robinonsay/cwht/docs/vv/README.md

# docs/vv: verification and validation evidence

Governing process: `docs/process/04-verification-and-validation.md` (expands charter section 9). Nothing in this directory is deleted; superseded items are kept and referenced by their successors (process section 15).

## Layout

| Path | Content | Created | Format and rules |
|---|---|---|---|
| `plan.md` | The V&V Plan, SE HB Appendix I outline as adapted in process section 14 | Written for PDR, baselined at PDR (SE-68), updated at CDR and each TRR by CR | Markdown; Appendices C and D are the matrices copied from `traceability-report.md` at each review |
| `traceability-report.md` | Output of `tools/traceability.py`: closure summary, requirements verification matrix (SE HB App. D), validation matrix (SE HB App. E), rule violations, requirement-to-NCR list | Regenerated before every review package and before every status change is committed | Generated file; never edited by hand; entrance product of every review (charter section 7); this is the working copy, and the per-review report `docs/reviews/<REVIEW>/traceability-report.md` with its `traceability.json` is written by the command of `docs/process/01-lifecycle-and-reviews.md` section 3.1 item 2, not copied from here |
| `traceability.json` | Machine-readable output of the same run: counts, coverage per module, validation row statuses, findings, and the measurements MSR-01, MSR-03, MSR-04 and MSR-23 of 07 section 11.2 | Written beside `traceability-report.md` by every run (`--json` names another path) | Generated file; never edited by hand; read by `tools/measurements.py` to append to `docs/plan/measurements.json` |
| `reports/<TC-ID>-r<N>.md` | One verification or validation report per run, from `docs/templates/verification-report.md` | Every run intended for credit and every failed run; risk-reduction runs with `credit: false` | YAML front matter in the parser subset of process section 7.4; read by `tools/traceability.py` today (rules 7.3.4 and 7.3.8: keys `test_case`, `run`, `requirement_ids`, `validates`, `credit`, `result`, `date`, `ncr_ids`, `artifacts`); the CM keys `source_commit`, `firmware_elf_sha256`, `procedure_blob` and `harness_versions` (`n/a` where they do not apply) are checked by the FCA (CM plan section 7.1, FCA-03 and FCA-04); `<N>` is the run number and is never reused |
| `reports/<TC-ID>-r<N>/` | Artifacts cited by that report: `*.csv`, `*.log.txt`, `*.png`, `*.svg`, `*.jpg`, `serial-*.txt`; an LTspice `.raw` only when the report cites it and it is 10 MB or smaller; for `TC-SW-COV-001-r<N>/` also `lcov.info`, the nightly MSR-14 output, the MC/DC tables and the gate log reference | With the report | Each file's SHA-256 is listed in the report front matter `artifacts`. Logs use the naming convention `.log.txt`; `.gitignore` un-ignores `*.log` and `*.raw` under `docs/vv/`, so nothing here is dropped by git (process section 15) |
| `reports/TC-SW-COV-001-r<N>.md` | Coverage and complexity report (SWE-189, SWE-190, SWE-219, SWE-220): summary, uncovered-code dispositions, MC/DC tables, complexity exceedances (process section 12) | Every tagged firmware release; presented at CDR, TRR, each TRR-Dn and SAR | Same template; case `TC-SW-COV-001` in `docs/test_cases/sw-cov/test_cases.json`; `firmware_version` carries the release |
| `reports/TC-SW-REG-001-r<N>.md` | Firmware regression report (SWE-191; process section 10.5) | Every tagged firmware release | Same template; case `TC-SW-REG-001` in `docs/test_cases/sw-reg/test_cases.json` |
| `reports/receipt-inspection-<n>.md` | Receipt inspection record for vendor delivery `n` (PCBWay, DigiKey): quantity, visual check against renders and BOM, polarity, dimensions, photographs (process section 11.2 stage 0; `docs/process/01-lifecycle-and-reviews.md` section 7.3 row 9 and 8.3 row 20) | At each vendor delivery, before TRR | Markdown record; no per-case front matter; not read by the tool; linked from `adp/<unit-serial>/as-built.md`; discrepancies become NCRs |
| `reports/vv-report.md` | V&V summary report for SAR (SE-53 replacement product, 01 section 8.5): every requirement's evidence and status, validation results per `OPS-NNN` and `MOE-NNN`, software section for SWE-194, written from `traceability-report.md` | Before SAR | Markdown; no per-case front matter; not read by the tool |
| `reports/part97-compliance.md` | Part 97 compliance statement (SE-54 replacement product, 01 section 8.3 row 7): each regulatory `REQ-TX-*`, its case, result and the owner's licence class | Before SAR | Markdown; no per-case front matter; not read by the tool |
| `ncr/NCR-NNN.md` | Non-conformance reports, from `docs/templates/ncr.md` | On any discrepancy (process section 10.1) | YAML front matter read by `tools/traceability.py` today (rule 7.3.8: keys `id`, `title`, `status`, `severity`, `requirement_ids`, `test_case_ids`, `retest_cases`, `regression_cases`, `hazard_ids`, `artifacts`; other keys checked by the reviewer); IDs sequential, never reused; status lifecycle in process section 10.7; closure evidence per disposition in process section 10.6 |
| `ncr/NCR-NNN/` | Evidence for that NCR: photographs, logs, vendor correspondence | With the NCR | SHA-256 listed in the NCR front matter `artifacts` |
| `fixtures/` | Drawings, OpenSCAD sources and characterization notes for test fixtures (RF probe characterized by the RF probe characterization case of module `SYS`, id allocated at authoring per 02 section 11.1; printed jigs, cable adapters) | By CDR | Referenced from test case `setup` fields |
| `adp/<unit-serial>/` | Acceptance data package per unit (`CWHT-A-001`, `CWHT-A-002`, ...): `as-built.md` (unit as-built record, CM plan Table 4-1 row 38), receipt photographs, link to the `receipt-inspection-<n>.md` records, ATP reports list, VDD copy, hand-over note | Unit 1 at receipt and completed at SAR; further units before hand-over (SI-019) | Markdown and images |

Test cases themselves live in `docs/test_cases/<module>/test_cases.json` (charter section 5), including `docs/test_cases/val/` (validation cases `TC-VAL-NNN`), `docs/test_cases/atp/` (acceptance test procedure `TC-ATP-NNN`), `docs/test_cases/sw-boot/` and `docs/test_cases/sw-cfg/` (loaded code and data acceptance, SWE-193; firmware modules with their own requirement files, 07 section 4), and the test-only modules `docs/test_cases/sw-cov/`, `docs/test_cases/sw-reg/` and `docs/test_cases/sw-tool/` (toolchain proof and tool accreditation runs, `TC-SW-TOOL-NNN`, 07 section 3.1). Start a new case from `docs/templates/test_cases.example.json` (one example per evidence class, including a `TC-VAL` style OnAir case, an ordering-only Emulation case and a dev-board case). TRR and SAR packages live in `docs/reviews/TRR/`, `docs/reviews/TRR-Dn/` (delta reviews) and `docs/reviews/SAR/` (charter section 4; `docs/process/01-lifecycle-and-reviews.md` section 1 item 4); the test configuration record for a campaign is `docs/reviews/TRR/test-configuration-record.md` (01 section 13).

## Workflow in one paragraph

A requirement is written with its method; an independent test author writes the case with its `Credit row:` line; an independent reviewer makes it `Active`; the conductor runs it on a configuration-managed article (tagged firmware release `release/FW-vX.Y.Z`, delivered unit) after TRR for Bench and OnAir; a report is filed here with `credit: true`; `tools/traceability.py` checks the evidence (rules of process section 7.3, implementation status in 7.4) and the requirement moves to `Verified` in the matrix; any discrepancy stops the run and opens an NCR here; the owner witnesses, dispositions and, at SAR, accepts, which moves the requirement to `Closed`. A software requirement verified by HostUnit or Emulation is `Verified` on the credited report against the tagged release; PCA-05 records the installed-release line in the unit's `adp/<unit-serial>/as-built.md` and changes no status; the requirement becomes `Closed` in the commit that records the signed SAR decision memo, and only when that PCA-05 line names the credited release (charter section 9; process section 5.3; CM plan section 7.2). Dev-board runs are supporting evidence with `credit: false` and never move a status (process section 4). Validation cases do the same against `OPS-NNN` and `MOE-NNN`, with the owner and friends as the users and both key types exercised (SI-018).

## Quick checks before committing anything here

1. `.venv/bin/python tools/traceability.py` exits 0 (the file is not executable; run it through the venv interpreter).
2. Every report and NCR has complete front matter in the parser subset (no trailing `# comments`, no nested mappings) and every cited artifact exists with the listed hash; `tools/traceability.py` checks this (rule 7.3.8: `REPORT_FRONT_MATTER`, `REPORT_ID_FORMAT`, `REPORT_UNRESOLVED`, `REPORT_ARTIFACT`, `NCR_ARTIFACT`), so run it before committing.
3. Every Bench or OnAir report names the witness and the instrument calibration performed that session.
4. Every file in a report or NCR artifact directory is listed in its `artifacts` front matter with its hash; logs are named `*.log.txt`; an LTspice `.raw` is present only when the report cites it and it is 10 MB or smaller (process section 15).
