robinonsay/cwht/docs/vv/traceability-report.md

# Traceability report

Generated by `tools/traceability.py` on 2026-09-30. Result: **PASS** (0 violation(s), 2 warning(s)).

Of the six Class A rows of NPR 7150.2D section 3.12.1 Table 1 (SWE-052) that `docs/process/00-charter.md` section 7 adopts, the state of this tool is: rows 1, 5, 6 enforced; row 2 enforced in part; rows 3, 4 not yet enforced. Section 1.4 lists the codes enforced and planned per row with their gates. It also applies the rules of `docs/process/02-requirements-and-traceability.md` section 8.2 and `docs/process/04-verification-and-validation.md` section 7.3 that section 11 lists. Section 3 is the Requirements Verification Matrix of SE HB Appendix D (Table D-1) and section 4 the Validation Matrix of SE HB Appendix E (Table E-1); together they are Appendices C and D of the V&V plan outline (SE HB Appendix I). Regenerate with `.venv/bin/python tools/traceability.py`; do not edit by hand.

## 1. Summary

| Item | Count |
|---|---|
| Requirement files | 3 |
| Requirements (not Retired) | 244 |
| Requirements Retired | 2 |
| Requirements with status Active | 189 |
| Requirements with status Closed | 2 |
| Requirements with status Draft | 55 |
| Requirements with at least one verification case | 244 of 244 (100 %) |
| Requirements Verified or Closed | 0 of 244 (0 %) |
| Requirements with open TBR (MSR-04) | 135 |
| Key driving requirements (KDR) | 22 |
| Test case files | 4 |
| Test cases (not Retired) | 174 |
| Test cases with status Draft | 174 |
| Test cases of class Bench | 99 |
| Test cases of class HostUnit | 35 |
| Test cases of class Inspection | 15 |
| Test cases of class Simulation | 25 |
| Verification reports | 6 |
| Hazards | 15 |
| Expectations (NGO, MOE, CON) | 71 |
| ConOps scenarios | 22 |
| Nonconformance reports | 0 |
| Violations | 0 |
| Warnings | 2 |

### 1.1 Upstream artifacts consulted

| Artifact | Path | State |
|---|---|---|
| Stakeholder inputs (SI) | docs/requirements/l0-stakeholder/stakeholder-inputs.md | 38 ids, 1 core |
| Expectations (NGO, MOE, CON) | docs/requirements/l0-stakeholder/expectations.json | 71 ids |
| ConOps scenarios (OPS) | docs/conops/conops.md | 22 ids |
| Hazards (HZ) | docs/safety/hazards.json | 15 ids |
| Risks (RSK) | docs/risk/register.json | 65 ids |
| Measures (MOP, TPM) | docs/plan/tpm.json | 40 ids |
| Regulatory corpus (47 CFR Parts 1, 2, 15, 97 sections) | docs/references/md/regulatory | 30 ids |
| Decision records (ADR) | docs/decisions/adr | 45 ids |
| Trade studies (TS) | docs/decisions/trade-studies | 6 ids |
| Verification reports | docs/vv/reports | 6 files |
| Nonconformances (NCR) | docs/vv/ncr | 0 files |
| SAR decision memo | docs/reviews/SAR/decision-memo.md | absent |
| Allocation (preliminary at SRR) | docs/design/allocation.json | 187 requirement ids allocated |

### 1.2 Open TBR list

Every requirement carrying a `tbr` object (02 section 9 rule 3; NPR 7123.1D App. G Tables G-4, G-6 and G-7: TBD and TBR items identified with plans).

| ID | Module | Status | Owner | Plan | Close by |
|---|---|---|---|---|---|
| REQ-SYS-004 | SYS | Active | Robin approves on Claude's proposal at PDR; Claude produces the closing evidence | Claude sizes the latency in the sequencer timing analysis (ICD-TX-SW) at PDR; Robin confirms the 20 ms or a replacement in the PDR decision memo. | PDR |
| REQ-SYS-008 | SYS | Active | Robin approves on Claude's proposal at PDR; Claude produces the closing evidence | SRR decision 25 (owner ruling 2026-09-26) set the 1.2 kHz guard with the +/-2.5 ppm reference (ADR-023 option (a)); the TS-NNN-synthesizer-reference frequency error budget and the TS-006 keying-sideband offset of REQ-TX-006 at PDR confirm that 1.2 kHz covers the reference tolerance plus the -60 dB offset, else the guard is changed by CR. | PDR |
| REQ-SYS-009 | SYS | Active | Robin approves on Claude's proposal at PDR; Claude produces the closing evidence | Closes with the guard value of the transmit frequency range requirement (ADR-023 with the 1.2 kHz guard of SRR decision 25 (owner ruling 2026-09-26); frequency error budget, PDR). | PDR |
| REQ-SYS-010 | SYS | Active | Robin approves on Claude's proposal at PDR; Claude produces the closing evidence | TS-NNN-synthesizer-reference selects the reference grade at PDR; the error budget in docs/design/budgets.md fixes the tolerance and the operating span is reconciled with TPM-006; Robin approves in the PDR memo. | PDR |
| REQ-SYS-011 | SYS | Active | Robin approves on Claude's proposal at PDR; Claude produces the closing evidence | SRR decision 22 (owner ruling 2026-09-26) adopted the step set and tolerance (RFX-D1); the ALC loop analysis at PDR (TS-006) confirms +/-1 dB at every step. | PDR |
| REQ-SYS-012 | SYS | Active | Robin approves on Claude's proposal at PDR; Claude produces the closing evidence | TS-003 (PA device) and TS-006 (ALC topology) at PDR show the tolerance by analysis; Robin confirms +/-1 dB and the +/-0.5 dB ALC target or replacements in the PDR memo. | PDR |
| REQ-SYS-014 | SYS | Active | Robin approves on Claude's proposal at PDR; Claude produces the closing evidence | SRR decision 28 (owner ruling 2026-09-26) adopted the ramp convention and range as written (D-KN6); the TS-006 LTspice transient with the FFT checker confirms them at PDR; the same transient confirms the 5 percent shape and +/-0.5 ms time tolerances (INSP-003 finding-25). | PDR |
| REQ-SYS-015 | SYS | Active | Robin approves on Claude's proposal at PDR; Claude produces the closing evidence | Claude verifies the tinySA Ultra resolution bandwidth on receipt (ACTION-9) before PDR; if it resolves 350 Hz a CR proposes method Test, otherwise Analysis stands and RSK-011 records the residual. | PDR |
| REQ-SYS-018 | SYS | Active | Robin approves on Claude's proposal at PDR; Claude produces the closing evidence | SRR decision 29 (owner ruling 2026-09-26) accepted ADR-022; TS-003 and the filter simulation at PDR show the margin is achievable, else the target is revised by CR. | PDR |
| REQ-SYS-019 | SYS | Active | Robin approves on Claude's proposal at PDR; Claude produces the closing evidence | SRR decision 36 (owner ruling 2026-09-26) adopted RFX-D3 option a; the RF exposure evaluation at PDR confirms the value. | PDR |
| REQ-SYS-020 | SYS | Active | Robin approves on Claude's proposal at PDR; Claude produces the closing evidence | SRR decision 36 (owner ruling 2026-09-26) adopted RFX-D3 with D-KN2, option a (tune limit below the cutoff window); the RF exposure evaluation and the PA thermal analysis at PDR confirm it. | PDR |
| REQ-SYS-022 | SYS | Active | Robin approves on Claude's proposal at PDR; Claude produces the closing evidence | TS-001 (selectivity architecture A or B) at PDR closes the value with simulation and quotes; Robin approves the selected set in the PDR memo. | PDR |
| REQ-SYS-023 | SYS | Active | Robin approves on Claude's proposal at PDR; Claude produces the closing evidence | TS-001 (selectivity architecture A or B) at PDR closes the value with simulation and quotes; Robin approves the selected set in the PDR memo. | PDR |
| REQ-SYS-024 | SYS | Active | Robin approves on Claude's proposal at PDR; Claude produces the closing evidence | TS-001 (selectivity architecture A or B) at PDR closes the value with simulation and quotes; Robin approves the selected set in the PDR memo. | PDR |
| REQ-SYS-025 | SYS | Active | Robin approves on Claude's proposal at PDR; Claude produces the closing evidence | TS-001 (selectivity architecture A or B) at PDR closes the value with simulation and quotes; Robin approves the selected set in the PDR memo. | PDR |
| REQ-SYS-026 | SYS | Active | Robin approves on Claude's proposal at PDR; Claude produces the closing evidence | TS-001 (selectivity architecture A or B) at PDR closes the value with simulation and quotes; Robin approves the selected set in the PDR memo. | PDR |
| REQ-SYS-027 | SYS | Active | Robin approves on Claude's proposal at PDR; Claude produces the closing evidence | TS-001 (selectivity architecture A or B) at PDR closes the value with simulation and quotes; Robin approves the selected set in the PDR memo. | PDR |
| REQ-SYS-028 | SYS | Active | Robin approves on Claude's proposal at PDR; Claude produces the closing evidence | TS-001 (selectivity architecture A or B) at PDR closes the value with simulation and quotes; Robin approves the selected set in the PDR memo. | PDR |
| REQ-SYS-029 | SYS | Active | Robin approves on Claude's proposal at PDR; Claude produces the closing evidence | TS-001 (selectivity architecture A or B) at PDR closes the value with simulation and quotes; Robin approves the selected set in the PDR memo. | PDR |
| REQ-SYS-030 | SYS | Active | Robin approves on Claude's proposal at PDR; Claude produces the closing evidence | TS-001 (selectivity architecture A or B) at PDR closes the value with simulation and quotes; Robin approves the selected set in the PDR memo. | PDR |
| REQ-SYS-031 | SYS | Active | Robin approves on Claude's proposal at PDR; Claude produces the closing evidence | TS-NNN-synthesizer-reference at PDR selects the synthesizer on measured or primary-source phase noise; Robin approves the floor in the PDR memo. | PDR |
| REQ-SYS-032 | SYS | Active | Robin approves on Claude's proposal at PDR; Claude produces the closing evidence | TS-001 (selectivity architecture A or B) at PDR closes the value with simulation and quotes; Robin approves the selected set in the PDR memo. | PDR |
| REQ-SYS-033 | SYS | Active | Robin approves on Claude's proposal at PDR; Claude produces the closing evidence | TS-001 (selectivity architecture A or B) at PDR closes the value with simulation and quotes; Robin approves the selected set in the PDR memo. | PDR |
| REQ-SYS-034 | SYS | Active | Robin approves on Claude's proposal at PDR; Claude produces the closing evidence | The clock plan at PDR fixes the exclusion window and the birdie allowance; Robin approves in the PDR memo. | PDR |
| REQ-SYS-035 | SYS | Active | Robin approves on Claude's proposal at PDR; Claude produces the closing evidence | TS-001 (selectivity architecture A or B) at PDR fixes the filter-centre uncertainty and so the trim range; Robin approves in the PDR memo. | PDR |
| REQ-SYS-036 | SYS | Active | Robin approves on Claude's proposal at PDR; Claude produces the closing evidence | The sequencer timing table (ICD-RX-TX, ICD-TX-SW) at PDR fixes the recovery time; Robin approves in the PDR memo. | PDR |
| REQ-SYS-037 | SYS | Active | Robin approves on Claude's proposal at PDR; Claude produces the closing evidence | TS-001 front-end design at PDR selects the limiter or the spacing rule with a coupling analysis; Robin approves in the PDR memo. | PDR |
| REQ-SYS-044 | SYS | Active | Robin approves on Claude's proposal at PDR; Claude produces the closing evidence | SRR decision 47 (owner ruling 2026-09-26) adopted D-KN4 (hang in dits, 3 to 30) and accepted ADR-026; the sequencer timing table at PDR confirms the floor against relay timing. | PDR |
| REQ-SYS-048 | SYS | Active | Robin approves on Claude's proposal at PDR; Claude produces the closing evidence | Claude captures the owner's key and paddle bounce with the Pico-based logic capture before PDR; Robin approves the value in the PDR memo. | PDR |
| REQ-SYS-049 | SYS | Active | Robin approves on Claude's proposal at PDR; Claude produces the closing evidence | SRR decision 49 (owner ruling 2026-09-26) adopted D-KN7 (abuse bound); the clamp dissipation analysis at PDR confirms the duration. | PDR |
| REQ-SYS-052 | SYS | Active | Robin approves on Claude's proposal at PDR; Claude produces the closing evidence | SRR decision 50 (owner ruling 2026-09-26) ratified the 500 ms interlock (keyer report F13 item 1); the HostUnit bounce study at PDR confirms it. | PDR |
| REQ-SYS-053 | SYS | Active | Robin approves on Claude's proposal at PDR; Claude produces the closing evidence | SRR decision 37 (owner ruling 2026-09-26) adopted the 5 s timeout, the Bug-mode dah included (D-KN3); the HostUnit study at PDR confirms the value and fixes the configurable range (2 to 6 s). | PDR |
| REQ-SYS-054 | SYS | Active | Robin approves on Claude's proposal at PDR; Claude produces the closing evidence | SRR decision 37 (owner ruling 2026-09-26) adopted the no-gap watchdog with 30 s and the gap of the shorter of 7 dits and 500 ms (D-KN3, HZ-004 K4); the HostUnit study at PDR confirms that no legitimate sending at 5 to 50 WPM reaches them, including word spaces near 7 dits above about 17 WPM (INSP-025 cross item X8), else the values change by CR. | PDR |
| REQ-SYS-055 | SYS | Active | Robin approves on Claude's proposal at PDR; Claude produces the closing evidence | SRR decision 36 (owner ruling 2026-09-26) adopted D-KN2 with RFX-D3, option a; the monostable timing analysis over tolerance, temperature and DC bias at PDR confirms 7.5 to 13 s. | PDR |
| REQ-SYS-058 | SYS | Active | Robin approves on Claude's proposal at PDR; Claude produces the closing evidence | The UI design at PDR fixes the step table after a HostUnit usability run; Robin approves in the PDR memo. | PDR |
| REQ-SYS-059 | SYS | Active | Robin approves on Claude's proposal at PDR; Claude produces the closing evidence | The audio design at PDR fixes the step count; Robin approves in the PDR memo. | PDR |
| REQ-SYS-061 | SYS | Active | Robin approves on Claude's proposal at PDR; Claude produces the closing evidence | SRR decision 77 (owner ruling 2026-09-26) selected the LS013B7DH03 (D-UI-01); the PDR display layout fixes the character height; Robin approves in the PDR memo. | PDR |
| REQ-SYS-062 | SYS | Active | Robin approves on Claude's proposal at PDR; Claude produces the closing evidence | The UI design at PDR fixes the menu tree; Robin approves in the PDR memo. | PDR |
| REQ-SYS-064 | SYS | Active | Robin approves on Claude's proposal at PDR; Claude produces the closing evidence | SRR decision 23 (owner ruling 2026-09-26) adopted RFX-D2 (1 W default with a confirmation for 5 W); the RF exposure evaluation at PDR confirms the default. | PDR |
| REQ-SYS-067 | SYS | Active | Robin approves on Claude's proposal at PDR; Claude produces the closing evidence | The UI response analysis at PDR fixes the latency with the display refresh rate; Robin approves in the PDR memo. | PDR |
| REQ-SYS-068 | SYS | Active | Robin approves on Claude's proposal at PDR; Claude produces the closing evidence | SRR decision 21 (owner ruling 2026-09-26) kept the identification reminder in revision A; the UI design at PDR confirms the 9 min lead and its tolerance; Robin approves in the PDR memo. | PDR |
| REQ-SYS-069 | SYS | Active | Robin approves on Claude's proposal at PDR; Claude produces the closing evidence | The RF exposure evaluation at PDR (RFX-D4, RFX-A5) fixes the values; the TRR update with measured power and antenna gain confirms them. | PDR |
| REQ-SYS-071 | SYS | Active | Robin approves on Claude's proposal at PDR; Claude produces the closing evidence | SRR decision 64 (owner ruling 2026-09-26) adopted audio level policy (a) (docs/research/audio-output-and-hearing-safety.md D2); the single-failure analysis at PDR confirms the values. | PDR |
| REQ-SYS-072 | SYS | Active | Robin approves on Claude's proposal at PDR; Claude produces the closing evidence | SRR decision 64 (owner ruling 2026-09-26) adopted audio level policy (a) (docs/research/audio-output-and-hearing-safety.md D2); the single-failure analysis at PDR confirms the values. | PDR |
| REQ-SYS-073 | SYS | Active | Robin approves on Claude's proposal at PDR; Claude produces the closing evidence | SRR decision 64 (owner ruling 2026-09-26) adopted audio level policy (a) (docs/research/audio-output-and-hearing-safety.md D2); the single-failure analysis at PDR confirms the values. | PDR |
| REQ-SYS-074 | SYS | Active | Robin approves on Claude's proposal at PDR; Claude produces the closing evidence | SRR decision 64 (owner ruling 2026-09-26) adopted audio level policy (a) (docs/research/audio-output-and-hearing-safety.md D2); the single-failure analysis at PDR confirms the values. | PDR |
| REQ-SYS-076 | SYS | Active | Robin approves on Claude's proposal at PDR; Claude produces the closing evidence | SRR decision 64 (owner ruling 2026-09-26) adopted audio level policy (a) (docs/research/audio-output-and-hearing-safety.md D2); the single-failure analysis at PDR confirms the values. | PDR |
| REQ-SYS-078 | SYS | Active | Robin approves on Claude's proposal at PDR; Claude produces the closing evidence | The audio design at PDR confirms the channel match; Robin approves in the PDR memo. | PDR |
| REQ-SYS-081 | SYS | Active | Robin approves on Claude's proposal at PDR; Claude produces the closing evidence | SRR decision 70 (owner ruling 2026-09-26) selected the BQ25887 (D-PWR-01); the charger design at PDR confirms the regulation tolerance. | PDR |
| REQ-SYS-082 | SYS | Active | Robin approves on Claude's proposal at PDR; Claude produces the closing evidence | The NTC divider and placement analysis at PDR fixes the tolerance; Robin approves in the PDR memo. | PDR |
| REQ-SYS-083 | SYS | Active | Robin approves on Claude's proposal at PDR; Claude produces the closing evidence | SRR decision 72 (owner ruling 2026-09-26) adopted D-PWR-03 (S-8252 class plus BQ29209 class); the protector variant selection at PDR confirms the band and the margin to VREG. | PDR |
| REQ-SYS-084 | SYS | Active | Robin approves on Claude's proposal at PDR; Claude produces the closing evidence | SRR decision 72 (owner ruling 2026-09-26) adopted D-PWR-03; the protector variant selection at PDR fixes the threshold. | PDR |
| REQ-SYS-085 | SYS | Active | Robin approves on Claude's proposal at PDR; Claude produces the closing evidence | SRR decisions 70 to 76 (owner ruling 2026-09-26) set the power-tree baseline (docs/research/power-tree-and-charging.md D-PWR-01 to D-PWR-08); the power trade study at PDR fixes the value. | PDR |
| REQ-SYS-086 | SYS | Active | Robin approves on Claude's proposal at PDR; Claude produces the closing evidence | SRR decisions 70 to 76 (owner ruling 2026-09-26) set the power-tree baseline (docs/research/power-tree-and-charging.md D-PWR-01 to D-PWR-08); the power trade study at PDR fixes the value. | PDR |
| REQ-SYS-087 | SYS | Active | Robin approves on Claude's proposal at PDR; Claude produces the closing evidence | SRR decisions 70 to 76 (owner ruling 2026-09-26) set the power-tree baseline (docs/research/power-tree-and-charging.md D-PWR-01 to D-PWR-08); the power trade study at PDR fixes the value. | PDR |
| REQ-SYS-088 | SYS | Active | Robin approves on Claude's proposal at PDR; Claude produces the closing evidence | The sense-path calibration analysis at PDR fixes the threshold; Robin approves in the PDR memo. | PDR |
| REQ-SYS-089 | SYS | Active | Robin approves on Claude's proposal at PDR; Claude produces the closing evidence | SRR decisions 70 to 76 (owner ruling 2026-09-26) set the power-tree baseline (docs/research/power-tree-and-charging.md D-PWR-01 to D-PWR-08); the power trade study at PDR fixes the timer against the approved cell capacity. | PDR |
| REQ-SYS-095 | SYS | Active | Robin approves on Claude's proposal at PDR; Claude produces the closing evidence | SRR decision 76 (owner ruling 2026-09-26) adopted the 6 h floor at 1:4; the PDR power budget shows it is achievable, else it is revised by CR. | PDR |
| REQ-SYS-097 | SYS | Active | Robin approves on Claude's proposal at PDR; Claude produces the closing evidence | SRR decisions 70 to 76 (owner ruling 2026-09-26) set the power-tree baseline (docs/research/power-tree-and-charging.md D-PWR-01 to D-PWR-08); the power trade study at PDR fixes the value. | PDR |
| REQ-SYS-098 | SYS | Active | Robin approves on Claude's proposal at PDR; Claude produces the closing evidence | SRR decisions 70 to 76 (owner ruling 2026-09-26) set the power-tree baseline (docs/research/power-tree-and-charging.md D-PWR-01 to D-PWR-08); the power trade study at PDR fixes the value. | PDR |
| REQ-SYS-099 | SYS | Active | Robin approves on Claude's proposal at PDR; Claude produces the closing evidence | SRR decisions 70 to 76 (owner ruling 2026-09-26) set the power-tree baseline (docs/research/power-tree-and-charging.md D-PWR-01 to D-PWR-08); the power trade study at PDR fixes the value. | PDR |
| REQ-SYS-100 | SYS | Active | Robin approves on Claude's proposal at PDR; Claude produces the closing evidence | SRR decisions 70 to 76 (owner ruling 2026-09-26) set the power-tree baseline (docs/research/power-tree-and-charging.md D-PWR-01 to D-PWR-08); the power trade study at PDR fixes the value. | PDR |
| REQ-SYS-102 | SYS | Active | Robin approves on Claude's proposal at PDR; Claude produces the closing evidence | SRR decision 97 (owner ruling 2026-09-26) adopted 350 g (TPM-001) as a TBR allocation; the bottom-up estimate at PDR with the enclosure envelope confirms it. | PDR |
| REQ-SYS-103 | SYS | Active | Robin approves on Claude's proposal at PDR; Claude produces the closing evidence | SRR decision 97 (owner ruling 2026-09-26) adopted 140 x 70 x 40 mm (TPM-016) as a TBR allocation; the enclosure layout at PDR confirms it. | PDR |
| REQ-SYS-105 | SYS | Active | Robin approves on Claude's proposal at PDR; Claude produces the closing evidence | The enclosure analysis at PDR confirms the return-loss limit with the NanoVNA repeatability; Robin approves in the PDR memo. | PDR |
| REQ-SYS-106 | SYS | Active | Robin approves on Claude's proposal at PDR; Claude produces the closing evidence | The connector selection at PDR confirms the rating and the return-loss limit; Robin approves in the PDR memo. | PDR |
| REQ-SYS-107 | SYS | Active | Robin approves on Claude's proposal at PDR; Claude produces the closing evidence | The enclosure layout at PDR fixes the attachment position and resistance; Robin approves in the PDR memo. | PDR |
| REQ-SYS-112 | SYS | Active | Robin approves on Claude's proposal at PDR; Claude produces the closing evidence | TS-003 (device RthJC) and the thermal budget at PDR fix the limit and the condition; Robin approves in the PDR memo. | PDR |
| REQ-SYS-113 | SYS | Active | Robin approves on Claude's proposal at PDR; Claude produces the closing evidence | The thermal budget at PDR fixes the value; if the owner adopts IEC 62368-1 or ISO 13732-1 the value is re-based on it by CR; Robin approves in the PDR memo. | PDR |
| REQ-SYS-114 | SYS | Active | Robin approves on Claude's proposal at PDR; Claude produces the closing evidence | SRR decision 85 (owner ruling 2026-09-26) adopted the environment set (TBR) of docs/conops/conops.md section 4 and Appendix C; the TPM-006 span is reconciled at PDR. | PDR |
| REQ-SYS-115 | SYS | Active | Robin approves on Claude's proposal at PDR; Claude produces the closing evidence | SRR decision 85 (owner ruling 2026-09-26) adopted the environment set (TBR) of docs/conops/conops.md section 4 and Appendix C; the TPM-006 span is reconciled at PDR. | PDR |
| REQ-SYS-116 | SYS | Active | Robin approves on Claude's proposal at PDR; Claude produces the closing evidence | SRR decision 85 (owner ruling 2026-09-26) adopted the environment set (TBR) of docs/conops/conops.md section 4 and Appendix C; the TPM-006 span is reconciled at PDR. | PDR |
| REQ-SYS-117 | SYS | Active | Robin approves on Claude's proposal at PDR; Claude produces the closing evidence | SRR decision 85 (owner ruling 2026-09-26) adopted the environment set (TBR) of docs/conops/conops.md section 4 and Appendix C; the TPM-006 span is reconciled at PDR. | PDR |
| REQ-SYS-118 | SYS | Active | Robin approves on Claude's proposal at PDR; Claude produces the closing evidence | The PA thermal analysis at PDR fixes the threshold; the decision is recorded in an ADR and this TBR closes in the same CR. | PDR |
| REQ-SYS-131 | SYS | Active | Robin approves on Claude's proposal at PDR; Claude produces the closing evidence | The software design at PDR fixes the watchdog period against the longest legitimate loop; Robin approves in the PDR memo. | PDR |
| REQ-SYS-136 | SYS | Active | Robin approves on Claude's proposal at PDR; Claude produces the closing evidence | SRR decisions 28, 43, 45, 46 and 47 (owner ruling 2026-09-26) set the keyer defaults (concept section 14 item 11); the PDR keyer design confirms them and Robin approves in the PDR memo. | PDR |
| REQ-SYS-139 | SYS | Active | Robin approves on Claude's proposal at PDR; Claude produces the closing evidence | SRR decision 87 (owner ruling 2026-09-26) set 1.0 mm if the enclosure gives four bosses, else 1.6 mm; TS-004 at PDR decides from the boss layout and the quotes; Robin approves in the PDR memo. | PDR |
| REQ-SYS-141 | SYS | Active | Robin approves on Claude's proposal at PDR; Claude produces the closing evidence | The TX design at PDR fixes the tap topology and coupling flatness at the harmonics; Robin approves in the PDR memo. | PDR |
| REQ-SYS-147 | SYS | Active | Robin approves on Claude's proposal at PDR; Claude produces the closing evidence | SRR decision 90 (owner ruling 2026-09-26) set USD 610 per unit; the CDR quotes confirm it. | PDR |
| REQ-SYS-149 | SYS | Active | Robin approves on Claude's proposal at PDR; Claude produces the closing evidence | The power-tree design at PDR confirms the supply topology and the residual level; Robin approves in the PDR memo. | PDR |
| REQ-SYS-151 | SYS | Active | Robin approves on Claude's proposal at PDR; Claude produces the closing evidence | TS-003 (PA device) at PDR confirms the harmonic levels into 2:1 by simulation; Robin approves the bound in the PDR memo. | PDR |
| REQ-SYS-152 | SYS | Active | Robin approves on Claude's proposal at PDR; Claude produces the closing evidence | TS-003 (PA device and ruggedness) at PDR confirms the bound; Robin approves in the PDR memo. | PDR |
| REQ-SYS-153 | SYS | Active | Robin approves on Claude's proposal at PDR; Claude produces the closing evidence | TS-003 (PA device) at PDR fixes the maximum drain voltage and so the threshold; Robin approves in the PDR memo. | PDR |
| REQ-SYS-154 | SYS | Active | Robin approves on Claude's proposal at PDR; Claude produces the closing evidence | TS-NNN-synthesizer-reference (synthesizer and lock detect) at PDR fixes the counting tolerance; Robin approves in the PDR memo. | PDR |
| REQ-SYS-155 | SYS | Active | Robin approves on Claude's proposal at PDR; Claude produces the closing evidence | The PA thermal design at PDR fixes the sensor and its plausible range; Robin approves in the PDR memo. | PDR |
| REQ-SYS-156 | SYS | Active | Robin approves on Claude's proposal at PDR; Claude produces the closing evidence | TS-006 (ALC topology) at PDR fixes the plausible range and latency; Robin approves in the PDR memo. | PDR |
| REQ-SYS-158 | SYS | Active | Robin approves on Claude's proposal at PDR; Claude produces the closing evidence | The audio design at PDR fixes the fade; Robin approves in the PDR memo. | PDR |
| REQ-SYS-159 | SYS | Active | Robin approves on Claude's proposal at PDR; Claude produces the closing evidence | SRR decision 50 (owner ruling 2026-09-26) ratified the keyer set; the sequencer timing table at PDR confirms the latency. | PDR |
| REQ-SYS-160 | SYS | Active | Robin approves on Claude's proposal at PDR; Claude produces the closing evidence | The T/R element trade at PDR fixes the relay operate and bounce times and so the lead-in; Robin approves in the PDR memo. | PDR |
| REQ-SYS-161 | SYS | Active | Robin approves on Claude's proposal at PDR; Claude produces the closing evidence | The T/R element trade at PDR fixes the lead-in; Robin approves in the PDR memo. | PDR |
| REQ-SYS-162 | SYS | Active | Robin approves on Claude's proposal at PDR; Claude produces the closing evidence | Claude captures the owner's key and paddle bounce with the Pico-based logic capture before PDR; Robin approves the value in the PDR memo. | PDR |
| REQ-SYS-164 | SYS | Active | Robin approves on Claude's proposal at PDR; Claude produces the closing evidence | The UI design at PDR fixes the step table and crossing time after a HostUnit usability run; Robin approves in the PDR memo. | PDR |
| REQ-SYS-165 | SYS | Active | Robin approves on Claude's proposal at PDR; Claude produces the closing evidence | SRR decision 77 (owner ruling 2026-09-26) selected the LS013B7DH03 with no light in build 1 (D-UI-01, D-UI-02); the PDR display design fixes the illuminance floor; Robin approves in the PDR memo. | PDR |
| REQ-SYS-166 | SYS | Active | Robin approves on Claude's proposal at PDR; Claude produces the closing evidence | SRR decisions 70 to 76 (owner ruling 2026-09-26) set the power-tree baseline (docs/research/power-tree-and-charging.md D-PWR-01 to D-PWR-08); the power trade study at PDR fixes the window; the 0.5 V rail-off level closes with REQ-SYS-149. | PDR |
| REQ-SYS-167 | SYS | Active | Robin approves on Claude's proposal at PDR; Claude produces the closing evidence | The charge-profile analysis with the chosen cell at PDR fixes both values and the +/-2 min window tolerance; Robin approves in the PDR memo. | PDR |
| REQ-SYS-168 | SYS | Active | Robin approves on Claude's proposal at PDR; Claude produces the closing evidence | The enclosure design at PDR fixes the cover mechanism and the gap limits; Robin approves in the PDR memo. | PDR |
| REQ-SYS-169 | SYS | Active | Robin approves on Claude's proposal at PDR; Claude produces the closing evidence | SRR decisions 64 and 67 (owner ruling 2026-09-26) adopted audio level policy (a) with the cap and unlock only (docs/research/audio-output-and-hearing-safety.md D2); the audio design at PDR confirms the value. | PDR |
| REQ-SYS-172 | SYS | Active | Robin approves on Claude's proposal at PDR; Claude produces the closing evidence | The antenna choice at PDR and the TRR EIRP comparison (RFX-A5) confirm the bound; Robin approves in the PDR memo. | PDR |
| REQ-SYS-176 | SYS | Active | Robin approves on Claude's proposal at PDR; Claude produces the closing evidence | The receiver design at PDR confirms the limit; Robin approves it or a replacement in the PDR memo. | PDR |
| REQ-SYS-177 | SYS | Active | Robin approves on Claude's proposal at PDR; Claude produces the closing evidence | The enclosure and clock-plan design at PDR confirms the shielding figure; Robin approves in the PDR memo. | PDR |
| REQ-SYS-180 | SYS | Active | Robin approves on Claude's proposal at PDR; Claude produces the closing evidence | SRR decision 38 (owner ruling 2026-09-26) adopted the backstop with the 150 s to 180 s window; the timing Simulation of the monostable over tolerance, temperature and capacitor DC bias at PDR confirms it, else the window changes by CR. | PDR |
| REQ-SYS-181 | SYS | Active | Robin approves on Claude's proposal at PDR; Claude produces the closing evidence | SRR decision 39 (owner ruling 2026-09-26) adopted 95 C +/-3 C and 100 ms; the PDR thermal analysis (REQ-SYS-112, TS-003) confirms them against the device rating, else they change by CR. | PDR |
| REQ-SYS-182 | SYS | Active | Robin approves on Claude's proposal at PDR; Claude produces the closing evidence | SRR decision 40 (owner ruling 2026-09-26, with decision 9) adopted the independent verification with the 10 kHz window and the 100 ms time; the PDR prescaler, counter and timebase design (TS-NNN-synthesizer-reference) confirms them against the counter gate time, resolution and crystal tolerance, else they change by CR. The release-build test frequencies follow the 1.2 kHz guard of SRR decision 25 (owner ruling 2026-09-26). | PDR |
| REQ-SYS-183 | SYS | Active | Robin approves on Claude's proposal at PDR; Claude produces the closing evidence | Claude proposes the level at SRR; the receiver and T/R isolation analysis at PDR confirms it together with REQ-SYS-176, and Robin approves it or a replacement in the PDR memo; every case that cites this requirement takes the confirmed value. | PDR |
| REQ-SYS-184 | SYS | Active | Robin approves on Claude's proposal at PDR; Claude produces the closing evidence | SRR decision 37 (owner ruling 2026-09-26) adopted 2 s; the HostUnit study at PDR checks it against the longest squeezed character at 5 WPM (C, 11 dit times, 2.64 s), and if normal squeezing trips it the limit becomes the longer of 2 s and 16 dit times by CR; Robin approves in the PDR memo. | PDR |
| REQ-SYS-185 | SYS | Active | Robin approves on Claude's proposal at PDR; Claude produces the closing evidence | SRR decision 72 (owner ruling 2026-09-26) adopted the layer; the protector variant selection at PDR fixes the band against the REQ-SYS-083 band and the device threshold accuracy; Robin approves in the PDR memo. | PDR |
| REQ-SYS-186 | SYS | Active | Robin approves on Claude's proposal at PDR; Claude produces the closing evidence | The sense-path analysis at PDR sets the resistance from the input impedance and threshold tolerance of each layer (SRR decision 72, owner ruling 2026-09-26); Robin approves in the PDR memo. | PDR |
| REQ-SYS-188 | SYS | Active | Robin approves on Claude's proposal at PDR; Claude produces the closing evidence | SRR decision 41 (owner ruling 2026-09-26) adopted 120 s; the PDR test-mode design confirms it against the longest bench procedure and the REQ-SYS-180 floor; Robin approves in the PDR memo. | PDR |
| REQ-SYS-189 | SYS | Active | Robin approves on Claude's proposal at PDR; Claude produces the closing evidence | SRR decision 41 (owner ruling 2026-09-26) adopted the guard of OQ-SAF-016 with 60 s for the tone; the PDR audio and test-mode design confirms it; Robin approves in the PDR memo. | PDR |
| REQ-SYS-194 | SYS | Active | Robin approves on Claude's proposal at PDR; Claude produces the closing evidence | Closes with REQ-SYS-083: SRR decision 72 (owner ruling 2026-09-26) adopted D-PWR-03 (S-8252 class plus BQ29209 class); the protector variant selection at PDR confirms the band over 0 C to 45 C. | PDR |
| REQ-SW-KEYER-009 | SW-KEYER | Draft | Robin decides at SRR on Claude's proposal; Claude produces the closing evidence | The owner's human-in-the-loop session on the Pico 2 development board before PDR (RSK-012 mitigation S3, credit false) fixes the range, step and default; Robin approves them in the PDR decision memo. | PDR |
| REQ-SW-KEYER-014 | SW-KEYER | Draft | Robin decides at SRR on Claude's proposal; Claude produces the closing evidence | The PDR display driver and encoder decode design confirms the 20 ms full-frame time and the 50 detents/s decode rate; Robin approves the load values in the PDR decision memo. | PDR |
| REQ-SW-KEYER-017 | SW-KEYER | Draft | Robin decides at SRR on Claude's proposal; Claude produces the closing evidence | Closes with REQ-SYS-048: Claude captures the owner's key and paddle bounce before PDR and Robin approves the make-filter value, which fixes this latency, in the PDR decision memo. | PDR |
| REQ-SW-KEYER-018 | SW-KEYER | Draft | Robin decides at SRR on Claude's proposal; Claude produces the closing evidence | Closes with REQ-SYS-048 and REQ-SYS-160: the bounce capture and the T/R element trade at PDR fix the value; Robin approves it in the PDR decision memo. | PDR |
| REQ-SW-KEYER-020 | SW-KEYER | Draft | Robin decides at SRR on Claude's proposal; Claude produces the closing evidence | Closes with REQ-SYS-048: Claude captures the owner's key and paddle bounce with the Pico-based logic capture before PDR (A-KN5); Robin approves the value in the PDR decision memo. | PDR |
| REQ-SW-KEYER-021 | SW-KEYER | Draft | Robin decides at SRR on Claude's proposal; Claude produces the closing evidence | Closes with REQ-SYS-162: the bounce capture before PDR (A-KN5) sets the value; Robin approves it in the PDR decision memo. | PDR |
| REQ-SW-KEYER-022 | SW-KEYER | Draft | Robin decides at SRR on Claude's proposal; Claude produces the closing evidence | Closes with REQ-SYS-052: SRR decision 50 (owner ruling 2026-09-26) ratified the interlock; the HostUnit bounce study at PDR confirms 500 ms. | PDR |
| REQ-SW-KEYER-026 | SW-KEYER | Draft | Robin decides at SRR on Claude's proposal; Claude produces the closing evidence | Closes with REQ-SYS-053: SRR decision 37 (owner ruling 2026-09-26) adopted the 5 s timeout (D-KN3); the HostUnit study at PDR confirms it and fixes the configurable range (2 to 6 s). | PDR |
| REQ-SW-KEYER-032 | SW-KEYER | Draft | Robin decides at SRR on Claude's proposal; Claude produces the closing evidence | Closes with REQ-SYS-044: SRR decision 47 (owner ruling 2026-09-26) adopted D-KN4 and accepted ADR-026; the sequencer timing table at PDR confirms the floor against relay timing. | PDR |
| REQ-SW-KEYER-036 | SW-KEYER | Draft | Claude (ICD-CTL-KEY author) proposes; Robin approves in the PDR decision memo | The CTL schematic at PDR confirms the plug-presence switch and its reading against the jack drawing (ICD-CTL-KEY TBR row for the plug-detect wiring); if the circuit is dropped, this requirement is retired by CR. | PDR |
| REQ-SW-KEYER-039 | SW-KEYER | Draft | Robin decides at SRR on Claude's proposal; Claude produces the closing evidence | 07 section 14.2 row d fixes the minimum interval at PDR: Claude proposes it with the PDR menu and control-input design (ICD-CTL-SW) from the button debounce and the owner's control-use session on the Pico 2 development board; Robin approves it in the PDR decision memo. | PDR |
| REQ-TX-002 | TX | Draft | Robin decides at SRR on Claude's proposal; Claude produces the closing evidence | Closes with REQ-SYS-008: SRR decision 25 (owner ruling 2026-09-26) set the ADR-023 guard to 1.2 kHz, and the frequency error budget of the synthesizer and reference trade study (TS number assigned at creation) confirms it at PDR; a changed guard is carried here by the same CR. | PDR |
| REQ-TX-003 | TX | Draft | Robin decides at SRR on Claude's proposal; Claude produces the closing evidence | The PA device trade TS-003 at PDR sizes the off-state isolation of the chosen PA and envelope modulator; Robin approves the value in the PDR decision memo. | PDR |
| REQ-TX-004 | TX | Draft | Robin decides at SRR on Claude's proposal; Claude produces the closing evidence | Closes with REQ-SYS-011: SRR decision 22 (owner ruling 2026-09-26) adopted the step set (RFX-D1); the ALC loop analysis TS-006 at PDR confirms +/-1 dB at every step. | PDR |
| REQ-TX-005 | TX | Draft | Robin decides at SRR on Claude's proposal; Claude produces the closing evidence | The TS-006 envelope and PA transient simulation at PDR confirms the tolerance at the 3, 5 and 8 ms settings; Robin approves it in the PDR decision memo. | PDR |
| REQ-TX-006 | TX | Draft | Robin decides at SRR on Claude's proposal; Claude produces the closing evidence | The TS-006 envelope simulation with the PA model at PDR confirms the 750 Hz offset at every setting and tolerance corner; Robin approves it, or a replacement with the REQ-SYS-008 guard and ADR-023 adjusted to match, in the PDR decision memo. | PDR |
| REQ-TX-008 | TX | Draft | Robin decides at SRR on Claude's proposal; Claude produces the closing evidence | Closes with REQ-SYS-018: SRR decision 29 (owner ruling 2026-09-26) accepted ADR-022; TS-003 and the filter simulation at PDR show the margin achievable, else the target is revised by CR. | PDR |
| REQ-TX-009 | TX | Draft | Robin decides at SRR on Claude's proposal; Claude produces the closing evidence | TS-003 (PA device) at PDR supplies the raw second-harmonic level and the filter simulation confirms 40 dB; Robin approves the value in the PDR decision memo. | PDR |
| REQ-TX-010 | TX | Draft | Robin decides at SRR on Claude's proposal; Claude produces the closing evidence | TS-003 (PA device) at PDR supplies the raw third-harmonic level and the filter simulation confirms 35 dB; Robin approves the value in the PDR decision memo. | PDR |
| REQ-TX-011 | TX | Draft | Robin decides at SRR on Claude's proposal; Claude produces the closing evidence | The filter design at PDR shows 40 dB to 1.5 GHz with the chosen inductors' self-resonance; Robin approves the value, or a lower one with the REQ-TX-008 margin shown, in the PDR decision memo. | PDR |
| REQ-TX-012 | TX | Draft | Robin decides at SRR on Claude's proposal; Claude produces the closing evidence | Closes with REQ-SYS-151: TS-003 (PA device) at PDR confirms the harmonic levels into 2:1 by simulation; Robin approves the bound in the PDR decision memo. | PDR |
| REQ-TX-013 | TX | Draft | Robin decides at SRR on Claude's proposal; Claude produces the closing evidence | The synthesizer and reference trade study at PDR (TS number assigned at creation) fixes the division ratio, the counting input and the sample accuracy; Robin approves them in the PDR decision memo. | PDR |
| REQ-TX-014 | TX | Draft | Robin decides at SRR on Claude's proposal; Claude produces the closing evidence | The PA device trade TS-003 at PDR sizes the key-up isolation of the chosen PA and envelope modulator; Robin approves the value in the PDR decision memo. | PDR |
| REQ-TX-015 | TX | Draft | Robin decides at SRR on Claude's proposal; Claude produces the closing evidence | Closes with REQ-SYS-012: TS-003 and TS-006 at PDR set the 5 W tolerance; the RF exposure evaluation is updated with the resulting ceiling before the first OnAir series. | PDR |
| REQ-TX-016 | TX | Draft | Robin decides at SRR on Claude's proposal; Claude produces the closing evidence | Closes with REQ-SYS-176: the receiver and T/R design at PDR confirms the limit; Robin approves it or a replacement in the PDR decision memo. | PDR |

### 1.3 Key driving requirements

Requirements with `priority: KDR` (02 section 6; T-16 requires an MOP or TPM per KDR from PDR).

| ID | Title | Status | Measures (mop_ids) |
|---|---|---|---|
| REQ-SYS-008 | Transmit frequency range with band-edge guard | Active | MOP-008, TPM-006 |
| REQ-SYS-010 | Carrier frequency accuracy | Active | MOP-008, TPM-006 |
| REQ-SYS-012 | Rated output power with level control | Active | MOP-004, MOP-005, TPM-004, TPM-015 |
| REQ-SYS-017 | Spurious emission absolute limit | Active | MOP-009, TPM-007 |
| REQ-SYS-018 | Spurious emission design margin | Active | MOP-009, TPM-007 |
| REQ-SYS-022 | Minimum discernible signal | Active | MOP-006, TPM-005 |
| REQ-SYS-038 | Straight-key keying | Active | MOP-012, TPM-013 |
| REQ-SYS-039 | Iambic paddle keying | Active | MOP-012, TPM-013 |
| REQ-SYS-042 | Element and space timing accuracy | Active | MOP-012, TPM-013 |
| REQ-SYS-055 | Hardware transmit cutoff | Active | MOP-014 |
| REQ-SYS-094 | Battery life at 1:9 | Active | MOP-010, TPM-008, MOP-003, TPM-002 |
| REQ-SYS-102 | Unit mass | Active | MOP-001, TPM-001 |
| REQ-SYS-103 | External envelope | Active | MOP-002, TPM-016 |
| REQ-SYS-112 | PA thermal path at continuous key-down | Active | MOP-005, TPM-004, MOP-003 |
| REQ-SYS-121 | RF exposure evaluation | Active | MOP-018 |
| REQ-SYS-128 | Host-testable application layering | Active | MOP-015, MOP-020, TPM-017 |
| REQ-SYS-137 | Turnkey surface-mount assembly | Active | MOP-016, TPM-014, TPM-009 |
| REQ-SYS-140 | Parts sourcing | Active | MOP-016, TPM-014 |
| REQ-SW-KEYER-013 | Element and space timing | Draft | MOP-012, TPM-013 |
| REQ-SW-KEYER-014 | Timing under display and encoder load on the target | Draft | MOP-012, TPM-013 |
| REQ-TX-007 | Spurious emission absolute limit | Draft | MOP-009, TPM-007 |
| REQ-TX-008 | Spurious emission design margin | Draft | MOP-009, TPM-007 |

### 1.4 SWE-052 Table 1 coverage

One row per Class A row of NPR 7150.2D section 3.12.1 Table 1 (charter section 7). Codes planned and their gates are those of `docs/process/03-software-classification-and-rmm.md` section 8. A row that is Partial or Not enforced is checked by the product reviewer with the checklist for that product until its codes exist.

| Row | Relationship | Forward link | Backward link | Codes enforced | Codes planned (gate) | State | Note |
|---|---|---|---|---|---|---|---|
| 1 | Higher-level requirements to the software requirements | parent_id and source_ids of each requirement | child_ids of the parent | PARENT_MISSING, PARENT_UNRESOLVED, PARENT_CYCLE, CHILD_INVERSE, SELF_DERIVED_UNSUPPORTED, L1_PARENT_NOT_NULL, SOURCE_UNRESOLVED, SOURCE_L0_MISSING | none | Enforced | - |
| 2 | Software requirements to the system hazards | hazard_ids of each requirement | docs/safety/hazards.json requirement_ids and each control's control_req_ids | HAZARD_ID_FORMAT, HAZARD_UNRESOLVED, HAZARD_CONTROL_UNTRACED, SAFETY_TAG_NO_HAZARD, HAZARD_REQ_NOT_TESTED, HAZARD_REQ_NOT_ON_TARGET | HAZARD_UNCONTROLLED, before PDR (03 section 8); HAZARD_INVERSE promoted to VIOLATION, PDR (03 section 8; 04 section 7.3 rule 6 asks for every gate) | Partial | HAZARD_INVERSE is a warning in a plain run; for SW and SW-<SUB> requirements the hazards.json-to-requirement direction is the violation HAZARD_CONTROL_UNTRACED |
| 3 | Software requirements to the software design components | design_refs of each REQ-SW-* | docs/design/allocation.json element requirement lists | none | DESIGN_REF_UNRESOLVED, before PDR (03 section 8; 02 T-15); DESIGN_REF_MISSING, before PDR (03 section 8; 02 T-15); DESIGN_ELEMENT_ORPHAN, before PDR (03 section 8; 02 T-15) | Not enforced | design_refs is read into the data model; only INTERFACE_TAG_NO_ICD (T-22) reads it today |
| 4 | Software design components to the software code | design_refs Rust unit paths | @design, @req and @verify tags in firmware/**/*.rs (07 CS-24) | none | TAG_UNRESOLVED, before CDR (03 section 8; 02 T-15); REQ_UNTAGGED, before CDR (03 section 8; 02 T-15); DESIGN_ELEMENT_UNIMPLEMENTED, before CDR (03 section 8) | Not enforced | no firmware scan exists |
| 5 | Software requirements to the software verification(s) | requirement_ids of each test case | report section 3 verification matrix | REQ_UNVERIFIED, REQ_NO_CLOSING_CASE, TC_REQ_UNRESOLVED, TC_TYPE_METHOD, VERIFIED_WITHOUT_EVIDENCE, TC_STATUS_EVIDENCE, REPORT_UNRESOLVED | none | Enforced | - |
| 6 | Software requirements to the software non-conformances | requirement_ids of each docs/vv/ncr/NCR-NNN.md | report section 10.2 requirement-to-NCR list | NCR_FRONT_MATTER, NCR_ID_FORMAT, NCR_UNRESOLVED, NCR_NO_REQUIREMENT, NCR_FIELD_INVALID, VERIFIED_WITH_OPEN_NCR | none | Enforced | 03 section 8 plans NCR_BLOCKS_VERIFIED before TRR; VERIFIED_WITH_OPEN_NCR already blocks Verified for an open NCR of any severity |

## 2. Findings

### 2.1 Violations

| Code | Location | Message |
|---|---|---|
| (none) |  |  |

### 2.2 Warnings

| Code | Location | Message |
|---|---|---|
| SYS_UNALLOCATED | docs/requirements/sys/requirements.json REQ-SYS-125 | Active SYS requirement names no receiving L2 module: no child is a live L2 requirement (child_ids empty); docs/design/allocation.json lists it under no module; the reviewer confirms or corrects the gap in V6 (02 section 2.3, T-18) |
| SYS_UNALLOCATED | docs/requirements/sys/requirements.json REQ-SYS-148 | Active SYS requirement names no receiving L2 module: no child is a live L2 requirement (child_ids empty); docs/design/allocation.json lists it under no module; the reviewer confirms or corrects the gap in V6 (02 section 2.3, T-18) |

## 3. Requirements verification matrix (SE HB Appendix D)

One table per requirements document, as Appendix D permits; Retired requirements are omitted (04 section 7.1). Closing cases share the requirement's verification method; supporting cases (V&V 7.3 rule 3) cite the requirement with another method. Success criteria are the acceptance criteria of the closing cases. Facility, phase (credit event of 04 section 5.2) and performer derive from the closing cases' evidence class. Acceptance? is Yes when a `TC-ATP` case cites the requirement (initial acceptance of each unit, 04 section 11.1); Recurring acceptance? is Yes only when such a case carries `Recurring: yes` in its setup (SE HB App. D Preflight Acceptance?). Results list the latest credited report and every NCR citing the requirement.

### 3.1 Module SYS (`docs/requirements/sys/requirements.json`)

| ID | Source | Shall statement | Success criteria | Method | Evidence class | Closing cases | Supporting cases | Facility | Phase | Acceptance? | Recurring acceptance? | Performer | Results | Status |
|---|---|---|---|---|---|---|---|---|---|---|---|---|---|---|
| REQ-SYS-001 | `docs/requirements/sys/requirements.json`; CON-003, NGO-018, SI-004, 47CFR97.305(a), 47CFR97.305(c), ADR-003, OPS-004 | The transceiver shall transmit only an on-off keyed unmodulated carrier (emission A1A). | Pass if no signal-coupling path exists from any audio, sidetone or tone net to the synthesizer, PA drive, PA bias, ALC or envelope nets (DC supply and ground returns with decoupling excepted), the keying envelope is the only time-varying amplitude control of the carrier, and the only firmware writers of the envelope drive, PA enable and synthesizer frequency are the keying-envelope sequencer and the frequency-setting code; otherwise Fail. | Inspection | Inspection | TC-SYS-001 (Draft; Inspection; tools/check_tx_modulation_paths.py) | - | inspection | CDR/receipt | No | No | claude | - | Active |
| REQ-SYS-002 | `docs/requirements/sys/requirements.json`; NGO-003, NGO-021, NGO-001, OPS-001, OPS-002, OPS-011, OPS-021, OPS-022 | The transceiver shall implement the operating modes, the flags and the allowed and forbidden transitions of docs/conops/conops.md section 3.4. | Pass if each of the transitions T01 to T25 of docs/conops/conops.md Table 3.4-2 is observed from its From mode to its To mode on its event and guard in the telemetry mode sequence and on the display, no other mode change occurs, and PA_EN is high only in Transmit-keyed, Tune and a Bench-test keyed test; otherwise Fail.; Pass if PA_EN stays low and no carrier at the set frequency above -57 dBm at the antenna port on the tinySA Ultra, corrected for the attenuator and increased by the tinySA level accuracy (the RF-off level of REQ-SYS-183) for every attempt of F1 to F4 and F3's forbidden entries do not occur; the Fault-safe latch survives the reset (F5); GUEST survives the configuration reset and the firmware load (F6); the Tune carrier lasts at most 5.5 s and no carrier lasts more than 13 s (F7); the key-input mode never changes without a menu selection (F8); and Firmware-update is never entered while PA_EN is high (F9); otherwise Fail. | Test | Bench | TC-SYS-002 (Draft; Bench; tools/analyze_mode_trace.py), TC-SYS-003 (Draft; Bench; tools/analyze_mode_trace.py) | - | owner bench | TRR | No | No | owner | - | Active |
| REQ-SYS-003 | `docs/requirements/sys/requirements.json`; MOE-003, NGO-005, OPS-001 | The transceiver shall arm transmit only after a power-on self-test in which every check of the Self-test mode has passed. | Pass if for every forced check the telemetry names the failed item, the unit is in Fault-safe with the item shown and PA_EN stays low for every straight-key and paddle closure; the corrupt configuration is replaced by defaults, shown, Self-test passes and PA_EN follows the key; with the key closed at switch-on PA_EN stays low until the key has read open for 500 ms; and in the baseline PA_EN follows both keys; otherwise Fail. | Test | Bench | TC-SYS-004 (Draft; Bench; tools/analyze_logic_capture.py) | - | owner bench | TRR | No | No | owner | - | Active |
| REQ-SYS-004 | `docs/requirements/sys/requirements.json`; MOE-012, NGO-021, OPS-013, OPS-014, OPS-016, OPS-020 | The transceiver shall bring antenna-port RF to the RF-off level of REQ-SYS-183 within 20 ms (TBR) of detecting any inhibit, flag or latched fault. | Pass if, for every inhibit, flag and latched cause injected during a carrier (steps 4 to 6) with either key type, PA_EN falls at most 20 ms after the injection marker (REQ-SYS-004); for every latched cause (steps 6 and 7) the display write that shows the cause begins at most 1 s after the marker and each cause shows a message distinct from every other (REQ-SYS-067); and Fault-safe is left only through Self-test after the cause has cleared and the operator has acknowledged (steps 12 and 13) or by switch-off or power removal (steps 14 and 15), while acknowledgment with the cause present, clearance without acknowledgment and a controller reset with or without the cause present each leave the unit in Fault-safe with no PA_EN rise on any key closure (steps 8 to 11 and 13) (REQ-SYS-005); otherwise Fail. | Test | Bench | TC-SYS-005 (Draft; Bench; tools/analyze_logic_capture.py) | - | owner bench | TRR | No | No | owner | - | Active (TBR) |
| REQ-SYS-005 | `docs/requirements/sys/requirements.json`; MOE-012, OPS-013, OPS-016, OPS-021 | The transceiver shall leave Fault-safe only through Self-test after the latched cause clears and the operator acknowledges, or by switch-off or power removal. | Pass if, for every inhibit, flag and latched cause injected during a carrier (steps 4 to 6) with either key type, PA_EN falls at most 20 ms after the injection marker (REQ-SYS-004); for every latched cause (steps 6 and 7) the display write that shows the cause begins at most 1 s after the marker and each cause shows a message distinct from every other (REQ-SYS-067); and Fault-safe is left only through Self-test after the cause has cleared and the operator has acknowledged (steps 12 and 13) or by switch-off or power removal (steps 14 and 15), while acknowledgment with the cause present, clearance without acknowledgment and a controller reset with or without the cause present each leave the unit in Fault-safe with no PA_EN rise on any key closure (steps 8 to 11 and 13) (REQ-SYS-005); otherwise Fail. | Test | Bench | TC-SYS-005 (Draft; Bench; tools/analyze_logic_capture.py) | - | owner bench | TRR | No | No | owner | - | Active |
| REQ-SYS-006 | `docs/requirements/sys/requirements.json`; NGO-020, CON-006, OPS-006, ADR-015, SI-019 | The transceiver shall display, after every power-on, the operator call sign of up to 10 characters last entered. | Pass if the last-entered call sign of 1 and of 10 characters is displayed after each power-on (REQ-SYS-006), and every listed setting reads its set value after the cell removal (REQ-SYS-135); otherwise Fail. The audio-cap unlock is excluded because REQ-SYS-170 restores the cap at power-on unless a persistent unlock is selected. | Test | Bench | TC-SYS-006 (Draft; Bench) | - | owner bench | TRR | No | No | owner | - | Active |
| REQ-SYS-007 | `docs/requirements/sys/requirements.json`; CON-006, CON-005, NGO-020, 47CFR97.109(d), 47CFR97.203, 47CFR97.119(b), OPS-004 | The transceiver shall generate transmitted Morse elements only from key-jack contact closures, except in the confirmed bench test mode. | Pass if TX_KEY shows zero edges in the two 10 min jack-open captures, the five idle test-mode captures and the two idle-key captures, every non-confirmed sequence leaves the mode unchanged with zero TX_KEY edges, and the test-mode generator's first TX_KEY edge follows the start confirmation press; otherwise Fail. | Test | Bench | TC-SYS-007 (Draft; Bench; tools/analyze_logic_capture.py) | - | owner bench | TRR | No | No | owner | - | Active |
| REQ-SYS-008 | `docs/requirements/sys/requirements.json`; NGO-011, SI-024, CON-001, CON-003, ADR-016, ADR-023, OPS-020, 47CFR97.301(a) | The transceiver shall place the transmit carrier at any frequency from 144.0012 MHz to 147.9988 MHz (TBR). | Pass if at each set frequency from 144.0012 to 147.9988 MHz the unit keys and the carrier marker lies within the set frequency +/-(2.5 ppm plus the tinySA reference accuracy) (REQ-SYS-008), and at every set frequency outside 144.0012 to 147.9988 MHz PA_EN stays low, no carrier at the set frequency above -57 dBm at the antenna port on the tinySA Ultra, corrected for the attenuator and increased by the tinySA level accuracy (the RF-off level of REQ-SYS-183) and the display shows the guard inhibit (REQ-SYS-009); otherwise Fail. | Test | Bench | TC-SYS-008 (Draft; Bench) | - | owner bench | TRR | No | No | owner | - | Active (TBR) |
| REQ-SYS-009 | `docs/requirements/sys/requirements.json`; CON-003, NGO-011, OPS-020, ADR-023, 47CFR97.307(b), ADR-016 | The transceiver shall inhibit transmission whenever the set carrier frequency lies outside 144.0012 MHz to 147.9988 MHz (TBR). | Pass if at each set frequency from 144.0012 to 147.9988 MHz the unit keys and the carrier marker lies within the set frequency +/-(2.5 ppm plus the tinySA reference accuracy) (REQ-SYS-008), and at every set frequency outside 144.0012 to 147.9988 MHz PA_EN stays low, no carrier at the set frequency above -57 dBm at the antenna port on the tinySA Ultra, corrected for the attenuator and increased by the tinySA level accuracy (the RF-off level of REQ-SYS-183) and the display shows the guard inhibit (REQ-SYS-009); otherwise Fail. | Test | Bench | TC-SYS-008 (Draft; Bench) | - | owner bench | TRR | No | No | owner | - | Active (TBR) |
| REQ-SYS-010 | `docs/requirements/sys/requirements.json`; NGO-018, MOE-010, ADR-023, OPS-020, CON-016, ADR-013 | The transceiver shall hold the carrier within +/-2.5 ppm (TBR) of the displayed frequency from -10 C to +45 C for one year after calibration. | Pass if the worst-case sum of initial tolerance after calibration, -10 C to +45 C stability, one-year aging, trim resolution and synthesizer rounding is at most 2.5 ppm at 144.0012, 146.000 and 147.9988 MHz; otherwise Fail. | Analysis | Simulation | TC-SYS-009 (Draft; Simulation; tools/budgets/frequency_error_budget.py) | - | simulation | CDR | No | No | claude | - | Active (TBR) |
| REQ-SYS-011 | `docs/requirements/sys/requirements.json`; NGO-019, CON-007, SI-003, OPS-007, 47CFR97.313(a), ADR-003, ADR-014 | The transceiver shall hold 0.5, 1 and 2 W steps within +/-1 dB (TBR) into 50 ohm over the transmit range at 6.4-8.4 V pack. | Pass if the probe changes the dummy-load return loss by at most 0.5 dB from 144 to 148 MHz, the load \|Z\| at 146 MHz is 50 ohm +/-2 ohm, the correction curve covers 2 V to 25 V, and the combined power uncertainty is at most 15 percent at every listed power; otherwise Fail. The resulting uncertainty is copied into every power case that uses the probe.; Pass if at every frequency and pack voltage the probe power with its characterized uncertainty band lies entirely inside 0.397 to 0.629 W at 0.5 W, 0.794 to 1.259 W at 1 W and 1.589 to 2.518 W at 2 W (REQ-SYS-011, +/-1 dB) and inside 3.972 to 6.295 W at 5 W (REQ-SYS-012, +/-1 dB); otherwise Fail. A probe and tinySA disagreement beyond their combined uncertainty is a Procedure-correction NCR (04 section 6.2), not a requirement result. | Test | Bench | TC-SYS-010 (Draft; Bench; tools/rf_probe_power.py), TC-SYS-011 (Draft; Bench; tools/rf_probe_power.py) | - | owner bench | TRR | No | No | owner | - | Active (TBR) |
| REQ-SYS-012 | `docs/requirements/sys/requirements.json`; NGO-009, SI-003, NGO-010, NGO-002, MOE-001, MOE-002, ADR-003, ADR-012, OPS-004, ADR-005, ADR-022 | The transceiver shall hold its 5 W step within +/-1 dB (TBR) into 50 ohm over its transmit range at 6.4-8.4 V pack. | Pass if the probe changes the dummy-load return loss by at most 0.5 dB from 144 to 148 MHz, the load \|Z\| at 146 MHz is 50 ohm +/-2 ohm, the correction curve covers 2 V to 25 V, and the combined power uncertainty is at most 15 percent at every listed power; otherwise Fail. The resulting uncertainty is copied into every power case that uses the probe.; Pass if at every frequency and pack voltage the probe power with its characterized uncertainty band lies entirely inside 0.397 to 0.629 W at 0.5 W, 0.794 to 1.259 W at 1 W and 1.589 to 2.518 W at 2 W (REQ-SYS-011, +/-1 dB) and inside 3.972 to 6.295 W at 5 W (REQ-SYS-012, +/-1 dB); otherwise Fail. A probe and tinySA disagreement beyond their combined uncertainty is a Procedure-correction NCR (04 section 6.2), not a requirement result. | Test | Bench | TC-SYS-010 (Draft; Bench; tools/rf_probe_power.py), TC-SYS-011 (Draft; Bench; tools/rf_probe_power.py) | - | owner bench | TRR | No | No | owner | - | Active (TBR) |
| REQ-SYS-013 | `docs/requirements/sys/requirements.json`; OPS-015, NGO-005, MOE-003 | The transceiver shall survive 60 s of 5 W keying at 80 percent duty into any load up to SWR 10:1, including open and short. | Pass if after all 12 fixture conditions and the paddle run the 5 W step power lies inside 3.972 to 6.295 W with the probe uncertainty band, every spurious emission is at most 25 uW (-16.0 dBm) at the antenna port, the unit operates normally, and no part shows damage; otherwise Fail. Protective power reduction or inhibits during the stress are recorded and do not fail the case. | Test | Bench | TC-SYS-012 (Draft; Bench) | - | owner bench | TRR | No | No | owner | - | Active |
| REQ-SYS-014 | `docs/requirements/sys/requirements.json`; NGO-018, CON-003, OPS-004, 47CFR97.307(a), ADR-023, ADR-003 | The transceiver shall shape keyed edges as raised cosines within 5 percent, with operator-set 10-to-90 percent times of 3 to 8 ms +/-0.5 ms (TBR). | Pass if at each of the 3, 5 and 8 ms settings the simulated rise and fall are raised cosines (normalized envelope within 5 percent of full scale of the ideal raised cosine at every sample), the 10-to-90 percent times equal the setting within +/-0.5 ms, and the 26 dB bandwidth of continuous dits at 50 WPM is at most 350 Hz, nominal and at every tolerance corner; otherwise Fail. The 5 percent and +/-0.5 ms tolerances are those of REQ-SYS-014. | Analysis | Simulation | TC-SYS-013 (Draft; Simulation; hardware/sim/checks/keying_envelope_check.py) | - | simulation | CDR | No | No | claude | - | Active (TBR) |
| REQ-SYS-015 | `docs/requirements/sys/requirements.json`; CON-003, NGO-018, ADR-024, 47CFR97.307(a), OPS-004, ADR-003, ADR-023 | The transceiver shall keep its emission's 26 dB bandwidth at most 350 Hz (TBR) at every envelope setting with continuous dits at 50 WPM. | Pass if at each of the 3, 5 and 8 ms settings the simulated rise and fall are raised cosines (normalized envelope within 5 percent of full scale of the ideal raised cosine at every sample), the 10-to-90 percent times equal the setting within +/-0.5 ms, and the 26 dB bandwidth of continuous dits at 50 WPM is at most 350 Hz, nominal and at every tolerance corner; otherwise Fail. The 5 percent and +/-0.5 ms tolerances are those of REQ-SYS-014. | Analysis | Simulation | TC-SYS-013 (Draft; Simulation; hardware/sim/checks/keying_envelope_check.py) | - | simulation | CDR | No | No | claude | - | Active (TBR) |
| REQ-SYS-017 | `docs/requirements/sys/requirements.json`; CON-002, NGO-017, MOE-006, 47CFR97.307(e), ADR-021, OPS-008, ADR-003 | The transceiver shall keep every antenna-port spurious emission at most 25 uW at all power steps, carrier frequencies and 6.4 to 8.4 V pack voltages. | Pass if every spurious emission at the antenna port, corrected for the attenuator and increased by the tinySA level accuracy, is at most -16.0 dBm (25 uW) in all 24 step, frequency and pack-voltage combinations (REQ-SYS-017), and at the 5 W step at 144.05, 146.00 and 147.95 MHz every spurious emission is at least 60 dB below the mean carrier power (REQ-SYS-018), with 2f, 3f and 7f reported individually; otherwise Fail. Straight-key and paddle readings within 1 dB of the fixture readings confirm the keying source does not change the result; a larger difference is a Procedure-correction NCR. | Test | Bench | TC-SYS-014 (Draft; Bench; tools/tinysa_scan_check.py) | - | owner bench | TRR | No | No | owner | - | Active |
| REQ-SYS-018 | `docs/requirements/sys/requirements.json`; NGO-017, MOE-006, CON-002, ADR-022, 47CFR97.307(e), OPS-008, ADR-003 | The transceiver shall keep every spurious emission at least 60 dB (TBR) below the mean carrier power at the 5 W step. | Pass if every spurious emission at the antenna port, corrected for the attenuator and increased by the tinySA level accuracy, is at most -16.0 dBm (25 uW) in all 24 step, frequency and pack-voltage combinations (REQ-SYS-017), and at the 5 W step at 144.05, 146.00 and 147.95 MHz every spurious emission is at least 60 dB below the mean carrier power (REQ-SYS-018), with 2f, 3f and 7f reported individually; otherwise Fail. Straight-key and paddle readings within 1 dB of the fixture readings confirm the keying source does not change the result; a larger difference is a Procedure-correction NCR. | Test | Bench | TC-SYS-014 (Draft; Bench; tools/tinysa_scan_check.py) | - | owner bench | TRR | No | No | owner | - | Active (TBR) |
| REQ-SYS-019 | `docs/requirements/sys/requirements.json`; NGO-019, OPS-008, CON-004 | The transceiver shall transmit the tune carrier at the 0.5 W (TBR) step unless the operator confirms a higher step. | Pass if the tune carrier without a confirmed higher step lies inside 0.397 to 0.629 W with the probe uncertainty band whatever the operating step, 5 W is reached only after the confirmation (REQ-SYS-019), and every tune carrier ends at most 5.5 s after it starts (REQ-SYS-020); otherwise Fail. | Test | Bench | TC-SYS-015 (Draft; Bench; tools/analyze_logic_capture.py) | - | owner bench | TRR | No | No | owner | - | Active (TBR) |
| REQ-SYS-020 | `docs/requirements/sys/requirements.json`; NGO-019, OPS-008 | The transceiver shall end every tune carrier at most 5.5 s (TBR) after it starts. | Pass if the tune carrier without a confirmed higher step lies inside 0.397 to 0.629 W with the probe uncertainty band whatever the operating step, 5 W is reached only after the confirmation (REQ-SYS-019), and every tune carrier ends at most 5.5 s after it starts (REQ-SYS-020); otherwise Fail. | Test | Bench | TC-SYS-015 (Draft; Bench; tools/analyze_logic_capture.py) | - | owner bench | TRR | No | No | owner | - | Active (TBR) |
| REQ-SYS-021 | `docs/requirements/sys/requirements.json`; NGO-011, SI-024, CON-001, ADR-016, OPS-003 | The transceiver shall receive A1A signals at any frequency from 144.000 MHz to 148.000 MHz. | Pass if at 144.000, 146.000 and 148.000 MHz the audio RMS with the carrier present is at least 10 dB above the reading with it absent and follows the on-off keying of the source; otherwise Fail. | Test | Bench | TC-SYS-016 (Draft; Bench) | - | owner bench | TRR | No | No | owner | - | Active |
| REQ-SYS-022 | `docs/requirements/sys/requirements.json`; NGO-012, MOE-010, NGO-009, NGO-010, NGO-002, OPS-003 | The transceiver shall have a minimum discernible signal of at most -140 dBm (TBR) in a 500 Hz bandwidth. | Pass if the worst-case MDS in 500 Hz over the three frequencies and all tolerance corners is at most -140 dBm (REQ-SYS-022, noise figure 7 dB or less) and at most -142 dBm (REQ-SYS-023, noise figure 5 dB or less); otherwise Fail, reported separately for each requirement. | Analysis | Simulation | TC-SYS-017 (Draft; Simulation; tools/budgets/rx_noise_cascade.py) | - | simulation | CDR | No | No | claude | - | Active (TBR) |
| REQ-SYS-023 | `docs/requirements/sys/requirements.json`; NGO-012, MOE-010, OPS-003 | The transceiver shall have a minimum discernible signal of at most -142 dBm (TBR) in a 500 Hz bandwidth. | Pass if the worst-case MDS in 500 Hz over the three frequencies and all tolerance corners is at most -140 dBm (REQ-SYS-022, noise figure 7 dB or less) and at most -142 dBm (REQ-SYS-023, noise figure 5 dB or less); otherwise Fail, reported separately for each requirement. | Analysis | Simulation | TC-SYS-017 (Draft; Simulation; tools/budgets/rx_noise_cascade.py) | - | simulation | CDR | No | No | claude | - | Active (TBR) |
| REQ-SYS-024 | `docs/requirements/sys/requirements.json`; NGO-012, MOE-010, OPS-003, ADR-013 | The transceiver shall have a receive -6 dB bandwidth from 400 Hz to 600 Hz (TBR). | Pass if, nominal and at every tolerance corner, the -6 dB bandwidth is from 400 Hz to 600 Hz, the -60 dB bandwidth is at most 2.5 kHz, attenuation from 2 kHz to 5 kHz either side of centre is at least 60 dB, attenuation beyond 5 kHz is at least 80 dB, and passband ripple is at most 2 dB; otherwise Fail, reported per requirement. | Analysis | Simulation | TC-SYS-018 (Draft; Simulation; hardware/sim/checks/rx_selectivity_check.py) | - | simulation | CDR | No | No | claude | - | Active (TBR) |
| REQ-SYS-025 | `docs/requirements/sys/requirements.json`; NGO-012, MOE-010, OPS-003 | The transceiver shall have a receive -60 dB bandwidth of at most 2.5 kHz (TBR). | Pass if, nominal and at every tolerance corner, the -6 dB bandwidth is from 400 Hz to 600 Hz, the -60 dB bandwidth is at most 2.5 kHz, attenuation from 2 kHz to 5 kHz either side of centre is at least 60 dB, attenuation beyond 5 kHz is at least 80 dB, and passband ripple is at most 2 dB; otherwise Fail, reported per requirement. | Analysis | Simulation | TC-SYS-018 (Draft; Simulation; hardware/sim/checks/rx_selectivity_check.py) | - | simulation | CDR | No | No | claude | - | Active (TBR) |
| REQ-SYS-026 | `docs/requirements/sys/requirements.json`; NGO-012, MOE-010, OPS-003 | The transceiver shall attenuate signals from 2 kHz to 5 kHz either side of the passband centre by at least 60 dB (TBR). | Pass if, nominal and at every tolerance corner, the -6 dB bandwidth is from 400 Hz to 600 Hz, the -60 dB bandwidth is at most 2.5 kHz, attenuation from 2 kHz to 5 kHz either side of centre is at least 60 dB, attenuation beyond 5 kHz is at least 80 dB, and passband ripple is at most 2 dB; otherwise Fail, reported per requirement. | Analysis | Simulation | TC-SYS-018 (Draft; Simulation; hardware/sim/checks/rx_selectivity_check.py) | - | simulation | CDR | No | No | claude | - | Active (TBR) |
| REQ-SYS-027 | `docs/requirements/sys/requirements.json`; NGO-012, MOE-010, OPS-003 | The transceiver shall attenuate signals more than 5 kHz from the passband centre by at least 80 dB (TBR). | Pass if, nominal and at every tolerance corner, the -6 dB bandwidth is from 400 Hz to 600 Hz, the -60 dB bandwidth is at most 2.5 kHz, attenuation from 2 kHz to 5 kHz either side of centre is at least 60 dB, attenuation beyond 5 kHz is at least 80 dB, and passband ripple is at most 2 dB; otherwise Fail, reported per requirement. | Analysis | Simulation | TC-SYS-018 (Draft; Simulation; hardware/sim/checks/rx_selectivity_check.py) | - | simulation | CDR | No | No | claude | - | Active (TBR) |
| REQ-SYS-028 | `docs/requirements/sys/requirements.json`; NGO-012, MOE-010, OPS-003 | The transceiver shall have receive passband ripple of at most 2 dB (TBR). | Pass if, nominal and at every tolerance corner, the -6 dB bandwidth is from 400 Hz to 600 Hz, the -60 dB bandwidth is at most 2.5 kHz, attenuation from 2 kHz to 5 kHz either side of centre is at least 60 dB, attenuation beyond 5 kHz is at least 80 dB, and passband ripple is at most 2 dB; otherwise Fail, reported per requirement. | Analysis | Simulation | TC-SYS-018 (Draft; Simulation; hardware/sim/checks/rx_selectivity_check.py) | - | simulation | CDR | No | No | claude | - | Active (TBR) |
| REQ-SYS-029 | `docs/requirements/sys/requirements.json`; MOE-010, NGO-012, OPS-003 | The transceiver shall keep the (S+N)/N loss of a -130 dBm signal at most 3 dB (TBR) with a -60 dBm signal 2 kHz away. | Pass if the (S+N)/N loss of the -130 dBm signal with the -60 dBm signal 2 kHz away is at most 3 dB and the reciprocal-mixing dynamic range at 10 kHz offset in 500 Hz is at least 85 dB (phase noise -112 dBc/Hz or lower at 10 kHz), nominal and at the corners; otherwise Fail, reported per requirement. | Analysis | Simulation | TC-SYS-019 (Draft; Simulation; tools/budgets/rx_reciprocal_mixing.py) | - | simulation | CDR | No | No | claude | - | Active (TBR) |
| REQ-SYS-030 | `docs/requirements/sys/requirements.json`; MOE-010, NGO-012, OPS-003 | The transceiver shall hold a -130 dBm signal's audio level within 1 dB (TBR) while a keyed -60 dBm signal is 2 kHz away. | Pass if the -130 dBm signal's audio level stays within 1 dB of its level without the interferer throughout the keyed interferer run, and the audio level of the CW signal stays within a 6 dB window from -120 dBm to -20 dBm, nominal and at the corners; otherwise Fail, reported per requirement. | Analysis | Simulation | TC-SYS-020 (Draft; Simulation; hardware/sim/checks/agc_loop_check.py) | - | simulation | CDR | No | No | claude | - | Active (TBR) |
| REQ-SYS-031 | `docs/requirements/sys/requirements.json`; MOE-010, SI-029, ADR-013, OPS-003 | The transceiver shall have a reciprocal-mixing dynamic range of at least 85 dB (TBR) at 10 kHz offset in 500 Hz. | Pass if the (S+N)/N loss of the -130 dBm signal with the -60 dBm signal 2 kHz away is at most 3 dB and the reciprocal-mixing dynamic range at 10 kHz offset in 500 Hz is at least 85 dB (phase noise -112 dBc/Hz or lower at 10 kHz), nominal and at the corners; otherwise Fail, reported per requirement. | Analysis | Simulation | TC-SYS-019 (Draft; Simulation; tools/budgets/rx_reciprocal_mixing.py) | - | simulation | CDR | No | No | claude | - | Active (TBR) |
| REQ-SYS-032 | `docs/requirements/sys/requirements.json`; MOE-011, MOE-002, NGO-012, OPS-003 | The transceiver shall hold the audio of a CW signal within 6 dB (TBR) for antenna levels from -120 dBm to -20 dBm. | Pass if the -130 dBm signal's audio level stays within 1 dB of its level without the interferer throughout the keyed interferer run, and the audio level of the CW signal stays within a 6 dB window from -120 dBm to -20 dBm, nominal and at the corners; otherwise Fail, reported per requirement. | Analysis | Simulation | TC-SYS-020 (Draft; Simulation; hardware/sim/checks/agc_loop_check.py) | - | simulation | CDR | No | No | claude | - | Active (TBR) |
| REQ-SYS-033 | `docs/requirements/sys/requirements.json`; MOE-010, OPS-003, OPS-017 | The transceiver shall reject image and intermediate-frequency responses by at least 70 dB (TBR) relative to the in-band response. | Pass if every image and IF response is at least 70 dB below the in-band response at every tuned frequency, nominal and at the corners; otherwise Fail. | Analysis | Simulation | TC-SYS-021 (Draft; Simulation; tools/budgets/rx_spurious_response.py) | - | simulation | CDR | No | No | claude | - | Active (TBR) |
| REQ-SYS-034 | `docs/requirements/sys/requirements.json`; MOE-010, OPS-003, OPS-020, ADR-023 | The transceiver shall keep every internally generated receive response at most 3 dB (TBR) above the MDS from 144.010 MHz to 147.999 MHz (TBR). | Pass if the audio RMS at every tuned frequency from 144.010 to 147.999 MHz is at most 1.41 times the noise reference (at most 3 dB above the MDS noise level); otherwise Fail. If neither the Bench-test sweep nor a 250 Hz manual sweep of the full range is available, the case result is Blocked for the unswept frequencies and the owner decides at TRR. | Test | Bench | TC-SYS-022 (Draft; Bench; tools/analyze_birdie_survey.py) | - | owner bench | TRR | No | No | owner | - | Active (TBR) |
| REQ-SYS-035 | `docs/requirements/sys/requirements.json`; NGO-012, OPS-003, OPS-012 | The transceiver shall store a per-unit receive filter-centre calibration trim adjustable over +/-500 Hz (TBR) in 10 Hz steps. | Pass if the trim takes -500, 0 and +500 Hz, moves in single 10 Hz steps, does not go beyond +/-500 Hz, and the stored value is shown unchanged after the power cycle; otherwise Fail. | Demonstration | Bench | TC-SYS-023 (Draft; Bench) | - | owner bench | TRR | No | No | owner | - | Active (TBR) |
| REQ-SYS-036 | `docs/requirements/sys/requirements.json`; NGO-014, CON-021, MOE-005, OPS-004 | The transceiver shall restore receive sensitivity to within 3 dB of the MDS within 50 ms (TBR) after the hang time expires. | Pass if the receive chain is within 3 dB of its steady MDS at most 50 ms after hang expiry, nominal and at the corners; otherwise Fail. | Analysis | Simulation | TC-SYS-024 (Draft; Simulation; hardware/sim/checks/rx_recovery_check.py) | - | simulation | CDR | No | No | claude | - | Active (TBR) |
| REQ-SYS-037 | `docs/requirements/sys/requirements.json`; NGO-005, OPS-017, OPS-018, MOE-010, SI-019 | The transceiver shall survive a +27 dBm (TBR) signal at the antenna port in receive without damage. | Pass if the level delivered to the antenna port is at least +27 dBm during both runs and, afterwards, the noise-floor and tone audio readings are within 1 dB of their values before the runs; otherwise Fail. | Test | Bench | TC-SYS-025 (Draft; Bench) | - | owner bench | TRR | No | No | owner | - | Active (TBR) |
| REQ-SYS-038 | `docs/requirements/sys/requirements.json`; NGO-003, SI-018, CON-012, ADR-009, OPS-005, MOE-005 | The transceiver shall key the transmitter for the duration of each straight-key closure at the key jack. | Pass if every straight-key closure keys the transmitter for the duration of the closure (REQ-SYS-038) and the paddle closures key the transmitter with the Morse elements of the text sent (REQ-SYS-039), as observed by the owner and shown in the capture; otherwise Fail. | Demonstration | Bench | TC-SYS-026 (Draft; Bench) | - | owner bench | TRR | No | No | owner | - | Active |
| REQ-SYS-039 | `docs/requirements/sys/requirements.json`; NGO-003, SI-018, CON-012, ADR-009, OPS-004, MOE-005 | The transceiver shall key the transmitter with Morse elements generated from iambic paddle closures at the key jack. | Pass if every straight-key closure keys the transmitter for the duration of the closure (REQ-SYS-038) and the paddle closures key the transmitter with the Morse elements of the text sent (REQ-SYS-039), as observed by the owner and shown in the capture; otherwise Fail. | Demonstration | Bench | TC-SYS-026 (Draft; Bench) | - | owner bench | TRR | No | No | owner | - | Active |
| REQ-SYS-040 | `docs/requirements/sys/requirements.json`; NGO-013, MOE-005, SI-018, OPS-004, ADR-009 | The transceiver shall provide the operator-selected keyer modes Straight, Iambic A, Iambic B, Ultimatic and Bug. | Pass if in each of the five modes every captured element and space matches the reference model output in sequence, and each element edge is within +/-1 percent or +/-0.5 ms (whichever is larger) of the model's timing; otherwise Fail. | Test | Bench | TC-SYS-027 (Draft; Bench; tools/keyer_ref.py) | - | owner bench | TRR | No | No | owner | - | Active |
| REQ-SYS-041 | `docs/requirements/sys/requirements.json`; NGO-013, SI-033, ADR-024, SI-019, OPS-004 | The transceiver shall generate paddle Morse elements at any operator-selected speed from 5 to 50 WPM in 1 WPM steps. | Pass if the menu offers every integer speed from 5 to 50 WPM and no other, each captured run's dit equals 1200/WPM ms at its setting (REQ-SYS-041), and every element and space at 5, 25 and 50 WPM (and the other captured speeds) is within +/-1 percent or +/-0.5 ms, whichever is larger, of its nominal (dit 1200/WPM ms, dah three dits, space one dit) (REQ-SYS-042), each tolerance widened by one capture sample; otherwise Fail. | Test | Bench | TC-SYS-028 (Draft; Bench; tools/analyze_keyer_capture.py) | - | owner bench | TRR | No | No | owner | - | Active |
| REQ-SYS-042 | `docs/requirements/sys/requirements.json`; NGO-013, MOE-005, CON-025, OPS-004, ADR-024 | The transceiver shall time keyer-generated elements and spaces at the keyer test point within the larger of +/-1 percent and +/-0.5 ms of nominal. | Pass if the menu offers every integer speed from 5 to 50 WPM and no other, each captured run's dit equals 1200/WPM ms at its setting (REQ-SYS-041), and every element and space at 5, 25 and 50 WPM (and the other captured speeds) is within +/-1 percent or +/-0.5 ms, whichever is larger, of its nominal (dit 1200/WPM ms, dah three dits, space one dit) (REQ-SYS-042), each tolerance widened by one capture sample; otherwise Fail. | Test | Bench | TC-SYS-028 (Draft; Bench; tools/analyze_keyer_capture.py) | - | owner bench | TRR | No | No | owner | - | Active |
| REQ-SYS-043 | `docs/requirements/sys/requirements.json`; NGO-013, MOE-005, OPS-004, ADR-024 | The transceiver shall start each paddle-initiated element at the keyer test point within 3 ms of paddle closure while no element is in progress. | Pass if every paddle-initiated element from idle starts at the keyer test point at most 3 ms after the contact closure at 15 and 50 WPM (REQ-SYS-043), and the sidetone starts at most 4 ms after the contact closure for all 50 paddle and 50 straight-key closures (REQ-SYS-159); otherwise Fail. | Test | Bench | TC-SYS-029 (Draft; Bench; tools/analyze_logic_capture.py) | - | owner bench | TRR | No | No | owner | - | Active |
| REQ-SYS-044 | `docs/requirements/sys/requirements.json`; CON-021, SI-036, NGO-014, ADR-010, ADR-026, OPS-004 | The transceiver shall return to receive 3 to 30 operator-set dits (TBR) after the last key-up, within the larger of +/-1 percent and +/-0.5 ms. | Pass if for every speed and setting the time from the last key-up to the return to receive equals the setting times 1200/WPM ms within +/-1 percent or +/-0.5 ms, whichever is larger, for both key types; otherwise Fail. The tolerance is that of REQ-SYS-044. | Test | Bench | TC-SYS-030 (Draft; Bench; tools/analyze_logic_capture.py) | - | owner bench | TRR | No | No | owner | - | Active (TBR) |
| REQ-SYS-045 | `docs/requirements/sys/requirements.json`; NGO-014, SI-036, OPS-004 | The transceiver shall generate a sidetone at an operator-set frequency from 300 Hz to 1000 Hz in 10 Hz steps, each within +/-5 Hz. | Pass if the menu offers 300 to 1000 Hz in 10 Hz steps and each measured tone is within +/-5 Hz of its setting for both key types; otherwise Fail. The +/-5 Hz tolerance is that of REQ-SYS-045. | Test | Bench | TC-SYS-031 (Draft; Bench; tools/analyze_logic_capture.py) | - | owner bench | TRR | No | No | owner | - | Active |
| REQ-SYS-046 | `docs/requirements/sys/requirements.json`; NGO-014, MOE-010, OPS-004, OPS-003 | The transceiver shall reproduce a carrier received at its own transmit frequency as an audio tone at the sidetone frequency within 10 Hz. | Pass if the received pitch equals the sidetone frequency within 10 Hz at every sidetone setting from 300 to 1000 Hz and every trim value; otherwise Fail. | Analysis | Simulation | TC-SYS-032 (Draft; Simulation; tools/budgets/frequency_plan_check.py) | - | simulation | CDR | No | No | claude | - | Active |
| REQ-SYS-047 | `docs/requirements/sys/requirements.json`; CON-012, SI-034, OPS-005, ADR-009 | The transceiver shall read a key contact as closed at 500 ohm or less and as open at 100 kohm or more. | Pass if, before and after the abuse, each contact reads closed at 0, 100 and 500 ohm and open at 100 kohm, 1 Mohm and open (REQ-SYS-047), and after 10 min at +12 V and at -5 V on each contact the thresholds still pass and both keys key normally with no damage (REQ-SYS-049); otherwise Fail. | Test | Bench | TC-SYS-033 (Draft; Bench) | - | owner bench | TRR | No | No | owner | - | Active |
| REQ-SYS-048 | `docs/requirements/sys/requirements.json`; MOE-005, CON-012, OPS-005, ADR-009 | The transceiver shall accept a key closure after 2 ms (TBR) of continuous contact. | Pass if the number of accepted closures and openings equals the number of physical operations, every accepted closure follows at least 2 ms of continuous contact (REQ-SYS-048) and every accepted opening follows at least 5 ms of continuous break (REQ-SYS-162), each duration measured from the capture less one capture sample period (the decision rule of docs/process/04-verification-and-validation.md section 8.2), for both key types; otherwise Fail. The delay from 2 ms and 5 ms to each acceptance is recorded as data; its bound is the keying latency of REQ-SYS-043. | Test | Bench | TC-SYS-034 (Draft; Bench; tools/analyze_logic_capture.py) | - | owner bench | TRR | No | No | owner | - | Active (TBR) |
| REQ-SYS-049 | `docs/requirements/sys/requirements.json`; CON-012, OPS-013, OPS-017, ADR-009 | The transceiver shall survive a DC voltage from -5 V to +12 V applied for 10 min (TBR) to any key-jack contact without damage. | Pass if, before and after the abuse, each contact reads closed at 0, 100 and 500 ohm and open at 100 kohm, 1 Mohm and open (REQ-SYS-047), and after 10 min at +12 V and at -5 V on each contact the thresholds still pass and both keys key normally with no damage (REQ-SYS-049); otherwise Fail. | Test | Bench | TC-SYS-033 (Draft; Bench) | - | owner bench | TRR | No | No | owner | - | Active (TBR) |
| REQ-SYS-050 | `docs/requirements/sys/requirements.json`; CON-016, CON-012, OPS-017, ADR-009 | The transceiver shall survive IEC 61000-4-2 level 4 discharges (8 kV contact, 15 kV air) at the key jack, headphone jack and antenna port. | Pass if every exposed conductor at the key jack, headphone jack and antenna port has a clamp rated for IEC 61000-4-2 level 4 (8 kV contact, 15 kV air) or is chassis ground, every residual pin voltage is below the protected part's absolute maximum, and every clamp has a direct chassis return; otherwise Fail. | Analysis | Simulation | TC-SYS-035 (Draft; Simulation; tools/budgets/esd_clamp_check.py) | - | simulation | CDR | No | No | claude | - | Active |
| REQ-SYS-051 | `docs/requirements/sys/requirements.json`; OPS-017, CON-012, MOE-012, ADR-009 | The transceiver shall hold both key-input states unchanged while transmitting at 5 W with 1.5 m unshielded leads on the key and headphone jacks. | Pass if neither key input changes state during any tune-carrier run into the dummy load or the reference antenna, and during the hand-keyed minutes the inputs change only with the contacts; and the capture shows TX_KEY keying through the whole of each hand-keyed minute; otherwise Fail. | Test | Bench | TC-SYS-036 (Draft; Bench; tools/analyze_logic_capture.py) | - | owner bench | TRR | No | No | owner | - | Active |
| REQ-SYS-052 | `docs/requirements/sys/requirements.json`; NGO-021, MOE-012, OPS-013, OPS-005, OPS-021, ADR-009 | The transceiver shall keep transmit disarmed after each power-on, reset or key-mode change until each input the mode uses reads open for 500 ms (TBR). | Pass if the key-input mode never changes on plug insertion or removal (REQ-SYS-056), the Straight-on-tip selection is accepted with the ring closed (REQ-SYS-163), and after each power-on, reset and mode change PA_EN stays low for key closures until each input the mode uses has read open for 500 ms and follows the key after that (REQ-SYS-052); otherwise Fail. | Test | Bench | TC-SYS-037 (Draft; Bench; tools/analyze_logic_capture.py) | - | owner bench | TRR | No | No | owner | - | Active (TBR) |
| REQ-SYS-053 | `docs/requirements/sys/requirements.json`; NGO-021, MOE-012, OPS-013, ADR-009 | The transceiver shall keep the transmitter unkeyed from 5 s (TBR) of any continuous manually timed key closure until that contact opens. | Pass if (REQ-SYS-053) for every manually timed hold the transmitter is unkeyed no later than 5 s after the accepted closure until the contact opens and the closure made 1 s after the release keys the transmitter; (REQ-SYS-054) in every held-lever run, alternating run without a qualifying gap and 0.8-times gap run, keying ends at the first of the end of the 128th consecutive identical element (no 129th begins) and 30 s after the end of the last qualifying gap (no TX_KEY rise begins later than 30 s after it), keying does not end in the 1.2-times gap runs, PA_EN and TX_KEY do not rise from the end of keying until both paddle contacts read open, and the dit sent 1 s after both contacts read open keys the transmitter; the fault-injected stream ends under the same 30 s bound; (REQ-SYS-184) for every 3 s squeeze and every plug insertion in Iambic A, Iambic B and Ultimatic, no TX_KEY rise begins later than 2 s after both contacts read closed, TX_KEY stays low while both stay closed, and after the dit contact opens the held dah contact keys dahs, while every 1.5 s squeeze and every squeezed character at 25 WPM is keyed completely as tools/keyer_ref.py predicts; otherwise Fail. Each time is measured from the capture edges with one capture sample period added (the decision rule of docs/process/04-verification-and-validation.md section 8.2), against the 5 s, 30 s and 2 s bounds of the requirements. The 5 WPM squeezed-character results and the behaviour after the end of the fault-injected stream (both contacts open throughout) are recorded as data and do not decide the result. | Test | Bench | TC-SYS-038 (Draft; Bench; tools/analyze_logic_capture.py) | - | owner bench | TRR | No | No | owner | - | Active (TBR) |
| REQ-SYS-054 | `docs/requirements/sys/requirements.json`; NGO-021, MOE-012, OPS-013, ADR-009 | The transceiver shall end keying until both paddles open after 128 consecutive identical elements or 30 s (TBR) without min(7-dit, 500 ms) gaps (TBR). | Pass if (REQ-SYS-053) for every manually timed hold the transmitter is unkeyed no later than 5 s after the accepted closure until the contact opens and the closure made 1 s after the release keys the transmitter; (REQ-SYS-054) in every held-lever run, alternating run without a qualifying gap and 0.8-times gap run, keying ends at the first of the end of the 128th consecutive identical element (no 129th begins) and 30 s after the end of the last qualifying gap (no TX_KEY rise begins later than 30 s after it), keying does not end in the 1.2-times gap runs, PA_EN and TX_KEY do not rise from the end of keying until both paddle contacts read open, and the dit sent 1 s after both contacts read open keys the transmitter; the fault-injected stream ends under the same 30 s bound; (REQ-SYS-184) for every 3 s squeeze and every plug insertion in Iambic A, Iambic B and Ultimatic, no TX_KEY rise begins later than 2 s after both contacts read closed, TX_KEY stays low while both stay closed, and after the dit contact opens the held dah contact keys dahs, while every 1.5 s squeeze and every squeezed character at 25 WPM is keyed completely as tools/keyer_ref.py predicts; otherwise Fail. Each time is measured from the capture edges with one capture sample period added (the decision rule of docs/process/04-verification-and-validation.md section 8.2), against the 5 s, 30 s and 2 s bounds of the requirements. The 5 WPM squeezed-character results and the behaviour after the end of the fault-injected stream (both contacts open throughout) are recorded as data and do not decide the result. | Test | Bench | TC-SYS-038 (Draft; Bench; tools/analyze_logic_capture.py) | - | owner bench | TRR | No | No | owner | - | Active (TBR) |
| REQ-SYS-055 | `docs/requirements/sys/requirements.json`; NGO-021, MOE-012, OPS-013, OPS-021, ADR-009 | The transceiver shall end antenna-port RF, independently of firmware, 7.5 s to 13 s (TBR) into any continuous key-down, 10 s nominal. | Pass if in every run antenna-port RF ends between 7.5 s and 13 s after the start of the continuous key-down while TX_KEY is still commanded high; otherwise Fail. | Test | Bench | TC-SYS-039 (Draft; Bench) | - | owner bench | TRR | No | No | owner | - | Active (TBR) |
| REQ-SYS-056 | `docs/requirements/sys/requirements.json`; NGO-021, OPS-013, CON-012, ADR-009 | The transceiver shall change the key-input mode only by an explicit operator menu selection. | Pass if the key-input mode never changes on plug insertion or removal (REQ-SYS-056), the Straight-on-tip selection is accepted with the ring closed (REQ-SYS-163), and after each power-on, reset and mode change PA_EN stays low for key closures until each input the mode uses has read open for 500 ms and follows the key after that (REQ-SYS-052); otherwise Fail. | Test | Bench | TC-SYS-037 (Draft; Bench; tools/analyze_logic_capture.py) | - | owner bench | TRR | No | No | owner | - | Active |
| REQ-SYS-057 | `docs/requirements/sys/requirements.json`; CON-023, SI-006, NGO-015, ADR-006, OPS-003 | The transceiver shall provide exactly two rotary knobs with push action and two push buttons as operator controls, besides the power switch. | Pass if the renders and BOM show exactly two rotary knobs with push action and exactly two push buttons as operator controls besides the power switch, the bounding box excluding antenna and knobs is at most 140 mm x 70 mm x 40 mm, and the antenna port lies on one end face only; otherwise Fail. | Inspection | Inspection | TC-SYS-040 (Draft; Inspection; hardware/enclosure/checks/enclosure_inspect.py) | - | inspection | CDR/receipt | No | No | claude | - | Active |
| REQ-SYS-058 | `docs/requirements/sys/requirements.json`; NGO-015, CON-023, OPS-003, ADR-006 | The transceiver shall change frequency by one step per tuning-knob detent, the step growing from 10 Hz to 10 kHz (TBR) with rotation rate. | Pass if every detent produces exactly one frequency change, every step lies between 10 Hz and 10 kHz, slow single detents step 10 Hz, and the step never decreases as the detent rate increases (REQ-SYS-058), and at a measured mean rate of 2.0 +/-0.2 revolutions per second the tuning from 144.000 to 148.000 MHz takes at most 30 s (REQ-SYS-164); otherwise Fail. | Test | Bench | TC-SYS-041 (Draft; Bench; tools/analyze_logic_capture.py) | - | owner bench | TRR | No | No | owner | - | Active (TBR) |
| REQ-SYS-059 | `docs/requirements/sys/requirements.json`; CON-023, SI-006, MOE-011, OPS-003 | The transceiver shall set headphone level with the volume knob in at least 32 steps (TBR) from mute to the active level cap. | Pass if at least 32 detent positions give levels that increase strictly from mute to the active cap and the last level equals the active cap within the meter accuracy; otherwise Fail. | Test | Bench | TC-SYS-042 (Draft; Bench) | - | owner bench | TRR | No | No | owner | - | Active (TBR) |
| REQ-SYS-060 | `docs/requirements/sys/requirements.json`; NGO-015, MOE-008, OPS-003, OPS-007 | The transceiver shall show frequency, power step, key mode, keyer speed, battery state and transmit state in Receive, Transmit-keyed and Tune modes outside menus. | Pass if all six items are shown in Receive, Transmit-keyed and Tune (REQ-SYS-060) and every operator setting is reached within two menu levels from the status screen (REQ-SYS-062); otherwise Fail. | Demonstration | Bench | TC-SYS-043 (Draft; Bench) | - | owner bench | TRR | No | No | owner | - | Active |
| REQ-SYS-061 | `docs/requirements/sys/requirements.json`; NGO-015, CON-023, OPS-003 | The transceiver shall display the frequency in characters at least 4.0 mm (TBR) high. | Pass if the frequency digit height, computed as pixels times the datasheet pixel pitch, is at least 4.0 mm; otherwise Fail. | Inspection | Inspection | TC-SYS-044 (Draft; Inspection; tools/check_display_glyph.py) | - | inspection | CDR/receipt | No | No | claude | - | Active (TBR) |
| REQ-SYS-062 | `docs/requirements/sys/requirements.json`; MOE-008, NGO-015, OPS-006 | The transceiver shall reach every operator setting within two menu levels (TBR) from the status screen. | Pass if all six items are shown in Receive, Transmit-keyed and Tune (REQ-SYS-060) and every operator setting is reached within two menu levels from the status screen (REQ-SYS-062); otherwise Fail. | Demonstration | Bench | TC-SYS-043 (Draft; Bench) | - | owner bench | TRR | No | No | owner | - | Active (TBR) |
| REQ-SYS-063 | `docs/requirements/sys/requirements.json`; NGO-019, OPS-007, ADR-003, ADR-014 | The transceiver shall select the 5 W step only after a step selection followed by a separate confirmation press. | Pass if every sequence without the confirmation press leaves the displayed step below 5 W with probe power (with uncertainty) at most 2.518 W, and the sequence with the confirmation shows 5 W with probe power inside 3.972 to 6.295 W; otherwise Fail. | Test | Bench | TC-SYS-045 (Draft; Bench) | - | owner bench | TRR | No | No | owner | - | Active |
| REQ-SYS-064 | `docs/requirements/sys/requirements.json`; NGO-019, OPS-001, OPS-007, ADR-003, ADR-014 | The transceiver shall select the 1 W (TBR) step at first power-on and after every configuration reset. | Pass if after the configuration reset and after the first power-on the step is 1 W with probe power inside 0.794 to 1.259 W (REQ-SYS-064), and the menus show Iambic A, 15 WPM, 600 Hz sidetone, 8-dit hang and 5 ms envelope, corroborated by a captured dit of 80 ms +/-1 percent, a sidetone of 600 Hz +/-5 Hz and a hang of 640 ms +/-1 percent (REQ-SYS-136); otherwise Fail. | Test | Bench | TC-SYS-046 (Draft; Bench; tools/analyze_logic_capture.py) | - | owner bench | TRR | No | No | owner | - | Active (TBR) |
| REQ-SYS-065 | `docs/requirements/sys/requirements.json`; NGO-020, MOE-009, CON-006, ADR-015, OPS-019, 47CFR97.7 | The transceiver shall produce no RF output from any source while guest lock is set, including after power cycles. | Pass if every sequence other than the held combination followed by the confirmation leaves the lock state unchanged on both a locked and an unlocked unit (REQ-SYS-066), and while locked, before and after the power cycle and the configuration reset, PA_EN stays low and no carrier at the set frequency above -57 dBm at the antenna port on the tinySA Ultra, corrected for the attenuator and increased by the tinySA level accuracy (the RF-off level of REQ-SYS-183) for every keying, tune and test-mode attempt (REQ-SYS-065); otherwise Fail. | Test | Bench | TC-SYS-047 (Draft; Bench) | - | owner bench | TRR | No | No | owner | - | Active |
| REQ-SYS-066 | `docs/requirements/sys/requirements.json`; NGO-020, ADR-015, OPS-019 | The transceiver shall set and release guest lock only by a two-step action of a held button combination followed by a confirmation. | Pass if every sequence other than the held combination followed by the confirmation leaves the lock state unchanged on both a locked and an unlocked unit (REQ-SYS-066), and while locked, before and after the power cycle and the configuration reset, PA_EN stays low and no carrier at the set frequency above -57 dBm at the antenna port on the tinySA Ultra, corrected for the attenuator and increased by the tinySA level accuracy (the RF-off level of REQ-SYS-183) for every keying, tune and test-mode attempt (REQ-SYS-065); otherwise Fail. | Test | Bench | TC-SYS-047 (Draft; Bench) | - | owner bench | TRR | No | No | owner | - | Active |
| REQ-SYS-067 | `docs/requirements/sys/requirements.json`; MOE-012, OPS-013, OPS-014, OPS-016 | The transceiver shall display a distinct cause message for each detected fault type within 1 s (TBR) of detection. | Pass if, for every inhibit, flag and latched cause injected during a carrier (steps 4 to 6) with either key type, PA_EN falls at most 20 ms after the injection marker (REQ-SYS-004); for every latched cause (steps 6 and 7) the display write that shows the cause begins at most 1 s after the marker and each cause shows a message distinct from every other (REQ-SYS-067); and Fault-safe is left only through Self-test after the cause has cleared and the operator has acknowledged (steps 12 and 13) or by switch-off or power removal (steps 14 and 15), while acknowledgment with the cause present, clearance without acknowledgment and a controller reset with or without the cause present each leave the unit in Fault-safe with no PA_EN rise on any key closure (steps 8 to 11 and 13) (REQ-SYS-005); otherwise Fail. | Test | Bench | TC-SYS-005 (Draft; Bench; tools/analyze_logic_capture.py) | - | owner bench | TRR | No | No | owner | - | Active (TBR) |
| REQ-SYS-068 | `docs/requirements/sys/requirements.json`; CON-005, NGO-020, OPS-004, 47CFR97.119(a) | The transceiver shall show an identification reminder 9 min 00 s +/-5 s (TBR) after the first transmission following the previous reminder. | Pass if in both runs the reminder is shown 540 s +/-5 s after the first transmission following the previous reminder; otherwise Fail. | Test | Bench | TC-SYS-048 (Draft; Bench; tools/analyze_logic_capture.py) | - | owner bench | TRR | No | No | owner | - | Active (TBR) |
| REQ-SYS-069 | `docs/requirements/sys/requirements.json`; NGO-019, OPS-018, CON-004 | The transceiver shall display, for the active step and mode, the bystander separation (TBR) of the RF exposure evaluation at that step's maximum permitted power. | Pass if the displayed separation for every step and for Tune equals the evaluation's value (REQ-SYS-069), and the displayed 6 min and 30 min totals equal the captured key-down sums over the last 360 s and over the run within +/-1 s at 1 s resolution at both readings (REQ-SYS-171); otherwise Fail. | Test | Bench | TC-SYS-049 (Draft; Bench; tools/analyze_logic_capture.py) | - | owner bench | TRR | No | No | owner | - | Active (TBR) |
| REQ-SYS-070 | `docs/requirements/sys/requirements.json`; MOE-004, OPS-002, NGO-022 | The transceiver shall indicate the charge state whenever USB power is present, including with the power switch off. | Pass if VBUS current, with the meter accuracy added, is at most 500 mA in every state (REQ-SYS-090); the charge state is indicated in every charge phase with the switch off and with it on (REQ-SYS-070); and with the switch on and USB present the charge current into the pack, with the meter accuracy added, is below 5 mA (REQ-SYS-093); otherwise Fail. The 5 mA level is that of REQ-SYS-093. | Test | Bench | TC-SYS-050 (Draft; Bench) | - | owner bench | TRR | No | No | owner | - | Active |
| REQ-SYS-071 | `docs/requirements/sys/requirements.json`; NGO-016, MOE-011, CON-013, OPS-003 | The transceiver shall limit headphone output into 32 ohm to 100 mVrms +/-10 percent (TBR) for a full-scale 700 Hz sine, independently of firmware. | Pass if the full-scale 700 Hz sine gives 90 to 110 mVrms (100 mVrms +/-10 percent) into 32 ohm on each channel, reading and meter accuracy combined (REQ-SYS-071), and every test pattern gives at most 150 mVrms into 32 ohm on each channel with the meter accuracy added (REQ-SYS-072); otherwise Fail. | Test | Bench | TC-SYS-051 (Draft; Bench) | - | owner bench | TRR | No | No | owner | - | Active (TBR) |
| REQ-SYS-072 | `docs/requirements/sys/requirements.json`; NGO-016, MOE-011, OPS-003 | The transceiver shall limit headphone output into 32 ohm to at most 150 mVrms (TBR) for any digital audio pattern. | Pass if the full-scale 700 Hz sine gives 90 to 110 mVrms (100 mVrms +/-10 percent) into 32 ohm on each channel, reading and meter accuracy combined (REQ-SYS-071), and every test pattern gives at most 150 mVrms into 32 ohm on each channel with the meter accuracy added (REQ-SYS-072); otherwise Fail. | Test | Bench | TC-SYS-051 (Draft; Bench) | - | owner bench | TRR | No | No | owner | - | Active (TBR) |
| REQ-SYS-073 | `docs/requirements/sys/requirements.json`; NGO-016, MOE-011 | The transceiver shall keep headphone output into 32 ohm at or below 150 mVrms (TBR) after any single component failure in the output path. | Pass if the RMS output into 32 ohm is at most 150 mVrms on each channel for the nominal case and for every single open or short failure of each part in the output path; otherwise Fail. | Analysis | Simulation | TC-SYS-052 (Draft; Simulation; hardware/sim/checks/audio_single_fault_check.py) | - | simulation | CDR | No | No | claude | - | Active (TBR) |
| REQ-SYS-074 | `docs/requirements/sys/requirements.json`; NGO-016, MOE-011, OPS-003 | The transceiver shall cap headphone output at 30 mVrms (TBR) into 32 ohm until the operator acknowledges a high-level warning. | Pass if before acknowledgment, and after each power-on without a persistent unlock, the output is at most 30 mVrms into 32 ohm on each channel with the meter accuracy added (REQ-SYS-074, REQ-SYS-170), and after acknowledgment and after a power-on with the persistent unlock the output exceeds 30 mVrms; otherwise Fail. | Test | Bench | TC-SYS-053 (Draft; Bench) | - | owner bench | TRR | No | No | owner | - | Active (TBR) |
| REQ-SYS-075 | `docs/requirements/sys/requirements.json`; NGO-016, MOE-011, SI-036, OPS-004 | The transceiver shall attenuate receive audio by at least 60 dB within 2 ms of key-down through a raised-cosine fade. | Pass if receive audio is attenuated by at least 60 dB within 2 ms of key-down through a raised-cosine fade (REQ-SYS-075), stays at least 60 dB below its unmuted level from the first key-down to hang expiry at every speed (REQ-SYS-157), and is restored at hang expiry by a raised-cosine fade lasting 5 ms to 20 ms (REQ-SYS-158), with the fade shapes within 5 percent of full scale of the ideal raised cosine; otherwise Fail, reported per requirement. | Analysis | Simulation | TC-SYS-054 (Draft; Simulation; hardware/sim/checks/audio_mute_fade_check.py) | - | simulation | CDR | No | No | claude | - | Active |
| REQ-SYS-076 | `docs/requirements/sys/requirements.json`; MOE-011, NGO-016, CON-016 | The transceiver shall keep headphone transients at key-down, key-up, hang expiry, plug insertion and power-on below 10 mV peak (TBR) into 32 ohm. | Pass if the peak transient across 32 ohm is below 10 mV on each channel for every event, nominal and at the corners; otherwise Fail. | Analysis | Simulation | TC-SYS-055 (Draft; Simulation; hardware/sim/checks/audio_transient_check.py) | - | simulation | CDR | No | No | claude | - | Active (TBR) |
| REQ-SYS-077 | `docs/requirements/sys/requirements.json`; NGO-016, CON-013, OPS-003 | The transceiver shall disable the headphone amplifier output within 20 ms of plug removal and while no plug is inserted. | Pass if the amplifier enable is low whenever the jack reads no plug, allowing at most 20 ms after each removal edge, and is never high at power-on without a plug; otherwise Fail. The 20 ms is that of REQ-SYS-077, measured with one capture sample period added. | Test | Bench | TC-SYS-056 (Draft; Bench; tools/analyze_logic_capture.py) | - | owner bench | TRR | No | No | owner | - | Active |
| REQ-SYS-078 | `docs/requirements/sys/requirements.json`; CON-013, SI-005, OPS-003 | The transceiver shall drive both headphone channels within 1 dB (TBR) of each other at the active cap into 16 to 64 ohm. | Pass if tip and ring RMS differ by at most 1 dB at the active cap into each of 16, 32 and 64 ohm (REQ-SYS-078), and after the 10 min short each channel's 32 ohm RMS is within 1 dB of its value before the short with no damage (REQ-SYS-079); otherwise Fail. | Test | Bench | TC-SYS-057 (Draft; Bench) | - | owner bench | TRR | No | No | owner | - | Active (TBR) |
| REQ-SYS-079 | `docs/requirements/sys/requirements.json`; CON-013, OPS-013 | The transceiver shall survive an indefinite short of either headphone contact to sleeve without damage. | Pass if tip and ring RMS differ by at most 1 dB at the active cap into each of 16, 32 and 64 ohm (REQ-SYS-078), and after the 10 min short each channel's 32 ohm RMS is within 1 dB of its value before the short with no damage (REQ-SYS-079); otherwise Fail. | Test | Bench | TC-SYS-057 (Draft; Bench) | - | owner bench | TRR | No | No | owner | - | Active |
| REQ-SYS-080 | `docs/requirements/sys/requirements.json`; CON-011, SI-023, ADR-005, OPS-012 | The transceiver shall hold two 18650 Li-ion cells in series in holders that allow cell replacement without soldering. | Pass if the BOM and schematic show two series 18650 cells in holders removable without soldering, a 50 ohm stainless-steel SMA jack with female body as the antenna port, the Raspberry Pi Pico 2 module as the only controller, and a 3.5 mm TRS key jack wired tip dit or straight key, ring dah and sleeve common in agreement with ICD-CTL-KEY; otherwise Fail. | Inspection | Inspection | TC-SYS-058 (Draft; Inspection; tools/check_bom.py) | - | inspection | CDR/receipt | No | No | claude | - | Active |
| REQ-SYS-081 | `docs/requirements/sys/requirements.json`; NGO-022, OPS-002, CON-011 | The transceiver shall terminate charging at 4.20 V +/-0.5 percent (TBR) per cell. | Pass if each cell voltage at termination is 4.179 to 4.221 V (4.20 V +/-0.5 percent) with the meter accuracy included (REQ-SYS-081), and the pack reaches termination at most 12 h after USB is applied (REQ-SYS-091); otherwise Fail. | Test | Bench | TC-SYS-059 (Draft; Bench) | - | owner bench | TRR | No | No | owner | - | Active (TBR) |
| REQ-SYS-082 | `docs/requirements/sys/requirements.json`; NGO-022, NGO-026, OPS-002, OPS-016 | The transceiver shall charge only while its cell-sensor temperature lies between 0 C and 45 C, each threshold within +/-2 C (TBR). | Pass if charging is stopped at T_cold_stop and T_warm_stop and runs at T_cold_run and T_warm_run (the 0 C and 45 C readings are data only) (REQ-SYS-082), and the loads are powered at T_hot_on and powered down at T_hot_off (REQ-SYS-099); otherwise Fail. | Test | Bench | TC-SYS-060 (Draft; Bench) | - | owner bench | TRR | No | No | owner | - | Active (TBR) |
| REQ-SYS-083 | `docs/requirements/sys/requirements.json`; NGO-022, OPS-016, CON-011 | The transceiver shall stop charging, independently of charger and firmware, at a cell threshold within 4.25-4.30 V (TBR) at 18 C to 28 C. | Pass if for each cell the protector stops the charge path at a cell voltage from 4.25 V to 4.30 V at 18 C to 28 C with the meter accuracy included, with the charger and firmware not acting; otherwise Fail. The 0 C to 45 C span is REQ-SYS-194, closed by TC-SYS-116. | Test | Bench | TC-SYS-061 (Draft; Bench) | - | owner bench | TRR | No | No | owner | - | Active (TBR) |
| REQ-SYS-084 | `docs/requirements/sys/requirements.json`; NGO-022, OPS-009 | The transceiver shall disconnect the pack from its loads, independently of firmware, when any cell falls below 2.50 V +/-0.05 V (TBR). | Pass if the pack is disconnected from its loads (current below 50 uA) at a cell voltage of 2.45 to 2.55 V with firmware power-down disabled (REQ-SYS-084), and with one cell reversed the current drawn is at most 10 mA and the unit then operates normally (REQ-SYS-086); otherwise Fail. | Test | Bench | TC-SYS-062 (Draft; Bench) | - | owner bench | TRR | No | No | owner | - | Active (TBR) |
| REQ-SYS-085 | `docs/requirements/sys/requirements.json`; NGO-022, CON-016, OPS-016 | The transceiver shall interrupt pack discharge current, independently of firmware, at a trip level between 3 A and 10 A (TBR). | Pass if the computed discharge-interrupt trip current lies between 3 A and 10 A at every corner and the fuse neither opens nor ages at the 2.1 A key-down pulses; otherwise Fail. | Analysis | Simulation | TC-SYS-063 (Draft; Simulation; tools/budgets/pack_protection_check.py) | - | simulation | CDR | No | No | claude | - | Active (TBR) |
| REQ-SYS-086 | `docs/requirements/sys/requirements.json`; CON-011, NGO-022, OPS-012 | The transceiver shall survive either cell inserted reversed without damage and without drawing more than 10 mA (TBR) from the cells. | Pass if the pack is disconnected from its loads (current below 50 uA) at a cell voltage of 2.45 to 2.55 V with firmware power-down disabled (REQ-SYS-084), and with one cell reversed the current drawn is at most 10 mA and the unit then operates normally (REQ-SYS-086); otherwise Fail. | Test | Bench | TC-SYS-062 (Draft; Bench) | - | owner bench | TRR | No | No | owner | - | Active (TBR) |
| REQ-SYS-087 | `docs/requirements/sys/requirements.json`; NGO-022, OPS-012, OPS-016 | The transceiver shall hold charge current below 5 mA while its cells differ by over 300 mV (TBR) or either reads outside 2.5-4.3 V (TBR). | Pass if, with the meter accuracy added to each reading, the charge current is below 5 mA with the cells 300 mV + a apart and with either cell at 2.5 V - a or 4.3 V + a (REQ-SYS-087), it falls below 5 mA with the cell-sense cause shown when the two measurements differ by 100 mV + a (REQ-SYS-088), and the regulated rails stay below 0.5 V at switch-on with either cell at 2.5 V - a or 4.3 V + a (REQ-SYS-166); otherwise Fail. The 5 mA and 0.5 V levels are those of the requirements. | Test | Bench | TC-SYS-064 (Draft; Bench) | - | owner bench | TRR | No | No | owner | - | Active (TBR) |
| REQ-SYS-088 | `docs/requirements/sys/requirements.json`; NGO-022, OPS-016 | The transceiver shall cut charge current below 5 mA when two independent measurements of a cell voltage differ by more than 100 mV (TBR). | Pass if, with the meter accuracy added to each reading, the charge current is below 5 mA with the cells 300 mV + a apart and with either cell at 2.5 V - a or 4.3 V + a (REQ-SYS-087), it falls below 5 mA with the cell-sense cause shown when the two measurements differ by 100 mV + a (REQ-SYS-088), and the regulated rails stay below 0.5 V at switch-on with either cell at 2.5 V - a or 4.3 V + a (REQ-SYS-166); otherwise Fail. The 5 mA and 0.5 V levels are those of the requirements. | Test | Bench | TC-SYS-064 (Draft; Bench) | - | owner bench | TRR | No | No | owner | - | Active (TBR) |
| REQ-SYS-089 | `docs/requirements/sys/requirements.json`; NGO-022, OPS-016 | The transceiver shall stop any charge that lasts longer than 15 h (TBR). | Pass if the timer run stops charging at most 15 h after the charge start (REQ-SYS-089), and the current-fall run stops charging 60 min +/-2 min after constant-voltage entry with the charge current having fallen by less than 20 mA (REQ-SYS-167); otherwise Fail. The +/-2 min tolerance is that of REQ-SYS-167; charging stopped means a charge current below 5 mA, the level of REQ-SYS-087, 088 and 093. | Test | Bench | TC-SYS-065 (Draft; Bench) | - | owner bench | TRR | No | No | owner | - | Active (TBR) |
| REQ-SYS-090 | `docs/requirements/sys/requirements.json`; CON-010, NGO-022, OPS-002, ADR-004 | The transceiver shall draw at most 500 mA from USB VBUS. | Pass if VBUS current, with the meter accuracy added, is at most 500 mA in every state (REQ-SYS-090); the charge state is indicated in every charge phase with the switch off and with it on (REQ-SYS-070); and with the switch on and USB present the charge current into the pack, with the meter accuracy added, is below 5 mA (REQ-SYS-093); otherwise Fail. The 5 mA level is that of REQ-SYS-093. | Test | Bench | TC-SYS-050 (Draft; Bench) | - | owner bench | TRR | No | No | owner | - | Active |
| REQ-SYS-091 | `docs/requirements/sys/requirements.json`; MOE-004, NGO-025, OPS-002 | The transceiver shall charge a 3000 mAh pack from low-battery power-down to full within 12 h from a 500 mA USB supply while switched off. | Pass if each cell voltage at termination is 4.179 to 4.221 V (4.20 V +/-0.5 percent) with the meter accuracy included (REQ-SYS-081), and the pack reaches termination at most 12 h after USB is applied (REQ-SYS-091); otherwise Fail. | Test | Bench | TC-SYS-059 (Draft; Bench) | - | owner bench | TRR | No | No | owner | - | Active |
| REQ-SYS-092 | `docs/requirements/sys/requirements.json`; NGO-022, MOE-004, OPS-002, OPS-011, ADR-004 | The transceiver shall inhibit transmitter output through a hardware path, independent of firmware, whenever USB VBUS is present. | Pass if with USB present no carrier at the set frequency above -57 dBm at the antenna port on the tinySA Ultra, corrected for the attenuator and increased by the tinySA level accuracy (the RF-off level of REQ-SYS-183) appears for the commanded TX_KEY or either key (REQ-SYS-092), and with the cells removed the transmitter rail stays below 0.5 V in the bootloader and application states while TX_KEY is asserted (REQ-SYS-149); otherwise Fail. | Test | Bench | TC-SYS-066 (Draft; Bench) | - | owner bench | TRR | No | No | owner | - | Active |
| REQ-SYS-093 | `docs/requirements/sys/requirements.json`; NGO-022, OPS-002 | The transceiver shall hold charge current below 5 mA while the power switch is on and USB power is present. | Pass if VBUS current, with the meter accuracy added, is at most 500 mA in every state (REQ-SYS-090); the charge state is indicated in every charge phase with the switch off and with it on (REQ-SYS-070); and with the switch on and USB present the charge current into the pack, with the meter accuracy added, is below 5 mA (REQ-SYS-093); otherwise Fail. The 5 mA level is that of REQ-SYS-093. | Test | Bench | TC-SYS-050 (Draft; Bench) | - | owner bench | TRR | No | No | owner | - | Active |
| REQ-SYS-094 | `docs/requirements/sys/requirements.json`; NGO-025, SI-034, MOE-004, ADR-020, OPS-009 | The transceiver shall run at least 8 h on fresh 3000 mAh cells at 1:9 transmit-to-receive, 45 percent key-down at 5 W, until transmit inhibit. | Pass if the elapsed time from start to the low-battery transmit inhibit is at least 8 h (REQ-SYS-094), and the low-battery warning appears at least 15 min before the inhibit (REQ-SYS-096); otherwise Fail. | Test | Bench | TC-SYS-067 (Draft; Bench) | - | owner bench | TRR | No | No | owner | - | Active |
| REQ-SYS-095 | `docs/requirements/sys/requirements.json`; NGO-025, MOE-004, OPS-009, ADR-020 | The transceiver shall run at least 6 h (TBR) on 3000 mAh cells at 1:4 transmit-to-receive, 45 percent key-down at 5 W, until transmit inhibit. | Pass if the elapsed time from start to the low-battery transmit inhibit is at least 6 h; otherwise Fail. | Test | Bench | TC-SYS-068 (Draft; Bench) | - | owner bench | TRR | No | No | owner | - | Active (TBR) |
| REQ-SYS-096 | `docs/requirements/sys/requirements.json`; MOE-004, OPS-009 | The transceiver shall display a low-battery warning at least 15 min before the low-battery transmit inhibit at the 1:9 ratio. | Pass if the elapsed time from start to the low-battery transmit inhibit is at least 8 h (REQ-SYS-094), and the low-battery warning appears at least 15 min before the inhibit (REQ-SYS-096); otherwise Fail. | Test | Bench | TC-SYS-067 (Draft; Bench) | - | owner bench | TRR | No | No | owner | - | Active |
| REQ-SYS-097 | `docs/requirements/sys/requirements.json`; NGO-022, MOE-004, OPS-009, ADR-005 | The transceiver shall refuse to start a transmission while either cell, measured in receive, reads below 3.20 V +/-0.05 V (TBR). | Pass if transmission is refused (PA_EN low) at every step at or below 3.15 V and allowed at or above 3.25 V, for either cell and both keys (REQ-SYS-097); the loads power down at a cell voltage from 2.95 V to 3.05 V (REQ-SYS-098); and transmission is refused at every pack step at or above 8.65 V and allowed at or below 8.55 V (REQ-SYS-153); otherwise Fail. | Test | Bench | TC-SYS-069 (Draft; Bench) | - | owner bench | TRR | No | No | owner | - | Active (TBR) |
| REQ-SYS-098 | `docs/requirements/sys/requirements.json`; NGO-022, OPS-009, ADR-005 | The transceiver shall power down its loads when either cell reads below 3.00 V +/-0.05 V (TBR). | Pass if transmission is refused (PA_EN low) at every step at or below 3.15 V and allowed at or above 3.25 V, for either cell and both keys (REQ-SYS-097); the loads power down at a cell voltage from 2.95 V to 3.05 V (REQ-SYS-098); and transmission is refused at every pack step at or above 8.65 V and allowed at or below 8.55 V (REQ-SYS-153); otherwise Fail. | Test | Bench | TC-SYS-069 (Draft; Bench) | - | owner bench | TRR | No | No | owner | - | Active (TBR) |
| REQ-SYS-099 | `docs/requirements/sys/requirements.json`; NGO-022, OPS-014 | The transceiver shall power down its loads when its cell-sensor temperature exceeds 60 C +/-2 C (TBR). | Pass if charging is stopped at T_cold_stop and T_warm_stop and runs at T_cold_run and T_warm_run (the 0 C and 45 C readings are data only) (REQ-SYS-082), and the loads are powered at T_hot_on and powered down at T_hot_off (REQ-SYS-099); otherwise Fail. | Test | Bench | TC-SYS-060 (Draft; Bench) | - | owner bench | TRR | No | No | owner | - | Active (TBR) |
| REQ-SYS-100 | `docs/requirements/sys/requirements.json`; NGO-006, OPS-010 | The transceiver shall draw at most 50 uA (TBR) from the pack with the power switch off. | Pass if the pack current with the switch off is at most 50 uA with the meter accuracy added (REQ-SYS-100), and the PA rail and VSYS are below 0.5 V with the switch off (REQ-SYS-101); otherwise Fail. The 0.5 V threshold follows REQ-SYS-149. | Test | Bench | TC-SYS-070 (Draft; Bench) | - | owner bench | TRR | No | No | owner | - | Active (TBR) |
| REQ-SYS-101 | `docs/requirements/sys/requirements.json`; NGO-022, OPS-010, OPS-013 | The transceiver shall remove power from every load except the cell protector and charger through a mechanical switch. | Pass if the pack current with the switch off is at most 50 uA with the meter accuracy added (REQ-SYS-100), and the PA rail and VSYS are below 0.5 V with the switch off (REQ-SYS-101); otherwise Fail. The 0.5 V threshold follows REQ-SYS-149. | Test | Bench | TC-SYS-070 (Draft; Bench) | - | owner bench | TRR | No | No | owner | - | Active |
| REQ-SYS-102 | `docs/requirements/sys/requirements.json`; NGO-006, SI-001, OPS-010, MOE-013 | The transceiver shall have a mass of at most 350 g (TBR) with cells fitted and without the antenna. | Pass if the mean of three readings plus the scale check error is at most 350 g; otherwise Fail. | Test | Bench | TC-SYS-071 (Draft; Bench) | - | owner bench | TRR | No | No | owner | - | Active (TBR) |
| REQ-SYS-103 | `docs/requirements/sys/requirements.json`; NGO-026, SI-001, CON-015, OPS-010, MOE-013 | The transceiver shall fit within 140 mm x 70 mm x 40 mm (TBR) excluding antenna and knobs. | Pass if the renders and BOM show exactly two rotary knobs with push action and exactly two push buttons as operator controls besides the power switch, the bounding box excluding antenna and knobs is at most 140 mm x 70 mm x 40 mm, and the antenna port lies on one end face only; otherwise Fail. | Inspection | Inspection | TC-SYS-040 (Draft; Inspection; hardware/enclosure/checks/enclosure_inspect.py) | - | inspection | CDR/receipt | No | No | claude | - | Active (TBR) |
| REQ-SYS-104 | `docs/requirements/sys/requirements.json`; NGO-026, SI-008, OPS-015 | The transceiver shall present a 50 ohm SMA jack (female body, stainless steel) as its antenna port. | Pass if the BOM and schematic show two series 18650 cells in holders removable without soldering, a 50 ohm stainless-steel SMA jack with female body as the antenna port, the Raspberry Pi Pico 2 module as the only controller, and a 3.5 mm TRS key jack wired tip dit or straight key, ring dah and sleeve common in agreement with ICD-CTL-KEY; otherwise Fail. | Inspection | Inspection | TC-SYS-058 (Draft; Inspection; tools/check_bom.py) | - | inspection | CDR/receipt | No | No | claude | - | Active |
| REQ-SYS-105 | `docs/requirements/sys/requirements.json`; NGO-026, OPS-015, OPS-010 | The transceiver shall take a 4.0 N m antenna-port bending moment in any direction without jack rotation and within 1 dB (TBR) return-loss change. | Pass if the witness mark shows no rotation and the return loss changes by at most 1 dB from 144 to 148 MHz after the moment in all four directions (REQ-SYS-105), and the counterpoise attachment is within 20 mm of the antenna port with at most 10 mohm to the shell (at most 10 mV at 1 A, meter accuracy added) (REQ-SYS-107); otherwise Fail. | Test | Bench | TC-SYS-072 (Draft; Bench) | - | owner bench | TRR | No | No | owner | - | Active (TBR) |
| REQ-SYS-106 | `docs/requirements/sys/requirements.json`; NGO-026, OPS-015 | The transceiver shall keep antenna-port return loss within 1 dB (TBR) of its initial value after 500 mating cycles at 0.45 to 0.56 N m. | Pass if the jack is rated for at least 500 mating cycles at a torque range that contains 0.45 to 0.56 N m, the handbook states a torque inside 0.45 to 0.56 N m, and the datasheet return-loss specification after the rated cycles implies a change of at most 1 dB at 144 to 148 MHz; otherwise Fail. | Analysis | Simulation | TC-SYS-073 (Draft; Simulation; hardware/sim/checks/sma_mating_life.py) | - | simulation | CDR | No | No | claude | - | Active (TBR) |
| REQ-SYS-107 | `docs/requirements/sys/requirements.json`; NGO-009, MOE-001, OPS-004 | The transceiver shall provide a counterpoise attachment within 20 mm (TBR) of the antenna port with at most 10 mohm (TBR) to the connector shell. | Pass if the witness mark shows no rotation and the return loss changes by at most 1 dB from 144 to 148 MHz after the moment in all four directions (REQ-SYS-105), and the counterpoise attachment is within 20 mm of the antenna port with at most 10 mohm to the shell (at most 10 mV at 1 A, meter accuracy added) (REQ-SYS-107); otherwise Fail. | Test | Bench | TC-SYS-072 (Draft; Bench) | - | owner bench | TRR | No | No | owner | - | Active (TBR) |
| REQ-SYS-108 | `docs/requirements/sys/requirements.json`; CON-010, CON-012, CON-013, SI-005, OPS-002 | The transceiver shall admit fully seated mating plugs at the key jack, headphone jack and micro-USB receptacle through its enclosure openings. | Pass if each plug seats fully through its enclosure opening and its function is observed; otherwise Fail. | Demonstration | Bench | TC-SYS-074 (Draft; Bench) | - | owner bench | TRR | No | No | owner | - | Active |
| REQ-SYS-109 | `docs/requirements/sys/requirements.json`; CON-015, SI-008, ADR-008, OPS-012 | The transceiver shall use a CNC-machined aluminum enclosure, anodized with the chassis-ground and connector contact areas left conductive. | Pass if the drawing and order notes specify a CNC-machined aluminum enclosure, anodized, with every chassis-ground and connector contact area called out as masked (left conductive); otherwise Fail. The receipt continuity readings are recorded as data. | Inspection | Inspection | TC-SYS-075 (Draft; Inspection) | - | inspection | CDR/receipt | No | No | claude | - | Active |
| REQ-SYS-110 | `docs/requirements/sys/requirements.json`; NGO-026, OPS-012 | The transceiver shall break every external edge and cutout edge of the enclosure with a chamfer or fillet of at least 0.5 mm. | Pass if every external and cutout edge has a chamfer or fillet of at least 0.5 mm (REQ-SYS-110), every knob has at least 1.0 mm radial clearance to the panel (REQ-SYS-111), and every closing gap of the cell cover stays below 4 mm or above 25 mm throughout its travel (REQ-SYS-168); otherwise Fail, reported per requirement. | Analysis | Simulation | TC-SYS-076 (Draft; Simulation; hardware/enclosure/checks/enclosure_safety_check.py) | - | simulation | CDR | No | No | claude | - | Active |
| REQ-SYS-111 | `docs/requirements/sys/requirements.json`; NGO-026, OPS-012 | The transceiver shall keep at least 1.0 mm radial clearance between each knob and the panel. | Pass if every external and cutout edge has a chamfer or fillet of at least 0.5 mm (REQ-SYS-110), every knob has at least 1.0 mm radial clearance to the panel (REQ-SYS-111), and every closing gap of the cell cover stays below 4 mm or above 25 mm throughout its travel (REQ-SYS-168); otherwise Fail, reported per requirement. | Analysis | Simulation | TC-SYS-076 (Draft; Simulation; hardware/enclosure/checks/enclosure_safety_check.py) | - | simulation | CDR | No | No | claude | - | Active |
| REQ-SYS-112 | `docs/requirements/sys/requirements.json`; NGO-005, SI-003, NGO-026, OPS-014 | The transceiver shall hold the PA junction at or below 110 C (TBR) during continuous key-down at the 5 W step in 45 C ambient. | Pass if the PA junction is at or below 110 C (REQ-SYS-112) and the hand-hold surfaces are at most 48 C (REQ-SYS-113) at the worst-case corner; otherwise Fail, reported per requirement. | Analysis | Simulation | TC-SYS-077 (Draft; Simulation; tools/budgets/thermal_budget.py) | - | simulation | CDR | No | No | claude | - | Active (TBR) |
| REQ-SYS-113 | `docs/requirements/sys/requirements.json`; NGO-005, OPS-014 | The transceiver shall keep hand-hold surfaces at most 48 C (TBR) after 5 min of continuous key-down at 5 W in 25 C ambient. | Pass if the PA junction is at or below 110 C (REQ-SYS-112) and the hand-hold surfaces are at most 48 C (REQ-SYS-113) at the worst-case corner; otherwise Fail, reported per requirement. | Analysis | Simulation | TC-SYS-077 (Draft; Simulation; tools/budgets/thermal_budget.py) | - | simulation | CDR | No | No | claude | - | Active (TBR) |
| REQ-SYS-114 | `docs/requirements/sys/requirements.json`; NGO-026, OPS-004, OPS-010, MOE-013 | The transceiver shall meet its requirements at ambient temperatures from -10 C to +45 C (TBR). | Pass if every part's operating rating covers -10 C to +45 C ambient plus its own rise (REQ-SYS-114) and every part except the removed cells has a storage rating covering -20 C to +60 C (REQ-SYS-115); otherwise Fail, reported per requirement. | Analysis | Simulation | TC-SYS-078 (Draft; Simulation; tools/budgets/part_rating_check.py) | - | simulation | CDR | No | No | claude | - | Active (TBR) |
| REQ-SYS-115 | `docs/requirements/sys/requirements.json`; NGO-026, OPS-010, MOE-013 | The transceiver shall meet its requirements after storage from -20 C to +60 C (TBR) with the cells removed. | Pass if every part's operating rating covers -10 C to +45 C ambient plus its own rise (REQ-SYS-114) and every part except the removed cells has a storage rating covering -20 C to +60 C (REQ-SYS-115); otherwise Fail, reported per requirement. | Analysis | Simulation | TC-SYS-078 (Draft; Simulation; tools/budgets/part_rating_check.py) | - | simulation | CDR | No | No | claude | - | Active (TBR) |
| REQ-SYS-116 | `docs/requirements/sys/requirements.json`; NGO-026, OPS-010, MOE-013 | The transceiver shall meet its requirements after a 1.0 m (TBR) drop onto a hard floor on each face with the antenna fitted. | Pass if after the six 1.0 m drops the unit passes every case of the acceptance test set it passed before the drops and no cell is damaged; otherwise Fail. | Test | Bench | TC-SYS-079 (Draft; Bench) | - | owner bench | TRR | No | No | owner | - | Active (TBR) |
| REQ-SYS-117 | `docs/requirements/sys/requirements.json`; NGO-026, OPS-004, MOE-013 | The transceiver shall meet its requirements after 10 min of IEC 60529 IPX2 (TBR) dripping water while upright with plugs inserted. | Pass if the drip rate is 3 mm/min +/-0.5 mm/min, the exposure lasts 10 min, and afterwards the unit passes every acceptance case it passed before; otherwise Fail. Water found inside is recorded for the design and is not by itself a failure. | Test | Bench | TC-SYS-080 (Draft; Bench) | - | owner bench | TRR | No | No | owner | - | Active (TBR) |
| REQ-SYS-118 | `docs/requirements/sys/requirements.json`; NGO-004, OPS-014 | The transceiver shall cease RF output within 100 ms (TBR) after its PA temperature sensor reads above 85 C +/-3 C (TBR). | Pass if RF output ceases (PA_EN low) at most 100 ms after the sensor reading crosses 85 C and the trip lies between the 82 C and 88 C equivalents (REQ-SYS-118), and the unit enters Fault-safe at most 100 ms after the sensor is opened or shorted, in Receive and while keyed (REQ-SYS-155); otherwise Fail. | Test | Bench | TC-SYS-081 (Draft; Bench; tools/analyze_logic_capture.py) | - | owner bench | TRR | No | No | owner | - | Active (TBR) |
| REQ-SYS-119 | `docs/requirements/sys/requirements.json`; NGO-021, MOE-012, OPS-011, OPS-021 | The transceiver shall keep antenna-port RF off while its application firmware is not running, including reset, bootloader and firmware-load states. | Pass if PA_EN is low, TX_KEY low and no carrier at the set frequency above -57 dBm at the antenna port on the tinySA Ultra, corrected for the attenuator and increased by the tinySA level accuracy (the RF-off level of REQ-SYS-183) throughout the reset, bootloader and firmware-load states (REQ-SYS-119); after every reset, panic and latched fault PA_EN is low, TX_KEY low (key up), the T/R drive at receive, the amplifier enable low (audio muted) and the charger enable low (charging disabled) before the first edge on any other captured output, in the keyed and in the charging steps (REQ-SYS-130); and every hang ends in a reset into SafeState at most 2 s after the hang marker (REQ-SYS-131); otherwise Fail. | Test | Bench | TC-SYS-082 (Draft; Bench; tools/analyze_logic_capture.py) | - | owner bench | TRR | No | No | owner | - | Active |
| REQ-SYS-120 | `docs/requirements/sys/requirements.json`; NGO-021, MOE-012, OPS-021 | The transceiver shall produce RF output only while both a keyer key-down and a separately maintained PA permit are asserted. | Pass if with either condition forced alone PA_EN stays low and no carrier at the set frequency above -57 dBm at the antenna port on the tinySA Ultra, corrected for the attenuator and increased by the tinySA level accuracy (the RF-off level of REQ-SYS-183) in every repetition, and RF is present only while both conditions are asserted; otherwise Fail. | Test | Bench | TC-SYS-083 (Draft; Bench) | - | owner bench | TRR | No | No | owner | - | Active |
| REQ-SYS-121 | `docs/requirements/sys/requirements.json`; CON-004, MOE-009, SI-030, ADR-014, OPS-018, OPS-022, 47CFR97.13(c), 47CFR1.1307, 47CFR1.1310, 47CFR2.1091, 47CFR2.1093 | The transceiver shall have an RF exposure evaluation per 47 CFR 1.1307(b), 2.1091 and 2.1093 on record before its first on-air transmission. | Pass if the RF exposure evaluation per 47 CFR 1.1307(b), 2.1091 and 2.1093 is on record before the first on-air transmission, the script reproduces its values, and every reference antenna has a published or literature gain of at most 0 dBd from 144 MHz to 148 MHz; otherwise Fail, reported per requirement. | Analysis | Simulation | TC-SYS-084 (Draft; Simulation; tools/budgets/rf_exposure.py) | - | simulation | CDR | No | No | claude | - | Active |
| REQ-SYS-122 | `docs/requirements/sys/requirements.json`; CON-004, MOE-009, MOE-008, OPS-006, OPS-018, 47CFR97.13(c), ADR-014 | The transceiver shall ship with an operations handbook containing every safety instruction that docs/safety/hazards.json allocates to documentation or operator procedure. | Pass if every Documentation and Operator procedure control of docs/safety/hazards.json is carried completely by a named handbook section and the printed handbook is in each unit's ship list; otherwise Fail. | Inspection | Inspection | TC-SYS-085 (Draft; Inspection; tools/check_handbook_controls.py) | - | inspection | CDR/receipt | No | No | claude | - | Active |
| REQ-SYS-124 | `docs/requirements/sys/requirements.json`; CON-004, CON-006, MOE-009, OPS-019 | The transceiver shall carry, marked into its enclosure metal, the legend: amateur transmitter, 144-148 MHz, 5 W nominal, licensed operators only, handbook exposure section. | Pass if the artwork carries every element of the legend, the callout marks it into the enclosure metal with a stated depth, and it is visible on the assembled unit; otherwise Fail. | Inspection | Inspection | TC-SYS-086 (Draft; Inspection) | - | inspection | CDR/receipt | No | No | claude | - | Active |
| REQ-SYS-125 | `docs/requirements/sys/requirements.json`; CON-008, CON-024, SI-035, ADR-025, OPS-012, 47CFR15.23 | The transceiver shall have a production quantity of at most five complete units, none of them marketed. | Pass if the release package orders parts for at most five complete units, the serial register issues at most five serials CWHT-A-001 to CWHT-A-005, and no marketing material for the unit exists; otherwise Fail. | Inspection | Inspection | TC-SYS-087 (Draft; Inspection) | - | inspection | CDR/receipt | No | No | claude | - | Active |
| REQ-SYS-126 | `docs/requirements/sys/requirements.json`; CON-009, SI-007, ADR-004, OPS-011 | The transceiver shall use the Raspberry Pi Pico 2 module as its controller. | Pass if the BOM and schematic show two series 18650 cells in holders removable without soldering, a 50 ohm stainless-steel SMA jack with female body as the antenna port, the Raspberry Pi Pico 2 module as the only controller, and a 3.5 mm TRS key jack wired tip dit or straight key, ring dah and sleeve common in agreement with ICD-CTL-KEY; otherwise Fail. | Inspection | Inspection | TC-SYS-058 (Draft; Inspection; tools/check_bom.py) | - | inspection | CDR/receipt | No | No | claude | - | Active |
| REQ-SYS-127 | `docs/requirements/sys/requirements.json`; CON-009, SI-007, SI-033, ADR-019, OPS-011, ADR-027 | The transceiver shall run firmware written in Rust on the rustos operating system. | Pass if the firmware is Rust on the rustos revision named in the VDD, cwht-core is no_std with forbid(unsafe_code) and depends only on the rustos api traits, the host build and test run of the tag succeeded unmodified on macOS or Linux, and every interrupt handler runs at one NVIC priority level; otherwise Fail. | Inspection | Inspection | TC-SYS-088 (Draft; Inspection; tools/check_nvic_priority.py) | TC-SW-TOOL-001 (Draft; Bench; tools/sw_gate.sh) | inspection | CDR/receipt | No | No | claude | - | Active |
| REQ-SYS-128 | `docs/requirements/sys/requirements.json`; CON-025, SI-026, NGO-024, ADR-011, OPS-011 | The transceiver shall run application firmware that builds and executes unmodified on a macOS or Linux host against the rustos api traits. | Pass if the firmware is Rust on the rustos revision named in the VDD, cwht-core is no_std with forbid(unsafe_code) and depends only on the rustos api traits, the host build and test run of the tag succeeded unmodified on macOS or Linux, and every interrupt handler runs at one NVIC priority level; otherwise Fail. | Inspection | Inspection | TC-SYS-088 (Draft; Inspection; tools/check_nvic_priority.py) | TC-SW-TOOL-001 (Draft; Bench; tools/sw_gate.sh) | inspection | CDR/receipt | No | No | claude | - | Active |
| REQ-SYS-129 | `docs/requirements/sys/requirements.json`; CON-025, NGO-024, ADR-011, OPS-011 | The transceiver shall run every firmware interrupt handler at one NVIC priority level. | Pass if the firmware is Rust on the rustos revision named in the VDD, cwht-core is no_std with forbid(unsafe_code) and depends only on the rustos api traits, the host build and test run of the tag succeeded unmodified on macOS or Linux, and every interrupt handler runs at one NVIC priority level; otherwise Fail. | Inspection | Inspection | TC-SYS-088 (Draft; Inspection; tools/check_nvic_priority.py) | - | inspection | CDR/receipt | No | No | claude | - | Active |
| REQ-SYS-130 | `docs/requirements/sys/requirements.json`; NGO-021, MOE-012, OPS-013, OPS-016, OPS-021 | The transceiver shall first set PA off, key up, antenna to receive, audio muted and charging disabled after every reset, panic or latched fault. | Pass if PA_EN is low, TX_KEY low and no carrier at the set frequency above -57 dBm at the antenna port on the tinySA Ultra, corrected for the attenuator and increased by the tinySA level accuracy (the RF-off level of REQ-SYS-183) throughout the reset, bootloader and firmware-load states (REQ-SYS-119); after every reset, panic and latched fault PA_EN is low, TX_KEY low (key up), the T/R drive at receive, the amplifier enable low (audio muted) and the charger enable low (charging disabled) before the first edge on any other captured output, in the keyed and in the charging steps (REQ-SYS-130); and every hang ends in a reset into SafeState at most 2 s after the hang marker (REQ-SYS-131); otherwise Fail. | Test | Bench | TC-SYS-082 (Draft; Bench; tools/analyze_logic_capture.py) | - | owner bench | TRR | No | No | owner | - | Active |
| REQ-SYS-131 | `docs/requirements/sys/requirements.json`; NGO-021, MOE-012, OPS-021 | The transceiver shall reset its controller, re-entering Self-test, within 2 s (TBR) of a firmware hang in any powered mode. | Pass if PA_EN is low, TX_KEY low and no carrier at the set frequency above -57 dBm at the antenna port on the tinySA Ultra, corrected for the attenuator and increased by the tinySA level accuracy (the RF-off level of REQ-SYS-183) throughout the reset, bootloader and firmware-load states (REQ-SYS-119); after every reset, panic and latched fault PA_EN is low, TX_KEY low (key up), the T/R drive at receive, the amplifier enable low (audio muted) and the charger enable low (charging disabled) before the first edge on any other captured output, in the keyed and in the charging steps (REQ-SYS-130); and every hang ends in a reset into SafeState at most 2 s after the hang marker (REQ-SYS-131); otherwise Fail. | Test | Bench | TC-SYS-082 (Draft; Bench; tools/analyze_logic_capture.py) | - | owner bench | TRR | No | No | owner | - | Active (TBR) |
| REQ-SYS-132 | `docs/requirements/sys/requirements.json`; NGO-005, OPS-011, CON-010, ADR-004 | The transceiver shall enter Fault-safe with no RF output when its firmware image fails the boot integrity check. | Pass if with each bad image the unit is in Fault-safe with the image fault shown and PA_EN stays low for every closure (REQ-SYS-132), and with each corrupt or out-of-range configuration every affected setting loads as its default while the valid settings keep their values (REQ-SYS-134); otherwise Fail. | Test | Bench | TC-SYS-089 (Draft; Bench) | - | owner bench | TRR | No | No | owner | - | Active |
| REQ-SYS-133 | `docs/requirements/sys/requirements.json`; CON-010, SI-022, OPS-011, MOE-008, ADR-004 | The transceiver shall accept a firmware image through its micro-USB receptacle with the cells removed. | Pass if all of the following hold: steps 2 to 4 each exit 0 and every host test of step 3 passes (at least 10 tests); step 5 reports no formatting difference and no clippy warning; tools/sw_gate.sh exits 0 in step 6 (the FW-B0 exit criterion of 07 section 3.2), with the G6 emulation step printing its SKIP line; in step 7 KA-0 exits 0 and KA-1 to KA-7 each exit 1 with the first FAIL line at the gate of the seeded defect (G1 clippy host for KA-1 and KA-4, G1 cargo fmt for KA-2, G3 run 1 for KA-3, G0 for KA-5, G1 clippy target for KA-6, G2 no compiler warning for KA-7), and KA-8 exits 1 with the G3 identical result sets line reporting FAIL; the two blinky builds of step 8 have identical SHA-256; picotool info -a in step 9 reports target chip RP2350 and image type ARM Secure with one image def block for each UF2; in steps 11 and 12 picotool load -v reports the verify passed and picotool reboot exits 0, and the owner counts 10 to 120 LED cycles in 60 s for the rustos blinky and 3 to 45 LED cycles in 60 s for cwht-app (the step 10 prediction windows, 13 to 114 and 5 to 39 cycles in 60 s, widened to round limits). Otherwise Fail; Blocked while a prerequisite is absent. The result is supporting evidence only and changes the status of no requirement.; Pass if the image loads with the cells removed, picotool verify reports a match, and the boot banner shows the released version; otherwise Fail. | Demonstration | Bench | TC-SW-TOOL-001 (Draft; Bench; tools/sw_gate.sh), TC-SYS-090 (Draft; Bench) | - | owner bench | TRR | No | No | owner | - | Active |
| REQ-SYS-134 | `docs/requirements/sys/requirements.json`; NGO-005, OPS-001, OPS-021, CON-010 | The transceiver shall replace any corrupt or out-of-range stored setting with its default value at load. | Pass if with each bad image the unit is in Fault-safe with the image fault shown and PA_EN stays low for every closure (REQ-SYS-132), and with each corrupt or out-of-range configuration every affected setting loads as its default while the valid settings keep their values (REQ-SYS-134); otherwise Fail. | Test | Bench | TC-SYS-089 (Draft; Bench) | - | owner bench | TRR | No | No | owner | - | Active |
| REQ-SYS-135 | `docs/requirements/sys/requirements.json`; NGO-015, OPS-006, OPS-012, ADR-024 | The transceiver shall retain every operator setting across power cycles and cell removal. | Pass if the last-entered call sign of 1 and of 10 characters is displayed after each power-on (REQ-SYS-006), and every listed setting reads its set value after the cell removal (REQ-SYS-135); otherwise Fail. The audio-cap unlock is excluded because REQ-SYS-170 restores the cap at power-on unless a persistent unlock is selected. | Test | Bench | TC-SYS-006 (Draft; Bench) | - | owner bench | TRR | No | No | owner | - | Active |
| REQ-SYS-136 | `docs/requirements/sys/requirements.json`; NGO-013, NGO-014, NGO-018, OPS-001, ADR-024, ADR-026 | The transceiver shall restore Iambic A, 15 WPM, 600 Hz sidetone, 8-dit hang and 5 ms envelope (TBR) at every configuration reset. | Pass if after the configuration reset and after the first power-on the step is 1 W with probe power inside 0.794 to 1.259 W (REQ-SYS-064), and the menus show Iambic A, 15 WPM, 600 Hz sidetone, 8-dit hang and 5 ms envelope, corroborated by a captured dit of 80 ms +/-1 percent, a sidetone of 600 Hz +/-5 Hz and a hang of 640 ms +/-1 percent (REQ-SYS-136); otherwise Fail. | Test | Bench | TC-SYS-046 (Draft; Bench; tools/analyze_logic_capture.py) | - | owner bench | TRR | No | No | owner | - | Active (TBR) |
| REQ-SYS-137 | `docs/requirements/sys/requirements.json`; CON-014, NGO-007, SI-009, SI-031, ADR-007, OPS-012 | The transceiver shall have every surface-mount part placed by PCBWay turnkey assembly. | Pass if every surface-mount part is in the PCBWay CPL (REQ-SYS-137) and the hand-assembly file holds only through-hole parts and exposed-pad modules (REQ-SYS-138); otherwise Fail, reported per requirement. | Inspection | Inspection | TC-SYS-091 (Draft; Inspection; tools/check_assembly_split.py) | - | inspection | CDR/receipt | No | No | claude | - | Active |
| REQ-SYS-138 | `docs/requirements/sys/requirements.json`; CON-014, SI-031, ADR-007, OPS-012 | The transceiver shall require owner hand soldering only of through-hole parts and exposed-pad modules listed in the hand-assembly file. | Pass if every surface-mount part is in the PCBWay CPL (REQ-SYS-137) and the hand-assembly file holds only through-hole parts and exposed-pad modules (REQ-SYS-138); otherwise Fail, reported per requirement. | Inspection | Inspection | TC-SYS-091 (Draft; Inspection; tools/check_assembly_split.py) | - | inspection | CDR/receipt | No | No | claude | - | Active |
| REQ-SYS-139 | `docs/requirements/sys/requirements.json`; NGO-027, CON-014, OPS-012, ADR-007 | The transceiver shall use a 4-layer circuit board of 1.0 mm (TBR) thickness that passes DRC against PCBWay standard-service capabilities. | Pass if the board is 4 layers of 1.0 mm finished thickness, DRC against the PCBWay standard-service rule set reports zero errors and zero unwaived warnings, and each of the eight listed signals has a reachable probe test point; otherwise Fail. | Inspection | Inspection | TC-SYS-092 (Draft; Inspection; hardware/kicad/checks/run_drc.py) | - | inspection | CDR/receipt | No | No | claude | - | Active (TBR) |
| REQ-SYS-140 | `docs/requirements/sys/requirements.json`; CON-014, SI-028, SI-009, ADR-012, NGO-027, NGO-007, OPS-012 | The transceiver shall use, for every turnkey-placed part and the PA device, only parts stocked at DigiKey, Mouser or PCBWay turnkey distributors. | Pass if every turnkey-placed part and the PA device has a timestamped CDR stock record at DigiKey, Mouser or a PCBWay turnkey distributor covering the build quantity, and every owner-procured hand-soldered part has a catalog item, a named source and a dated quote; otherwise Fail. | Inspection | Inspection | TC-SYS-093 (Draft; Inspection; tools/check_bom.py) | - | inspection | CDR/receipt | No | No | claude | - | Active |
| REQ-SYS-141 | `docs/requirements/sys/requirements.json`; MOE-006, CON-016, OPS-012 | The transceiver shall provide a transmit monitor port delivering the antenna-port signal attenuated by 40 dB +/-1 dB (TBR) into 50 ohm. | Pass if \|S21\| from the antenna port to the monitor port, with the NanoVNA uncertainty added, lies between 39 dB and 41 dB of attenuation at 144, 146, 148, 292 and 438 MHz in both unit states; otherwise Fail. | Test | Bench | TC-SYS-094 (Draft; Bench) | - | owner bench | TRR | No | No | owner | - | Active (TBR) |
| REQ-SYS-142 | `docs/requirements/sys/requirements.json`; CON-025, MOE-003, OPS-012 | The transceiver shall provide probe test points for both key inputs, keyer output, transmit key, T/R drive, PA enable, envelope drive and UART telemetry. | Pass if the board is 4 layers of 1.0 mm finished thickness, DRC against the PCBWay standard-service rule set reports zero errors and zero unwaived warnings, and each of the eight listed signals has a reachable probe test point; otherwise Fail. | Inspection | Inspection | TC-SYS-092 (Draft; Inspection; hardware/kicad/checks/run_drc.py) | - | inspection | CDR/receipt | No | No | claude | - | Active |
| REQ-SYS-143 | `docs/requirements/sys/requirements.json`; MOE-003, OPS-001, OPS-011 | The transceiver shall report firmware version, image hash and self-test results over USB serial at every boot. | Pass if every boot reports over USB serial a firmware version and image hash equal to the VDD and the self-test results (REQ-SYS-143), and with USB absent the UART pads carry decodable 3.3 V telemetry in receive and during keying with both key types (REQ-SYS-150); otherwise Fail. | Test | Bench | TC-SYS-095 (Draft; Bench) | - | owner bench | TRR | No | No | owner | - | Active |
| REQ-SYS-144 | `docs/requirements/sys/requirements.json`; NGO-023, MOE-003, CON-016, OPS-012 | The transceiver shall meet its requirements after assembly with no adjustment other than stored firmware calibration of pitch centre and reference trim. | Pass if each unit passes its acceptance test set with no adjustment other than the stored pitch-centre and reference-trim calibration and no adjustable part fitted; otherwise Fail. | Test | Bench | TC-SYS-096 (Draft; Bench) | - | owner bench | TRR | No | No | owner | - | Active |
| REQ-SYS-145 | `docs/requirements/sys/requirements.json`; NGO-030, NGO-008, CON-022, SI-002, ADR-002, OPS-012 | The transceiver shall confine its band-dependent functions to identified architecture blocks that a 70 cm revision replaces without changing other blocks. | Pass if every band-dependent function is confined to identified blocks whose replacement for 70 cm changes no other block, and an enclosure position, a controller input and a display field are reserved for a band control; otherwise Fail. | Inspection | Inspection | TC-SYS-097 (Draft; Inspection) | - | inspection | CDR/receipt | No | No | claude | - | Active |
| REQ-SYS-146 | `docs/requirements/sys/requirements.json`; NGO-030, SI-006, CON-023, OPS-003, ADR-002 | The transceiver shall reserve an enclosure position, a controller input and a display field for a future band control. | Pass if every band-dependent function is confined to identified blocks whose replacement for 70 cm changes no other block, and an enclosure position, a controller input and a display field are reserved for a band control; otherwise Fail. | Inspection | Inspection | TC-SYS-097 (Draft; Inspection) | - | inspection | CDR/receipt | No | No | claude | - | Active |
| REQ-SYS-147 | `docs/requirements/sys/requirements.json`; NGO-028, MOE-007, OPS-012 | The transceiver shall cost at most USD 610 (TBR) per complete unit, amortized over three units, excluding instruments and labor. | Pass if the cost per complete unit amortized over three units, excluding instruments and labor, is at most USD 610 with the CDR quotes; otherwise Fail. | Analysis | Simulation | TC-SYS-098 (Draft; Simulation; tools/budgets/cost_model.py) | - | simulation | CDR | No | No | claude | - | Active (TBR) |
| REQ-SYS-148 | `docs/requirements/sys/requirements.json`; CON-019, SI-025, NGO-029, ADR-017, OPS-012 | The transceiver shall have its design, firmware and process records licensed MIT in the public repository github.com/robinonsay/cwht. | Pass if the MIT LICENSE, the complete third-party notice file and every baseline tag are present in the public repository github.com/robinonsay/cwht, and the design, firmware and process records are all in it; otherwise Fail. | Inspection | Inspection | TC-SYS-099 (Draft; Inspection) | - | inspection | CDR/receipt | No | No | claude | - | Active |
| REQ-SYS-149 | `docs/requirements/sys/requirements.json`; NGO-022, OPS-011, OPS-002 | The transceiver shall keep its transmitter supply below 0.5 V (TBR) while powered from USB with the cells removed. | Pass if with USB present no carrier at the set frequency above -57 dBm at the antenna port on the tinySA Ultra, corrected for the attenuator and increased by the tinySA level accuracy (the RF-off level of REQ-SYS-183) appears for the commanded TX_KEY or either key (REQ-SYS-092), and with the cells removed the transmitter rail stays below 0.5 V in the bootloader and application states while TX_KEY is asserted (REQ-SYS-149); otherwise Fail. | Test | Bench | TC-SYS-066 (Draft; Bench) | - | owner bench | TRR | No | No | owner | - | Active (TBR) |
| REQ-SYS-150 | `docs/requirements/sys/requirements.json`; MOE-003, CON-016, OPS-009, OPS-012 | The transceiver shall emit its serial telemetry on 3.3 V UART test pads while USB VBUS is absent. | Pass if every boot reports over USB serial a firmware version and image hash equal to the VDD and the self-test results (REQ-SYS-143), and with USB absent the UART pads carry decodable 3.3 V telemetry in receive and during keying with both key types (REQ-SYS-150); otherwise Fail. | Test | Bench | TC-SYS-095 (Draft; Bench) | - | owner bench | TRR | No | No | owner | - | Active |
| REQ-SYS-151 | `docs/requirements/sys/requirements.json`; NGO-017, MOE-006, CON-002, OPS-015, 47CFR97.307(e) | The transceiver shall keep every antenna-port spurious emission at most 25 uW at the 5 W step into any load up to SWR 2:1 (TBR). | Pass if every spurious emission at the antenna port, corrected and increased by the tinySA level accuracy, is at most 25 uW (-16.0 dBm) at the 5 W step into each 2:1 fixture at the three frequencies (REQ-SYS-151), and the delivered power at 6.4 V into each of the four 2:1 fixtures, less the tinySA level uncertainty, and into the 25 ohm and the 100 ohm loads, less the probe uncertainty, is at least 4.0 W (REQ-SYS-152); otherwise Fail. | Test | Bench | TC-SYS-100 (Draft; Bench; tools/tinysa_scan_check.py) | - | owner bench | TRR | No | No | owner | - | Active (TBR) |
| REQ-SYS-152 | `docs/requirements/sys/requirements.json`; NGO-009, MOE-001, OPS-015, OPS-004 | The transceiver shall deliver at least 4.0 W (TBR) at the 5 W step into any load up to SWR 2:1. | Pass if every spurious emission at the antenna port, corrected and increased by the tinySA level accuracy, is at most 25 uW (-16.0 dBm) at the 5 W step into each 2:1 fixture at the three frequencies (REQ-SYS-151), and the delivered power at 6.4 V into each of the four 2:1 fixtures, less the tinySA level uncertainty, and into the 25 ohm and the 100 ohm loads, less the probe uncertainty, is at least 4.0 W (REQ-SYS-152); otherwise Fail. | Test | Bench | TC-SYS-100 (Draft; Bench; tools/tinysa_scan_check.py) | - | owner bench | TRR | No | No | owner | - | Active (TBR) |
| REQ-SYS-153 | `docs/requirements/sys/requirements.json`; NGO-017, NGO-004, OPS-008 | The transceiver shall refuse to start a transmission while the pack voltage exceeds 8.60 V +/-0.05 V (TBR). | Pass if transmission is refused (PA_EN low) at every step at or below 3.15 V and allowed at or above 3.25 V, for either cell and both keys (REQ-SYS-097); the loads power down at a cell voltage from 2.95 V to 3.05 V (REQ-SYS-098); and transmission is refused at every pack step at or above 8.65 V and allowed at or below 8.55 V (REQ-SYS-153); otherwise Fail. | Test | Bench | TC-SYS-069 (Draft; Bench) | - | owner bench | TRR | No | No | owner | - | Active (TBR) |
| REQ-SYS-154 | `docs/requirements/sys/requirements.json`; NGO-011, CON-003, OPS-020, ADR-023, 47CFR97.307(b) | The transceiver shall enter Fault-safe on key-down or during transmission when its synthesizer is unlocked or off its set frequency by over 10 kHz (TBR). | Pass if for loss of lock and for the 12 kHz offset, at key-down and during the over, the unit enters Fault-safe with PA_EN low and no carrier at the set frequency above -57 dBm at the antenna port on the tinySA Ultra, corrected for the attenuator and increased by the tinySA level accuracy (the RF-off level of REQ-SYS-183) (REQ-SYS-154), and it enters Fault-safe at most 100 ms after the detector reading is forced low or high during key-down (REQ-SYS-156); otherwise Fail. | Test | Bench | TC-SYS-101 (Draft; Bench; tools/analyze_logic_capture.py) | - | owner bench | TRR | No | No | owner | - | Active (TBR) |
| REQ-SYS-155 | `docs/requirements/sys/requirements.json`; NGO-004, OPS-014 | The transceiver shall enter Fault-safe within 100 ms (TBR) of its PA temperature reading leaving -20 C to +150 C (TBR). | Pass if RF output ceases (PA_EN low) at most 100 ms after the sensor reading crosses 85 C and the trip lies between the 82 C and 88 C equivalents (REQ-SYS-118), and the unit enters Fault-safe at most 100 ms after the sensor is opened or shorted, in Receive and while keyed (REQ-SYS-155); otherwise Fail. | Test | Bench | TC-SYS-081 (Draft; Bench; tools/analyze_logic_capture.py) | - | owner bench | TRR | No | No | owner | - | Active (TBR) |
| REQ-SYS-156 | `docs/requirements/sys/requirements.json`; NGO-017, NGO-004, OPS-008 | The transceiver shall enter Fault-safe within 100 ms (TBR) of its forward-power reading leaving the plausible range for the ALC drive during key-down. | Pass if for loss of lock and for the 12 kHz offset, at key-down and during the over, the unit enters Fault-safe with PA_EN low and no carrier at the set frequency above -57 dBm at the antenna port on the tinySA Ultra, corrected for the attenuator and increased by the tinySA level accuracy (the RF-off level of REQ-SYS-183) (REQ-SYS-154), and it enters Fault-safe at most 100 ms after the detector reading is forced low or high during key-down (REQ-SYS-156); otherwise Fail. | Test | Bench | TC-SYS-101 (Draft; Bench; tools/analyze_logic_capture.py) | - | owner bench | TRR | No | No | owner | - | Active (TBR) |
| REQ-SYS-157 | `docs/requirements/sys/requirements.json`; NGO-016, MOE-011, SI-036, CON-021, OPS-004 | The transceiver shall hold receive audio at least 60 dB below its unmuted level from the first key-down of an over until hang expiry. | Pass if receive audio is attenuated by at least 60 dB within 2 ms of key-down through a raised-cosine fade (REQ-SYS-075), stays at least 60 dB below its unmuted level from the first key-down to hang expiry at every speed (REQ-SYS-157), and is restored at hang expiry by a raised-cosine fade lasting 5 ms to 20 ms (REQ-SYS-158), with the fade shapes within 5 percent of full scale of the ideal raised cosine; otherwise Fail, reported per requirement. | Analysis | Simulation | TC-SYS-054 (Draft; Simulation; hardware/sim/checks/audio_mute_fade_check.py) | - | simulation | CDR | No | No | claude | - | Active |
| REQ-SYS-158 | `docs/requirements/sys/requirements.json`; NGO-016, MOE-011, OPS-004 | The transceiver shall restore receive audio at hang expiry through a raised-cosine fade lasting 5 ms to 20 ms (TBR). | Pass if receive audio is attenuated by at least 60 dB within 2 ms of key-down through a raised-cosine fade (REQ-SYS-075), stays at least 60 dB below its unmuted level from the first key-down to hang expiry at every speed (REQ-SYS-157), and is restored at hang expiry by a raised-cosine fade lasting 5 ms to 20 ms (REQ-SYS-158), with the fade shapes within 5 percent of full scale of the ideal raised cosine; otherwise Fail, reported per requirement. | Analysis | Simulation | TC-SYS-054 (Draft; Simulation; hardware/sim/checks/audio_mute_fade_check.py) | - | simulation | CDR | No | No | claude | - | Active (TBR) |
| REQ-SYS-159 | `docs/requirements/sys/requirements.json`; MOE-005, NGO-014, OPS-004, OPS-005 | The transceiver shall start the sidetone within 4 ms (TBR) of the key or paddle contact closure that starts an element. | Pass if every paddle-initiated element from idle starts at the keyer test point at most 3 ms after the contact closure at 15 and 50 WPM (REQ-SYS-043), and the sidetone starts at most 4 ms after the contact closure for all 50 paddle and 50 straight-key closures (REQ-SYS-159); otherwise Fail. | Test | Bench | TC-SYS-029 (Draft; Bench; tools/analyze_logic_capture.py) | - | owner bench | TRR | No | No | owner | - | Active (TBR) |
| REQ-SYS-160 | `docs/requirements/sys/requirements.json`; MOE-005, NGO-003, OPS-005, ADR-010, ADR-026 | The transceiver shall begin the RF rise within 15 ms (TBR) of each straight-key contact closure. | Pass if every straight-key closure, first and later in an over, begins the RF rise at most 15 ms after contact closure (REQ-SYS-160), and within each paddle over every element's delay from the keyer test point to the RF rise is at most 12 ms and all delays in the over differ by at most 0.5 ms (REQ-SYS-161); otherwise Fail. The 0.5 ms is that of REQ-SYS-161. | Test | Bench | TC-SYS-102 (Draft; Bench; tools/analyze_logic_capture.py) | - | owner bench | TRR | No | No | owner | - | Active (TBR) |
| REQ-SYS-161 | `docs/requirements/sys/requirements.json`; NGO-014, MOE-005, CON-021, ADR-010, ADR-026, OPS-004 | The transceiver shall delay each radiated element of an over by one lead-in of at most 12 ms (TBR), constant within 0.5 ms. | Pass if every straight-key closure, first and later in an over, begins the RF rise at most 15 ms after contact closure (REQ-SYS-160), and within each paddle over every element's delay from the keyer test point to the RF rise is at most 12 ms and all delays in the over differ by at most 0.5 ms (REQ-SYS-161); otherwise Fail. The 0.5 ms is that of REQ-SYS-161. | Test | Bench | TC-SYS-102 (Draft; Bench; tools/analyze_logic_capture.py) | - | owner bench | TRR | No | No | owner | - | Active (TBR) |
| REQ-SYS-162 | `docs/requirements/sys/requirements.json`; MOE-005, CON-012, OPS-005 | The transceiver shall accept a key opening after 5 ms (TBR) of continuous break. | Pass if the number of accepted closures and openings equals the number of physical operations, every accepted closure follows at least 2 ms of continuous contact (REQ-SYS-048) and every accepted opening follows at least 5 ms of continuous break (REQ-SYS-162), each duration measured from the capture less one capture sample period (the decision rule of docs/process/04-verification-and-validation.md section 8.2), for both key types; otherwise Fail. The delay from 2 ms and 5 ms to each acceptance is recorded as data; its bound is the keying latency of REQ-SYS-043. | Test | Bench | TC-SYS-034 (Draft; Bench; tools/analyze_logic_capture.py) | - | owner bench | TRR | No | No | owner | - | Active (TBR) |
| REQ-SYS-163 | `docs/requirements/sys/requirements.json`; NGO-021, OPS-013, OPS-005, SI-018, CON-012 | The transceiver shall accept a key-input mode menu selection while any key input reads closed. | Pass if the key-input mode never changes on plug insertion or removal (REQ-SYS-056), the Straight-on-tip selection is accepted with the ring closed (REQ-SYS-163), and after each power-on, reset and mode change PA_EN stays low for key closures until each input the mode uses has read open for 500 ms and follows the key after that (REQ-SYS-052); otherwise Fail. | Test | Bench | TC-SYS-037 (Draft; Bench; tools/analyze_logic_capture.py) | - | owner bench | TRR | No | No | owner | - | Active |
| REQ-SYS-164 | `docs/requirements/sys/requirements.json`; NGO-015, SI-024, OPS-003 | The transceiver shall tune from 144.000 MHz to 148.000 MHz within 30 s (TBR) at a steady tuning-knob rotation of 2 revolutions per second. | Pass if every detent produces exactly one frequency change, every step lies between 10 Hz and 10 kHz, slow single detents step 10 Hz, and the step never decreases as the detent rate increases (REQ-SYS-058), and at a measured mean rate of 2.0 +/-0.2 revolutions per second the tuning from 144.000 to 148.000 MHz takes at most 30 s (REQ-SYS-164); otherwise Fail. | Test | Bench | TC-SYS-041 (Draft; Bench; tools/analyze_logic_capture.py) | - | owner bench | TRR | No | No | owner | - | Active (TBR) |
| REQ-SYS-165 | `docs/requirements/sys/requirements.json`; NGO-015, CON-023, OPS-003 | The transceiver shall make its displayed frequency legible at 0.5 m under 300 lux (TBR) or more of ambient light without a backlight. | Pass if the luminance contrast ratio at 300 lux is at least 3:1 and the frequency characters subtend at least 16 arcmin at 0.5 m; otherwise Fail. These two legibility criteria are proposed by the test author because REQ-SYS-165 names no metric; the owner confirms or replaces them at PDR (D-UI-01). | Analysis | Simulation | TC-SYS-103 (Draft; Simulation; tools/budgets/display_legibility.py) | - | simulation | CDR | No | No | claude | - | Active (TBR) |
| REQ-SYS-166 | `docs/requirements/sys/requirements.json`; NGO-022, OPS-012 | The transceiver shall keep its regulated rails below 0.5 V (TBR) while either cell reads outside 2.5 V to 4.3 V (TBR). | Pass if, with the meter accuracy added to each reading, the charge current is below 5 mA with the cells 300 mV + a apart and with either cell at 2.5 V - a or 4.3 V + a (REQ-SYS-087), it falls below 5 mA with the cell-sense cause shown when the two measurements differ by 100 mV + a (REQ-SYS-088), and the regulated rails stay below 0.5 V at switch-on with either cell at 2.5 V - a or 4.3 V + a (REQ-SYS-166); otherwise Fail. The 5 mA and 0.5 V levels are those of the requirements. | Test | Bench | TC-SYS-064 (Draft; Bench) | - | owner bench | TRR | No | No | owner | - | Active (TBR) |
| REQ-SYS-167 | `docs/requirements/sys/requirements.json`; NGO-022, OPS-016 | The transceiver shall stop charging when its constant-voltage charge current falls by less than 20 mA (TBR) over 60 min +/-2 min (TBR). | Pass if the timer run stops charging at most 15 h after the charge start (REQ-SYS-089), and the current-fall run stops charging 60 min +/-2 min after constant-voltage entry with the charge current having fallen by less than 20 mA (REQ-SYS-167); otherwise Fail. The +/-2 min tolerance is that of REQ-SYS-167; charging stopped means a charge current below 5 mA, the level of REQ-SYS-087, 088 and 093. | Test | Bench | TC-SYS-065 (Draft; Bench) | - | owner bench | TRR | No | No | owner | - | Active (TBR) |
| REQ-SYS-168 | `docs/requirements/sys/requirements.json`; NGO-026, OPS-012 | The transceiver shall keep every closing gap of its cell cover below 4 mm or above 25 mm (TBR) throughout the cover's travel. | Pass if every external and cutout edge has a chamfer or fillet of at least 0.5 mm (REQ-SYS-110), every knob has at least 1.0 mm radial clearance to the panel (REQ-SYS-111), and every closing gap of the cell cover stays below 4 mm or above 25 mm throughout its travel (REQ-SYS-168); otherwise Fail, reported per requirement. | Analysis | Simulation | TC-SYS-076 (Draft; Simulation; hardware/enclosure/checks/enclosure_safety_check.py) | - | simulation | CDR | No | No | claude | - | Active (TBR) |
| REQ-SYS-169 | `docs/requirements/sys/requirements.json`; NGO-016, MOE-011, OPS-003 | The transceiver shall restore the default audio cap after 20 h (TBR) of cumulative unlocked operation. | Pass if the output still exceeds 30 mVrms at 19 h 50 min and is at most 30 mVrms with the default cap shown at 20 h 10 min of cumulative unlocked operation; otherwise Fail. | Test | Bench | TC-SYS-104 (Draft; Bench) | - | owner bench | TRR | No | No | owner | - | Active (TBR) |
| REQ-SYS-170 | `docs/requirements/sys/requirements.json`; NGO-016, MOE-011, OPS-001 | The transceiver shall apply the default audio cap at every power-on unless the operator has selected a persistent unlock. | Pass if before acknowledgment, and after each power-on without a persistent unlock, the output is at most 30 mVrms into 32 ohm on each channel with the meter accuracy added (REQ-SYS-074, REQ-SYS-170), and after acknowledgment and after a power-on with the persistent unlock the output exceeds 30 mVrms; otherwise Fail. | Test | Bench | TC-SYS-053 (Draft; Bench) | - | owner bench | TRR | No | No | owner | - | Active |
| REQ-SYS-171 | `docs/requirements/sys/requirements.json`; NGO-019, MOE-009, OPS-004, OPS-018, ADR-014 | The transceiver shall display cumulative key-down time over sliding 6 min and 30 min windows at 1 s resolution. | Pass if the displayed separation for every step and for Tune equals the evaluation's value (REQ-SYS-069), and the displayed 6 min and 30 min totals equal the captured key-down sums over the last 360 s and over the run within +/-1 s at 1 s resolution at both readings (REQ-SYS-171); otherwise Fail. | Test | Bench | TC-SYS-049 (Draft; Bench; tools/analyze_logic_capture.py) | - | owner bench | TRR | No | No | owner | - | Active |
| REQ-SYS-172 | `docs/requirements/sys/requirements.json`; CON-004, MOE-009, OPS-018, ADR-014 | The transceiver shall ship with reference antennas of at most 0 dBd (TBR) gain from 144 MHz to 148 MHz. | Pass if the RF exposure evaluation per 47 CFR 1.1307(b), 2.1091 and 2.1093 is on record before the first on-air transmission, the script reproduces its values, and every reference antenna has a published or literature gain of at most 0 dBd from 144 MHz to 148 MHz; otherwise Fail, reported per requirement. | Analysis | Simulation | TC-SYS-084 (Draft; Simulation; tools/budgets/rf_exposure.py) | - | simulation | CDR | No | No | claude | - | Active (TBR) |
| REQ-SYS-173 | `docs/requirements/sys/requirements.json`; MOE-011, OPS-017, CON-013 | The transceiver shall present only the sidetone on headphones while keying 5 W with 1.5 m unshielded leads on the key and headphone jacks. | Pass if the owner hears only the sidetone (no buzz, hum, RF rectification or clicks beyond the sidetone envelope) in every run; and the capture shows TX_KEY keying through the whole of each run; otherwise Fail. | Demonstration | Bench | TC-SYS-105 (Draft; Bench) | - | owner bench | TRR | No | No | owner | - | Active |
| REQ-SYS-174 | `docs/requirements/sys/requirements.json`; CON-012, SI-034, SI-018, ADR-009, OPS-005 | The transceiver shall accept keys on a 3.5 mm TRS jack wired tip as dit or straight key, ring as dah and sleeve as common. | Pass if the BOM and schematic show two series 18650 cells in holders removable without soldering, a 50 ohm stainless-steel SMA jack with female body as the antenna port, the Raspberry Pi Pico 2 module as the only controller, and a 3.5 mm TRS key jack wired tip dit or straight key, ring dah and sleeve common in agreement with ICD-CTL-KEY; otherwise Fail. | Inspection | Inspection | TC-SYS-058 (Draft; Inspection; tools/check_bom.py) | - | inspection | CDR/receipt | No | No | claude | - | Active |
| REQ-SYS-175 | `docs/requirements/sys/requirements.json`; NGO-006, SI-008, CON-015, OPS-015, ADR-008 | The transceiver shall carry its antenna port on one end face of its enclosure. | Pass if the renders and BOM show exactly two rotary knobs with push action and exactly two push buttons as operator controls besides the power switch, the bounding box excluding antenna and knobs is at most 140 mm x 70 mm x 40 mm, and the antenna port lies on one end face only; otherwise Fail. | Inspection | Inspection | TC-SYS-040 (Draft; Inspection; hardware/enclosure/checks/enclosure_inspect.py) | - | inspection | CDR/receipt | No | No | claude | - | Active |
| REQ-SYS-176 | `docs/requirements/sys/requirements.json`; CON-008, MOE-006, OPS-003, 47CFR15.23(b) | The transceiver shall keep every emission at its antenna port in receive at most -57 dBm (TBR) from 9 kHz to 1.5 GHz. | Pass if every emission at the antenna port in receive, corrected and increased by the tinySA level accuracy, is at most -57 dBm from 9 kHz to 1.5 GHz at the three tuned frequencies; otherwise Fail. | Test | Bench | TC-SYS-106 (Draft; Bench; tools/tinysa_scan_check.py) | - | owner bench | TRR | No | No | owner | - | Active (TBR) |
| REQ-SYS-177 | `docs/requirements/sys/requirements.json`; CON-008, MOE-006, OPS-017, 47CFR15.23(b) | The transceiver shall keep digital and switching-converter fundamentals and harmonics radiated from its enclosure at least 20 dB (TBR) below their board-level near-field levels. | Pass if the computed enclosure attenuation is at least 20 dB at every digital and switching-converter fundamental and harmonic to 1.5 GHz; otherwise Fail. | Analysis | Simulation | TC-SYS-107 (Draft; Simulation; tools/budgets/enclosure_shielding.py) | - | simulation | CDR | No | No | claude | - | Active (TBR) |
| REQ-SYS-178 | `docs/requirements/sys/requirements.json`; NGO-007, SI-009, SI-028, SI-031, OPS-012, ADR-012 | The transceiver shall use, for every owner-procured hand-soldered part, a catalog item with a named source and a dated quote. | Pass if every turnkey-placed part and the PA device has a timestamped CDR stock record at DigiKey, Mouser or a PCBWay turnkey distributor covering the build quantity, and every owner-procured hand-soldered part has a catalog item, a named source and a dated quote; otherwise Fail. | Inspection | Inspection | TC-SYS-093 (Draft; Inspection; tools/check_bom.py) | - | inspection | CDR/receipt | No | No | claude | - | Active |
| REQ-SYS-179 | `docs/requirements/sys/requirements.json`; MOE-003, CON-016, OPS-012 | The transceiver shall enter its bench test mode only after a menu selection followed by a separate confirmation. | Pass if TX_KEY shows zero edges in the two 10 min jack-open captures, the five idle test-mode captures and the two idle-key captures, every non-confirmed sequence leaves the mode unchanged with zero TX_KEY edges, and the test-mode generator's first TX_KEY edge follows the start confirmation press; otherwise Fail. | Test | Bench | TC-SYS-007 (Draft; Bench; tools/analyze_logic_capture.py) | - | owner bench | TRR | No | No | owner | - | Active |
| REQ-SYS-180 | `docs/requirements/sys/requirements.json`; NGO-021, MOE-012, OPS-013, OPS-021 | The transceiver shall end RF, independently of firmware, at 150 s to 180 s (TBR) of continuous transmit and hold it off until receive resumes. | Pass if in every part A and part B run the last RF-present high ends at least 150 s and at most 180 s after the T/R drive entered transmit, the indicator stays low from then until the T/R drive returns to receive, in part A while TX_KEY is still toggling (the evidence of independence from firmware; in part B the firmware ends keying when it sees the cut), and no carrier above -57 dBm at the antenna port on the tinySA Ultra, corrected for the attenuator and increased by the tinySA level accuracy (the RF-off level of REQ-SYS-183) appears on the max-hold trace until that return, and in every re-arm run the carrier is present after the return to receive; otherwise Fail. The end time of every run is recorded for the closure of the window TBR. | Test | Bench | TC-SYS-108 (Draft; Bench; tools/analyze_logic_capture.py) | - | owner bench | TRR | No | No | owner | - | Active (TBR) |
| REQ-SYS-181 | `docs/requirements/sys/requirements.json`; NGO-004, OPS-014 | The transceiver shall end antenna-port RF within 100 ms (TBR), independently of firmware, whenever the PA heat-sink temperature exceeds 95 C +/-3 C (TBR). | Pass if every threshold and full over-temperature run starts with the carrier present at the 90 C equivalent; after every switch to T_trip or 100 C during a key-down the RF-present indicator falls at most 100 ms after the fixture marker while PA_EN is still asserted by the firmware; and while the fixture stays at or above T_trip (including the key-downs begun at 100 C and the T_trip reading on the way down) the indicator stays low and no carrier above -57 dBm at the antenna port on the tinySA Ultra, corrected for the attenuator and increased by the tinySA level accuracy (the RF-off level of REQ-SYS-183) appears on the zero-span trace after the cut; otherwise Fail. | Test | Bench | TC-SYS-109 (Draft; Bench; tools/analyze_logic_capture.py) | - | owner bench | TRR | No | No | owner | - | Active (TBR) |
| REQ-SYS-182 | `docs/requirements/sys/requirements.json`; NGO-011, CON-003, OPS-020, ADR-023, 47CFR97.307(b), ADR-016 | The transceiver shall withhold RF, or end it within 100 ms (TBR), unless independent synthesizer measurement agrees with the set frequency within 10 kHz (TBR). | Pass if in every before-transmit run (150.000 MHz, 12 kHz above, 12 kHz below and no measurement; straight key, paddle and, for 150.000 MHz, Tune) the RF-present indicator stays low and no carrier at the programmed frequency above -57 dBm at the antenna port on the tinySA Ultra, corrected for the attenuator and increased by the tinySA level accuracy (the RF-off level of REQ-SYS-183) appears on the zero-span trace; in every during-transmit run the indicator falls at most 100 ms after the injection marker and the zero-span trace shows no carrier above -57 dBm at the antenna port on the tinySA Ultra, corrected for the attenuator and increased by the tinySA level accuracy (the RF-off level of REQ-SYS-183) from then to the end of the key-down; and in the agreement runs the carrier is present at each of the three frequencies with both key types; otherwise Fail. | Test | Bench | TC-SYS-110 (Draft; Bench; tools/analyze_logic_capture.py) | - | owner bench | TRR | No | No | owner | - | Active (TBR) |
| REQ-SYS-183 | `docs/requirements/sys/requirements.json`; MOE-012, NGO-021, OPS-013, OPS-019, OPS-021 | The transceiver shall hold antenna-port power at the carrier frequency at or below -57 dBm (TBR) in every state with RF ended, inhibited or off. | Pass if PA_EN stays low and no carrier at the set frequency above -57 dBm at the antenna port on the tinySA Ultra, corrected for the attenuator and increased by the tinySA level accuracy (the RF-off level of REQ-SYS-183) for every attempt of F1 to F4 and F3's forbidden entries do not occur; the Fault-safe latch survives the reset (F5); GUEST survives the configuration reset and the firmware load (F6); the Tune carrier lasts at most 5.5 s and no carrier lasts more than 13 s (F7); the key-input mode never changes without a menu selection (F8); and Firmware-update is never entered while PA_EN is high (F9); otherwise Fail.; Pass if at each set frequency from 144.0012 to 147.9988 MHz the unit keys and the carrier marker lies within the set frequency +/-(2.5 ppm plus the tinySA reference accuracy) (REQ-SYS-008), and at every set frequency outside 144.0012 to 147.9988 MHz PA_EN stays low, no carrier at the set frequency above -57 dBm at the antenna port on the tinySA Ultra, corrected for the attenuator and increased by the tinySA level accuracy (the RF-off level of REQ-SYS-183) and the display shows the guard inhibit (REQ-SYS-009); otherwise Fail.; Pass if every sequence other than the held combination followed by the confirmation leaves the lock state unchanged on both a locked and an unlocked unit (REQ-SYS-066), and while locked, before and after the power cycle and the configuration reset, PA_EN stays low and no carrier at the set frequency above -57 dBm at the antenna port on the tinySA Ultra, corrected for the attenuator and increased by the tinySA level accuracy (the RF-off level of REQ-SYS-183) for every keying, tune and test-mode attempt (REQ-SYS-065); otherwise Fail.; Pass if with USB present no carrier at the set frequency above -57 dBm at the antenna port on the tinySA Ultra, corrected for the attenuator and increased by the tinySA level accuracy (the RF-off level of REQ-SYS-183) appears for the commanded TX_KEY or either key (REQ-SYS-092), and with the cells removed the transmitter rail stays below 0.5 V in the bootloader and application states while TX_KEY is asserted (REQ-SYS-149); otherwise Fail.; Pass if PA_EN is low, TX_KEY low and no carrier at the set frequency above -57 dBm at the antenna port on the tinySA Ultra, corrected for the attenuator and increased by the tinySA level accuracy (the RF-off level of REQ-SYS-183) throughout the reset, bootloader and firmware-load states (REQ-SYS-119); after every reset, panic and latched fault PA_EN is low, TX_KEY low (key up), the T/R drive at receive, the amplifier enable low (audio muted) and the charger enable low (charging disabled) before the first edge on any other captured output, in the keyed and in the charging steps (REQ-SYS-130); and every hang ends in a reset into SafeState at most 2 s after the hang marker (REQ-SYS-131); otherwise Fail.; Pass if with either condition forced alone PA_EN stays low and no carrier at the set frequency above -57 dBm at the antenna port on the tinySA Ultra, corrected for the attenuator and increased by the tinySA level accuracy (the RF-off level of REQ-SYS-183) in every repetition, and RF is present only while both conditions are asserted; otherwise Fail.; Pass if for loss of lock and for the 12 kHz offset, at key-down and during the over, the unit enters Fault-safe with PA_EN low and no carrier at the set frequency above -57 dBm at the antenna port on the tinySA Ultra, corrected for the attenuator and increased by the tinySA level accuracy (the RF-off level of REQ-SYS-183) (REQ-SYS-154), and it enters Fault-safe at most 100 ms after the detector reading is forced low or high during key-down (REQ-SYS-156); otherwise Fail.; Pass if in every part A and part B run the last RF-present high ends at least 150 s and at most 180 s after the T/R drive entered transmit, the indicator stays low from then until the T/R drive returns to receive, in part A while TX_KEY is still toggling (the evidence of independence from firmware; in part B the firmware ends keying when it sees the cut), and no carrier above -57 dBm at the antenna port on the tinySA Ultra, corrected for the attenuator and increased by the tinySA level accuracy (the RF-off level of REQ-SYS-183) appears on the max-hold trace until that return, and in every re-arm run the carrier is present after the return to receive; otherwise Fail. The end time of every run is recorded for the closure of the window TBR.; Pass if every threshold and full over-temperature run starts with the carrier present at the 90 C equivalent; after every switch to T_trip or 100 C during a key-down the RF-present indicator falls at most 100 ms after the fixture marker while PA_EN is still asserted by the firmware; and while the fixture stays at or above T_trip (including the key-downs begun at 100 C and the T_trip reading on the way down) the indicator stays low and no carrier above -57 dBm at the antenna port on the tinySA Ultra, corrected for the attenuator and increased by the tinySA level accuracy (the RF-off level of REQ-SYS-183) appears on the zero-span trace after the cut; otherwise Fail.; Pass if in every before-transmit run (150.000 MHz, 12 kHz above, 12 kHz below and no measurement; straight key, paddle and, for 150.000 MHz, Tune) the RF-present indicator stays low and no carrier at the programmed frequency above -57 dBm at the antenna port on the tinySA Ultra, corrected for the attenuator and increased by the tinySA level accuracy (the RF-off level of REQ-SYS-183) appears on the zero-span trace; in every during-transmit run the indicator falls at most 100 ms after the injection marker and the zero-span trace shows no carrier above -57 dBm at the antenna port on the tinySA Ultra, corrected for the attenuator and increased by the tinySA level accuracy (the RF-off level of REQ-SYS-183) from then to the end of the key-down; and in the agreement runs the carrier is present at each of the three frequencies with both key types; otherwise Fail. | Test | Bench | TC-SYS-003 (Draft; Bench; tools/analyze_mode_trace.py), TC-SYS-008 (Draft; Bench), TC-SYS-047 (Draft; Bench), TC-SYS-066 (Draft; Bench), TC-SYS-082 (Draft; Bench; tools/analyze_logic_capture.py), TC-SYS-083 (Draft; Bench), TC-SYS-101 (Draft; Bench; tools/analyze_logic_capture.py), TC-SYS-108 (Draft; Bench; tools/analyze_logic_capture.py), TC-SYS-109 (Draft; Bench; tools/analyze_logic_capture.py), TC-SYS-110 (Draft; Bench; tools/analyze_logic_capture.py) | - | owner bench | TRR | No | No | owner | - | Active (TBR) |
| REQ-SYS-184 | `docs/requirements/sys/requirements.json`; NGO-021, MOE-012, OPS-013 | The transceiver shall stop keying when both paddle contacts stay closed for more than 2 s (TBR) in Iambic A, Iambic B or Ultimatic mode. | Pass if (REQ-SYS-053) for every manually timed hold the transmitter is unkeyed no later than 5 s after the accepted closure until the contact opens and the closure made 1 s after the release keys the transmitter; (REQ-SYS-054) in every held-lever run, alternating run without a qualifying gap and 0.8-times gap run, keying ends at the first of the end of the 128th consecutive identical element (no 129th begins) and 30 s after the end of the last qualifying gap (no TX_KEY rise begins later than 30 s after it), keying does not end in the 1.2-times gap runs, PA_EN and TX_KEY do not rise from the end of keying until both paddle contacts read open, and the dit sent 1 s after both contacts read open keys the transmitter; the fault-injected stream ends under the same 30 s bound; (REQ-SYS-184) for every 3 s squeeze and every plug insertion in Iambic A, Iambic B and Ultimatic, no TX_KEY rise begins later than 2 s after both contacts read closed, TX_KEY stays low while both stay closed, and after the dit contact opens the held dah contact keys dahs, while every 1.5 s squeeze and every squeezed character at 25 WPM is keyed completely as tools/keyer_ref.py predicts; otherwise Fail. Each time is measured from the capture edges with one capture sample period added (the decision rule of docs/process/04-verification-and-validation.md section 8.2), against the 5 s, 30 s and 2 s bounds of the requirements. The 5 WPM squeezed-character results and the behaviour after the end of the fault-injected stream (both contacts open throughout) are recorded as data and do not decide the result. | Test | Bench | TC-SYS-038 (Draft; Bench; tools/analyze_logic_capture.py) | - | owner bench | TRR | No | No | owner | - | Active (TBR) |
| REQ-SYS-185 | `docs/requirements/sys/requirements.json`; NGO-022, OPS-016, CON-011 | The transceiver shall cut charge current below 1 mA, independently of charger, 4.25 V protector and firmware, at a cell threshold within 4.30-4.35 V (TBR). | Pass if, for each cell, with the charger held on, the 4.25 V protector held off and the firmware charge stops disabled, the charge current stays above 1 mA at every step below the trip and falls below 1 mA (the level of REQ-SYS-185, with the meter accuracy added) at a cell voltage from 4.30 V to 4.35 V with the meter accuracy included, and the unit charges normally after the release image is restored; otherwise Fail. The switching-element voltages and the release voltages are data. | Test | Bench | TC-SYS-111 (Draft; Bench) | - | owner bench | TRR | No | No | owner | - | Active (TBR) |
| REQ-SYS-186 | `docs/requirements/sys/requirements.json`; NGO-022, OPS-016, CON-011 | The transceiver shall keep cell thresholds of all but one protection layer within 20 mV when one cell-sense connection opens or exceeds 10 kohm (TBR). | Pass if in every fault condition (each link opened, and each link at 10 kohm) every protection layer other than the one whose sense connection is faulted detects the faulted cell above its over-voltage threshold and below its under-voltage threshold (each over-voltage layer acts on the charge path or reports the cell-sense cause, and each under-voltage layer acts on the discharge path or reports it, at the voltage it acted at in the baseline within 20 mV), and the unit returns to normal with every link closed; otherwise Fail. The 20 mV band is that of REQ-SYS-186. | Test | Bench | TC-SYS-112 (Draft; Bench) | - | owner bench | TRR | No | No | owner | - | Active (TBR) |
| REQ-SYS-187 | `docs/requirements/sys/requirements.json`; MOE-003, NGO-019, CON-016, OPS-012 | The transceiver shall hold the transmitter at the 0.5 W step for the whole bench test mode, whatever step was set before entry. | Pass if (REQ-SYS-187) the probe power lies with its uncertainty band inside 0.397 to 0.629 W (the 0.5 W step, +/-1 dB) in the PARIS generator, the continuous carrier and the watchdog demonstration with 5 W set before entry, and in the PARIS generator with every other step set before entry; (REQ-SYS-188) in every run TX_KEY and PA_EN are low and the TEST indication is off no later than 120 s after the confirming press, measured from the button edge with one capture sample period added; (REQ-SYS-189) the full-scale tone ends no later than 60 s after it starts, measured the same way; (REQ-SYS-190) after the reset button, the power-switch cycle, the supply removal and the injected watchdog reset the unit restarts with the TEST indication off and the display showing no test mode, TX_KEY and PA_EN show no edge for 60 s and no tone appears on the load, and the mode starts again only through the REQ-SYS-179 sequence; otherwise Fail. The 120 s and 60 s bounds are those of the requirements, applied with the decision rule of docs/process/04-verification-and-validation.md section 8.2. | Test | Bench | TC-SYS-113 (Draft; Bench; tools/analyze_logic_capture.py) | - | owner bench | TRR | No | No | owner | - | Active |
| REQ-SYS-188 | `docs/requirements/sys/requirements.json`; MOE-003, CON-016, OPS-012 | The transceiver shall leave the bench test mode at most 120 s (TBR) after entering it. | Pass if (REQ-SYS-187) the probe power lies with its uncertainty band inside 0.397 to 0.629 W (the 0.5 W step, +/-1 dB) in the PARIS generator, the continuous carrier and the watchdog demonstration with 5 W set before entry, and in the PARIS generator with every other step set before entry; (REQ-SYS-188) in every run TX_KEY and PA_EN are low and the TEST indication is off no later than 120 s after the confirming press, measured from the button edge with one capture sample period added; (REQ-SYS-189) the full-scale tone ends no later than 60 s after it starts, measured the same way; (REQ-SYS-190) after the reset button, the power-switch cycle, the supply removal and the injected watchdog reset the unit restarts with the TEST indication off and the display showing no test mode, TX_KEY and PA_EN show no edge for 60 s and no tone appears on the load, and the mode starts again only through the REQ-SYS-179 sequence; otherwise Fail. The 120 s and 60 s bounds are those of the requirements, applied with the decision rule of docs/process/04-verification-and-validation.md section 8.2. | Test | Bench | TC-SYS-113 (Draft; Bench; tools/analyze_logic_capture.py) | - | owner bench | TRR | No | No | owner | - | Active (TBR) |
| REQ-SYS-189 | `docs/requirements/sys/requirements.json`; NGO-016, MOE-011, OPS-012 | The transceiver shall end the bench full-scale headphone test tone at most 60 s (TBR) after it starts. | Pass if (REQ-SYS-187) the probe power lies with its uncertainty band inside 0.397 to 0.629 W (the 0.5 W step, +/-1 dB) in the PARIS generator, the continuous carrier and the watchdog demonstration with 5 W set before entry, and in the PARIS generator with every other step set before entry; (REQ-SYS-188) in every run TX_KEY and PA_EN are low and the TEST indication is off no later than 120 s after the confirming press, measured from the button edge with one capture sample period added; (REQ-SYS-189) the full-scale tone ends no later than 60 s after it starts, measured the same way; (REQ-SYS-190) after the reset button, the power-switch cycle, the supply removal and the injected watchdog reset the unit restarts with the TEST indication off and the display showing no test mode, TX_KEY and PA_EN show no edge for 60 s and no tone appears on the load, and the mode starts again only through the REQ-SYS-179 sequence; otherwise Fail. The 120 s and 60 s bounds are those of the requirements, applied with the decision rule of docs/process/04-verification-and-validation.md section 8.2. | Test | Bench | TC-SYS-113 (Draft; Bench; tools/analyze_logic_capture.py) | - | owner bench | TRR | No | No | owner | - | Active (TBR) |
| REQ-SYS-190 | `docs/requirements/sys/requirements.json`; MOE-003, CON-016, OPS-012, OPS-021 | The transceiver shall complete every reset and every power-on with the bench test mode inactive. | Pass if (REQ-SYS-187) the probe power lies with its uncertainty band inside 0.397 to 0.629 W (the 0.5 W step, +/-1 dB) in the PARIS generator, the continuous carrier and the watchdog demonstration with 5 W set before entry, and in the PARIS generator with every other step set before entry; (REQ-SYS-188) in every run TX_KEY and PA_EN are low and the TEST indication is off no later than 120 s after the confirming press, measured from the button edge with one capture sample period added; (REQ-SYS-189) the full-scale tone ends no later than 60 s after it starts, measured the same way; (REQ-SYS-190) after the reset button, the power-switch cycle, the supply removal and the injected watchdog reset the unit restarts with the TEST indication off and the display showing no test mode, TX_KEY and PA_EN show no edge for 60 s and no tone appears on the load, and the mode starts again only through the REQ-SYS-179 sequence; otherwise Fail. The 120 s and 60 s bounds are those of the requirements, applied with the decision rule of docs/process/04-verification-and-validation.md section 8.2. | Test | Bench | TC-SYS-113 (Draft; Bench; tools/analyze_logic_capture.py) | - | owner bench | TRR | No | No | owner | - | Active |
| REQ-SYS-194 | `docs/requirements/sys/requirements.json`; NGO-022, OPS-016, CON-011 | The transceiver shall hold the independent cell over-voltage stop threshold within 4.25-4.30 V (TBR) from 0 C to 45 C. | Pass if the worst-case cell over-voltage stop threshold lies from 4.25 V to 4.30 V at every temperature from 0 C to 45 C, with every datasheet and resistor tolerance at its worst corner; otherwise Fail. | Analysis | Simulation | TC-SYS-116 (Draft; Simulation; hardware/sim/checks/protector_threshold_temp.py) | - | simulation | CDR | No | No | claude | - | Active (TBR) |

### 3.2 Module SW-KEYER (`docs/requirements/sw/sw-keyer/requirements.json`)

| ID | Source | Shall statement | Success criteria | Method | Evidence class | Closing cases | Supporting cases | Facility | Phase | Acceptance? | Recurring acceptance? | Performer | Results | Status |
|---|---|---|---|---|---|---|---|---|---|---|---|---|---|---|
| REQ-SW-KEYER-001 | `docs/requirements/sw/sw-keyer/requirements.json`; parent REQ-SYS-038; SI-018, ADR-009, CON-012 | The keyer firmware shall hold its key-down output asserted for the whole of each debounced straight-key closure in Straight mode. | Pass if both runs pass every listed test with identical result sets and, for every closure, key-down rises no later than 1.0 ms after the sample that confirms the closure, stays asserted without a gap until the sample that confirms the opening, falls no later than 1.0 ms after that sample, and no other key-down edge occurs; otherwise Fail. | Test | HostUnit | TC-SW-KEYER-001 (Draft; HostUnit; firmware/cwht-core/tests/keyer.rs::tc_sw_keyer_001_*) | - | host | release | No | No | claude | - | Draft |
| REQ-SW-KEYER-002 | `docs/requirements/sw/sw-keyer/requirements.json`; parent REQ-SYS-038; ADR-009, CON-012 | The keyer firmware shall key Straight mode from the tip, the ring or either contact as the operator's Straight-input setting selects. | Pass if both runs pass with identical result sets and in every setting key-down follows exactly the selected contacts (Tip: tip only; Ring: ring only; Both: either), each rise and fall no later than 1.0 ms after the sample that confirms the closure or opening of a selected contact, and key-down never asserts while only an unselected contact is closed, including the 10 s held ring in the Tip setting; otherwise Fail.; Pass if (REQ-SW-KEYER-002) in each Straight-input setting the keyer test point follows only the selected contacts and never keys while only an unselected contact is closed; (REQ-SW-KEYER-024) the mode on the display never changes on a plug insertion or removal, on the menu selection before its confirmation, on either injected menu fault or on a confirmation without its selection, and changes to Straight Tip after the selection and its separate confirmation; (REQ-SW-KEYER-039) both injected menu faults, with the action and the confirmation from one input sample and from one queued event, are rejected as not distinct operator events; (REQ-SW-KEYER-025) the Straight Tip selection is accepted with the ring closed; (REQ-SW-KEYER-022) after every power-on, reset and mode change the keyer test point and PA_EN stay idle for the closure made after 490 ms of open and follow the closure made after 510 ms of open, with the paddle and with the straight key; (REQ-SW-KEYER-035) the sidetone PWM line stays inactive while the interlock withholds key-down; (REQ-SW-KEYER-036) the keyer test point and PA_EN stay idle for every pad closure made with no plug in the jack; and (REQ-SW-KEYER-023) every key-closed interlock entry toggles the report marker no later than 20.0 ms, widened by one capture sample, after the sample-marker edge of the sample that confirms the closed input, with the KEY CLOSED message shown while the interlock holds; otherwise Fail. | Test | Bench, HostUnit | TC-SW-KEYER-002 (Draft; HostUnit; firmware/cwht-core/tests/keyer.rs::tc_sw_keyer_002_*), TC-SW-KEYER-034 (Draft; Bench; tools/analyze_logic_capture.py) | - | host, owner bench | TRR/release | No | No | owner | - | Draft |
| REQ-SW-KEYER-003 | `docs/requirements/sw/sw-keyer/requirements.json`; parent REQ-SYS-039; SI-018, ADR-009 | The keyer firmware shall complete every started paddle element to its full nominal length whatever the paddle state after it starts. | Pass if both runs pass with identical result sets and every started element in every mode, speed and release condition has its full nominal length (dit 1200/WPM ms, dah 3 dits) within the REQ-SW-KEYER-013 tolerance (+/-0.5 percent or +/-0.2 ms, whichever is larger), and V1 and V2 each produce exactly one element; otherwise Fail. | Test | HostUnit | TC-SW-KEYER-003 (Draft; HostUnit; firmware/cwht-core/tests/keyer.rs::tc_sw_keyer_003_*) | - | host | release | No | No | claude | - | Draft |
| REQ-SW-KEYER-004 | `docs/requirements/sw/sw-keyer/requirements.json`; parent REQ-SYS-039; SI-018, ADR-009 | The keyer firmware shall follow every paddle element with a one-dit inter-element space that no paddle closure shortens. | Pass if both runs pass with identical result sets, V3, V11 and V12 reproduce the reference sequences, and after every element the interval to the next element start is one dit within the REQ-SW-KEYER-013 tolerance (+/-0.5 percent or +/-0.2 ms, whichever is larger) when the next element was latched or held before the space ended and never less than one dit minus that tolerance otherwise, in every tap position of the sweeps; otherwise Fail. | Test | HostUnit | TC-SW-KEYER-004 (Draft; HostUnit; firmware/cwht-core/tests/keyer.rs::tc_sw_keyer_004_*) | - | host | release | No | No | claude | - | Draft |
| REQ-SW-KEYER-005 | `docs/requirements/sw/sw-keyer/requirements.json`; parent REQ-SYS-039; SI-018, ADR-009 | The keyer firmware shall send the opposite element after the current element and space when the opposite paddle closes during either. | Pass if both runs pass with identical result sets, V4 and V5 reproduce the reference sequences in both modes at every speed, in every run of the sweeps exactly one opposite element follows the current element after a one-dit space, both within the REQ-SW-KEYER-013 tolerance (+/-0.5 percent or +/-0.2 ms, whichever is larger), and no element follows when no opposite closure occurred; otherwise Fail. | Test | HostUnit | TC-SW-KEYER-005 (Draft; HostUnit; firmware/cwht-core/tests/keyer.rs::tc_sw_keyer_005_*) | - | host | release | No | No | claude | - | Draft |
| REQ-SW-KEYER-006 | `docs/requirements/sw/sw-keyer/requirements.json`; parent REQ-SYS-040; NGO-013, SI-018 | The keyer firmware shall send alternating dits and dahs, starting with the first-closed paddle's element, while both paddles stay closed in Iambic A and B. | Pass if both runs pass with identical result sets and, while both paddles stay closed, the elements strictly alternate starting with the first-closed paddle's element (a dit for a closure of both in the same sample), each element and space within the REQ-SW-KEYER-013 tolerance (+/-0.5 percent or +/-0.2 ms, whichever is larger), and V10 reproduces the reference sequence up to the release; otherwise Fail. | Test | HostUnit | TC-SW-KEYER-006 (Draft; HostUnit; firmware/cwht-core/tests/keyer.rs::tc_sw_keyer_006_*) | - | host | release | No | No | claude | - | Draft |
| REQ-SW-KEYER-007 | `docs/requirements/sw/sw-keyer/requirements.json`; parent REQ-SYS-040; NGO-013, SI-018 | The keyer firmware shall, in Iambic A mode, send no further element after the one in progress when both paddles open during a squeeze. | Pass if both runs pass with identical result sets, V6, V7, V8 and V10 reproduce the Iambic A reference sequences at every speed with each element and space within the REQ-SW-KEYER-013 tolerance (+/-0.5 percent or +/-0.2 ms, whichever is larger), and in every run of the release sweeps the element in progress completes with its nominal length and no further element follows; otherwise Fail. | Test | HostUnit | TC-SW-KEYER-007 (Draft; HostUnit; firmware/cwht-core/tests/keyer.rs::tc_sw_keyer_007_*) | - | host | release | No | No | claude | - | Draft |
| REQ-SW-KEYER-008 | `docs/requirements/sw/sw-keyer/requirements.json`; parent REQ-SYS-040; NGO-013, SI-018 | The keyer firmware shall, in Iambic B mode, send one alternate element after a squeeze held past the switchpoint of the element in progress. | Pass if both runs pass with identical result sets, every vector reproduces its Iambic B reference sequence at every speed and switchpoint with each element and space within the REQ-SW-KEYER-013 tolerance (+/-0.5 percent or +/-0.2 ms, whichever is larger), and in the release sweep exactly one alternate element follows (after a one-dit space) whenever the confirmed opening came 1 ms or more after the switchpoint instant and none follows whenever it came 1 ms or more before; otherwise Fail. | Test | HostUnit | TC-SW-KEYER-008 (Draft; HostUnit; firmware/cwht-core/tests/keyer.rs::tc_sw_keyer_008_*) | - | host | release | No | No | claude | - | Draft |
| REQ-SW-KEYER-009 | `docs/requirements/sw/sw-keyer/requirements.json`; parent REQ-SYS-040; NGO-013 | The keyer firmware shall accept Iambic B switchpoint settings from 0 to 90 percent of the element length in 10 percent steps (TBR). | Pass if both runs pass with identical result sets, every setting from 0 to 90 percent in 10 percent steps is accepted and moves the Iambic B latch boundary of V9 to within 1 ms of the dah start plus the setting times the dah length (at 0 percent every release latches), and every other commanded value (5, 15, 95 and 100 percent and the largest value of the command type) is rejected with the previous setting and latch boundary kept; otherwise Fail. | Test | HostUnit | TC-SW-KEYER-009 (Draft; HostUnit; firmware/cwht-core/tests/keyer.rs::tc_sw_keyer_009_*) | - | host | release | No | No | claude | - | Draft (TBR) |
| REQ-SW-KEYER-010 | `docs/requirements/sw/sw-keyer/requirements.json`; parent REQ-SYS-040; NGO-013 | The keyer firmware shall, in Ultimatic mode, repeat the element of the last-closed paddle while both paddles stay closed. | Pass if both runs pass with identical result sets and, in Ultimatic mode, while both paddles stay closed every element after the one in progress is the last-closed paddle's element, and after a release the elements are the still-closed paddle's, each element and space within the REQ-SW-KEYER-013 tolerance (+/-0.5 percent or +/-0.2 ms, whichever is larger); otherwise Fail. | Test | HostUnit | TC-SW-KEYER-010 (Draft; HostUnit; firmware/cwht-core/tests/keyer.rs::tc_sw_keyer_010_*) | - | host | release | No | No | claude | - | Draft |
| REQ-SW-KEYER-011 | `docs/requirements/sw/sw-keyer/requirements.json`; parent REQ-SYS-040; NGO-013 | The keyer firmware shall, in Bug mode, generate self-timed dits with one-dit spaces while the dit contact stays closed. | Pass if both runs pass with identical result sets, a 1.000 s dit-contact hold produces 3, 9 and 21 dits at 5, 20 and 50 WPM and the reference-model count at the other speeds, every dit and every space between dits is one dit within the REQ-SW-KEYER-013 tolerance (+/-0.5 percent or +/-0.2 ms, whichever is larger), and the dah contact produces no self-timed dit; otherwise Fail. | Test | HostUnit | TC-SW-KEYER-011 (Draft; HostUnit; firmware/cwht-core/tests/keyer.rs::tc_sw_keyer_011_*) | - | host | release | No | No | claude | - | Draft |
| REQ-SW-KEYER-012 | `docs/requirements/sw/sw-keyer/requirements.json`; parent REQ-SYS-040; NGO-013 | The keyer firmware shall, in Bug mode, hold key-down for the whole of each debounced dah-contact closure. | Pass if both runs pass with identical result sets and, for every dah-contact closure, key-down rises no later than 1.0 ms after the sample that confirms the closure, stays asserted without a gap until the sample that confirms the opening, falls no later than 1.0 ms after that sample, and no other key-down edge occurs; otherwise Fail. | Test | HostUnit | TC-SW-KEYER-012 (Draft; HostUnit; firmware/cwht-core/tests/keyer.rs::tc_sw_keyer_012_*) | - | host | release | No | No | claude | - | Draft |
| REQ-SW-KEYER-013 | `docs/requirements/sw/sw-keyer/requirements.json`; parent REQ-SYS-042; NGO-013, ADR-024 | The keyer firmware shall time each generated dit, dah and inter-element space within +/-0.5 percent or +/-0.2 ms of nominal, whichever is larger. | Pass if both runs pass with identical result sets and every generated dit, dah and inter-element space in every test is within +/-0.5 percent or +/-0.2 ms, whichever is larger, of its nominal (dit 1200/WPM ms, dah 3 dits, inter-element space 1 dit), measured on the mock clock at 0.1 ms resolution; otherwise Fail. | Test | HostUnit | TC-SW-KEYER-013 (Draft; HostUnit; firmware/cwht-core/tests/keyer.rs::tc_sw_keyer_013_*) | - | host | release | No | No | claude | - | Draft |
| REQ-SW-KEYER-014 | `docs/requirements/sw/sw-keyer/requirements.json`; parent REQ-SYS-042; CON-025, ADR-024, ADR-006 | The keyer firmware shall hold element and space errors within +/-0.5 percent or +/-0.2 ms at 50 display frames/s and 50 detents/s per encoder (TBR). | Pass if in every capture with the encoders turning every dit, dah and inter-element space at the keyer test point is within +/-0.5 percent or +/-0.2 ms, whichever is larger, of its nominal at 5, 25 and 50 WPM (dit 240, 48 and 24 ms; dah three dits; space one dit), each tolerance widened by one capture sample (0.001 ms), and throughout each loaded capture the display chip-select shows at least 50 full-frame transfers per second and each encoder's A and B lines show 50 +/-2 detents per second; otherwise Fail. The idle-encoder captures are held to the same limits. | Test | Bench | TC-SW-KEYER-014 (Draft; Bench; tools/analyze_keyer_capture.py) | - | owner bench | TRR | No | No | owner | - | Draft (TBR) |
| REQ-SW-KEYER-015 | `docs/requirements/sw/sw-keyer/requirements.json`; parent REQ-SYS-041; SI-033, ADR-024, NGO-013 | The keyer firmware shall accept keyer speed settings from 5 to 50 WPM in 1 WPM steps. | Pass if both runs pass with identical result sets, every integer speed from 5 to 50 WPM is accepted and produces dits of 1200/WPM ms and dahs of three dits within the REQ-SW-KEYER-013 tolerance (+/-0.5 percent or +/-0.2 ms, whichever is larger), and 4, 51 and 0 WPM and the largest value of the command type are rejected with 20 WPM kept; otherwise Fail. | Test | HostUnit | TC-SW-KEYER-015 (Draft; HostUnit; firmware/cwht-core/tests/keyer.rs::tc_sw_keyer_015_*) | - | host | release | No | No | claude | - | Draft |
| REQ-SW-KEYER-016 | `docs/requirements/sw/sw-keyer/requirements.json`; parent REQ-SYS-041; ADR-024 | The keyer firmware shall apply a speed change from the next element, leaving the element and space in progress at their starting lengths. | Pass if both runs pass with identical result sets and in every run the element in progress and the space after it keep their starting lengths (720 and 240 ms at 5 WPM, 72 and 24 ms at 50 WPM) within the REQ-SW-KEYER-013 tolerance (+/-0.5 percent or +/-0.2 ms, whichever is larger), and the next element has the new speed's length within that tolerance; otherwise Fail. | Test | HostUnit | TC-SW-KEYER-016 (Draft; HostUnit; firmware/cwht-core/tests/keyer.rs::tc_sw_keyer_016_*) | - | host | release | No | No | claude | - | Draft |
| REQ-SW-KEYER-017 | `docs/requirements/sw/sw-keyer/requirements.json`; parent REQ-SYS-043; NGO-013 | The keyer firmware shall start a paddle-initiated element from idle within 2 ms (TBR) of the first input sample that reads the paddle closed. | Pass if both runs pass with identical result sets and every closure from idle starts its element no later than 2.0 ms after the first sample that reads the paddle closed, measured on the mock clock at 0.1 ms resolution; otherwise Fail. | Test | HostUnit | TC-SW-KEYER-017 (Draft; HostUnit; firmware/cwht-core/tests/keyer.rs::tc_sw_keyer_017_*) | - | host | release | No | No | claude | - | Draft (TBR) |
| REQ-SW-KEYER-018 | `docs/requirements/sw/sw-keyer/requirements.json`; parent REQ-SYS-160; ADR-010 | The keyer firmware shall assert key-down within 2 ms (TBR) of the first input sample that reads the straight-key contact closed. | Pass if both runs pass with identical result sets and every closure in every setting asserts key-down no later than 2.0 ms after the first sample that reads the contact closed, measured on the mock clock at 0.1 ms resolution; otherwise Fail. | Test | HostUnit | TC-SW-KEYER-018 (Draft; HostUnit; firmware/cwht-core/tests/keyer.rs::tc_sw_keyer_018_*) | - | host | release | No | No | claude | - | Draft (TBR) |
| REQ-SW-KEYER-019 | `docs/requirements/sw/sw-keyer/requirements.json`; parent REQ-SYS-043; ADR-009 | The keyer firmware shall sample both key inputs every 1.000 ms +/-0.010 ms. | Pass if in every capture every interval between consecutive sample-marker edges (one edge per key-input sample) is 1.000 ms +/-0.010 ms, widened by one capture sample (+/-0.001 ms), with no interval above 1.011 ms, while keying at 50 WPM with the paddle, while keying the straight key and while idle; otherwise Fail. | Test | Bench | TC-SW-KEYER-019 (Draft; Bench; tools/analyze_logic_capture.py) | - | owner bench | TRR | No | No | owner | - | Draft |
| REQ-SW-KEYER-020 | `docs/requirements/sw/sw-keyer/requirements.json`; parent REQ-SYS-048; MOE-005, CON-012 | The keyer firmware shall accept a key-input closure only after 2 consecutive 1 ms samples (TBR) read the input closed. | Pass if both runs pass with identical result sets, D1 to D5 give the listed closure events on each input, every confirmed closure occurs at the second of two consecutive samples that read closed and at no other sample, no closure is confirmed from a single closed sample, and no key-down or element starts without a confirmed closure; otherwise Fail.; Pass if every keyer test point rise follows the second of two consecutive samples that read the contact closed and, in Straight mode, every fall follows the fifth of five consecutive samples that read it open, each no later than 1.0 ms, widened by one capture sample, after that sample and as predicted by the reference model from the captured contact levels; no rise or element start occurs without two consecutive closed samples (no single-sample glitch keys) and no fall occurs after four or fewer open samples; for the fixture patterns, the owner's straight key and the owner's paddle; otherwise Fail.; Pass if both runs pass with identical result sets, no stimulus in any mode changes the key-input mode, speed, switchpoint, hang or Straight-input setting, no key-down asserts for the patterns in which no two consecutive samples read closed, and every key-down interval is attributable to a debounced closure; otherwise Fail. | Test | Bench, HostUnit | TC-SW-KEYER-020 (Draft; HostUnit; firmware/cwht-core/tests/keyer.rs::tc_sw_keyer_020_*), TC-SW-KEYER-035 (Draft; Bench; tools/analyze_logic_capture.py), TC-SW-KEYER-040 (Draft; HostUnit; firmware/cwht-core/tests/keyer.rs::tc_sw_keyer_040_*) | - | host, owner bench | TRR/release | No | No | owner | - | Draft (TBR) |
| REQ-SW-KEYER-021 | `docs/requirements/sw/sw-keyer/requirements.json`; parent REQ-SYS-162; MOE-005, CON-012 | The keyer firmware shall accept a key-input opening only after 5 consecutive 1 ms samples (TBR) read the input open. | Pass if both runs pass with identical result sets, D1 to D4 give the listed opening events on each input, every confirmed opening occurs at the fifth of five consecutive samples that read open and at no other sample, and a run of four or fewer open samples never ends a key-down interval; otherwise Fail.; Pass if every keyer test point rise follows the second of two consecutive samples that read the contact closed and, in Straight mode, every fall follows the fifth of five consecutive samples that read it open, each no later than 1.0 ms, widened by one capture sample, after that sample and as predicted by the reference model from the captured contact levels; no rise or element start occurs without two consecutive closed samples (no single-sample glitch keys) and no fall occurs after four or fewer open samples; for the fixture patterns, the owner's straight key and the owner's paddle; otherwise Fail. | Test | Bench, HostUnit | TC-SW-KEYER-021 (Draft; HostUnit; firmware/cwht-core/tests/keyer.rs::tc_sw_keyer_021_*), TC-SW-KEYER-035 (Draft; Bench; tools/analyze_logic_capture.py) | - | host, owner bench | TRR/release | No | No | owner | - | Draft (TBR) |
| REQ-SW-KEYER-022 | `docs/requirements/sw/sw-keyer/requirements.json`; parent REQ-SYS-052; NGO-021, MOE-012, ADR-009 | The keyer firmware shall withhold key-down after boot, reset or mode change until each input the mode uses reads open for 500 consecutive samples (TBR). | Pass if both runs pass with identical result sets and, for every entry path, mode and closed-input duration, key-down stays idle until each input the mode uses has read open for 500 consecutive samples (no key-down for a closure whose first closed sample follows 499 open samples, key-down for one that follows 500; the count runs on the raw 1 ms samples, as REQ-SW-KEYER-022 states), and an input the mode does not use never holds the interlock; otherwise Fail.; Pass if (REQ-SW-KEYER-002) in each Straight-input setting the keyer test point follows only the selected contacts and never keys while only an unselected contact is closed; (REQ-SW-KEYER-024) the mode on the display never changes on a plug insertion or removal, on the menu selection before its confirmation, on either injected menu fault or on a confirmation without its selection, and changes to Straight Tip after the selection and its separate confirmation; (REQ-SW-KEYER-039) both injected menu faults, with the action and the confirmation from one input sample and from one queued event, are rejected as not distinct operator events; (REQ-SW-KEYER-025) the Straight Tip selection is accepted with the ring closed; (REQ-SW-KEYER-022) after every power-on, reset and mode change the keyer test point and PA_EN stay idle for the closure made after 490 ms of open and follow the closure made after 510 ms of open, with the paddle and with the straight key; (REQ-SW-KEYER-035) the sidetone PWM line stays inactive while the interlock withholds key-down; (REQ-SW-KEYER-036) the keyer test point and PA_EN stay idle for every pad closure made with no plug in the jack; and (REQ-SW-KEYER-023) every key-closed interlock entry toggles the report marker no later than 20.0 ms, widened by one capture sample, after the sample-marker edge of the sample that confirms the closed input, with the KEY CLOSED message shown while the interlock holds; otherwise Fail. | Test | Bench, HostUnit | TC-SW-KEYER-022 (Draft; HostUnit; firmware/cwht-core/tests/keyer.rs::tc_sw_keyer_022_*), TC-SW-KEYER-034 (Draft; Bench; tools/analyze_logic_capture.py) | - | host, owner bench | TRR/release | No | No | owner | - | Draft (TBR) |
| REQ-SW-KEYER-023 | `docs/requirements/sw/sw-keyer/requirements.json`; parent REQ-SYS-067; MOE-012 | The keyer firmware shall report each KEY inhibit onset and its cause to the display interface within 20 ms. | Pass if both runs pass with identical result sets, every key-closed interlock entry produces a KEY inhibit report with cause interlock on the mock display interface no later than 20.0 ms after the sample that confirms the closed input, every manual-closure timeout produces a report with cause manual-closure timeout no later than 20.0 ms after key-down is forced idle, and no report occurs while the used inputs stay open or a hold stays below the timeout; otherwise Fail.; Pass if (REQ-SW-KEYER-002) in each Straight-input setting the keyer test point follows only the selected contacts and never keys while only an unselected contact is closed; (REQ-SW-KEYER-024) the mode on the display never changes on a plug insertion or removal, on the menu selection before its confirmation, on either injected menu fault or on a confirmation without its selection, and changes to Straight Tip after the selection and its separate confirmation; (REQ-SW-KEYER-039) both injected menu faults, with the action and the confirmation from one input sample and from one queued event, are rejected as not distinct operator events; (REQ-SW-KEYER-025) the Straight Tip selection is accepted with the ring closed; (REQ-SW-KEYER-022) after every power-on, reset and mode change the keyer test point and PA_EN stay idle for the closure made after 490 ms of open and follow the closure made after 510 ms of open, with the paddle and with the straight key; (REQ-SW-KEYER-035) the sidetone PWM line stays inactive while the interlock withholds key-down; (REQ-SW-KEYER-036) the keyer test point and PA_EN stay idle for every pad closure made with no plug in the jack; and (REQ-SW-KEYER-023) every key-closed interlock entry toggles the report marker no later than 20.0 ms, widened by one capture sample, after the sample-marker edge of the sample that confirms the closed input, with the KEY CLOSED message shown while the interlock holds; otherwise Fail. | Test | Bench, HostUnit | TC-SW-KEYER-023 (Draft; HostUnit; firmware/cwht-core/tests/keyer.rs::tc_sw_keyer_023_*), TC-SW-KEYER-034 (Draft; Bench; tools/analyze_logic_capture.py) | - | host, owner bench | TRR/release | No | No | owner | - | Draft |
| REQ-SW-KEYER-024 | `docs/requirements/sw/sw-keyer/requirements.json`; parent REQ-SYS-056; ADR-009, CON-012 | The keyer firmware shall change its key-input mode only after a mode-selection action and a separate confirmation that it validates as distinct operator events. | Pass if both runs pass with identical result sets, the key-input mode read back is unchanged after every plug, jack-detect, input-pattern, flood, reset, reload and non-mode command event in every mode, after every menu request without a validated action and confirmation, after every faulty-menu sequence (both events from one input sample, both from one queued event) and after every confirmation without its action or closer than the minimum interval without a release, and it equals the requested mode after every validated action and separate confirmation; otherwise Fail.; Pass if (REQ-SW-KEYER-002) in each Straight-input setting the keyer test point follows only the selected contacts and never keys while only an unselected contact is closed; (REQ-SW-KEYER-024) the mode on the display never changes on a plug insertion or removal, on the menu selection before its confirmation, on either injected menu fault or on a confirmation without its selection, and changes to Straight Tip after the selection and its separate confirmation; (REQ-SW-KEYER-039) both injected menu faults, with the action and the confirmation from one input sample and from one queued event, are rejected as not distinct operator events; (REQ-SW-KEYER-025) the Straight Tip selection is accepted with the ring closed; (REQ-SW-KEYER-022) after every power-on, reset and mode change the keyer test point and PA_EN stay idle for the closure made after 490 ms of open and follow the closure made after 510 ms of open, with the paddle and with the straight key; (REQ-SW-KEYER-035) the sidetone PWM line stays inactive while the interlock withholds key-down; (REQ-SW-KEYER-036) the keyer test point and PA_EN stay idle for every pad closure made with no plug in the jack; and (REQ-SW-KEYER-023) every key-closed interlock entry toggles the report marker no later than 20.0 ms, widened by one capture sample, after the sample-marker edge of the sample that confirms the closed input, with the KEY CLOSED message shown while the interlock holds; otherwise Fail.; Pass if both runs pass with identical result sets, no stimulus in any mode changes the key-input mode, speed, switchpoint, hang or Straight-input setting, no key-down asserts for the patterns in which no two consecutive samples read closed, and every key-down interval is attributable to a debounced closure; otherwise Fail. | Test | Bench, HostUnit | TC-SW-KEYER-024 (Draft; HostUnit; firmware/cwht-core/tests/keyer.rs::tc_sw_keyer_024_*), TC-SW-KEYER-034 (Draft; Bench; tools/analyze_logic_capture.py), TC-SW-KEYER-040 (Draft; HostUnit; firmware/cwht-core/tests/keyer.rs::tc_sw_keyer_040_*) | - | host, owner bench | TRR/release | No | No | owner | - | Draft |
| REQ-SW-KEYER-025 | `docs/requirements/sw/sw-keyer/requirements.json`; parent REQ-SYS-163; SI-018, CON-012 | The keyer firmware shall accept a key-input mode-selection command while any key input reads closed. | Pass if both runs pass with identical result sets, every mode-selection command is accepted while any key input reads closed, and after each such selection key-down stays idle until the inputs the new mode uses have passed the REQ-SW-KEYER-022 interlock; otherwise Fail.; Pass if (REQ-SW-KEYER-002) in each Straight-input setting the keyer test point follows only the selected contacts and never keys while only an unselected contact is closed; (REQ-SW-KEYER-024) the mode on the display never changes on a plug insertion or removal, on the menu selection before its confirmation, on either injected menu fault or on a confirmation without its selection, and changes to Straight Tip after the selection and its separate confirmation; (REQ-SW-KEYER-039) both injected menu faults, with the action and the confirmation from one input sample and from one queued event, are rejected as not distinct operator events; (REQ-SW-KEYER-025) the Straight Tip selection is accepted with the ring closed; (REQ-SW-KEYER-022) after every power-on, reset and mode change the keyer test point and PA_EN stay idle for the closure made after 490 ms of open and follow the closure made after 510 ms of open, with the paddle and with the straight key; (REQ-SW-KEYER-035) the sidetone PWM line stays inactive while the interlock withholds key-down; (REQ-SW-KEYER-036) the keyer test point and PA_EN stay idle for every pad closure made with no plug in the jack; and (REQ-SW-KEYER-023) every key-closed interlock entry toggles the report marker no later than 20.0 ms, widened by one capture sample, after the sample-marker edge of the sample that confirms the closed input, with the KEY CLOSED message shown while the interlock holds; otherwise Fail. | Test | Bench, HostUnit | TC-SW-KEYER-025 (Draft; HostUnit; firmware/cwht-core/tests/keyer.rs::tc_sw_keyer_025_*), TC-SW-KEYER-034 (Draft; Bench; tools/analyze_logic_capture.py) | - | host, owner bench | TRR/release | No | No | owner | - | Draft |
| REQ-SW-KEYER-026 | `docs/requirements/sw/sw-keyer/requirements.json`; parent REQ-SYS-053; NGO-021, MOE-012 | The keyer firmware shall force key-down idle after 5 s (TBR) of continuous confirmed closure of a manually timed contact, until it reads open. | Pass if both runs pass with identical result sets, a confirmed closure shorter than 5 s is keyed for its whole length, every continuous confirmed closure of 5 s or more of the Straight contact (Tip, Ring or Both) or the Bug-mode dah contact forces key-down idle between 4.999 and 5.001 s after the sample that confirmed it, key-down stays idle until the contact is confirmed open, the next closure after the confirmed opening keys normally, and a held paddle in Iambic A is not timed out; otherwise Fail.; Pass if every hold of 5.1 s or longer on the Straight contact (Tip, Ring, Both) and on the Bug-mode dah contact drops the keyer test point between 5.000 and 5.003 s after the contact closure edge, widened by one capture sample; the 4.9 s holds key for their whole length; the keyer test point stays idle until the contact opens and follows the next closure; and the sidetone PWM line stays active from the timeout until the contact opens in every hold, including the owner's; otherwise Fail. TX_KEY is recorded as data for the transmit sequencer cases. | Test | Bench, HostUnit | TC-SW-KEYER-026 (Draft; HostUnit; firmware/cwht-core/tests/keyer.rs::tc_sw_keyer_026_*), TC-SW-KEYER-036 (Draft; Bench; tools/analyze_logic_capture.py) | - | host, owner bench | TRR/release | No | No | owner | - | Draft (TBR) |
| REQ-SW-KEYER-027 | `docs/requirements/sw/sw-keyer/requirements.json`; parent REQ-SYS-053; NGO-021 | The keyer firmware shall keep the sidetone gate asserted while a timed-out manually timed contact stays closed. | Pass if both runs pass with identical result sets and, in every hold past the timeout, the sidetone gate is asserted at every 1 ms sample from the timeout instant until the sample that confirms the contact open; otherwise Fail.; Pass if every hold of 5.1 s or longer on the Straight contact (Tip, Ring, Both) and on the Bug-mode dah contact drops the keyer test point between 5.000 and 5.003 s after the contact closure edge, widened by one capture sample; the 4.9 s holds key for their whole length; the keyer test point stays idle until the contact opens and follows the next closure; and the sidetone PWM line stays active from the timeout until the contact opens in every hold, including the owner's; otherwise Fail. TX_KEY is recorded as data for the transmit sequencer cases. | Test | Bench, HostUnit | TC-SW-KEYER-027 (Draft; HostUnit; firmware/cwht-core/tests/keyer.rs::tc_sw_keyer_027_*), TC-SW-KEYER-036 (Draft; Bench; tools/analyze_logic_capture.py) | - | host, owner bench | TRR/release | No | No | owner | - | Draft |
| REQ-SW-KEYER-028 | `docs/requirements/sw/sw-keyer/requirements.json`; parent REQ-SYS-007; 47CFR97.109(d), 47CFR97.203, 47CFR97.119(b), CON-006, CON-005 | The keyer firmware shall assert key-down only from debounced key-input states or the running confirmed bench test-mode generator. | Pass if both runs pass with identical result sets, key-down never asserts during the 10 min runs with open inputs in any mode, and every key-down interval in every test is attributable to a debounced key-input closure or to the running confirmed bench test-mode generator; otherwise Fail.; Pass if the keyer test point and TX_KEY never assert during the 10 min run with open inputs or during any unconfirmed test-mode sequence or injected menu fault, the generator keys only after the owner's selection and separate confirmation (REQ-SW-KEYER-029, REQ-SW-KEYER-039) and never after an injected menu fault (both events from one input sample or from one queued event), and every assertion in the case is attributable to a captured contact closure or to the confirmed generator interval; otherwise Fail.; Pass if both runs pass with identical result sets, no stimulus in any mode changes the key-input mode, speed, switchpoint, hang or Straight-input setting, no key-down asserts for the patterns in which no two consecutive samples read closed, and every key-down interval is attributable to a debounced closure; otherwise Fail. | Test | Bench, HostUnit | TC-SW-KEYER-028 (Draft; HostUnit; firmware/cwht-core/tests/keyer.rs::tc_sw_keyer_028_*), TC-SW-KEYER-037 (Draft; Bench; tools/analyze_logic_capture.py), TC-SW-KEYER-040 (Draft; HostUnit; firmware/cwht-core/tests/keyer.rs::tc_sw_keyer_040_*) | - | host, owner bench | TRR/release | No | No | owner | - | Draft |
| REQ-SW-KEYER-029 | `docs/requirements/sw/sw-keyer/requirements.json`; parent REQ-SYS-179; MOE-003, OPS-012 | The keyer firmware shall start its test-mode PARIS generator only after a bench-test-mode selection and a separate confirmation that it validates as distinct operator events. | Pass if both runs pass with identical result sets, no sequence without a validated selection and separate confirmation starts the generator (key-down stays idle and the generator reports stopped), including every menu request alone, every faulty-menu sequence (both events from one input sample, both from one queued event) and every confirmation without its selection or closer than the minimum interval without a release, a validated selection and confirmation start it, and after a reset it stays stopped until a new validated selection and confirmation; otherwise Fail.; Pass if the keyer test point and TX_KEY never assert during the 10 min run with open inputs or during any unconfirmed test-mode sequence or injected menu fault, the generator keys only after the owner's selection and separate confirmation (REQ-SW-KEYER-029, REQ-SW-KEYER-039) and never after an injected menu fault (both events from one input sample or from one queued event), and every assertion in the case is attributable to a captured contact closure or to the confirmed generator interval; otherwise Fail. | Test | Bench, HostUnit | TC-SW-KEYER-029 (Draft; HostUnit; firmware/cwht-core/tests/keyer.rs::tc_sw_keyer_029_*), TC-SW-KEYER-037 (Draft; Bench; tools/analyze_logic_capture.py) | - | host, owner bench | TRR/release | No | No | owner | - | Draft |
| REQ-SW-KEYER-030 | `docs/requirements/sw/sw-keyer/requirements.json`; parent REQ-SYS-120; NGO-021 | The keyer firmware shall force key-down idle within 1 ms when its key-down state and its stored complement disagree. | Pass if both runs pass with identical result sets, every injected disagreement between the key-down state and its complement forces key-down idle no later than 1.0 ms after the injection in every state and phase, no injection ever asserts key-down, and nominal keying without injection shows no forced idle; otherwise Fail.; Pass if after every injection that makes the key-down state or a paddle memory disagree with its complement, every keyer error and every safe-state command, the keyer test point is idle no later than 1.0 ms, widened by one capture sample, after the injection-marker edge, with the paddle keying and with the straight key held; otherwise Fail. TX_KEY and PA_EN responses are recorded as data. | Test | Bench, HostUnit | TC-SW-KEYER-030 (Draft; HostUnit; firmware/cwht-core/tests/keyer.rs::tc_sw_keyer_030_*), TC-SW-KEYER-038 (Draft; Bench; tools/analyze_logic_capture.py) | - | host, owner bench | TRR/release | No | No | owner | - | Draft |
| REQ-SW-KEYER-031 | `docs/requirements/sw/sw-keyer/requirements.json`; parent REQ-SYS-130; NGO-021 | The keyer firmware shall force key-down idle within 1 ms of a keyer error or a safe-state command. | Pass if both runs pass with identical result sets and every keyer error variant and every safe-state command, in every keyer state and phase, forces key-down idle no later than 1.0 ms after it is raised or issued; otherwise Fail.; Pass if after every injection that makes the key-down state or a paddle memory disagree with its complement, every keyer error and every safe-state command, the keyer test point is idle no later than 1.0 ms, widened by one capture sample, after the injection-marker edge, with the paddle keying and with the straight key held; otherwise Fail. TX_KEY and PA_EN responses are recorded as data. | Test | Bench, HostUnit | TC-SW-KEYER-031 (Draft; HostUnit; firmware/cwht-core/tests/keyer.rs::tc_sw_keyer_031_*), TC-SW-KEYER-038 (Draft; Bench; tools/analyze_logic_capture.py) | - | host, owner bench | TRR/release | No | No | owner | - | Draft |
| REQ-SW-KEYER-032 | `docs/requirements/sw/sw-keyer/requirements.json`; parent REQ-SYS-044; SI-036, CON-021, ADR-010, ADR-026 | The keyer firmware shall signal end of over after an operator-set hang of 3 to 30 dits (TBR) of the displayed speed from last key-up. | Pass if both runs pass with identical result sets, the end-of-over signal comes at the set hang (3, 8 and 30 dits at 5, 15 and 50 WPM) after the last key-up within +/-1.0 ms in Straight Tip and Iambic A, never comes while keying continues within the hang, and settings outside 3 to 30 dits are rejected with the previous setting kept; otherwise Fail. | Test | HostUnit | TC-SW-KEYER-032 (Draft; HostUnit; firmware/cwht-core/tests/keyer.rs::tc_sw_keyer_032_*) | - | host | release | No | No | claude | - | Draft (TBR) |
| REQ-SW-KEYER-033 | `docs/requirements/sw/sw-keyer/requirements.json`; parent REQ-SYS-159; MOE-005 | The keyer firmware shall assert the sidetone gate within 1 ms of each key-down assertion. | Pass if both runs pass with identical result sets and every key-down assertion in every mode and speed is accompanied by a sidetone gate rise within 1.0 ms of it; otherwise Fail.; Pass if every keyer test point rise in every mode is followed by the first sidetone PWM edge no later than 1.0 ms plus one PWM carrier period, widened by one capture sample, and no sidetone PWM activity starts more than 1.0 ms before a keyer test point rise; otherwise Fail. | Test | Bench, HostUnit | TC-SW-KEYER-033 (Draft; HostUnit; firmware/cwht-core/tests/keyer.rs::tc_sw_keyer_033_*), TC-SW-KEYER-039 (Draft; Bench; tools/analyze_logic_capture.py) | - | host, owner bench | TRR/release | No | No | owner | - | Draft |
| REQ-SW-KEYER-034 | `docs/requirements/sw/sw-keyer/requirements.json`; NGO-021 | The keyer firmware shall force key-down idle and clear both paddle memories within 1 ms when a paddle memory and its stored complement disagree. | Pass if after every injection that makes the key-down state or a paddle memory disagree with its complement, every keyer error and every safe-state command, the keyer test point is idle no later than 1.0 ms, widened by one capture sample, after the injection-marker edge, with the paddle keying and with the straight key held; otherwise Fail. TX_KEY and PA_EN responses are recorded as data.; Pass if both runs pass with identical result sets, every injected disagreement between a paddle memory and its complement forces key-down idle and clears both memories no later than 1.0 ms after the injection in every state, no injection starts an element, and nominal keying without injection shows no forced idle; otherwise Fail. | Test | Bench, HostUnit | TC-SW-KEYER-038 (Draft; Bench; tools/analyze_logic_capture.py), TC-SW-KEYER-041 (Draft; HostUnit; firmware/cwht-core/tests/keyer.rs::tc_sw_keyer_041_*) | - | host, owner bench | TRR/release | No | No | owner | - | Draft |
| REQ-SW-KEYER-035 | `docs/requirements/sw/sw-keyer/requirements.json`; NGO-021, OPS-013 | The keyer firmware shall hold the sidetone gate deasserted while the key-closed interlock of REQ-SW-KEYER-022 withholds key-down. | Pass if (REQ-SW-KEYER-002) in each Straight-input setting the keyer test point follows only the selected contacts and never keys while only an unselected contact is closed; (REQ-SW-KEYER-024) the mode on the display never changes on a plug insertion or removal, on the menu selection before its confirmation, on either injected menu fault or on a confirmation without its selection, and changes to Straight Tip after the selection and its separate confirmation; (REQ-SW-KEYER-039) both injected menu faults, with the action and the confirmation from one input sample and from one queued event, are rejected as not distinct operator events; (REQ-SW-KEYER-025) the Straight Tip selection is accepted with the ring closed; (REQ-SW-KEYER-022) after every power-on, reset and mode change the keyer test point and PA_EN stay idle for the closure made after 490 ms of open and follow the closure made after 510 ms of open, with the paddle and with the straight key; (REQ-SW-KEYER-035) the sidetone PWM line stays inactive while the interlock withholds key-down; (REQ-SW-KEYER-036) the keyer test point and PA_EN stay idle for every pad closure made with no plug in the jack; and (REQ-SW-KEYER-023) every key-closed interlock entry toggles the report marker no later than 20.0 ms, widened by one capture sample, after the sample-marker edge of the sample that confirms the closed input, with the KEY CLOSED message shown while the interlock holds; otherwise Fail.; Pass if both runs pass with identical result sets, the sidetone gate is deasserted at every sample while the key-closed interlock withholds key-down on every entry path and closure pattern, and asserts with key-down once the interlock has passed; otherwise Fail. | Test | Bench, HostUnit | TC-SW-KEYER-034 (Draft; Bench; tools/analyze_logic_capture.py), TC-SW-KEYER-042 (Draft; HostUnit; firmware/cwht-core/tests/keyer.rs::tc_sw_keyer_042_*) | - | host, owner bench | TRR/release | No | No | owner | - | Draft |
| REQ-SW-KEYER-036 | `docs/requirements/sw/sw-keyer/requirements.json`; NGO-021, CON-012 | The keyer firmware shall withhold key-down while any key input reads closed and the plug-presence input reads no plug (TBR). | Pass if (REQ-SW-KEYER-002) in each Straight-input setting the keyer test point follows only the selected contacts and never keys while only an unselected contact is closed; (REQ-SW-KEYER-024) the mode on the display never changes on a plug insertion or removal, on the menu selection before its confirmation, on either injected menu fault or on a confirmation without its selection, and changes to Straight Tip after the selection and its separate confirmation; (REQ-SW-KEYER-039) both injected menu faults, with the action and the confirmation from one input sample and from one queued event, are rejected as not distinct operator events; (REQ-SW-KEYER-025) the Straight Tip selection is accepted with the ring closed; (REQ-SW-KEYER-022) after every power-on, reset and mode change the keyer test point and PA_EN stay idle for the closure made after 490 ms of open and follow the closure made after 510 ms of open, with the paddle and with the straight key; (REQ-SW-KEYER-035) the sidetone PWM line stays inactive while the interlock withholds key-down; (REQ-SW-KEYER-036) the keyer test point and PA_EN stay idle for every pad closure made with no plug in the jack; and (REQ-SW-KEYER-023) every key-closed interlock entry toggles the report marker no later than 20.0 ms, widened by one capture sample, after the sample-marker edge of the sample that confirms the closed input, with the KEY CLOSED message shown while the interlock holds; otherwise Fail.; Pass if both runs pass with identical result sets, no closure made while the plug-presence input reads no plug asserts key-down in any mode, key-down falls idle no later than 1.0 ms after the sample that first reads no plug, and closures with the plug present key as the mode defines; otherwise Fail. | Test | Bench, HostUnit | TC-SW-KEYER-034 (Draft; Bench; tools/analyze_logic_capture.py), TC-SW-KEYER-043 (Draft; HostUnit; firmware/cwht-core/tests/keyer.rs::tc_sw_keyer_043_*) | - | host, owner bench | TRR/release | No | No | owner | - | Draft (TBR) |
| REQ-SW-KEYER-037 | `docs/requirements/sw/sw-keyer/requirements.json`; parent REQ-SYS-041; NGO-013, ADR-024 | The keyer firmware shall reject a speed, switchpoint or hang setting command outside its stated range and keep the previous setting. | Pass if both runs pass with identical result sets, every setting from 0 to 90 percent in 10 percent steps is accepted and moves the Iambic B latch boundary of V9 to within 1 ms of the dah start plus the setting times the dah length (at 0 percent every release latches), and every other commanded value (5, 15, 95 and 100 percent and the largest value of the command type) is rejected with the previous setting and latch boundary kept; otherwise Fail.; Pass if both runs pass with identical result sets, every integer speed from 5 to 50 WPM is accepted and produces dits of 1200/WPM ms and dahs of three dits within the REQ-SW-KEYER-013 tolerance (+/-0.5 percent or +/-0.2 ms, whichever is larger), and 4, 51 and 0 WPM and the largest value of the command type are rejected with 20 WPM kept; otherwise Fail.; Pass if both runs pass with identical result sets, the end-of-over signal comes at the set hang (3, 8 and 30 dits at 5, 15 and 50 WPM) after the last key-up within +/-1.0 ms in Straight Tip and Iambic A, never comes while keying continues within the hang, and settings outside 3 to 30 dits are rejected with the previous setting kept; otherwise Fail. | Test | HostUnit | TC-SW-KEYER-009 (Draft; HostUnit; firmware/cwht-core/tests/keyer.rs::tc_sw_keyer_009_*), TC-SW-KEYER-015 (Draft; HostUnit; firmware/cwht-core/tests/keyer.rs::tc_sw_keyer_015_*), TC-SW-KEYER-032 (Draft; HostUnit; firmware/cwht-core/tests/keyer.rs::tc_sw_keyer_032_*) | - | host | release | No | No | claude | - | Draft |
| REQ-SW-KEYER-038 | `docs/requirements/sw/sw-keyer/requirements.json`; ADR-009, CON-012 | The keyer firmware shall leave its speed, switchpoint, hang and Straight-input settings unchanged by every key-input pattern. | Pass if both runs pass with identical result sets, no stimulus in any mode changes the key-input mode, speed, switchpoint, hang or Straight-input setting, no key-down asserts for the patterns in which no two consecutive samples read closed, and every key-down interval is attributable to a debounced closure; otherwise Fail. | Test | HostUnit | TC-SW-KEYER-040 (Draft; HostUnit; firmware/cwht-core/tests/keyer.rs::tc_sw_keyer_040_*) | - | host | release | No | No | claude | - | Draft |
| REQ-SW-KEYER-039 | `docs/requirements/sw/sw-keyer/requirements.json`; NGO-021, OPS-012, OPS-013 | The keyer firmware shall accept two operator events as distinct only from different input samples showing different inputs, or a release and 300 ms (TBR). | Pass if both runs pass with identical result sets, the key-input mode read back is unchanged after every plug, jack-detect, input-pattern, flood, reset, reload and non-mode command event in every mode, after every menu request without a validated action and confirmation, after every faulty-menu sequence (both events from one input sample, both from one queued event) and after every confirmation without its action or closer than the minimum interval without a release, and it equals the requested mode after every validated action and separate confirmation; otherwise Fail.; Pass if both runs pass with identical result sets, no sequence without a validated selection and separate confirmation starts the generator (key-down stays idle and the generator reports stopped), including every menu request alone, every faulty-menu sequence (both events from one input sample, both from one queued event) and every confirmation without its selection or closer than the minimum interval without a release, a validated selection and confirmation start it, and after a reset it stays stopped until a new validated selection and confirmation; otherwise Fail.; Pass if (REQ-SW-KEYER-002) in each Straight-input setting the keyer test point follows only the selected contacts and never keys while only an unselected contact is closed; (REQ-SW-KEYER-024) the mode on the display never changes on a plug insertion or removal, on the menu selection before its confirmation, on either injected menu fault or on a confirmation without its selection, and changes to Straight Tip after the selection and its separate confirmation; (REQ-SW-KEYER-039) both injected menu faults, with the action and the confirmation from one input sample and from one queued event, are rejected as not distinct operator events; (REQ-SW-KEYER-025) the Straight Tip selection is accepted with the ring closed; (REQ-SW-KEYER-022) after every power-on, reset and mode change the keyer test point and PA_EN stay idle for the closure made after 490 ms of open and follow the closure made after 510 ms of open, with the paddle and with the straight key; (REQ-SW-KEYER-035) the sidetone PWM line stays inactive while the interlock withholds key-down; (REQ-SW-KEYER-036) the keyer test point and PA_EN stay idle for every pad closure made with no plug in the jack; and (REQ-SW-KEYER-023) every key-closed interlock entry toggles the report marker no later than 20.0 ms, widened by one capture sample, after the sample-marker edge of the sample that confirms the closed input, with the KEY CLOSED message shown while the interlock holds; otherwise Fail.; Pass if the keyer test point and TX_KEY never assert during the 10 min run with open inputs or during any unconfirmed test-mode sequence or injected menu fault, the generator keys only after the owner's selection and separate confirmation (REQ-SW-KEYER-029, REQ-SW-KEYER-039) and never after an injected menu fault (both events from one input sample or from one queued event), and every assertion in the case is attributable to a captured contact closure or to the confirmed generator interval; otherwise Fail. | Test | Bench, HostUnit | TC-SW-KEYER-024 (Draft; HostUnit; firmware/cwht-core/tests/keyer.rs::tc_sw_keyer_024_*), TC-SW-KEYER-029 (Draft; HostUnit; firmware/cwht-core/tests/keyer.rs::tc_sw_keyer_029_*), TC-SW-KEYER-034 (Draft; Bench; tools/analyze_logic_capture.py), TC-SW-KEYER-037 (Draft; Bench; tools/analyze_logic_capture.py) | - | host, owner bench | TRR/release | No | No | owner | - | Draft (TBR) |

### 3.3 Module TX (`docs/requirements/tx/requirements.json`)

| ID | Source | Shall statement | Success criteria | Method | Evidence class | Closing cases | Supporting cases | Facility | Phase | Acceptance? | Recurring acceptance? | Performer | Results | Status |
|---|---|---|---|---|---|---|---|---|---|---|---|---|---|---|
| REQ-TX-001 | `docs/requirements/tx/requirements.json`; parent REQ-SYS-001; 47CFR97.305(a), 47CFR97.305(c), 47CFR97.3(c)(1), CON-003, SI-004, ADR-003 | The transmitter shall accept the keying envelope as the only modulating input of its RF chain. | Pass if every net that reaches a modulating or control pin of the exciter, envelope modulator, PA and synthesizer is classified as the envelope drive, a DC bias or supply with decoupling, a static digital setting or ground, and no audio net reaches any RF-chain part other than through a DC supply or ground return with decoupling; otherwise Fail. | Inspection | Inspection | TC-TX-001 (Draft; Inspection; tools/check_tx_modulation_paths.py) | - | inspection | CDR/receipt | No | No | claude | - | Draft |
| REQ-TX-002 | `docs/requirements/tx/requirements.json`; parent REQ-SYS-008; 47CFR97.301(a), CON-001, ADR-016, ADR-023 | The transmitter shall generate its carrier at any commanded frequency from 144.0012 MHz to 147.9988 MHz (TBR). | Pass if at every commanded frequency the tinySA shows a carrier whose marker frequency differs from the commanded frequency by no more than 2.5 ppm (the REQ-SYS-010 tolerance, 370 Hz at 148 MHz) plus the tinySA frequency uncertainty of its TV record, and whose level corrected to the antenna port is within 3 dB of the 146.000 MHz reference at the same step; otherwise Fail. The 3 dB window separates a generated carrier from leakage or a spurious response; the power level itself is verified by TC-TX-004 and TC-SYS-011. | Test | Bench | TC-TX-002 (Draft; Bench; tools/tinysa_scan_check.py) | - | owner bench | TRR | No | No | owner | - | Draft (TBR) |
| REQ-TX-003 | `docs/requirements/tx/requirements.json`; parent REQ-SYS-009; 47CFR97.307(b), 47CFR97.7, ADR-023, ADR-015 | The transmitter shall hold antenna-port carrier power at most 1 uW (TBR) while PA_EN is deasserted with the exciter driven. | Pass if, at 144.0012, 146.000 and 147.9988 MHz and at 7.4 and 8.4 V supply, with PA_EN low throughout each activation on the capture, the carrier power at the antenna port, corrected for the attenuator S21 and increased by the tinySA level accuracy of its TV record, is at most -30.0 dBm (1 uW); otherwise Fail. An activation in which PA_EN rises is a Procedure-correction NCR against the fault-injection build, not a requirement result. | Test | Bench | TC-TX-003 (Draft; Bench; tools/tinysa_scan_check.py) | - | owner bench | TRR | No | No | owner | - | Draft (TBR) |
| REQ-TX-004 | `docs/requirements/tx/requirements.json`; parent REQ-SYS-011; 47CFR97.313(a), CON-007, SI-003 | The transmitter shall deliver commanded 0.5, 1 and 2 W steps within +/-1 dB (TBR) into 50 ohm, 144.0012-147.9988 MHz, 6.4-8.4 V supply. | Pass if at every frequency and supply voltage the probe power with its characterized uncertainty band lies entirely inside 0.397 to 0.629 W at the 0.5 W step, 0.794 to 1.259 W at the 1 W step and 1.589 to 2.518 W at the 2 W step (+/-1 dB); otherwise Fail. A probe and tinySA disagreement beyond their combined uncertainty, or a paddle reading that differs from the straight-key reading by more than the probe uncertainty, is a Procedure-correction NCR (docs/process/04-verification-and-validation.md section 6.2), not a requirement result. | Test | Bench | TC-TX-004 (Draft; Bench; tools/rf_probe_power.py) | - | owner bench | TRR | No | No | owner | - | Draft (TBR) |
| REQ-TX-005 | `docs/requirements/tx/requirements.json`; parent REQ-SYS-014; 47CFR97.307(a), 47CFR97.307(b), CON-003, ADR-023 | The transmitter shall reproduce each commanded raised-cosine envelope at the antenna port with 10-to-90 percent times within +/-10 percent (TBR) of the command. | Pass if, at each of the 3, 5 and 8 ms settings, at the 0.5 W and 5 W steps, at 6.4, 7.4 and 8.4 V supply and at every shaping-network tolerance corner, the 10-to-90 percent rise and fall times of the simulated antenna-port RF envelope are within +/-10 percent of the commanded setting (2.7 to 3.3 ms, 4.5 to 5.5 ms and 7.2 to 8.8 ms); otherwise Fail. | Analysis | Simulation | TC-TX-005 (Draft; Simulation; hardware/sim/checks/envelope_check.py) | - | simulation | CDR | No | No | claude | - | Draft (TBR) |
| REQ-TX-006 | `docs/requirements/tx/requirements.json`; parent REQ-SYS-015; 47CFR97.307(a), 47CFR97.307(b), CON-003, ADR-024, ADR-023 | The transmitter shall hold its keyed spectrum at least 60 dB below total mean power beyond 750 Hz (TBR) offset with continuous 50 WPM dits. | Pass if the checker known-answer step reproduces 614 Hz within 10 Hz and, for each of the 3, 5 and 8 ms settings, at the 0.5 W and 5 W steps and at every shaping-network tolerance corner, the power in every 10 Hz cell of the simulated keyed signal at offsets from 750 Hz to 50 kHz on both sides of the carrier is at least 60.0 dB below the total mean power of the record, computed with the same window; otherwise Fail. | Analysis | Simulation | TC-TX-006 (Draft; Simulation; hardware/sim/checks/keying_spectrum_check.py) | - | simulation | CDR | No | No | claude | - | Draft (TBR) |
| REQ-TX-007 | `docs/requirements/tx/requirements.json`; parent REQ-SYS-017; 47CFR97.307(e), CON-002, ADR-021 | The transmitter shall keep every antenna-port spurious emission at most 25 uW at every power step, 144.0012-147.9988 MHz and 6.4-8.4 V supply. | Pass if every spurious emission at the antenna port, corrected for the attenuator S21 and increased by the tinySA level accuracy of its TV record, is at most -16.02 dBm (25 uW) in every one of the 24 step, frequency and supply combinations and at both band-edge carriers; otherwise Fail. Straight-key and paddle readings within 1 dB of the fixture readings confirm that the keying source does not change the result; a larger difference is a Procedure-correction NCR. | Test | Bench | TC-TX-007 (Draft; Bench; tools/tinysa_scan_check.py) | - | owner bench | TRR | No | No | owner | - | Draft |
| REQ-TX-008 | `docs/requirements/tx/requirements.json`; parent REQ-SYS-018; 47CFR97.307(e), 47CFR2.106, CON-002, ADR-022 | The transmitter shall keep every antenna-port spurious emission at least 60 dB (TBR) below the mean carrier power at the 5 W step. | Pass if, at every carrier frequency and supply voltage of the procedure at the 5 W step, every spurious emission at the antenna port, with its level increased by the tinySA relative level uncertainty of its TV record, is at least 60.0 dB below the mean carrier power read in the same session, with 2f, 3f and 7f reported individually with their victim service; otherwise Fail. Straight-key and paddle readings within 1 dB of the fixture readings confirm that the keying source does not change the result; a larger difference is a Procedure-correction NCR. | Test | Bench | TC-TX-008 (Draft; Bench; tools/tinysa_scan_check.py) | - | owner bench | TRR | No | No | owner | - | Draft (TBR) |
| REQ-TX-009 | `docs/requirements/tx/requirements.json`; parent REQ-SYS-018; 47CFR97.307(e), 47CFR2.106, ADR-022 | The transmitter shall attenuate every signal from 288 MHz to 296 MHz by at least 40 dB (TBR) between its PA output and antenna port. | Pass if the isolation floor lies at least 10 dB below -40 dB across the sweep and S21 from the filter test point to the antenna port, normalized to the through calibration and increased by the NanoVNA S21 uncertainty of its TV record, is at most -40.0 dB at every point from 288 to 296 MHz; otherwise Fail. | Test | Bench | TC-TX-009 (Draft; Bench; tools/filter_s21_check.py) | - | owner bench | TRR | No | No | owner | - | Draft (TBR) |
| REQ-TX-010 | `docs/requirements/tx/requirements.json`; parent REQ-SYS-018; 47CFR97.307(e), 47CFR2.106, ADR-022 | The transmitter shall attenuate every signal from 432 MHz to 444 MHz by at least 35 dB (TBR) between its PA output and antenna port. | Pass if the isolation floor lies at least 10 dB below -35 dB across the sweep and S21 from the filter test point to the antenna port, normalized to the through calibration and increased by the NanoVNA S21 uncertainty of its TV record, is at most -35.0 dB at every point from 432 to 444 MHz; otherwise Fail. | Test | Bench | TC-TX-010 (Draft; Bench; tools/filter_s21_check.py) | - | owner bench | TRR | No | No | owner | - | Draft (TBR) |
| REQ-TX-011 | `docs/requirements/tx/requirements.json`; parent REQ-SYS-018; 47CFR97.307(e), 47CFR2.106, ADR-022 | The transmitter shall attenuate every signal from 576 MHz to 1.5 GHz by at least 40 dB (TBR) between its PA output and antenna port. | Pass if every point from 576 MHz to 1.5 GHz was measured on an instrument whose TV record or contingency entry covers that frequency, the isolation floor lies at least 10 dB below -40 dB across the sweep and S21 from the filter test point to the antenna port, normalized to the through calibration and increased by the NanoVNA S21 uncertainty of its TV record, is at most -40.0 dB at every point from 576 MHz to 1.5 GHz; otherwise Fail. | Test | Bench | TC-TX-011 (Draft; Bench; tools/filter_s21_check.py) | - | owner bench | TRR | No | No | owner | - | Draft (TBR) |
| REQ-TX-012 | `docs/requirements/tx/requirements.json`; parent REQ-SYS-151; 47CFR97.307(e), CON-002 | The transmitter shall keep every antenna-port spurious emission at most 25 uW at the 5 W step into any load up to SWR 2:1 (TBR). | Pass if each fixture presents an SWR between 1.9:1 and 2.1:1 at 144, 146 and 148 MHz and every spurious emission at the antenna port, corrected for the fixture and attenuator S21 and increased by the tinySA level accuracy of its TV record, is at most -16.02 dBm (25 uW) at every phase and carrier frequency; otherwise Fail. A fixture outside 1.9:1 to 2.1:1 is a Procedure-correction NCR; straight-key and paddle readings within 1 dB of the fixture readings confirm the keying source does not change the result. | Test | Bench | TC-TX-012 (Draft; Bench; tools/tinysa_scan_check.py) | - | owner bench | TRR | No | No | owner | - | Draft (TBR) |
| REQ-TX-013 | `docs/requirements/tx/requirements.json`; parent REQ-SYS-182; 47CFR97.307(b), ADR-023 | The transmitter shall output a 3.3 V sample below 20 MHz whose frequency times a fixed ratio is within 1 kHz (TBR) of the carrier. | Pass if at 144.0012, 146.000 and 147.9988 MHz the telemetry count multiplied by R agrees with the tinySA carrier marker within 1 kHz, and the carrier divided by R is below 20 MHz at 147.9988 MHz; otherwise Fail. | Test | Bench | TC-TX-013 (Draft; Bench) | - | owner bench | TRR | No | No | owner | - | Draft (TBR) |
| REQ-TX-014 | `docs/requirements/tx/requirements.json`; parent REQ-SYS-007; 47CFR97.109(d), 47CFR97.203, CON-006 | The transmitter shall hold antenna-port carrier power at most 1 uW (TBR) while TX_KEY is deasserted with PA_EN asserted and the exciter driven. | Pass if, at 144.0012, 146.000 and 147.9988 MHz and at 7.4 and 8.4 V supply, with PA_EN high and TX_KEY low throughout each activation on the capture, the carrier power at the antenna port, corrected for the attenuator S21 and increased by the tinySA level accuracy of its TV record, is at most -30.0 dBm (1 uW); otherwise Fail. An activation in which TX_KEY rises or PA_EN falls is a Procedure-correction NCR against the fault-injection build, not a requirement result. | Test | Bench | TC-TX-014 (Draft; Bench; tools/tinysa_scan_check.py) | - | owner bench | TRR | No | No | owner | - | Draft (TBR) |
| REQ-TX-015 | `docs/requirements/tx/requirements.json`; parent REQ-SYS-121; 47CFR97.13(c), 47CFR1.1307(b), 47CFR1.1310, 47CFR2.1091, 47CFR2.1093, CON-004 | The transmitter shall deliver at most 6.3 W (TBR) into 50 ohm at any power step, carrier frequency and 6.4 to 8.4 V supply. | Pass if at every step, carrier frequency and supply voltage the upper end of the probe power's characterized uncertainty band is at most 6.3 W; otherwise Fail. A probe and tinySA disagreement beyond their combined uncertainty is a Procedure-correction NCR (docs/process/04-verification-and-validation.md section 6.2), not a requirement result. | Test | Bench | TC-TX-015 (Draft; Bench; tools/rf_probe_power.py) | - | owner bench | TRR | No | No | owner | - | Draft (TBR) |
| REQ-TX-016 | `docs/requirements/tx/requirements.json`; parent REQ-SYS-176; 47CFR15.23(b), CON-008 | The transmitter shall keep antenna-port power at the set carrier frequency at most -57 dBm (TBR) in Receive mode. | Pass if at 144.05, 146.00 and 147.95 MHz, at the default and at the maximum volume, the level at the set frequency, corrected for the attenuator S21 and increased by the tinySA level accuracy of its TV record, is at most -57.0 dBm; otherwise Fail. The highest level within +/-10 kHz is recorded as data. | Test | Bench | TC-TX-016 (Draft; Bench; tools/tinysa_scan_check.py) | - | owner bench | TRR | No | No | owner | - | Draft (TBR) |

## 4. Validation matrix (SE HB Appendix E)

One row per `OPS-NNN` heading and per `MOE-NNN`; activities are the `TC-VAL` cases whose setup names the target after `Validates:`; the phase is the token after `Phase:` in the case setup (04 section 7.2). Row status is Validated when every case is Passed.

| Validation product | Activity | Objective | Method | Facility | Phase | Performer | Requirements exercised | Results | Row status |
|---|---|---|---|---|---|---|---|---|---|
| OPS-001 | - | - | - | - | - | - | - | - | No case |
| OPS-002 | - | - | - | - | - | - | - | - | No case |
| OPS-003 | - | - | - | - | - | - | - | - | No case |
| OPS-004 | - | - | - | - | - | - | - | - | No case |
| OPS-005 | - | - | - | - | - | - | - | - | No case |
| OPS-006 | - | - | - | - | - | - | - | - | No case |
| OPS-007 | - | - | - | - | - | - | - | - | No case |
| OPS-008 | - | - | - | - | - | - | - | - | No case |
| OPS-009 | - | - | - | - | - | - | - | - | No case |
| OPS-010 | - | - | - | - | - | - | - | - | No case |
| OPS-011 | - | - | - | - | - | - | - | - | No case |
| OPS-012 | - | - | - | - | - | - | - | - | No case |
| OPS-013 | - | - | - | - | - | - | - | - | No case |
| OPS-014 | - | - | - | - | - | - | - | - | No case |
| OPS-015 | - | - | - | - | - | - | - | - | No case |
| OPS-016 | - | - | - | - | - | - | - | - | No case |
| OPS-017 | - | - | - | - | - | - | - | - | No case |
| OPS-018 | - | - | - | - | - | - | - | - | No case |
| OPS-019 | - | - | - | - | - | - | - | - | No case |
| OPS-020 | - | - | - | - | - | - | - | - | No case |
| OPS-021 | - | - | - | - | - | - | - | - | No case |
| OPS-022 | - | - | - | - | - | - | - | - | No case |
| MOE-001 | - | - | - | - | - | - | - | - | No case |
| MOE-002 | - | - | - | - | - | - | - | - | No case |
| MOE-003 | - | - | - | - | - | - | - | - | No case |
| MOE-004 | - | - | - | - | - | - | - | - | No case |
| MOE-005 | - | - | - | - | - | - | - | - | No case |
| MOE-006 | - | - | - | - | - | - | - | - | No case |
| MOE-007 | - | - | - | - | - | - | - | - | No case |
| MOE-008 | - | - | - | - | - | - | - | - | No case |
| MOE-009 | - | - | - | - | - | - | - | - | No case |
| MOE-010 | - | - | - | - | - | - | - | - | No case |
| MOE-011 | - | - | - | - | - | - | - | - | No case |
| MOE-012 | - | - | - | - | - | - | - | - | No case |
| MOE-013 | - | - | - | - | - | - | - | - | No case |

## 5. Orphan requirements

Draft or Active requirements with no verification case citing them.

| ID | Status | Method | File |
|---|---|---|---|
| (none) |  |  |  |

## 6. Orphan test cases

Test cases citing at least one requirement id that does not exist.

| ID | Unresolved requirement ids | File |
|---|---|---|
| (none) |  |  |

## 7. Parent coverage

### 7.1 Requirements without a parent

| ID | Module | Justification |
|---|---|---|
| REQ-SYS-001 | SYS | traces to CON-003, NGO-018, SI-004, 47CFR97.305(a), 47CFR97.305(c), ADR-003, OPS-004 |
| REQ-SYS-002 | SYS | traces to NGO-003, NGO-021, NGO-001, OPS-001, OPS-002, OPS-011, OPS-021, OPS-022 |
| REQ-SYS-003 | SYS | traces to MOE-003, NGO-005, OPS-001 |
| REQ-SYS-004 | SYS | traces to MOE-012, NGO-021, OPS-013, OPS-014, OPS-016, OPS-020 |
| REQ-SYS-005 | SYS | traces to MOE-012, OPS-013, OPS-016, OPS-021 |
| REQ-SYS-006 | SYS | traces to NGO-020, CON-006, OPS-006, ADR-015, SI-019 |
| REQ-SYS-007 | SYS | traces to CON-006, CON-005, NGO-020, 47CFR97.109(d), 47CFR97.203, 47CFR97.119(b), OPS-004 |
| REQ-SYS-008 | SYS | traces to NGO-011, SI-024, CON-001, CON-003, ADR-016, ADR-023, OPS-020, 47CFR97.301(a) |
| REQ-SYS-009 | SYS | traces to CON-003, NGO-011, OPS-020, ADR-023, 47CFR97.307(b), ADR-016 |
| REQ-SYS-010 | SYS | traces to NGO-018, MOE-010, ADR-023, OPS-020, CON-016, ADR-013 |
| REQ-SYS-011 | SYS | traces to NGO-019, CON-007, SI-003, OPS-007, 47CFR97.313(a), ADR-003, ADR-014 |
| REQ-SYS-012 | SYS | traces to NGO-009, SI-003, NGO-010, NGO-002, MOE-001, MOE-002, ADR-003, ADR-012, OPS-004, ADR-005, ADR-022 |
| REQ-SYS-013 | SYS | traces to OPS-015, NGO-005, MOE-003 |
| REQ-SYS-014 | SYS | traces to NGO-018, CON-003, OPS-004, 47CFR97.307(a), ADR-023, ADR-003 |
| REQ-SYS-015 | SYS | traces to CON-003, NGO-018, ADR-024, 47CFR97.307(a), OPS-004, ADR-003, ADR-023 |
| REQ-SYS-017 | SYS | traces to CON-002, NGO-017, MOE-006, 47CFR97.307(e), ADR-021, OPS-008, ADR-003 |
| REQ-SYS-018 | SYS | traces to NGO-017, MOE-006, CON-002, ADR-022, 47CFR97.307(e), OPS-008, ADR-003 |
| REQ-SYS-019 | SYS | traces to NGO-019, OPS-008, CON-004 |
| REQ-SYS-020 | SYS | traces to NGO-019, OPS-008 |
| REQ-SYS-021 | SYS | traces to NGO-011, SI-024, CON-001, ADR-016, OPS-003 |
| REQ-SYS-022 | SYS | traces to NGO-012, MOE-010, NGO-009, NGO-010, NGO-002, OPS-003 |
| REQ-SYS-023 | SYS | traces to NGO-012, MOE-010, OPS-003 |
| REQ-SYS-024 | SYS | traces to NGO-012, MOE-010, OPS-003, ADR-013 |
| REQ-SYS-025 | SYS | traces to NGO-012, MOE-010, OPS-003 |
| REQ-SYS-026 | SYS | traces to NGO-012, MOE-010, OPS-003 |
| REQ-SYS-027 | SYS | traces to NGO-012, MOE-010, OPS-003 |
| REQ-SYS-028 | SYS | traces to NGO-012, MOE-010, OPS-003 |
| REQ-SYS-029 | SYS | traces to MOE-010, NGO-012, OPS-003 |
| REQ-SYS-030 | SYS | traces to MOE-010, NGO-012, OPS-003 |
| REQ-SYS-031 | SYS | traces to MOE-010, SI-029, ADR-013, OPS-003 |
| REQ-SYS-032 | SYS | traces to MOE-011, MOE-002, NGO-012, OPS-003 |
| REQ-SYS-033 | SYS | traces to MOE-010, OPS-003, OPS-017 |
| REQ-SYS-034 | SYS | traces to MOE-010, OPS-003, OPS-020, ADR-023 |
| REQ-SYS-035 | SYS | traces to NGO-012, OPS-003, OPS-012 |
| REQ-SYS-036 | SYS | traces to NGO-014, CON-021, MOE-005, OPS-004 |
| REQ-SYS-037 | SYS | traces to NGO-005, OPS-017, OPS-018, MOE-010, SI-019 |
| REQ-SYS-038 | SYS | traces to NGO-003, SI-018, CON-012, ADR-009, OPS-005, MOE-005 |
| REQ-SYS-039 | SYS | traces to NGO-003, SI-018, CON-012, ADR-009, OPS-004, MOE-005 |
| REQ-SYS-040 | SYS | traces to NGO-013, MOE-005, SI-018, OPS-004, ADR-009 |
| REQ-SYS-041 | SYS | traces to NGO-013, SI-033, ADR-024, SI-019, OPS-004 |
| REQ-SYS-042 | SYS | traces to NGO-013, MOE-005, CON-025, OPS-004, ADR-024 |
| REQ-SYS-043 | SYS | traces to NGO-013, MOE-005, OPS-004, ADR-024 |
| REQ-SYS-044 | SYS | traces to CON-021, SI-036, NGO-014, ADR-010, ADR-026, OPS-004 |
| REQ-SYS-045 | SYS | traces to NGO-014, SI-036, OPS-004 |
| REQ-SYS-046 | SYS | traces to NGO-014, MOE-010, OPS-004, OPS-003 |
| REQ-SYS-047 | SYS | traces to CON-012, SI-034, OPS-005, ADR-009 |
| REQ-SYS-048 | SYS | traces to MOE-005, CON-012, OPS-005, ADR-009 |
| REQ-SYS-049 | SYS | traces to CON-012, OPS-013, OPS-017, ADR-009 |
| REQ-SYS-050 | SYS | traces to CON-016, CON-012, OPS-017, ADR-009 |
| REQ-SYS-051 | SYS | traces to OPS-017, CON-012, MOE-012, ADR-009 |
| REQ-SYS-052 | SYS | traces to NGO-021, MOE-012, OPS-013, OPS-005, OPS-021, ADR-009 |
| REQ-SYS-053 | SYS | traces to NGO-021, MOE-012, OPS-013, ADR-009 |
| REQ-SYS-054 | SYS | traces to NGO-021, MOE-012, OPS-013, ADR-009 |
| REQ-SYS-055 | SYS | traces to NGO-021, MOE-012, OPS-013, OPS-021, ADR-009 |
| REQ-SYS-056 | SYS | traces to NGO-021, OPS-013, CON-012, ADR-009 |
| REQ-SYS-057 | SYS | traces to CON-023, SI-006, NGO-015, ADR-006, OPS-003 |
| REQ-SYS-058 | SYS | traces to NGO-015, CON-023, OPS-003, ADR-006 |
| REQ-SYS-059 | SYS | traces to CON-023, SI-006, MOE-011, OPS-003 |
| REQ-SYS-060 | SYS | traces to NGO-015, MOE-008, OPS-003, OPS-007 |
| REQ-SYS-061 | SYS | traces to NGO-015, CON-023, OPS-003 |
| REQ-SYS-062 | SYS | traces to MOE-008, NGO-015, OPS-006 |
| REQ-SYS-063 | SYS | traces to NGO-019, OPS-007, ADR-003, ADR-014 |
| REQ-SYS-064 | SYS | traces to NGO-019, OPS-001, OPS-007, ADR-003, ADR-014 |
| REQ-SYS-065 | SYS | traces to NGO-020, MOE-009, CON-006, ADR-015, OPS-019, 47CFR97.7 |
| REQ-SYS-066 | SYS | traces to NGO-020, ADR-015, OPS-019 |
| REQ-SYS-067 | SYS | traces to MOE-012, OPS-013, OPS-014, OPS-016 |
| REQ-SYS-068 | SYS | traces to CON-005, NGO-020, OPS-004, 47CFR97.119(a) |
| REQ-SYS-069 | SYS | traces to NGO-019, OPS-018, CON-004 |
| REQ-SYS-070 | SYS | traces to MOE-004, OPS-002, NGO-022 |
| REQ-SYS-071 | SYS | traces to NGO-016, MOE-011, CON-013, OPS-003 |
| REQ-SYS-072 | SYS | traces to NGO-016, MOE-011, OPS-003 |
| REQ-SYS-073 | SYS | traces to NGO-016, MOE-011 |
| REQ-SYS-074 | SYS | traces to NGO-016, MOE-011, OPS-003 |
| REQ-SYS-075 | SYS | traces to NGO-016, MOE-011, SI-036, OPS-004 |
| REQ-SYS-076 | SYS | traces to MOE-011, NGO-016, CON-016 |
| REQ-SYS-077 | SYS | traces to NGO-016, CON-013, OPS-003 |
| REQ-SYS-078 | SYS | traces to CON-013, SI-005, OPS-003 |
| REQ-SYS-079 | SYS | traces to CON-013, OPS-013 |
| REQ-SYS-080 | SYS | traces to CON-011, SI-023, ADR-005, OPS-012 |
| REQ-SYS-081 | SYS | traces to NGO-022, OPS-002, CON-011 |
| REQ-SYS-082 | SYS | traces to NGO-022, NGO-026, OPS-002, OPS-016 |
| REQ-SYS-083 | SYS | traces to NGO-022, OPS-016, CON-011 |
| REQ-SYS-084 | SYS | traces to NGO-022, OPS-009 |
| REQ-SYS-085 | SYS | traces to NGO-022, CON-016, OPS-016 |
| REQ-SYS-086 | SYS | traces to CON-011, NGO-022, OPS-012 |
| REQ-SYS-087 | SYS | traces to NGO-022, OPS-012, OPS-016 |
| REQ-SYS-088 | SYS | traces to NGO-022, OPS-016 |
| REQ-SYS-089 | SYS | traces to NGO-022, OPS-016 |
| REQ-SYS-090 | SYS | traces to CON-010, NGO-022, OPS-002, ADR-004 |
| REQ-SYS-091 | SYS | traces to MOE-004, NGO-025, OPS-002 |
| REQ-SYS-092 | SYS | traces to NGO-022, MOE-004, OPS-002, OPS-011, ADR-004 |
| REQ-SYS-093 | SYS | traces to NGO-022, OPS-002 |
| REQ-SYS-094 | SYS | traces to NGO-025, SI-034, MOE-004, ADR-020, OPS-009 |
| REQ-SYS-095 | SYS | traces to NGO-025, MOE-004, OPS-009, ADR-020 |
| REQ-SYS-096 | SYS | traces to MOE-004, OPS-009 |
| REQ-SYS-097 | SYS | traces to NGO-022, MOE-004, OPS-009, ADR-005 |
| REQ-SYS-098 | SYS | traces to NGO-022, OPS-009, ADR-005 |
| REQ-SYS-099 | SYS | traces to NGO-022, OPS-014 |
| REQ-SYS-100 | SYS | traces to NGO-006, OPS-010 |
| REQ-SYS-101 | SYS | traces to NGO-022, OPS-010, OPS-013 |
| REQ-SYS-102 | SYS | traces to NGO-006, SI-001, OPS-010, MOE-013 |
| REQ-SYS-103 | SYS | traces to NGO-026, SI-001, CON-015, OPS-010, MOE-013 |
| REQ-SYS-104 | SYS | traces to NGO-026, SI-008, OPS-015 |
| REQ-SYS-105 | SYS | traces to NGO-026, OPS-015, OPS-010 |
| REQ-SYS-106 | SYS | traces to NGO-026, OPS-015 |
| REQ-SYS-107 | SYS | traces to NGO-009, MOE-001, OPS-004 |
| REQ-SYS-108 | SYS | traces to CON-010, CON-012, CON-013, SI-005, OPS-002 |
| REQ-SYS-109 | SYS | traces to CON-015, SI-008, ADR-008, OPS-012 |
| REQ-SYS-110 | SYS | traces to NGO-026, OPS-012 |
| REQ-SYS-111 | SYS | traces to NGO-026, OPS-012 |
| REQ-SYS-112 | SYS | traces to NGO-005, SI-003, NGO-026, OPS-014 |
| REQ-SYS-113 | SYS | traces to NGO-005, OPS-014 |
| REQ-SYS-114 | SYS | traces to NGO-026, OPS-004, OPS-010, MOE-013 |
| REQ-SYS-115 | SYS | traces to NGO-026, OPS-010, MOE-013 |
| REQ-SYS-116 | SYS | traces to NGO-026, OPS-010, MOE-013 |
| REQ-SYS-117 | SYS | traces to NGO-026, OPS-004, MOE-013 |
| REQ-SYS-118 | SYS | traces to NGO-004, OPS-014 |
| REQ-SYS-119 | SYS | traces to NGO-021, MOE-012, OPS-011, OPS-021 |
| REQ-SYS-120 | SYS | traces to NGO-021, MOE-012, OPS-021 |
| REQ-SYS-121 | SYS | traces to CON-004, MOE-009, SI-030, ADR-014, OPS-018, OPS-022, 47CFR97.13(c), 47CFR1.1307, 47CFR1.1310, 47CFR2.1091, 47CFR2.1093 |
| REQ-SYS-122 | SYS | traces to CON-004, MOE-009, MOE-008, OPS-006, OPS-018, 47CFR97.13(c), ADR-014 |
| REQ-SYS-124 | SYS | traces to CON-004, CON-006, MOE-009, OPS-019 |
| REQ-SYS-125 | SYS | traces to CON-008, CON-024, SI-035, ADR-025, OPS-012, 47CFR15.23 |
| REQ-SYS-126 | SYS | traces to CON-009, SI-007, ADR-004, OPS-011 |
| REQ-SYS-127 | SYS | traces to CON-009, SI-007, SI-033, ADR-019, OPS-011, ADR-027 |
| REQ-SYS-128 | SYS | traces to CON-025, SI-026, NGO-024, ADR-011, OPS-011 |
| REQ-SYS-129 | SYS | traces to CON-025, NGO-024, ADR-011, OPS-011 |
| REQ-SYS-130 | SYS | traces to NGO-021, MOE-012, OPS-013, OPS-016, OPS-021 |
| REQ-SYS-131 | SYS | traces to NGO-021, MOE-012, OPS-021 |
| REQ-SYS-132 | SYS | traces to NGO-005, OPS-011, CON-010, ADR-004 |
| REQ-SYS-133 | SYS | traces to CON-010, SI-022, OPS-011, MOE-008, ADR-004 |
| REQ-SYS-134 | SYS | traces to NGO-005, OPS-001, OPS-021, CON-010 |
| REQ-SYS-135 | SYS | traces to NGO-015, OPS-006, OPS-012, ADR-024 |
| REQ-SYS-136 | SYS | traces to NGO-013, NGO-014, NGO-018, OPS-001, ADR-024, ADR-026 |
| REQ-SYS-137 | SYS | traces to CON-014, NGO-007, SI-009, SI-031, ADR-007, OPS-012 |
| REQ-SYS-138 | SYS | traces to CON-014, SI-031, ADR-007, OPS-012 |
| REQ-SYS-139 | SYS | traces to NGO-027, CON-014, OPS-012, ADR-007 |
| REQ-SYS-140 | SYS | traces to CON-014, SI-028, SI-009, ADR-012, NGO-027, NGO-007, OPS-012 |
| REQ-SYS-141 | SYS | traces to MOE-006, CON-016, OPS-012 |
| REQ-SYS-142 | SYS | traces to CON-025, MOE-003, OPS-012 |
| REQ-SYS-143 | SYS | traces to MOE-003, OPS-001, OPS-011 |
| REQ-SYS-144 | SYS | traces to NGO-023, MOE-003, CON-016, OPS-012 |
| REQ-SYS-145 | SYS | traces to NGO-030, NGO-008, CON-022, SI-002, ADR-002, OPS-012 |
| REQ-SYS-146 | SYS | traces to NGO-030, SI-006, CON-023, OPS-003, ADR-002 |
| REQ-SYS-147 | SYS | traces to NGO-028, MOE-007, OPS-012 |
| REQ-SYS-148 | SYS | traces to CON-019, SI-025, NGO-029, ADR-017, OPS-012 |
| REQ-SYS-149 | SYS | traces to NGO-022, OPS-011, OPS-002 |
| REQ-SYS-150 | SYS | traces to MOE-003, CON-016, OPS-009, OPS-012 |
| REQ-SYS-151 | SYS | traces to NGO-017, MOE-006, CON-002, OPS-015, 47CFR97.307(e) |
| REQ-SYS-152 | SYS | traces to NGO-009, MOE-001, OPS-015, OPS-004 |
| REQ-SYS-153 | SYS | traces to NGO-017, NGO-004, OPS-008 |
| REQ-SYS-154 | SYS | traces to NGO-011, CON-003, OPS-020, ADR-023, 47CFR97.307(b) |
| REQ-SYS-155 | SYS | traces to NGO-004, OPS-014 |
| REQ-SYS-156 | SYS | traces to NGO-017, NGO-004, OPS-008 |
| REQ-SYS-157 | SYS | traces to NGO-016, MOE-011, SI-036, CON-021, OPS-004 |
| REQ-SYS-158 | SYS | traces to NGO-016, MOE-011, OPS-004 |
| REQ-SYS-159 | SYS | traces to MOE-005, NGO-014, OPS-004, OPS-005 |
| REQ-SYS-160 | SYS | traces to MOE-005, NGO-003, OPS-005, ADR-010, ADR-026 |
| REQ-SYS-161 | SYS | traces to NGO-014, MOE-005, CON-021, ADR-010, ADR-026, OPS-004 |
| REQ-SYS-162 | SYS | traces to MOE-005, CON-012, OPS-005 |
| REQ-SYS-163 | SYS | traces to NGO-021, OPS-013, OPS-005, SI-018, CON-012 |
| REQ-SYS-164 | SYS | traces to NGO-015, SI-024, OPS-003 |
| REQ-SYS-165 | SYS | traces to NGO-015, CON-023, OPS-003 |
| REQ-SYS-166 | SYS | traces to NGO-022, OPS-012 |
| REQ-SYS-167 | SYS | traces to NGO-022, OPS-016 |
| REQ-SYS-168 | SYS | traces to NGO-026, OPS-012 |
| REQ-SYS-169 | SYS | traces to NGO-016, MOE-011, OPS-003 |
| REQ-SYS-170 | SYS | traces to NGO-016, MOE-011, OPS-001 |
| REQ-SYS-171 | SYS | traces to NGO-019, MOE-009, OPS-004, OPS-018, ADR-014 |
| REQ-SYS-172 | SYS | traces to CON-004, MOE-009, OPS-018, ADR-014 |
| REQ-SYS-173 | SYS | traces to MOE-011, OPS-017, CON-013 |
| REQ-SYS-174 | SYS | traces to CON-012, SI-034, SI-018, ADR-009, OPS-005 |
| REQ-SYS-175 | SYS | traces to NGO-006, SI-008, CON-015, OPS-015, ADR-008 |
| REQ-SYS-176 | SYS | traces to CON-008, MOE-006, OPS-003, 47CFR15.23(b) |
| REQ-SYS-177 | SYS | traces to CON-008, MOE-006, OPS-017, 47CFR15.23(b) |
| REQ-SYS-178 | SYS | traces to NGO-007, SI-009, SI-028, SI-031, OPS-012, ADR-012 |
| REQ-SYS-179 | SYS | traces to MOE-003, CON-016, OPS-012 |
| REQ-SYS-180 | SYS | traces to NGO-021, MOE-012, OPS-013, OPS-021 |
| REQ-SYS-181 | SYS | traces to NGO-004, OPS-014 |
| REQ-SYS-182 | SYS | traces to NGO-011, CON-003, OPS-020, ADR-023, 47CFR97.307(b), ADR-016 |
| REQ-SYS-183 | SYS | traces to MOE-012, NGO-021, OPS-013, OPS-019, OPS-021 |
| REQ-SYS-184 | SYS | traces to NGO-021, MOE-012, OPS-013 |
| REQ-SYS-185 | SYS | traces to NGO-022, OPS-016, CON-011 |
| REQ-SYS-186 | SYS | traces to NGO-022, OPS-016, CON-011 |
| REQ-SYS-187 | SYS | traces to MOE-003, NGO-019, CON-016, OPS-012 |
| REQ-SYS-188 | SYS | traces to MOE-003, CON-016, OPS-012 |
| REQ-SYS-189 | SYS | traces to NGO-016, MOE-011, OPS-012 |
| REQ-SYS-190 | SYS | traces to MOE-003, CON-016, OPS-012, OPS-021 |
| REQ-SYS-194 | SYS | traces to NGO-022, OPS-016, CON-011 |
| REQ-SW-KEYER-034 | SW-KEYER | traces to NGO-021 |
| REQ-SW-KEYER-035 | SW-KEYER | traces to NGO-021, OPS-013 |
| REQ-SW-KEYER-036 | SW-KEYER | traces to NGO-021, CON-012 |
| REQ-SW-KEYER-038 | SW-KEYER | traces to ADR-009, CON-012 |
| REQ-SW-KEYER-039 | SW-KEYER | traces to NGO-021, OPS-012, OPS-013 |

### 7.2 Allocation to children

Rule T-18 (02 section 8.2) applies from SRR: every Draft or Active SYS requirement names at least one receiving L2 module, through `child_ids` naming a live L2 requirement or through a preliminary `docs/design/allocation.json` record that lists it under an L2 module (02 section 2.3). At SRR each gap is a `SYS_UNALLOCATED` warning in section 2.2, which the reviewer confirms or corrects in V6; from PDR it is an Error under `--gate`, and every Active SYS requirement then needs a child or the tag `leaf`. Receiving L2 modules are the modules of the live L2 children and of the allocation records.

| ID | Module | Children | Child ids | Receiving L2 modules |
|---|---|---|---|---|
| REQ-SYS-001 | SYS | 1 | REQ-TX-001 | SW, SW-TXSEQ, TX |
| REQ-SYS-002 | SYS | 0 | - | CTL, SW, SW-DISPLAY, SW-SAFE |
| REQ-SYS-003 | SYS | 0 | - | CTL, PWR, SW, SW-BOOT, SW-SAFE |
| REQ-SYS-004 | SYS | 0 | - | SW, SW-SAFE, SW-TXSEQ, TX |
| REQ-SYS-005 | SYS | 0 | - | CTL, SW, SW-DISPLAY, SW-SAFE |
| REQ-SYS-006 | SYS | 0 | - | CTL, SW, SW-CFG, SW-DISPLAY |
| REQ-SYS-007 | SYS | 2 | REQ-SW-KEYER-028, REQ-TX-014 | CTL, SW, SW-KEYER, SW-TXSEQ, TX |
| REQ-SYS-008 | SYS | 1 | REQ-TX-002 | SW, SW-SYNTH, TX |
| REQ-SYS-009 | SYS | 1 | REQ-TX-003 | SW, SW-SAFE, SW-SYNTH, TX |
| REQ-SYS-010 | SYS | 0 | - | SW, SW-SYNTH, TX |
| REQ-SYS-011 | SYS | 1 | REQ-TX-004 | PWR, SW, SW-TXSEQ, TX |
| REQ-SYS-012 | SYS | 0 | - | PWR, SW, SW-TXSEQ, TX |
| REQ-SYS-013 | SYS | 0 | - | ME, TX |
| REQ-SYS-014 | SYS | 1 | REQ-TX-005 | SW, SW-TXSEQ, TX |
| REQ-SYS-015 | SYS | 1 | REQ-TX-006 | SW, SW-TXSEQ, TX |
| REQ-SYS-016 | SYS | 0 | - | - |
| REQ-SYS-017 | SYS | 1 | REQ-TX-007 | CTL, PWR, SW, SW-SYNTH, TX |
| REQ-SYS-018 | SYS | 4 | REQ-TX-008, REQ-TX-009, REQ-TX-010, REQ-TX-011 | TX |
| REQ-SYS-019 | SYS | 0 | - | SW, SW-DISPLAY, SW-TXSEQ, TX |
| REQ-SYS-020 | SYS | 0 | - | SW, SW-SAFE |
| REQ-SYS-021 | SYS | 0 | - | RX, SW, SW-SYNTH, TX |
| REQ-SYS-022 | SYS | 0 | - | RX |
| REQ-SYS-023 | SYS | 0 | - | RX |
| REQ-SYS-024 | SYS | 0 | - | RX, SW |
| REQ-SYS-025 | SYS | 0 | - | RX, SW |
| REQ-SYS-026 | SYS | 0 | - | RX, SW |
| REQ-SYS-027 | SYS | 0 | - | RX, SW |
| REQ-SYS-028 | SYS | 0 | - | RX, SW |
| REQ-SYS-029 | SYS | 0 | - | RX |
| REQ-SYS-030 | SYS | 0 | - | RX, SW |
| REQ-SYS-031 | SYS | 0 | - | RX, TX |
| REQ-SYS-032 | SYS | 0 | - | RX, SW |
| REQ-SYS-033 | SYS | 0 | - | RX |
| REQ-SYS-034 | SYS | 0 | - | CTL, PWR, RX, SW, SW-SYNTH |
| REQ-SYS-035 | SYS | 0 | - | RX, SW, SW-CFG, SW-SYNTH |
| REQ-SYS-036 | SYS | 0 | - | RX, SW, SW-TXSEQ, TX |
| REQ-SYS-037 | SYS | 0 | - | RX, TX |
| REQ-SYS-038 | SYS | 2 | REQ-SW-KEYER-001, REQ-SW-KEYER-002 | CTL, SW, SW-KEYER |
| REQ-SYS-039 | SYS | 3 | REQ-SW-KEYER-003, REQ-SW-KEYER-004, REQ-SW-KEYER-005 | CTL, SW, SW-KEYER |
| REQ-SYS-040 | SYS | 7 | REQ-SW-KEYER-006, REQ-SW-KEYER-007, REQ-SW-KEYER-008, REQ-SW-KEYER-009, REQ-SW-KEYER-010, REQ-SW-KEYER-011, REQ-SW-KEYER-012 | SW, SW-KEYER |
| REQ-SYS-041 | SYS | 3 | REQ-SW-KEYER-015, REQ-SW-KEYER-016, REQ-SW-KEYER-037 | SW, SW-KEYER |
| REQ-SYS-042 | SYS | 2 | REQ-SW-KEYER-013, REQ-SW-KEYER-014 | CTL, SW, SW-KEYER, SW-SCHED |
| REQ-SYS-043 | SYS | 2 | REQ-SW-KEYER-017, REQ-SW-KEYER-019 | CTL, SW, SW-KEYER, SW-SCHED |
| REQ-SYS-044 | SYS | 1 | REQ-SW-KEYER-032 | SW, SW-KEYER, SW-TXSEQ |
| REQ-SYS-045 | SYS | 0 | - | CTL, SW, SW-AUDIO |
| REQ-SYS-046 | SYS | 0 | - | RX, SW, SW-AUDIO, SW-SYNTH |
| REQ-SYS-047 | SYS | 0 | - | CTL |
| REQ-SYS-048 | SYS | 1 | REQ-SW-KEYER-020 | CTL, SW, SW-KEYER |
| REQ-SYS-049 | SYS | 0 | - | CTL |
| REQ-SYS-050 | SYS | 0 | - | CTL, ME, TX |
| REQ-SYS-051 | SYS | 0 | - | CTL, ME, SW |
| REQ-SYS-052 | SYS | 1 | REQ-SW-KEYER-022 | SW, SW-KEYER, SW-SAFE |
| REQ-SYS-053 | SYS | 2 | REQ-SW-KEYER-026, REQ-SW-KEYER-027 | SW, SW-KEYER, SW-SAFE |
| REQ-SYS-054 | SYS | 0 | - | SW, SW-SAFE |
| REQ-SYS-055 | SYS | 0 | - | CTL, TX |
| REQ-SYS-056 | SYS | 1 | REQ-SW-KEYER-024 | SW, SW-DISPLAY, SW-KEYER |
| REQ-SYS-057 | SYS | 0 | - | CTL, ME |
| REQ-SYS-058 | SYS | 0 | - | CTL, SW, SW-DISPLAY |
| REQ-SYS-059 | SYS | 0 | - | CTL, SW, SW-AUDIO, SW-DISPLAY |
| REQ-SYS-060 | SYS | 0 | - | CTL, SW, SW-DISPLAY |
| REQ-SYS-061 | SYS | 0 | - | CTL, SW, SW-DISPLAY |
| REQ-SYS-062 | SYS | 0 | - | SW, SW-DISPLAY |
| REQ-SYS-063 | SYS | 0 | - | SW, SW-DISPLAY, SW-TXSEQ |
| REQ-SYS-064 | SYS | 0 | - | SW, SW-CFG |
| REQ-SYS-065 | SYS | 0 | - | SW, SW-SAFE |
| REQ-SYS-066 | SYS | 0 | - | SW, SW-DISPLAY, SW-SAFE |
| REQ-SYS-067 | SYS | 1 | REQ-SW-KEYER-023 | CTL, SW, SW-DISPLAY, SW-KEYER, SW-SAFE |
| REQ-SYS-068 | SYS | 0 | - | SW, SW-DISPLAY |
| REQ-SYS-069 | SYS | 0 | - | SW, SW-DISPLAY |
| REQ-SYS-070 | SYS | 0 | - | CTL, PWR, SW, SW-DISPLAY, SW-PWR |
| REQ-SYS-071 | SYS | 0 | - | CTL |
| REQ-SYS-072 | SYS | 0 | - | CTL |
| REQ-SYS-073 | SYS | 0 | - | CTL |
| REQ-SYS-074 | SYS | 0 | - | SW, SW-AUDIO |
| REQ-SYS-075 | SYS | 0 | - | SW, SW-AUDIO, SW-TXSEQ |
| REQ-SYS-076 | SYS | 0 | - | CTL, SW, SW-AUDIO |
| REQ-SYS-077 | SYS | 0 | - | CTL, SW, SW-AUDIO |
| REQ-SYS-078 | SYS | 0 | - | CTL |
| REQ-SYS-079 | SYS | 0 | - | CTL |
| REQ-SYS-080 | SYS | 0 | - | ME, PWR |
| REQ-SYS-081 | SYS | 0 | - | PWR |
| REQ-SYS-082 | SYS | 0 | - | PWR, SW, SW-PWR |
| REQ-SYS-083 | SYS | 0 | - | PWR |
| REQ-SYS-084 | SYS | 0 | - | PWR |
| REQ-SYS-085 | SYS | 0 | - | PWR |
| REQ-SYS-086 | SYS | 0 | - | PWR |
| REQ-SYS-087 | SYS | 0 | - | PWR, SW, SW-PWR |
| REQ-SYS-088 | SYS | 0 | - | CTL, PWR, SW, SW-PWR |
| REQ-SYS-089 | SYS | 0 | - | PWR, SW, SW-PWR |
| REQ-SYS-090 | SYS | 0 | - | PWR |
| REQ-SYS-091 | SYS | 0 | - | PWR |
| REQ-SYS-092 | SYS | 0 | - | PWR, TX |
| REQ-SYS-093 | SYS | 0 | - | PWR, SW, SW-PWR |
| REQ-SYS-094 | SYS | 0 | - | CTL, PWR, RX, SW, SW-PWR, TX |
| REQ-SYS-095 | SYS | 0 | - | CTL, PWR, RX, SW, SW-PWR, TX |
| REQ-SYS-096 | SYS | 0 | - | SW, SW-DISPLAY, SW-PWR |
| REQ-SYS-097 | SYS | 0 | - | SW, SW-PWR, SW-SAFE |
| REQ-SYS-098 | SYS | 0 | - | PWR, SW, SW-PWR |
| REQ-SYS-099 | SYS | 0 | - | PWR, SW, SW-PWR |
| REQ-SYS-100 | SYS | 0 | - | PWR |
| REQ-SYS-101 | SYS | 0 | - | ME, PWR |
| REQ-SYS-102 | SYS | 0 | - | CTL, ME, PWR, RX, TX |
| REQ-SYS-103 | SYS | 0 | - | ME |
| REQ-SYS-104 | SYS | 0 | - | ME, TX |
| REQ-SYS-105 | SYS | 0 | - | ME, TX |
| REQ-SYS-106 | SYS | 0 | - | ME, TX |
| REQ-SYS-107 | SYS | 0 | - | ME, TX |
| REQ-SYS-108 | SYS | 0 | - | ME |
| REQ-SYS-109 | SYS | 0 | - | ME |
| REQ-SYS-110 | SYS | 0 | - | ME |
| REQ-SYS-111 | SYS | 0 | - | ME |
| REQ-SYS-112 | SYS | 0 | - | ME, TX |
| REQ-SYS-113 | SYS | 0 | - | ME, TX |
| REQ-SYS-114 | SYS | 0 | - | CTL, ME, PWR, RX, TX |
| REQ-SYS-115 | SYS | 0 | - | CTL, ME, PWR, RX, TX |
| REQ-SYS-116 | SYS | 0 | - | CTL, ME, PWR, RX, TX |
| REQ-SYS-117 | SYS | 0 | - | ME |
| REQ-SYS-118 | SYS | 0 | - | SW, SW-SAFE, TX |
| REQ-SYS-119 | SYS | 0 | - | CTL, SW, SW-BOOT, TX |
| REQ-SYS-120 | SYS | 1 | REQ-SW-KEYER-030 | CTL, SW, SW-KEYER, SW-SAFE, SW-TXSEQ, TX |
| REQ-SYS-121 | SYS | 1 | REQ-TX-015 | TX |
| REQ-SYS-122 | SYS | 0 | - | CTL, ME, PWR, SW, TX |
| REQ-SYS-123 | SYS | 0 | - | - |
| REQ-SYS-124 | SYS | 0 | - | ME |
| REQ-SYS-125 | SYS | 0 | - | - |
| REQ-SYS-126 | SYS | 0 | - | CTL |
| REQ-SYS-127 | SYS | 0 | - | SW |
| REQ-SYS-128 | SYS | 0 | - | SW, SW-HAL |
| REQ-SYS-129 | SYS | 0 | - | SW, SW-SCHED |
| REQ-SYS-130 | SYS | 1 | REQ-SW-KEYER-031 | SW, SW-BOOT, SW-KEYER, SW-SAFE |
| REQ-SYS-131 | SYS | 0 | - | CTL, SW, SW-SAFE, SW-SCHED |
| REQ-SYS-132 | SYS | 0 | - | SW, SW-BOOT |
| REQ-SYS-133 | SYS | 0 | - | CTL, SW, SW-BOOT |
| REQ-SYS-134 | SYS | 0 | - | SW, SW-CFG |
| REQ-SYS-135 | SYS | 0 | - | SW, SW-CFG |
| REQ-SYS-136 | SYS | 0 | - | SW, SW-CFG |
| REQ-SYS-137 | SYS | 0 | - | CTL, ME, PWR, RX, TX |
| REQ-SYS-138 | SYS | 0 | - | CTL, ME, PWR, RX, TX |
| REQ-SYS-139 | SYS | 0 | - | CTL, ME, TX |
| REQ-SYS-140 | SYS | 0 | - | CTL, ME, PWR, RX, TX |
| REQ-SYS-141 | SYS | 0 | - | TX |
| REQ-SYS-142 | SYS | 0 | - | CTL, TX |
| REQ-SYS-143 | SYS | 0 | - | SW, SW-BOOT, SW-DIAG |
| REQ-SYS-144 | SYS | 0 | - | RX, SW, SW-CFG, TX |
| REQ-SYS-145 | SYS | 0 | - | RX, SW, SW-SYNTH, TX |
| REQ-SYS-146 | SYS | 0 | - | CTL, ME, SW, SW-DISPLAY |
| REQ-SYS-147 | SYS | 0 | - | CTL, ME, PWR, RX, TX |
| REQ-SYS-148 | SYS | 0 | - | - |
| REQ-SYS-149 | SYS | 0 | - | PWR, TX |
| REQ-SYS-150 | SYS | 0 | - | CTL, SW, SW-DIAG |
| REQ-SYS-151 | SYS | 1 | REQ-TX-012 | TX |
| REQ-SYS-152 | SYS | 0 | - | SW, SW-TXSEQ, TX |
| REQ-SYS-153 | SYS | 0 | - | PWR, SW, SW-PWR, SW-SAFE |
| REQ-SYS-154 | SYS | 0 | - | SW, SW-SAFE, SW-SYNTH, TX |
| REQ-SYS-155 | SYS | 0 | - | SW, SW-SAFE, TX |
| REQ-SYS-156 | SYS | 0 | - | SW, SW-SAFE, SW-TXSEQ, TX |
| REQ-SYS-157 | SYS | 0 | - | SW, SW-AUDIO |
| REQ-SYS-158 | SYS | 0 | - | SW, SW-AUDIO |
| REQ-SYS-159 | SYS | 1 | REQ-SW-KEYER-033 | SW, SW-AUDIO, SW-KEYER |
| REQ-SYS-160 | SYS | 1 | REQ-SW-KEYER-018 | SW, SW-KEYER, SW-TXSEQ, TX |
| REQ-SYS-161 | SYS | 0 | - | SW, SW-TXSEQ |
| REQ-SYS-162 | SYS | 1 | REQ-SW-KEYER-021 | SW, SW-KEYER |
| REQ-SYS-163 | SYS | 1 | REQ-SW-KEYER-025 | SW, SW-DISPLAY, SW-KEYER |
| REQ-SYS-164 | SYS | 0 | - | CTL, SW, SW-DISPLAY |
| REQ-SYS-165 | SYS | 0 | - | CTL, ME |
| REQ-SYS-166 | SYS | 0 | - | PWR, SW, SW-PWR |
| REQ-SYS-167 | SYS | 0 | - | PWR, SW, SW-PWR |
| REQ-SYS-168 | SYS | 0 | - | ME |
| REQ-SYS-169 | SYS | 0 | - | SW, SW-AUDIO |
| REQ-SYS-170 | SYS | 0 | - | SW, SW-AUDIO, SW-CFG |
| REQ-SYS-171 | SYS | 0 | - | SW, SW-DISPLAY |
| REQ-SYS-172 | SYS | 0 | - | TX |
| REQ-SYS-173 | SYS | 0 | - | CTL, ME |
| REQ-SYS-174 | SYS | 0 | - | CTL |
| REQ-SYS-175 | SYS | 0 | - | ME, TX |
| REQ-SYS-176 | SYS | 1 | REQ-TX-016 | CTL, RX, TX |
| REQ-SYS-177 | SYS | 0 | - | CTL, ME, PWR |
| REQ-SYS-178 | SYS | 0 | - | CTL, PWR, RX, TX |
| REQ-SYS-179 | SYS | 1 | REQ-SW-KEYER-029 | SW, SW-DISPLAY, SW-KEYER, SW-SAFE |
| REQ-SYS-180 | SYS | 0 | - | CTL, TX |
| REQ-SYS-181 | SYS | 0 | - | CTL, TX |
| REQ-SYS-182 | SYS | 1 | REQ-TX-013 | CTL, SW, SW-SAFE, TX |
| REQ-SYS-183 | SYS | 0 | - | RX, SW, SW-SAFE, SW-TXSEQ, TX |
| REQ-SYS-184 | SYS | 0 | - | SW, SW-SAFE |
| REQ-SYS-185 | SYS | 0 | - | PWR |
| REQ-SYS-186 | SYS | 0 | - | CTL, PWR |
| REQ-SYS-187 | SYS | 0 | - | SW, SW-SAFE, SW-TXSEQ |
| REQ-SYS-188 | SYS | 0 | - | SW, SW-KEYER, SW-SAFE |
| REQ-SYS-189 | SYS | 0 | - | SW, SW-AUDIO, SW-SAFE |
| REQ-SYS-190 | SYS | 0 | - | SW, SW-CFG, SW-SAFE |
| REQ-SYS-194 | SYS | 0 | - | PWR |
| REQ-SW-KEYER-001 | SW-KEYER | 0 | - | - |
| REQ-SW-KEYER-002 | SW-KEYER | 0 | - | - |
| REQ-SW-KEYER-003 | SW-KEYER | 0 | - | - |
| REQ-SW-KEYER-004 | SW-KEYER | 0 | - | - |
| REQ-SW-KEYER-005 | SW-KEYER | 0 | - | - |
| REQ-SW-KEYER-006 | SW-KEYER | 0 | - | - |
| REQ-SW-KEYER-007 | SW-KEYER | 0 | - | - |
| REQ-SW-KEYER-008 | SW-KEYER | 0 | - | - |
| REQ-SW-KEYER-009 | SW-KEYER | 0 | - | - |
| REQ-SW-KEYER-010 | SW-KEYER | 0 | - | - |
| REQ-SW-KEYER-011 | SW-KEYER | 0 | - | - |
| REQ-SW-KEYER-012 | SW-KEYER | 0 | - | - |
| REQ-SW-KEYER-013 | SW-KEYER | 0 | - | - |
| REQ-SW-KEYER-014 | SW-KEYER | 0 | - | - |
| REQ-SW-KEYER-015 | SW-KEYER | 0 | - | - |
| REQ-SW-KEYER-016 | SW-KEYER | 0 | - | - |
| REQ-SW-KEYER-017 | SW-KEYER | 0 | - | - |
| REQ-SW-KEYER-018 | SW-KEYER | 0 | - | - |
| REQ-SW-KEYER-019 | SW-KEYER | 0 | - | - |
| REQ-SW-KEYER-020 | SW-KEYER | 0 | - | - |
| REQ-SW-KEYER-021 | SW-KEYER | 0 | - | - |
| REQ-SW-KEYER-022 | SW-KEYER | 0 | - | - |
| REQ-SW-KEYER-023 | SW-KEYER | 0 | - | - |
| REQ-SW-KEYER-024 | SW-KEYER | 0 | - | - |
| REQ-SW-KEYER-025 | SW-KEYER | 0 | - | - |
| REQ-SW-KEYER-026 | SW-KEYER | 0 | - | - |
| REQ-SW-KEYER-027 | SW-KEYER | 0 | - | - |
| REQ-SW-KEYER-028 | SW-KEYER | 0 | - | - |
| REQ-SW-KEYER-029 | SW-KEYER | 0 | - | - |
| REQ-SW-KEYER-030 | SW-KEYER | 0 | - | - |
| REQ-SW-KEYER-031 | SW-KEYER | 0 | - | - |
| REQ-SW-KEYER-032 | SW-KEYER | 0 | - | - |
| REQ-SW-KEYER-033 | SW-KEYER | 0 | - | - |
| REQ-SW-KEYER-034 | SW-KEYER | 0 | - | - |
| REQ-SW-KEYER-035 | SW-KEYER | 0 | - | - |
| REQ-SW-KEYER-036 | SW-KEYER | 0 | - | - |
| REQ-SW-KEYER-037 | SW-KEYER | 0 | - | - |
| REQ-SW-KEYER-038 | SW-KEYER | 0 | - | - |
| REQ-SW-KEYER-039 | SW-KEYER | 0 | - | - |
| REQ-TX-001 | TX | 0 | - | - |
| REQ-TX-002 | TX | 0 | - | - |
| REQ-TX-003 | TX | 0 | - | - |
| REQ-TX-004 | TX | 0 | - | - |
| REQ-TX-005 | TX | 0 | - | - |
| REQ-TX-006 | TX | 0 | - | - |
| REQ-TX-007 | TX | 0 | - | - |
| REQ-TX-008 | TX | 0 | - | - |
| REQ-TX-009 | TX | 0 | - | - |
| REQ-TX-010 | TX | 0 | - | - |
| REQ-TX-011 | TX | 0 | - | - |
| REQ-TX-012 | TX | 0 | - | - |
| REQ-TX-013 | TX | 0 | - | - |
| REQ-TX-014 | TX | 0 | - | - |
| REQ-TX-015 | TX | 0 | - | - |
| REQ-TX-016 | TX | 0 | - | - |

### 7.3 Requirements tree

Roots are requirements with `parent_id` null; each line is `id [status] title`.

- REQ-SYS-001 [Active] A1A emission only
  - REQ-TX-001 [Draft] Keying envelope as the only carrier modulation
- REQ-SYS-002 [Active] Operating modes and transitions
- REQ-SYS-003 [Active] Self-test before transmit
- REQ-SYS-004 [Active] Carrier end on an inhibit, flag or latched fault
- REQ-SYS-005 [Active] Fault-safe exit
- REQ-SYS-006 [Active] Operator call sign
- REQ-SYS-007 [Active] Keying only from the key jack
  - REQ-SW-KEYER-028 [Draft] Keying sources
  - REQ-TX-014 [Draft] RF isolation with transmit key deasserted
- REQ-SYS-008 [Active] Transmit frequency range with band-edge guard
  - REQ-TX-002 [Draft] Transmit carrier frequency range
- REQ-SYS-009 [Active] Transmit inhibit outside the guard
  - REQ-TX-003 [Draft] RF isolation with PA enable deasserted
- REQ-SYS-010 [Active] Carrier frequency accuracy
- REQ-SYS-011 [Active] Selectable power steps below 5 W
  - REQ-TX-004 [Draft] Reduced power steps
- REQ-SYS-012 [Active] Rated output power with level control
- REQ-SYS-013 [Active] Survival into open, short and high SWR
- REQ-SYS-014 [Active] Keying envelope
  - REQ-TX-005 [Draft] Keying envelope reproduction
- REQ-SYS-015 [Active] Occupied bandwidth
  - REQ-TX-006 [Draft] Keying sideband level
- REQ-SYS-016 [Closed] Necessary bandwidth
- REQ-SYS-017 [Active] Spurious emission absolute limit
  - REQ-TX-007 [Draft] Spurious emission absolute limit
- REQ-SYS-018 [Active] Spurious emission design margin
  - REQ-TX-008 [Draft] Spurious emission design margin
  - REQ-TX-009 [Draft] Second-harmonic attenuation
  - REQ-TX-010 [Draft] Third-harmonic attenuation
  - REQ-TX-011 [Draft] High-order harmonic attenuation
- REQ-SYS-019 [Active] Tune carrier power
- REQ-SYS-020 [Active] Tune carrier timeout
- REQ-SYS-021 [Active] Receive frequency range
- REQ-SYS-022 [Active] Minimum discernible signal
- REQ-SYS-023 [Active] Minimum discernible signal target
- REQ-SYS-024 [Active] Receive passband width
- REQ-SYS-025 [Active] Receive -60 dB bandwidth
- REQ-SYS-026 [Active] Stopband rejection from 2 kHz to 5 kHz
- REQ-SYS-027 [Active] Ultimate receive rejection
- REQ-SYS-028 [Active] Passband ripple
- REQ-SYS-029 [Active] Adjacent-signal desensitization
- REQ-SYS-030 [Active] No gain pumping from an adjacent signal
- REQ-SYS-031 [Active] Reciprocal mixing dynamic range
- REQ-SYS-032 [Active] Receive level control range
- REQ-SYS-033 [Active] Receiver spurious response rejection
- REQ-SYS-034 [Active] Internally generated receive spurious signals
- REQ-SYS-035 [Active] Receive filter-centre calibration trim
- REQ-SYS-036 [Active] Receive recovery after transmit
- REQ-SYS-037 [Active] Receiver input overload survival
- REQ-SYS-038 [Active] Straight-key keying
  - REQ-SW-KEYER-001 [Draft] Straight-key closure to key-down
  - REQ-SW-KEYER-002 [Draft] Straight-mode input selection
- REQ-SYS-039 [Active] Iambic paddle keying
  - REQ-SW-KEYER-003 [Draft] Self-completing paddle elements
  - REQ-SW-KEYER-004 [Draft] Non-shortening inter-element space
  - REQ-SW-KEYER-005 [Draft] Dot and dash memory
- REQ-SYS-040 [Active] Keyer modes
  - REQ-SW-KEYER-006 [Draft] Squeeze alternation
  - REQ-SW-KEYER-007 [Draft] Iambic A squeeze release
  - REQ-SW-KEYER-008 [Draft] Iambic B squeeze release
  - REQ-SW-KEYER-009 [Draft] Iambic B switchpoint range
  - REQ-SW-KEYER-010 [Draft] Ultimatic squeeze
  - REQ-SW-KEYER-011 [Draft] Bug-mode dits
  - REQ-SW-KEYER-012 [Draft] Bug-mode manual dah
- REQ-SYS-041 [Active] Keyer speed range
  - REQ-SW-KEYER-015 [Draft] Keyer speed setting range
  - REQ-SW-KEYER-016 [Draft] Speed change at the element boundary
  - REQ-SW-KEYER-037 [Draft] Out-of-range keyer setting commands
- REQ-SYS-042 [Active] Element and space timing accuracy
  - REQ-SW-KEYER-013 [Draft] Element and space timing
  - REQ-SW-KEYER-014 [Draft] Timing under display and encoder load on the target
- REQ-SYS-043 [Active] Paddle-to-element latency
  - REQ-SW-KEYER-017 [Draft] Paddle-to-element latency
  - REQ-SW-KEYER-019 [Draft] Key input sampling period
- REQ-SYS-044 [Active] Semi break-in hang time
  - REQ-SW-KEYER-032 [Draft] Semi break-in hang
- REQ-SYS-045 [Active] Sidetone frequency
- REQ-SYS-046 [Active] CW pitch equals sidetone
- REQ-SYS-047 [Active] Key contact thresholds
- REQ-SYS-048 [Active] Key closure debounce
  - REQ-SW-KEYER-020 [Draft] Key closure debounce
- REQ-SYS-049 [Active] Key input abuse tolerance
- REQ-SYS-050 [Active] Electrostatic discharge tolerance
- REQ-SYS-051 [Active] Key input RF immunity
- REQ-SYS-052 [Active] Key-closed interlock at power-on and reset
  - REQ-SW-KEYER-022 [Draft] Key-closed interlock
- REQ-SYS-053 [Active] Straight-key timeout
  - REQ-SW-KEYER-026 [Draft] Manual-closure timeout
  - REQ-SW-KEYER-027 [Draft] Sidetone during a manual-closure timeout
- REQ-SYS-054 [Active] Paddle watchdog
- REQ-SYS-055 [Active] Hardware transmit cutoff
- REQ-SYS-056 [Active] Key input mode selection
  - REQ-SW-KEYER-024 [Draft] Key-input mode change on two validated operator events
- REQ-SYS-057 [Active] Operator control set
- REQ-SYS-058 [Active] Tuning with rate-dependent step
- REQ-SYS-059 [Active] Volume control
- REQ-SYS-060 [Active] Status display content
- REQ-SYS-061 [Active] Display character size
- REQ-SYS-062 [Active] Menu depth
- REQ-SYS-063 [Active] Deliberate selection of 5 W
- REQ-SYS-064 [Active] Default power step
- REQ-SYS-065 [Active] Guest lock transmit inhibit
- REQ-SYS-066 [Active] Guest lock set and release
- REQ-SYS-067 [Active] Fault cause display
  - REQ-SW-KEYER-023 [Draft] KEY inhibit report
- REQ-SYS-068 [Active] Identification reminder
- REQ-SYS-069 [Active] Separation reminder per power step
- REQ-SYS-070 [Active] Charge state indication
- REQ-SYS-071 [Active] Headphone output ceiling
- REQ-SYS-072 [Active] Headphone output worst case
- REQ-SYS-073 [Active] Headphone ceiling under a single component failure
- REQ-SYS-074 [Active] Default audio level cap
- REQ-SYS-075 [Active] Receive mute at key-down
- REQ-SYS-076 [Active] Headphone transients
- REQ-SYS-077 [Active] Amplifier off without headphones
- REQ-SYS-078 [Active] Headphone load and channels
- REQ-SYS-079 [Active] Headphone output short-circuit tolerance
- REQ-SYS-080 [Active] Two 18650 cells in holders
- REQ-SYS-081 [Active] Charge termination voltage
- REQ-SYS-082 [Active] Charge temperature window
- REQ-SYS-083 [Active] Independent cell over-voltage protection
- REQ-SYS-084 [Active] Cell under-voltage cutoff
- REQ-SYS-085 [Active] Over-current and short-circuit protection
- REQ-SYS-086 [Active] Reverse cell insertion
- REQ-SYS-087 [Active] Cell insertion check
- REQ-SYS-088 [Active] Dual-path cell voltage check
- REQ-SYS-089 [Active] Charge safety timer
- REQ-SYS-090 [Active] USB input current
- REQ-SYS-091 [Active] Charge time
- REQ-SYS-092 [Active] Hardware transmit inhibit with USB power
- REQ-SYS-093 [Active] Charging paused while receiving
- REQ-SYS-094 [Active] Battery life at 1:9
- REQ-SYS-095 [Active] Battery life at 1:4
- REQ-SYS-096 [Active] Low-battery warning
- REQ-SYS-097 [Active] Low-battery transmit inhibit
- REQ-SYS-098 [Active] Low-battery power-down
- REQ-SYS-099 [Active] Cell over-temperature lockout
- REQ-SYS-100 [Active] Current drawn when switched off
- REQ-SYS-101 [Active] Mechanical power switch
- REQ-SYS-102 [Active] Unit mass
- REQ-SYS-103 [Active] External envelope
- REQ-SYS-104 [Active] Antenna connector
- REQ-SYS-105 [Active] Antenna port mechanical load path
- REQ-SYS-106 [Active] Antenna port mating life
- REQ-SYS-107 [Active] Counterpoise attachment
- REQ-SYS-108 [Active] Connector access through the enclosure
- REQ-SYS-109 [Active] Enclosure material and finish
- REQ-SYS-110 [Active] Edge break
- REQ-SYS-111 [Active] Knob clearance
- REQ-SYS-112 [Active] PA thermal path at continuous key-down
- REQ-SYS-113 [Active] Hand-hold surface temperature
- REQ-SYS-114 [Active] Operating temperature
- REQ-SYS-115 [Active] Storage temperature
- REQ-SYS-116 [Active] Drop survival
- REQ-SYS-117 [Active] Light rain
- REQ-SYS-118 [Active] PA over-temperature inhibit
- REQ-SYS-119 [Active] Transmit held off during reset and firmware load
- REQ-SYS-120 [Active] Two independent conditions for RF output
  - REQ-SW-KEYER-030 [Draft] Key-down state integrity
- REQ-SYS-121 [Active] RF exposure evaluation
  - REQ-TX-015 [Draft] Output power ceiling for the RF exposure evaluation
- REQ-SYS-122 [Active] Operations handbook safety content
- REQ-SYS-123 [Closed] Operation from the handbook
- REQ-SYS-124 [Active] Enclosure legend
- REQ-SYS-125 [Active] Build quantity cap
- REQ-SYS-126 [Active] Controller module
- REQ-SYS-127 [Active] Firmware language and platform
- REQ-SYS-128 [Active] Host-testable application layering
- REQ-SYS-129 [Active] Single interrupt priority design rule
- REQ-SYS-130 [Active] Safe state first on reset, panic and latched fault
  - REQ-SW-KEYER-031 [Draft] Key-up on keyer error or safe-state command
- REQ-SYS-131 [Active] Firmware hang recovery
- REQ-SYS-132 [Active] Firmware image integrity
- REQ-SYS-133 [Active] Firmware update over USB
- REQ-SYS-134 [Active] Stored configuration integrity
- REQ-SYS-135 [Active] Settings persistence
- REQ-SYS-136 [Active] Configuration defaults
- REQ-SYS-137 [Active] Turnkey surface-mount assembly
- REQ-SYS-138 [Active] Owner hand-soldered parts
- REQ-SYS-139 [Active] Circuit board fabrication rules
- REQ-SYS-140 [Active] Parts sourcing
- REQ-SYS-141 [Active] Transmit monitor port
- REQ-SYS-142 [Active] Test points
- REQ-SYS-143 [Active] Boot banner and serial telemetry
- REQ-SYS-144 [Active] No manual alignment
- REQ-SYS-145 [Active] Band-dependent functions partitioned
- REQ-SYS-146 [Active] Reserved band control
- REQ-SYS-147 [Active] Unit cost
- REQ-SYS-148 [Active] Open-source publication
- REQ-SYS-149 [Active] No transmitter supply from USB alone
- REQ-SYS-150 [Active] Telemetry without USB power
- REQ-SYS-151 [Active] Spurious emissions into a mismatched load
  - REQ-TX-012 [Draft] Spurious emissions into a mismatched load
- REQ-SYS-152 [Active] Rated power into a mismatched load
- REQ-SYS-153 [Active] High pack voltage transmit lockout
- REQ-SYS-154 [Active] Synthesizer fault response
- REQ-SYS-155 [Active] PA temperature sensor fault response
- REQ-SYS-156 [Active] Forward-power detector fault response
- REQ-SYS-157 [Active] Receive audio held muted through transmit and hang
- REQ-SYS-158 [Active] Receive audio restore fade
- REQ-SYS-159 [Active] Sidetone onset latency
  - REQ-SW-KEYER-033 [Draft] Sidetone gate onset
- REQ-SYS-160 [Active] Straight-key contact to RF latency
  - REQ-SW-KEYER-018 [Draft] Straight-key closure latency
- REQ-SYS-161 [Active] Constant lead-in over an over
- REQ-SYS-162 [Active] Key opening debounce
  - REQ-SW-KEYER-021 [Draft] Key opening debounce
- REQ-SYS-163 [Active] Key-mode selection with a closed input
  - REQ-SW-KEYER-025 [Draft] Mode selection with a closed input
- REQ-SYS-164 [Active] Band crossing time
- REQ-SYS-165 [Active] Display legibility without a backlight
- REQ-SYS-166 [Active] Rails held off for out-of-window cells
- REQ-SYS-167 [Active] Charge current-fall supervision
- REQ-SYS-168 [Active] Cell cover pinch gap
- REQ-SYS-169 [Active] Audio unlock expiry
- REQ-SYS-170 [Active] Audio cap at power-on
- REQ-SYS-171 [Active] Key-down time display
- REQ-SYS-172 [Active] Delivered antenna gain
- REQ-SYS-173 [Active] Headphone audio while keying with long leads
- REQ-SYS-174 [Active] Key jack wiring
- REQ-SYS-175 [Active] Antenna port on one end
- REQ-SYS-176 [Active] Receive-mode emissions at the antenna port
  - REQ-TX-016 [Draft] Carrier-frequency leakage in receive
- REQ-SYS-177 [Active] Enclosure emissions from digital and switching circuits
- REQ-SYS-178 [Active] Owner-procured parts sourcing
- REQ-SYS-179 [Active] Bench test mode entry
  - REQ-SW-KEYER-029 [Draft] Test-mode generator start on two validated operator events
- REQ-SYS-180 [Active] Transmission-length hardware backstop
- REQ-SYS-181 [Active] Hardware PA over-temperature cut-off
- REQ-SYS-182 [Active] Independent frequency verification before and during transmit
  - REQ-TX-013 [Draft] Synthesizer frequency sample for the independent frequency verification
- REQ-SYS-183 [Active] RF-off level at the antenna port
- REQ-SYS-184 [Active] Paddle squeeze limit
- REQ-SYS-185 [Active] Further cell over-voltage layer
- REQ-SYS-186 [Active] Separate cell-sense paths per protection layer
- REQ-SYS-187 [Active] Bench test mode power step
- REQ-SYS-188 [Active] Bench test mode timeout
- REQ-SYS-189 [Active] Bench full-scale test tone limit
- REQ-SYS-190 [Active] Bench test mode not retained over reset
- REQ-SYS-194 [Active] Independent cell over-voltage threshold over the charging temperature range
- REQ-SW-KEYER-034 [Draft] Paddle memory integrity
- REQ-SW-KEYER-035 [Draft] Sidetone off during the key-closed interlock
- REQ-SW-KEYER-036 [Draft] Key input closed without a plug
- REQ-SW-KEYER-038 [Draft] Key inputs change no setting
- REQ-SW-KEYER-039 [Draft] Distinct operator events for an override

## 8. Per-module coverage

| Module | Requirements | With any case | Coverage | With closing case | Closing coverage | Verified or Closed | Closure | With children | Open TBR |
|---|---|---|---|---|---|---|---|---|---|
| SYS | 189 | 189 | 100 % | 189 | 100 % | 0 | 0 % | 32 | 110 |
| SW-KEYER | 39 | 39 | 100 % | 39 | 100 % | 0 | 0 % | 0 | 11 |
| TX | 16 | 16 | 100 % | 16 | 100 % | 0 | 0 % | 0 | 14 |
| **All** | 244 | 244 | 100 % | 244 | 100 % | 0 | 0 % | 32 | 135 |

## 9. Hazard traceability

Requirements controlling each hazard (the union of their own `hazard_ids` and the hazard's `requirement_ids` and controls' `control_req_ids`, 04 section 3), the verification cases that cite them (SWE-052, software requirements to hazards), and the live software requirements that do not yet have a Passed, credited Bench or OnAir closing case (SWE-192 at SAR, 01 section 8.6).

| Hazard | Title | Controlling requirements | Verification cases | Software requirements not yet tested on target |
|---|---|---|---|---|
| HZ-001 | RF exposure of the operator in the portable posture (SAR within 20 cm) | REQ-SW-KEYER-026, REQ-SYS-011, REQ-SYS-012, REQ-SYS-019, REQ-SYS-020, REQ-SYS-053, REQ-SYS-054, REQ-SYS-055, REQ-SYS-063, REQ-SYS-064, REQ-SYS-121, REQ-SYS-122, REQ-SYS-124, REQ-SYS-172, REQ-SYS-180, REQ-SYS-184, REQ-TX-004, REQ-TX-015 | TC-SW-KEYER-026, TC-SW-KEYER-036, TC-SYS-010, TC-SYS-011, TC-SYS-015, TC-SYS-038, TC-SYS-039, TC-SYS-045, TC-SYS-046, TC-SYS-084, TC-SYS-085, TC-SYS-086, TC-SYS-108, TC-TX-004, TC-TX-015 | REQ-SW-KEYER-026 |
| HZ-002 | Lithium-ion cell overcharge or charging fault leading to venting or thermal runaway | REQ-SYS-081, REQ-SYS-082, REQ-SYS-083, REQ-SYS-087, REQ-SYS-088, REQ-SYS-089, REQ-SYS-093, REQ-SYS-122, REQ-SYS-130, REQ-SYS-167, REQ-SYS-185, REQ-SYS-186, REQ-SYS-194 | TC-SYS-050, TC-SYS-059, TC-SYS-060, TC-SYS-061, TC-SYS-064, TC-SYS-065, TC-SYS-082, TC-SYS-085, TC-SYS-111, TC-SYS-112, TC-SYS-116 | - |
| HZ-003 | Power amplifier and enclosure over-temperature and contact burn | REQ-SW-KEYER-026, REQ-SYS-012, REQ-SYS-013, REQ-SYS-053, REQ-SYS-054, REQ-SYS-055, REQ-SYS-112, REQ-SYS-113, REQ-SYS-118, REQ-SYS-122, REQ-SYS-152, REQ-SYS-155, REQ-SYS-156, REQ-SYS-180, REQ-SYS-181, REQ-SYS-184 | TC-SW-KEYER-026, TC-SW-KEYER-036, TC-SYS-010, TC-SYS-011, TC-SYS-012, TC-SYS-038, TC-SYS-039, TC-SYS-077, TC-SYS-081, TC-SYS-085, TC-SYS-100, TC-SYS-101, TC-SYS-108, TC-SYS-109 | REQ-SW-KEYER-026 |
| HZ-004 | Unintended or stuck transmission | REQ-SW-KEYER-002, REQ-SW-KEYER-019, REQ-SW-KEYER-020, REQ-SW-KEYER-021, REQ-SW-KEYER-022, REQ-SW-KEYER-023, REQ-SW-KEYER-024, REQ-SW-KEYER-025, REQ-SW-KEYER-026, REQ-SW-KEYER-027, REQ-SW-KEYER-028, REQ-SW-KEYER-029, REQ-SW-KEYER-030, REQ-SW-KEYER-031, REQ-SW-KEYER-034, REQ-SW-KEYER-035, REQ-SW-KEYER-036, REQ-SW-KEYER-039, REQ-SYS-002, REQ-SYS-003, REQ-SYS-004, REQ-SYS-005, REQ-SYS-007, REQ-SYS-048, REQ-SYS-051, REQ-SYS-052, REQ-SYS-053, REQ-SYS-054, REQ-SYS-055, REQ-SYS-056, REQ-SYS-067, REQ-SYS-101, REQ-SYS-119, REQ-SYS-120, REQ-SYS-122, REQ-SYS-130, REQ-SYS-131, REQ-SYS-162, REQ-SYS-163, REQ-SYS-179, REQ-SYS-180, REQ-SYS-183, REQ-SYS-184, REQ-SYS-187, REQ-SYS-188, REQ-SYS-190, REQ-TX-014 | TC-SW-KEYER-002, TC-SW-KEYER-019, TC-SW-KEYER-020, TC-SW-KEYER-021, TC-SW-KEYER-022, TC-SW-KEYER-023, TC-SW-KEYER-024, TC-SW-KEYER-025, TC-SW-KEYER-026, TC-SW-KEYER-027, TC-SW-KEYER-028, TC-SW-KEYER-029, TC-SW-KEYER-030, TC-SW-KEYER-031, TC-SW-KEYER-034, TC-SW-KEYER-035, TC-SW-KEYER-036, TC-SW-KEYER-037, TC-SW-KEYER-038, TC-SW-KEYER-040, TC-SW-KEYER-041, TC-SW-KEYER-042, TC-SW-KEYER-043, TC-SYS-002, TC-SYS-003, TC-SYS-004, TC-SYS-005, TC-SYS-007, TC-SYS-008, TC-SYS-034, TC-SYS-036, TC-SYS-037, TC-SYS-038, TC-SYS-039, TC-SYS-047, TC-SYS-066, TC-SYS-070, TC-SYS-082, TC-SYS-083, TC-SYS-085, TC-SYS-101, TC-SYS-108, TC-SYS-109, TC-SYS-110, TC-SYS-113, TC-TX-014 | REQ-SW-KEYER-002, REQ-SW-KEYER-019, REQ-SW-KEYER-020, REQ-SW-KEYER-021, REQ-SW-KEYER-022, REQ-SW-KEYER-023, REQ-SW-KEYER-024, REQ-SW-KEYER-025, REQ-SW-KEYER-026, REQ-SW-KEYER-027, REQ-SW-KEYER-028, REQ-SW-KEYER-029, REQ-SW-KEYER-030, REQ-SW-KEYER-031, REQ-SW-KEYER-034, REQ-SW-KEYER-035, REQ-SW-KEYER-036, REQ-SW-KEYER-039 |
| HZ-005 | Hearing damage from headphone level, full-scale tones and clicks | REQ-SW-KEYER-033, REQ-SYS-071, REQ-SYS-072, REQ-SYS-073, REQ-SYS-074, REQ-SYS-075, REQ-SYS-076, REQ-SYS-077, REQ-SYS-122, REQ-SYS-130, REQ-SYS-157, REQ-SYS-158, REQ-SYS-159, REQ-SYS-169, REQ-SYS-170, REQ-SYS-179, REQ-SYS-189, REQ-SYS-190 | TC-SW-KEYER-033, TC-SW-KEYER-039, TC-SYS-007, TC-SYS-029, TC-SYS-051, TC-SYS-052, TC-SYS-053, TC-SYS-054, TC-SYS-055, TC-SYS-056, TC-SYS-082, TC-SYS-085, TC-SYS-104, TC-SYS-113 | REQ-SW-KEYER-033 |
| HZ-006 | RF exposure of bystanders, household members and non-licensee holders (general population) | REQ-SW-KEYER-026, REQ-SYS-011, REQ-SYS-019, REQ-SYS-020, REQ-SYS-053, REQ-SYS-054, REQ-SYS-055, REQ-SYS-063, REQ-SYS-064, REQ-SYS-065, REQ-SYS-066, REQ-SYS-069, REQ-SYS-121, REQ-SYS-122, REQ-SYS-124, REQ-SYS-171, REQ-SYS-172, REQ-SYS-180, REQ-SYS-184, REQ-TX-003, REQ-TX-004, REQ-TX-015 | TC-SW-KEYER-026, TC-SW-KEYER-036, TC-SYS-010, TC-SYS-011, TC-SYS-015, TC-SYS-038, TC-SYS-039, TC-SYS-045, TC-SYS-046, TC-SYS-047, TC-SYS-049, TC-SYS-084, TC-SYS-085, TC-SYS-086, TC-SYS-108, TC-TX-003, TC-TX-004, TC-TX-015 | REQ-SW-KEYER-026 |
| HZ-007 | Lithium-ion discharge-side fault: over-discharge, over-current, short circuit, reverse insertion, heating | REQ-SYS-084, REQ-SYS-085, REQ-SYS-086, REQ-SYS-087, REQ-SYS-096, REQ-SYS-097, REQ-SYS-098, REQ-SYS-099, REQ-SYS-101, REQ-SYS-122, REQ-SYS-166, REQ-SYS-186 | TC-SYS-060, TC-SYS-062, TC-SYS-063, TC-SYS-064, TC-SYS-067, TC-SYS-069, TC-SYS-070, TC-SYS-085, TC-SYS-112 | - |
| HZ-008 | Harmonic and spurious emissions into safety-of-life and other radio services | REQ-SYS-008, REQ-SYS-009, REQ-SYS-010, REQ-SYS-012, REQ-SYS-014, REQ-SYS-015, REQ-SYS-017, REQ-SYS-018, REQ-SYS-034, REQ-SYS-151, REQ-SYS-153, REQ-SYS-154, REQ-SYS-156, REQ-SYS-182, REQ-TX-002, REQ-TX-003, REQ-TX-005, REQ-TX-006, REQ-TX-007, REQ-TX-008, REQ-TX-009, REQ-TX-010, REQ-TX-011, REQ-TX-012, REQ-TX-013 | TC-SYS-008, TC-SYS-009, TC-SYS-010, TC-SYS-011, TC-SYS-013, TC-SYS-014, TC-SYS-022, TC-SYS-069, TC-SYS-100, TC-SYS-101, TC-SYS-110, TC-TX-002, TC-TX-003, TC-TX-005, TC-TX-006, TC-TX-007, TC-TX-008, TC-TX-009, TC-TX-010, TC-TX-011, TC-TX-012, TC-TX-013 | - |
| HZ-009 | Antenna connector mechanical failure and PCB damage | REQ-SYS-013, REQ-SYS-105, REQ-SYS-106, REQ-SYS-107, REQ-SYS-122, REQ-SYS-152 | TC-SYS-012, TC-SYS-072, TC-SYS-073, TC-SYS-085, TC-SYS-100 | - |
| HZ-010 | ESD and RF pickup on the key, paddle and headphone inputs | REQ-SW-KEYER-019, REQ-SW-KEYER-020, REQ-SW-KEYER-021, REQ-SW-KEYER-036, REQ-SYS-047, REQ-SYS-048, REQ-SYS-049, REQ-SYS-050, REQ-SYS-051, REQ-SYS-079, REQ-SYS-162 | TC-SW-KEYER-019, TC-SW-KEYER-020, TC-SW-KEYER-021, TC-SW-KEYER-034, TC-SW-KEYER-035, TC-SW-KEYER-040, TC-SW-KEYER-043, TC-SYS-033, TC-SYS-034, TC-SYS-035, TC-SYS-036, TC-SYS-057 | REQ-SW-KEYER-019, REQ-SW-KEYER-020, REQ-SW-KEYER-021, REQ-SW-KEYER-036 |
| HZ-011 | Charging while transmitting | REQ-SYS-002, REQ-SYS-070, REQ-SYS-090, REQ-SYS-092, REQ-SYS-093, REQ-SYS-122, REQ-SYS-149 | TC-SYS-002, TC-SYS-003, TC-SYS-050, TC-SYS-066, TC-SYS-085 | - |
| HZ-012 | RF burn from contact with the antenna element or connector while transmitting | REQ-SW-KEYER-026, REQ-SYS-013, REQ-SYS-019, REQ-SYS-020, REQ-SYS-053, REQ-SYS-054, REQ-SYS-055, REQ-SYS-064, REQ-SYS-122, REQ-SYS-180, REQ-SYS-184 | TC-SW-KEYER-026, TC-SW-KEYER-036, TC-SYS-012, TC-SYS-015, TC-SYS-038, TC-SYS-039, TC-SYS-046, TC-SYS-085, TC-SYS-108 | REQ-SW-KEYER-026 |
| HZ-013 | Sharp edges and pinch points of the machined enclosure | REQ-SYS-110, REQ-SYS-111, REQ-SYS-122, REQ-SYS-168 | TC-SYS-076, TC-SYS-085 | - |
| HZ-014 | Firmware load leaving the radio in an unsafe state | REQ-SW-KEYER-022, REQ-SYS-003, REQ-SYS-052, REQ-SYS-055, REQ-SYS-064, REQ-SYS-092, REQ-SYS-119, REQ-SYS-131, REQ-SYS-132, REQ-SYS-134, REQ-SYS-143, REQ-SYS-149, REQ-SYS-180 | TC-SW-KEYER-022, TC-SW-KEYER-034, TC-SYS-004, TC-SYS-037, TC-SYS-039, TC-SYS-046, TC-SYS-066, TC-SYS-082, TC-SYS-089, TC-SYS-095, TC-SYS-108 | REQ-SW-KEYER-022 |
| HZ-015 | Owner hand assembly: iron burns, flux fumes, solder handling, bench fire and heat or ESD damage to parts | REQ-SYS-137, REQ-SYS-138 | TC-SYS-091 | - |

## 10. Nonconformance traceability

No nonconformance reports under `docs/vv/ncr`.

## 11. Checks performed

| Code | Severity | Rule |
|---|---|---|
| SCHEMA_MISSING | VIOLATION | docs/requirements/schema.json or docs/test_cases/schema.json is absent |
| SCHEMA_ID_PATTERN_MISSING | WARNING | docs/requirements/schema.json or docs/test_cases/schema.json exists but defines no id pattern, so the fallback pattern of charter section 6 is used |
| SCHEMA_INVALID | VIOLATION | a requirements, expectations, test case, hazards or risk register file (docs/risk/register.json against docs/risk/schema.json) fails its JSON Schema or is not valid JSON (same check as validate_docs.py; 02 T-01) |
| ID_FORMAT | VIOLATION | requirement or test case id does not match the id pattern of its schema |
| ID_DUPLICATE | VIOLATION | an id is defined more than once: REQ, TC and NCR across all files; NGO, MOE and CON within expectations.json; HZ within hazards.json; RSK within register.json; MOP and TPM within tpm.json; an OPS-NNN heading repeated in conops.md; two ADR-NNN or two TS-NNN files with the same number. The first definition is kept (charter sections 6 and 7: ids are never reused and are unique; 02 T-03) |
| MODULE_MISMATCH | VIOLATION | module field differs from the directory name, or an id is not exactly <REQ\|TC>-<module>-NNN for the file's module (V&V 7.3 rule 1; 02 T-02) |
| MODULE_UNKNOWN | VIOLATION | a requirements file declares a module outside SYS, RX, TX, PWR, CTL, ME, SW and SW-<SUB> (SW-COV, SW-REG and SW-TOOL are test-only; VER is reserved and unused), or a test case file declares a module outside those and VAL, ATP, SW-COV, SW-REG, SW-TOOL (charter section 6; 04 section 1) |
| MODULE_DUPLICATE | VIOLATION | two files of the same kind declare the same module |
| RATIONALE_EMPTY | VIOLATION | rationale is empty (charter section 7: rationale mandatory) |
| L1_PARENT_NOT_NULL | VIOLATION | a SYS requirement has a non-null parent_id (02 section 2.3, T-05: L1 traces to L0 through source_ids) |
| PARENT_UNRESOLVED | VIOLATION | parent_id names a requirement that does not exist, or the requirement itself |
| PARENT_MISSING | VIOLATION | an L2 requirement has parent_id null and its rationale does not say self-derived (SE HB 6.2.1.2.3; 02 T-05) |
| SELF_DERIVED_UNSUPPORTED | VIOLATION | an L2 requirement with parent_id null says self-derived but the rationale does not begin 'Self-derived:', or it has neither an ADR-/TS- source id nor a hazard id (02 section 2.3, T-05) |
| PARENT_CYCLE | VIOLATION | the parent chain loops |
| CHILD_INVERSE | VIOLATION | child_ids is not the exact inverse of parent_id (02 T-06) |
| CHILD_AHEAD_OF_PARENT | VIOLATION | a requirement with status Active, Verified or Closed has a parent with status Draft (02 T-11) |
| SOURCE_UNRESOLVED | VIOLATION | a source id of a requirement (SI, NGO, MOE, CON, OPS, ADR, TS, 47 CFR Part 1, 2, 15 or 97 clause) or of an expectations.json entry (SI, 47 CFR clause) does not exist in its upstream artifact (02 section 3.4, T-07) |
| SOURCE_L0_MISSING | VIOLATION | a SYS requirement has no source id or, while expectations.json exists, no NGO-, MOE-, CON- or OPS- source id (02 section 2.3, T-07) |
| SAFETY_TAG_NO_HAZARD | VIOLATION | a requirement tagged safety has an empty hazard_ids (02 section 2.3, T-08) |
| REGULATORY_TAG_NO_CLAUSE | VIOLATION | a requirement tagged regulatory cites no 47 CFR clause (Part 1, 2, 15 or 97) in source_ids (02 section 2.3) |
| HAZARD_ID_FORMAT | VIOLATION | a hazard id does not match HZ-NNN |
| HAZARD_UNRESOLVED | VIOLATION | a hazard id is not defined in docs/safety/hazards.json, or hazards.json names a requirement (requirement_ids or a control's control_req_ids) that does not exist |
| HAZARD_REQ_NOT_TESTED | VIOLATION | a hazard-tracing requirement (its own hazard_ids, or named by a hazard's requirement_ids or a control's control_req_ids in docs/safety/hazards.json; 04 section 3) has no closing case of method Test. Modules SW and SW-<SUB>: SWE-192, no exception. Other modules: 04 rule 7.3.6 (project extension of SWE-192 to every hazard-control requirement), which also accepts method Inspection with a closing case of method Inspection and a verification_note beginning 'Inspection accepted per CR-002' (a documentary or physical property, CR-002), or method Analysis with a verification_note beginning 'Analysis accepted per RSK-NNN' naming a risk in docs/risk/register.json |
| HAZARD_CONTROL_UNTRACED | VIOLATION | a requirement of module SW or SW-<SUB> is named by a hazard of docs/safety/hazards.json (requirement_ids or a control's control_req_ids) but its hazard_ids does not list that hazard (SWE-052 Table 1 row 2 is bidirectional; 02 section 2.3 tag obligations) |
| HAZARD_REQ_NOT_ON_TARGET | VIOLATION | a hazard-tracing requirement of module SW or SW-<SUB> has status Closed but no Passed closing case of type Bench or OnAir with a credited report citing it (SWE-192 as 01 section 8.6 applies it at SAR: verified through test on the target; Closed is reached only at SAR, charter section 9) |
| REQ_UNVERIFIED | VIOLATION | a Draft or Active requirement has no test case citing it (orphan requirement; 02 T-09) |
| REQ_NO_CLOSING_CASE | VIOLATION | a requirement has test cases but none with the same verification_method (V&V 7.3 rule 2) |
| VERIFIED_WITHOUT_EVIDENCE | VIOLATION | a Verified or Closed requirement has a live closing case that is not Passed (or none), is cited by a Failed case, or has a Passed closing case without a report with credit true and result Pass citing it (V&V 7.3 rule 4; 02 T-11) |
| VERIFIED_WITH_OPEN_NCR | VIOLATION | a Verified or Closed requirement is cited by an NCR whose status is not Closed (V&V 7.3 rule 4) |
| CLOSED_WITHOUT_SAR | VIOLATION | a Closed requirement exists while docs/reviews/SAR/decision-memo.md is absent, or a validation row that depends on it is not Validated (04 section 5.3; 02 T-11) |
| RETIRED_INCONSISTENT | VIOLATION | a retired requirement (status Retired, or status Closed with tag retired until the schema carries Retired, charter section 6) has a child or a citing test case that is not retired or a rationale that does not begin 'Retired by ' (its tbr object is reported as TBR_ON_FINAL_STATUS); the tag retired sits on a status other than Closed; or a retired test case (status Retired, or status Blocked with setup beginning 'Retired by ', 02 section 11.3) has a setup that does not begin 'Retired by ', or cites a live requirement without naming its superseding case ('superseded by TC-...') (02 T-19, T-10) |
| TC_REQ_UNRESOLVED | VIOLATION | a test case cites a requirement id that does not exist (orphan test case; 02 T-10) |
| TC_TYPE_METHOD | VIOLATION | a test case type is not an evidence class of its verification_method: Test = HostUnit, Emulation, Bench; Demonstration = Emulation, Bench, OnAir; Analysis = Simulation; Inspection = Inspection (02 section 4.4, T-10) |
| TC_STATUS_EVIDENCE | VIOLATION | a Passed test case has no report with credit true and result Pass, or a Failed test case has no report with result Fail, while docs/vv/reports exists (V&V section 9; 02 T-11) |
| TC_SETUP_INCOMPLETE | VIOLATION | a Bench or OnAir case lacks instruments or a setup with Article:, Configuration:, Safety: and Environment: (V&V 7.3 rule 7) |
| VAL_TARGET_MISSING | VIOLATION | a TC-VAL case names no OPS-NNN or MOE-NNN after 'Validates:' in its setup, or none of the named targets exists (V&V 7.3 rule 5) |
| VAL_TARGET_UNRESOLVED | VIOLATION | a TC-VAL case names, next to an existing target, an OPS-NNN or MOE-NNN after 'Validates:' that does not exist in docs/conops/conops.md or expectations.json (V&V 7.3 rule 5) |
| EXPECTATIONS_INCONSISTENT | VIOLATION | expectations.json does not have exactly one Need, a Goal's parent is not the Need, an Objective's parent is not a Goal, an MOE ngo_ids entry is not a Goal or Objective, or an ops_ids entry is not a heading of docs/conops/conops.md (02 T-21) |
| TBD_PRESENT | VIOLATION | the word TBD appears in a requirement or test case text field, an expectations.json entry, a table row of docs/icd/ICD-*.md, a table row or OPS-NNN scenario section of docs/conops/conops.md, or a table row of docs/plan/semp.md; in Markdown a mention of the policy terms ('TBD and TBR', 'TBD/TBR', '`TBD`', 'no TBD') is not a placeholder (charter section 7: no TBD in a baselined document; 01 section 12.2; 02 T-14) |
| TBR_UNDOCUMENTED | VIOLATION | the word TBR appears in a requirement without a tbr object |
| TBR_UNMARKED | VIOLATION | a tbr object is present but the description does not carry '(TBR)' after the estimated value (02 rule WR-12, T-14) |
| TBR_ON_FINAL_STATUS | VIOLATION | a tbr object is present while status is Verified, Closed or Retired (02 rule T-14; a Draft or Active requirement may carry an open TBR, charter section 7) |
| TBR_CLOSE_BY | VIOLATION | tbr.close_by is later than PDR for SYS or later than CDR for other modules (charter section 7) |
| SHALL_COUNT | VIOLATION | a requirement description does not contain exactly one shall (SE HB Appendix C; 02 T-17) |
| MODAL_IN_DESCRIPTION | VIOLATION | a requirement description contains a WR-07 group A modal verb (will, should, must, may, can, might); goals belong in the rationale |
| SHALL_IN_TITLE | VIOLATION | a requirement title contains shall (02 rule WR-14, T-17) |
| NCR_FRONT_MATTER | VIOLATION | an NCR file has no YAML front matter or no id |
| NCR_ID_FORMAT | VIOLATION | an NCR id does not match NCR-NNN or differs from its file name |
| NCR_UNRESOLVED | VIOLATION | an NCR cites a requirement, test case or hazard that does not exist (V&V 7.3 rule 8) |
| NCR_ARTIFACT | VIOLATION | an artifact listed in an NCR is missing, malformed or its SHA-256 differs (V&V 7.3 rule 8) |
| NCR_NO_REQUIREMENT | VIOLATION | an NCR with classification product (or no classification) and severity other than S4 cites no requirement in requirement_ids; the message lists the requirements of its test cases (SWE-052 Table 1 row 6; 04 section 10.3: an S4 NCR cites a requirement only when the defect affects it) |
| NCR_FIELD_INVALID | VIOLATION | an NCR severity is not S1, S2, S3 or S4 (SWE-202; 04 section 10.3), its status is not Open, Analysis, Dispositioned, Retest or Closed (04 section 10.7), or its classification is not product or procedure (docs/templates/ncr.md) |
| REPORT_FRONT_MATTER | VIOLATION | a report file has no YAML front matter or no test_case |
| REPORT_ID_FORMAT | VIOLATION | a report file name is not <test_case>-r<run>.md for its front matter |
| REPORT_UNRESOLVED | VIOLATION | a report cites a test case, requirement, validation target or NCR that does not exist or is not cited by its case (V&V 7.3 rule 8) |
| REPORT_ARTIFACT | VIOLATION | an artifact listed in a report is missing, malformed or its SHA-256 differs (V&V 7.3 rule 8) |
| SOURCE_FILE_MISSING | WARNING | an upstream artifact (stakeholder inputs, expectations, ConOps, ADRs, trade studies, regulatory corpus, tpm.json) is absent, so its ids cannot be resolved yet |
| HAZARD_FILE_MISSING | WARNING | docs/safety/hazards.json is absent, so hazard ids cannot be resolved yet |
| RISK_FILE_MISSING | WARNING | docs/risk/register.json is absent, so the RSK-NNN named by an 'Analysis accepted per RSK-NNN' note cannot be resolved yet |
| REPORTS_DIR_MISSING | WARNING | docs/vv/reports is absent, so Passed, Failed and Verified statuses are checked against case status only |
| SOURCE_FORMAT_UNKNOWN | WARNING | a source id or measure id matches no known identifier scheme |
| STAKEHOLDERS_MISSING | WARNING | expectations.json has no stakeholders array or an empty one, no entry of role customer, user or regulator, a stakeholder name used twice, or a stakeholder source_ids entry that does not resolve (02 section 3.0; T-21 and the stakeholder part of T-03; plain-run Warning before SRR, Error under --gate; the schema requires the array once baseline is set) |
| SYS_UNALLOCATED | WARNING | a Draft or Active SYS requirement names no receiving L2 module: no child_ids entry or parent_id child is a live requirement of an L2 module (RX, TX, PWR, CTL, ME, SW, SW-<SUB>), and docs/design/allocation.json lists it under no L2 module; each gap is listed for the reviewer to confirm or correct in V6 (02 section 2.3, T-18: Warning at SRR, Error from PDR under --gate) |
| MOP_UNRESOLVED | WARNING | a mop_ids entry names no id in docs/plan/tpm.json mops[] or tpms[] (02 T-16; Error from PDR under --gate) |
| INTERFACE_TAG_NO_ICD | WARNING | a requirement tagged interface has no ICD-<A>-<B> id in design_refs (02 section 3.5, T-22; Error from PDR under --gate) |
| DESCRIPTION_LENGTH | WARNING | a requirement description exceeds 25 words |
| UNVERIFIABLE_WORD | WARNING | a requirement description uses a WR-07 group B word (unverifiable or ambiguous; SE HB Appendix C) |
| FAILED_TC_WITHOUT_NCR | WARNING | a Failed test case has no NCR citing it (charter section 9) |
| HAZARD_INVERSE | WARNING | hazards.json and a requirement disagree about which requirements control a hazard, or a hazard's requirement_ids is not the union of its controls' control_req_ids |
| MOE_WITHOUT_OPS | WARNING | an MOE has no ops_ids entry while docs/conops/conops.md exists (02 T-20) |
| CORE_SI_UNCOVERED | WARNING | a bold (core) SI row is cited by no SYS requirement; evaluated once at least one requirement exists (02 section 3.1, T-20) |
| OBJECTIVE_UNCOVERED | WARNING | a Baselined Objective is cited by no SYS requirement and no MOE; evaluated once at least one requirement exists (02 T-20) |
| RENDER_STALE | WARNING | a rendered expectations.md or requirements.md beside its JSON is absent, was not generated by --render, or differs from the rendering of the current JSON (02 section 8.1; charter section 5 rendered .md) |
| OPS_UNCITED | WARNING | an OPS-NNN heading is cited by no requirement source_ids and no TC-VAL case; evaluated once at least one requirement exists (02 T-20) |
