robinonsay/cwht/docs/design/concept.md

# cwht Concept Description (SRR)

**Status:** Draft for SRR (concept definition, NPR 7123.1D SE-36; the ConOps `docs/conops/conops.md` is the operational view, this document is the technical view). **Owner:** Robin (Decision Authority). **Author:** Claude (lead systems engineer). **Governing text:** SE HB §4.3 (Logical Decomposition), §4.4 (Design Solution Definition), §6.8 (Decision Analysis); NPR 7123.1D App. G Table G-3 items 3.2 (concept feasibility), 5.2 (alternative concepts), 5.4 (descope options), 5.10 (single point failure and fault tolerance philosophy) and Table G-4 items 6.1 (updated concept definition), 6.11 (external interfaces); `docs/process/01-lifecycle-and-reviews.md` §4.3 rows 4, 5, 6, 7, 17. **Successor at PDR:** `docs/design/architecture.md` and `docs/design/allocation.json` (allocated baseline, SE-41, SE-42). **Revision:** 2 of 2026-09-26, the owner's SRR rulings of 2026-09-26 applied, in the functional baseline `baseline/srr`; revision 3 of 2026-09-27 is proposed by CR-009 and is not in the baseline until that CR is approved and merged (revision history below).

Conventions. Every number in this document is one of: an owner decision (marked with its `SI-NNN`), a research baseline the owner ratified at SRR on 2026-09-26 (marked `[Ratified, SRR package decision N]`, where N is the decision number of `docs/reviews/SRR/decisions-for-owner.md` Part 1; the owner ruled every decision as its Recommendation cell, `docs/reviews/SRR/minutes.md`), or a value that may still move (marked `(TBR, close by PDR)`). A `[Proposed, confirmed by the architecture ...]` marker names a design choice that no SRR decision fixes and that the architecture at PDR confirms. Where this document and `docs/requirements/sys/requirements.json` differ, the requirements file wins and this document is corrected. Research reports are cited as `docs/research/<file>.md F<n>`. Regulatory text is cited from the corpus in `docs/references/md/regulatory/` (eCFR 2026-09-23). No design is inherited from a reference without re-analysis (SEMP §7.5).

**Revision history.**

| Revision | Date | Change |
|---|---|---|
| 1 | 2026-09-25 | First issue for SRR, with the updates for peer review record INSP-002 (`docs/reviews/SRR/checklists/conops-and-concept.md`) |
| 2 | 2026-09-26 | INSP-002 finding-24 (Major) applied, SRR package item R16: the owner's SRR rulings of 2026-09-26 applied to the concept. Carrier range 144.0012 to 147.9988 MHz (TBR) with the 1.2 kHz guard in F2.1, F4.3, sections 7.4, 11.1, 11.2 and 14 (decision 25; REQ-SYS-008, REQ-SYS-009); stuck-key set in F3.6, section 8 and section 14 changed to the manual-closure timeout with the Bug-mode dah, the no-gap paddle watchdog of REQ-SYS-054 and the 2 s squeeze limit of REQ-SYS-184 (decision 37); the transmission-length backstop, the hardware over-temperature cut-off and the independent frequency verification added to section 4 and section 8 (decisions 38 to 40; REQ-SYS-180 to REQ-SYS-182), with a section 8 row for an off-frequency carrier; the Bench-test guard in section 4.1 (decision 41; REQ-SYS-187 to REQ-SYS-190); each of the 16 revision 1 markers of a proposal awaiting the owner's SRR decision (the convention paragraph and 15 values) replaced by the ruled decision number; section 14 records the ruling of each item. The section 5 Mermaid block carries no value the rulings changed, so the render is unchanged |
| 3 | 2026-09-27 | CR-009 (proposed; PDR work package WP-PDR-10), SRR peer review record INSP-002 finding-26: section 15 no longer calls the performance values of sections 7 and 14 "the proposed L1 values"; they are L1 values marked as owner decisions, SRR rulings with their decision numbers, or TBR values that close at PDR, as the conventions paragraph states. Wording only; no value, block, function or allocation changes, and the section 5 render is unchanged |

---

## 1. Purpose and scope

This document gives the owner and the SRR board one place that states what the radio is, how it is decomposed into functions and subsystems, which interfaces will be controlled, which alternatives are still open and how they will be closed at PDR, what can be descoped, and which enabling products the project depends on. It demonstrates concept feasibility at the level Table G-3 item 3.2 asks for: every block is a catalog part or a published circuit practice, every performance number has a research basis, and every open choice has a trade study with criteria.

It does not select parts beyond the owner's decisions and the research baselines, does not allocate requirements (that is `allocation.json`, preliminary at SRR), and does not replace the hazard analysis (`docs/safety/hazard-analysis.md`) or the risk register (`docs/risk/register.json`).

## 2. Need and driving expectations

The owner needs a pocket-sized handheld true-CW (A1A) transceiver for the full US 2 m band, 144.000 to 148.000 MHz, with 5 W output, a built-in keyer for a straight key and an iambic paddle, headphones, a small display and knob tuning, that works at first power-on and can be handed to licensed friends (SI-001 to SI-006, SI-018, SI-019, SI-024, SI-030). The five critical questions of the SEMP §3.0 shape the concept: regulatory harmonic margin, receiver sensitivity in a pocket form factor, rustos driver extension at Class A rigor, keyer timing for both key types, and battery life, mass and heat in the handheld envelope.

Binding owner decisions that constrain the concept (each is a `CON-NNN` in `expectations.json` and an ADR): 2 m only in rev A with a 70 cm-ready architecture (SI-002); true CW at 5 W (SI-003, SI-004); Raspberry Pi Pico 2 module with its micro-USB for programming and charging (SI-007, SI-022); 2S 18650 cells in holders (SI-023); rotary encoder tuning (SI-006); PCBWay turnkey SMT with owner-soldered through-hole parts (SI-009, SI-031); PCBWay CNC aluminum enclosure from OpenSCAD via FreeCAD STEP (SI-008, SI-032); straight key and iambic paddle through one 3.5 mm TRS jack (SI-018, SI-034); semi break-in only, no full QSK (SI-036); PA device stocked at DigiKey, Mouser or a PCBWay turnkey distributor, no consignment-only parts (SI-028); synthesizer by cost-performance trade at PDR (SI-029); all operators licensed, Technician or higher (SI-030); host-first software verification through the rustos `api` traits with dependency injection, emulation optional and never for timing (SI-026); keyer speed 5 to 50 WPM (SI-033); battery life 8 h at 1:9 TX:RX (SI-034); tinySA Ultra purchased (SI-034); MIT open source (SI-025).

## 3. System context and boundary

| Across the boundary | Interaction | Controlled by |
|---|---|---|
| Antenna and the RF environment | 50 ohm port; 144 to 148 MHz emission and reception; harmonic and spurious emission limits (47 CFR 97.307(e)); other amateur stations | `ICD-TX-ANT`; `REQ-TX-*` tagged `regulatory` |
| Straight key or iambic paddle | Two switch contacts to ground on a 3.5 mm TRS plug (tip dit or hand key, ring dah, sleeve common); mono plugs occur in the field | `ICD-CTL-KEY` |
| Headphones (16 to 64 ohm, TS or TRS plug) | Monophonic audio on both channels; hardware level ceiling; plug detect | `ICD-CTL-PHONES` |
| USB host or charger | 5 V through the Pico 2 micro-USB: firmware load (bootrom UF2), charge power at 500 mA default, optional serial trace | `ICD-CTL-USB`, `ICD-SW-HOST` |
| 18650 cells | Two user-replaceable cells in series, 6.0 to 8.4 V | `ICD-PWR-CELL` |
| Operators | Licensee as station licensee and control operator (OPS-A); licensed friends operate loaned units as their own stations; unlicensed guests listen only or key as third parties under supervision at the 0.5 W and 1 W steps; a licensee-settable receive-only guest lock with a two-step release exists `[Ratified, SRR package decisions 17, 19 (option a) and 20]` | `docs/conops/conops.md`; `docs/research/regulatory-corpus-and-operators.md` F4, F5 |
| Bystanders | RF exposure: operator in the occupational tier with exposure information in the manual; persons other than the operator at 0.6 m or more while keying and 1.0 m or more during a tune carrier; evaluation per OET 65 Supplement B presented by Analysis `[Ratified: verification of REQ-SYS-121 by Analysis, SRR package decision 30; exposure posture, SRR package decision 31]` | `docs/research/rf-exposure-evaluation.md` F2, F3, F7; RFX evaluation product at PDR |
| Vendors | PCBWay fabrication, turnkey assembly and CNC; DigiKey or Mouser for parts PCBWay does not source | CDR procurement package |

Environment: handheld and table-top use outdoors; operating ambient -10 C to +45 C (REQ-SYS-114, TBR, close by PDR; `docs/plan/tpm.json` TPM-006 carries the same span), bounded by the -10 to +60 C display window, the encoder rating and the TCXO range (`docs/research/display-and-ui-parts.md` F2, F12); charging 0 to 45 C; light rain when upright with plugs inserted, quantified as 10 min of IEC 60529 IPX2 dripping water (REQ-SYS-117, TBR, close by PDR), with the USB opening, jacks and encoder bushings unsealed (not water resistant). 40 C is the ambient of the PA thermal analysis case (section 7.8), not the operating limit.
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
