robinonsay/cwht/docs/templates/peer-review-checklist-design.md

---
# Peer-review record front matter (charter section 5; docs/process/07-software-engineering-plan.md
# section 10.2). To review a product, copy this whole file to
# docs/reviews/<REVIEW>/checklists/<product-slug>.md: that copy is the single peer-review record
# (there is no peer-reviews/ folder). Fill every field below, answer every applicable checklist item and
# fill the findings table. Both front-matter parsers (PyYAML and the subset parser of
# tools/validate_docs.py) strip a comment on its own line and a comment written after a value
# (" # ..."); this template keeps each comment on its own line for readability, and comment lines
# may stay or be deleted when filing. tools/validate_docs.py checks the record against the field
# list of docs/process/01-lifecycle-and-reviews.md section 13 (its PEER_REVIEW_RECORD_SCHEMA) and
# fails while the id, checklist_file, product_commit or date placeholder is left in place.
# Search first: 'grep' in an evidence column means: run mcp__claude-context__search_code on
# /Users/robinonsay/rust/cwht first (charter section 11 rule 1), then grep -n only to pin the hit.
#
# id: next free INSP-NNN (never reused, charter section 6)
id: INSP-NNN
checklist: peer-review-checklist-design
checklist_revision: B
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
