robinonsay/cwht/docs/cm/tool-validation/evidence/render-review-figures-fixture-concept-block-diagram.png

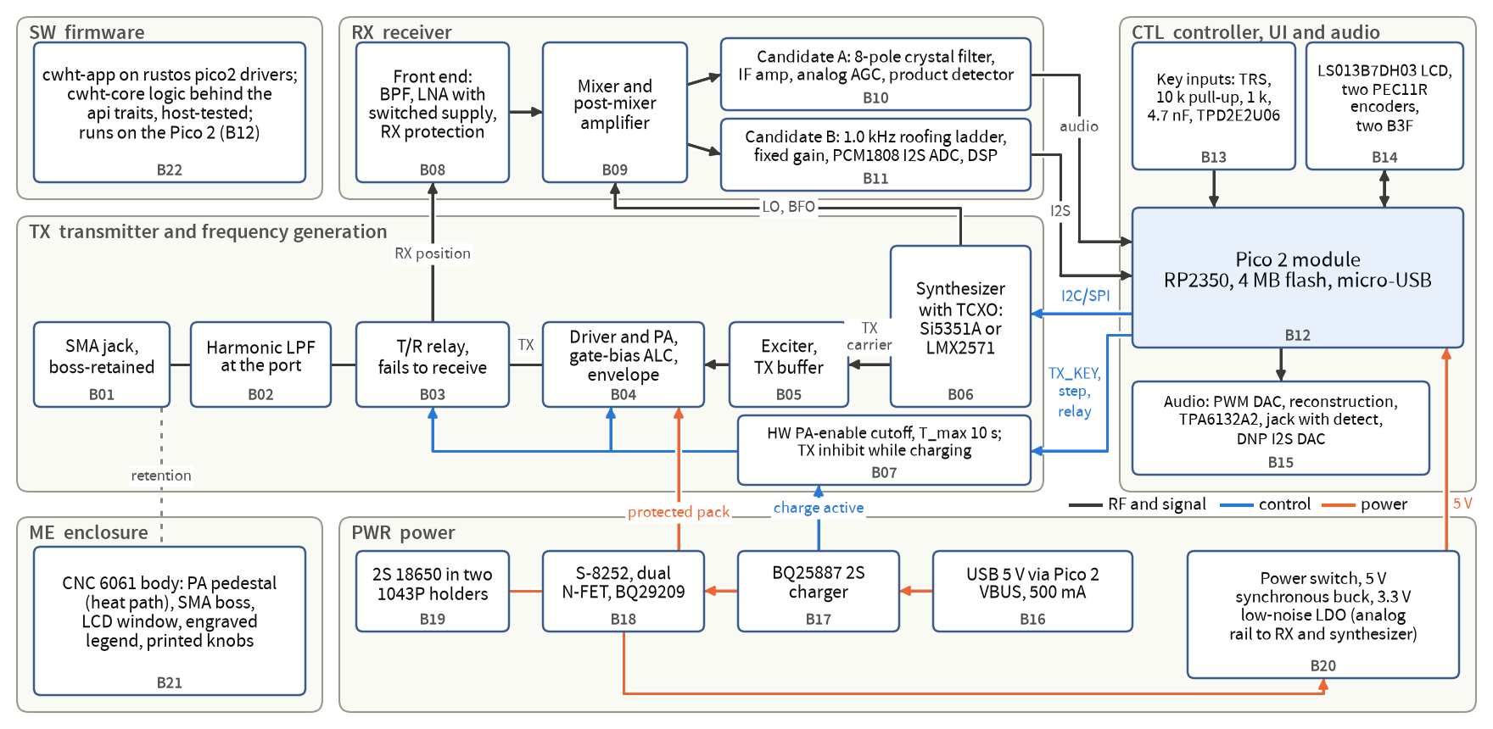
docs/cm/tool-validation/evidence/render-review-figures-fixture-concept-block-diagram.png
