robinonsay/cwht/docs/cm/tool-validation/evidence/render-review-figures-fixture-requirements-by-group.png

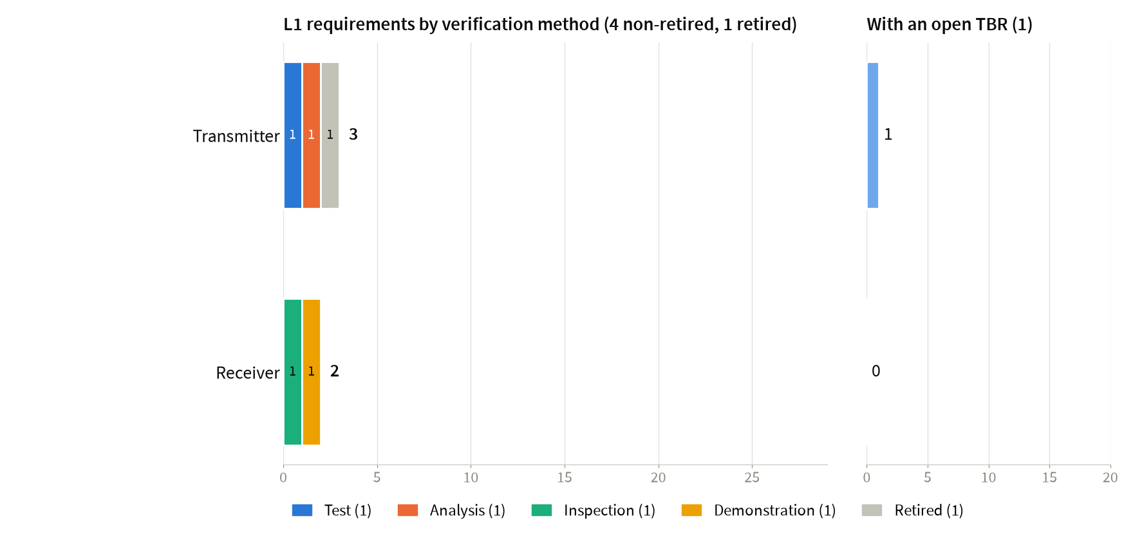
docs/cm/tool-validation/evidence/render-review-figures-fixture-requirements-by-group.png
