robinonsay/cwht/docs/design/analysis/keyer-host-study/keyer-nogap-fault-coverage.png

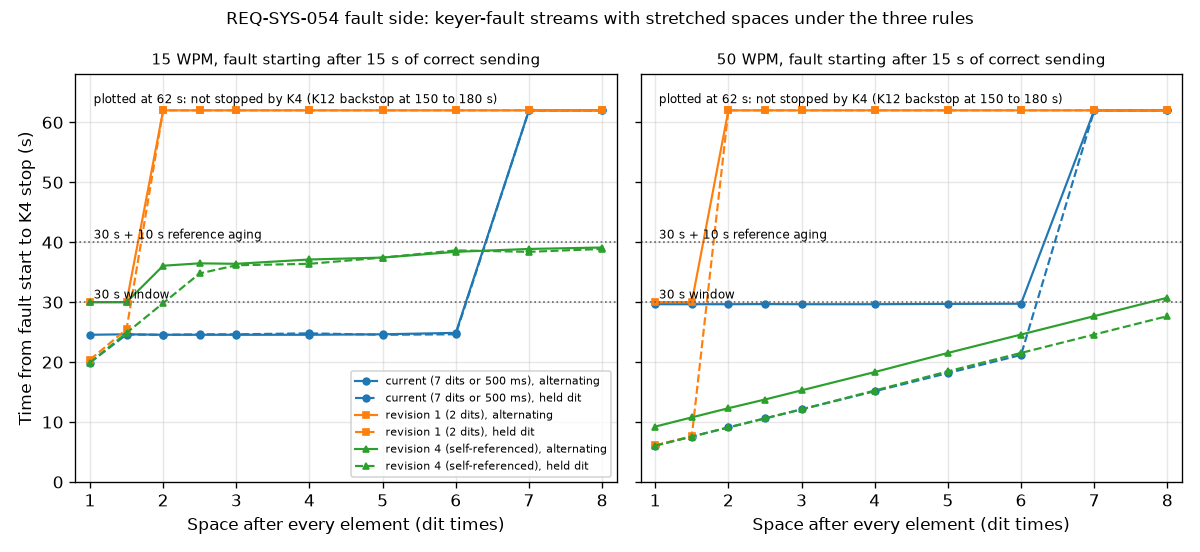
docs/design/analysis/keyer-host-study/keyer-nogap-fault-coverage.png
