robinonsay/cwht/docs/design/analysis/keyer-host-study/keyer-nogap-short-interval.png

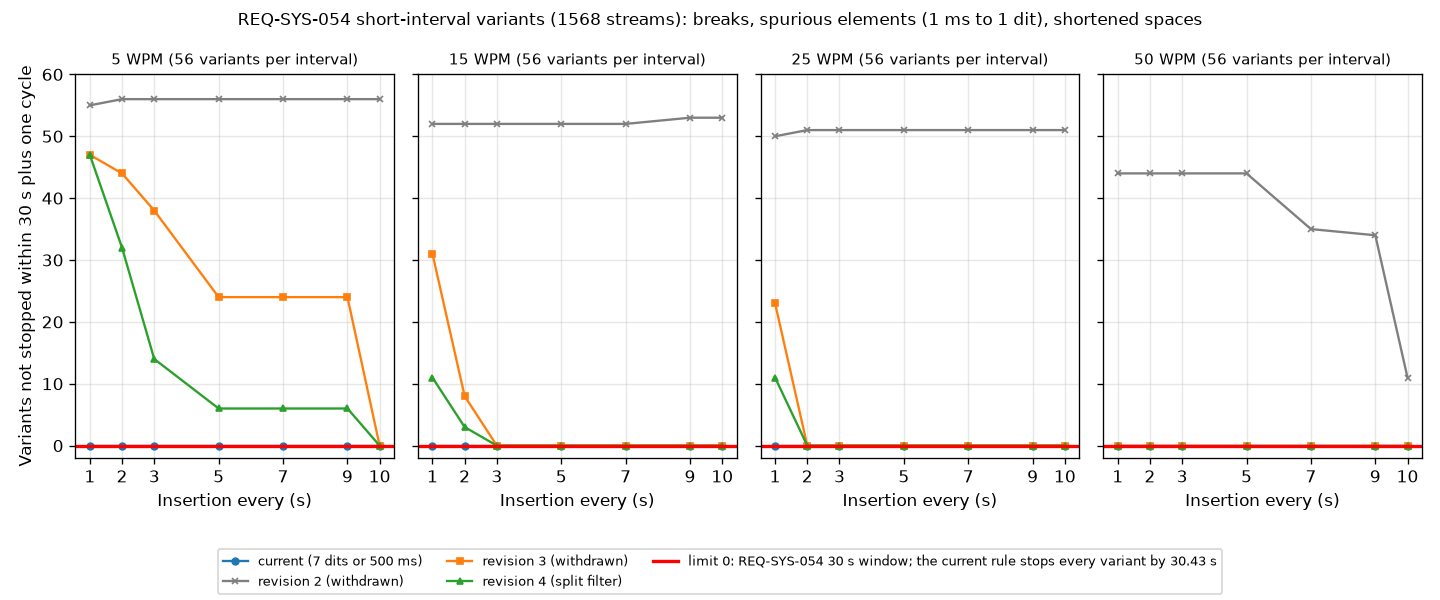
docs/design/analysis/keyer-host-study/keyer-nogap-short-interval.png
