robinonsay/cwht/docs/design/analysis/keyer-host-study/keyer-nogap-vs-speed.png

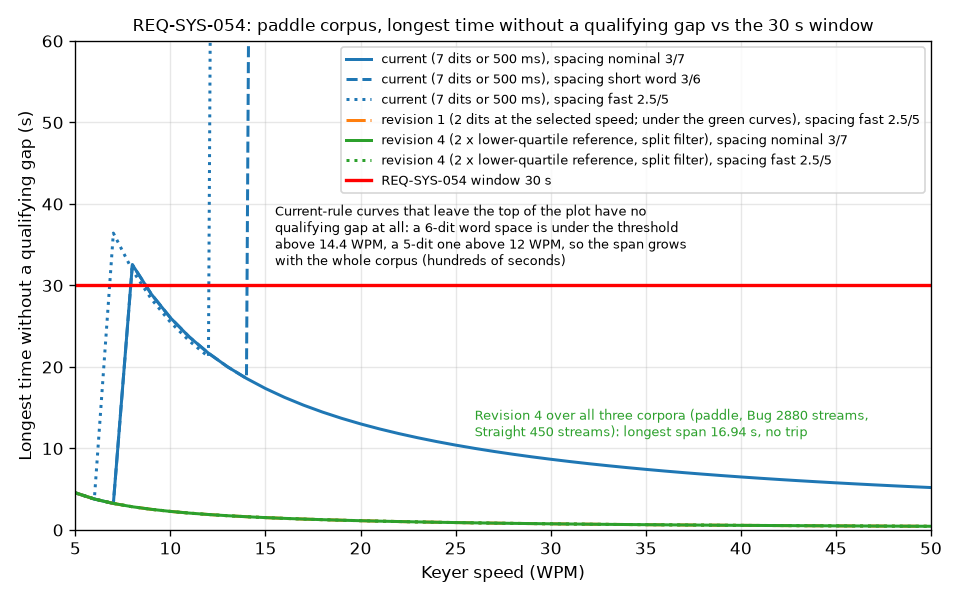
docs/design/analysis/keyer-host-study/keyer-nogap-vs-speed.png
