robinonsay/cwht/docs/design/analysis/keyer-host-study/keyer-squeeze-timeline.png

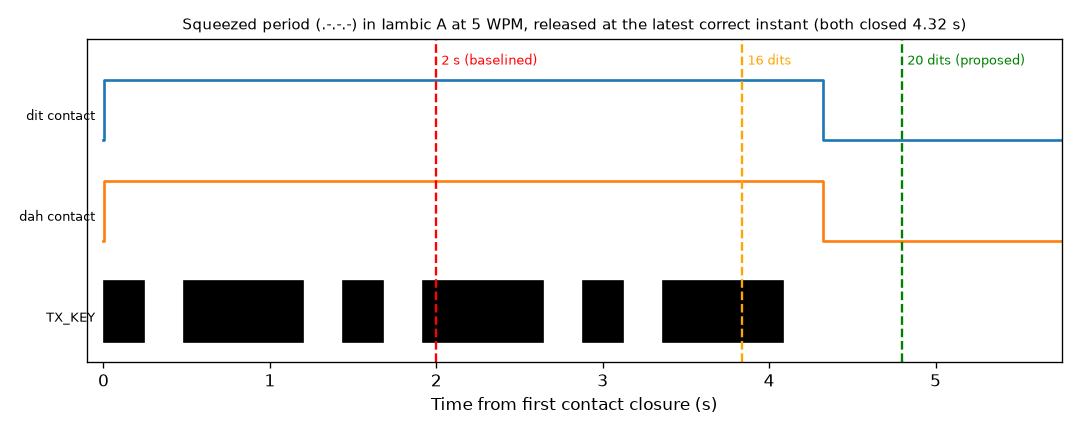
docs/design/analysis/keyer-host-study/keyer-squeeze-timeline.png
