robinonsay/cwht/docs/design/analysis/keyer-host-study/keyer-squeeze-vs-speed.png

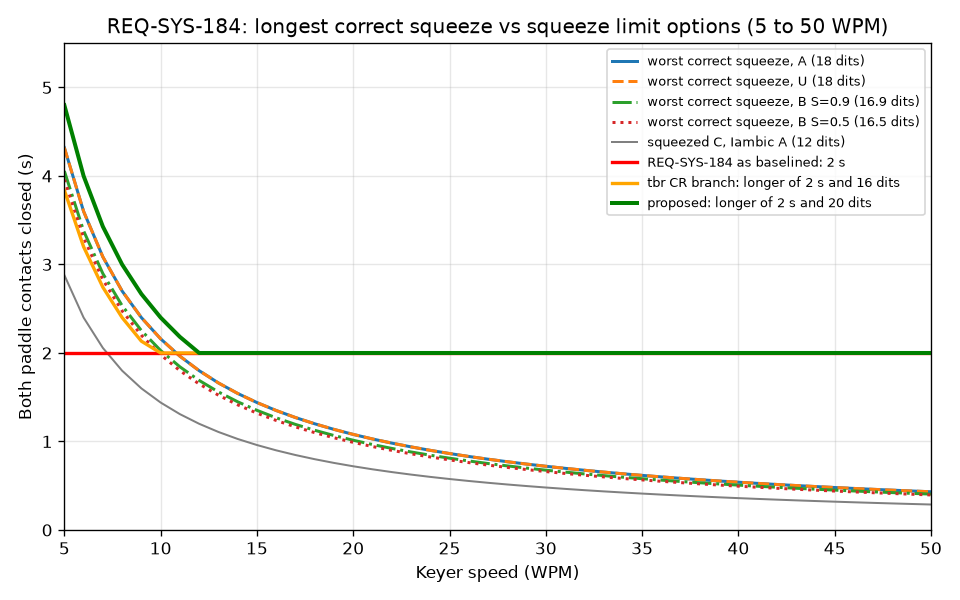
docs/design/analysis/keyer-host-study/keyer-squeeze-vs-speed.png
