robinonsay/cwht/docs/research/figures/cw-selectivity/mc_4p_500_tight10.png

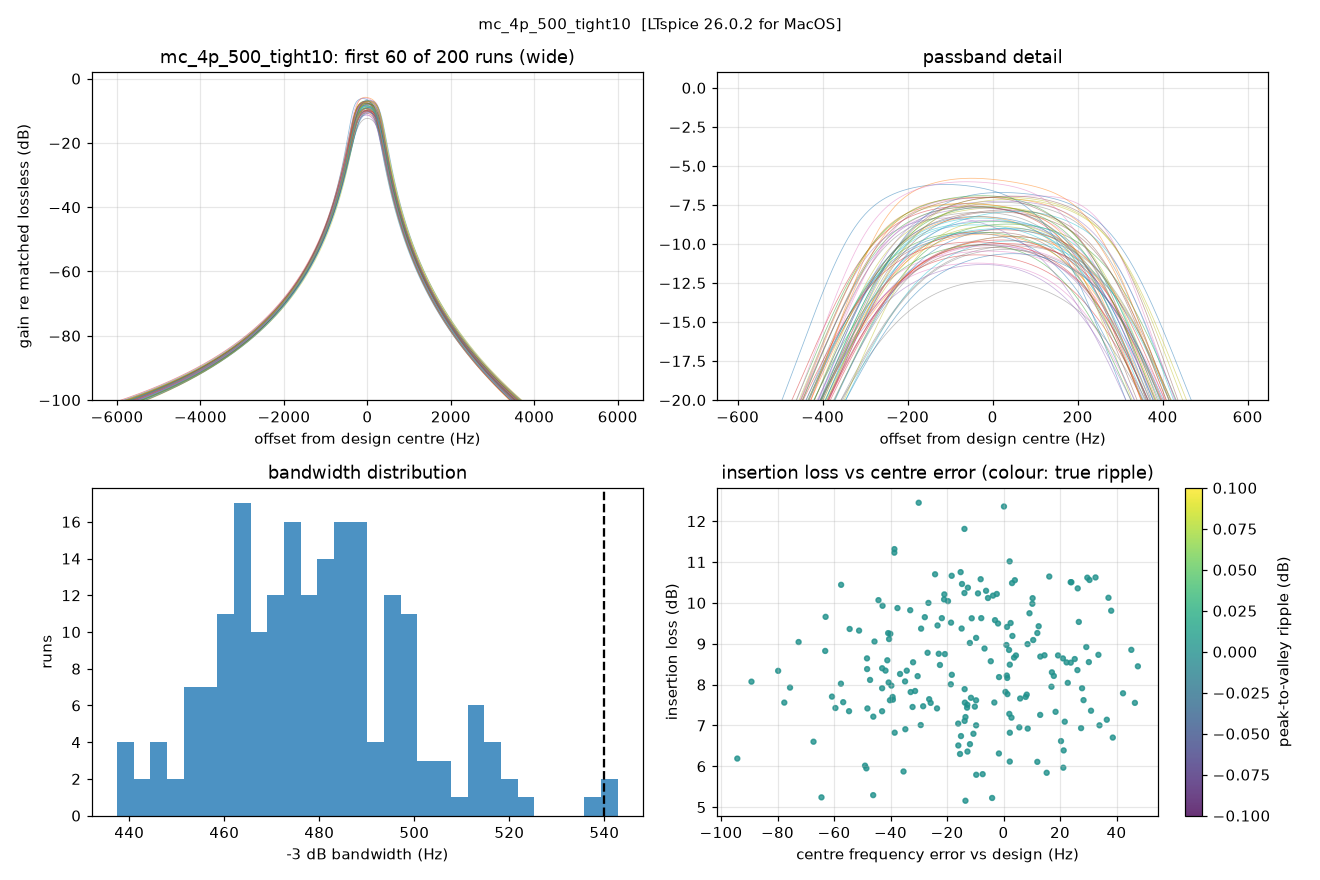
docs/research/figures/cw-selectivity/mc_4p_500_tight10.png
