robinonsay/cwht/docs/research/figures/cw-selectivity/n4_500_rs10.png

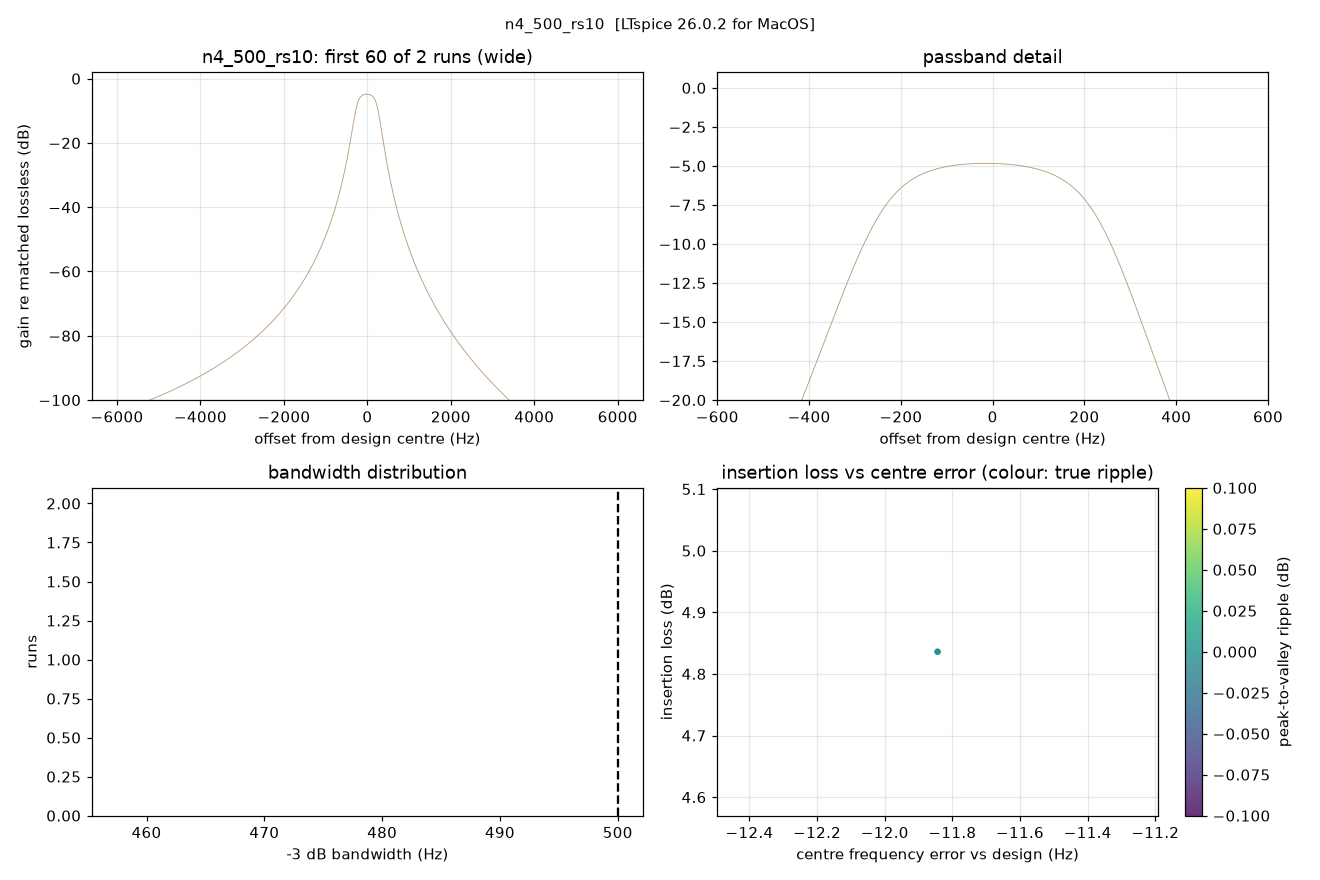
docs/research/figures/cw-selectivity/n4_500_rs10.png
