robinonsay/cwht/docs/research/figures/cw-selectivity/n4_500_rs40.png

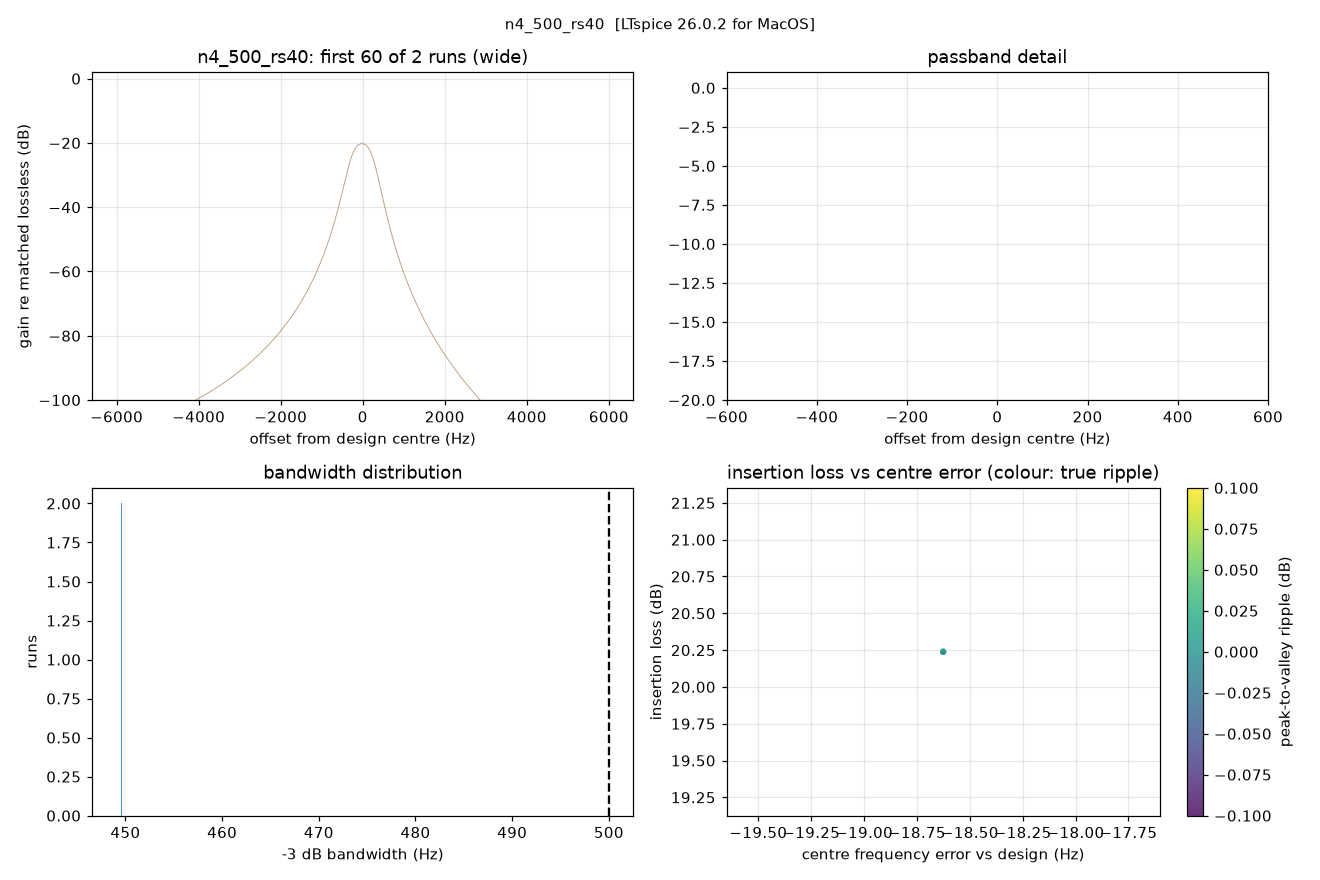
docs/research/figures/cw-selectivity/n4_500_rs40.png
