robinonsay/cwht/docs/reviews/PDR/figures/display-layout-cal-trim.png

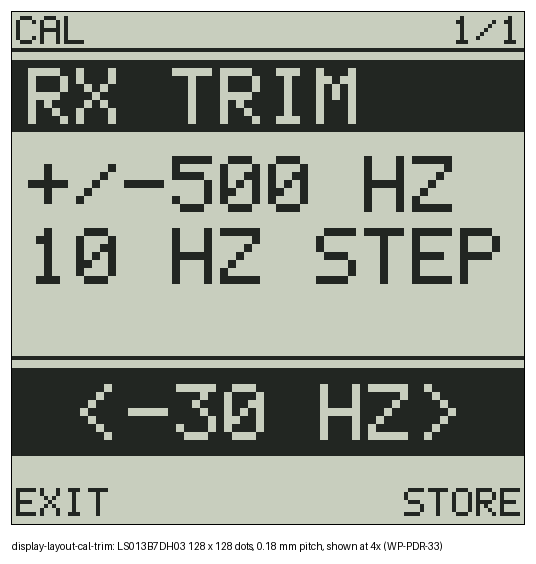
docs/reviews/PDR/figures/display-layout-cal-trim.png
