robinonsay/cwht/docs/reviews/PDR/figures/display-layout-key-inhibit.png

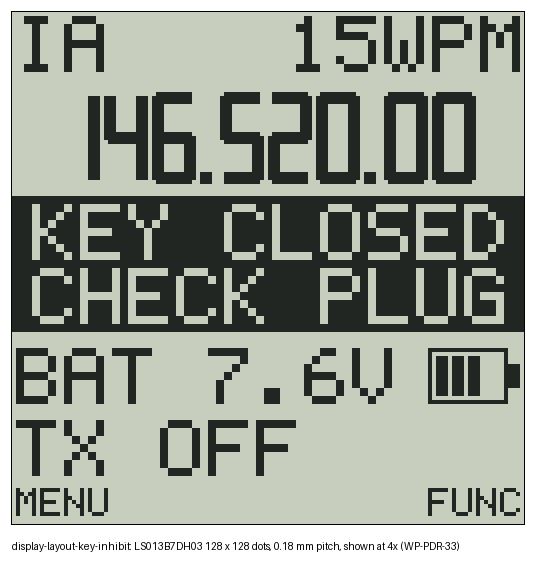
docs/reviews/PDR/figures/display-layout-key-inhibit.png
