robinonsay/cwht/docs/reviews/PDR/figures/display-layout-receive.png

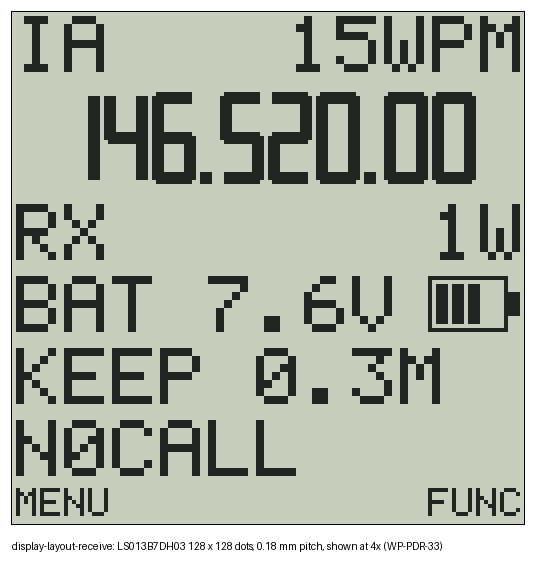
docs/reviews/PDR/figures/display-layout-receive.png
