robinonsay/cwht/docs/reviews/PDR/figures/drop-and-axial.png

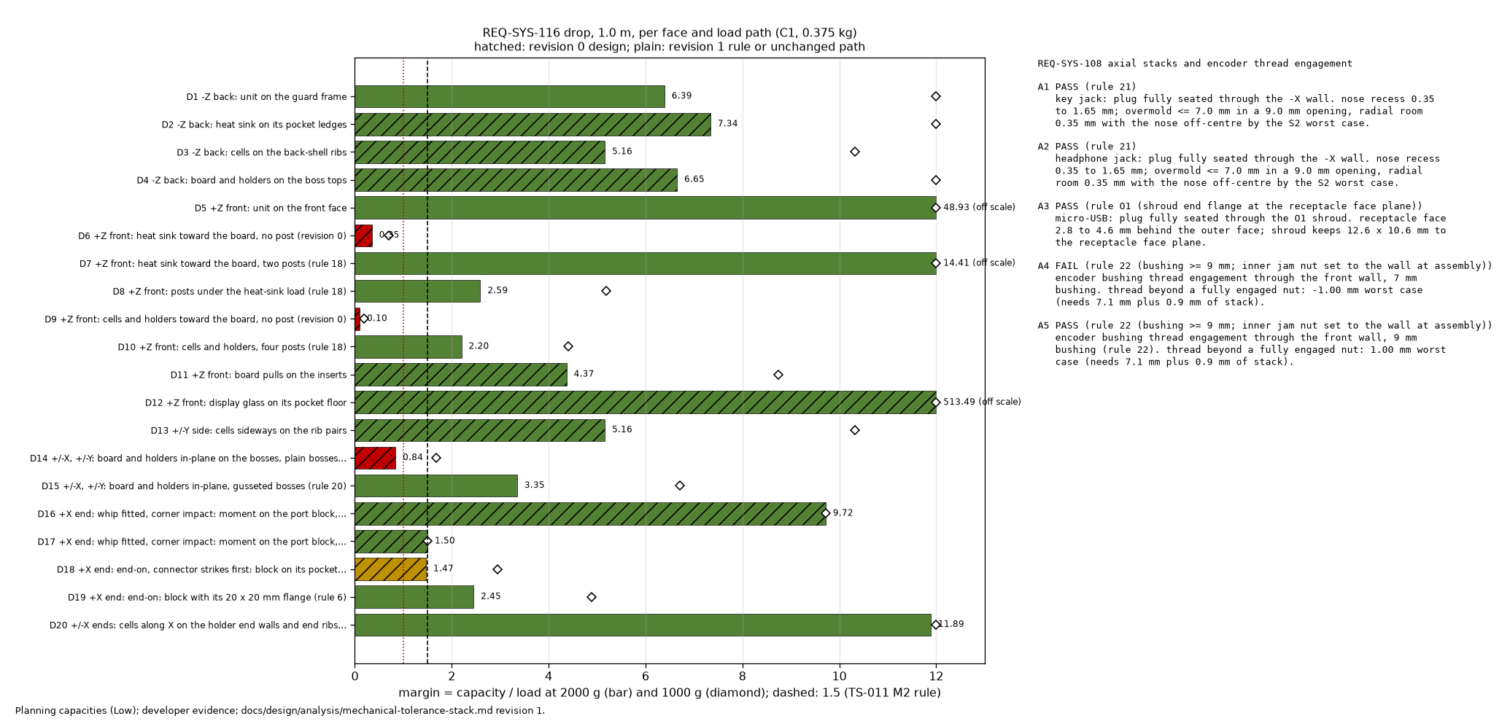
docs/reviews/PDR/figures/drop-and-axial.png
