robinonsay/cwht/docs/reviews/PDR/figures/tolerance-stack.png

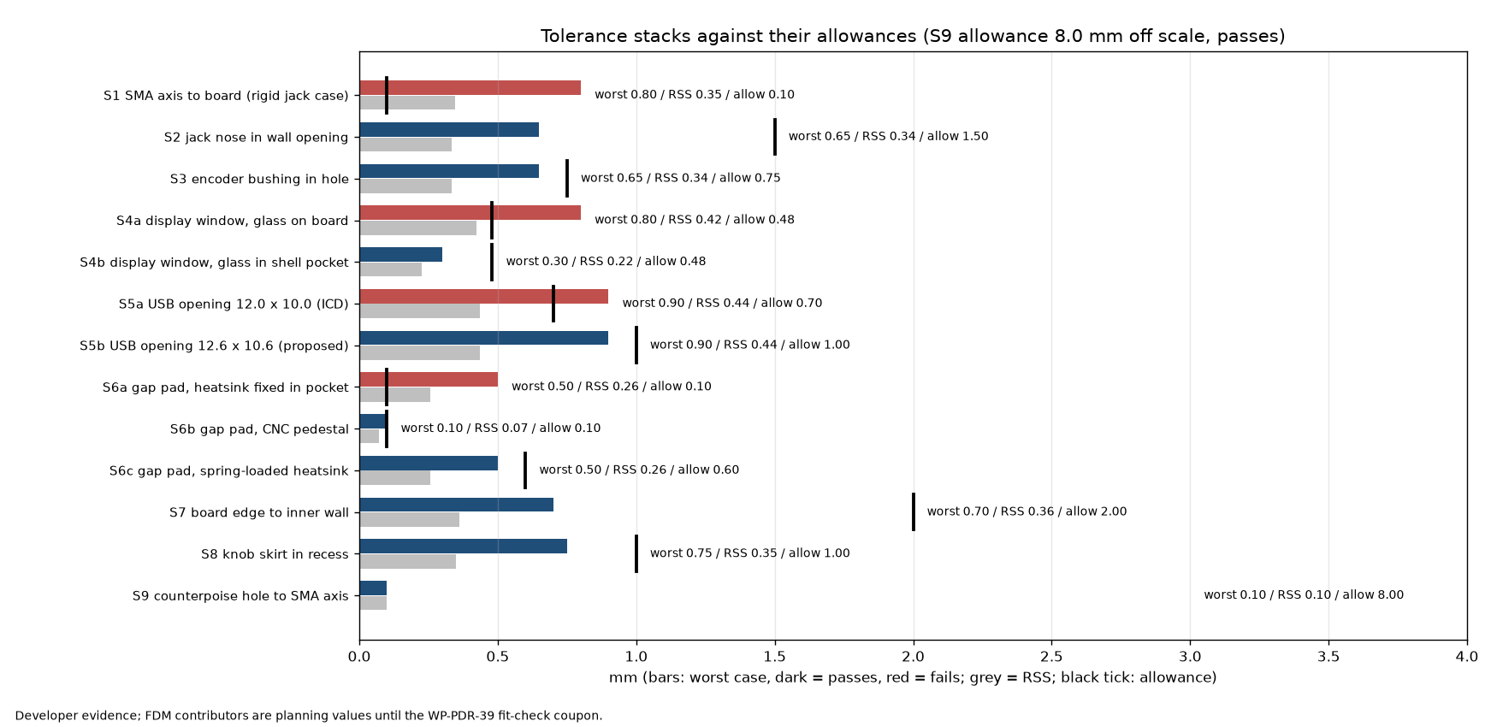
docs/reviews/PDR/figures/tolerance-stack.png
