robinonsay/cwht/docs/reviews/PDR/figures/ts011-board-field-thermal.png

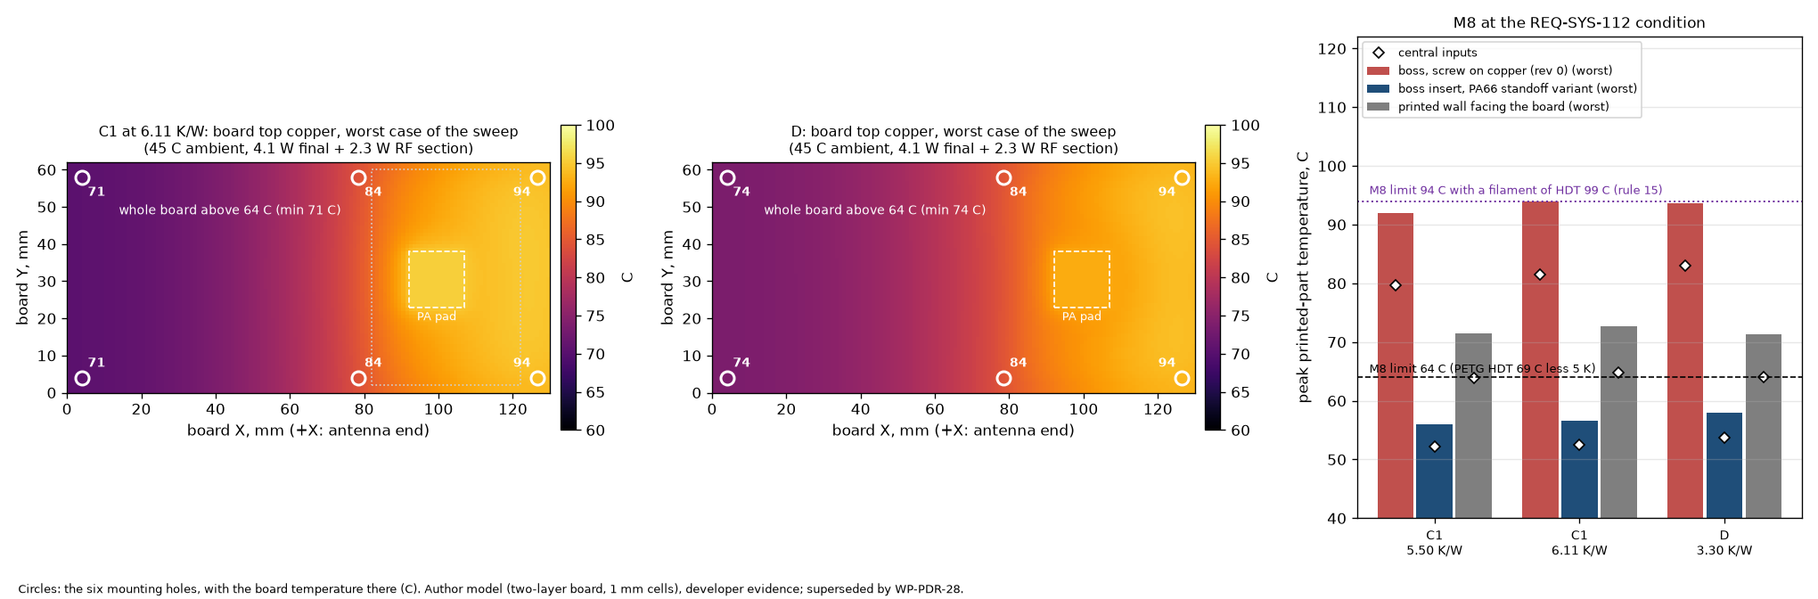
docs/reviews/PDR/figures/ts011-board-field-thermal.png
