robinonsay/cwht/docs/reviews/SRR/figures/concept-block-diagram.png

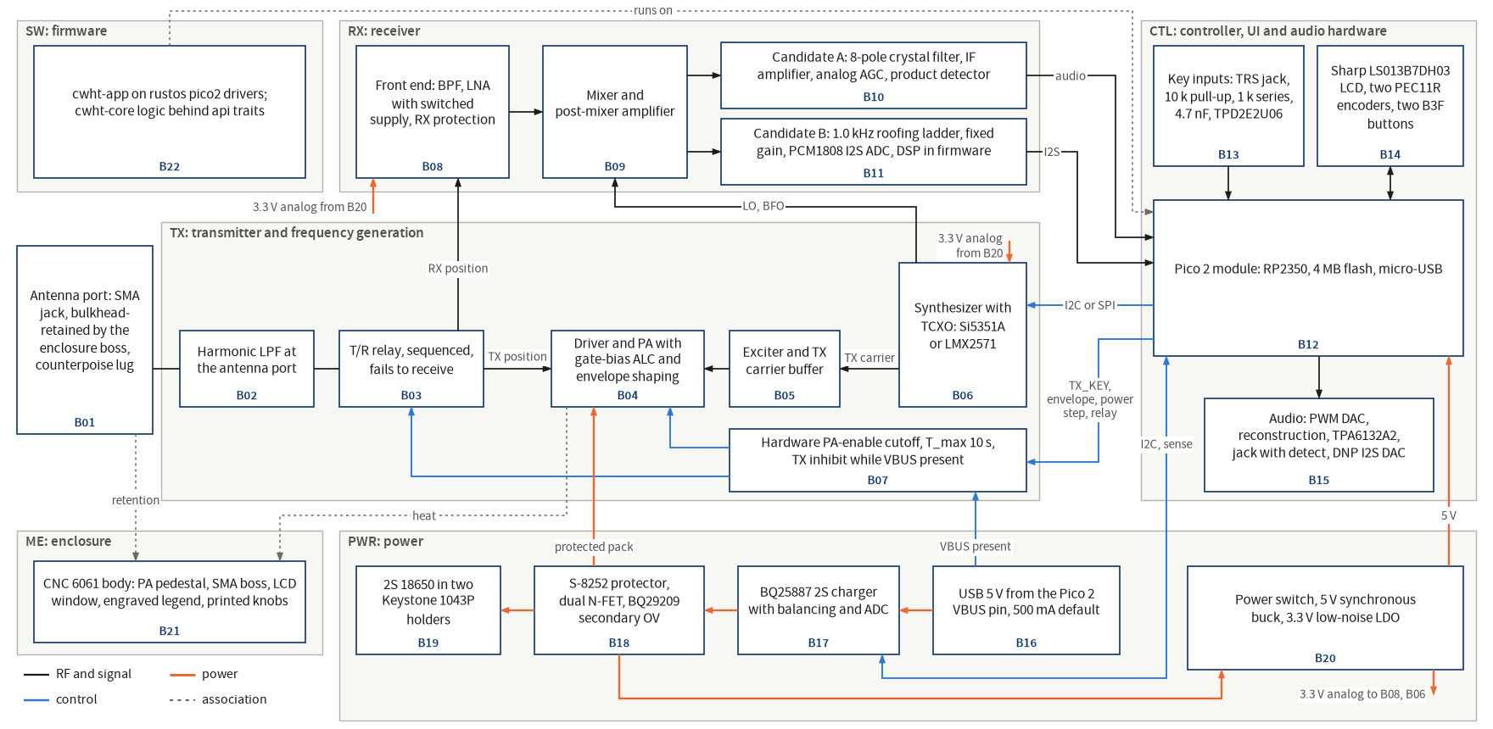
docs/reviews/SRR/figures/concept-block-diagram.png
