robinonsay/cwht/docs/reviews/SRR/figures/requirements-by-group.png

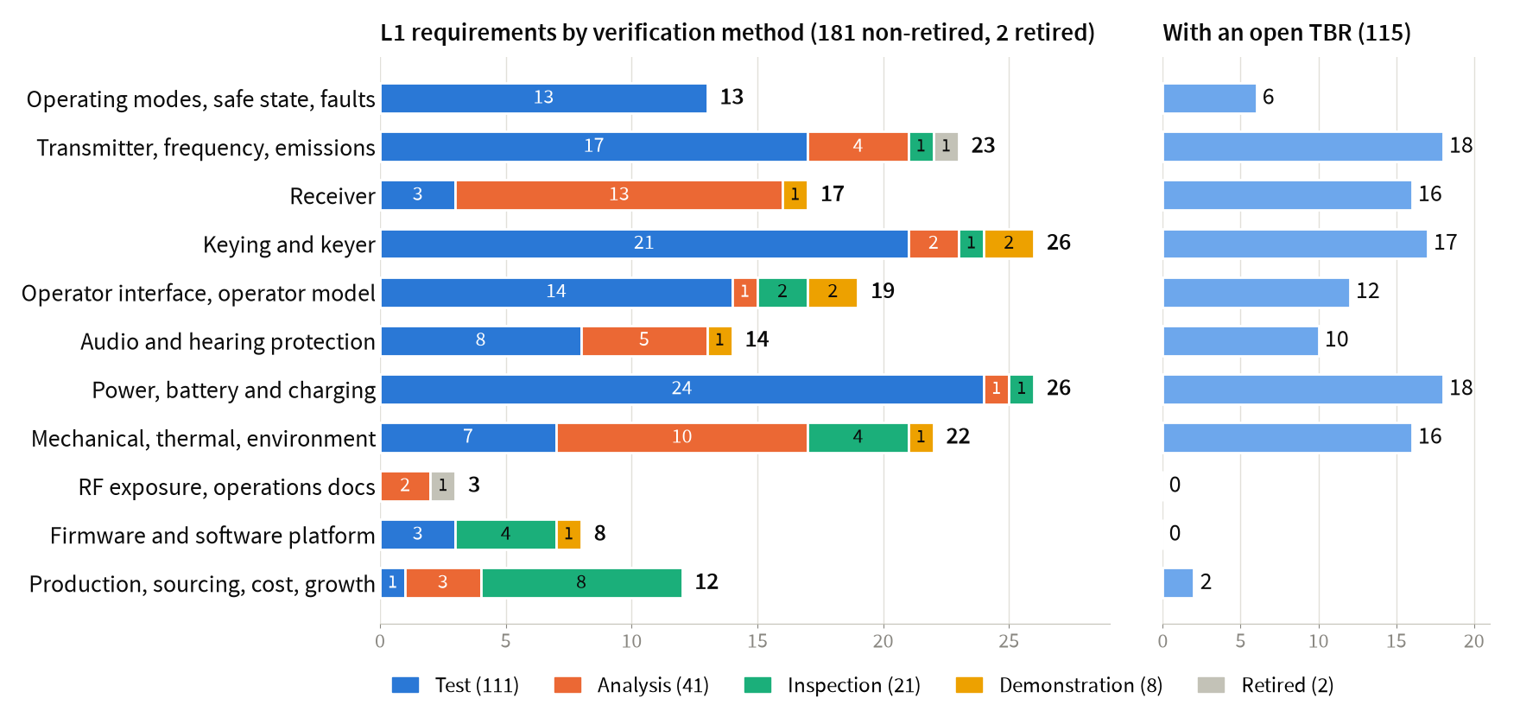
docs/reviews/SRR/figures/requirements-by-group.png
