robinonsay/cwht/docs/reviews/SRR/figures/success-criteria.png

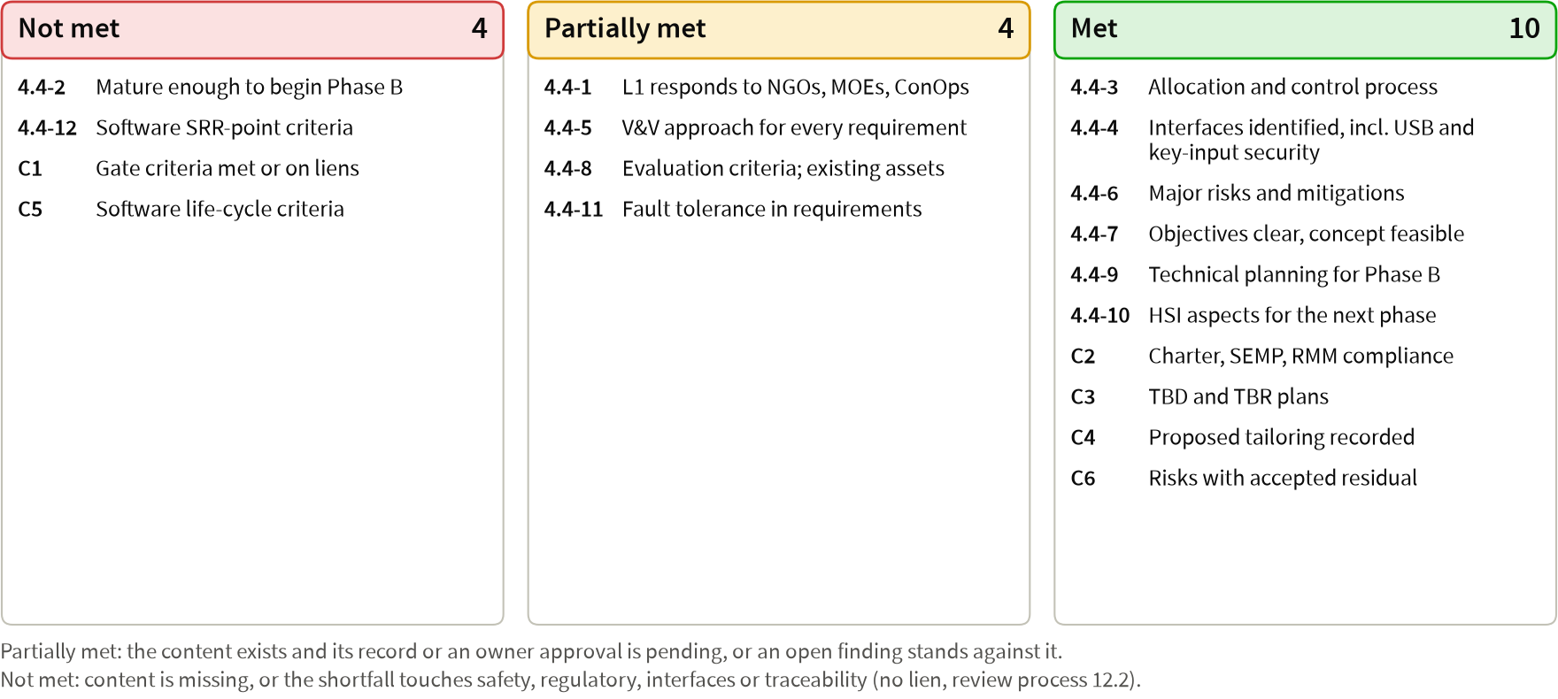
docs/reviews/SRR/figures/success-criteria.png
