robinonsay/cwht/docs/reviews/SRR/figures/tpm-status.png

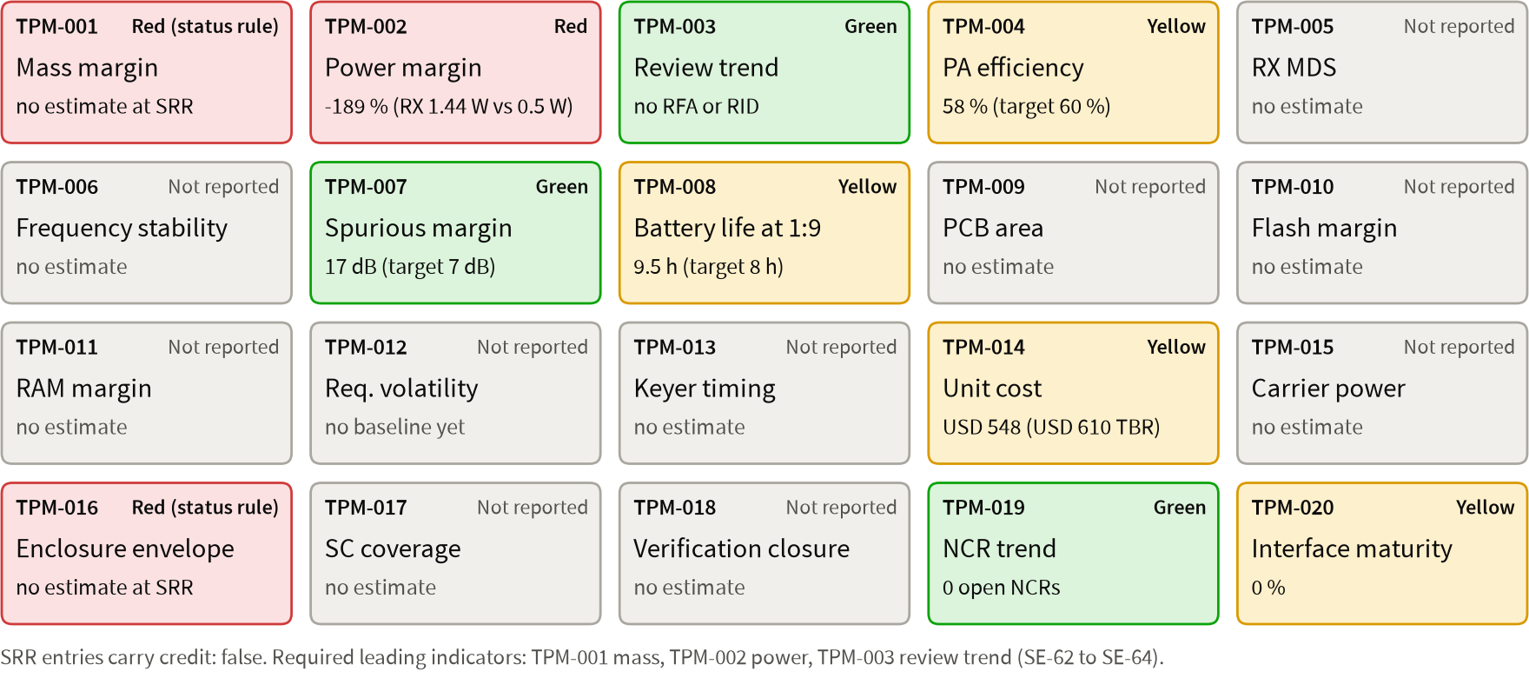
docs/reviews/SRR/figures/tpm-status.png
