robinonsay/cwht/docs/reviews/SRR/slides/png/slide-02.png

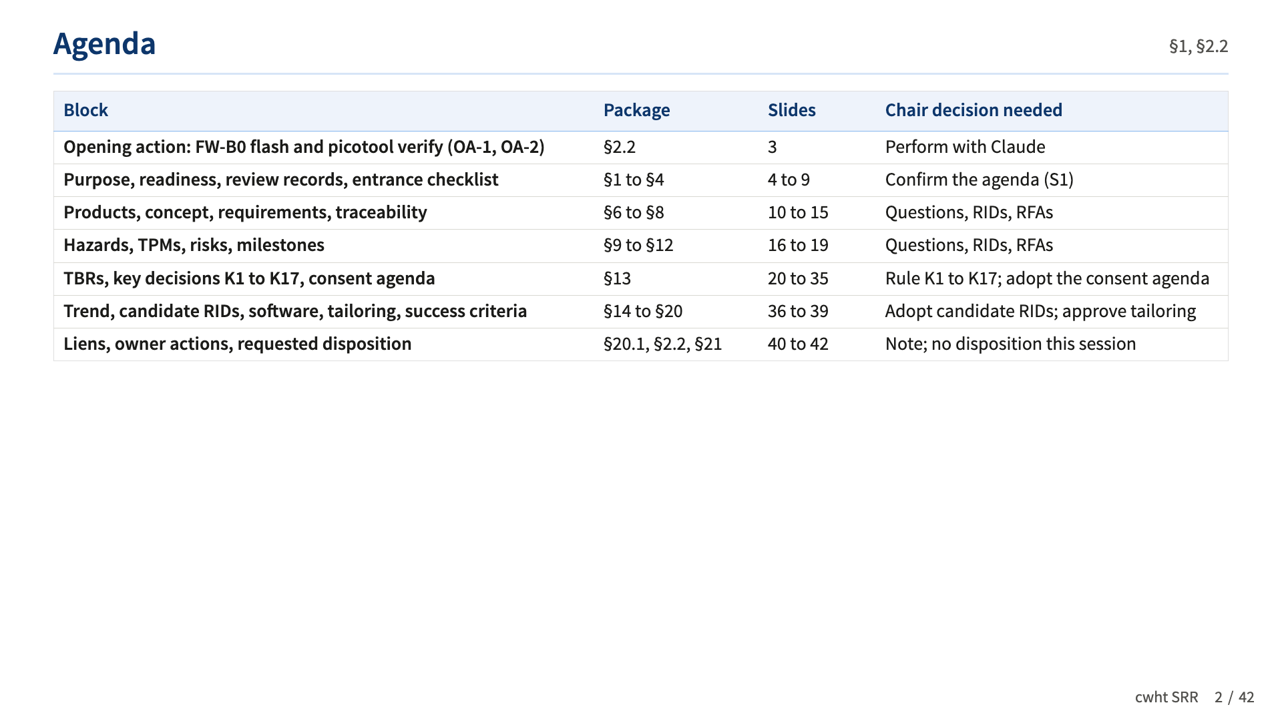
docs/reviews/SRR/slides/png/slide-02.png
