robinonsay/cwht/docs/reviews/SRR/slides/png/slide-09.png

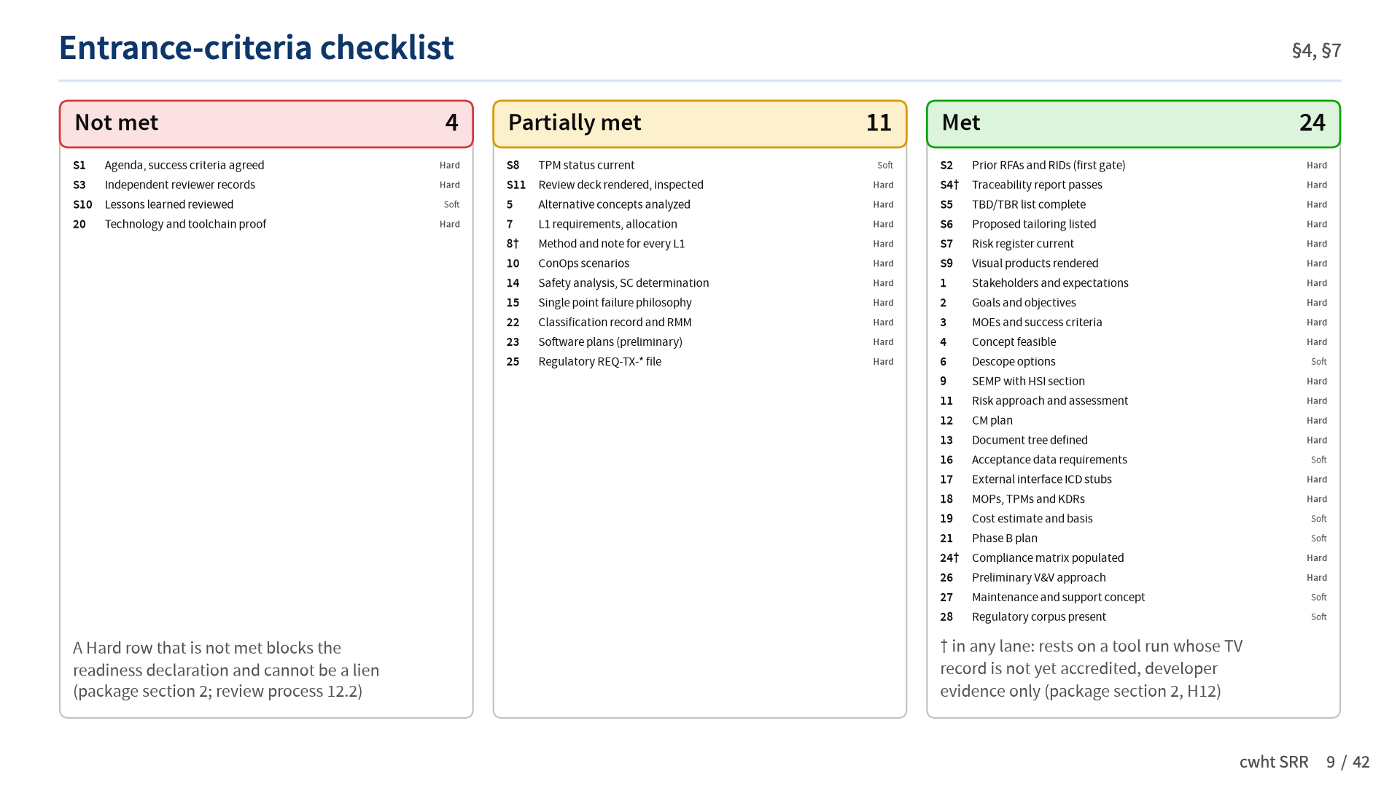
docs/reviews/SRR/slides/png/slide-09.png
