robinonsay/cwht/docs/reviews/SRR/slides/png/slide-19.png

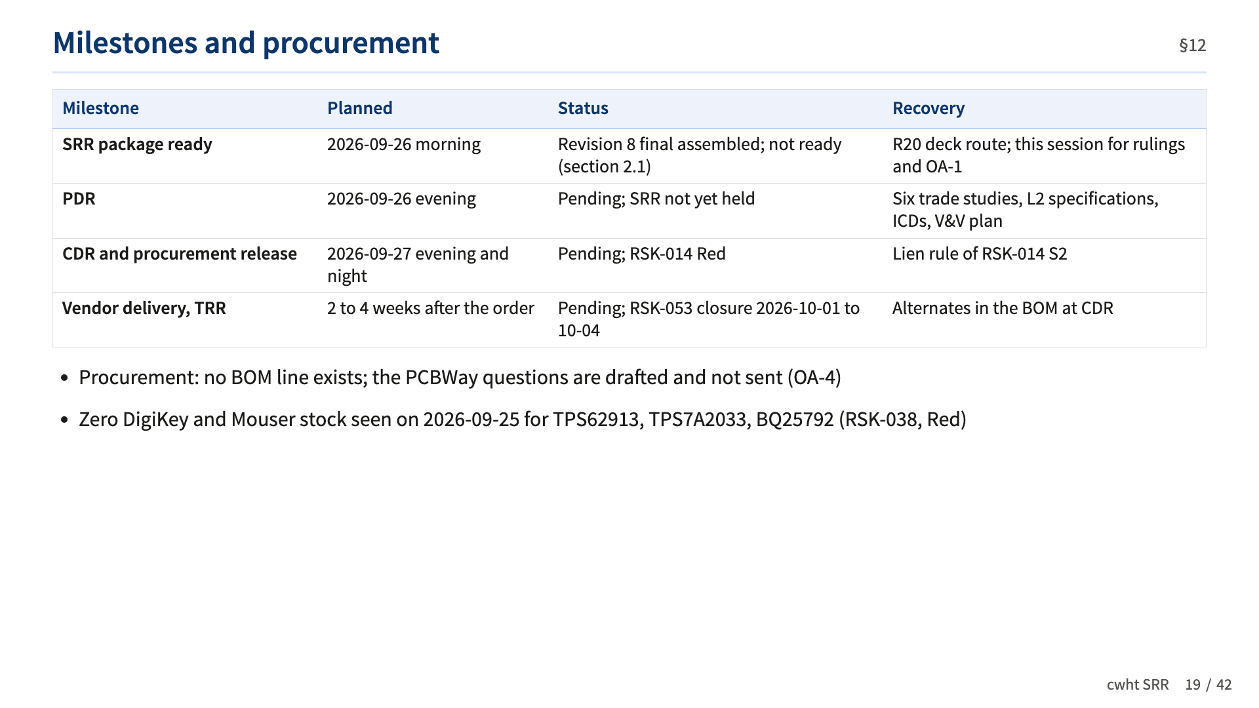
docs/reviews/SRR/slides/png/slide-19.png
