robinonsay/cwht/docs/reviews/SRR/slides/png/slide-21.png

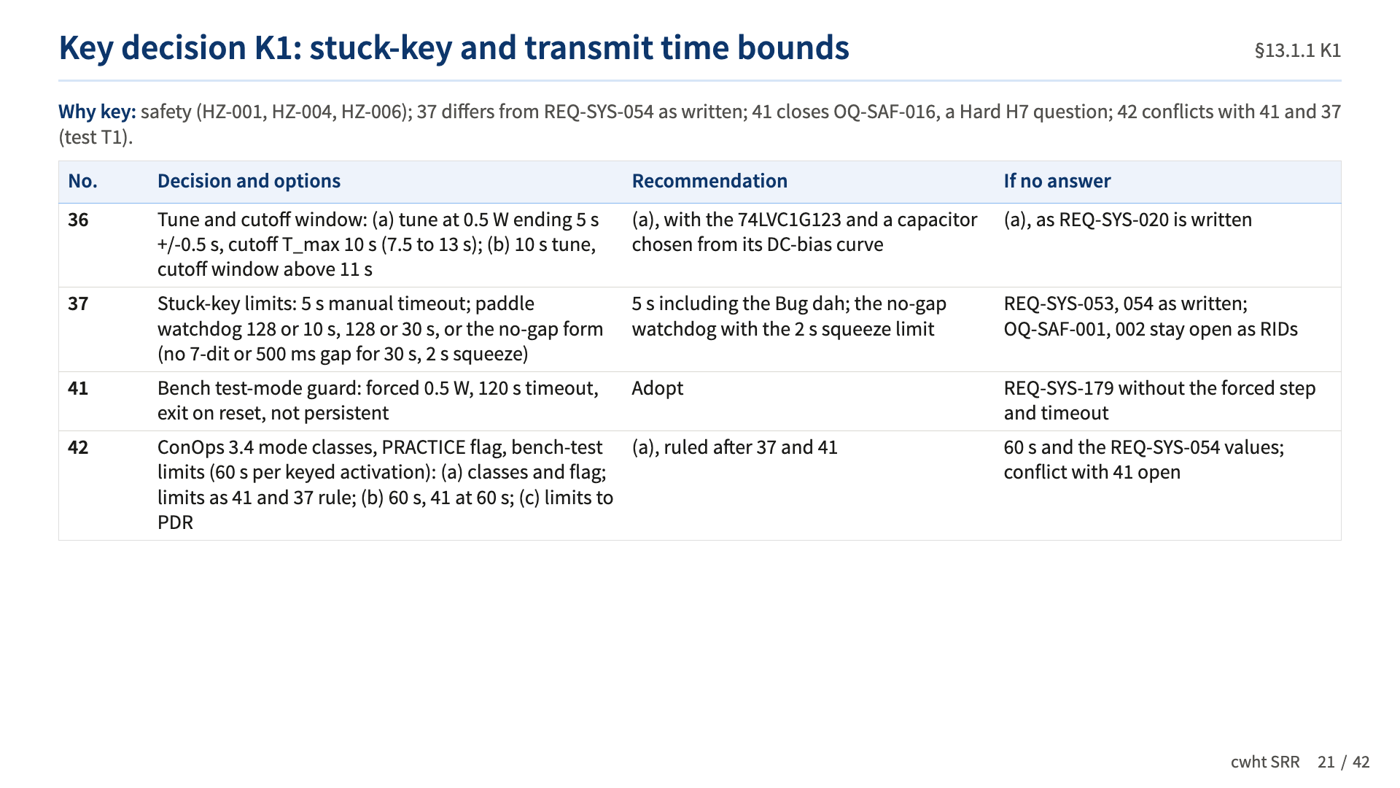
docs/reviews/SRR/slides/png/slide-21.png
