robinonsay/cwht/docs/reviews/SRR/slides/png/slide-29.png

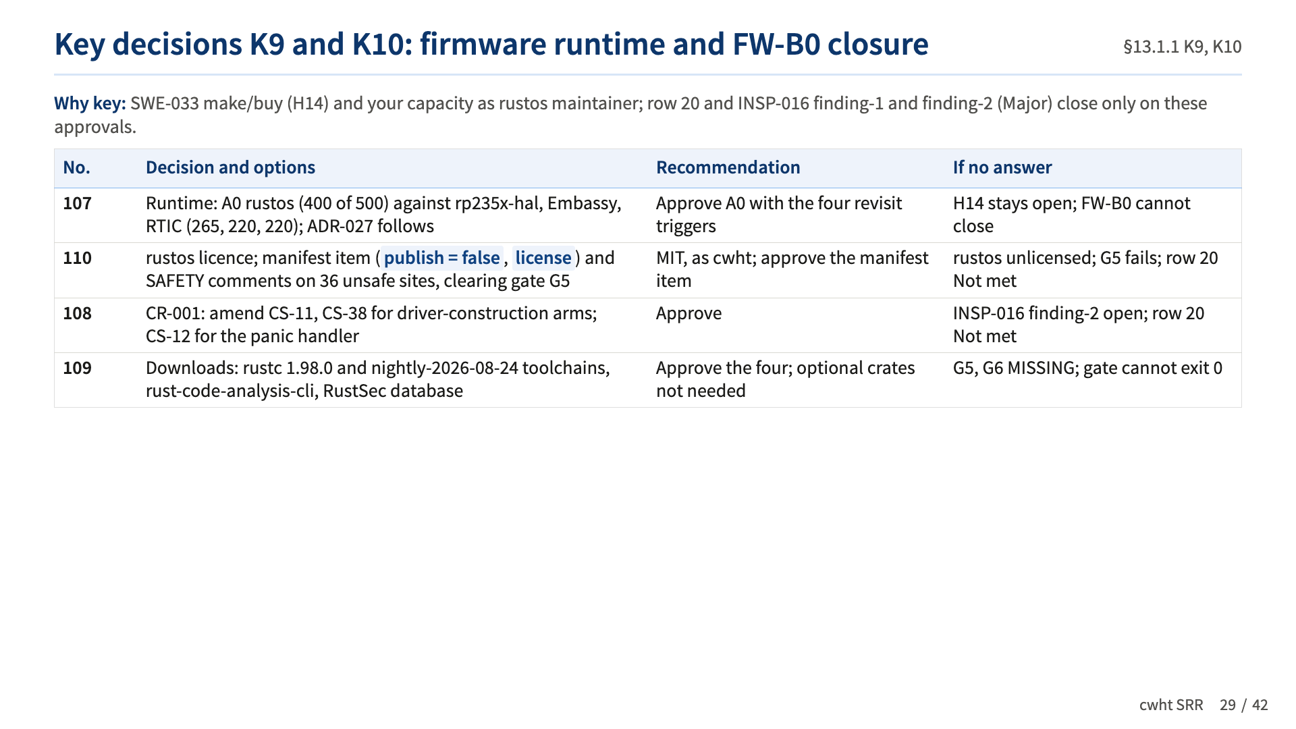
docs/reviews/SRR/slides/png/slide-29.png
