robinonsay/cwht/docs/reviews/SRR/slides/png/slide-32.png

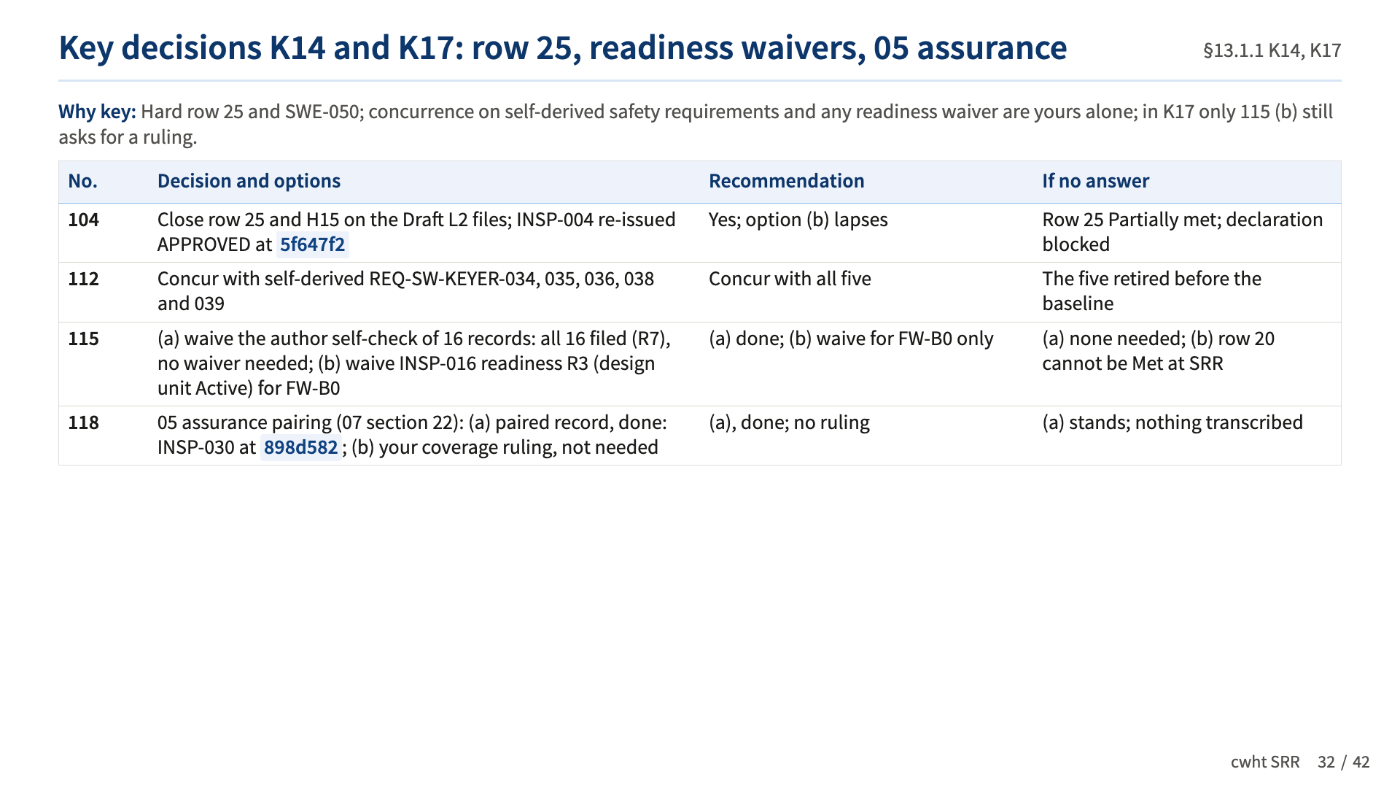
docs/reviews/SRR/slides/png/slide-32.png
