robinonsay/cwht/docs/reviews/SRR/slides/png/slide-33.png

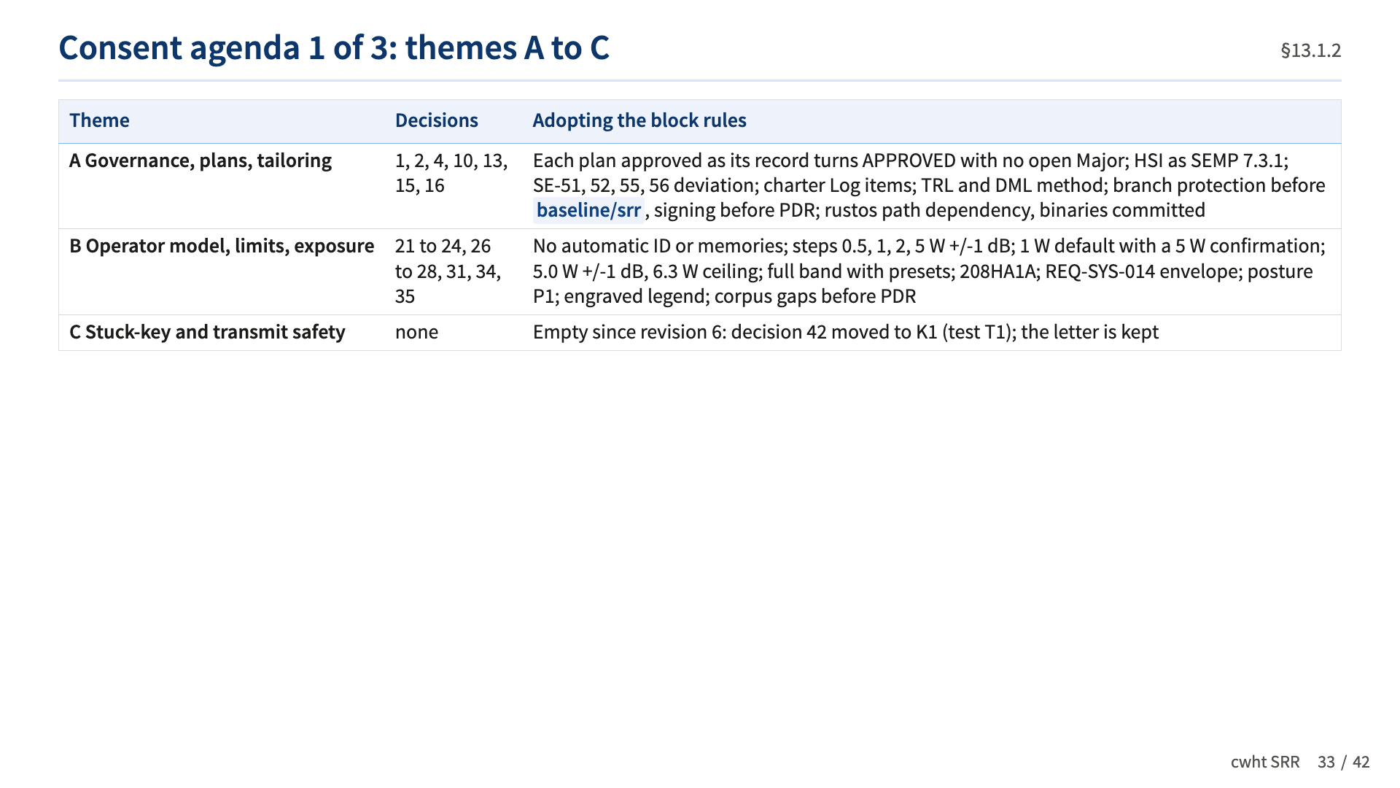
docs/reviews/SRR/slides/png/slide-33.png
