robinonsay/cwht/docs/reviews/SRR/slides/png/slide-34.png

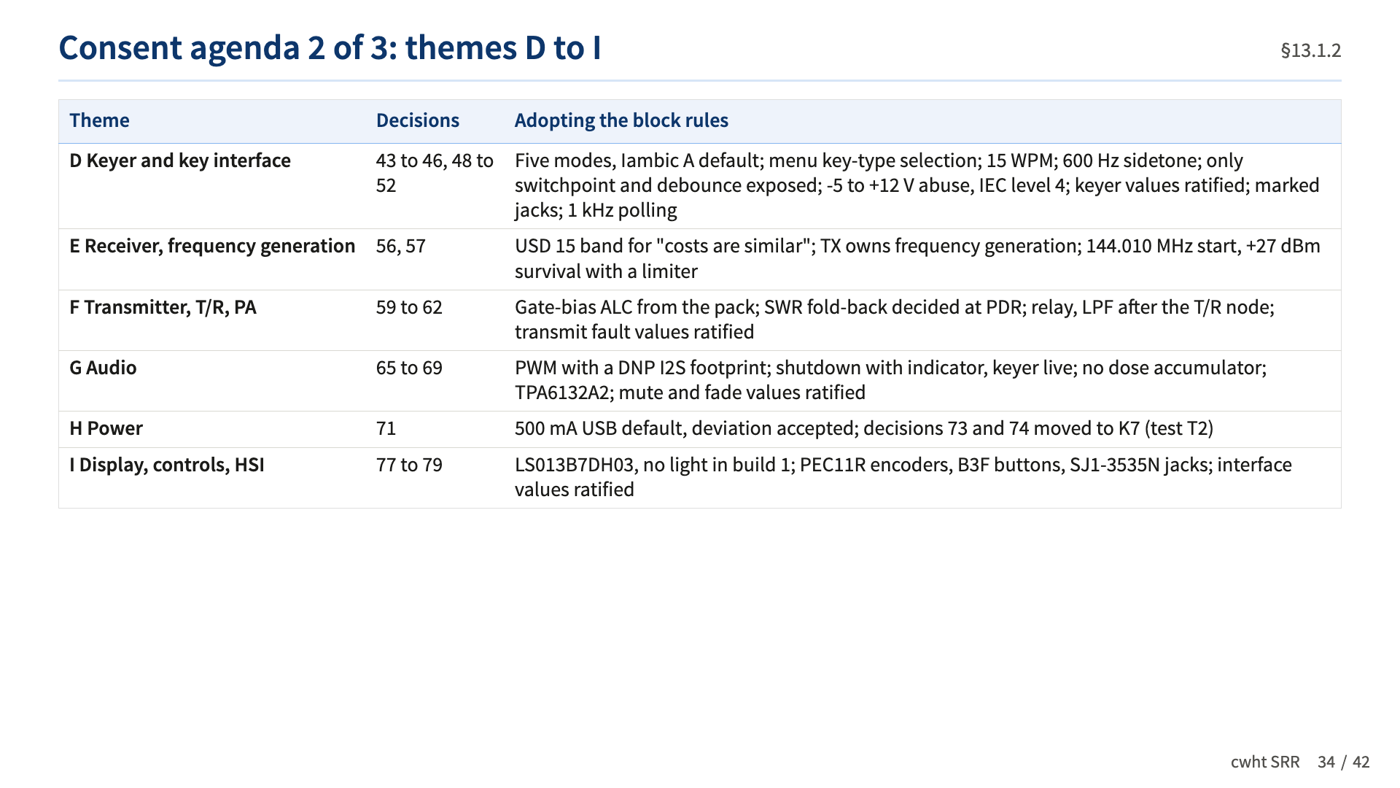
docs/reviews/SRR/slides/png/slide-34.png
