robinonsay/cwht/docs/reviews/SRR/slides/png/slide-42.png

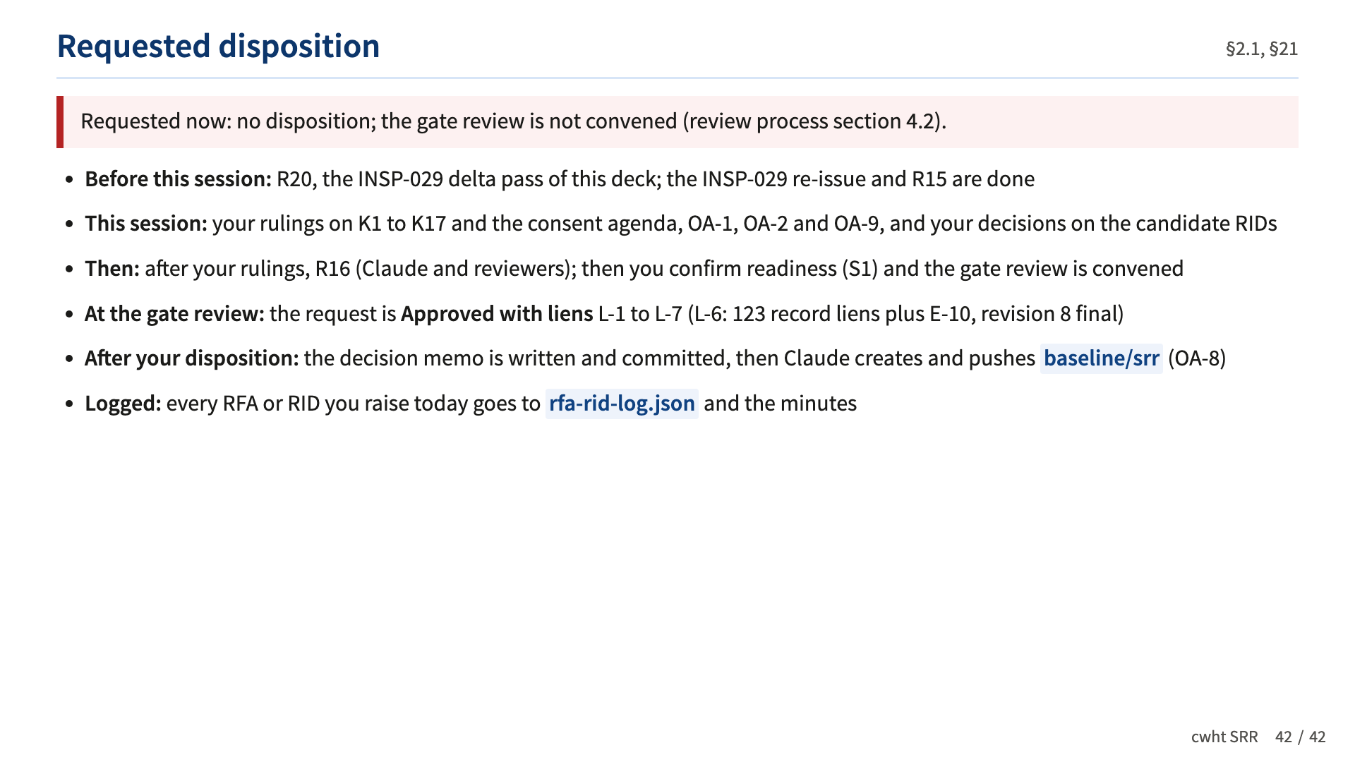
docs/reviews/SRR/slides/png/slide-42.png
