robinonsay/cwht/hardware/sim/rx-frontend/results/2026-09-28-r12-bpf-residual-design-input/residual_2p3p3_zoom.png

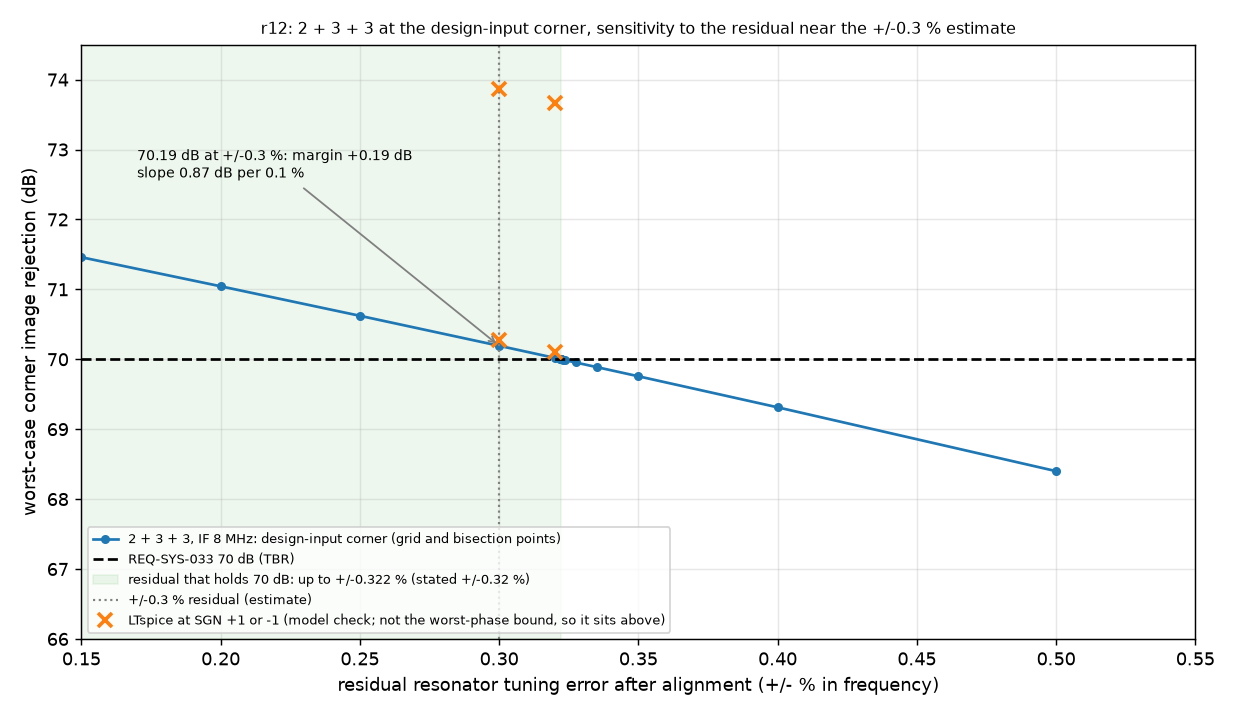
hardware/sim/rx-frontend/results/2026-09-28-r12-bpf-residual-design-input/residual_2p3p3_zoom.png
