robinonsay/cwht/hardware/sim/rx-frontend/results/2026-09-28-r12-bpf-residual-design-input/residual_design_input.png

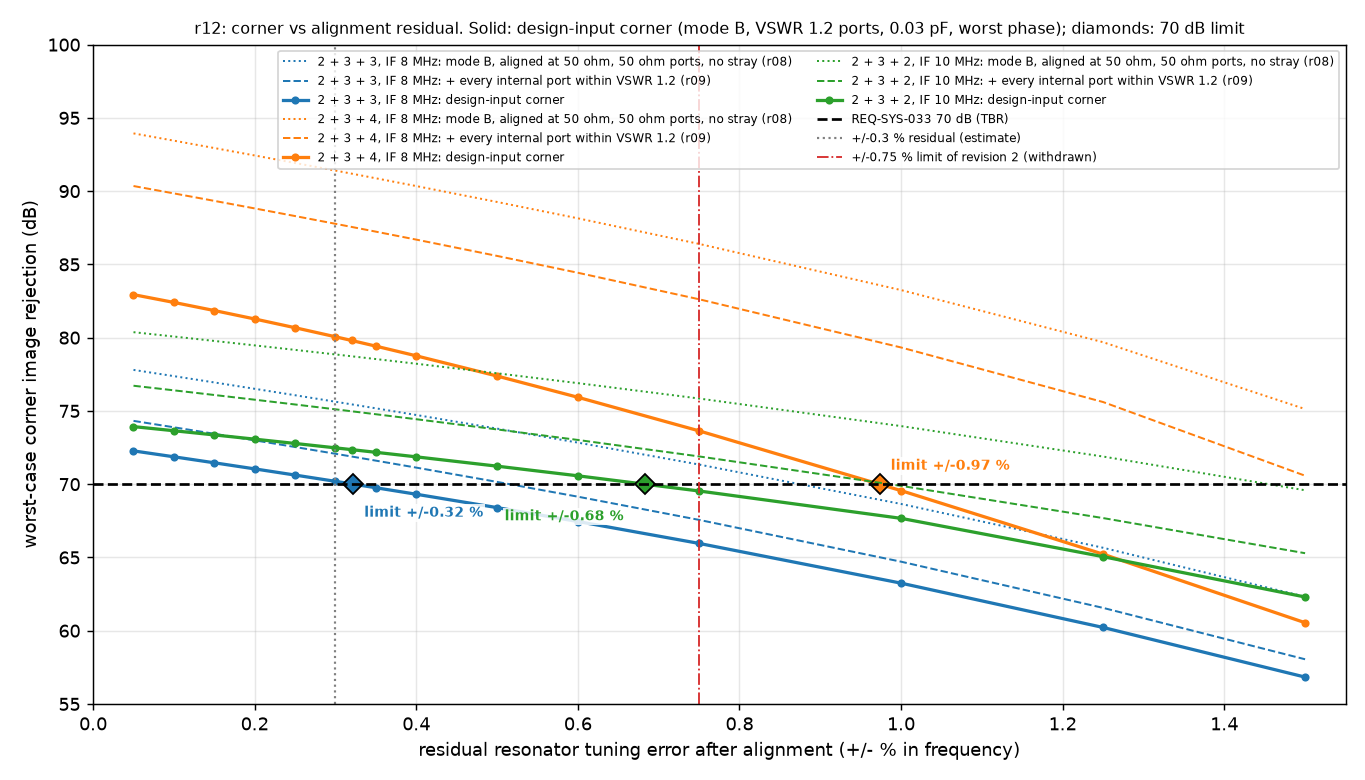
hardware/sim/rx-frontend/results/2026-09-28-r12-bpf-residual-design-input/residual_design_input.png
