robinonsay/cwht/hardware/sim/tx-keying/results/2026-09-28-a4-mitig/spectrum.png

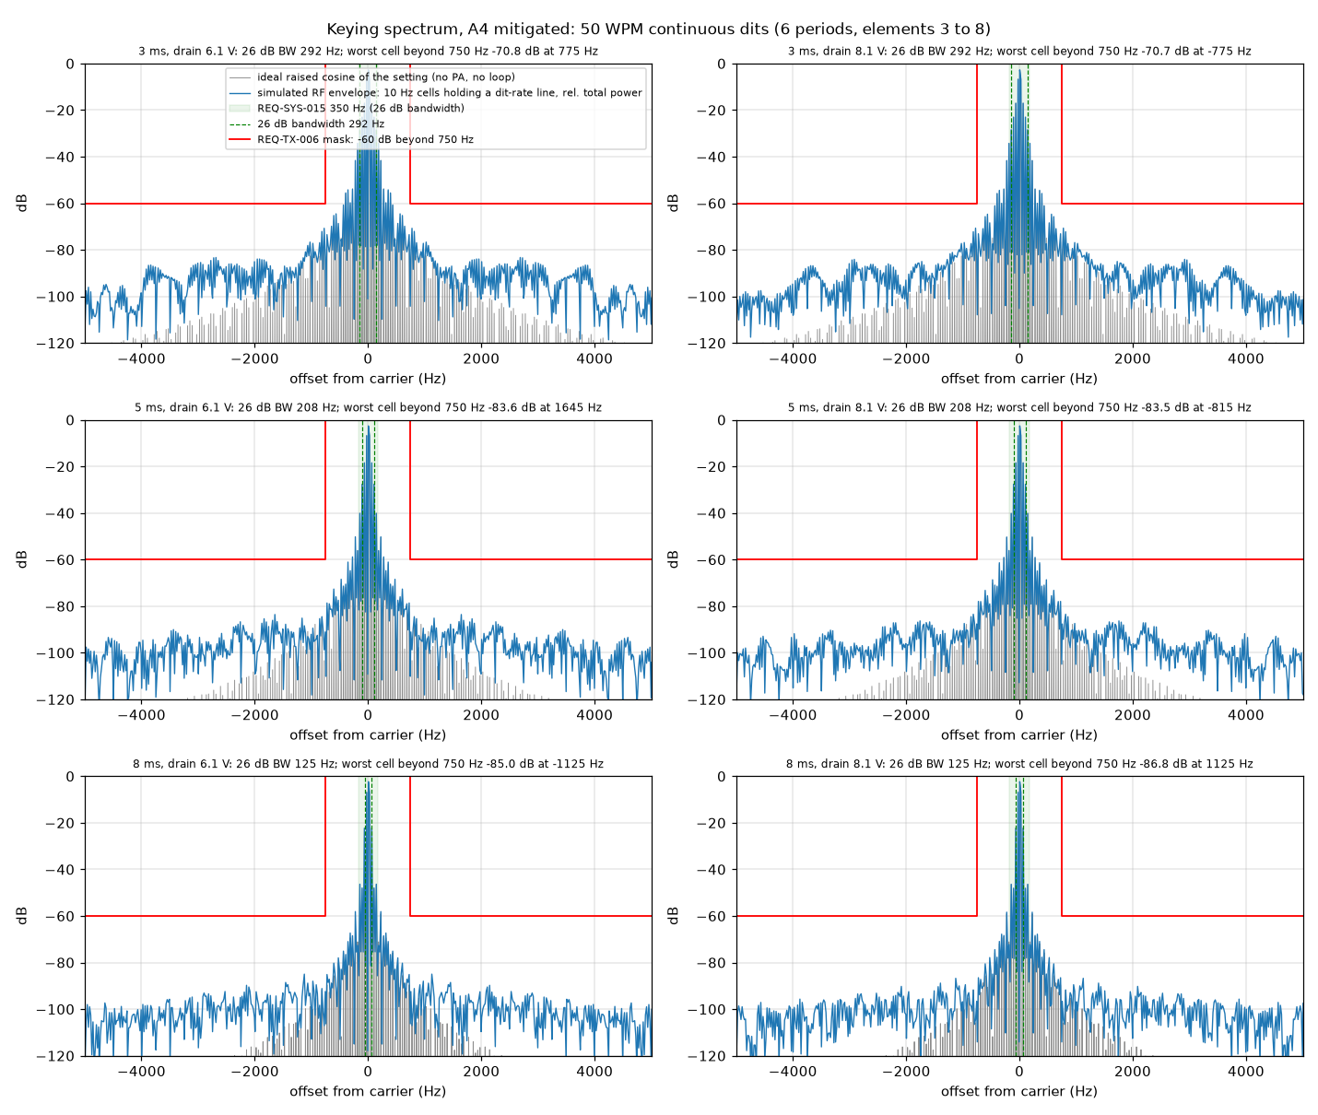
hardware/sim/tx-keying/results/2026-09-28-a4-mitig/spectrum.png
