robinonsay/cwht/hardware/sim/tx-pa/data/aft05_pout_vs_pin_overlay.png

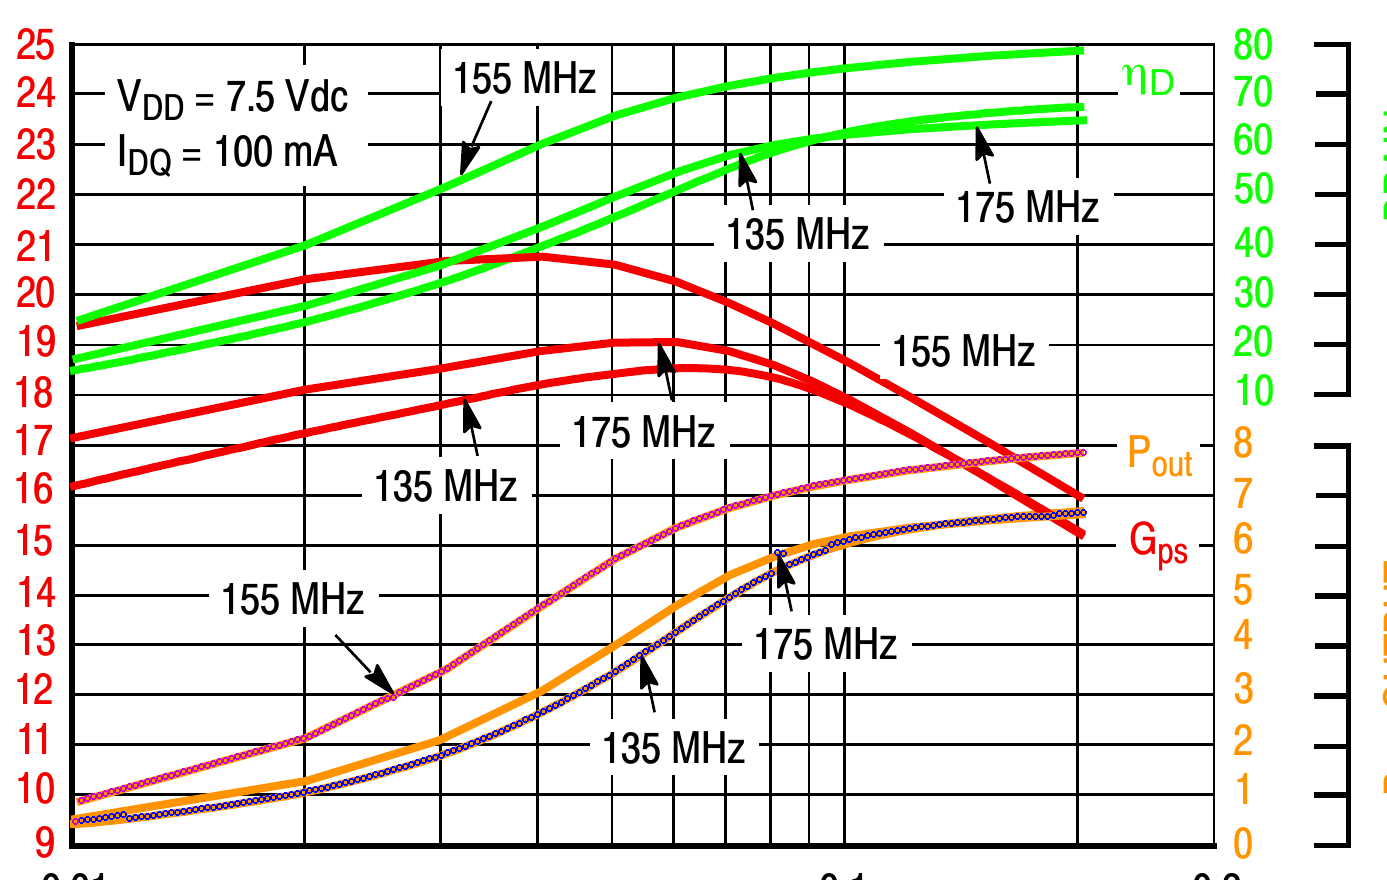
hardware/sim/tx-pa/data/aft05_pout_vs_pin_overlay.png
