robinonsay/cwht/hardware/sim/tx-pa/data/ra07_pout_vs_vdd_135_overlay.png

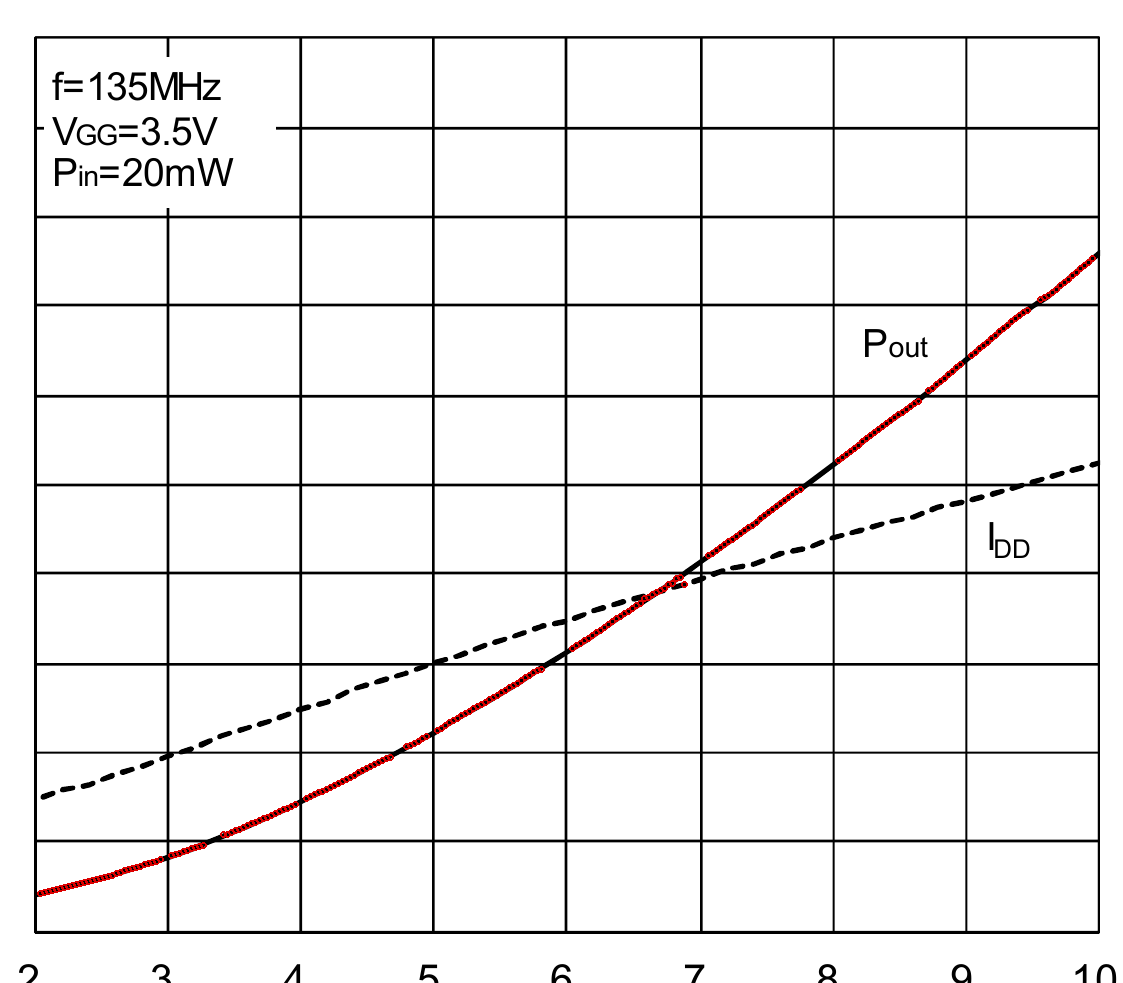
hardware/sim/tx-pa/data/ra07_pout_vs_vdd_135_overlay.png
