robinonsay/cwht/hardware/sim/tx-pa/data/ra07_pout_vs_vdd_155_overlay.png

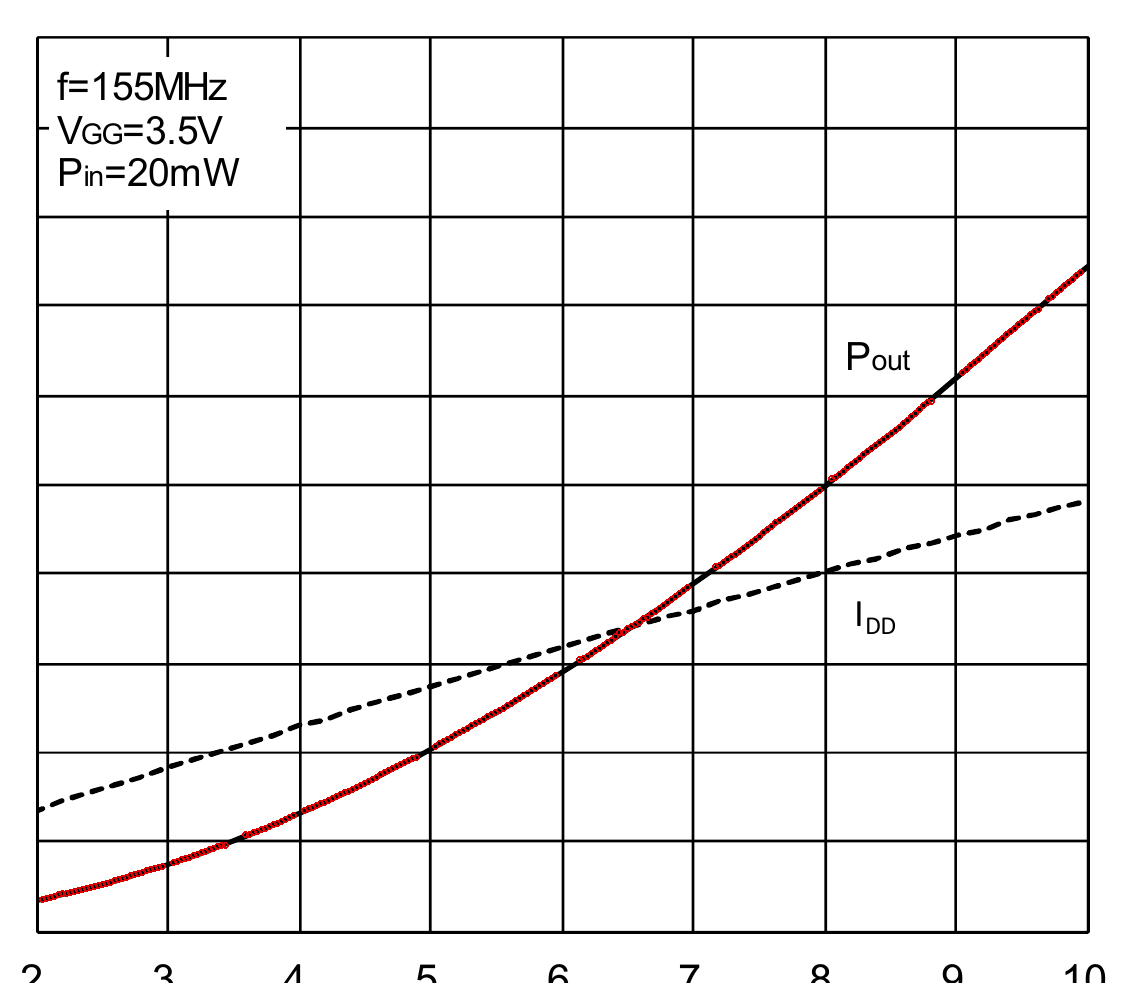
hardware/sim/tx-pa/data/ra07_pout_vs_vdd_155_overlay.png
