robinonsay/cwht/hardware/sim/tx-pa/results/2026-09-29-r3-p4-power-a5-design/power_a5_design_sma.png

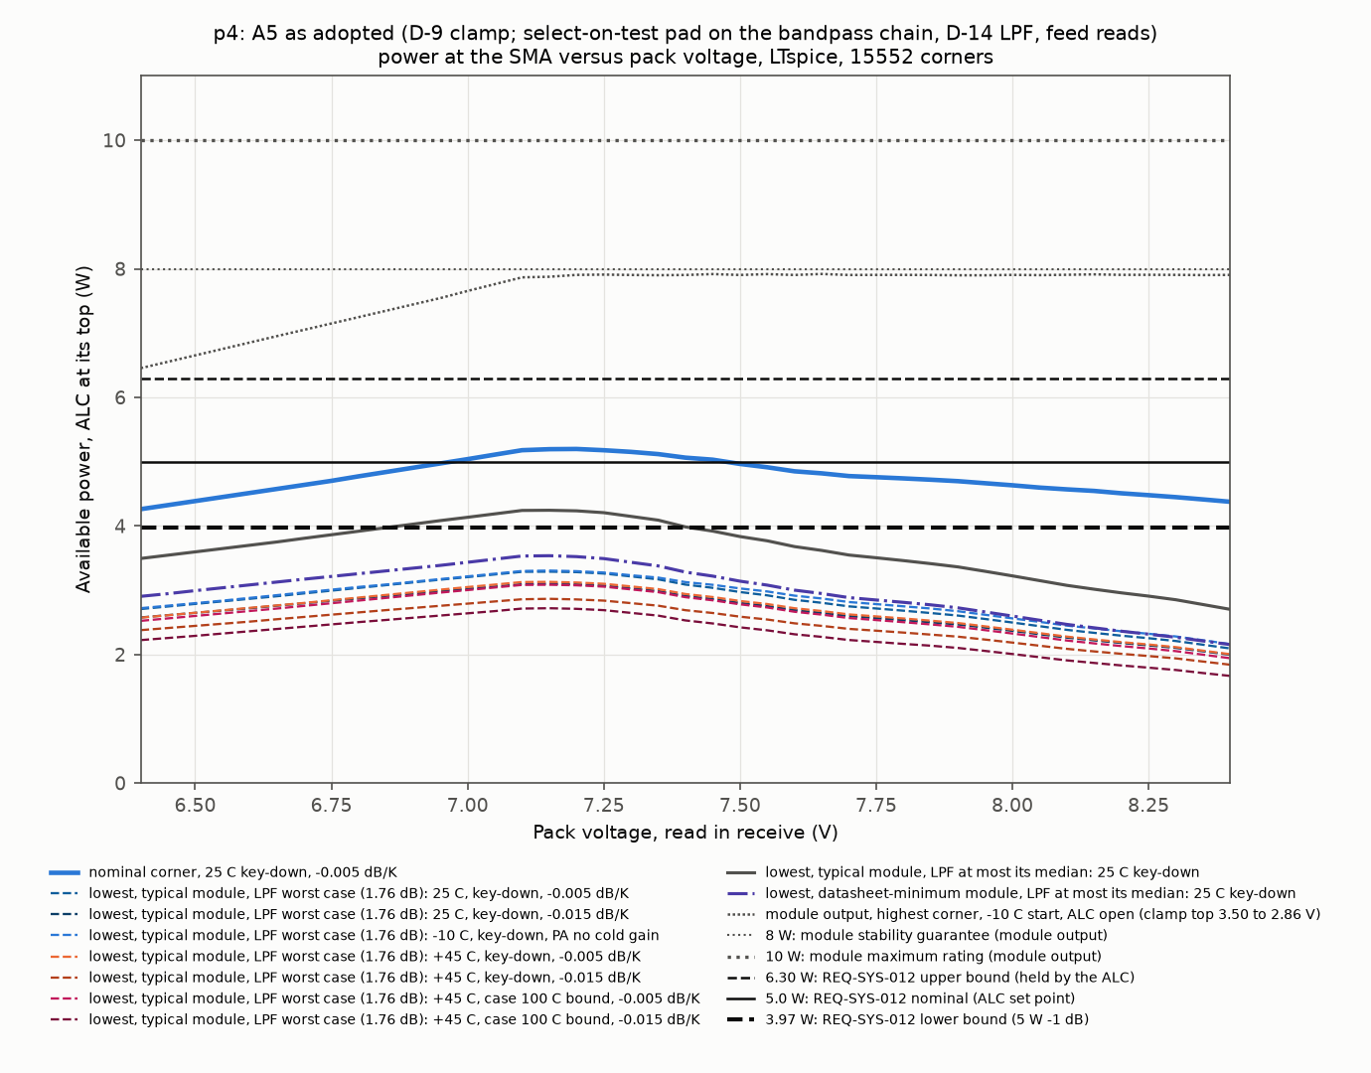
hardware/sim/tx-pa/results/2026-09-29-r3-p4-power-a5-design/power_a5_design_sma.png
