robinonsay/cwht/hardware/sim/tx-pa/results/2026-09-30-r5-p4-power-a5-design/power_a5_added_case_d9.png

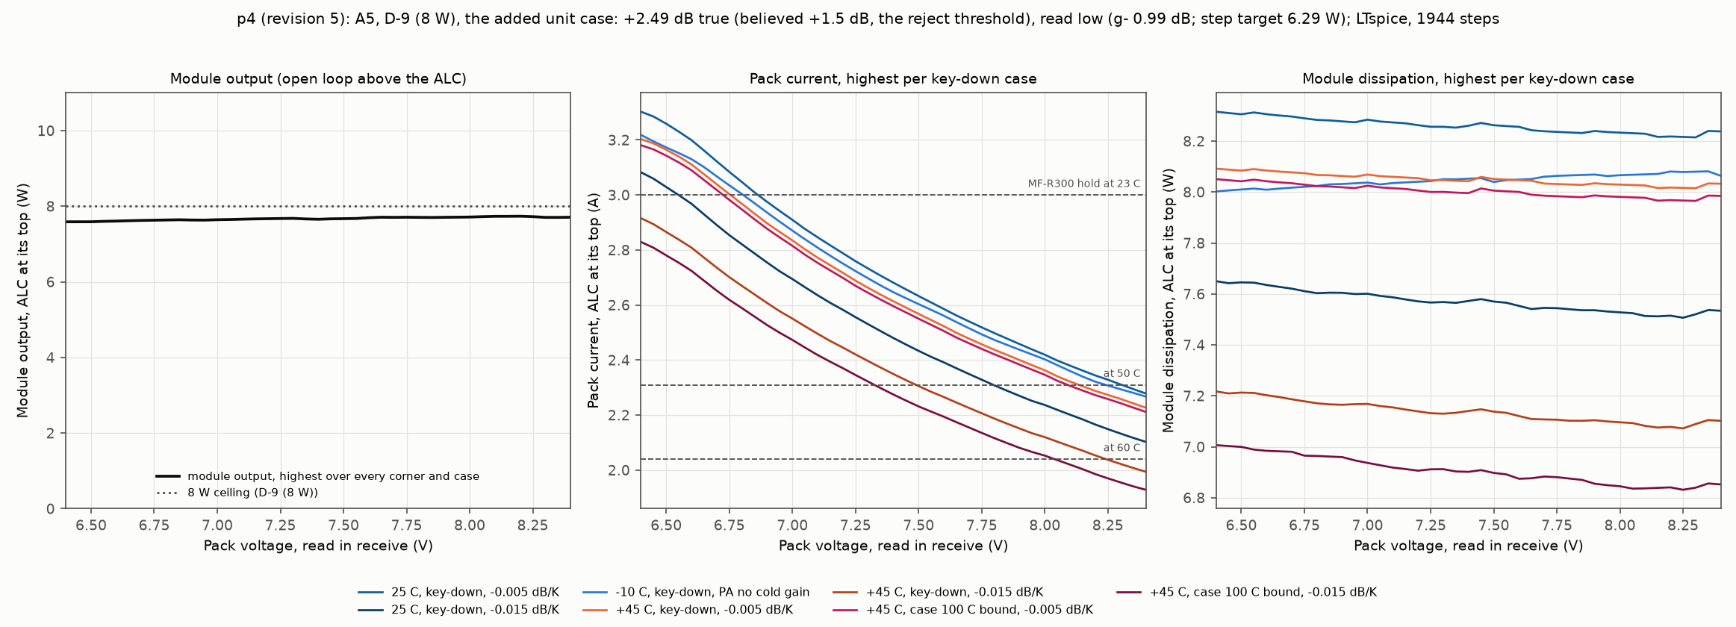
hardware/sim/tx-pa/results/2026-09-30-r5-p4-power-a5-design/power_a5_added_case_d9.png
