robinonsay/cwht/docs/decisions/trade-studies/TS-012-design-to-cost-hand-built.md

# TS-012: Design-to-cost architecture for a hand-built first radio (USD 200 target, USD 300 maximum)

| Field | Value |
|---|---|
| ID | TS-012 |
| Status | **Decided 2026-09-29: A5, the owner's choice (section 10). The study recommended A4 with the TCXO and the ring; the owner chose A5 on the condition that it use no outdated components.** **Revision 8 (2026-09-29)** re-issues sections 8.1 to 8.12 for A5, the chosen design (WP-PDR-54; section 10 "Records produced"): they carry the section 8.14 design items in their A5 form, the receiver figures of `rx-bpf-ts012.md` revision 4 that INSP-110 finding-26 asks for (REQ-SYS-033 over REQ-SYS-114 at a worst case of 75.37 dB, alignment acceptance +/-0.62 %, limit +/-0.64 %), and the A5 envelope, mass and requirement values of the analyses, with the A4-only readings removed; D-15 in section 8.14 takes the same figures, and the as-presented revision 6 receiver figures in sections 1, 6, 7.1, 7.3 and 9 are marked superseded in place. No criterion, weight, score or roll-up total changes. **Revision 7 (2026-09-29)** records the owner's decision only (section 10, the header fields, section 1 and the change log); no cell is re-scored and the matrix of section 5 stands as revision 6 left it. **Revision 6 (2026-09-29)**, authorized by the owner (`docs/plan/status/status-2026-09-29.md` section 2, "Yes both recs sound good"), folds in the three Major findings of the software assurance pair INSP-118 (`docs/reviews/PDR/checklists/ts-012-design-to-cost-software-assurance.md`, `f06690b`) and INSP-110 finding-19 and finding-20, INSP-114 cross item X-7 and the final verdicts of the six analysis reviews (section 9, tables R5-1 and R6-1). For A4 the TCXO becomes a **required** item, because REQ-SYS-182 and REQ-SYS-154 hold as written only on the frequency-budget route R3, which needs a countable TCXO (section 7.3, "Revision 6: frequency verification"). That moves C3-A4 from 5 to 3 (the flagged TCXO) and the matrix to **A2 305, A4 285, A3 285, A5 270**, with the recommended A4 configuration (A4 with the required TCXO and A5's diode-ring mixer, U3) at **300**. A2 is now first on the matrix; it was not analysed, and the robustness verdict is **Not robust** (section 6, revision 6). The recommendation stays A4 (with the TCXO and the ring) over A5, 30 points apart, and A2 is presented with it as the closely ranked alternative (06 section 14.5; Q1). Revision 5 (2026-09-28) folds in the six pre-order analyses the owner approved on 2026-09-28 (`docs/plan/status/status-2026-09-28.md` section 1 item 2: thermal WP-PDR-28, PA drive and output power WP-PDR-21, harmonic LPF WP-PDR-21, receiver BPF WP-PDR-19, transmit clock spurs WP-PDR-20, keying envelope WP-PDR-22; section 9, table R5-1) and changes the ranking again: **A4 315, A5 270** (C1, C5, C6 and C8 for A5 and C2 and C6 for A4 re-scored on the analysis evidence, section 4.2), so A4 is recommended (section 8). A5's worst case, with the analysis-driven parts (row E5, estimate), is USD 314.78, over the USD 300 maximum before the guard ladder (M1 conditional, section 4.1). Revision 4 (2026-09-27). Opened on the owner's direction of 2026-09-27 (`docs/plan/status/status-2026-09-27.md` sections 6 and 8); revision 2 applied the owner's answers of section 10, which supersede the section 6 and 8 cost reading. Independent review INSP-110 iteration 1 (NEEDS CHANGES, 3 Major, 8 Minor) was answered in revision 2; iteration 2 (reviewer APPROVED; Minor liens finding-11 to finding-16) and two adversarial refutations of revision 2 (R-1 key-down sequence, R-2 heat inside the case) were answered in revision 3; iteration 3 (reviewer APPROVED; Minor liens finding-14 in part, finding-17, finding-18) and two adversarial refutations of revision 3 (R-3 transmit clock lines, R-4 junction bound) are answered in this revision (section 9). Revision 4 changes the ranking: A5's junction figure is now an estimate that spans 110 C (R-4), C8 for A5 falls from 3 to 2, A4 leads 340 to 335, and A4 and A5 are presented together as closely ranked alternatives (section 8) |
| Decision class trigger | 06 section 14.1 class 1 items (a) architecture choice (receiver topology, PA topology, LO scheme, power architecture, enclosure concept), (b) selection of critical parts (RF power device, synthesizer, TCXO, CW filter, battery charger, display), (c) choices touching HZ-002, HZ-003, HZ-004, HZ-005, HZ-007, HZ-008 and HZ-015, (d) the owner asked for it (status note section 6, "A design-to-cost trade study (TS-012)"), (f) changes to KDR requirements (REQ-SYS-010, 012, 102, 103, 112, 137, 140) |
| Decision maker | Robin (owner, Decision Authority) |
| Recommender | Claude (trade-study author invocation, 2026-09-27), from three independent architectures, three judges (section 4.3), the independent review INSP-110 and the adversarial RF feasibility check (section 9) |
| Independent reviewer | INSP-110 in `docs/reviews/PDR/checklists/ts-012-design-to-cost.md` (filled from `docs/templates/peer-review-checklist-risk.md` section B): iteration 1 on the 5c16930 text (labelled revision 0 in its own change log, called revision 1 by the brief and the record); iteration 2 on revision 2 at eca24fa; iteration 3 on revision 3 at d5a3058 (reviewer APPROVED, Minor liens). A delta iteration on this revision 4 is needed (INSP-110 rule C2) and not yet run; it is the fourth iteration, which PDR plan rule C1 escalates to the owner (INSP-110 cross item X-9). **Revision 5:** the owner authorized the fourth iteration on 2026-09-28 (status note section 1, item 3, "good to continue"); it has not run, so it now reviews this revision 5 as a delta on revision 4 (`7d0d450`). The six analysis records carry their own reviews (section 9, table R5-1). **Revision 6:** INSP-110 iteration 3 re-issue 1 (the fourth iteration) returned reviewer APPROVED on revision 5 with Minor liens finding-19 to finding-23; its software assurance pair INSP-118 iteration 1 returned NEEDS CHANGES with three Major findings. The owner authorized this revision 6 with a further INSP-110 iteration (iteration 3 re-issue 2) and INSP-118 iteration 2 (status note 2026-09-29 section 2); both ran on revision 6 (`17b6865`, `c5e4930`; INSP-118 `dd39a64`): reviewer and assurance verdicts APPROVED, Minor liens finding-24 to finding-26 (INSP-110) and finding-9 (INSP-118). **Revision 8:** the re-issue is reviewed as an INSP-110 delta on revision 7 (`6497900`), with its INSP-118 pair on the text that touches the frequency check and the PA permit (sections 8.1, 8.7, 8.10 REQ-SYS-182, 154, 120 and REQ-TX-014; WP-PDR-54); neither has run on this revision |
| Decide by | Before the PDR trades that depend on it are scored: proposed B1a (Tue 2026-09-29), no later than B1b (Thu 2026-10-01). Every one of WP-PDR-19 to 28, 33, 37 to 40 and 46 changes with this decision (section 8.12) |
| Related risks | RSK-002 (LO error against the CW filter), RSK-004 (turnkey defects, retired if selected), RSK-006 (PA junction temperature), RSK-008 (first power-on), RSK-025 (antenna port retention), RSK-026 (hand-hold surface), RSK-037 (RP2350 ADC audio; not used for audio here), RSK-038 (stock and end of life), RSK-052 (cost above the model) |
| Related requirements and hazards | Section 8.10 lists every REQ delta. Hazards HZ-002, HZ-003, HZ-004, HZ-005, HZ-007, HZ-008, HZ-015. Stakeholder inputs SI-013, SI-022, SI-028, SI-031, SI-034; the owner inputs of status note sections 6, 8 and 10 take the next free SI ids when the re-baseline CR appends them |
| Resulting ADR | To be written for the A5 decision (06 section 14.2: every TS produces exactly one ADR) with the next free ADR number when its file is created (ADR-056 or later; highest at revision 7 is ADR-055); not produced by revision 7 |
| Dates | opened 2026-09-27; recommended 2026-09-27 (revision 1, A4), re-recommended 2026-09-27 (revision 2, A5), recommendation held 2026-09-27 (revision 3, A5 at 350 against A4 at 340); ranking changed 2026-09-27 (revision 4, A4 at 340 against A5 at 335, presented together as closely ranked); pre-order analyses folded in and A4 recommended 2026-09-28 (revision 5, A4 at 315 against A5 at 270); assurance conditions folded in 2026-09-29 (revision 6: A4 with the required TCXO 285, the recommended A4 configuration with the ring 300, A5 270, A2 305 presented together); **decided 2026-09-29: A5** (owner, status note 2026-09-29 section 5; recorded in revision 7); sections 8.1 to 8.12 re-issued for A5 2026-09-29 (revision 8) |

Price evidence convention used in every table: **L** = listed price read on the seller's own page on 2026-09-27; **A** = distributor price and stock read on 2026-09-27 through the OEMsTrade aggregator page for the part, because Mouser, DigiKey and Newark block automated reads (the owner verifies it in a browser); **E** = estimate with its basis, never a listed price. No page was logged into, no form was filled, nothing was added to a cart and no file was downloaded by the author (datasheets read through the web-fetch tool, which caches the PDF it reads, are named where used).

## 1. Executive summary

- **Owner budget (status note section 10, governs).** Target USD 200 for the first complete radio; **USD 300 is the absolute maximum**, and the worst case including contingency must stay at or below it. **Sales tax is excluded.** Owned and not bought: 24 AWG magnet wire, a 2 m antenna with an SMA-male plug, through-hole resistors and capacitors (surface-mount passives are not owned), a USB power adapter. Answered later the same day (status note section 11): no 18650 cells or charger are owned, so they are priced; test instruments are outside the radio's cap, under a separate USD 300 cap on all new equipment (the tinySA Ultra counts there if it is not yet bought). Revision 5 (status note 2026-09-28 section 1): the tinySA Ultra is not yet bought, and the owner will buy it later; the owner's multimeter is a Fluke 174, which has no temperature input, so a stand-alone K-type thermocouple thermometer is bought inside the equipment cap (status note 2026-09-28 section 2).
- **Recommendation (one sentence, revision 6):** choose **A4 with the TCXO and A5's diode-ring mixer** (300 of 500) over **A5** (270), because the six pre-order analyses removed the evidence on which A5's advantages rested (a module that holds 5 W at the low pack end and a PA bound under 110 C) while confirming its costs (twice the heat in the case, a worst case over USD 300 before guards), and the three assurance conditions of INSP-118 that A4 now carries (TCXO, tab cut-off sensor, PA_EN gating) cost USD 5.19 capped at planning and 15 points net, without reversing the order; that A4 configuration leads A5 by 30 points and in all 16 weight runs between them, and no single Low-cell move closes the gap (section 6). **A2 (305, not analysed) is 5 points above it on the matrix** and is presented with it as the closely ranked alternative, with the reasons it is not recommended and the analysis that would settle it (section 6 revision 6 item 4; Q1).
  - **A4 (revision 6; recommended with the ring):** the revision-1 radio (JFET preamps, 500 Hz crystal ladder, analog audio, Morse menu, Adafruit Si5351A module, the End-of-Life NXP AFT05MS004NT1 with a hand-derived match and a spare in the order, cells charged outside the radio, one Mouser order plus two JLCPCB 2-layer boards), plus the common design items of section 8.14 that the analyses require, plus three conditions from INSP-118 that are now part of A4, not options: **(1) the Epson TG2520SMN TCXO on the Si5351A's XA input and, through a squaring buffer, on a second RP2350 GPIN**, so that REQ-SYS-182 and REQ-SYS-154 hold as written on the frequency-budget route R3 (the former add-back AB2, USD 4.15 capped, now in the baseline; D-17); **(2) the REQ-SYS-181 cut-off sensor NTC-2 on the AFT05 tab copper** (TS-011 rule 14), where it bounds the junction at about 142 C or less against the datasheet's 150 C maximum (D-6); **(3) a PA_EN permit line, independent of TX_KEY, that gates the drive supply and the gate-bias clamp in hardware** together with TX_KEY (D-11, D-18). Scored alone (JFET mixer) it totals 285: the TCXO is the one flagged part (C3 5 to 3). **With A5's diode-ring mixer (U3, USD 2.60 capped) it totals 300** (C5 2 to 3 with the TCXO and the ring together, C2 3 to 2), and it replaces the JFET mixer whose half-IF run is only representative (8 of 16 cases did not converge) with the mixer the receiver analysis showed at 34 to 37 dB margin (section 7.3, table R5-2 row 11). This is the configuration recommended.
  - **A5 ("hybrid H1"):** A4 with the Mitsubishi RA07M1317M module PA, the Epson TG2520SMN TCXO, the diode-ring mixer and a spare GVA-84+, with the same common items; revision 6 adds the same route R3 counter input and PA_EN gating, while its REQ-SYS-181 sensor stays on the sink (it acts there with the channel at about 120 to 123 C against a 175 C rating).
- **What the software assurance pair found (INSP-118, revision 6; section 7.3 and table R6-1):** none of the three Major findings reverses A4 over A5, but each showed the recommended A4 passing a safety requirement its own evidence did not support. (1) REQ-SYS-182: revision 5's budget used a recalled 30 ppm Pico 2 crystal and no counter term; on the reviewed frequency-budget method the RP2350 crystal is 65 ppm and only route R3 (the TCXO counted in receive, which cancels the reference error) meets the 10 kHz limits, with a measured threshold of 5.0 kHz and 482 Hz of margin; A4 without a TCXO would need REQ-SYS-182 widened to at least 16.1 kHz and REQ-SYS-154 to at least 27.7 kHz by CR. The key-down sequence now leaves 7 ms for the frequency check before PA_EN. (2) REQ-SYS-181: on the sink the A4 cut-off never acts; on the tab copper it acts with the junction at about 124 C nominally and at most about 142 C with every input adverse, under the AFT05's 150 C maximum operating junction (NXP datasheet Rev. 0, 7/2014, page 2, Table 1), so no REQ-SYS-181 value change is needed, only the sensing point. (3) REQ-SYS-120: the second condition is now a named PA_EN line, set only by the safe-state manager, which with TX_KEY gates the GVA-84+ supply and the gate-bias clamp in a hardware gate; CLK1 enable is a firmware sequencing action, not a safety condition.
- **What the analyses found (section 7.3, table R5-2; each record and its review verdict in section 9, table R5-1; every figure an estimate):**
  1. **Thermal (WP-PDR-28, `docs/design/analysis/thermal-ts012.md`, reviewer APPROVED).** REQ-SYS-112 as written (110 C, continuous key-down, 45 C) **fails for both**: A4 122.7 C (band +20.3 / -14.7 K), A5 126.0 C (+20.0 / -12.4 K), both with the no-cost design changes of section 8.14; 131.0 and 142.1 C as revision 4 drew them. A5's range (113.6 to 145.9 C) lies wholly over 110 C, so C8 for A5 falls to 1 on the section 3.1 rule; A4's (107.9 to 142.9 C) spans it and stays 2. A5's module case is 105.7 C against the 90 C guidance. A5 puts about twice A4's PA heat in the case: two A5 box criteria fail outside their bands (continuous PETG 66.0 C, long-session cells 58.9 C), none of A4's. Both need a REQ-SYS-112 delta (a duty-limited corner, up to about 60 % duty at 45 C) and a lower REQ-SYS-118 inhibit setpoint on an NTC in the heat path (about 81 C for A5, 77 C for A4). REQ-SYS-113 passes for both only with a wrap-around guard, which adds about +14 mm of length, +4 mm of width and +10 mm of height at the sink end to both (C6 falls to 1 for both).
  2. **PA drive and output power (WP-PDR-21, `pa-drive-ts012.md`, reviewer APPROVED at INSP-114 iteration 3, `f5960d3`).** Neither finalist shows REQ-SYS-012 (3.97 W at the 6.4 V pack end) in any steady key-down case. A5: nominal 4.09 W, lowest corner 3.19 W at 25 C with the filter at its median; with the drain-feed and VGG levers (the note's C2 and C3) -0.17 to -1.21 dB over the key-down cases at the filter median; with every design lever at its best at once -0.45 to +0.84 dB, which needs a 0.5 dB output filter that no LPF build meets (revision 6 wording, INSP-114 X-7). Its fixed drive pad puts the module outside its 10 to 30 mW stability window at 223 of 810 corners; a select-on-test pad closes it only with a level reading shown within +/-1.0 dB. A4: nominal 3.06 W, lowest corner 1.69 W (-3.7 dB), short at every pack voltage; its drive is acceptable. A5 is still 1.3 dB stronger than A4 at the nominal corner, but revision 4's "4.0 to 4.6 W at 6.4 V" for A5 is withdrawn, so C5 for A5 falls from 5 to 4.
  3. **Harmonic LPF (WP-PDR-21, `lpf-ts012.md`, reviewer APPROVED).** Both pass 97.307(e) with the BOM values and catalog coils (A5 7.5 to 9.5 dB; A4 5.5 to 7.5 dB, on an assumed AFT05 harmonic level); A4 needs 2 % parts for the 60 dBc target. No build meets the 0.5 dB passband-loss criterion at the worst case (1.76 dB for the recommended build), which adds to both finalists' REQ-SYS-012 shortfall. A5's binding case (5 W at 8.4 V) is a back-off state outside the module's guarantee.
  4. **Receiver BPF (WP-PDR-19, `rx-bpf-ts012.md` revision 3; INSP-117 iteration 3 NEEDS CHANGES, `e647ab1`; iteration 4 authorized and in progress).** The 2 + 3 resonator filter of revision 4 fails REQ-SYS-033 for both (about 51 dB; revision 4's "well over 90 dB" was wrong). 2 + 3 + 3 met 70 dB by only 0.2 dB at room temperature and is not shown over REQ-SYS-114 (INSP-117 finding-7). **Revision 6: the owner's authorization of INSP-117 iteration 4 adopts 2 + 3 + 4 at IF 8 MHz** (80.1 dB at the design-input corner at room temperature, about 79.4 dB over -10 to +45 C by the reviewer's drift check; residual limit +/-0.97 %), inside row E5 (a). Its four-resonator third section costs MDS: -136.3 dBm (A4) and -134.9 dBm (A5) at the TC-SYS-017 corner (TPM-005 Red there), so the front-end redesign of WP-PDR-19 must recover about 3.7 and 5.1 dB, common to both. Half-IF passes for both (A5's ring 34 to 37 dB margin, A4's JFET 12 to 16 dB, Low). **Revision 8 (INSP-110 finding-26):** superseded by `rx-bpf-ts012.md` revision 4 (`63122e7`; INSP-117 iteration 3 re-issue 1, reviewer APPROVED, `123f048`): 2 + 3 + 4 holds REQ-SYS-033 over REQ-SYS-114 at a worst case of **75.37 dB** (margin 5.37 dB, hot end at 148.0 MHz, +/-0.3 % residual estimate), with an alignment acceptance of **+/-0.62 %** at 20 to 30 C and a limit of **+/-0.64 %** over temperature; the MDS figures stand; no score moves (section 10, revisit (a)).
  5. **Transmit clock spurs (WP-PDR-20, `spurs-ts012.md`, reviewer APPROVED).** Met by wording only for both: with the proposed clock plan and the drive bandpass, 3 lines stay over 25 uW at the high estimate (150.000 MHz and the /8 prescaler kickback). No discrimination; they close only at the tinySA sweep, which waits for the owner's later purchase of the tinySA Ultra.
  6. **Keying envelope (WP-PDR-22, `keying-ts012.md`, reviewer APPROVED at INSP-116 iteration 3, `810850b`).** The loop as revision 4 writes it fails for both. With the revision-1 loop design both pass every element after the first; on the first element of an over A4 passes at the worst-case sum of its estimated budget and A5 does not (its window is 1.6 to 1.8 times narrower). A4 fails REQ-TX-014 (1 uW at key-up) by estimate unless the drive gating becomes part of the key path; revision 6 puts it there in hardware (D-11, D-18), which gives about -67 dBm (A4) and -61 dBm (A5) at key-up by the keying note's path estimate.
- **Cost (section 8.4), sales tax excluded, 15 % contingency on every line, with the analysis-driven parts of row E5 (estimate, USD 5.49 to 19.13 before contingency in revision 6, common to all; it adds item (g), the PA_EN gate, clamp FET and TCXO squaring buffer):** **A5 USD 211.20 low, 248.83 planning, 316.51 worst; A4 with the required TCXO USD 172.31, 205.91, 269.57; A4 with the TCXO and the ring (recommended) USD 174.91, 208.51, 272.17.** A5's worst case is **USD 16.51 over the USD 300 maximum** before the guard ladder: M1 is conditional for A5 (section 4.1). Guards G1 (free Mouser shipping) and G2 bring it to USD 299.83, a margin of USD 0.17; guard G5 (drop the TCXO) is withdrawn, because the TCXO is now a REQ-SYS-182 condition for both finalists. The recommended A4 plans USD 8.51 over the USD 200 target and keeps USD 27.83 of worst-case margin.
- **Risk per dollar (section 8.2, on the section 7.1 scores, revision 6):** A4 now carries six Red risks (the TCXO retires the 30 ppm Red and the hardware drive gating lowers REQ-TX-014 to Yellow); A5 carries eight (seven without the cost Red). The three remaining upgrades from A4 to A5 (module, ring, spare driver; the TCXO is now in both) net **-15 risk points for USD 42.92**, and -31 if A5's cost Red is counted.
- **What the owner gets with the recommended A4:** 5 W at a full pack (nominal corner 5.2 W at 8.4 V) falling to about 3.1 W nominal at the 6.4 V end (lowest corner about 1.7 W), a REQ-SYS-012 delta larger than revision 4 stated; a 500 Hz crystal-ladder receiver with the diode-ring mixer and an MDS near -141 dBm nominal that is not shown at the tolerance corner (the same for A5); the TCXO (REQ-SYS-010 kept, REQ-SYS-182 and REQ-SYS-154 met as written on route R3); an End-of-Life PA with a spare; one flagged part (the leadless TCXO, as A5); half A5's heat in the case; about 161 x 74 x 52 mm at the sink end (estimate) and USD 208.51 planning, 272.17 worst.
- **What A5 would give instead:** about 1.3 dB more output at the nominal corner at the low pack end (still short of REQ-SYS-012), vendor-guaranteed harmonic and stability limits at 6 W and 7.2 V (not at the 5 W, 8.4 V back-off state that binds its harmonic budget), a module in current production, a wider thermal margin on the REQ-SYS-181 cut-off (about 52 K against the module's 175 C channel rating, against about 8 K for A4 at its adverse corner), and an envelope loop that is harder to hold on the first element; for USD 40.32 more at planning, twice the heat in the box and a worst case over the USD 300 maximum before guards.
- **What A2 would give (revision 6, not analysed; section 6 revision 6 item 4):** 305 on the matrix, 5 points above the recommended A4: in-radio USB charging kept (SI-022, CON-010), the TCXO and the diode ring, the best envelope (138 x 67 x 42 mm as its architect drew it), USD 194.19 planning and 255.62 worst. Against that: its C6, C8, C1 and C2 cells are unanalysed estimates of the kind the analyses moved down for both finalists; three flagged parts (C3 1); a new-old-stock PA pair from RF Parts, the RD07MUS2B "no longer available for export"; an LCSC-only charger chain whose JLCPCB merge is unverified; and the Catastrophic HZ-002 charger chain in the box beside the PA.
- **What both give up (section 8.8):** the display (Morse menu instead), in-radio charging, the conductive case coating, the tuning encoder and the stainless SMA jack; continuous key-down at 45 C ambient (REQ-SYS-112 delta to a duty-limited corner); and no transmission on the air before the tinySA sweep, which waits for the owner's tinySA purchase.
- **Problem requiring a decision (one sentence):** which architecture, parts list and requirement set let the owner build the first complete cwht at the owner's home bench within USD 300 worst case (target USD 200), with listed-price parts only.
- **Robustness verdict (06 section 14.4 item 3; section 6 revision 6): Not robust.** The top of the matrix is A2 (305), which was not analysed; the recommended A4 configuration (300) is 5 points behind it and first in 4 of the 16 weight runs (C2 -10, C3 +10, C5 -10, C6 -10), A3 in 2 (C1 -10, C4 +10), A2 in 10; every single Low-cell move in A4's favour or against A2 (8 of 8) ties or reverses them. Between the recommended A4 and A5 the order holds: A4 first in all 16 weight runs (smallest lead 8.8 points, C1 -10), no single Low-cell move closes the 30 points, 19 of the 36 two-move combinations do. A4 scored with the JFET mixer (285) is not robust against A5 either (15 points; 3 weight runs and 6 of 9 single moves). Value of information (06 section 14.4 item 4): the analysis that would settle A2 is named in section 6 revision 6 item 4; the study does not run it, so A2 is presented to the owner with the finalists (Q1) under 06 section 14.5.
- **Pre-order checks (section 7.3, table R5-3):** closed as analyses: the thermal model with the Boyd drawing (gate item 7), the LPF, the transmit clock plan, the drive chain for A4; all six analysis reviews have now run (five reviewer APPROVED; the receiver's iteration 4 in progress). Run but not closed: the A5 drive window (select-on-test pad and a characterized level reading), REQ-SYS-012 (a requirement decision for both), the envelope loop (design items and the fault cases still to run in WP-PDR-22), the receiver image over temperature and MDS (2 + 3 + 4 and the front-end redesign in WP-PDR-19). Not yet done: the feed-resistance datasheet reads, the owner's ordering-gate reads, the in-situ sink and NTC-offset bench measurement (which now also sets the A4 tab cut-off margin), the Si5351A PLL relock time read (the frequency-check time budget), and the reviews of this revision 6 (INSP-110 iteration 3 re-issue 2, INSP-118 iteration 2). **Revision 8:** the receiver's iteration 4 has run (INSP-117, reviewer APPROVED, `123f048`), so all six analysis records are reviewer APPROVED, and the revision 6 reviews have run (section 10); the receiver image over temperature is closed as an analysis (75.37 dB), and its MDS stays open in WP-PDR-19.
- **Three findings for the owner before deciding:**
  1. **Neither finalist meets REQ-SYS-112 or REQ-SYS-012 as written.** Both need a duty-limited junction corner and a low-pack power delta; A4's is larger: its lowest corner at 6.4 V is 1.69 W, 3.7 dB under the 3.97 W floor, against 0.17 to 1.21 dB under it for A5 with the drain-feed and VGG levers at the filter median (1.13 to 2.51 dB at the filter worst case).
  2. **A5's worst case is over the USD 300 maximum** once the parts the analyses add are counted, and passes only through the guard ladder at the gate, by USD 0.17 after G1 and G2 (section 8.4).
  3. **The tinySA Ultra is on the critical path for going on the air, not for ordering.** The owner buys it later (status note 2026-09-28 section 1); the A4 harmonic assumption, A5's back-off harmonic ratio and the three spur lines over 25 uW close only at its sweep.
  4. **(Revision 6.) The TCXO is no longer optional for A4.** Without it REQ-SYS-182 and REQ-SYS-154 do not hold as written; with it both finalists meet them on the same counter route. It costs A4 USD 4.15 and its "no flagged part" advantage (C3), which is why A4 falls from 315 to 285 alone, and to 300 with the ring.
- **Owner's decision (section 10; revision 7):** **A5, decided 2026-09-29** (status note 2026-09-29 section 5, verbatim "A5"), after the owner's condition of section 4 ("I'm leaning towards A5 if it doesn't use outdated components") was answered by the A5 parts lifecycle check (`docs/research/a5-parts-lifecycle-2026-09-29.md`: 39 of 39 parts Active). This is not the recommended alternative (A4 with the TCXO and the ring, 300 against A5's 270); section 10 records the rationale, the conditions A5 carries and the design items fixed for it. The revision 6 text of Q1 (section 8.13) is kept as it was put to the owner.

## 2. Problem and decision context

- **Mission and system context:** the whole radio. The cost cap, the hand-assembly rule and the display removal touch every block of `docs/design/concept.md` sections 5 and 7, the L0 constraints CON-010, CON-015 and CON-026, NGO-027, NGO-028, MOE-007 and MOE-013, and about 80 L1 requirements (section 8.10).
- **Decision needed and intended outcome:** after the decision, the preliminary design has one architecture, one bill of materials with listed prices and sellers, one cost roll-up with an ordering gate, one user-interface concept (Morse audio menu) and one list of requirement deltas for a re-baseline CR. The PDR trades of WP-PDR-19 to 28 then close on this basis instead of the PCBWay turnkey basis.
- **Owner direction (verbatim extracts; the full statements are in the status note).** Section 6: "I think the first radio can't be more than $200 um, all in. Uh, you do not have to account for filament cost." "if I have to go ask a website for a quote for a part, that's a bad sign." "if we need to, you know, design our own amplifiers using MOSFETs, then so be it." "I've used JLCPCB before. So I'm down to get a bare PCB and then solder the through hole components myself." "I would be open to dropping the LCD screen and instead having a Morse code audio only interface." "you would press a button to enter the menu, and then you would hear the options in Morse code, and then you would pick like a letter to go to a different option, and then you can change numbers, and it will read it back to you to confirm that it was correct. And then you would say like Roger for like you know setting it, or um, N for no." Section 8: "Yeah, I'm flexible on the size. Cost is firm. [...] Um, the size and through hole are negotiable. I think ideally it's a through hole part, but if it needs to be a surface mount part, that's fine. I think the the uh, ones that get trickier are ball arrays. or other uh, chips that really require like flow soldering to do them accurately. But I can I can do surface mount parts." "I need to be able to solder it at my home bench you know and I don't have like a very sophisticated soldering setup. I have a heat gun um, I have solder I have flux". **Section 10 (governs the cost reading):** "I'm okay with, you know, I think the range is really $200 to $300, but $300 is really the absolute maximum. And yeah, I'm okay with not counting sales tax. I think I do have 24 gauge magnet wire. I have already a 2-meter antenna with an SMA male plug. Um, I have through-hole resistors and capacitors, but I don't have um, surface mount, and I do have a USB power adapter."
- **Lead SE reading applied here (status note section 10 for cost and owned stock; section 11 for cells, charger and instruments; section 8 items 2 to 6 for parts, board and UI; section 6 where both are silent):**
  1. Cost: target USD 200 for the first complete radio; USD 300 absolute maximum, and the worst case including 15 % contingency stays at or below it. Boards, parts, shipping, import duty and tariff pass-through count; sales tax and filament do not. Test instruments are outside the cap, under the owner's separate USD 300 cap on all new equipment (status note section 11).
  2. Owned (priced at USD 0): 24 AWG magnet wire, a 2 m antenna with an SMA-male plug, through-hole resistors and capacitors (values to be checked against the BOM), a USB power adapter, perfboard, two potentiometers, filament, headphones and a key or paddle. Not owned: surface-mount passives, 18650 cells and a charger (status note section 11: "I don't have any 18650s or chargers"; priced).
  3. Every part has a published price and stock at a catalog distributor or maker shop; nothing sold only on quote.
  4. Through-hole is preferred. Surface-mount parts are acceptable where the owner can hand-solder them with an iron, a heat gun, solder and flux (SOIC, SOT-23, SOT-89, SOT-223, SC-74A, TO-252, 1206 and 0805 passives, QFP and TSSOP of 0.65 mm pitch or more). Excluded: BGA and any part that in practice needs reflow or a stencil. Parts with a hidden exposed thermal pad, and leadless parts with pads under the body, are flagged. A pre-built module with pin headers or castellations and a listed price counts as through-hole compatible (to be confirmed).
  5. Discrete op-amp and MOSFET circuits, including a discrete PA, are welcome; a PA module with leads is a module.
  6. Board: a bare JLCPCB board soldered by the owner; perfboard for prototypes and non-RF sections.
  7. One radio first, in the owner-printed PETG case. Size is negotiable: REQ-SYS-102 (350 g) and REQ-SYS-103 (140 x 70 x 40 mm) are the ideal; deltas are reported.
  8. No display: the Morse-code audio menu replaces it.
  9. Risk per dollar (revision-2 brief, consistent with the section 10 reading that the charging, TCXO, surface-mount and low-pack-power trade-offs are re-evaluated under the ceiling): where the worst case still fits, the lower RF, thermal, emissions and build risk is preferred, and each upgrade's cost and the risk it retires are stated.
- **Constraints:** Part 97 (97.307(e): for a transmitter of 25 W or less each spurious emission is at most 25 uW and at least 40 dB down, which binds at 53.0 dBc at 5 W and 43.0 dBc at 0.5 W, REQ-SYS-017; 60 dBc design target, REQ-SYS-018). The owner's bench (SI-013 and status note section 11: NanoVNA with its calibration loads, a multimeter, a 50 ohm dummy load with a BNC connector, the SI-013 bench supply, a heat gun, solder and flux; no thermocouple; the tinySA Ultra of SI-034 not yet bought, to be bought later inside the USD 300 equipment cap (status note 2026-09-28 section 1); the multimeter is a Fluke 174 without a temperature input, so a K-type thermocouple thermometer is added to the equipment list (status note 2026-09-28 section 2)). The owner's rule that LTspice simulations of the amplifiers and filters must run and count as evidence (status note section 9); LTspice is accredited (ACC-LTSPICE-001, OD-24b, status note section 13).
- **Prior related decisions:** ADR-007 and SI-031 (PCBWay turnkey, owner through-hole only) and SI-028 (PA from DigiKey, Mouser or PCBWay distributors) are superseded if this study is adopted. TS-001 (PD54008L-E PA, Inrad or tolerance-designed ladder, SRR decision 54), TS-007 (Si5351A plus TCXO), TS-004 (4-layer 1.0 mm board), TS-011 (option C printed case with coating and CNC fallback; its M8 finding that PETG fails near a 4 W PA). CR-003 revision 3 and CR-006 revision 2 are Submitted and held for revision (status note section 6).
- **Research consulted (all 2026-09-25 to 2026-09-27):** the seven block research reports of this study (transmitter and PA, receiver, frequency generation, power and charging, UI and audio, fabrication and shipping, enclosure), quoted in section 11; `docs/research/pa-device-candidates.md` (F8 RA07M1317M, F10 AFT05MS004N, F16 to F20); `docs/research/cw-selectivity-options.md`; `docs/research/tr-switch-candidates.md`; `docs/research/keyer-and-key-interfaces.md` F10; the three architectures and three judge reports of section 4.3; the INSP-110 review record; the adversarial RF feasibility check of 2026-09-27 (22 claims, section 9); the author's own web reads marked "read today" in section 8.3.

## 3. Decision matrix setup and rationale

### 3.1 Criteria and operational definitions (revision 2)

Mandatory criteria are pass or fail; an alternative that fails one is dropped before scoring (SE HB section 6.8.1.2.1). Alternatives whose failure turns on an unverified line are still scored, for information and for the sensitivity run.

| ID | Criterion | Type | Operational definition | Scale | Weight |
|---|---|---|---|---|---|
| M1 | Cost ceiling | Mandatory | Worst case at or below USD 300: listed prices plus the high end of every estimated line, every shipping line at its high estimate, board duty at 92.5 % of the whole JLCPCB order (boards plus shipping; the base is unpublished), the Mouser tariff line at 50 % of the China-origin share, all times 1.15. Sales tax excluded (owner, section 10) | pass / fail | n/a |
| M2 | Listed prices | Mandatory | Every part has a published price and non-zero stock at a catalog distributor or maker shop on the read date (aggregator reads accepted provisionally, pending the owner's browser check); no part is sold only on quote | pass / fail | n/a |
| M3 | Hand-solderable | Mandatory | No BGA and no part that in practice needs reflow or a stencil. Leaded parts with pitch under 0.65 mm, leadless parts with pads under the body and hidden-pad parts are admitted only as flagged exceptions and are counted in C3 | pass / fail | n/a |
| M4 | Safety controls | Mandatory | Every hardware hazard control adopted at SRR (REQ-SYS-055, 083 to 085, 092, 120, 180, 181, 182) is implemented with parts used inside their published ratings, or its removal is recorded as a requirement delta for the owner; no Red safety risk that no step reduces to Yellow (06 section 13 item 2) | pass / fail | n/a |
| M5 | Emissions path | Mandatory | A design path to 97.307(e): a harmonic filter of at least 45 dB ideal attenuation at 2f plus a stated verification (LTspice and tinySA) | pass / fail | n/a |
| C1 | Expected cost against the target | Enhancing | Capped planning total (listed prices plus the midpoint of every estimated, shipping, duty and tariff line, times 1.15), USD. At or below the USD 200 target scores 5; above it, points are lost in proportion | 5: <= 200 / 3: 250 / 1: >= 300 (linear) | 20 |
| C2 | Worst-case margin | Enhancing | Capped worst case (the M1 figure), USD | 5: <= 220 / 3: 260 / 1: 300 (linear) | 5 |
| C3 | Hand-solderability | Enhancing | Count of flagged exceptions (hidden pad, leadless with pads under the body, pitch under 0.65 mm) | 1: three or more / 3: one / 5: none | 15 |
| C4 | Build and alignment effort | Enhancing | RF networks the owner designs or tunes by hand plus hand-wound filter, match or transformer coils, and board-area closure | 1: two or more hand matches, wound LPF and BPF, board does not close / 3: one hand match, wound BPF, catalog LPF / 5: no winding, no match to design | 10 |
| C5 | RF and emissions confidence | Enhancing | Evidence behind 5 W at the pack ends, the harmonic budget, stability and MDS: vendor harmonic and stability data, LPF construction, reference accuracy, mixer validation, T/R isolation | 1: no harmonic data, wound LPF, unvalidated mixer, power short of REQ-SYS-012 / 3: no PA harmonic data but catalog LPF and DPDT / 5: guaranteed harmonic and stability limits, catalog LPF, TCXO, validated mixer, DPDT, monitor port | 20 |
| C6 | Envelope and mass | Enhancing | Case volume against 140 x 70 x 40 mm and mass against 350 g | 1: over 20 % volume or over 370 g / 3: up to 8 % over, or one axis over / 5: inside on all axes and under 350 g | 10 |
| C7 | Requirement deltas and firmware scope | Enhancing | Number and size of requirement relaxations, unrecorded gaps and firmware added | 1: safety requirements dropped silently / 3: deltas recorded including KDR relaxations, moderate firmware / 5: wording-only deltas, no firmware added | 5 |
| C8 | Safety and thermal margin | Enhancing | Bounded PA junction against 110 C at 45 C ambient (REQ-SYS-112) at the worst corner (8.4 V pack, ALC back-off); heat path relative to cells and PETG; Catastrophic hazards kept in the box | 1: junction bound over 110 C / 3: bound under 110 C, or heat near PETG needing design controls, or an in-radio charger / 5: bound margin over 20 K, heat outside the case, no charger in the box. Where the junction figure is an estimate range, not a bound: a range wholly under 110 C reads as the bound anchor, a range that spans 110 C scores 2 and a range wholly over 110 C scores 1 (the rule A4 has been scored on since revision 2, stated in revision 4) | 15 |
| | | | | **Sum of weights** | **100** |

Criteria considered (06 section 13 item 1): safety used as M4 and C8; first power-on used as C4 (build and alignment effort is the main first-power-on driver); cost used as M1, C1 and C2; performance margin used as M5 and C5; schedule omitted because every alternative uses a JLCPCB bare board and catalog parts with similar lead times (about 1 to 2 weeks), so it does not discriminate; system security omitted because no alternative changes the USB firmware-loading or key-input attack surfaces of 07 section 16.2 (the Morse menu is common to all and its command path is assessed in WP-PDR-17).

Other criteria considered and not used: sourcing breadth (folded into M2, C5 and the risks of section 7.1), and the judges' three lenses as separate criteria (their content is carried by C1 and C2 for cost and sourcing; C5 and M5 for RF and regulatory; C3, C4, C6 and C8 for buildability, size and safety).

### 3.2 Alternatives

| ID | Alternative | Description | Source |
|---|---|---|---|
| A0 | Current baseline (do nothing) | SRR concept: PCBWay 4-layer board with turnkey SMT, PD54008L-E PA, Inrad #111 or tolerance ladder with 24-bit ADC, LS013B7DH03 display, encoders, in-radio 2S charging, printed case with coating and a PCBWay CNC fallback; unit budget USD 610 over three units | `docs/plan/cost-estimate.md`; TS-001; TS-011; CR-003; CR-006 |
| A1 | min-cost (as submitted) | AFT05MS004NT1 SOT-89 PA with GVA-84+ driver, JFET superhet with hand-matched 500 Hz ladder, Morse-only UI, cells charged in an XTAR VC2, one Mouser order plus two JLCPCB boards | Architecture report "min-cost" |
| A2 | performance-in-cap PIC-5 | RD01MUS2 plus RD07MUS2B discrete pair (RF Parts), bare Si5351A with HCI TCXO, diode-ring superhet, ADC audio path, in-radio 2S charger (CN3302 chain, LCSC), four buttons | Architecture report "performance-in-cap" |
| A3 | buildability B1 | RA07M1317M module PA (RF Parts), no hand-wound parts (Coilcraft LPF, XRMW slug-tuned BPF from LCSC, TC1-1T+ mixer), bare Si5351A with TCXO, ADC audio, charging outside the radio, 40 dB monitor port, sink inside the case | Architecture report "buildability" |
| A4 | min-cost with grafts, revision 2 | Revision-1 A4 (A1 plus the Coilcraft LPF, G5V-2 DPDT relay, second LM393, plated slot and via field, XTAR MC1, ordering gate) repaired: spare AFT05 in the order (EOL, finding-1), the 74LVC1G80 divider chain (finding-3), 0.8 mm PA board and thermal compound (adversarial C4, C19), a drive low-pass filter, the monitor port in the baseline (finding-9), a second button (finding-7); owned wire and antenna; TCXO as an add-back. Revision 5 adds the common design items of section 8.14 (row E5) that the pre-order analyses require. **Revision 6 makes the TCXO a required item** (route R3 of REQ-SYS-182, D-17) and adds the REQ-SYS-181 sensor on the tab copper (D-6) and the PA_EN gating (D-18); the recommended configuration also takes A5's diode-ring mixer (U3) | This study, sections 7.3, 8.4 and 8.14 |
| A5 | hybrid H1 (presented with A4, section 8) | A4 revision 2 with the RA07M1317M module PA in place of the AFT05 and its hand match, the TG2520SMN TCXO fitted, the diode-ring mixer on two BN-43-202 cores wound from the owner's 24 AWG wire in place of the JFET mixer, and a spare GVA-84+; revision 3 adds a VGG clamp and a vented PA bay; revision 4 sizes the clamp at 3.46 V or less over the LDO's temperature range and 1 % resistors (no cost); revision 5 adds the common design items of section 8.14 (row E5) and the A5-only select-on-test drive pad; revision 6 adds the route R3 counter input and the PA_EN gating (D-17, D-18) | This study, sections 8.1 to 8.4 and 8.14 |

Alternatives pruned before scoring, with reason:
- **All-through-hole radio.** No through-hole VHF final is in active production at a catalog distributor; the NOS RD06HVF1 (TO-220, RF Parts USD 9.91) gives an estimated 3.5 to 4.5 W at 7.2 V and about 2.8 W at 6.0 V, and TO-39 bipolar chains give 0.5 to 1 W (transmitter research). Pruned as infeasible at 5 W.
- **Generic MOSFET PA (IRF510, BS170, 2N7000).** 0 to 5 dB of power gain at 144 MHz for the IRF510 (Ciss 135 to 180 pF, 7 nH source lead); the BS170 and 2N7000 are 0.1 to 0.3 W pre-drivers at best (estimate). Pruned on physics.
- **Direct-conversion receiver.** 0 dB opposite-sideband response and a 3 dB double-sideband noise penalty; fails REQ-SYS-022 and 025. Kept only as a perfboard audio-chain prototype.
- **SA612 mixer, commercial CW filters (Inrad #111 USD 118, KVG on quote), LMX2571 synthesizer (WQFN with exposed pad, 0.5 mm).** Discontinued, over budget for their function, sold on quote, or reflow-only.
- **In-radio 2S charging (revision 2 re-check under the ceiling).** The USB-input 2S charger ICs found (CN3302 with HY2213 balancers and FS8205A switches) are LCSC-only; no leaded USB-to-2S charger IC with a Mouser listing was found in the power research. Adding it costs an estimated USD 7 to 14 capped in parts plus USD 0 to 23 capped of LCSC shipping if the JLCPCB merge is not offered, and puts the Catastrophic HZ-002 charger chain back in the box beside a PA sink that dissipates 8.5 to 10 W. Not cheap and not safer; pruned for build 1 (owner question Q3, section 8.13).
- **A spare RA07M1317M in the baseline.** USD 33.25 capped; it pushes the A5 worst case to about USD 327.8, over the ceiling. Kept as a gate add-back (AB-A, section 8.4).
- **Perfboard or Manhattan for the RF sections.** Admitted for prototypes and non-RF sections only; a 144 MHz LPF, drive chain and front end need controlled ground and short returns that a 2-layer board with a solid pour gives for USD 2.

### 3.3 Weight rationale

Cost carries 25 (C1 20, C2 5), down from 35 in revision 1, because the owner's section 10 answer turns the firm USD 200 cap into a USD 200 target with a USD 300 absolute maximum: the ceiling is enforced by M1, and C1 now scores the distance above the target. The 10 points freed go to RF and emissions confidence (C5, 15 to 20; a legal limit, 97.307(e), and the radio's purpose) and to safety and thermal margin (C8, 10 to 15; REQ-SYS-112 is a KDR and the PETG case has a 69 C heat-deflection temperature, TS-011 M8), following the risk-per-dollar reading of section 2 item 9. Hand-solderability (C3, 15) stays high because it is the owner's stated reason for the SMD boundary. Build effort (C4, 10) and envelope (C6, 10, negotiable) follow; deltas and firmware scope (C7, 5) matter least because the Morse UI adds the same firmware to every alternative. No weight was set by the owner directly.

### 3.4 Evaluation methods

| Criterion | Method | Tool | Evidence artifact |
|---|---|---|---|
| M1, C1, C2 | Cost query (listed pages, aggregator), budget roll-up with contingency | Python roll-up script (author's scratchpad, reproduced in section 8.4) | Sections 4.1 and 8.4 |
| M2 | Cost query | WebFetch of seller and OEMsTrade pages | Section 8.3 URLs |
| M3, C3 | Datasheet and package comparison | Research reports, datasheets | Section 8.6 |
| M4, C8 | Requirement trace, datasheet ratings and, from revision 5, the WP-PDR-28 lumped thermal model with an RSS uncertainty band per verdict | Python solver cross-checked by an LTspice electrical analogue (ACC-LTSPICE-001) | Sections 7.3, 8.10; `docs/design/analysis/thermal-ts012.md` |
| M5, C5 | Datasheet comparison; from revision 5, LTspice analyses of the drive chain and output power, the harmonic LPF with a worst-case corner search, the receiver BPF, half-IF and cascade, the transmit clock spur plan and the keying envelope | LTspice 26.0.2 through `tools/ltspice-batch.sh` (ACC-LTSPICE-001); Python checkers (developer evidence, no TV record) | Section 7.3 table R5-2; the five analysis notes of section 9 table R5-1 |
| C4 | Design inspection | Architecture reports | Section 4.2 |
| C6 | Budget analysis (stack-up, mass roll-up) | Hand calculation | Section 8.5 |
| C7 | Requirement trace | `docs/requirements/sys/requirements.json`, `docs/requirements/sw/sw-keyer/requirements.json` | Section 8.10 |

### 3.5 Setup matrix (before scoring)

| Criterion | Weight | A0 | A1 | A2 | A3 | A4 | A5 |
|---|---|---|---|---|---|---|---|
| M1 to M5 | n/a | | | | | | |
| C1 | 20 | | | | | | |
| C2 | 5 | | | | | | |
| C3 | 15 | | | | | | |
| C4 | 10 | | | | | | |
| C5 | 20 | | | | | | |
| C6 | 10 | | | | | | |
| C7 | 5 | | | | | | |
| C8 | 15 | | | | | | |

## 4. Scoring rationale

### 4.1 Cost re-roll under the owner budget and mandatory screening

**Re-roll method.** Every alternative is re-rolled with the section 10 budget: owned items removed (magnet wire, the SMA-male antenna plug, through-hole resistors and capacitors), no sales tax, and the same shipping, duty and tariff treatment: board duty 35 % to 92.5 % (JLCPCB US tariff FAQ, base unpublished; planning on the board value, worst case on boards plus shipping), Mouser tariff pass-through USD 4 to 12 at planning and USD 15 worst (50 % of a USD 30 China-origin share, the Section 301 rate on HTS 8541 and 8542 reported for 2025), 15 % contingency on every line. A4 and A5 are re-rolled line by line (section 8.3). A1, A2 and A3 are re-rolled from their architects' totals, because their line items were not re-read: the owner credits are the architects' own guard values where they gave one (A2's magnet-wire guard G1 -14.28), otherwise the A4 values (antenna plug -5.18 planning and -6.90 high, through-hole passives -4.03 and -1.73); those three rows are **Low** confidence.

**Revision 5: row E5 on every alternative.** The pre-order analyses add parts that every alternative with this receiver, drive chain, keying loop and clock plan needs (section 8.14): a third receiver BPF section and J310 port matching, the keying-loop items, the CLK1 coax interface, supply filters, a PA-case NTC, and the recommended drive bandpass and 2 % LPF parts. Row E5 carries them as an estimate of USD 5.19 to 17.63 before contingency (planning at the midpoint, 11.41), that is USD 5.96 / 13.12 / 20.27 capped, added to every row below. The spur analysis said its own items fit inside the existing E rows and contingency; this study does not take that, because the E2 row covers about 22 values already counted and the gate contingency covers build-time growth, not design additions (section 8.4). Figures in brackets are revision 4.

**Revision 6: item (g) of row E5 and the TCXO in A4.** Row E5 gains item (g), the PA_EN gate, its clamp FET, the TCXO squaring buffer for the second GPIN and a GVA-84+ supply P-FET where a line-up lacks one (USD 0.30 to 1.50 before contingency, estimate; section 8.14 D-17 and D-18). E5 is now USD 5.49 to 19.13 before contingency (planning 12.31), USD 6.31 / 14.15 / 21.99 capped, on every row below. A4 also carries the TG2520SMN (Mouser USD 3.61 listed, 4.15 capped) as a required item. Figures in brackets are revision 5.

| Alternative | Planning, capped | Worst case, capped | Basis |
|---|---|---|---|
| A1 | 170.33 (not re-rolled; dropped at M4) | 221.74 | Revision-1 planning 193.85 (with tariff and AO3400A), minus wire 15.17, plug 5.18 and passives 4.03, plus the duty change 0.86; worst from about 214 |
| A2 | 194.19 (193.16) | 255.62 (253.90) | Revision-1 planning 202.67 with tariff, minus the architect's wire guard 14.28, plug 5.18, passives 4.03, plus duty 0.86; worst from about 225. Its LCSC-into-JLCPCB merge for the CN3302 chain stays unverified |
| A3 | 253.72 (252.68) common basis; 190.90 (architect basis, not re-rolled) | 309.89 (308.16) LCSC merged or 332.89 (331.16) LCSC separate; 264.16 (architect basis) | Architect basis: revision-1 about 205 with tariff, minus plug, passives and the unavailable IMR VC2 (MC1 in its place, -5.75). Common basis: A3's parts coincide with A5 except the bare Si5351A (-6.62 capped against the Adafruit module) and the XRMW coils from LCSC (USD 0 to 20 of LCSC shipping unless merged, +11.50 capped at the midpoint). The common basis is used for scoring because A3's own shipping lines were lower than this study's common estimates |
| A4 (revision 6, TCXO required) | 205.91 (200.73) | 269.57 (263.69) | Section 8.4 |
| A4 with the ring U3 (recommended configuration) | 208.51 (203.33) | 272.17 (266.29) | Section 8.4 |
| A5 | 248.83 (247.80) | 316.51 (314.78) | Section 8.4 |

| Alternative | M1 worst <= 300 | M2 listed | M3 solderable | M4 safety | M5 emissions | Result |
|---|---|---|---|---|---|---|
| A0 | **fail**: PCBWay turnkey alone USD 300 to 500 | pass | pass (turnkey places the SMT) but moot | pass | pass | dropped |
| A1 | pass (221.74) | pass (provisional) | pass | **fail**: REQ-SYS-055 and REQ-SYS-182 not implemented and no delta recorded (judges 0, 1, 2) | pass | dropped; A4 is its repair |
| A2 | pass (255.62, Low) | pass (provisional; the RD07MUS2B is RF Parts new-old-stock, "no longer available for export"; the CN3302 chain is LCSC-only) | pass with three flagged exceptions (hidden-pad leadless RD07MUS2B, 0.5 mm MSOP Si5351A, leadless TCXO) | pass | pass | kept |
| A3 | **fail on estimated lines** (revision 5; revision 6: 309.89 even if LCSC ships in the JLCPCB parcel; 332.89 otherwise; the A3 and A5 readings of M1 differ, INSP-110 finding-21, a lien) | **fail as submitted**: Mini-Circuits TC1-1T+ shows 0 stock at Mouser and DigiKey today (USD 3.68 listed); passes with the A5 binocular-core substitution | pass with two flagged exceptions (0.5 mm MSOP, leadless TCXO) | pass | pass | kept for information; fails M1 on estimated lines (revision 5) |
| A4 | pass (revision 6: 269.57, margin 30.43; 272.17 with the ring, margin 27.83) | pass (provisional; AFT05MS004NT1 End of Life, stock Mouser 72 and Newark 1,519 "Available Until Stocks Are Exhausted") | pass (revision 6: one flagged exception, the required TG2520SMN, as A5) | **pass on the revision 6 conditions** (INSP-118 findings 1 to 3): REQ-SYS-182 and REQ-SYS-154 on route R3 with the TCXO (D-17); REQ-SYS-181 on NTC-2 at the tab copper, trip junction at most about 142 C against the AFT05's 150 C maximum operating junction (D-6); REQ-SYS-120 on PA_EN and TX_KEY in a hardware gate (D-18); divider inside its rating. Revision 5's pass rested on a sink cut-off that never acts for A4 and on a REQ-SYS-182 budget without the counter term; it is withdrawn | pass (97.307(e) by 5.5 to 7.5 dB on an assumed harmonic level, LPF analysis) | kept |
| A5 | **conditional** (revision 6): 316.51, USD 16.51 over, on estimated lines (E5, shipping, duty); 299.83 after guards G1 and G2 (margin USD 0.17; section 8.4); revision 5 314.78 and 298.10; revision 4 passed at 294.51 | pass (provisional; RA07M1317M-501 at RF Parts USD 28.91 "In Stock", read today; Mitsubishi "Active", read today) | pass with one flagged exception (TG2520SMN, 4 pads under the body) | pass (revision 6: with the route R3 second GPIN and the PA_EN gating, D-17 and D-18; REQ-SYS-181 on the sink acts with the channel at about 120 to 123 C against 175 C) | pass (97.307(e) by 7.5 to 9.5 dB, LPF analysis; the binding 8.4 V state rests on an estimate) | kept, M1 conditional (scored, as A3 was in revision 4) |

### 4.2 Enhancing scores

Scores are interpolated linearly between anchors and rounded to the nearest integer. A1 is scored for information only (dropped at M4).

| Criterion | Alt | Measured value | Score | Conf. | Evidence |
|---|---|---|---|---|---|
| C1 | A1 | USD 170.33 | 5 | Low | section 4.1 |
| C1 | A2 | USD 194.19 (revision 6; revision 5 193.16) | 5 | Low | section 4.1 |
| C1 | A3 | USD 253.72 (revision 6, common basis, LCSC midpoint, with E5; interpolates to 2.9; revision 5 252.68) | 3 | Low | section 4.1 |
| C1 | A4 | USD 205.91 (revision 6, with the required TCXO and E5 (g); interpolates to 4.76; with the ring 208.51, 4.66; revision 5 200.73) | 5 | Low | section 8.4 |
| C1 | A5 | USD 248.83 (revision 6; interpolates to 3.05; revision 5 247.80; revision 4 234.68 gave 3.6, score 4) | **3** | Low | section 8.4 |
| C2 | A1 | USD 221.74 | 5 | Low | section 4.1 |
| C2 | A2 | USD 255.62 (revision 6; 3.2; revision 5 253.90; revision 4 233.63 gave 4) | **3** | Low | section 4.1 |
| C2 | A3 | USD 309.89 to 332.89 (revision 6) | 1 | Low | section 4.1 |
| C2 | A4 | USD 269.57 (revision 6, TCXO required; 2.52, rounds to 3); with the ring 272.17 (2.39, scores **2**); revision 5 263.69; revision 4 243.42 gave 4 | **3** (2 with the ring) | Low | section 8.4 |
| C2 | A5 | USD 316.51 (revision 6; over the 300 anchor; revision 5 314.78) | 1 | Low | section 8.4 |
| C3 | A1 | no exception | 5 | High | min-cost section 6 |
| C3 | A2 | three exceptions | 1 | High | PIC-5 EX-1 to EX-3 |
| C3 | A3 | two exceptions | 2 | High | B1 exceptions |
| C3 | A4 | revision 6: one exception, the TG2520SMN TCXO that REQ-SYS-182 now requires (leadless 2.5 x 2.0 mm, 4 pads under the body, no thermal pad; the same part A5 carries). The 74LVC1G80GV (SC-74A, 0.95 mm) and the item (g) gates (SC-74 or SC-74A class, 0.95 mm pitch) are not flagged. Revision 5: no exception (TCXO not fitted), 5 | **3** | High | section 8.6 |
| C3 | A5 | one exception (TG2520SMN leadless 2.5 x 2.0 mm, 4 pads under the body, no thermal pad) | 3 | High | section 8.6 |
| C4 | A1 | NXP match with wound coils, wound LPF, wound BPF, crystal matching, two boards | 2 | Medium | min-cost report |
| C4 | A2 | two copied match networks, wound LPF and BPF, charger chain, board does not close (67 cm2 on 60 cm2) | 1 | Medium | judges 0, 1, 2 |
| C4 | A3 | no winding, module PA, slug-tuned BPF, one board | 5 | Medium | B1 report |
| C4 | A4 | one hand match re-derived for a 0.8 mm board from the NXP Zsource and Zload table (adversarial C4), wound BPF, catalog LPF | 3 | Medium | section 7.3 |
| C4 | A5 | no match to design (50 ohm module), wound BPF and two trifilar ring transformers from owned wire, catalog LPF | 4 | Medium | section 8.1 |
| C5 | A1 | no AFT05 harmonic data, wound LPF, 30 ppm, unvalidated JFET mixer, SPDT relay | 1 | Low | judge 1; adversarial C2 |
| C5 | A2 | vendor line-up harmonics (2f -37 to -40 dBc at 5 W), TCXO, diode ring, wound LPF, two hand matches | 4 | Medium | pa-device-candidates F4 |
| C5 | A3 | guaranteed module harmonics (2fo -25, 3fo -30 dBc max) and stability limits, Coilcraft LPF, TCXO, DPDT, monitor port; revision 5: the same RA07M1317M, so the A5 findings on low-pack power and the drive window apply (A3 was not analysed) | **4** | Low | pa-device-candidates F8; `pa-drive-ts012.md` section 5 |
| C5 | A4 | no AFT05 harmonic data (97.307(e) passes by 5.5 to 7.5 dB on the assumed -15 dBc, LPF analysis; 60 dBc needs 2 % parts); match rebuilt; revision 5: 3.06 W nominal and 1.69 W at the lowest corner at 6.4 V, short of 3.97 W at every pack voltage at the lowest corner (PA drive analysis); drive inside its limits; stability unanalyzed; 30 ppm; JFET mixer (half-IF 12 to 16 dB margin, Low); catalog LPF, DPDT, monitor port. Confirmed at 2; the -1 move is in section 6. **Revision 6:** the TCXO is fitted (REQ-SYS-010 kept), which removes the 30 ppm term; the low-pack power, the missing harmonic data and the unvalidated JFET mixer still hold the cell at 2, as revision 5 read the ring alone. With the TCXO and the ring together (the recommended configuration) the cell reads 3, as revision 5 read the U2 and U3 hybrid | 2 (3 with the ring) | Low | section 7.3 table R5-2 |
| C5 | A5 | revision 5: REQ-SYS-012 not shown at 6.4 V in any steady key-down case (nominal 4.09 W, lowest corner 3.19 W at 25 C with the LPF at its median; -0.17 to -1.21 dB over the key-down cases with the drain-feed and VGG levers C2 and C3 at the LPF median, and -0.45 to +0.84 dB only with every design lever at its best, which needs a 0.5 dB output filter no LPF build meets; revision 6 wording, INSP-114 X-7), withdrawing revision 4's 4.0 to 4.6 W; the fixed drive pad leaves the module outside its 10 to 30 mW stability conditions at 223 of 810 corners (select-on-test pad and a characterized reading needed); harmonic limits guaranteed at 6 W and 7.2 V, but the binding 5 W, 8.4 V case is a back-off state resting on the -17 dBc estimate (97.307(e) margin 7.5 to 9.5 dB); catalog LPF; TCXO; diode ring (half-IF 34 to 37 dB margin); DPDT; monitor port. Between anchors 3 and 5: 4 (revision 4 scored 5) | **4** | Low | section 7.3 table R5-2 |
| C6 | A1 | 142 x 70 x 42 mm (+6.5 %); 275 to 345 g | 3 | Medium | min-cost report |
| C6 | A2 | 138 x 67 x 42 mm including the SMA; about 293 g | 4 | Low | PIC-5 section 5 |
| C6 | A3 | 124 x 69 x 46 mm (+2.1 %, height over); about 295 g | 3 | Medium | judges 1, 2 |
| C6 | A4 | revision 5: about 161 x 74 x 52 mm at the sink end (sink wholly outside the end wall, +6.6 mm; wrap-around guard with 10 mm end clearance, +12 mm; thermal note section 8 changes 1 and 3, which REQ-SYS-113 needs: the revision-4 layout fails it at 49.7 C); about +31 % volume (estimate: a 44 mm sink-end block at 74 x 52 mm and the body at 70 x 42 mm); mass not re-rolled (sink read at 57 g). Revision 4: 142 x 70 x 42 mm, score 3 | **1** | Low | `thermal-ts012.md` sections 4.2 and 8 |
| C6 | A5 | revision 5: about 167 x 74 x 52 mm at the sink end (174 mm with the SMA; thermal note section 8 change 3), about +35 % volume (estimate, same method as A4); about 311 to 371 g (estimate: sink read at 57 g, 52 to 62 g, and 3 to 8 g more guard). Revision 4: 153 x 70 x 42 mm, score 2 | **1** | Low | `thermal-ts012.md` section 8; section 8.5 |
| C7 | A1 | 010 relaxed 12x; charging retired; 055 and 182 dropped without a delta | 2 | Medium | judges 0, 2 |
| C7 | A2 | 010 and charging kept; ADC audio path needs a TS-001 re-ruling; largest firmware | 3 | Medium | PIC-5 section 8 |
| C7 | A3 | 010 and 141 kept; charging retired; ADC audio re-ruling; DSP firmware | 3 | Medium | B1 report |
| C7 | A4 | 010 relaxed to 30 ppm (KDR, TBR); 012 relaxed at the 6.4 V end (KDR); 112 not shown; charging retired; analog audio. Revision 6: 010 kept (TCXO fitted); 012 and 112 KDR deltas, the REQ-SYS-181 sensing-point wording and the REQ-TX-014 restatement remain: still "deltas recorded including KDR relaxations, moderate firmware" | 3 | Medium | section 8.10 |
| C7 | A5 | 010, 012, 141 kept; but four header KDRs relaxed or retired (REQ-SYS-102 to 365 g TBR, 103 to 153 x 70 x 42 mm, 137 retired, 140 widened to RF Parts) plus 029, 031, 083, 084 (at risk), 106 and 109; charging retired; Morse menu, adaptive decoder and VGG envelope loop firmware added: "deltas recorded including KDR relaxations, moderate firmware" (revision 3, finding-13; revision 2 scored 4) | 3 | Medium | section 8.10 |
| C8 | A1 | Tj about 160 C with 8 vias (judge 1) | 1 | Low | judge 1 |
| C8 | A2 | Tj about 92 C (unbounded); full in-radio 2S charger (HZ-002 kept, with its controls). Revision 5: A2 was not analysed, but the WP-PDR-28 model put both analysed PAs 20 to 40 K above their catalog-rating estimates (A4 100 to 135 C to 122.7 C; A5 87 to 119 C to 126.0 C), because the in-situ sink resistance is 5.6 to 7.9 K/W against the 2.6 K/W rating. An unbounded 92 C figure from the same kind of chain is therefore not read as a range wholly under 110 C; with the charger in the box the cell reads 2 (Low) | **2** | Low | PIC-5 section 4; `thermal-ts012.md` section 3 |
| C8 | A3 | module sink inside the PETG case beside the cells at 8.5 to 10 W. Revision 5: the same module with the whole sink inside the case is worse than the A5 layout the thermal model ran as revision 4 drew it (junction 142.1 C, band -18.6 K, wholly over 110 C) | **1** | Low | judges 1, 2; `thermal-ts012.md` section 5 |
| C8 | A4 | revision 5 (WP-PDR-28): junction 122.7 C at the REQ-SYS-112 corner with the section 8.14 design changes, band +20.3 / -14.7 K, so 107.9 to 142.9 C: a range that spans 110 C (section 3.1 rule); 131.0 C as revision 4 drew it. Half A5's heat in the box: no box criterion fails outside its band; the long-session cells at the duty limit fail by 0.2 K inside it; the REQ-SYS-118 inhibit on the pad needs about 77 C, not 85 C; the 95 C sink cut-off never acts at 45 C. Revision 6 (INSP-118 finding-2): the REQ-SYS-181 sensor moves to the tab copper (D-6), where it bounds the thermistor-failure branch at a junction of at most about 142 C against the 150 C rating; the cell scores the REQ-SYS-112 corner, so it stays 2 | 2 | Low | `thermal-ts012.md` sections 5 and 6 |
| C8 | A5 | revision 5 (WP-PDR-28): junction 126.0 C at the REQ-SYS-112 corner with the section 8.14 design changes, band +20.0 / -12.4 K, so 113.6 to 145.9 C: **a range wholly over 110 C**, which scores 1 on the section 3.1 rule (revision 4 scored 2 on 87 to 119 C). 142.1 C as revision 4 drew it. Module case 105.7 C against the Mitsubishi 90 C guidance. About twice A4's PA heat in the case: two box criteria fail outside their bands (continuous PETG guard 66.0 C, 6.0 K over; long-session cells at the duty limit 58.9 C, 3.9 K over, under the 60 C trip); relay ambient 67.1 C over its 65 C rating; the REQ-SYS-118 inhibit on the flange needs about 81 C. The thermal record's own summary reads C8 as 2 for both; its band arithmetic gives 113.6 C as the low end for A5 (`bands.csv`, V01 A5-DC: 125.95 - 12.36), so this study applies the rule to the numbers and routes the difference to INSP-112 (section 9) | **1** | Low | `thermal-ts012.md` sections 5 and 6; `hardware/sim/thermal/results/2026-09-28-ts012-r2/margins_vs_band.png` |

**Revision 5 re-scoring (on the analysis evidence; section 7.3 table R5-2).** Ten cells change. C1: A5 4 to 3 (row E5). C2: A2 and A4 4 to 3 (row E5). C5: A5 5 to 4 and A3 5 to 4 (the module findings). C6: A4 3 to 1 and A5 2 to 1 (the wrap-around guard REQ-SYS-113 needs). C8: A5 2 to 1 and A3 2 to 1 (junction range wholly over 110 C), A2 3 to 2 (evidence parity, stated in its row). Unchanged on the evidence: C3 (no new flagged part: the added 74LVC1G66 and 2N7002 class parts are SC-74A and SOT-23), C4 (the third BPF section and the per-resonator alignment apply to every alternative with this receiver; A5's select-on-test pad is a tuning step that moves A5 toward 3, carried as a note, not a score), C7 (both finalists add a REQ-SYS-112 delta, a REQ-SYS-118 setpoint and loop firmware; A4 also a wider REQ-SYS-012 delta and a REQ-TX-014 change, A5 a firm REQ-SYS-012 delta and the REQ-SYS-144 pad step: both stay at "deltas recorded including KDR relaxations, moderate firmware"). M4 still passes for both, with one note for A5: open loop at 8.4 V from a -10 C start the module may exceed its 10 W maximum rating from 8.1 V (estimate, PA drive analysis section 5 (g)), so the pack-dependent VGG clamp that revision 4 held as a fallback becomes a design item (section 8.14, no cost), with REQ-SYS-156 and the 10 s cutoff as the time bounds. A2 and A3 were not finalists and were not analysed; only the common-basis items (E5 costs), the items that follow from sharing A5's module (A3) and the evidence-parity reading of A2's junction figure are applied to them.

**Revision 6 re-scoring (INSP-118 findings 1 to 3; section 7.3).** One cell changes on the evidence: **C3-A4 5 to 3**, because the reviewed frequency-budget method shows that A4 holds REQ-SYS-182 and REQ-SYS-154 as written only with a countable TCXO (route R3), so the TG2520SMN, the one flagged part, is now required. Every other cell holds: the TCXO and the item (g) parts move C1-A4 from 4.97 to 4.76 and C2-A4 from 2.8 to 2.52 (both still round to 5 and 3); C5-A4 stays 2 (the 30 ppm term goes, the power, harmonic-data and mixer terms stay); C7-A4 stays 3; C8 is set by the REQ-SYS-112 corner, which the tab sensor does not change; item (g) moves no other alternative's cell (A2 C1 5.0, C2 3.2; A3 C1 2.85, C2 1; A5 C1 3.05, C2 1). The recommended configuration adds U3: C5-A4 reads 3 with the TCXO and the ring together (revision 5's hybrid reading) and C2-A4 falls to 2 (272.17). A2's C6 is not re-scored by parity with the finalists' wrap guard, although INSP-110 finding-19 asked why only C8 was: C8-A2's parity reading rests on a model finding that applies to any catalog-rated sink in a closed case (in-situ 5.6 to 7.9 K/W against the 2.6 K/W rating), while the finalists' C6 loss comes from their own sink-end layout (the sink wholly outside the end wall and a wrap-around guard for REQ-SYS-113), which A2's architect did not draw and no record has modelled. Section 6 revision 6 item 4 carries the C6 reading as a sensitivity (A2 275 to 295).

### 4.3 Independent architects' and judges' results (inputs to this study)

Three architects worked independently, one per angle (minimum cost, performance inside the cap, buildability); three judges then scored all three, each through a different lens. Their numbers were produced under the revision-1 cap of USD 200 and are reproduced here unchanged as evidence; this study's own matrix is section 5.

**Architect totals (capped, including 15 % contingency, as submitted):**

| Architecture | Low | Planning or expected | High |
|---|---|---|---|
| min-cost (A1) | 169.15 | (midpoint 184.16) | 199.17 |
| PIC-5 (A2) | 165.50 | 196.92 | 218.28 |
| B1 (A3) | 183.05 | 199.23 | 240.02 |

**Judge 0 (cost-and-sourcing lens; 1 to 10; weighted = cost x3, sourcing x2, envelope x2, others x1, maximum 120):**

| Criterion | min-cost | PIC-5 | B1 |
|---|---|---|---|
| Fits USD 200 with contingency | 8 | 6 | 5 |
| Listed-price sourcing verified | 5 | 6 | 6 |
| Envelope and mass | 5 | 7 | 7 |
| Hand-solderability | 9 | 4 | 6 |
| 97.307(e) and RF credibility | 5 | 6 | 8 |
| Safety controls kept | 4 | 7 | 7 |
| Owner buildability | 6 | 4 | 8 |
| Firmware scope | 7 | 5 | 6 |
| Requirement deltas | 4 | 7 | 6 |
| **Unweighted (/90)** | **53** | **52** | **59** |
| **Weighted (/120)** | **79** | **77** | **82** |

Judge 0's ranking put min-cost first, "ONLY IF" REQ-SYS-055 and REQ-SYS-182 are restored, although B1 has the higher weighted total: the judge ranked on the cost cap, not on the total. Revision 1 resolved that by making the cap mandatory; revision 2 keeps the ceiling mandatory (M1) and scores the target distance (C1).

**Judge 1 (RF-and-regulatory lens; 1 to 10; unweighted sum):** min-cost 60, B1 57, PIC-5 51. Cost: 8 / 4 / 5 (min-cost / B1 / PIC-5); sourcing 7 / 6 / 6; envelope 6 / 6 / 8; hand-solderable 9 / 6 / 4; emissions and RF 5 / 9 / 8; safety 6 / 6 / 7; buildability 5 / 8 / 4; firmware 8 / 5 / 4; deltas 6 / 7 / 5. Ranking: min-cost, B1, PIC-5.

**Judge 2 (owner buildability, size and safety lens; 1 to 10; weighted out of 10):** min-cost 6.8, PIC-5 5.9, B1 5.6. Cost 8 / 5 / 4 (min-cost / PIC-5 / B1); sourcing 6 / 6 / 6; envelope 6 / 8 / 6; hand-solder 9 / 4 / 6; emissions 6 / 7 / 8; safety 6 / 7 / 5; buildability 7 / 4 / 7; firmware 8 / 5 / 5; deltas 4 / 6 / 6. Ranking: min-cost, PIC-5, B1.

**All three judges ranked min-cost first, each conditionally, under the USD 200 cap.** Their arithmetic checks reproduced the architects' totals, with these corrections: min-cost's own AO3400A flag (+0.86) moves its high case to 200.16 (judge 1); PIC-5's planning total is 196.93, not 196.92 (rounding); B1's itemized expected rows re-sum to about USD 199.63 (judge 2). Judge 1 also found B1 the strongest RF design (9 of 10), and every judge's cost preference for min-cost was a preference under a cap that the owner has since moved.

**Findings the judges called fatal or near-fatal, and their treatment in revision 2:**

| Finding (judge) | Treatment |
|---|---|
| min-cost drops REQ-SYS-055 and REQ-SYS-182 with no delta (0, 2) | Restored in A4 and A5: second LM393P monostable; 74LVC1G80GV divide-by-8 chain into an RP2350 PWM edge counter (section 8.1); revision 6: into the RP2350 FC0 counter on GPIN0, with the TCXO on GPIN1 (route R3, section 7.3) |
| min-cost PA thermal path: 8 vias of 0.3 mm give Tj about 160 C (1) | A4: plated slot, via field, 0.8 mm board, compound; still not shown under 110 C. A5: module flange on the sink through compound, bound 103 C (section 7.3) |
| No architecture counts Mouser's tariff pass-through (2) | Carried in every total, worst case at 50 % |
| min-cost has no AFT05 harmonic data and wound LPF coils; SPDT relay overstresses the RX clamps (0, 1, 2) | Coilcraft LPF and G5V-2 DPDT in A4 and A5; A5's module has guaranteed harmonic maxima |
| Sourcing evidence for Mouser is aggregator-only (0) | Owner price-check list (section 8.11) before ordering |
| Boyd sink height disputed (0, 1, 2) | Settled at 25.4 mm fin depth and 41.9 mm height (Farnell and Newark listings); the double-centre-channel profile needs the drawing check of section 8.11 |
| PIC-5 and B1 high cases break the USD 200 cap; PIC-5 board over-full; B1 sink inside PETG beside the cells (0, 1, 2) | Cap moved to USD 300 worst; scored in C2, C4, C8 |

**Grafts proposed by the judges and their disposition in revision 2:**

| Graft | From | Disposition |
|---|---|---|
| Coilcraft 1812SMS LPF inductors | B1 | Adopted in A4 and A5 |
| G5V-2 DPDT relay | PIC-5, B1 | Adopted in A4 and A5 |
| 10 s hardware cutoff and cell 60 C trip on a second LM393 | B1 | Adopted in A4 and A5 |
| Prescaler for REQ-SYS-182 | PIC-5, B1 | Adopted, with a divider rated 160 MHz minimum (finding-3) |
| Plated slot and dense via field under the PA | PIC-5 | A4 only (A5's module has a flange) |
| Ordering gate with pre-agreed guards and add-backs | PIC-5 | Adopted (section 8.4), against USD 300 |
| Board-level fences cut from spare boards | PIC-5 | Adopted |
| Heat sink as an end wall, fins outside | min-cost | Kept, with a printed finger guard in A5 and (revision 3) a vented PA bay behind a double-wall bulkhead, because the inner face stays inside the case |
| One US distributor; LCSC only if the JLC merge is verified | min-cost | Kept (A5 adds RF Parts for the module only) |
| Analog receive audio chain (no ADC audio) | min-cost | Kept |
| 40 dB on-board monitor port (REQ-SYS-141) | B1 | **Baseline** in A4 and A5 (finding-9) |
| TCXO | PIC-5, B1 | **Baseline** in A5; add-back in A4 |
| RA07M1317M module PA | B1 | **Adopted in A5** |
| Diode-ring mixer | PIC-5, receiver research | **Adopted in A5** (BN-43-202 cores; TC1-1T+ out of stock) |
| XRMW0505 slug-tuned BPF coils from LCSC | B1 | Not adopted: wound BPF coils from the owner's 24 AWG wire cost nothing; XRMW needs the unverified LCSC merge |

## 5. Final decision matrix

Weighted score = weight x score; maximum 500. A0 is dropped at M1 and A1 at M4; A1 is shown for information and is not re-scored after revision 4. Revision 6 scores; the revision 5 score is in brackets where it changed. "A4" is A4 with its revision 6 conditions (the required TCXO, the tab cut-off sensor, the PA_EN gating) and the JFET mixer; "A4 + U3" is the same with A5's diode-ring mixer, the configuration recommended.

| Criterion | Weight | A1 | A1 w | A2 | A2 w | A3 | A3 w | A4 | A4 w | A4 + U3 | A4 + U3 w | A5 | A5 w |
|---|---|---|---|---|---|---|---|---|---|---|---|---|---|
| C1 Expected cost against the target | 20 | 5 | 100 | 5 | 100 | 3 | 60 | 5 | 100 | 5 | 100 | 3 | 60 |
| C2 Worst-case margin | 5 | 5 | 25 | 3 | 15 | 1 | 5 | 3 | 15 | 2 | 10 | 1 | 5 |
| C3 Hand-solderability | 15 | 5 | 75 | 1 | 15 | 2 | 30 | 3 (5) | 45 | 3 | 45 | 3 | 45 |
| C4 Build effort | 10 | 2 | 20 | 1 | 10 | 5 | 50 | 3 | 30 | 3 | 30 | 4 | 40 |
| C5 RF and emissions | 20 | 1 | 20 | 4 | 80 | 4 | 80 | 2 | 40 | 3 | 60 | 4 | 80 |
| C6 Envelope and mass | 10 | 3 | 30 | 4 | 40 | 3 | 30 | 1 | 10 | 1 | 10 | 1 | 10 |
| C7 Deltas and firmware | 5 | 2 | 10 | 3 | 15 | 3 | 15 | 3 | 15 | 3 | 15 | 3 | 15 |
| C8 Safety and thermal | 15 | 1 | 15 | 2 | 30 | 1 | 15 | 2 | 30 | 2 | 30 | 1 | 15 |
| **Total** | **100** | | **295** | | **305** | | **285** | | **285** (315) | | **300** (315) | | **270** |
| **Percent of maximum** | | | 59 % | | 61 % | | 57 % | | 57 % | | 60 % | | 54 % |
| **Rank** | | | - (fails M4) | | 1 (not a finalist; not analysed; presented with the finalists, section 6 revision 6 item 4) | | 3 (fails M1 on estimated lines) | | 3 | | **2 (recommended)** | | 5 (M1 conditional) |

Revision 6: the INSP-118 conditions move A4 by -30 (C3, the required TCXO) and, with the ring, the recommended configuration by -15 from its revision 5 total (C3 -30, C5 +20, C2 -5). It leads A5 by 30 points, over the 25-point rule of 06 section 14.5; A4 with the JFET mixer leads A5 by 15, under it. A2, 305, is 5 points above the recommended configuration and 20 above A4 with the JFET mixer; it was not a finalist and was not analysed, and it is presented to the owner with them (section 6 revision 6 item 4; 06 section 14.5). Revision 5: A4 315, A2 305, A3 285, A5 270; the pre-order analyses had moved A5 by -65 (C1 -20 on the E5 cost, C5 -20 on the low-pack power and drive window, C6 -10 on the guard envelope, C8 -15 on a junction range wholly over 110 C) and A4 by -25 (C2 -5, C6 -20). Revision 4 had A4 340 and A5 335, presented together.

## 6. Uncertainty and sensitivity statement

**Revision 6 (governs; items 1 to 8 below are revision 5 and stay for the review trail).** The revision 6 script (author's scratchpad, not committed; the TS is committed alone) first reproduces every revision 5 figure of this section: totals A4 315, A2 305, A3 285, A5 270; A4 first in 12 of 16 weight runs and A2 in 4; A4's smallest lead over A5 14.4 (C5 +10) and largest 75.6 (C5 -10); 46 of 84 three-move combinations; the five A2 single moves; the joint adverse cases 365 / 345 / 335 / 230 and 345 / 340 / 335 / 255. It then runs revision 6.

- **R6-1. Weight sensitivity** (every weight +10 and -10, the others rescaled to keep 100; 16 runs, A2 to A5).
  - With the recommended A4 + U3 (300): **A2 first in 10 runs, A4 + U3 in 4** (C2 -10: 310.5 against A2 305.5; C3 +10: 300.0 against 280.9; C5 -10: 300.0 against 293.1; C6 -10: 322.2 against 294.4), **A3 in 2** (C1 -10: A3 283.1, A2 280.6, A4 + U3 275.0; C4 +10: A3 308.9, A4 + U3 300.0). A5 in none. Between A4 + U3 and A5 alone, A4 + U3 is first in all 16; its smallest lead is 8.8 points (C1 -10: 275.0 against 266.2), its largest 51.2 (C1 +10).
  - With A4 alone (285, JFET mixer): A2 first in 11, A4 in 3 (C3 +10, C5 -10, C6 -10), A3 in 2. Between A4 and A5, A4 is first in 13; A5 leads at C1 -10 (266.2 against 258.1), C2 -10 (287.9 against 283.4) and C5 +10 (286.2 against 274.4).
- **R6-2. Score sensitivity** (every Low cell +1 and -1; Low cells as in revision 5: C1, C2 and C8 for all; C5 for A3, A4 and A5; C6 for A2, A4 and A5).
  - **A2 against A4 + U3 (5 points):** every one of the 8 single moves in A4 + U3's favour (A2 C1, C2, C6 or C8 -1; A4 + U3 C2, C5, C6 or C8 +1) ties or reverses them (A4 + U3 C5 +1: 320 against 305). Seven single moves the other way widen A2's lead (to 320 against 300 at A2 C8 +1).
  - **A4 + U3 against A5 (30 points):** no single move closes it; 19 of the 36 two-move combinations and 81 of the 84 three-move combinations reach a tie or better for A5 (for example A5 C1 +1 and A4 + U3 C5 -1: 290 against 280).
  - **A4 against A5 (15 points):** 6 of the 9 single moves reach a tie or better for A5 (A5 C1 or C5 +1: 290 against 285; A4 C1 or C5 -1: 265 against 270).
  - **Joint adverse cases** (every Low cell of the target down one, every other Low cell up one; with A4 + U3): against A5, A4 + U3 350, A3 345, A2 335, A5 230; against A4 + U3, A3 345, A5 340, A2 335, A4 + U3 240; against A2, A4 + U3 350, A3 345, A5 340, A2 255.
- **R6-3. Named readings (not scored).** Duty-limited C8 for A5 (2): A5 285, still 15 under A4 + U3. A2 with the finalists' wrap-guard envelope (C6 -1 to -3): A2 295, 285 or 275, below A4 + U3 in every case. Needed-only E5 (without the optional drive bandpass and 2 % LPF parts): A5 243.78 planning and 309.38 worst (still over USD 300); A4 200.86 and 262.44; A4 + U3 203.46 and 265.04; no score changes.
- **R6-4. A2 (06 section 14.4 item 4 and section 14.5; INSP-110 finding-19).** A2 is the top-ranked alternative on the matrix and was never analysed. The study does not recommend it, and 06 section 14.5 requires the report to say why and to present it with the finalists:
  - **Why its total is not taken at face value:** four of its eight cells are Low-confidence estimates from its architect (C1, C2, C6, C8), and the analyses moved exactly those kinds of cells down for both analysed finalists (C6 by 1 to 2 points, C8 by 1 for A5, C1 and C2 by the E5 parts). Its C8 already takes the parity reading (section 4.2); its C6 does not (section 4.2, revision 6 paragraph), and with the finalists' guard envelope it would total 275 to 295.
  - **Why it is not recommended even at its total:** three flagged parts (the hidden-pad leadless RD07MUS2B, the 0.5 mm MSOP Si5351A and the leadless TCXO); a new-old-stock PA pair from RF Parts, the RD07MUS2B "no longer available for export" (supply risk: a blown final may have no replacement); a CN3302 charger chain sold only by LCSC, whose merge into the JLCPCB parcel is unverified; and the Catastrophic HZ-002 charger chain in the box beside a PA that dissipates in A4's range.
  - **What it offers that neither finalist does:** in-radio USB charging (SI-022, CON-010, given up by both finalists, D2), and the smallest envelope as drawn.
  - **The analysis that would settle it (value of information):** the WP-PDR-28 thermal model re-run on A2's layout (RD07MUS2B pair on its sink, charger in the case; C6 and C8), the WP-PDR-21 drive and output-power runs for the RD01MUS2 and RD07MUS2B line-up at 6.4 V (C5), and the ordering-gate reads of the RF Parts stock and the LCSC merge (M2, C1, C2). Cost: about two working days of analysis plus their reviews, no money; gate: before the owner's Q1 decision if the owner wants A2 in the choice set. The study recommends not running it, for the supply and HZ-002 reasons above, and asks the owner's concurrence that the choice set is A4 and A5 (Q1).
- **R6-5. Robustness verdict (06 section 14.4 item 3): Not robust.** The top rank (A2) changes under 6 of the 16 weight runs and under every single Low-cell move in the recommended A4's favour. Between the finalists the order holds on weights (A4 + U3 first in 16 of 16) and against any single Low-cell move (30 points, over the 25-point rule); two moves can close it. A4 without the ring is not robust against A5 (15 points; 3 weight runs, 6 single moves). The recommendation (section 8) is therefore A4 + U3, presented together with A2 and with A5 (06 section 14.5).
- **R6-6. Evidence asymmetry and the review state.** All six analysis reviews have now run (table R5-1): five are reviewer APPROVED and none changed a figure this study scores on (INSP-114 X-8, INSP-116 X-8). The receiver record's iteration 4 (2 + 3 + 4 over temperature) is in progress (**revision 8, INSP-110 finding-26:** it has since run, reviewer APPROVED at `123f048`, 75.37 dB worst case over temperature; all six records are now APPROVED); the filter change is inside row E5 (a) and moves the MDS of both finalists in the same direction, so it moves no cell (section 7.3). The three INSP-118 conditions are no-cost or low-cost design items (D-6, D-17, D-18) plus the TCXO; the A4 tab cut-off margin (about 8 K at the all-adverse corner) rests on the lumped thermal model and the bench NTC-offset measurement (section 7.3, revision 6).

The revision 5 runs use the same script as revision 4 (author's scratchpad, not committed), which first reproduces every revision 4 figure of this section (A4 first in 9 of 16 weight runs, A5 in 5, A2 in 2; the ten Low-cell moves; the joint adverse cases 380 / 290 and 385 / 280) before the revision 5 matrix is run.

1. **Weight sensitivity (revision 5).** Every weight moved by +10 and -10 points, the others rescaled to keep 100 (16 runs, A2 to A5). **A4 is first in 12 runs; A2 in 4** (C3 at -10: A2 329.1, A3 295.0; C4 at -10: A2 327.8, A4 316.7; C5 at +10: A2 316.9, A4 300.6; C6 at +10: A2 315.6, A4 291.1). **A5 is first in none.** Between the two finalists alone, A4 is first in all 16; A4's smallest lead over A5 is 14.4 points (C5 at +10: A4 300.6, A5 286.2), its largest 75.6 (C5 at -10). Revision 4 had A4 first in 9, A5 in 5, A2 in 2.
2. **Score sensitivity.** Every Low-confidence cell moved by +1 and -1 one at a time: C1, C2 and C8 for all; C5 for A3, A4 and A5 (A5 and A3 become Low in revision 5, because their C5 now rests on graph reads, a back-off ratio estimate and an estimated PA temperature coefficient); C6 for A2, A4 and A5 (A4 becomes Low: no case CAD). **No single move changes the order of A4 and A5.** The largest single moves for A5 (C1 or C5 +1) give 290 against A4's 315; A5 C8 +1 (the duty-limited reading below) gives 285. **Two moves do not close it either; three do**, for example A5 C1 +1, A5 C5 +1 and A4 C5 -1 (A5 310, A4 295), or A5 C1, C2 and C5 +1 (a 315 tie); 46 of the three-move combinations reach a tie or better for A5. Five single moves put A2 level with or ahead of A4: A2 C6 +1 (tie at 315), A2 C8 +1 (A2 320), A4 C1 -1, A4 C5 -1 (A2 305, A4 295) and A4 C8 -1 (A2 305, A4 300). The joint adverse case (every Low cell of the target down one, every other Low cell up one; beyond the 14.4 rule): against A5, A4 365, A3 345, A2 335, A5 230; against A4, A3 345, A5 340, A2 335, A4 255.
3. **Named readings that the owner may prefer (not scored):**
   - **Duty-limited junction corner.** Both finalists need the REQ-SYS-112 delta to a duty-limited corner (section 8.10). Scored at that corner (50 % duty, 13 s key-downs, 45 C), both junction figures are OPEN ranges that span 110 C (A4 105.6 C +16.3 K, A5 104.4 C +12.4 K), so C8 would be 2 for both: A5 285, A4 315. A5's box still has two failures outside their bands (V08, V17), so 2 is the ceiling.
   - **Needed-only E5.** Without the optional drive bandpass and the 2 % LPF parts, E5 is USD 2.60 to 11.43 before contingency: A5 plans at 242.74 (C1 3.3, still 3) and its worst case is 307.65 (still over USD 300). A4 plans at 195.67 and its worst is 256.56 (C2 3.2, still 3). No score changes.
   - **Revision 4 envelope (no wrap guard).** If a lighter guard were shown to hold REQ-SYS-113 for A4 (its fin tips were 49.7 C, 1.7 K over, as revision 4 drew them), A4's C6 could return to 3 (A4 335). No such relief exists for A5 (64.2 C, 16.2 K over).
   - **Hybrid A4 with the diode ring (U3).** 315, equal to A4 (C4 stays 3; C5 stays 2 because the harmonic-data and low-pack power terms dominate), for USD 2.60 capped (planning 203.33, worst 266.29). **Hybrid A4 with the ring and the TCXO (U2 and U3):** 300 (C3 5 to 3 for the flagged TCXO outweighs C5 2 to 3). Neither beats A4 on the matrix; the ring is recommended as an option on evidence quality (section 8).
4. **Evidence asymmetry against A2 and A3.** The six analyses ran for A4 and A5 only, on the owner's approval of 2026-09-28. A2's C6 (4) and C5 (4) cells, and A3's C6 (3), are still the architects' estimates. The thermal model moved both analysed finalists down on exactly those kinds of cells (C6 by 1 to 2 points, C8 by 1 for A5). A2's C8 is already read at 2 on evidence parity (section 4.2). If A2's envelope took the same wrap-around guard (its PA dissipates in the same range as A4's), its C6 would fall by 1 to 3 points and A2 would total 275 to 295, below A4. A2 also has three flagged parts, a new-old-stock PA "no longer available for export" and an LCSC-only charger chain, so it is not proposed as a finalist; the owner question stays between A4 and A5.
5. **Assumptions and their evidence:**
   - Mouser prices are the aggregator republication of Mouser's own price and stock (section 8.3). Rows read today: 74LVC1G80GV, TG2520SMN, CONSMA001-C-G, Wakefield 120-SA, Fair-Rite 2843000202 and 2843002402, KEMET C0805C101J5GACTU, TC1-1T+, 529802B02500G and 530002B02500G; INSP-110 re-read 25 more rows the same day.
   - RA07M1317M-501: RF Parts USD 28.91, "In Stock", "New", no end-of-life note, USD 15 minimum order (read 2026-09-27); Mitsubishi Electric US "Active". Datasheet values (June 2019) are those recorded in `docs/research/pa-device-candidates.md` F8 and read again by the thermal and PA drive analyses on 2026-09-28.
   - RF Parts shipping is "calculated based on weight / dimensions vs destination" with a USD 2.75 residential UPS surcharge (search summary); carried as USD 10 to 18 (E).
   - Mouser free shipping starts at USD 100 in the US (search summary; Low). A5's Mouser merchandise is about USD 96 to 123 with row E5 (revision 4: 90.89 to 105.39), so the threshold is more likely crossed; the worst case still carries USD 8 of shipping.
   - JLCPCB US tariff FAQ: "Total tariff rate: About 35%~92.5%", base not published. JLCPCB shipping to the US USD 12 to 25.
   - Row E5 (revision 5) is an estimate built from the section 8.3 row prices and the E2 per-value range (section 8.14); the CLK1 coax interface is not read (the Adafruit edge-launch SMA, product 1865, lists USD 2.50 and is out of stock, read 2026-09-28; not carried, because the coax is soldered).
   - Every performance and temperature figure from the analyses is an estimate: PA curves are graph reads of typical data, the thermal model is a lumped network with class-E derates, the spur levels are Low-confidence estimates with 20 to 50 dB ranges, and the keying budget terms are estimates (section 7.3 table R5-2, confidence column).
6. **Robustness verdict:** **Robust between the finalists** on weights (A4 first in 16 of 16) and on scores (three simultaneous Low-cell moves needed; 45-point lead against the 25-point rule). **Not robust against A2** (10 points, and four weight runs and five single moves put A2 level or first), but A2 carries unanalysed cells in the direction the analyses moved every analysed cell, and is not a finalist (item 4). **Cost screen:** A5 does not pass M1 on its stacked worst case (USD 314.78) and passes only through guards G1 and G2 (298.10, margin USD 1.90) at the gate; A4 passes by USD 36.31.
7. **Value of information.** Before the order: the owner's browser reads of section 8.11 (they settle the cost screen, now decisive for A5), the DMP3099L and MF-R300 datasheet reads (feed resistance, both finalists), and, for A4, the WP-PDR-21 match run (PA drive analysis C5), which replaces the (Vd/7.5)^n estimate and the assumed drain efficiency that set A4's power and its junction band (+15 K from the AFT05 current alone). The in-situ sink measurement (a power resistor on the actual Boyd part inside a printed guard coupon; thermal note section 9.1 item 2) replaces the orientation derate, the largest thermal input, for both. After the order and before first on-air use: the tinySA sweep (A4 harmonics, A5 back-off ratio, the three spur lines) and the keying calibration measurements (keying note section 8 item 7), which decide A5's first-element result. None of these is expected to reverse the A4-over-A5 order: the matrix needs three one-point moves in A5's favour.
8. **Limitations of the evaluation methods and tools:** prices are single-day reads, mostly through an aggregator; shipping, tariff and duty lines and row E5 are estimates; no cart was opened. A1 to A3 re-rolls use their architects' totals plus E5. The analyses are developer evidence (their Python checkers have no TV record) with LTspice accredited (ACC-LTSPICE-001 for the `tools/ltspice-batch.sh` wrapper blob 88b71475, LTspice 26.0.2). Three of the six records are still under review (section 9 table R5-1): the PA drive and keying notes answered Major findings in revisions not yet re-reviewed, and the receiver BPF note's revision 3 is not yet re-reviewed. If a re-review changes a figure this study uses, section 10 names it as a revisit condition. The thermal model has no bench correlation. The judges' scores are expert judgement.

## 7. Risks and benefits of the surviving alternatives

### 7.1 Risks (four-part format, 06 sections 4, 6, 7)

Scores in this first table are those of revision 4; the revision 5 table after it governs where they differ, and the revision 6 table after that governs where it differs.

| Alt | Risk statement | L | C (driving) | Score / band | Would be entered as |
|---|---|---|---|---|---|
| A5 | Given that the RA07M1317M has one catalog seller (RF Parts) and brokers otherwise, there is a possibility that it is out of stock or delayed at order time, adversely impacting the schedule and the PA choice, leading to the A4 fallback PA | 2 | 4 (performance) | 8 / Yellow | merged into RSK-038 (steps: stock read at the gate; module ordered first; spare as gate add-back AB-A) |
| A5 | Given that the sink's inner face (about 83 C at the bound corner), the module and the RF board sit inside the PETG case with the cells, and that revision 2 had them in one air volume (adversarial R-2: about 74 C interior air at 45 C ambient under continuous key-down, about 61 C at 50 % duty; cells 13 mm from the sink zone), there is a possibility that a cell exceeds its 60 C discharge limit, adversely impacting HZ-007 (Catastrophic; the cell's heating cause), leading to the LM393 cell 60 C trip ending transmissions at high ambient, a larger sink or a power derate | 3 (revision-3 controls designed, not yet analyzed: lumped estimate 54 to 56 C cell-bay air at the continuous corner) | 5 (safety: HZ-007 mapped level, 06 section 1 hazard link rule) | 15 / Red (safety override; stays Red at L2) | merged into RSK-007 (new cause; steps: vented PA bay and double-wall bulkhead; cells at the far end of the main board; LM393 #2 cell 60 C trip (HZ-007 control); WP-PDR-28 cell-bay criteria of section 7.3 before the order, which brings L to 2, 10 / Red) |
| A5 | Given a module that dissipates 8.5 to 10 W into a 2.6 K/W catalog sink, there is a possibility that reachable fin surfaces exceed 48 C after 5 min at 25 C, or that PETG near the sink or around the PA bay exceeds its 69 C heat-deflection temperature at 45 C ambient, adversely impacting REQ-SYS-113 and case integrity, leading to a larger sink or a power derate | 3 | 3 (safety: HZ-003 burn, Marginal after the guard) | 9 / Yellow | merged into RSK-026 and RSK-006 (steps: finger guard; no PETG contact; bay walls at least 5 mm from the sink; WP-PDR-28 with the section 7.3 pass criteria) |
| A5 | Given harmonic maxima guaranteed only at 6 W (2fo -25, 3fo -30 dBc) and an output LPF not yet simulated, there is a possibility that a harmonic exceeds 25 uW at the 0.5 W step, where VGG back-off can raise the harmonic ratio, adversely impacting 97.307(e) (HZ-008), leading to a trap fitted on the LPF footprint | 2 | 4 (regulatory) | 8 / Yellow | new RSK (steps: LPF LTspice run, WP-PDR-21; tinySA sweep at each step before on-air use) |
| A5 | Given a junction estimate of 87 to 119 C at the 45 C continuous key-down corner, which is not a bound (catalog free-air sink rating; part of the fins inside the vented bay and the rest behind a guard 3 mm from their tips; flange face unread; adversarial R-4), there is a possibility that the stage-2 channel exceeds 110 C, adversely impacting REQ-SYS-112 (KDR), leading to the transmit-duty-limit fallback and its REQ-SYS-112 delta, or a larger sink | 3 (revision 3: 2 on the bound) | 4 (performance: KDR) | 12 / Red | merged into RSK-006 (steps: WP-PDR-28 with the Boyd drawing, fin split, bay air and guard clearance before the order; fin-orientation and guard-clearance levers; duty-limit fallback) |
| A5 | Given a 0.0 to 0.6 dB margin at 6.4 V after key-down sag and filter loss, there is a possibility that the 5 W step reads under 3.97 W at the low pack end, adversely impacting REQ-SYS-012 (KDR), leading to a low-end delta or a lower-resistance drain feed | 3 | 3 (performance) | 9 / Yellow | new RSK (step: feed-resistance budget before the order; TC-SYS-011) |
| A5 | Given about 45 dB of broadband gain in the drive chain and module on an unshielded 2-layer board, there is a possibility that a non-harmonic spur inside the LPF passband (the 12 MHz x 12 and 48 MHz clk_adc x 3 lines at 144.000 MHz, the transmit system clock, the 25 MHz reference's 5th and 6th harmonics, the /8 prescaler's 7/8 and 9/8 products, Si5351 CLK0 and CLK2; revision 4, adversarial R-3) exceeds 25 uW, adversely impacting 97.307(e) (HZ-008), leading to a layout or clock-plan change | 3 | 4 (regulatory) | 12 / Red | new RSK (steps: CLK0 and CLK2 off in TX; the WP-PDR-20 transmit clock-plan item with its coupling budget before the order, revision 4; drive LPF; tinySA sweep before on-air use) |
| A5 | Given a receiver estimated at MDS -140 dBm with Low confidence, there is a possibility that MDS or image rejection falls short on the unshielded board, adversely impacting REQ-SYS-022 (KDR) and REQ-SYS-033, leading to a second preamp change or a fence redesign | 3 | 4 (performance: KDR) | 12 / Red | new RSK (steps: LTspice cascade and BPF runs before the RX freeze) |
| A5 | Given a steep, nonlinear VGG transfer, a detector after the T/R relay (G5V-2 operate time 7 ms maximum) and an integrating error amplifier, there is a possibility that the envelope loop overshoots, winds up while the contacts are open or clicks, or that an open loop drives the module past its ratings, adversely impacting REQ-SYS-014 and 015 and the RA07M1317M ratings, leading to a loop redesign | 2 | 3 (performance) | 6 / Yellow | new RSK (steps: 10 ms relay settle before the ramp; integrator parked at 0 V until the ramp; VGG clamp at 3.46 V or less over the LDO's temperature range and 1 % resistors, revision 4, finding-14; REQ-SYS-156 plausibility check; LTspice envelope run with the relay timing and the open-loop case, WP-PDR-22, section 7.3). Module-specific, with no A4 counterpart: counted against U1 in section 8.2 (revision 4, finding-17) |
| A5 | Given a USD 5.49 worst-case margin resting on unread shipping and duty lines, there is a possibility that the verified order plus contingency exceeds USD 300, adversely impacting the owner's absolute maximum, leading to the guard ladder or the A4 PA | 2 | 4 (performance: stakeholder input) | 8 / Yellow | merged into RSK-052 (steps: ordering gate; guard ladder) |
| A5 | Given that a straight key's timing varies, there is a possibility that the Morse menu misreads entries, adversely impacting usability, leading to paddle-only menu entry | 3 | 2 (performance) | 6 / Yellow | new RSK |
| A4 | Given that the AFT05MS004N is End of Life with finite stock (Mouser 72, Newark 1,519), there is a possibility that a blown or mis-soldered final cannot be replaced from a catalog channel, adversely impacting first power-on, leading to a PA redesign | 2 (spare in the order) | 4 (first power-on) | 8 / Yellow | merged into RSK-038 |
| A4 | Given no AFT05 harmonic data and a match re-derived for a different substrate, there is a possibility that a harmonic exceeds 25 uW, adversely impacting 97.307(e) (HZ-008), leading to a filter redesign | 4 | 4 (regulatory) | 16 / Red | new RSK |
| A4 | Given a junction bound of 100 to 135 C at 8.4 V with ALC back-off (adversarial C19), there is a possibility that the junction exceeds 110 C, adversely impacting REQ-SYS-112 (KDR), leading to a derate or a respin | 4 | 4 (performance: KDR) | 16 / Red | merged into RSK-006 |
| A4 | Given about 3.2 W at the SMA at 6.4 V (adversarial C2), there is a near certainty that the 5 W step misses the 3.97 W floor at the low pack end, adversely impacting REQ-SYS-012 (KDR), leading to a requirement delta | 5 | 3 (performance) | 15 / Red | requirement delta (section 8.10) |
| A4 | Given a JFET mixer that the research did not validate, there is a possibility that MDS is worse than -140 dBm or the half-IF response too strong, adversely impacting REQ-SYS-022 and 033, leading to the diode-ring fallback | 3 | 4 (performance: KDR) | 12 / Red | new RSK |
| A4 | Given about 45 dB of broadband gain in the drive chain and the AFT05 on an unshielded 2-layer board (the same Si5351, GVA-84+ and clock plan as A5), there is a possibility that a non-harmonic spur inside the LPF passband exceeds 25 uW, adversely impacting 97.307(e) (HZ-008), leading to a layout or clock-plan change | 3 | 4 (regulatory) | 12 / Red | new RSK (same steps as the A5 row; revision 3, finding-12 (d)) |
| A4 | Given a 30 ppm reference (REQ-SYS-010 relaxed 12x, a KDR), there is a possibility that the carrier error against the 500 Hz filter (RSK-002) or the REQ-SYS-182 agreement budget (9.0 kHz against 10 kHz) gives off-frequency operation or nuisance inhibits, adversely impacting REQ-SYS-010 and 182, leading to the TCXO add-back AB2 | 3 | 4 (performance: KDR) | 12 / Red | merged into RSK-002 |
| A4 | Given about 5 W into the same sink end wall with its inner face (about 62 C at the bound) inside the case with the cells, and the same 1.5 to 2 W of internal dissipation, there is a possibility that a cell exceeds its 60 C discharge limit at 45 C ambient under heavy sending (lumped estimate about 60 C interior air under continuous key-down), adversely impacting HZ-007, leading to the vented bay of A5 or a derate | 2 | 5 (safety: HZ-007 mapped level) | 10 / Red (safety override) | merged into RSK-007 (revision 3, adversarial R-2 applied to A4 at half the sink heat) |
| A5 | Given a leadless TCXO soldered with a heat gun on four pads under its body, with its aging not read, there is a possibility that a bad joint or aging gives a wrong or missing reference, adversely impacting REQ-SYS-010 and first power-on, leading to rework or guard G5 | 2 | 2 (first power-on: rework by the owner) | 4 / Green | new RSK (step: frequency check against the tinySA at first power-on) |
| A2 | Given a leadless NOS RD07MUS2B with a hidden source pad soldered with a heat gun, there is a possibility of a bad joint or overheated die, adversely impacting first power-on | 3 | 3 | 9 / Yellow | new RSK if selected |
| A3 | Given an 8.5 to 10 W sink inside the PETG case beside the cells, there is a possibility that cell and case temperatures exceed limits, adversely impacting HZ-003 and HZ-007, leading to a case redesign | 3 | 5 (safety: HZ-007 mapped level; revision 3, as for A5) | 15 / Red | merged into RSK-006 |
| A3 | Given an out-of-stock TC1-1T+ and an unverified LCSC merge, there is a possibility that the order cannot be placed as designed within USD 300 | 3 | 4 | 12 / Red | RSK-052 |

**Revision 5 re-scoring of the finalists' risks (governs where it differs from the table above).** Each row names the analysis that sets it (section 7.3 table R5-2). Rows not listed keep their revision 4 score.

| Alt | Risk (short name, row above or new) | Revision 4 | Revision 5 L x C = score / band | Evidence and steps |
|---|---|---|---|---|
| A5 | Junction (REQ-SYS-112) | 3 x 4 = 12 / Red | **5 x 4 = 20 / Red** | Thermal: 126.0 C nominal with the design changes, range 113.6 to 145.9 C, FAIL. Steps: the REQ-SYS-112 delta to a duty-limited corner (owner, by CR), the inhibit at about 81 C on a flange NTC in the heat path, the in-situ sink and NTC-offset bench measurement. With the delta accepted, L falls to 3 (104.4 C, OPEN at 50 % duty) |
| A5 | REQ-SYS-012 at the 6.4 V end | 3 x 3 = 9 / Yellow | **5 x 3 = 15 / Red** | PA drive: no steady key-down case reaches 3.97 W, even with the levers (-0.17 to -1.21 dB at the LPF median). The PA note asks the risk writer for L 5. Step: the owner decision C4 / C8 (firm "+1/-1.5 dB" delta or a bench check with the delta as fallback) |
| A5 | Fin, guard and PETG heat (HZ-003) | 3 x 3 = 9 / Yellow | **4 x 3 = 12 / Red** | Thermal: continuous PETG 66.0 C, FAIL outside its band; PA-bay air 67.1 C over the relay's 65 C rating; REQ-SYS-113 passes only with the wrap guard. Steps: design changes 1 to 5 of section 8.14, filament datasheet HDT read, the duty limit |
| A5 | Cell heating (HZ-007) | 3 x 5 = 15 / Red | 3 x 5 = 15 / Red (unchanged) | Thermal: cells 50.7 C after 30 min at 50 % (PASS); 58.9 C in a long session at the duty limit, FAIL outside its band, under the 60 C trip; the trip acts at 64.6 min of continuous key-down |
| A5 | Envelope loop (VGG transfer, first element) | 2 x 3 = 6 / Yellow | **3 x 3 = 9 / Yellow** | Keying: the loop as written fails; with the revision-1 loop design the first element of an over fails at the worst-case sum (17 of 72 corner runs) and passes at RSS. Steps: WP-PDR-22 adopts the loop items; the calibration measurements after the order |
| A5 | Receiver MDS and image | 3 x 4 = 12 / Red | **4 x 4 = 16 / Red** | Receiver: MDS not shown at the TC-SYS-017 corner in any configuration (-138.0 dBm); image needs BPF3 and five build conditions (0.2 dB margin). The note proposes L 4, C 4 to the risk writer. Step: front-end redesign in WP-PDR-19 |
| A5 | Cost above USD 300 | 2 x 4 = 8 / Yellow | **4 x 4 = 16 / Red** | Section 8.4: stacked worst case USD 314.78 with row E5. Steps: ordering gate reads; guards G1 and G2 (298.10) |
| A5 | **New:** drive window | - | **3 x 4 = 12 / Red** | Given a fixed drive pad that leaves the module under 10 mW at 195 and over its 30 mW maximum rating at 28 of 810 corners (PA drive analysis, runs d2 and d4), there is a possibility that the module runs outside the drive range its stability guarantee covers, adversely impacting 97.307(e) (HZ-008) and the module rating, leading to a spur or a damaged module. Steps: the select-on-test pad (C1) with the 17 mW level reading characterized within +/-1.0 dB and the REQ-SYS-144 delta, which bring L to 2 (8, Yellow) |
| A5 | **New:** REQ-TX-014 (1 uW at key-up with the drive on) | - | 2 x 3 = 6 / Yellow | Keying: not shown; depends on the module's VGG-off isolation (needs 43 dB; the datasheet says "up to 60 dB", not a limit). Step: NanoVNA isolation check on receipt, or the drive-gating change (a) |
| A5 | Harmonic at the back-off state | 2 x 4 = 8 / Yellow | 2 x 4 = 8 / Yellow (unchanged) | LPF: 97.307(e) passes by 7.5 dB (J) or 9.5 dB (2 %); the binding 5 W, 8.4 V case rests on the -17 dBc back-off estimate. Step: tinySA sweep (tinySA to be bought) |
| A5 and A4 | Non-harmonic spurs | 3 x 4 = 12 / Red | 3 x 4 = 12 / Red (unchanged) | Spurs: met by wording only; 3 lines over 25 uW at the high estimate in plan PB, equal for both. Steps: the clock plan C1 to C8, the drive bandpass, footprints for C7b and C9, the tinySA sweep |
| A4 | Junction (REQ-SYS-112) | 4 x 4 = 16 / Red | **5 x 4 = 20 / Red** | Thermal: 122.7 C nominal, range 107.9 to 142.9 C, FAIL; the pad inhibit at 85 C fails even nominally (114.2 C). Steps: as A5, with the inhibit at about 77 C, and the A4 match run to bound the drain efficiency (the largest A4 input) |
| A4 | REQ-SYS-012 | 5 x 3 = 15 / Red | 5 x 3 = 15 / Red (confirmed, widened) | PA drive: nominal 3.06 W at 6.4 V; the lowest corner misses 3.97 W at every pack voltage and temperature (1.69 W at 6.4 V, 25 C); every lever at its best is still 2.5 dB short. The "+1/-2 dB" delta of revision 4 covers none of the lowest-corner cases |
| A4 | JFET mixer, MDS and half-IF | 3 x 4 = 12 / Red | **4 x 4 = 16 / Red** | Receiver: MDS not shown at the corner (-138.7 dBm with BPF3), as for A5; the half-IF passes by 12 to 16 dB on a representative circuit with 8 of 16 cases unconverged (Low). The ring option (U3) replaces the mixer term, not the MDS term |
| A4 | Cell heating (HZ-007) | 2 x 5 = 10 / Red | 2 x 5 = 10 / Red (unchanged) | Thermal: 49.2 C at 30 min (PASS); 55.2 C in a long session at the duty limit, 0.2 K over inside its band; 58.2 C under continuous key-down, under the 60 C trip, which never acts |
| A4 | **New:** PETG, bay and surfaces (HZ-003) | - | 3 x 3 = 9 / Yellow | Thermal: REQ-SYS-113 fails as revision 4 drew it (fin tips 49.7 C) and passes with the wrap guard (29.5 C); continuous PETG 59.7 C and PA-bay air 61.0 C are OPEN. Steps: design changes 1 to 5 of section 8.14 |
| A4 | **New:** REQ-TX-014 | - | **4 x 3 = 12 / Red** | Keying: -23 to -19 dBm at key-up through the AFT05's Crss with the drive on, 7 to 11 dB over 1 uW (estimate). Step: make the GVA-84+ bias and CLK1 enable part of the key path and restate the requirement's condition by CR (keying note option (a), no cost), which retires it |
| A4 | **New:** envelope loop, first element | - | 2 x 3 = 6 / Yellow | Keying: passes at the worst-case sum by 0.015 to 0.021 V; fails if the true sub-threshold slope is steeper than about 127 dB/V, and fails by 0.009 V after a power-on without a stored trim. Steps: stored trim at power-on; the calibration measurements |
| A4 | Harmonic data and match | 4 x 4 = 16 / Red | 4 x 4 = 16 / Red (unchanged) | LPF: 97.307(e) passes by 5.5 to 7.5 dB, but on the assumed -15 dBc 2f, which no vendor data bounds; closes only at the tinySA sweep |

**Aggregate risk (revision 5):** A4 20 (eight Reds: junction, harmonic data, low-pack power, mixer and MDS, non-harmonic spurs, 30 ppm reference, REQ-TX-014, cell heating); A5 20 (eight Reds: junction, low-pack power, cost, MDS, fin and PETG heat, drive window, non-harmonic spurs, cell heating; seven without the cost Red). A2 9 and A3 15 on the rows listed (not re-assessed). The junction Reds of both fall with the REQ-SYS-112 delta; A4's REQ-TX-014 Red retires with the no-cost key-path change; A5's drive-window Red falls to Yellow with the select-on-test pad; A5's cost Red is settled at the ordering gate. The cell-heating Reds carry HZ-007 (Catastrophic) and stay Red under the safety override until the cell-bay criteria are verified by Test on the unit.

**Revision 6 re-scoring of the finalists' risks (governs where it differs from the tables above).**

| Alt | Risk (short name) | Revision 5 | Revision 6 L x C = score / band | Evidence and steps |
|---|---|---|---|---|
| A4 | 30 ppm reference (REQ-SYS-010, 182) | 3 x 4 = 12 / Red | **Retired** | The TCXO is now required (D-17), so REQ-SYS-010 is kept and REQ-SYS-182 and REQ-SYS-154 hold on route R3. It is replaced by the A5 row "leadless TCXO joint or aging" (2 x 2 = 4, Green), now common to both |
| A4 | REQ-TX-014 (1 uW at key-up with PA_EN asserted) | 4 x 3 = 12 / Red | **2 x 3 = 6 / Yellow** | D-11 and D-18 remove the GVA-84+ supply and hold the gate-bias clamp in hardware whenever TX_KEY is low: about -67 dBm at key-up with CLK1 running (the keying note's section 4.5 path, +10.4 dBm at CLK1, 18 dB pad, 20 dB through the unpowered GVA-84+ (estimate), 39 dB through the gate-off AFT05), 37 dB under -30 dBm. Steps: the REQ-TX-014 restatement with its HZ-004 note (section 8.10), the tinySA check before first on-air use |
| A5 | REQ-TX-014 | 2 x 3 = 6 / Yellow | 2 x 3 = 6 / Yellow (unchanged; now about -61 dBm by the same path, 31 dB under) | As A4; the module's VGG-off isolation is no longer the only path |
| A4 and A5 | Receiver MDS and image | 4 x 4 = 16 / Red | 4 x 4 = 16 / Red (unchanged; the cause widens) | Revision 6 adopts 2 + 3 + 4 (D-15): image about 79.4 dB over temperature, but MDS at the TC-SYS-017 corner -136.3 dBm (A4) and -134.9 dBm (A5), TPM-005 Red there. Likelihood left at 4 pending INSP-117 iteration 4 and the WP-PDR-19 front-end redesign, which must recover 3.7 and 5.1 dB. **Revision 8 (INSP-110 finding-26):** superseded by `rx-bpf-ts012.md` revision 4 (`63122e7`; INSP-117 iteration 3 re-issue 1, reviewer APPROVED, `123f048`): 2 + 3 + 4 holds REQ-SYS-033 over REQ-SYS-114 at a worst case of **75.37 dB** (margin 5.37 dB, hot end at 148.0 MHz, +/-0.3 % residual estimate), with an alignment acceptance of **+/-0.62 %** at 20 to 30 C and a limit of **+/-0.64 %** over temperature; the MDS figures stand; no score moves (section 10, revisit (a)). Likelihood stays at 4 on the MDS |

Rows not listed keep their revision 5 score. **Aggregate risk (revision 6):** A4 20 (six Reds: junction, harmonic data, low-pack power, mixer and MDS, non-harmonic spurs, cell heating); A5 20 (eight Reds, unchanged; seven without the cost Red). A2 9 and A3 15 on the rows listed (not re-assessed). The assurance conditions add no risk row: each is a design item with its own verification (D-6, D-17, D-18), and the software assurance concern of INSP-118 SA-F1 goes to the register writer through the lead SE. INSP-110 finding-22 (four new revision 5 rows without a four-part statement) stays a lien.

**Revision 4 aggregate (superseded):** Aggregate risk (maximum score): A2 9 on the risks listed here (its revision-1 cost Red is retired by the USD 300 ceiling), A3 15, A4 16 (seven Reds: harmonic data and match, junction, low-pack power, JFET mixer, non-harmonic spurs, 30 ppm reference, cell heating), A5 15 (four Reds: cell heating, non-harmonic spurs, MDS and, since revision 4, the junction). The cell-heating Reds of A3, A4 and A5 carry HZ-007 (Catastrophic), so the safety override of 06 section 7 keeps them Red at likelihood 2; they leave Red only when the cell-bay criteria are verified by Test on the unit (likelihood 1). The other A5 Reds are Research risks whose steps are analyses and bench checks named in section 7.3, due before the order (WP-PDR-28 thermal, WP-PDR-20 transmit clock plan, drive chain, BPF, LPF) or before first on-air use (tinySA sweep). The Green band (score 4 or less, 06 section 8) is used for the TCXO row. Revision 2 listed no cell-heating risk for any alternative; that omission is the adversarial R-2 refutation.

### 7.2 Benefits beyond the scored criteria

| Alt | Benefits |
|---|---|
| A5 | The PA is a 50 ohm block with a vendor datasheet that guarantees output, efficiency, harmonics, load ruggedness (20:1 at 9.2 V and 7 W) and stability (spurious below -60 dBc for VDD 4.0 to 9.2 V, Pin 10 to 30 mW, Pout up to 8 W, load VSWR 4:1), and it is in current production ("Active"). "This module is designed for manual soldering" (datasheet). (Revision 5: the stability guarantee holds only with the module drive inside 10 to 30 mW, which the fixed pad does not keep, and the harmonic guarantee does not cover the 5 W, 8.4 V back-off state; section 7.3.) The TCXO also shrinks the REQ-SYS-182 error budget from 8.9 to 4.8 kHz (revision 6: withdrawn; on the reviewed method the TCXO makes route R3 possible, which A4 now also takes, section 7.3). The diode ring is the receiver research's own mixer. Charging outside the radio keeps the Catastrophic HZ-002 charger chain out of the box. Analog audio keeps the TS-001 audio decision. |
| A4 | Cheapest compliant radio (USD 187.61 planning in revision 4; revision 6 USD 205.91, 208.51 with the ring); one distributor plus the boards and cells; no leadless part until revision 6 (the required TCXO is the one). The AFT05 is rated for 65:1 VSWR at 9 V. Its 136 to 941 MHz range is not claimed as a later 70 cm benefit, because the device is End of Life. |
| A2 | Keeps in-radio charging, the TCXO and the best envelope. |
| A3 | Easiest build: no winding, no PA match; guaranteed harmonics. |
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
