robinonsay/cwht/tools/tests/fixtures/kicad/expected/clean-bom.csv

Refs | Value | Footprint | Qty | DNP
R1 | 10k | Resistor_SMD:R_0603_1608Metric | 1
