robinonsay/cwht/hardware/sim/freq/results/txspur-20260928-02/lines.csv

plan | finalist | carrier_MHz | f_MHz | family | source | injection | mirror | ant_lo_dBm | ant_hi_dBm | gva_ref_lo_dBm | gva_ref_hi_dBm | verdict_60dBc | verdict_25uW | residual_60dBc | residual_25uW | basis | change_named | credited_in_numbers | named_not_credited | contributors
B0 | A5 | 144.05 | 118.0000 | RP2350 on-die products | 2 x 125 - 11 x 12 MHz | gva | False | -95.8 | -33.0 | -140.8 | -78.0 | pass | pass | False | False | on-die current into the Pico 2 PDN (0.1 to 0.5 ohm), path pdn 40 to 70 dB | C1 puts every on-die product on the 12 MHz grid (120, 132, 144, 156, 168 MHz); L1 to L3 (credited) |  | C1 + L1-L3
B0 | A5 | 144.05 | 118.1055 | PWM comb | PWM 149.88 kHz x 788 | gva | False | -350.4 | -320.7 | -395.4 | -365.7 | pass | pass | False | False | 3.3 V GPIO, tr 2 to 5 ns, every 25th line of the comb shown | none needed (coherent 150 kHz comb, ADR-031 rule 3)
B0 | A5 | 144.05 | 119.0500 | Si5351 PLL spurs | PFD reference spur fc - 25 MHz | pre | False | -47.0 | -27.0 | -92.0 | -72.0 | pass | pass | False | False | VCO spur at the 25 MHz PFD offset, divided by 6 (-15.6 dB) (Low) | none (on-die PLL)
B0 | A5 | 144.05 | 120.0000 | RP2350 XOSC 12 MHz | XOSC 12 MHz x 10 | gva | False | -90.2 | -32.8 | -135.2 | -77.8 | pass | pass | False | False | on-die current into the Pico 2 PDN (0.1 to 0.5 ohm), path pdn 40 to 70 dB | cannot be moved (Pico 2 crystal); layout rules L1 to L3 (credited in the path loss, 50 to 75 dB) |  | L1-L3
B0 | A5 | 144.05 | 120.1000 | RP2350 XOSC 12 MHz | mirror of XOSC 12 MHz x 14 | gva | True | -96.2 | -38.8 | -141.2 | -83.8 | pass | pass | False | False | on-die current into the Pico 2 PDN (0.1 to 0.5 ohm), path pdn 40 to 70 dB | cannot be moved (Pico 2 crystal); layout rules L1 to L3 (credited in the path loss, 50 to 75 dB) |  | L1-L3
B0 | A5 | 144.05 | 121.2835 | PWM comb | mirror of PWM 149.88 kHz x 1113 | gva | True | -108.9 | -71.3 | -153.9 | -116.3 | pass | pass | False | False | 3.3 V GPIO, tr 2 to 5 ns, every 25th line of the comb shown | none needed (coherent 150 kHz comb, ADR-031 rule 3)
B0 | A5 | 144.05 | 121.8525 | PWM comb | PWM 149.88 kHz x 813 | gva | False | -94.6 | -64.5 | -139.6 | -109.5 | pass | pass | False | False | 3.3 V GPIO, tr 2 to 5 ns, every 25th line of the comb shown | none needed (coherent 150 kHz comb, ADR-031 rule 3)
B0 | A5 | 144.05 | 122.1000 | RP2350 on-die products | mirror of 2 x 125 - 7 x 12 MHz | gva | True | -101.8 | -39.0 | -146.8 | -84.0 | pass | pass | False | False | on-die current into the Pico 2 PDN (0.1 to 0.5 ohm), path pdn 40 to 70 dB | C1 puts every on-die product on the 12 MHz grid (120, 132, 144, 156, 168 MHz); L1 to L3 (credited) |  | C1 + L1-L3
B0 | A5 | 144.05 | 125.0000 | Si5351 reference 25 MHz | 4 coincident lines at 125.000 MHz (amplitude sum) | pre | False | -37.1 | -5.6 | -82.1 | -50.6 | not shown | not shown | True | True | no datasheet figure; below the -35 to -50 dBc output-to-output crosstalk reported for full-swing outputs (Low) | C1: clk_sys = clk_peri = 96 MHz in every state (PLL_SYS FBDIV 120, POSTDIV1 5, POSTDIV2 3); fundamental below 118 MHz, 2nd harmonic 192 MHz; C4: QSPI CLKDIV 2 (48 MHz, lines only on 144.000 MHz) and the transmit-path code and data in SRAM so the flash is idle during key-down; L4: TCXO output lead at most 10 mm and at least 8 mm from the CLK1 trace, named, not credited (path range 3 to 8 mm kept); treats the lead only, not the on-die feedthrough; cannot be moved (Si5351A reference 25 MHz, clock-plan rule 7); F1 Si5351 VDD filter named, effect not quantified (not credited) |  | C1 + C4 + F1 + L4 | clk_sys 125 MHz x 1: -65.8 to -13.0 dBm | QSPI SCK 31.25 MHz x 4: -365.2 to -29.6 dBm | 25 MHz x 5, Si5351 on-die feedthrough to CLK1: -37.1 to -12.1 dBm | 25 MHz x 5, TCXO lead near CLK1: -67.7 to -33.6 dBm
B0 | A5 | 144.05 | 125.0305 | PWM comb | mirror of PWM 149.88 kHz x 1088 | gva | True | -374.4 | -337.8 | -419.4 | -382.8 | pass | pass | False | False | 3.3 V GPIO, tr 2 to 5 ns, every 25th line of the comb shown | none needed (coherent 150 kHz comb, ADR-031 rule 3)
B0 | A5 | 144.05 | 125.5995 | PWM comb | PWM 149.88 kHz x 838 | gva | False | -356.6 | -326.2 | -401.6 | -371.2 | pass | pass | False | False | 3.3 V GPIO, tr 2 to 5 ns, every 25th line of the comb shown | none needed (coherent 150 kHz comb, ADR-031 rule 3)
B0 | A5 | 144.05 | 126.0438 | /8 prescaler | 4 coincident lines at 126.044 MHz (amplitude sum) | pre | False | -27.2 | -0.6 | -72.2 | -45.6 | not shown | not shown | True | True | 100 pF tap on CLK1, shared VCC: fc +/- fc/8 sidebands (Low) | C7 (revision 1): 47 ohm in series after the 100 pF tap, sized for a valid 74LVC1G80 clock; LTspice reverse isolation 0.4 dB credited. Named, not credited: each 74LVC1G80 on its own bead and 100 nF; C7b buffer gate ahead of the /8 chain; option C9 (/4 prescaler) moves the lines out of the window; C8: 470 ohm series resistor at the /8 output and the /8 trace 15 to 25 mm from the CLK1 net (L5), credited; option C9 (/4 prescaler) named |  | C7 + C7 supply beads + C7b + C8 + C9 + L5 | /8 output x 7 (7/8 fc) on the trace: -42.0 to -12.8 dBm | /8 kickback sideband (7/8 fc): -27.2 to -7.2 dBm | mirror of /8 output x 9 (9/8 fc) on the trace: -50.5 to -20.7 dBm | mirror of /8 kickback sideband (9/8 fc): -34.9 to -14.9 dBm
B0 | A5 | 144.05 | 127.1000 | RP2350 on-die products | mirror of 1 x 125 + 3 x 12 MHz | gva | True | -101.8 | -39.0 | -146.8 | -84.0 | pass | pass | False | False | on-die current into the Pico 2 PDN (0.1 to 0.5 ohm), path pdn 40 to 70 dB | C1 puts every on-die product on the 12 MHz grid (120, 132, 144, 156, 168 MHz); L1 to L3 (credited) |  | C1 + L1-L3
B0 | A5 | 144.05 | 128.0500 | Si5351 PLL B / CLK2 | 2 coincident lines at 128.050 MHz (amplitude sum) | pre | False | -37.2 | -14.2 | -82.2 | -59.2 | not shown | not shown | True | True | residual after CLK2 power-down; -35 to -50 dBc when the output runs (pavelmc Si5351_issues, NT7S part 8) (Low) | C6: in transmit PLL B is parked on the PLL A multiplier and CLK2 and CLK0 are powered down and disabled (register 3) |  | C6 | CLK2 BFO product fc - 2 x 8 MHz (CLK2 powered down, PLL B running): -37.2 to -17.2 dBm | mirror of CLK2 BFO product fc + 2 x 8 MHz (CLK2 powered down, PLL B running): -44.8 to -24.8 dBm
B0 | A5 | 144.05 | 128.7775 | PWM comb | mirror of PWM 149.88 kHz x 1063 | gva | True | -106.9 | -71.2 | -151.9 | -116.2 | pass | pass | False | False | 3.3 V GPIO, tr 2 to 5 ns, every 25th line of the comb shown | none needed (coherent 150 kHz comb, ADR-031 rule 3)
B0 | A5 | 144.05 | 129.3465 | PWM comb | PWM 149.88 kHz x 863 | gva | False | -95.6 | -64.7 | -140.6 | -109.7 | pass | pass | False | False | 3.3 V GPIO, tr 2 to 5 ns, every 25th line of the comb shown | none needed (coherent 150 kHz comb, ADR-031 rule 3)
B0 | A5 | 144.05 | 130.0000 | RP2350 on-die products | 2 x 125 - 10 x 12 MHz | gva | False | -95.8 | -33.0 | -140.8 | -78.0 | pass | pass | False | False | on-die current into the Pico 2 PDN (0.1 to 0.5 ohm), path pdn 40 to 70 dB | C1 puts every on-die product on the 12 MHz grid (120, 132, 144, 156, 168 MHz); L1 to L3 (credited) |  | C1 + L1-L3
B0 | A5 | 144.05 | 131.8500 | RP2350 QSPI SCK | mirror of QSPI SCK 31.25 MHz x 5 | gva | True | -60.0 | -23.7 | -105.0 | -68.7 | pass | pass | False | False | 3.3 V trace, tr 1 to 2 ns, activity (0.1, 1.0) | C4: QSPI CLKDIV 2 (48 MHz, lines only on 144.000 MHz) and the transmit-path code and data in SRAM so the flash is idle during key-down |  | C4
B0 | A5 | 144.05 | 132.0000 | RP2350 XOSC 12 MHz | XOSC 12 MHz x 11 | gva | False | -90.2 | -32.8 | -135.2 | -77.8 | pass | pass | False | False | on-die current into the Pico 2 PDN (0.1 to 0.5 ohm), path pdn 40 to 70 dB | cannot be moved (Pico 2 crystal); layout rules L1 to L3 (credited in the path loss, 50 to 75 dB) |  | L1-L3
B0 | A5 | 144.05 | 132.1000 | RP2350 XOSC 12 MHz | mirror of XOSC 12 MHz x 13 | gva | True | -96.2 | -38.8 | -141.2 | -83.8 | pass | pass | False | False | on-die current into the Pico 2 PDN (0.1 to 0.5 ohm), path pdn 40 to 70 dB | cannot be moved (Pico 2 crystal); layout rules L1 to L3 (credited in the path loss, 50 to 75 dB) |  | L1-L3
B0 | A5 | 144.05 | 132.5245 | PWM comb | mirror of PWM 149.88 kHz x 1038 | gva | True | -378.3 | -343.3 | -423.3 | -388.3 | pass | pass | False | False | 3.3 V GPIO, tr 2 to 5 ns, every 25th line of the comb shown | none needed (coherent 150 kHz comb, ADR-031 rule 3)
B0 | A5 | 144.05 | 133.0935 | PWM comb | PWM 149.88 kHz x 888 | gva | False | -374.7 | -343.3 | -419.7 | -388.3 | pass | pass | False | False | 3.3 V GPIO, tr 2 to 5 ns, every 25th line of the comb shown | none needed (coherent 150 kHz comb, ADR-031 rule 3)
B0 | A5 | 144.05 | 133.3333 | Si5351 PLL B / CLK2 | VCO B 800 MHz / 6 through MS1 | pre | False | -32.4 | -12.4 | -77.4 | -57.4 | not shown | not shown | True | True | VCO B leakage into MS1 (Low) | C6 (as above): VCO B leakage through MS1 then falls on the carrier |  | C6
B0 | A5 | 144.05 | 134.1000 | RP2350 on-die products | mirror of 2 x 125 - 8 x 12 MHz | gva | True | -101.8 | -39.1 | -146.8 | -84.1 | pass | pass | False | False | on-die current into the Pico 2 PDN (0.1 to 0.5 ohm), path pdn 40 to 70 dB | C1 puts every on-die product on the 12 MHz grid (120, 132, 144, 156, 168 MHz); L1 to L3 (credited) |  | C1 + L1-L3
B0 | A5 | 144.05 | 135.0500 | VGG / supply sidebands | RP2350 core regulator (3 MHz typ) ripple on the GVA-84+ bias, fc - 3 x 3 MHz | rel | False | -70.2 | -39.7 | -115.2 | -84.7 | pass | pass | False | False | ripple 1 to 10 mV at the GVA-84+ Vcc | F3: GVA-84+ supply through a ferrite bead and 22 uF (ripple at most 3 mV at 1 to 10 MHz), credited; derived requirement to WP-PDR-22 and WP-PDR-24 |  | F3
B0 | A5 | 144.05 | 136.0500 | Si5351 PLL B / CLK2 | 2 coincident lines at 136.050 MHz (amplitude sum) | pre | False | -37.6 | -14.3 | -82.6 | -59.3 | not shown | not shown | True | True | residual after CLK2 power-down; -35 to -50 dBc when the output runs (pavelmc Si5351_issues, NT7S part 8) (Low) | C6: in transmit PLL B is parked on the PLL A multiplier and CLK2 and CLK0 are powered down and disabled (register 3) |  | C6 | CLK2 BFO product fc - 1 x 8 MHz (CLK2 powered down, PLL B running): -37.6 to -17.6 dBm | mirror of CLK2 BFO product fc + 1 x 8 MHz (CLK2 powered down, PLL B running): -44.3 to -24.3 dBm
B0 | A5 | 144.05 | 136.2715 | PWM comb | mirror of PWM 149.88 kHz x 1013 | gva | True | -105.3 | -71.1 | -150.3 | -116.1 | pass | pass | False | False | 3.3 V GPIO, tr 2 to 5 ns, every 25th line of the comb shown | none needed (coherent 150 kHz comb, ADR-031 rule 3)
B0 | A5 | 144.05 | 136.8405 | PWM comb | PWM 149.88 kHz x 913 | gva | False | -96.7 | -64.8 | -141.7 | -109.8 | pass | pass | False | False | 3.3 V GPIO, tr 2 to 5 ns, every 25th line of the comb shown | none needed (coherent 150 kHz comb, ADR-031 rule 3)
B0 | A5 | 144.05 | 137.0000 | RP2350 on-die products | 1 x 125 + 1 x 12 MHz | gva | False | -95.8 | -33.1 | -140.8 | -78.1 | pass | pass | False | False | on-die current into the Pico 2 PDN (0.1 to 0.5 ohm), path pdn 40 to 70 dB | C1 puts every on-die product on the 12 MHz grid (120, 132, 144, 156, 168 MHz); L1 to L3 (credited) |  | C1 + L1-L3
B0 | A5 | 144.05 | 138.0500 | VGG / supply sidebands | 2 coincident lines at 138.050 MHz (amplitude sum) | rel | False | -64.2 | -30.2 | -109.2 | -75.2 | pass | pass | False | False | ripple 1 to 10 mV at the GVA-84+ Vcc | F3: GVA-84+ supply through a ferrite bead and 22 uF (ripple at most 3 mV at 1 to 10 MHz), credited; derived requirement to WP-PDR-22 and WP-PDR-24 |  | F3 | RT6150 (Pico 2, about 2 MHz, Low) ripple on the GVA-84+ bias, fc - 3 x 2 MHz: -70.2 to -39.7 dBm | RP2350 core regulator (3 MHz typ) ripple on the GVA-84+ bias, fc - 2 x 3 MHz: -64.2 to -33.7 dBm
B0 | A5 | 144.05 | 138.1000 | Si5351 reference 25 MHz | 2 coincident lines at 138.100 MHz (amplitude sum) | pre | True | -44.2 | -18.4 | -89.2 | -63.4 | not shown | pass | True | False | no datasheet figure; below the -35 to -50 dBc output-to-output crosstalk reported for full-swing outputs (Low) | L4: TCXO output lead at most 10 mm and at least 8 mm from the CLK1 trace, named, not credited (path range 3 to 8 mm kept); treats the lead only, not the on-die feedthrough; cannot be moved (Si5351A reference 25 MHz, clock-plan rule 7); F1 Si5351 VDD filter named, effect not quantified (not credited) |  | F1 + L4 | mirror of 25 MHz x 6, Si5351 on-die feedthrough to CLK1: -44.2 to -19.2 dBm | mirror of 25 MHz x 6, TCXO lead near CLK1: -73.3 to -39.2 dBm
B0 | A5 | 144.05 | 139.1000 | RP2350 on-die products | mirror of 1 x 125 + 2 x 12 MHz | gva | True | -101.9 | -39.1 | -146.9 | -84.1 | pass | pass | False | False | on-die current into the Pico 2 PDN (0.1 to 0.5 ohm), path pdn 40 to 70 dB | C1 puts every on-die product on the 12 MHz grid (120, 132, 144, 156, 168 MHz); L1 to L3 (credited) |  | C1 + L1-L3
B0 | A5 | 144.05 | 140.0185 | PWM comb | mirror of PWM 149.88 kHz x 988 | gva | True | -365.0 | -331.4 | -410.0 | -376.4 | pass | pass | False | False | 3.3 V GPIO, tr 2 to 5 ns, every 25th line of the comb shown | none needed (coherent 150 kHz comb, ADR-031 rule 3)
B0 | A5 | 144.05 | 140.0500 | VGG / supply sidebands | RT6150 (Pico 2, about 2 MHz, Low) ripple on the GVA-84+ bias, fc - 2 x 2 MHz | rel | False | -64.2 | -33.8 | -109.2 | -78.8 | pass | pass | False | False | ripple 1 to 10 mV at the GVA-84+ Vcc | F3: GVA-84+ supply through a ferrite bead and 22 uF (ripple at most 3 mV at 1 to 10 MHz), credited; derived requirement to WP-PDR-22 and WP-PDR-24 |  | F3
B0 | A5 | 144.05 | 140.5875 | PWM comb | PWM 149.88 kHz x 938 | gva | False | -352.8 | -320.4 | -397.8 | -365.4 | pass | pass | False | False | 3.3 V GPIO, tr 2 to 5 ns, every 25th line of the comb shown | none needed (coherent 150 kHz comb, ADR-031 rule 3)
B0 | A5 | 144.05 | 141.0500 | VGG / supply sidebands | RP2350 core regulator (3 MHz typ) ripple on the GVA-84+ bias, fc - 1 x 3 MHz | rel | False | -58.2 | -27.8 | -103.2 | -72.8 | pass | pass | False | False | ripple 1 to 10 mV at the GVA-84+ Vcc | F3: GVA-84+ supply through a ferrite bead and 22 uF (ripple at most 3 mV at 1 to 10 MHz), credited; derived requirement to WP-PDR-22 and WP-PDR-24 |  | F3
B0 | A5 | 144.05 | 142.0000 | RP2350 on-die products | 2 x 125 - 9 x 12 MHz | gva | False | -95.9 | -33.2 | -140.9 | -78.2 | pass | pass | False | False | on-die current into the Pico 2 PDN (0.1 to 0.5 ohm), path pdn 40 to 70 dB | C1 puts every on-die product on the 12 MHz grid (120, 132, 144, 156, 168 MHz); L1 to L3 (credited) |  | C1 + L1-L3
B0 | A5 | 144.05 | 142.0500 | Si5351 PLL spurs | 2 coincident lines at 142.050 MHz (amplitude sum) | pre | False | -42.9 | -19.0 | -87.9 | -64.0 | not shown | pass | True | False | PA3FWM tn42b: about -80 dBc in theory, measured worse (Low); offset depends on the fraction | C5: PLL A multiplier rule, fractional part not within 0.002 of an integer; named, not credited (it sets where a fractional spur falls, not its level); F3: GVA-84+ supply through a ferrite bead and 22 uF (ripple at most 3 mV at 1 to 10 MHz), credited; derived requirement to WP-PDR-22 and WP-PDR-24 |  | C5 + F3 | fractional / integer-boundary spur fc -2 MHz (representative): -42.9 to -22.9 dBm | RT6150 (Pico 2, about 2 MHz, Low) ripple on the GVA-84+ bias, fc - 1 x 2 MHz: -58.2 to -27.8 dBm
B0 | A5 | 144.05 | 143.5500 | Si5351 PLL spurs | fractional / integer-boundary spur fc -0.5 MHz (representative) | pre | False | -43.0 | -23.0 | -88.0 | -68.0 | not shown | pass | True | False | PA3FWM tn42b: about -80 dBc in theory, measured worse (Low); offset depends on the fraction | C5: PLL A multiplier rule, fractional part not within 0.002 of an integer; named, not credited (it sets where a fractional spur falls, not its level) |  | C5
B0 | A5 | 144.05 | 143.7500 | VGG / supply sidebands | envelope-reference PWM ripple, fc - 2 x 150 kHz | rel | False | -60.1 | -41.0 | -105.1 | -86.0 | pass | pass | False | False | AM index m = 0.6/V x ripple; ripple 0.23 to 0.84 mV (2-pole RC, 1 to 3 kHz) | none needed; derived requirement to WP-PDR-22: PWM ripple at VGG at most 3.3 mV peak
B0 | A5 | 144.05 | 143.7655 | PWM comb | mirror of PWM 149.88 kHz x 963 | gva | True | -104.0 | -71.0 | -149.0 | -116.0 | pass | pass | False | False | 3.3 V GPIO, tr 2 to 5 ns, every 25th line of the comb shown | none needed (coherent 150 kHz comb, ADR-031 rule 3)
B0 | A5 | 144.05 | 143.9000 | VGG / supply sidebands | envelope-reference PWM ripple, fc - 1 x 150 kHz | rel | False | -54.1 | -35.0 | -99.1 | -80.0 | pass | pass | False | False | AM index m = 0.6/V x ripple; ripple 0.23 to 0.84 mV (2-pole RC, 1 to 3 kHz) | none needed; derived requirement to WP-PDR-22: PWM ripple at VGG at most 3.3 mV peak
B0 | A5 | 144.05 | 144.0000 | RP2350 XOSC 12 MHz | 3 coincident lines at 144.000 MHz (amplitude sum) | gva | False | -90.4 | -26.9 | -135.4 | -71.9 | pass | pass | False | False | on-die current into the Pico 2 PDN (0.1 to 0.5 ohm), path pdn 40 to 70 dB | C2: clk_adc from PLL_SYS / 2 (AUXSRC CLKSRC_PLL_SYS, DIV 2) enabled only for conversion bursts (ENABLE bit); C3: PLL_USB powered down (PWR.PD, VCOPD) outside USB; cannot be moved (Pico 2 crystal); layout rules L1 to L3 (credited in the path loss, 50 to 75 dB) |  | C2 + C3 + L1-L3 | XOSC 12 MHz x 12: -90.4 to -32.9 dBm | clk_adc 48 MHz x 3 (continuous): -100.8 to -42.5 dBm | PLL_USB 48 MHz x 3 (running): -96.4 to -36.5 dBm
B0 | A5 | 144.05 | 144.1000 | RP2350 XOSC 12 MHz | 3 coincident lines at 144.100 MHz (amplitude sum) | gva | True | -96.4 | -32.9 | -141.4 | -77.9 | pass | pass | False | False | on-die current into the Pico 2 PDN (0.1 to 0.5 ohm), path pdn 40 to 70 dB | C2: clk_adc from PLL_SYS / 2 (AUXSRC CLKSRC_PLL_SYS, DIV 2) enabled only for conversion bursts (ENABLE bit); C3: PLL_USB powered down (PWR.PD, VCOPD) outside USB; cannot be moved (Pico 2 crystal); layout rules L1 to L3 (credited in the path loss, 50 to 75 dB) |  | C2 + C3 + L1-L3 | mirror of XOSC 12 MHz x 12: -96.4 to -38.9 dBm | mirror of clk_adc 48 MHz x 3 (continuous): -106.8 to -48.5 dBm | mirror of PLL_USB 48 MHz x 3 (running): -102.4 to -42.5 dBm
B0 | A5 | 144.05 | 144.2000 | VGG / supply sidebands | envelope-reference PWM ripple, fc + 1 x 150 kHz | rel | False | -54.1 | -35.0 | -99.1 | -80.0 | pass | pass | False | False | AM index m = 0.6/V x ripple; ripple 0.23 to 0.84 mV (2-pole RC, 1 to 3 kHz) | none needed; derived requirement to WP-PDR-22: PWM ripple at VGG at most 3.3 mV peak
B0 | A5 | 144.05 | 144.3345 | PWM comb | PWM 149.88 kHz x 963 | gva | False | -98.0 | -65.0 | -143.0 | -110.0 | pass | pass | False | False | 3.3 V GPIO, tr 2 to 5 ns, every 25th line of the comb shown | none needed (coherent 150 kHz comb, ADR-031 rule 3)
B0 | A5 | 144.05 | 144.3500 | VGG / supply sidebands | envelope-reference PWM ripple, fc + 2 x 150 kHz | rel | False | -60.1 | -41.0 | -105.1 | -86.0 | pass | pass | False | False | AM index m = 0.6/V x ripple; ripple 0.23 to 0.84 mV (2-pole RC, 1 to 3 kHz) | none needed; derived requirement to WP-PDR-22: PWM ripple at VGG at most 3.3 mV peak
B0 | A5 | 144.05 | 144.5500 | Si5351 PLL spurs | fractional / integer-boundary spur fc +0.5 MHz (representative) | pre | False | -43.0 | -23.0 | -88.0 | -68.0 | pass | pass | False | False | PA3FWM tn42b: about -80 dBc in theory, measured worse (Low); offset depends on the fraction | C5: PLL A multiplier rule, fractional part not within 0.002 of an integer; named, not credited (it sets where a fractional spur falls, not its level) |  | C5
B0 | A5 | 144.05 | 146.0500 | Si5351 PLL spurs | 2 coincident lines at 146.050 MHz (amplitude sum) | pre | False | -43.1 | -19.1 | -88.1 | -64.1 | not shown | pass | True | False | PA3FWM tn42b: about -80 dBc in theory, measured worse (Low); offset depends on the fraction | C5: PLL A multiplier rule, fractional part not within 0.002 of an integer; named, not credited (it sets where a fractional spur falls, not its level); F3: GVA-84+ supply through a ferrite bead and 22 uF (ripple at most 3 mV at 1 to 10 MHz), credited; derived requirement to WP-PDR-22 and WP-PDR-24 |  | C5 + F3 | fractional / integer-boundary spur fc +2 MHz (representative): -43.1 to -23.1 dBm | RT6150 (Pico 2, about 2 MHz, Low) ripple on the GVA-84+ bias, fc + 1 x 2 MHz: -58.3 to -27.8 dBm
B0 | A5 | 144.05 | 146.1000 | RP2350 on-die products | mirror of 2 x 125 - 9 x 12 MHz | gva | True | -101.9 | -39.2 | -146.9 | -84.2 | pass | pass | False | False | on-die current into the Pico 2 PDN (0.1 to 0.5 ohm), path pdn 40 to 70 dB | C1 puts every on-die product on the 12 MHz grid (120, 132, 144, 156, 168 MHz); L1 to L3 (credited) |  | C1 + L1-L3
B0 | A5 | 144.05 | 147.0500 | VGG / supply sidebands | RP2350 core regulator (3 MHz typ) ripple on the GVA-84+ bias, fc + 1 x 3 MHz | rel | False | -58.3 | -27.8 | -103.3 | -72.8 | pass | pass | False | False | ripple 1 to 10 mV at the GVA-84+ Vcc | F3: GVA-84+ supply through a ferrite bead and 22 uF (ripple at most 3 mV at 1 to 10 MHz), credited; derived requirement to WP-PDR-22 and WP-PDR-24 |  | F3
B0 | A5 | 144.05 | 147.5125 | PWM comb | mirror of PWM 149.88 kHz x 938 | gva | True | -358.9 | -326.5 | -403.9 | -371.5 | pass | pass | False | False | 3.3 V GPIO, tr 2 to 5 ns, every 25th line of the comb shown | none needed (coherent 150 kHz comb, ADR-031 rule 3)
B0 | A5 | 144.05 | 148.0500 | VGG / supply sidebands | RT6150 (Pico 2, about 2 MHz, Low) ripple on the GVA-84+ bias, fc + 2 x 2 MHz | rel | False | -64.3 | -33.8 | -109.3 | -78.8 | pass | pass | False | False | ripple 1 to 10 mV at the GVA-84+ Vcc | F3: GVA-84+ supply through a ferrite bead and 22 uF (ripple at most 3 mV at 1 to 10 MHz), credited; derived requirement to WP-PDR-22 and WP-PDR-24 |  | F3
B0 | A5 | 144.05 | 148.0815 | PWM comb | PWM 149.88 kHz x 988 | gva | False | -359.1 | -325.5 | -404.1 | -370.5 | pass | pass | False | False | 3.3 V GPIO, tr 2 to 5 ns, every 25th line of the comb shown | none needed (coherent 150 kHz comb, ADR-031 rule 3)
B0 | A5 | 144.05 | 149.0000 | RP2350 on-die products | 1 x 125 + 2 x 12 MHz | gva | False | -96.0 | -33.2 | -141.0 | -78.2 | pass | pass | False | False | on-die current into the Pico 2 PDN (0.1 to 0.5 ohm), path pdn 40 to 70 dB | C1 puts every on-die product on the 12 MHz grid (120, 132, 144, 156, 168 MHz); L1 to L3 (credited) |  | C1 + L1-L3
B0 | A5 | 144.05 | 150.0000 | Si5351 reference 25 MHz | 2 coincident lines at 150.000 MHz (amplitude sum) | pre | False | -38.4 | -12.5 | -83.4 | -57.5 | not shown | not shown | True | True | no datasheet figure; below the -35 to -50 dBc output-to-output crosstalk reported for full-swing outputs (Low) | L4: TCXO output lead at most 10 mm and at least 8 mm from the CLK1 trace, named, not credited (path range 3 to 8 mm kept); treats the lead only, not the on-die feedthrough; cannot be moved (Si5351A reference 25 MHz, clock-plan rule 7); F1 Si5351 VDD filter named, effect not quantified (not credited) |  | F1 + L4 | 25 MHz x 6, Si5351 on-die feedthrough to CLK1: -38.4 to -13.4 dBm | 25 MHz x 6, TCXO lead near CLK1: -67.4 to -33.3 dBm
B0 | A5 | 144.05 | 150.0500 | VGG / supply sidebands | 2 coincident lines at 150.050 MHz (amplitude sum) | rel | False | -64.3 | -30.3 | -109.3 | -75.3 | pass | pass | False | False | ripple 1 to 10 mV at the GVA-84+ Vcc | F3: GVA-84+ supply through a ferrite bead and 22 uF (ripple at most 3 mV at 1 to 10 MHz), credited; derived requirement to WP-PDR-22 and WP-PDR-24 |  | F3 | RT6150 (Pico 2, about 2 MHz, Low) ripple on the GVA-84+ bias, fc + 3 x 2 MHz: -70.3 to -39.9 dBm | RP2350 core regulator (3 MHz typ) ripple on the GVA-84+ bias, fc + 2 x 3 MHz: -64.3 to -33.9 dBm
B0 | A5 | 144.05 | 151.1000 | RP2350 on-die products | mirror of 1 x 125 + 1 x 12 MHz | gva | True | -102.0 | -39.2 | -147.0 | -84.2 | pass | pass | False | False | on-die current into the Pico 2 PDN (0.1 to 0.5 ohm), path pdn 40 to 70 dB | C1 puts every on-die product on the 12 MHz grid (120, 132, 144, 156, 168 MHz); L1 to L3 (credited) |  | C1 + L1-L3
B0 | A5 | 144.05 | 151.2595 | PWM comb | mirror of PWM 149.88 kHz x 913 | gva | True | -102.8 | -71.0 | -147.8 | -116.0 | pass | pass | False | False | 3.3 V GPIO, tr 2 to 5 ns, every 25th line of the comb shown | none needed (coherent 150 kHz comb, ADR-031 rule 3)
B0 | A5 | 144.05 | 151.8285 | PWM comb | PWM 149.88 kHz x 1013 | gva | False | -99.5 | -65.2 | -144.5 | -110.2 | pass | pass | False | False | 3.3 V GPIO, tr 2 to 5 ns, every 25th line of the comb shown | none needed (coherent 150 kHz comb, ADR-031 rule 3)
B0 | A5 | 144.05 | 152.0500 | Si5351 PLL B / CLK2 | 2 coincident lines at 152.050 MHz (amplitude sum) | pre | False | -38.5 | -14.7 | -83.5 | -59.7 | not shown | not shown | True | True | residual after CLK2 power-down; -35 to -50 dBc when the output runs (pavelmc Si5351_issues, NT7S part 8) (Low) | C6: in transmit PLL B is parked on the PLL A multiplier and CLK2 and CLK0 are powered down and disabled (register 3) |  | C6 | mirror of CLK2 BFO product fc - 1 x 8 MHz (CLK2 powered down, PLL B running): -43.7 to -23.7 dBm | CLK2 BFO product fc + 1 x 8 MHz (CLK2 powered down, PLL B running): -38.5 to -18.5 dBm
B0 | A5 | 144.05 | 153.0500 | VGG / supply sidebands | RP2350 core regulator (3 MHz typ) ripple on the GVA-84+ bias, fc + 3 x 3 MHz | rel | False | -70.3 | -39.9 | -115.3 | -84.9 | pass | pass | False | False | ripple 1 to 10 mV at the GVA-84+ Vcc | F3: GVA-84+ supply through a ferrite bead and 22 uF (ripple at most 3 mV at 1 to 10 MHz), credited; derived requirement to WP-PDR-22 and WP-PDR-24 |  | F3
B0 | A5 | 144.05 | 154.0000 | RP2350 on-die products | 2 x 125 - 8 x 12 MHz | gva | False | -96.0 | -33.2 | -141.0 | -78.2 | pass | pass | False | False | on-die current into the Pico 2 PDN (0.1 to 0.5 ohm), path pdn 40 to 70 dB | C1 puts every on-die product on the 12 MHz grid (120, 132, 144, 156, 168 MHz); L1 to L3 (credited) |  | C1 + L1-L3
B0 | A5 | 144.05 | 154.7667 | Si5351 PLL B / CLK2 | mirror of VCO B 800 MHz / 6 through MS1 | pre | True | -38.6 | -18.6 | -83.6 | -63.6 | not shown | pass | True | False | VCO B leakage into MS1 (Low) | C6 (as above): VCO B leakage through MS1 then falls on the carrier |  | C6
B0 | A5 | 144.05 | 155.0065 | PWM comb | mirror of PWM 149.88 kHz x 888 | gva | True | -380.9 | -349.5 | -425.9 | -394.5 | pass | pass | False | False | 3.3 V GPIO, tr 2 to 5 ns, every 25th line of the comb shown | none needed (coherent 150 kHz comb, ADR-031 rule 3)
B0 | A5 | 144.05 | 155.5755 | PWM comb | PWM 149.88 kHz x 1038 | gva | False | -372.5 | -337.5 | -417.5 | -382.5 | pass | pass | False | False | 3.3 V GPIO, tr 2 to 5 ns, every 25th line of the comb shown | none needed (coherent 150 kHz comb, ADR-031 rule 3)
B0 | A5 | 144.05 | 156.0000 | RP2350 XOSC 12 MHz | XOSC 12 MHz x 13 | gva | False | -90.4 | -33.0 | -135.4 | -78.0 | pass | pass | False | False | on-die current into the Pico 2 PDN (0.1 to 0.5 ohm), path pdn 40 to 70 dB | cannot be moved (Pico 2 crystal); layout rules L1 to L3 (credited in the path loss, 50 to 75 dB) |  | L1-L3
B0 | A5 | 144.05 | 156.1000 | RP2350 XOSC 12 MHz | mirror of XOSC 12 MHz x 11 | gva | True | -96.4 | -39.0 | -141.4 | -84.0 | pass | pass | False | False | on-die current into the Pico 2 PDN (0.1 to 0.5 ohm), path pdn 40 to 70 dB | cannot be moved (Pico 2 crystal); layout rules L1 to L3 (credited in the path loss, 50 to 75 dB) |  | L1-L3
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
