robinonsay/cwht/hardware/sim/tx-lpf/results/2026-09-28-r8-wc-1812sms-bom/harmonic_bands_wc.png

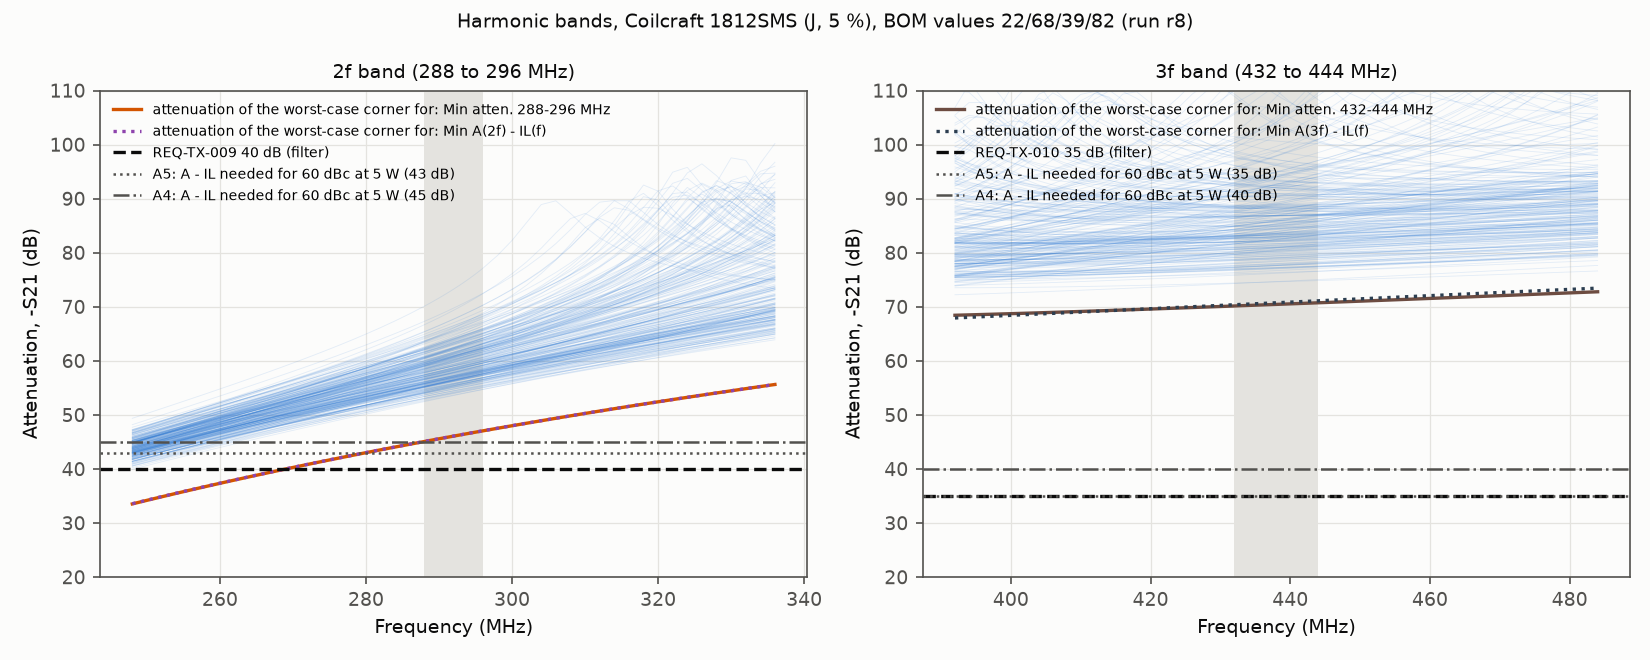
hardware/sim/tx-lpf/results/2026-09-28-r8-wc-1812sms-bom/harmonic_bands_wc.png
