robinonsay/cwht/hardware/sim/tx-lpf/results/2026-09-28-r8-wc-1812sms-bom/mc_wc_histograms.png

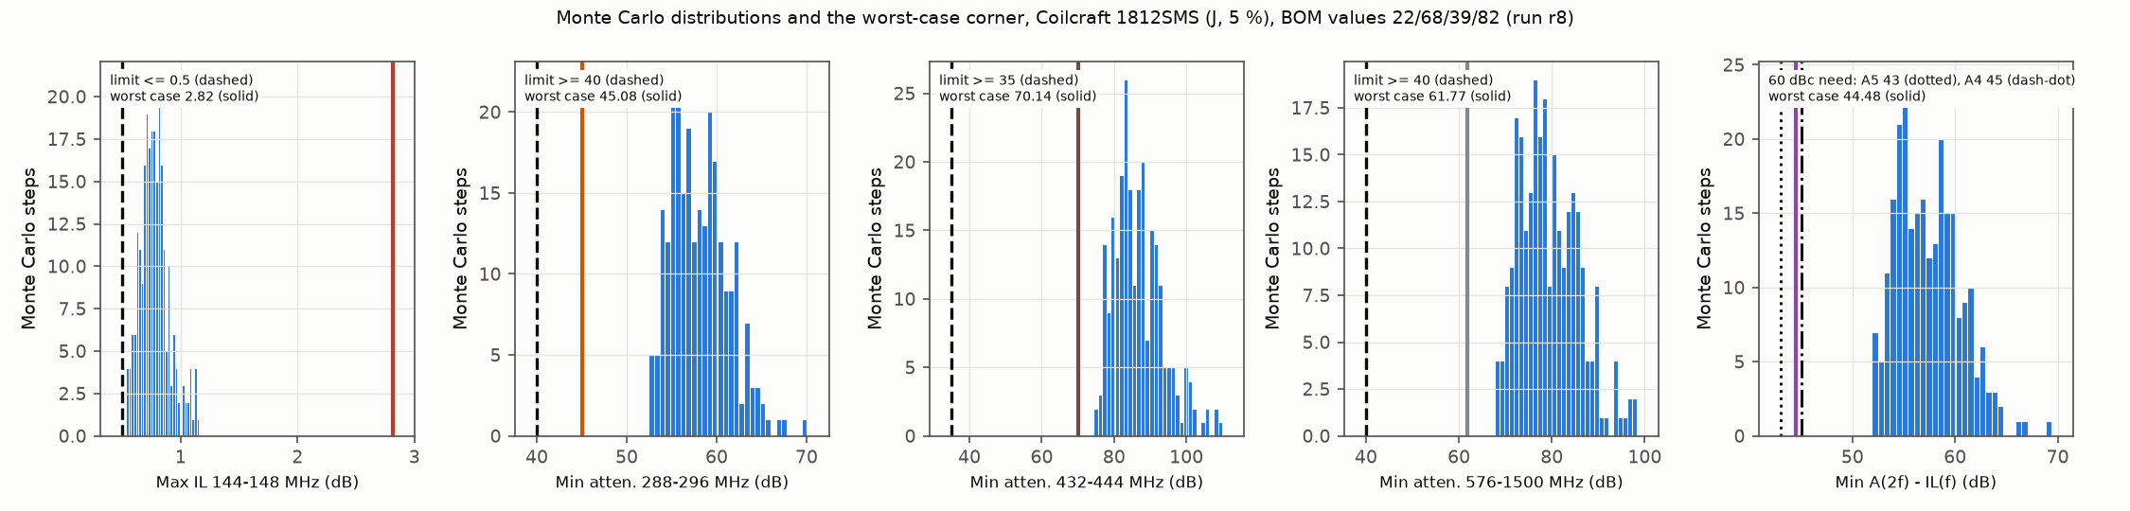
hardware/sim/tx-lpf/results/2026-09-28-r8-wc-1812sms-bom/mc_wc_histograms.png
