robinonsay/cwht/hardware/sim/tx-lpf/results/2026-09-28-r9-wc-air-aswound-bom/il_wc_passband.png

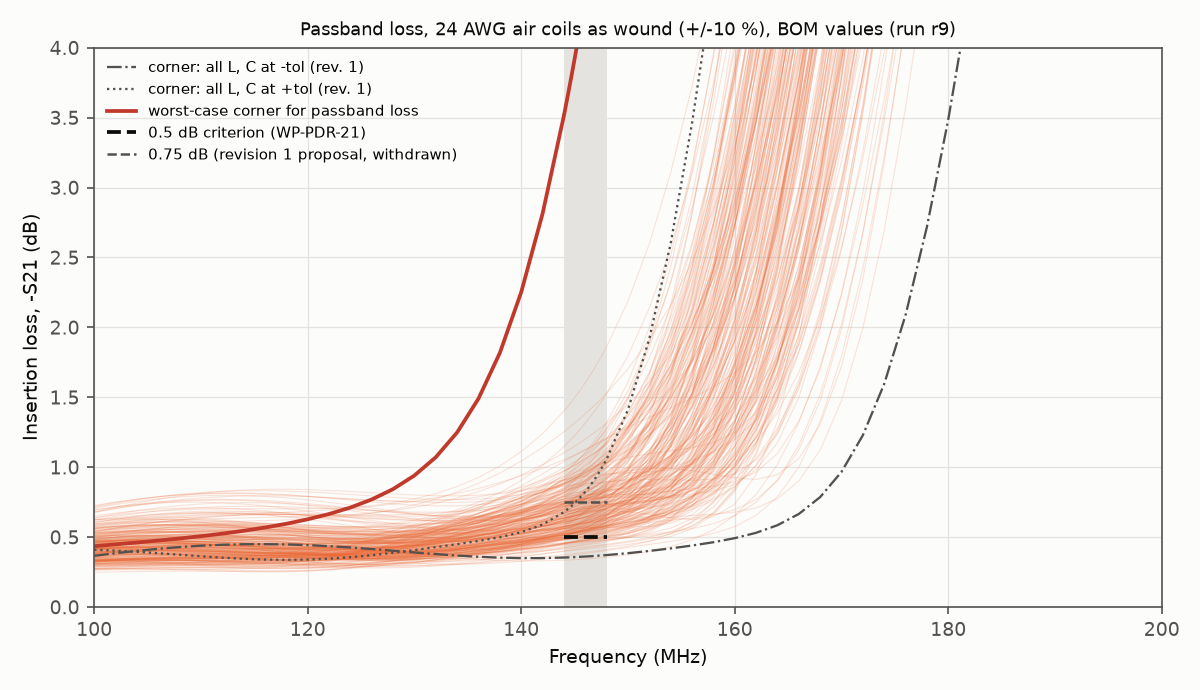
hardware/sim/tx-lpf/results/2026-09-28-r9-wc-air-aswound-bom/il_wc_passband.png
