robinonsay/cwht/hardware/sim/tx-lpf/results/2026-09-28-r9-wc-air-aswound-bom/mc_wc_histograms.png

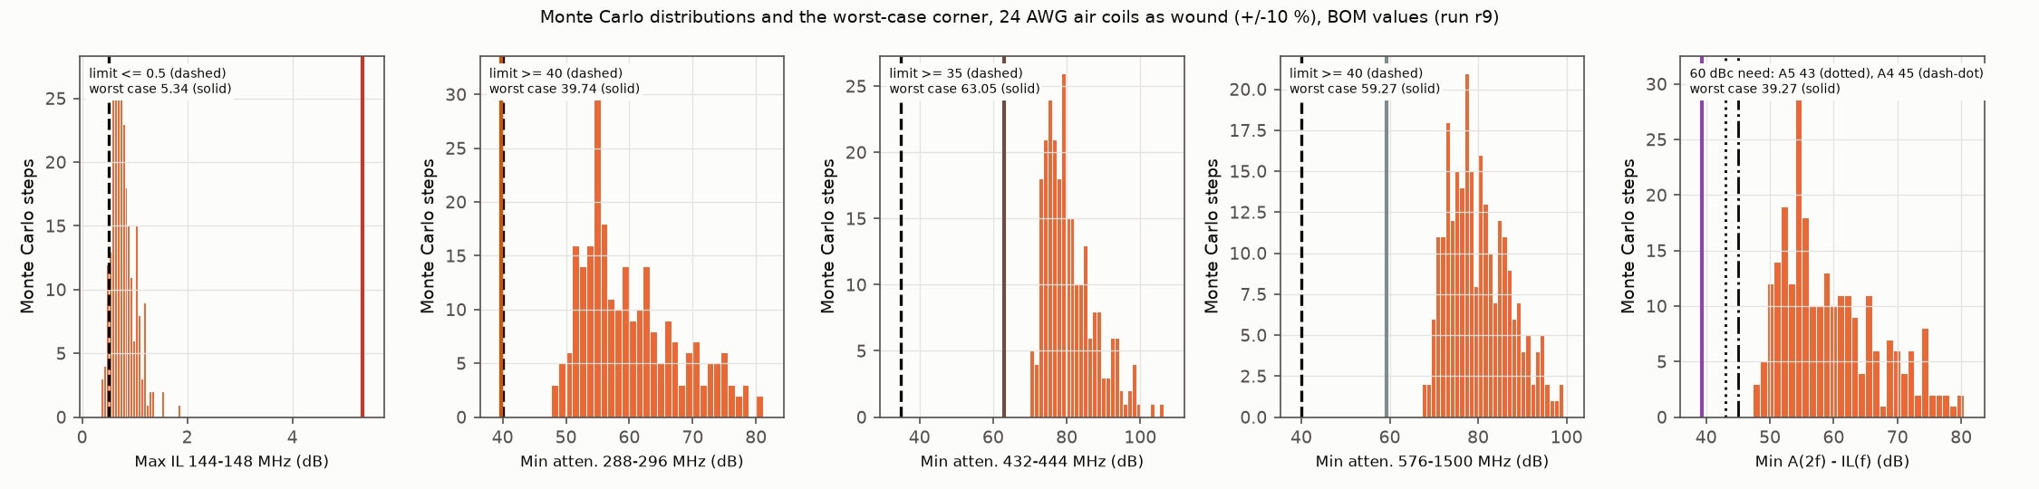
hardware/sim/tx-lpf/results/2026-09-28-r9-wc-air-aswound-bom/mc_wc_histograms.png
