robinonsay/cwht/hardware/sim/tx-lpf/results/2026-09-28-r9-wc-air-aswound-bom/s21_wc_wide.png

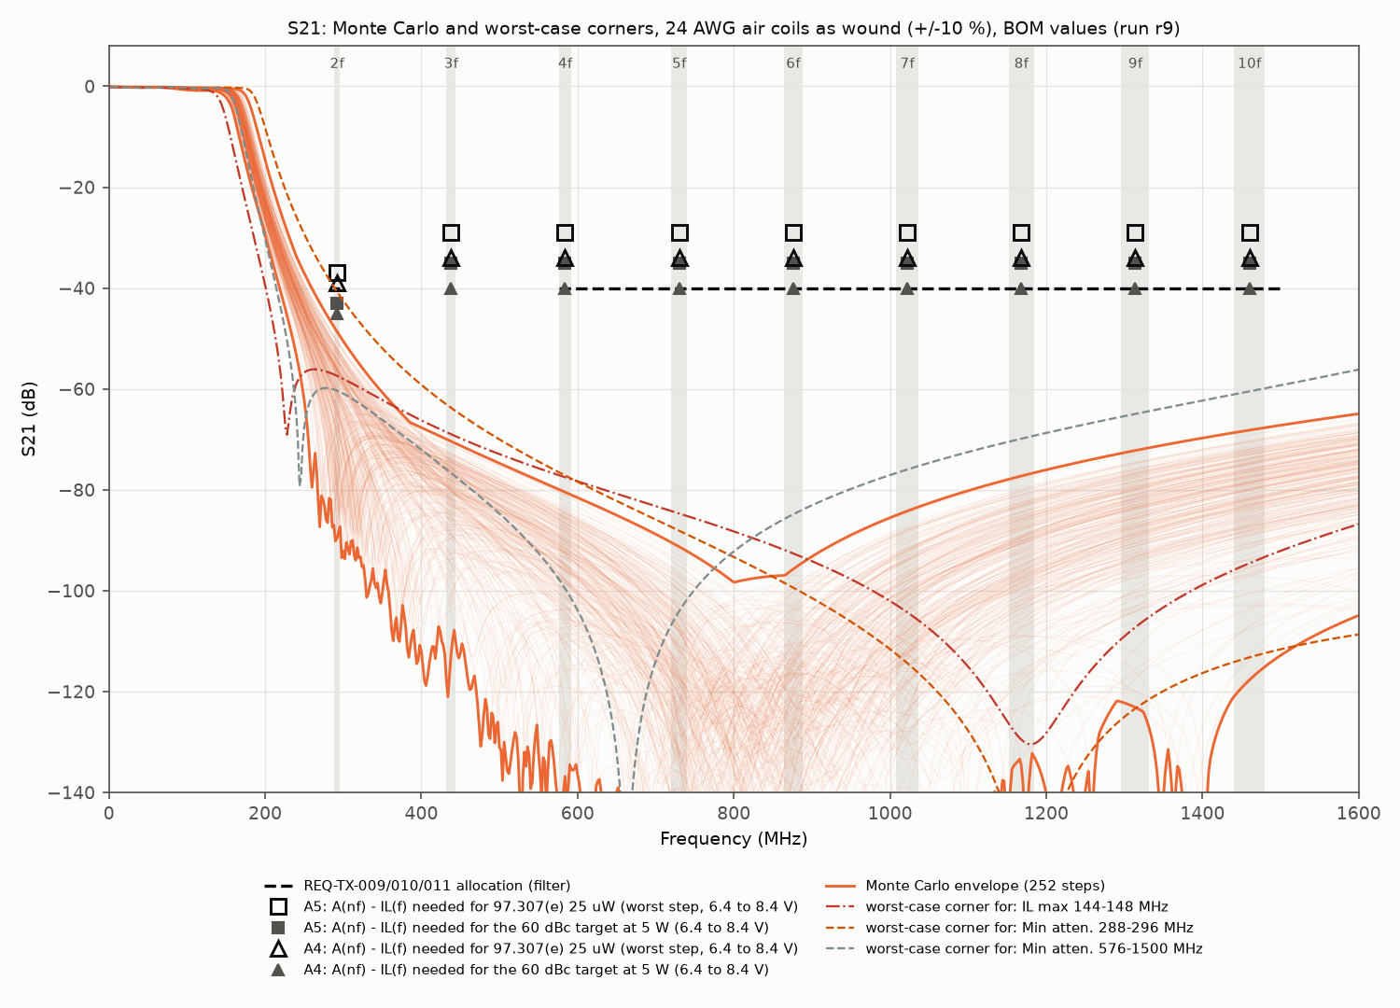
hardware/sim/tx-lpf/results/2026-09-28-r9-wc-air-aswound-bom/s21_wc_wide.png
