robinonsay/cwht/hardware/sim/tx-lpf/results/2026-09-28-r10-wc-air-aligned-bom/mc_wc_histograms.png

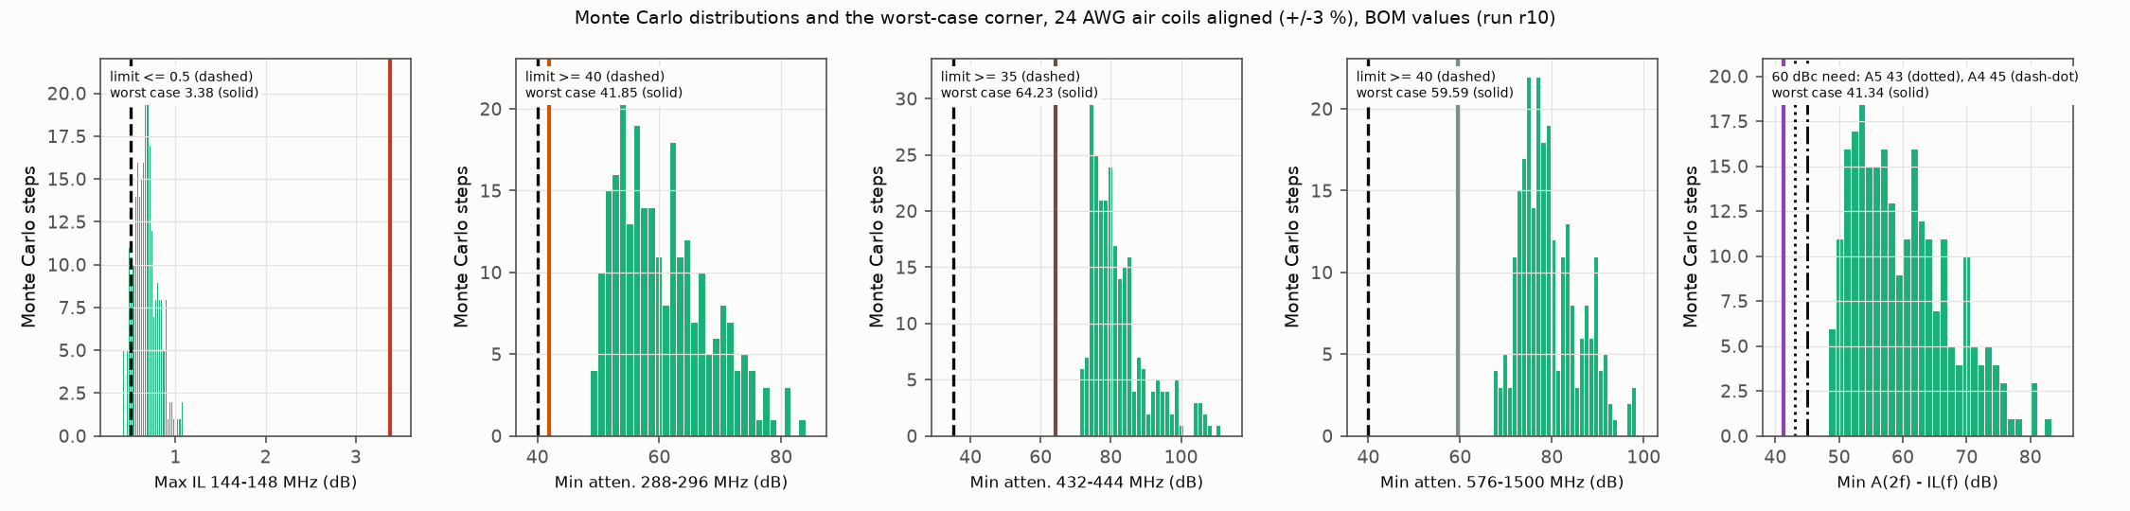
hardware/sim/tx-lpf/results/2026-09-28-r10-wc-air-aligned-bom/mc_wc_histograms.png
