robinonsay/cwht/hardware/sim/tx-lpf/results/2026-09-28-r13-wc-1812sms-bom-2pct/mc_wc_histograms.png

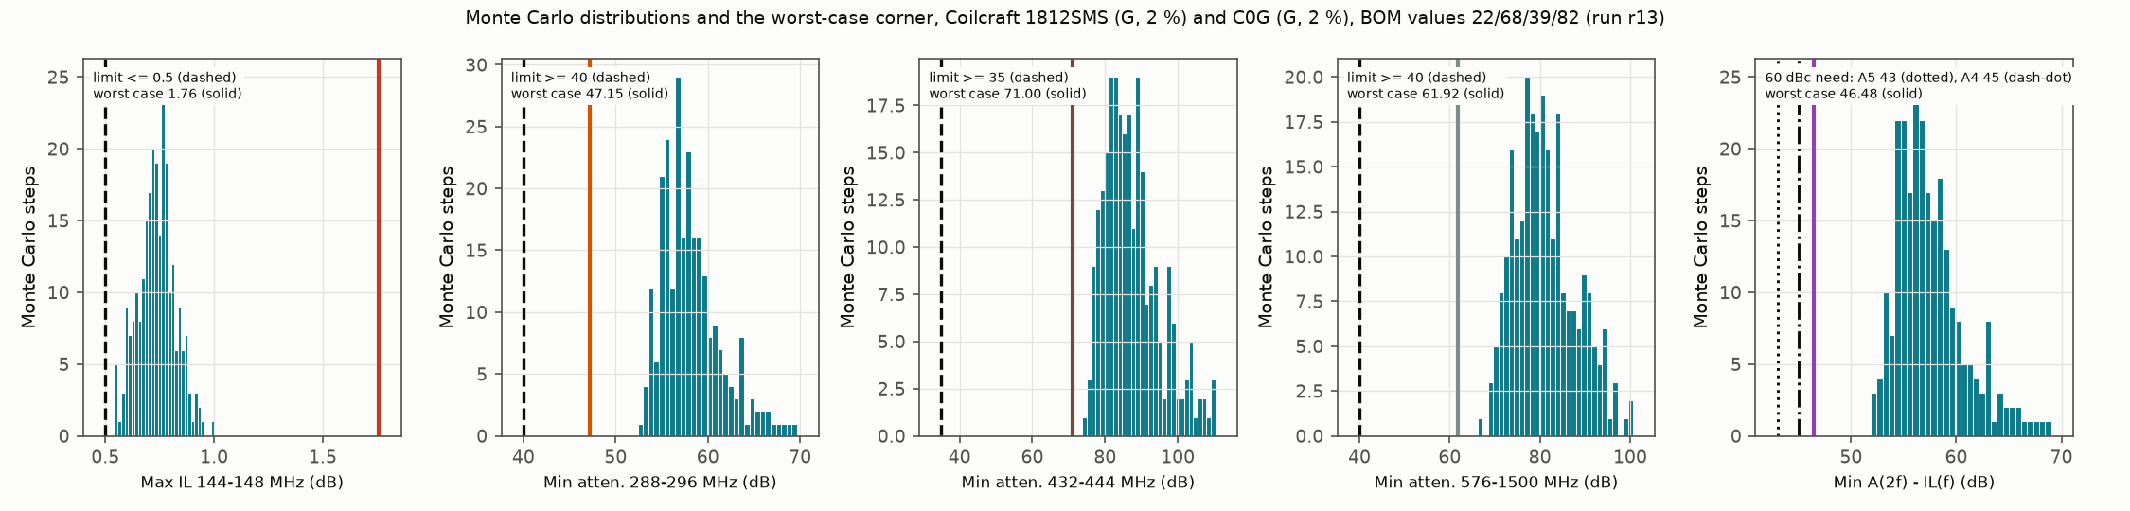
hardware/sim/tx-lpf/results/2026-09-28-r13-wc-1812sms-bom-2pct/mc_wc_histograms.png
