robinonsay/cwht/hardware/sim/tx-lpf/results/2026-09-28-r13-wc-1812sms-bom-2pct/s21_wc_wide.png

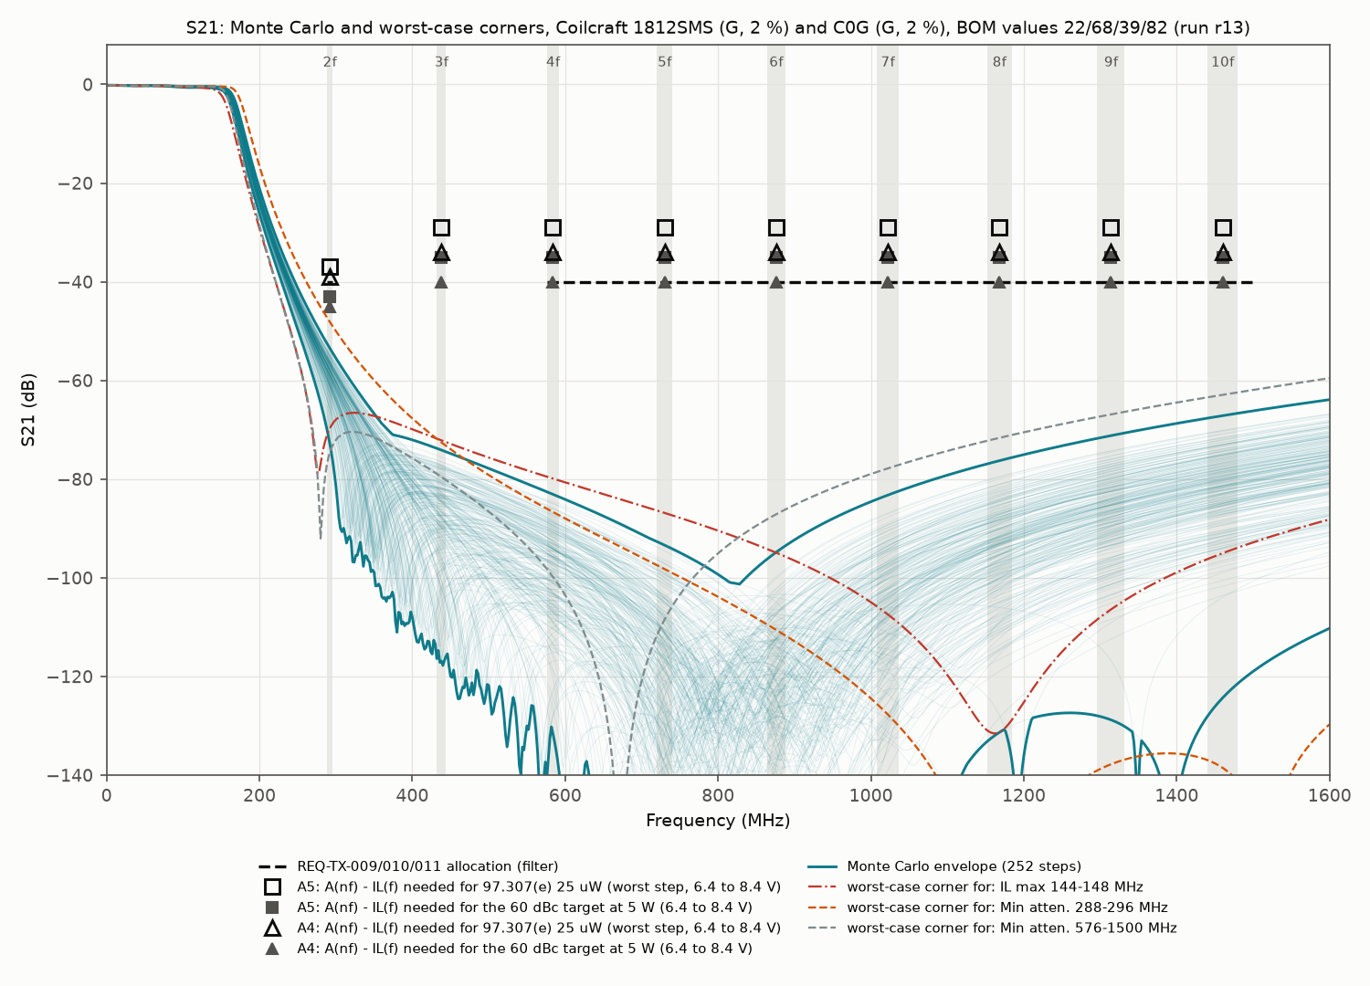
hardware/sim/tx-lpf/results/2026-09-28-r13-wc-1812sms-bom-2pct/s21_wc_wide.png
