robinonsay/cwht/docs/cm/cr/CR-006-build-sequence-one-unit-first.md

---
id: CR-006
title: Build one assembled unit first and decide on further units after its evaluation
status: Submitted
class: I
originator: Owner
date_opened: 2026-09-27
phase: Pre-A/A
configuration_at_origination: baseline/srr (tag on 779f93f); HEAD 72e1863 on main (revision 1); HEAD e8f21c9 on main (revision 2); HEAD 908d21a on main (revision 3)
baseline_affected: baseline/srr
affected_cis: [2, 3, 5, 6, 7, 13, 14, 17, 18, 34, 52]
affected_paths: [docs/requirements/l0-stakeholder/expectations.json, docs/requirements/l0-stakeholder/expectations.md, docs/requirements/sys/requirements.json, docs/requirements/sys/requirements.md, docs/test_cases/sys/test_cases.json, docs/test_cases/sys/test_cases.md, docs/conops/conops.md, docs/plan/cost-estimate.md, docs/plan/schedule.md, docs/plan/semp.md, docs/plan/tpm.json, docs/process/01-lifecycle-and-reviews.md, docs/process/rmm.json, docs/process/rmm.md, docs/design/concept.md, docs/decisions/adr/ADR-025-build-quantity-cap.md, docs/decisions/adr/ADR-028-build-sequence-one-unit-first.md, docs/decisions/adr/README.md, docs/requirements/l0-stakeholder/stakeholder-inputs.md, docs/risk/register.json, docs/risk/register.md, docs/vv/traceability-report.md, docs/vv/traceability.json]
affected_ids: [CON-024, NGO-009, NGO-010, NGO-027, NGO-028, MOE-001, MOE-002, MOE-007, RSK-034, TC-SYS-087, OPS-004, OPS-006, OPS-012, REQ-SYS-029, REQ-SYS-030, REQ-SYS-037, REQ-SYS-125, REQ-SYS-147, TC-SYS-025, TC-SYS-098, ADR-025, ADR-028, SI-039, TPM-014, MOP-016, RSK-004, RSK-025, RSK-052, SWE-151]
related: [SI-035, SI-019, SI-031, SI-040, SI-041, SI-042, SI-043, TS-012, CR-018, CR-003, ADR-007, ADR-025, RSK-008, RSK-014, RSK-038, RSK-065, TC-SYS-072, TC-SYS-079, TC-SYS-080, TC-SYS-087]
target_release: none
branch: cr/CR-006-build-sequence-one-unit-first
disposition: null
disposition_date: null
relook_trigger: null
relook_by: null
merge_sha: null
date_closed: null
---

# CR-006: Build one assembled unit first and decide on further units after its evaluation

Template: `docs/templates/change-request.md`. Process: `docs/process/05-configuration-and-data-management.md` §5.1 to §5.3 and `docs/process/02-requirements-and-traceability.md` §10.2 and §10.3. File location: this file, committed on `main` with `Refs: CR-006`; the product changes go on the branch `cr/CR-006-build-sequence-one-unit-first` after disposition. Status: **Submitted**. The independent review of section 6 is required before the owner's disposition (SRR close-out lesson recorded for CR-002 and CR-004 in `docs/cm/deviations.md` entries 1 and 2).

**Revision 2 (2026-09-27, at HEAD `e8f21c9`).** Revision 1 (`9373729`) received its independent impact review at `34668e3` (section 6.1: 1 Major, 7 Minor). Revision 2 resolves every finding; section 6.2 maps each finding to its resolution, section 6.1 is unchanged, and section 11 records the revision. Main changes: the second station of MOE-001 and MOE-002 is matched to the unit (carrier power within 1 dB, the same reference antenna, a radiated check on site) and the pass is judged at the cwht end, with the reciprocal direction by Analysis on a stated path-loss model (F1); NGO-009 and NGO-010 are restated (F2); the TC-SYS-025 pad is 9 dB or more and the source is bounded by the pad rating, and the REQ-SYS-029 interferer's phase noise is recorded (F3); the stress-case list and order are aligned with CR-003 section 5 (F4); every enclosure spend stays charged to the unit, with the exclusion offered to the owner in Q3 and the TPM-014 Red point and the CNC-drawn figure stated (F5); the REQ-SYS-147 statement says "complete units" (F6); the missed items are added (F7); the volatility figure and the section 9 search are corrected (F8). The revision 1 text stays in the history of this file (`git show 9373729:docs/cm/cr/CR-006-build-sequence-one-unit-first.md`).

**Revision 3 (2026-09-29, at HEAD `908d21a`).** The owner chose TS-012 finalist A5 as the hand-built design on 2026-09-29 (`docs/decisions/trade-studies/TS-012-design-to-cost-hand-built.md` revision 7 section 10; `docs/plan/status/status-2026-09-29.md` section 5). Revision 2 was written for a PCBWay turnkey order. TS-012 section 8.12 says its reading (one assembled unit first) stands and its PCBWay content does not, items (a) to (e), and the PDR work plan revision 6 (WP-PDR-01) assigns this revision. Revision 3 applies them and resolves the four Minor findings of round 2 (R2-F1 to R2-F4, section 6.4): (a) JLCPCB fabricates five bare boards of each of the two A5 board designs (a main board and an RF board, each within 100 x 100 mm) and the owner assembles one unit from them; (b) REQ-SYS-147, NGO-028 and MOE-007 take the owner's first-unit USD 200 target and USD 300 maximum (SI-042) in place of USD 610 per unit amortized over the first build; (c) NGO-027 changes from PCBWay turnkey assembly to JLCPCB bare boards assembled by the owner; (d) questions Q2 (the PCBWay assembled count), Q3 (the unit-cost options) and Q8 (unused turnkey parts) are moot and are closed in section 12; (e) the TC-SYS-025 source and the matched second station of MOE-001 and MOE-002 stand (the owner's Baofeng BF-F8HP for TC-SYS-025, status note 2026-09-27 section 5), with the R2-F2 and R2-F3 rules added. The owner inputs of 2026-09-27 that govern this revision are status note sections 6, 8, 10 and 11, cited as SI-040 to SI-043, the ids the re-baseline CR-018 proposes for them (the next free ids after SI-039); whichever of CR-003, CR-006 and CR-018 is implemented first appends them. Revision 3 needs the reviewer's round 3 re-check (section 6.5) before the owner's disposition at S1 (OD-03). The revision 2 text stays in the history of this file (`git show 908d21a:docs/cm/cr/CR-006-build-sequence-one-unit-first.md`).

Source: owner input 5 of 2026-09-27, transcribed verbatim with the lead SE reading in `docs/plan/status/status-2026-09-27.md` (commit `72e1863`), section 2 and section 3 row 5. The owner's words on this point: "we're going to build one circuit board" and "we're going to do basically one item at a time". Status note section 3 row 5 names this CR.

Scope boundary with CR-003. CR-003 (Submitted, in revision) owns the enclosure: which option is built first (option C, printed PETG with a conductive coating and a heatsink), its acceptance criteria and the CNC fallback from PCBWay. CR-006 owns the number of boards fabricated and assembled and every product that counts radios. Where both touch the same file (`docs/plan/cost-estimate.md`, `docs/plan/tpm.json` TPM-014, `docs/plan/schedule.md`, `docs/conops/conops.md` OPS-012, `docs/design/concept.md`, RSK-052), CR-003 changes the enclosure lines and CR-006 changes the quantities; section 5 gives the implementation order. CR-006 does not repeat the enclosure sequence. Revision 3: the re-baseline CR-018 owns the board technology, assembly-rule and sourcing lines of A5 (REQ-SYS-137 to 140 and 178, the assembly words of NGO-007 and of the ConOps constraints row), so CR-006 keeps only the counts and the cost basis; where CR-018 and CR-006 touch the same cell, CR-006 owns the quantity and cost words and CR-018 the rest.

## 1. Description of the change

### 1.0 The reading this CR implements

1. **First build (revision 3).** JLCPCB fabricates five bare boards of each of the two A5 board designs, a main board and an RF board, each within 100 x 100 mm (TS-012 section 8.10, REQ-SYS-139 row; five pieces per design is the JLCPCB standard order, TS-012 section 8.11 item 5). The owner assembles one complete unit, `CWHT-A-001`, from one board of each design (SI-040, SI-041), in the enclosure that CR-003 accepts for it. The four remaining boards of each design are kept bare; one spare board serves as the FR4 end wall that faces the heat sink (CR-003 revision 4; TS-012 design item D-2). Revision 2's PCBWay order (five fabricated, one assembled by PCBWay) is superseded by the owner inputs of 2026-09-27 (SI-040 to SI-042) and the A5 choice.
2. **Further units.** Whether any further unit is built is an owner decision taken after the first unit has been evaluated. This CR proposes the decision point (section 12 Q4) and the options (section 3.2), and it decides nothing about further units.
3. **Unchanged.** The cap of at most five complete units across every revision, none marketed (REQ-SYS-125, 47 CFR 15.23(a)), stays. The intent to hand radios to friends (SI-019) stays: a friend can operate `CWHT-A-001` as their own station (OPS-006, operator model OPS-A), and further units remain possible within the cap. The acceptance test procedure of `docs/process/04-verification-and-validation.md` §11.1 stays a CDR product. Line 83 of 04 already admits a friend's radio as the second station of OnAir runs, so 04 does not change.
4. **What changes.** ADR-025 and SI-035 set five boards fabricated and three assembled, and SRR decision 86 kept three as the planning value with up to five decided at CDR. SRR decision 90 amortizes a USD 610 unit budget over three units. After this CR the first build is one unit assembled by the owner, the cost ceiling is the owner's USD 300 maximum for that first unit with USD 200 as the target (SI-042; revision 3), and every product that divides by three units, or needs a second cwht unit, is restated.
5. **First build, defined (revision 3).** The first build is the first JLCPCB order at the CDR procurement release (`HW-MB-revA-1`) and the one unit the owner assembles from it and puts into an enclosure. The bare boards of the same order are not complete units.

### 1.1 L0 expectations (Table 4-1 row 5; Class I statements)

| Id and field | Before | After |
|---|---|---|
| CON-024 title | Build quantity: five boards, three to five assembled, at most five units | Build quantity: five bare boards of each design, one unit assembled first, at most five units (revision 3) |
| CON-024 statement | Five bare boards are fabricated, three to five are assembled, and at most five complete units are built. | Five bare boards of each board design are fabricated, the owner assembles one unit in the first build, further units are assembled only by owner decision after the first unit's evaluation, and at most five complete units are built. (revision 3) |
| NGO-009 statement | Two cwht units, each with the range reference antenna at 1.5 m above open, flat, unobstructed ground, complete a two-way CW exchange at 5.0 km at the 5 W step; with the pocket reference antenna and counterpoise they complete a two-way exchange at 2.0 km at the 2 W step. | A cwht unit and a second station of the same carrier power and antenna, each with the range reference antenna at 1.5 m above open, flat, unobstructed ground, complete a two-way CW exchange at 5.0 km at the 5 W step; with the pocket reference antenna and counterpoise they complete a two-way exchange at 2.0 km at the 2 W step. |
| NGO-010 statement | With one station at least 100 m above the intervening terrain and a line-of-sight path, two cwht units complete a two-way CW exchange at 30 km at the 5 W step and repeat it at the 0.5 W step. | With one station at least 100 m above the intervening terrain and a line-of-sight path, a cwht unit and a second station of the same carrier power and antenna complete a two-way CW exchange at 30 km at the 5 W step and repeat it at the 0.5 W step. |
| NGO-027 statement | PCBWay fabricates five boards and assembles all surface-mount parts on three to five of them from parts stocked at DigiKey, Mouser or PCBWay's turnkey distributors; the owner hand-solders the through-hole parts and modules with exposed pads; at most five complete units are built; no part is consignment-only or hidden-pad for the owner. | JLCPCB fabricates five bare boards of each board design, and the owner assembles one unit in the first build by hand at the home bench from parts with a published catalog price and stock; further units are assembled only by owner decision after the first unit's evaluation; at most five complete units are built; no part is a ball-grid array or needs reflow soldering. (revision 3) |
| NGO-027 title (revision 3) | Kit assembly from stocked catalog parts in a five-board run | Owner hand assembly of JLCPCB bare boards from catalog parts |
| NGO-028 statement | The delivered cost per complete unit, including amortized fabrication, assembly setup, enclosure, parts, shipping and contingency and excluding instruments and labor, stays within the owner-approved budget of USD 610 (TBR) per complete unit amortized over three units (SRR decision 90) at every gate, against the SRR unit-budget estimate of USD 828 to 1644 for three units. | The delivered cost of the first complete unit, including boards, parts, enclosure, shipping, duty, tariff pass-through and 15 percent contingency and excluding sales tax, owned stock and filament, instruments and labor, targets USD 200 and stays at or below USD 300 at every gate. (revision 3) |
| NGO-028 title (revision 3) | Unit cost within the labor-free cost model | First-unit cost within the owner's USD 300 maximum |
| MOE-001 success_criterion | Two units at 1.5 m above open, flat ground each complete a two-way exchange (both call signs, a signal report and a 20-character text copied with at most one character error) at 5.0 km at the 5 W step with the range reference antenna, and at 2.0 km at the 2 W step with the pocket reference antenna and its 48 cm counterpoise; positions, power step, antenna and copy quality are logged. Target values per NGO-009; MOPs MOP-004 (carrier power), MOP-006 (receiver MDS) and MOP-008 (frequency accuracy) in docs/plan/tpm.json. | The unit and a second 2 m CW station, each at 1.5 m above open, flat ground, complete a two-way exchange (both call signs, a signal report and a 20-character text copied with at most one character error at each end) at 5.0 km with the unit at its 5 W step and the range reference antenna, and at 2.0 km with the unit at its 2 W step and the pocket reference antenna and its 48 cm counterpoise. The second station is a second cwht unit when one exists; otherwise it is a licensed friend's 2 m CW transceiver matched to the unit for each run: (a) its carrier power, measured on the owner's bench by the MOP-004 method, is within 1 dB of the unit's measured power at the same step (a pad of measured loss in its feed line, rated at least the rig's set power, may be used to reach the step; the pad adds its loss to the second station's receive path, so that station's copy is recorded, not scored); (b) it uses a second specimen of the same reference antenna, with the 48 cm counterpoise in the 2.0 km case; (c) on site before the run, the two stations, each on the same non-conductive stand at 1.5 m and keyed in turn from the same spot, read within 1 dB of each other on the tinySA Ultra (zero span at the set frequency, 10 kHz resolution bandwidth, the mean of five 3 s key-downs per station) at a fixed point 20 to 50 m away; if they differ by more than 1 dB, the second station's pad is adjusted and the check repeated once, and a difference still above 1 dB is carried into the Analysis as a measured correction and recorded. With a matched second station the pass is judged at the cwht end: the unit's copy of the second station is the cwht-to-cwht link in that direction, because the path is reciprocal and the transmitted power and antenna are matched. The second station's copy of the unit completes the exchange; if only that copy fails, the run is recorded as met at the cwht end and limited by the second station's receiver. MOE-001 is met when, in each case, the unit copies the matched station within the error limit and the Analysis of the other direction shows the predicted level at the far cwht end at or above the A1A stable requirement of docs/research/antenna-and-erp.md F10 (+4 dB above the noise floor in 500 Hz), the unit's measured MDS (MOP-006) taken as the floor; the second station's copy of the unit is recorded, not scored (revision 3, R2-F2). The cwht-to-cwht link in the other direction is shown by Analysis: the same path by reciprocity, the unit's measured carrier power (MOP-004) and MDS (MOP-006), and the worst-case two-unit frequency offset (MOP-008), with the path loss from the two-ray model of docs/research/antenna-and-erp.md F11 at the GPS-logged separation and the logged antenna heights. Positions, heights, power steps, antennas, the matching readings and copy quality are logged. Target values per NGO-009; MOPs MOP-004 (carrier power), MOP-006 (receiver MDS) and MOP-008 (frequency accuracy) in docs/plan/tpm.json. |
| MOE-002 success_criterion | With one unit at least 100 m above the intervening terrain and a line-of-sight path, two units complete the two-way exchange of MOE-001 at 30 km at the 5 W step and repeat it at the 0.5 W step; the receiving operator reports no distortion or gain pumping on the strong signal. Target values per NGO-010. | With one station at least 100 m above the intervening terrain and a line-of-sight path, the unit and a second station matched to it as in MOE-001 complete the two-way exchange of MOE-001 at 30 km with both at the unit's 5 W step and repeat it with both at the unit's 0.5 W step; the unit's operator reports no distortion or gain pumping on the strong signal. The pass is judged at the cwht end and the other direction is shown by Analysis as in MOE-001, with the path loss from free-space loss over the line-of-sight path checked by the terrain Analysis of SRR decision 82 for the actual site. Target values per NGO-010. |
| MOE-007 success_criterion | The actual delivered cost per complete unit (parts, fabrication, assembly, enclosure, printed parts, shipping and duties, divided by the units built) is within the owner-approved budget at SAR: USD 610 (TBR) per complete unit amortized over three units, fixed by SRR decision 90 (TPM-014, REQ-SYS-147); the SRR estimate in docs/plan/cost-estimate.md is a unit budget of USD 828 to 1644 for three units (about USD 276 to 548 per unit). | The actual delivered cost of the first complete unit (boards, parts, the enclosure and printed parts bought for it, shipping, duty and tariff pass-through; excluding sales tax, owned stock and filament, instruments and labor) is at most USD 300 at SAR, against the USD 200 target (TPM-014, REQ-SYS-147); the estimate is the current docs/plan/cost-estimate.md. (revision 3) |

**Revision 3, L0 rationales and sources (exact after-texts; the before-texts are those of `expectations.json` at `908d21a`, not changed by the CR-009 branch).**

| Id and field | Before | After |
|---|---|---|
| CON-024 rationale | Owner-accepted recommendation SI-035; also the 47 CFR 15.23 five-unit boundary (CON-008). PCBWay's fabrication minimum is five pieces (docs/research/pcbway-fabrication-and-assembly.md F20). Relief by the owner within the regulatory cap. | Owner-accepted recommendation SI-035 as changed by the owner inputs of 2026-09-27 (SI-039, one unit first; SI-040, JLCPCB bare boards soldered by the owner); also the 47 CFR 15.23 five-unit boundary (CON-008). JLCPCB's standard order is five boards per design (TS-012 section 8.11 item 5), and A5 has two designs, a main board and an RF board. Relief by the owner within the regulatory cap. |
| CON-024 source_ids | SI-035, SI-019 | SI-035, SI-019, SI-039, SI-040 |
| NGO-027 rationale | SI-009, SI-028, SI-031 and SI-035 verbatim; the panelization and overage rules are docs/research/pcbway-fabrication-and-assembly.md F17 to F22 and its PCB-FAB and PCB-ASM candidates. The 4-layer stack-up is the research baseline; SRR decision 87 (owner ruling 2026-09-26) ruled a 1.0 mm board if the enclosure gives four bosses, else 1.6 mm with 35 um plating, FR-4, IPC-4761 Type VII via fill under the PA and QFN pads, and panelization decided with the enclosure at PDR (D-PCB-01, D-PCB-02, D-PCB-04, D-PCB-07); SRR decision 86 (same ruling) confirmed five boards fabricated with three assembled as the planning value, up to five decided at CDR against the quote. The PA device must satisfy SI-028, which docs/research/pa-device-candidates.md flags as the main sourcing risk (its implications 5, 6 and 9). | SI-009, SI-028, SI-031 and SI-035 as superseded by the owner inputs of 2026-09-27 (SI-039 to SI-042): the owner solders every part at the home bench, surface-mount parts included where they can be hand-soldered (no ball-grid arrays and no reflow-only parts), on JLCPCB bare boards, two designs each within 100 x 100 mm; every part has a published catalog price and stock (TS-012 sections 8.3 and 8.10). The board technology, the hand-solder list and the sourcing rule are REQ-SYS-138 to 140 as CR-018 restates them, and the supersession of SI-028 and SI-031 is recorded there. SRR decision 86 (owner ruling 2026-09-26) confirmed five boards fabricated with three assembled; CR-006 changes the first build to one unit assembled by the owner. |
| NGO-027 source_ids | SI-009, SI-028, SI-031, SI-035, SI-007 | SI-009, SI-028, SI-031, SI-035, SI-007, SI-039, SI-040, SI-041 |
| NGO-028 rationale | SRR decision 90 (owner ruling 2026-09-26) fixed the budget at USD 610 (TBR, REQ-SYS-147) per complete unit amortized over three units, excluding instruments and labor, with 20 percent contingency until the CDR quotes; SRR decision 86 (same ruling) keeps three assembled units as the planning value. docs/plan/cost-estimate.md (revised 2026-09-26) gives a unit budget of USD 828 to 1644 for three units (about USD 276 to 548 per unit) and a total envelope of USD 972 to 1836 with the instrument line outside the unit budget; TPM-014 tracks cost per unit against the approved budget with the margin policy of docs/plan/tpm.json. PCBWay component pricing includes shipping, customs and attrition and may run 1.5 to 2 times distributor list (docs/research/pcbway-fabrication-and-assembly.md RISK-candidate R-PCB-05). | Owner inputs of 2026-09-27 (SI-040, SI-042): the first radio targets USD 200 and USD 300 is the absolute maximum; sales tax and the owned filament are excluded; test equipment sits outside the radio under its own USD 300 cap (SI-043). They supersede the USD 610 per unit of SRR decision 90 and its three-unit basis (SRR decision 86). The verified quantity is the worst case with 15 percent contingency on every line (TS-012 section 8.4, ordering gate); the A5 roll-up is USD 248.83 planning and 316.51 worst before the guards, 299.83 after guards G1 and G2 (TS-012 revision 7 section 10 condition 1). TPM-014 tracks it against the USD 300 maximum. |
| NGO-028 source_ids | SI-009, SI-035, SI-011 | SI-009, SI-035, SI-011, SI-040, SI-042, SI-043 |
| MOE-007 rationale | SRR decision 90 (owner ruling 2026-09-26): the owner approves the budget, not the estimate. The tailored cost model (charter section 12) replaces software cost estimation; it is labor-free and excludes the tinySA Ultra. Judged at CDR (quotes) and SAR (actuals). | Owner inputs of 2026-09-27 (SI-040, SI-042) set the target and the maximum of the first radio; the owner approves the maximum, not the estimate. The tailored cost model (charter section 12) replaces software cost estimation; it is labor-free and excludes the instruments, which have their own USD 300 cap (SI-043). Judged at the CDR ordering gate (listed prices, TS-012 section 8.4) and at SAR (actuals). |
| MOE-007 source_ids | SI-009, SI-035, SI-011 | SI-009, SI-035, SI-011, SI-040, SI-042, SI-043 |

These rows replace, for CON-024, NGO-027, NGO-028 and MOE-007, the one-sentence rationale addition of the Class II paragraph below; for NGO-009, NGO-010, MOE-001 and MOE-002 that paragraph stands.

Class II edits in the same file: the rationale of CON-024, NGO-009, NGO-010, NGO-027, NGO-028, MOE-001, MOE-002 and MOE-007 gains one sentence citing CR-006 and the new stakeholder input of section 1.5, and their `source_ids` gain that SI. The NGO-009 and NGO-010 rationales also gain: "A second cwht unit is the second station when one exists; the same carrier power and antenna make the link the cwht-to-cwht link (MOE-001)." The MOE-001 and MOE-002 statements (the owner's expectation, "The owner and a friend, each holding a cwht unit ...") do not change: they state the use the owner expects, which a second unit or a lent unit gives, and the success criteria above state how one unit validates it. The statements of NGO-001, NGO-002 and NGO-007 and the other MOEs do not change. NGO-002 ("Two radios in the hands of two friends ...") is the goal; with one unit it is met through the matched second station, with the direction into the unit demonstrated at the cwht end and the direction out of the unit shown by Analysis on the same reciprocal path (MOE-001 after-text; the residual is put to the owner in section 12 Q5). One unit and a friend's station do not demonstrate a cwht-to-cwht exchange in both directions; only a second unit does. MOE-005, MOE-008, MOE-011 and MOE-013 name "a unit" or "the owner and a friend", which one unit meets when its users take turns; MOE-003 already makes subsequent units conditional ("each subsequent unit").

### 1.2 L1 system requirements (Table 4-1 row 7)

**REQ-SYS-147** (Class I: `description`).

| Field | Before | After |
|---|---|---|
| description | The transceiver shall cost at most USD 610 (TBR) per complete unit, amortized over three units, excluding instruments and labor. | The transceiver shall cost at most USD 300 for its first complete unit, excluding sales tax, owned stock, instruments and labor. (revision 3) |
| rationale | Why: NGO-028, MOE-007 and MOP-016; the SRR envelope is USD 323 to 610 per unit for three units (docs/plan/cost-estimate.md). SRR decision 90 (owner ruling 2026-09-26) fixes the budget at USD 610 per unit (TPM-014), with the instrument line outside it; SRR decision 86 (same ruling) keeps three assembled units as the planning value. Ops: OPS-012. TBR: the CDR quotes confirm the value. | Why: NGO-028, MOE-007 and MOP-016. Owner inputs of 2026-09-27 (SI-040, SI-042): the first radio targets USD 200 and costs at most USD 300, the absolute maximum, counting boards, parts, shipping, duty and tariff pass-through with 15 percent contingency on every line; sales tax and the owned filament and stock are excluded, and instruments have their own USD 300 cap (SI-043). This supersedes the USD 610 per unit of SRR decision 90 and the three-unit basis of decision 86. First build: the first JLCPCB order at the CDR procurement release (HW-MB-revA-1) and the one unit the owner assembles from it. TPM-014 tracks the USD 200 target, which is not required. Ops: OPS-012. (revision 3) |
| source_ids | NGO-028, MOE-007, OPS-012 | NGO-028, MOE-007, OPS-012, SI-039, SI-040, SI-042 (revision 3) |
| tbr | the CR-008 branch-head object: owner "Robin approves on Claude's proposal at PDR; Claude produces the closing evidence"; plan "SRR decision 90 (owner ruling 2026-09-26) set USD 610 per unit; the CDR quotes confirm it."; close_by PDR | null (revision 3): USD 300 is the owner's own maximum (SI-042), so no value is to be resolved; the ordering gate of TS-012 section 8.4 checks the worst case against it |
| title; verification_note (revision 3) | "Unit cost"; "Pre-build (closing): Analysis, labor-free cost model at each gate with CDR quotes. Post-build (supporting): Inspection of invoices at SAR. Closing case: TC-SYS-098." | "First-unit cost"; "Pre-build (closing): Analysis, labor-free cost model at each gate with the listed prices of the ordering gate (TS-012 section 8.4) and 15 percent contingency on every line. Post-build (supporting): Inspection of invoices at SAR. Closing case: TC-SYS-098." |
| verification_method, priority, parent_id, hazard_ids, tags | as baselined | unchanged |

Revision 3: word count of the new statement 21; "first complete unit" fixes the divisor at one unit without a division, so the revision 2 wording "amortized over the complete units of its first build" is withdrawn. The revision 2 note that follows is kept as history. Word count of the revision 2 statement: 25, counting "(TBR)" as one word as the revision 1 count did (WR-14 limit 25; revision 2 adds "complete" per review F6 so that the divisor cannot be read as the five boards fabricated). "The complete units of its first build" keeps the statement valid if the owner raises the first-build count at CDR (section 12 Q2); the number one lives in CON-024, not in the requirement.

**Class II edits** (`verification_note`, `rationale`, `source_ids`; 02 §10.2):

| Requirement | Field | Before (the part that changes) | After |
|---|---|---|---|
| REQ-SYS-037 | verification_note | Post-build (closing): Bench, a second unit at 5 W through a NanoVNA-characterized 10 dB attenuator into the antenna port for 60 s at 80 percent duty (5 s key-downs), ... | Post-build (closing): Bench, a 2 m source of 5 W or more (a second cwht unit if one exists, otherwise a borrowed or owner 2 m transceiver sending an unmodulated carrier at its lowest power setting of 5 W or more, never set above the pad's power rating), its power measured first, through a NanoVNA-characterized pad of 9 dB or more rated 10 W or more and at least the source's set power, the attenuation chosen from the measured power so that +27 to +28 dBm reaches the antenna port, for 60 s at 80 percent duty (5 s key-downs), ... (remainder unchanged) |
| REQ-SYS-029 | verification_note | Post-build (supporting): Bench, tinySA Ultra generator as the wanted signal and an unkeyed second unit through a combiner and attenuators as the interferer, ... | Post-build (supporting): Bench, tinySA Ultra generator as the wanted signal and a steady carrier from a second 2 m transmitter (a second cwht unit if one exists, otherwise a borrowed 2 m transceiver at its lowest power) through a combiner and attenuators as the interferer, the interferer's phase noise at 2 kHz offset recorded (published figure or measurement); if it is not recorded, or is worse than -117 dBc/Hz (the level at which the source's noise in 500 Hz at the -60 dBm interferer level is -150 dBm, 10 dB below the -140 dBm MDS), the result is reported as a bound limited by the source, ... (remainder unchanged) |
| REQ-SYS-030 | verification_note | Post-build (supporting): Demonstration, owner listening for pumping with a keyed second unit through a combiner and attenuators. | Post-build (supporting): Demonstration, owner listening for pumping with a keyed second 2 m CW transmitter (a second cwht unit if one exists, otherwise a borrowed 2 m CW transceiver) through a combiner and attenuators. |
| REQ-SYS-125 | rationale, source_ids | "... SRR decision 86 (same ruling) confirms five boards fabricated and three to five assembled. Ops: OPS-012." | "... SRR decision 86 (same ruling) confirmed five boards fabricated and three to five assembled; CR-006 (SI-039, SI-040, ADR-NNN of section 1.5) changes the first build to five bare boards of each design fabricated and one unit assembled by the owner, with further units by owner decision within this cap. Ops: OPS-012." `source_ids` gain SI-039, SI-040 and ADR-NNN; ADR-025 stays because the cap originated there. The statement, method and closing case TC-SYS-087 are unchanged (revision 3). |

REQ-SYS-029 and REQ-SYS-030 close by Analysis (TC-SYS-019, TC-SYS-020), so their edit changes supporting evidence only. REQ-SYS-037 closes by Bench on TC-SYS-025, whose change is section 1.3.

### 1.3 Test cases citing L1 requirements (Table 4-1 row 17, under CR from SRR)

**TC-SYS-025** (Receiver survival of +27 dBm at the antenna port; Bench; REQ-SYS-037). Revision 3: unchanged; the owner's source is her Baofeng BF-F8HP at its high setting (about 8 W) with an 11 to 12 dB pad rated for its power (status note 2026-09-27 section 5; Q6 answered). Today it cannot run with one unit: its setup names "a second cwht unit (CWHT-A-002) at its 5 W step as the source" and states "If no second unit is available the case is Blocked".

| Part | Before (the part that changes) | After |
|---|---|---|
| setup, Configuration | a second cwht unit (CWHT-A-002) at its 5 W step as the source, its power measured with the diode probe first, through a 10 dB pad rated 10 W or more (NanoVNA-characterized) into the unit under test's antenna port; ... If no second unit is available the case is Blocked (04 section 8.3 item 5). | a 2 m source of 5 W or more: a second cwht unit at its 5 W step if one exists, otherwise a borrowed or owner 2 m transceiver sending an unmodulated carrier (CW, or FM with no audio) at its lowest power setting of 5 W or more, make, model and setting recorded; the source is never set above the power rating of the pad or of the dummy load; its power measured with the diode probe first; through a pad of 9 dB or more, rated 10 W or more and at least the source's set power (NanoVNA-characterized), whose attenuation is chosen from the measured power so that +27 to +28 dBm reaches the unit under test's antenna port (for example 9 to 10 dB at 5 W, 11 to 12 dB at 8 W); ... If no such source is available the case is Blocked (04 section 8.3 item 5). |
| setup, Safety | the second unit transmits only into the 10 dB pad and the unit under test's antenna port, or into the dummy load for its power check, never into an open port; ... the tinySA generator is disconnected before the second unit keys | the source transmits only into the pad and the unit under test's antenna port, or into the dummy load for its power check, with its own antenna removed, never into an open port; the source's set power is confirmed at or below the pad and dummy-load ratings before each key-down, and the pad is inspected for discoloration, without touching it, after each 60 s run; ... the tinySA generator is disconnected before the source keys |
| procedure step 2 | Measure the second unit's 5 W step power into the dummy load with the diode probe; compute the level delivered through the pad. | Measure the source's power into the dummy load with the diode probe; choose the pad (9 dB or more) and compute the level delivered through it; do not connect the source to the unit under test unless the computed level is +27 to +28 dBm. |
| procedure step 4 | Connect the second unit through the pad to the unit under test; key the second unit with its straight key for 5 s on and 1.25 s off for 60 s (80 percent duty). | Connect the source through the pad to the unit under test; key the source for 5 s on and 1.25 s off for 60 s (80 percent duty). |
| procedure step 5 | Repeat the 60 s run keyed with the second unit's paddle at 50 WPM in squeezes of at most 1.5 s separated by 0.5 s releases (below the 2 s squeeze limit of REQ-SYS-184, ...). | Repeat the 60 s run keyed in bursts of at most 1.5 s separated by 0.5 s releases: with the paddle at 50 WPM when the source is a cwht unit (below the 2 s squeeze limit of REQ-SYS-184, ...), otherwise with the source's key or PTT. |
| instruments | Second cwht unit CWHT-A-002 as a characterized 5 W source (fixture), with a 10 dB pad rated 10 W or more | A 2 m source of at least 5 W as a characterized fixture (a second cwht unit if one exists, otherwise a borrowed or owner 2 m transceiver, make and model recorded in the report), with pads of 9 dB or more, rated 10 W or more and at least the source's set power; dummy load rated at least the source's set power |
| acceptance_criteria, requirement_ids, verification_method, type | as baselined | unchanged |

**TC-SYS-098** (Unit cost from the labor-free cost model with CDR quotes; Simulation; REQ-SYS-147). Revision 3: CR-006 owns the whole setup, procedure and acceptance of this case, including the enclosure-order phrase of CR-003 revision 4 section 1.6; the title becomes "First-unit cost from the labor-free cost model with the ordering-gate prices".

| Part | Before | After |
|---|---|---|
| setup, Article and Configuration | "docs/plan/cost-estimate.md and the dated CDR quotes (PCBWay fabrication, assembly and CNC, DigiKey, owner-procured parts, shipping) in the release package. Configuration: tools/budgets/cost_model.py (planned) sums the quotes for the ordered quantity with the stated contingency and divides by three units." | "docs/plan/cost-estimate.md and the dated listed-price reads of the ordering gate (TS-012 section 8.4: the distributor, module-seller and cell-seller carts and the JLCPCB quote) in the release package. Configuration: tools/budgets/cost_model.py (planned) sums the listed prices for the ordered quantities (the bare boards of both designs, the parts, the enclosure parts bought for the unit, shipping, duty and tariff pass-through), with 15 percent contingency on every line, and reports the planning and worst-case totals of the first complete unit, excluding sales tax, owned stock and filament, instruments and labor." (revision 3) |
| procedure step 1 (revision 3) | Confirm that every quote in the model has a date and a file in the release package. | Confirm that every listed price in the model has a read date, a source page and a file in the release package. |
| procedure step 2 | Run tools/budgets/cost_model.py and save the cost per complete unit amortized over three units, excluding instruments and labor. | Run tools/budgets/cost_model.py and save the planning and worst-case totals of the first complete unit with 15 percent contingency, excluding sales tax, owned stock and filament, instruments and labor. (revision 3) |
| acceptance_criteria | Pass if the cost per complete unit amortized over three units, excluding instruments and labor, is at most USD 610 with the CDR quotes; otherwise Fail. | Pass if the worst-case total of the first complete unit with 15 percent contingency is at most USD 300 at the ordering gate; otherwise Fail. The planning total against the USD 200 target is reported, not scored. (revision 3) |

Revision 3: Q3 is moot (section 12), so the option (b) text below is withdrawn and kept as history. If the owner chooses Q3 option (b), the TC-SYS-098 setup and the MOE-007 after-text instead read: "... and the delivered enclosure; an enclosure option evaluated and not delivered is reported as a separate line and not charged to the unit".

No other case needs a second cwht unit: a search of every `docs/test_cases/**/test_cases.json` for "second unit", "CWHT-A-002" to "CWHT-A-005", "second station", "two units" and "friend" at `72e1863` returns TC-SYS-025 and TC-SYS-087 only. TC-SYS-087 (build quantity cap) keeps its criteria (at most five complete units, serials `CWHT-A-001` to `CWHT-A-005`); at CDR it reads five bare boards of each design fabricated and one unit assembled by the owner (revision 3). No OnAir case exists yet; the PDR V&V plan writes them with the matched second-station rule of MOE-001 and its equipment: a second specimen of each reference antenna, the owner's bench power measurement of the second station, and the tinySA Ultra with a fixed antenna for the on-site match (section 4, Verification row).

### 1.4 ConOps (Table 4-1 row 6; Class I because OPS scenarios change)

| Location in `docs/conops/conops.md` at `72e1863` | Before | After |
|---|---|---|
| Line 41, constraints table row CON-014, CON-015, CON-024 | ...; five boards, three to five assembled, at most five units. | ...; five bare boards of each design, one unit assembled first by the owner, further units by owner decision, at most five units. (The enclosure words of the same cell belong to CR-003 and the assembly words to CR-018; revision 3.) |
| Line 369, support table row "Spares" | Spare cells; the two spare bare boards of the five-board run; printed knobs; no spare assembled boards beyond the build quantity | Spare cells; the four spare bare boards of each design (one of them the FR4 end wall facing the heat sink, CR-003 revision 4); printed knobs; no spare assembled board (revision 3) |
| Line 427, OPS-004 Actors | the operator (licensee, own call sign); a friend with a second unit 2 to 5 km away over open ground, or on a hilltop at 30 km. | the operator (licensee, own call sign); a friend with a second 2 m CW station (a second cwht unit when one exists) 2 to 5 km away over open ground, or on a hilltop at 30 km. |
| Line 455, OPS-006 step 1 | The friend, now the station licensee and control operator of that unit, operates from their own location or alongside the owner; both units on the air are two independent stations. | The friend, now the station licensee and control operator of that unit, operates from their own location or alongside the owner; the friend's unit and any other station on the air are independent stations. |
| Line 528, OPS-012 Preconditions | ...; five boards ordered, three to five assembled; ... | ...; five bare boards of each design ordered, one unit assembled by the owner; ... (CR-003 and CR-018 change other words of OPS-012; revision 3) |
| Line 849, Appendix C row "Board and build" | ...; five boards, three to five assembled, at most five units ... Quantity fixed by SI-035 and confirmed (SRR package decision 86; three assembled as the planning value, up to five decided at CDR); ... | ...; five bare boards of each design, one unit assembled first by the owner, at most five units ... Quantity set by SI-035, confirmed by SRR package decision 86 and changed by CR-006 (SI-039, SI-040): one unit in the first build, further units by owner decision after its evaluation; ... (the board-technology words of the row are CR-018's; revision 3) |
| Line 853, Appendix C row "Cost" | USD 970 to 1830 for three radios (SRR estimate); per-unit budget ... Ratified: USD 610 per unit (TBR), instruments outside the unit budget (SRR package decision 90) | First unit: USD 200 target and USD 300 maximum, sales tax and owned stock and filament excluded (SI-042; CR-006); A5 estimate USD 248.83 planning and 316.51 worst before the ordering-gate guards (TS-012 section 8.4); instruments under their own USD 300 cap (SI-043) (revision 3) |

OPS-001 to OPS-022 need no other change: line 627 ("two units in two places need two licensees") and line 334 ("Two units talking are two independent stations") state the rule for whenever two units exist.

### 1.5 Decision records and the stakeholder input log

1. **New stakeholder input** (Table 4-1 row 4, Record): one entry, the next free id (SI-039 at `72e1863` and still at `908d21a`), dated 2026-09-27, quoting the owner's input verbatim from the status note with its source. It is the origin that 02 §10.3 item 3 requires for the L0 changes above. The same entry serves CR-003's revision; whichever CR is implemented first adds it, and the other cites it. SI-035 is not edited (the log is never edited after the fact). Revision 3: the owner inputs of status note 2026-09-27 sections 6, 8, 10 and 11 are appended as SI-040 to SI-043 by whichever of CR-003, CR-006 and CR-018 is implemented first (CR-018 section 1 lists them); CR-006 cites SI-040 (construction and cost direction), SI-041 (priorities), SI-042 (USD 200 to 300, USD 300 maximum) and SI-043 (equipment cap).
2. **New ADR** (Table 4-1 row 13, Record): the next free id (ADR-028 at `72e1863`, written ADR-NNN in this file), "Build sequence: five bare boards of each design fabricated, one unit assembled by the owner first, further units by owner decision, cap of five complete units" (revision 3), decision class 2 (spends money), decision authority Robin, Form 1 with the SI-039 transcription. It carries ADR-025's cap text and 15.23 basis forward unchanged and supersedes ADR-025's assembled count. ADR-025's Status line becomes "Superseded by ADR-NNN" (the one editable line, README rule 2); `docs/decisions/adr/README.md` index row 46 gets the new status and the new row, and the SRR ruling list (line 79) gains a dated note that CR-006 supersedes the assembled count of decision 86.
3. **SRR decision memo**: not edited (Record). The CR-006 disposition block is the decision memo for this change (05 §2, CCB row); it supersedes the assembled count of SRR decision 86 and the amortization basis of SRR decision 90.

### 1.6 Plans, design concept and tailoring text

| Location at `72e1863` | Change |
|---|---|
| `docs/plan/cost-estimate.md` line 5 (basis) | Revision 3: "three radios (owner plus friends), 5 bare boards minimum order" becomes "one radio in the first build (CR-006): five bare boards of each of two JLCPCB designs, one unit hand-assembled by the owner; USD 200 target and USD 300 maximum for the first unit (SI-042), sales tax and owned stock and filament excluded; further units priced by their own listed prices". |
| same, line 10 (assembly line) | Revision 3: the line "PCBWay turnkey assembly, 3 boards incl. parts, stencil, setup, 300 to 500" is removed: no assembly service, the owner assembles (SI-040, SI-041); the bare-board line takes the JLCPCB listed price of both designs (CR-018 owns the vendor and board words). |
| same, line 11 (enclosure line) | Quantity from "3 sets" to one set; the construction, lines and prices are CR-003's. |
| same, line 12 (DigiKey and other items) | Revision 3: becomes the parts, shipping, duty and tariff lines of TS-012 sections 8.3 and 8.4 for one unit. |
| same, lines 13 to 18 (subtotals, contingency, totals) | Revision 3: recomputed by WP-PDR-46 from TS-012 section 8.4 with 15 percent contingency on every line (at TS-012 revision 7: USD 248.83 planning, 316.51 worst before the guards, 299.83 after G1 and G2), against the USD 300 maximum. |
| same, line 19 (rework spin reserve) | Revision 3: a rev B is five bare boards of each design at the JLCPCB listed price plus a second parts set, priced by WP-PDR-46; the reserve stays outside the first-unit maximum, as the baseline keeps it outside the unit budget. Only the words "within the ADR-025 cap of five complete units" become "within the cap of five complete units (REQ-SYS-125)", because ADR-025 is superseded by ADR-NNN. |
| same, line 20 (spares reserve basis) | "The two unassembled bare boards of ADR-025 are the board spares" becomes "The four unassembled bare boards of each design of the first build (CR-006; one of them the FR4 end wall of CR-003) are the board spares" (revision 3). |
| same, line 21 (life-cycle total) | Recomputed from the new total envelope and the unchanged reserve lines. |
| `docs/plan/schedule.md` section 3, new last row, and "Schedule risks and levers" | Add: "Further units: none scheduled; the owner decides after the first unit's evaluation (CR-006); a further build is a new PCBWay order with the lead times of this section (about 3 to 4 weeks)". No first-build duration changes (section 4, Schedule row). |
| `docs/plan/semp.md` line 45 (§ constraints), line 148 (Integrated logistics row) and line 422 (resources) | "three radios" and "three complete units under ADR-025" become the one-unit first build under CR-006; "build quantity five bare boards, three assembled by default" becomes "five bare boards of each design, one unit assembled by the owner first"; line 148 "spare-board policy (two unassembled boards, ADR-025)" becomes "spare-board policy (four unassembled boards of each design, CR-006)" (revision 3, R2-F4). Appendix F items F-04 and F-13 (lines 475, 484) are resolved history and are not edited. |
| `docs/plan/semp.md` line 102 (§3.4 PRR paragraph) and `docs/process/01-lifecycle-and-reviews.md` line 168 (§3.5 PRR row) | The customization stays (no PRR is held before the CDR order, which builds one unit). The sentence "cwht builds at most five complete units (SI-035, ADR-025) in one vendor batch from the single CDR release, with no qualification unit followed by a production run" no longer holds if further units follow. Replacement: "the first build is one unit (CR-006); if the owner decides to build further units after its evaluation, that decision carries the Table G-8 intent: production documentation at the then-current release, incorporation of the dispositions of every NCR raised on CWHT-A-001, the acceptance test procedure of 04 §11.1, and supplier lead times". SEMP customization table row 2 (line 435) keeps its text. This edits the rationale of a customization, not its disposition. |
| `docs/design/concept.md` line 343 (descope table) | The row "Three assembled units instead of five" is removed: at one assembled unit in the first build no fewer-units lever remains (RSK-052 fallback, section 1.7); the cost levers left are the enclosure route (CR-003) and the other rows of the table. |
| `docs/design/concept.md` lines 313 and 384 | "5 boards fabricated, 3 assembled as the planning value and up to 5 decided at CDR" becomes "5 bare boards of each design fabricated, 1 unit assembled first by the owner, further units by owner decision after its evaluation (CR-006)" (revision 3). |
| `docs/process/rmm.json` SWE-151 `implementation` (line 325) and `rmm.md` render | "three-unit prototype build" becomes "one-unit first build (CR-006)". Log commit with `Refs: CR-006` (05 §5.1 row 3: implementation-path update; disposition, `tailoring_rationale` and `residual_risk` unchanged). |
| `docs/plan/tpm.json` TPM-014 `definition` and `planned_value_text` (lines 803, 808), `tbr.plan` (line 811), MOP-016 `threshold` and note (lines 250, 254), and the decision-source list (line 20) | Revision 3: "amortized over the complete-unit count (three, the ADR-025 default ...)" and "USD 828 to 1644 for three radios" become "the delivered cost of the first complete unit against the USD 300 maximum, with USD 200 as the target (REQ-SYS-147, SI-042)", with the A5 roll-up of TS-012 section 8.4 as the current estimate; line 811 "quantity per SI-035 and ADR-025" becomes "quantity per CR-006 (ADR-NNN)"; line 20 keeps the entry "ADR-025 build quantity cap (TPM-014, MOP-016)" as the source of the cap and gains "ADR-NNN build sequence (TPM-014, MOP-016)" (R2-F4). Table 4-1 row 34 puts TPM definitions under CR only from PDR, so this edit is made with the PDR cost revision (WP-PDR-46) under `Refs: CR-006`. |

### 1.7 Risk register (Table 4-1 row 14, Log; updated by the risk owner with `Refs: CR-006`)

| Risk | Change | Score before and after |
|---|---|---|
| RSK-004 (turnkey assembly defects) | Revision 3: the condition (a PCBWay turnkey assembly) no longer exists, so the risk owner closes RSK-004 at the WP-PDR-18 pass with the note "Closed by CR-006 revision 3 and CR-018: no turnkey assembly; hand-assembly defects are RSK-034". Revision 2's S4, trigger, consequence and consequence-rationale edits are withdrawn. | L3, C4, 12 before; closed after (TS-012 related-risks row: "RSK-004 (turnkey defects, retired if selected)"). |
| RSK-034 (owner hand assembly; revision 3) | Its exposure changes from the through-hole parts of up to five units to every part of one unit, surface-mount parts on the TS-012 section 8.6 hand-solder list included (TS-012 exceptions EX-1 and EX-7, the leadless TCXO by heat gun). A new mitigation step: a defect found at bring-up is repaired on the unit, or a second unit is assembled from the spare bare boards with a second parts set bought at listed prices; the WP-PDR-38 BOM prices that set. | Score unchanged here; the WP-PDR-18 pass re-scores it with the A5 part list (the risk owner, Log). |
| RSK-052 (fabrication and assembly cost above the cost model) | Revision 3: condition "the BOM of five boards" becomes "the listed prices at the ordering gate (TS-012 section 8.4)"; consequence "fewer assembled units" is removed; fallback "Assemble three units instead of five" becomes "Apply the TS-012 section 8.4 guards G1 to G4 in order; if the worst case is still over USD 300, the owner decides between not ordering and a change that reopens TS-012 (TS-012 section 10 condition 1)". | L4, C3, score 12, unchanged: the A5 worst case is USD 0.17 inside the maximum after G1 and G2 (TS-012 revision 7), so a small price rise crosses it. |
| RSK-038 (parts out of stock at the CDR order) | None to the text. Its thresholds of "3 times the build quantity" now resolve to three unit sets instead of nine; a further build re-runs the stock check at its own order. | 12, unchanged until the PDR stock check. |
| RSK-025 (antenna port retention) | Only the spare-board words: the consequence "a second CNC order or a spare board (USD 100 to 800, 3 to 12 weeks)" becomes "a reprinted end wall and, if the board joint of the jack fails, a repair or a second unit assembled by the owner from the spare boards with a second parts set (USD 0 to about 250, 1 to 3 weeks; estimate from the TS-012 section 8.4 planning prices)", and the consequence rationale "a second CNC order or a spare board population" becomes "a reprint or a second unit assembled from the spare boards" (revision 3). The CNC words of its condition and steps belong to CR-003. A new step: before each antenna-port load run on `CWHT-A-001` (CR-003 section 5 items 3 and 4, and TC-SYS-072), the same load is applied to that enclosure with a spare bare board fitted with the SMA jack (CR006-R1 below). | 16 unchanged until the WP-PDR-18 pass; the likelihood falls only when the S1 analysis exists. |
| New candidate CR006-R1 | "The only assembled unit is damaged in bring-up, in the enclosure acceptance or in a stress case, which halts the V&V campaign until the owner repairs it or assembles a second unit from the spare bare boards with a second parts set" (revision 3). Stress cases on `CWHT-A-001` (all Bench): TC-SYS-012 (SWR 10:1 survival, REQ-SYS-013), TC-SYS-025 (+27 dBm, REQ-SYS-037), TC-SYS-033 (key-input abuse, REQ-SYS-049), TC-SYS-057 (headphone short, REQ-SYS-079), TC-SYS-062 (reverse cell, REQ-SYS-086), TC-SYS-072 (antenna-port load, REQ-SYS-105), TC-SYS-079 (drop, REQ-SYS-116), TC-SYS-080 (rain, REQ-SYS-117). TC-SYS-035 (ESD) is an Analysis on design data and does not stress the unit. Order, aligned with CR-003 revision 4 section 5 items 3 and 4 (CR-003 owns the acceptance set; revision 3, R2-F1): (1) bring-up; (2) the option C acceptance before TRR, which includes the antenna-port load (REQ-SYS-105) as supporting data; if a reprint is made to correct a failed item, the same acceptance runs on the reprinted parts before TRR; (3) TRR names the delivered enclosure; (4) every non-destructive closing case; (5) TC-SYS-072, the closing load run on the delivered enclosure, first in the stress group because the acceptance already applied the same load; (6) the electrical stress cases TC-SYS-033, 057, 062, 025 and 012, in the order the PDR V&V plan sets; (7) TC-SYS-079 and TC-SYS-080 last, because they can damage the enclosure and end with the acceptance test set. A drop or rain failure after TRR is an NCR whose disposition routes include a reprint; because CR-003 revision 4 pre-approves no alternate, that change is a CR on the ME-ENC release, after which the CR-003 acceptance set, TC-SYS-072, TC-SYS-079 and TC-SYS-080 run again on the changed enclosure. The only board's antenna jack therefore takes the 10 N at 0.40 m load twice with no failure (option C acceptance and TC-SYS-072), once more for each reprint before TRR, and twice more after a post-TRR enclosure change, so four times after one such change; each acceptance load is preceded by the spare-board dry run (revision 3, R2-F1). Mitigation: (a) before each acceptance load run on `CWHT-A-001`, the owner applies the same load to that enclosure with one of the four spare bare boards fitted with the SMA jack (a dry run that risks no assembled part; the jack is a part the owner can solder, SI-031, or is taken from the leftover parts of Q8); (b) the ordering above in the PDR V&V plan and the TRR test configuration record; (c) the WP-PDR-38 BOM prices a second parts set at listed prices (revision 3). Fallback: the owner repairs the unit or assembles a second one from the spare boards. | Proposed L2 (each case tests a requirement the design analyses close before build), C3 (schedule 3: a parts order of about 1 week and the owner's assembly; cost 3: a second parts set, up to about USD 250, estimate from TS-012 section 8.4; revision 3), score 6, Green. |
| New candidate CR006-R2 | "No 2 m CW second station is available for the OnAir validation of MOE-001 and MOE-002." Entered after the owner answers section 12 Q5; if a friend's 2 m CW transceiver is available the candidate is closed as not a risk. | Not scored until Q5 is answered; the performance margin dimension would be 4 (an MOE not validated at SAR). A friend's station counts only if it can be matched as MOE-001 requires (power within 1 dB at 5 W, 2 W and 0.5 W, directly or through a pad of measured loss). |

RSK-065 and the other risks naming SI-019 or the build quantity (RSK-002, RSK-034) need no change: RSK-002 already covers "a cwht and another station"; RSK-034's exposure to hand assembly falls from up to five units to one in the first build, with no re-score proposed because its likelihood band is per activity; RSK-065 concerns lending, which one unit still allows. RSK-008 (condition "a second fabrication and assembly run costs on the order of USD 300 to 800") and RSK-014 (consequence "a second spin (USD 300 to 800, 6 to 12 weeks)") are kept unchanged as conservative: the range was priced on a three-board assembly, and a one-board rev B (about USD 200 to 440 before contingency, section 1.6 line 19 row) lies inside it; the PDR quotes re-price both with the cost-estimate reserve line.

## 2. Reason

Owner input 5 of 2026-09-27 (status note section 2, verbatim; section 3 row 5, lead SE reading): one circuit board first, one item at a time, the cheapest route first. The functional baseline states three assembled units in CON-024, NGO-027, NGO-028, MOE-007 and REQ-SYS-147. It also states two cwht units in the success criteria of MOE-001 and MOE-002 and in the closing Bench setup of TC-SYS-025. Left as baselined, those items would require an order the owner has declined (TC-SYS-098 would divide by three units that do not exist) or would leave a closing case Blocked at SAR (TC-SYS-025, "If no second unit is available the case is Blocked"). The origin for 02 §10.3 item 3 is the new SI entry of section 1.5.

Not making the change: the CDR order would contradict the baseline and be a departure without a record, or the baseline would force three assembled boards against the owner's direction. Either way, REQ-SYS-037 and MOE-001 and MOE-002 could not close with the hardware the owner will build.

Revision 3: the owner inputs of 2026-09-27 (status note sections 6, 8, 10 and 11; SI-040 to SI-043) replace the PCBWay turnkey order by JLCPCB bare boards the owner assembles, and the USD 610 per-unit budget by a USD 200 target and USD 300 maximum for the first radio; the owner chose A5 on 2026-09-29 (TS-012 section 10), which has two board designs. Left as revision 2 wrote them, NGO-027, NGO-028, MOE-007, REQ-SYS-147 and TC-SYS-098 would state an order and a budget the owner has replaced.

## 3. Alternatives considered

### 3.1 First-build quantity (revision 3: the JLCPCB order; the PCBWay options A to E of revision 2 are superseded by SI-040 to SI-042 and kept as history)

| Option | Description | Assessment |
|---|---|---|
| A (proposed; the owner's direction) | 5 bare boards fabricated (PCBWay minimum), 1 assembled, 4 kept bare | Lowest first-build spend (section 4, Cost row). The four bare boards serve as fit-check blanks for the printed enclosure and the CNC fallback (same outline and holes), and as substrates for owner hand-built partial boards (for example the output filter populated by hand for NanoVNA characterization, within SI-031's simple-pad limit). They can also serve a later PCBWay assembly if PCBWay accepts boards from an earlier lot; that acceptance is unknown (research F10 says PCBWay assembles only boards it fabricated, and the lot boards are PCBWay-fabricated) and is a vendor question for the PDR quote. Weakness: one defect or one damaged unit stops the campaign until another assembly (CR006-R1). |
| B | 5 fabricated, 2 assembled (one bench spare) | Removes most of CR006-R1 and gives TC-SYS-025 a cwht source. It costs one more board's parts and placement, about USD 80 to 180 (section 4) and contradicts "we're going to build one circuit board". Kept open as a CDR choice once the PDR quote shows the price step (section 12 Q2); not proposed. |
| C | 5 fabricated, 3 assembled (ADR-025 today) | Declined by the owner input. |
| D | 5 fabricated, 0 assembled by PCBWay; the owner or a local house assembles | Rejected: the owner does not solder hidden-pad or QFN parts (SI-031, ADR-007, REQ-SYS-137). |
| E | 10 fabricated for a lower unit price | Rejected: no use for the extra boards, and research R-REG-01 warns against building spares toward the 15.23 cap. |
| G (proposed in revision 3) | JLCPCB: 5 bare boards of each of the two A5 designs; the owner assembles 1 unit; 4 of each kept bare, one of them the FR4 end wall | The owner's direction (SI-039, SI-040) at the lowest spend: five per design is the standard order (TS-012 section 8.11 item 5). The spare boards serve as fit-check blanks, the FR4 end wall (CR-003 revision 4), dry-run carriers for the jack (CR006-R1) and substrates for a second unit if one is needed. Weakness: one damaged unit stops the campaign until a repair or a second parts set (CR006-R1). |
| H (revision 3) | As G, with two units assembled at once | Removes most of CR006-R1, but it doubles the parts spend beyond the owner's USD 300 maximum for the first unit and contradicts "one item at a time". Not proposed. |

### 3.2 Further units (the owner decides after the first unit's evaluation; nothing is decided here)

| Option | Description | Notes |
|---|---|---|
| F1 | A new JLCPCB order of five bare boards of each design at the then-current revision, assembled by the owner (revision 3; revision 2: a PCBWay turnkey order) | Priced by its own listed prices. The five-unit cap counts `CWHT-A-001` (REQ-SYS-125). |
| F2 | The owner assembles 1 to 4 further units from the kept bare boards with new parts sets (revision 3; revision 2: PCBWay assembles kept boards) | Valid only while the board revision is unchanged; one kept board of one design is the FR4 end wall of `CWHT-A-001`. |
| F3 | No further unit | The owner lends `CWHT-A-001` to a friend as that friend's station (OPS-006, OPS-A). |

Recommendation: decide at SAR of `CWHT-A-001` (section 12 Q4), when the full verification and validation record shows whether the design needs a revision. Record the decision by a new ADR (class 2, spends money). If the design changes, a CDR delta review is held (05 §8.4 maintenance rule for a hardware fix) before the order. That decision carries the PRR intent of section 1.6.

### 3.3 Alternatives for the evidence that needed a second unit

| Item | Alternative | Why not proposed |
|---|---|---|
| MOE-001, MOE-002 | Keep "two units" and defer the validation until a second unit exists | SAR could not validate two MOEs with the hardware the owner builds. The proposed wording reproduces the cwht-to-cwht link in one direction with a second station matched in power and antenna, judged at the cwht end, shows the other direction by Analysis on the same reciprocal path, and lets a second cwht unit replace the matched station whenever one exists. If no friend has a 2 m CW station (Q5), this alternative becomes the fallback: the MOEs stay open at SAR as a lien, and the lien becomes an input to the further-build decision. |
| TC-SYS-025 | Leave the case Blocked until a second unit exists | REQ-SYS-037 (a safety-adjacent receiver protection requirement, SRR decisions 57 and 61) would have no closing evidence at SAR. Any 2 m transmitter of at least 5 W reproduces the stress; the cwht keying pattern matters only for the transient burst step, which the proposed step 5 keeps when a cwht source exists. |
| MOE-001, MOE-002 | Accept any friend's 2 m CW station unmatched and close the cwht-to-cwht case by Analysis alone | Rejected (review F1): a 25 to 100 W rig with a better receiver than the unit's -140 dBm MDS completes the exchange with the unit far above its limits in both directions, so the run shows nothing about the cwht-to-cwht link. |
| REQ-SYS-147 | Keep "amortized over three units" as a planning basis | Not verifiable: TC-SYS-098 and MOE-007 divide actual cost by units built. |
| REQ-SYS-147 | State a first-build spend ceiling instead of a per-unit ceiling | Loses the per-radio meaning of MOE-007 ("what a serious hobby radio should cost"). Offered to the owner in Q3. |

## 4. Impact assessment (CM plan §5.3)

| Field | Assessment (numbers, IDs, paths) |
|---|---|
| Performance margins | Revision 3 (the revision 2 text of this cell is superseded and stays in the history of this file). TPM-014 and MOP-016 only. Before: the USD 610 per-unit budget amortized over three units (SRR decision 90). After: the first unit at most USD 300 with USD 200 as the target (SI-042). Current estimate, TS-012 revision 7 section 8.4 for A5: USD 248.83 planning (USD 48.83 over the target) and USD 316.51 worst before the guards, USD 299.83 after guards G1 and G2 (margin USD 0.17, 0.06 % of the maximum); G3 and G4 are ready. TPM-014 thresholds are re-based on the USD 300 maximum by WP-PDR-46 (the Yellow and Red bands of `tpm.json` apply to the maximum). No technical TPM changes: power, thermal, link, spurious, mass and volume budgets are per unit and do not depend on the count. TPM-006 and MOP-008 keep the worst-case two-station frequency offset (RSK-002), which the MOE-001 Analysis uses. |
| Safety | No hazard changes. HZ-015 (bench fire during owner hand assembly): exposure falls from three to five hand assemblies to one in the first build; noted for the PDR hazard analysis re-issue, no re-issue now. The stress cases of CR006-R1 run on the only unit, and the V&V plan's ordering rule (Risk row) controls schedule loss, not a hazard. The TC-SYS-025 source keeps the baselined safety line (never into an open port; bystanders 0.6 m or more), with the source's own antenna removed; revision 2 bounds the source at the pad and dummy-load ratings (a 50 W setting into a 10 W pad would be a bench burn and fire exposure) and adds a discoloration check of the pad after each run. The on-site match of MOE-001 keys each station at 20 to 50 m from the tinySA Ultra, far outside the exposure distances of `docs/research/antenna-and-erp.md` (under 1 m at 5 W). No component of the 07 §14.1 safety-critical or mission-critical tables changes. RF exposure evaluation (row 48, not yet written): no change; the bystander-between-two-operators case of `docs/research/rf-exposure-evaluation.md` applies to any second station. Hazard analysis re-issue: no. Revision 3: HZ-015 (bench fire during owner hand assembly) now covers every part of the one unit, surface-mount parts and the heat-gun soldering of the leadless TCXO included (TS-012 exception EX-7); the heat-gun cause and its control are CR-018's hazard link and the WP-PDR-16b text. The exposure stays one unit in the first build. |
| Risk | Revision 3: RSK-004 closed at the WP-PDR-18 pass (no turnkey); RSK-034 re-scoped to the owner's hand assembly of every part (score at the pass); RSK-052 condition, consequence and fallback text, score 12 unchanged; RSK-038 thresholds resolve to three unit sets, score 12 unchanged; RSK-025 consequence text, score 16 unchanged; candidates CR006-R1 (proposed L2 x C3 = 6, Green, with the revision 3 costs) and CR006-R2 (scored after Q5). Details in section 1.7. |
| Software classification and tailoring | Classification unchanged. `rmm.json` SWE-151 implementation text only ("three-unit prototype build" to "one-unit first build"), a log commit under 05 §5.1 row 3. The PRR customization (SEMP §3.4 line 102, 01 §3.5 line 168, SEMP customization row 2) keeps its disposition; its rationale is restated (section 1.6). No compliance-matrix row changes: `docs/process/se-compliance-matrix.json` has no row citing SI-035, ADR-025 or the PRR. |
| Interfaces | None: no ICD changes; no external interface (key jack, headphone jack, antenna connector, USB, battery) changes. |
| Operations and ConOps | OPS-004 (Actors), OPS-006 (step 1) and OPS-012 (Preconditions) change (section 1.4), which makes this CR Class I. ConOps table rows at lines 41, 369, 849 and 853 change. The operations handbook (row 47, `docs/ops/`) does not exist yet; none of its planned content depends on the count. |
| Cybersecurity | None: neither the USB firmware-load path nor the key-input command path changes (07 §16). |
| Verification | Modified: TC-SYS-025 (Bench; setup, safety line, steps 2, 4 and 5, instruments; acceptance unchanged) and TC-SYS-098 (Simulation; setup, step 2, acceptance). Invalidated: none (all are Draft; no run exists). Added: none. Supporting evidence of REQ-SYS-029 (with the interferer phase-noise rule) and REQ-SYS-030 takes a second 2 m transmitter in place of a second unit. PDR V&V plan (row 16, CR from PDR, not yet written) is written on this basis: single test article `CWHT-A-001`; the stress cases and their order of CR006-R1 (section 1.7), aligned with the option C acceptance and the CNC fallback of CR-003 section 5 items 3 and 4; the OnAir cases for MOE-001 and MOE-002 use the matched second-station rule of section 1.1 (bench power within 1 dB, second specimens of the reference antennas, on-site radiated match on the tinySA Ultra, pass judged at the cwht end) and an Analysis case for the cwht-to-cwht direction with the two-ray path loss of `docs/research/antenna-and-erp.md` F11 (free space and the SRR decision 82 terrain Analysis for MOE-002). 04 is not changed: line 83 already admits a friend's radio, and the extra instruments are listed per case in the V&V plan. The TRR test configuration record (row 33) names one article and the delivered enclosure. The ATP module (04 §11.1) stays a CDR product; its SWE-193 cases run on `CWHT-A-001` at stage 4. No decision table or independence-pair test changes (07 §9.6). Revision 3: TC-SYS-098 is rewritten for the first-unit maximum at the ordering gate (setup, steps 1 and 2, acceptance); TC-SYS-087 reads five bare boards of each design and one unit at CDR; MOE-001 and MOE-002 gain the pass rule, the Analysis threshold (the A1A stable requirement, +4 dB over the measured MDS in 500 Hz) and the on-site match procedure (R2-F2, R2-F3), which the PDR V&V plan writes into the OnAir cases. |
| Cost | Revision 3 (the revision 2 text of this cell is superseded). The first build is one unit from five bare boards of each of two JLCPCB designs, assembled by the owner, with no assembly service line. The first-unit lines are those of TS-012 sections 8.3 and 8.4 (A5): listed parts, the estimated passives and hardware, shipping, board duty and tariff pass-through, 15 percent contingency on every line; USD 211.20 low, 248.83 planning, 316.51 worst before the guards, 299.83 after G1 and G2, against the USD 300 maximum. Sales tax, the owned filament and stock, and the instruments (their own USD 300 cap, SI-043) are excluded. The enclosure line (the heat sink and fasteners) is CR-003's. The rework and spares reserves stay outside the first-unit maximum (section 1.6 lines 19 and 20). BOM delta: none from this CR (quantities and basis only; the A5 BOM is TS-012's and WP-PDR-38's). |
| Schedule | Revision 3. First build: the JLCPCB order at the CDR procurement release; the owner's assembly of one unit follows the parts delivery. The durations of `docs/plan/schedule.md` section 3 are re-based by WP-PDR-46 on the JLCPCB and distributor lead times (the PCBWay turnkey steps and the PCBWay closure 10-01 to 10-04 no longer apply). Further units: none scheduled; a further unit from the kept boards needs only a parts order and the owner's assembly. Disposition at S1 (OD-03; PDR work plan revision 6), after the round 3 re-check (section 6.5); the owner directed on 2026-09-29 that the PDR work start at once and run continuously (status note 2026-09-29 section 8). CR-003 and CR-018 share files (Documentation row); the implementation order is in section 5. |
| Requirements and traceability | L1 Class I: REQ-SYS-147 (`description`, with `rationale`, `tbr` plan and `source_ids`). L1 Class II: REQ-SYS-029, REQ-SYS-030, REQ-SYS-037 (`verification_note`), REQ-SYS-125 (`rationale`, `source_ids`). L0 Class I: CON-024 (title, statement), NGO-009, NGO-010, NGO-027 and NGO-028 (statements), MOE-001, MOE-002 and MOE-007 (success criteria); Class II: their rationales and `source_ids`. Parents and children: REQ-SYS-147 and REQ-SYS-125 have no parent and no children; the verification_note edits of REQ-SYS-029, 030 and 037 do not touch their L2 children. Allocation unchanged. Coverage unchanged: the closing cases stay TC-SYS-025, TC-SYS-087, TC-SYS-098, TC-SYS-019 and TC-SYS-020. Orphans or uncovered requirements created: none, confirmed by `tools/traceability.py` on the CR branch before the Implemented state. Volatility (02 §10.4, N_start 190 L1 requirements at `baseline/srr`): A = 0, M = 1 (REQ-SYS-147), R = 0, V = 1 / 190 = 0.5 %; with CR-003 revision 2 (`cc83c8c`: A 1, M 3) the cumulative value is 5 / 190 = 2.6 %, below the 10 % yellow threshold. Revision 3: REQ-SYS-147 changes description, title, rationale, verification_note, source_ids and tbr (removed); NGO-027 and NGO-028 also change title; M stays 1 for this CR (V = 0.5 %); with CR-003 revision 4 (A 1, M 5) the cumulative value is 7 / 190 = 3.7 %; the figure with CR-018 is stated in CR-018's Requirements row. |
| Regulatory | 47 CFR 15.23(a): the cap of at most five complete units, none marketed, is unchanged (REQ-SYS-125); the first build of one unit is further inside it, and four bare boards are not complete units. RSK-065 (lending) unchanged. Part 97: none (no emission, power or identification change). |
| Documentation | With this CR (branch, after disposition): `expectations.json` and `.md`; `requirements.json` and `.md` (sys); `test_cases.json` and `.md` (sys); `conops.md`; `cost-estimate.md`; `schedule.md`; `semp.md`; `01-lifecycle-and-reviews.md`; `concept.md`; new SI entry in `stakeholder-inputs.md` (Record); new ADR and ADR-025 status line, ADR README (Records); traceability report regenerated. Log commits with `Refs: CR-006`: `risk/register.json` and `.md`, `rmm.json` and `rmm.md`. At PDR on this basis: `tpm.json` TPM-014 and MOP-016 with `tpm-status.png`, the V&V plan, the integration plan (one board), the hazard analysis re-issue (HZ-015 note), the PDR quote request (A-PCB-09) with the three vendor questions of section 12 Q2 and Q8, the PDR equipment list (the second 2 m station, a second specimen of each reference antenna, the TC-SYS-025 source and pads of 9 dB or more). At CDR: release package `HW-MB-revA-1` order notes (5 fabricated, 1 assembled, leftover-parts instruction), BOM spares column. Shared with CR-003: `cost-estimate.md`, `tpm.json` TPM-014, `schedule.md`, `conops.md` (line 41 and OPS-012), `concept.md`, `semp.md`, RSK-052. No VDD exists. Revision 3: the PDR quote request and the vendor questions of Q2 and Q8 are withdrawn (moot); the JLCPCB order notes at CDR (five of each design, the leftover boards kept) replace the PCBWay order notes; `semp.md` line 148 and `tpm.json` lines 20 and 811 are added (R2-F4). |
| Released units | None: no unit is built or delivered; the serial register will issue `CWHT-A-001` only. |

Classification rationale: Class I proposed. The change affects baselined requirements (REQ-SYS-147 statement), L0 statements and success criteria, cost, verification evidence (TC-SYS-025 and TC-SYS-098 configurations) and OPS scenarios, each of which the 05 §2 Class I definition names.

## 5. Implementation plan

| Step | Artifact and path | When | Responsible | Done (SHA) |
|---|---|---|---|---|
| 1 | New SI entry (section 1.5 item 1) in `docs/requirements/l0-stakeholder/stakeholder-inputs.md`, unless CR-003's revision has added it | First implementing commit, on `main` (Record, `Refs: CR-006`) | Claude (configuration manager) | |
| 2 | New ADR-NNN, ADR-025 Status line, ADR README rows (section 1.5 item 2) | After disposition, on the CR branch | Claude (technical data manager), owner's Form 1 disposition | |
| 3 | L0: `expectations.json`, render `expectations.md` (section 1.1) | After disposition, CR branch | Claude (requirements author) | |
| 4 | L1: `requirements.json` (sys), render `requirements.md` (section 1.2) | After disposition, CR branch | Claude (requirements author) | |
| 5 | Test cases TC-SYS-025, TC-SYS-098, render `test_cases.md` (section 1.3) | After disposition, CR branch | Claude (test author) | |
| 6 | ConOps rows and scenarios (section 1.4) | After disposition, CR branch | Claude (ConOps author) | |
| 7 | `cost-estimate.md`, `schedule.md`, `semp.md`, `01-lifecycle-and-reviews.md`, `concept.md` (section 1.6) | After disposition, CR branch; the cost numbers are those of the PDR revision if the quotes are in by then | Claude (plan owners) | |
| 8 | `tools/traceability.py`, regenerated `docs/vv/traceability-report.md` and `traceability.json`; `tools/validate_docs.py` | Before the Implemented state, CR branch | Claude | |
| 9 | Risk register (section 1.7), `rmm.json` SWE-151 text and `rmm.md` | After disposition, on `main`, `Refs: CR-006` (Log) | Claude (risk owner; RMM author) | |
| 10 | TPM-014 and MOP-016 definitions and `tpm-status.png`; V&V plan, integration plan, hazard analysis note, PDR quote request and equipment list | PDR products, written on this basis | Claude (PDR product authors) | |
| 11 | CDR release package: the JLCPCB order notes (five bare boards of each design) and the BOM spares column (revision 3) | CDR | Claude (hardware release), owner orders | |

Order with CR-003 and CR-018 (revision 3). The CRs are dispositioned independently. CR-018 is implemented after CR-003 and CR-006 (CR-018 section 5), and its before-texts for shared entries are the texts after them. The CR merged second rebases its hunks in the shared files onto the first: CR-003 owns the enclosure line and words, and CR-006 owns the quantities and the amortization basis. If both are approved before the PDR cost revision, one commit per file on each branch keeps the hunks separable (charter rule: never commit another agent's hunk).

**Effectivity.** Hardware: the revision A first build, that is, the first JLCPCB order at the CDR procurement release (`HW-MB-revA-1`) and the one unit the owner assembles from it (revision 3). No later order is covered: a further build takes effect only through the owner's further-build ADR (section 3.2). Documents: the functional-baseline changes are effective at the merge of `cr/CR-006-build-sequence-one-unit-first` (effective baseline = `baseline/srr` + CR-006); the allocated-baseline products of step 10 are written on this basis and enter `baseline/pdr` with it. Units: none exist, so no rework, re-flash or recall. The five-unit cap is not affected.

## 6. Independent review of the impact assessment

Required (Class I). Round 1 performed on 2026-09-27 (section 6.1); before it this line read "Not yet performed." The author's response is section 6.2 (revision 2); the round 2 re-check was performed on 2026-09-27 (section 6.3); before it this line read "the round 2 re-check is pending." The reviewer must not have authored this CR, CR-003 or any implementing commit.

### 6.1 Round 1 (2026-09-27)

Reviewer: independent reviewer agent, a separate invocation that authored none of this CR, none of CR-003 and none of any implementing commit. Date 2026-09-27. Configuration reviewed: HEAD `9373729` on `main` (this CR at its first commit; CR-003 at revision 2, `cc83c8c`; `baseline/srr` on `779f93f`). Governing owner record: `docs/plan/status/status-2026-09-27.md` (`72e1863`) section 2 (verbatim) and section 3 row 5. Method: 05 §5.3 field by field, then class, effectivity, the section 9 plan, verifiability of every proposed statement, and fidelity to the owner's words. Search: claude-context `search_code` on `/Users/robinonsay/rust/cwht` first (queries on three assembled units, build quantity, second unit, `CWHT-A-002`, two units on the air, friend's radio, range test), then `grep` over `docs/` and `tools/` to pin lines for "three (assembled|units|radios|complete)", "3 assembled", "second unit", "two units", `CWHT-A-00[2-5]`, "three to five", SI-035, ADR-025, "spare board", "build quantity" and "bare board"; the L0, L1, test-case, risk and TPM entries were read in full from the JSON with the project Python. Before this review the section held one row reading "pending" and the line "Reviewer concurrence: pending."

Severity rule: Major if the owner would disposition on an incomplete or wrong basis; otherwise Minor.

| Item | Reviewer (agent invocation) | Date | Finding | Resolution |
|---|---|---|---|---|
| F1 (Major) MOE-001 and MOE-002 second-station rule | Independent reviewer agent | 2026-09-27 | The proposed success criteria let the second station be a friend's 2 m CW transceiver with no bound on its transmit power (only "measured on the owner's bench"), a receiver characterized only by its manufacturer's sensitivity, and "the range reference antenna or one of recorded gain" in every case, including the 2.0 km pocket-antenna case, where the baseline had both ends on the pocket reference antenna and counterpoise. A typical all-mode 2 m rig runs 25 to 100 W with a receiver better than the -140 dBm MDS of REQ-SYS-022, so a completed exchange proves neither direction of the cwht-to-cwht link: the friend-to-cwht direction can succeed with the cwht receiver far above its MDS, and the cwht-to-friend direction with the friend's better receiver. The cwht-to-cwht case then rests entirely on the Analysis "from the measured carrier power and MDS of the unit and the path loss logged on the run", and no instrument in the 04 §4 OnAir row (second station and keys) measures received power in the field, so the logged path loss has no stated method. Section 1.1 (Class II paragraph) nonetheless tells the owner that one unit and a characterized second station "demonstrate in each direction" the NGO-002 and NGO-009 capability. That claim is the basis for Q1 (L0 changes) and Q5 (the friend's rig) and it is not true of the text as proposed. The owner's inputs say nothing about the range validation; this is a consequence the CR adds, so it must be exact. | Author: bound the second station so each direction reproduces the cwht link: carrier power at the unit's step for that run (5 W, 2 W or 0.5 W) within 1 dB, measured on the bench by the MOP-004 method; the same reference antenna as the unit for each case (the pocket reference antenna with its 48 cm counterpoise in the 2.0 km case); and either a receiver sensitivity measured with the tinySA generator on the owner's bench or the receive direction judged only at the cwht end. State how the path loss for the Analysis is obtained (for example the two-ray model of `docs/research/antenna-and-erp.md` F11 from the logged positions and heights, or a tinySA reading at the receiving end), and correct the "in each direction" sentence. Put the residual (an MOE partly closed by Analysis at SAR) to the owner in Q5. |
| F2 (Minor) NGO-009 and NGO-010 left stating two cwht units | Independent reviewer agent | 2026-09-27 | NGO-009 reads "Two cwht units ... complete a two-way CW exchange at 5.0 km ..." and NGO-010 "two cwht units complete a two-way CW exchange at 30 km ...". MOE-001 and MOE-002 take their target values from them ("Target values per NGO-009", "per NGO-010"). Section 1.1 keeps both statements unchanged on the argument that they state "the capability the design must give two radios", but they state a demonstration by two cwht units, which the proposed MOE criteria no longer require. After implementation the objectives and their MOEs disagree, and neither id is in `affected_ids`. | Author: either restate NGO-009 and NGO-010 as capabilities ("A cwht unit and a station of equal power, antenna and sensitivity ...") as Class I L0 changes in section 1.1, or keep them and say plainly that they stay unmet until a second unit exists; in both cases list them in `affected_ids` and in Q1. |
| F3 (Minor) TC-SYS-025, REQ-SYS-037 and REQ-SYS-029 source definitions | Independent reviewer agent | 2026-09-27 | (a) The pad range "6 to 10 dB chosen so that +27 to +28 dBm reaches the antenna port" cannot be met with the stated "source of at least 5 W" (at least +37 dBm): +27 to +28 dBm needs 9 to 10 dB at 5 W, 11 to 12 dB at 8 W and 20 dB at 50 W, so the 6 to 8 dB end is never usable and any source above about 6.3 W (+38 dBm) is outside the range. A 6 dB pad on a 5 W source puts +31 dBm, 4 dB above REQ-SYS-037, on the only unit. (b) The source has no upper power bound while the pad is "rated 10 W or more"; a borrowed mobile rig at its default 50 W overloads a 10 W pad (a bench burn and fire exposure the Safety row does not mention). (c) The REQ-SYS-029 supporting note uses a borrowed transceiver's steady carrier as the -60 dBm interferer 2 kHz away; the phase noise of an ordinary handheld at 2 kHz offset can put more noise in the 500 Hz passband than the -130 dBm wanted signal, so the supporting result would measure the source, not the cwht. | Author: state the pad as "the attenuation, 9 dB or more, chosen from the measured source power so that +27 to +28 dBm reaches the antenna port", and require the source power setting to be at most the pad's rating (or the source's lowest setting of at least 5 W). For REQ-SYS-029, require the interferer's phase noise at 2 kHz to be recorded or the result to be reported as a bound limited by the source. |
| F4 (Minor) CR006-R1 case list and the option C acceptance of CR-003 | Independent reviewer agent | 2026-09-27 | (a) TC-SYS-035 (REQ-SYS-050, ESD) is type Simulation in `test_cases.json`; it does not stress `CWHT-A-001` and does not belong in the CR006-R1 list or in Q7. (b) CR-003 revision 2 (section 5 Effectivity item 3) runs the antenna-port load (REQ-SYS-105, TC-SYS-072) in the option C acceptance right after board arrival and before TRR, and item 4 repeats it on the CNC enclosure if the fallback is drawn. CR-006 puts TC-SYS-072 among the stress cases to be run last on the only unit. The two CRs give opposite orders for the same case, and the fallback path loads the only board's antenna jack twice (RSK-025). The drop and rain cases (TC-SYS-079, TC-SYS-080) are enclosure-dependent too and would need a re-run if the enclosure changes after them. Q7 asks the owner to accept the ordering without this interaction. | Author: remove TC-SYS-035 from the list; state which of TC-SYS-072, 079 and 080 the option C acceptance needs, in which order relative to the other stress cases, and what is re-run on the only board if the CNC fallback is drawn; align the text with CR-003 section 5 and put the result in Q7. |
| F5 (Minor) Cost basis for Q3: evaluated enclosure excluded, CNC-drawn case not stated | Independent reviewer agent | 2026-09-27 | (a) The MOE-007 after-text and TC-SYS-098 setup exclude "an enclosure option evaluated and not delivered" from the per-unit figure. The baseline counted every enclosure and printed-part cost divided by the units built, and MOE-007 says the owner "is not surprised by the invoices". The owner's inputs do not relax this; the relaxation appears only in section 1.1, section 1.3 and the Cost row, not in Q3. (b) The Performance margins row says an enclosure above USD 10 at the upper bound makes TPM-014 Yellow, but not the Red point (more than 10 % over, that is a first unit above USD 671, reached by an enclosure above about USD 71 with contingency at the upper bound) or an indicative figure for the CNC-drawn case. The baseline CNC line (USD 250 to 600 for three sets, `cost-estimate.md` line 11) gives about USD 83 to 200 a set before any one-set premium, which puts the upper bound near USD 840, about 38 % over, Red. The owner answers Q3 ("keep USD 610 per unit") without these numbers. | Author: move the exclusion of an evaluated enclosure into Q3 as a separate choice for the owner (or drop it), and add to the Performance margins row and Q3 the Red threshold and the indicative per-unit figure with the CNC fallback drawn, labelled indicative until the PDR quotes. |
| F6 (Minor) REQ-SYS-147 statement | Independent reviewer agent | 2026-09-27 | "amortized over the units of its first build" can be read as the five boards fabricated in the first build (CON-024's "first build" fabricates five), which divides the cost by five. "First build" is defined nowhere in the L1 set. | Author: "The transceiver shall cost at most USD 610 (TBR) per complete unit, amortized over the complete units of its first build, excluding instruments and labor." (25 words, WR-14 limit met), with "first build" defined in the rationale as the first PCBWay order at the CDR procurement release. |
| F7 (Minor) Items the assessment misses | Independent reviewer agent | 2026-09-27 | (a) `docs/design/concept.md` line 343, descope table row "Three assembled units instead of five" (a lever that no longer exists). (b) RSK-004 `consequence` ("requires a rework order or a spare board") and `consequence_rationale` ("a rework order or spare board is USD 100 to 300"): with one assembled board the spare is a bare board the owner cannot populate, and the CR's own one-board assembly is USD 140 to 320; the CR changes only S4 and the trigger. (c) RSK-025 `consequence` ("a second CNC order or a spare board"), which section 1.7 says needs no change. (d) RSK-008 `condition` and RSK-014 `consequence` ("a second fabrication and assembly run costs on the order of USD 300 to 800") and the `cost-estimate.md` line 19 rework reserve that cites it, priced on a three-board assembly and stating "within the ADR-025 cap" while ADR-025 is to be superseded; keeping them is conservative but the CR does not say so. (e) Front matter: `affected_paths` omits `docs/requirements/l0-stakeholder/stakeholder-inputs.md` and the new ADR file; `affected_ids` omits the new SI and ADR (and NGO-009 and NGO-010 if F2 restates them). | Author: add (a) to section 1.6; add (b) and (c) to section 1.7 with before and after text or a one-line reason for no change; state for (d) that the reserve and the two risks are kept unchanged as conservative or restate them; complete the front matter. |
| F8 (Minor) Volatility figure and the section 9 plan | Independent reviewer agent | 2026-09-27 | (a) The Requirements row computes the cumulative volatility "with CR-003 as submitted (A 3, M 2)" giving 6 / 190 = 3.2 %; CR-003 revision 2 (`cc83c8c`, committed before this CR) states A = 1, M = 3, so the cumulative value is 5 / 190 = 2.6 %. The conclusion (below 10 %) stands. (b) The section 9 "Plans and concept" search strings ("three radios", "three units", "three complete units", "3 boards", "3 sets", "three-unit") do not match the phrasing actually used at `concept.md` lines 313, 343 and 384 ("3 assembled", "Three assembled units") or "three to five assembled", so a missed edit would pass the check. | Author: correct the figure; add "3 assembled", "three assembled" and "three to five" to the section 9 search. |

Items checked with no finding:
- Class I: correct. L0 statements and success criteria, the REQ-SYS-147 statement, OPS-004, OPS-006 and OPS-012, and the closing configuration of TC-SYS-025 change (05 §2).
- Effectivity: stated for hardware (`HW-MB-revA-1` only), documents and units; no unit exists.
- Fidelity to the owner's words: "build one circuit board" and "one item at a time" are read as one board assembled out of the PCBWay minimum lot of five. That matches status note section 3 row 5. The five-board fabrication is disclosed as a vendor minimum (Q2). The enclosure sequence is left to CR-003. No flame-rating, surface-temperature or legend content is touched. The additions beyond the owner's words are consequences put to the owner as questions (Q2 to Q8), except those in F1 and F5.
- Safety: no performance or safety requirement statement is weakened, apart from the verification and cost points in F1, F3 and F5. REQ-SYS-125 and its 15.23(a) cap are unchanged. REQ-SYS-037 keeps its statement and acceptance criteria.
- Cost arithmetic re-added: USD 230 to 500 subtotal, USD 46 to 100 contingency, USD 276 to 600 total. The three-unit comparison is USD 440 to 770 x 1.2 / 3 = USD 176 to 308. The margin of 1.7 % matches the TPM-014 margin convention (11.3 % = (610 - 548) / 548). The Yellow band (0 to 10 % over) matches `tpm.json`.
- SI-039 and ADR-028 are the next free ids at `72e1863`, and CR-003 revision 2 cites the same SI-039. The REQ-SYS-147 word count is 24.
- ConOps: seven locations (lines 41, 369, 427, 455, 528, 849, 853), confirmed against `conops.md`. 04 line 83 already admits a friend's radio as the OnAir second station.
- The only test cases that need a second unit are TC-SYS-025 and TC-SYS-087, re-confirmed by search.
- `rmm.json` line 325 and `rmm.md` line 138, SEMP lines 45 and 422, 01 line 168, and ADR README lines 46 and 79 are all listed.
- The Interfaces, Cybersecurity, Regulatory and Released-units rows are correct.

Reviewer concurrence: concur with the class, the effectivity and the direction of the change. Do not concur with disposition until F1 is resolved. **Impact review complete, with findings: 1 Major (F1), 7 Minor (F2 to F8).** The CR stays Submitted. The author revises it and resolves the Minor findings in the same revision. The reviewer re-checks under a new round heading.

### 6.2 Author response (revision 2)

Added by the CR author in revision 2; the reviewer's text of section 6.1 is unchanged. Each finding is resolved in the section named. The reviewer re-checks this revision and records the result under a new heading (round 2).

| Finding | Resolution in revision 2 | Where |
|---|---|---|
| F1 (Major) | The second station is matched to the unit for each run: carrier power within 1 dB of the unit's measured power at the same step (MOP-004 method on the owner's bench; a pad of measured loss allowed to reach 2 W or 0.5 W), a second specimen of the same reference antenna (with the 48 cm counterpoise in the 2.0 km case), and an on-site radiated match within 1 dB on the tinySA Ultra at 20 to 50 m, which also covers the body effect of a different rig. The pass is judged at the cwht end: by reciprocity of the path and with matched power and antenna, the unit's copy of the second station is the cwht-to-cwht link in that direction, so the second station's receiver sensitivity is not used. The other direction is shown by Analysis from the unit's measured power, MDS and the two-unit frequency offset, with the path loss from the two-ray model of `antenna-and-erp.md` F11 at the GPS-logged separation and heights (MOE-002: free space over the line-of-sight path, checked by the SRR decision 82 terrain Analysis). The "in each direction" sentence is replaced by a statement that one unit and a friend's station do not demonstrate a cwht-to-cwht exchange in both directions. The residual (one direction closed by Analysis) is put to the owner in Q5; an unmatched station is recorded as a rejected alternative. | §1.1 MOE-001, MOE-002 and Class II paragraph; §3.3; §4 Verification; §12 Q5 |
| F2 (Minor) | NGO-009 and NGO-010 restated as Class I L0 changes ("a cwht unit and a second station of the same carrier power and antenna"), with a rationale sentence; added to `affected_ids`, the Requirements row and Q1. | §1.1; front matter; §4; §12 Q1 |
| F3 (Minor) | (a) Pad "9 dB or more", the attenuation chosen from the measured power so that +27 to +28 dBm reaches the port (9 to 10 dB at 5 W, 11 to 12 dB at 8 W), with a step-2 hold point that stops the case if the computed level is outside that range. (b) Source at its lowest setting of 5 W or more and never above the pad or dummy-load rating; pad rated 10 W or more and at least the set power; discoloration check after each run; Safety row updated. (c) REQ-SYS-029: the interferer's phase noise at 2 kHz is recorded; if not recorded or worse than -117 dBc/Hz, the result is a bound limited by the source. | §1.2; §1.3 TC-SYS-025; §4 Safety; §12 Q6 |
| F4 (Minor) | TC-SYS-035 removed from the CR006-R1 list and from Q7. The order is aligned with CR-003 revision 2 section 5 items 3 and 4: the antenna-port load runs in the option C acceptance before TRR (and again on the CNC enclosure if the fallback is drawn); TC-SYS-072 is the first case of the stress group after TRR; drop and rain run last, and because CR-003 fixes the delivered enclosure before TRR they are not re-run when the fallback is drawn. CR-006 adds a dry run of each acceptance load on a spare bare board with the jack fitted, and the RSK-025 step. The result is in Q7. | §1.7 CR006-R1 and RSK-025; §4 Verification; §12 Q7 |
| F5 (Minor) | (a) The exclusion is dropped from the proposed MOE-007 and TC-SYS-098 text, so every enclosure spend stays charged to the unit as the baseline counts it; the exclusion is offered to the owner as Q3 option (b), with its replacement text in section 1.3. (b) The Performance margins row and Q3 give the Yellow and Red points (USD 610 to 671, above USD 671; an enclosure above USD 10 or USD 71 at the upper bound) and the indicative CNC-drawn case, about USD 376 to 840, Red at the upper bound (about 38 % over). | §1.1 MOE-007; §1.3 TC-SYS-098; §4 Performance margins and Cost; §12 Q3 |
| F6 (Minor) | REQ-SYS-147 reads "amortized over the complete units of its first build" (25 words); "first build" is defined in the rationale and in section 1.0 item 5. | §1.0; §1.2 |
| F7 (Minor) | (a) `concept.md` line 343 descope row removed (section 1.6). (b) RSK-004 consequence and consequence rationale restated. (c) RSK-025 consequence and rationale restated, with a new step. (d) RSK-008, RSK-014 and the `cost-estimate.md` line 19 reserve kept as conservative, with the reason; the line 19 words "within the ADR-025 cap" become "within the cap of five complete units (REQ-SYS-125)"; line 21 recomputed. (e) Front matter: `affected_paths` gains `stakeholder-inputs.md` and the new ADR file; `affected_ids` gains NGO-009, NGO-010, SI-039, ADR-028 and RSK-025. | §1.6; §1.7; front matter |
| F8 (Minor) | (a) Cumulative volatility with CR-003 revision 2 (A 1, M 3) corrected to 5 / 190 = 2.6 %. (b) Section 9 search adds "3 assembled", "three assembled" and "three to five", case-insensitive. | §4 Requirements; §9 |

### 6.3 Round 2 (2026-09-27)

Reviewer: independent reviewer agent, a separate invocation that authored none of this CR, none of CR-003 and none of any implementing commit. Date 2026-09-27. Configuration reviewed: HEAD `39a6b13` on `main` (this CR at revision 2; CR-003 at revision 3, `d9a215a`; `baseline/srr` on `779f93f`). Governing owner record: `docs/plan/status/status-2026-09-27.md` (`72e1863`) section 2 (verbatim) and section 3 rows 1 to 9. Method: each round 1 finding checked against its section 6.2 resolution and the revised text; then 05 §5.3 field by field on the revision, class, effectivity, the section 9 plan, verifiability of every proposed statement, and fidelity to the owner's words; the arithmetic of the Performance margins, Cost and TC-SYS-025 figures re-done. Search: claude-context `search_code` on `/Users/robinonsay/rust/cwht` first (second cwht unit in tests or range exchanges; three assembled units and amortized cost; two-ray path loss), then `grep` over `docs/` and `tools/` to pin lines for "second unit", `CWHT-A-00[2-5]`, "two units", "three units", "three radios", "3 units", "three assembled", "3 assembled", "three to five", "three complete", "three-unit", "spare board", "spare bare", "two spare", ADR-025, SI-035 and ADR-028; CR-003 revision 3 section 5 items 3 and 4 and its section 6.3 read in full, and compared with CR-003 revision 2 (`cc83c8c`); `tools/validate_docs.py` run (50 of 50 pass).

Severity rule: Major if the owner would disposition on an incomplete or wrong basis; otherwise Minor.

Round 1 findings re-checked:

| Round 1 finding | Re-check result |
|---|---|
| F1 (Major) | Resolved. The second station is bounded in power (within 1 dB at the same step, bench-measured by the MOP-004 method), in antenna (a second specimen of the same reference antenna, with the counterpoise in the 2.0 km case) and by an on-site radiated match; the pass is judged at the cwht end; the path loss for the Analysis of the other direction has a stated method (two-ray, `antenna-and-erp.md` F11; free space with the SRR decision 82 terrain check for MOE-002); the "in each direction" claim is withdrawn, and the residual is in Q5. The reciprocity argument holds: with transmit power and antenna matched, the level the unit receives is the level a cwht unit at the far site would deliver to it. Residual verifiability points are R2-F2 and R2-F3 below; neither changes the owner's basis for Q1 or Q5. |
| F2 (Minor) | Resolved: NGO-009 and NGO-010 restated, in `affected_ids`, the Requirements row and Q1. |
| F3 (Minor) | Resolved. Re-computed: +37 dBm less 9 to 10 dB and +39 dBm less 11 to 12 dB both give +27 to +28 dBm; the step 2 hold point stops a mis-padded run; the source is bounded by the pad and dummy-load ratings and Q6 asks for a rig whose lowest setting of 5 W or more is at most 10 W. REQ-SYS-029: -60 dBm + (-117 dBc/Hz) + 27 dB (500 Hz) = -150 dBm, 10 dB under the -140 dBm MDS, as stated. |
| F4 (Minor) | Resolved against CR-003 revision 2 (TC-SYS-035 removed; order aligned with `cc83c8c` section 5 items 3 and 4). CR-003 revision 3 has since changed the interaction; see R2-F1. |
| F5 (Minor) | Resolved. The exclusion is now Q3 option (b) with its replacement text; re-computed: Yellow above USD 610 and Red above USD 671 (an enclosure above USD 10 and USD 71 with contingency at the upper bound; USD 334 and USD 395 at the lower bound); CNC drawn USD 250 to 600 / 3 x 1.2 = USD 100 to 240, first unit USD 376 to 840, 840 / 610 = 1.377, about 38 % over. |
| F6 (Minor) | Resolved: the statement counts 25 words with "(TBR)" as one (02 WR-14 limit: at most 25); "first build" is defined in section 1.0 item 5 and the rationale. |
| F7 (Minor) | Resolved: (a) to (e) all present in sections 1.6 and 1.7 and the front matter. Further missed items are R2-F4. |
| F8 (Minor) | Resolved. CR-003 revision 3 keeps A = 1, M = 3 (its Requirements row), so the cumulative 5 / 190 = 2.6 % still holds. |

Round 2 findings:

| Item | Reviewer (agent invocation) | Date | Finding | Resolution |
|---|---|---|---|---|
| R2-F1 (Minor) CR006-R1 order and Q7 against CR-003 revision 3 | Independent reviewer agent | 2026-09-27 | Revision 2 of this CR was committed (`39a6b13`) after CR-003 revision 3 (`d9a215a`), but it aligns with CR-003 revision 2 and its front matter records the configuration as `e8f21c9`. CR-003 revision 3 section 5 item 3 now runs drop (REQ-SYS-116) and drip (REQ-SYS-117) "on the delivered configuration after the choice ... a failure there being handled by NCR with the held package as one disposition route", and item 4 makes the held CNC package a pre-approved alternate whose ordering "needs no CR". Section 1.7 CR006-R1 of this CR says "no drop or rain case runs on an enclosure that is later replaced" and "a change of enclosure after TRR would be a CR that re-runs TC-SYS-072, 079 and 080", and Q7 says "Drop and rain are never run on an enclosure that is later replaced." Both contradict CR-003 revision 3, which the owner dispositions in the same session. On the CR-003 route a drop or drip failure after TRR puts the only board into the CNC enclosure without a CR and re-runs TC-SYS-072, 079 and 080 on it, so the antenna jack can take the load four times, not "twice, or three times if the fallback is drawn". The owner's answer to Q7 (accept the stress campaign on the only unit) is not changed by this, so the finding is Minor, but the "never" is not true of the pair of CRs as submitted. | Author: align CR006-R1 and Q7 with CR-003 revision 3 section 5 items 3 and 4: state the post-TRR NCR route to the held package, what is then re-run on `CWHT-A-001` (at least TC-SYS-072, 079 and 080, and the acceptance set of CR-003 item 3 on the CNC enclosure), the resulting jack-load count, and the CM route (pre-approved alternate, no CR) in place of "would be a CR"; update the configuration line of the front matter and the revision paragraph to the CR-003 revision cited. |
| R2-F2 (Minor) MOE-001 and MOE-002 pass rule, Analysis threshold and the feed-line pad | Independent reviewer agent | 2026-09-27 | (a) The MOE-001 after-text opens "complete a two-way exchange ... copied with at most one character error at each end" and later says "if only that copy fails, the run is recorded as met at the cwht end". It does not say whether MOE-001 is then met, so two readers can score the same run as pass and fail. (b) "The cwht-to-cwht link in the other direction is shown by Analysis" has no pass threshold: no required received level or margin (for example the A1A stable requirement of `antenna-and-erp.md` F10 and F11 for the noise environment, or the unit's measured MDS plus a stated margin) against which the predicted level is judged, so that half of the criterion is not verifiable as written. (c) The pad "of measured loss in its feed line" that lets a friend's rig reach 2 W or 0.5 W also attenuates the friend's receive path by the same loss (about 4 dB for 2 W from 5 W, 10 dB for 0.5 W), which handicaps the friend's copy of the unit and makes the "limited by the second station's receiver" outcome likely at the 0.5 W and 2 W steps; and, unlike TC-SYS-025, no power-rating rule is stated for that pad. | Author: state the MOE-001 pass rule in one sentence (for example: met when the unit copies the matched station within the error limit and the Analysis of the other direction shows the predicted level at or above the stated threshold; the second station's copy is recorded, not scored); state the Analysis threshold; note that a feed-line pad adds its loss to the second station's receive path, and require the pad to be rated at least the rig's set power. Apply the same to MOE-002 by its "as in MOE-001". |
| R2-F3 (Minor) On-site radiated match of 1 dB | Independent reviewer agent | 2026-09-27 | Item (c) of the MOE-001 after-text requires the two stations, "keyed in turn from the same spot", to read within 1 dB on the tinySA Ultra at 20 to 50 m. It states no fixture (hand-held or on a stand), no tinySA setting (span, RBW, detector) and no number of readings, and no action when the readings differ by more than 1 dB. At 20 to 50 m over ground, a change of body posture or antenna position between two hand-held stations can move the reading by more than 1 dB, so the check may not repeat and the matched condition may not be reachable on the day. The owner is told in Q5 about the bench match within 1 dB, not about this field tolerance. | Author: state the fixture (for example the same non-conductive stand at 1.5 m for both stations, or a defined hand-held posture), the tinySA setting and the reading as a mean of a stated number of key-downs; state the action on a difference above 1 dB (adjust the pad and re-check, or carry the measured difference into the Analysis); mention the field match in Q5. |
| R2-F4 (Minor) Items the assessment still misses | Independent reviewer agent | 2026-09-27 | (a) `docs/plan/semp.md` line 148 (Integrated logistics row): "spare-board policy (two unassembled boards, ADR-025)"; after this CR the spares are the four unassembled boards and ADR-025 is superseded. Neither section 1.6 nor the section 9 "Plans and concept" search ("two unassembled" and "two spare" are not in its strings) covers it. (b) `docs/plan/tpm.json` line 20, the decision-source list entry "ADR-025 build quantity cap (TPM-014, MOP-016)", and TPM-014 `tbr.plan` line 811 "quantity per SI-035 and ADR-025" cite the ADR this CR supersedes for the quantity; section 1.6 lists only lines 803, 808, 250 and 254. Neither changes a value, so the owner's basis is unaffected. | Author: add (a) to section 1.6 ("two unassembled boards, ADR-025" becomes "four unassembled boards of the first build, CR-006") and (b) to the TPM row (or state that line 811 is closed SRR history and is kept); add "two unassembled", "two spare" and "ADR-025" (outside dated history and Records) to the section 9 search. |

Items checked with no finding:
- Class I: correct (L0 statements and success criteria, the REQ-SYS-147 statement, OPS-004, OPS-006 and OPS-012, the TC-SYS-025 closing configuration).
- Effectivity: stated for hardware (`HW-MB-revA-1` only), documents and units; no unit exists.
- Fidelity to the owner's words: "build one circuit board" and "one item at a time" are implemented as one board assembled from the PCBWay minimum lot of five (status note section 3 row 5); further units stay an owner decision (Q4). The enclosure sequence, the 48 C rule, the legend, the flame rating and the coating are left to CR-003. The additions beyond the owner's words (matched second station, TC-SYS-025 source, the cost basis options) are consequences put to the owner as Q3, Q5, Q6 and Q7; the round 1 exclusion of an evaluated enclosure is now an owner choice, not a proposal. Nothing is added or dropped against the owner's inputs.
- Safety and performance: no requirement statement is weakened beyond the owner's decision. REQ-SYS-125 and its 15.23(a) cap, REQ-SYS-037 (statement and TC-SYS-025 acceptance) and the REQ-SYS-147 ceiling of USD 610 are unchanged; the one-direction Analysis of MOE-001 and MOE-002 is disclosed and put to the owner (Q5); the TC-SYS-025 source is bounded by the pad and dummy-load ratings with a pad inspection after each run.
- Cost arithmetic re-added: USD 230 to 500 subtotal, USD 46 to 100 contingency, USD 276 to 600 total; per-unit rise USD 100 to 292 against USD 176 to 308; rev B USD 200 to 440 inside the USD 300 to 800 reserve.
- ConOps: the seven locations (lines 41, 369, 427, 455, 528, 849, 853) still match `conops.md` at `39a6b13`. 04 line 83 still admits a friend's radio as the OnAir second station.
- ADR-028 is still the next free ADR (no file or README row takes it; the PDR work plan numbers its provisional ADRs from ADR-029 on) and SI-039 the next free SI; the CR writes ADR-NNN until the file is created.
- The only test cases that need a second unit are still TC-SYS-025 and TC-SYS-087; `tools/validate_docs.py` passes 50 of 50.
- Front matter `affected_paths` and `affected_ids` complete for the items of sections 1.1 to 1.7, apart from the R2-F4 lines inside files already listed.

Reviewer concurrence: concur with the class, the effectivity, the direction of the change and the resolution of F1 to F8. No Major finding remains; the owner can disposition on this basis. The four Minor findings are corrected in the next revision or as conditions of the disposition, and the independent verifier of section 9 checks them. **Impact review complete, with findings: 0 Major, 4 Minor (R2-F1 to R2-F4).**

### 6.4 Author response (revision 3)

Added by the CR author in revision 3; the reviewer's text of sections 6.1 and 6.3 is unchanged. Revision 3 has two parts: the A5 changes of TS-012 section 8.12 items (a) to (e), which change what the owner decides and so need a re-check, and the resolution of the four Minor findings of round 2. The reviewer re-checks revision 3 in a round 3 (section 6.5), before the owner's disposition at S1 (PDR work plan revision 6, WP-PDR-01, OD-03).

| Item | Resolution in revision 3 | Where |
|---|---|---|
| R2-F1 (Minor) | CR006-R1 and Q7 are aligned with CR-003 revision 4, which withdraws the held CNC package: a failed acceptance item before TRR is corrected by one reprint and the acceptance runs again; a drop or rain failure after TRR is an NCR whose reprint route is a CR on the ME-ENC release (no pre-approved alternate), after which the acceptance set and TC-SYS-072, 079 and 080 run again; the jack-load count is stated (twice, once more per reprint before TRR, four times after one post-TRR change); the front matter and the revision paragraph cite CR-003 revision 4. | §1.7 CR006-R1; §12 Q7; front matter; header |
| R2-F2 (Minor) | MOE-001 has one pass sentence (met when the unit copies the matched station within the error limit and the Analysis of the other direction shows the level at the far cwht end at or above the A1A stable requirement of `antenna-and-erp.md` F10, +4 dB over the measured MDS in 500 Hz; the second station's copy is recorded, not scored); the feed-line pad is rated at least the rig's set power and its receive-path loss is stated; MOE-002 inherits both by "as in MOE-001". | §1.1 MOE-001 |
| R2-F3 (Minor) | The on-site match states the fixture (the same non-conductive stand at 1.5 m), the tinySA Ultra setting (zero span, 10 kHz RBW), the reading (the mean of five 3 s key-downs per station) and the action on a difference above 1 dB (adjust the pad and re-check once, then carry the measured difference into the Analysis); Q5 mentions the field match. | §1.1 MOE-001; §12 Q5 |
| R2-F4 (Minor) | `semp.md` line 148, `tpm.json` line 20 and TPM-014 `tbr.plan` line 811 added with after-texts; the section 9 search gains "two unassembled", "two spare" and "ADR-025" outside dated history and Records. | §1.6; §9 |
| TS-012 §8.12 (a) | Five bare boards of each of two JLCPCB designs; the owner assembles one unit; four of each kept bare, one the FR4 end wall. | §1.0 items 1 and 5; §1.1 CON-024; §1.4; §1.6; §3.1 option G; §5 Effectivity |
| TS-012 §8.12 (b) | REQ-SYS-147 (21 words), NGO-028 and MOE-007 take the first-unit USD 300 maximum with the USD 200 target; TC-SYS-098 checks the worst case with 15 percent contingency at the ordering gate. | §1.1; §1.2; §1.3; §4 |
| TS-012 §8.12 (c) | NGO-027 restated for JLCPCB bare boards and the owner's hand assembly, with its title and rationale; the board technology and sourcing rules left to CR-018. | §1.1; header scope paragraph |
| TS-012 §8.12 (d) | Q2, Q3 and Q8 closed as moot; the Q3 option (b) text withdrawn. | §1.3; §12 |
| TS-012 §8.12 (e) | TC-SYS-025, MOE-001 and MOE-002 unchanged in content; Q6 recorded as answered (the Baofeng BF-F8HP, status note 2026-09-27 section 5). | §1.3; §12 Q6 |

## 7. CCB disposition (owner)

| Field | Value |
|---|---|
| Decision | pending |
| Class confirmed | pending (proposed Class I by Claude on 2026-09-27) |
| Date | pending |
| Conditions | pending |
| Rationale | pending |
| Waiver scope (if Approved (waiver)) | not applicable |
| Re-look trigger and re-look-by review (if Deferred) | pending |
| Source | pending |

Disposition history:

| Date | Decision | New target | Source |
|---|---|---|---|
| 2026-09-29 | Revision 3 (A5) submitted for the round 3 re-check (section 6.5), then owner disposition at S1 (OD-03) | none | Claude (CR author), from TS-012 revision 7 section 8.12 and the owner inputs of status notes 2026-09-27 and 2026-09-29 |

## 8. Implementation record

| Commit | Files | Trailer check (`CR: CR-006` present) |
|---|---|---|
| none yet | | |

Traceability report after implementation: pending; renders regenerated: pending.

## 9. Verification of implementation

| Impact item | Planned closure (from §4/§5) | Evidence the independent verifier checks | Result |
|---|---|---|---|
| L0 statements | Step 3 | The before-strings of the eight L0 items of section 1.1 (CON-024, NGO-009, NGO-010, NGO-027, NGO-028, MOE-001, MOE-002, MOE-007) are gone and the after-strings are present in `expectations.json`; `tools/validate_docs.py` exit 0; the `.md` equals the render | pending |
| REQ-SYS-147 and Class II edits | Step 4 | Section 1.2 after-strings present; REQ-SYS-147 statement reads "the complete units of its first build" and its word count is 25 or fewer; `requirements.md` equals the render | pending |
| TC-SYS-025, TC-SYS-098 | Step 5 | No setup, step or instrument of either case requires a second cwht unit; a search of `docs/test_cases/` for "CWHT-A-002" returns nothing; TC-SYS-025 names no pad below 9 dB and bounds the source at the pad and dummy-load ratings; acceptance of TC-SYS-025 unchanged; TC-SYS-098 acceptance reads "at most USD 300" and names no amortization (revision 3) | pending |
| ConOps | Step 6 | The seven locations of section 1.4 carry the after-text; a search of `conops.md` for "three to five assembled" and "two spare bare boards" returns nothing | pending |
| Plans and concept | Step 7 | A search of `cost-estimate.md`, `semp.md` (outside Appendix F), `schedule.md`, `concept.md`, `tpm.json` and `rmm.json` for "three radios", "three units", "three complete units", "3 boards", "3 sets", "three-unit", "3 assembled", "three assembled", "three to five", "two unassembled", "two spare", "PCBWay turnkey", "USD 610" and "ADR-025" (case-insensitive; "ADR-025" allowed only where it names the cap's origin) returns nothing outside dated history and Records; the `concept.md` descope row of section 1.6 is gone; the `cost-estimate.md` first-unit total with 15 percent contingency equals the WP-PDR-46 recomputation (revision 3) | pending |
| Decision records | Steps 1, 2 | The SI entry quotes the status note verbatim; ADR-025's only change is its Status line; the new ADR carries the cap text and cites SI-039 | pending |
| Traceability | Step 8 | `tools/traceability.py` zero violations; volatility record shows L1 M = 1 for this CR | pending |
| Risk register, RMM | Step 9 | RSK-004 S4, trigger, consequence and consequence rationale, RSK-025 consequence, rationale and new step, RSK-052 text as in section 1.7; RSK-008 and RSK-014 unchanged; CR006-R1 entered or its candidate row dispositioned; `tools/render_risk.py` and `tools/render_rmm.py --check` exit 0 | pending |
| PDR products | Step 10 | The PDR V&V plan names one test article, carries the CR006-R1 order consistent with CR-003 section 5, and writes the MOE-001 and MOE-002 OnAir cases with the matched second-station rule and the Analysis case; TPM-014 uses the first-build basis | pending (PDR) |
| Order quantities | Step 11 | TC-SYS-087 run at CDR reads five bare boards of each design fabricated and one unit assembled (revision 3) | pending (CDR) |

Independent verifier (agent invocation): pending.

## 10. Closure

| Field | Value |
|---|---|
| Owner merge approval | pending |
| Merge commit | pending |
| Waiver entered in CSA item 12 and affected VDDs | not applicable |
| CSA regenerated | pending |
| Date closed | pending |

## 11. History

| Date | State | By | Commit on main | Note |
|---|---|---|---|---|
| 2026-09-27 | Submitted | Claude (CR author) | this file's first commit | Raised from owner input 5 of 2026-09-27 (`docs/plan/status/status-2026-09-27.md`, `72e1863`); independent impact review requested before disposition |
| 2026-09-27 | Submitted (impact review round 1 recorded) | Independent reviewer agent | the commit that records section 6.1 | Impact review complete with 1 Major (F1) and 7 Minor (F2 to F8) findings; stays Submitted for author revision before disposition |
| 2026-09-27 | Submitted (revision 2) | Claude (CR author) | the commit that records revision 2 | Round 1 findings resolved (section 6.2): matched second station with the pass judged at the cwht end and the reciprocal direction by Analysis (F1); NGO-009 and NGO-010 restated (F2); TC-SYS-025 pad and source bounds, REQ-SYS-029 phase-noise rule (F3); stress order aligned with CR-003 section 5 (F4); enclosure spend charged, exclusion offered in Q3, TPM-014 Red point and CNC-drawn figure (F5); REQ-SYS-147 "complete units" (F6); missed items (F7); volatility and search (F8). Section 6.1 unchanged; round 2 re-check requested before disposition |
| 2026-09-27 | Submitted (impact review round 2 recorded) | Independent reviewer agent | the commit that records section 6.3 | Impact review complete with 0 Major and 4 Minor findings (R2-F1 to R2-F4); F1 to F8 resolved; no Major remains before disposition |
| 2026-09-29 | Submitted (revision 3) | Claude (CR author) | the commit that records revision 3 | A5 (TS-012 revision 7 section 10; section 8.12 items a to e): five JLCPCB bare boards of each of two designs and one unit assembled by the owner; REQ-SYS-147, NGO-028 and MOE-007 to the first-unit USD 300 maximum and USD 200 target (SI-042); NGO-027 to owner hand assembly; Q2, Q3 and Q8 moot; Q6 answered; RSK-004 closed and RSK-034 re-scoped; R2-F1 to R2-F4 resolved (section 6.4); round 3 re-check requested before disposition |

## 12. Questions for the owner (answer with the disposition)

| # | Question | Recommendation |
|---|---|---|
| Q1 | Approve CR-006 revision 3 as Class I? It builds one radio first: JLCPCB makes five bare boards of each of the two board designs, you assemble one unit, and the rest stay as spares (one becomes the end wall facing the heat sink). The first radio's cost limit becomes your own: USD 300 at most in the worst case with 15 percent contingency, USD 200 as the target, sales tax and what you already own left out. It also restates the range goals (NGO-009, NGO-010) as a cwht unit and a matched second station, and supersedes the assembled count of SRR decision 86 and the USD 610 budget of decision 90. | Approve as Class I after the round 3 re-check. |
| Q2 | (Revision 2: the PCBWay assembled count.) | Moot (revision 3): there is no PCBWay order; you assemble the unit from JLCPCB bare boards (SI-040). Closed. |
| Q3 | (Revision 2: the unit-cost options (a) to (c) under USD 610.) | Moot (revision 3): your USD 300 maximum for the first radio (SI-042) replaces the per-unit budget, and every enclosure spend stays charged to the unit. Closed. |
| Q4 | When do you decide on further units? | At SAR of `CWHT-A-001`, recorded by an ADR, with a CDR delta review first if the design changes. |
| Q5 | Does a licensed friend (for example in your ham radio club, status note 2026-09-27 section 5) have a 2 m transceiver that sends and receives CW and can be set within 1 dB of the unit's 5 W, 2 W and 0.5 W steps (directly or through a pad of measured loss) for the on-air runs of MOE-001 and MOE-002? On the day, both stations stand on the same stand and are compared on the tinySA Ultra 20 to 50 m away, within 1 dB. With it, the runs demonstrate the direction into the unit at the cwht end, and the direction out of the unit closes by Analysis on the same reciprocal path. A cwht-to-cwht exchange is demonstrated only if a second unit is built. | If yes, accept that residual and validate with the matched station plus the Analysis; the PDR equipment list adds a second specimen of each reference antenna. If no station can be matched, MOE-001 and MOE-002 stay open at SAR as a lien, and the lien becomes an input to the Q4 decision. (Still open; revision 3 adds the field match.) |
| Q6 | For TC-SYS-025, a 2 m transmitter whose lowest setting of 5 W or more is at most 10 W. | Answered (status note 2026-09-27 section 5): your Baofeng BF-F8HP at its high setting (about 8 W) into an 11 to 12 dB pad rated for its power, never over the air; the pad goes into the PDR equipment list. Closed. |
| Q7 | Accept that the survival and abuse tests (antenna-port load, key-input abuse, headphone short, reverse cell, +27 dBm, SWR 10:1, drop, rain) run on the only unit, and that a failure there pauses V&V until the unit is repaired or a second one is assembled from the spare boards with a second parts set (up to about USD 250)? The order, aligned with CR-003 revision 4: the case's acceptance before TRR includes the antenna-port load (repeated after a reprint); after TRR and every non-destructive case, the antenna-port load case first, then the electrical stress cases, then drop and rain last. If drop or rain damages the case after TRR, the case is changed by a CR and the load, drop and rain cases run again, so the jack takes the load up to four times. Before each acceptance load run, the same load is tried on a spare bare board with the jack fitted. | Accept, with the order in the PDR V&V plan, the spare-board dry run, and the second parts set priced in the PDR BOM. |
| Q8 | (Revision 2: unused PCBWay turnkey parts.) | Moot (revision 3): you buy the parts yourself, so nothing is left with a vendor. Closed. |
