robinonsay/cwht/docs/decisions/adr/ADR-008-openscad-freecad-step-pcbway-cnc.md

# ADR-008: Enclosure authored in OpenSCAD, exported to STEP through headless FreeCAD, machined by PCBWay CNC in aluminum

| Field | Value |
|---|---|
| ID | ADR-008 |
| Status | Accepted |
| Date proposed | 2026-09-25 |
| Date decided | 2026-09-25 |
| Decision class | 1 (`docs/process/06-risk-and-decision-analysis.md` section 14.1 items (a) enclosure concept; (c) HZ-003, HZ-009, HZ-013). Owner-directed (SI-008, SI-032). Trade study: none; the alloy and finish ADR is due at PDR (README "Decisions expected at PDR"). No trade study for the source format, the vendor and the machined enclosure: this ADR alone records it under SEMP customization 11 (`docs/plan/semp.md` section 9.0 and section 5.17), which customizes 06 section 14.1, item (i) (ruling R-2 of `reconciliation-srr.md` section 7, adopted by the owner as SRR decision 106 on 2026-09-26) |
| Decision authority | Robin (owner; the decision fixes the enclosure source format and spends money at CDR) |
| Author | Claude (technical data manager invocation, 2026-09-25) |
| Independent reviewer | INSP-011 (`docs/reviews/SRR/checklists/adrs-001-to-025.md`): iterations 1 and 2 (2026-09-25) NEEDS CHANGES, findings F-01, F-02 and F-03 against this file; the Major-finding corrections are applied here on 2026-09-26 (section 8); verification pending at INSP-011 iteration 3 |
| Life-cycle phase | Pre-A / A |
| Baseline affected | baseline/srr (functional baseline); product baseline at CDR carries the STEP and drawing |
| Change request | none (pre-baseline) |

## 1. Context

The owner wants an aluminum enclosure with the antenna on one end, designed in OpenSCAD and CNC-machined by PCBWay (SI-008). PCBWay accepts only B-rep formats (STEP, X_T, IGES, SLDPRT) for CNC and refuses STL and mesh-derived STEP; OpenSCAD has no STEP export in any version. The gap is closed by FreeCAD's OpenSCAD workbench, which rebuilds true B-rep solids from OpenSCAD's CSG tree and exports STEP from the command line; the owner approved installing FreeCAD via Homebrew for that purpose (SI-032). The charter's headless rule (11.8) forbids any GUI automation, so the pipeline must be scriptable end to end.

- Driving inputs and expectations: SI-008, SI-032, SI-012 (H2C prints for fit checks), SI-016 (renders inspected), SI-001 (pocket form factor)
- Requirements that constrain the decision: none yet
- Hazards in play (`docs/safety/hazards.json` 0.4.0-pha): HZ-003 (PA heat path through the machined enclosure), HZ-009 (SMA jack retained by the enclosure boss, anodize masking: REQ-SYS-105, REQ-SYS-107) and HZ-013 (machined edges and pinch points: REQ-SYS-110, REQ-SYS-111, REQ-SYS-168)
- Research consulted: `docs/research/enclosure-cnc-and-openscad-pipeline.md` A1 (STEP required; STL and STL-derived STEP refused), A2 (2D drawing required for threads, tolerances, marking), A3 (alloys 6061, 7075, 5052, 2A12), A4 (finishes; bead blast plus Type II anodize), A5 (ISO 2768-m default; class f by callout), A6 (pocket radius, wall, depth rules), A7 (threads as pilot holes, tap before anodize), A10 (price signals USD 250 to 370 class), A11 (SLA print as a second-tier fit check), B1 (no STEP in OpenSCAD; 2021.01 stable, 2026.09.23 snapshot), B2 (OpenSCAD CLI renders verified), B3 (mesh to STEP unacceptable), B4 (FreeCAD workbench: primitives, booleans, extrusions become B-rep; hull, minkowski, text, non-uniform scale degrade), B5 (FreeCAD 1.1.3 cask with `freecadcmd`), B6 (build123d and CadQuery alternative), "Recommended pipeline"; `docs/research/verification-tooling-inventory.md` F11 (OpenSCAD 2021.01 installed under Rosetta; snapshot exists); `docs/research/antenna-and-erp.md` F8 (SMA jack bulkhead-retained by an enclosure boss so the PCB carries no antenna bending moment)
- Guidance consulted: charter section 11 rule 8 (headless only); SWE-136 (tool accreditation, applied to the CAD toolchain as an engineering tool); SE HB §6.8
- Assumptions the decision rests on, and how and by when each is confirmed:
  1. The FreeCAD CSG import gives a single-solid STEP that passes the acceptance checks. Confirmed on the PDR smoke-test shell.
  2. PCBWay accepts the STEP plus drawing. Confirmed by an instant quote at PDR.
  3. The masking and anodize callouts are honoured. Confirmed by receipt inspection before TRR.

## 2. Decision

The enclosure source is OpenSCAD in a restricted dialect: primitives (cube, cylinder, sphere, polyhedron), booleans, `linear_extrude`, `rotate_extrude`, `offset` and rigid transforms only; no `hull`, `minkowski`, `text`, `resize` or non-uniform `scale` in any machined solid. The build is a script (`tools/scad2step.py`, to be written): `openscad -o part.csg part.scad` for the CSG tree and PNG renders, then `freecadcmd` imports the CSG through the OpenSCAD workbench and exports STEP AP214 (single solid per machined part), then acceptance checks run and are logged: valid STEP, exactly one solid, no BSpline faces, volume within tolerance of the OpenSCAD mesh volume. The machined parts are ordered from PCBWay CNC in aluminum 6061 with bead blast plus Type II anodize (proposed finish), with a 2D PDF drawing carrying every toleranced dimension, thread (modeled as tap-drill pilot holes, M3 minimum), roughness, marking and anodize-masking callout (chassis ground and the SMA boss contact area left conductive). The antenna SMA jack is retained by an enclosure boss. Fit checks are printed on the owner's H2C from the OpenSCAD 3MF; an SLA print of the CDR-baselined STEP is optional when a plus or minus 0.2 mm fit matters. FreeCAD is installed by `brew install --cask freecad` (SI-032).

## 3. Alternatives considered

| Option | Description | Why not chosen (or why chosen) |
|---|---|---|
| A (chosen) | OpenSCAD restricted dialect, FreeCAD headless CSG to STEP, PCBWay CNC 6061 | Owner direction (SI-008, SI-032); B-rep STEP with analytic cylinders and planes; fully scriptable |
| B | build123d or CadQuery Python source with native STEP export | Not chosen: departs from the owner's OpenSCAD direction; kept as the PDR prototype comparison (research recommendation) and as the fallback if the STEP acceptance checks fail |
| C | OpenSCAD STL converted to STEP | Rejected: PCBWay refuses mesh-derived STEP (A1, B3); one planar face per triangle |
| D | FreeCAD or another parametric CAD as the source | Rejected: the owner named OpenSCAD; GUI-centric authoring conflicts with the headless rule |
| E | 3D-printed enclosure only | Rejected by SI-008 (aluminum); the PA thermal path needs metal (HZ-003) |

No trade study: the owner named the source format and the vendor; the alloy and finish are class 2 proposals recorded here for PDR.

## 4. Consequences

### 4.1 Requirements created or changed

| Requirement | Relationship | Note |
|---|---|---|
| REQ-SYS-109 (enclosure material and finish), REQ-SYS-175 (antenna port on one end) | allocated; REQ-SYS-109 cites this ADR, REQ-SYS-175 does not |  |
| REQ-ME (design data package: single-solid STEP AP214 or AP242 per part, 2D drawing, SVG marking artwork; no mesh-derived STEP) | not created: the ME L2 file is due at PDR | Basis A1, A2, B3 |
| REQ-ME (DFM rules: internal radius at least 1.3 times cutter radius and one third of pocket depth, minimum wall 1.5 mm, depth-to-width at most 4, threads M3 minimum as 2.5 mm pilot holes) | not created at L2 (PDR); L1 counterpart REQ-SYS-110 (edge break, HZ-013 K1) | Basis A6, A7 |
| REQ-ME (anodize masking of chassis-ground and SMA boss contact areas) | not created at L2 (PDR); L1 counterpart REQ-SYS-107 (counterpoise attachment and masked contact area, HZ-009 K4) | Basis A4 and the RF ground need |
| REQ-ME (SMA jack retained by the enclosure boss; PCB carries no antenna moment) | not created at L2 (PDR); L1 counterpart REQ-SYS-105 (antenna port mechanical load path, HZ-009 K1) | `antenna-and-erp.md` F8 |
| CAD build reproducible from the command line with logged acceptance checks | not a product requirement: tooling rule of 05 section 8.2 step 3 and `tools/toolchain.lock.md` | charter 11.3 and 11.8 |

### 4.2 Interfaces, design and code

- ICDs affected: `ICD-TX-ANT` (SMA jack mechanical retention), a PCB-to-enclosure mechanical ICD at PDR (bosses, board thickness 1.0 mm pending boss layout, display window, connector openings)
- Design elements created or changed: `hardware/enclosure/*.scad`, `tools/scad2step.py`, `tools/toolchain.lock.md` entries for OpenSCAD (exact build) and FreeCAD 1.1.3
- New `SW-<SUB>` modules created by this ADR: none
- ICDs created by this ADR: none (created by the ICD process at PDR)

### 4.3 Verification and safety

- Verification cases to add or change: TC-ME-NNN (STEP acceptance checks, Inspection by tool), TC-ME-NNN (printed fit check of PCB, display, jacks, USB opening, Demonstration), TC-ME-NNN (receipt inspection of the machined parts against the drawing; CMM report on the mounting pattern optional)
- Evidence class implications: Inspection by rendered images (charter 11.3) and by the acceptance script; a tool-validation record `TV-NNN` for the CAD chain (05 section 9.2)
- Hazard analysis update required: yes (HZ-009 controls K1, K4 and K6 and HZ-013 controls K1, K3 and K4 are enclosure design controls; the HZ-003 thermal path is a design consequence handled at PDR)
- Safety-critical software scope changed: no

### 4.4 Cost, schedule, risk

- Enclosure cost: USD 250 to 370 class per small anodized aluminum order (A10, 2023 prices, Medium confidence); lead time 3 to 5 business days machining plus 13 to 15 days observed end to end
- Gate affected: PDR (smoke-test shell through the pipeline, first PCBWay instant quote), CDR (STEP and drawing baselined)
- Risks opened, closed or re-scored: RSK-006 (thermal path) stays open; new risks proposed: "FreeCAD import fidelity degrades silently if a forbidden construct enters the source" (control: acceptance checks), "tolerance statements conflict between PCBWay pages" (control: explicit callouts), "OpenSCAD toolchain age and snapshot behaviour change" (control: pin exact build)
- TPMs affected: TPM-001 (mass), TPM-014 (unit cost)

## 5. Compliance and tailoring

none (engineering tools are Class E by App. D and controlled as configuration items with SWE-136 accreditation, 03 section 1)

## 6. Decision record

> Owner (2026-09-25, SI-008): "Fits an aluminum enclosure with the antenna on one end; enclosure designed in OpenSCAD and CNC-machined by PCBWay."

> Owner (2026-09-25, SI-032): "FreeCAD installation via Homebrew approved for headless OpenSCAD-to-STEP export."

Transcribed from chat into `stakeholder-inputs.md`.

## 7. Related

- Supersedes: none
- Superseded by: none
- Trade study: none (the alloy and finish are class 2)
- Review where presented: SRR; pipeline proof (smoke-test shell STEP and its acceptance log) at PDR
- Revisit conditions: the PDR smoke-test STEP fails the acceptance checks or PCBWay's engineering review rejects it (then option B by a superseding ADR); the owner asks for a printed enclosure for a prototype unit

## 8. Change log

- 2026-09-26: one-time pre-baseline correction under INSP-011 ruling R-1 option (A), as directed by the lead SE: Decision class row and section 1 Assumptions line added (F-01); hazard line and "Hazard analysis update required" re-derived against `docs/safety/hazards.json` 0.4.0-pha (F-02); section 4.1 placeholder ids replaced by the ids the requirement authors allocated, or marked not created with the reason (F-03). Content from `reconciliation-srr.md` sections 2, 3, 5.1 and 6, re-checked against the requirement, hazard and expectation files of 2026-09-26; that register is superseded by this file for this ADR. The decision of section 2 is unchanged. Minor findings are liens, fixed before PDR: none against this file. The edit of an Accepted ADR rests on the owner's approval of R-1 (A) in the SRR decision memo and the matching sentence in `docs/process/05-configuration-and-data-management.md` Table 4-1 row 13 (both pending). Class 1 choices without a trade study wait on ruling R-2 (owner). Author: Claude (ADR author invocation).
- 2026-09-26 (after the SRR rulings): Decision class row updated under SRR decision 106 (owner ruling 2026-09-26), which adopts ruling R-2 of `reconciliation-srr.md` section 7 as SEMP customization 11 of 06 section 14.1 (`docs/plan/semp.md` section 9.0): the class 1 owner-directed choice of this ADR is recorded by this ADR alone under item (i); the implementing design choices stay class 1 and go through the trade study the row names. The correction entry above now rests on SRR decision 105 (owner ruling 2026-09-26, R-1 option (A) approved) and on the 05 Table 4-1 row 13 sentence, which is in place. The decision of section 2 is unchanged. Author: Claude (ADR author invocation, SRR post-ruling work R16).
- 2026-09-27 (PDR errata, WP-PDR-14; SRR liens L-6 and, where named, L-4 and L-7): Independent reviewer row names the INSP-011 results through the post-SRR-ruling delta 2 and points to the record for later results, replacing "verification pending at INSP-011 iteration 3" (F-13); hazard line stamp 0.4.0-pha changed to 0.5.0-pha, the version at HEAD, after re-checking the line against it (F-13; for ADR-015, 022, 023 and 026 also SRR lien L-7); section 4.3 placeholders replaced by TC-SYS-075, the ME L2 cases stated as allocated with their requirements (F-14); section 4.3 `TV-NNN` stated as a record not yet filed, due PDR (F-14). Route: the SRR decision memo carries these findings as liens to be fixed in the product before the PDR readiness declaration (RFA-SRR-006: "Fix each finding in its product"); they are applied by the ADR correction route the owner approved as SRR decision 105 (corrections outside section 2, each logged in this section), as the README paragraph "PDR errata" records. The decision of section 2 is unchanged. Author: Claude (ADR author invocation, WP-PDR-14).
- 2026-09-27 (correction of the WP-PDR-14 entry above; INSP-053 finding-1, `docs/reviews/PDR/checklists/adrs-001-to-027.md`): the entry above records edits in place of 4 lines outside section 8 made after the `baseline/srr` tag, which 05 Table 4-1 row 13, the Record class of 05 section 4.2 and README rule 2 do not allow. Its "Route" sentence is withdrawn: the SRR lien direction (RFA-SRR-006) does not amend row 13, and the decision 105 route was the exception before the tag only. Those 4 lines are restored to their `baseline/srr` text, and each change the entry above lists is carried here as a reading of the restored line, which governs wherever that line is cited (finding ids as in the entry above): (1) header row "Independent reviewer", read as "INSP-011 (`docs/reviews/SRR/checklists/adrs-001-to-025.md`): iterations 1 to 3 (2026-09-25 and 2026-09-26) and the post-SRR-ruling deltas 1 and 2 (2026-09-26); verdict APPROVED with liens at delta 2. The liens against this file are fixed by the 2026-09-27 errata of section 8, verified at the next INSP-011 delta iteration. That record, not this row, carries every later result"; (2) section 1, line "Hazards in play", for the stamp "0.4.0-pha" read "0.5.0-pha": the line was re-checked against `hazards.json` 0.5.0-pha on 2026-09-27 and its hazard list and every control and cause id it cites hold at that version unchanged; (3) section 4.3, line "Verification cases to add or change", read as "Verification cases to add or change: enclosure material, finish and conductive masking TC-SYS-075 (Inspection, REQ-SYS-109); the STEP acceptance checks (Inspection by tool), the printed fit check of PCB, display, jacks and USB opening (Demonstration) and the receipt inspection of the machined parts against the drawing (CMM report on the mounting pattern optional) are allocated with the ME L2 requirements at PDR (no id yet)"; (4) section 4.3, line "Evidence class implications", for "a tool-validation record `TV-NNN` for the CAD chain (05 section 9.2)" read "a tool-validation record for the CAD chain (05 section 9.2), not yet filed: it takes the next free TV number when created, due PDR with `tools/scad2step.py` (`tools/toolchain.lock.md`)". Every other statement of the entry above stands as written. The decision of section 2 is unchanged, and `git diff baseline/srr` of this file shows added lines only. Verification: the next INSP-053 iteration. Author: Claude (ADR author invocation, WP-PDR-14).
