robinonsay/cwht/docs/vv/reports/TC-SW-TOOL-001-r4/step11-load.txt

== 2026-09-26T19:18:04-0500 step 11: picotool load -v rustos-blinky.uf2
c45b526837c0831206763eb3134a8e71c854059ff7442c19e51f39edf03308d3  docs/vv/reports/TC-SW-TOOL-001-r1/rustos-blinky.uf2
Family ID 'rp2350-arm-s' can be downloaded in absolute space:
  00000000->02000000
Loading into Flash:   [                              ]  0%
Loading into Flash:   [==============================]  100%
Verifying Flash:      [                              ]  0%
Verifying Flash:      [==============================]  100%
  OK
load exit 0
== 2026-09-26T19:18:04-0500 picotool reboot
The device was rebooted into application mode.
reboot exit 0
