robinonsay/cwht/docs/vv/reports/TC-SW-TOOL-001-r4/step12-observation.txt

Step 12 owner observation, transcribed 2026-09-26T19:22:34-0500
Board: Pico 2 marked "1"; chipid 0xf9c6e0eff60605d1 (same board as step 11)
Image: cwht-app.uf2 sha256 4e0bd133a10b6e29f72f00023ec407cd1885b8550a685b881c7be213462b3529
Owner statements, verbatim: "Yes that looks correct" then, asked for the timed count, "18 in 60s"
Count: 18 off-to-on transitions in 60 s (acceptance window 3 to 45; step 10 prediction window 5 to 39, about 16 expected)
Result: Pass
