robinonsay/cwht/docs/references/md/nasa-se-handbook/25-appendix-c-how-to-write-a-good-requirement.md

# Appendix C: How to Write a Good Requirement

> NASA Systems Engineering Handbook, NASA/SP-2016-6105 Rev 2. Printed pages 197–200. Machine conversion from PDF; tables and figures may be flattened. Cite as `SE HB §C`.

How to Write a Good Requirement— Checklist C.1 Use of Correct Terms  Shall = requirement  Will = facts or declaration of purpose  Should = goal

C.2 Editorial Checklist Personnel Requirement  The requirement is in the form “responsible party shall perform such and such.” In other words, use the active, rather than the passive voice. A requirement should state who shall (do, perform, provide, weigh, or other verb) followed by a description of what should be performed.

not the solution. Ask, “Why do you need the requirement?” The answer may point to the real requirement.)  Free of descriptions of operations? (Is this a need the product should satisfy or an activity involving the product? Sentences like “The operator shall…” are almost always operational statements not requirements.) Example Product Requirements  The system shall operate at a power level of…  The software shall acquire data from the…  The structure shall withstand loads of…  The hardware shall have a mass of…

Product Requirement  The requirement is in the form “product ABC shall XYZ.” A requirement should state “The product shall” (do, perform, provide, weigh, or other verb) followed by a description of what should be done.  The requirement uses consistent terminology to refer to the product and its lower-level entities.  Complete with tolerances for qualitative/performance values (e.g., less than, greater than or equal to, plus or minus, 3 sigma root sum squares).  Is the requirement free of implementation? (Requirements should state WHAT is needed, NOT HOW to provide it; i.e., state the problem

C.3 General Goodness Checklist  The requirement is grammatically correct.  The requirement is free of typos, misspellings, and punctuation errors.  The requirement complies with the project’s template and style rules.  The requirement is stated positively (as opposed to negatively, i.e., “shall not”).  The use of “To Be Determined” (TBD) values should be minimized. It is better to use a best

estimate for a value and mark it “To Be Resolved” (TBR) with the rationale along with what should be done to eliminate the TBR, who is responsible for its elimination, and by when it should be eliminated.  The requirement is accompanied by an intelligible rationale, including any assumptions. Can you validate (concur with) the assumptions? Assumptions should be confirmed before baselining.  The requirement is located in the proper section of the document (e.g., not in an appendix).

C.4 Requirements Validation Checklist Clarity  Are the requirements clear and unambiguous? (Are all aspects of the requirement understandable and not subject to misinterpretation? Is the requirement free from indefinite pronouns (this, these) and ambiguous terms (e.g., “as appropriate,” “etc.,” “and/or,” “but not limited to”)?)  Are the requirements concise and simple?  Do the requirements express only one thought per requirement statement, a stand-alone statement as opposed to multiple requirements in a single statement, or a paragraph that contains both requirements and rationale?  Does the requirement statement have one subject and one predicate? Completeness  Are requirements stated as completely as possible? Have all incomplete requirements been captured

as TBDs or TBRs and a complete listing of them maintained with the requirements?  Are any requirements missing? For example, have any of the following requirements areas been overlooked: functional, performance, interface, environment (development, manufacturing, test, transport, storage, and operations), facility (manufacturing, test, storage, and operations), transportation (among areas for manufacturing, assembling, delivery points, within storage facilities, loading), training, personnel, operability, safety, security, appearance and physical characteristics, and design.  Have all assumptions been explicitly stated? Compliance  Are all requirements at the correct level (e.g., system, segment, element, subsystem)?  Are requirements free of implementation specifics? (Requirements should state what is needed, not how to provide it.)  Are requirements free of descriptions of operations? (Don’t mix operation with requirements: update the ConOps instead.)  Are requirements free of personnel or task assignments? (Don’t mix personnel/task with product requirements: update the SOW or Task Order instead.) Consistency  Are the requirements stated consistently without contradicting themselves or the requirements of related systems?  Is the terminology consistent with the user and sponsor’s terminology? With the project glossary?

 Is the terminology consistently used throughout the document? Are the key terms included in the project’s glossary? Traceability  Are all requirements needed? Is each requirement necessary to meet the parent requirement? Is each requirement a needed function or characteristic? Distinguish between needs and wants. If it is not necessary, it is not a requirement. Ask, “What is the worst that could happen if the requirement was not included?”  Are all requirements (functions, structures, and constraints) bidirectionally traceable to higher-level requirements or mission or system-of-interest scope (i.e., need(s), goals, objectives, constraints, or concept of operations)?  Is each requirement stated in such a manner that it can be uniquely referenced (e.g., each requirement is uniquely numbered) in subordinate documents? Correctness  Is each requirement correct?  Is each stated assumption correct? Assumptions should be confirmed before the document can be baselined.

 Is each performance requirement realistic?  Are the tolerances overly tight? Are the tolerances defendable and cost-effective? Ask, “What is the worst thing that could happen if the tolerance was doubled or tripled?” Interfaces  Are all external interfaces clearly defined?  Are all internal interfaces clearly defined?  Are all interfaces necessary, sufficient, and consistent with each other? Maintainability  Have the requirements for maintainability of the system been specified in a measurable, verifiable manner?  Are requirements written so that ripple effects from changes are minimized (i.e., requirements are as weakly coupled as possible)? Reliability  Are clearly defined, measurable, and verifiable reliability requirements specified?  Are there error detection, reporting, handling, and recovery requirements?

 Are the requirements technically feasible? Functionality  Are all described functions necessary and together sufficient to meet mission and system goals and objectives? Performance  Are all required performance specifications and margins listed (e.g., consider timing, throughput, storage size, latency, accuracy and precision)?

 Are undesired events (e.g., single-event upset, data loss or scrambling, operator error) considered and their required responses specified?  Have assumptions about the intended sequence of functions been stated? Are these sequences required?  Do these requirements adequately address the survivability after a software or hardware fault of

the system from the point of view of hardware, software, operations, personnel and procedures? Verifiability/Testability  Can the system be tested, demonstrated, inspected, or analyzed to show that it satisfies requirements? Can this be done at the level of the system at which the requirement is stated? Does a means exist to measure the accomplishment of the requirement and verify compliance? Can the criteria for verification be stated?  Are the requirements stated precisely to facilitate specification of system test success criteria and requirements?

 Are the requirements free of unverifiable terms (e.g., flexible, easy, sufficient, safe, ad hoc, adequate, accommodate, user-friendly, usable, when required, if required, appropriate, fast, portable, light-weight, small, large, maximize, minimize, sufficient, robust, quickly, easily, clearly, other “ly” words, other “ize” words)? Data Usage  Where applicable, are “don’t care” conditions truly “don’t care”? (“Don’t care” values identify cases when the value of a condition or flag is irrelevant, even though the value may be important for other cases.) Are “don’t care” conditions values explicitly stated? (Correct identification of “don’t care” values may improve a design’s portability.)
