robinonsay/cwht/docs/references/md/swehb/6-3-checklist-for-choosing-a-real-time-operating-system-rtos.md

# 6.3 - Checklist for Choosing a Real Time Operating System RTOS

> NASA Software Engineering Handbook (SWEHB Ver D), page id 102695560. Source: https://swehb.nasa.gov/spaces/SWEHBVD/pages/102695560/6.3+-+Checklist+for+Choosing+a+Real+Time+Operating+System+RTOS

Considerations for choosing the best RTOS for your application.

Click on the image to preview the file. From the preview, click on Download to obtain a usable copy.

**PAT-025 - Checklist for Choosing a Real Time Operating System**
