robinonsay/cwht/docs/references/md/swehb/7-22-space-security-best-practices-guide.md

# 7.22 - Space Security Best Practices Guide

> NASA Software Engineering Handbook (SWEHB Ver D), page id 146540183. Source: https://swehb.nasa.gov/spaces/SWEHBVD/pages/146540183/7.22+-+Space+Security+Best+Practices+Guide

7.22 - Space Security: Best Practices Guide

*Web Resources*

 [View this section on the website](https://swehb.nasa.gov/spaces/SWEHBVD/pages/146540183/7.22+-+Space+Security+Best+Practices+Guide#_tabs-1)  
 [See edit history of this section](https://swehb.nasa.gov/pages/viewpreviousversions.action?pageId=146540183)  
 [Post feedback on this section](http://swehb.nasa.gov/pages/viewpage.action?pageId=146540183&showCommentArea=true&showComments=true#addcomment)

[Section Labels](https://swehb.nasa.gov/display/7150/Tag+Multi-Select):

Unknown macro: {page-info}

* [1. Introduction](#tabs-1)
* [2. Resources](#tabs-2)

# 1. Introduction

This topic guides mission security implementation in the form of principles coupled with applicable controls that cover both the space vehicle and the ground segment.The Space Security: Best Practices Guide (BPG) provides guidance on mission security implementation in the form of principles coupled with applicable controls that cover both the space vehicle and the ground segment. The BPG leverages security controls as defined in the National Institute of Standards and Technology (NIST) Special Publication (SP) 800-53 [088](#_tabs-<p>2</p>)  and serves as a translation guide between NIST verbiage and NASA flight project parlance. The principles are meant to be easily achievable regardless of mission, program, or project size, scope, or whether international, corporate, or university. The principles selected focus on a risk-based approach to mitigating vulnerabilities, that are impediments to mission success. Principles were identified as an initial starting point of critical implementations for missions to consider. The underlying security principles and associated controls were identified through an iterative process to address today’s cyber actors Tactics, Techniques, and Procedures (TTPs) were used in attempts to compromise mission capabilities. The guide is to be used as an initial starting point to mitigate against any efforts to deny, degrade, disrupt, deceive, or destroy information and technology used to accomplish NASA's mission success. Click here for a full copy of the [Space Security Best Practices Guide](/download/attachments/146540183/Space%20Security%20Best%20Practices%20Guide%20BPG%20REV%20B.pdf?version=1&modificationDate=1706014154000&api=v2) (attached to this page.)

See also [SWE-156 - Evaluate Systems for Security Risks](/spaces/SWEHBVD/pages/102695512/SWE-156+-+Evaluate+Systems+for+Security+Risks) and [SWE-154 - Identify Security Risks](/spaces/SWEHBVD/pages/102695510/SWE-154+-+Identify+Security+Risks).

## 1.1 Additional Guidance

Links to Additional Guidance materials for this subject have been compiled in the Relevant Links table. Click here to see the [Additional Guidance](#tabs-2) in the Resources tab.

# 2. Resources

## 2.1 References

[Click here to view master references table.](/spaces/SWEHBVD/pages/101810240/References+Table "References Table")

* (SWEREF-088)

  [Security and Privacy Controls for Information Systems and Organizations](https://nvlpubs.nist.gov/nistpubs/SpecialPublications/NIST.SP.800-53r5.pdf "Click to open in new window")

  NIST Special Publication 800-53, Revision 5, September, 2020, U.S. Department of Commerce,
* (SWEREF-361)

  [SPACE SYSTEM PROTECTION STANDARD](https://standards.nasa.gov/standard/NASA/NASA-STD-1006 "Click to open in new window")

   NASA-STD-1006A, Approved 7/15/2022,  PUBLIC: Upload Publicly Available Standard
  https://standards.nasa.gov/sites/default/files/standards/NASA/A/0/2022-07-15-NASA-STD-1006A-Approved.pdf

## 2.2 Tools

Tools to aid in compliance with this SWE, if any, may be found in the Tools Library in the NASA Engineering Network (NEN). 

NASA users find this in the [Tools Library](https://nen.nasa.gov/web/software/wiki/-/wiki/SPAN/Tool+Library) in the Software Processes Across NASA (SPAN) site of the Software Engineering Community in NEN.

The list is informational only and does not represent an “approved tool list”, nor does it represent an endorsement of any particular tool.  The purpose is to provide examples of tools being used across the Agency and to help projects and centers decide what tools to consider.

## 2.3 Additional Guidance

Additional guidance related to this requirement may be found in the following materials in this Handbook:

| Related Links |
| --- |
| * [SWE-154 - Identify Security Risks](/spaces/SWEHBVD/pages/102695510/SWE-154+-+Identify+Security+Risks) * [SWE-156 - Evaluate Systems for Security Risks](/spaces/SWEHBVD/pages/102695512/SWE-156+-+Evaluate+Systems+for+Security+Risks) |

## 2.4 Center Process Asset Libraries

**SPAN - Software Processes Across NASA**  
SPAN contains links to Center managed Process Asset Libraries. Consult these Process Asset Libraries (PALs) for Center-specific guidance including processes, forms, checklists, training, and templates related to Software Development. See SPAN in the Software Engineering Community of NEN. Available to NASA only. <https://nen.nasa.gov/web/software/wiki> [197](#_tabs-<p>2</p>)

See the following link(s) in SPAN for process assets from contributing Centers (NASA Only). 

| SPAN Links |
| --- |
| * [Center Libraries](https://nen.nasa.gov/web/software/wiki) |

## 2.5 Related Activities

This Topic is related to the following Life Cycle Activities:

| Related Links |
| --- |
| * [A.02 Software Assurance and Software Safety](/spaces/SWEHBVD/pages/133235378/A.02+Software+Assurance+and+Software+Safety) |
