robinonsay/cwht/docs/cm/tool-validation/evidence/ltspice-known-answers-2026-09-27/rc-step-response.png

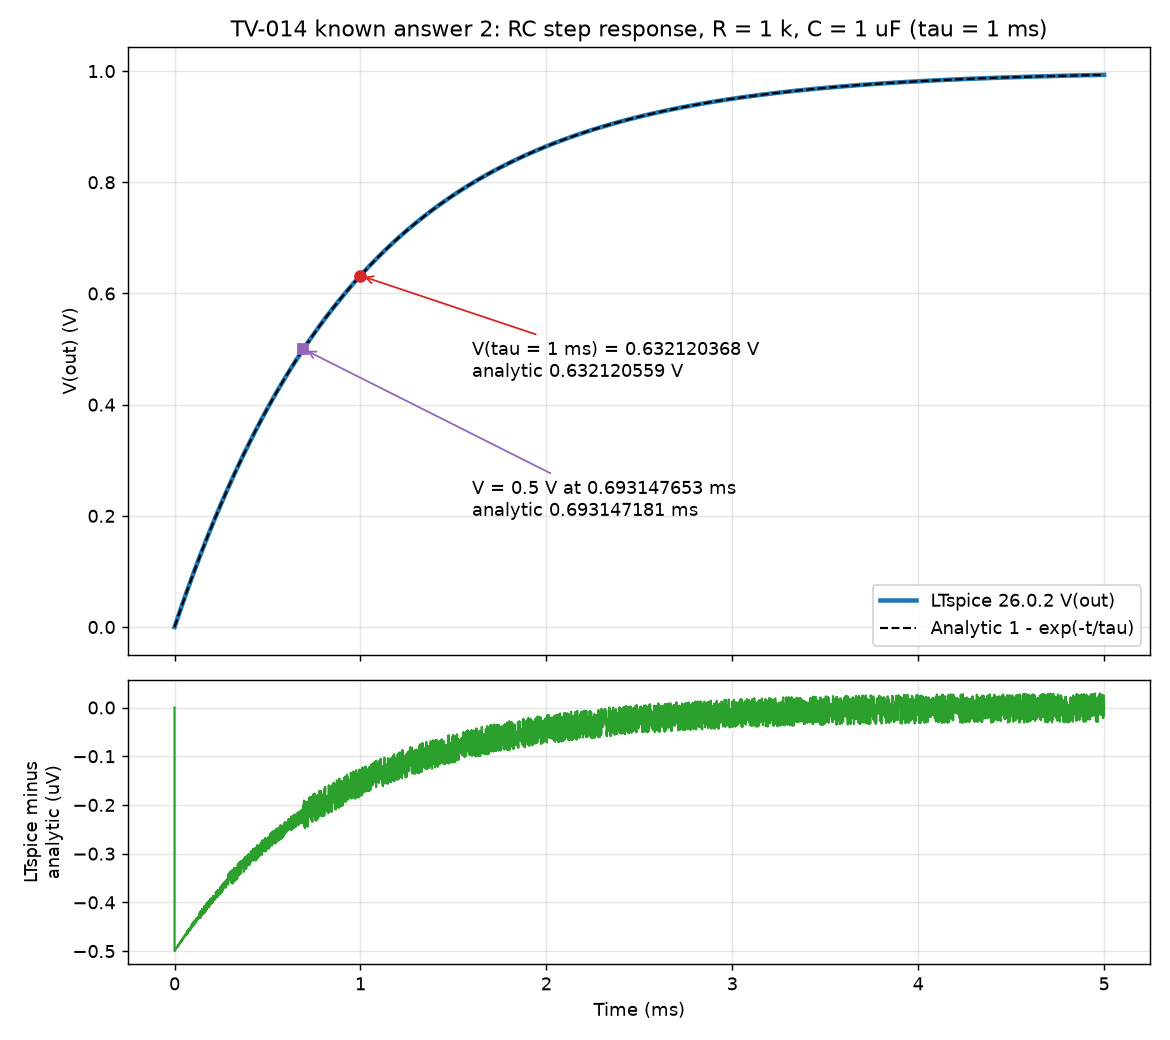
docs/cm/tool-validation/evidence/ltspice-known-answers-2026-09-27/rc-step-response.png
