robinonsay/cwht/docs/design/analysis/ui-design/ui-tuning-step-law.png

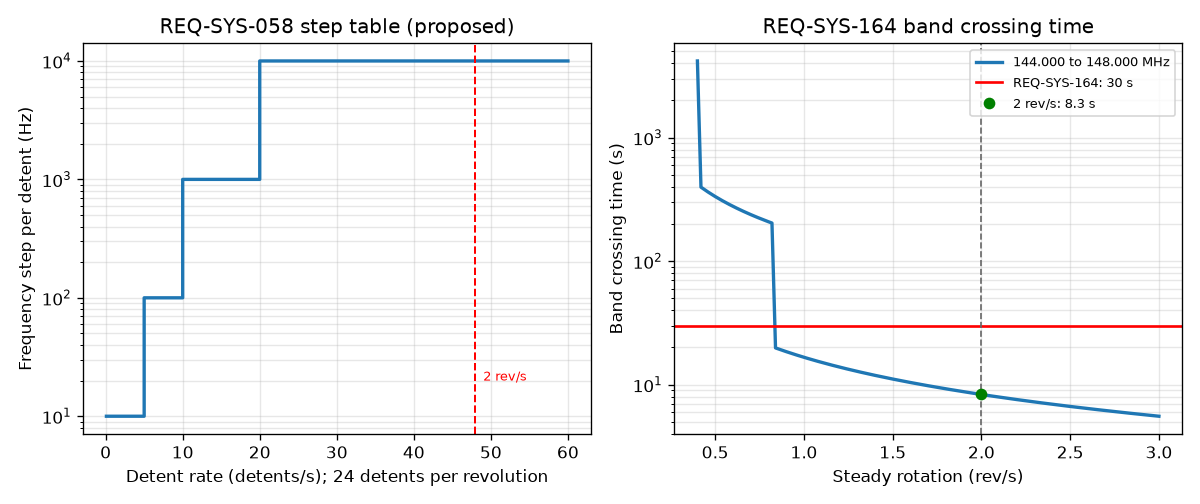
docs/design/analysis/ui-design/ui-tuning-step-law.png
