robinonsay/cwht/hardware/sim/tx-pa/results/2026-09-29-r4-p4-power-a5-design/power_a5_step_d9_sma.png

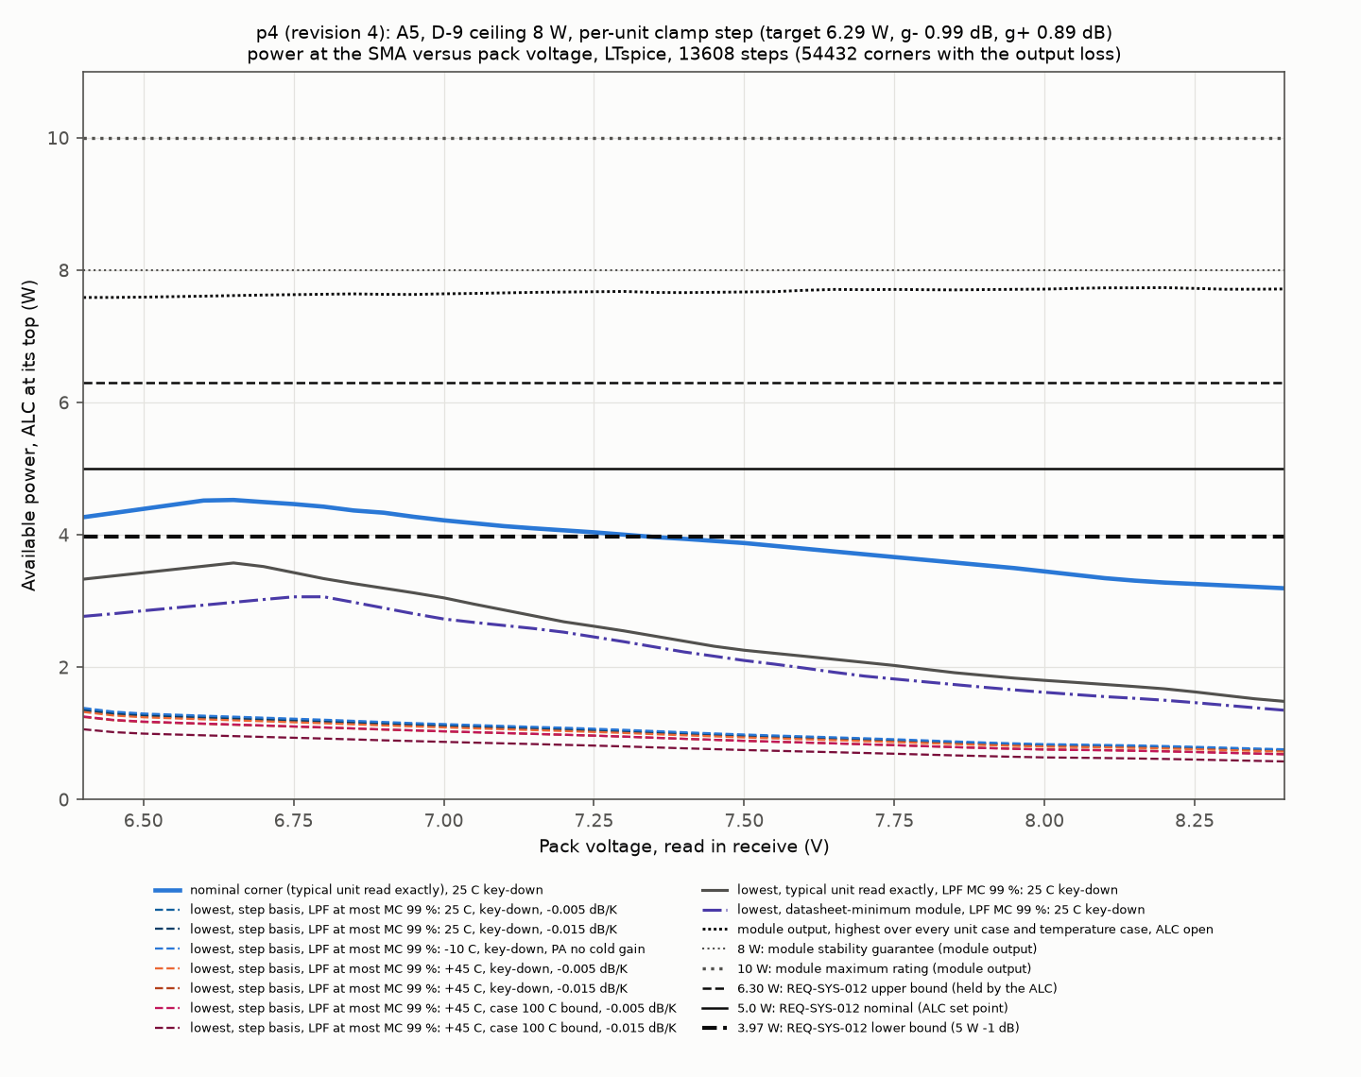
hardware/sim/tx-pa/results/2026-09-29-r4-p4-power-a5-design/power_a5_step_d9_sma.png
