robinonsay/cwht/hardware/sim/tx-pa/results/2026-09-29-r4-p5-power-a5-clamp-b/power_a5_step_clampb_temperature.png

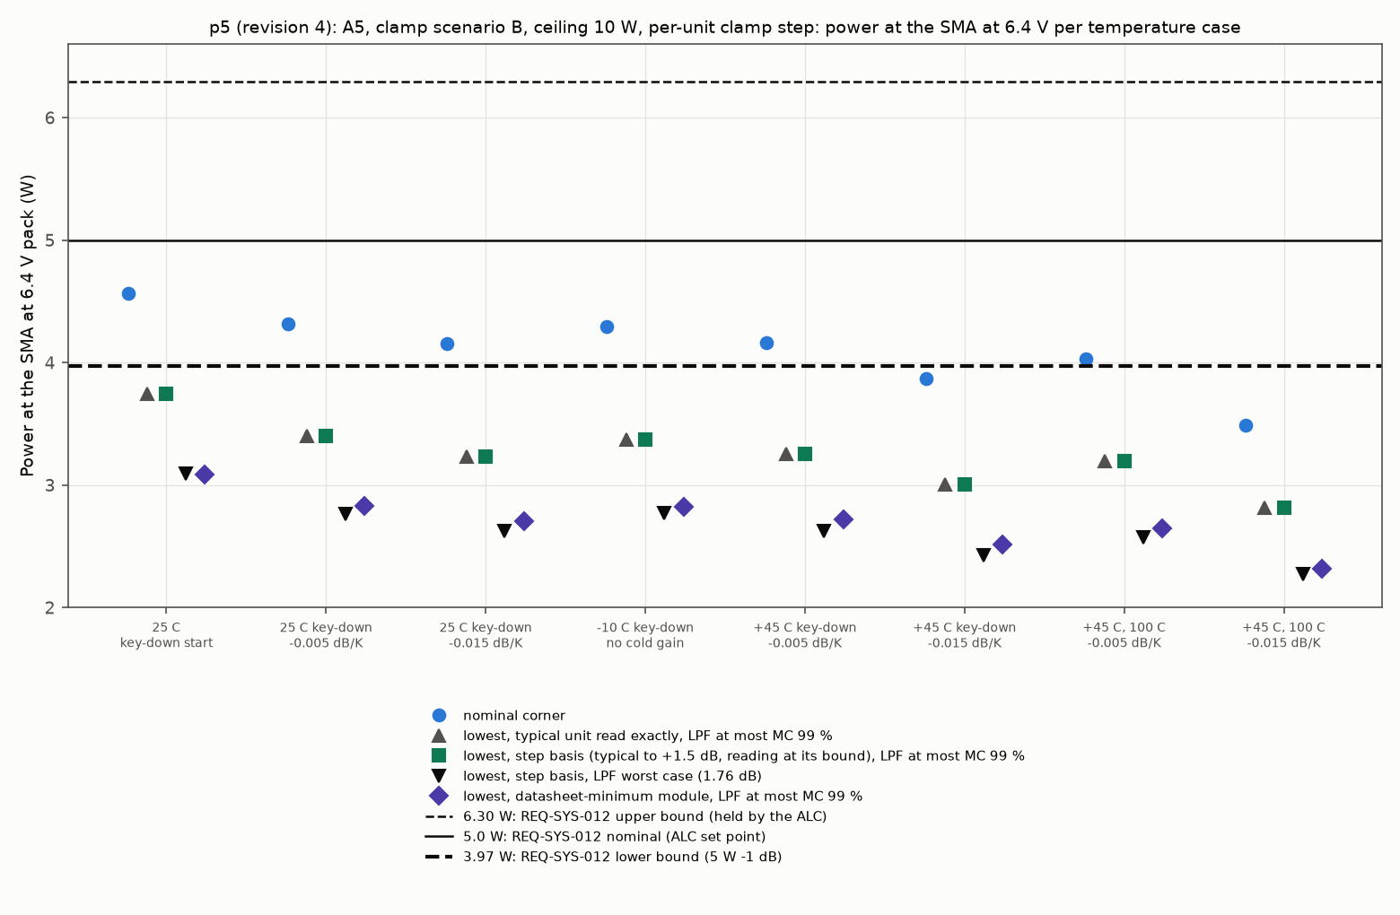
hardware/sim/tx-pa/results/2026-09-29-r4-p5-power-a5-clamp-b/power_a5_step_clampb_temperature.png
