robinonsay/cwht/hardware/sim/tx-pa/results/2026-09-29-r4-s4-clamp-step/clamp_step.png

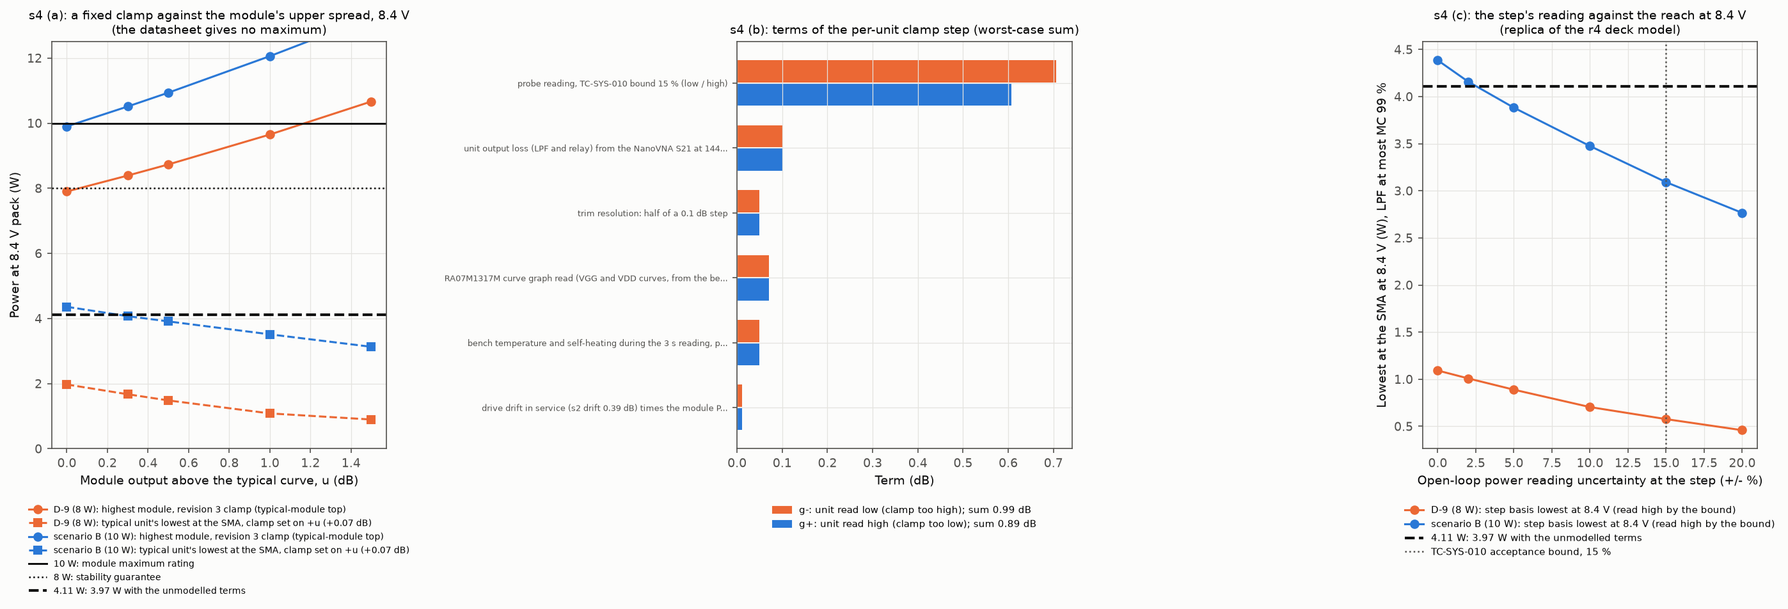
hardware/sim/tx-pa/results/2026-09-29-r4-s4-clamp-step/clamp_step.png
