robinonsay/cwht/hardware/sim/tx-seq/results/2026-09-29-r2-s3-operate/s3-operate-vs-coil-temperature.png

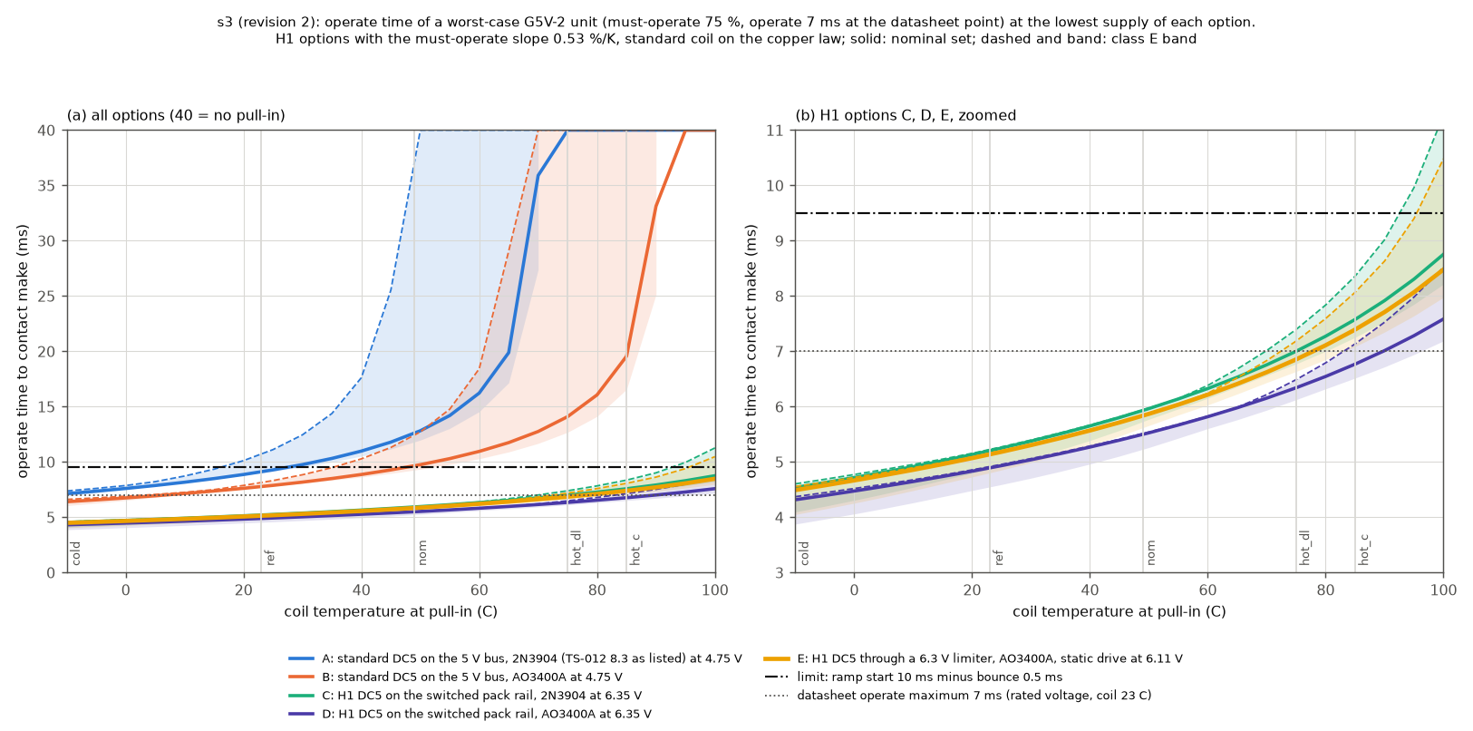
hardware/sim/tx-seq/results/2026-09-29-r2-s3-operate/s3-operate-vs-coil-temperature.png
