robinonsay/cwht/docs/cm/tool-validation/evidence/ltspice-known-answers-2026-09-27/README.md

# LTspice known-answer runs for owner review (TV-014, 2026-09-27)

Run by Claude (lead SE) at the owner's request to see the LTspice results before deciding OD-24b (accreditation ACC-LTSPICE-001). Wrapper `tools/ltspice-batch.sh` blob 88b71475 (TV-014 run 6), LTspice 26.0.2 in the CrossOver bottle, headless. `CaptureAnalytics=false` was present before and after the runs (count 1). No Wine process of the bottle was left after each run.

| Deck (tools/tests/fixtures/ltspice/) | Analysis | LTspice result (.log) | Exact answer | Wrapper verdict |
|---|---|---|---|---|
| `rc-lowpass.asc` (R 1 k, C 159.155 nF) | AC, 10 Hz to 100 kHz | f(-3 dB) = 999.999642341 Hz | 1/(2 pi R C) = 999.999642 Hz; magnitude error across the sweep below 1.1e-14 dB | PASS, exit 0 |
| `rc-step-tran.net` (R 1 k, C 1 uF, 1 ns input ramp) | Transient, 0 to 5 ms | V(1 ms) = 0.632120368 V; V = 0.5 V at 0.693147653 ms | 1 - e^-1 = 0.632120559 V; tau ln 2 = 0.693147181 ms. The differences (0.19 uV, 0.47 ns) come from the 1 ns rise of the input ramp, which delays the response by 0.5 ns | PASS, exit 0 |
| `rc-seeded-error.net` (two analyses, a seeded fault) | none | log: "More than one analysis specified.", exit 1, no .raw | must fail | FAIL, exit 1, as required |

Plots (LTspice trace over the analytic curve, with the difference below):
- `rc-lowpass-bode.png`: magnitude, phase and error of the RC low-pass.
- `rc-step-response.png`: step response and error.

Files: the `.raw` waveforms open in LTspice; `.log` and `.net` are LTspice's own outputs. Plots are regenerated by `.venv/bin/python docs/cm/tool-validation/evidence/ltspice-known-answers-2026-09-27/plot_known_answers.py`.
