robinonsay/cwht/docs/process/04-verification-and-validation.md

# cwht Verification and Validation Process

**Expands:** charter `docs/process/00-charter.md` section 9 (and the V&V parts of sections 3, 5, 7, 10). **Status:** baselined at SRR with the charter (`baseline/srr`, blob `0b197bba`); changes after the SRR approval are listed below. **Owner:** Robin (Decision Authority, test director, witness, user). **Maintainer:** Claude (lead systems engineer, test conductor for automated evidence, procedure author). **ETA approval:** the owner as Engineering Technical Authority approves this document as the project's verification process and validation process in `docs/reviews/SRR/decision-memo.md` (NPR 7123.1D SE-13 and SE-14 require an ETA-approved process; the compliance-matrix rows SE-13 and SE-14 cite that memo, alignment item A6 of section 18). **Change authority:** owner, via `CR-NNN` after SRR.

This document is the project's Product Verification process (NPR 7123.1D SE-13) and Product Validation process (SE-14), the software unit-test rules of NPR 7150.2D §4.4 (SWE-062, SWE-186), the software test and non-conformance process required by NPR 7150.2D §4.5 (SWE-065, SWE-066, SWE-068, SWE-070, SWE-071, SWE-073, SWE-187, SWE-189, SWE-190, SWE-191, SWE-192, SWE-193, SWE-211) and §5.5 (SWE-201, SWE-202, SWE-203, SWE-204), and the pre-delivery verification closure of §4.6 (SWE-194). It follows SE HB §5.3 (verification), §5.4 (validation), §2.4 (the distinction), §6.1 (verification and validation planning), Table 5.3-1 (procedure and report content) and Appendices D, E and I. Where this document and the charter disagree, the charter wins and this document is fixed by CR. Section 18 lists the alignment items this document raises against other products and the charter issues it raises.

**Changes after the SRR approval.** CR-002 (`docs/cm/cr/CR-002-inspection-for-documentary-requirements.md`; SRR decision 113, owner ruling 2026-09-26): section 3 hazard-tracing paragraph, rule 7.3.6 and the section 7.4 row 7.3.6 admit Inspection for hazard-tracing requirements that state a documentary or physical property. CR-002 step 5 (`c774851`, SRR close-out item 5) made `tools/traceability.py` accept that route; section 7.4 row 7.3.6 records it (INSP-021 finding-9, applied by CR-013).

**CR-013** (Class II, Submitted 2026-09-27; `docs/cm/cr/CR-013-process-04-07-semp-srr-liens.md`; PDR work plan WP-PDR-13): the SRR liens of INSP-021 (`docs/reviews/SRR/checklists/process-04-verification-and-validation.md`) finding-2 (section 4 Emulation row, item C1), finding-3 (sections 6, 10.6, 14 row 4.2, 17, items A10, A12, A13, A14), finding-4 (section 4 LTspice wrapper, section 7.4 re-observed at `main` `7bb994f` with rows 7.3.2 and 7.3.5 due PDR as 02 T-19 dates them) and finding-9 (section 7.4 row 7.3.6); section 7.4 rows 7.3.4, 7.3.11 and 7.3.12 and the option list state the change proposed by CR-011 (Submitted); section 12 gains the `target-only: verified by <TC-ID>` entry of `docs/process/07-software-engineering-plan.md` section 9.5 item 2 (07 section 22 row "Coverage disposition for target-only code"); section 18 statuses of A3, A4, A10 and C1 re-checked on 2026-09-27.

---

## 1. Verification versus validation on cwht

SE HB §2.4 and Appendix B: **verification** is proof of compliance with specifications ("Did I build the product right?"); **validation** is proof that the product accomplishes its intended purpose based on stakeholder expectations and the ConOps ("Am I building the right product?"). Both may use test, analysis, inspection or demonstration. Verification relates back to the approved requirements set; validation relates back to the ConOps (SE HB §2.4).

| | Verification | Validation |
|---|---|---|
| Question | Does the realized product meet every "shall"? | Does the radio let the owner and friends do what the ConOps says, to the MOE values? |
| Judged against | `docs/requirements/**/requirements.json` (L1 SYS, L2 RX/TX/PWR/CTL/ME/SW), `docs/icd/ICD-*.md` shall statements, hazard controls in `docs/safety/hazards.json` | `docs/conops/conops.md` scenarios `OPS-NNN` (nominal and off-nominal) and `docs/requirements/l0-stakeholder/expectations.json` (NGO-NNN, MOE-NNN, success criteria) |
| Who judges | Claude conducts and records; owner witnesses Bench/OnAir and authorizes acceptability | Owner as the user (SE HB §5.4.1.2: validation is performed by anticipated operators and users whenever possible); friends receiving units (SI-019) are additional users |
| Cases | `TC-<MOD>-NNN` in `docs/test_cases/<module>/test_cases.json`, any module except `VAL` | `TC-VAL-NNN` in `docs/test_cases/val/test_cases.json`, with the two mandatory setup lines below |
| Matrix | Requirements verification matrix (SE HB App. D), section 7.1 | Validation matrix (SE HB App. E), section 7.2 |
| Report | `docs/vv/reports/<TC-ID>-r<N>.md` from `docs/templates/verification-report.md` | Same template; `requirements_baseline` also identifies the expectations and ConOps version used (SE HB §5.4.1.2.4); result feeds the validation matrix |
| Discrepancy | `NCR-NNN` (section 10) | `NCR-NNN`; if the product meets its requirements but not the expectation, the disposition is a `CR-NNN` against the requirement or ConOps, not a rework |
| Completion | Requirement status `Verified`, then `Closed` at SAR (section 5.3) | MOE and OPS rows `Validated` in the validation matrix; owner acceptance at SAR |

**Case modules.** Charter section 6 lists the requirement modules SYS, RX, TX, PWR, CTL, ME and SW-<SUB> and, since charter commit b8214ca, the test-only case modules this process defines: `VAL` (validation cases, `docs/test_cases/val/`), `ATP` (acceptance cases, `docs/test_cases/atp/`), `SW-COV` (coverage, section 12), `SW-REG` (regression, section 10.5) and `SW-TOOL` (toolchain proof and tool accreditation runs, `docs/test_cases/sw-tool/test_cases.json`, case `TC-SW-TOOL-001` of `docs/process/07-software-engineering-plan.md` section 3.1). Each test-only module has a `test_cases.json` and no requirements file, and its cases cite requirements of any module (02 section 2.2). `SW-BOOT` and `SW-CFG` (loaded code and data, section 11.1) are firmware modules of 07 section 4 with their own requirement files and cases, not test-only. After SRR any further module token is a `CR-NNN`.

**Validation cases.** Validation is not deferred to SAR. Per SE HB §2.4 it is repeated in each phase with the phase products: ConOps walk-through against the L1 requirements at SRR, architecture and control-layout review against `OPS-NNN` at PDR (3D-printed facade and knob fit-check parts, SI-012, are the mock-ups), emulator scenarios (or, where the emulator is not accredited, dev-board runs, section 4) that replay `OPS-NNN` at CDR, and the delivered unit on the air in Phase D. Each of these is a `TC-VAL-NNN` case whose `setup` carries two mandatory lines:

- `Validates: <ids>.` naming the `OPS-NNN` and `MOE-NNN` the case validates, for example `Validates: OPS-004, OPS-005, MOE-005.`
- `Phase: <token>.` with one token of `SRR`, `PDR`, `CDR`, `TRR`, `TRR-D<n>` (the delta review number, for example `TRR-D1`), `SAR` or `Ops` (Phase E use). The token names the gate whose package presents the result.

`tools/traceability.py` reads both lines (rule 7.3.5); a `TC-VAL` case never closes a requirement (row key `VAL` of section 5.2), and its `requirement_ids` list the requirements it exercises.

**Keying is a core expectation.** SI-018 requires operation with a straight key and with iambic paddles (built-in electronic keyer). Every validation scenario that involves transmitting is executed twice, once with each key type, and the acceptance test set (section 11) contains both. A unit that works with only one key type has not been validated.

**MOPs.** NPR 7123.1D §3.2.8.2 directs special attention to demonstrating the MOPs defined for each MOE. Every verification report whose requirement carries `mop_ids` records the measured value; Claude copies it into `docs/plan/tpm.json` the same day.

---

## 2. Roles and independence in V&V

| Role | Who | Duties |
|---|---|---|
| Test director and witness | Owner | Approves TRR, operates instruments and keys on Bench and OnAir runs, declares run-for-record, signs (as a decision memo line) the authorization of acceptability in each report, dispositions every NCR (section 10.7), confirms the severity of every non-firmware NCR (section 10.3) |
| Test conductor (automated classes) | Claude main session | Runs Simulation, HostUnit, Emulation and Inspection evidence on tagged configurations; writes the report; updates statuses |
| Test author | Independent agent invocation (charter section 2, rule 11.4) | Writes `TC-*` cases from the requirements, never from the design or code alone |
| Procedure reviewer | Independent reviewer agent | Reviews every case before its status becomes `Active` (SWE-087 peer review of test procedures). Checklist by module: cases of `SW-<SUB>`, `SW-COV`, `SW-REG` and `SW-TOOL`, and software Bench and OnAir procedures, use `docs/templates/peer-review-checklist-test.md` (which includes section 8.3); cases of every other module use the section 8.3 checklist. The filled checklist is copied to `docs/reviews/<REVIEW>/checklists/<product-slug>.md`, where `<REVIEW>` is the next gate the case feeds, and carries `id: INSP-NNN` in its front matter; it is the single peer-review record of the case set (charter section 5; 01 section 1 item 6) |
| Software assurance | Independent reviewer agent | Reviews coverage reports, NCR severity assignments for firmware NCRs and regression evidence before each review gate |

The person or agent who wrote a piece of code or a schematic sheet does not write the test cases that verify it. Independence is recorded, not asserted: checklist item 10 of section 8.3 ("case author differs from the author of every design element or code module the case verifies") is answered by the procedure reviewer with the authoring invocation of the case and of the design element, and the answer is filed in the INSP record above (`docs/process/01-lifecycle-and-reviews.md` section 3.2 row S3). No git commit trailer is used for this purpose; commit trailers follow the CM plan (`docs/process/05-configuration-and-data-management.md` section 4.5).

---

## 3. Methods

The four methods are those of SE HB §5.3.1.2.1 (sidebar "Methods of Verification") and Appendix B. Each requirement carries exactly one `verification_method` (schema `docs/requirements/schema.json`), assigned when it is written (charter section 7). A test case's `verification_method` is the method it implements. SE HB §6.1 notes that complete verification of a requirement may need more than one method; on cwht the requirement then either closes by the one method section 6.2 names for its kind, with the other methods recorded as supporting cases or as data inside the closing report, or it is split into companion requirements, one per method, each with its own closing case (the method is assigned at definition, 02 section 4.4). A requirement never has two closing methods.

| Method | SE HB meaning | Use on cwht |
|---|---|---|
| **Analysis** | Mathematical modeling and analytical techniques to predict compliance from calculated data or from lower-level verifications; includes modeling and simulation and verification by similarity | LTspice `.ac`/`.tran` decks with automated pass/fail checkers, Python link, power, thermal and noise budgets, S-parameter models of the filter chain, timing analyses of firmware paths, worst-case tolerance analyses. Chosen when the quantity cannot be measured with instruments the project will have (section 6), or when the requirement is a design margin (for example, component derating) rather than a behavior |
| **Inspection** | Visual examination of the realized product, including drawings, documents and records | KiCad ERC and DRC runs, BOM against approved parts list, rendered schematic and layout images reviewed against checklists, `jsonschema` validation of every JSON artifact, `tools/traceability.py` checks, driver-to-datasheet traceability (every register access in a rustos `pico2` driver cites the RP2350 datasheet or Cortex-M33 documentation section it implements; charter section 9; coding-standard rule CS-25 of 07 section 7.5, checked by item CK-CODE-E4 of `docs/templates/peer-review-checklist-code.md` and recorded in the code INSP record), receipt inspection of the delivered assembly (part orientation, solder, markings, enclosure dimensions with calipers) |
| **Demonstration** | Showing that use of the product achieves the requirement; confirmation of capability without detailed data gathering | Owner operates the radio: tunes, keys with a straight key and with paddles, hears sidetone, completes a QSO. Used for functional and human-interface requirements where pass/fail is observable without measurement |
| **Test** | Use of the realized product to obtain detailed data under controlled conditions | Bench measurements with the owner's instruments (section 6), automated firmware tests with recorded numbers (element timing, debounce, state transitions), Pico-based logic capture of key, sidetone, T/R and PA-enable edges, tinySA Ultra spectrum measurements; emulator scenarios contribute event order only (section 5.2) |

Rule: if a requirement states a number with a unit and the number can be measured with an instrument the project will have at TRR, its method is Test. If it states a number that cannot be measured with those instruments, the method is Analysis and the rationale field says why. If it states a capability, the method is Demonstration. If it states a physical or documentary property, the method is Inspection.

**Hazard-tracing requirements.** A requirement traces to a hazard when its own `hazard_ids` is non-empty or when `docs/safety/hazards.json` names it in a hazard's `requirement_ids` or in a control's `control_req_ids` (charter section 7). Every hazard-tracing `REQ-SW-*` is verified by Test (HostUnit, Emulation or Bench per section 5.2); there is no exception (SWE-192; `docs/process/rmm.json` row SWE-192, disposition FC). For firmware a test is always possible: platform-independent logic on the host with the simulated clock, and target timing, peripherals and everything else on the bench with the instruments of section 6.1 (Pico-based logic capture, tinySA Ultra, multimeter); Emulation is supporting evidence except for ordering-only requirements (section 5.2). If the owner ever wants an Analysis alternative for a software hazard control, the RMM row SWE-192 is changed to disposition T with rationale and owner approval before SRR, and this paragraph is amended by CR to cite that row; until then any hazard-tracing `REQ-SW-*` without a Test closing case fails rule 7.3.6. A non-software hazard-tracing requirement (modules SYS, RX, TX, PWR, CTL, ME), which SWE-192 does not govern, uses Test where an instrument of section 6.1 can measure it. When it states a documentary or physical property (content of the operations handbook or another controlled document, a marking or legend on the product, the surface-mount versus hand-solder placement split of the design BOM, CPL and hand-assembly file), its method is Inspection by the rule above, its closing case is an Inspection case (credit row `I`, section 5.2), and its `verification_note` begins `Inspection accepted per CR-002`; no risk is carried, because Inspection verifies such a property completely (CR-002, SRR decision 113, owner ruling 2026-09-26). Otherwise its method is Analysis, its `verification_note` begins `Analysis accepted per RSK-NNN`, and the risk register carries that `RSK-NNN` for the untested hazard control (hazard link rule, `docs/process/06-risk-and-decision-analysis.md` section 3).

---

## 4. Evidence classes (test case `type`)

The `type` field of `docs/test_cases/schema.json` names the form of the product and the environment in which evidence is produced. This is the SE HB §6.1 notion of product form (simulated, breadboard, engineering unit, final unit), collapsed to six classes. Charter section 9 and the schema both name the class Simulation; Analysis is reserved for the verification method (section 3). `05-configuration-and-data-management.md` section 5.3 and `docs/templates/adr.md` section 4.3 use the schema names.

| Class | Product form | Environment and tools | Phase available | Methods it may implement |
|---|---|---|---|---|
| **Simulation** | Model of the design (SE HB §6.1 "simulated") | LTspice batch runs with checker scripts in `hardware/sim/`, Python budgets in `tools/`, S-parameter models; tool versions from `tools/toolchain.lock.md` | B onward; re-run on the CDR design data | Analysis |
| **HostUnit** | Firmware crate `cwht-core` compiled for the host against `cwht-hal-mock` (functional equivalent of a breadboard: function only, not form or platform; crate names per `docs/process/07-software-engineering-plan.md` section 1.2) | `cargo test` (or `cargo nextest run`) in `firmware/`, coverage via LLVM source-based coverage (`cargo llvm-cov`). Unit tests (SWE-062) with the repeatability rules of SWE-186: mocked clock and no wall-clock time, fixed seeds for any randomized input printed on failure, no dependence on test order, one command from `tools/toolchain.lock.md`, pinned toolchain and `Cargo.lock`; the suite runs twice and the two result sets must be identical (07 section 9.2, gate G3). A HostUnit report whose rerun on the same tag differs is a `Procedure-correction` NCR against the test | B onward; re-run on every tagged firmware release | Test (software logic only, see section 5.2) |
| **Emulation** | Whole firmware binary for RP2350 on an emulator (SE HB §6.1 form "simulated"). Not a SWE-073 high-fidelity simulation: the SWE-073 note says a high-fidelity simulation typically has the exact processor, processor performance, timing, memory size and interfaces of the target system, and the emulator does not model time (ADR-011). Optional and secondary (charter section 9, SI-026): scenarios assert event ordering in TIMER0 microseconds and never durations, frequencies or timeouts; credit is limited to the peripherals in the per-peripheral credit scope of the emulator's tool validation record `docs/cm/tool-validation/TV-NNN-emulator.md`, summarized in `tools/toolchain.lock.md` (the accreditation scope statement `ACC-EMU-001`, an `ACC-<TOOL>-NNN` identifier of charter section 6 held inside that TV record, the name ADR-011 and `docs/research/emulator-accreditation-and-timer-irq.md` also use; charter issue C1 of section 18, resolved). No emulator is selected at this date (lock row "RP2350 emulator: not selected"; selection ADR due PDR) | Emulator scenarios in `firmware/emu/` (harness, vendoring form and file format fixed by the PDR emulator ADR, 07 sections 1.2 and 9.4), scripted stimuli on GPIO, timers, serial; if the emulator fails accreditation the 07 section 9.4 item 3 fallback applies (dev-board runs, Bench for timing) | C onward; re-run on every tagged release | Test, Demonstration (event ordering only; never timing; supporting evidence for everything else, section 5.2) |
| **Inspection** | Design data, records, or the delivered assembly | `kicad-cli` ERC/DRC run by its lock path `/Applications/KiCad/KiCad.app/Contents/MacOS/kicad-cli` (`tools/toolchain.lock.md` section 1; it is not on `PATH`), `jsonschema`, `tools/traceability.py`, rendered images, driver-to-datasheet traceability review (CS-25, CK-CODE-E4), calipers and loupe at receipt | Every phase | Inspection |
| **Bench** | The delivered unit (PCBWay assembly, serial `CWHT-A-NNN`) on the owner's bench. Dev-board cases on a bare Pico 2 (07 section 9.1), marked as below, are risk reduction and emulator accreditation reference behavior and never close a requirement | NanoVNA, tinySA Ultra with calibrated attenuator (ADR-021), Pico-based logic capture, 50 ohm BNC dummy load, adjustable bench supply, multimeter (section 6.1); test fixtures printed on the Bambu H2C | D, after TRR (dev-board cases: B onward, no TRR, 01 section 7.1) | Test, Demonstration |
| **OnAir** | The delivered unit in its enclosure, antenna connected, owner operating under 47 CFR Part 97 | Real 2 m band, a second station (friend's radio or the second cwht unit), the owner's straight key and iambic paddle (SI-034) | D, after the emission requirements of section 6.3 are closed and the on-air delta TRR is approved (section 13) | Demonstration |

**Dev-board cases (the setup-line convention named by charter section 3).** Until a schema CR adds a credit field to `docs/test_cases/schema.json`, a case run on a bare Pico 2 development board has `type` Bench and carries, in its `setup`, the line `Article: pico2-devboard-N.` (N is the number written on the board), the line `Credit: false (dev-board run, charter section 3).` and the credit row line `Credit row: SUPPORT.` (section 5.2), plus the `Configuration:`, `Safety:` and `Environment:` lines of rule 7.3.7. Its reports carry `article: pico2-devboard-N` and `credit: false`. A dev-board case is always supporting evidence and never a closing case, whatever its status (rule 7.3.12). It needs no TRR (01 section 7.1). `docs/templates/test_cases.example.json` case `TC-EXAMPLE-006` shows the form.

**Reused components (SWE-211).** Components compiled into the image and not written for cwht are Rust `core` (OSS, shipped with rustc) and the owner's rustos `api` and `pico2` crates (reused from the rustos repository); `docs/process/07-software-engineering-plan.md` section 17.1 is their register, listing the features cwht uses and the cases that exercise each feature. SWE-211 requires them to be tested to the level required to accept custom code. For cwht custom code that level is: requirement-based cases, 100 percent line and region coverage with SWE-189 dispositions, and, for code reached from the safety-critical components of 07 section 14.1, the MC/DC table and the complexity limit of section 12. The reused components meet it as follows:

| Component | Level applied | Evidence |
|---|---|---|
| rustos `api` (traits and types, host-buildable) | Same as custom code: feature cases, plus the section 12 coverage measured in the HostUnit run | `TC-SW-COV-001` report, `api` rows |
| rustos `pico2` (target drivers) | Feature cases (register sequences exercised in Emulation within the accredited scope, on the dev board as supporting evidence, and on the delivered unit); coverage measured where the emulator exports it, otherwise the SWE-190 complementary inspection of every uncovered driver path (section 12); an MC/DC table for every driver decision reached from a 07 section 14.1 component (GPIO, TIMER alarms, PWM, ADC, watchdog, critical section) | `TC-SW-COV-001` report, `pico2` rows and MC/DC tables |
| Rust `core` | Feature level only: every `core` feature the register lists as used has a covering HostUnit or Emulation case; structural coverage and MC/DC of `core` are not measured | Register feature list with covering case IDs. The missing structural coverage is relief from SWE-211, recorded as disposition T in `docs/process/rmm.json` row SWE-211 with owner approval at SRR (alignment item A2); until approved it is listed as proposed tailoring in the SRR package (01 section 3.2 row S6) |

A feature without a covering case is not used; a release whose register has such a feature is not tagged (section 10.5). Auto-generated code (`build.rs` constant-table generators only; no SVD-generated crate is used; RMM row SWE-146, 07 section 17.4) is tested as project code by the same cases. Dev tools that are not embedded (emulator, cargo tools, `picotool`) are validated under SWE-136 by their TV records, not under SWE-211.

**Tool accreditation (SWE-136, SWE-070).** Every class needs an accredited tool set before its output is credit-bearing: `tools/toolchain.lock.md` (configuration item of the CM plan Table 4-1 row 27; maintained by Claude) lists each tool, its version, and the sanity check that was run (LTspice reproduces a known RC response within 1 percent; `kicad-cli` DRC reports a seeded violation; the emulator runs a reference binary and reports the known cycle count; the coverage tool reports 100 percent on a fully exercised reference crate; the NanoVNA reads the dummy load at better than 30 dB return loss across 144 to 148 MHz and an open at 0 dB; the tinySA Ultra reads its internal calibration output within its stated tolerance and the NanoVNA generator level through the attenuator whose S21 was measured that session, ADR-021; the Pico-based logic capture reports the period of a Pico-generated reference pulse train within one sample). A report produced with an unlisted tool version is not accepted. Prerequisites per class, each recorded with its version, install source and path in `tools/toolchain.lock.md` before any credit-bearing run (the lock is the single record of tool state; this document restates none of it): coverage needs the `cargo-llvm-cov` binary and the LLVM tools, both with the tool validation record `docs/cm/tool-validation/TV-NNN-cargo-llvm-cov.md`; Inspection needs `kicad-cli` at its lock path; Simulation needs the LTspice batch wrapper `tools/ltspice-batch.sh` (ADR-018; committed at `41d150e` with the known-answer tests `tools/tests/test_ltspice_batch.py`; tool validation record `docs/cm/tool-validation/TV-014-ltspice-batch.md`, not accredited on 2026-09-27), accredited before the first Simulation case becomes `Active` (PDR); Emulation needs the emulator selected by the PDR ADR and its TV record with the per-peripheral credit scope; Bench needs the tinySA Ultra TV record of ADR-021 and a TV record for the Pico-based logic capture, both before the TRR that opens the campaign using them. A tool absent from the lock, or listed without an accredited TV record, produces developer evidence only (CM plan section 9.1). MC/DC follows `docs/process/07-software-engineering-plan.md` section 9.6 and section 12 of this document: no accredited Rust MC/DC instrumentation exists at this date, so independently reviewed independence-pair tables plus stable-toolchain line and region coverage (MSR-13) plus nightly branch and condition coverage (MSR-14) are the Rev A method (RMM row SWE-219, disposition T). Nightly toolchains are not permitted for release or credit-bearing evidence builds; MSR-14 on the pinned nightly is a required, non-credit measure (`tools/toolchain.lock.md` section 1; charter section 10).

---

## 5. When verification credit is taken

### 5.1 Principles (charter section 9)

1. **Run for the record is on the delivered unit.** SE HB §6.1: run-for-record verification is usually performed on the final controlled unit, credit on lower-fidelity units needs explicit project approval and a likeness argument (the unit is sufficiently like the final unit in the areas verified), and buying off a "shall" on a prototype is typically not acceptable. On cwht the approved lower-fidelity credit is limited to the section 5.2 software rows (HostUnit; Emulation for ordering-only requirements); the likeness argument is the platform-independence statement in each case's `setup` field and the approval is the owner's PDR approval of the V&V plan (section 14). The cwht Unit 1 (`CWHT-A-001`) is an engineering unit that becomes the final product (SE HB §6.1 permits this when traceability over components and handling is kept; `docs/vv/adp/CWHT-A-001/as-built.md`, the unit as-built record of the CM plan Table 4-1 row 38, holds that record).
2. **Analysis closes only requirements whose method is Analysis.** A Simulation case against a Test-method requirement is risk reduction (SI-010, "must work at first power-on") and is listed as supporting evidence in the matrix, but the requirement stays `Active` until the Bench or software Test runs.
3. **Pre-build software evidence closes software requirements only under section 5.2.** Otherwise it too is supporting evidence.
4. **Inspection closes at the point the inspected item is baselined:** design-level inspections (DRC, ERC, schema, traceability) at CDR on the product baseline; as-built inspections at receipt of the unit; document inspections at the review that baselines the document.
5. **Analysis credit is taken at CDR and confirmed at SAR.** The analysis must use the CDR design data (final part values, layout parasitics where modeled). At SAR the physical configuration audit (charter section 8) confirms the as-built values match; if a CR changed an analyzed value after CDR, the analysis is re-run before SAR.

### 5.2 Credit rules by method

**Firmware release identification.** A credit run on software uses a tagged, released commit with a version description: tag `release/FW-vX.Y.Z` with `firmware/releases/VDD-vX.Y.Z.md`, or a release candidate `release/FW-vX.Y.Z-rcN` with its own VDD `firmware/releases/VDD-vX.Y.Z-rcN.md`, per the CM plan `docs/process/05-configuration-and-data-management.md` sections 4.3, 7.3 and 8.1 (SWE-187). Reports record the version as `vX.Y.Z+<short SHA>` in `firmware_version`. (`docs/process/01-lifecycle-and-reviews.md` sections 2 and 7.3 and `07-software-engineering-plan.md` sections 3 and 13 use the same identifiers; the CM plan is authoritative for identifiers, charter section 8.)

**Credit row line.** Every case states which row below applies in one `setup` line `Credit row: <key>.`, using the key of the first column; for keys `T-SW-LOGIC` and `T-SW-ORDER` the line is followed by the likeness argument (why host or emulator execution is representative). A case that closes some of the requirements it cites and supports others carries the key of its closing row; the method rule makes it supporting for the rest. The procedure reviewer checks the key (section 8.3 item 2), and the planned tool check `CLOSING_CLASS` reads it (rule 7.3.3).

| Row key | Requirement `verification_method` and kind | Closing case (`verification_method` equal to the requirement's, `type` in this column) | Supporting evidence only | Credit event |
|---|---|---|---|---|
| `A` | Analysis | Simulation | Bench measurement that corroborates the analysis (recorded as a Test case against a companion Test requirement, or as an `expected_artifacts` plot in the analysis report) | CDR run on product baseline; confirmed at SAR |
| `I` | Inspection | Inspection | none | CDR (design data), receipt (as-built), baselining review (documents) |
| `T-HW` | Test, hardware or system requirement (module SYS, RX, TX, PWR, CTL, ME) | Bench on the delivered unit | Simulation, HostUnit, Emulation, dev-board cases | TRR-authorized Bench run on `CWHT-A-001`, witnessed by owner |
| `T-SW-LOGIC` | Test, software requirement (module SW, SW-<SUB>), platform-independent logic | HostUnit | Simulation; Emulation (event ordering); dev-board cases | The credit run on a tagged release (SWE-187) whose VDD names it: the requirement becomes `Verified` on that report (section 5.3; charter section 9). It becomes `Closed` only when, in addition to the section 5.3 Closed conditions, the PCA-05 line of a delivered unit's `docs/vv/adp/<unit>/as-built.md` names that release (rule 7.3.4, `CLOSED_NOT_INSTALLED`). On a later release the requirement keeps `Verified` while that release's regression report `TC-SW-REG-001-r<N>.md` (section 10.5) has `credit: true` and `result: Pass`; it returns to `Active` when that report fails or is missing |
| `T-SW-TARGET` | Test, software requirement that depends on target timing, peripherals, interrupts, DMA, clocks or power states | Bench (Pico-based logic capture, tinySA Ultra, multimeter; section 6.1) | HostUnit with the simulated clock, Simulation, Emulation (event ordering only, accredited scope), dev-board cases | TRR-authorized Bench run on `CWHT-A-001`, witnessed by the owner, on the tagged release named in the VDD; `Closed` needs the PCA-05 line as in `T-SW-LOGIC`. Installing a later release on the unit returns the requirement to `Active` until its Bench case has a credit report on that release, unless that release's regression selection (section 10.5, recorded in its `TC-SW-REG-001` report) shows that the requirement's `design_refs` are untouched and the rustos commit is unchanged, in which case the credit carries forward |
| `T-SW-ORDER` | Test, software requirement that states only an event order (for example, PA-enable rises only after the T/R command and the settle event) | Emulation, only for peripherals inside the emulator TV record scope (ADR-011, 07 section 9.4); otherwise Bench | HostUnit, Simulation | As `T-SW-LOGIC`; if the emulator is not accredited at PDR (07 section 9.4 item 3 fallback, recorded in the PDR decision memo) the case is re-typed Bench by CR with key `T-SW-TARGET` and the emulator run is `credit: false` |
| `D` | Demonstration | Bench or OnAir on the delivered unit | Emulation demonstration, dev-board cases | Owner-operated run on the delivered unit |
| `SUPPORT` | any | never closing | A case whose `verification_method` differs from the requirement's; every dev-board case (section 4) | none |
| `VAL` | validation (module `VAL`) | never closes a requirement; its result sets the validation rows (section 7.2) | none | the gate named by its `Phase:` line |

"Platform-independent logic" means the requirement can be stated and checked entirely in terms of the inputs and outputs of a Rust module behind the HAL trait boundary, with time supplied by a mocked clock. Keyer element timing, iambic mode logic, straight-key debounce state machine, menu and tuning-step logic, and command sequencing (SWE-134 e, h) qualify. GPIO edge latency, PA-enable-to-RF timing, ADC sampling and encoder interrupt handling do not; they close at Bench with the Pico-based logic capture (row `T-SW-TARGET`). Emulation rule (charter section 9, SI-026, ADR-011): an Emulation scenario expresses time only in TIMER0 microseconds and asserts order, never a duration, frequency or timeout; a scenario that asserts a duration is a `Procedure-correction` NCR against the case.

### 5.3 Status semantics

Test case `status` (schema enum): `Draft` (written, not reviewed) → `Active` (reviewed per section 8.3, ready to run) → `Passed` or `Failed` (result of the most recent run-for-record) or `Blocked` (cannot run: instrument absent, prerequisite NCR open, TRR not held). A `Failed` case returns to `Active` only when its NCR is dispositioned and retest is authorized (section 10). A retired case is status `Blocked` with a `setup` that starts `Retired by ` (02 section 11.3); it is excluded from closing and supporting counts.

Requirement `status` (schema enum):

- `Draft` → `Active` (baselined at SRR for L1, PDR for L2).
- `Verified`: every live closing case (section 7.1: not retired, not a dev-board case, not a `TC-VAL` case, row key a closing key of section 5.2) is `Passed` with a report whose front matter has `credit: true` and `result: Pass`; for `REQ-SW-*` that report's `firmware_version` is a release tag named in its VDD, and on a later release the row rule of section 5.2 holds; no NCR with status other than `Closed` cites the requirement (rule 7.3.4).
- `Closed`: `Verified`; the validation rows that depend on it (rows of the `TC-VAL` cases that cite it) are `Validated`; the Bench smoke set of section 11.2 stages 4 to 6 is `Passed` on the delivered unit; the owner has accepted at SAR (`docs/reviews/SAR/decision-memo.md` exists, and the status change is made in the commit that records the signed memo, 01 section 8.4 row 5); and, for `REQ-SW-*`, the PCA-05 line of a delivered unit's `docs/vv/adp/<unit>/as-built.md` names the release of the credited report (charter section 9). The PCA-05 line reads `Installed release: vX.Y.Z+<short SHA>; picotool verify match; YYYY-MM-DD`; Claude writes it the day the owner flashes the unit at section 11.2 stage 4 (CM plan section 7.2 row PCA-05 and section 8.3 item 2).
- Retired: status `Closed` with tag `retired` and a `rationale` that starts `Retired by ` (charter section 6; 02 section 11.3). A retired requirement gets no matrix row (it is listed in the report's retired list), is exempt from the `Verified` and `Closed` checks of rule 7.3.4, and a live case that cites it fails rule 7.3.2.

Claude updates the JSON the day a report is filed; `tools/traceability.py` fails when a status does not match the evidence on disk (rules 7.3.2 to 7.3.4; implementation status in section 7.4).

---

## 6. Owner's instruments and their limits

The owner has (charter section 9): a NanoVNA, a 50 ohm BNC dummy load and an adjustable bench supply (SI-013); a tinySA Ultra spectrum analyzer with a calibrated 30 to 40 dB attenuator rated 10 W or more (purchase committed by the owner in SI-034 and decided in ADR-021, Accepted 2026-09-25; OQ-VV-001 closes when the receipt is recorded by the receipt inspection report `docs/vv/reports/receipt-inspection-<n>.md` plus the tinySA TV record `docs/cm/tool-validation/TV-NNN-tinysa.md` before TRR, charter section 9; ADR-021 stays the purchase decision); a Pico-based logic capture, planned (a second Pico 2 running the sigrok-pico capture firmware, read by `sigrok-cli`; ADR-009 records it as proposed; `sigrok-cli` and the sigrok-pico capture firmware are not installed, and `tools/toolchain.lock.md` section 1 carries a row for each with its TV record due TRR, alignment item A13, resolved); and a multimeter (named in charter section 9 and ADR-021 but in no stakeholder input; OQ-VV-003). There is no oscilloscope, RF power meter, frequency counter or calibrated signal generator. The tinySA Ultra and the logic capture are credit-bearing only after their tool validation records exist (section 4; `docs/cm/tool-validation/TV-NNN-tinysa.md`, `TV-NNN-logic-capture.md`) and are named in `tools/toolchain.lock.md`; a case that needs an instrument not yet in hand is `Blocked` with the instrument named.

### 6.1 What the bench can measure

| Instrument | Credit-bearing measurements | Conditions recorded in every report |
|---|---|---|
| NanoVNA | Return loss and SWR at the antenna port (TX off), S21 of the receive and transmit filter paths through test connectors, antenna match, impedance of matching networks; frequency of a passive resonance; S21 of the tinySA attenuator (fixture characterization) | Calibration (SOL or SOLT) performed at the start of the session on the cable end used, verified against the dummy load; frequency span and points |
| tinySA Ultra with calibrated attenuator (ADR-021) | Spurious and harmonic level at the antenna port through the attenuator into the dummy load, span 9 kHz to 1.5 GHz, 2f, 3f and 7f reported individually against the 47 CFR 97.307(e) limit of 25 uW (-16.02 dBm) at 5 W (design target -23 dBm, ADR-022); band-edge power at 144.000 and 148.000 MHz at the narrowest RBW; transmitter output power as the secondary check of the diode-probe measurement (section 6.2); receiver birdie and clock-harmonic scans with a near-field probe. Not credit-bearing: the close-in keying spectrum (26 dB bandwidth, sideband offsets), which stays Analysis unless the TV record shows the RBW adequate (ADR-021, ADR-023) | Attenuator S21 at the measured frequencies from a NanoVNA sweep performed that session (value and file in `artifacts`); internal calibration check result; RBW, span, reference level and detector; instrument firmware version per `tools/toolchain.lock.md` |
| Pico-based logic capture (planned, ADR-009) | Timestamps and durations of digital edges on key, paddle, sidetone, TX_KEY, T/R command and PA_EN lines: key-to-PA_EN latency, T/R sequencing order and intervals, keyer element and gap lengths at 5, 15, 25 and 50 WPM, debounce make and break times, firmware ramp-step timing of the keying envelope | Sample rate, channel map, capture firmware version per `tools/toolchain.lock.md`, and the reference pulse train check of that session |
| Multimeter | DC rail voltages, quiescent and operating supply currents (with the bench supply readout as cross-check), resistances and continuity before first power-on, audio output level as AC RMS on a steady 700 Hz sidetone, battery voltage and charge current, peak volts of the diode RF probe | Range, and the meter's specified accuracy for that range from its datasheet, copied into the report |
| Multimeter thermocouple input (only if OQ-VV-003 confirms it) | PA heatsink and enclosure surface temperature for the thermal-rise case and the PA thermal stop criterion of `docs/safety/hazard-analysis.md` (HZ-003 controls K1 and K7); credit-bearing after its TV record | Probe type, range and the meter's datasheet accuracy for the temperature function; ambient reading at the start of the session |
| 3.3 V USB-to-UART adapter (planned; or a second Pico 2 as a UART bridge) | UART trace on the unit's UART test pads: reset reason, fault codes and event markers that the TC-SYS fault-build and safe-state cases read (TC-SYS-005, 082, 108 to 110) | Adapter model or bridge firmware version, port settings and the capture file name; credit-bearing only after its TV record (tool validation route of 05 §13, due PDR) and its fixture record `docs/vv/fixtures/uart-adapter.md` (before TRR) |
| Bench supply | Supply voltage, current limit, current draw in receive, transmit and sleep | Voltage and current-limit settings before each step |
| Dummy load | Termination for every transmit test; heat-sink temperature by touch is not a measurement | Load rating and duty limit |
| Calipers and scale | Enclosure and PCB dimensions, mass (OQ-VV-002); until OQ-VV-002 is closed, dimension and mass cases are `Blocked` with this row named | none |

### 6.2 What the bench measures indirectly or cannot measure, and the method for each

Each row names one closing method, which is the requirement's `verification_method`; the other evidence of the row is recorded as supporting cases or as data inside the closing report, never as a second closing case (section 3). Where a row needs two closing methods, the requirement is split into the companion requirements named.

| Quantity (requirement kind) | Limitation of section 6.1 | Closing method (row key of section 5.2) | Other evidence (supporting) |
|---|---|---|---|
| RF output power at the antenna port (SI-003, 5 W) | No power meter | Test (`T-HW`): a diode RF probe (1N5711 or equivalent, printed housing) reading peak volts on the multimeter across the dummy load, P = Vpk^2 / 100; probe built and characterized against the NanoVNA on the dummy load per the RF probe characterization case (module `SYS`, `docs/test_cases/sys/test_cases.json`; id allocated at authoring per 02 section 11.1; written by CDR, `Passed` before TRR). The requirement closes on the probe reading with its stated uncertainty (expected 10 to 15 percent); its tolerance must exceed that uncertainty (checklist 8.3 item 3) | The tinySA Ultra reading through the calibrated attenuator (ADR-021 item 3) and the DC input power times the Analysis PA efficiency as a bound, recorded in the same report; a probe and tinySA disagreement beyond their combined uncertainty is a `Procedure-correction` NCR |
| Spurious and harmonic emissions (47 CFR 97.307(e)) | None since ADR-021 | Test (`T-HW`) on the tinySA Ultra through the calibrated attenuator into the dummy load (section 6.1 row), at every power step across the band | LTspice harmonic content of the PA combined with the NanoVNA-measured filter S21: the pre-build prediction band (Simulation) and the TRR entrance evidence of 01 section 7.3 row 8 |
| Band-edge emission at 144.000 and 148.000 MHz (47 CFR 97.305, ADR-016, ADR-023) | None for the power reading; the RBW adequacy is confirmed in the TV record | Two companion requirements: the emission requirement closes by Test (`T-HW`) on the tinySA Ultra at the narrowest RBW (ADR-021 item 2); the frequency-reference tolerance and guard requirement of ADR-023 closes by Analysis (`A`, drift budget) | none |
| Transmit frequency accuracy and drift | No counter or reference receiver; the tinySA Ultra marker is limited by the instrument's own reference accuracy | Analysis (`A`) of the TCXO and synthesizer budget (ADR-023). If the TV record shows the tinySA reference accuracy better than one fifth of the requirement tolerance, Claude proposes a CR changing the method to Test at the TRR that accredits the instrument and the owner decides it in that memo | The tinySA marker reading, recorded in the Analysis report as data; the on-air net-frequency comparison with a second station as a `TC-VAL` case (row key `VAL`) |
| Keying envelope rise and fall time, click suppression (47 CFR 97.307(a), (b); ADR-023) | No oscilloscope: the analog RF envelope cannot be captured | Companion requirements: the firmware ramp-step timing (`REQ-SW-*`) closes by Test (`T-SW-TARGET`, logic capture on the PWM or DAC step edges); the analog envelope shape and the 26 dB bandwidth close by Analysis (`A`, shaping network and envelope FFT; ADR-021, ADR-023), or by Test (`T-HW`) only after a CR when the tinySA TV record shows the RBW adequate | tinySA max-hold trace when the RBW allows (supporting); "no clicks reported" by the second station as `TC-VAL` evidence |
| T/R switching time, PA-enable sequencing time (ADR-010) | No oscilloscope for the RF envelope | Companion requirements: the firmware sequencing time (`REQ-SW-*`) closes by Test (`T-SW-TARGET`, logic capture of key, TX_KEY, T/R command and PA_EN edges); the relay or PIN-switch delay closes by Analysis (`A`, datasheets) | An Emulation ordering scenario (section 5.2) |
| Receiver sensitivity (MDS), selectivity, image rejection | No calibrated signal generator (the tinySA Ultra generator output is not adopted as a level reference by ADR-021; adopting it needs a superseding ADR and a TV record) | Analysis (`A`): noise figure and filter budgets | Reception of a known weak station as a `TC-VAL` case (MOE-010) |
| Receiver internal spurious responses (birdies, clock harmonics) | None since ADR-021 | Test (`T-HW`) with the tinySA Ultra and a near-field probe over the board (ADR-021 item 4) | Tuning across the band with the antenna port terminated, as a supporting Demonstration case |
| Receiver and audio frequency response | No generator | Companion requirements: each passive filter path response closes by Test (`T-HW`, NanoVNA S21); each DSP stage response (`REQ-SW-*`) closes by Test (`T-SW-LOGIC`, HostUnit); the end-to-end chain response closes by Analysis (`A`) combining the two | none |
| Thermal rise of the PA and enclosure (HZ-003) | Depends on OQ-VV-003 | If OQ-VV-003 confirms a thermocouple input: Test (`T-HW`), 5 min key-down into the dummy load inside the enclosure with the NTC logged and the surface temperature read on the thermocouple (hazard analysis PA thermal limit; RSK-006 step S4). If not: Analysis (`A`, thermal budget) with a `verification_note` beginning `Analysis accepted per RSK-006` (rule 7.3.6) | If not: the Bench key-down run with NTC telemetry as a supporting case; alignment item A11 replaces the hazard-analysis stop criterion with an NTC-telemetry limit |
| Battery capacity and charging cutoff | Measurable | Test (`T-HW`): bench supply and multimeter | none |

Each L1 or L2 requirement in the rows above carries a `verification_note` that names the instrument or the alternative from this table (for the regulatory `REQ-TX-*`: the tinySA Ultra with attenuator, per ADR-021 section 4.1). The test author may not assign method Test to such a requirement unless the note names an instrument of section 6.1 that will be accredited at TRR.

### 6.3 Instrument decisions, open questions and contingency

The tinySA Ultra purchase is decided by ADR-021 (Accepted 2026-09-25; owner decision SI-034 transcribed in ADR-021 section 6): the spurious, band-edge and output-power requirements carry method Test on the Bench as in section 6.2. The attenuator and any tap are in the fixture list `docs/vv/fixtures/`; the instrument's version, firmware and known-answer check are in `tools/toolchain.lock.md` and its TV record (section 4) before the TRR that opens the emission campaign, which also confirms the RBW for the band-edge case (ADR-021 revisit conditions). The delivery lead time of the instrument does not block CDR because Bench testing begins only after vendor delivery of the unit.

| Open question | Question | Decided by, when | Closure record | Effect until closed |
|---|---|---|---|---|
| OQ-VV-001 | Is the tinySA Ultra with its attenuator in hand? | Owner; before the TRR that opens the emission campaign | Receipt inspection report `docs/vv/reports/receipt-inspection-<n>.md` plus the tinySA TV record `docs/cm/tool-validation/TV-NNN-tinysa.md` (charter section 9; ADR-021 stays the purchase decision; charter issue C2 of section 18, Resolved) | Emission cases `Blocked` |
| OQ-VV-002 | Does the owner have calipers and a scale (SI-013 does not list them)? | Owner; at PDR | New stakeholder input entry, or the items added to the fixture list | Dimension and mass cases `Blocked` |
| OQ-VV-003 | Which multimeter does the owner have (model, ranges, datasheet), and does it have a thermocouple input? SI-013 lists no multimeter; charter section 9 and ADR-021 name one | Owner (Robin); at PDR | New stakeholder input entry; if a thermocouple input exists, the section 6.1 row becomes credit-bearing after its TV record and the thermal row of section 6.2 is Test | The thermal case is not authored until the answer fixes its method (section 6.2 thermal row) |

- **OnAir authorization (required before every first antenna-connected transmission, 01 section 7.6 (c)):** a section of the decision memo of the on-air delta TRR, `docs/reviews/TRR-Dn/decision-memo.md`, in which the owner confirms that every regulatory `REQ-TX-*` case is `Passed` on the delivered unit with `credit: true` reports, names the tinySA report for the spurious and band-edge cases, and, only in the contingency below, accepts the residual risk of an emission requirement closed by Analysis.
- **Contingency (the tinySA Ultra fails its known-answer check, or its RBW is inadequate for the band-edge case; ADR-021 section 7):** the affected cases run on a **borrowed instrument** (a club or friend's spectrum analyzer or oscilloscope), acceptable for any Test when the report records the instrument model, serial, and the owner's confirmation of its calibration state, at the same delta TRR. If no instrument is available before the on-air series, the affected regulatory requirement changes method to Analysis by a `CR-NNN` (the 06 section 14.1 class 1 (g) trade, owner decision), the OnAir authorization carries the owner's residual-risk acceptance on the strength of the filter Analysis and the measured filter S21, and `RSK-011` (spurious emissions not credibly measured before on-air use) stays open in the register until a measurement is obtained or the owner closes it with rationale.

---

## 7. Matrices and `tools/traceability.py`

The charter (section 5) makes `tools/traceability.py` the generator of both matrices from the requirements and test cases. It reads the inputs listed in `tools/README.md` (requirements, stakeholder inputs, expectations, ConOps scenarios, test cases, hazards, the risk register, `docs/plan/tpm.json`, the regulatory corpus, ADRs, trade studies, the front matter of every `docs/vv/ncr/NCR-*.md` and `docs/vv/reports/TC-*-r*.md`, and the existence of `docs/reviews/SAR/decision-memo.md`) and writes `docs/vv/traceability-report.md` and `docs/vv/traceability.json`. It enforces the rules of section 7.3 and exits non-zero on any violation, so that a review package cannot be assembled over a broken trace; section 7.4 states which rules are implemented today, who implements the rest, and by which gate. Run it as `.venv/bin/python tools/traceability.py` (the file is not executable).

### 7.1 Requirements verification matrix (SE HB App. D, Table D-1)

One row per live requirement. A retired requirement (status `Closed` with tag `retired`, section 5.3) gets no row and appears only in the retired list. Columns, with the App. D column they implement and the source field:

| Column | App. D column | Source |
|---|---|---|
| Requirement ID | Requirement No. | `id` |
| Source document | Document, Paragraph | file path of the `requirements.json`; `parent_id`; `source_ids` |
| Shall statement | Paragraph Text | `description` |
| Success criteria | Verification Success Criteria | `acceptance_criteria` of each closing case, concatenated |
| Method | Verification Method | `verification_method` |
| Evidence class | (cwht addition) | `type` of each closing case |
| Closing cases | (cwht addition) | live case IDs whose `verification_method` equals the requirement's and whose `Credit row:` key is a closing key for the requirement's module and the case's `type` per section 5.2; retired, dev-board and `TC-VAL` cases are never closing |
| Supporting cases | (cwht addition) | every other live case citing the requirement |
| Facility | Facility or Lab | `owner bench`, `host`, `emulator`, `simulation`, `on air`, `inspection`, derived from `type` |
| Phase | Phase | credit event per section 5.2: `CDR`, `receipt`, `release`, `TRR`, `TRR-Dn`, `SAR` |
| Acceptance requirement? | Acceptance Requirement? | `Yes` if any `TC-ATP-NNN` case cites the requirement (section 11) |
| Recurring acceptance? | Preflight Acceptance? | `Yes` if the requirement is cited by a `TC-ATP-NNN` case and the ATP is repeated per unit |
| Performer | Performing Organization | `owner` for Bench and OnAir, `claude` otherwise |
| Results | Results | latest report path with `credit: true`, its `result`, and any `NCR-NNN` citing the requirement |
| Status | (cwht addition) | `status`, cross-checked against the reports |

### 7.2 Validation matrix (SE HB App. E, Table E-1)

One row per `OPS-NNN` scenario and per `MOE-NNN`. Columns:

| Column | App. E column | Source |
|---|---|---|
| Validation product | Validation Product # | `OPS-NNN` or `MOE-NNN` |
| Activity | Activity | `title` of each `TC-VAL-NNN` whose `setup` contains `Validates: ... <this ID> ...` |
| Objective | Objective | `acceptance_criteria` of those cases |
| Method | Validation Method | `verification_method` of those cases |
| Facility | Facility or Lab | derived from `type` |
| Phase | Phase | token after `Phase:` in the case `setup` (mandatory, section 1) |
| Performer | Performing Organization | `owner` (and named friends for OnAir group scenarios) |
| Requirements exercised | (cwht addition) | `requirement_ids` of the cases, so that a failed validation can be traced to the requirements that need a CR |
| Results | Results | latest report path and `result`; row status `Validated` when every `TC-VAL` case naming the row is `Passed`, `Open` otherwise, `No case` when none names it |

### 7.3 Rules the tool enforces (charter section 7 plus V&V additions)

1. Unique IDs across all requirements and cases; module prefix of every case ID equals the file's `module`. Files under `docs/templates/` are never read (the tool globs `docs/test_cases/**/test_cases.json` only).
2. Every requirement has a parent or a self-derived rationale; every `Draft` or `Active` requirement has at least one closing case; every case cites at least one existing requirement. A live case that cites a retired requirement fails. A retired case (status `Blocked`, `setup` starting `Retired by `) is excluded from closing and supporting counts and, when it cites a live requirement, names its superseding case (`superseded by TC-...`) (02 section 11.3).
3. A case is closing only when its `verification_method` equals the requirement's and its `Credit row:` key is a closing key of section 5.2 for the requirement's module and the case's `type`: `A` with Simulation, `I` with Inspection, `T-HW` with Bench for modules SYS, RX, TX, PWR, CTL and ME, `T-SW-LOGIC` with HostUnit, `T-SW-TARGET` with Bench and `T-SW-ORDER` with Emulation or Bench for modules SW and SW-<SUB>, `D` with Bench or OnAir. Every other citing case is flagged supporting in the matrix. `TC-VAL` cases are never closing.
4. A requirement with `status: Verified` meets the `Verified` conditions of section 5.3: for every closing case a report with `credit: true` and `result: Pass` (for `REQ-SW-*`, on a release tag with a VDD, and on a later release the section 5.2 row rule), and no NCR with status other than `Closed` cites it. A requirement with `status: Closed` also meets the `Closed` conditions of section 5.3: dependent validation rows `Validated`, the SAR decision memo present, the Bench smoke set of section 11.2 stages 4 to 6 `Passed`, and for `REQ-SW-*` the PCA-05 line naming the credited release. Retired requirements are exempt.
5. Every `TC-VAL-NNN` case names at least one existing `OPS-NNN` or `MOE-NNN` after `Validates:` and one token after `Phase:` in its `setup` (section 1).
6. Every hazard-tracing `REQ-SW-*` (section 3: own `hazard_ids` non-empty, or named in `docs/safety/hazards.json` in a hazard's `requirement_ids` or a control's `control_req_ids`) has a closing case of method Test (SWE-192; no exception). Every other hazard-tracing requirement has a closing case of method Test; or has method Inspection, a closing Inspection case and a `verification_note` beginning `Inspection accepted per CR-002` (a documentary or physical property, section 3; CR-002, SRR decision 113); or has method Analysis and a `verification_note` beginning `Analysis accepted per RSK-` naming a risk that exists in `docs/risk/register.json`. A disagreement between `hazards.json` and a requirement's `hazard_ids` (`HAZARD_INVERSE`) blocks the readiness declaration of every gate.
7. Bench and OnAir cases have an `instruments` list drawn from section 6.1 (which includes the tinySA Ultra of ADR-021), or for OnAir from the second station and keys of the section 4 OnAir row, and a `setup` containing the lines `Article:`, `Configuration:`, `Safety:` and `Environment:`.
8. Every report matching `docs/vv/reports/TC-*-r*.md` has front matter whose `test_case` exists, whose `requirement_ids` are a subset of that case's `requirement_ids`, and, for a `TC-VAL` case, whose `validates` list is a subset of the tokens after `Validates:` in the case's `setup`; every NCR's `test_case_ids`, `retest_cases`, `regression_cases`, `requirement_ids` and `hazard_ids` exist; every entry of an `artifacts` list in a report or NCR names a file that exists with the listed SHA-256. Files in `docs/vv/reports/` that do not match `TC-*-r*.md` (`vv-report.md`, `part97-compliance.md`, `receipt-inspection-<n>.md`) carry no case front matter and are not read.
9. Software requirements to non-conformances (NPR 7150.2D §3.12.1 Table 1, Class A): the report lists, per `REQ-SW-*`, every NCR that cites it.
10. `tools/traceability.py --regression <design_ref...>` prints the regression set of section 10.5 (every `Passed` Bench case whose requirements' `design_refs` intersect the arguments, plus every `TC-ATP-NNN` case).
11. Test and verification procedures stay consistent with the requirements (SWE-071): a live case whose status is `Active`, `Passed` or `Failed` and that cites a requirement whose `description`, `verification_method`, `verification_note` or `tbr` changed in a commit later than the commit in which the case last became `Active` is flagged `CASE_STALE`; the case returns to `Draft` under section 8.2.
12. A case whose `setup` carries `Article: pico2-devboard-` is never closing, and it fails when its `setup` lacks `Credit: false` or carries a `Credit row:` key other than `SUPPORT` (`DEVBOARD_CASE_CLOSING`; section 4).

The output `docs/vv/traceability-report.md` has sections: summary counts and closure burndown (requirements by status, cases by status, NCRs by severity and status), verification matrix, validation matrix, rule violations, and the requirement-to-NCR list. It is an entrance product of every review (charter section 7) and its closure percentages are TPMs in `docs/plan/tpm.json`.

### 7.4 Implementation status of the tool (charter rule 11.2: evidence, not assertion)

Re-observed on 2026-09-27 at `main` `7bb994f` (`tools/traceability.py` blob `12de3545`, committed at `c774851` under CR-002 step 5), in a clean worktree of that commit, by reading the tool and running the commands below from the worktree root (CR-013; INSP-021 finding-4). The first observation, on 2026-09-25 at commit `b8214ca` with the tools untracked, found 258 tests; it is kept in the git history of this file. The tool changes of CR-011 (`docs/cm/cr/CR-011-traceability-pdr-rules.md`, Submitted 2026-09-27; branch `cr/CR-011-traceability-pdr-rules`, tool blob `d4cde9f5`, TV-002 runs 6 and 7) are not on `main` at this observation; the table below names them in the "Open task" column, and each such row reads "yes" from the CR-011 merge.

| Command | Observed result |
|---|---|
| `.venv/bin/python tools/traceability.py --help` | Options `--root`, `--output`, `--json`, `--report-only`, `--quiet`, `--render`, `--regression DESIGN_REF [DESIGN_REF ...]` |
| `.venv/bin/python -m unittest discover -s tools/tests` | 461 tests in 16 test files, 16 skipped, 1 failure: `test_validate_docs.RepositoryTests.test_repository_exit_zero`, because `tools/validate_docs.py` fails one record at that commit (`docs/reviews/SRR/checklists/tool-validation-tv-001-to-tv-010.md`, record drift against a changed product blob; a repository-content test, not a tool defect, cleared by that record's delta iteration). Every known-answer class of `tools/traceability.py` passes. This row is re-observed for every gate package |
| `.venv/bin/python tools/traceability.py --root tools/tests/fixtures/valid_project --output <scratch path> --quiet` | exit 0, no findings |
| `.venv/bin/python tools/traceability.py --root tools/tests/fixtures/invalid_project --output <scratch path> --quiet` | exit 1, seeded violations reported |

Outputs: `docs/vv/traceability-report.md` and `docs/vv/traceability.json` (beside the report unless `--json` names another path). Front matter: `parse_front_matter` in `tools/validate_docs.py` uses PyYAML (`yaml.safe_load`; PyYAML 6.0.3 in the venv, listed in `tools/requirements.txt`) and falls back to the subset parser `parse_front_matter_subset` when PyYAML is absent or rejects the block; the subset parser reads scalars, inline `[a, b]` lists, block lists of scalars and of flat maps, and strips full-line and trailing `#` comments. Keys read today: reports `test_case`, `run`, `requirement_ids`, `validates`, `credit`, `result`, `date`, `ncr_ids`, `artifacts`; NCRs `id`, `title`, `status`, `severity`, `requirement_ids`, `test_case`, `test_case_ids`, `retest_cases`, `regression_cases`, `hazard_ids`, `artifacts`. Every other front matter field is checked by the procedure reviewer against its template (section 9).

Owner of every open row: Claude as software lead. Each open row is a tool task listed in the package of the gate named, and the gate's readiness declaration is blocked until its unit test passes on the fixtures under `tools/tests/fixtures/` (`tools/toolchain.lock.md` section 1.1).

| Rule | Implemented today | Check codes today | Open task (planned code) | Due |
|---|---|---|---|---|
| 7.3.1 | yes | `ID_DUPLICATE` (across files and within one file), `MODULE_MISMATCH`, `MODULE_DUPLICATE`, `ID_FORMAT` | none | done |
| 7.3.2 | yes, except the retired list | `PARENT_MISSING`, `PARENT_UNRESOLVED`, `PARENT_CYCLE`, `REQ_UNVERIFIED`, `REQ_NO_CLOSING_CASE`, `TC_REQ_UNRESOLVED`; retirement detected by the charter section 6 marker (requirement `Closed` with tag `retired`; case `Blocked` with `setup` starting `Retired by `), retired entries excluded from the verification checks and the matrix and counted in the summary; `RETIRED_INCONSISTENT` for a live case citing a retired requirement, a live child, a missing `Retired by ` prefix, a missing superseding case | List of retired requirements and cases in their own report section (02 section 11.3 item 4, T-19): report section 13 of CR-011 | PDR (re-dated from "before SRR" in line with 02 section 8.5 row T-19; the SRR report `docs/reviews/SRR/traceability-report.md` gives the retired count, 2 requirements, without the list) |
| 7.3.3 | partly | Matrix columns `Closing cases` and `Supporting cases` selected by `verification_method` only; `TC_TYPE_METHOD` (the `type` is an evidence class of the method) | Closing-class filter: the `Credit row:` key of section 5.2 must match the requirement's module and the case `type`, and `TC-VAL` cases are never closing (`CLOSING_CLASS`); until it exists the procedure reviewer checks section 8.3 item 2 by hand | CDR |
| 7.3.4 | partly | `VERIFIED_WITHOUT_EVIDENCE`, `VERIFIED_WITH_OPEN_NCR`, `TC_STATUS_EVIDENCE`, `CLOSED_WITHOUT_SAR` (a `Closed` requirement while `docs/reviews/SAR/decision-memo.md` is absent, or with a dependent validation row not `Validated`); retired requirements exempt | A `Closed` requirement while the section 11.2 stage 4 to 6 ATP cases of the delivered unit are not `Passed`, or a `Closed` `REQ-SW-*` whose credited release is named by no PCA-05 line (`CLOSED_NOT_INSTALLED`, implemented by CR-011); a `Verified` `REQ-SW-*` whose latest credit report names a release older than the latest release tag with a VDD while that tag's `TC-SW-REG-001` report is missing or not `Pass` (`VERIFIED_RELEASE_STALE`) | CDR (`CLOSED_NOT_INSTALLED`: PDR, with CR-011) |
| 7.3.5 | partly | `VAL_TARGET_MISSING` (`Validates:` tokens parsed and resolved against `conops.md` and `expectations.json`); the `Phase:` token is read into the validation matrix | A `TC-VAL` case without a `Phase:` token fails (`VAL_PHASE_MISSING`, implemented by CR-011) | PDR (re-dated from "before SRR"; no `TC-VAL` case exists at `7bb994f`, so no case went unchecked) |
| 7.3.6 | partly | `HAZARD_REQ_NOT_TESTED` on the hazard trace union (the requirement's own `hazard_ids` and the requirements `hazards.json` names in a hazard's `requirement_ids` or a control's `control_req_ids`; modules `SW` and `SW-<SUB>` get no exception; `RISK_FILE_MISSING` while the register is absent; `tools/README.md` hazard trace); `HAZARD_INVERSE` as a warning | Promote `HAZARD_INVERSE` to a violation (02 T-08 plans PDR; this document requires it at every gate): CR-011 makes it an error under `--gate`. Until then the procedure reviewer treats every `HAZARD_INVERSE` warning in a gate's report as blocking. Implemented, no longer open: the `Inspection accepted per CR-002` route of rule 7.3.6 for modules other than `SW` and `SW-<SUB>`, accepted by `HAZARD_REQ_NOT_TESTED` since `c774851` (CR-002 step 5; `InspectionRouteTests` in `tools/tests/test_traceability.py`) | PDR |
| 7.3.7 | yes | `TC_SETUP_INCOMPLETE` (`instruments` non-empty; `Article:`, `Configuration:`, `Safety:`, `Environment:` in `setup` for Bench and OnAir) | none | done |
| 7.3.8 | yes | `REPORT_FRONT_MATTER`, `REPORT_ID_FORMAT`, `REPORT_UNRESOLVED` (case exists, `requirement_ids` subset, `validates` subset, NCR ids), `REPORT_ARTIFACT`, `NCR_FRONT_MATTER`, `NCR_ID_FORMAT`, `NCR_UNRESOLVED` (requirement, test case and hazard ids), `NCR_ARTIFACT` (each `"<path> sha256=<hex>"` entry exists with that hash) | none | done |
| 7.3.9 | yes | Report section 10 (nonconformance traceability) and the Results column list NCRs per requirement | none | done |
| 7.3.10 (`--regression`) | yes | Prints every `Passed` Bench case whose requirements' `design_refs` intersect the arguments (equal or path prefix) plus every live `TC-ATP` case | none | done |
| 7.3.11 | no | none (git history is not read on `main`) | `CASE_STALE` (implemented by CR-011 against the most recent `baseline/*` tag) | PDR |
| 7.3.12 | no | none | `DEVBOARD_CASE_CLOSING` (implemented by CR-011) | before the first dev-board case becomes `Active`, and no later than PDR |

Options that do not exist on `main` at `7bb994f` (02 section 8.1): `--gate`, `--volatility`, `--fix-children`; CR-011 adds all three. The requirement-side rules are recorded in 02 section 8.5 (alignment item A7 asks for its refresh).

**Front matter format decision.** The templates stay inside the subset parser's syntax so that both parser paths yield identical values: nested mappings are flattened to block lists of single scalar strings (`artifacts:` entries of the form `"<path> sha256=<64 hex>"`, `instruments:` entries of the form `"<name>; <model>; <range>; <accuracy source>; <calibration this session>"`), every comment is on its own line and is deleted before filing, and values that YAML would retype (hex hashes, versions containing `+`) are quoted. Verified on 2026-09-25 for both templates (`docs/templates/verification-report.md`, `docs/templates/ncr.md`): `yaml.safe_load` and `parse_front_matter_subset` return the same value for every key, as filed and with a real ISO date substituted (the only difference is that PyYAML returns a date object for a real ISO date, which the tool reads through `str()`, giving the same string).

---

## 8. Procedures (test cases)

### 8.1 Table 5.3-1 procedure content mapped to the test case schema

| SE HB Table 5.3-1 procedure item | Where it lives in `test_cases.json` |
|---|---|
| Nomenclature and identification of the test article | `setup` line `Article: CWHT-A-001, firmware v1.2.0+<hash>, enclosure rev A` (dev-board cases: `Article: pico2-devboard-N.`, section 4) |
| Test configuration and differences from operational configuration | `setup` line `Configuration:` (dummy load instead of antenna, lid off, PA-enable jumper, USB serial attached) |
| Objectives and criteria from the requirement | `title`, `requirement_ids`, `acceptance_criteria` |
| Characteristics to be inspected, demonstrated or tested, with values and tolerances | `acceptance_criteria` (numbers with units and tolerances; one decision rule that makes every outcome either Pass or Fail) |
| Steps, operations and observations in sequence | `procedure` (one action or one observation per array element; numbered by position) |
| Computer software required | `automation_ref` (script, `cargo test` filter, or emulator scenario path) plus firmware version in `setup` |
| Measuring, test and recording equipment with range, accuracy and type | `instruments` (name, range and accuracy as in section 6.1) |
| Recording of equipment calibration or software version data | Report front matter (section 9); the procedure's penultimate step says `Record instrument calibration and tool versions in the report` |
| Credentials that test software and support equipment have been verified | `setup` line `Credentials: instruments and tools per tools/toolchain.lock.md at the commit recorded in the report.` (the lock names each TV record) |
| Special instructions for data recording | `expected_artifacts` (name, description, type) |
| Layouts, schematics or diagrams of the test setup | `expected_artifacts` entry of type `photo` for the as-run setup, plus a fixture drawing in `docs/vv/fixtures/` referenced in `setup` |
| Hazardous situations, precautions, safety instructions | `setup` line `Safety:` (RF exposure distance, hot PA, battery handling, current limit, never key into an open antenna port) |
| Environmental and other conditions with tolerances | `setup` line `Environment:` (room temperature, supply voltage, antenna or load) |
| Constraints on inspection or testing | `setup` (duty cycle limit into the dummy load, maximum key-down time) |
| Instructions for nonconformance and anomalous results | Every Bench and OnAir procedure ends with the final step `On any discrepancy, stop and open an NCR per docs/process/04-verification-and-validation.md section 10` |
| Facility, housekeeping and handling requirements | Not applicable (owner's bench); antistatic handling stated in `Safety:` where the board is handled without the enclosure |

### 8.2 Authoring rules

- One case verifies one to a few closely related requirements; a case that needs more than 25 procedure steps is split.
- Acceptance criteria are objective: a number with tolerance, a logged event, an observable state, stated as one decision rule so that no reading is neither Pass nor Fail (for a measured limit, "Pass if the reading plus the instrument accuracy is within the limit; otherwise Fail"). "Works correctly" is rejected by the reviewer.
- Automated cases (`Simulation`, `HostUnit`, `Emulation`, `Inspection` by tool) have an `automation_ref` that a fresh checkout can run with one command from `tools/toolchain.lock.md`; the `procedure` still lists the human-readable steps the automation performs. HostUnit cases obey the SWE-186 repeatability rules of section 4.
- Every case that involves keying exists in two variants or has two procedure blocks: straight key, and iambic paddles (SI-018).
- Step order at the end of every procedure, stated once here: the penultimate step records instrument calibration state and tool or firmware versions in the report; the final step is the stop-and-open-an-NCR instruction (Bench and OnAir) or `On any assertion failure stop and open an NCR` (automated classes).
- Cases are written by the test author from the requirement, its rationale and the ICDs, before the design is reviewed against them; the author records the `Credit row:` line of section 5.2 in `setup`, and Bench and OnAir cases also carry the `Credentials:` line of section 8.1.
- Evidence of one requirement is not booked twice: coverage and MC/DC evidence belongs to `TC-SW-COV-001` (section 12) and never forms part of the acceptance criteria of a functional case.
- Cases are placed under configuration control at SRR (L1) and PDR (L2) with the requirements; after that, edits go through CR (charter section 7) except editorial fixes logged in the commit.
- **Requirement changes (SWE-071).** Every `CR-NNN` that changes a requirement lists the cases citing it (the output of the verification matrix row). The test author updates those cases and the affected `docs/vv/plan.md` sections before the CR is closed. Each updated case returns to `Draft` until the section 8.3 review makes it `Active` again; rule 7.3.11 (`CASE_STALE`) flags a case that was not updated. A requirement changed through an NCR `Design-change` disposition follows the same rule (section 10.4).

### 8.3 Procedure review checklist (used by the independent reviewer before `Active`)

1. Cites at least one existing, live requirement; method matches the requirement or the case carries `Credit row: SUPPORT.`
2. Class is allowed for the method (section 4 table); the `Credit row:` key is stated and correct for the requirement's module and kind (section 5.2); a dev-board case carries the section 4 lines and key `SUPPORT`; a `TC-VAL` case carries key `VAL`.
3. Acceptance criteria are numeric or observable, form one decision rule, and the requirement's tolerance exceeds the instrument or tool uncertainty stated in `instruments` or `setup`.
4. Steps are executable in order by the owner without Claude present (Bench, OnAir) or by one command (automated).
5. Instruments are in section 6.1 (which includes the tinySA Ultra of ADR-021), or for OnAir the second station and keys of the section 4 OnAir row; anything else is a `Blocked` case with the alternative named.
6. `Safety:` and `Credentials:` lines present for Bench and OnAir; no transmit step without the dummy load or a reference to the OnAir authorization in `docs/reviews/TRR-Dn/decision-memo.md` (section 6.3).
7. Expected artifacts are sufficient to reproduce the pass/fail decision from the report alone.
8. Keying cases cover both key types (SI-018).
9. Hazard-tracing requirements (section 3, including those named only in `hazards.json`): a `REQ-SW-*` has a closing case of method Test (SWE-192; a case set that leaves such a requirement without one fails review); a non-software hazard requirement is verified by Test or carries the `Analysis accepted per RSK-NNN` note with an existing risk (rule 7.3.6).
10. Case author differs from the author of every design element or code module the case verifies (charter section 2); the reviewer records both authoring invocations in the INSP record (section 2).
11. A `TC-VAL` case carries the `Validates:` and `Phase:` lines of section 1.

---

## 9. Reports

Every run intended for credit, and every failed run, produces one report `docs/vv/reports/<TC-ID>-r<N>.md` from `docs/templates/verification-report.md`. Runs for risk reduction (pre-build simulations, exploratory bench checks, dev-board runs) produce a report with `credit: false`. The template implements the report column of SE HB Table 5.3-1 and the report content list of §5.3.1.2.3 and §5.4.1.2.4: objectives and degree met; description including deviations; configuration and differences from operational configuration; result of each step with links to data; analysis results; data tables, plots and pictures; NCR summary with dispositions and planned retest; conclusions; version of the requirements set (for a `TC-VAL` case also the version of the stakeholder expectations and ConOps used), the product and the tools; equipment calibration and software versions; status of enabling equipment; the as-run procedure with redlines; and the owner's authentication of results and authorization of acceptability.

The front matter is written in the parser subset of section 7.4 and is machine-read by `tools/traceability.py` today under rules 7.3.4 and 7.3.8 (keys listed in section 7.4); the procedure reviewer checks the other fields and the report body against the template before a report is committed. Its fields and allowed values are defined in the template. A report without valid front matter is not evidence. The coverage report of section 12 and the regression report of section 10.5 are ordinary reports under this rule (`TC-SW-COV-001-r<N>.md`, `TC-SW-REG-001-r<N>.md`).

---

## 10. Discrepancies and non-conformances

### 10.1 Stop rule

SE HB §5.3.1.2.2 and §5.4.1.2.2: when a discrepancy is observed (any variance from the required or expected outcome, configuration or result), the activity stops and a discrepancy report is generated. On cwht: the operator stops the step, leaves the setup intact where safe (SE HB §5.3.1.2.3 recommends analyzing while the configuration is still intact), photographs the setup and instrument readings, and Claude opens `docs/vv/ncr/NCR-NNN.md` from `docs/templates/ncr.md` before any further step of that case runs. Automated classes stop the run at the failing assertion and open the NCR from the log.

### 10.2 Classification

The first analysis decides whether the discrepancy is a **product non-conformance** or a **procedure or conduct discrepancy** (wrong setup, uncalibrated instrument, mis-stated criterion, tool defect). A procedure discrepancy is still recorded as an NCR (SWE-201 includes defects in tools) with disposition `Procedure-correction`; the case is corrected by CR or editorial fix, the report records the correction, and the run repeats. Only product non-conformances affect requirement status.

### 10.3 Severity (SWE-202 minimum classes, mapped to cwht)

| Severity | SWE-202 class | cwht meaning | Immediate effect |
|---|---|---|---|
| **S1 Safety or regulatory** | loss of life or loss of vehicle | Injury or burn risk, fire or battery hazard, RF exposure above the limits of 47 CFR 1.1310 or 2.1093 as evaluated in `docs/design/analysis/rf-exposure-evaluation.md`, emission outside 47 CFR 97.305/97.307 limits, damage that destroys the unit, violation of a SWE-134 provision in any of the safety-critical components of `docs/process/07-software-engineering-plan.md` section 14.1 (the single authoritative list, charter section 10), or an unintended transmission | All powered testing stops until the owner approves the disposition; process assessment mandatory (SWE-204); risk register entry |
| **S2 Mission** | mission success | A `KDR` or `Baseline` requirement is not met, or an `OPS-NNN` scenario cannot be completed, with no operational workaround (for example, keyer does not work with paddles, or with a straight key: SI-018) | Case `Failed`, requirement blocked from `Verified`; process assessment mandatory (SWE-204) |
| **S3 Workaround** | visible to the user with operational workaround | User-visible deviation with a workaround acceptable to the owner for the current revision | Case `Failed`; disposition may be `Use-as-is` via CR that records the workaround in the operations handbook |
| **S4 Other** | other | Cosmetic, documentation, tool or fixture defect without product effect, `Goal` requirement not met | Case result stands as recorded; the owner schedules the fix in the disposition; the NCR cites a requirement only when the defect affects it |

S1 and S2 are "high severity" for SWE-204. The NCR author proposes severity. The independent software-assurance reviewer confirms it for any NCR touching firmware; the owner confirms it for every other NCR. The owner may raise but not lower a proposed or confirmed severity without a rationale line in the NCR.

### 10.4 Dispositions

| Disposition | Meaning | Requires |
|---|---|---|
| `Rework` | Bring the item to the baseline design (resolder, reflash, reprint) | Retest of the failed case plus regression per section 10.5 |
| `Repair` | Depart from the baseline design to make the item acceptable (jumper wire, part substitution) | `CR-NNN` recording the as-built deviation; retest and regression; physical configuration audit note at SAR |
| `Use-as-is` | Accept the non-conformance | `CR-NNN` that changes or waives the requirement with impact assessment (charter section 7); for S1 never; for S2 only with an owner decision memo |
| `Scrap` or `Return-to-vendor` | Unit or part is not usable | Vendor NCR correspondence filed under the NCR; new unit enters at receipt inspection |
| `Procedure-correction` | The product conforms; the case, fixture, tool or conduct was wrong | Corrected case, corrected tool entry in `tools/toolchain.lock.md` if a tool, rerun |
| `Design-change` | Root cause is the design | `CR-NNN`, re-analysis (section 5.1 principle 5), updated cases (SWE-071, section 8.2), retest and regression |

**COTS, OSS and reused components (SWE-203).** Components in scope (the SWE-203 note lists operating systems, run-time systems, device drivers, code generators, compilers, math libraries and build and CM tools): rustos `api` and `pico2`, Rust `core`, any dev-tool crate in the third-party register (07 section 17.1; no HAL, PAC or SVD-generated crate is used), the `build.rs` table generators (RMM row SWE-146), the Rust toolchain and cargo tooling, the emulator, LTspice, KiCad, `picotool`, the Python venv packages.

- **Reported defects (the mandatory assessment).** At every release tag the software lead reviews the upstream-reported defects of every component in 07 section 17.1 (rustc release notes for the pinned version, RustSec advisories through `cargo audit`, and the issue trackers of rustos, the emulator and each pinned dev-tool crate) and records the review in the VDD reuse-assessment section (07 section 12 item 2 and section 13 row "Reused components"; RMM row SWE-203; 01 section 7.5 row SWE-203). Each reported defect reachable from cwht code opens an NCR with `cots_assessment_required: true`.
- **Defects found by the project.** An NCR whose root cause lies in one of the components records an assessment section (component, version, upstream issue reference, workaround, and whether the component stays in the build) in NCR section 3 and sets `cots_assessment_required: true`.
- **Code audit.** For an S1 or S2 NCR of either kind, the assessment includes a code audit of the component paths the firmware executes (the functions and register sequences reached from cwht code, or the generator templates that produced the code), performed by an independent reviewer invocation and recorded in NCR section 3 ("Code audit performed": reviewer invocation, audited commit or version, paths audited, defects found), completed before the next release tag (SWE-203 note: mandatory code audits for critical defects).

Version pinning changes are CRs against `tools/toolchain.lock.md`.

### 10.5 Retest and regression (SWE-191)

- **Retest:** the failed case reruns for credit after the disposition is implemented; the new report cites the NCR.
- **Firmware regression set:** on every tagged firmware release, the entire HostUnit and Emulation suite reruns (one command, the gate script of `docs/process/07-software-engineering-plan.md` section 8.4), coverage is re-measured (section 12), and the cyber cases (USB firmware loading, key-input command handling; charter section 12 tailoring) are included so that no security regression passes unnoticed. The regression run is recorded as `docs/vv/reports/TC-SW-REG-001-r<N>.md` (case `TC-SW-REG-001` in `docs/test_cases/sw-reg/test_cases.json`, citing every `REQ-SW-*` the suite re-verifies; 07 section 9.3). A release with any failing automated case, or with a third-party register feature lacking a covering case (section 4, SWE-211), is not tagged.
- **Firmware release on a delivered unit:** on every firmware release installed on a delivered unit, Claude runs `tools/traceability.py --regression <changed firmware paths>`, where the arguments are the files under `firmware/` that differ between the previously installed release tag and the new one (`git diff --name-only <old tag> <new tag> -- firmware/`), and records the command and its output in the new release's `TC-SW-REG-001` report. A change of the pinned rustos commit counts as touching every design element. Every Bench case closing a `REQ-SW-*` whose `design_refs` intersect the arguments, plus the ATP stage 4 to 6 smoke set of section 11.2 (every `TC-ATP` case is in the printed set), runs in the delta TRR campaign of 01 section 7.6 (a). Status effects are those of section 5.2 rows `T-SW-LOGIC` and `T-SW-TARGET`.
- **Hardware regression set:** after `Rework`, `Repair` or `Design-change` on the unit, rerun receipt inspection of the touched area, every `Passed` Bench case whose requirements' `design_refs` intersect the touched design elements, and the full `TC-ATP-NNN` set (section 11). `tools/traceability.py --regression <design_ref...>` prints the list (rule 7.3.10, implemented; section 7.4) and Claude records it in the NCR `regression_cases` field.
- **Validation regression:** if a `Design-change` alters anything the owner touches or hears, the affected `TC-VAL-NNN` cases rerun.

### 10.6 Closure

An NCR closes when its disposition is implemented, the closure evidence of the table below is filed, the process assessment (S1, S2) is recorded with its resulting process change or a statement that none is needed, and the owner's closure line is entered. `tools/traceability.py` refuses `Verified` on any requirement with a non-closed NCR (rule 7.3.4, `VERIFIED_WITH_OPEN_NCR`, implemented; section 7.4).

| Disposition | Closure evidence (listed in NCR section 7) |
|---|---|
| `Rework` | Retest report with `credit: true` and `result: Pass`; the regression set of section 10.5 passed |
| `Repair` | Approved `CR-NNN`; the unit's `as-built.md` updated with the deviation; retest report with `credit: true` and `result: Pass`; regression set passed |
| `Use-as-is` | Approved `CR-NNN` (its disposition block is the decision memo). If the CR changes the requirement, a new report run of the case (data re-evaluated against the changed requirement, or the case rerun) with `credit: true` and `result: Pass`; if the CR waives the requirement, the requirement is retired per 02 section 11.3. No retest of the unchanged product |
| `Scrap` or `Return-to-vendor` | Vendor correspondence filed under `docs/vv/ncr/NCR-NNN/`; either the replacement's receipt inspection report plus the retest on the replacement with `credit: true` and `result: Pass`, or an approved `CR-NNN` that removes the unit or part from the build (for a friend's unit, its ADP closed as scrapped) |
| `Procedure-correction` | Corrected case committed (CR or editorial fix); rerun report with `credit: true` and `result: Pass` |
| `Design-change` | Approved `CR-NNN`; re-analysis where an analyzed value changed; updated cases reviewed back to `Active` (section 8.2); retest report with `credit: true` and `result: Pass`; regression set passed |
| Any disposition of an S4 NCR without product effect | The fixing commit or the `Use-as-is` CR; no retest report is needed when the fix changes no product configuration item |

NCR open and close counts per severity are in the traceability report summary (section 7.3 output) and are plotted in every review package; the software-attributed subset is measurement MSR-27 of 07 section 11.2. `docs/plan/tpm.json` registers them as TPM-019 (`ncr-trend`), preliminary at SRR; the owner approves or removes it with the TPM definitions at PDR (SE-40; SEMP Appendix F item F-14; alignment item A12, resolved).

### 10.7 NCR status lifecycle

The `status` field of the NCR front matter takes exactly these values, in this order, and no state is skipped. Every NCR, including a `Procedure-correction`, carries the owner's disposition line in section 4; for a `Procedure-correction` NCR the `Dispositioned`, `Retest` and `Closed` states may be recorded on the same day.

| Status | Meaning | Who sets it | Evidence required |
|---|---|---|---|
| `Open` | Discrepancy observed and recorded (section 10.1) | Claude, at the stop rule, the same day | Front matter complete; section 1 Observation filled; photographs or logs under `docs/vv/ncr/NCR-NNN/` listed in `artifacts` |
| `Analysis` | Root cause work in progress or complete | Claude, when section 3 is started; severity confirmed by the software assurance reviewer for firmware NCRs and by the owner for the others (section 10.3) | Section 2 and section 3 filled (classification, root cause or analysis plan with owner and date, extent, COTS assessment and code audit where applicable) |
| `Dispositioned` | Owner has chosen the disposition (section 10.4) | Claude, transcribing the owner's approval | Section 4 filled with the owner's approval line and date; `disposition` and `cr_ids` set in the front matter |
| `Retest` | Disposition implemented; retest and regression identified and authorized | Claude, after the implementing commit or rework | Section 5 actions "Implement disposition" done; `retest_cases` and `regression_cases` listed; any required CR approved |
| `Closed` | Section 10.6 conditions met | Claude, transcribing the owner's closure statement | Section 7 filled with the closure evidence of the section 10.6 table, CR IDs, lessons-learned entry, owner closure line; `date_closed` set |

---

## 11. Acceptance testing and first power-on

### 11.1 Acceptance philosophy

SE HB §5.3 (sidebar "Differences between Verification, Qualification, Acceptance and Certification"): verification is performed once per design; acceptance is a smaller subset performed on each unit to show that workmanship conforms to the verified design; an acceptance data package ships with each unit. SE HB §5.4.1.2.4 note: for a single deliverable the validation process completes acceptance. On cwht:

- **Unit 1 (`CWHT-A-001`)**: the full verification and validation program is the acceptance. SAR accepts the unit on the complete matrices (NPR 7123.1D App. G Table G-11: product verification results, product validation results, compliance with acceptance criteria, as-built documentation).
- **Subsequent units for friends (SI-019, `CWHT-A-002` onward)**: the acceptance test procedure (ATP) is the set of cases in module `ATP`, `docs/test_cases/atp/test_cases.json`, IDs `TC-ATP-NNN`. Each ATP case cites the requirements it re-verifies per unit. The ATP is written by CDR (charter section 3: acceptance criteria are CDR products; SWE-034) and contains at minimum: receipt inspection against renders and BOM (recorded in `docs/vv/reports/receipt-inspection-<n>.md`, section 11.2 stage 0); pre-power continuity and rail-short checks; staged first power-on (section 11.2); rail voltages and receive, transmit and sleep currents; antenna-port return loss (NanoVNA); output power into the dummy load by the section 6.2 method; receiver functional demonstration on a known signal; keyer demonstration with straight key and with paddles at two speeds (SI-018); sidetone and headphone audio level; battery charge start and termination; enclosure fit and control feel (Inspection and Demonstration); firmware hash equals the released VDD hash (Inspection, SWE-063); and the loaded code and data acceptance below. An acceptance data package `docs/vv/adp/<unit>/` holds the ATP reports, photographs, the as-built record `as-built.md` (CM plan Table 4-1 row 38) and the VDD.
- **Loaded code and data acceptance (SWE-193; nominal and off-nominal per the SWE-193 note).** Cases `TC-SW-BOOT-NNN` (`docs/test_cases/sw-boot/test_cases.json`) and `TC-SW-CFG-NNN` (`docs/test_cases/sw-cfg/test_cases.json`; modules per `docs/process/07-software-engineering-plan.md` section 9.7) are written by the test author by CDR. Their credit run is the Bench run at section 11.2 stage 4 on each unit, after TRR, as part of the ATP (SWE-193 acceptance tests at TRR per 07 section 3.1). Before TRR their non-USB parts (image integrity check and safe-state entry, configuration restore and default substitution) run in Emulation within the accredited scope, on the release candidate, as `credit: false` supporting evidence (row key `SUPPORT`); the USB bootloader load is target behavior outside the emulator scope. The platform-independent logic behind them (CRC and range checks, default substitution) is closed by its own `REQ-SW-CFG-*` and `REQ-SW-BOOT-*` HostUnit cases under row `T-SW-LOGIC`. The acceptance content: (a) firmware image load over the USB bootloader: a valid image is accepted, boots and reports its version and hash on the serial banner and `picotool verify` matches; a corrupt, truncated or wrong-target image is rejected and the unit reports the SWE-134 a safe state (PA disabled, TX inhibited) with a fault code; (b) persisted configuration (keyer speed, iambic mode A or B and straight-key mode, sidetone frequency and level, frequency calibration, last frequency): nominal values are restored on restart; out-of-range or corrupt values are replaced by defaults and a logged event is emitted, so that the radio always starts with a usable keyer for either key type (SI-018).
- Any ATP failure is an NCR (section 10); a friend's unit is handed over only with all ATP cases `Passed` and no open S1 or S2 NCR.

### 11.2 First-power-on procedure concept (SI-010)

The detailed procedure is the first-power-on case of module `SYS` (`docs/test_cases/sys/test_cases.json`; id allocated at authoring per 02 section 11.1, no id is reserved here) and its ATP twin, written by CDR from the power budget analysis, which supplies every current limit and expected rail value with tolerance. The concept, fixed here:

| Stage | Action | Go criterion (values from the CDR power budget) | Instruments |
|---|---|---|---|
| 0 Receipt | Inspect assembly against rendered layout, BOM and polarity marks; measure PCB and enclosure critical dimensions; photograph both sides; record in `docs/vv/reports/receipt-inspection-<n>.md` (one per vendor delivery, `docs/process/01-lifecycle-and-reviews.md` section 7.3 row 9) and link it from `docs/vv/adp/<unit>/as-built.md` | No missing, rotated or wrong-value parts visible; dimensions within drawing tolerance | Loupe, calipers (OQ-VV-002), camera |
| 1 Cold checks | Power off: continuity of ground, resistance from each rail to ground, antenna port DC isolation, key and headphone jacks to their nets | No rail below the budgeted minimum resistance; antenna port isolated | Multimeter |
| 2 Passive RF | NanoVNA sweep of the antenna port with the unit unpowered and the PA path unbiased | Return loss and filter passband shape within the Analysis prediction band | NanoVNA, dummy load for calibration |
| 3 Rails only | Bench supply at nominal voltage, current limit at the budgeted no-firmware quiescent value; PA supply disconnected by its jumper or fuse | Each rail within tolerance; supply current below limit; no part warm to the touch after 60 s | Bench supply, multimeter |
| 4 Firmware load | Flash the tagged release over USB in bootloader mode; observe serial telemetry; run the `TC-SW-BOOT` and `TC-SW-CFG` acceptance cases (section 11.1); Claude writes the PCA-05 line in `as-built.md` the same day (section 5.3) | Boot banner with expected version hash; SWE-134 a safe-state report (PA disabled, TX inhibited); corrupt image rejected; configuration defaults restored | USB serial |
| 5 Receive | Headphones and antenna substitute (dummy load or short whip) connected; tune across the band | Noise floor audible, volume and tuning respond, LCD shows frequency; receive current within budget | Bench supply, multimeter |
| 6 Keying, no RF | Straight key then paddles connected; PA still disconnected | Sidetone follows the key; keyer produces correct elements at the set speed; TX request logged but PA-enable stays low (SWE-134 h prerequisite check) | Serial log |
| 7 Transmit into load, reduced supply | PA jumper in; bench supply at the reduced voltage from the budget with a current limit at the budgeted low-power draw; key-down 2 s bursts into the dummy load | Transmit current within the low-power band; RF probe (characterized by the RF probe characterization case, section 6.2) shows power in the predicted band; no rail collapse | Bench supply, multimeter, RF probe, dummy load |
| 8 Transmit into load, full supply | Nominal supply; ConOps key-down duty | Power, current and rail values within tolerance; PA and enclosure surface temperature below the stop criterion of the hazard analysis PA thermal limit (thermocouple reading if OQ-VV-003 confirms one, NTC telemetry otherwise, alignment item A11) | Same, plus the multimeter thermocouple (OQ-VV-003) |
| 9 On air | Only after section 6.3 conditions are met and the owner has signed the OnAir authorization in `docs/reviews/TRR-Dn/decision-memo.md` | Two-way contact with a second station using straight key, then paddles (`TC-VAL` scenarios) | Second station |

A discrepancy at any stage stops the procedure (section 10.1). Stage 0 is a TRR entrance product (01 section 7.3 row 9) and precedes TRR. Stages 1 and 2 are unpowered; they run for the record after TRR and may be run earlier as risk reduction (`credit: false`, recorded in the receipt inspection report) at the owner's option. Stages 3 to 8 occur only after TRR (section 13). Stage 9 occurs only after the on-air delta TRR (`TRR-Dn`, 01 section 7.6 (c)); it is a validation activity and a Demonstration credit event.

---

## 12. Software coverage as verification evidence (SWE-189, SWE-190, SWE-219, SWE-220)

- **Scope:** every crate compiled into the image: `cwht-core`, `cwht-app`, rustos `api` and `pico2` (07 section 17.1), and Rust `core` at feature level only (section 4, reused components).
- **Credit-bearing measure (MSR-13):** line and region coverage per crate from `cargo llvm-cov` over the nextest run of the tagged release on the locked stable toolchain (`tools/toolchain.lock.md` section 1), from the HostUnit suite. Code that is not host-buildable (the `pico2` drivers) is measured from Emulation where the emulator exports coverage; otherwise every uncovered driver path gets the SWE-190 complementary inspection below, recorded per path in the same report. Emulation coverage is reported as "not measured" when the emulator does not export it.
- **Required non-credit measure (MSR-14):** branch coverage of all image crates and condition coverage of the safety-critical components on the nightly pinned in `tools/toolchain.lock.md` (07 section 9.6 item 3), attached to every `TC-SW-COV-001` report and labelled nightly. It never closes a requirement by itself (CS-03; charter section 10).
- **Targets, in the measured units:** 100 percent line and region coverage for every image crate (the structural coverage of SWE-189 as `llvm-cov` measures it on Rust), with every uncovered line or region dispositioned into one of the four SWE-189 categories (requirement missing, test missing, extraneous or dead code, deactivated code) and acted on: a missing requirement becomes a CR, a missing test becomes a case, dead code is removed, deactivated code is listed with its activating configuration. Code that does not compile for the host (`cwht-app` and the MMIO, boot and vector-table code of `pico2`; `docs/process/07-software-engineering-plan.md` section 9.5 item 2) is not dispositioned into those categories: each of its lines is listed in the report with the entry `target-only: verified by <TC-ID>`, naming the dev-board check (`credit: false`), the Bench case or the emulation event-order scenario that executes it, plus the driver-to-datasheet Inspection of each register access in it. That list is the complementary test and inspection of SWE-190 ("Analysis of results" below), and the reviewer who signs the report signs it. The CS-11 board `take()` and driver-construction failure arms of `cwht-app` (CS-38; CR-001) are also listed in the MC/DC table with the entry `target-only: Inspection` (07 section 9.5 item 3). For the safety-critical components of `docs/process/07-software-engineering-plan.md` section 14.1 (the single authoritative list, charter section 10): 100 percent MC/DC (SWE-219), shown by the independently reviewed independence-pair table plus MSR-13 plus MSR-14 (07 section 9.6), including a table for every `pico2` driver decision reached from those components; the independence-pair tests of a driver decision run where the driver executes (HostUnit against a register mock where the driver is host-buildable, otherwise Emulation within the accredited scope or the delivered unit), and the table names the class of each test.
- **MC/DC method:** `docs/process/07-software-engineering-plan.md` section 9.6 records that tool-instrumented MC/DC is not available for Rust at this date, so the MC/DC table per safety-critical decision (each condition shown to independently affect the outcome by a named test), reviewed by an independent agent and included in the `TC-SW-COV-001` report, is the Rev A method, dispositioned T in RMM row SWE-219 and approved by the owner at SRR with the RMM (07 section 9.6; `docs/reviews/SRR/decision-memo.md`). A shortfall against 100 percent is relieved as 01 section 8.6 records it (owner decision at SRR): the RMM row SWE-219 stays the relief for the method, and the shortfall is a product waiver `W<n>` approved with rationale by the owner as Technical Authority in the CDR, TRR or SAR decision memo (the SWE-219 note: deviations from 100 percent are reviewed and waived with rationale by the TAs' approval; 07 section 9.6 item 4), entered in CSA item 12 and listed in VDD section 7 (05 section 2); a shortfall without a waiver fails the case. If accredited instrumentation becomes available, a CR adopts it.
- **Evidence:** the case `TC-SW-COV-001` ("Coverage and complexity of the tagged release", `docs/test_cases/sw-cov/test_cases.json`, type `HostUnit`, method Test, citing the `REQ-SW-*` that state the coverage and complexity requirements) produces one report per release, `docs/vv/reports/TC-SW-COV-001-r<N>.md` from the verification report template with `firmware_version` carrying the release, the summary table (MSR-13 and MSR-14 side by side, per crate including `api` and `pico2`), the uncovered-code disposition table and the complementary inspection records; raw `lcov.info`, the nightly output and the MC/DC tables live in the report's artifact directory `docs/vv/reports/TC-SW-COV-001-r<N>/`. (`docs/process/07-software-engineering-plan.md` sections 1.2, 1.3, 8.2 and 9.5 and the RMM row SWE-219 use the same name; this document governs evidence naming per 07's own precedence rule.)
- **Analysis of results (SWE-190):** coverage is computed from the execution of the tests that ran for the tagged release, never from an instrumented development build; the report links the gate log that produced it. Where 100 percent cannot be reached by execution, the complementary analysis or inspection of the uncovered code is recorded in the same report with the reviewer's invocation.
- **Complexity (SWE-220):** the same report lists every function with cyclomatic complexity above 15 and the owner's waiver reference, or states there are none.
- **Review points:** coverage is presented at CDR (plan and first measurement), at TRR and each `TRR-Dn` (release under test), and at SAR (delivered firmware). It is an entrance product of TRR (01 section 7.3 row 13).

---

## 13. Test Readiness Review before bench testing

A TRR is held before any powered Bench test on a delivered unit (charter sections 3 and 9). Review identifiers, directories and RFA/RID identifiers are those of `docs/process/01-lifecycle-and-reviews.md` section 1 item 4: the first campaign review is `TRR` (`docs/reviews/TRR/`, `RFA-TRR-NNN`, `RID-TRR-NNN`); every later campaign is a delta review `TRR-Dn` (`docs/reviews/TRR-Dn/`, `RFA-TRR-Dn-NNN`, `RID-TRR-Dn-NNN`, own log and decision memo, no baseline tag). A delta TRR is held in every case of 01 section 7.6 (a) to (c); this document adds only the V&V evidence below and the OnAir authorization of section 6.3 for case (c).

**Entrance and success criteria** are those of `docs/process/01-lifecycle-and-reviews.md` sections 7.3 and 7.4 (tailored from NPR 7123.1D App. G Table G-10 plus SIR Table G-9 items) and are not restated here. This process supplies the V&V-specific evidence for those rows:

| 01 section 7.3 row | Evidence this process supplies |
|---|---|
| 1 Test objectives | The campaign case list: every `TC-*` case with `type` Bench (and OnAir for a `TRR-Dn` under (c)) planned for the campaign, with its requirements; the matrices' Phase column reads `TRR` or `TRR-Dn` for each |
| 2 Approved plan, procedures, configuration | `docs/vv/plan.md` baselined (PDR) and updated (CDR); every campaign case `Active`; `Article:`, `Configuration:`, `Safety:`, `Environment:` and `Credentials:` lines complete (rule 7.3.7, section 8.1) |
| 3 Interfaces under CM, version descriptions | Release tag and `firmware/releases/VDD-<version>.md` (section 5.2); `tools/toolchain.lock.md` at the commit the reports will cite; fixture list with git paths |
| 4 Known discrepancies dispositioned | NCR log: no open S1; every open S2 has a disposition plan that does not depend on the campaign |
| 5 Test resources available | Instruments of section 6.1 present with their TV records; straight key and iambic paddles present (SI-018); RF probe characterized (the RF probe characterization case of section 6.2 `Passed`); for the TRR that opens the emission campaign, the tinySA Ultra and attenuator receipt recorded by the receipt inspection report `docs/vv/reports/receipt-inspection-<n>.md` plus the tinySA TV record `docs/cm/tool-validation/TV-NNN-tinysa.md` (charter section 9; closes OQ-VV-001); OQ-VV-002 closed for any dimension or mass case; OQ-VV-003 closed for the thermal case |
| 7 Safety planning | `Safety:` lines reviewed; dummy load rating versus planned duty; bench supply current limits listed per section 11.2 stage; RF exposure note for any OnAir case |
| 8 Spectrum considerations | Regulatory pre-power Analysis cases `Passed`; dummy load for every Bench transmit step; OnAir cases `Blocked` until the section 6.3 conditions are met |
| 9 As-built documentation | `docs/reviews/TRR/test-configuration-record.md` (01 section 13; `docs/reviews/TRR-Dn/` for a delta), citing `docs/vv/reports/receipt-inspection-<n>.md` for each vendor delivery and `docs/vv/adp/<unit>/as-built.md` for the unit under test |
| 11 Initial V&V results (SE-48) | Simulation, HostUnit, Emulation and Inspection credit reports on the tagged release; traceability report clean |
| 13 Coverage and complexity | `TC-SW-COV-001-r<N>.md` for the release under test (section 12) |
| 14 Regression | `TC-SW-REG-001-r<N>.md` for the release under test, including the `--regression` selection for a release installed on a delivered unit (section 10.5) |

01 section 7.4 lists the Table G-10 success criteria 1, 2, 5 to 10 by number and 01 section 7.7 dispositions criterion 11; criteria 3 and 4 are met by the standing success criteria C2 and C3 of 01 section 3.3. For V&V, G-10 success criterion 3 (compliance with applicable requirements, standards, processes and procedures) is evidenced by the `docs/process/rmm.json` and `docs/process/se-compliance-matrix.json` rows for the SWEs and SEs named in this document's header showing no undocumented deviation.

**Minimum products.** SE-47 and SE-48 (SIR, updated integration plan and initial V&V results) are met by customization: SIR is combined with TRR (01 sections 1 and 7) and the initial results are the Simulation, HostUnit, Emulation and Inspection credit reports presented at TRR; both rows are FC in `docs/process/se-compliance-matrix.json` and cite `docs/reviews/TRR/package.md`. SE-69 (ORR, preliminary V&V results) is met by customization: ORR is combined with SAR. SE-53 and SE-54 (FRR, baseline V&V results and final certification for use) are met by customization: FRR has no flight equivalent and its products are delivered at SAR as the V&V report `docs/vv/reports/vv-report.md` with the matrices and the SAR decision memo acceptance statement with `docs/vv/reports/part97-compliance.md` (01 section 8.5); both rows are FC in the compliance matrix. SE-51 and SE-52 (baselined decommissioning and disposal plans, NPR 7123.1D §5.2.2.2 g) are T (scope relief, relief type deviation): the ORR is held, combined with SAR, and no stand-alone plans are written (01 sections 1 item 3 and 3.5). The plans are the end-of-life section of `docs/ops/operations-handbook.md`, baselined at SAR (compliance-matrix rows SE-51 and SE-52).

---

## 14. The V&V Plan (`docs/vv/plan.md`)

The plan follows SE HB App. I. SE HB §6.1 baselines the plan at PDR; App. I adds that the baseline follows incorporation of the PDR comments; on cwht the PDR decision memo sets the baseline after the Blocking RIDs close (NPR 7123.1D SE-68). The plan is updated at CDR (procedures and acceptance criteria complete) and at each TRR (campaign details). It is a configuration item; changes after PDR go by CR. The table states what cwht puts in each App. I section and when it is written.

| App. I section | cwht content | Source artifacts | Written by | Updated |
|---|---|---|---|---|
| 1.1 Purpose and scope | Scope is the rev A radio: PCB assembly, enclosure, firmware, fixtures; excludes the friend's station and the antenna beyond the connector | charter | PDR | CDR |
| 1.2 Responsibility and change authority | Section 2 of this document; owner as change authority by CR | this document | PDR | none expected |
| 1.3 Definitions | Points to sections 1, 3, 4 of this document; adds any fixture or instrument terms | this document | PDR | by CR when a term, instrument or reference document changes; reviewed at each gate |
| 2.1 Applicable documents | Charter, this process, requirements files with baseline tags, ICDs, 47 CFR 97.305 and 97.307, hazard analysis | `docs/process/`, `docs/requirements/`, `docs/icd/`, `docs/safety/` | PDR | CDR |
| 2.2 Reference documents | SE HB, NPR 7123.1D, NPR 7150.2D, research reports, instrument manuals | `docs/references/`, `docs/research/` | PDR | by CR when a term, instrument or reference document changes; reviewed at each gate |
| 2.3 Order of precedence | Charter, then CRs, then this process, then the plan, then cases | charter | PDR | none |
| 3.1 Requirements flowdown | L0 to L1 to L2 to design to cases, tool `tools/traceability.py`, report path | charter section 7 | PDR | CDR |
| 3.2 System architecture | Summary and pointer to `docs/design/architecture.md` | design | PDR | CDR |
| 3.3 End items | RX, TX, PWR, CTL sections of the single board; ME enclosure; SW firmware; one subsection each with the interfaces that make them testable (test points, connectors) | `docs/design/allocation.json`, ICDs | PDR | CDR |
| 3.4 Ground support equipment | Owner's instruments (section 6.1), RF probe, printed fixtures, USB serial adapter, bench supply leads, second station for OnAir | section 6, `docs/vv/fixtures/` | PDR (tinySA purchase decided by ADR-021; OQ-VV-001 closes on the receipt inspection report `docs/vv/reports/receipt-inspection-<n>.md` plus the tinySA TV record `docs/cm/tool-validation/TV-NNN-tinysa.md` before TRR) | CDR (fixtures designed) |
| 3.5 Other | Emulator, host test rig, simulation decks | `firmware/emu/`, `hardware/sim/` | PDR | CDR |
| 4.1 Management responsibilities | Section 2 table | this document | PDR | none |
| 4.2 Verification methods (4.2.1 to 4.2.4) | Section 3 and section 4 of this document, with cwht examples per method; 4.2.4.1 qualification testing: Not applicable at rev A: no test is run at the environmental extremes of NGO-026 (operation -10 to +45 C, charging 0 to 45 C, 1.0 m drop, light rain). NPR 7123.1D App. G Table G-11 entrance criterion 3.5 (documentation that the system will perform in the expected operational environment) is met by the Analysis cases for the thermal budget at +45 C ambient (`docs/design/analysis/thermal-budget.md`, RSK-006 step S1), the frequency-reference drift budget over -10 to +45 C (ADR-023; MOP-008), the charger temperature window (0 to 45 C) and the pack voltage range 6.0 to 8.4 V in the power budget (`docs/design/budgets.md`), and the enclosure drop analysis at PDR; the residual risk is RSK-059 "No qualification testing at the environmental extremes" in `docs/risk/register.json` (opened 2026-09-25 from alignment item A10, resolved); 4.2.4.2 other testing: Bench and software Test classes | this document | PDR | CDR |
| 4.3 Validation methods | Section 1; phase-by-phase validation activities; owner and friends as users | ConOps, expectations | PDR | CDR |
| 4.4 Certification process | SAR package: matrices, reports, NCR log, coverage, VDD, as-built, PCA and FCA results, owner acceptance memo (SE-54 equivalent), `docs/vv/reports/part97-compliance.md` | charter sections 3 and 8; 01 section 8.5 | PDR | SAR |
| 4.5 Acceptance testing | Section 11: Unit 1 full program; ATP for further units; loaded code and data acceptance (SWE-193); ADP content | `docs/test_cases/atp/`, `docs/test_cases/sw-boot/`, `docs/test_cases/sw-cfg/` | PDR concept | CDR (ATP cases) |
| 5.1 Design and V&V flow | Firmware: host tests, emulation, tagged release; hardware: vendor fabrication, receipt, cold checks, staged power-on, subsystem Bench in order PWR, CTL, RX, TX; enclosure fit; integrated; OnAir | section 11.2 | PDR | CDR |
| 5.2 Test articles | Simulation decks, host build, emulator image, dev boards (section 4), printed fit-check parts (mock-ups), `CWHT-A-001` (engineering unit that becomes the product), `CWHT-A-00n` production units; the credit table of section 5.2 of this document | this document | PDR | TRR |
| 5.3 Support equipment | Detailed instrument and fixture list with ranges, accuracy, calibration method; open questions OQ-VV-002 and OQ-VV-003 with their decision gates, and the receipt inspection report `docs/vv/reports/receipt-inspection-<n>.md` plus the tinySA TV record `docs/cm/tool-validation/TV-NNN-tinysa.md` that close OQ-VV-001 (section 6.3; ADR-021 stays the purchase decision) | section 6 | PDR | CDR |
| 5.4 Facilities | Owner's bench and shop; on-air location; Not applicable otherwise | SI-013 | PDR | none |
| 6.n End item V&V | Per end item: developmental evaluations (risk-reduction simulations and exploratory runs), verification by Test, Analysis, Inspection, Demonstration (lists of case IDs), validation activities, acceptance subset | cases | PDR (lists of planned cases) | CDR (cases `Active`) |
| 7.1 End-item integration | Board-level integration order and the Bench cases run at each step; enclosure integration; firmware-to-board integration | integration plan (SE-67) | PDR | CDR |
| 7.2 Complete system integration | Integrated radio Bench cases, `TC-SYS-*`; the first-power-on procedure | section 11.2 | PDR | CDR |
| 8.1 Vehicle integration | Not applicable (no host platform); the antenna is the only external element and is characterized by NanoVNA return loss | none | PDR | none |
| 8.2 End-to-end | Two-radio (or radio plus friend's station) CW exchange with both key types; SE HB §5.3.1.2.2 end-to-end intent | `TC-VAL-*` | PDR | TRR |
| 8.3 Field V&V | OnAir demonstrations and validation with friends; anomaly reporting in Phase E feeds NCRs | ConOps | PDR | SAR |
| 9 Certification products | Contents of the SAR acceptance data package | section 4.4 row | PDR | SAR |
| App. A, B | Acronyms and definitions | this document | PDR | by CR when a term, instrument or reference document changes; reviewed at each gate |
| App. C Verification matrix | The section 7.1 matrix copied from `docs/vv/traceability-report.md` at each review (App. I says a small project may fill the completed matrix) | `docs/vv/traceability-report.md` | PDR (methods and cases, no results) | every review |
| App. D Validation matrix | The section 7.2 matrix copied from the same report at each review | same | PDR | every review |

---

## 15. Test data retention

- **What is retained:** every report and its `expected_artifacts` (logs, CSV, plots, photographs, serial captures), every NCR with its evidence, coverage raw data, LTspice checker outputs, emulator scenario logs, as-run procedures with redlines, TRR and SAR packages, calibration notes per session, instrument datasheet accuracy pages cited by reports.
- **Where:** in the repository under `docs/vv/reports/<TC-ID>-r<N>/` (artifacts beside the report of the same stem, including `TC-SW-COV-001-r<N>/` for coverage raw data), `docs/vv/ncr/NCR-NNN/`, `docs/vv/adp/<unit>/`. Text data is preferred (`.txt`, `.csv`, `.json`, `.md`); plots as `.png` or `.svg`; photographs as JPEG at 1600 px on the long side (target 500 KB or less); video is not stored in the repository: it is kept in the owner's storage and its SHA-256 and location are recorded in the report.
- **Naming:** retained logs use the suffix `.log.txt` (a plain naming convention that every viewer opens as text); serial captures are `serial-<stage>.txt`. `.gitignore` ignores `*.log` and `*.raw` elsewhere but un-ignores them under `docs/vv/` (lines `!docs/vv/**/*.log` and `!docs/vv/**/*.raw`), so no evidence file is dropped by git. An LTspice `.raw` waveform is retained only when a report cites it, in the report's artifact directory with its SHA-256; a cited waveform larger than 10 MB is not committed, and the checker exports the cited traces to `.csv` instead. Uncited `.raw` files are not retained; the checker's CSV or text summary is.
- **Integrity:** the report and the NCR list every artifact file they cite with its SHA-256 in the `artifacts` front matter list (`"<path> sha256=<hex>"`); `tools/traceability.py` verifies that each file exists with that hash (rule 7.3.8, `REPORT_ARTIFACT` and `NCR_ARTIFACT`, implemented; section 7.4).
- **How long:** for the life of the repository. The as-built baseline tag `baseline/sar` includes all evidence for Unit 1; each friend's unit ADP is committed before hand-over. Nothing in `docs/vv/` is deleted; superseded reports keep their run number and are referenced by the newer run.
- **Software records** (NPR 7150.2D chapter 6 and SWE-065 a to d): test plan (`docs/vv/plan.md`), procedures (`docs/test_cases/`), tests (`firmware/` test code and `firmware/emu/` scenarios), reports (`docs/vv/reports/`), and the non-conformance records (`docs/vv/ncr/`) are the software test records set.

---

## 16. Phase-by-phase V&V activities and gate products

| Gate | V&V activities before it | V&V products in the package |
|---|---|---|
| SRR | Requirements validation per SE HB §4.2.1.2.4 (owned by the requirements process); methods assigned to every L1 requirement, one closing method each (section 6.2); `verification_note` names the pre-build and post-build class; instrument limits (section 6) applied; L1 cases drafted by the test author; toolchain proof entries of section 4 added to `tools/toolchain.lock.md`; the section 7.4 rows due before SRR implemented and the unit tests passing | Method distribution table; list of requirements that need Analysis because of section 6.2; OQ-VV-002 and OQ-VV-003 opened (OQ-VV-001 closes on the receipt inspection report `docs/vv/reports/receipt-inspection-<n>.md` plus the tinySA TV record `docs/cm/tool-validation/TV-NNN-tinysa.md` before TRR); this process baselined, with its ETA approval in the SRR decision memo; RMM approval covering the SWE-219 method (section 12) and the SWE-211 relief (section 4) |
| PDR | L2 cases drafted; Simulation evidence for key risks; V&V plan written; OQ-VV-002 and OQ-VV-003 decided; emulator selected by ADR with its TV record scope; fit-check prints for ME validation; the section 7.4 rows due at PDR implemented (`CASE_STALE`, `DEVBOARD_CASE_CLOSING`, the hazard union and the `HAZARD_INVERSE` promotion) and the `--gate` option (02 section 8.5) | Baselined `docs/vv/plan.md` (SE-68); matrices with methods, classes and planned phases; validation matrix with `TC-VAL` phase cases; coverage plan (section 12) |
| CDR | All cases `Active`; Analysis credit runs on product baseline; DRC/ERC/BOM inspections; ATP, the first-power-on and RF probe characterization cases (sections 6.2 and 11.2) and the loaded code and data cases (`TC-SW-BOOT-*`, `TC-SW-CFG-*`, SWE-193) written, the latter's non-USB parts run in Emulation as `credit: false` supporting evidence (section 11.1); emulator scenarios for `OPS-NNN`; first coverage measurement; the section 7.4 rows due at CDR implemented (`CLOSING_CLASS`, `CLOSED_NOT_INSTALLED`, `VERIFIED_RELEASE_STALE`) before the first credit report | Updated plan; matrix with Analysis and design Inspection rows closed; ATP; TRR entrance plan; NCR log |
| TRR | Receipt inspection of the delivered unit (`receipt-inspection-<n>.md`); tagged release with VDD; HostUnit and Emulation credit runs; `TC-SW-COV-001` and `TC-SW-REG-001` reports; fixtures characterized (RF probe characterization case); for the TRR that opens the emission campaign, the tinySA Ultra and attenuator receipt inspection report `docs/vv/reports/receipt-inspection-<n>.md` and TV records including `docs/cm/tool-validation/TV-NNN-tinysa.md` (charter section 9; closes OQ-VV-001). The SWE-193 credit runs of `TC-SW-BOOT` and `TC-SW-CFG` follow TRR at section 11.2 stage 4 (07 section 3.1) | Section 13 evidence; traceability report clean; coverage report; risk acceptance |
| TRR-Dn | Per 01 section 7.6 (a) to (c); for (a) on a delivered unit, the regression selection of section 10.5 | Delta package limited to the changed rows; decision memo; the OnAir authorization of section 6.3 under (c) |
| SAR | All Bench and OnAir runs; validation with owner (and friends); NCRs closed or dispositioned by CR; FCA and PCA, PCA-05 recording the installed-release line of each delivered unit (05 section 7.2); every `REQ-SW-*` verified by HostUnit or Emulation is set to `Closed` in the commit that records the signed SAR decision memo, and only when PCA-05 names its credited release (section 5.3; 01 section 8.4 row 5; charter section 9) | Complete matrices; `docs/vv/reports/vv-report.md` summarizing every requirement's evidence (SE-53 replacement); certification for use memo and `docs/vv/reports/part97-compliance.md` (SE-54 replacement); ADP for Unit 1 |
| Phase E | Anomalies from use become NCRs; lessons learned | Updates to NCR log and `docs/lessons-learned.md` |

---

## 17. Compliance notes

- NPR 7123.1D App. G Table G-10 success criterion 11, Table G-11 entrance criterion 3.12 and success criterion 8 (spectrum manager concurrence, NTIA Stage 4 system certification): Customized (charter section 12; SE HB §3.11.4: App. G rows are guidance), recorded in 01 section 3.5, whose table labels these rows Customized (NA), its term for a customization with the institutional reason (alignment item A14, resolved). The owner is the FCC licensee. Intent preserved by explicit Part 97 requirements, their verification method and the OnAir authorization of section 6.3 in the on-air delta TRR decision memo.
- NPR 7150.2D §4.5.3 note (formal software testing planned, conducted, witnessed and approved by an independent organization for Class A, B and C): the note is a best practice, not a requirement, so no RMM tailoring row is needed. Authoring and review of cases are independent invocations (charter section 2; section 2 of this document). Automated runs are conducted by the main session, which is also the software lead, and a reviewer can re-execute them with one command from a fresh checkout. The owner witnesses every Bench and OnAir run. The RMM row SWE-066 records the requirement itself as FC and says nothing about the note; nothing further is recorded there.
- NPR 7150.2D §4.5.1 (for Class A software there are additional software test and software integration requirements as defined in NPR 8705.2, Human-Rating Requirements for Space Systems, NPR 7150.2D preface item k): NA. NPR 8705.2 applies to human-rated space systems; cwht is not one; Class A is elected for rigor, not human rating (01 section 3.5 human rating row; charter section 12). Alignment item A3 records this in `docs/process/rmm.json` `meta`.
- SWE-073 (validation on the targeted platform or high-fidelity simulation) is met on the targeted platform. The validation cases `TC-VAL-NNN` and the Bench and OnAir cases run on `CWHT-A-001` with the tagged release named in the VDD (section 11.2 stages 4 to 9; section 5.2 rows `T-HW`, `T-SW-TARGET` and `D`). HostUnit and Emulation are pre-target risk reduction and supporting evidence (section 4), not SWE-073 evidence. Alignment item A1 brings RMM row SWE-073 to the same text.
- SWE-071 (plans and procedures consistent with the software requirements): section 8.2 and rule 7.3.11 (`CASE_STALE`, due PDR); alignment item A4 points RMM row SWE-071 to them.
- SWE-193 (acceptance tests for loaded data and code) and SWE-211 (reused components tested to the custom-code level): section 11.1 and section 4 respectively; RMM row SWE-193 FC; RMM row SWE-211 becomes T for the Rust `core` structural-coverage relief (alignment item A2).
- SWE-203 (assessment of reported non-conformances in COTS, OSS and reused components): section 10.4.
- SWE-194 (pre-delivery verification complete; NPR 7150.2D §4.6): the SAR entrance check that every software requirement is `Verified` or dispositioned by CR, every approved CR implemented (VDD lists them) and every NCR designated for closure closed.

---

## 18. Alignment items and charter issues raised by this document

Raised for the integrating session (Claude main session). The local numbers `A1` to `A14` and `C1` to `C2` are this document's; the integrating session copies each alignment item into the list of `docs/process/05-configuration-and-data-management.md` section 14.1 with the next free `AL-` number, and each charter issue into the next review package's proposed-tailoring section (08 section 5), before the SRR readiness declaration. The product named in each row is changed only by its own maintainer.

| # | Product | Statement there | This document | Resolution proposed | Status (verified 2026-09-25 by the integrating session; A3, A4, A10 and C1 re-checked 2026-09-27 for CR-013) |
|---|---|---|---|---|---|
| A1 | `docs/process/rmm.json` row SWE-073 | Validation of the firmware on the RP2350 emulator before hardware exists, then on target | Section 17: SWE-073 is met on the target only; the emulator does not model time | Rewrite the implementation text to the section 17 bullet; keep FC | Resolved: the RMM row states SWE-073 is met on the target; `render_rmm.py --check` exits 0 |
| A2 | `docs/process/rmm.json` row SWE-211 | "No OSS or reused runtime component is in the flashed image" | Section 4: Rust `core` (OSS) and rustos `api` and `pico2` (reused) are in the image; `core` gets feature-level testing only | Correct the text; change the disposition to T with the `core` structural-coverage relief, rationale and residual risk; owner approval at SRR with the RMM | Resolved in `rmm.json` (T with rationale and residual risk; proposed tailoring for owner approval at SRR); the charter section 12 line is charter issue h of 03 section 6.5 |
| A3 | `docs/process/rmm.json` `meta` | NPR 8705.2 not dispositioned | Section 17: NA, not a human-rated space system | Add a `meta` note with that reason, citing 01 section 3.5 | Open: RMM author (the `rmm.json` writer of the PDR phase, WP-PDR-17), re-dated to the PDR readiness declaration; on 2026-09-27 the `rmm.json` `meta` block has no NPR 8705.2 note |
| A4 | `docs/process/rmm.json` row SWE-071 | A stale-test flag "planned for PDR" with no process rule | Section 8.2 and rule 7.3.11 `CASE_STALE` | Cite section 8.2 and rule 7.3.11 | Open: RMM author (WP-PDR-17), re-dated to the PDR readiness declaration; on 2026-09-27 the row still reads "Planned for PDR: the stale-test flagging option of tools/traceability.py" |
| A5 | `docs/process/rmm.json` row SWE-219 | "Nightly branch and condition coverage, when run, is attached as supporting evidence only" | Section 12: MSR-14 is required at every release and non-credit (charter section 10; 07 section 9.6) | Reword to "required, non-credit (MSR-14)" | Resolved: the row names MSR-14 as a required, non-credit element |
| A6 | `docs/process/se-compliance-matrix.json` rows SE-13 and SE-14 | `implementation_ref` names no ETA approval | Header: ETA approval in `docs/reviews/SRR/decision-memo.md` | Add that memo and this document to both rows | Resolved: both rows cite this document and `docs/reviews/SRR/decision-memo.md`; `render_compliance.py --check` exits 0 |
| A7 | `docs/process/02-requirements-and-traceability.md` AL-17, sections 4.4, 8.3, 8.5 (T-08, T-11, T-19 to T-21) | AL-17 aligns 04 to the superseded charter text of b3d2e13 (Verified only when installed; planned code `SW_VERIFIED_NOT_INSTALLED`); 8.5 cites 39 tests and marks T-19 to T-21 not implemented; `HAZARD_INVERSE` promoted only at PDR | Sections 5.2 and 5.3 follow charter b8214ca: Verified on the credited report, Closed on PCA-05 (`CLOSED_NOT_INSTALLED`); section 7.4 observed state; rule 7.3.6 blocks readiness on `HAZARD_INVERSE` at every gate | Close AL-17 against charter b8214ca; rename the planned code; refresh 8.5 from an observed run; promote `HAZARD_INVERSE` for every gate | Resolved: AL-02-17 is superseded and AL-02-18 closed; 02 T-11, this document, 05 and `tools/README.md` use `CLOSED_NOT_INSTALLED`; 02 section 8.5 carries an observed run. The `HAZARD_INVERSE` promotion stays the tool task of section 7.4 row 7.3.6 (due PDR), with every warning treated as blocking until then |
| A8 | `docs/plan/semp.md` section 5.7 | Host-verified software "become[s] Verified only when that release is installed" | Sections 5.2 and 5.3 (charter section 9) | Reword to Verified on the credited report, Closed on PCA-05 | Resolved: SEMP section 5.7 reads Verified on the credited report and Closed after PCA-05 |
| A9 | `docs/process/07-software-engineering-plan.md` sections 9.1 (Integration row) and 9.5 | 9.1 gives Emulation credit for key-to-`PA_EN` latency and boot-to-safe-state time; 9.5 states "statement coverage" | Section 5.2 (Emulation asserts order only; timing closes at Bench) and section 12 (line and region units) | Limit the 9.1 row to event order; write "line and region" in 9.5 | Resolved: 07 section 9.1 limits the integration row to event order only and section 9.5 states line and region coverage |
| A10 | `docs/risk/register.json` | No risk for untested environmental extremes | Section 14 row 4.2 | Add the risk with the Analysis cases of that row as mitigation, before PDR | Resolved: RSK-059 "No qualification testing at the environmental extremes" (opened 2026-09-25, source this item); section 14 row 4.2 cites it |
| A11 | `docs/safety/hazards.json` HZ-003, `docs/safety/hazard-analysis.md` PA thermal limit provision, `docs/risk/register.json` RSK-006 step S4 | Surface temperature read with the multimeter thermocouple; stop above 60 C surface | Section 6.3 OQ-VV-003 | If OQ-VV-003 answers no at PDR, the hazard analysis author replaces the stop criterion with an NTC-telemetry limit and RSK-006 S4 with the NTC measurement | Open: decided at PDR with OQ-VV-003 |
| A12 | `docs/plan/tpm.json`, `docs/plan/semp.md` | No NCR count TPM; the former text of this document cited charter section 4 item 5, which covers the RFA/RID trend only | Section 10.6 | Owner decides at SRR whether NCR counts by severity become a TPM or stay a report-summary indicator with MSR-27 | Resolved: `docs/plan/tpm.json` holds TPM-019 (`ncr-trend`), preliminary at SRR, approved or removed by the owner with the TPM definitions at PDR (SEMP App. F item F-14) |
| A13 | `tools/toolchain.lock.md` | No rows for the Pico-based logic capture (sigrok-pico firmware, `sigrok-cli`) or the tinySA Ultra | Sections 4 and 6 | Add the rows with their TV record paths before the TRR that opens a campaign using them | Resolved: `tools/toolchain.lock.md` sections 1 and 1.1 carry rows for `sigrok-cli`, the sigrok-pico firmware and the tinySA Ultra, with their TV records due TRR |
| A14 | `docs/process/01-lifecycle-and-reviews.md` section 3.5 | Spectrum-manager and NTIA App. G rows labelled NA | Charter section 12 labels them Customized | Use "Customized (App. G guidance, SE HB §3.11.4)" in the 3.5 table, or the charter changes its label | Resolved: 01 section 3.5 defines Customized (NA) in its disposition vocabulary as a customization (no waiver) with the institutional reason, which matches the charter section 12 label Customized |
| C1 | Charter section 6 | No `ACC-` identifier scheme; ADR-011, the emulator research, hazards, requirements and the ConOps use `ACC-EMU-001` | Section 4 cites the emulator TV record for the credit scope | Either add `ACC-<TOOL>-NNN` as the credit-scope identifier inside a TV record, or direct the products to cite `TV-NNN` only | Resolved against charter `4e3f891`: charter section 6 defines `ACC-<TOOL>-NNN`, "accreditation scope statement, held inside its TV-NNN record (e.g. ACC-EMU-001)"; section 4 cites `ACC-EMU-001` as that identifier |
| C2 | Charter section 9 | The tinySA receipt was recorded "by ADR before TRR, closing OQ-VV-001" in the charter text this document first followed | Sections 6, 6.3, 13, 14 and 16 now follow the charter | A receipt is an observation, not a decision: it is recorded in a receipt inspection report `docs/vv/reports/receipt-inspection-<n>.md` plus the tinySA TV record `docs/cm/tool-validation/TV-NNN-tinysa.md`, and ADR-021 stays the purchase decision | Resolved against charter 4e3f891: charter section 9 now reads "is recorded by a receipt-inspection report and a TV-NNN record before TRR, closing OQ-VV-001" |
