robinonsay/cwht/docs/test_cases/sys/test_cases.md

# SYS verification cases (TC-SYS)

Rendered from `docs/test_cases/sys/test_cases.json` (module `SYS`); the JSON is the controlled record and this file is regenerated from it, never edited by hand. Author: independent test author invocation (charter section 2, IEEE 1012 independence), written from `docs/requirements/sys/requirements.json` and the process documents, before any design or code exists. Status of every case: Draft (written, not yet reviewed under `docs/process/04-verification-and-validation.md` section 8.3). Date: 2026-09-25.

## Summary

- Cases: 114; live SYS requirements covered: 189 of 189 (retired REQ-SYS-016 and REQ-SYS-123 are not cited).
- By method: Analysis 23, Demonstration 6, Inspection 14, Test 71.
- By evidence class: Bench 77, Inspection 14, Simulation 23.
- Credit rows (04 section 5.2): Test requirements close by Bench on the delivered unit (T-HW); Analysis by Simulation (A); Inspection by Inspection (I); Demonstration by owner-operated Bench runs (D). The diode-probe characterization case carries SUPPORT and never closes a requirement.
- The HostUnit and Emulation evidence named in the requirements' verification notes closes the REQ-SW children allocated at PDR and is authored with those modules; Simulation and dev-board runs named as pre-build evidence are supporting cases to be added with the design.
- Planned scripts and fixtures named in `automation_ref`, `setup` and `instruments` (for example `tools/analyze_logic_capture.py`, `tools/tinysa_scan_check.py`, `tools/rf_probe_power.py`, `hardware/sim/checks/*`, `docs/vv/fixtures/*`) do not exist yet; each is a prerequisite of the case becoming Active.
- Revision 2026-09-26 (SRR package item R16, owner rulings of 2026-09-26): SRR decision 25 moves every transmit test frequency to the 144.0012 and 147.9988 MHz guard limits (TC-SYS-008, 009, 110); SRR decision 37 rewrites TC-SYS-038 for the no-gap paddle watchdog of REQ-SYS-054 and the 2 s squeeze limit of new REQ-SYS-184, and keeps every squeeze in TC-SYS-012, 014, 025, 027 and 028 at or below 1.5 s; SRR decision 41 adds TC-SYS-113 for new REQ-SYS-187 to 190 and replaces the bench test-mode generator at 5 W or 1 W, which REQ-SYS-187 now holds at 0.5 W, by the keying fixture, tune carriers or hand keying in TC-SYS-014, 036, 067, 100 and 105, and fits TC-SYS-007, 022, 042, 049 (the generator kept at 0.5 W in four 110 s entries), 051, 053, 057 and 104 to the 120 s mode and 60 s tone limits (corrected by CR-008, INSP-025 finding-12); SRR decision 72 adds TC-SYS-111 (REQ-SYS-185) and TC-SYS-112 (REQ-SYS-186); SRR decision 113 (CR-002) retypes TC-SYS-085, 086 and 091 to Inspection with credit row I; the TBR lines of TC-SYS-108 to 110 cite SRR decisions 38 to 40. This file was regenerated from the JSON in the same commit.
- Revision 2026-09-27 (CR-008, SRR liens of INSP-025 and INSP-003, on branch `cr/CR-008-srr-liens-l1-and-tc-sys` pending disposition): TC-SYS-003 and 008 read the tinySA level at every RF-off point with the attenuator S21 and calibration-output steps (finding-2); the RF-off criterion of TC-SYS-003, 008, 047, 066, 082, 083, 101, 108, 109 and 110 is corrected for the attenuator and increased by the tinySA level accuracy (finding-3); TC-SYS-064 approaches each threshold from its violating side by the fixture setting accuracy (finding-4); TC-SYS-061 cites the room-temperature REQ-SYS-083 and new TC-SYS-116 closes new REQ-SYS-194, the 0 C to 45 C span by Analysis (finding-5); TC-SYS-073 names its checker (finding-7); 57 Bench cases list a setup photograph (finding-8); TC-SYS-060 guards every temperature point inward (finding-9); TC-SYS-036 and 105 leave 10-dit word spaces and show full-length keying on the capture (finding-10); TC-SYS-111 judges the charge path by the 1 mA level of REQ-SYS-185 with the other cell at 3.70 V (finding-11); no acceptance value is the test author's any longer: tolerances come from the requirements CR-008 amends (TC-SYS-013, 030, 031, 050, 056, 064, 065, 102, 111, 112) and one-sided time bounds are applied with the section 8.2 decision rule (TC-SYS-034, 038, 113) (INSP-003 finding-25 and finding-31). This file was regenerated from the JSON in the same commit.

## Case index

| Case | Title | Method | Class | Requirements |
|---|---|---|---|---|
| TC-SYS-001 | A1A-only emission path: transmit-chain schematic and firmware keying-path inspection | Inspection | Inspection | REQ-SYS-001 |
| TC-SYS-002 | Operating modes part 1: every allowed transition T01 to T25 of ConOps Table 3.4-2 on the delivered unit | Test | Bench | REQ-SYS-002 |
| TC-SYS-003 | Operating modes part 2: forbidden transitions and properties F1 to F9 of ConOps section 3.4 | Test | Bench | REQ-SYS-002, REQ-SYS-183 |
| TC-SYS-004 | Transmit armed only after a power-on self-test in which every check has passed | Test | Bench | REQ-SYS-003 |
| TC-SYS-005 | Carrier end within 20 ms on every inhibit, flag and latched fault, a distinct message per fault type, and Fault-safe left only through acknowledgment after clearance or by switch-off or power removal | Test | Bench | REQ-SYS-004, REQ-SYS-005, REQ-SYS-067 |
| TC-SYS-006 | Operator call sign after every power-on and every operator setting retained across power cycles and cell removal | Test | Bench | REQ-SYS-006, REQ-SYS-135 |
| TC-SYS-007 | Transmitted Morse only from key-jack closures, and bench test mode entry only after selection and confirmation | Test | Bench | REQ-SYS-007, REQ-SYS-179 |
| TC-SYS-008 | Transmit carrier placed from 144.0012 to 147.9988 MHz and inhibited outside that range | Test | Bench | REQ-SYS-008, REQ-SYS-009, REQ-SYS-183 |
| TC-SYS-009 | Carrier frequency error budget over temperature and one-year aging | Analysis | Simulation | REQ-SYS-010 |
| TC-SYS-010 | Diode RF probe characterization on the dummy load (fixture case, supporting) | Test | Bench | REQ-SYS-011, REQ-SYS-012 |
| TC-SYS-011 | Output power at the 0.5, 1, 2 and 5 W steps across the band and pack voltage | Test | Bench | REQ-SYS-011, REQ-SYS-012 |
| TC-SYS-012 | Survival of 60 s of 5 W keying at 80 percent duty into open, short and SWR 10:1 loads at four phases | Test | Bench | REQ-SYS-013 |
| TC-SYS-013 | Keying envelope shape and 26 dB occupied bandwidth by transient simulation and FFT | Analysis | Simulation | REQ-SYS-014, REQ-SYS-015 |
| TC-SYS-014 | Spurious emissions from 9 kHz to 1.5 GHz at every step, three frequencies and the pack voltage extremes | Test | Bench | REQ-SYS-017, REQ-SYS-018 |
| TC-SYS-015 | Tune carrier at 0.5 W unless a higher step is confirmed, ended within 5.5 s | Test | Bench | REQ-SYS-019, REQ-SYS-020 |
| TC-SYS-016 | Reception of A1A signals from 144.000 to 148.000 MHz | Test | Bench | REQ-SYS-021 |
| TC-SYS-017 | Receiver minimum discernible signal from the noise-figure and filter-loss cascade | Analysis | Simulation | REQ-SYS-022, REQ-SYS-023 |
| TC-SYS-018 | End-to-end receive selectivity: -6 dB and -60 dB bandwidths, stopband, ultimate rejection and ripple | Analysis | Simulation | REQ-SYS-024, REQ-SYS-025, REQ-SYS-026, REQ-SYS-027, REQ-SYS-028 |
| TC-SYS-019 | Adjacent-signal desensitization and reciprocal-mixing dynamic range from selectivity and phase noise | Analysis | Simulation | REQ-SYS-029, REQ-SYS-031 |
| TC-SYS-020 | Receive level control: no gain pumping from an adjacent keyed signal and audio level over -120 to -20 dBm | Analysis | Simulation | REQ-SYS-030, REQ-SYS-032 |
| TC-SYS-021 | Image and intermediate-frequency response rejection from the front-end and mixer responses | Analysis | Simulation | REQ-SYS-033 |
| TC-SYS-022 | Internally generated receive responses from 144.010 to 147.999 MHz | Test | Bench | REQ-SYS-034 |
| TC-SYS-023 | Receive filter-centre calibration trim over +/-500 Hz in 10 Hz steps, retained across a power cycle | Demonstration | Bench | REQ-SYS-035 |
| TC-SYS-024 | Receive sensitivity recovery after hang expiry from T/R release and LNA supply settling | Analysis | Simulation | REQ-SYS-036 |
| TC-SYS-025 | Receiver survival of +27 dBm at the antenna port | Test | Bench | REQ-SYS-037 |
| TC-SYS-026 | Keying the transmitter with the owner's straight key and with the iambic paddle | Demonstration | Bench | REQ-SYS-038, REQ-SYS-039 |
| TC-SYS-027 | Keyer modes Straight, Iambic A, Iambic B, Ultimatic and Bug against the reference model | Test | Bench | REQ-SYS-040 |
| TC-SYS-028 | Keyer speed range 5 to 50 WPM in 1 WPM steps and element and space timing accuracy | Test | Bench | REQ-SYS-041, REQ-SYS-042 |
| TC-SYS-029 | Paddle-to-element latency and sidetone onset latency for key and paddle | Test | Bench | REQ-SYS-043, REQ-SYS-159 |
| TC-SYS-030 | Semi break-in hang time of 3 to 30 dits at the displayed speed | Test | Bench | REQ-SYS-044 |
| TC-SYS-031 | Sidetone frequency from 300 Hz to 1000 Hz in 10 Hz steps | Test | Bench | REQ-SYS-045 |
| TC-SYS-032 | CW pitch equals sidetone: frequency-plan analysis of receive LO, BFO and trim against the sidetone setting | Analysis | Simulation | REQ-SYS-046 |
| TC-SYS-033 | Key contact thresholds, then survival of -5 V to +12 V on each key contact, then thresholds re-checked | Test | Bench | REQ-SYS-047, REQ-SYS-049 |
| TC-SYS-034 | Key closure accepted after 2 ms of continuous contact and opening after 5 ms of continuous break | Test | Bench | REQ-SYS-048, REQ-SYS-162 |
| TC-SYS-035 | Electrostatic discharge tolerance at the key jack, headphone jack and antenna port from clamp ratings and return paths | Analysis | Simulation | REQ-SYS-050 |
| TC-SYS-036 | Key-input states unchanged while transmitting 5 W with 1.5 m unshielded leads on the key and headphone jacks | Test | Bench | REQ-SYS-051 |
| TC-SYS-037 | Key-input mode changes only by menu selection, selection accepted with a closed input, and the key-closed interlock | Test | Bench | REQ-SYS-052, REQ-SYS-056, REQ-SYS-163 |
| TC-SYS-038 | Straight-key timeout, paddle watchdog and paddle squeeze limit, each holding the transmitter unkeyed until the contacts read open | Test | Bench | REQ-SYS-053, REQ-SYS-054, REQ-SYS-184 |
| TC-SYS-039 | Hardware transmit cutoff independent of firmware, 7.5 s to 13 s into a continuous key-down | Test | Bench | REQ-SYS-055 |
| TC-SYS-040 | Enclosure CAD and BOM: operator control set, external envelope and antenna-port face | Inspection | Inspection | REQ-SYS-057, REQ-SYS-103, REQ-SYS-175 |
| TC-SYS-041 | Tuning one step per detent from 10 Hz to 10 kHz with rotation rate, and band crossing time | Test | Bench | REQ-SYS-058, REQ-SYS-164 |
| TC-SYS-042 | Headphone level set in at least 32 steps from mute to the active cap | Test | Bench | REQ-SYS-059 |
| TC-SYS-043 | Status display content in Receive, Transmit-keyed and Tune, and every setting within two menu levels | Demonstration | Bench | REQ-SYS-060, REQ-SYS-062 |
| TC-SYS-044 | Displayed frequency character height from the rendered status frame and the display pixel pitch | Inspection | Inspection | REQ-SYS-061 |
| TC-SYS-045 | 5 W selected only after a step selection followed by a separate confirmation press | Test | Bench | REQ-SYS-063 |
| TC-SYS-046 | Defaults at first power-on and after a configuration reset: 1 W, Iambic A, 15 WPM, 600 Hz, 8-dit hang, 5 ms envelope | Test | Bench | REQ-SYS-064, REQ-SYS-136 |
| TC-SYS-047 | Guest lock: no RF from any source while set, including after power cycles, and two-step set and release | Test | Bench | REQ-SYS-065, REQ-SYS-066, REQ-SYS-183 |
| TC-SYS-048 | Identification reminder 9 min 00 s +/-5 s after the first transmission following the previous reminder | Test | Bench | REQ-SYS-068 |
| TC-SYS-049 | Separation reminder per step and mode, and cumulative key-down time over 6 min and 30 min windows | Test | Bench | REQ-SYS-069, REQ-SYS-171 |
| TC-SYS-050 | USB input current, charge-state indication in every phase, and charging paused while the radio is on | Test | Bench | REQ-SYS-070, REQ-SYS-090, REQ-SYS-093 |
| TC-SYS-051 | Headphone output ceiling for a full-scale sine and for any digital audio pattern | Test | Bench | REQ-SYS-071, REQ-SYS-072 |
| TC-SYS-052 | Headphone output ceiling under every single component failure in the output path | Analysis | Simulation | REQ-SYS-073 |
| TC-SYS-053 | Default 30 mVrms audio cap until acknowledgment, restored at every power-on unless a persistent unlock is selected | Test | Bench | REQ-SYS-074, REQ-SYS-170 |
| TC-SYS-054 | Receive audio mute at key-down, hold through transmit and hang, and restore fade | Analysis | Simulation | REQ-SYS-075, REQ-SYS-157, REQ-SYS-158 |
| TC-SYS-055 | Headphone transients at key-down, key-up, hang expiry, plug insertion and power-on | Analysis | Simulation | REQ-SYS-076 |
| TC-SYS-056 | Headphone amplifier output disabled while no plug is in the headphone jack | Test | Bench | REQ-SYS-077 |
| TC-SYS-057 | Channel balance into 16 to 64 ohm at the active cap, and survival of a headphone contact short to sleeve | Test | Bench | REQ-SYS-078, REQ-SYS-079 |
| TC-SYS-058 | BOM, schematic and ICD inspection: cell holders, antenna connector, controller module and key-jack wiring | Inspection | Inspection | REQ-SYS-080, REQ-SYS-104, REQ-SYS-126, REQ-SYS-174 |
| TC-SYS-059 | Charge termination voltage per cell and charge time of a 3000 mAh pack from low-battery power-down | Test | Bench | REQ-SYS-081, REQ-SYS-091 |
| TC-SYS-060 | Charge temperature window 0 C to 45 C and cell over-temperature power-down at 60 C | Test | Bench | REQ-SYS-082, REQ-SYS-099 |
| TC-SYS-061 | Independent cell over-voltage protection between 4.25 and 4.30 V at room temperature | Test | Bench | REQ-SYS-083 |
| TC-SYS-062 | Independent cell under-voltage disconnect at 2.50 V and survival of a reversed cell | Test | Bench | REQ-SYS-084, REQ-SYS-086 |
| TC-SYS-063 | Pack over-current and short-circuit trip level from the protector threshold, FET resistance and fuse rating | Analysis | Simulation | REQ-SYS-085 |
| TC-SYS-064 | Cell insertion check, dual-path cell-voltage check and rails held off for out-of-window cells | Test | Bench | REQ-SYS-087, REQ-SYS-088, REQ-SYS-166 |
| TC-SYS-065 | Charge safety timer of 15 h and constant-voltage current-fall supervision | Test | Bench | REQ-SYS-089, REQ-SYS-167 |
| TC-SYS-066 | Hardware transmit inhibit with USB present, and no transmitter supply from USB alone | Test | Bench | REQ-SYS-092, REQ-SYS-149, REQ-SYS-183 |
| TC-SYS-067 | Battery life of at least 8 h at 1:9 and the low-battery warning at least 15 min before transmit inhibit | Test | Bench | REQ-SYS-094, REQ-SYS-096 |
| TC-SYS-068 | Battery life of at least 6 h at 1:4 | Test | Bench | REQ-SYS-095 |
| TC-SYS-069 | Low-battery transmit inhibit at 3.20 V, low-battery power-down at 3.00 V and high pack-voltage transmit lockout at 8.60 V | Test | Bench | REQ-SYS-097, REQ-SYS-098, REQ-SYS-153 |
| TC-SYS-070 | Pack current with the switch off and loads removed by the mechanical power switch | Test | Bench | REQ-SYS-100, REQ-SYS-101 |
| TC-SYS-071 | Unit mass with cells fitted and without the antenna | Test | Bench | REQ-SYS-102 |
| TC-SYS-072 | Antenna-port bending moment of 4.0 N m without jack rotation, and counterpoise attachment position and resistance | Test | Bench | REQ-SYS-105, REQ-SYS-107 |
| TC-SYS-073 | Antenna-port mating life from the jack datasheet rating and the handbook torque | Analysis | Simulation | REQ-SYS-106 |
| TC-SYS-074 | Fully seated plugs at the key jack, headphone jack and micro-USB receptacle through the enclosure openings | Demonstration | Bench | REQ-SYS-108 |
| TC-SYS-075 | Enclosure material, anodize and conductive masking in the STEP, drawing and order notes | Inspection | Inspection | REQ-SYS-109 |
| TC-SYS-076 | Enclosure mechanical safety by scripted CAD checks: edge break, knob clearance and cell-cover pinch gaps | Analysis | Simulation | REQ-SYS-110, REQ-SYS-111, REQ-SYS-168 |
| TC-SYS-077 | PA junction and hand-hold surface temperature from the thermal resistance chain | Analysis | Simulation | REQ-SYS-112, REQ-SYS-113 |
| TC-SYS-078 | Operating and storage temperature ranges from every part rating | Analysis | Simulation | REQ-SYS-114, REQ-SYS-115 |
| TC-SYS-079 | Requirements met after a 1.0 m drop onto a hard floor on each face with the antenna fitted | Test | Bench | REQ-SYS-116 |
| TC-SYS-080 | Requirements met after 10 min of IEC 60529 IPX2 dripping water with plugs inserted | Test | Bench | REQ-SYS-117 |
| TC-SYS-081 | PA over-temperature inhibit and PA temperature-sensor fault response | Test | Bench | REQ-SYS-118, REQ-SYS-155 |
| TC-SYS-082 | Safe state first on reset, panic and latched fault; RF off in reset, bootloader and firmware load; hang recovery within 2 s | Test | Bench | REQ-SYS-119, REQ-SYS-130, REQ-SYS-131, REQ-SYS-183 |
| TC-SYS-083 | RF output only while both the keyer key-down and the separately maintained PA permit are asserted | Test | Bench | REQ-SYS-120, REQ-SYS-183 |
| TC-SYS-084 | RF exposure evaluation on record and reference antenna gain | Analysis | Simulation | REQ-SYS-121, REQ-SYS-172 |
| TC-SYS-085 | Operations handbook safety content checked against every documentation and operator-procedure control | Inspection | Inspection | REQ-SYS-122 |
| TC-SYS-086 | Enclosure legend artwork and engraving callout against the required legend | Inspection | Inspection | REQ-SYS-124 |
| TC-SYS-087 | Build quantity cap in the release package and the unit serial register | Inspection | Inspection | REQ-SYS-125 |
| TC-SYS-088 | Firmware platform, host-testable layering and single interrupt priority | Inspection | Inspection | REQ-SYS-127, REQ-SYS-128, REQ-SYS-129 |
| TC-SYS-089 | Fault-safe on a failed firmware-image integrity check, and defaults for corrupt or out-of-range settings | Test | Bench | REQ-SYS-132, REQ-SYS-134 |
| TC-SYS-090 | Firmware update through the micro-USB receptacle with the cells removed | Demonstration | Bench | REQ-SYS-133 |
| TC-SYS-091 | Assembly split: every surface-mount part placed by PCBWay, only through-hole parts and exposed-pad modules for the owner | Inspection | Inspection | REQ-SYS-137, REQ-SYS-138 |
| TC-SYS-092 | Circuit board stack-up, PCBWay DRC and probe test points | Inspection | Inspection | REQ-SYS-139, REQ-SYS-142 |
| TC-SYS-093 | Parts sourcing: distributor stock for turnkey parts and the PA, dated quotes for owner-procured parts | Inspection | Inspection | REQ-SYS-140, REQ-SYS-178 |
| TC-SYS-094 | Transmit monitor port attenuation of 40 dB +/-1 dB into 50 ohm | Test | Bench | REQ-SYS-141 |
| TC-SYS-095 | Boot banner over USB serial and telemetry on the UART test pads without USB | Test | Bench | REQ-SYS-143, REQ-SYS-150 |
| TC-SYS-096 | Requirements met after assembly with only the stored firmware calibration of pitch centre and reference trim | Test | Bench | REQ-SYS-144 |
| TC-SYS-097 | 70 cm readiness: band-dependent blocks partitioned and a reserved band control | Inspection | Inspection | REQ-SYS-145, REQ-SYS-146 |
| TC-SYS-098 | Unit cost from the labor-free cost model with CDR quotes | Analysis | Simulation | REQ-SYS-147 |
| TC-SYS-099 | MIT license, third-party notices and pushed baseline tags in the public repository | Inspection | Inspection | REQ-SYS-148 |
| TC-SYS-100 | Spurious emissions and rated power into SWR 2:1 loads | Test | Bench | REQ-SYS-151, REQ-SYS-152 |
| TC-SYS-101 | Synthesizer unlock or off-frequency fault and forward-power detector fault responses | Test | Bench | REQ-SYS-154, REQ-SYS-156, REQ-SYS-183 |
| TC-SYS-102 | Straight-key contact to RF rise latency and a constant lead-in across an over | Test | Bench | REQ-SYS-160, REQ-SYS-161 |
| TC-SYS-103 | Display legibility at 0.5 m under 300 lux without a backlight | Analysis | Simulation | REQ-SYS-165 |
| TC-SYS-104 | Default audio cap restored after 20 h of cumulative unlocked operation | Test | Bench | REQ-SYS-169 |
| TC-SYS-105 | Only the sidetone on the headphones while keying 5 W with 1.5 m unshielded leads | Demonstration | Bench | REQ-SYS-173 |
| TC-SYS-106 | Receive-mode emissions at the antenna port from 9 kHz to 1.5 GHz | Test | Bench | REQ-SYS-176 |
| TC-SYS-107 | Enclosure attenuation of digital and switching-converter emissions | Analysis | Simulation | REQ-SYS-177 |
| TC-SYS-108 | Transmission-length hardware backstop: RF ended at 150 s to 180 s of continuous transmit until the return to receive, independent of firmware | Test | Bench | REQ-SYS-180, REQ-SYS-183 |
| TC-SYS-109 | Hardware PA over-temperature cut-off: RF ended while the heat-sink sensor reads above 95 C, independent of firmware | Test | Bench | REQ-SYS-181, REQ-SYS-183 |
| TC-SYS-110 | Independent frequency verification: no transmission unless the measured synthesizer output agrees with the set frequency within 10 kHz, before and during transmit | Test | Bench | REQ-SYS-182, REQ-SYS-183 |
| TC-SYS-111 | Further cell over-voltage layer opening the charge path at a threshold within 4.30 to 4.35 V, independent of the charger, the 4.25 V protector and firmware | Test | Bench | REQ-SYS-185 |
| TC-SYS-112 | Per-cell voltage detection kept in every other protection layer after any single cell-sense connection opens or reaches 10 kohm | Test | Bench | REQ-SYS-186 |
| TC-SYS-113 | Bench test mode guard: forced 0.5 W step, exit within 120 s, full-scale test tone ended within 60 s, and the mode inactive after every reset and power-on | Test | Bench | REQ-SYS-187, REQ-SYS-188, REQ-SYS-189, REQ-SYS-190 |
| TC-SYS-116 | Independent cell over-voltage threshold within 4.25 to 4.30 V from 0 C to 45 C by datasheet computation | Analysis | Simulation | REQ-SYS-194 |

## Requirement coverage

| Requirement | Method | Cases |
|---|---|---|
| REQ-SYS-001 | Inspection | TC-SYS-001 |
| REQ-SYS-002 | Test | TC-SYS-002, TC-SYS-003 |
| REQ-SYS-003 | Test | TC-SYS-004 |
| REQ-SYS-004 | Test | TC-SYS-005 |
| REQ-SYS-005 | Test | TC-SYS-005 |
| REQ-SYS-006 | Test | TC-SYS-006 |
| REQ-SYS-007 | Test | TC-SYS-007 |
| REQ-SYS-008 | Test | TC-SYS-008 |
| REQ-SYS-009 | Test | TC-SYS-008 |
| REQ-SYS-010 | Analysis | TC-SYS-009 |
| REQ-SYS-011 | Test | TC-SYS-010, TC-SYS-011 |
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

## Cases

### TC-SYS-001: A1A-only emission path: transmit-chain schematic and firmware keying-path inspection

| Field | Value |
|---|---|
| Requirements | REQ-SYS-001 |
| Method / class | Inspection / Inspection |
| Status | Draft |
| Automation | `tools/check_tx_modulation_paths.py` |

**Setup.** Article: design data at tag baseline/cdr: transmit-chain schematic sheets, the netlist exported from them, and the firmware source of the keyer, transmit sequencer, envelope driver and synthesizer driver at the same tag. Configuration: tools/check_tx_modulation_paths.py (planned) walks the netlist from every audio, sidetone, audio-DAC footprint and headphone net to the synthesizer, PA drive, PA bias, ALC and envelope nets through any number of passive parts; the firmware writers of the envelope drive, PA enable and synthesizer frequency registers are listed from the compiler call graph. Credit row: I. Inspection of design data, closed at CDR on the product baseline (docs/process/04-verification-and-validation.md sections 5.1 item 4 and 5.2); the receipt inspection named in the verification_note, where there is one, is recorded as data in the same report. Tools: kicad-cli at its lock path /Applications/KiCad/KiCad.app/Contents/MacOS/kicad-cli and Python per tools/toolchain.lock.md; rustc and cargo per the lock Safety: not applicable (design data only). Environment: not applicable.

**Procedure.**

1. Export the schematic netlist at tag baseline/cdr with kicad-cli sch export netlist.
2. Run tools/check_tx_modulation_paths.py on the netlist and save the list of every path from an audio or tone net to an RF-chain control net.
3. Classify each listed path on the rendered schematic as a DC supply or ground return with decoupling (acceptable) or a signal coupling (finding).
4. Confirm on the schematic that the keying envelope drive is the only time-varying control of carrier amplitude and that the synthesizer has no modulation input other than its frequency-setting interface.
5. List every firmware function that writes the envelope drive output, the PA enable output or the synthesizer frequency registers, and save the list.
6. Confirm that the envelope drive is written only by the keying-envelope sequencer in the key-down and key-up ramps and that no audio, sidetone or tone-generation function writes the envelope drive or the synthesizer registers.
7. Record the inspected file paths, their commit and tool versions in the report.
8. On any finding against the criteria, stop and open an NCR per docs/process/04-verification-and-validation.md section 10.

**Acceptance criteria.** Pass if no signal-coupling path exists from any audio, sidetone or tone net to the synthesizer, PA drive, PA bias, ALC or envelope nets (DC supply and ground returns with decoupling excepted), the keying envelope is the only time-varying amplitude control of the carrier, and the only firmware writers of the envelope drive, PA enable and synthesizer frequency are the keying-envelope sequencer and the frequency-setting code; otherwise Fail.

**Expected artifacts.**

- `tx-netlist.net` (other): Netlist exported at baseline/cdr
- `tx-modulation-paths.txt` (report): Checker list of audio-to-RF-control paths with the classification of each
- `fw-rf-writers.txt` (report): Firmware functions that write the envelope drive, PA enable and synthesizer registers

### TC-SYS-002: Operating modes part 1: every allowed transition T01 to T25 of ConOps Table 3.4-2 on the delivered unit

| Field | Value |
|---|---|
| Requirements | REQ-SYS-002 |
| Method / class | Test / Bench |
| Status | Draft |
| Automation | `tools/analyze_mode_trace.py` |

**Setup.** Article: CWHT-A-001, enclosure lid off for test-point access, running the fault-injection test build of release/FW-vX.Y.Z named in firmware/releases/VDD-vX.Y.Z.md (a build flavour of the release commit whose injection commands arrive over the UART test pads from the host serial terminal through the 3.3 V serial adapter, or over USB serial only in steps that expect no carrier, because USB VBUS sets the USB flag and the hardware transmit inhibit of REQ-SYS-092, and which toggles the injection-marker test pad at the instant of each injection); the release image is restored and checked with picotool verify at the end of the case. Configuration: pack from the two-cell simulator fixture at 3.70 V per cell; USB through the USB breakout fixture when a step applies it; dummy load on the antenna port; logic capture on PA_EN, TX_KEY, the key tip and ring inputs and the UART telemetry pad; mode names read from the telemetry mode field and the display; faults injected with the fault-injection commands; 0.5 W step. Credit row: T-HW. Test of a system requirement closed by Bench on the delivered unit (docs/process/04-verification-and-validation.md section 5.2), run after the TRR that opens the campaign (section 13) and witnessed by the owner; the pre-build Simulation, HostUnit and Emulation evidence named in each requirement's verification_note is supporting only and is not part of this case. Hazard controls exercised: HZ-004, HZ-011 (from the cited requirements; docs/safety/hazards.json). Credentials: instruments and tools per tools/toolchain.lock.md at the commit recorded in the report. Safety: every transmission goes into the 50 ohm dummy load or the calibrated power attenuator, connected before power-on, never into an open antenna port; key-down duty kept within the load rating recorded in the report; anyone other than the operator stays 0.6 m or more from the unit and load while keying and 1.0 m or more during a tune carrier (NGO-019); the bench supply current limit is set before each power-on; antistatic wrist strap while the lid is off; the PA area is not touched after key-down runs. Safety: cells and cell simulators are handled per the operations handbook battery section: current limit set before connection, cell terminals never shorted, cells on a non-flammable surface and attended during every charge or discharge run; a cell warm to the touch above about 45 C ends the run. Environment: room temperature 18 to 28 C; the cells or cell simulators named in Configuration; dummy load on the antenna port.

**Procedure.**

1. Run the logic-capture reference pulse-train check of this session and record the result (docs/process/04-verification-and-validation.md section 4).
2. Wire the UART telemetry test pad to a logic-capture channel and confirm that the sigrok-cli UART decoder prints the telemetry lines (REQ-SYS-150).
3. Start a continuous capture. With the switch off and no USB, turn the switch on: expect Off to Self-test to Receive (T01, T08).
4. Close the straight key for 1 s, then wait for hang expiry: expect Receive to Transmit-keyed to Receive (T10, T11). Repeat with the paddle dit lever held for 1 s in Iambic A.
5. Select Tune with its confirmation and let it time out; repeat and end it with a button press: expect Receive to Tune to Receive twice (T12, T13).
6. Select the test menu with its confirmation, then exit: expect Receive to Bench-test to Receive (T14, T15).
7. Apply USB, send the bootloader host command, copy the release UF2 and let the unit reset with the switch on: expect Receive to Firmware-update to Self-test (T16, T21).
8. Inject a latched cause (cutoff-seen command), clear it and acknowledge: expect Receive to Fault-safe to Self-test to Receive (T17, T24).
9. Inject a watchdog hang: expect Receive to Self-test to Receive (T18).
10. Remove USB and turn the switch off: expect Receive to Off (T19). Apply USB with the switch off: expect Off to Charging (T02). Remove USB: expect Charging to Off (T04).
11. Apply USB with the switch off, then turn the switch on: expect Charging to Self-test (T05); turn it off again: expect Charging (T19 with USB).
12. In Charging send the bootloader host command, copy the UF2 and let it reset with the switch off: expect Charging to Firmware-update to Charging (T07, T22); send the command again and unplug USB: expect Firmware-update to Off (T23).
13. With the switch off, hold BOOTSEL and apply USB: expect Off to Firmware-update (T03); unplug USB.
14. In Charging set the simulated cells 600 mV apart (3.40 V and 4.00 V): expect Charging to Fault-safe (T06); restore them and remove USB with the switch off: expect Fault-safe to Off (T25).
15. Arm the display-check failure injection and turn the switch on: expect Self-test to Fault-safe (T09); turn the switch off (T25) and clear the injection.
16. Turn on, then lower the simulated pack to 5.9 V in Receive: expect Receive to Off (T20); repeat with USB present: expect Receive to Charging (T20 with USB).
17. Stop the capture, export it and run tools/analyze_mode_trace.py to list every mode change with its time, cause and the PA_EN state in each mode.
18. Record instrument calibration state, instrument and capture firmware versions, tool versions and the firmware version in the report.
19. On any discrepancy, stop and open an NCR per docs/process/04-verification-and-validation.md section 10.

**Acceptance criteria.** Pass if each of the transitions T01 to T25 of docs/conops/conops.md Table 3.4-2 is observed from its From mode to its To mode on its event and guard in the telemetry mode sequence and on the display, no other mode change occurs, and PA_EN is high only in Transmit-keyed, Tune and a Bench-test keyed test; otherwise Fail.

**Instruments and fixtures.**

- Pico-based logic capture (second Pico 2 with sigrok-pico firmware read by sigrok-cli; planned, ADR-009), 3.3 V inputs, 1 MS/s unless a step states otherwise
- Two-cell simulator fixture: the bench supply across the pack terminals with an adjustable, buffered mid-point tap for the cell junction and a parallel sink resistor so that the fixture absorbs charger current (docs/vv/fixtures/cell-simulator.md, planned; characterized before TRR)
- USB power breakout fixture with VBUS routed through the multimeter current range (docs/vv/fixtures/usb-breakout.md, planned)
- Host computer with picotool and a serial terminal per tools/toolchain.lock.md, micro-USB cable
- 3.3 V USB-to-UART serial adapter between the host computer and the UART test pads, so that injection commands reach the unit with its USB port disconnected (docs/vv/fixtures/uart-adapter.md, planned)
- 50 ohm BNC dummy load with SMA adapter, power rating recorded in the report
- Owner's straight key and iambic paddle, 3.5 mm TRS plugs (SI-034)
- Multimeter, DC voltage and DC current ranges, accuracy per datasheet copied into the report (OQ-VV-003)

**Expected artifacts.**

- `mode-trace.csv` (csv): Time, mode, transition id, cause and PA_EN state
- `mode-capture.sr` (other): Raw logic capture of the session
- `modes-setup.jpg` (photo): Photograph of the setup

### TC-SYS-003: Operating modes part 2: forbidden transitions and properties F1 to F9 of ConOps section 3.4

| Field | Value |
|---|---|
| Requirements | REQ-SYS-002, REQ-SYS-183 |
| Method / class | Test / Bench |
| Status | Draft |
| Automation | `tools/analyze_mode_trace.py` |

**Setup.** Article: CWHT-A-001, enclosure lid off for test-point access, running the fault-injection test build of release/FW-vX.Y.Z named in firmware/releases/VDD-vX.Y.Z.md (a build flavour of the release commit whose injection commands arrive over the UART test pads from the host serial terminal through the 3.3 V serial adapter, or over USB serial only in steps that expect no carrier, because USB VBUS sets the USB flag and the hardware transmit inhibit of REQ-SYS-092, and which toggles the injection-marker test pad at the instant of each injection); the release image is restored and checked with picotool verify at the end of the case. Configuration: as part 1 (TC-SYS-002), except that the antenna port goes to the calibrated power attenuator and the tinySA Ultra (zero span at the set frequency, max-hold) for every attempt of F1 to F4, so that the RF-off level of REQ-SYS-183 is read at each; every forbidden attempt is made with the straight key and then with the paddle where it involves keying (SI-018). Credit row: T-HW. Test of a system requirement closed by Bench on the delivered unit (docs/process/04-verification-and-validation.md section 5.2), run after the TRR that opens the campaign (section 13) and witnessed by the owner; the pre-build Simulation, HostUnit and Emulation evidence named in each requirement's verification_note is supporting only and is not part of this case. RF-off level: the acceptance criteria use -57 dBm, the value of REQ-SYS-183 marked TBR (close by PDR); a change returns this case to Draft (docs/process/04-verification-and-validation.md section 8.2). Hazard controls exercised: HZ-004, HZ-011 (from the cited requirements; docs/safety/hazards.json). Credentials: instruments and tools per tools/toolchain.lock.md at the commit recorded in the report. Safety: every transmission goes into the 50 ohm dummy load or the calibrated power attenuator, connected before power-on, never into an open antenna port; key-down duty kept within the load rating recorded in the report; anyone other than the operator stays 0.6 m or more from the unit and load while keying and 1.0 m or more during a tune carrier (NGO-019); the bench supply current limit is set before each power-on; antistatic wrist strap while the lid is off; the PA area is not touched after key-down runs. Safety: cells and cell simulators are handled per the operations handbook battery section: current limit set before connection, cell terminals never shorted, cells on a non-flammable surface and attended during every charge or discharge run; a cell warm to the touch above about 45 C ends the run. Environment: room temperature 18 to 28 C; the cells or cell simulators named in Configuration; dummy load on the antenna port.

**Procedure.**

1. Run the logic-capture reference pulse-train check of this session and record the result (docs/process/04-verification-and-validation.md section 4).
2. Connect the calibrated power attenuator and the tinySA Ultra to the antenna port; measure the attenuator and cable S21 on the NanoVNA from 9 kHz (or the NanoVNA lower limit) to 1.5 GHz and save the Touchstone file; run the tinySA Ultra internal calibration-output check; record both.
3. Wire the UART telemetry test pad to a logic-capture channel and confirm that the sigrok-cli UART decoder prints the telemetry lines (REQ-SYS-150).
4. F1: hold the straight key closed during Self-test, then the paddle dit lever; after a forced Self-test failure (display-check injection) key both again in Fault-safe; read the tinySA level at the set frequency for each attempt.
5. F2 flags: with GUEST, then PRACTICE, then USB present, then LOWBATT (pack at 6.3 V) set in turn, key with the straight key and the paddle and select Tune; read the tinySA level at the set frequency for each attempt.
6. F2 inhibits: with KEY (plug closed at switch-on), HOT (PA sensor substituted at its 90 C equivalent) and GUARD (tuned to 147.9995 MHz) active in turn, key with both keys and select Tune; read the tinySA level at the set frequency for each attempt.
7. F2 USB power alone: remove the cells, apply USB, key with both keys and select Tune; read the tinySA level at the set frequency for each attempt.
8. F3: attempt a key closure, a Tune selection and a test-menu entry from Charging, Firmware-update, Fault-safe and Self-test.
9. F4: tune to 144.0005 MHz and key with both keys; read the tinySA level at the set frequency for each attempt.
10. F5: in Fault-safe with the cause still present, pulse RUN (controller reset); confirm the unit re-enters Fault-safe and does not reach Receive.
11. F6: set GUEST, perform a configuration reset, then load the release UF2; confirm GUEST remains set after each.
12. F7: start one Tune and read its carrier duration from TX_KEY; with the fault build holding TX_KEY high, read the longest carrier duration.
13. F8: insert and remove a TS plug and a TRS plug in each key-input mode; confirm the mode never changes without a menu selection.
14. F9: hold the straight key closed and send the bootloader host command; confirm Firmware-update is not entered while PA_EN is high.
15. Export the capture and run tools/analyze_mode_trace.py.
16. Record instrument calibration state, instrument and capture firmware versions, tool versions and the firmware version in the report.
17. On any discrepancy, stop and open an NCR per docs/process/04-verification-and-validation.md section 10.

**Acceptance criteria.** Pass if PA_EN stays low and no carrier at the set frequency above -57 dBm at the antenna port on the tinySA Ultra, corrected for the attenuator and increased by the tinySA level accuracy (the RF-off level of REQ-SYS-183) for every attempt of F1 to F4 and F3's forbidden entries do not occur; the Fault-safe latch survives the reset (F5); GUEST survives the configuration reset and the firmware load (F6); the Tune carrier lasts at most 5.5 s and no carrier lasts more than 13 s (F7); the key-input mode never changes without a menu selection (F8); and Firmware-update is never entered while PA_EN is high (F9); otherwise Fail.

**Instruments and fixtures.**

- Pico-based logic capture (second Pico 2 with sigrok-pico firmware read by sigrok-cli; planned, ADR-009), 3.3 V inputs, 1 MS/s unless a step states otherwise
- tinySA Ultra spectrum analyzer (ADR-021) through the calibrated 30 to 40 dB attenuator rated 10 W or more, attenuator S21 measured on the NanoVNA in the same session; level accuracy per its TV record
- Two-cell simulator fixture: the bench supply across the pack terminals with an adjustable, buffered mid-point tap for the cell junction and a parallel sink resistor so that the fixture absorbs charger current (docs/vv/fixtures/cell-simulator.md, planned; characterized before TRR)
- USB power breakout fixture with VBUS routed through the multimeter current range (docs/vv/fixtures/usb-breakout.md, planned)
- Host computer with picotool and a serial terminal per tools/toolchain.lock.md, micro-USB cable
- 3.3 V USB-to-UART serial adapter between the host computer and the UART test pads, so that injection commands reach the unit with its USB port disconnected (docs/vv/fixtures/uart-adapter.md, planned)
- 50 ohm BNC dummy load with SMA adapter, power rating recorded in the report
- Owner's straight key and iambic paddle, 3.5 mm TRS plugs (SI-034)
- NTC substitution fixture: fixed resistors at the temperature equivalents named in the steps, switched in place of the cell or PA sensor at its test pad, the switch's second pole wired to a logic-capture channel as the event marker (docs/vv/fixtures/ntc-substitution.md, planned)
- NanoVNA, SOL calibration at the cable end used, checked on the dummy load

**Expected artifacts.**

- `forbidden-attempts.csv` (csv): Attempt, mode, keying source, PA_EN, RF reading and result
- `forbidden-capture.sr` (other): Raw logic capture
- `forbidden-attenuator-s21.s2p` (other): Attenuator and cable S21 of the session
- `forbidden-tinysa-traces.png` (plot): tinySA zero-span traces of every F1 to F4 attempt
- `tc-sys-003-setup.jpg` (photo): Photograph of the as-run test setup (docs/process/04-verification-and-validation.md section 8.1)

### TC-SYS-004: Transmit armed only after a power-on self-test in which every check has passed

| Field | Value |
|---|---|
| Requirements | REQ-SYS-003 |
| Method / class | Test / Bench |
| Status | Draft |
| Automation | `tools/analyze_logic_capture.py` |

**Setup.** Article: CWHT-A-001, enclosure lid off for test-point access, running the fault-injection test build of release/FW-vX.Y.Z named in firmware/releases/VDD-vX.Y.Z.md (a build flavour of the release commit whose injection commands arrive over the UART test pads from the host serial terminal through the 3.3 V serial adapter, or over USB serial only in steps that expect no carrier, because USB VBUS sets the USB flag and the hardware transmit inhibit of REQ-SYS-092, and which toggles the injection-marker test pad at the instant of each injection); the release image is restored and checked with picotool verify at the end of the case. Configuration: pack from the two-cell simulator fixture; cell NTC through the NTC substitution fixture; dummy load; logic capture on PA_EN, TX_KEY, the key tip and ring inputs and the UART telemetry pad; each self-test check forced by a fixture setting or an injection command; the firmware-image check is exercised by TC-SYS-089. Credit row: T-HW. Test of a system requirement closed by Bench on the delivered unit (docs/process/04-verification-and-validation.md section 5.2), run after the TRR that opens the campaign (section 13) and witnessed by the owner; the pre-build Simulation, HostUnit and Emulation evidence named in each requirement's verification_note is supporting only and is not part of this case. Hazard controls exercised: HZ-004, HZ-014 (from the cited requirements; docs/safety/hazards.json). Credentials: instruments and tools per tools/toolchain.lock.md at the commit recorded in the report. Safety: every transmission goes into the 50 ohm dummy load or the calibrated power attenuator, connected before power-on, never into an open antenna port; key-down duty kept within the load rating recorded in the report; anyone other than the operator stays 0.6 m or more from the unit and load while keying and 1.0 m or more during a tune carrier (NGO-019); the bench supply current limit is set before each power-on; antistatic wrist strap while the lid is off; the PA area is not touched after key-down runs. Safety: cells and cell simulators are handled per the operations handbook battery section: current limit set before connection, cell terminals never shorted, cells on a non-flammable surface and attended during every charge or discharge run; a cell warm to the touch above about 45 C ends the run. Environment: room temperature 18 to 28 C; the cells or cell simulators named in Configuration; dummy load on the antenna port.

**Procedure.**

1. Run the logic-capture reference pulse-train check of this session and record the result (docs/process/04-verification-and-validation.md section 4).
2. Wire the UART telemetry test pad to a logic-capture channel and confirm that the sigrok-cli UART decoder prints the telemetry lines (REQ-SYS-150).
3. Baseline: all conditions nominal; switch on, read the self-test result lines, close the straight key for 1 s and the paddle dit lever for 1 s after Self-test ends; expect PA_EN to follow the keying.
4. Force the cell-voltage check with simulated cells 600 mV apart but both inside 2.5 V to 4.3 V (3.40 V and 4.00 V) and switch on.
5. Force the cell-temperature check (NTC fixture at its 65 C equivalent) and switch on.
6. Force the dual-path cell-voltage check (injection command: 150 mV disagreement) and switch on.
7. Force the rail check (injection command: 3.3 V rail out of tolerance) and switch on.
8. Force the amplifier-enable check (injection command: enable readback high) and switch on.
9. Force the display check (injection command: display not responding) and switch on.
10. For each forced check above: read the telemetry self-test line and the display message, close the straight key and then the paddle for 1 s each at 10 s after Self-test ends, record PA_EN, restore the condition and switch off.
11. Write a corrupt configuration through the test interface and switch on: read the substituted defaults and key with both keys.
12. Hold the straight key closed through switch-on and release it 2 s after Self-test ends; key again after 1 s.
13. Export the capture and run tools/analyze_logic_capture.py to list PA_EN edges against the self-test end and key closures.
14. Record instrument calibration state, instrument and capture firmware versions, tool versions and the firmware version in the report.
15. On any discrepancy, stop and open an NCR per docs/process/04-verification-and-validation.md section 10.

**Acceptance criteria.** Pass if for every forced check the telemetry names the failed item, the unit is in Fault-safe with the item shown and PA_EN stays low for every straight-key and paddle closure; the corrupt configuration is replaced by defaults, shown, Self-test passes and PA_EN follows the key; with the key closed at switch-on PA_EN stays low until the key has read open for 500 ms; and in the baseline PA_EN follows both keys; otherwise Fail.

**Instruments and fixtures.**

- Pico-based logic capture (second Pico 2 with sigrok-pico firmware read by sigrok-cli; planned, ADR-009), 3.3 V inputs, 1 MS/s unless a step states otherwise
- Two-cell simulator fixture: the bench supply across the pack terminals with an adjustable, buffered mid-point tap for the cell junction and a parallel sink resistor so that the fixture absorbs charger current (docs/vv/fixtures/cell-simulator.md, planned; characterized before TRR)
- NTC substitution fixture: fixed resistors at the temperature equivalents named in the steps, switched in place of the cell or PA sensor at its test pad, the switch's second pole wired to a logic-capture channel as the event marker (docs/vv/fixtures/ntc-substitution.md, planned)
- Host computer with picotool and a serial terminal per tools/toolchain.lock.md, micro-USB cable
- 3.3 V USB-to-UART serial adapter between the host computer and the UART test pads, so that injection commands reach the unit with its USB port disconnected (docs/vv/fixtures/uart-adapter.md, planned)
- 50 ohm BNC dummy load with SMA adapter, power rating recorded in the report
- Owner's straight key and iambic paddle, 3.5 mm TRS plugs (SI-034)

**Expected artifacts.**

- `selftest-results.csv` (csv): Forced check, telemetry result, display message, PA_EN per closure
- `selftest-capture.sr` (other): Raw logic capture
- `tc-sys-004-setup.jpg` (photo): Photograph of the as-run test setup (docs/process/04-verification-and-validation.md section 8.1)

### TC-SYS-005: Carrier end within 20 ms on every inhibit, flag and latched fault, a distinct message per fault type, and Fault-safe left only through acknowledgment after clearance or by switch-off or power removal

| Field | Value |
|---|---|
| Requirements | REQ-SYS-004, REQ-SYS-005, REQ-SYS-067 |
| Method / class | Test / Bench |
| Status | Draft |
| Automation | `tools/analyze_logic_capture.py` |

**Setup.** Article: CWHT-A-001, enclosure lid off for test-point access, running the fault-injection test build of release/FW-vX.Y.Z named in firmware/releases/VDD-vX.Y.Z.md (a build flavour of the release commit whose injection commands arrive over the UART test pads from the host serial terminal through the 3.3 V serial adapter, or over USB serial only in steps that expect no carrier, because USB VBUS sets the USB flag and the hardware transmit inhibit of REQ-SYS-092, and which toggles the injection-marker test pad at the instant of each injection); the release image is restored and checked with picotool verify at the end of the case. Configuration: dummy load; 5 W step at 146.00 MHz; USB disconnected except in the charger-fault step; logic capture on the injection-marker pad, PA_EN, the display chip-select and the UART telemetry pad at 1 MS/s; the RF fall after PA_EN release is bounded by the envelope Analysis (TC-SYS-013) because PA_EN is released only after the completed shaped fall (REQ-SYS-004 verification_note), and RF with PA_EN low is at the RF-off level of REQ-SYS-183, measured by the cases that cite REQ-SYS-183. The causes are those the REQ-SYS-004 rationale takes from docs/conops/conops.md Tables 3.4-3 and 3.4-4: the inhibits KEY, HOT and GUARD, the flags GUEST, PRACTICE, USB and LOWBATT, and the latched causes; the ConOps table states the same 20 ms as REQ-SYS-004 (ConOps appendix D item D3, closed). The exit rules of REQ-SYS-005 are exercised with the two latched causes its verification_note names, a cell-sense disagreement and a repeated watchdog reset. Credit row: T-HW. Test of a system requirement closed by Bench on the delivered unit (docs/process/04-verification-and-validation.md section 5.2), run after the TRR that opens the campaign (section 13) and witnessed by the owner; the pre-build Simulation, HostUnit and Emulation evidence named in each requirement's verification_note is supporting only and is not part of this case. TBR values: the acceptance criteria use the values of REQ-SYS-004, REQ-SYS-067 as written, including those marked TBR (close by PDR); a change at PDR returns this case to Draft (docs/process/04-verification-and-validation.md section 8.2, SWE-071). Hazard controls exercised: HZ-004 (from the cited requirements; docs/safety/hazards.json). Credentials: instruments and tools per tools/toolchain.lock.md at the commit recorded in the report. Safety: every transmission goes into the 50 ohm dummy load or the calibrated power attenuator, connected before power-on, never into an open antenna port; key-down duty kept within the load rating recorded in the report; anyone other than the operator stays 0.6 m or more from the unit and load while keying and 1.0 m or more during a tune carrier (NGO-019); the bench supply current limit is set before each power-on; antistatic wrist strap while the lid is off; the PA area is not touched after key-down runs. Environment: room temperature 18 to 28 C; the pack is supplied by the bench supply at 7.4 V +/-0.05 V through the battery terminals unless a step sets another value; dummy load on the antenna port.

**Procedure.**

1. Run the logic-capture reference pulse-train check of this session and record the result (docs/process/04-verification-and-validation.md section 4).
2. Wire the UART telemetry test pad to a logic-capture channel and confirm that the sigrok-cli UART decoder prints the telemetry lines (REQ-SYS-150), and confirm that the host serial terminal reaches the injection commands through the serial adapter with USB disconnected.
3. List the injectable causes of the build and record the list: inhibits KEY, HOT and GUARD; flags GUEST, PRACTICE, USB and LOWBATT; latched causes second watchdog reset, Self-test check failed, independent cutoff seen, cell-sense disagreement, cell reversed or mismatched, charger fault, synthesizer unlocked, synthesizer off frequency, PA sensor out of range and forward-power detector implausible.
4. Inhibits and flags: for each of KEY, HOT, GUARD, GUEST, PRACTICE, USB and LOWBATT, key down with the straight key held, inject the cause 1 s after key-down, hold the key for a further 2 s, release, clear the cause by command and wait 5 s; record the mode shown before and after the clearance.
5. Repeat the previous step for each of the seven causes keyed with the paddle dah lever held at 15 WPM.
6. Latched causes during a carrier: for each of cell-sense disagreement, synthesizer unlocked, synthesizer off frequency, PA sensor out of range and forward-power detector implausible, key down (straight key held for the first, third and fifth, paddle dah lever held for the second and fourth), inject the cause 1 s after key-down and hold the key for a further 2 s; photograph the displayed message; clear the cause, acknowledge and confirm Self-test then Receive before the next cause.
7. Latched causes that do not arise during a carrier: inject each in the mode where it arises and photograph the displayed message: Self-test check failed and cell reversed or mismatched (each injection armed, then switch off and on), independent cutoff seen (fault build holding TX_KEY high until the hardware cutoff of REQ-SYS-055 acts, as in TC-SYS-039), second watchdog reset (two watchdog-expiry injections in Receive without a switch-off) and charger fault (switch off, USB applied through the USB breakout with the two-cell simulator charging, injection over USB serial); clear each cause and acknowledge, except the charger fault, which is left by removing USB with the switch off (T25).
8. Exit rules, cell-sense disagreement: inject it in Receive and keep it present; press acknowledge; confirm the unit stays in Fault-safe; close the straight key and then the paddle dah lever for 2 s each.
9. With the cause still present, pulse RUN (controller reset); confirm the unit returns through Self-test to Fault-safe without reaching Receive; repeat the two key closures.
10. Clear the cause without acknowledging and wait 60 s; confirm the unit stays in Fault-safe; repeat the two key closures.
11. With the cause cleared and not acknowledged, pulse RUN; confirm the unit returns through Self-test to Fault-safe; repeat the two key closures.
12. Acknowledge; confirm Self-test then Receive, and close the straight key for 1 s.
13. Exit rules, repeated watchdog reset: inject two watchdog expiries in Receive without a switch-off so that the second reset latches Fault-safe; pulse RUN and confirm the unit returns through Self-test to Fault-safe; repeat the two key closures; acknowledge and confirm Self-test then Receive; close the paddle dit lever for 1 s.
14. Switch-off exit: latch a cell-sense disagreement again, clear it by command and, without acknowledging, turn the power switch off; confirm Off (display dark, no telemetry on the UART pad); turn the switch on and confirm Self-test then Receive.
15. Power-removal exit: latch a cell-sense disagreement again, clear it by command and, without acknowledging and with the switch on, disconnect the bench supply for 5 s; reconnect it and confirm Self-test then Receive.
16. Export the capture and run tools/analyze_logic_capture.py to measure, per injection, marker-to-PA_EN-fall and marker-to-first-display-frame-write latencies, and to list every PA_EN rise and every mode change in the exit-rule steps.
17. Record instrument calibration state, instrument and capture firmware versions, tool versions and the firmware version in the report.
18. On any discrepancy, stop and open an NCR per docs/process/04-verification-and-validation.md section 10.

**Acceptance criteria.** Pass if, for every inhibit, flag and latched cause injected during a carrier (steps 4 to 6) with either key type, PA_EN falls at most 20 ms after the injection marker (REQ-SYS-004); for every latched cause (steps 6 and 7) the display write that shows the cause begins at most 1 s after the marker and each cause shows a message distinct from every other (REQ-SYS-067); and Fault-safe is left only through Self-test after the cause has cleared and the operator has acknowledged (steps 12 and 13) or by switch-off or power removal (steps 14 and 15), while acknowledgment with the cause present, clearance without acknowledgment and a controller reset with or without the cause present each leave the unit in Fault-safe with no PA_EN rise on any key closure (steps 8 to 11 and 13) (REQ-SYS-005); otherwise Fail.

**Instruments and fixtures.**

- Pico-based logic capture (second Pico 2 with sigrok-pico firmware read by sigrok-cli; planned, ADR-009), 3.3 V inputs, 1 MS/s unless a step states otherwise
- Host computer with picotool and a serial terminal per tools/toolchain.lock.md, micro-USB cable
- 3.3 V USB-to-UART serial adapter between the host computer and the UART test pads, so that injection commands reach the unit with its USB port disconnected (docs/vv/fixtures/uart-adapter.md, planned)
- 50 ohm BNC dummy load with SMA adapter, power rating recorded in the report
- Owner's straight key and iambic paddle, 3.5 mm TRS plugs (SI-034)
- Adjustable bench supply, 0 to 30 V, current limit set per step
- USB power breakout fixture with VBUS routed through the multimeter current range (docs/vv/fixtures/usb-breakout.md, planned)
- Two-cell simulator fixture: the bench supply across the pack terminals with an adjustable, buffered mid-point tap for the cell junction and a parallel sink resistor so that the fixture absorbs charger current (docs/vv/fixtures/cell-simulator.md, planned; characterized before TRR)

**Expected artifacts.**

- `faultsafe-latency.csv` (csv): Cause, class, keying source, marker-to-PA_EN and marker-to-display latencies
- `faultsafe-exit.csv` (csv): Exit-rule step, event, mode before and after, PA_EN rises on the key closures
- `faultsafe-messages.jpg` (photo): Photographs of each displayed cause message
- `faultsafe-capture.sr` (other): Raw logic capture

### TC-SYS-006: Operator call sign after every power-on and every operator setting retained across power cycles and cell removal

| Field | Value |
|---|---|
| Requirements | REQ-SYS-006, REQ-SYS-135 |
| Method / class | Test / Bench |
| Status | Draft |
| Automation | none (manual) |

**Setup.** Article: CWHT-A-001 in its enclosure, firmware at the released version release/FW-vX.Y.Z named in firmware/releases/VDD-vX.Y.Z.md (recorded as vX.Y.Z+<short SHA> in the report). Configuration: unit on the owner's cells; settings read from the menus and the status screen and photographed. Credit row: T-HW. Test of a system requirement closed by Bench on the delivered unit (docs/process/04-verification-and-validation.md section 5.2), run after the TRR that opens the campaign (section 13) and witnessed by the owner; the pre-build Simulation, HostUnit and Emulation evidence named in each requirement's verification_note is supporting only and is not part of this case. Credentials: instruments and tools per tools/toolchain.lock.md at the commit recorded in the report. Safety: cells and cell simulators are handled per the operations handbook battery section: current limit set before connection, cell terminals never shorted, cells on a non-flammable surface and attended during every charge or discharge run; a cell warm to the touch above about 45 C ends the run. Environment: room temperature 18 to 28 C; the cells or cell simulators named in Configuration; dummy load on the antenna port.

**Procedure.**

1. Enter the one-character call sign K; power-cycle; read the call sign shown after power-on.
2. Enter the ten-character call sign KC1ABC/QRP; power-cycle; read it.
3. Set every operator setting to a non-default value and record the list (frequency, step, key-input mode, keyer mode, speed, sidetone, hang, envelope time, volume, PRACTICE, filter trim, reference trim, call sign).
4. Switch off, remove both cells for 1 min, reinsert them and switch on.
5. Read every setting and the call sign; photograph the menus.
6. Record instrument calibration state, instrument and capture firmware versions, tool versions and the firmware version in the report.
7. On any discrepancy, stop and open an NCR per docs/process/04-verification-and-validation.md section 10.

**Acceptance criteria.** Pass if the last-entered call sign of 1 and of 10 characters is displayed after each power-on (REQ-SYS-006), and every listed setting reads its set value after the cell removal (REQ-SYS-135); otherwise Fail. The audio-cap unlock is excluded because REQ-SYS-170 restores the cap at power-on unless a persistent unlock is selected.

**Instruments and fixtures.**

- Owner's 3000 mAh 18650 cells, a matched pair

**Expected artifacts.**

- `persistence.csv` (csv): Setting, value set, value read
- `persistence-menus.jpg` (photo): Photographs of the menus

### TC-SYS-007: Transmitted Morse only from key-jack closures, and bench test mode entry only after selection and confirmation

| Field | Value |
|---|---|
| Requirements | REQ-SYS-007, REQ-SYS-179 |
| Method / class | Test / Bench |
| Status | Draft |
| Automation | `tools/analyze_logic_capture.py` |

**Setup.** Article: CWHT-A-001, enclosure lid off for test-point access, firmware at the released version release/FW-vX.Y.Z named in firmware/releases/VDD-vX.Y.Z.md (recorded as vX.Y.Z+<short SHA> in the report). Configuration: dummy load; 0.5 W step at 146.00 MHz; logic capture on TX_KEY, PA_EN and the keyer test point at 100 kS/s for the long captures; mode read from the display. Credit row: T-HW. Test of a system requirement closed by Bench on the delivered unit (docs/process/04-verification-and-validation.md section 5.2), run after the TRR that opens the campaign (section 13) and witnessed by the owner; the pre-build Simulation, HostUnit and Emulation evidence named in each requirement's verification_note is supporting only and is not part of this case. Hazard controls exercised: HZ-004, HZ-005 (from the cited requirements; docs/safety/hazards.json). Credentials: instruments and tools per tools/toolchain.lock.md at the commit recorded in the report. Safety: every transmission goes into the 50 ohm dummy load or the calibrated power attenuator, connected before power-on, never into an open antenna port; key-down duty kept within the load rating recorded in the report; anyone other than the operator stays 0.6 m or more from the unit and load while keying and 1.0 m or more during a tune carrier (NGO-019); the bench supply current limit is set before each power-on; antistatic wrist strap while the lid is off; the PA area is not touched after key-down runs. Environment: room temperature 18 to 28 C; the pack is supplied by the bench supply at 7.4 V +/-0.05 V through the battery terminals unless a step sets another value; dummy load on the antenna port.

**Procedure.**

1. Run the logic-capture reference pulse-train check of this session and record the result (docs/process/04-verification-and-validation.md section 4).
2. With the key jack empty, capture TX_KEY for 10 min in Receive.
3. Set PRACTICE and capture TX_KEY for 10 min; clear PRACTICE.
4. Enter the bench test mode with its selection and confirmation but start no test; capture TX_KEY until the mode exits (at most 120 s, REQ-SYS-188, SRR decision 41 (owner ruling 2026-09-26)); repeat five times.
5. Insert the straight key, leave it untouched and capture 1 min; repeat with the paddle.
6. Apply each test-mode control sequence without its confirmation: test-menu selection then back; selection then 30 s timeout; confirmation press without a selection; every other single button and knob action; read the mode on the display after each.
7. Select the test menu and confirm; select the PARIS keyed test into the dummy load; record the time of the start confirmation press on a spare capture channel wired to the button.
8. Let the PARIS test run 20 s, then exit.
9. Export the captures and run tools/analyze_logic_capture.py to count TX_KEY edges per interval.
10. Record instrument calibration state, instrument and capture firmware versions, tool versions and the firmware version in the report.
11. On any discrepancy, stop and open an NCR per docs/process/04-verification-and-validation.md section 10.

**Acceptance criteria.** Pass if TX_KEY shows zero edges in the two 10 min jack-open captures, the five idle test-mode captures and the two idle-key captures, every non-confirmed sequence leaves the mode unchanged with zero TX_KEY edges, and the test-mode generator's first TX_KEY edge follows the start confirmation press; otherwise Fail.

**Instruments and fixtures.**

- Pico-based logic capture (second Pico 2 with sigrok-pico firmware read by sigrok-cli; planned, ADR-009), 3.3 V inputs, 1 MS/s unless a step states otherwise
- 50 ohm BNC dummy load with SMA adapter, power rating recorded in the report
- Owner's straight key and iambic paddle, 3.5 mm TRS plugs (SI-034)
- Adjustable bench supply, 0 to 30 V, current limit set per step

**Expected artifacts.**

- `keysource-edges.csv` (csv): Interval, mode, TX_KEY edge count
- `keysource-capture.sr` (other): Raw logic captures
- `tc-sys-007-setup.jpg` (photo): Photograph of the as-run test setup (docs/process/04-verification-and-validation.md section 8.1)

### TC-SYS-008: Transmit carrier placed from 144.0012 to 147.9988 MHz and inhibited outside that range

| Field | Value |
|---|---|
| Requirements | REQ-SYS-008, REQ-SYS-009, REQ-SYS-183 |
| Method / class | Test / Bench |
| Status | Draft |
| Automation | none (manual) |

**Setup.** Article: CWHT-A-001, enclosure lid off for test-point access, firmware at the released version release/FW-vX.Y.Z named in firmware/releases/VDD-vX.Y.Z.md (recorded as vX.Y.Z+<short SHA> in the report). Configuration: antenna port to the calibrated power attenuator and the tinySA Ultra; 0.5 W step; logic capture on PA_EN; the tinySA reference accuracy from its TV record is the frequency uncertainty of each marker reading. Test frequencies: the transmit range limits 144.0012 and 147.9988 MHz of the 1.2 kHz band-edge guard (SRR decision 25 (owner ruling 2026-09-26), ADR-023 option (a)). Credit row: T-HW. Test of a system requirement closed by Bench on the delivered unit (docs/process/04-verification-and-validation.md section 5.2), run after the TRR that opens the campaign (section 13) and witnessed by the owner; the pre-build Simulation, HostUnit and Emulation evidence named in each requirement's verification_note is supporting only and is not part of this case. TBR values: the acceptance criteria use the values of REQ-SYS-008, REQ-SYS-009 and REQ-SYS-183 as written, including those marked TBR (close by PDR); a change at PDR returns this case to Draft (docs/process/04-verification-and-validation.md section 8.2, SWE-071). RF-off level: the acceptance criteria use -57 dBm, the value of REQ-SYS-183 marked TBR (close by PDR); a change returns this case to Draft (docs/process/04-verification-and-validation.md section 8.2). Hazard controls exercised: HZ-008 (from the cited requirements; docs/safety/hazards.json). Credentials: instruments and tools per tools/toolchain.lock.md at the commit recorded in the report. Safety: every transmission goes into the 50 ohm dummy load or the calibrated power attenuator, connected before power-on, never into an open antenna port; key-down duty kept within the load rating recorded in the report; anyone other than the operator stays 0.6 m or more from the unit and load while keying and 1.0 m or more during a tune carrier (NGO-019); the bench supply current limit is set before each power-on; antistatic wrist strap while the lid is off; the PA area is not touched after key-down runs. Environment: room temperature 18 to 28 C; the pack is supplied by the bench supply at 7.4 V +/-0.05 V through the battery terminals unless a step sets another value; dummy load on the antenna port.

**Procedure.**

1. Run the logic-capture reference pulse-train check of this session and record the result (docs/process/04-verification-and-validation.md section 4).
2. Measure the attenuator and cable S21 on the NanoVNA from 9 kHz (or the NanoVNA lower limit) to 1.5 GHz and save the Touchstone file; run the tinySA Ultra internal calibration-output check; record both.
3. Tune to 144.0012 MHz, close the straight key for 3 s and read the tinySA marker at the carrier peak (span 20 kHz, narrowest RBW).
4. Repeat at 146.000 and 147.9988 MHz, and at 144.0012 MHz keyed by the paddle dah lever for 3 s.
5. Tune to 144.0005 MHz, then 147.9995 MHz, and, if the tuning allows them, 144.0011, 147.9989, 143.999 and 148.000 MHz; at each close the straight key for 3 s and then the paddle dah lever for 3 s, and read the display transmit-state field and the tinySA level at the set frequency (zero span, max-hold).
6. Export the capture and the tinySA traces.
7. Record instrument calibration state, instrument and capture firmware versions, tool versions and the firmware version in the report.
8. On any discrepancy, stop and open an NCR per docs/process/04-verification-and-validation.md section 10.

**Acceptance criteria.** Pass if at each set frequency from 144.0012 to 147.9988 MHz the unit keys and the carrier marker lies within the set frequency +/-(2.5 ppm plus the tinySA reference accuracy) (REQ-SYS-008), and at every set frequency outside 144.0012 to 147.9988 MHz PA_EN stays low, no carrier at the set frequency above -57 dBm at the antenna port on the tinySA Ultra, corrected for the attenuator and increased by the tinySA level accuracy (the RF-off level of REQ-SYS-183) and the display shows the guard inhibit (REQ-SYS-009); otherwise Fail.

**Instruments and fixtures.**

- tinySA Ultra spectrum analyzer (ADR-021) through the calibrated 30 to 40 dB attenuator rated 10 W or more, attenuator S21 measured on the NanoVNA in the same session; level accuracy per its TV record
- NanoVNA, SOL calibration at the cable end used, checked on the dummy load
- Pico-based logic capture (second Pico 2 with sigrok-pico firmware read by sigrok-cli; planned, ADR-009), 3.3 V inputs, 1 MS/s unless a step states otherwise
- Owner's straight key and iambic paddle, 3.5 mm TRS plugs (SI-034)
- Adjustable bench supply, 0 to 30 V, current limit set per step

**Expected artifacts.**

- `guard-markers.csv` (csv): Set frequency, keying source, marker frequency, PA_EN and RF level
- `guard-traces.png` (plot): tinySA traces at each set frequency
- `tc-sys-008-setup.jpg` (photo): Photograph of the as-run test setup (docs/process/04-verification-and-validation.md section 8.1)

### TC-SYS-009: Carrier frequency error budget over temperature and one-year aging

| Field | Value |
|---|---|
| Requirements | REQ-SYS-010 |
| Method / class | Analysis / Simulation |
| Status | Draft |
| Automation | `tools/budgets/frequency_error_budget.py` |

**Setup.** Article: design data at tag baseline/cdr: frequency-reference and synthesizer part numbers and datasheets from the CDR BOM, the synthesizer register table and the reference-trim resolution. Configuration: tools/budgets/frequency_error_budget.py (planned) sums, as a worst case, the reference initial tolerance after calibration, its stability from -10 C to +45 C, one-year aging, the trim resolution and the synthesizer fractional-N rounding error at 144.0012, 146.000 and 147.9988 MHz. Test frequencies: the transmit range limits 144.0012 and 147.9988 MHz of the 1.2 kHz band-edge guard (SRR decision 25 (owner ruling 2026-09-26), ADR-023 option (a)). Credit row: A. Analysis closed by Simulation on the CDR design data and confirmed at SAR by the physical configuration audit of every analyzed value (docs/process/04-verification-and-validation.md sections 5.1 item 5 and 5.2); the post-build readings named in the verification_note are supporting data only. TBR values: the acceptance criteria use the values of REQ-SYS-010 as written, including those marked TBR (close by PDR); a change at PDR returns this case to Draft (docs/process/04-verification-and-validation.md section 8.2, SWE-071). Hazard controls exercised: HZ-008 (from the cited requirements; docs/safety/hazards.json). Risk acceptance: the verification_note of REQ-SYS-010 (RSK-002) begins 'Analysis accepted per RSK-NNN'; that risk carries the hazard control not closed by Test (docs/process/04-verification-and-validation.md section 3, rule 7.3.6). Tools: Python per tools/toolchain.lock.md Safety: not applicable (design data only). Environment: not applicable.

**Procedure.**

1. Confirm that the budget inputs equal the CDR BOM part numbers and the datasheet values cited in the script header (script prints the diff; an empty diff is required).
2. Run tools/budgets/frequency_error_budget.py and save its table of each term in ppm and the total at the three frequencies.
3. Confirm that the displayed-frequency computation in the firmware design uses the same reference frequency constant as the budget.
4. Record tool versions, the design-data tag and the commit of every deck, model, script and checker in the report.
5. On any assertion or checker failure, or any difference between the analyzed values and the design data, stop and open an NCR per docs/process/04-verification-and-validation.md section 10.

**Acceptance criteria.** Pass if the worst-case sum of initial tolerance after calibration, -10 C to +45 C stability, one-year aging, trim resolution and synthesizer rounding is at most 2.5 ppm at 144.0012, 146.000 and 147.9988 MHz; otherwise Fail.

**Expected artifacts.**

- `frequency-error-budget.csv` (csv): Budget terms in ppm and totals per frequency
- `frequency-error-budget.log.txt` (log): Script output with the input diff

### TC-SYS-010: Diode RF probe characterization on the dummy load (fixture case, supporting)

| Field | Value |
|---|---|
| Requirements | REQ-SYS-011, REQ-SYS-012 |
| Method / class | Test / Bench |
| Status | Draft |
| Automation | `tools/rf_probe_power.py` |

**Setup.** Article: the diode RF probe fixture (1N5711 or equivalent in its printed housing, docs/vv/fixtures/rf-probe.md, planned) with the BNC T and the dummy load it is used on; no cwht unit. Configuration: NanoVNA on the dummy load with and without the probe on the T; the probe's diode forward-drop curve measured at DC with the bench supply through a series resistor and the multimeter; uncertainty budget computed by tools/rf_probe_power.py --characterize. Credit row: SUPPORT. Fixture characterization that every diode-probe power case depends on (docs/process/04-verification-and-validation.md section 6.2 output-power row); it never closes a requirement and must be Passed before the TRR that opens the power cases. It also underpins the probe readings of TC-SYS-015, TC-SYS-045, TC-SYS-046, TC-SYS-100 and TC-SYS-012; it cites only REQ-SYS-011 and REQ-SYS-012 so that, until the CLOSING_CLASS check of 04 section 7.4 exists, the matrix lists it against the fewest requirements. Credentials: instruments and tools per tools/toolchain.lock.md at the commit recorded in the report. Safety: no cwht unit is connected and no RF above the NanoVNA output level is applied; the DC characterization uses the bench supply with a 10 mA current limit. Environment: room temperature 18 to 28 C.

**Procedure.**

1. Calibrate the NanoVNA (SOL) at the cable end and measure the dummy load return loss from 144 to 148 MHz without the probe.
2. Fit the probe on the T at the load and repeat the return-loss measurement.
3. Measure the dummy load DC resistance with the multimeter and its |Z| at 146 MHz from the NanoVNA sweep.
4. Measure the probe's forward drop at DC: apply known DC voltages from 2 V to 25 V through the probe input and record the multimeter output reading at each, giving the correction curve Vpk = f(Vout).
5. Run tools/rf_probe_power.py --characterize: it combines the correction curve, the multimeter accuracy, the load impedance and the probe loading into a power uncertainty at 0.4, 0.5, 1, 2, 5 and 6.3 W.
6. Record instrument calibration state, the fixture serial and tool versions in the report.
7. On any discrepancy, stop and open an NCR per docs/process/04-verification-and-validation.md section 10.

**Acceptance criteria.** Pass if the probe changes the dummy-load return loss by at most 0.5 dB from 144 to 148 MHz, the load |Z| at 146 MHz is 50 ohm +/-2 ohm, the correction curve covers 2 V to 25 V, and the combined power uncertainty is at most 15 percent at every listed power; otherwise Fail. The resulting uncertainty is copied into every power case that uses the probe.

**Instruments and fixtures.**

- NanoVNA, SOL calibration at the cable end used, checked on the dummy load
- Multimeter, DC voltage and DC current ranges, accuracy per datasheet copied into the report (OQ-VV-003)
- Adjustable bench supply, 0 to 30 V, current limit set per step
- 50 ohm BNC dummy load with SMA adapter, power rating recorded in the report

**Expected artifacts.**

- `probe-characterization.csv` (csv): Correction curve, loading and uncertainty per power
- `probe-return-loss.s1p` (other): Dummy load S11 with and without the probe
- `probe-fixture.jpg` (photo): Photograph of the probe on the T at the load

### TC-SYS-011: Output power at the 0.5, 1, 2 and 5 W steps across the band and pack voltage

| Field | Value |
|---|---|
| Requirements | REQ-SYS-011, REQ-SYS-012 |
| Method / class | Test / Bench |
| Status | Draft |
| Automation | `tools/rf_probe_power.py` |

**Setup.** Article: CWHT-A-001 in its enclosure, firmware at the released version release/FW-vX.Y.Z named in firmware/releases/VDD-vX.Y.Z.md (recorded as vX.Y.Z+<short SHA> in the report). Configuration: bench supply through the pack-resistance fixture into the battery terminals; dummy load with the diode RF probe on its T; multimeter on the probe output; for the secondary reading the dummy load is replaced by the calibrated power attenuator and the tinySA Ultra; key-downs of 3 s with at least 10 s between them. Credit row: T-HW. Test of a system requirement closed by Bench on the delivered unit (docs/process/04-verification-and-validation.md section 5.2), run after the TRR that opens the campaign (section 13) and witnessed by the owner; the pre-build Simulation, HostUnit and Emulation evidence named in each requirement's verification_note is supporting only and is not part of this case. TBR values: the acceptance criteria use the values of REQ-SYS-011, REQ-SYS-012 as written, including those marked TBR (close by PDR); a change at PDR returns this case to Draft (docs/process/04-verification-and-validation.md section 8.2, SWE-071). Hazard controls exercised: HZ-001, HZ-003, HZ-006, HZ-008 (from the cited requirements; docs/safety/hazards.json). Credentials: instruments and tools per tools/toolchain.lock.md at the commit recorded in the report. Safety: every transmission goes into the 50 ohm dummy load or the calibrated power attenuator, connected before power-on, never into an open antenna port; key-down duty kept within the load rating recorded in the report; anyone other than the operator stays 0.6 m or more from the unit and load while keying and 1.0 m or more during a tune carrier (NGO-019); the bench supply current limit is set before each power-on; antistatic wrist strap while the lid is off; the PA area is not touched after key-down runs. Environment: room temperature 18 to 28 C; the pack is supplied by the bench supply at 7.4 V +/-0.05 V through the battery terminals unless a step sets another value; dummy load on the antenna port.

**Procedure.**

1. Confirm that TC-SYS-010 is Passed and copy its power uncertainty into the report.
2. Set the supply to 6.4 V at the battery terminals under load.
3. At 144.05 MHz select the 0.5 W step, close the straight key for 3 s and read the probe output; repeat for the 1 W, 2 W and 5 W steps.
4. Repeat the previous step at 146.00 and 147.95 MHz.
5. Repeat the three previous frequency runs at 8.4 V, and the 5 W step at 7.4 V.
6. At 146.00 MHz, 7.4 V and the 5 W step, hold the paddle dah lever at 15 WPM for 3 s and read the probe; compare with the straight-key reading.
7. Replace the dummy load by the attenuator and tinySA; at 146.00 MHz and 7.4 V read the carrier power at each step (secondary reading).
8. Run tools/rf_probe_power.py on the readings to compute power with its uncertainty band.
9. Record instrument calibration state, instrument and capture firmware versions, tool versions and the firmware version in the report.
10. On any discrepancy, stop and open an NCR per docs/process/04-verification-and-validation.md section 10.

**Acceptance criteria.** Pass if at every frequency and pack voltage the probe power with its characterized uncertainty band lies entirely inside 0.397 to 0.629 W at 0.5 W, 0.794 to 1.259 W at 1 W and 1.589 to 2.518 W at 2 W (REQ-SYS-011, +/-1 dB) and inside 3.972 to 6.295 W at 5 W (REQ-SYS-012, +/-1 dB); otherwise Fail. A probe and tinySA disagreement beyond their combined uncertainty is a Procedure-correction NCR (04 section 6.2), not a requirement result.

**Instruments and fixtures.**

- Diode RF probe (1N5711 or equivalent, printed housing) on a BNC T at the dummy load, characterized by TC-SYS-010, read on the multimeter DC voltage range
- Multimeter, DC voltage and DC current ranges, accuracy per datasheet copied into the report (OQ-VV-003)
- Adjustable bench supply, 0 to 30 V, current limit set per step
- Pack-resistance fixture: series resistor equal to the datasheet internal resistance of two cells plus two holders, in the bench-supply lead (docs/vv/fixtures/pack-resistance.md, planned)
- 50 ohm BNC dummy load with SMA adapter, power rating recorded in the report
- tinySA Ultra spectrum analyzer (ADR-021) through the calibrated 30 to 40 dB attenuator rated 10 W or more, attenuator S21 measured on the NanoVNA in the same session; level accuracy per its TV record
- NanoVNA, SOL calibration at the cable end used, checked on the dummy load
- Owner's straight key and iambic paddle, 3.5 mm TRS plugs (SI-034)

**Expected artifacts.**

- `power-steps.csv` (csv): Frequency, pack voltage, step, keying source, probe reading, power and band
- `power-secondary.csv` (csv): tinySA secondary readings with attenuator correction
- `power-setup.jpg` (photo): Photograph of the setup

### TC-SYS-012: Survival of 60 s of 5 W keying at 80 percent duty into open, short and SWR 10:1 loads at four phases

| Field | Value |
|---|---|
| Requirements | REQ-SYS-013 |
| Method / class | Test / Bench |
| Status | Draft |
| Automation | none (manual) |

**Setup.** Article: CWHT-A-001 in its enclosure, firmware at the released version release/FW-vX.Y.Z named in firmware/releases/VDD-vX.Y.Z.md (recorded as vX.Y.Z+<short SHA> in the report). Configuration: mismatch fixture set (SMA open and short standards and a 5 ohm load rated 5 W, each behind 0, 1/8, 1/4 and 3/8 wavelength line sections at 146 MHz; docs/vv/fixtures/mismatch-set.md, planned), each characterized on the NanoVNA this session; 146.00 MHz, 7.4 V, 5 W step; PA temperature read from the UART telemetry; after the stress the power and spurious readings use the methods of TC-SYS-011 and TC-SYS-014. Credit row: T-HW. Test of a system requirement closed by Bench on the delivered unit (docs/process/04-verification-and-validation.md section 5.2), run after the TRR that opens the campaign (section 13) and witnessed by the owner; the pre-build Simulation, HostUnit and Emulation evidence named in each requirement's verification_note is supporting only and is not part of this case. Hazard controls exercised: HZ-003, HZ-009, HZ-012 (from the cited requirements; docs/safety/hazards.json). Credentials: instruments and tools per tools/toolchain.lock.md at the commit recorded in the report. Safety: every transmission goes into the 50 ohm dummy load or the calibrated power attenuator, connected before power-on, never into an open antenna port except the SMA open standard of this case; key-down duty kept within the load rating recorded in the report; anyone other than the operator stays 0.6 m or more from the unit and load while keying and 1.0 m or more during a tune carrier (NGO-019); the bench supply current limit is set before each power-on; antistatic wrist strap while the lid is off; the PA area is not touched after key-down runs. The PA is allowed to cool to 40 C (telemetry) between fixtures. Environment: room temperature 18 to 28 C; the pack is supplied by the bench supply at 7.4 V +/-0.05 V through the battery terminals unless a step sets another value; dummy load on the antenna port.

**Procedure.**

1. Wire the UART telemetry test pad to a logic-capture channel and confirm that the sigrok-cli UART decoder prints the telemetry lines (REQ-SYS-150).
2. Measure each of the 12 fixture conditions (open, short and 5 ohm at four line sections) on the NanoVNA and record reflection magnitude and phase at 146 MHz.
3. Fit the first fixture; key with the straight key held until the 5 s timeout, release, re-key within 1 s, for 60 s.
4. Repeat for each of the 12 fixture conditions, logging PA temperature and any inhibit or Fault-safe message.
5. On the open fixture at the 0 section, key the paddle at 50 WPM for 60 s in squeezes (alternating elements) of at most 1.5 s separated by 0.5 s releases (below the 2 s squeeze limit of REQ-SYS-184, SRR decision 37 (owner ruling 2026-09-26); a longer squeeze is ended by that limit).
6. Refit the dummy load and measure the 5 W step power at 146.00 MHz and 7.4 V with the diode probe.
7. Replace the dummy load by the attenuator and tinySA and scan 9 kHz to 1.5 GHz at the 5 W step at 146.00 MHz.
8. Inspect the board around the PA and the filter for discoloration and photograph it.
9. Record instrument calibration state, instrument and capture firmware versions, tool versions and the firmware version in the report.
10. On any discrepancy, stop and open an NCR per docs/process/04-verification-and-validation.md section 10.

**Acceptance criteria.** Pass if after all 12 fixture conditions and the paddle run the 5 W step power lies inside 3.972 to 6.295 W with the probe uncertainty band, every spurious emission is at most 25 uW (-16.0 dBm) at the antenna port, the unit operates normally, and no part shows damage; otherwise Fail. Protective power reduction or inhibits during the stress are recorded and do not fail the case.

**Instruments and fixtures.**

- NanoVNA, SOL calibration at the cable end used, checked on the dummy load
- Diode RF probe (1N5711 or equivalent, printed housing) on a BNC T at the dummy load, characterized by TC-SYS-010, read on the multimeter DC voltage range
- Multimeter, DC voltage and DC current ranges, accuracy per datasheet copied into the report (OQ-VV-003)
- tinySA Ultra spectrum analyzer (ADR-021) through the calibrated 30 to 40 dB attenuator rated 10 W or more, attenuator S21 measured on the NanoVNA in the same session; level accuracy per its TV record
- 50 ohm BNC dummy load with SMA adapter, power rating recorded in the report
- Owner's straight key and iambic paddle, 3.5 mm TRS plugs (SI-034)
- Pico-based logic capture (second Pico 2 with sigrok-pico firmware read by sigrok-cli; planned, ADR-009), 3.3 V inputs, 1 MS/s unless a step states otherwise
- Adjustable bench supply, 0 to 30 V, current limit set per step

**Expected artifacts.**

- `mismatch-fixtures.csv` (csv): Fixture, line section, reflection magnitude and phase
- `mismatch-stress-log.csv` (csv): Fixture, keying source, PA temperature, messages
- `mismatch-post-power-spurious.csv` (csv): Post-stress power and spurious readings
- `mismatch-board.jpg` (photo): Photograph of the PA and filter area after the stress

### TC-SYS-013: Keying envelope shape and 26 dB occupied bandwidth by transient simulation and FFT

| Field | Value |
|---|---|
| Requirements | REQ-SYS-014, REQ-SYS-015 |
| Method / class | Analysis / Simulation |
| Status | Draft |
| Automation | `hardware/sim/checks/keying_envelope_check.py` |

**Setup.** Article: design data at tag baseline/cdr: hardware/sim/tx/keying_envelope.asc with the CDR shaping network, PA and ALC models, driven by the firmware ramp tables for the 3, 5 and 8 ms settings exported from the release at CDR. Configuration: LTspice .tran of a continuous-dit sequence at 50 WPM for each setting; hardware/sim/checks/keying_envelope_check.py (planned) measures the 10-to-90 percent rise and fall times, the deviation from an ideal raised cosine, and the 26 dB bandwidth of the load-voltage spectrum by the 47 CFR 97.3(a)(8) power-containment definition (docs/research/regulatory-corpus-and-operators.md ACTION-8). Credit row: A. Analysis closed by Simulation on the CDR design data and confirmed at SAR by the physical configuration audit of every analyzed value (docs/process/04-verification-and-validation.md sections 5.1 item 5 and 5.2); the post-build readings named in the verification_note are supporting data only. TBR values: the acceptance criteria use the values of REQ-SYS-014, REQ-SYS-015 as written, including those marked TBR (close by PDR); a change at PDR returns this case to Draft (docs/process/04-verification-and-validation.md section 8.2, SWE-071). Hazard controls exercised: HZ-008 (from the cited requirements; docs/safety/hazards.json). Risk acceptance: the verification_note of REQ-SYS-014 (RSK-011), REQ-SYS-015 (RSK-011) begins 'Analysis accepted per RSK-NNN'; that risk carries the hazard control not closed by Test (docs/process/04-verification-and-validation.md section 3, rule 7.3.6). Tools: LTspice through the batch wrapper tools/run_sim.py and Python per tools/toolchain.lock.md Safety: not applicable (design data only). Environment: not applicable.

**Procedure.**

1. Confirm that the deck part values and ramp tables equal the CDR schematic and the release ramp tables (script prints the diff; an empty diff is required).
2. Run the transient for the 3 ms setting through tools/run_sim.py and export the load voltage.
3. Run hardware/sim/checks/keying_envelope_check.py: 10-to-90 percent rise and fall times, maximum deviation of the normalized envelope from the ideal raised cosine of the same 10-to-90 time, and the 26 dB bandwidth.
4. Repeat the two previous steps for the 5 ms and the 8 ms settings.
5. Repeat the computation with every toleranced input at its worst-case corner (checker option --corners) and record the worst case.
6. Record tool versions, the design-data tag and the commit of every deck, model, script and checker in the report.
7. On any assertion or checker failure, or any difference between the analyzed values and the design data, stop and open an NCR per docs/process/04-verification-and-validation.md section 10.

**Acceptance criteria.** Pass if at each of the 3, 5 and 8 ms settings the simulated rise and fall are raised cosines (normalized envelope within 5 percent of full scale of the ideal raised cosine at every sample), the 10-to-90 percent times equal the setting within +/-0.5 ms, and the 26 dB bandwidth of continuous dits at 50 WPM is at most 350 Hz, nominal and at every tolerance corner; otherwise Fail. The 5 percent and +/-0.5 ms tolerances are those of REQ-SYS-014.

**Expected artifacts.**

- `keying-envelope-3-5-8ms.csv` (csv): Envelope samples per setting, nominal and corners
- `keying-spectrum.png` (plot): Spectrum per setting with the 26 dB bandwidth marked
- `keying-envelope-check.log.txt` (log): Checker output with the deck diff and pass/fail per value

### TC-SYS-014: Spurious emissions from 9 kHz to 1.5 GHz at every step, three frequencies and the pack voltage extremes

| Field | Value |
|---|---|
| Requirements | REQ-SYS-017, REQ-SYS-018 |
| Method / class | Test / Bench |
| Status | Draft |
| Automation | `tools/tinysa_scan_check.py` |

**Setup.** Article: CWHT-A-001 in its enclosure, firmware at the released version release/FW-vX.Y.Z named in firmware/releases/VDD-vX.Y.Z.md (recorded as vX.Y.Z+<short SHA> in the report). Configuration: antenna port to the calibrated power attenuator and the tinySA Ultra; bench supply through the pack-resistance fixture; keyed with continuous dits at 25 WPM from the keying fixture holding the paddle dit contact in Iambic A for 10 s per activation (104 dits, below the 128-element and 30 s limits of the paddle watchdog REQ-SYS-054, SRR decision 37 (owner ruling 2026-09-26)) with at least 10 s between activations, max-hold accumulated over the activations; the bench test-mode generator is not used because REQ-SYS-187 forces the 0.5 W step in every bench test mode (SRR decision 41 (owner ruling 2026-09-26)); spurious means any discrete signal outside the carrier +/-10 kHz (inside that window the close-in keying spectrum is the Analysis of TC-SYS-013, 04 section 6.1); span segmented so that the noise floor referred to the antenna port is at least 6 dB below -23 dBm; readings corrected by the attenuator S21 of this session. Blocked until OQ-VV-001 closes and the tinySA TV record exists (04 section 6.3). Credit row: T-HW. Test of a system requirement closed by Bench on the delivered unit (docs/process/04-verification-and-validation.md section 5.2), run after the TRR that opens the campaign (section 13) and witnessed by the owner; the pre-build Simulation, HostUnit and Emulation evidence named in each requirement's verification_note is supporting only and is not part of this case. TBR values: the acceptance criteria use the values of REQ-SYS-018 as written, including those marked TBR (close by PDR); a change at PDR returns this case to Draft (docs/process/04-verification-and-validation.md section 8.2, SWE-071). Hazard controls exercised: HZ-008 (from the cited requirements; docs/safety/hazards.json). Credentials: instruments and tools per tools/toolchain.lock.md at the commit recorded in the report. Safety: every transmission goes into the 50 ohm dummy load or the calibrated power attenuator, connected before power-on, never into an open antenna port; key-down duty kept within the load rating recorded in the report; anyone other than the operator stays 0.6 m or more from the unit and load while keying and 1.0 m or more during a tune carrier (NGO-019); the bench supply current limit is set before each power-on; antistatic wrist strap while the lid is off; the PA area is not touched after key-down runs. Environment: room temperature 18 to 28 C; the pack is supplied by the bench supply at 7.4 V +/-0.05 V through the battery terminals unless a step sets another value; dummy load on the antenna port.

**Procedure.**

1. Measure the attenuator and cable S21 on the NanoVNA from 9 kHz (or the NanoVNA lower limit) to 1.5 GHz and save the Touchstone file; run the tinySA Ultra internal calibration-output check; record both.
2. At 146.00 MHz, 7.4 V and the 5 W step, read the key-down carrier level (max-hold, 10 kHz span) and compute the carrier power at the antenna port.
3. Scan 9 kHz to 1.5 GHz in segments with max-hold for at least 20 s of dits per segment; record 2f, 3f and 7f individually and every other signal more than 6 dB above the noise floor.
4. For every recorded signal within 10 dB of -16.0 dBm or of 60 dB below the carrier, add 10 dB of attenuation and re-read: a true emission drops by 10 dB +/-1 dB; a signal that drops by more is analyzer-generated, excluded and recorded.
5. Repeat the carrier and scan steps at 144.05 and 147.95 MHz for the 5 W step at 7.4 V.
6. Repeat the scan at 144.05, 146.00 and 147.95 MHz for the 0.5, 1, 2 and 5 W steps at 6.4 V and at 8.4 V (24 combinations).
7. At 146.00 MHz, 5 W and 7.4 V, re-read 2f and 3f keyed by the straight key (3 s holds) and by the owner's paddle (squeezes of at most 1.5 s at 25 WPM, below the 2 s squeeze limit of REQ-SYS-184, SRR decision 37 (owner ruling 2026-09-26)); compare with the fixture readings.
8. Run tools/tinysa_scan_check.py on the exported traces: corrects for attenuator S21, adds the tinySA level accuracy, and reports each emission in dBm at the antenna port and in dB below the carrier.
9. Record instrument calibration state, instrument and capture firmware versions, tool versions and the firmware version in the report.
10. On any discrepancy, stop and open an NCR per docs/process/04-verification-and-validation.md section 10.

**Acceptance criteria.** Pass if every spurious emission at the antenna port, corrected for the attenuator and increased by the tinySA level accuracy, is at most -16.0 dBm (25 uW) in all 24 step, frequency and pack-voltage combinations (REQ-SYS-017), and at the 5 W step at 144.05, 146.00 and 147.95 MHz every spurious emission is at least 60 dB below the mean carrier power (REQ-SYS-018), with 2f, 3f and 7f reported individually; otherwise Fail. Straight-key and paddle readings within 1 dB of the fixture readings confirm the keying source does not change the result; a larger difference is a Procedure-correction NCR.

**Instruments and fixtures.**

- tinySA Ultra spectrum analyzer (ADR-021) through the calibrated 30 to 40 dB attenuator rated 10 W or more, attenuator S21 measured on the NanoVNA in the same session; level accuracy per its TV record
- NanoVNA, SOL calibration at the cable end used, checked on the dummy load
- Adjustable bench supply, 0 to 30 V, current limit set per step
- Pack-resistance fixture: series resistor equal to the datasheet internal resistance of two cells plus two holders, in the bench-supply lead (docs/vv/fixtures/pack-resistance.md, planned)
- Owner's straight key and iambic paddle, 3.5 mm TRS plugs (SI-034)
- Keying fixture: optocoupler contacts across the key-jack tip and ring, driven by a Pico 2 running the scripted closure pattern of the step, pattern timing from its crystal (docs/vv/fixtures/keying-fixture.md, planned)

**Expected artifacts.**

- `spurious-scans.csv` (csv): Combination, frequency, corrected level in dBm and dBc for every recorded emission
- `spurious-traces.png` (plot): tinySA traces per segment and combination
- `attenuator-s21.s2p` (other): Attenuator and cable S21 of the session
- `spurious-check.log.txt` (log): tools/tinysa_scan_check.py output with pass/fail
- `tc-sys-014-setup.jpg` (photo): Photograph of the as-run test setup (docs/process/04-verification-and-validation.md section 8.1)

### TC-SYS-015: Tune carrier at 0.5 W unless a higher step is confirmed, ended within 5.5 s

| Field | Value |
|---|---|
| Requirements | REQ-SYS-019, REQ-SYS-020 |
| Method / class | Test / Bench |
| Status | Draft |
| Automation | `tools/analyze_logic_capture.py` |

**Setup.** Article: CWHT-A-001, enclosure lid off for test-point access, firmware at the released version release/FW-vX.Y.Z named in firmware/releases/VDD-vX.Y.Z.md (recorded as vX.Y.Z+<short SHA> in the report). Configuration: dummy load with the diode probe on its T; logic capture on TX_KEY and PA_EN; operating step set to 5 W before each tune activation to show the tune step is independent of it. Credit row: T-HW. Test of a system requirement closed by Bench on the delivered unit (docs/process/04-verification-and-validation.md section 5.2), run after the TRR that opens the campaign (section 13) and witnessed by the owner; the pre-build Simulation, HostUnit and Emulation evidence named in each requirement's verification_note is supporting only and is not part of this case. TBR values: the acceptance criteria use the values of REQ-SYS-019, REQ-SYS-020 as written, including those marked TBR (close by PDR); a change at PDR returns this case to Draft (docs/process/04-verification-and-validation.md section 8.2, SWE-071). Hazard controls exercised: HZ-001, HZ-006, HZ-012 (from the cited requirements; docs/safety/hazards.json). Credentials: instruments and tools per tools/toolchain.lock.md at the commit recorded in the report. Safety: every transmission goes into the 50 ohm dummy load or the calibrated power attenuator, connected before power-on, never into an open antenna port; key-down duty kept within the load rating recorded in the report; anyone other than the operator stays 0.6 m or more from the unit and load while keying and 1.0 m or more during a tune carrier (NGO-019); the bench supply current limit is set before each power-on; antistatic wrist strap while the lid is off; the PA area is not touched after key-down runs. Environment: room temperature 18 to 28 C; the pack is supplied by the bench supply at 7.4 V +/-0.05 V through the battery terminals unless a step sets another value; dummy load on the antenna port.

**Procedure.**

1. Run the logic-capture reference pulse-train check of this session and record the result (docs/process/04-verification-and-validation.md section 4).
2. Confirm that TC-SYS-010 is Passed and copy its uncertainty into the report.
3. With the operating step at 5 W, activate Tune without confirming a higher step; read the probe during the carrier.
4. Repeat with the operating step at 1 W and at 0.5 W.
5. Activate Tune and confirm the 5 W step for this activation; read the probe.
6. Activate Tune three times at 0.5 W and three times at the confirmed 5 W, never pressing any control, and capture TX_KEY and PA_EN.
7. Close the straight key once and the paddle once during a tune carrier and confirm the carrier ends (ConOps T13).
8. Export the capture and run tools/analyze_logic_capture.py to measure each carrier duration from PA_EN rise to fall.
9. Record instrument calibration state, instrument and capture firmware versions, tool versions and the firmware version in the report.
10. On any discrepancy, stop and open an NCR per docs/process/04-verification-and-validation.md section 10.

**Acceptance criteria.** Pass if the tune carrier without a confirmed higher step lies inside 0.397 to 0.629 W with the probe uncertainty band whatever the operating step, 5 W is reached only after the confirmation (REQ-SYS-019), and every tune carrier ends at most 5.5 s after it starts (REQ-SYS-020); otherwise Fail.

**Instruments and fixtures.**

- Diode RF probe (1N5711 or equivalent, printed housing) on a BNC T at the dummy load, characterized by TC-SYS-010, read on the multimeter DC voltage range
- Multimeter, DC voltage and DC current ranges, accuracy per datasheet copied into the report (OQ-VV-003)
- Pico-based logic capture (second Pico 2 with sigrok-pico firmware read by sigrok-cli; planned, ADR-009), 3.3 V inputs, 1 MS/s unless a step states otherwise
- 50 ohm BNC dummy load with SMA adapter, power rating recorded in the report
- Owner's straight key and iambic paddle, 3.5 mm TRS plugs (SI-034)
- Adjustable bench supply, 0 to 30 V, current limit set per step

**Expected artifacts.**

- `tune-power.csv` (csv): Operating step, confirmation, probe reading and power
- `tune-durations.csv` (csv): Activation, step and carrier duration
- `tc-sys-015-setup.jpg` (photo): Photograph of the as-run test setup (docs/process/04-verification-and-validation.md section 8.1)

### TC-SYS-016: Reception of A1A signals from 144.000 to 148.000 MHz

| Field | Value |
|---|---|
| Requirements | REQ-SYS-021 |
| Method / class | Test / Bench |
| Status | Draft |
| Automation | none (manual) |

**Setup.** Article: CWHT-A-001 in its enclosure, firmware at the released version release/FW-vX.Y.Z named in firmware/releases/VDD-vX.Y.Z.md (recorded as vX.Y.Z+<short SHA> in the report). Configuration: tinySA Ultra generator output through a fixed attenuation of at least 60 dB (NanoVNA-characterized pads) into the antenna port, used as an unmodulated carrier source; headphone output into the 32 ohm audio load read on the multimeter; guest lock set so that no transmission can reach the generator. Credit row: T-HW. Test of a system requirement closed by Bench on the delivered unit (docs/process/04-verification-and-validation.md section 5.2), run after the TRR that opens the campaign (section 13) and witnessed by the owner; the pre-build Simulation, HostUnit and Emulation evidence named in each requirement's verification_note is supporting only and is not part of this case. Credentials: instruments and tools per tools/toolchain.lock.md at the commit recorded in the report. Safety: guest lock is set and the key jack is empty while the generator is on the antenna port; bench supply current limit set before power-on. Environment: room temperature 18 to 28 C; the pack is supplied by the bench supply at 7.4 V +/-0.05 V through the battery terminals unless a step sets another value; dummy load on the antenna port.

**Procedure.**

1. Characterize the pad chain S21 at 146 MHz on the NanoVNA and record it.
2. Set the generator to 144.000 MHz plus the sidetone offset so that the carrier falls in the passband when the unit is tuned to 144.000 MHz; set the generator level so that the level at the antenna port is about -100 dBm.
3. Tune the unit to 144.000 MHz, set volume to the cap step, and read the audio RMS with the generator on and then off.
4. Repeat at 146.000 and 148.000 MHz.
5. Keying the generator output on and off at about 1 Hz (generator output toggle), confirm by ear on the audio load through a monitoring amplifier or by the multimeter that the tone follows (A1A).
6. Record instrument calibration state, instrument and capture firmware versions, tool versions and the firmware version in the report.
7. On any discrepancy, stop and open an NCR per docs/process/04-verification-and-validation.md section 10.

**Acceptance criteria.** Pass if at 144.000, 146.000 and 148.000 MHz the audio RMS with the carrier present is at least 10 dB above the reading with it absent and follows the on-off keying of the source; otherwise Fail.

**Instruments and fixtures.**

- tinySA Ultra signal generator output used as a frequency source and relative level source only, never as a level reference (docs/process/04-verification-and-validation.md section 6.2)
- NanoVNA, SOL calibration at the cable end used, checked on the dummy load
- Multimeter, true-RMS AC voltage range, accuracy at 700 Hz per datasheet copied into the report (OQ-VV-003)
- Audio load fixture: 16, 32 and 64 ohm resistors, 0.25 W, selectable on a 3.5 mm TRS breakout per channel (docs/vv/fixtures/audio-load.md, planned)
- Adjustable bench supply, 0 to 30 V, current limit set per step

**Expected artifacts.**

- `rx-range.csv` (csv): Frequency, audio RMS with and without carrier
- `tc-sys-016-setup.jpg` (photo): Photograph of the as-run test setup (docs/process/04-verification-and-validation.md section 8.1)

### TC-SYS-017: Receiver minimum discernible signal from the noise-figure and filter-loss cascade

| Field | Value |
|---|---|
| Requirements | REQ-SYS-022, REQ-SYS-023 |
| Method / class | Analysis / Simulation |
| Status | Draft |
| Automation | `tools/budgets/rx_noise_cascade.py` |

**Setup.** Article: design data at tag baseline/cdr: the receive line-up of the TS-001 architecture selected at PDR, with CDR part values, filter insertion losses (NanoVNA-measured where a supporting L2 Test exists, datasheet otherwise) and device noise figures. Configuration: tools/budgets/rx_noise_cascade.py (planned) computes the Friis cascade from the antenna port to the detector at 144.05, 146.00 and 147.95 MHz and MDS = -174 dBm/Hz + 10 log10(500 Hz) + NF (TPM-005). Credit row: A. Analysis closed by Simulation on the CDR design data and confirmed at SAR by the physical configuration audit of every analyzed value (docs/process/04-verification-and-validation.md sections 5.1 item 5 and 5.2); the post-build readings named in the verification_note are supporting data only. TBR values: the acceptance criteria use the values of REQ-SYS-022, REQ-SYS-023 as written, including those marked TBR (close by PDR); a change at PDR returns this case to Draft (docs/process/04-verification-and-validation.md section 8.2, SWE-071). Tools: Python per tools/toolchain.lock.md Safety: not applicable (design data only). Environment: not applicable.

**Procedure.**

1. Confirm that the cascade stages and values equal the CDR line-up (script prints the diff; an empty diff is required).
2. Run tools/budgets/rx_noise_cascade.py and save the per-stage gain, noise figure and cumulative noise figure at the three frequencies.
3. Compute MDS in 500 Hz at each frequency.
4. Repeat the computation with every toleranced input at its worst-case corner (checker option --corners) and record the worst case.
5. Record tool versions, the design-data tag and the commit of every deck, model, script and checker in the report.
6. On any assertion or checker failure, or any difference between the analyzed values and the design data, stop and open an NCR per docs/process/04-verification-and-validation.md section 10.

**Acceptance criteria.** Pass if the worst-case MDS in 500 Hz over the three frequencies and all tolerance corners is at most -140 dBm (REQ-SYS-022, noise figure 7 dB or less) and at most -142 dBm (REQ-SYS-023, noise figure 5 dB or less); otherwise Fail, reported separately for each requirement.

**Expected artifacts.**

- `rx-noise-cascade.csv` (csv): Stage gains, noise figures and MDS per frequency and corner
- `rx-noise-cascade.log.txt` (log): Script output with the line-up diff

### TC-SYS-018: End-to-end receive selectivity: -6 dB and -60 dB bandwidths, stopband, ultimate rejection and ripple

| Field | Value |
|---|---|
| Requirements | REQ-SYS-024, REQ-SYS-025, REQ-SYS-026, REQ-SYS-027, REQ-SYS-028 |
| Method / class | Analysis / Simulation |
| Status | Draft |
| Automation | `hardware/sim/checks/rx_selectivity_check.py` |

**Setup.** Article: design data at tag baseline/cdr: the passive filter path response (NanoVNA S21 through test connectors from the supporting L2 Test where it exists, otherwise the CDR LTspice model with the vendor or tolerance-designed crystal models) and, for architecture B, the DSP filter response from the HostUnit case of the REQ-SW child; simulation data under docs/research/sim/cw-selectivity/. Configuration: hardware/sim/checks/rx_selectivity_check.py (planned) cascades the passive and DSP responses on one frequency grid relative to the passband centre and measures each quantity (04 section 6.2 receiver and audio frequency response row). Credit row: A. Analysis closed by Simulation on the CDR design data and confirmed at SAR by the physical configuration audit of every analyzed value (docs/process/04-verification-and-validation.md sections 5.1 item 5 and 5.2); the post-build readings named in the verification_note are supporting data only. TBR values: the acceptance criteria use the values of REQ-SYS-024, REQ-SYS-025, REQ-SYS-026, REQ-SYS-027, REQ-SYS-028 as written, including those marked TBR (close by PDR); a change at PDR returns this case to Draft (docs/process/04-verification-and-validation.md section 8.2, SWE-071). Tools: LTspice through the batch wrapper tools/run_sim.py and Python per tools/toolchain.lock.md Safety: not applicable (design data only). Environment: not applicable.

**Procedure.**

1. Confirm that the input responses are the CDR data sets (checker prints their paths and hashes).
2. Run hardware/sim/checks/rx_selectivity_check.py and save the combined response from -10 kHz to +10 kHz about the passband centre.
3. Read the -6 dB bandwidth, the -60 dB bandwidth, the minimum attenuation from 2 kHz to 5 kHz either side of centre, the minimum attenuation beyond 5 kHz, and the peak-to-peak ripple inside the -6 dB points.
4. Repeat the computation with every toleranced input at its worst-case corner (checker option --corners) and record the worst case.
5. Record tool versions, the design-data tag and the commit of every deck, model, script and checker in the report.
6. On any assertion or checker failure, or any difference between the analyzed values and the design data, stop and open an NCR per docs/process/04-verification-and-validation.md section 10.

**Acceptance criteria.** Pass if, nominal and at every tolerance corner, the -6 dB bandwidth is from 400 Hz to 600 Hz, the -60 dB bandwidth is at most 2.5 kHz, attenuation from 2 kHz to 5 kHz either side of centre is at least 60 dB, attenuation beyond 5 kHz is at least 80 dB, and passband ripple is at most 2 dB; otherwise Fail, reported per requirement.

**Expected artifacts.**

- `rx-selectivity.csv` (csv): Combined response in dB versus offset, nominal and corners
- `rx-selectivity.png` (plot): Combined response with the five limit masks drawn
- `rx-selectivity-check.log.txt` (log): Checker output with per-quantity pass/fail

### TC-SYS-019: Adjacent-signal desensitization and reciprocal-mixing dynamic range from selectivity and phase noise

| Field | Value |
|---|---|
| Requirements | REQ-SYS-029, REQ-SYS-031 |
| Method / class | Analysis / Simulation |
| Status | Draft |
| Automation | `tools/budgets/rx_reciprocal_mixing.py` |

**Setup.** Article: design data at tag baseline/cdr: the combined selectivity response of the selectivity case, the local-oscillator phase-noise data of the synthesizer and reference selected by TS-NNN-synthesizer-reference (measured or primary-source), and the receive gain distribution. Configuration: tools/budgets/rx_reciprocal_mixing.py (planned) integrates the phase noise over the passband at 2 kHz and 10 kHz offsets and adds the selectivity leakage of the interferer. Credit row: A. Analysis closed by Simulation on the CDR design data and confirmed at SAR by the physical configuration audit of every analyzed value (docs/process/04-verification-and-validation.md sections 5.1 item 5 and 5.2); the post-build readings named in the verification_note are supporting data only. TBR values: the acceptance criteria use the values of REQ-SYS-029, REQ-SYS-031 as written, including those marked TBR (close by PDR); a change at PDR returns this case to Draft (docs/process/04-verification-and-validation.md section 8.2, SWE-071). Tools: Python per tools/toolchain.lock.md Safety: not applicable (design data only). Environment: not applicable.

**Procedure.**

1. Confirm that the phase-noise data set and the selectivity response are the CDR data (script prints their paths and hashes).
2. Compute the (S+N)/N loss of a -130 dBm wanted signal with a -60 dBm unmodulated interferer 2 kHz away, from reciprocal mixing plus filter leakage plus any compression of the gain stages.
3. Compute the reciprocal-mixing dynamic range at 10 kHz offset in 500 Hz as RMDR = -L(10 kHz) - 10 log10(500 Hz).
4. Repeat the computation with every toleranced input at its worst-case corner (checker option --corners) and record the worst case.
5. Record tool versions, the design-data tag and the commit of every deck, model, script and checker in the report.
6. On any assertion or checker failure, or any difference between the analyzed values and the design data, stop and open an NCR per docs/process/04-verification-and-validation.md section 10.

**Acceptance criteria.** Pass if the (S+N)/N loss of the -130 dBm signal with the -60 dBm signal 2 kHz away is at most 3 dB and the reciprocal-mixing dynamic range at 10 kHz offset in 500 Hz is at least 85 dB (phase noise -112 dBc/Hz or lower at 10 kHz), nominal and at the corners; otherwise Fail, reported per requirement.

**Expected artifacts.**

- `reciprocal-mixing.csv` (csv): Offset, phase noise, integrated noise and results
- `reciprocal-mixing.log.txt` (log): Script output with input hashes

### TC-SYS-020: Receive level control: no gain pumping from an adjacent keyed signal and audio level over -120 to -20 dBm

| Field | Value |
|---|---|
| Requirements | REQ-SYS-030, REQ-SYS-032 |
| Method / class | Analysis / Simulation |
| Status | Draft |
| Automation | `hardware/sim/checks/agc_loop_check.py` |

**Setup.** Article: design data at tag baseline/cdr: the AGC or digital level-control model of the TS-001 architecture with the detector placement, the combined selectivity response and the CDR gain distribution. Configuration: hardware/sim/checks/agc_loop_check.py (planned) runs the level-control loop in the time domain with a 20 WPM keyed interferer and sweeps a steady wanted signal from -120 to -20 dBm. Credit row: A. Analysis closed by Simulation on the CDR design data and confirmed at SAR by the physical configuration audit of every analyzed value (docs/process/04-verification-and-validation.md sections 5.1 item 5 and 5.2); the post-build readings named in the verification_note are supporting data only. TBR values: the acceptance criteria use the values of REQ-SYS-030, REQ-SYS-032 as written, including those marked TBR (close by PDR); a change at PDR returns this case to Draft (docs/process/04-verification-and-validation.md section 8.2, SWE-071). Tools: LTspice through the batch wrapper tools/run_sim.py and Python per tools/toolchain.lock.md Safety: not applicable (design data only). Environment: not applicable.

**Procedure.**

1. Confirm that the model parameters equal the CDR design (checker prints the diff; an empty diff is required).
2. Simulate a -130 dBm steady wanted signal with a -60 dBm interferer 2 kHz away keyed at 20 WPM for 10 s, and record the wanted-signal audio level envelope.
3. Simulate a steady CW signal stepped from -120 dBm to -20 dBm in 10 dB steps, and record the settled audio level at each step.
4. Repeat the computation with every toleranced input at its worst-case corner (checker option --corners) and record the worst case.
5. Record tool versions, the design-data tag and the commit of every deck, model, script and checker in the report.
6. On any assertion or checker failure, or any difference between the analyzed values and the design data, stop and open an NCR per docs/process/04-verification-and-validation.md section 10.

**Acceptance criteria.** Pass if the -130 dBm signal's audio level stays within 1 dB of its level without the interferer throughout the keyed interferer run, and the audio level of the CW signal stays within a 6 dB window from -120 dBm to -20 dBm, nominal and at the corners; otherwise Fail, reported per requirement.

**Expected artifacts.**

- `agc-pumping.csv` (csv): Audio level of the wanted signal versus time with the keyed interferer
- `agc-range.csv` (csv): Settled audio level versus input level
- `agc-loop-check.log.txt` (log): Checker output

### TC-SYS-021: Image and intermediate-frequency response rejection from the front-end and mixer responses

| Field | Value |
|---|---|
| Requirements | REQ-SYS-033 |
| Method / class | Analysis / Simulation |
| Status | Draft |
| Automation | `tools/budgets/rx_spurious_response.py` |

**Setup.** Article: design data at tag baseline/cdr: front-end filter models (CDR values) and the frequency plan (LO and IF) of the selected architecture. Configuration: tools/budgets/rx_spurious_response.py (planned) computes the image and IF frequencies for tuned frequencies across 144.000 to 148.000 MHz and the front-end attenuation at each (04 section 6.2 image rejection row). Credit row: A. Analysis closed by Simulation on the CDR design data and confirmed at SAR by the physical configuration audit of every analyzed value (docs/process/04-verification-and-validation.md sections 5.1 item 5 and 5.2); the post-build readings named in the verification_note are supporting data only. TBR values: the acceptance criteria use the values of REQ-SYS-033 as written, including those marked TBR (close by PDR); a change at PDR returns this case to Draft (docs/process/04-verification-and-validation.md section 8.2, SWE-071). Tools: LTspice through the batch wrapper tools/run_sim.py and Python per tools/toolchain.lock.md Safety: not applicable (design data only). Environment: not applicable.

**Procedure.**

1. Confirm that the filter models and frequency plan equal the CDR design (script prints the diff; an empty diff is required).
2. Compute the image and IF response frequencies for tuned frequencies at 100 kHz spacing across the band.
3. Compute the attenuation of each response relative to the in-band response from the simulated front-end S21 and the mixer port isolation.
4. Repeat the computation with every toleranced input at its worst-case corner (checker option --corners) and record the worst case.
5. Record tool versions, the design-data tag and the commit of every deck, model, script and checker in the report.
6. On any assertion or checker failure, or any difference between the analyzed values and the design data, stop and open an NCR per docs/process/04-verification-and-validation.md section 10.

**Acceptance criteria.** Pass if every image and IF response is at least 70 dB below the in-band response at every tuned frequency, nominal and at the corners; otherwise Fail.

**Expected artifacts.**

- `rx-spurious-responses.csv` (csv): Tuned frequency, response frequency and rejection

### TC-SYS-022: Internally generated receive responses from 144.010 to 147.999 MHz

| Field | Value |
|---|---|
| Requirements | REQ-SYS-034 |
| Method / class | Test / Bench |
| Status | Draft |
| Automation | `tools/analyze_birdie_survey.py` |

**Setup.** Article: CWHT-A-001, enclosure lid off for test-point access, firmware at the released version release/FW-vX.Y.Z named in firmware/releases/VDD-vX.Y.Z.md (recorded as vX.Y.Z+<short SHA> in the report). Configuration: antenna port terminated in the dummy load; guest lock set; audio into the 32 ohm load read by the multimeter (true RMS) or, if the software design provides it, by the audio-level field of the telemetry; level control held fixed if the Bench-test mode offers it; predicted birdie list from the clock-harmonic table of the clock plan; tinySA Ultra with a near-field probe for the predicted sources. The bench test mode exits 120 s after entry (REQ-SYS-188, SRR decision 41 (owner ruling 2026-09-26)), so a test-mode sweep runs in segments, each inside one entry, and the report lists the segment limits. Credit row: T-HW. Test of a system requirement closed by Bench on the delivered unit (docs/process/04-verification-and-validation.md section 5.2), run after the TRR that opens the campaign (section 13) and witnessed by the owner; the pre-build Simulation, HostUnit and Emulation evidence named in each requirement's verification_note is supporting only and is not part of this case. TBR values: the acceptance criteria use the values of REQ-SYS-034 as written, including those marked TBR (close by PDR); a change at PDR returns this case to Draft (docs/process/04-verification-and-validation.md section 8.2, SWE-071). Hazard controls exercised: HZ-008 (from the cited requirements; docs/safety/hazards.json). Credentials: instruments and tools per tools/toolchain.lock.md at the commit recorded in the report. Safety: guest lock is set and the key jack is empty; bench supply current limit set before power-on; antistatic wrist strap while the lid is off. Environment: room temperature 18 to 28 C; the pack is supplied by the bench supply at 7.4 V +/-0.05 V through the battery terminals unless a step sets another value; dummy load on the antenna port.

**Procedure.**

1. Wire the UART telemetry test pad to a logic-capture channel and confirm that the sigrok-cli UART decoder prints the telemetry lines (REQ-SYS-150).
2. Record the noise-floor audio RMS at 146.000 MHz and at five other frequencies spread across the band; take the median as the noise reference.
3. For each predicted birdie frequency, tune from 2 kHz below to 2 kHz above in 250 Hz steps and record the audio RMS at each step.
4. Sweep 144.010 to 147.999 MHz in 250 Hz steps with the Bench-test sweep function if the software design provides one, logging the audio level; otherwise the owner sweeps at 1 kHz steps by ear and every audible tone is measured as in the previous step.
5. For every response found, probe the board with the near-field probe on the tinySA Ultra and record the probable source.
6. Record instrument calibration state, instrument and capture firmware versions, tool versions and the firmware version in the report.
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
