robinonsay/cwht/docs/decisions/adr/ADR-006-rotary-encoder-tuning.md

# ADR-006: Rotary encoder tuning and a minimal control set

| Field | Value |
|---|---|
| ID | ADR-006 |
| Status | Accepted |
| Date proposed | 2026-09-25 |
| Date decided | 2026-09-25 |
| Decision class | 1 (`docs/process/06-risk-and-decision-analysis.md` section 14.1 items (b) the display is a critical part; (c) the firmware volume law runs in `SW-AUDIO` (HZ-005) and encoder tuning input feeds the mission-critical `SW-DISPLAY`). Owner-directed for the encoder (SI-006). Trade study: the display and audio trade study at PDR (README "Decisions expected at PDR"). No trade study for the encoder: this ADR alone records it under SEMP customization 11 (`docs/plan/semp.md` section 9.0 and section 5.17), which customizes 06 section 14.1, item (i) (ruling R-2 of `reconciliation-srr.md` section 7, adopted by the owner as SRR decision 106 on 2026-09-26) |
| Decision authority | Robin (owner; the decision fixes the human interface of the functional baseline) |
| Author | Claude (technical data manager invocation, 2026-09-25) |
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
