robinonsay/cwht/docs/cm/tool-validation/evidence/kicad-fixture-clean-top.png

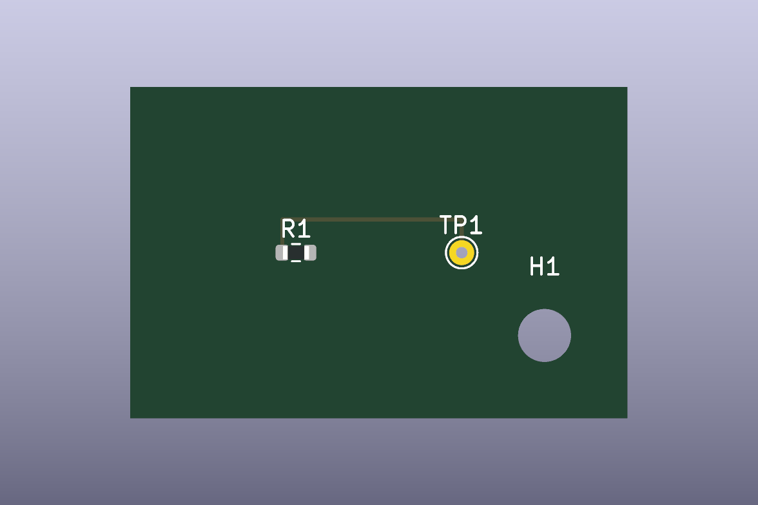
docs/cm/tool-validation/evidence/kicad-fixture-clean-top.png
