robinonsay/cwht/docs/cm/tool-validation/evidence/ltspice-known-answers-2026-09-27/rc-lowpass-bode.png

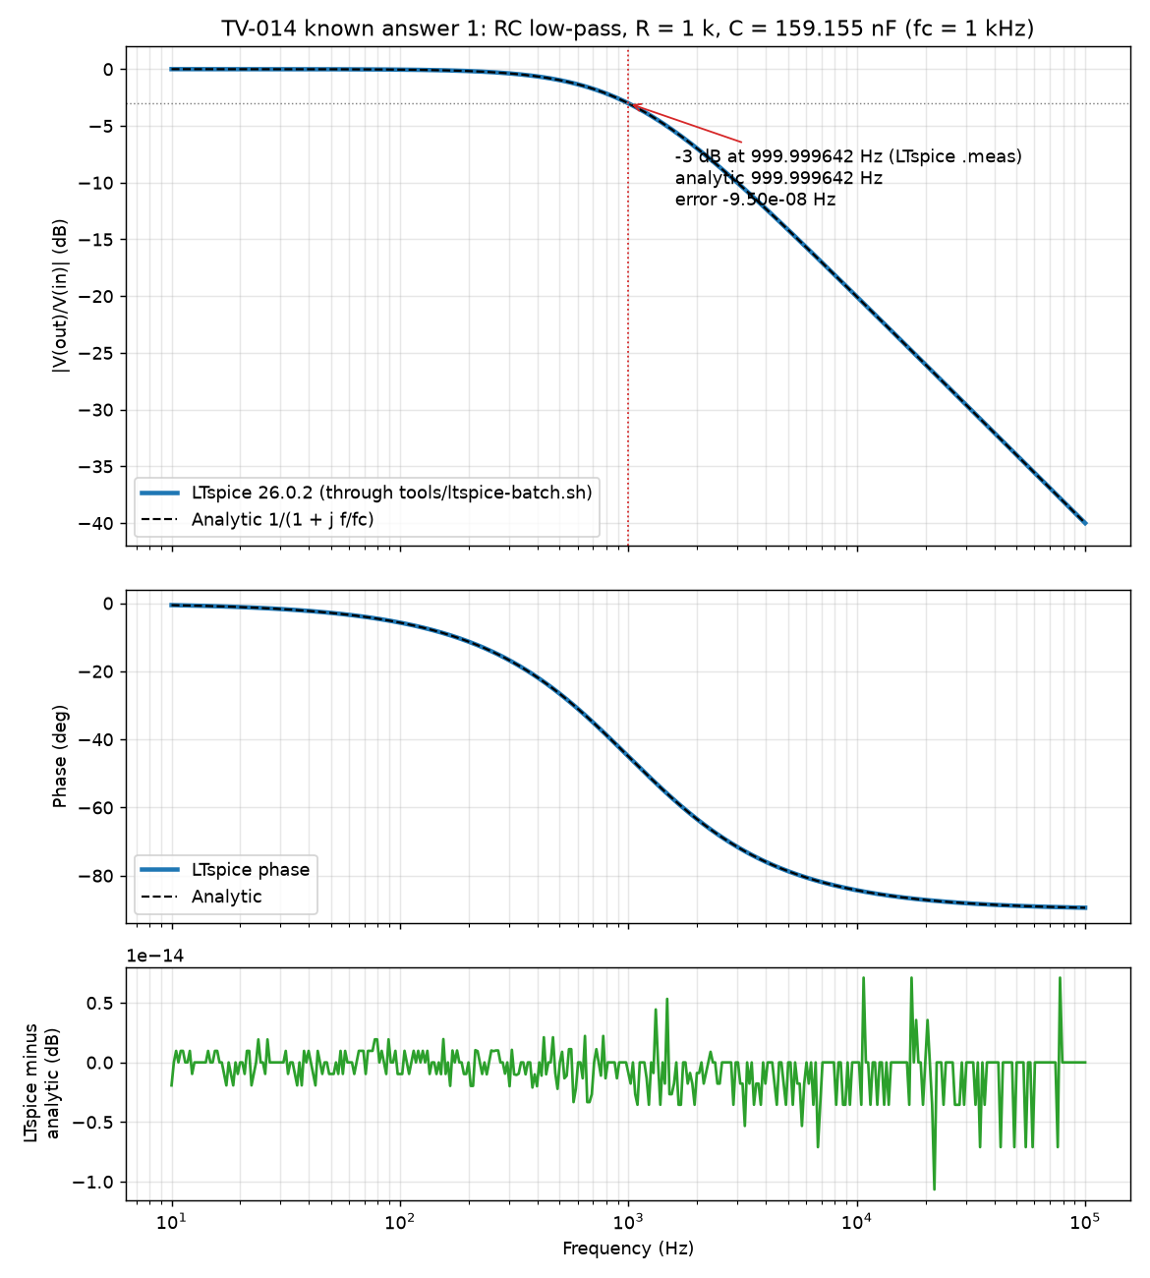
docs/cm/tool-validation/evidence/ltspice-known-answers-2026-09-27/rc-lowpass-bode.png
