robinonsay/cwht/docs/cm/tool-validation/evidence/openscad-fixture-cube.png

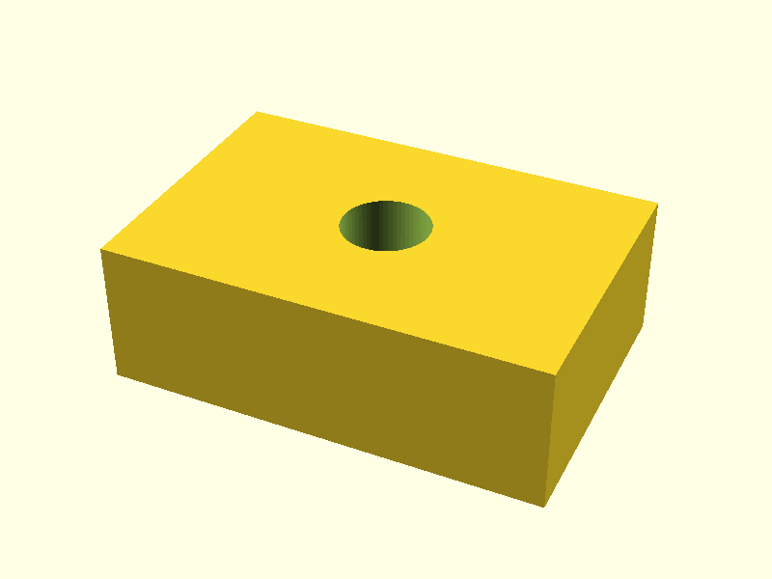
docs/cm/tool-validation/evidence/openscad-fixture-cube.png
