robinonsay/cwht/docs/cm/tool-validation/evidence/render-deck-fixture-slide-01.png

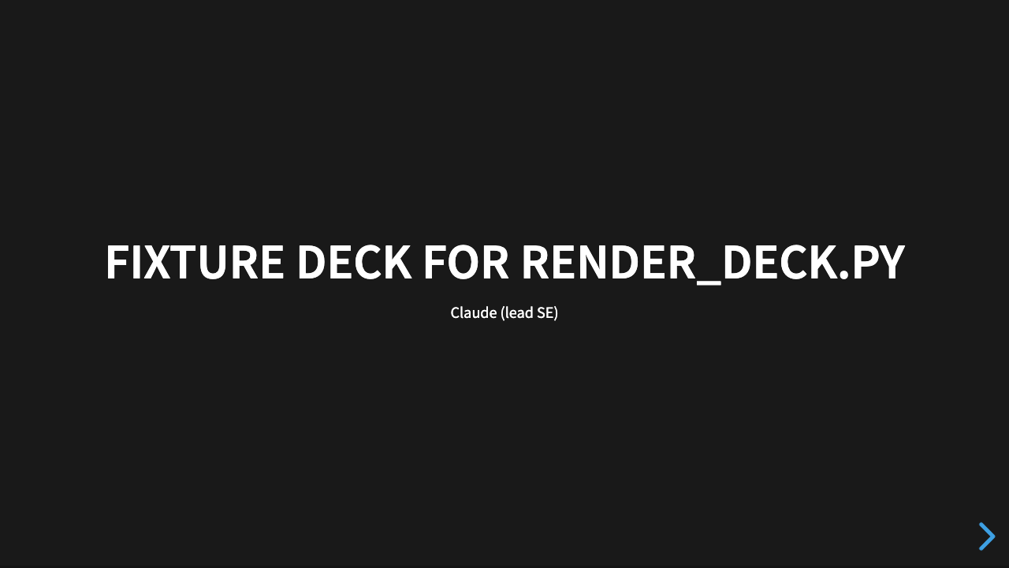
docs/cm/tool-validation/evidence/render-deck-fixture-slide-01.png
