robinonsay/cwht/docs/cm/tool-validation/evidence/render-deck-fixture-slide-02.png

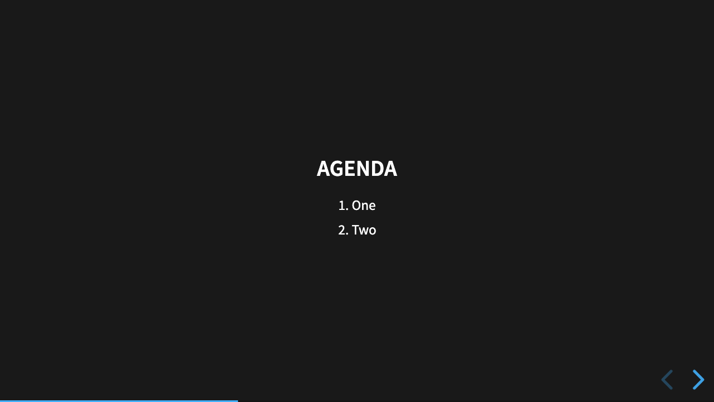
docs/cm/tool-validation/evidence/render-deck-fixture-slide-02.png
