robinonsay/cwht/docs/cm/tool-validation/evidence/render-deck-fixture-slide-03.png

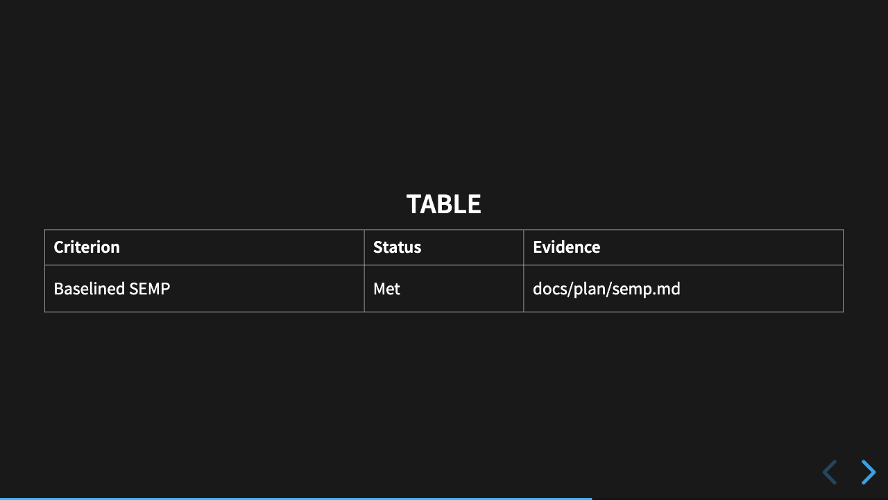
docs/cm/tool-validation/evidence/render-deck-fixture-slide-03.png
