robinonsay/cwht/docs/cm/tool-validation/evidence/render-review-figures-fixture-2026-09-26-entrance-checklist.png

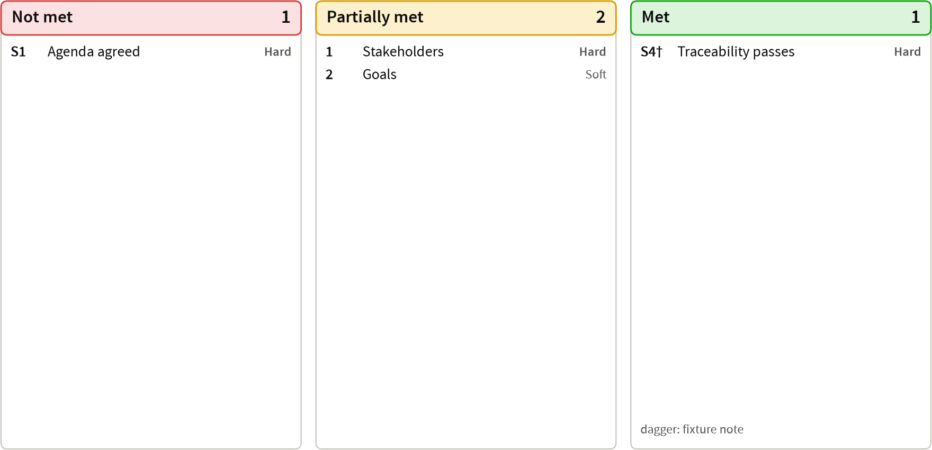
docs/cm/tool-validation/evidence/render-review-figures-fixture-2026-09-26-entrance-checklist.png
