robinonsay/cwht/docs/cm/tool-validation/evidence/render-review-figures-fixture-2026-09-26-success-criteria.png

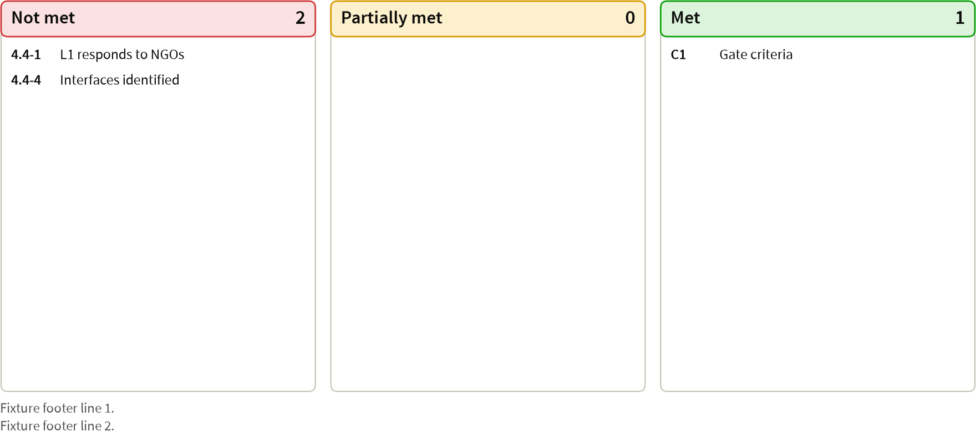
docs/cm/tool-validation/evidence/render-review-figures-fixture-2026-09-26-success-criteria.png
