robinonsay/cwht/docs/cm/tool-validation/evidence/render-review-figures-fixture-conops-modes-scenarios.png

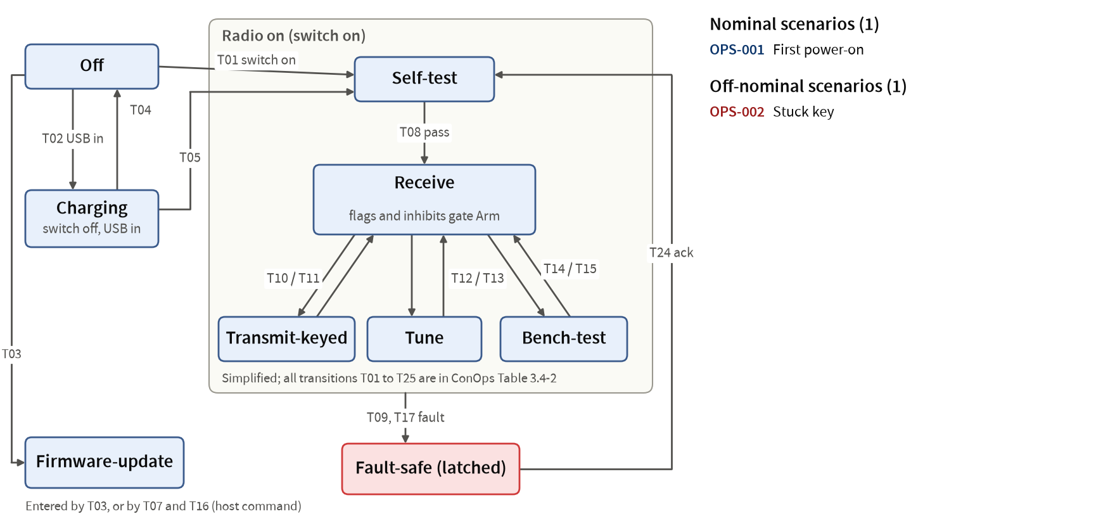
docs/cm/tool-validation/evidence/render-review-figures-fixture-conops-modes-scenarios.png
