robinonsay/cwht/docs/cm/tool-validation/evidence/render-review-figures-fixture-tpm-status.png

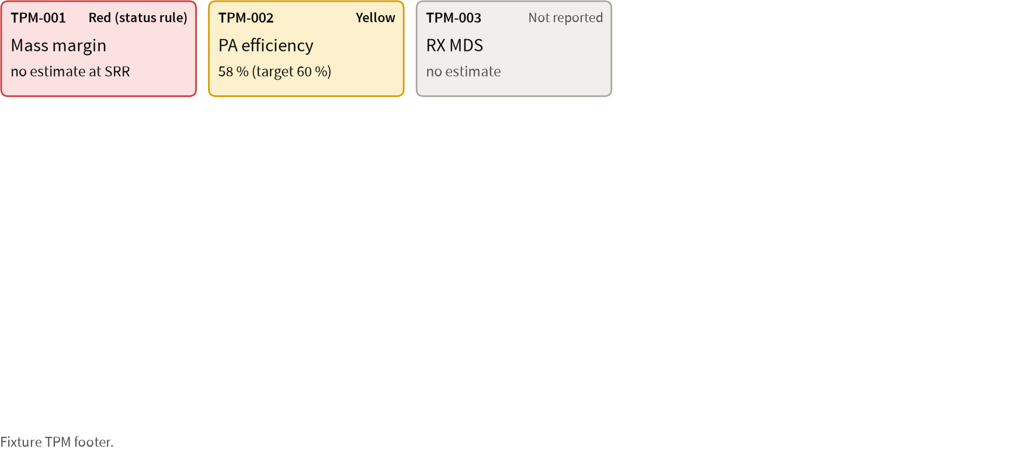
docs/cm/tool-validation/evidence/render-review-figures-fixture-tpm-status.png
