robinonsay/cwht/docs/cm/tool-validation/evidence/render-review-figures-layout-19-rows-success.png

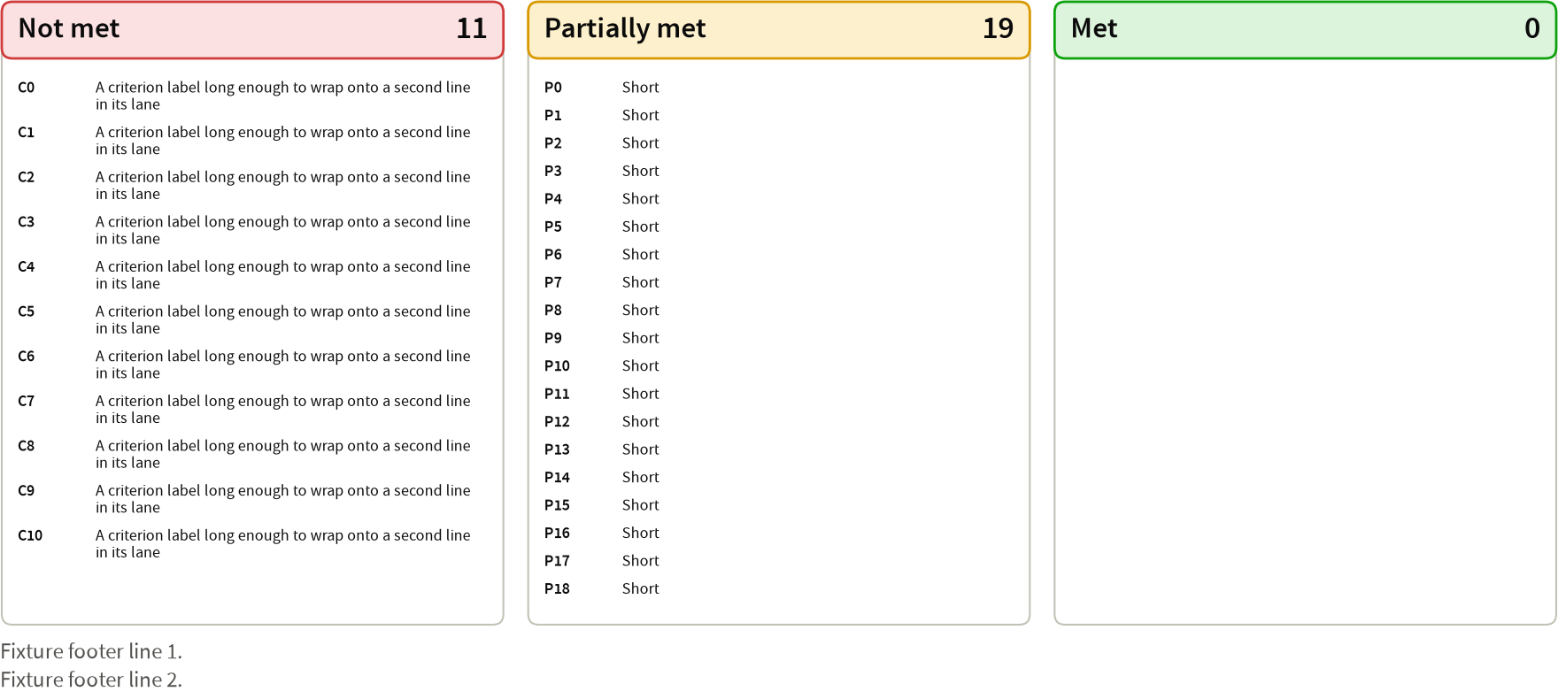
docs/cm/tool-validation/evidence/render-review-figures-layout-19-rows-success.png
