robinonsay/cwht/docs/cm/tool-validation/evidence/render-tpm-fixture-tpm-status.png

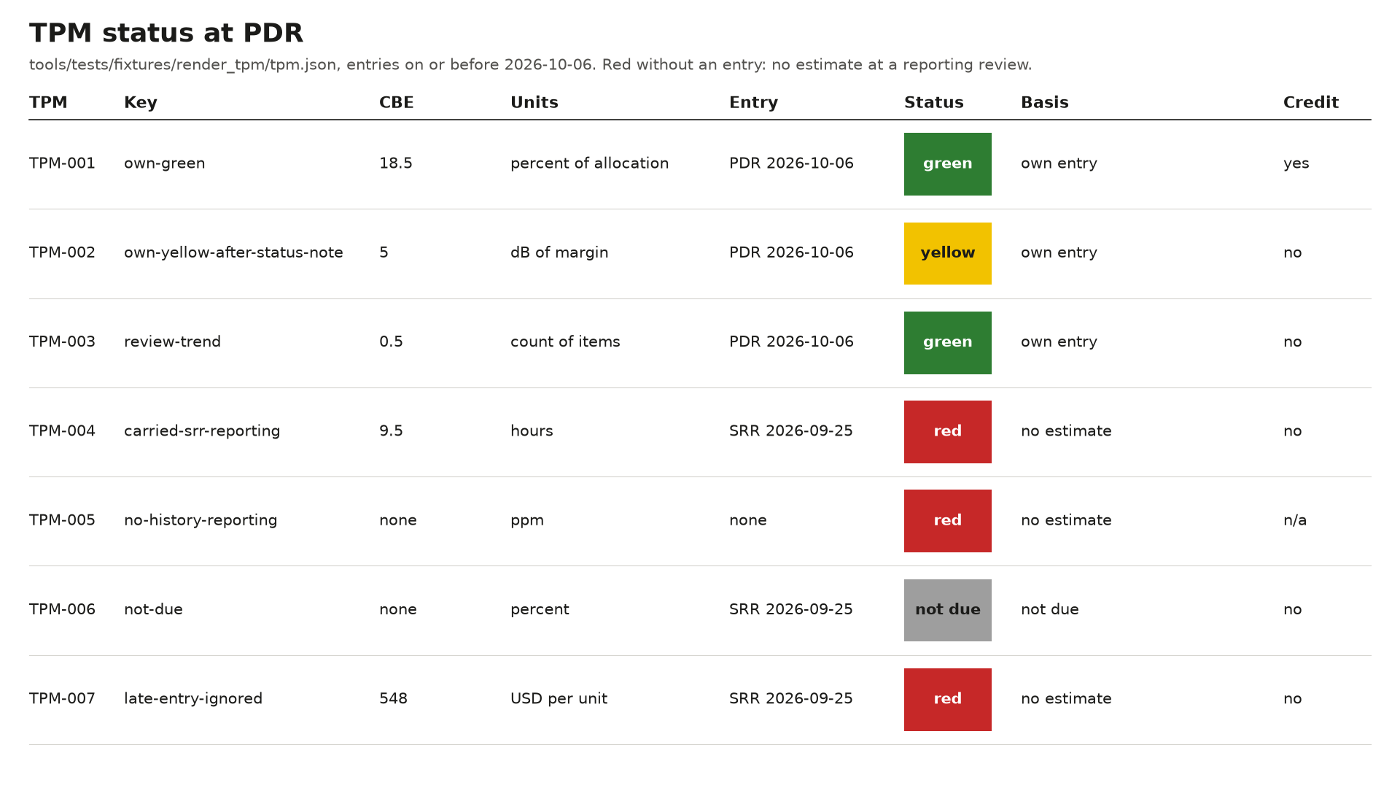
docs/cm/tool-validation/evidence/render-tpm-fixture-tpm-status.png
