robinonsay/cwht/docs/cm/tool-validation/evidence/render-tpm-fixture-trend-own-yellow-after-status-note.png

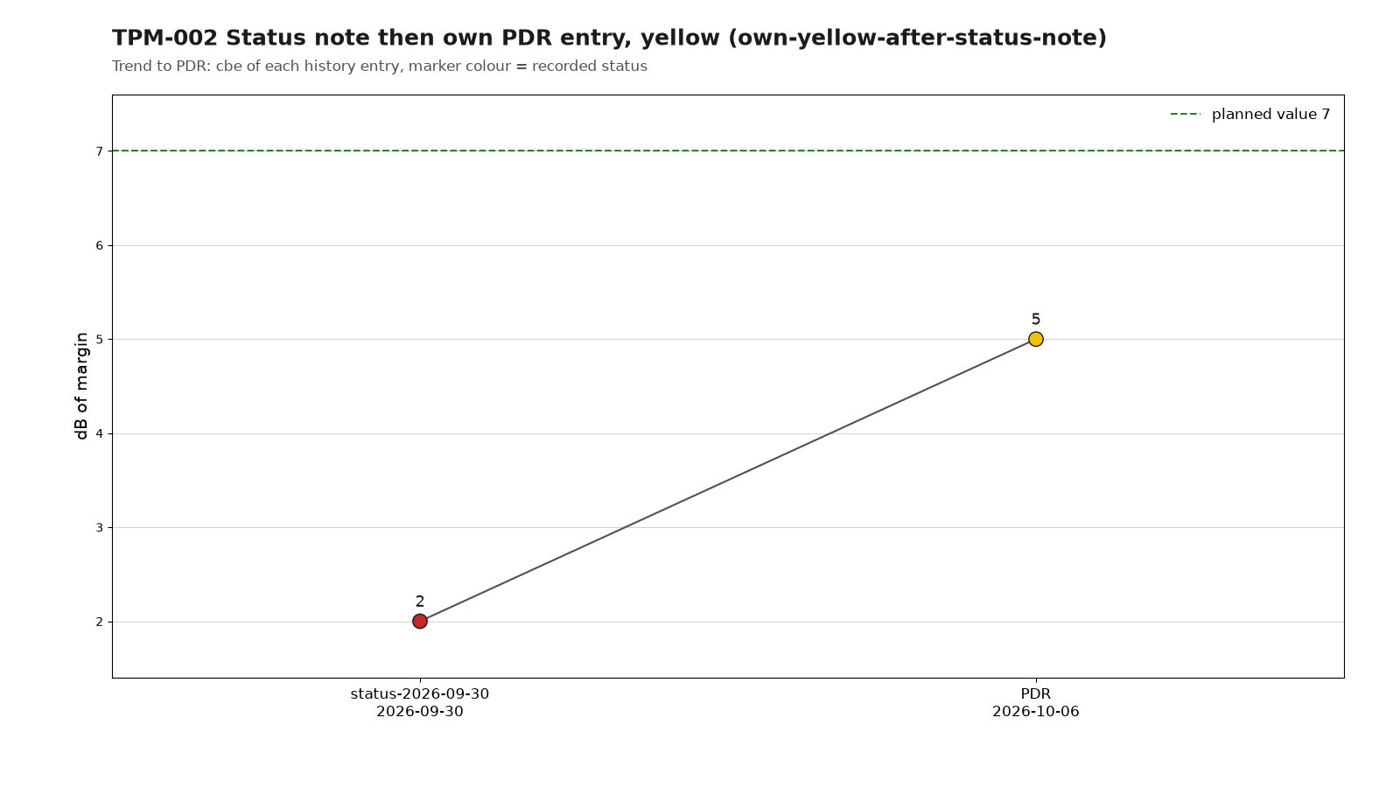
docs/cm/tool-validation/evidence/render-tpm-fixture-trend-own-yellow-after-status-note.png
