robinonsay/cwht/docs/reviews/PDR/figures/display-layout-tune.png

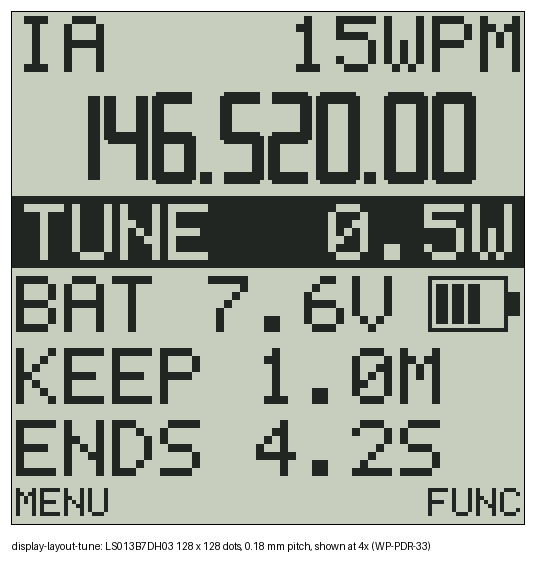
docs/reviews/PDR/figures/display-layout-tune.png
