robinonsay/cwht/hardware/sim/freq/results/r3a5-20260929-03/r3-budget-and-buffer.png

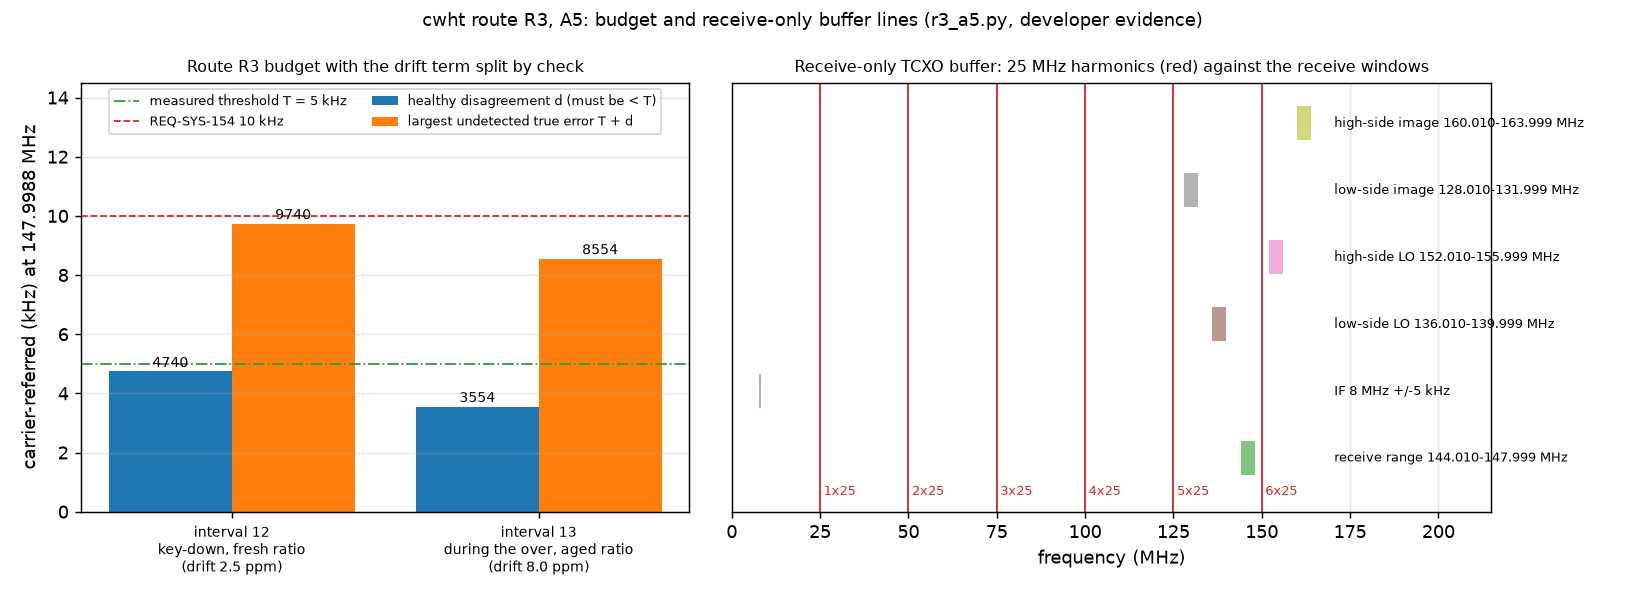
hardware/sim/freq/results/r3a5-20260929-03/r3-budget-and-buffer.png
