robinonsay/cwht/hardware/sim/freq/results/r3a5-20260929-03/reference-budget-a5.png

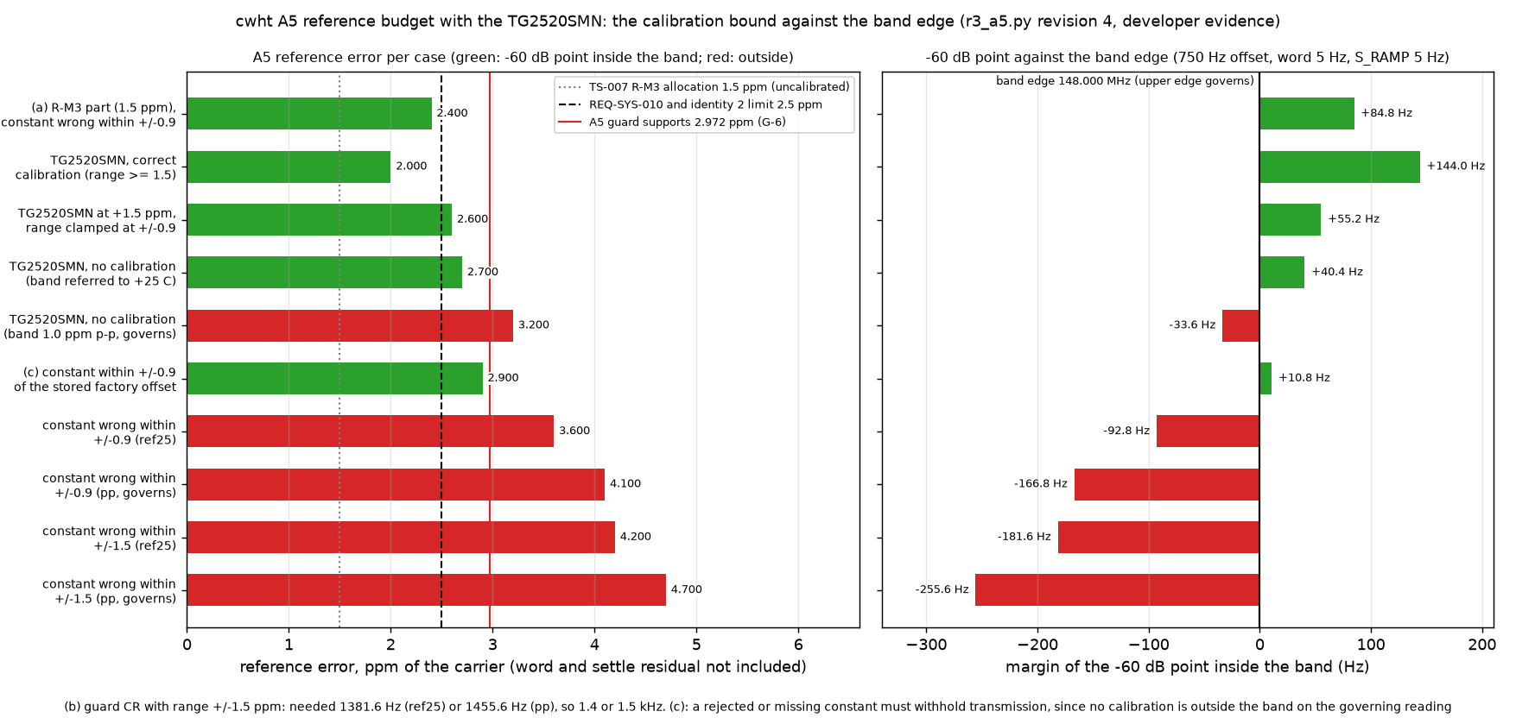
hardware/sim/freq/results/r3a5-20260929-03/reference-budget-a5.png
