robinonsay/cwht/hardware/sim/freq/results/r3a5-20260929-03/relock-sequence.png

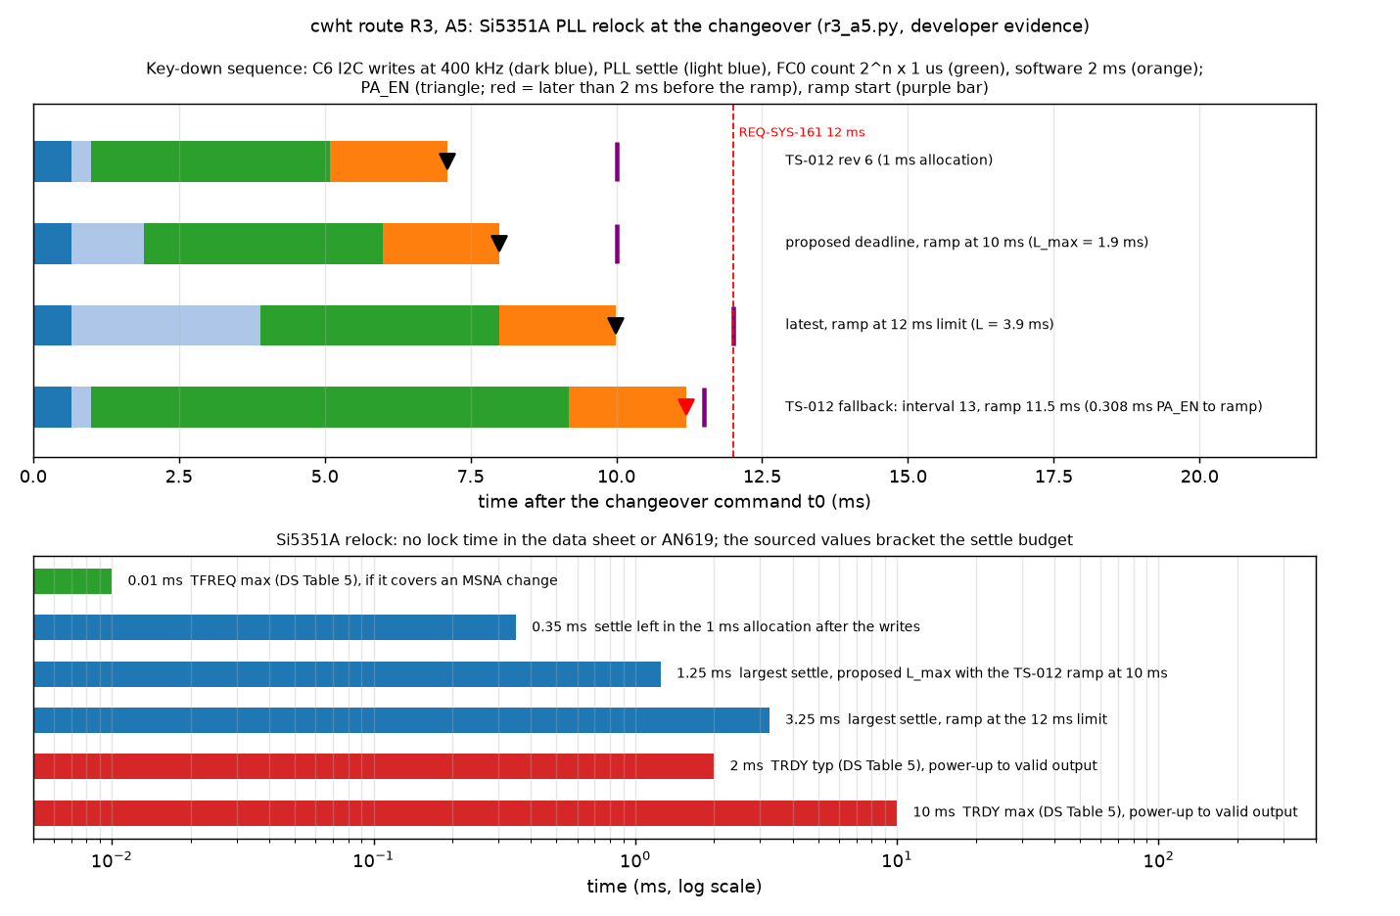
hardware/sim/freq/results/r3a5-20260929-03/relock-sequence.png
