robinonsay/cwht/hardware/sim/freq/results/txspur-20260928-01/antenna-PB-144.050.png

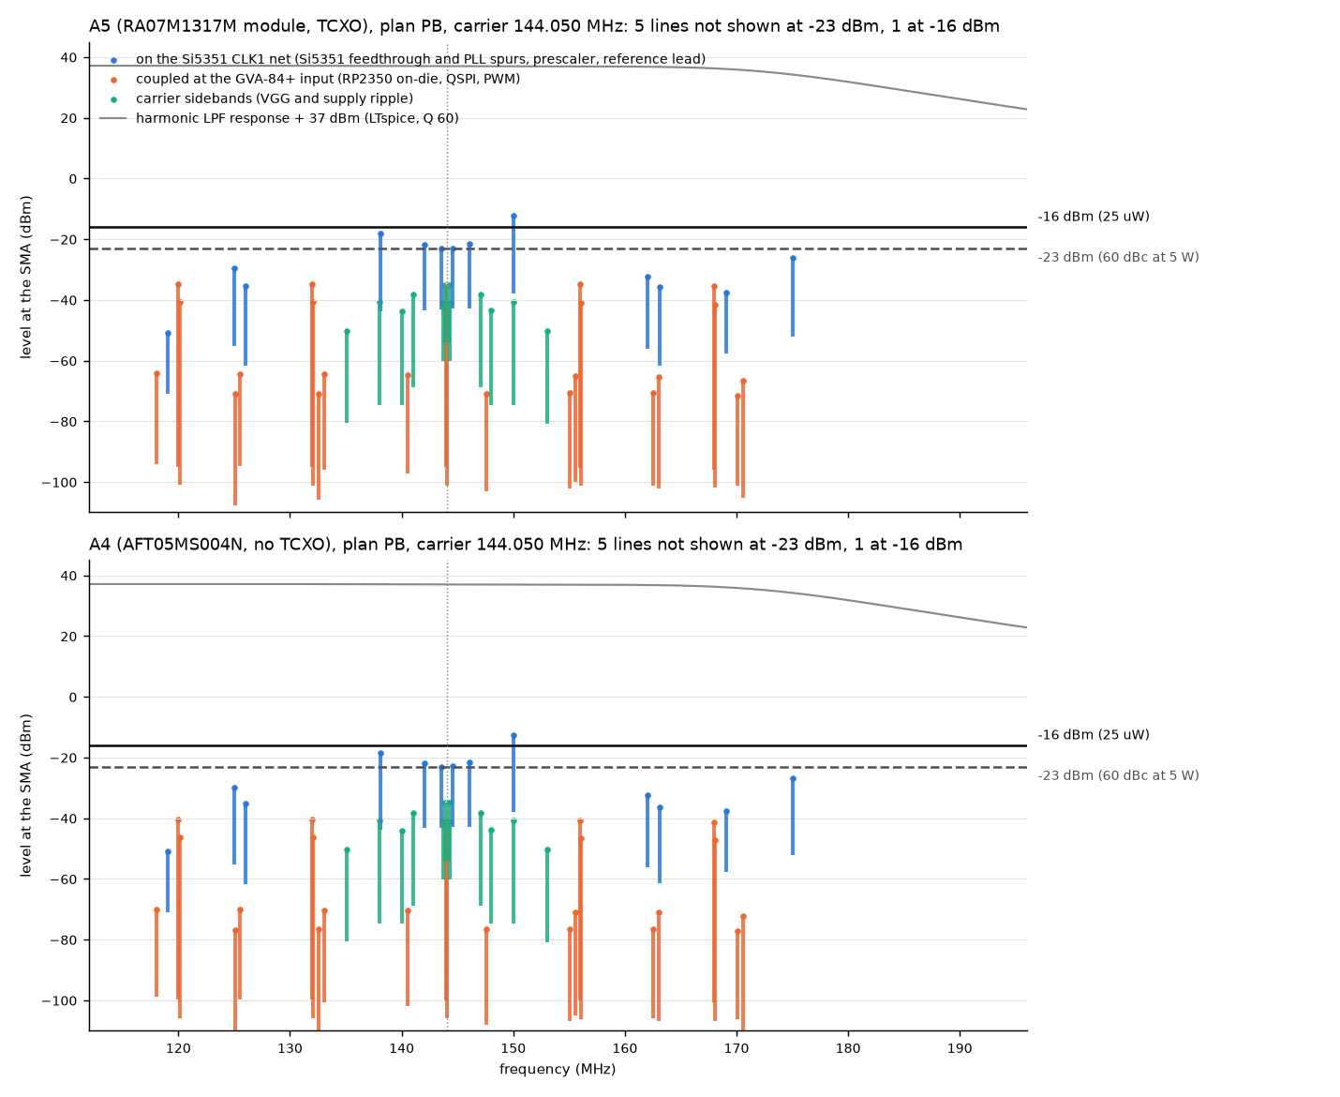
hardware/sim/freq/results/txspur-20260928-01/antenna-PB-144.050.png
