robinonsay/cwht/hardware/sim/freq/results/txspur-20260928-01/antenna-PB-147.950.png

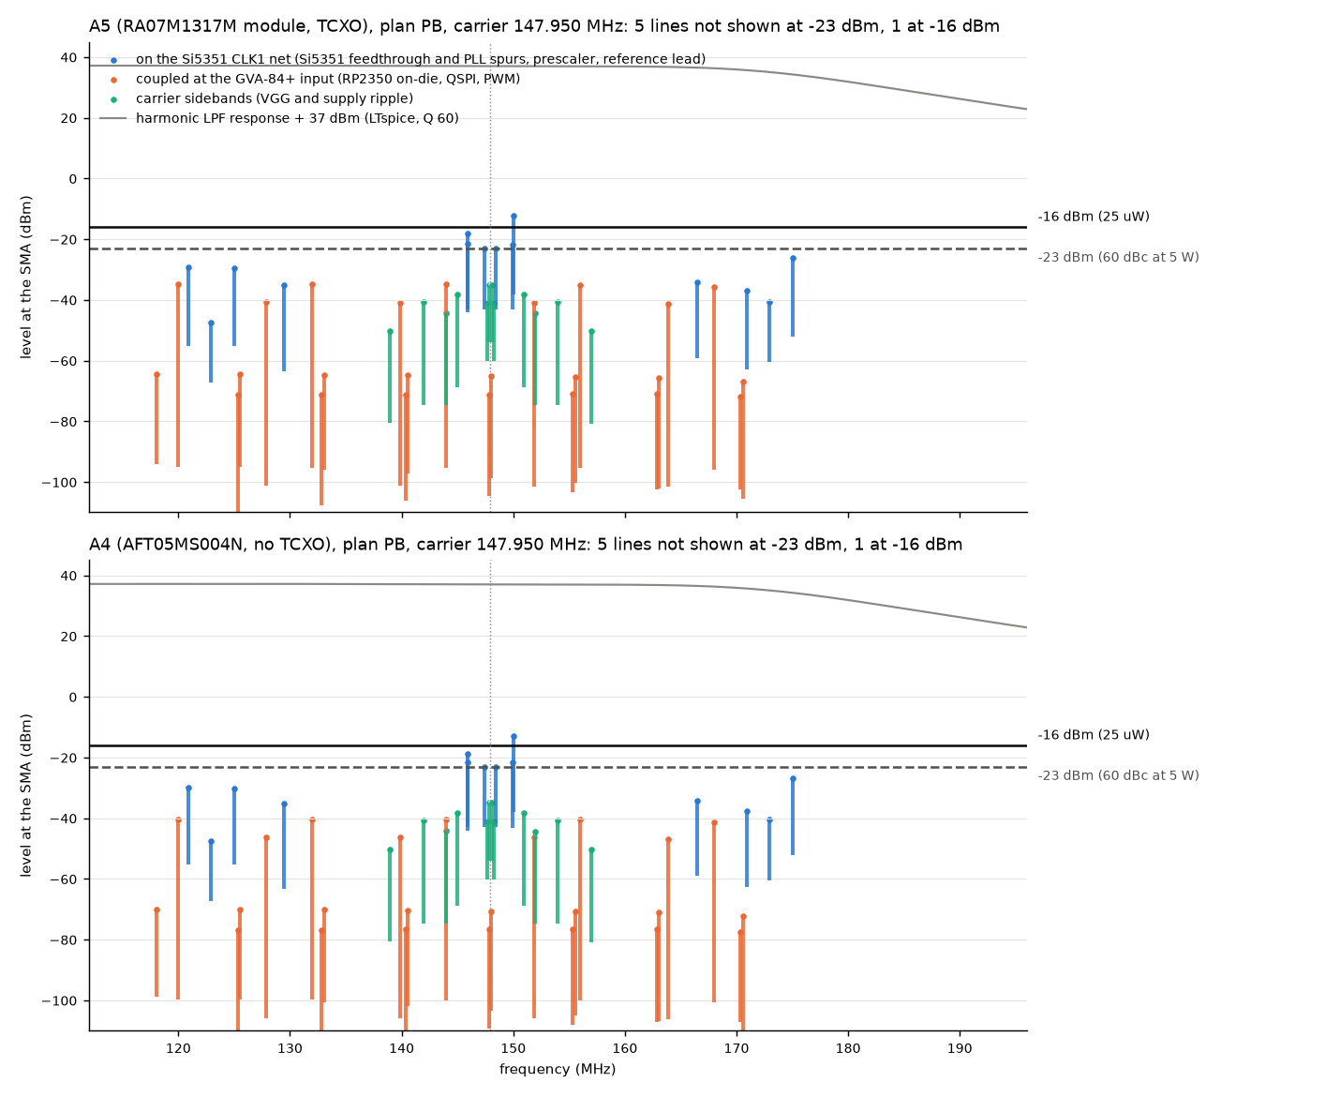
hardware/sim/freq/results/txspur-20260928-01/antenna-PB-147.950.png
