robinonsay/cwht/hardware/sim/freq/results/txspur-20260928-02/antenna-P-PB-144.050.png

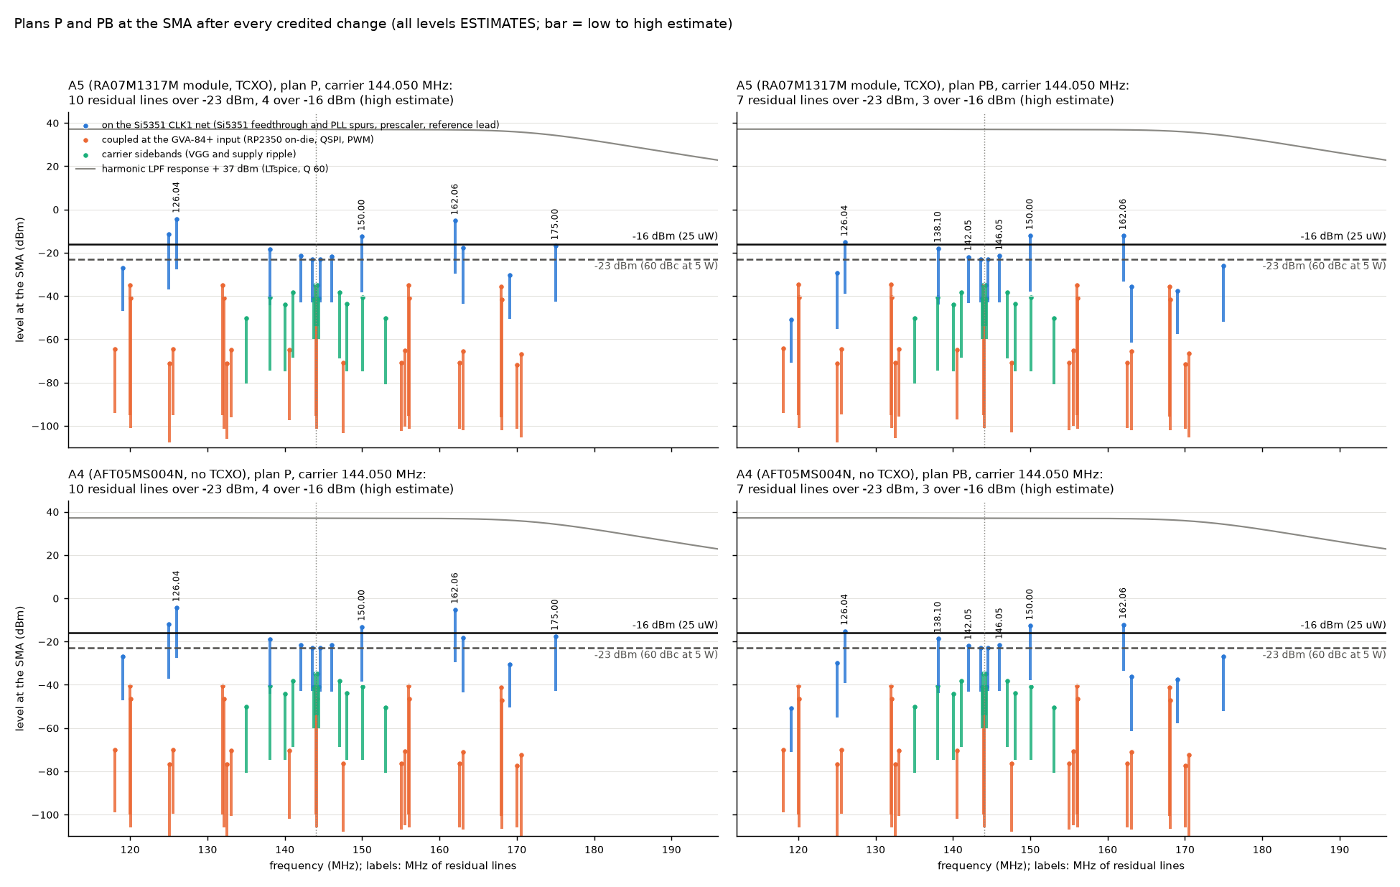
hardware/sim/freq/results/txspur-20260928-02/antenna-P-PB-144.050.png
