robinonsay/cwht/hardware/sim/freq/results/txspur-20260928-02/c7-prescaler-tap.png

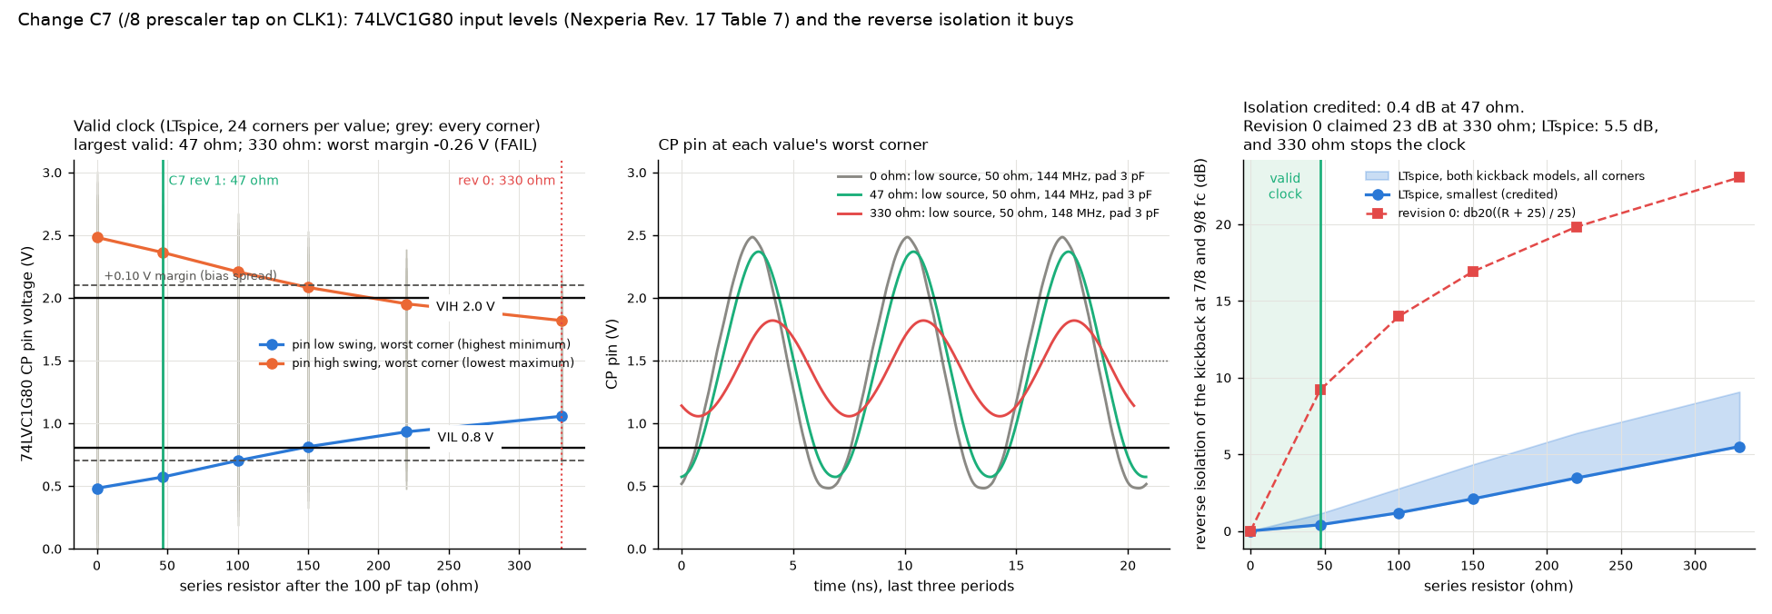
hardware/sim/freq/results/txspur-20260928-02/c7-prescaler-tap.png
