robinonsay/cwht/hardware/sim/freq/results/txspur-20260928-02/c10-tolerance.png

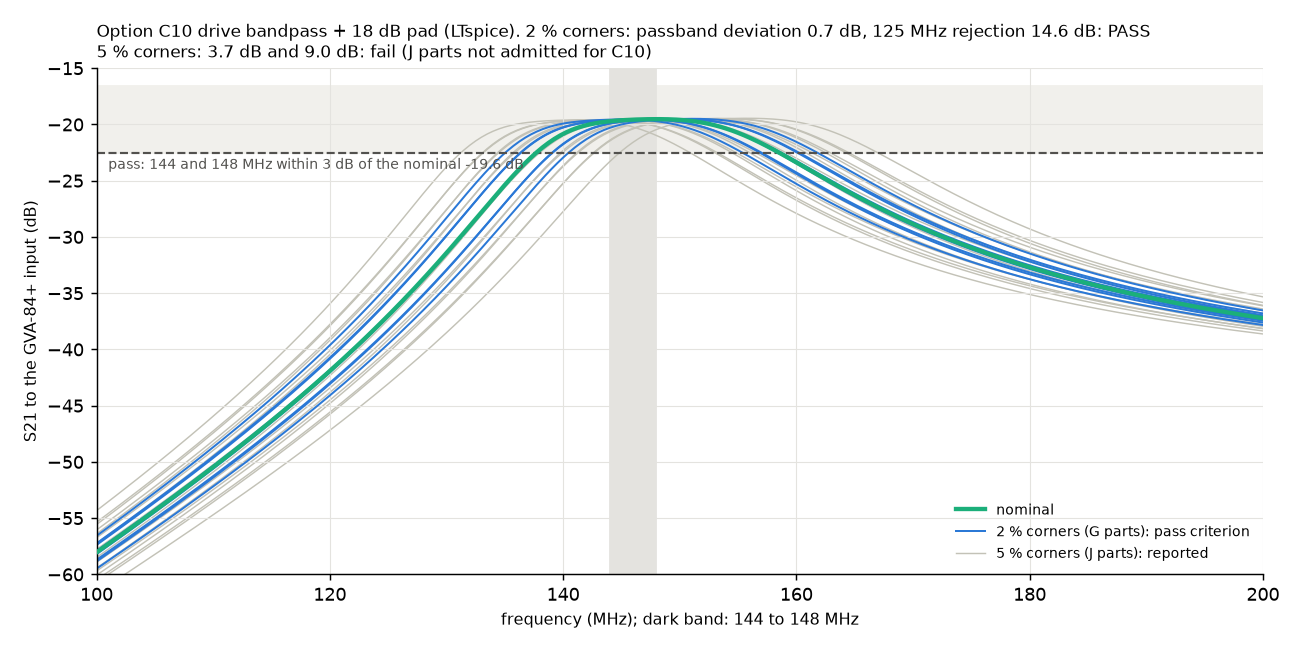
hardware/sim/freq/results/txspur-20260928-02/c10-tolerance.png
