robinonsay/cwht/hardware/sim/freq/results/txspur-20260928-02/filters.png

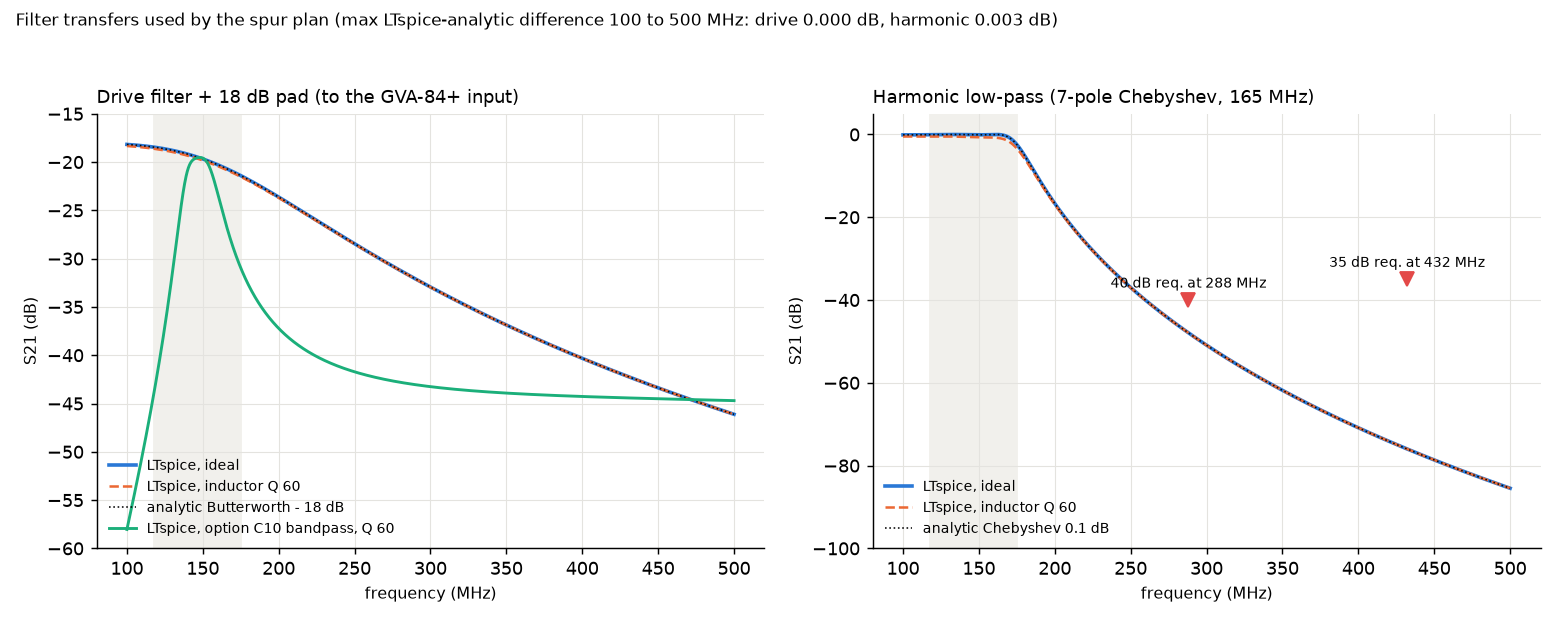
hardware/sim/freq/results/txspur-20260928-02/filters.png
