robinonsay/cwht/hardware/sim/freq/results/txspur-20260928-02/t1-trap.png

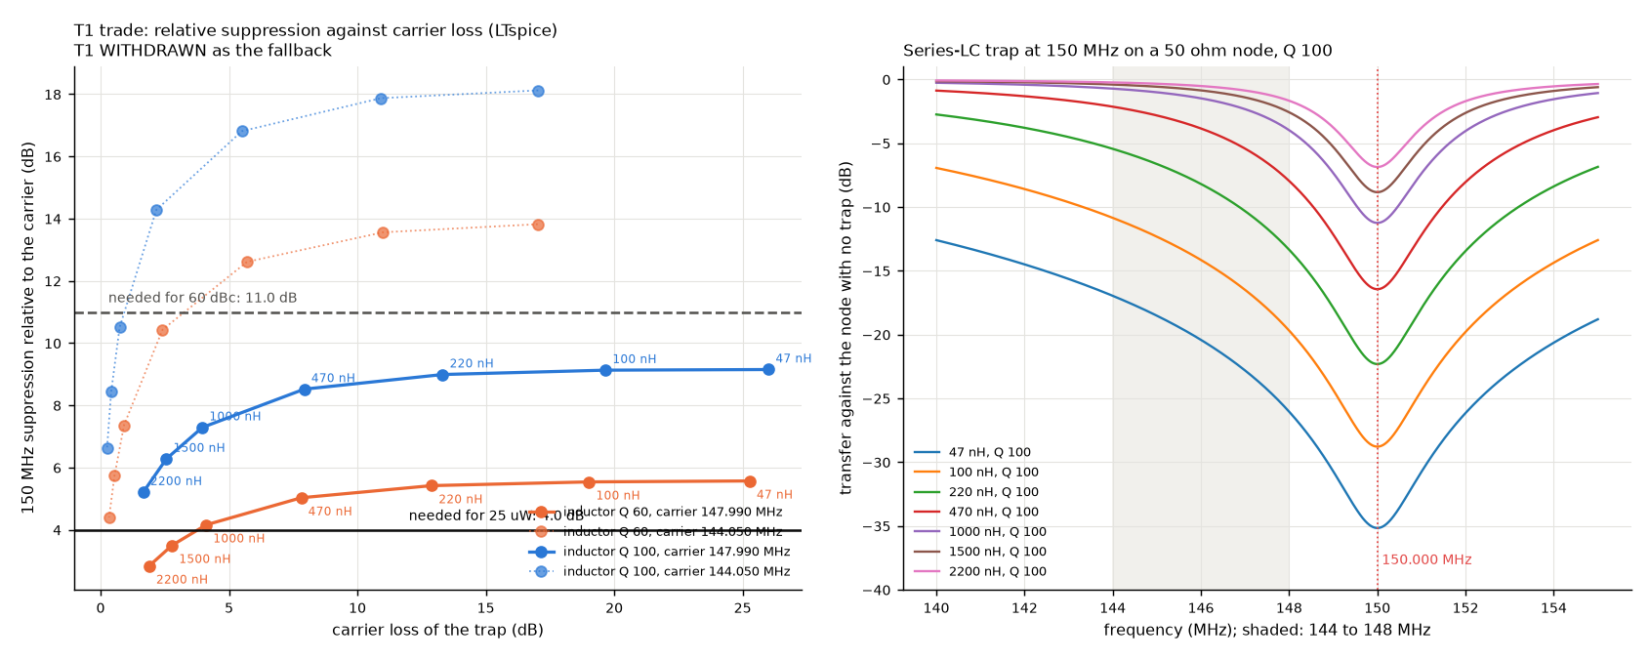
hardware/sim/freq/results/txspur-20260928-02/t1-trap.png
