robinonsay/cwht/hardware/sim/freq/results/txspur-20260928-02/worst-line-vs-carrier.png

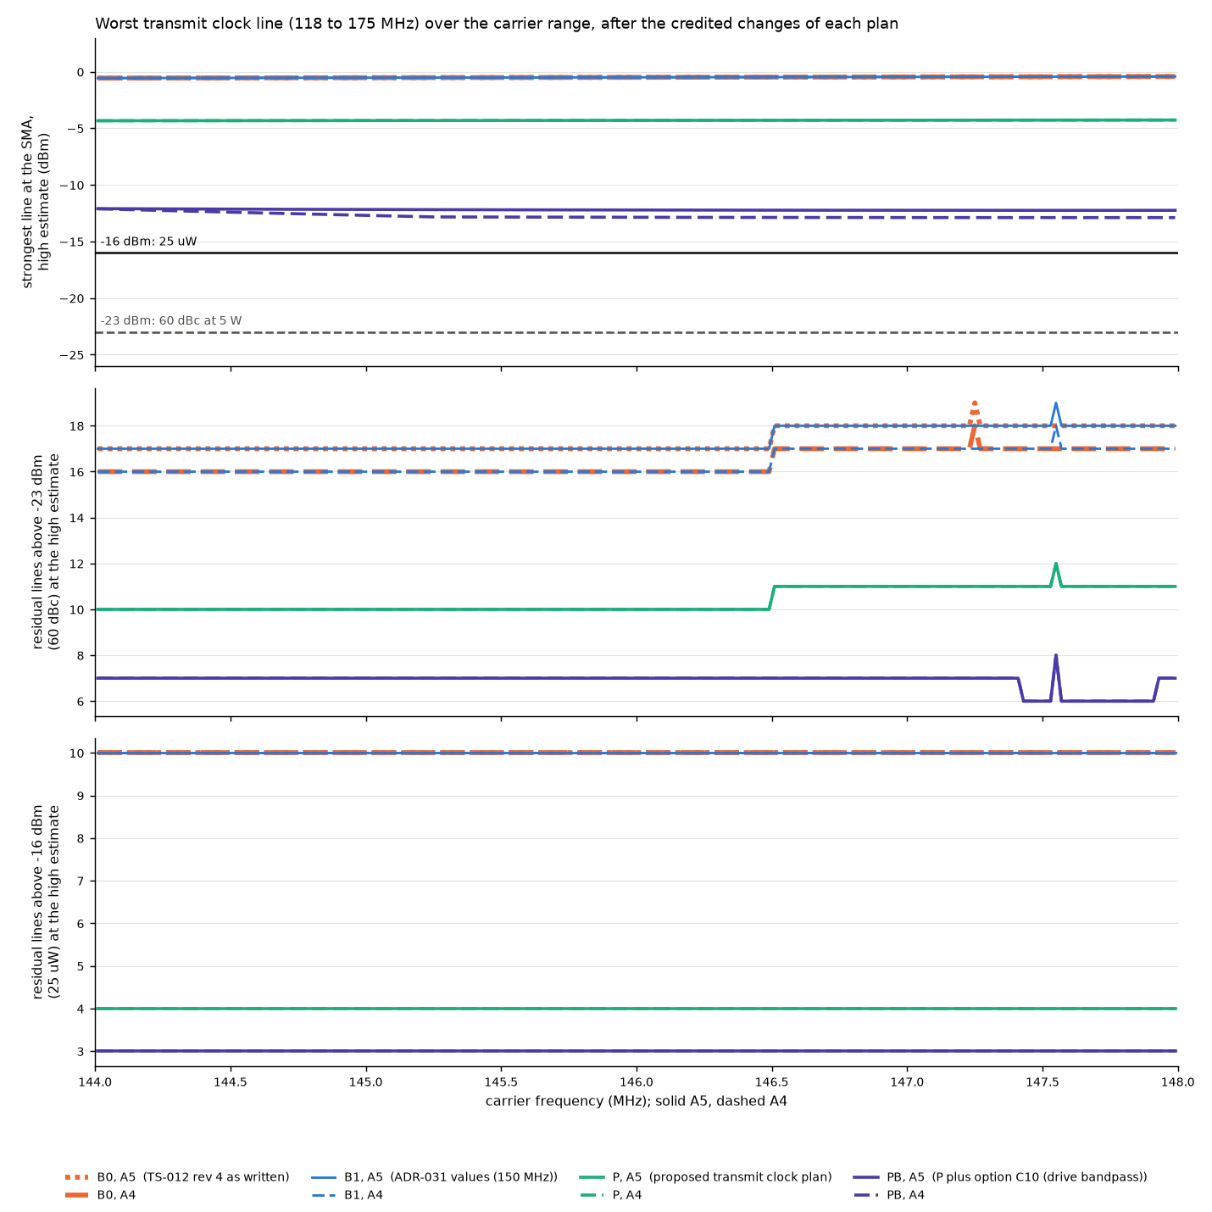
hardware/sim/freq/results/txspur-20260928-02/worst-line-vs-carrier.png
