robinonsay/cwht/hardware/sim/rx-frontend/results/2026-09-28-r01-bpf-ts012-baseline/bpf_2p3_bw5_s21_image.png

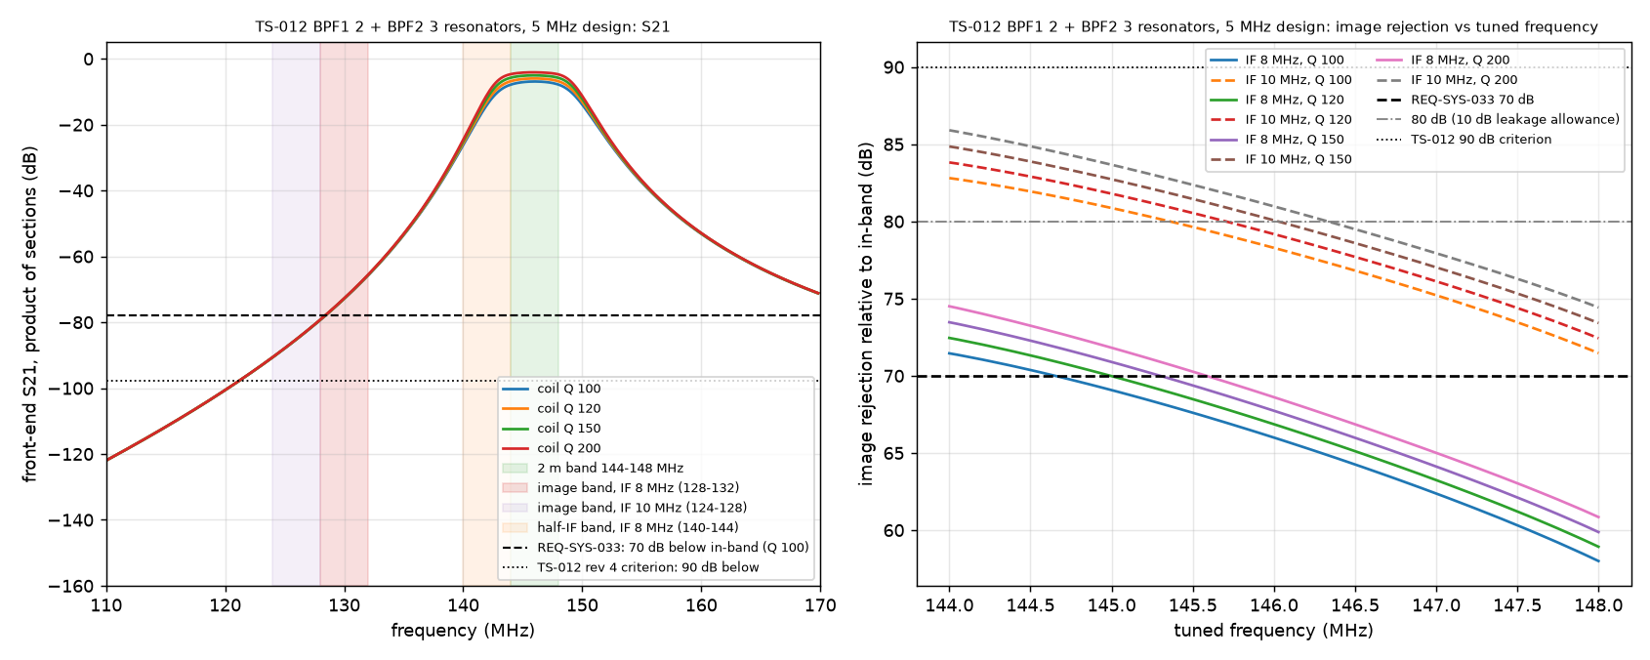
hardware/sim/rx-frontend/results/2026-09-28-r01-bpf-ts012-baseline/bpf_2p3_bw5_s21_image.png
