robinonsay/cwht/hardware/sim/rx-frontend/results/2026-09-28-r01-bpf-ts012-baseline/bpf_2p3_bw6_mcB_montecarlo.png

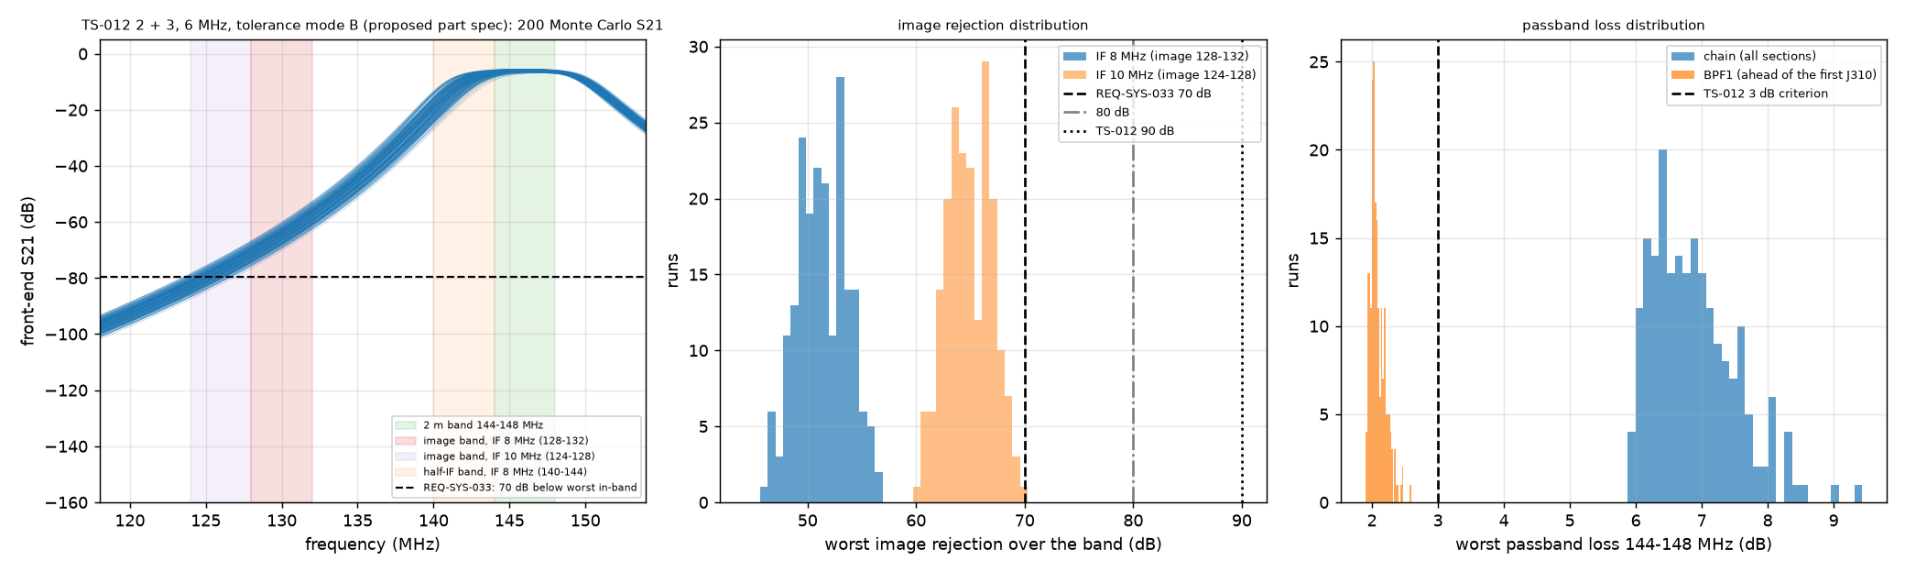
hardware/sim/rx-frontend/results/2026-09-28-r01-bpf-ts012-baseline/bpf_2p3_bw6_mcB_montecarlo.png
