robinonsay/cwht/hardware/sim/rx-frontend/results/2026-09-28-r02-bpf-three-section/bpf_2p3p3_bw6_s21_image.png

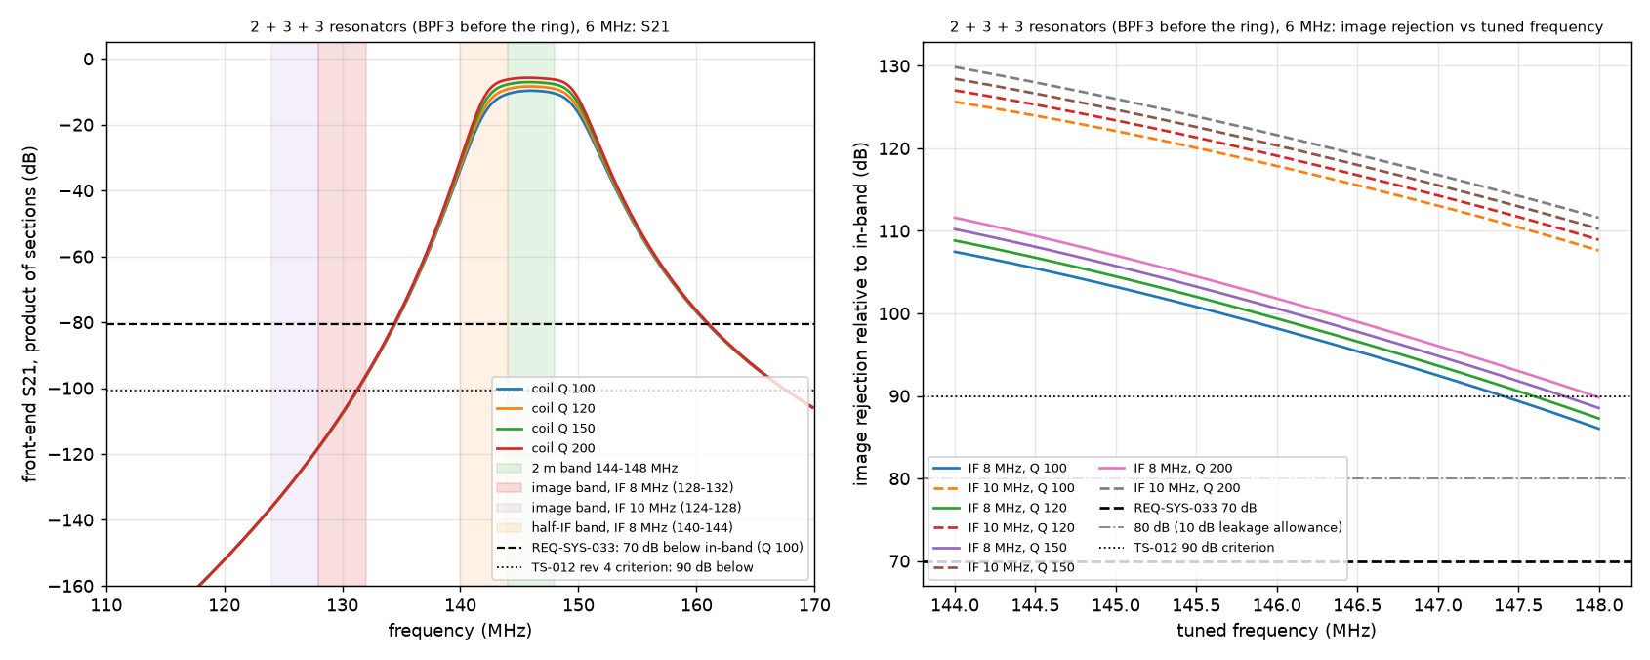
hardware/sim/rx-frontend/results/2026-09-28-r02-bpf-three-section/bpf_2p3p3_bw6_s21_image.png
