robinonsay/cwht/hardware/sim/rx-frontend/results/2026-09-28-r03-bpf-three-section-mc/bpf_2p3p3_bw6_mcA_montecarlo.png

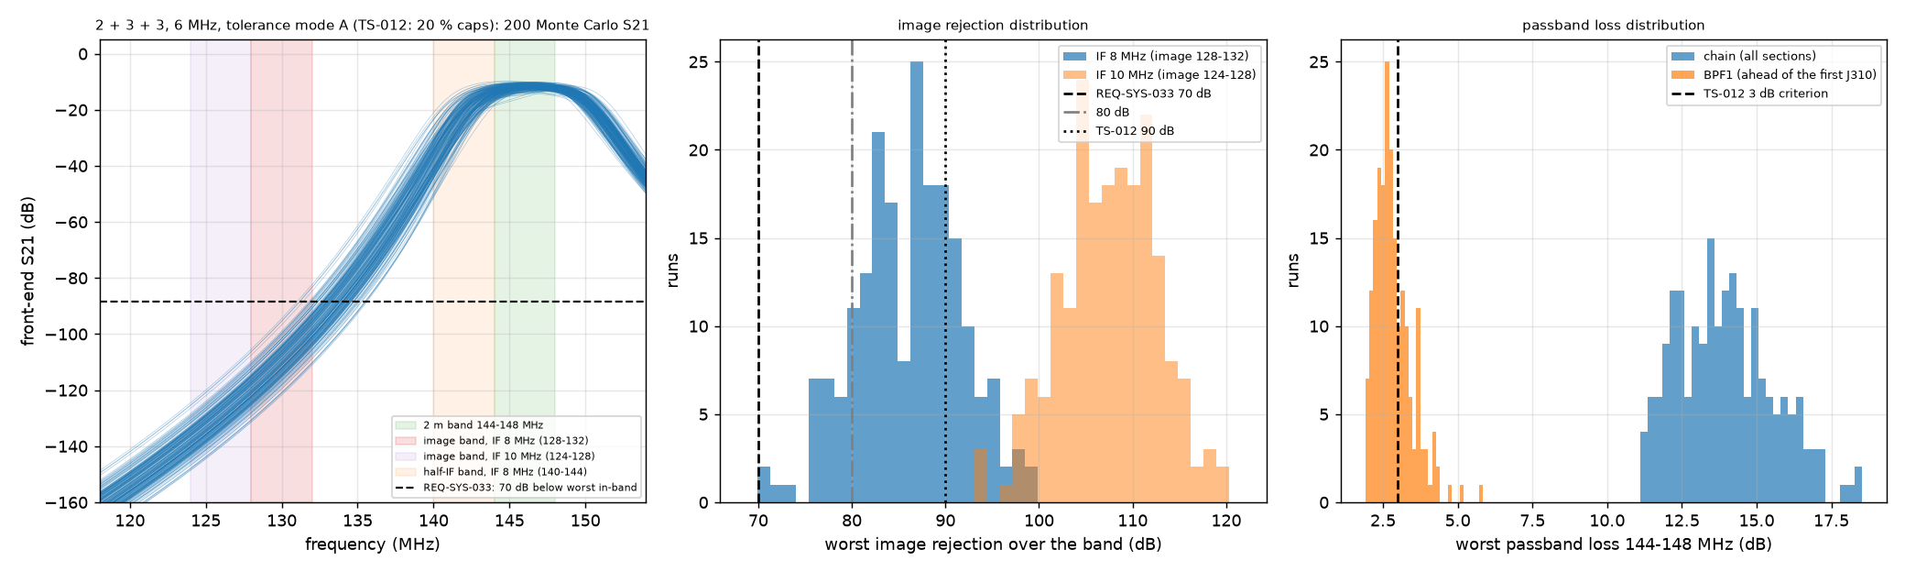
hardware/sim/rx-frontend/results/2026-09-28-r03-bpf-three-section-mc/bpf_2p3p3_bw6_mcA_montecarlo.png
