robinonsay/cwht/hardware/sim/rx-frontend/results/2026-09-28-r04-bpf-leakage/bpf_2p3p3_bw6_leak_leakage.png

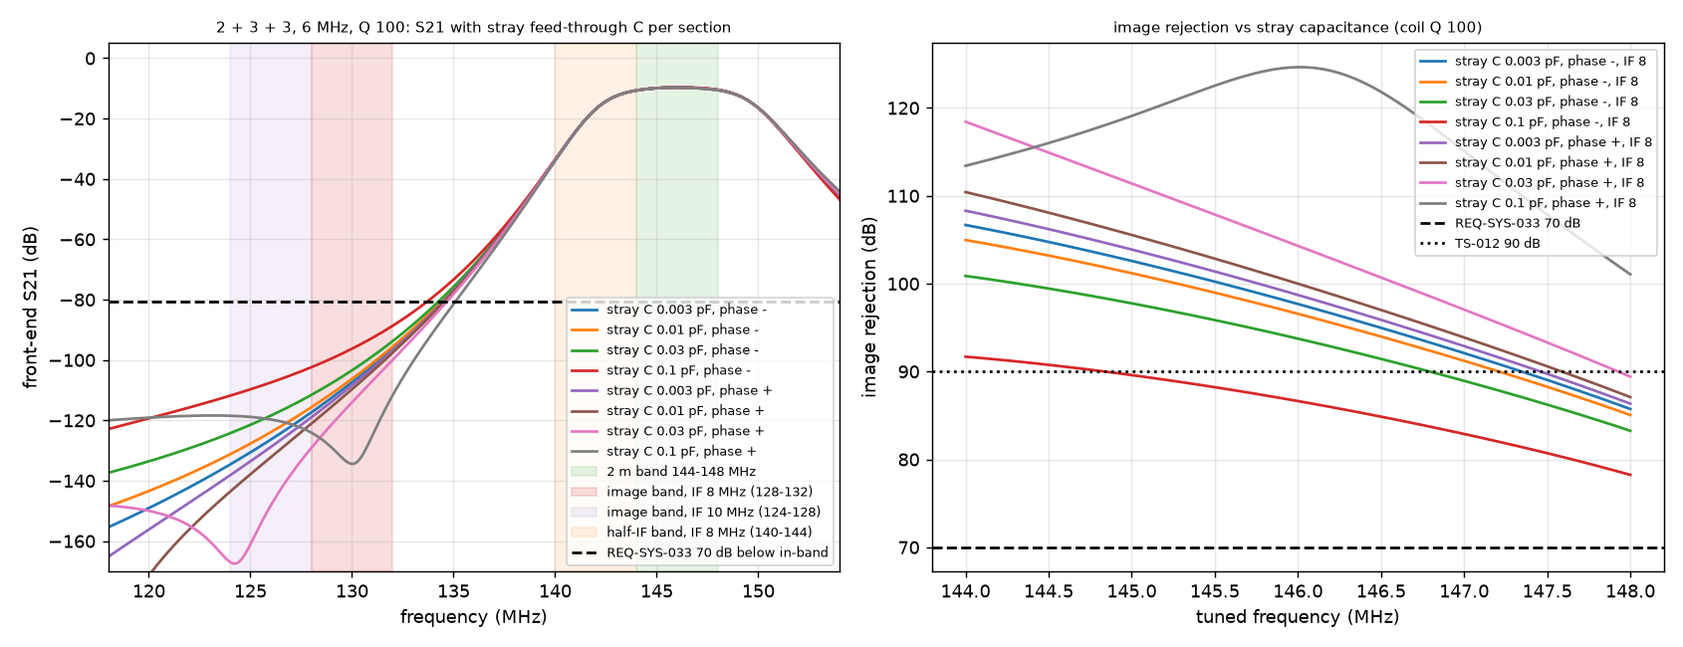
hardware/sim/rx-frontend/results/2026-09-28-r04-bpf-leakage/bpf_2p3p3_bw6_leak_leakage.png
