robinonsay/cwht/hardware/sim/rx-frontend/results/2026-09-28-r05-halfif-mixers/halfif_jfet_halfif.png

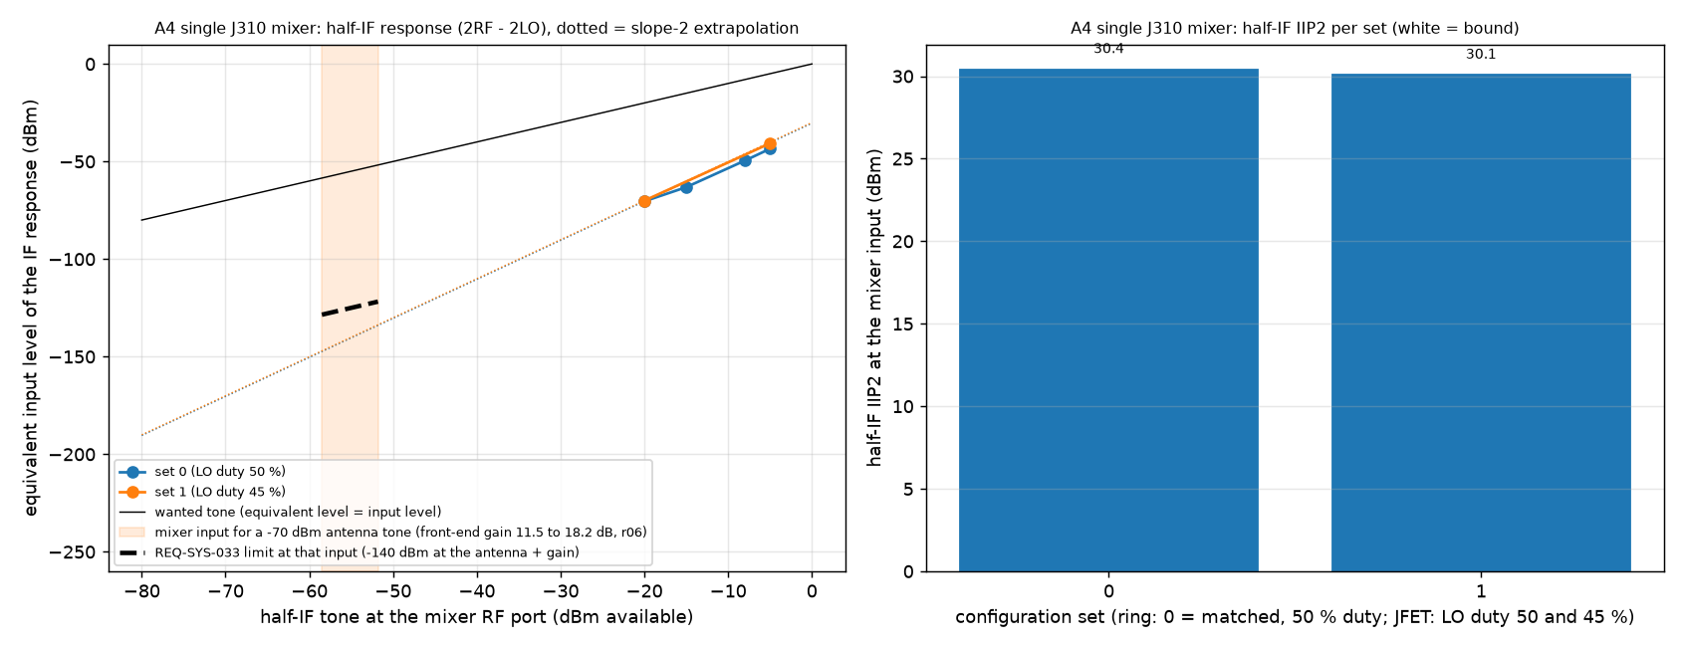
hardware/sim/rx-frontend/results/2026-09-28-r05-halfif-mixers/halfif_jfet_halfif.png
