robinonsay/cwht/hardware/sim/rx-frontend/results/2026-09-28-r06-cascade/cascade_nf_gain.png

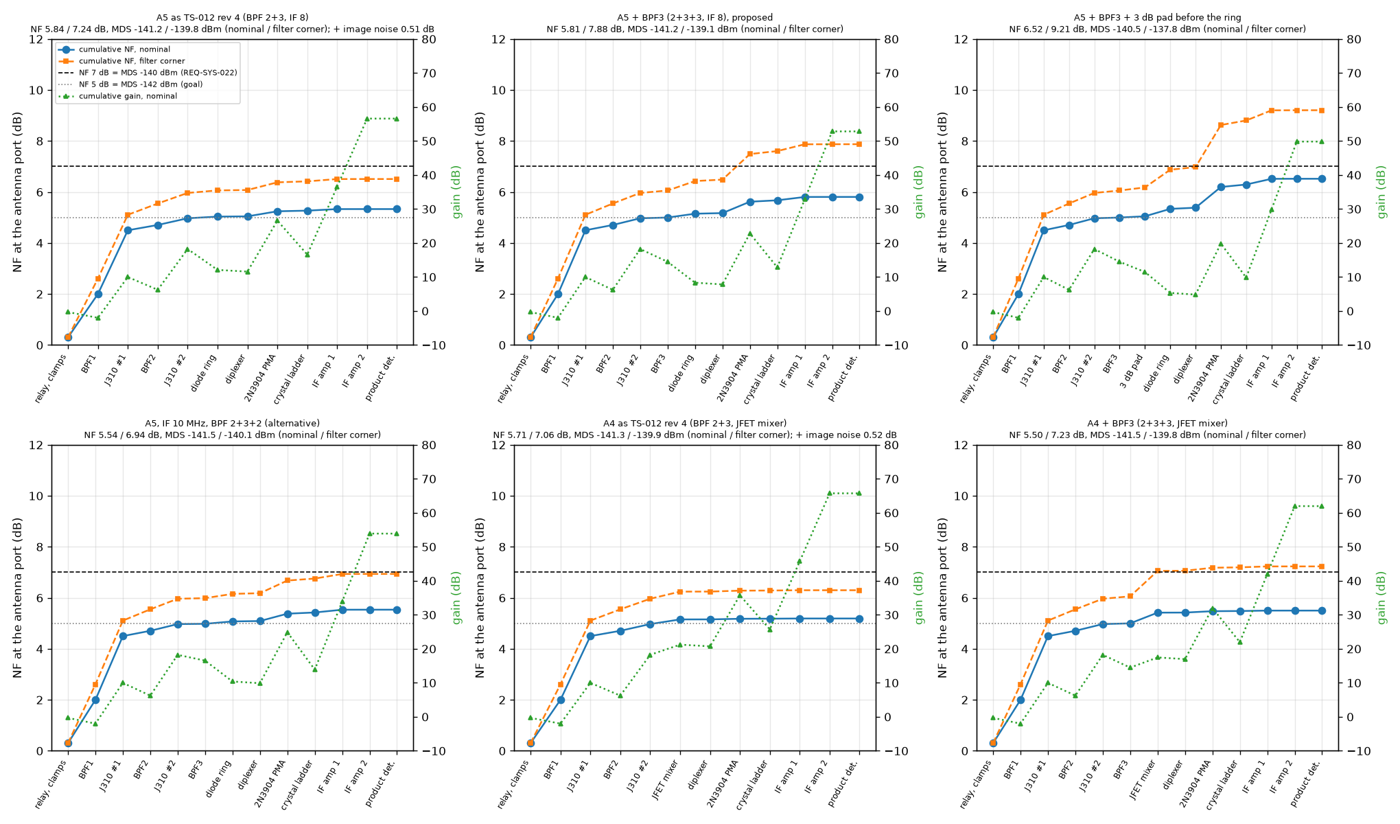
hardware/sim/rx-frontend/results/2026-09-28-r06-cascade/cascade_nf_gain.png
