robinonsay/cwht/hardware/sim/rx-frontend/results/2026-09-28-r06-cascade/cascade_verdicts.png

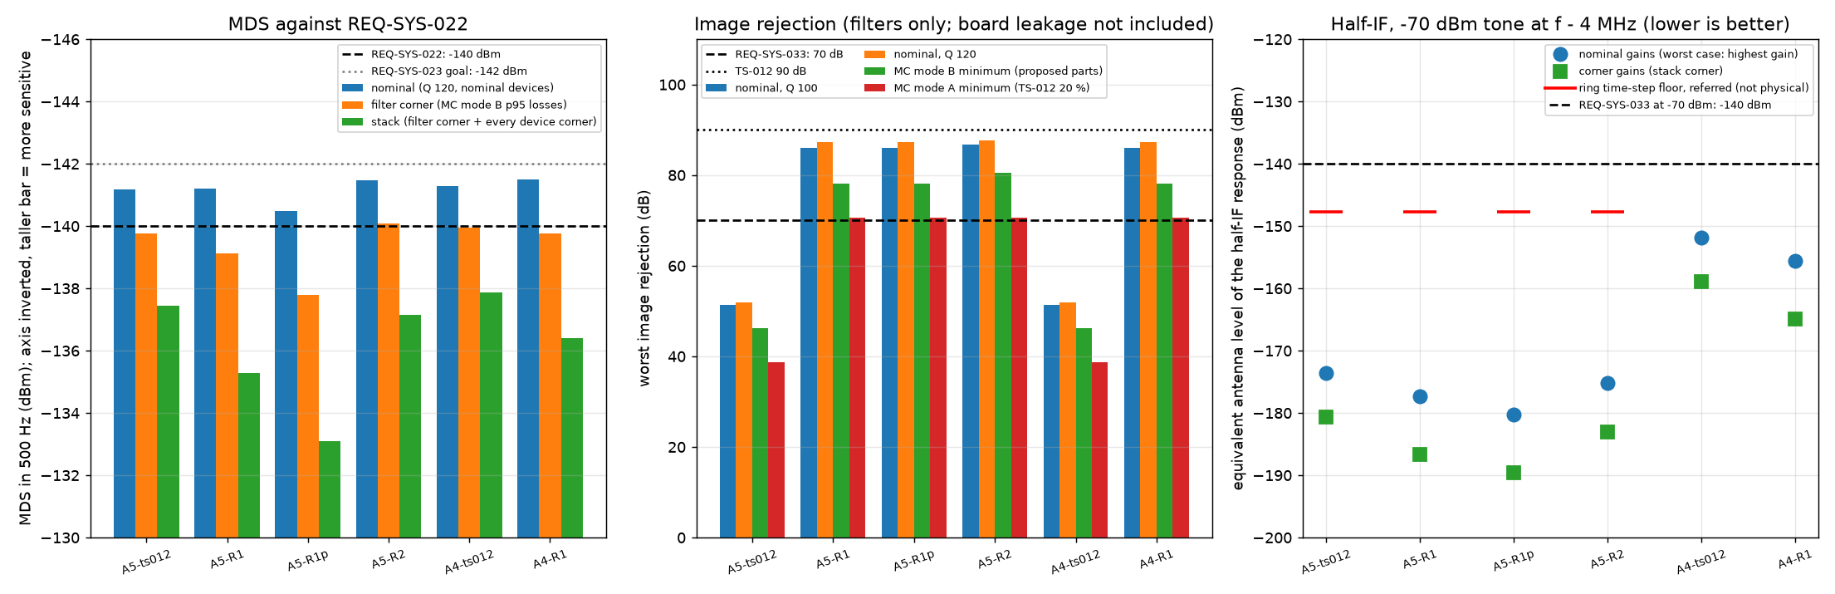
hardware/sim/rx-frontend/results/2026-09-28-r06-cascade/cascade_verdicts.png
