robinonsay/cwht/hardware/sim/rx-frontend/results/2026-09-28-r07-nodal-validation/nodal_vs_ltspice.png

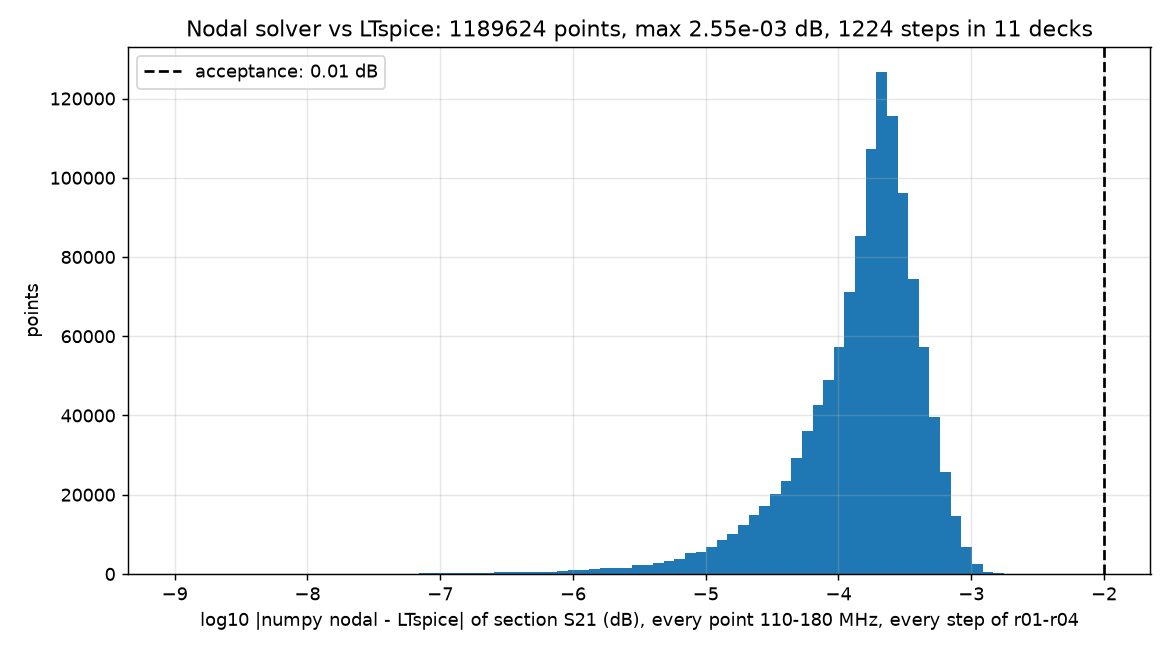
hardware/sim/rx-frontend/results/2026-09-28-r07-nodal-validation/nodal_vs_ltspice.png
