robinonsay/cwht/hardware/sim/rx-frontend/results/2026-09-28-r08-bpf-tolerance-corners/corner_2p3p3_ltspice.png

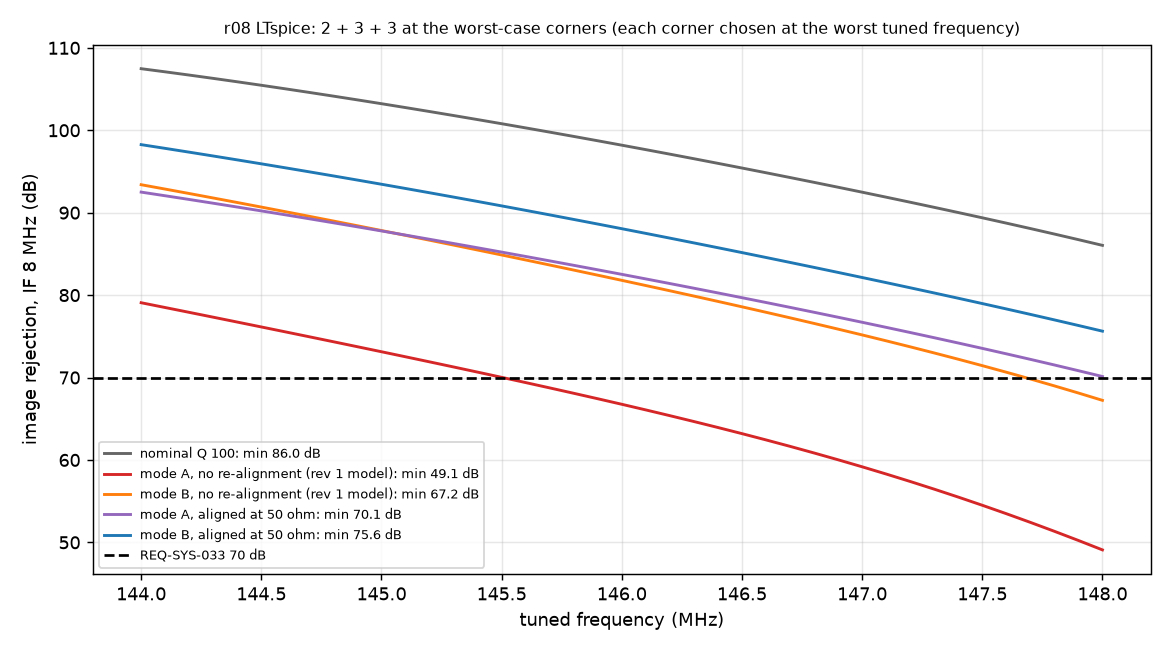
hardware/sim/rx-frontend/results/2026-09-28-r08-bpf-tolerance-corners/corner_2p3p3_ltspice.png
