robinonsay/cwht/hardware/sim/rx-frontend/results/2026-09-28-r08-bpf-tolerance-corners/mc20k_distributions.png

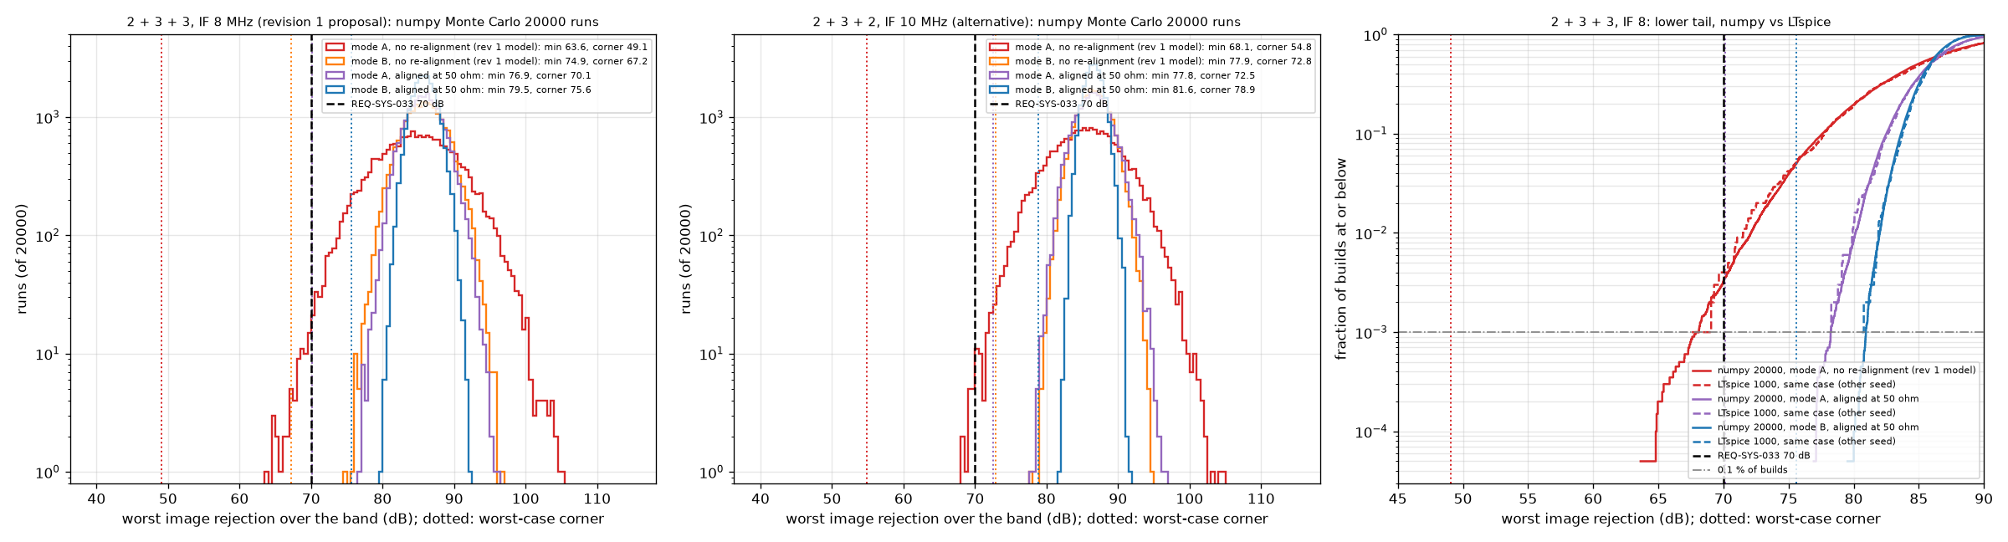
hardware/sim/rx-frontend/results/2026-09-28-r08-bpf-tolerance-corners/mc20k_distributions.png
