robinonsay/cwht/hardware/sim/rx-frontend/results/2026-09-28-r09-bpf-port-impedance/bpf1_loss_vs_j310_input.png

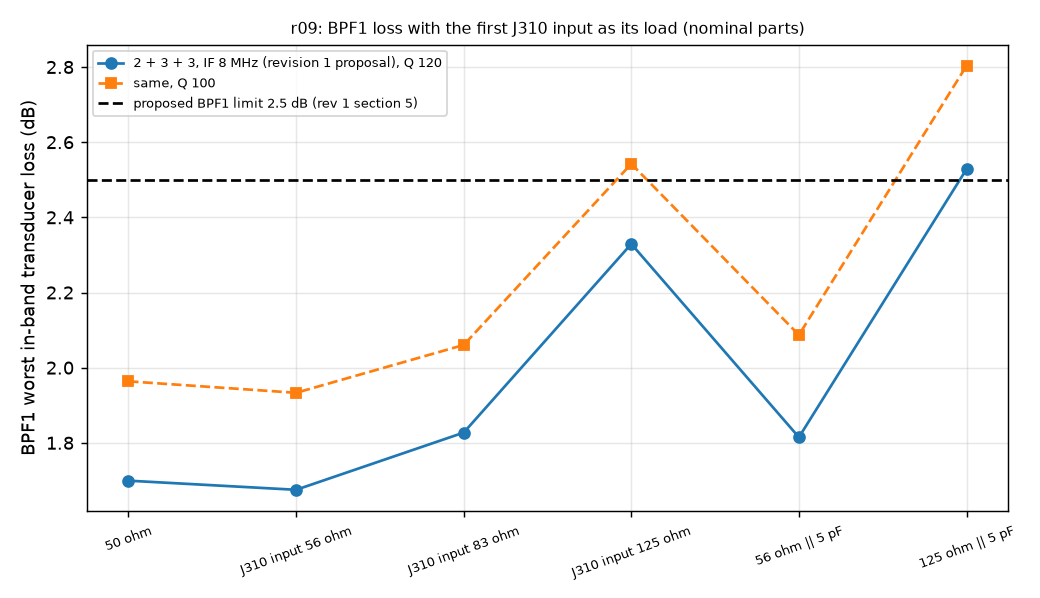
hardware/sim/rx-frontend/results/2026-09-28-r09-bpf-port-impedance/bpf1_loss_vs_j310_input.png
