robinonsay/cwht/hardware/sim/rx-frontend/results/2026-09-28-r09-bpf-port-impedance/ports_sensitivity.png

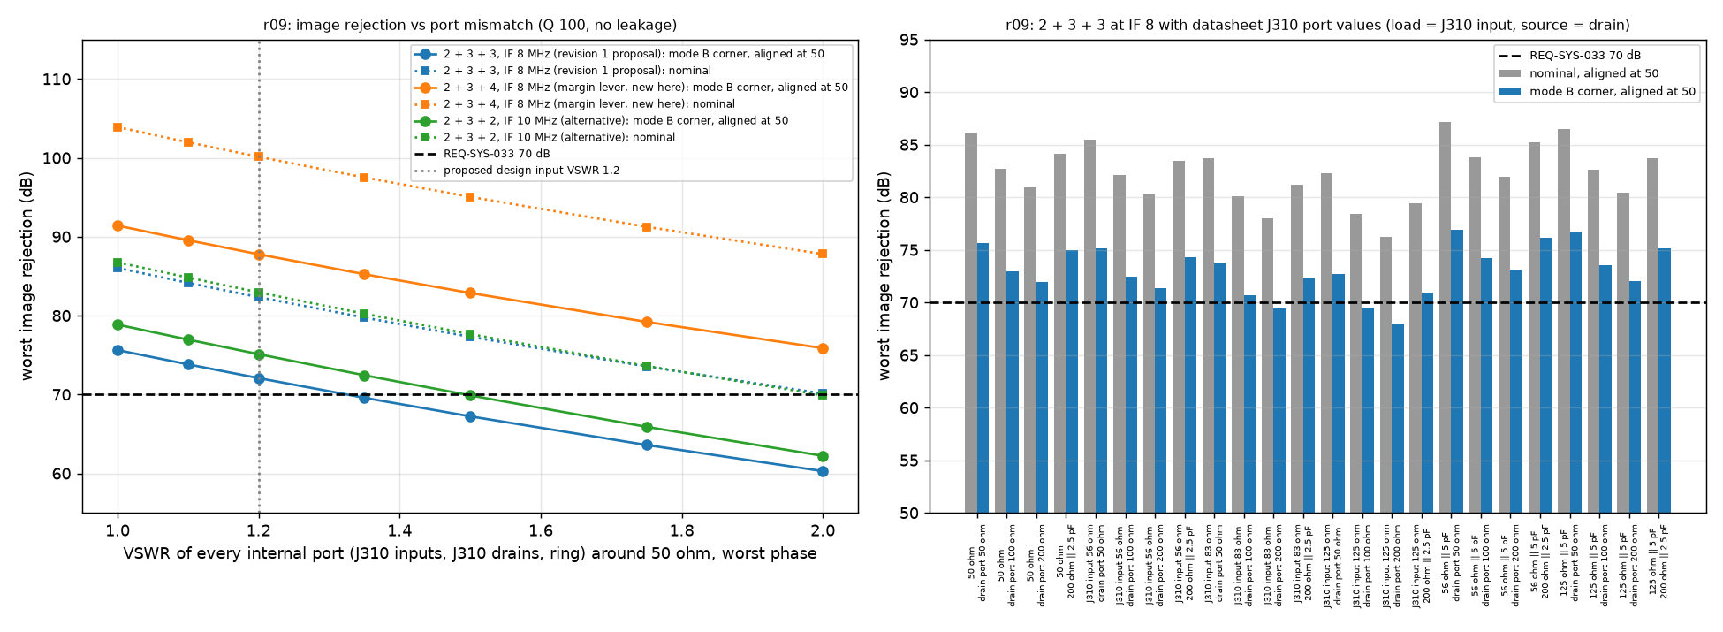
hardware/sim/rx-frontend/results/2026-09-28-r09-bpf-port-impedance/ports_sensitivity.png
