robinonsay/cwht/hardware/sim/rx-frontend/results/2026-09-28-r10-bpf-leakage-corner/leakage_corner.png

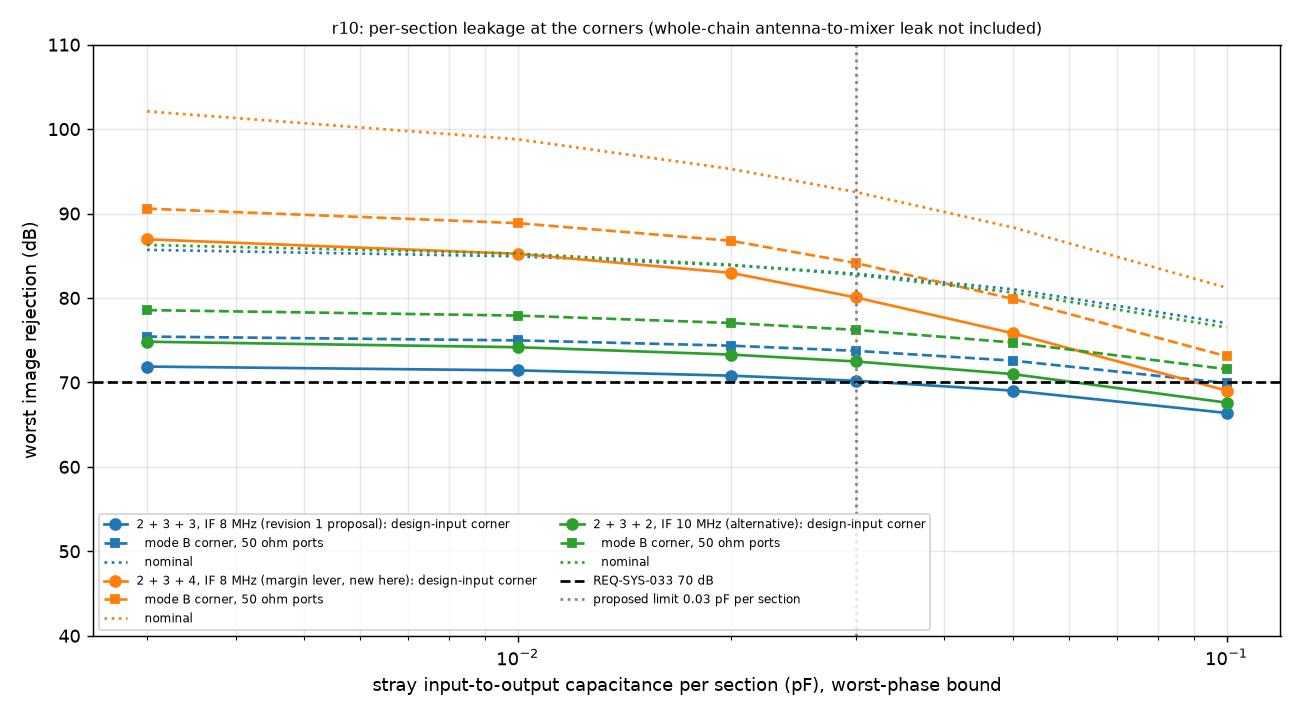
hardware/sim/rx-frontend/results/2026-09-28-r10-bpf-leakage-corner/leakage_corner.png
