robinonsay/cwht/hardware/sim/rx-frontend/results/2026-09-28-r11-cascade-tpm005/cascade_nf_gain.png

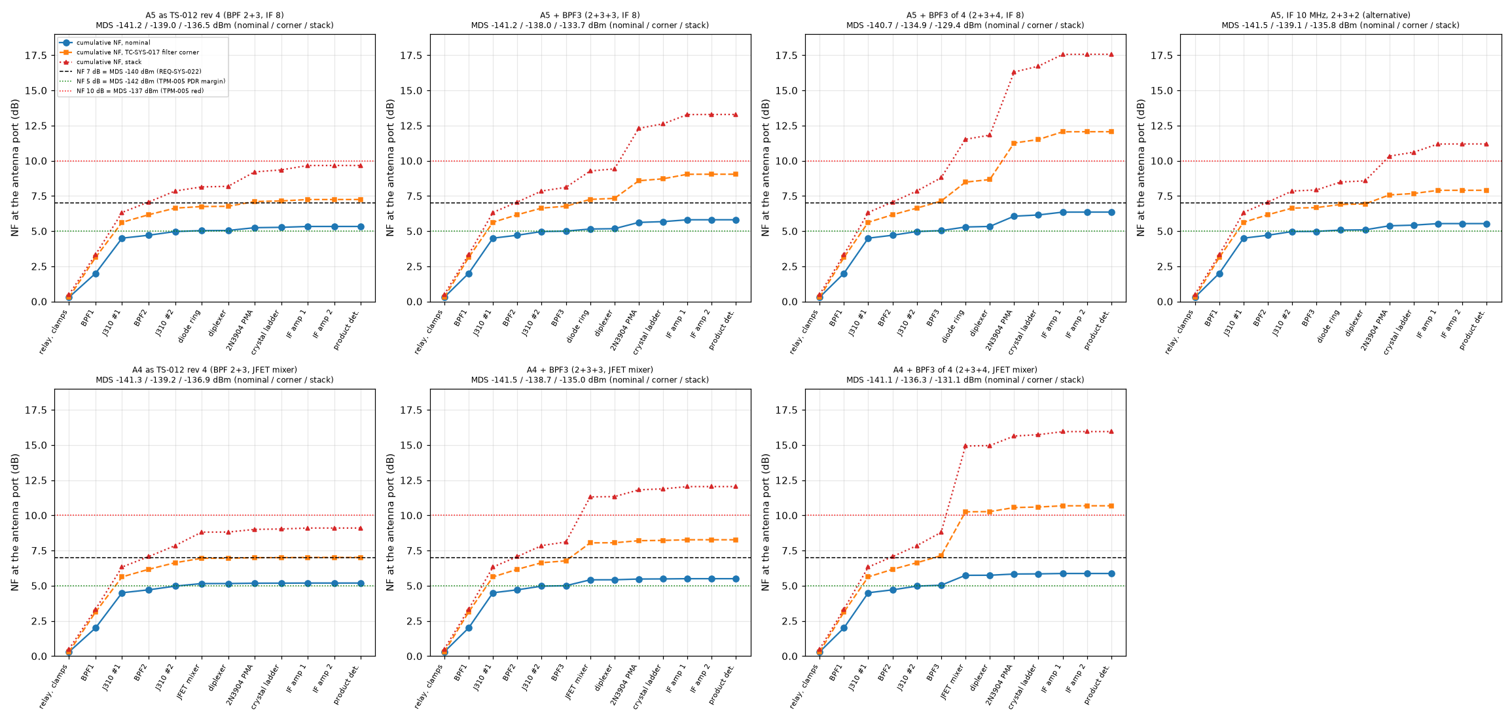
hardware/sim/rx-frontend/results/2026-09-28-r11-cascade-tpm005/cascade_nf_gain.png
