robinonsay/cwht/hardware/sim/rx-frontend/results/2026-09-28-r11-cascade-tpm005/cascade_verdicts.png

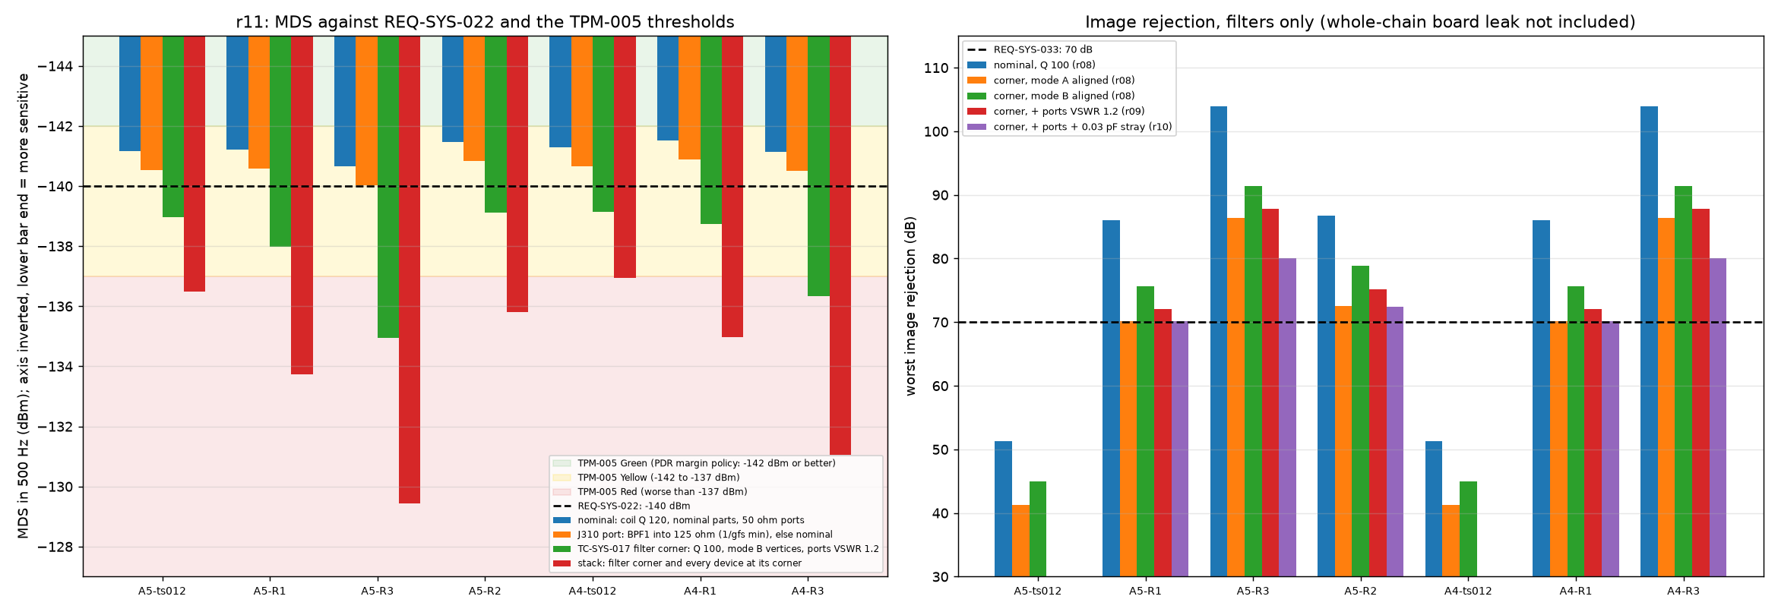
hardware/sim/rx-frontend/results/2026-09-28-r11-cascade-tpm005/cascade_verdicts.png
