robinonsay/cwht/hardware/sim/rx-frontend/results/2026-09-29-r13-bpf-temperature/temperature_residual.png

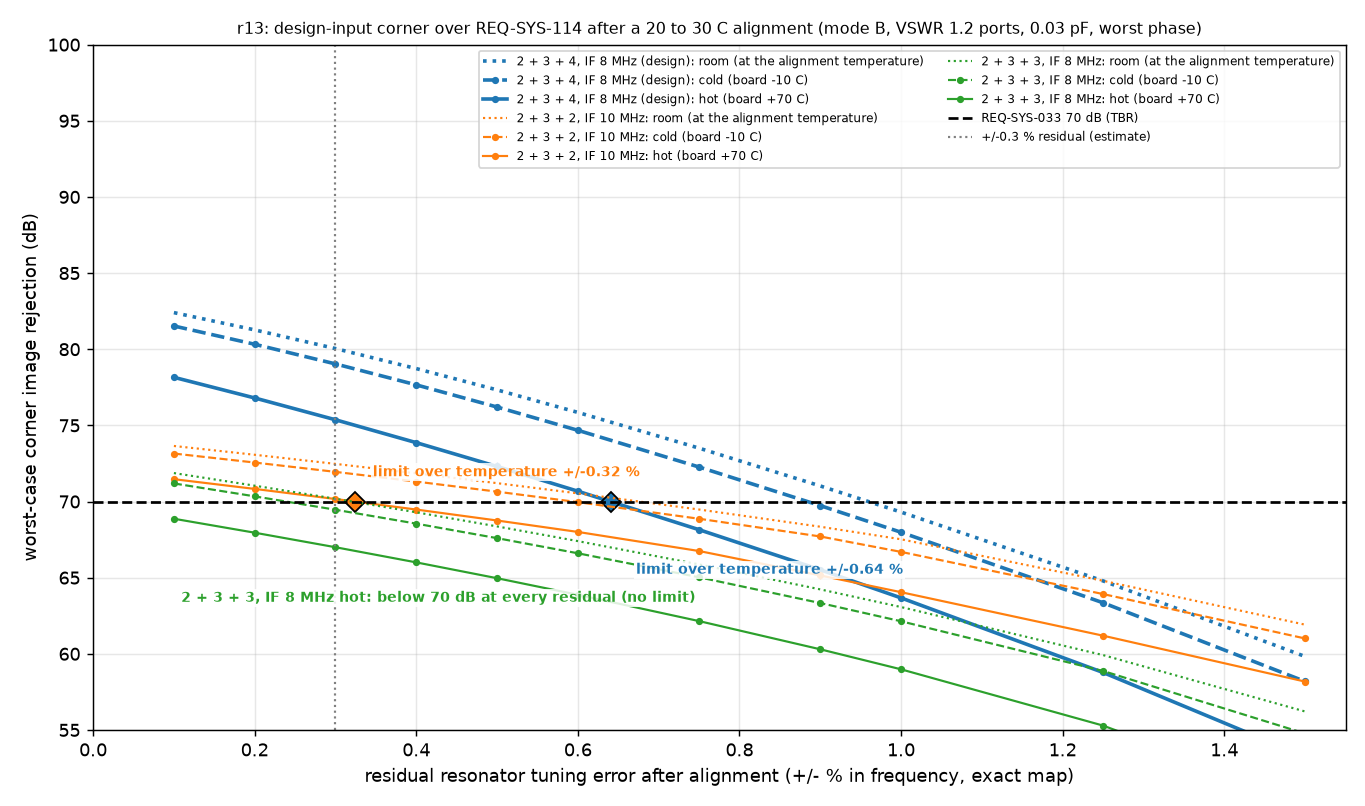
hardware/sim/rx-frontend/results/2026-09-29-r13-bpf-temperature/temperature_residual.png
