robinonsay/cwht/hardware/sim/thermal/results/2026-09-28-ts012-r2/margins_vs_band.png

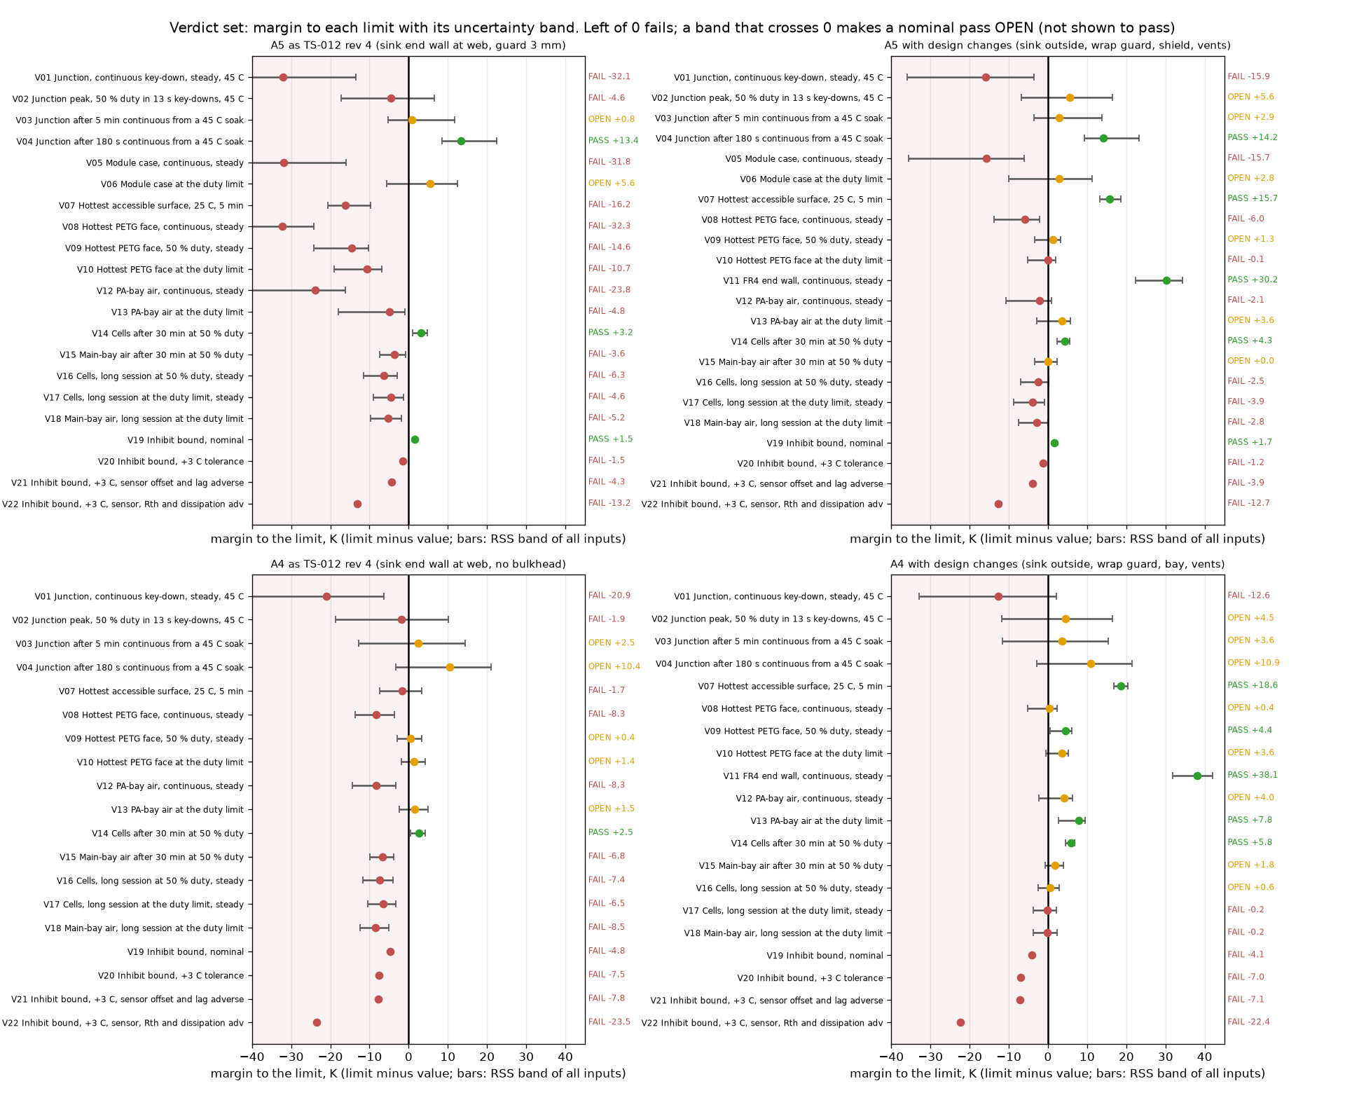
hardware/sim/thermal/results/2026-09-28-ts012-r2/margins_vs_band.png
