robinonsay/cwht/hardware/sim/thermal/results/2026-09-28-ts012-r2/petg_and_cells_45C.png

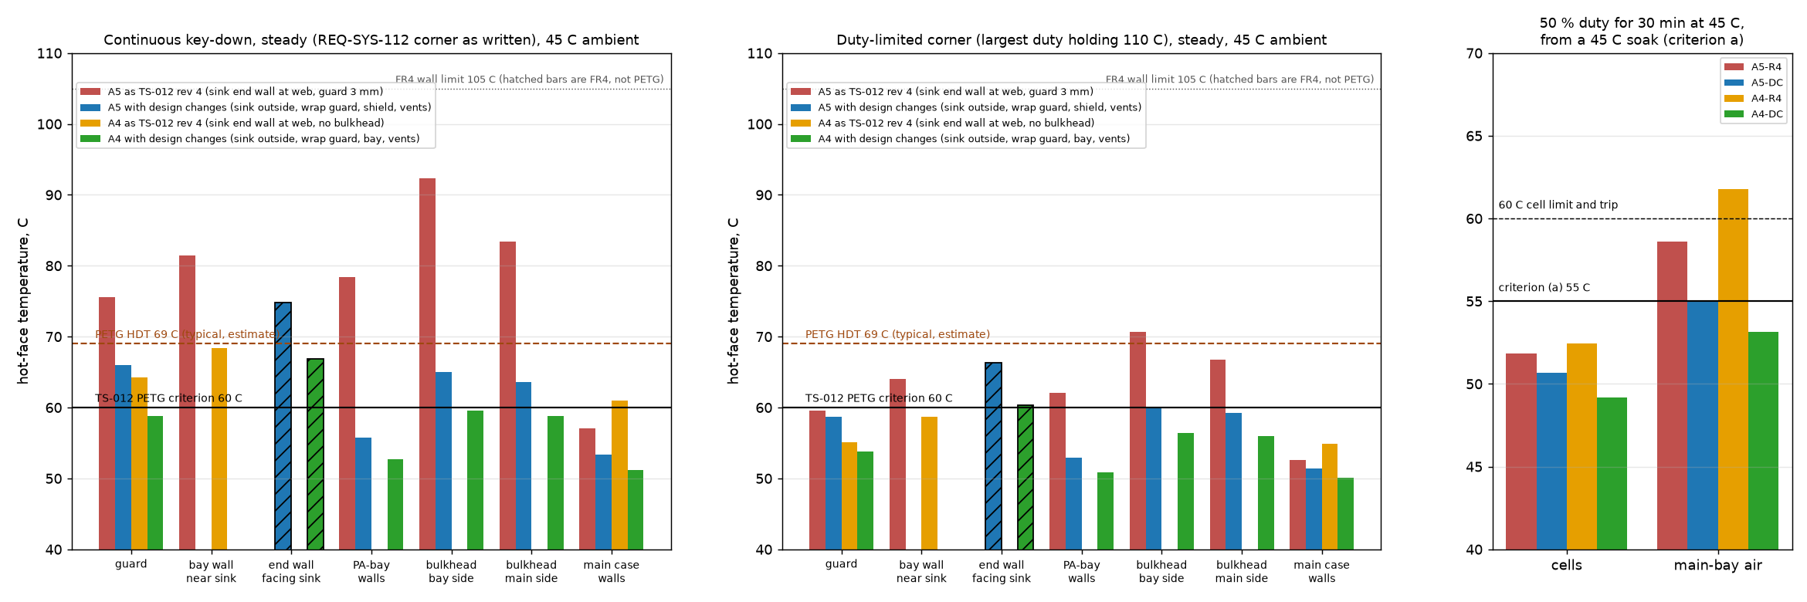
hardware/sim/thermal/results/2026-09-28-ts012-r2/petg_and_cells_45C.png
