robinonsay/cwht/hardware/sim/thermal/results/2026-09-28-ts012-r2/sink_catalog_curve.png

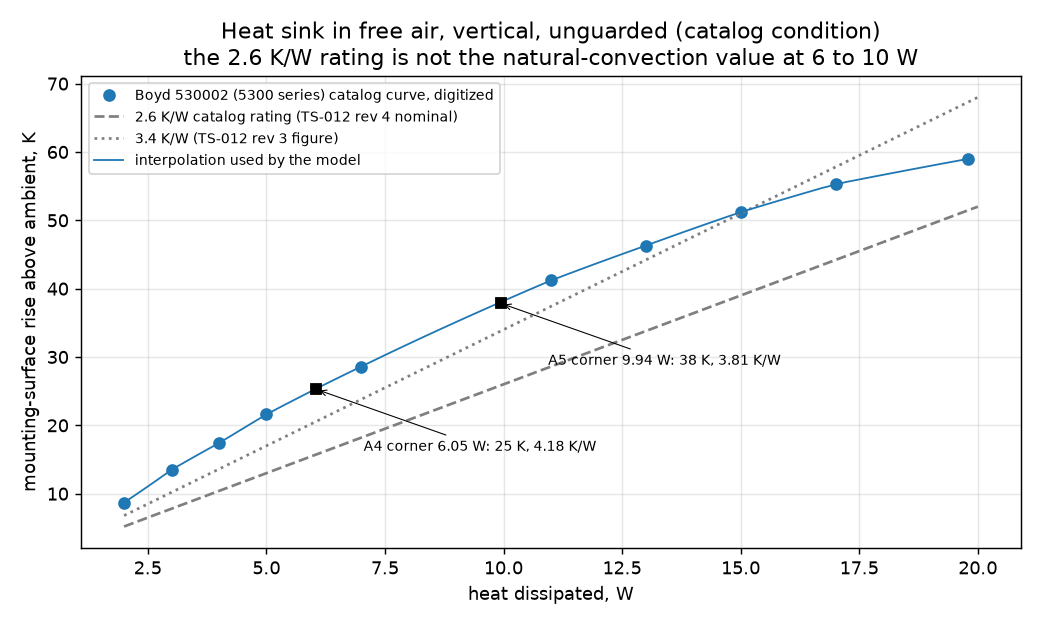
hardware/sim/thermal/results/2026-09-28-ts012-r2/sink_catalog_curve.png
