robinonsay/cwht/hardware/sim/thermal/results/2026-09-28-ts012-r2/surfaces_25C_5min.png

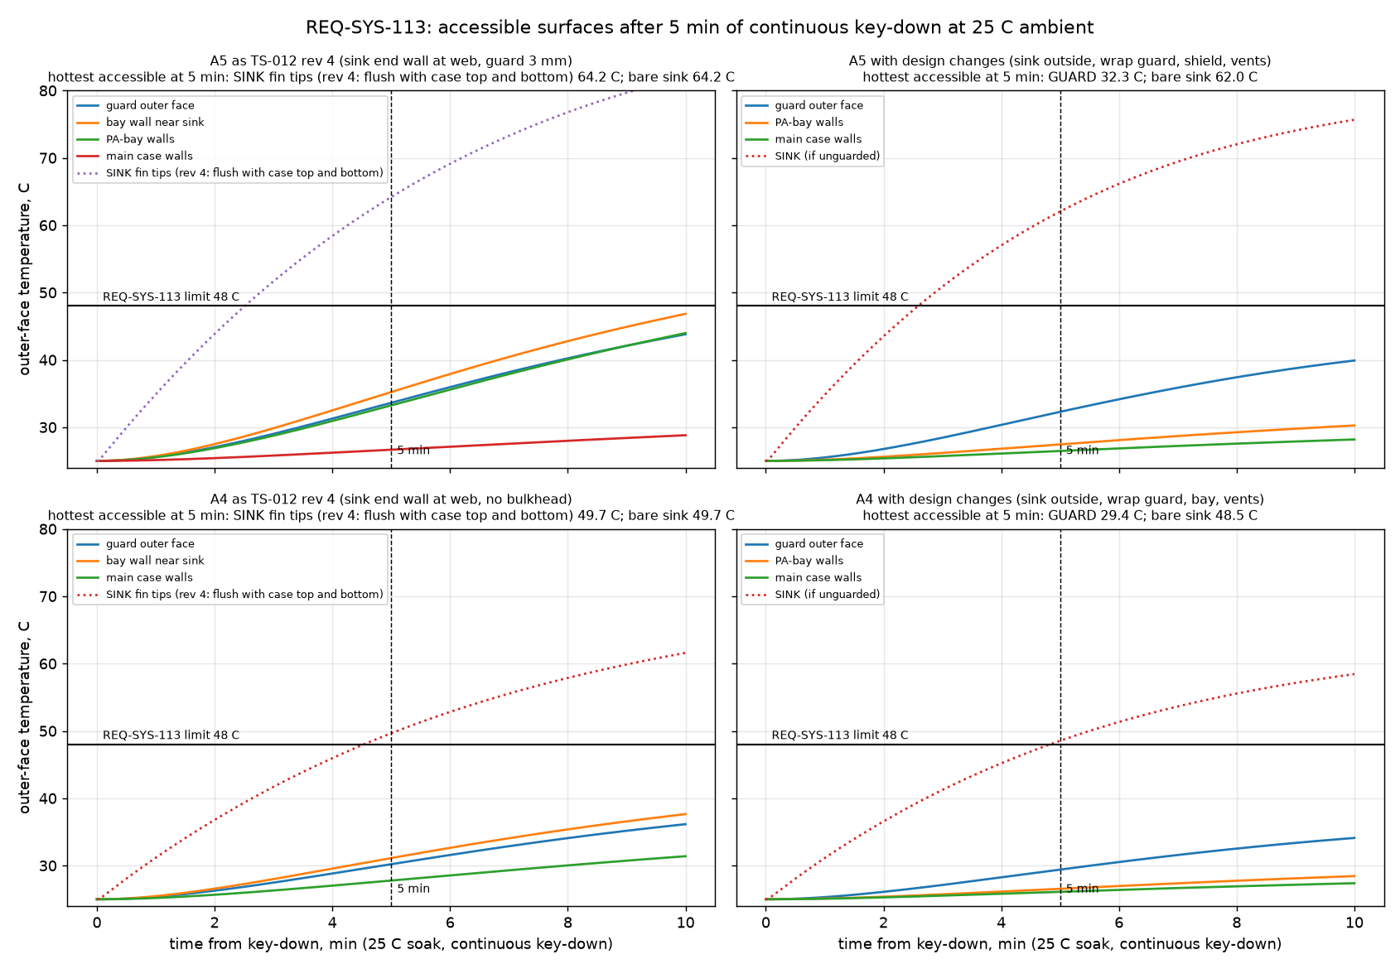
hardware/sim/thermal/results/2026-09-28-ts012-r2/surfaces_25C_5min.png
