robinonsay/cwht/hardware/sim/thermal/results/2026-09-28-ts012-r2/tj_vs_duty.png

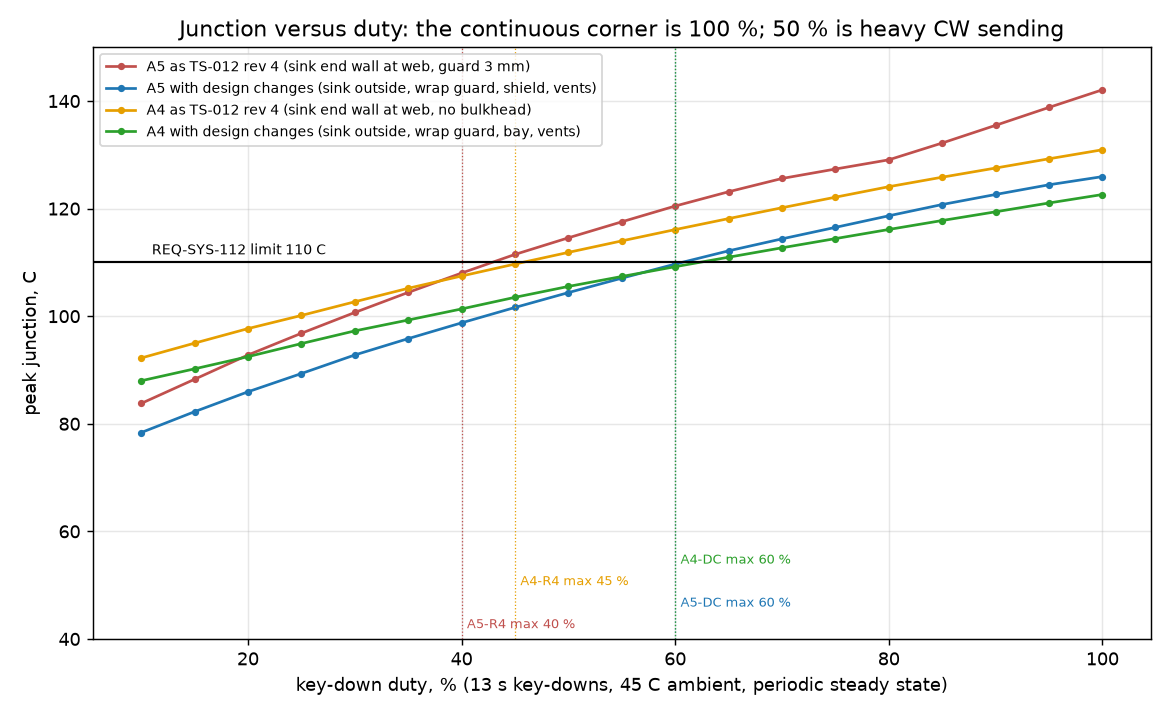
hardware/sim/thermal/results/2026-09-28-ts012-r2/tj_vs_duty.png
