robinonsay/cwht/hardware/sim/thermal/results/2026-09-28-ts012-r2/tj_vs_time_45C.png

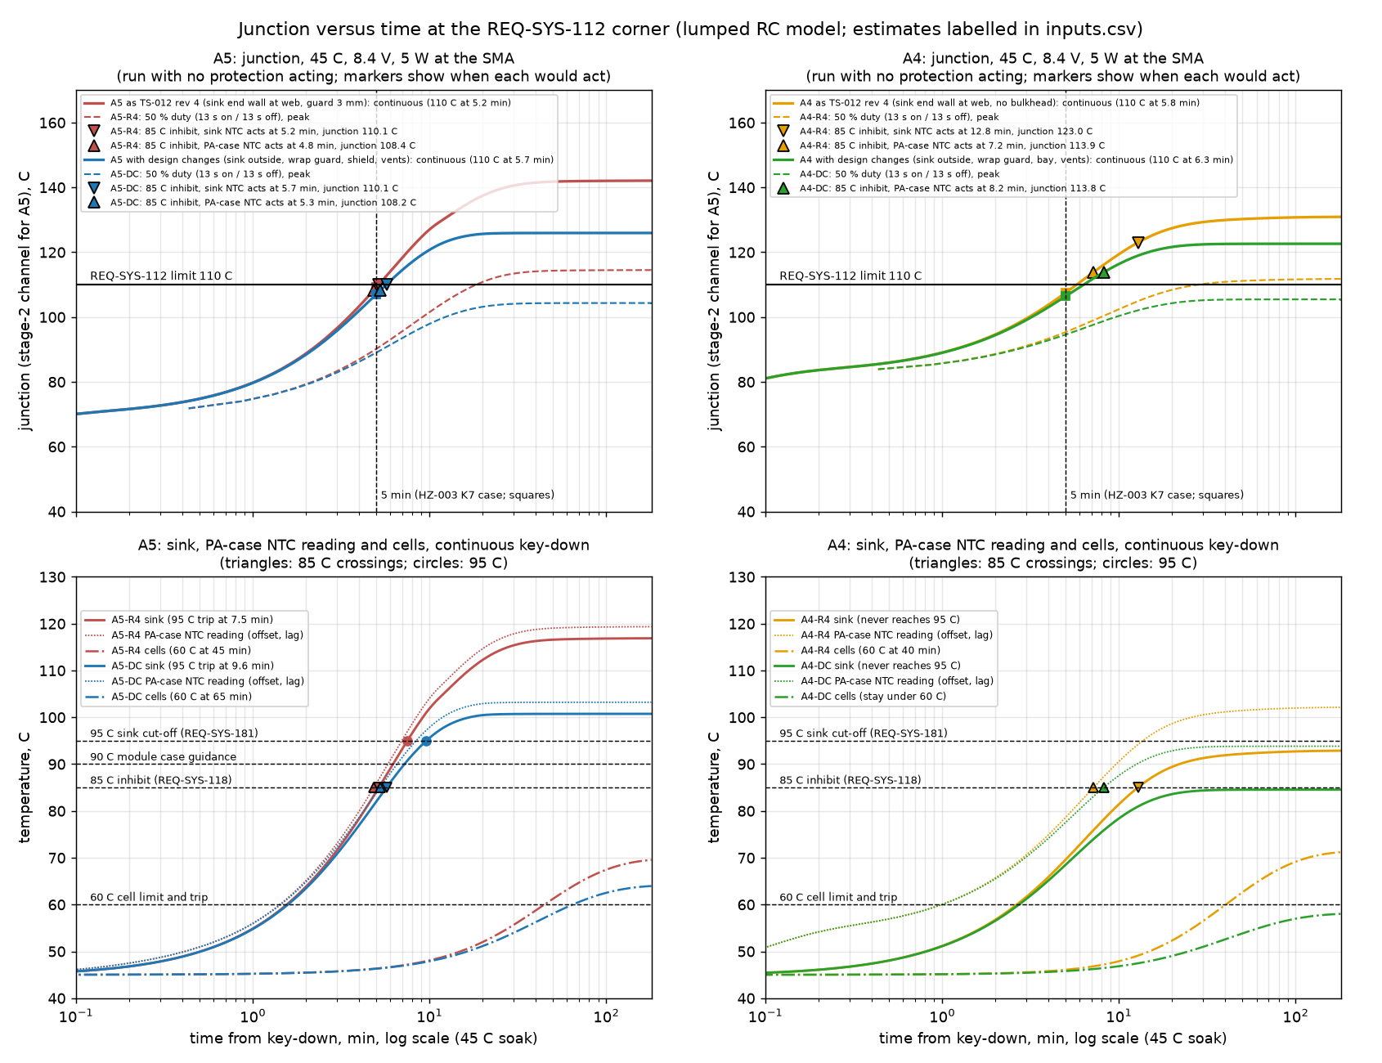
hardware/sim/thermal/results/2026-09-28-ts012-r2/tj_vs_time_45C.png
