robinonsay/cwht/hardware/sim/thermal/results/2026-09-29-a5-closure-r3/cl_bench_acceptance.png

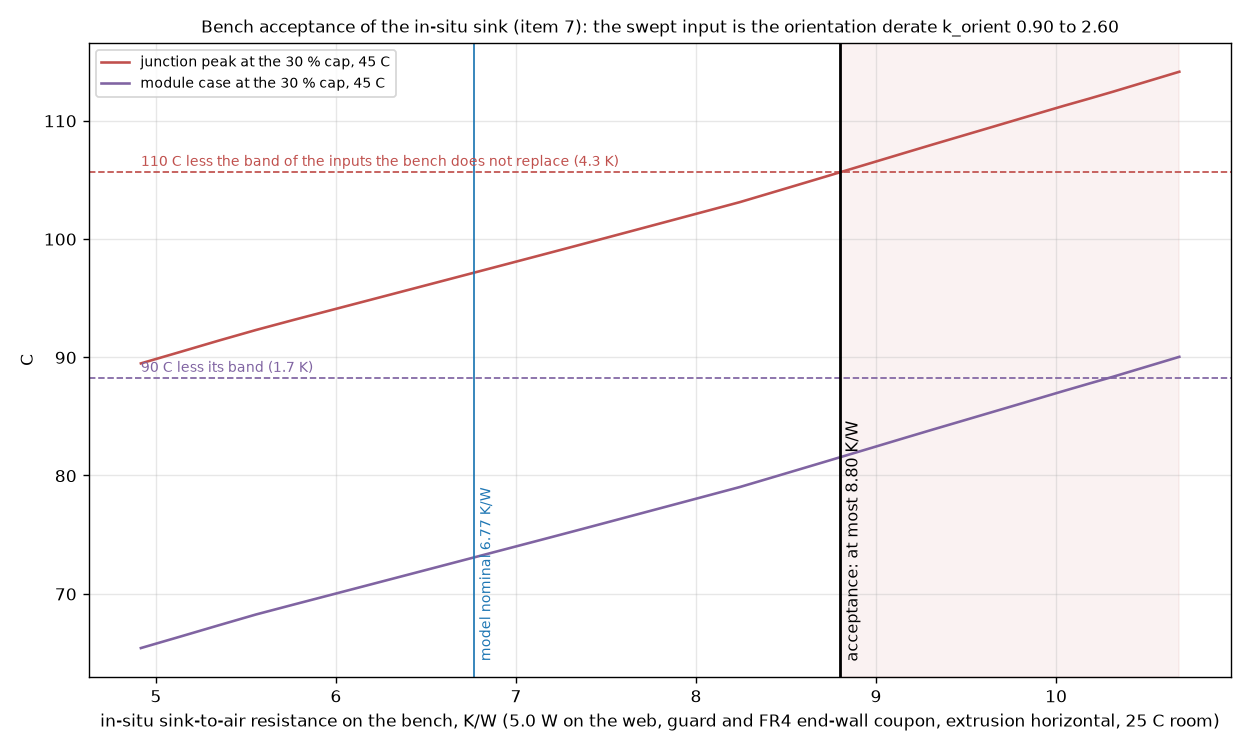
hardware/sim/thermal/results/2026-09-29-a5-closure-r3/cl_bench_acceptance.png
