robinonsay/cwht/hardware/sim/thermal/results/2026-09-29-a5-closure-r3/cl_margins.png

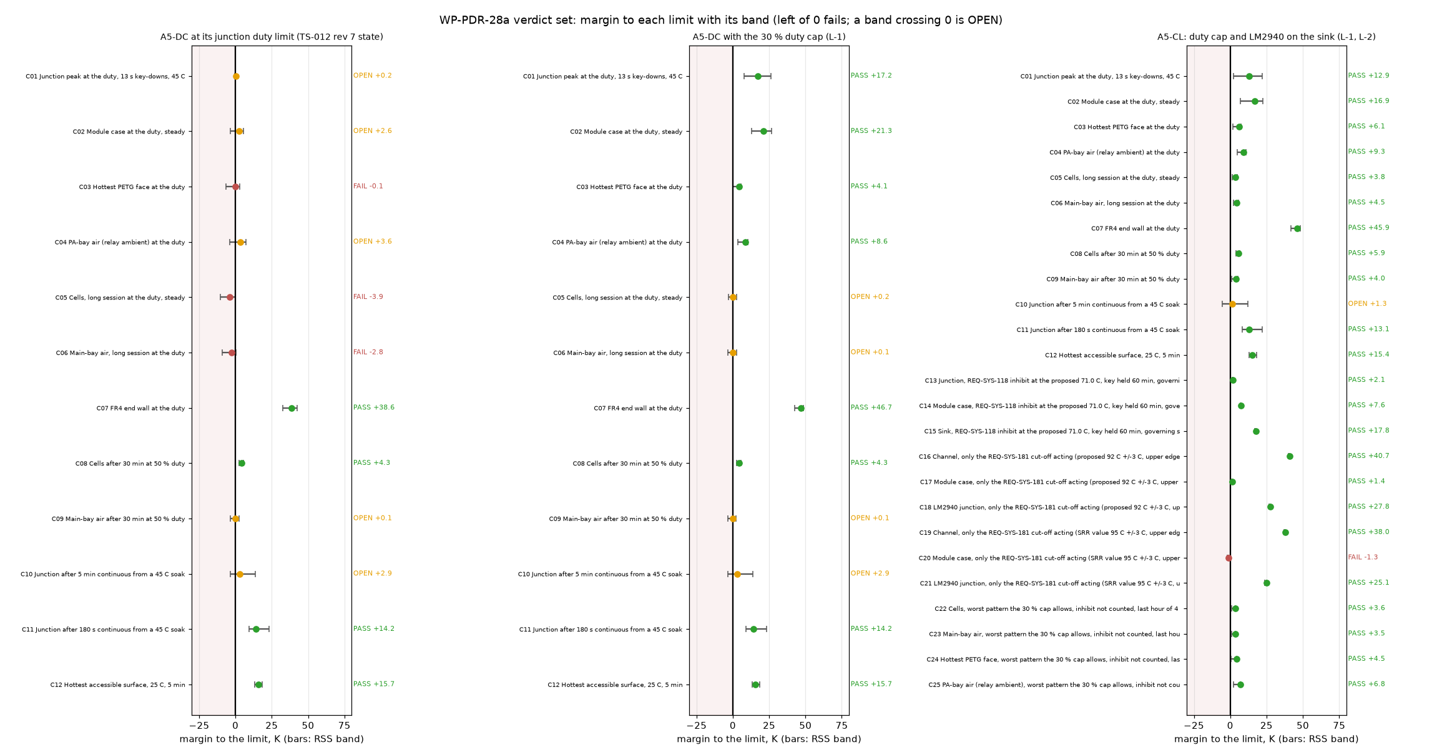
hardware/sim/thermal/results/2026-09-29-a5-closure-r3/cl_margins.png
