robinonsay/cwht/hardware/sim/thermal/results/2026-09-29-a5-closure-r3/cl_protection_screen.png

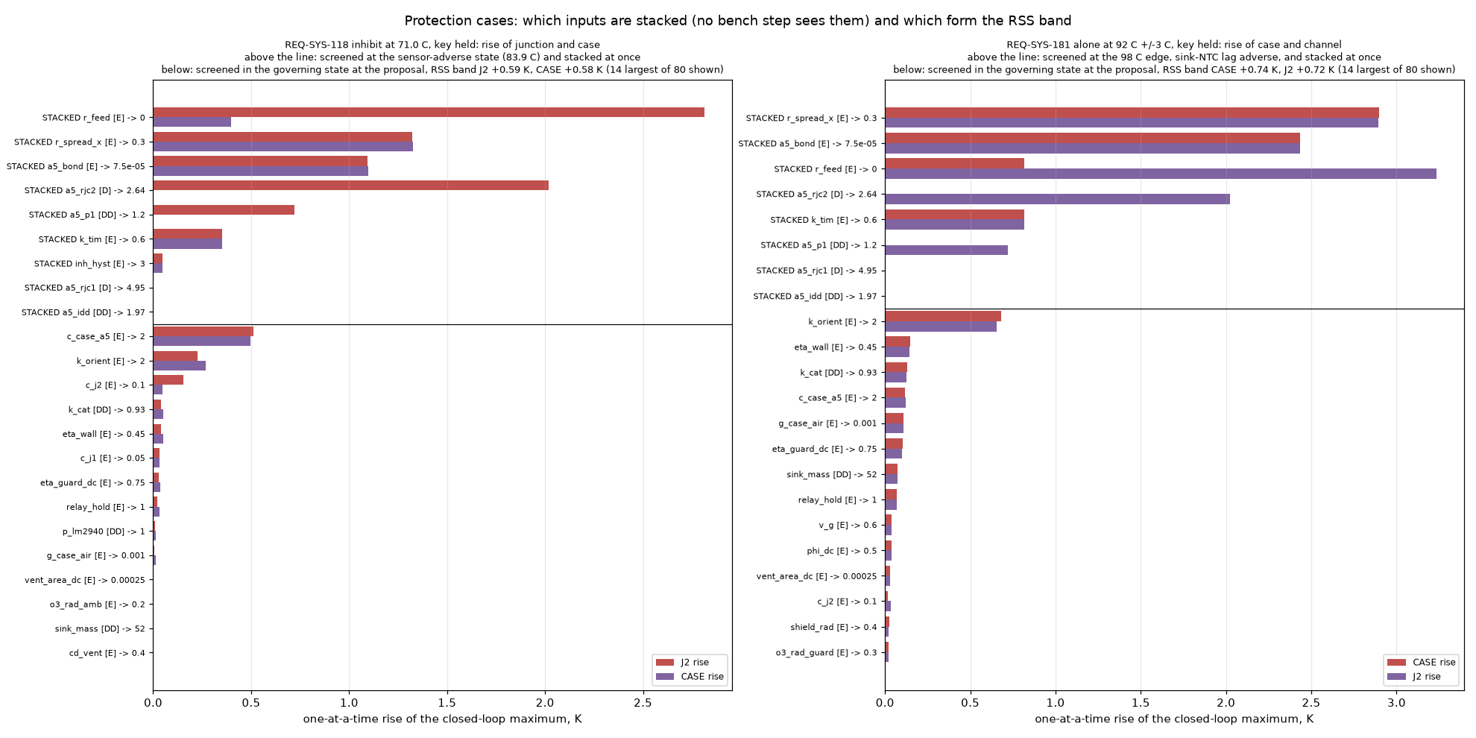
hardware/sim/thermal/results/2026-09-29-a5-closure-r3/cl_protection_screen.png
