robinonsay/cwht/hardware/sim/thermal/results/2026-09-29-a5-closure-r3/cl_tornado.png

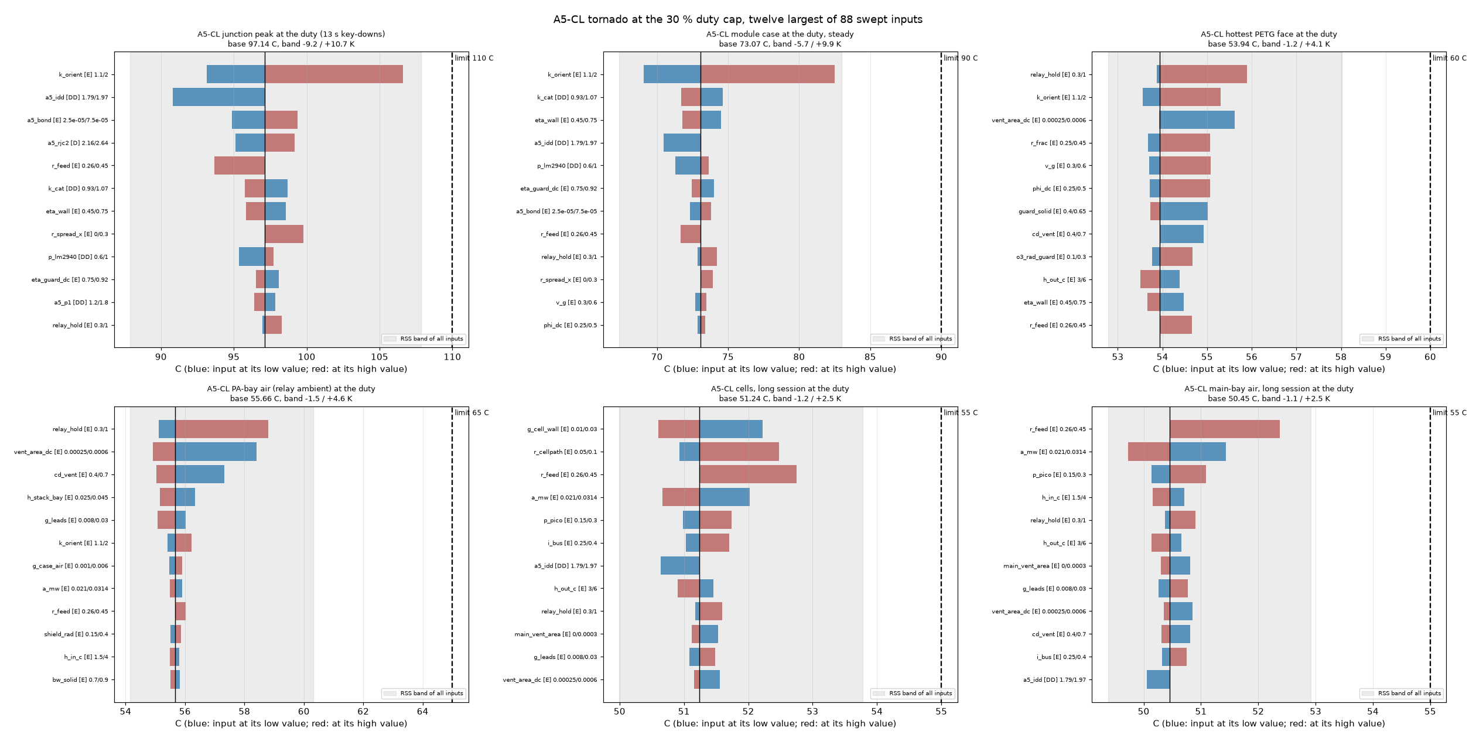
hardware/sim/thermal/results/2026-09-29-a5-closure-r3/cl_tornado.png
