robinonsay/cwht/hardware/sim/tx-keying/results/2026-09-28-a4-mitig/corners.png

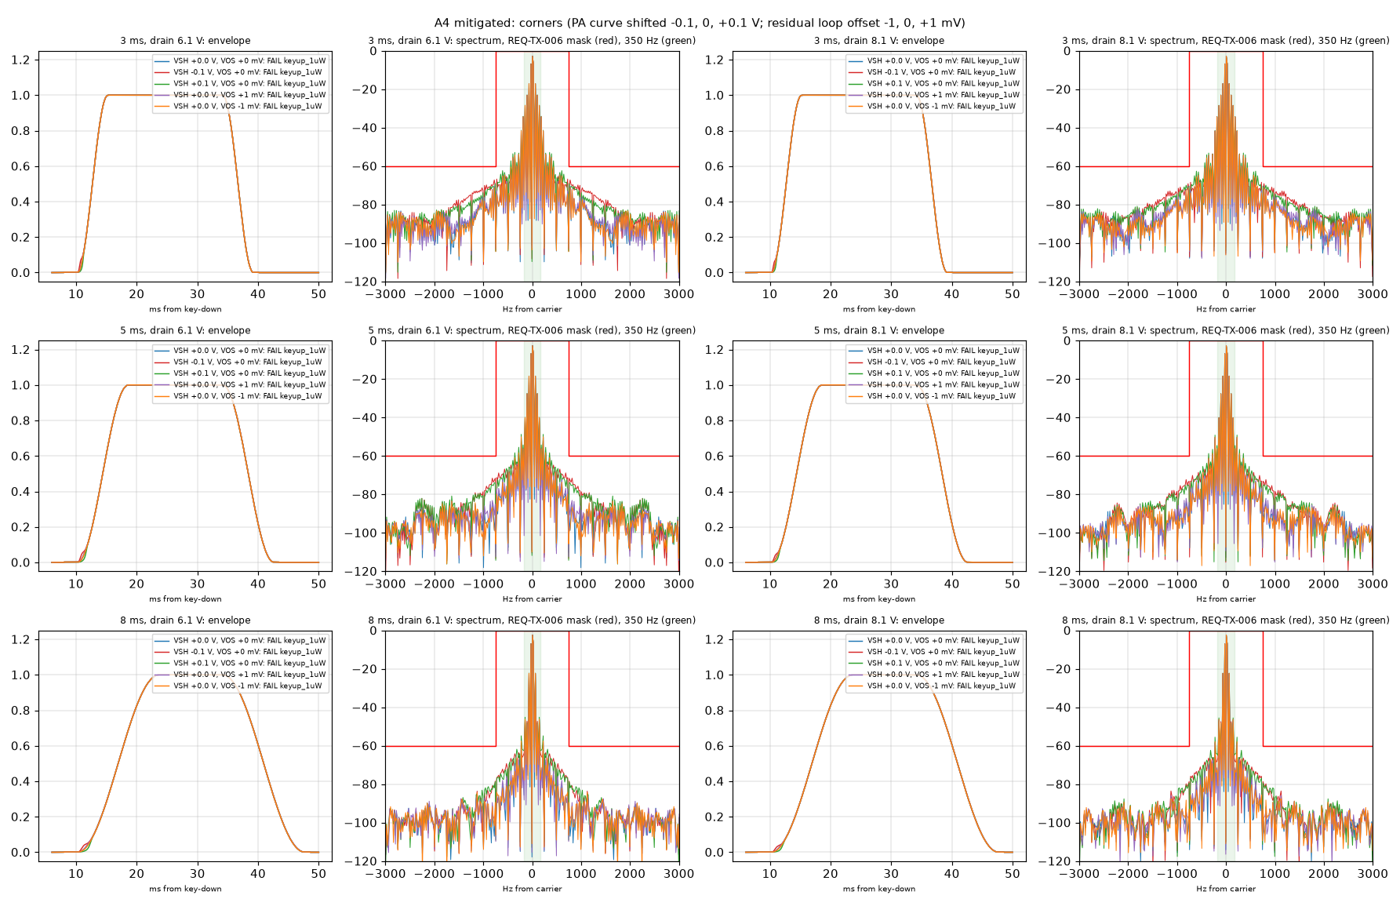
hardware/sim/tx-keying/results/2026-09-28-a4-mitig/corners.png
