robinonsay/cwht/hardware/sim/tx-keying/results/2026-09-28-det-char/det_law.png

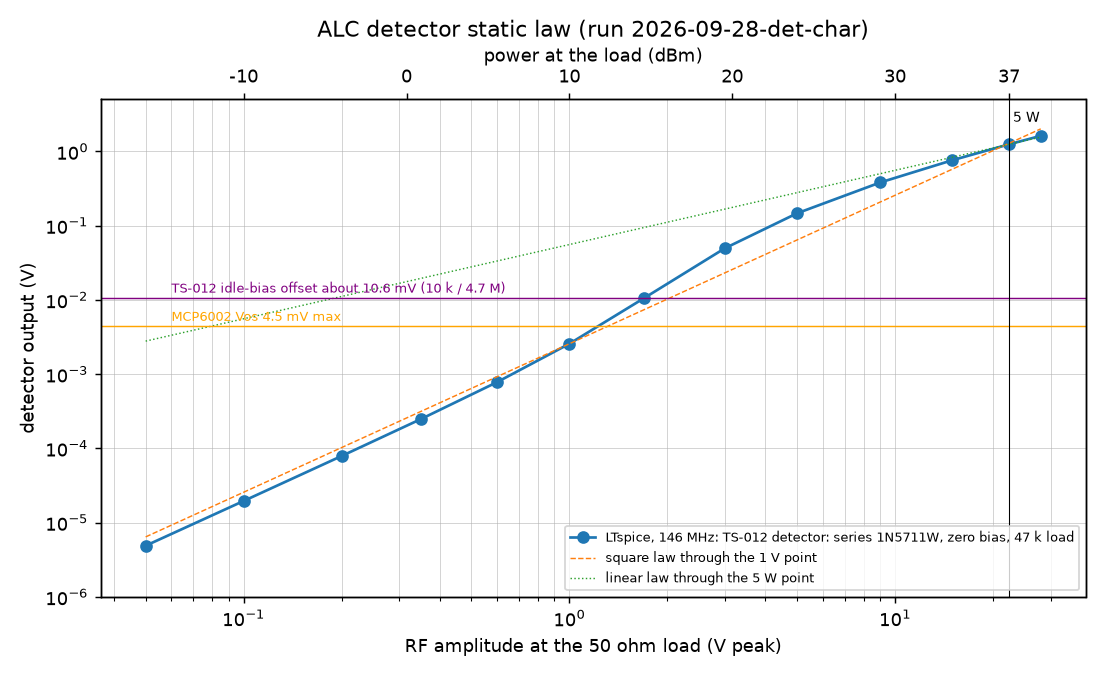
hardware/sim/tx-keying/results/2026-09-28-det-char/det_law.png
