robinonsay/cwht/hardware/sim/tx-keying/results/2026-09-28-r1-a5-sweep0/window.png

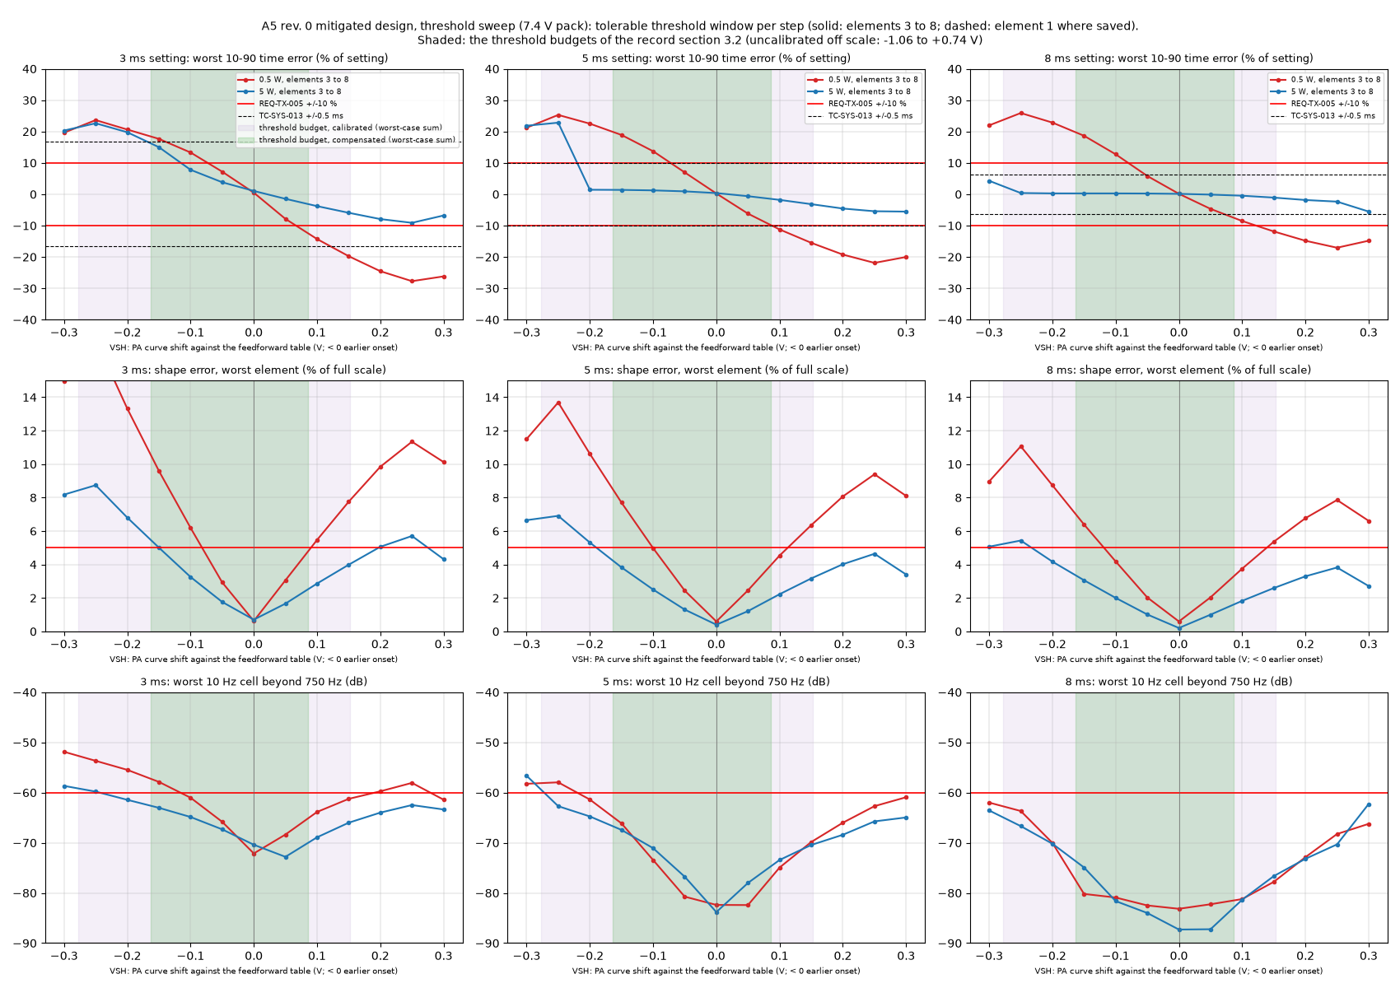
hardware/sim/tx-keying/results/2026-09-28-r1-a5-sweep0/window.png
