robinonsay/cwht/hardware/sim/tx-keying/results/2026-09-28-r2-summary/pwm_ripple.png

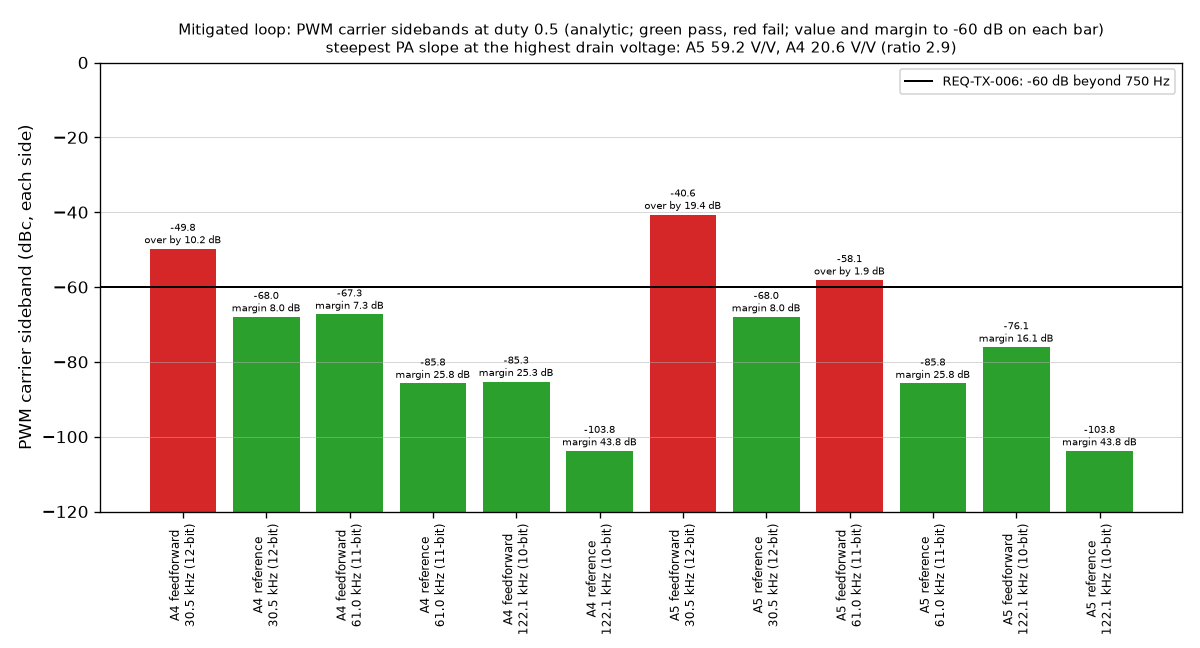
hardware/sim/tx-keying/results/2026-09-28-r2-summary/pwm_ripple.png
