robinonsay/cwht/hardware/sim/tx-lpf/results/2026-09-28-r1-nominal/rl_nominal_passband.png

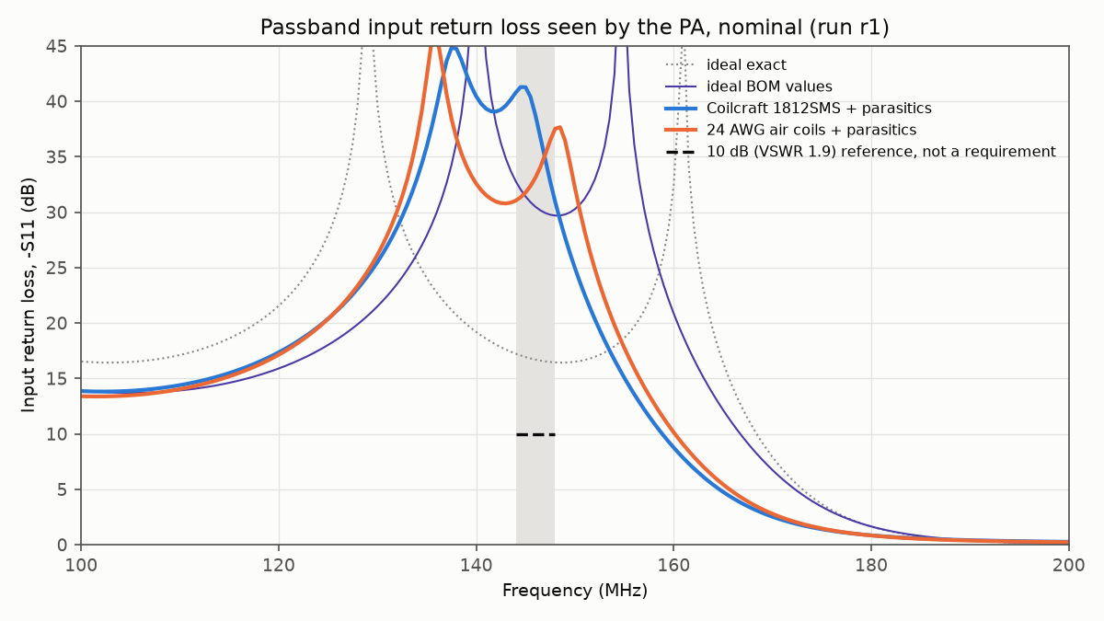
hardware/sim/tx-lpf/results/2026-09-28-r1-nominal/rl_nominal_passband.png
