robinonsay/cwht/hardware/sim/tx-lpf/results/2026-09-28-r1-nominal/s21_nominal_wide.png

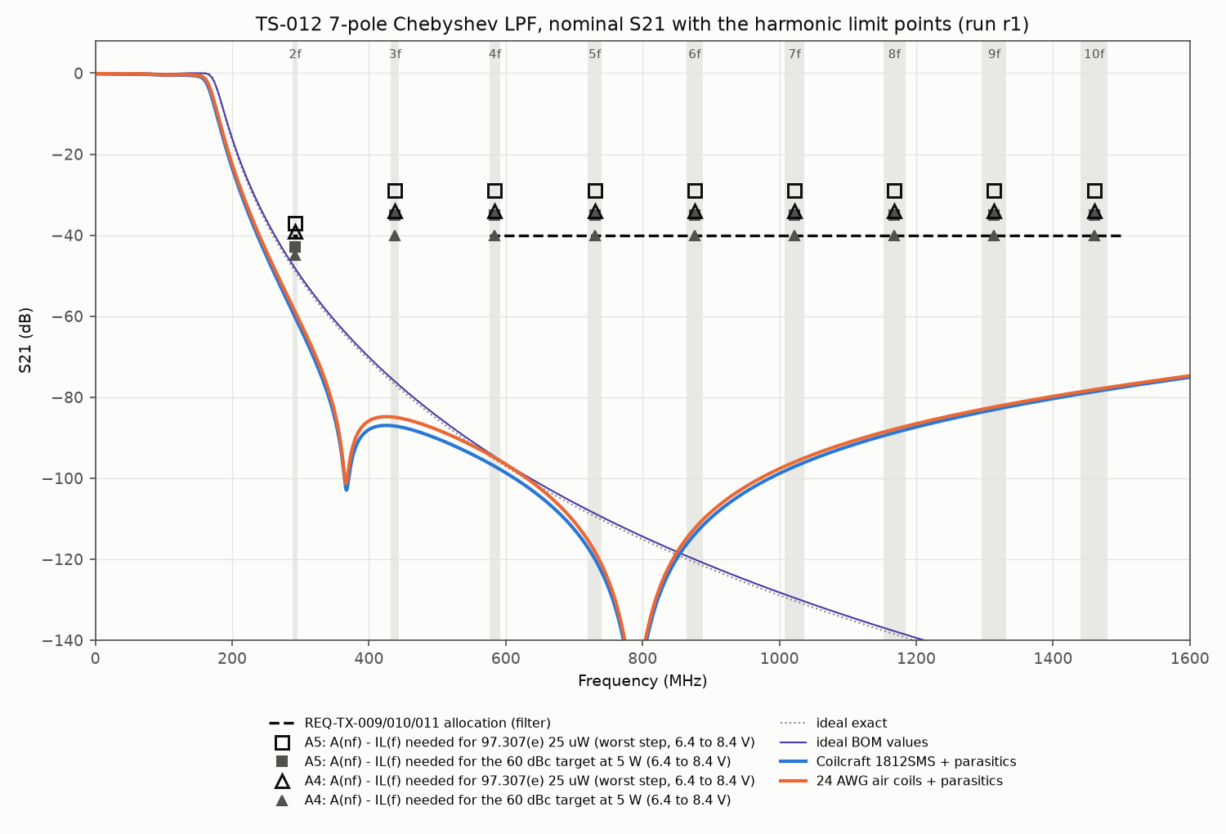
hardware/sim/tx-lpf/results/2026-09-28-r1-nominal/s21_nominal_wide.png
