robinonsay/cwht/hardware/sim/tx-lpf/results/2026-09-28-r2-mc-1812sms/il_mc_passband.png

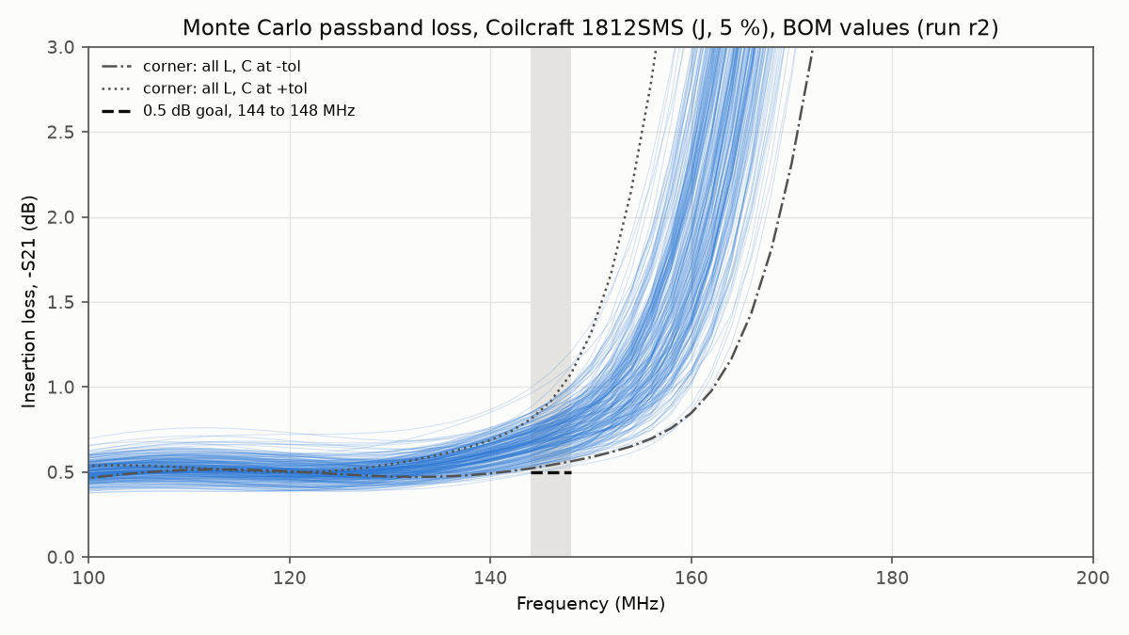
hardware/sim/tx-lpf/results/2026-09-28-r2-mc-1812sms/il_mc_passband.png
