robinonsay/cwht/hardware/sim/tx-lpf/results/2026-09-28-r2-mc-1812sms/mc_histograms.png

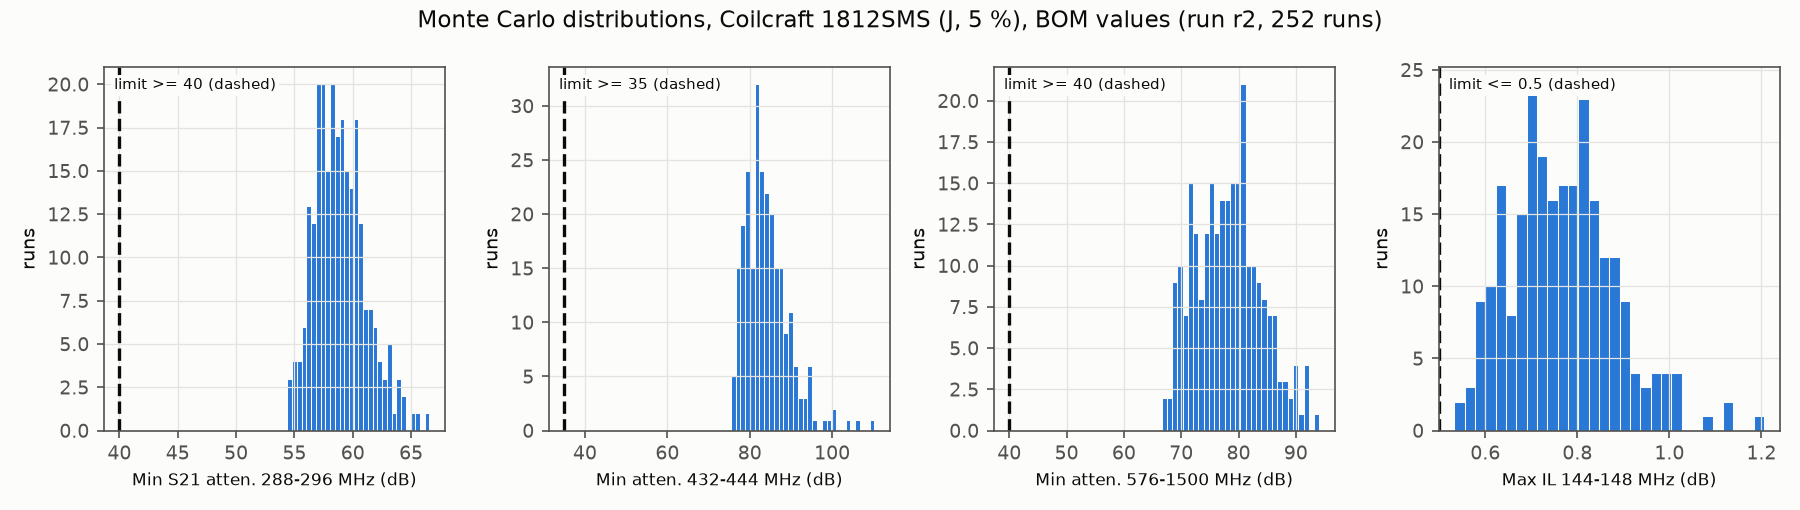
hardware/sim/tx-lpf/results/2026-09-28-r2-mc-1812sms/mc_histograms.png
