robinonsay/cwht/hardware/sim/tx-lpf/results/2026-09-28-r3-mc-air-aswound/il_mc_passband.png

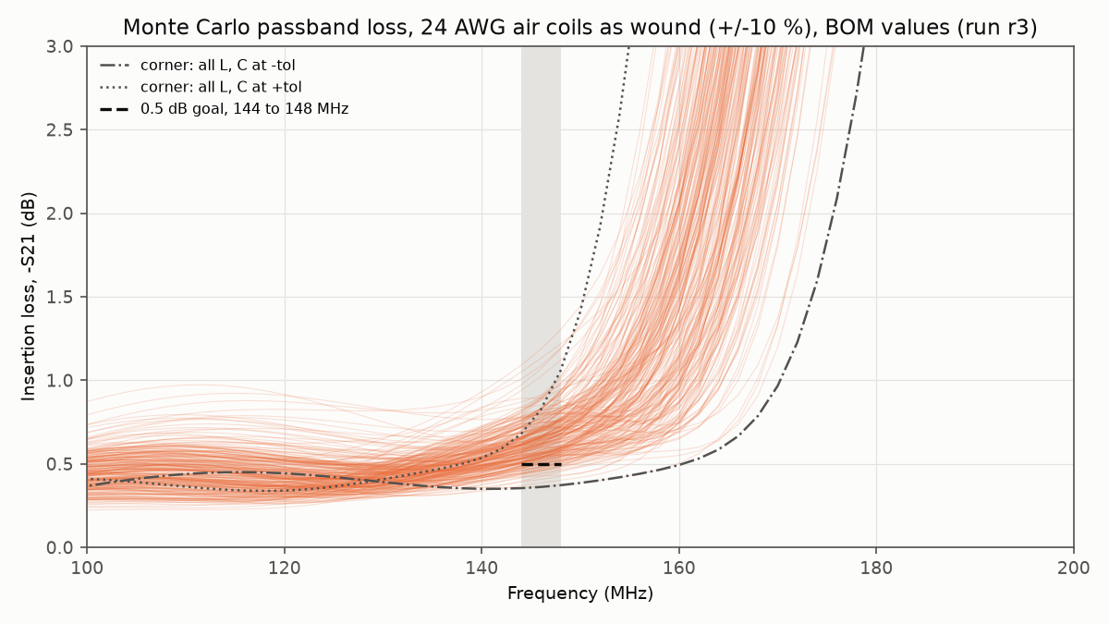
hardware/sim/tx-lpf/results/2026-09-28-r3-mc-air-aswound/il_mc_passband.png
