robinonsay/cwht/hardware/sim/tx-lpf/results/2026-09-28-r3-mc-air-aswound/s21_mc_wide.png

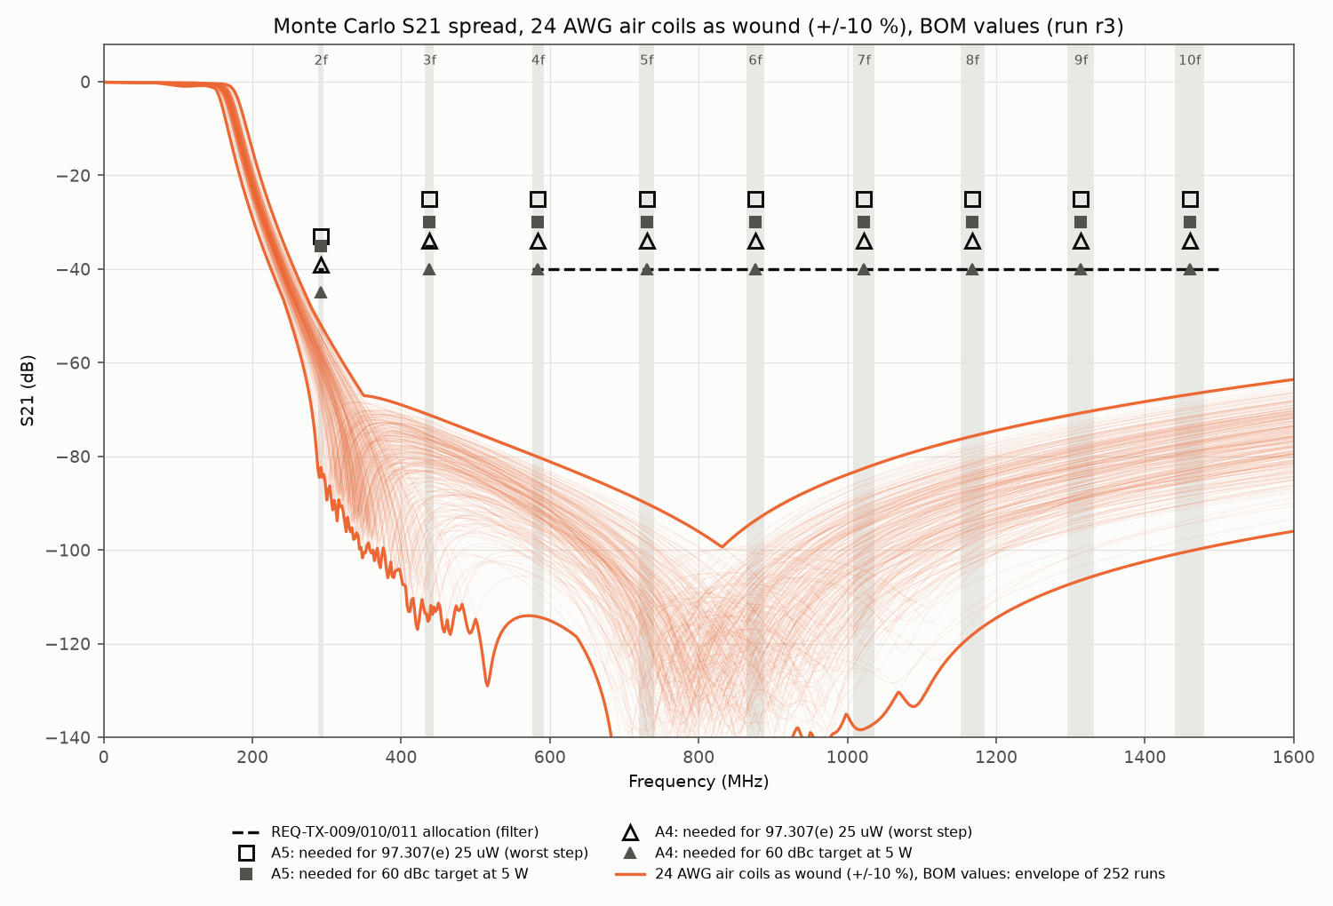
hardware/sim/tx-lpf/results/2026-09-28-r3-mc-air-aswound/s21_mc_wide.png
