robinonsay/cwht/hardware/sim/tx-lpf/results/2026-09-28-r4-mc-air-aligned/mc_histograms.png

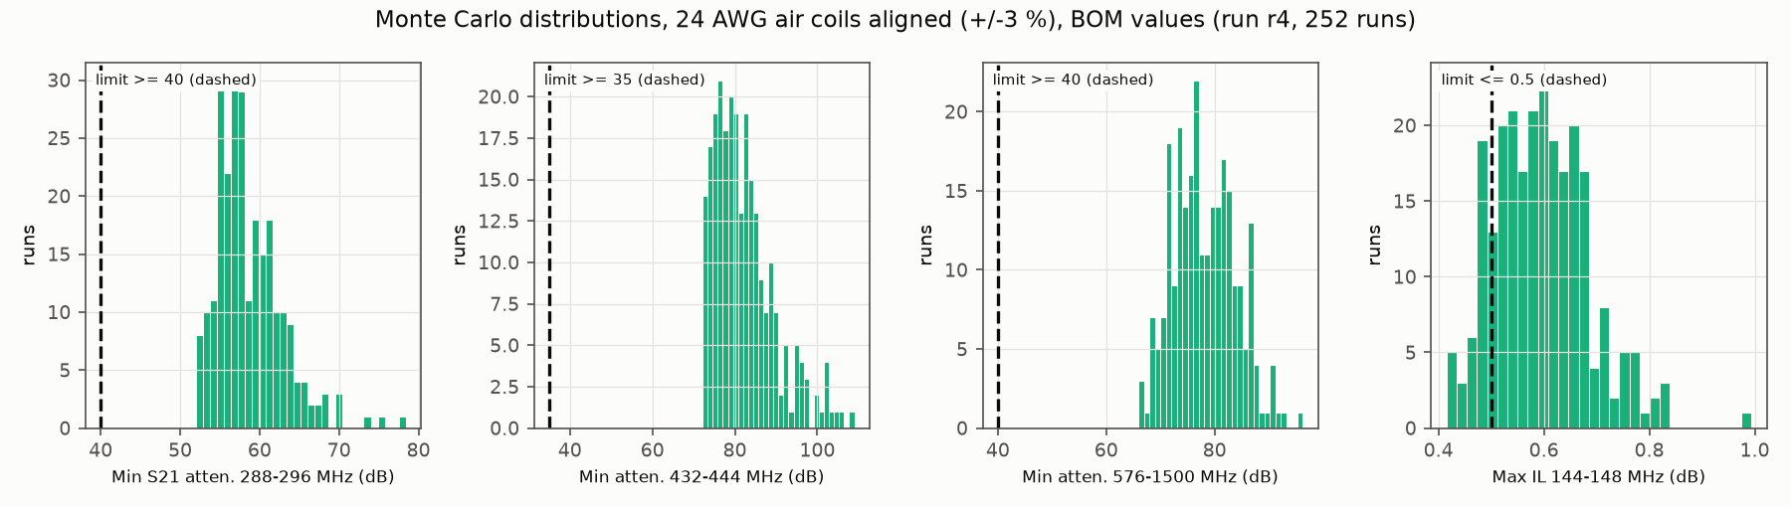
hardware/sim/tx-lpf/results/2026-09-28-r4-mc-air-aligned/mc_histograms.png
