robinonsay/cwht/hardware/sim/tx-lpf/results/2026-09-28-r6-mc-1812sms-retuned/il_mc_passband.png

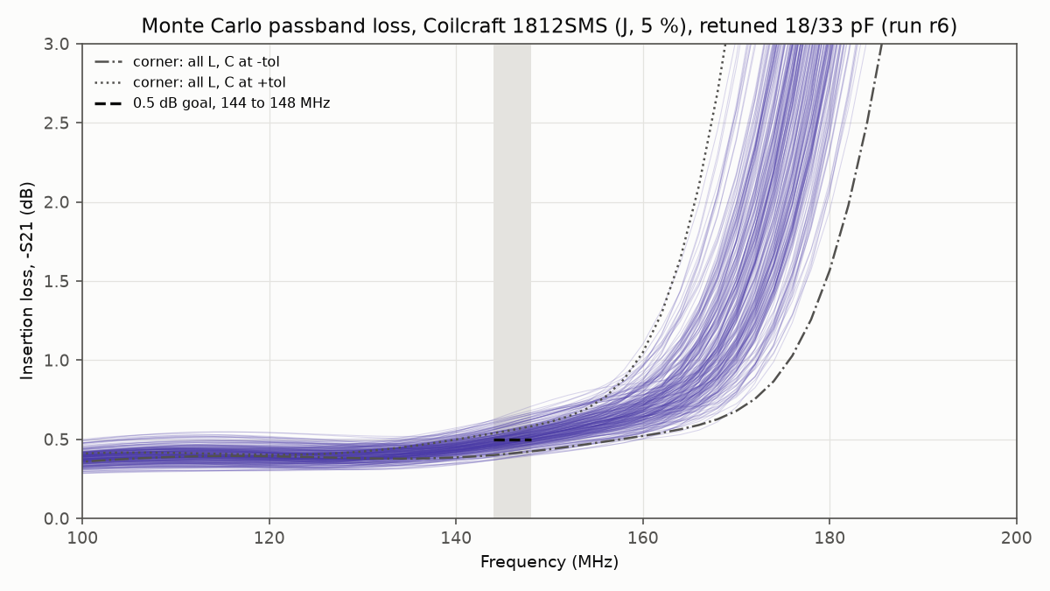
hardware/sim/tx-lpf/results/2026-09-28-r6-mc-1812sms-retuned/il_mc_passband.png
