robinonsay/cwht/hardware/sim/tx-lpf/results/2026-09-28-r7-mc-air-aligned-retuned/mc_histograms.png

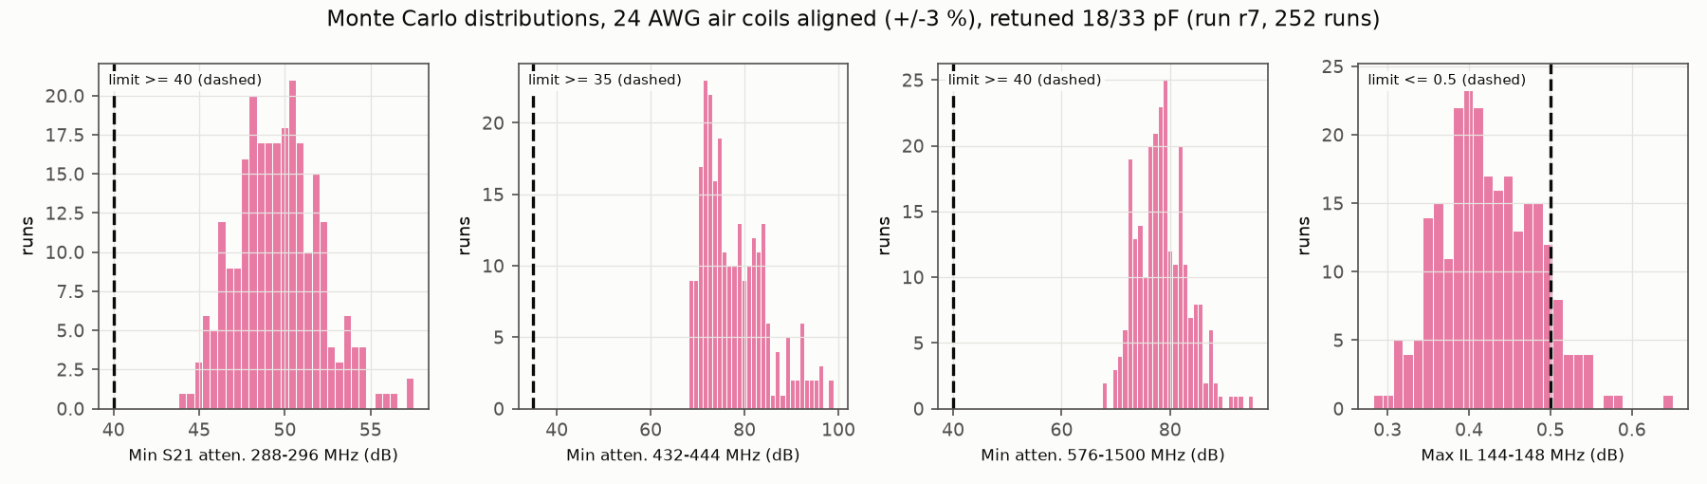
hardware/sim/tx-lpf/results/2026-09-28-r7-mc-air-aligned-retuned/mc_histograms.png
