robinonsay/cwht/hardware/sim/tx-lpf/results/2026-09-28-r7-mc-air-aligned-retuned/s21_mc_wide.png

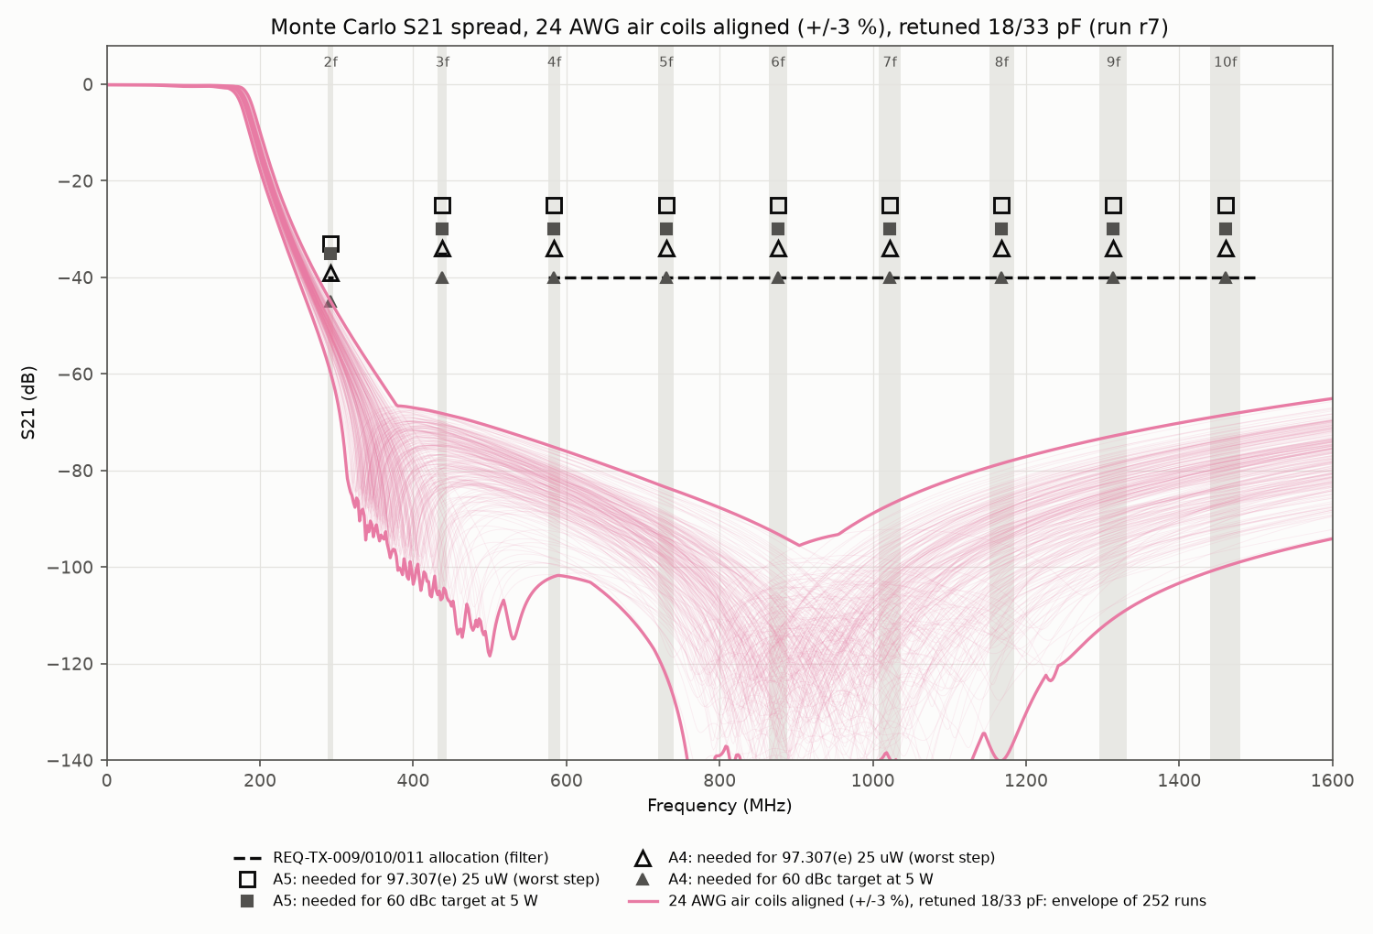
hardware/sim/tx-lpf/results/2026-09-28-r7-mc-air-aligned-retuned/s21_mc_wide.png
