robinonsay/cwht/hardware/sim/tx-lpf/results/2026-09-28-r11-wc-1812sms-retuned/il_wc_passband.png

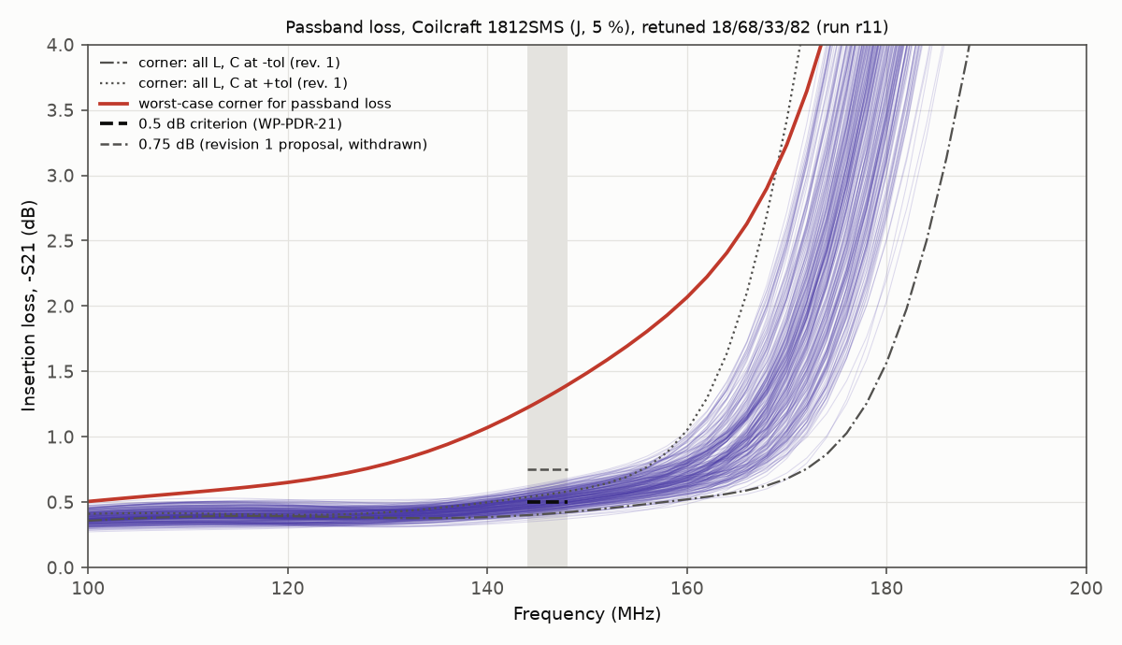
hardware/sim/tx-lpf/results/2026-09-28-r11-wc-1812sms-retuned/il_wc_passband.png
