robinonsay/cwht/hardware/sim/tx-lpf/results/2026-09-28-r11-wc-1812sms-retuned/mc_wc_histograms.png

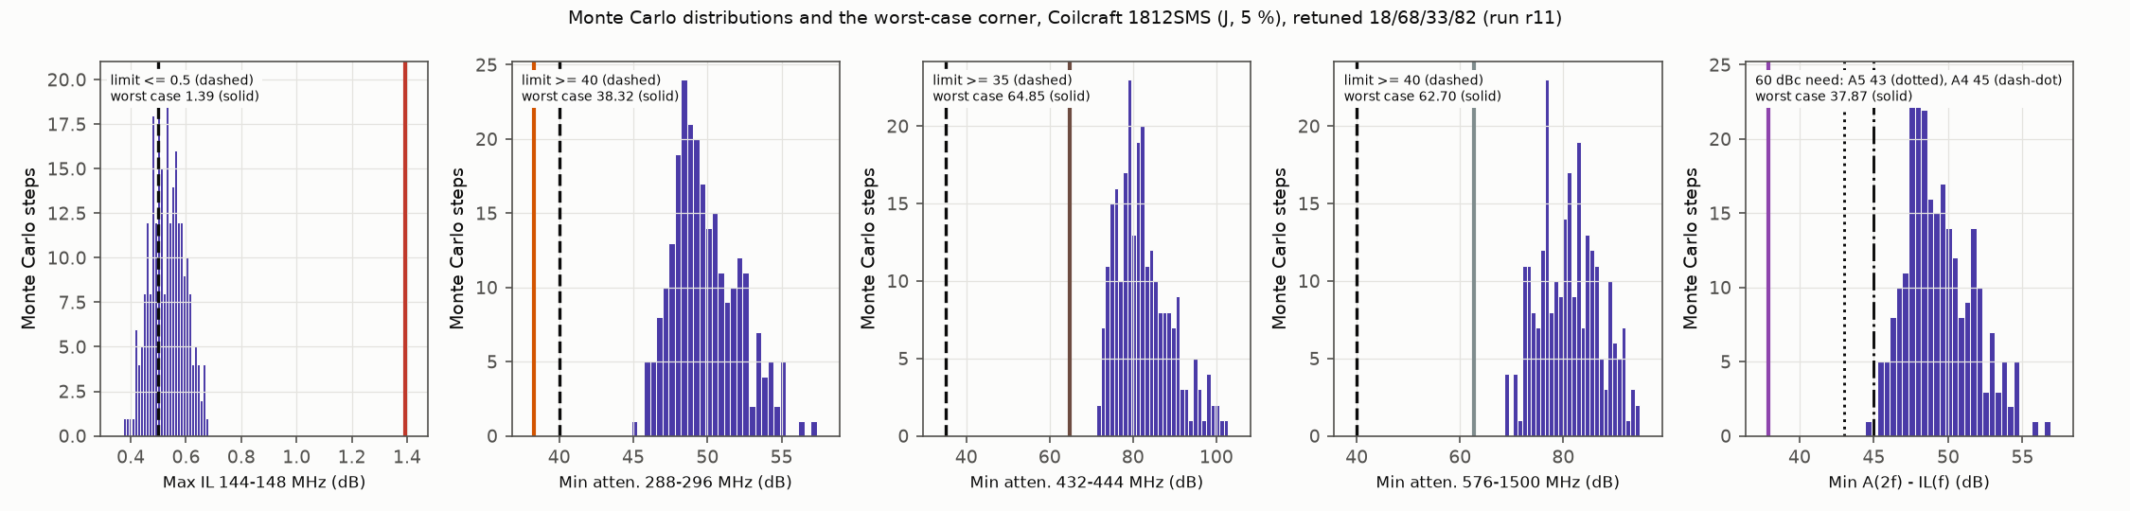
hardware/sim/tx-lpf/results/2026-09-28-r11-wc-1812sms-retuned/mc_wc_histograms.png
