robinonsay/cwht/hardware/sim/tx-lpf/results/2026-09-28-r11-wc-1812sms-retuned/s21_wc_wide.png

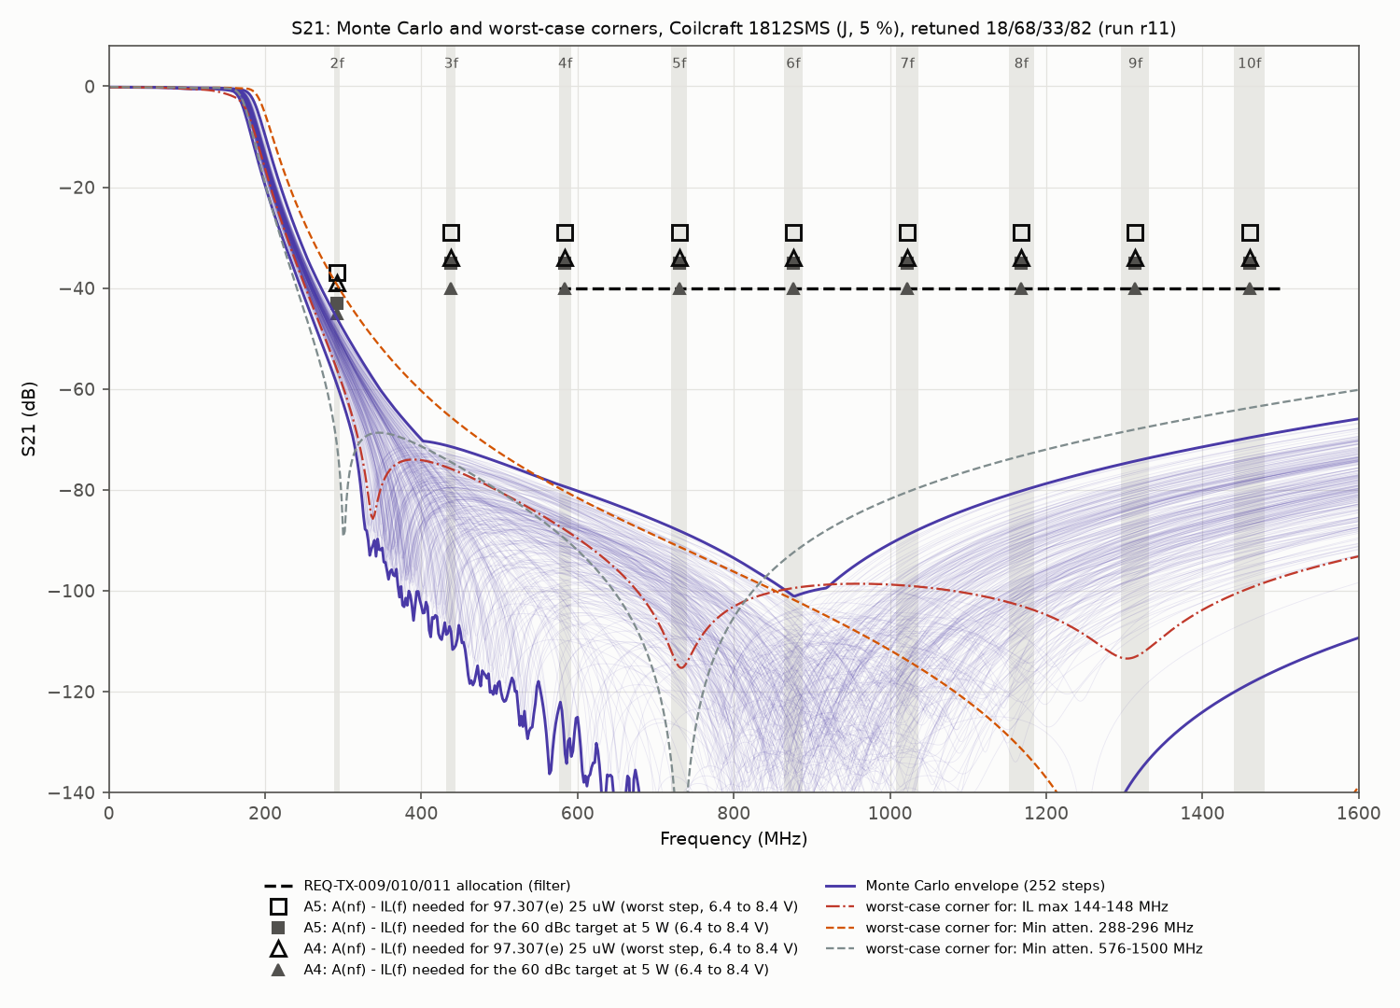
hardware/sim/tx-lpf/results/2026-09-28-r11-wc-1812sms-retuned/s21_wc_wide.png
