robinonsay/cwht/hardware/sim/tx-lpf/results/2026-09-28-r12-wc-air-aligned-retuned/harmonic_bands_wc.png

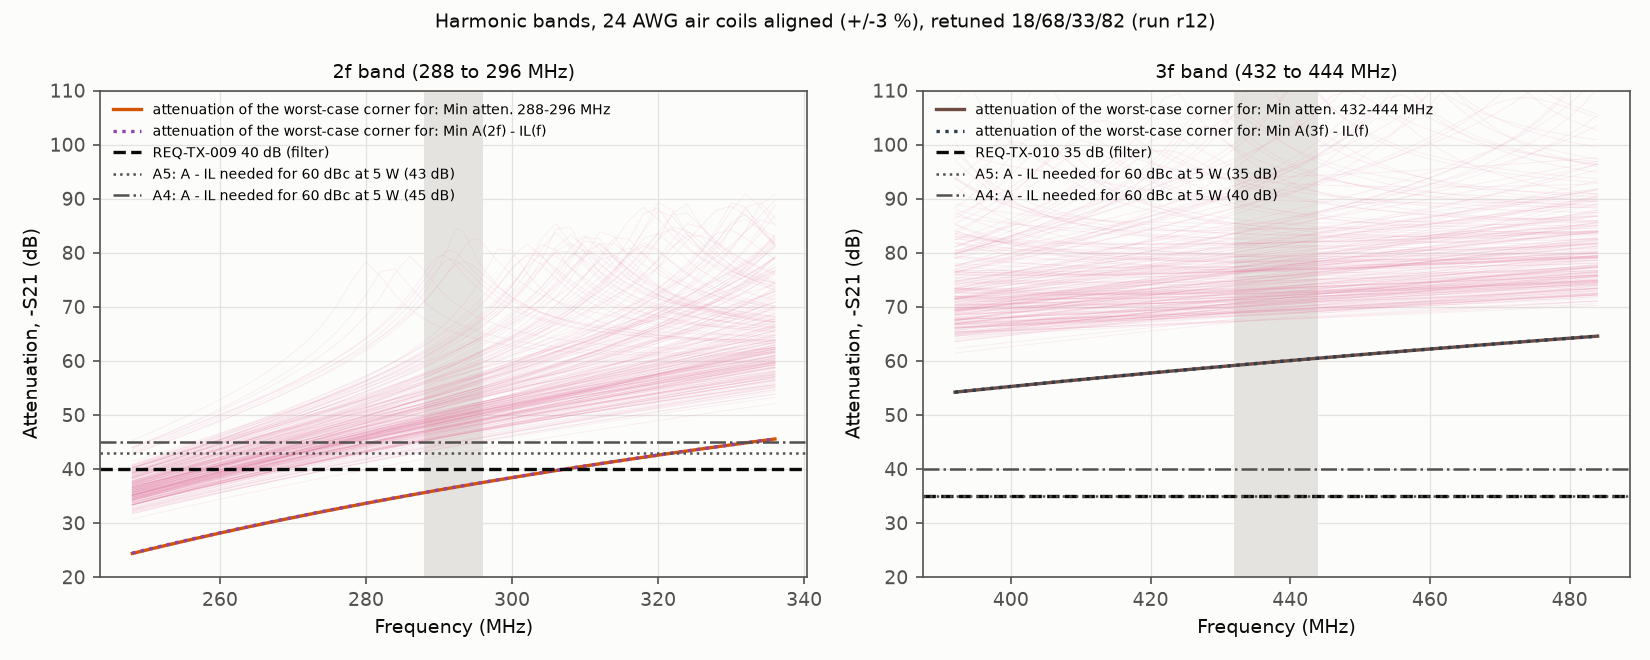
hardware/sim/tx-lpf/results/2026-09-28-r12-wc-air-aligned-retuned/harmonic_bands_wc.png
