robinonsay/cwht/hardware/sim/tx-lpf/results/2026-09-28-r12-wc-air-aligned-retuned/s21_wc_wide.png

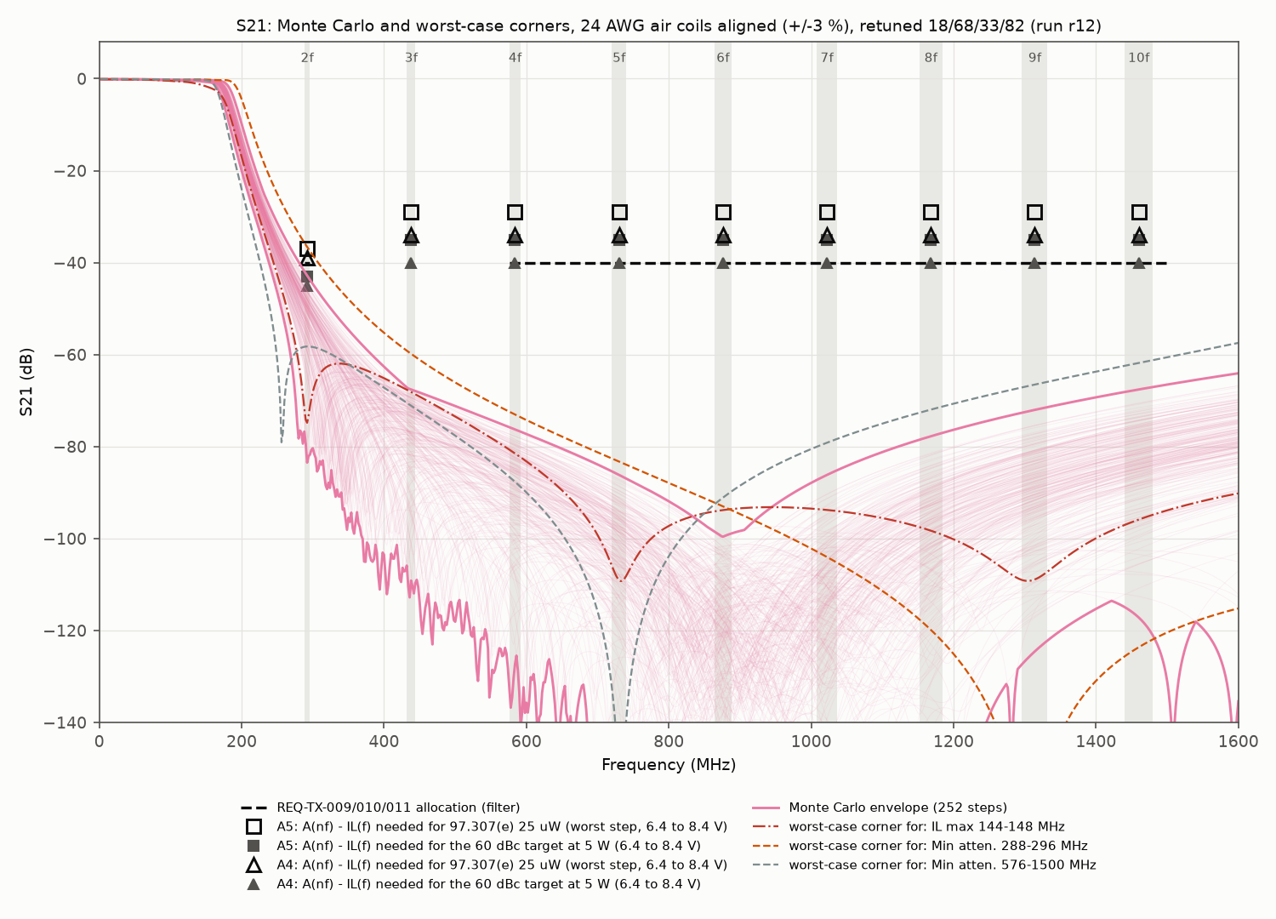
hardware/sim/tx-lpf/results/2026-09-28-r12-wc-air-aligned-retuned/s21_wc_wide.png
