robinonsay/cwht/hardware/sim/tx-lpf/results/2026-09-28-r14-wc-1812sms-22-36-2pct/il_wc_passband.png

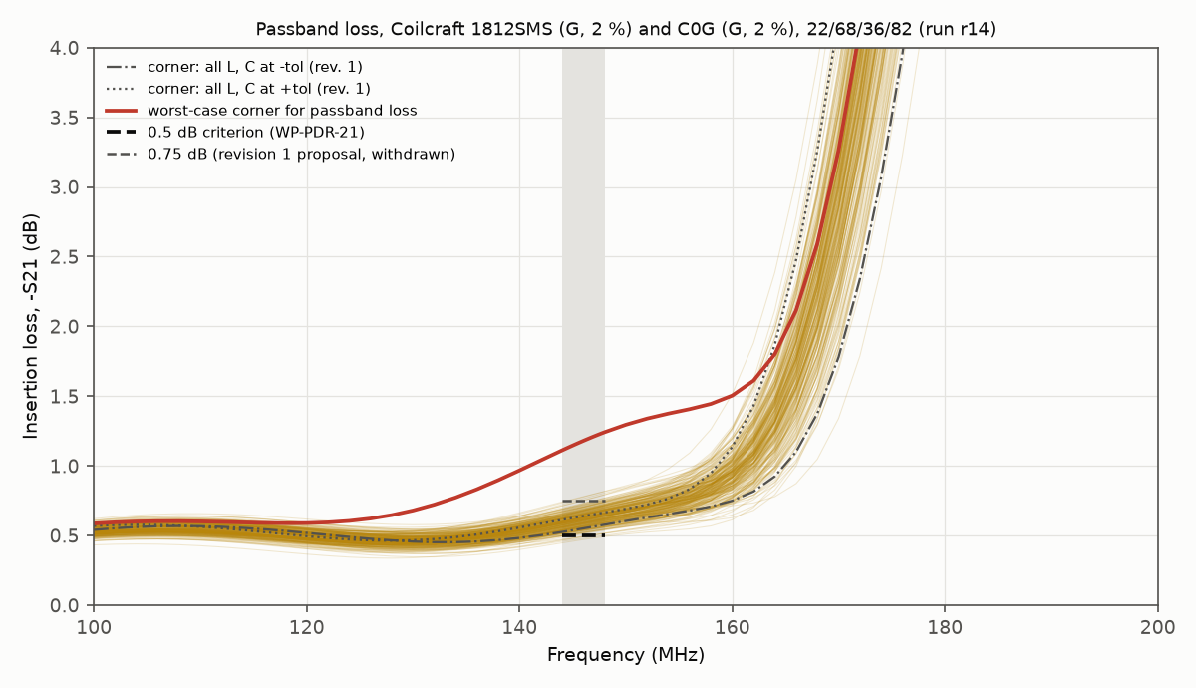
hardware/sim/tx-lpf/results/2026-09-28-r14-wc-1812sms-22-36-2pct/il_wc_passband.png
