robinonsay/cwht/hardware/sim/tx-lpf/results/2026-09-28-r14-wc-1812sms-22-36-2pct/mc_wc_histograms.png

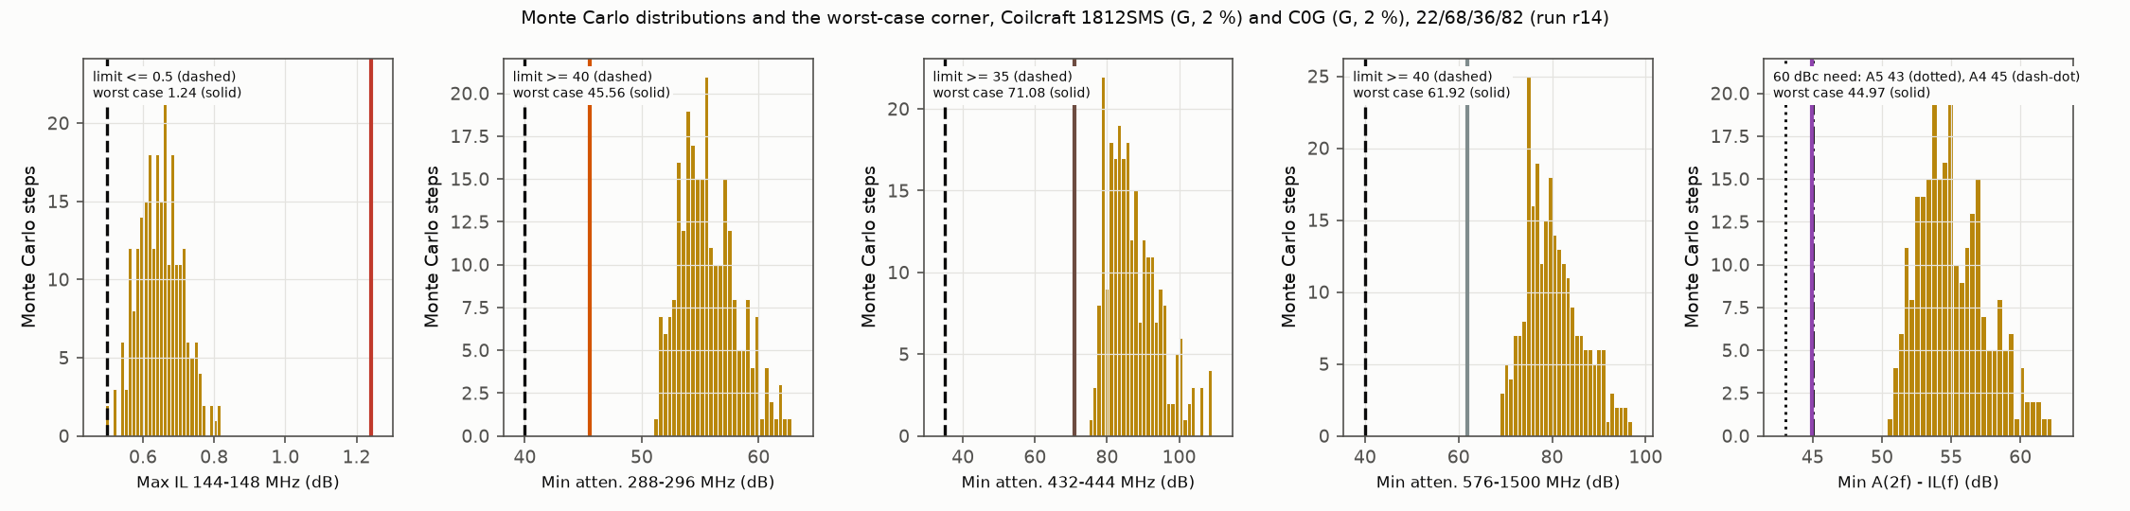
hardware/sim/tx-lpf/results/2026-09-28-r14-wc-1812sms-22-36-2pct/mc_wc_histograms.png
