robinonsay/cwht/hardware/sim/tx-lpf/results/2026-09-28-r15-harmonic-budget-rev2/a5_power_margin_6v4.png

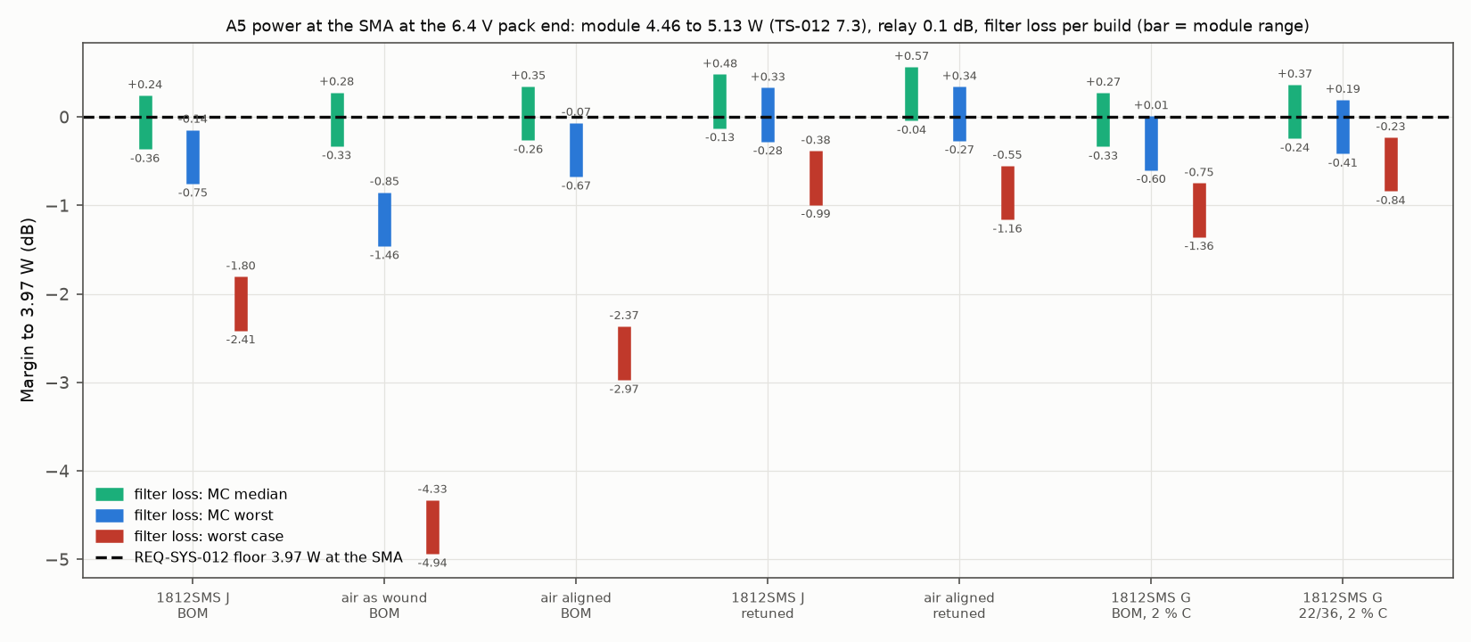
hardware/sim/tx-lpf/results/2026-09-28-r15-harmonic-budget-rev2/a5_power_margin_6v4.png
