robinonsay/cwht/hardware/sim/tx-lpf/results/2026-09-28-r15-harmonic-budget-rev2/harmonic_budget.png

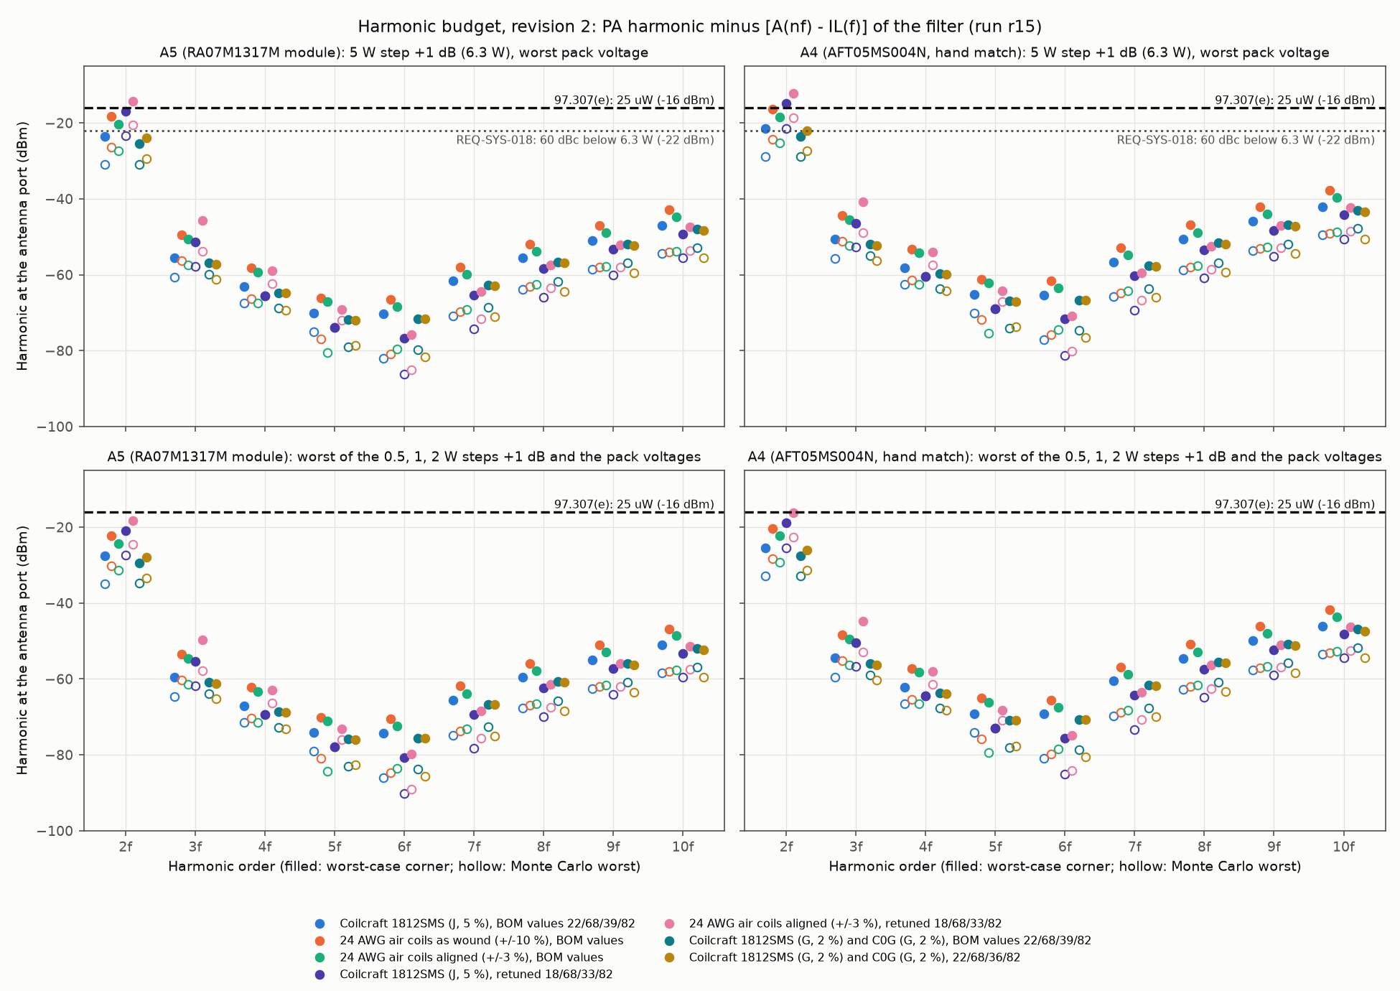
hardware/sim/tx-lpf/results/2026-09-28-r15-harmonic-budget-rev2/harmonic_budget.png
