robinonsay/cwht/hardware/sim/tx-lpf/results/2026-09-28-r16-wc-1812sms-trap-screen/harmonic_bands_wc.png

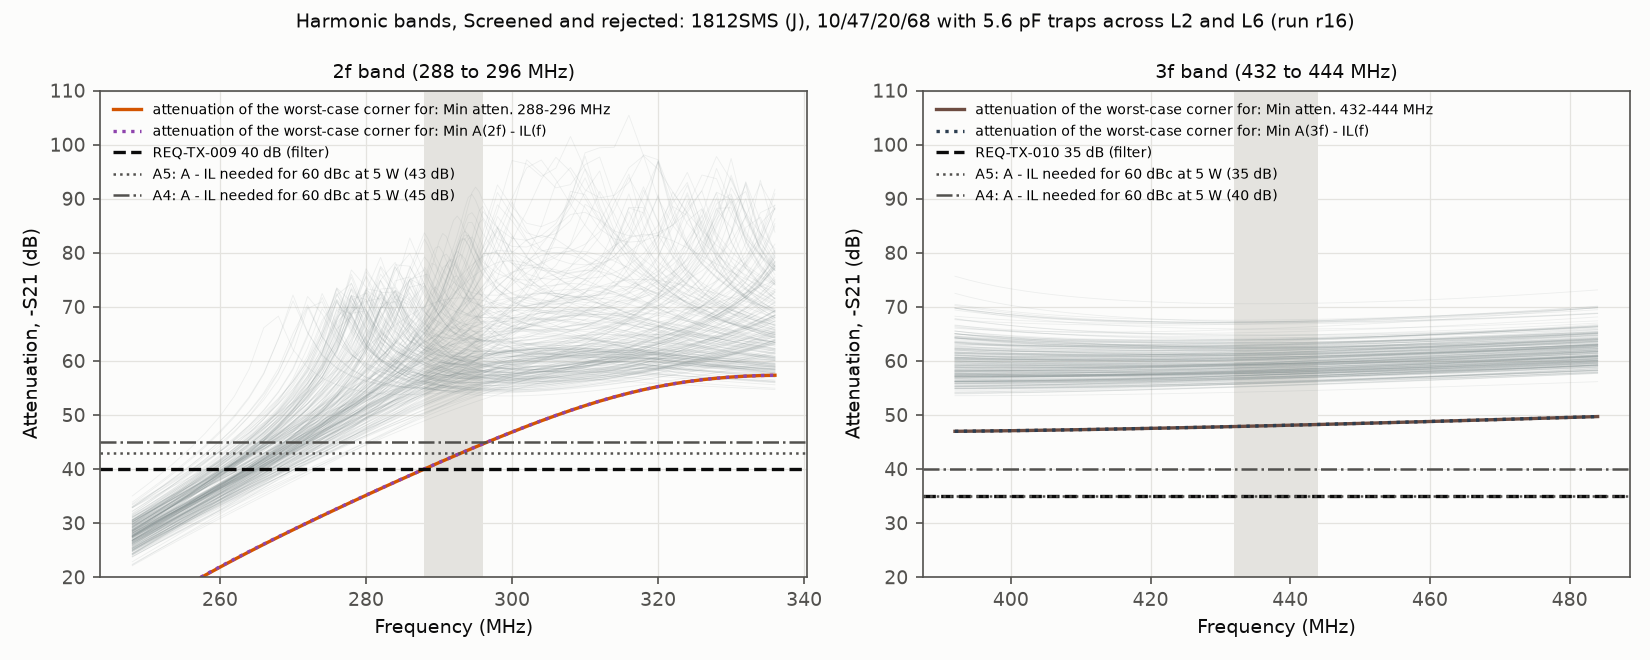
hardware/sim/tx-lpf/results/2026-09-28-r16-wc-1812sms-trap-screen/harmonic_bands_wc.png
