robinonsay/cwht/hardware/sim/tx-lpf/results/2026-09-28-r16-wc-1812sms-trap-screen/il_wc_passband.png

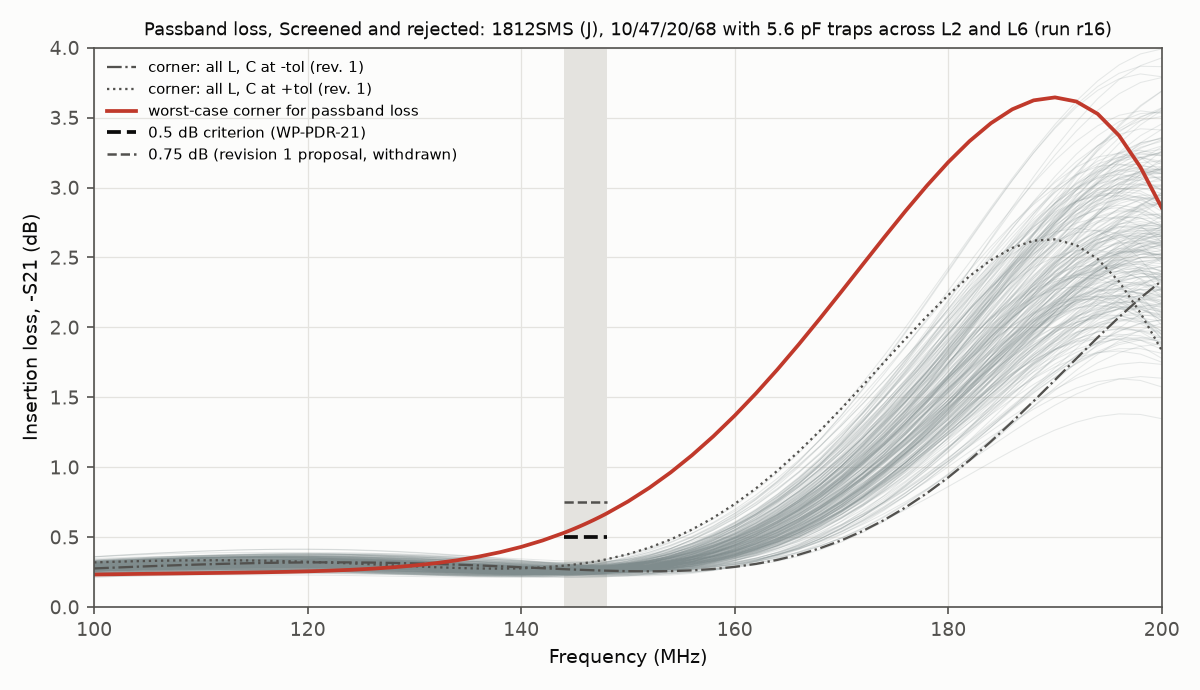
hardware/sim/tx-lpf/results/2026-09-28-r16-wc-1812sms-trap-screen/il_wc_passband.png
