robinonsay/cwht/hardware/sim/tx-lpf/results/2026-09-28-r16-wc-1812sms-trap-screen/s21_wc_wide.png

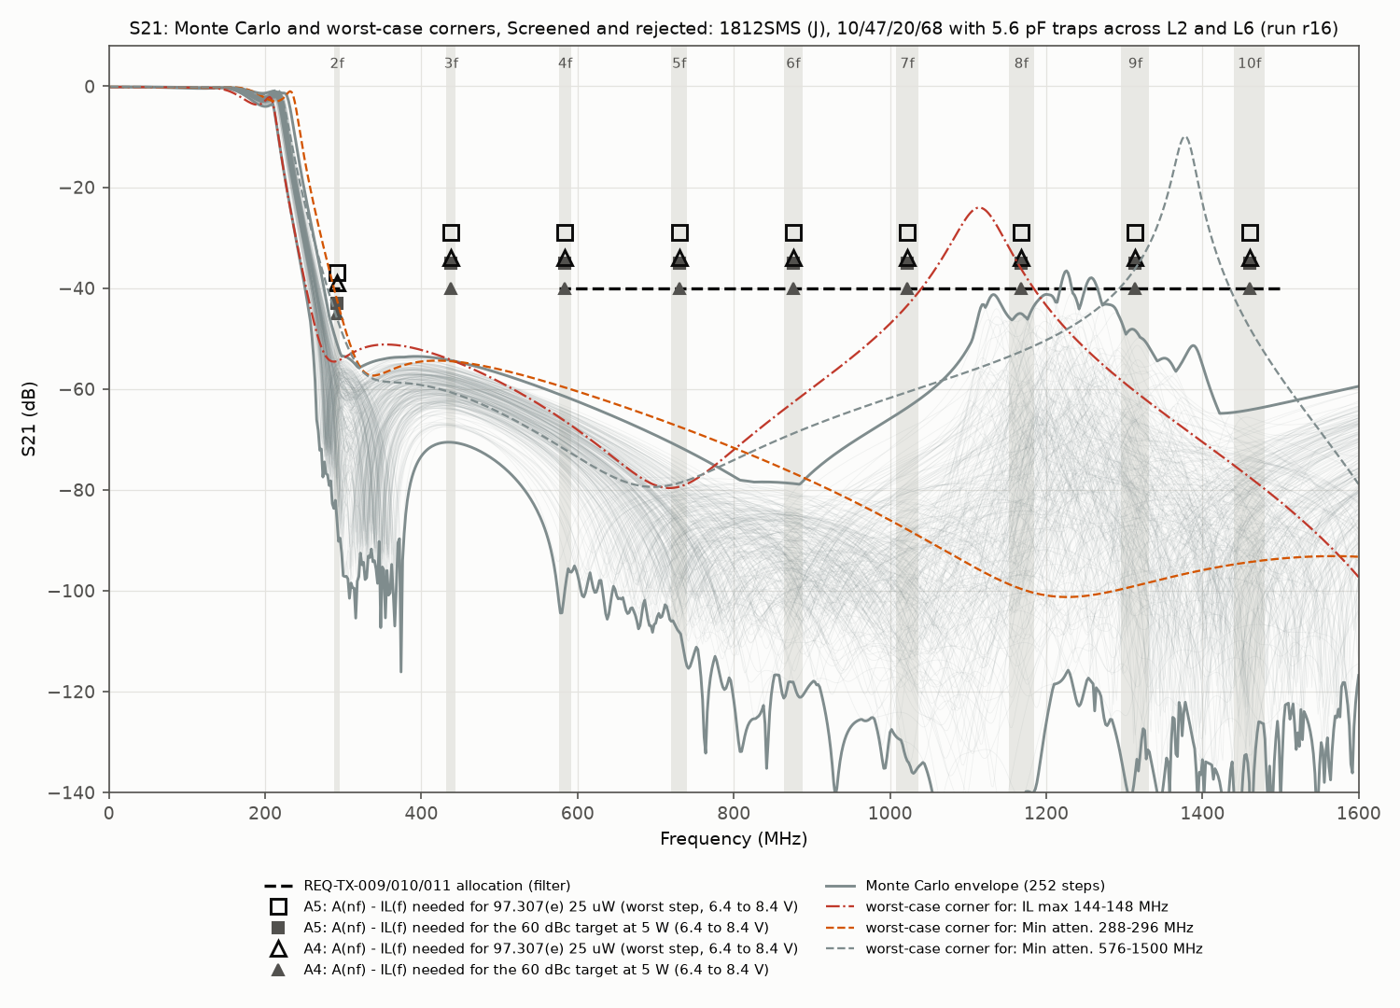
hardware/sim/tx-lpf/results/2026-09-28-r16-wc-1812sms-trap-screen/s21_wc_wide.png
