robinonsay/cwht/hardware/sim/tx-pa-permit/results/2026-09-29-d18-asis/asis_timeline.png

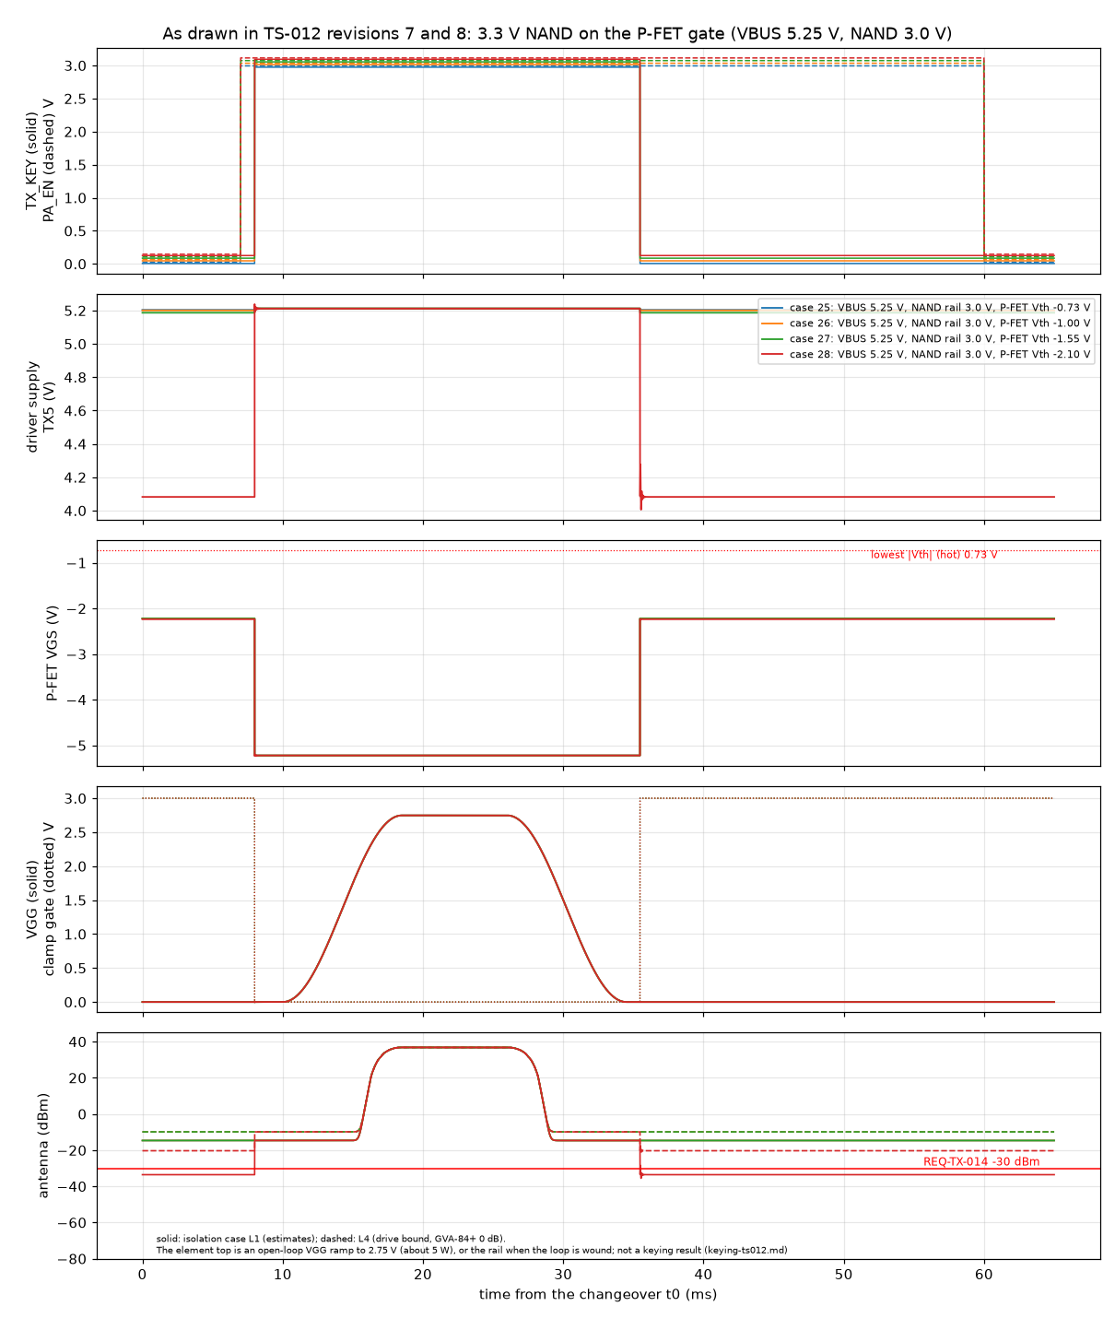
hardware/sim/tx-pa-permit/results/2026-09-29-d18-asis/asis_timeline.png
