robinonsay/cwht/hardware/sim/tx-pa-permit/results/2026-09-29-d18r1-keyup/keyup_edges.png

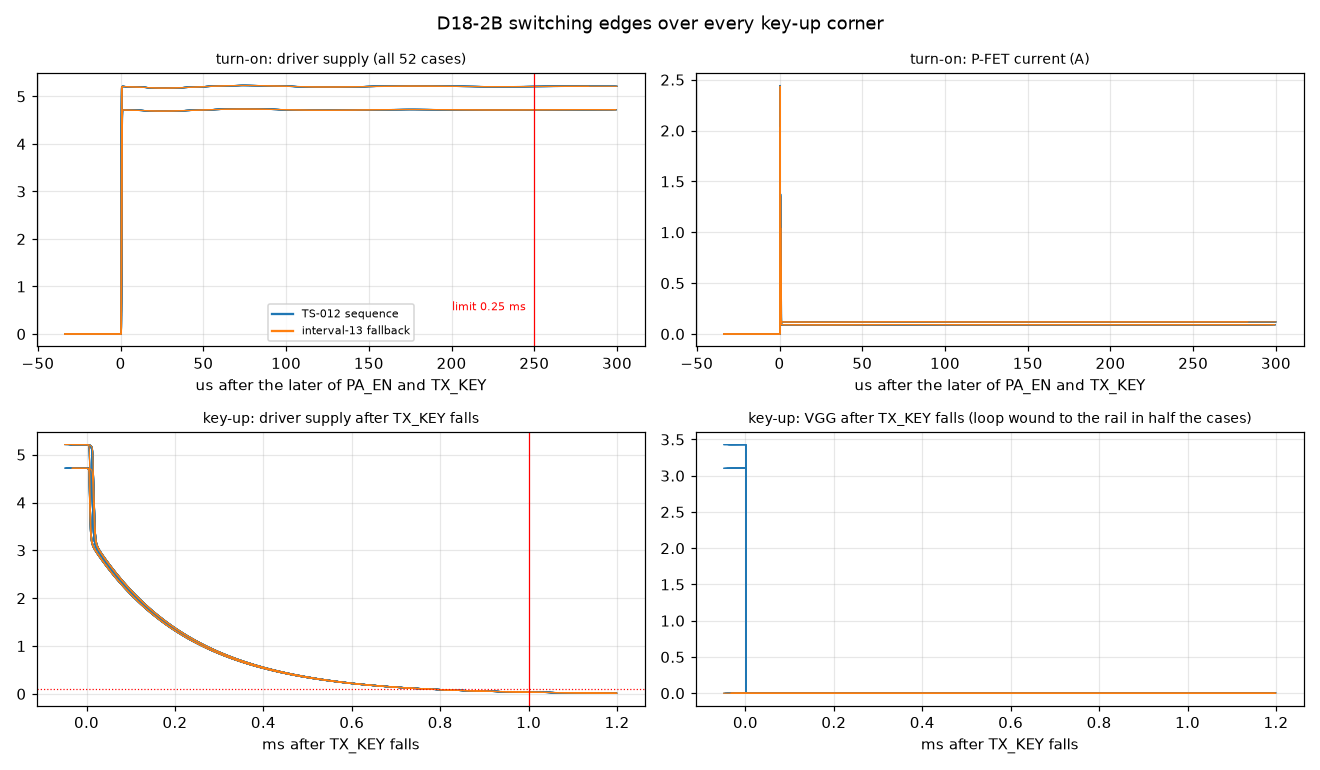
hardware/sim/tx-pa-permit/results/2026-09-29-d18r1-keyup/keyup_edges.png
