robinonsay/cwht/hardware/sim/tx-pa-permit/results/2026-09-29-d18r1-keyup/off_states.png

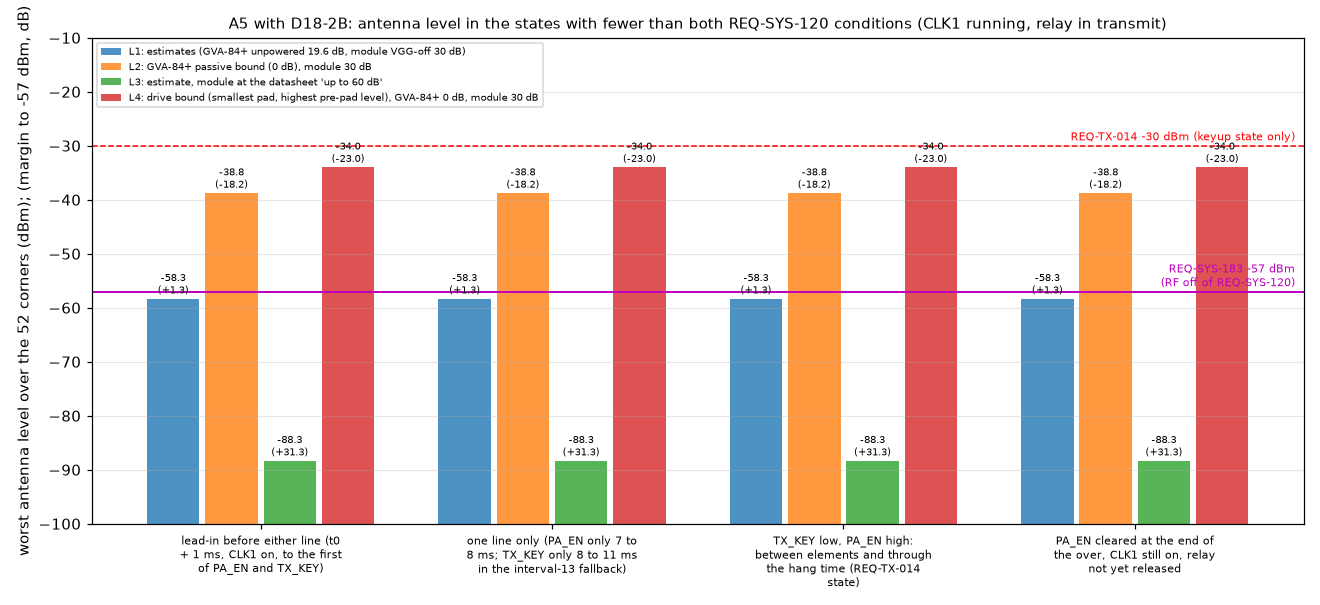
hardware/sim/tx-pa-permit/results/2026-09-29-d18r1-keyup/off_states.png
