robinonsay/cwht/hardware/sim/tx-pa/results/2026-09-28-d1-gva-model/gva_compression.png

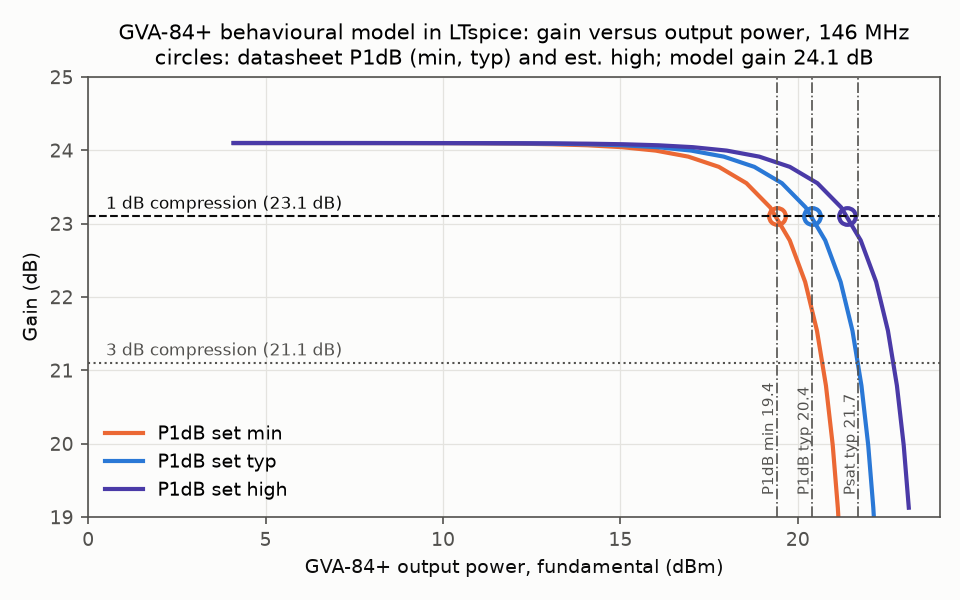
hardware/sim/tx-pa/results/2026-09-28-d1-gva-model/gva_compression.png
