robinonsay/cwht/hardware/sim/tx-pa/results/2026-09-28-d2-drive-a5/drive_a5_h3.png

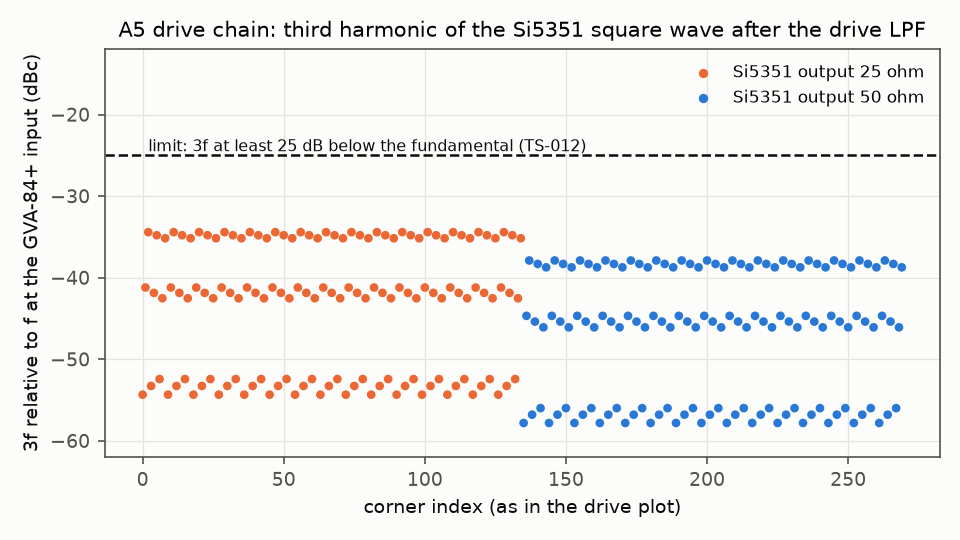
hardware/sim/tx-pa/results/2026-09-28-d2-drive-a5/drive_a5_h3.png
