robinonsay/cwht/hardware/sim/tx-pa/results/2026-09-28-r1-d3-drive-a4/drive_a4_corners.png

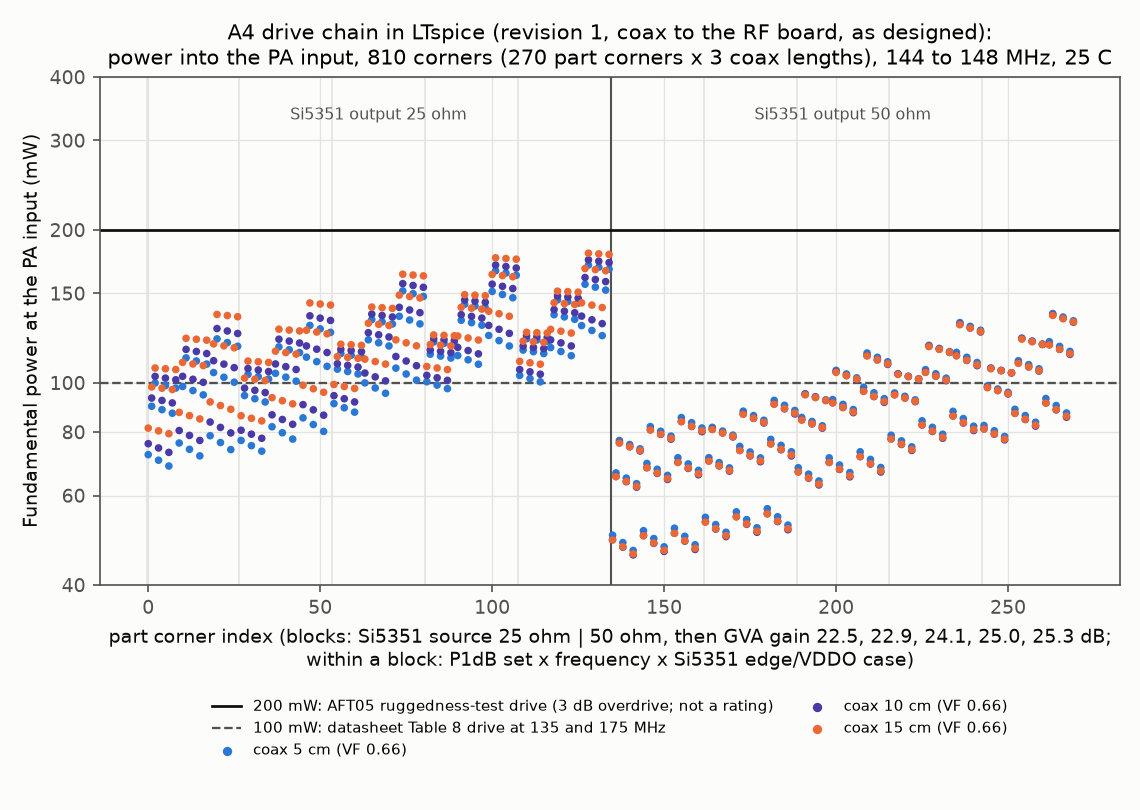
hardware/sim/tx-pa/results/2026-09-28-r1-d3-drive-a4/drive_a4_corners.png
