robinonsay/cwht/hardware/sim/tx-pa/results/2026-09-28-r1-d4-coax-bound/coax_length_bound.png

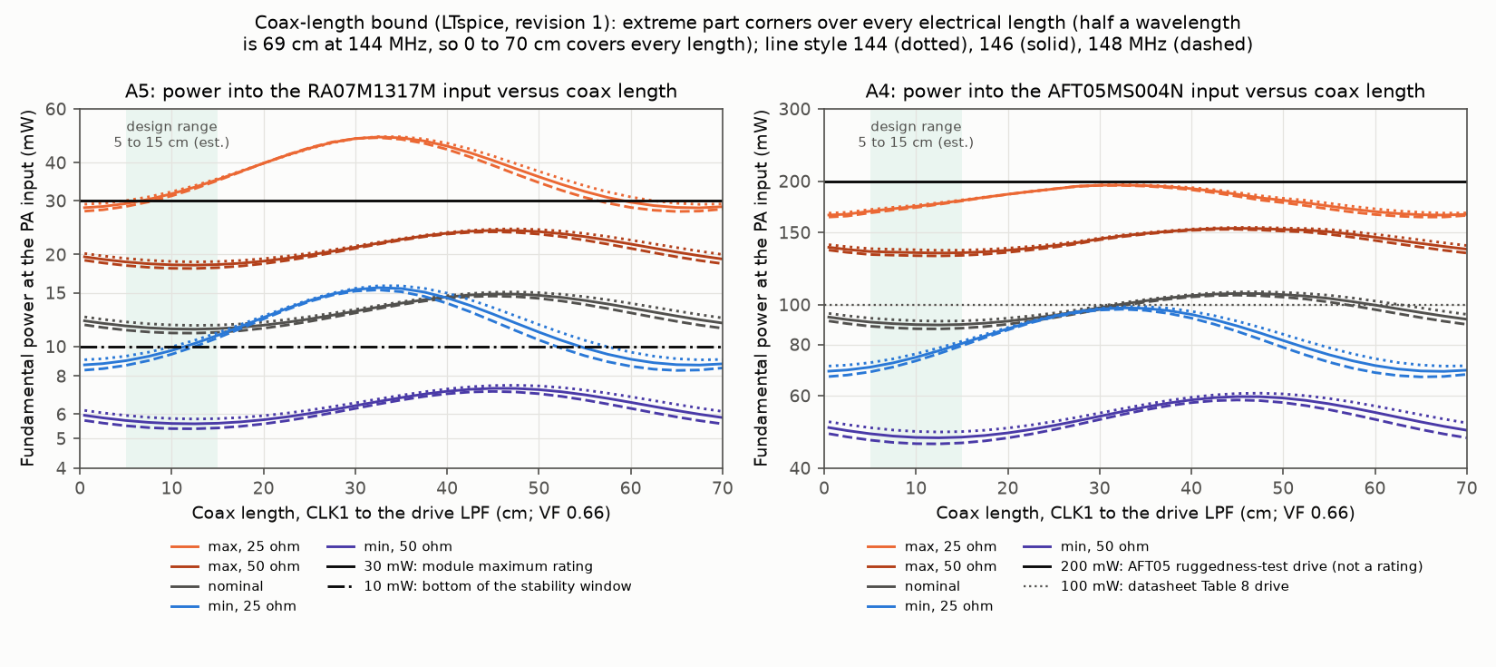
hardware/sim/tx-pa/results/2026-09-28-r1-d4-coax-bound/coax_length_bound.png
