robinonsay/cwht/hardware/sim/tx-pa/results/2026-09-28-r1-d5-drive-a5-pinpad/drive_a5_h3.png

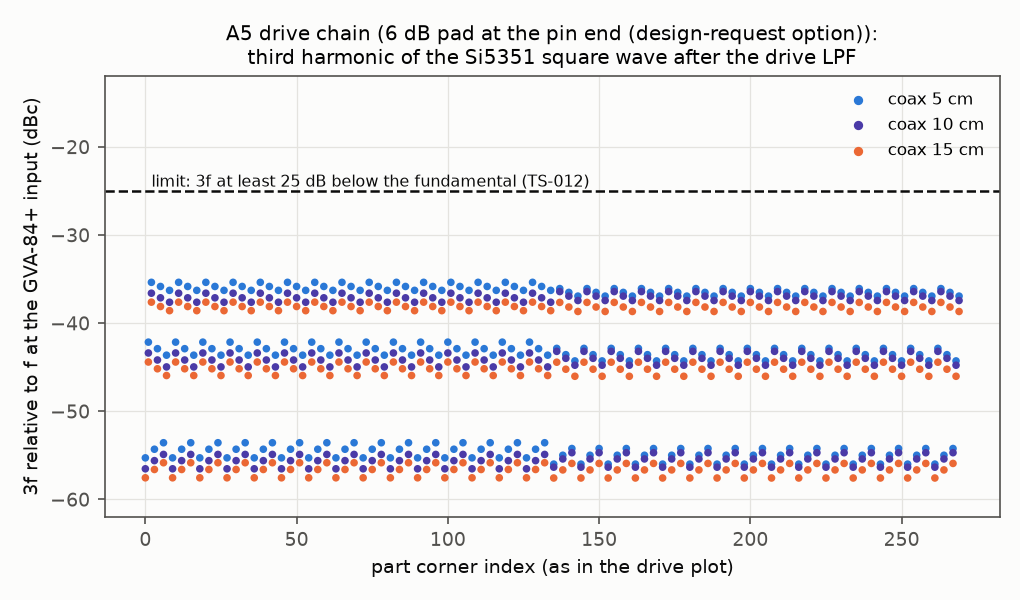
hardware/sim/tx-pa/results/2026-09-28-r1-d5-drive-a5-pinpad/drive_a5_h3.png
