robinonsay/cwht/hardware/sim/tx-pa/results/2026-09-28-r1-p1-power-a5/power_a5_temperature.png

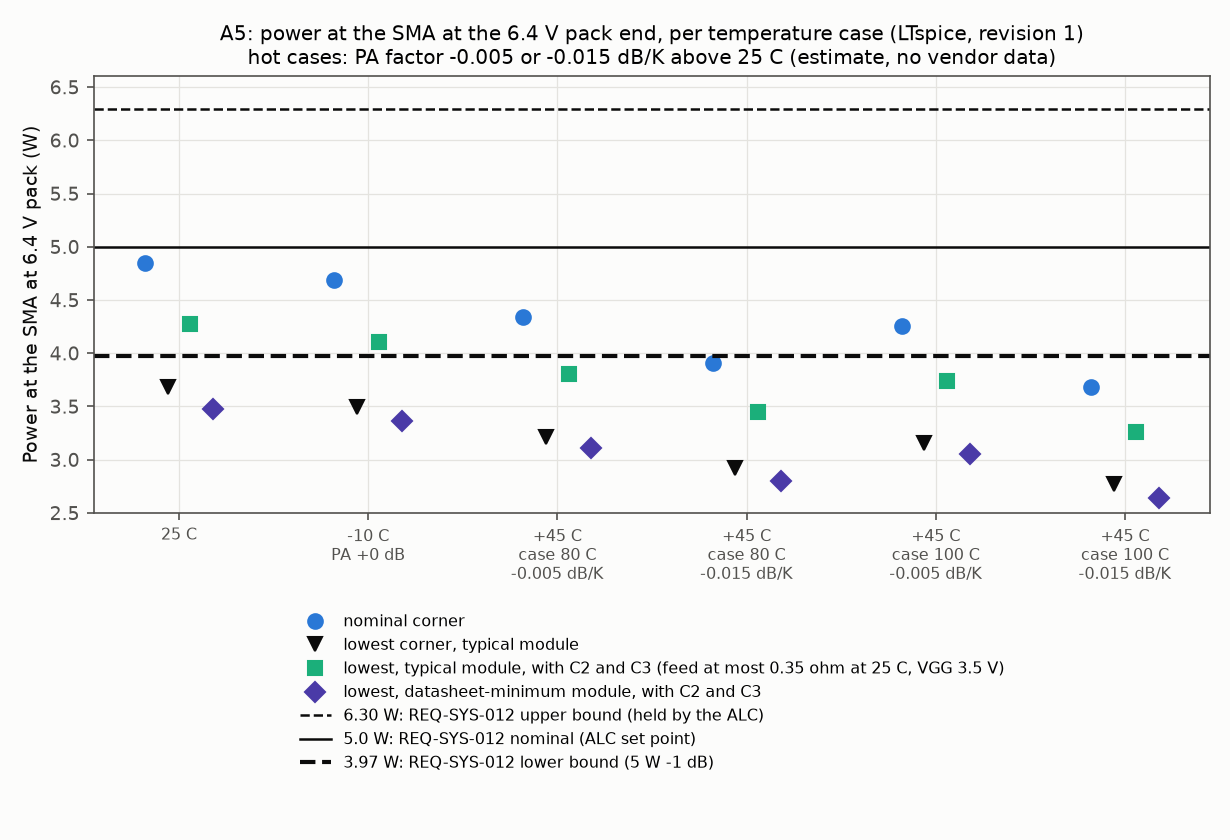
hardware/sim/tx-pa/results/2026-09-28-r1-p1-power-a5/power_a5_temperature.png
