robinonsay/cwht/hardware/sim/tx-pa/results/2026-09-28-r1-p2-power-a4/power_a4_temperature.png

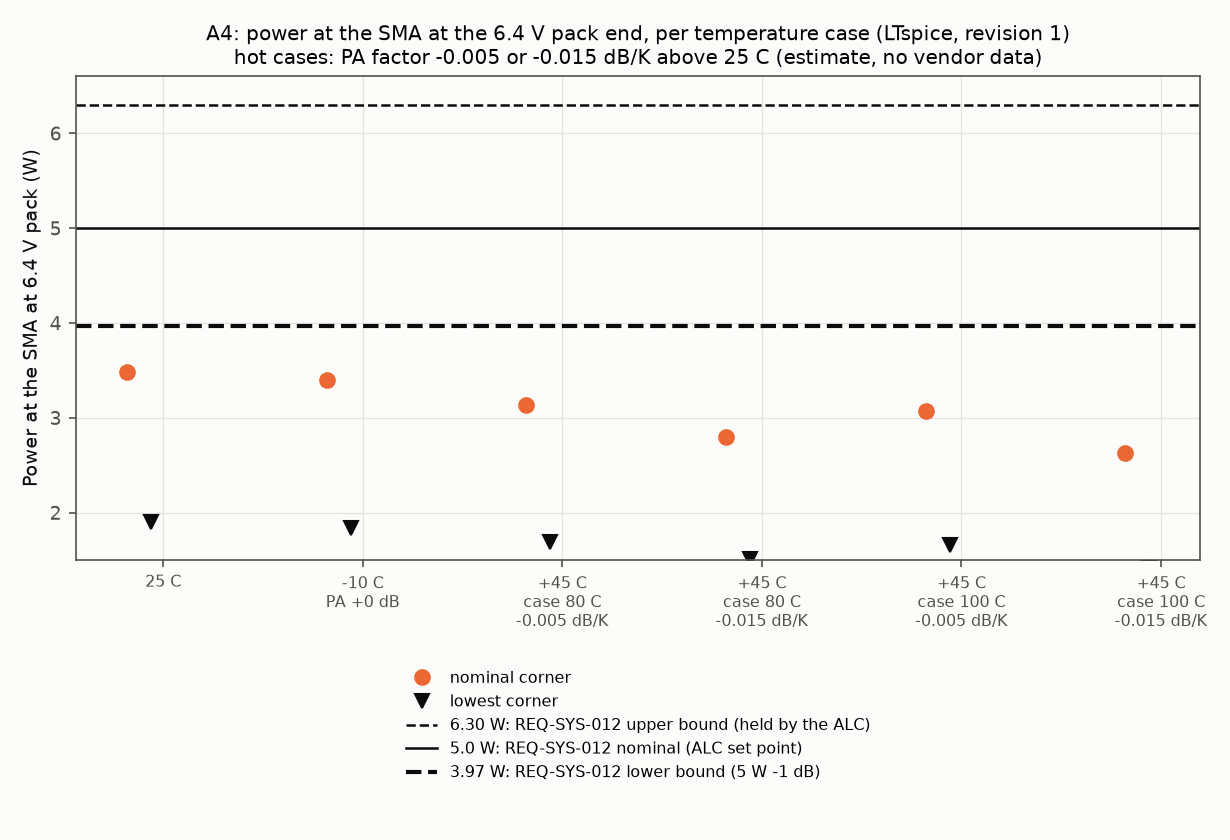
hardware/sim/tx-pa/results/2026-09-28-r1-p2-power-a4/power_a4_temperature.png
