robinonsay/cwht/hardware/sim/tx-pa/results/2026-09-28-r1-s1-summary/a5_closure_margin.png

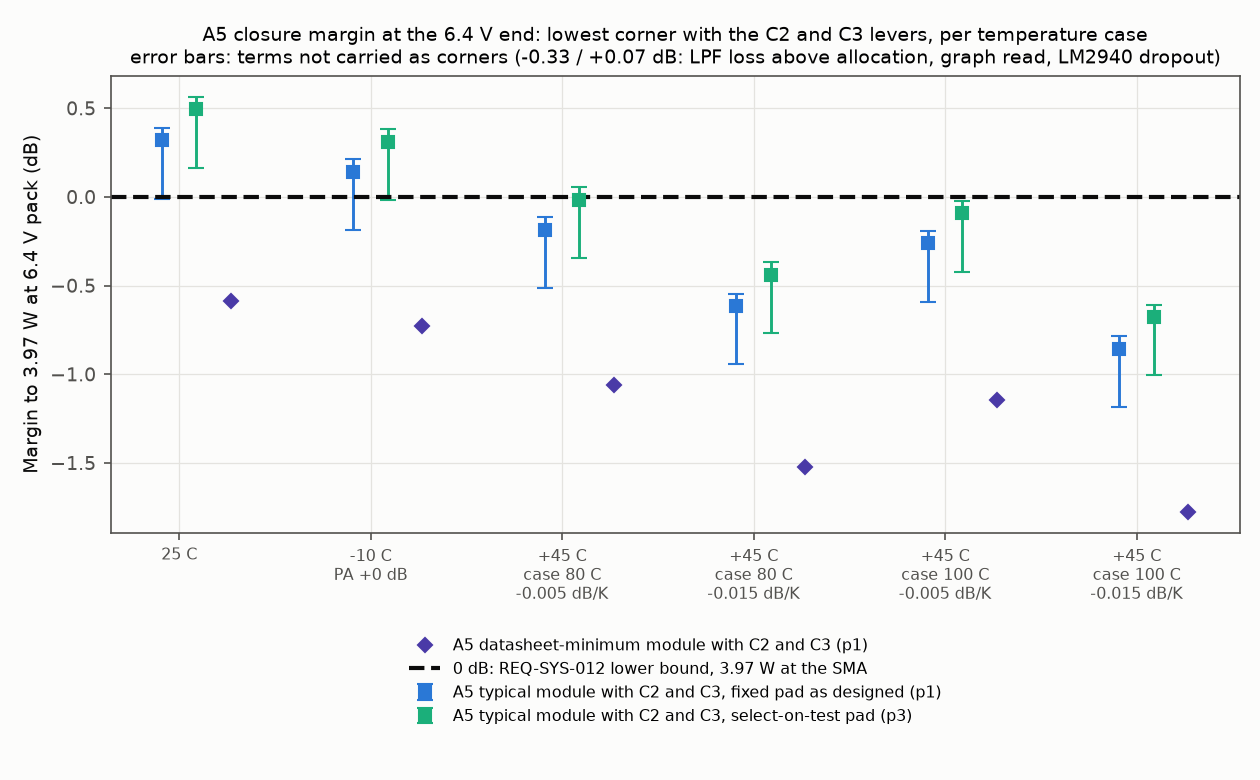
hardware/sim/tx-pa/results/2026-09-28-r1-s1-summary/a5_closure_margin.png
