robinonsay/cwht/hardware/sim/tx-pa/results/2026-09-28-r1-s1-summary/pout_at_sma_vs_pack.png

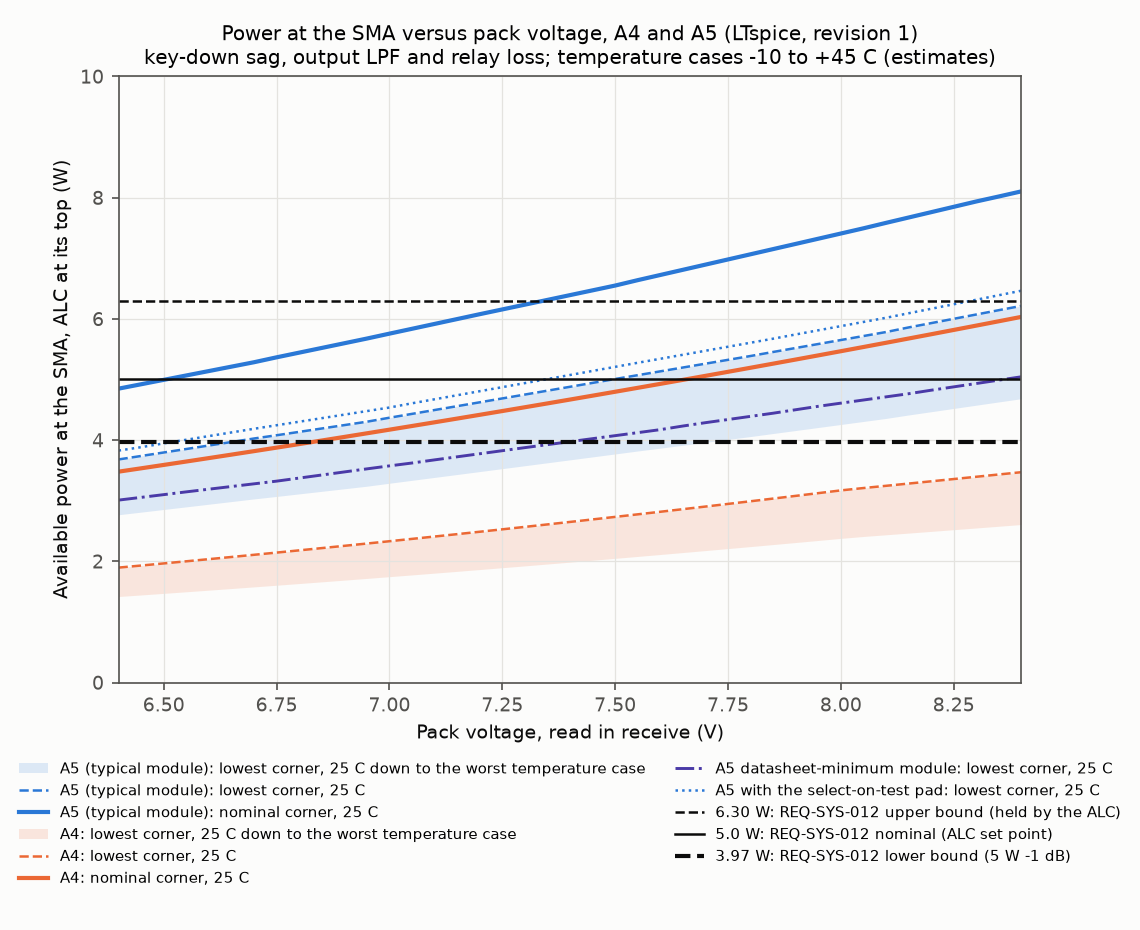
hardware/sim/tx-pa/results/2026-09-28-r1-s1-summary/pout_at_sma_vs_pack.png
