robinonsay/cwht/hardware/sim/tx-pa/results/2026-09-28-r2-p3-power-a5-sot/power_a5_temperature.png

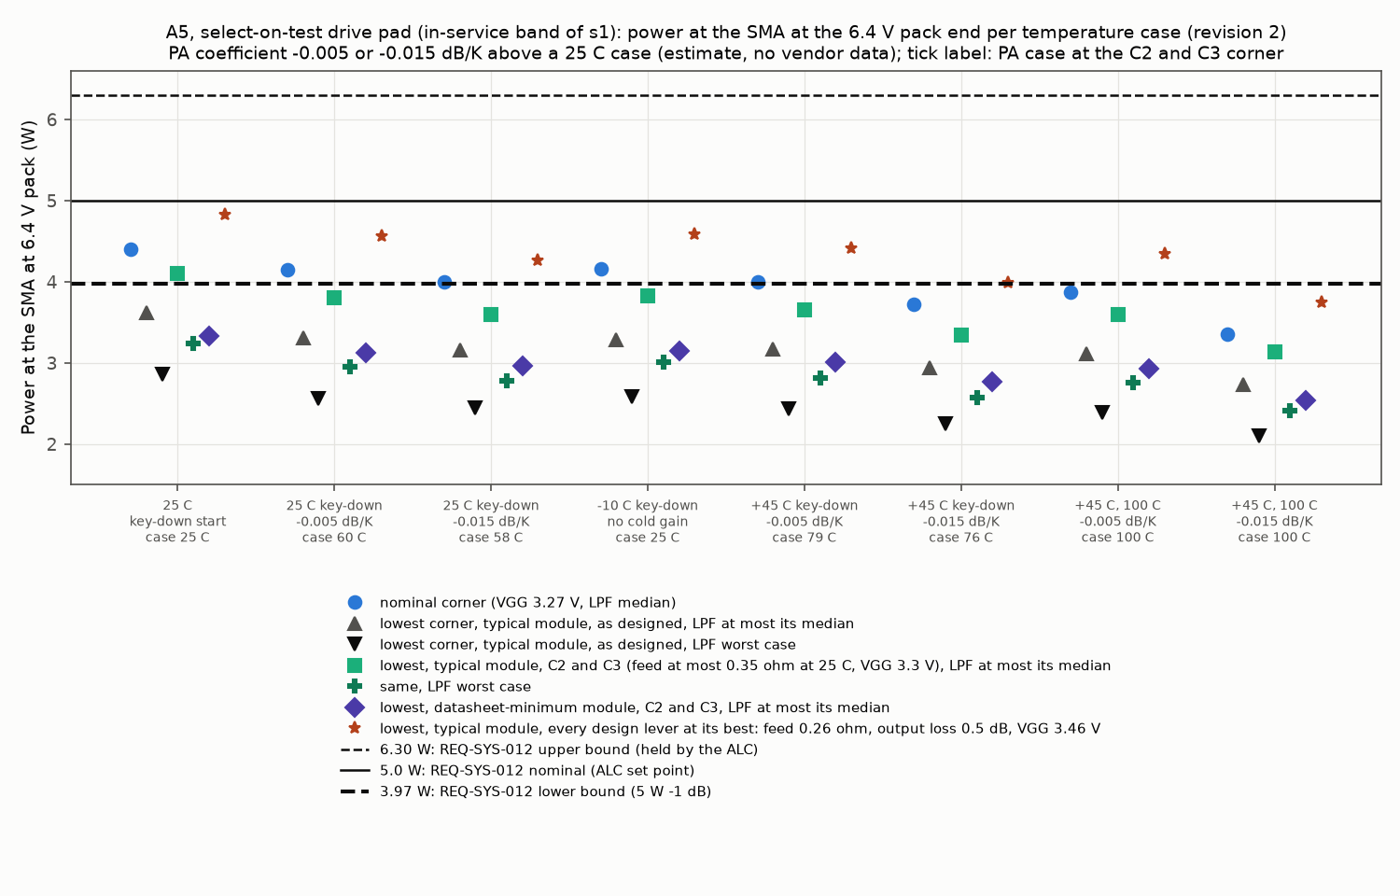
hardware/sim/tx-pa/results/2026-09-28-r2-p3-power-a5-sot/power_a5_temperature.png
