robinonsay/cwht/hardware/sim/tx-pa/results/2026-09-28-r2-s1-summary/a5_sot_reading_sensitivity.png

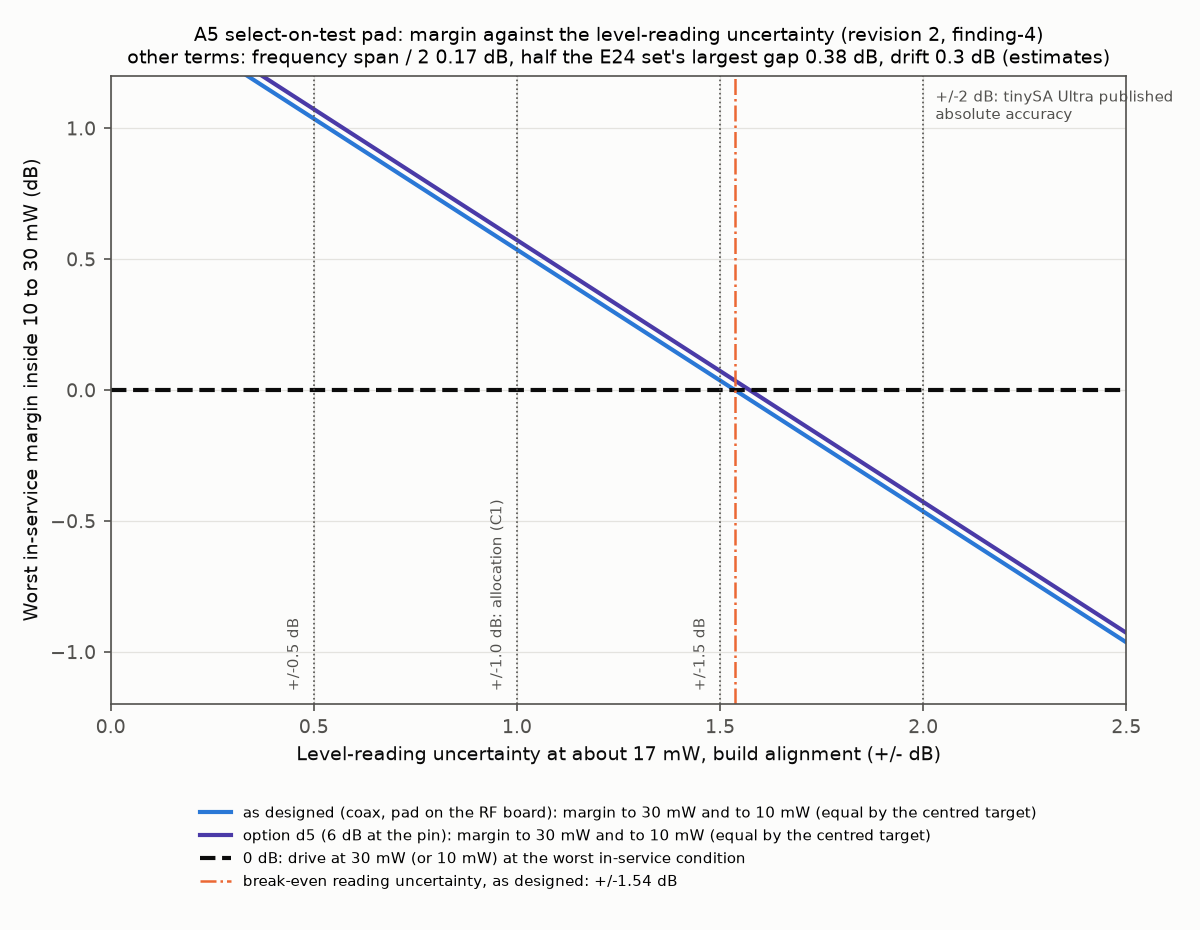
hardware/sim/tx-pa/results/2026-09-28-r2-s1-summary/a5_sot_reading_sensitivity.png
