robinonsay/cwht/hardware/sim/tx-pa/results/2026-09-28-r2-s1-summary/pin_at_pa_vs_pack.png

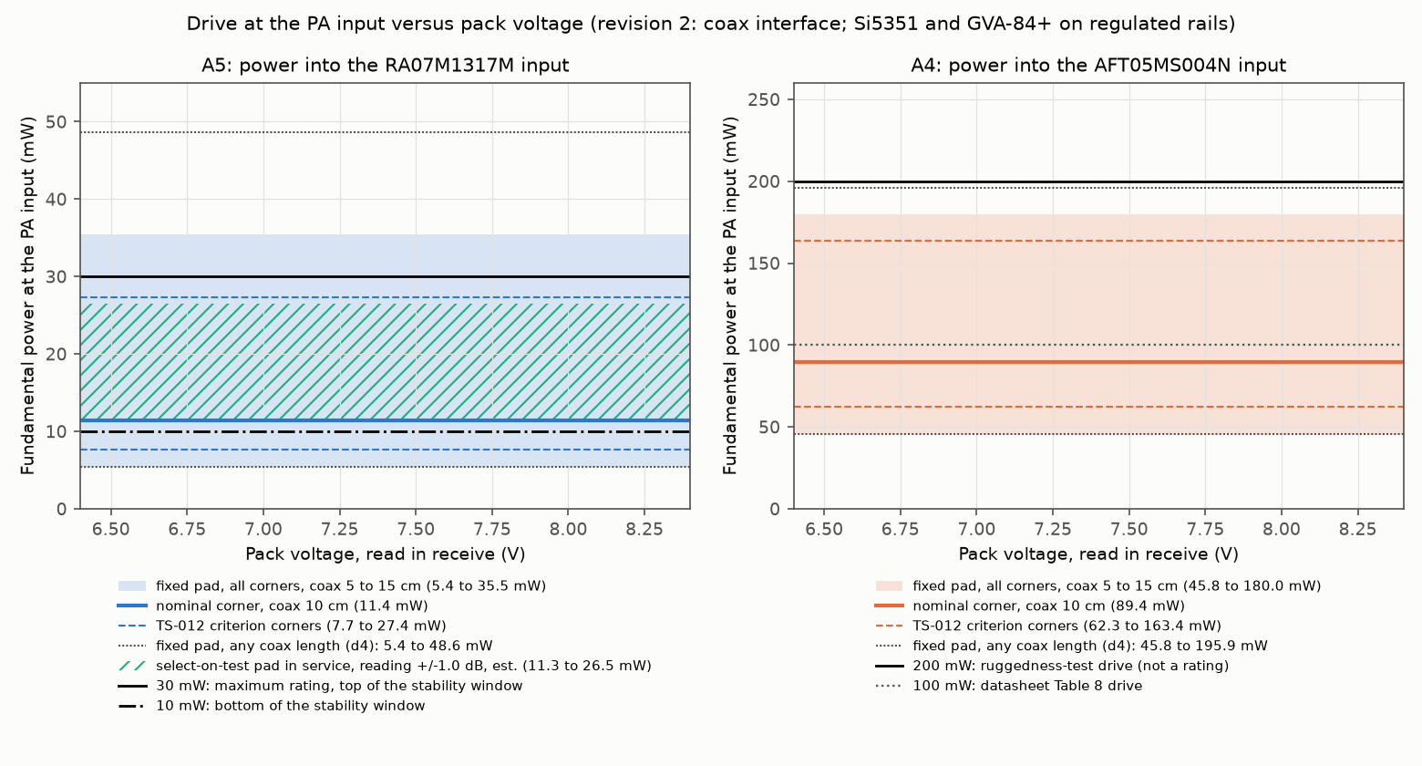
hardware/sim/tx-pa/results/2026-09-28-r2-s1-summary/pin_at_pa_vs_pack.png
