robinonsay/cwht/hardware/sim/tx-pa/results/2026-09-29-r3-d6-drive-a5-bpf/drive_a5_bpf_corners.png

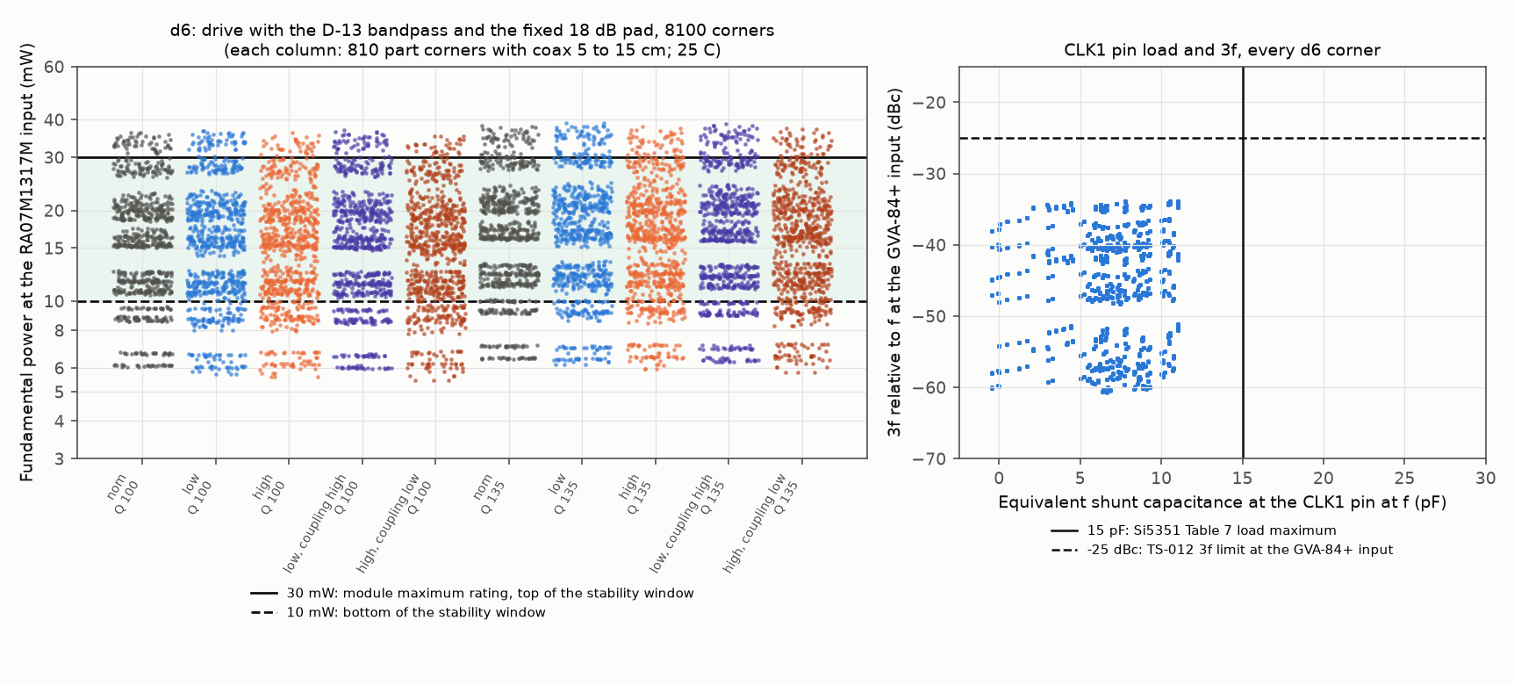
hardware/sim/tx-pa/results/2026-09-29-r3-d6-drive-a5-bpf/drive_a5_bpf_corners.png
