robinonsay/cwht/hardware/sim/tx-pa/results/2026-09-29-r3-d7-coax-bound-bpf/coax_length_bound_bpf.png

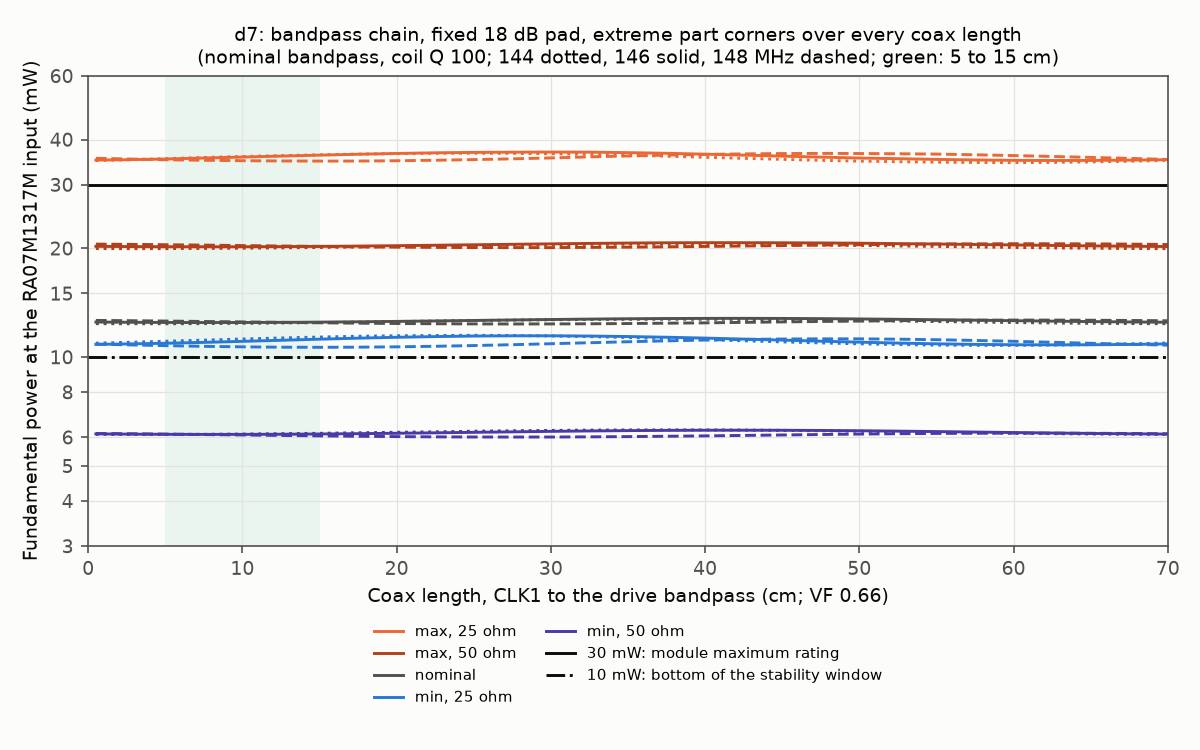
hardware/sim/tx-pa/results/2026-09-29-r3-d7-coax-bound-bpf/coax_length_bound_bpf.png
