robinonsay/cwht/hardware/sim/tx-pa/results/2026-09-29-r3-k1-probe-17mw/probe_reading_error.png

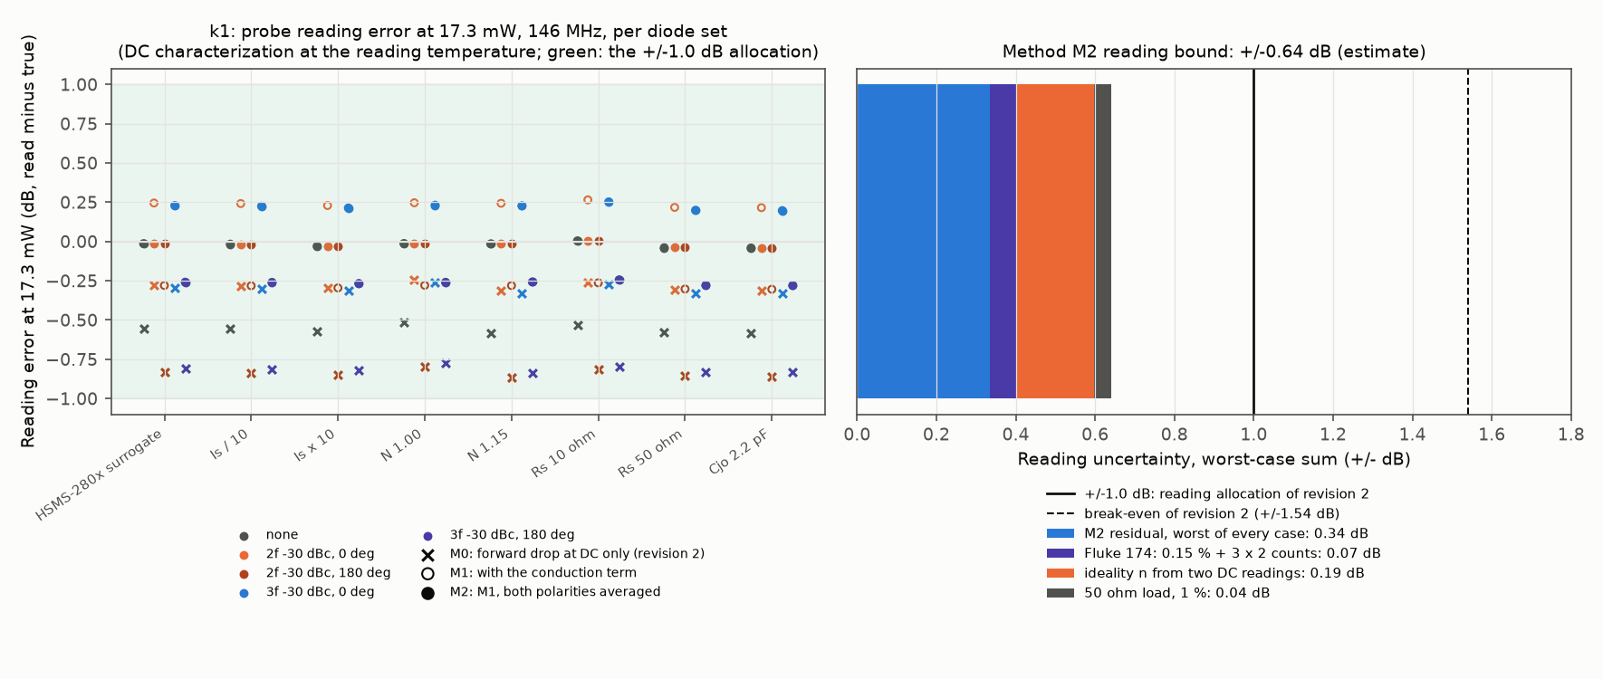
hardware/sim/tx-pa/results/2026-09-29-r3-k1-probe-17mw/probe_reading_error.png
