robinonsay/cwht/hardware/sim/tx-pa/results/2026-09-29-r3-p5-power-a5-clamp-b/power_a5_clampb_sma.png

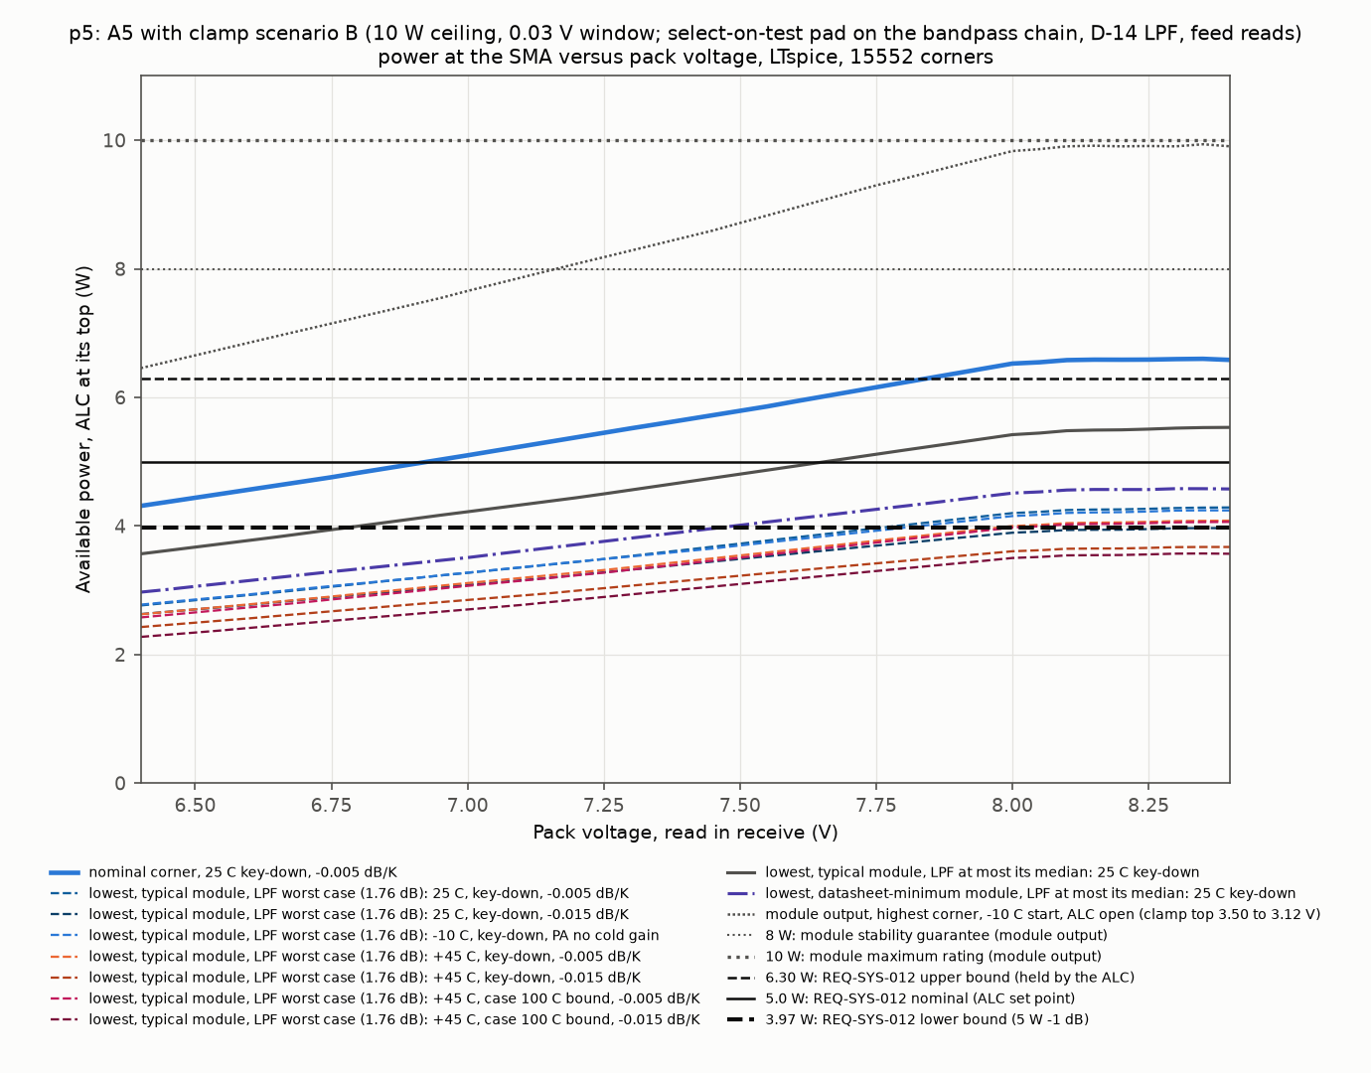
hardware/sim/tx-pa/results/2026-09-29-r3-p5-power-a5-clamp-b/power_a5_clampb_sma.png
