robinonsay/cwht/hardware/sim/tx-pa/results/2026-09-29-r3-s2-sot-pad/sot_band.png

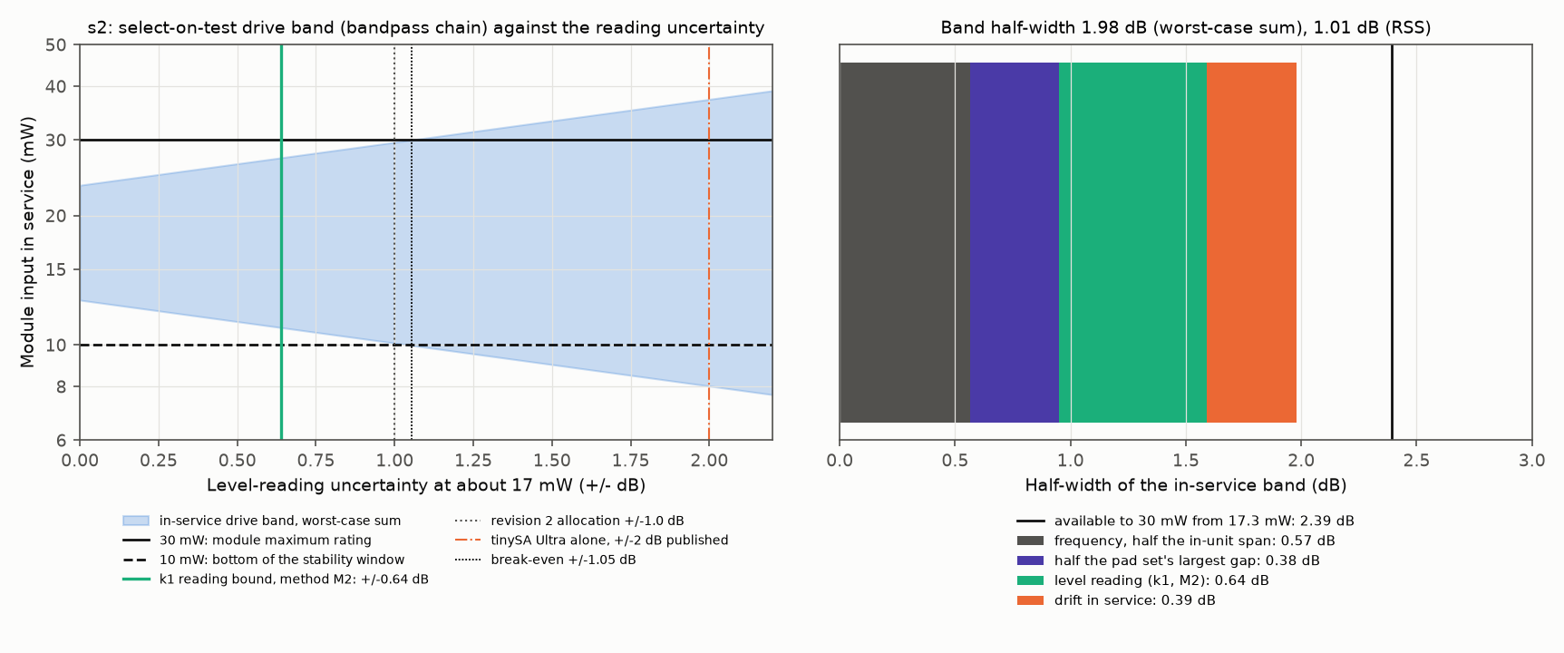
hardware/sim/tx-pa/results/2026-09-29-r3-s2-sot-pad/sot_band.png
