robinonsay/cwht/hardware/sim/tx-pa/results/2026-09-29-r3-s3-req012-basis/req012_basis.png

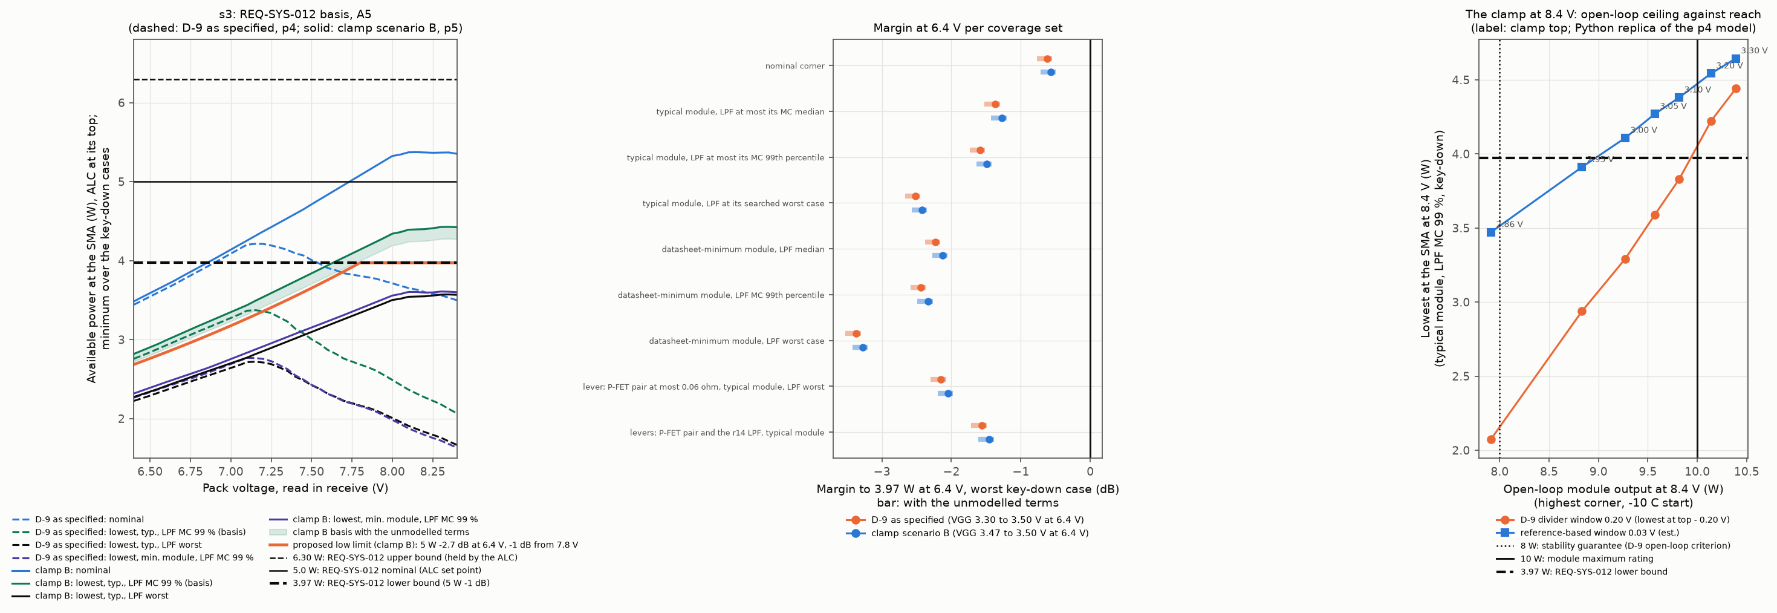
hardware/sim/tx-pa/results/2026-09-29-r3-s3-req012-basis/req012_basis.png
