robinonsay/cwht/hardware/sim/tx-pa/results/2026-09-29-r4-s2-sot-pad/sot_band_r4.png

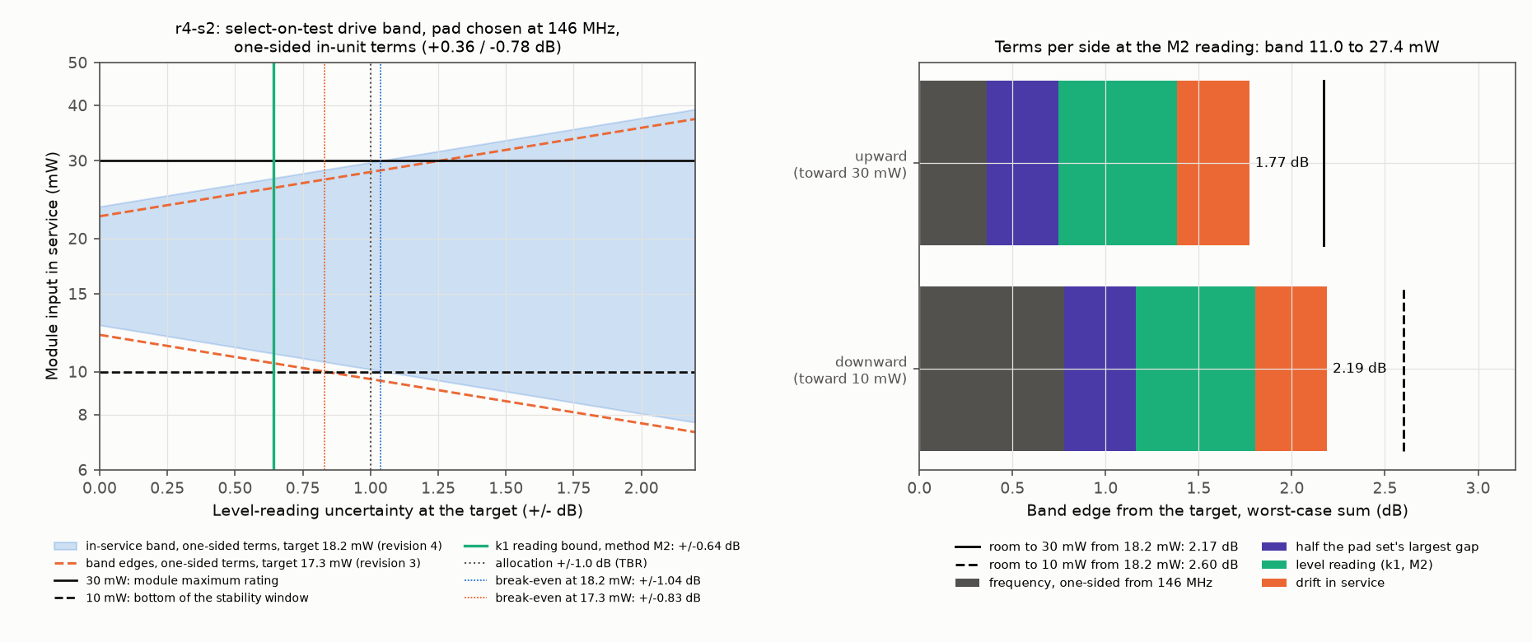
hardware/sim/tx-pa/results/2026-09-29-r4-s2-sot-pad/sot_band_r4.png
