robinonsay/cwht/hardware/sim/tx-pa/results/2026-09-29-r4-s3-req012-basis/req012_basis_r4.png

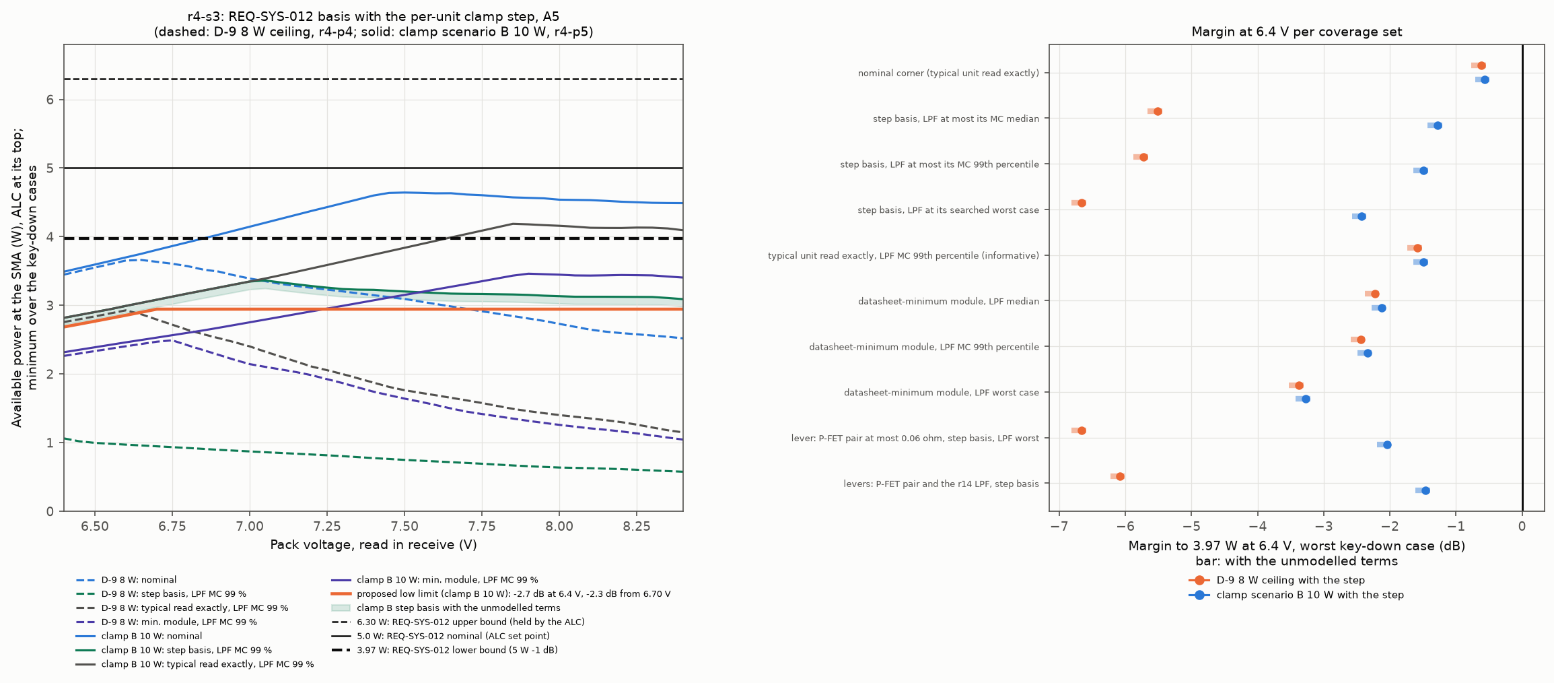
hardware/sim/tx-pa/results/2026-09-29-r4-s3-req012-basis/req012_basis_r4.png
