robinonsay/cwht/hardware/sim/tx-pa/results/2026-09-30-r5-p5-power-a5-clamp-b/power_a5_added_case_clampb.png

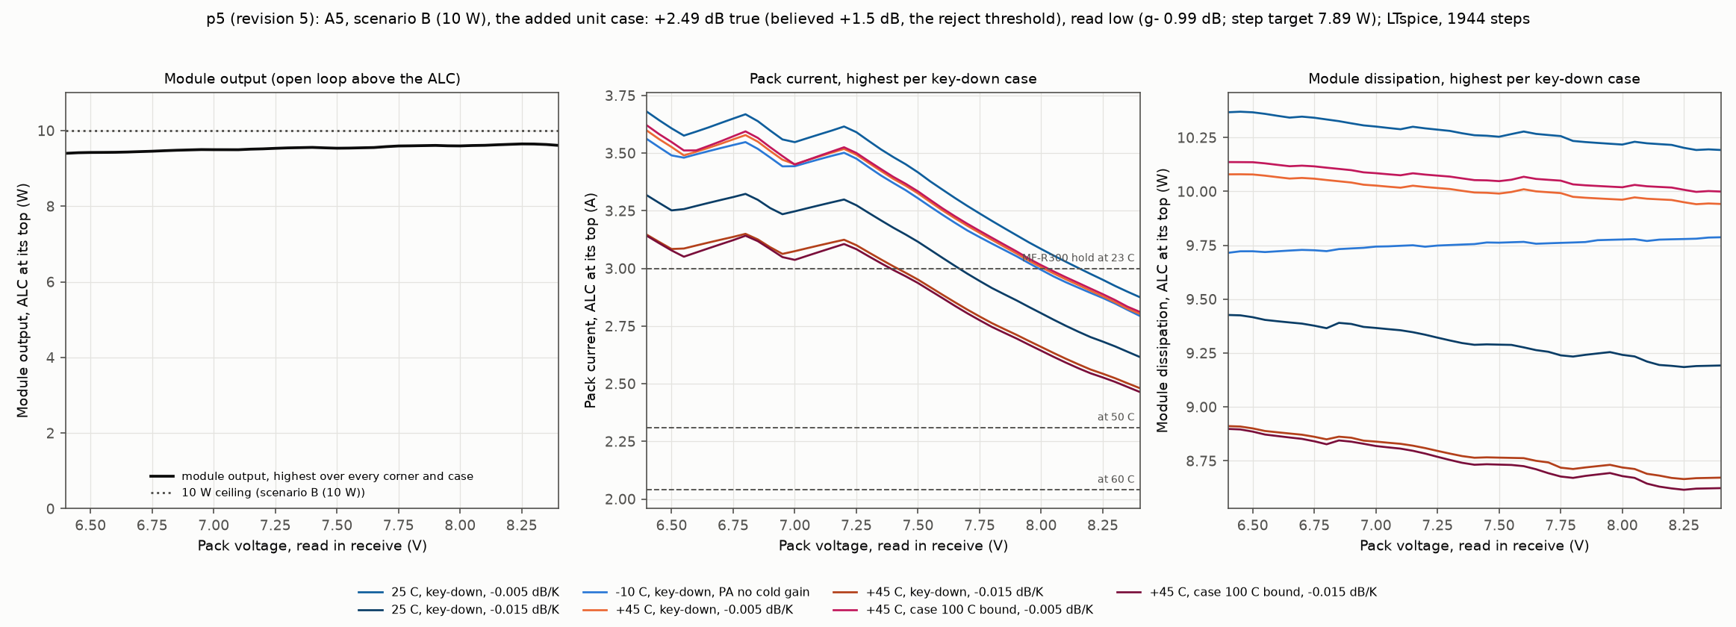
hardware/sim/tx-pa/results/2026-09-30-r5-p5-power-a5-clamp-b/power_a5_added_case_clampb.png
