robinonsay/cwht/hardware/sim/tx-pa/results/2026-09-30-r5-s5-pass-population/pass_population.png

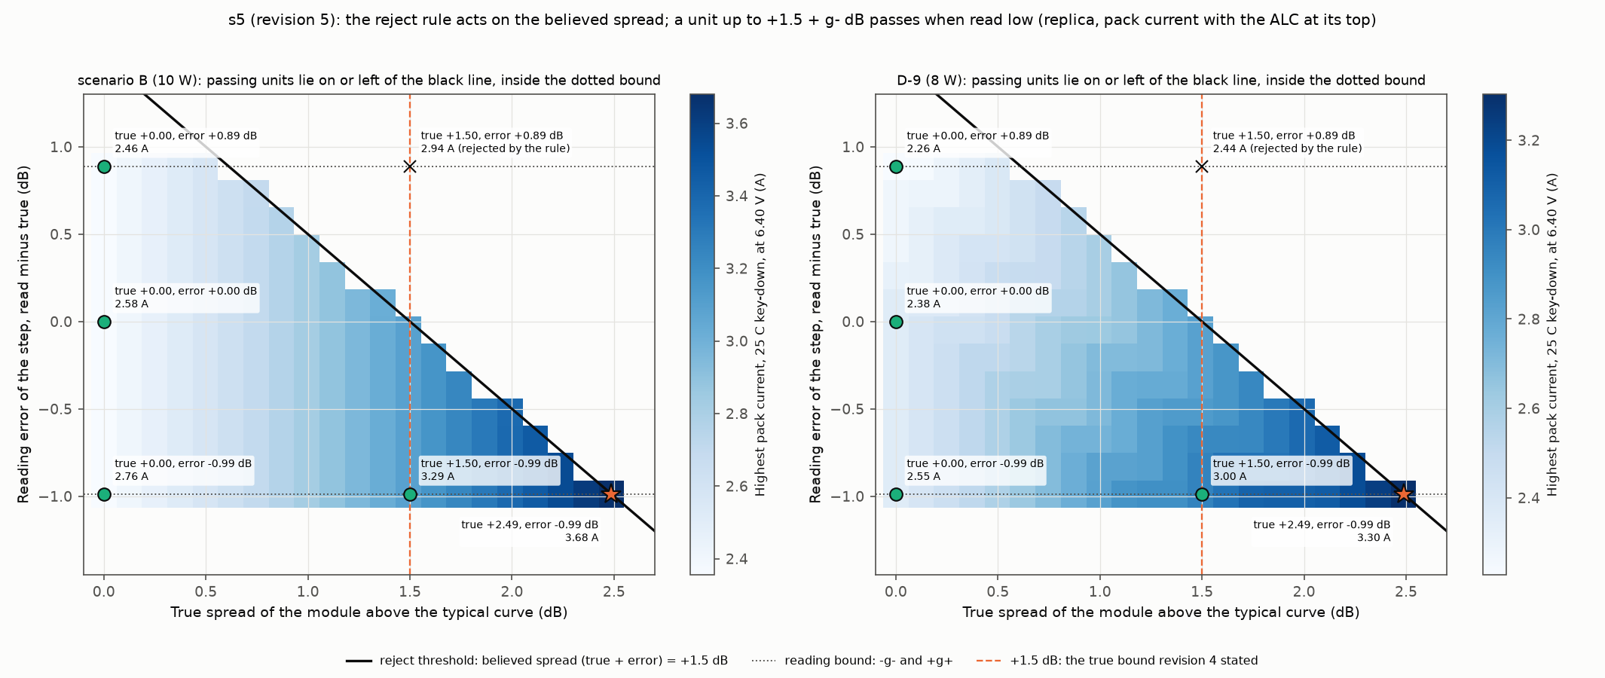
hardware/sim/tx-pa/results/2026-09-30-r5-s5-pass-population/pass_population.png
