robinonsay/cwht/hardware/sim/tx-seq/results/2026-09-29-r2-s1-drive/s1-coil-current.png

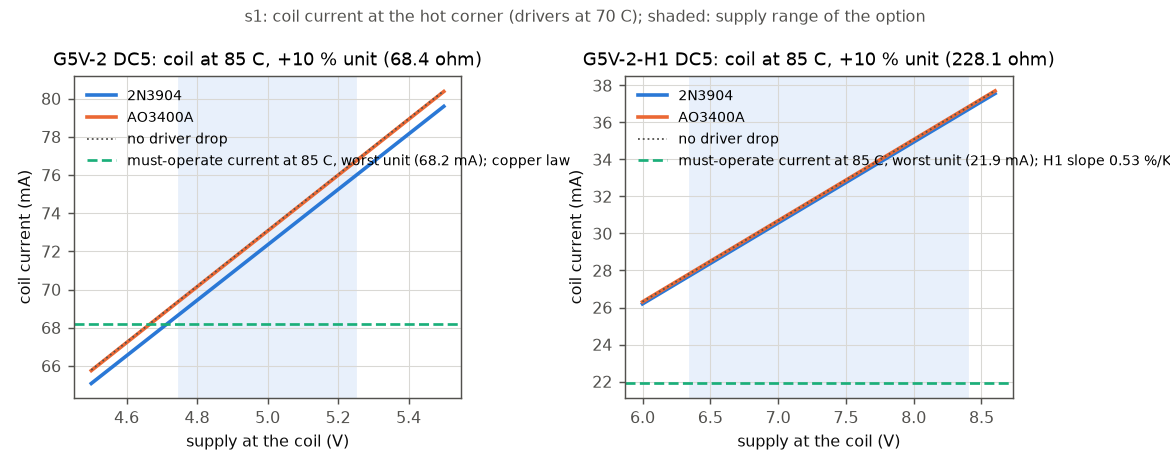
hardware/sim/tx-seq/results/2026-09-29-r2-s1-drive/s1-coil-current.png
