robinonsay/cwht/hardware/sim/tx-seq/results/2026-09-29-r2-s2-coil/s2-coil-transient.png

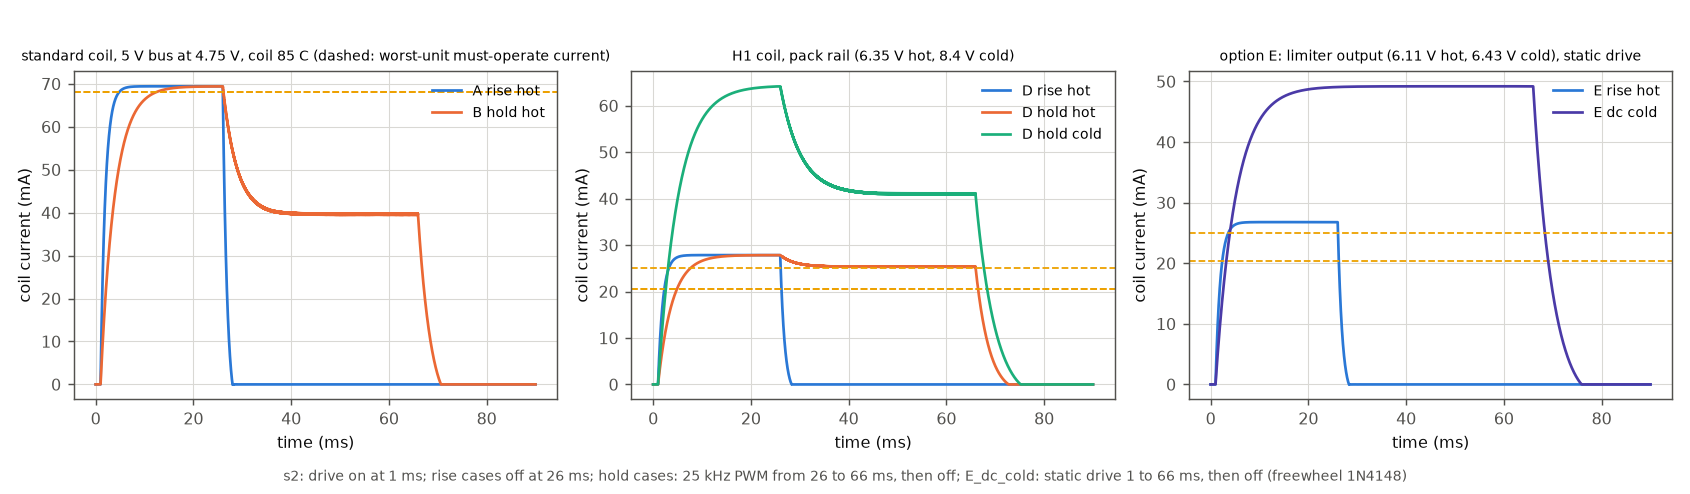
hardware/sim/tx-seq/results/2026-09-29-r2-s2-coil/s2-coil-transient.png
