robinonsay/cwht/hardware/sim/tx-seq/results/2026-09-29-r2-s4-sequence/s4-stale-ratio.png

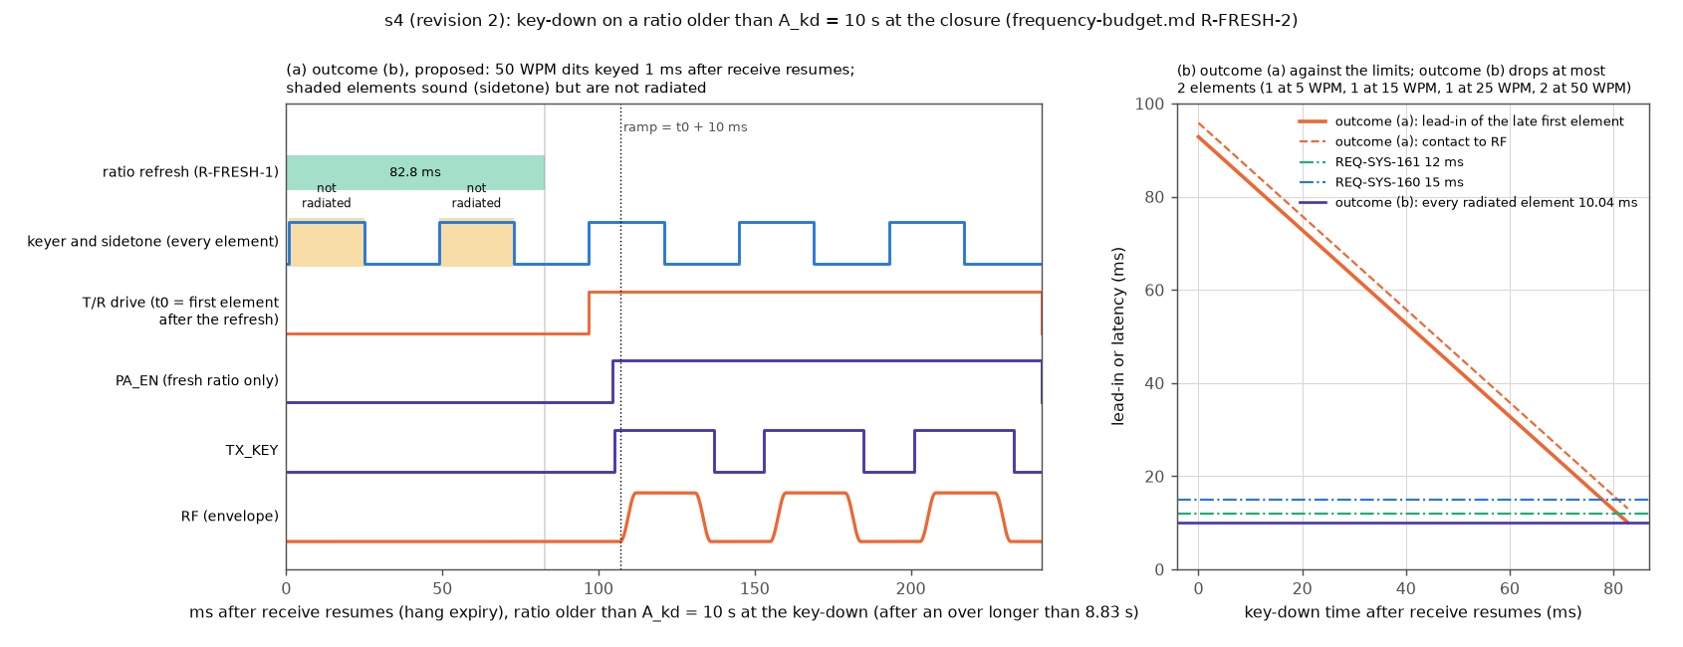
hardware/sim/tx-seq/results/2026-09-29-r2-s4-sequence/s4-stale-ratio.png
