robinonsay/cwht/hardware/sim/tx-seq/results/2026-09-29-s4-sequence/timing-diagram.png

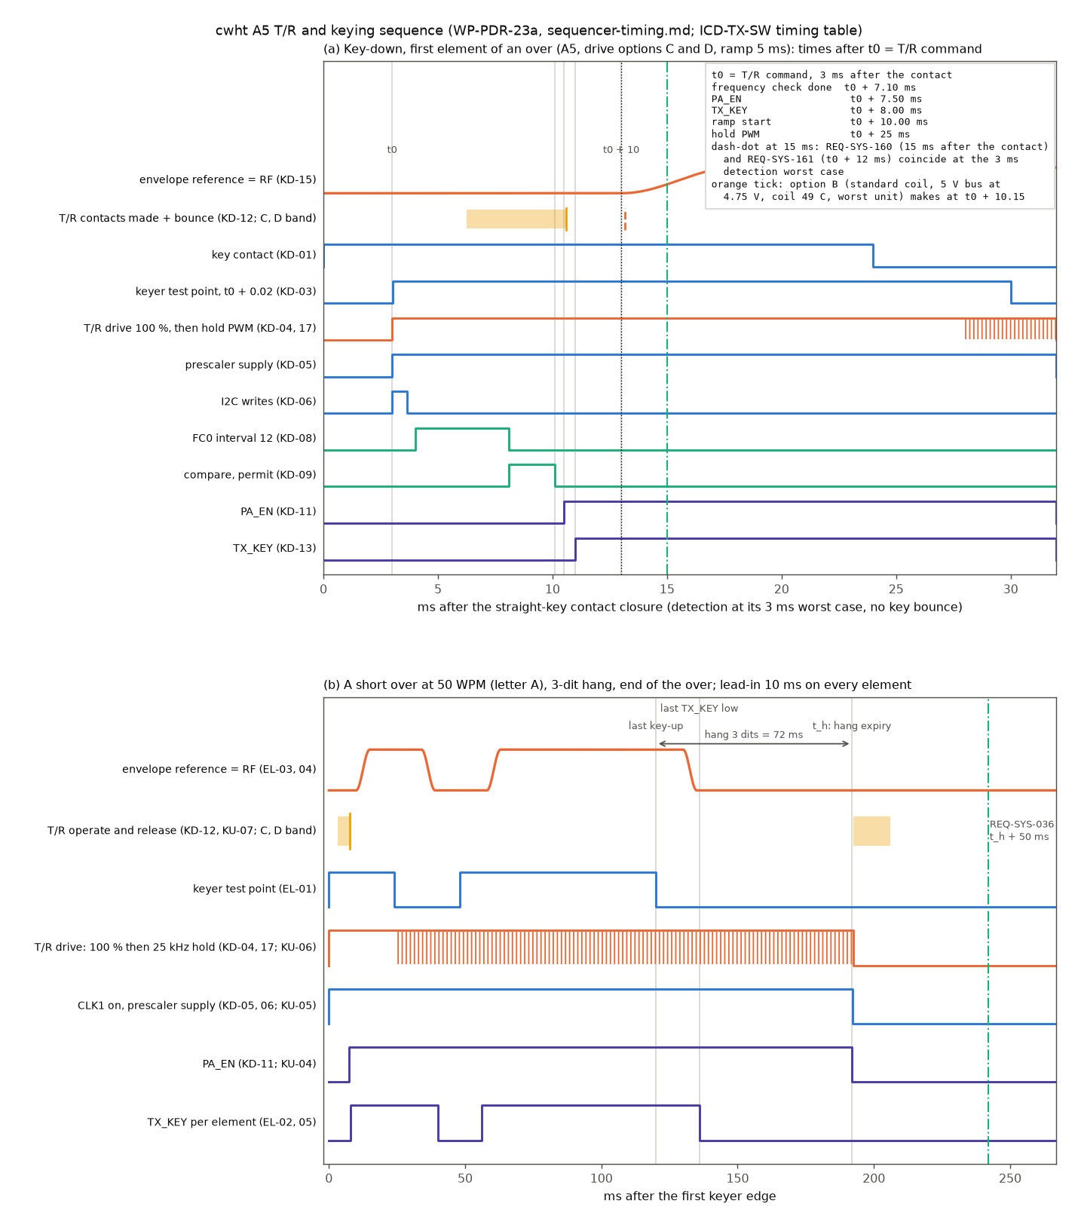
hardware/sim/tx-seq/results/2026-09-29-s4-sequence/timing-diagram.png
