robinonsay/cwht/docs/risk/register.md

# cwht Risk Register (rendered)

Generated by `tools/render_risk.py` from `docs/risk/register.json` (version 0.7.0-pre-pdr, updated 2026-09-27). Do not edit this file; edit the JSON and re-run the tool. Scales and bands: `docs/process/06-risk-and-decision-analysis.md` sections 6 to 8.

## Summary

| Metric | Value |
|---|---|
| Active risks | 65 |
| Red / Yellow / Green | 32 / 25 / 8 |
| Closed or Retired | 0 |
| By status | Accepted 1, Mitigating 9, Open 55 |
| Red by safety override | RSK-034 |
| Software risks (SWE-086 record: category software or tag software) | RSK-002, RSK-003, RSK-006, RSK-007, RSK-009, RSK-010, RSK-012, RSK-013, RSK-015, RSK-016, RSK-017, RSK-019, RSK-020, RSK-021, RSK-022, RSK-023, RSK-024, RSK-028, RSK-032, RSK-033, RSK-037, RSK-041, RSK-042, RSK-046, RSK-051, RSK-056, RSK-060, RSK-061, RSK-062, RSK-063 (14 category software, 16 tagged software) |
| Tagged `aggregate` | RSK-008 |
| Tagged `cm` | RSK-044, RSK-049, RSK-050 |
| Tagged `cyber` | RSK-015, RSK-022, RSK-060, RSK-061, RSK-062 |
| Tagged `hsi` | RSK-012, RSK-016, RSK-017, RSK-018, RSK-024, RSK-026, RSK-028, RSK-041, RSK-055 |
| Tagged `regulatory` | RSK-001, RSK-011, RSK-016, RSK-028, RSK-029, RSK-030, RSK-045, RSK-046, RSK-047, RSK-057, RSK-065 |
| Tagged `single-source` | RSK-005, RSK-038 |
| Tagged `software` | RSK-002, RSK-006, RSK-007, RSK-009, RSK-016, RSK-017, RSK-024, RSK-028, RSK-032, RSK-033, RSK-037, RSK-041, RSK-042, RSK-046, RSK-051, RSK-056 |

## Risk status measures by review

Technical risk status measurements (SE HB 6.4.1.1) computed from the history entries: for each review point, the risks active at it with the band of their last assessment at or before it, the risks opened, closed or retired and accepted at it, and, for the latest review point only, the open mitigation steps due at the gate it prepares (Pre-SRR prepares SRR) and those due at an earlier gate (overdue). n/r = not recorded: step status is kept for the current assessment only. The review package plots this table under `docs/reviews/<REVIEW>/figures/`.

| Review | Active | Red | Yellow | Green | Opened | Closed or retired | Accepted | Open steps due at the gate prepared | Open steps overdue |
|---|---|---|---|---|---|---|---|---|---|
| Pre-SRR | 34 | 20 | 12 | 2 | 34 | 0 | 0 | n/r | n/r |
| SRR | 65 | 32 | 25 | 8 | 31 | 0 | 1 | 0 | 0 |

## 5x5 matrix (active risks)

Cell label: band letter (R = Red, Y = Yellow, G = Green) and likelihood x consequence. A risk sits in the cell of its likelihood and its maximum consequence dimension. Risks with safety consequence 5 and likelihood 2 or more are Red regardless of the cell band (safety override) and are marked "(R by safety override)" in their cell.

| Likelihood \ Consequence | 1 Negligible | 2 Minor | 3 Moderate | 4 Major | 5 Critical |
|---|---|---|---|---|---|
| **5 Near certain** | Y (5) | Y (10) | R (15) | R (20) | R (25) |
| **4 Likely** | G (4) | Y (8)<br>RSK-023<br>RSK-041 | R (12)<br>RSK-003<br>RSK-038<br>RSK-039<br>RSK-040<br>RSK-043<br>RSK-048<br>RSK-052<br>RSK-063 | R (16)<br>RSK-002<br>RSK-014<br>RSK-025<br>RSK-046 | R (20)<br>RSK-007<br>RSK-008 |
| **3 Possible** | G (3) | Y (6)<br>RSK-009<br>RSK-019<br>RSK-021<br>RSK-051<br>RSK-054<br>RSK-064 | Y (9)<br>RSK-010<br>RSK-013<br>RSK-018<br>RSK-031<br>RSK-032<br>RSK-033<br>RSK-035<br>RSK-036<br>RSK-037<br>RSK-044<br>RSK-050<br>RSK-053<br>RSK-055<br>RSK-056<br>RSK-059 | R (12)<br>RSK-001<br>RSK-004<br>RSK-005<br>RSK-006<br>RSK-011<br>RSK-012<br>RSK-016<br>RSK-017<br>RSK-024<br>RSK-026<br>RSK-027<br>RSK-028<br>RSK-029<br>RSK-045<br>RSK-047<br>RSK-049<br>RSK-058 | R (15) |
| **2 Unlikely** | G (2) | G (4)<br>RSK-030<br>RSK-042<br>RSK-057 | Y (6)<br>RSK-020 | Y (8)<br>RSK-015 | Y (10)<br>RSK-034 (R by safety override) |
| **1 Very unlikely** | G (1) | G (2) | G (3) | G (4)<br>RSK-022<br>RSK-060<br>RSK-061<br>RSK-062<br>RSK-065 | Y (5) |

## Ranked list (active risks)

Sorted by band; within a band, risks with safety consequence 5 first (the safety override of process section 7), then by score, safety consequence, likelihood and id.

| Rank | ID | Title | Category | L | C (driving dimension) | Score | Band | Status | Trend | Owner | Next step |
|---|---|---|---|---|---|---|---|---|---|---|---|
| 1 | [RSK-007](#rsk-007) | Li-ion cell thermal event inside the enclosure | safety | 4 | 5 (Safety) | 20 | Red | Mitigating | Stable | Claude | S2 by PDR |
| 2 | [RSK-034](#rsk-034) | Bench fire or treatable burn during owner hand assembly | safety | 2 | 5 (Safety) | 10 | Red (safety override) | Open | Stable | Claude | S1 by PDR |
| 3 | [RSK-008](#rsk-008) | First power-on fails and a second board spin is required | technical | 4 | 5 (First power-on) | 20 | Red | Mitigating | Stable | Claude | S1 by PDR |
| 4 | [RSK-046](#rsk-046) | Transmission outside the 144.000 to 148.000 MHz band | safety | 4 | 4 (Safety, Performance margin) | 16 | Red | Mitigating | Stable | Claude | S2 by PDR |
| 5 | [RSK-025](#rsk-025) | Antenna port retention fails under the whip side load | technical | 4 | 4 (First power-on) | 16 | Red | Open | Stable | Claude | S3 by PDR |
| 6 | [RSK-014](#rsk-014) | Expedited gate schedule releases procurement with unreviewed products | schedule | 4 | 4 (First power-on, Cost, Schedule) | 16 | Red | Open | Stable | Robin | S4 by PDR |
| 7 | [RSK-002](#rsk-002) | LO frequency error exceeds the 500 Hz CW filter half-bandwidth | technical | 4 | 4 (Performance margin) | 16 | Red | Open | Stable | Claude | S1 by PDR |
| 8 | [RSK-001](#rsk-001) | PA oscillation or spurious output above simulation at 146 MHz | technical | 3 | 4 (Safety, First power-on, Cost, Schedule, Performance margin) | 12 | Red | Open | Stable | Claude | S1 by PDR |
| 9 | [RSK-006](#rsk-006) | PA junction temperature exceeds the device rating at 5 W | technical | 3 | 4 (Safety, Performance margin) | 12 | Red | Open | Stable | Claude | S1 by PDR |
| 10 | [RSK-011](#rsk-011) | Spurious emissions not credibly measured before on-air use | technical | 3 | 4 (Safety, Performance margin) | 12 | Red | Open | Stable | Robin | S1 by PDR |
| 11 | [RSK-016](#rsk-016) | RF exposure controls not achieved or verified before on-air use | safety | 3 | 4 (Safety, Performance margin) | 12 | Red | Mitigating | Stable | Claude | S1 by PDR |
| 12 | [RSK-017](#rsk-017) | Headphone output limiting fails to bound the sound level | safety | 3 | 4 (Safety) | 12 | Red | Open | Stable | Claude | S2 by PDR |
| 13 | [RSK-024](#rsk-024) | Transmitter keyed without operator intent or held on | safety | 3 | 4 (Safety) | 12 | Red | Open | Stable | Claude | S1 by PDR |
| 14 | [RSK-026](#rsk-026) | Enclosure hand-hold surface exceeds 48 C during sustained keying | safety | 3 | 4 (Safety) | 12 | Red | Open | Stable | Claude | S1 by PDR |
| 15 | [RSK-003](#rsk-003) | RP2350 emulator mis-models a peripheral or cannot boot the image | software | 4 | 3 (First power-on, Schedule) | 12 | Red | Open | Stable | Claude | S1 by PDR |
| 16 | [RSK-063](#rsk-063) | Host mock diverges from RP2350 behaviour on a credited HostUnit case | software | 4 | 3 (Schedule) | 12 | Red | Open | Stable | Claude | S1 by PDR |
| 17 | [RSK-004](#rsk-004) | Turnkey assembly defects on RF and fine-pitch parts | technical | 3 | 4 (First power-on) | 12 | Red | Open | Stable | Claude | S1 by PDR |
| 18 | [RSK-047](#rsk-047) | PA over-power at full pack voltage exceeds downstream ratings | technical | 3 | 4 (Performance margin) | 12 | Red | Open | Stable | Claude | S1 by PDR |
| 19 | [RSK-038](#rsk-038) | Catalog parts out of stock or end-of-life at the CDR order | programmatic | 4 | 3 (Schedule) | 12 | Red | Open | Stable | Robin | S2 by PDR |
| 20 | [RSK-039](#rsk-039) | Headphone or key input damaged by a mono plug, cross-plugging or ESD | technical | 4 | 3 (First power-on, Cost, Schedule, Performance margin) | 12 | Red | Open | Stable | Claude | S1 by PDR |
| 21 | [RSK-040](#rsk-040) | Internally generated spurs and switching noise desensitize the receiver | technical | 4 | 3 (First power-on, Schedule, Performance margin) | 12 | Red | Open | Stable | Claude | S1 by PDR |
| 22 | [RSK-043](#rsk-043) | PCB, part and enclosure geometry mismatch at first assembly | technical | 4 | 3 (First power-on, Cost, Schedule) | 12 | Red | Open | Stable | Claude | S2 by PDR |
| 23 | [RSK-048](#rsk-048) | Receiver front end damaged by transmit leakage or a T/R fault | technical | 4 | 3 (First power-on, Cost, Schedule, Performance margin) | 12 | Red | Open | Stable | Claude | S1 by PDR |
| 24 | [RSK-052](#rsk-052) | Fabrication and assembly cost above the cost model | cost | 4 | 3 (Cost) | 12 | Red | Open | Stable | Robin | S1 by PDR |
| 25 | [RSK-005](#rsk-005) | Single-source RF power device or synthesizer unavailable at order time | programmatic | 3 | 4 (Schedule) | 12 | Red | Open | Stable | Robin | S1 by PDR |
| 26 | [RSK-012](#rsk-012) | Keyer function or feel unusable on the built radio | software | 3 | 4 (Performance margin) | 12 | Red | Mitigating | Stable | Claude | S1 by PDR |
| 27 | [RSK-027](#rsk-027) | PA output power below the 5 W requirement | technical | 3 | 4 (Performance margin) | 12 | Red | Open | Stable | Claude | S1 by PDR |
| 28 | [RSK-028](#rsk-028) | Unlicensed person transmits on a loaned or unattended unit | programmatic | 3 | 4 (Performance margin) | 12 | Red | Mitigating | Stable | Claude | S1 by PDR |
| 29 | [RSK-029](#rsk-029) | Cited regulatory text or FCC guidance changes unnoticed before on-air use | programmatic | 3 | 4 (Performance margin) | 12 | Red | Open | Stable | Claude | S2 by PDR |
| 30 | [RSK-045](#rsk-045) | Keying sidebands exceed the bandwidth limit or cannot be shown compliant | technical | 3 | 4 (Performance margin) | 12 | Red | Open | Stable | Claude | S1 by PDR |
| 31 | [RSK-049](#rsk-049) | Board design automation silently corrupts the fabrication data | process | 3 | 4 (First power-on, Cost, Schedule) | 12 | Red | Open | Stable | Claude | S1 by PDR |
| 32 | [RSK-058](#rsk-058) | Receive power draw above its allocation erodes the battery-life margin | technical | 3 | 4 (Performance margin) | 12 | Red | Open | Stable | Claude | S1 by PDR |
| 33 | [RSK-010](#rsk-010) | Manual MC/DC evidence misses a latent decision fault in safety-critical firmware | software | 3 | 3 (Safety) | 9 | Yellow | Open | Stable | Claude | S1 by PDR |
| 34 | [RSK-018](#rsk-018) | Machined enclosure arrives with sharp edges or pinch points | safety | 3 | 3 (Safety, Cost, Schedule) | 9 | Yellow | Open | Stable | Claude | S4 by PDR |
| 35 | [RSK-033](#rsk-033) | Pico 2 USB power path overheats at the charging current | safety | 3 | 3 (Safety, Performance margin) | 9 | Yellow | Open | Stable | Claude | S1 by PDR |
| 36 | [RSK-013](#rsk-013) | rustos driver work packages not demonstrated on hardware before CDR | software | 3 | 3 (First power-on, Schedule) | 9 | Yellow | Mitigating | Stable | Claude | S2 by PDR |
| 37 | [RSK-056](#rsk-056) | RP2350 ADC accuracy too low for battery sensing and the dual-path check | technical | 3 | 3 (Performance margin) | 9 | Yellow | Open | Stable | Claude | S1 by PDR |
| 38 | [RSK-031](#rsk-031) | PA damaged by a detuned or mismatched antenna | technical | 3 | 3 (First power-on, Cost, Schedule, Performance margin) | 9 | Yellow | Open | Stable | Claude | S1 by PDR |
| 39 | [RSK-032](#rsk-032) | PWM audio noise masks weak CW signals | technical | 3 | 3 (First power-on, Performance margin) | 9 | Yellow | Open | Stable | Claude | S1 by CDR |
| 40 | [RSK-035](#rsk-035) | Synthesizer phase noise limits reciprocal-mixing dynamic range | technical | 3 | 3 (Schedule, Performance margin) | 9 | Yellow | Open | Stable | Claude | S1 by PDR |
| 41 | [RSK-036](#rsk-036) | Crystal filter bandwidth or loss out of tolerance across units | technical | 3 | 3 (First power-on, Schedule, Performance margin) | 9 | Yellow | Open | Stable | Claude | S1 by PDR |
| 42 | [RSK-037](#rsk-037) | RP2350 ADC noise degrades receive audio | technical | 3 | 3 (Schedule, Performance margin) | 9 | Yellow | Open | Stable | Claude | S1 by PDR |
| 43 | [RSK-044](#rsk-044) | Enclosure CAD pipeline yields a STEP unfit for machining | technical | 3 | 3 (Cost, Schedule) | 9 | Yellow | Open | Stable | Claude | S1 by PDR |
| 44 | [RSK-050](#rsk-050) | LTspice batch toolchain fails, hangs or lags upstream fixes | process | 3 | 3 (Schedule) | 9 | Yellow | Open | Stable | Claude | S1 by PDR |
| 45 | [RSK-053](#rsk-053) | Vendor lead time and holiday closures delay the build | schedule | 3 | 3 (Schedule) | 9 | Yellow | Open | Stable | Robin | S1 by CDR |
| 46 | [RSK-055](#rsk-055) | Charge time from a 500 mA USB supply above 12 h or unacceptable to operators | technical | 3 | 3 (Performance margin) | 9 | Yellow | Open | Stable | Claude | S1 by PDR |
| 47 | [RSK-059](#rsk-059) | No qualification testing at the environmental extremes | technical | 3 | 3 (Performance margin) | 9 | Yellow | Open | Stable | Claude | S1 by PDR |
| 48 | [RSK-015](#rsk-015) | Wrong or corrupt firmware image or configuration accepted at boot | software | 2 | 4 (Safety, Performance margin) | 8 | Yellow | Mitigating | Stable | Claude | S2 by PDR |
| 49 | [RSK-023](#rsk-023) | rustos upstream change breaks cwht firmware undetected | software | 4 | 2 (Safety, First power-on, Schedule, Performance margin) | 8 | Yellow | Open | Stable | Claude | S2 by PDR |
| 50 | [RSK-041](#rsk-041) | Audible clicks when the synthesizer is retuned | technical | 4 | 2 (Schedule, Performance margin) | 8 | Yellow | Open | Stable | Claude | S1 by PDR |
| 51 | [RSK-020](#rsk-020) | Upstream rustc miscompiles a safety-critical construct for Cortex-M33 | software | 2 | 3 (Safety) | 6 | Yellow | Open | Stable | Claude | S1 by PDR |
| 52 | [RSK-019](#rsk-019) | Complexity tool mis-measures cyclomatic complexity of Rust 2024 code | software | 3 | 2 (Safety, Schedule, Performance margin) | 6 | Yellow | Open | Stable | Claude | S1 by CDR |
| 53 | [RSK-021](#rsk-021) | Flash write hangs or corrupts configuration while XIP is disabled | software | 3 | 2 (Safety, First power-on, Schedule, Performance margin) | 6 | Yellow | Open | Stable | Claude | S1 by CDR |
| 54 | [RSK-009](#rsk-009) | SWEHB corpus incomplete or garbled for applicable SWE rows | process | 3 | 2 (First power-on, Schedule) | 6 | Yellow | Mitigating | Stable | Claude | S2 by PDR |
| 55 | [RSK-051](#rsk-051) | Bench timing evidence blocked by the logic-capture tooling | process | 3 | 2 (Schedule, Performance margin) | 6 | Yellow | Open | Stable | Claude | S1 by PDR |
| 56 | [RSK-054](#rsk-054) | 50 ohm lines off their impedance target | technical | 3 | 2 (First power-on, Performance margin) | 6 | Yellow | Open | Stable | Claude | S1 by CDR |
| 57 | [RSK-064](#rsk-064) | Open or cold owner-soldered joint in a power path | technical | 3 | 2 (First power-on) | 6 | Yellow | Open | Stable | Claude | S1 by PDR |
| 58 | [RSK-062](#rsk-062) | Compromised toolchain or dependency inserts code into the image | software | 1 | 4 (Performance margin) | 4 | Green | Open | Stable | Claude | S1 by PDR |
| 59 | [RSK-030](#rsk-030) | SAR by analogy understates the actual SAR of cwht | safety | 2 | 2 (Safety, Schedule, Performance margin) | 4 | Green | Accepted | Stable | Claude | S2 by PDR |
| 60 | [RSK-022](#rsk-022) | SWD debug port used to extract or modify firmware | software | 1 | 4 (Performance margin) | 4 | Green | Open | Stable | Claude | S1 by PDR |
| 61 | [RSK-060](#rsk-060) | Crafted key or control input changes radio state or configuration | software | 1 | 4 (Performance margin) | 4 | Green | Open | Stable | Claude | S1 by PDR |
| 62 | [RSK-061](#rsk-061) | Command injected on the diagnostic interface changes configuration | software | 1 | 4 (Performance margin) | 4 | Green | Open | Stable | Claude | S1 by PDR |
| 63 | [RSK-042](#rsk-042) | Pico 2 silicon stepping differs from the design assumption | technical | 2 | 2 (First power-on, Schedule, Performance margin) | 4 | Green | Open | Stable | Claude | S1 by CDR |
| 64 | [RSK-057](#rsk-057) | Compliant harmonics interfere with nearby 70 cm stations | programmatic | 2 | 2 (Performance margin) | 4 | Green | Open | Stable | Claude | S1 by SAR |
| 65 | [RSK-065](#rsk-065) | Lending cwht units treated as outside the 15.23 personal-use exemption | programmatic | 1 | 4 (Performance margin) | 4 | Green | Open | Stable | Claude | S1 by CDR |

## Candidate risk dispositions

Candidate risks named in other artifacts and their disposition (process section 9, Identify).

| Candidate | Named in | Summary | Disposition | Risk | Rationale | Date |
|---|---|---|---|---|---|---|
| ADR002-R1 | `docs/decisions/adr/ADR-002-2m-only-rev-a-70cm-ready.md section 4.4` | 70 cm-ready provisions grow rev A scope without a rev B commitment | Declined | none | Controlled by the decision itself: ADR-002 makes every 70 cm provision an enhancing criterion that cannot displace a 2 m requirement, and board area is tracked by TPM-009, whose red status opens a risk under the tpm.json conventions. Re-opens if a 70 cm provision becomes a mandatory criterion or TPM-009 leaves green. | 2026-09-25 |
| ADR004-R1 | `docs/decisions/adr/ADR-004-pico2-module-micro-usb.md section 4.4` | Pico 2 module VBUS path unrated above 500 mA | Merged | [RSK-033](#rsk-033) | Same departure as R-PWR-01, which entered RSK-033; the VBUS path rating is its condition. | 2026-09-25 |
| ADR007-R1 | `docs/decisions/adr/ADR-007-pcbway-turnkey-smt-kit-model.md section 4.4` | Owner-soldered joint defect in a power path | Entered | [RSK-064](#rsk-064) | n/a | 2026-09-25 |
| ADR008-R1 | `docs/decisions/adr/ADR-008-openscad-freecad-step-pcbway-cnc.md section 4.4` | FreeCAD import fidelity degrades silently on a forbidden construct | Merged | [RSK-044](#rsk-044) | Same departure as ENC-R4 in RSK-044 (mesh-derived STEP); the acceptance checks are its steps. | 2026-09-25 |
| ADR008-R2 | `docs/decisions/adr/ADR-008-openscad-freecad-step-pcbway-cnc.md section 4.4` | Tolerance statements conflict between PCBWay pages | Merged | [RSK-043](#rsk-043) | Same departure as ENC-R2 in RSK-043 (geometry mismatch at first assembly); explicit callouts are its step. | 2026-09-25 |
| ADR008-R3 | `docs/decisions/adr/ADR-008-openscad-freecad-step-pcbway-cnc.md section 4.4` | OpenSCAD toolchain age and snapshot behaviour change | Merged | [RSK-044](#rsk-044) | Same departure as ENC-R5 in RSK-044; pinning the exact build is its step. | 2026-09-25 |
| ADR010-R1 | `docs/decisions/adr/ADR-010-semi-break-in-only.md section 4.4 (carried over by ADR-026 section 4.4)` | Relay lifecycle and stock unverified | Merged | [RSK-038](#rsk-038) | Same departure as TR-R10 in RSK-038 (a BOM line end-of-life or out of stock at the CDR order). | 2026-09-25 |
| ADR010-R2 | `docs/decisions/adr/ADR-010-semi-break-in-only.md section 4.4 (carried over by ADR-026 section 4.4)` | Audible relay click accepted by the owner but disliked by friends | Declined | none | Not a departure against a requirement: the owner accepted the relay click with semi break-in (ADR-010, ADR-026, SI-036). Re-opens if an owner or friend validation session records the click as unacceptable. | 2026-09-25 |
| ADR011-R1 | `docs/decisions/adr/ADR-011-host-first-software-verification.md section 4.4` | Host mock diverges from silicon behaviour | Entered | [RSK-063](#rsk-063) | n/a | 2026-09-25 |
| ADR012-R1 | `docs/decisions/adr/ADR-012-pa-device-sourcing-constraint.md section 4.4` | No stocked PA device has vendor VHF harmonic data | Merged | [RSK-001](#rsk-001) | A cause already in the RSK-001 condition (device models unconfirmed at 144 to 148 MHz); the behavioural model and tinySA measurement are its steps. | 2026-09-25 |
| ADR017-R1 | `docs/decisions/adr/ADR-017-open-source-mit.md section 4.4` | Publishing an EOL PA baseline makes the open design unbuildable by others | Declined | none | Not a departure against a stakeholder expectation: the NGOs cover the owner's units and the friend units (SI-019), not third-party builds, and ADR-012 documents the substitution path. Re-opens if the owner adds third-party buildability as a goal. | 2026-09-25 |
| ADR020-R1 | `docs/decisions/adr/ADR-020-battery-life-target.md section 4.4` | Usable capacity assumption is Low confidence; 30Q curve not digitised | Merged | [RSK-058](#rsk-058) | The capacity side of the same battery-life departure (less than 8 h at 1:9); RSK-058 adds the step to digitise the curve at PDR. | 2026-09-25 |
| ADR021-R1 | `docs/decisions/adr/ADR-021-tinysa-ultra-purchase.md section 4.4` | tinySA RBW too coarse for the band-edge measurement | Merged | [RSK-046](#rsk-046) | A cause of an undetected band-edge departure in RSK-046; its S4 now verifies the RBW on receipt before the band-edge measurement. | 2026-09-25 |
| ADR025-R1 | `docs/decisions/adr/ADR-025-build-quantity-cap.md section 4.4 (also ADR-017 section 4.4)` | The 15.23 personal-use reading for lent units is Low confidence | Entered | [RSK-065](#rsk-065) | n/a | 2026-09-25 |
| SEP16-SUPPLY | `docs/process/07-software-engineering-plan.md section 16.2 (row 'Build and supply chain')` | Compromised toolchain or dependency inserts code into the image | Entered | [RSK-062](#rsk-062) | n/a | 2026-09-25 |
| SEP16-DBG | `docs/process/07-software-engineering-plan.md section 16.2 (row 'Debug access')` | Firmware extraction or modification through SWD | Entered | [RSK-022](#rsk-022) | n/a | 2026-09-25 |
| SEP16-DIAG | `docs/process/07-software-engineering-plan.md section 16.2 (row 'Diagnostic interface')` | Command injection on the diagnostic interface | Entered | [RSK-061](#rsk-061) | n/a | 2026-09-25 |
| SEP16-IMG | `docs/process/07-software-engineering-plan.md section 16.2 (row 'Firmware image integrity')` | Tampered or wrong firmware image loaded over USB | Entered | [RSK-015](#rsk-015) | n/a | 2026-09-25 |
| SEP16-KEY | `docs/process/07-software-engineering-plan.md section 16.2 (row 'Keying and control inputs')` | Command injection through the key line and controls | Entered | [RSK-060](#rsk-060) | n/a | 2026-09-25 |
| SEP16-CFG | `docs/process/07-software-engineering-plan.md section 16.2 (row 'Persisted configuration and calibration')` | Corrupted or maliciously written configuration values | Entered | [RSK-015](#rsk-015) | n/a | 2026-09-25 |
| SEP21-CPLX | `docs/process/07-software-engineering-plan.md section 21 (row 'Complexity tool staleness')` | Complexity tool mis-parses Rust 2024 code | Entered | [RSK-019](#rsk-019) | n/a | 2026-09-25 |
| SEP21-EMU | `docs/process/07-software-engineering-plan.md section 21 (row 'Emulator fidelity')` | Emulator mis-models a peripheral | Entered | [RSK-003](#rsk-003) | n/a | 2026-09-25 |
| SEP21-FLASH | `docs/process/07-software-engineering-plan.md section 21 (row 'Flash write path')` | Flash write with XIP disabled hangs | Entered | [RSK-021](#rsk-021) | n/a | 2026-09-25 |
| SEP21-MOCK | `docs/process/07-software-engineering-plan.md section 21 (row 'Host mock diverges from silicon')` | HostUnit-credited behaviour differs on the RP2350 | Entered | [RSK-063](#rsk-063) | n/a | 2026-09-25 |
| SEP21-MCDC | `docs/process/07-software-engineering-plan.md section 21 (row 'MC/DC tooling gap')` | Manual MC/DC evidence misses a decision fault | Entered | [RSK-010](#rsk-010) | n/a | 2026-09-25 |
| SEP21-MAINT | `docs/process/07-software-engineering-plan.md section 21 (row 'Single maintainer of rustos')` | rustos core change breaks cwht | Entered | [RSK-023](#rsk-023) | n/a | 2026-09-25 |
| SEP21-TOOL | `docs/process/07-software-engineering-plan.md section 21 (row 'Toolchain not qualified')` | Upstream rustc has no safety qualification | Entered | [RSK-020](#rsk-020) | n/a | 2026-09-25 |
| SEP21-IMG | `docs/process/07-software-engineering-plan.md section 21 (row 'Wrong image or configuration accepted')` | Corrupt or wrong image or configuration accepted at boot | Entered | [RSK-015](#rsk-015) | n/a | 2026-09-25 |
| SEP21-DRV | `docs/process/07-software-engineering-plan.md section 21 (row 'rustos driver effort')` | Thirteen rustos work packages not done in time | Entered | [RSK-013](#rsk-013) | n/a | 2026-09-25 |
| REFDES-10 | `docs/research/2m-cw-transceiver-reference-designs.md (Implications, RISK-candidate 10)` | Hand-matched crystal ladders are incompatible with turnkey assembly | Entered | [RSK-036](#rsk-036) | n/a | 2026-09-25 |
| REFDES-11 | `docs/research/2m-cw-transceiver-reference-designs.md (Implications, RISK-candidate 11)` | Small-signal PIN diodes cannot carry 5 W as the series element | Declined | none | Condition removed: SI-036 and ADR-010 fix semi break-in and the concept baselines a sequenced RF relay, so no PIN diode carries transmit power. Re-opens if the PDR T/R trade selects a PIN element. | 2026-09-25 |
| REFDES-12 | `docs/research/2m-cw-transceiver-reference-designs.md (Implications, RISK-candidate 12)` | Receiver input needs at most 1 mW and at least 37 dB isolation plus a limiter at 5 W | Entered | [RSK-048](#rsk-048) | n/a | 2026-09-25 |
| REFDES-6 | `docs/research/2m-cw-transceiver-reference-designs.md (Implications, RISK-candidate 6)` | AFT05MS006N PA family end-of-life with volatile distributor stock | Merged | [RSK-005](#rsk-005) | Same departure as RSK-005 (PA device unavailable at order time); SI-028 and the follow-up report drop AFT05MS006N, and RSK-005 covers the successor device. Re-opens if AFT05MS006N returns to the candidate list. | 2026-09-25 |
| REFDES-7 | `docs/research/2m-cw-transceiver-reference-designs.md (Implications, RISK-candidate 7)` | No vendor 144 MHz reference PCB; the PA match is designed and verified in-house | Merged | [RSK-001](#rsk-001) | Same asset and plan as RSK-001 (PA behaviour differs from its unvalidated model); the PD54008L-E baseline has a vendor board, and RSK-001 S1 and S5 carry the model and match validation. | 2026-09-25 |
| REFDES-8 | `docs/research/2m-cw-transceiver-reference-designs.md (Implications, RISK-candidate 8)` | Output power droops to about 3.3 W at 6.0 V without regulation | Merged | [RSK-027](#rsk-027) | The low-voltage shortfall is the RSK-027 departure (PA output below 5 W); the high-voltage excess is RSK-047 (entered from PADEV-11). | 2026-09-25 |
| REFDES-9 | `docs/research/2m-cw-transceiver-reference-designs.md (Implications, RISK-candidate 9)` | Si5351 phase noise at VHF bounds reciprocal mixing to about 85 dB | Entered | [RSK-035](#rsk-035) | n/a | 2026-09-25 |
| ANT-R5 | `docs/research/antenna-and-erp.md (Risks)` | Exposure evaluation over-credits antenna loss by using measured ERP | Merged | [RSK-016](#rsk-016) | A cause of the RSK-016 departure (exposure evaluation not achieved or verified); RSK-016 S1 keeps the 0 dBd bound for the handheld posture. | 2026-09-25 |
| ANT-R6 | `docs/research/antenna-and-erp.md (Risks)` | Tolerance stack of a PCB-mount bulkhead SMA jack | Entered | [RSK-043](#rsk-043) | n/a | 2026-09-25 |
| ANT-R1 | `docs/research/antenna-and-erp.md (Risks), named in docs/conops/conops.md section 8` | Connector or PCB damage from the antenna moment | Merged | [RSK-025](#rsk-025) | RSK-025 (split from RSK-018 the same day) is this departure and carries HZ-009. | 2026-09-25 |
| ANT-R2 | `docs/research/antenna-and-erp.md (Risks), named in docs/conops/conops.md section 8` | PA damage into a detuned or counterfeit antenna | Entered | [RSK-031](#rsk-031) | n/a | 2026-09-25 |
| ANT-R3 | `docs/research/antenna-and-erp.md (Risks), named in docs/conops/conops.md section 8` | Table-top posture loses about 10 dB without a counterpoise | Declined | none | A known property of the reference quarter-wave whip without a counterpoise, not an uncertain event: it is designed for by the counterpoise attachment point (HZ-009 K4) and the ConOps posture guidance (section 3.6), and its effect on range is verified through the contact-range MOE. Re-open as a risk if the PDR requirements drop the counterpoise attachment. | 2026-09-25 |
| ANT-R4 | `docs/research/antenna-and-erp.md (Risks), named in docs/conops/conops.md section 8` | RF on the headphone and key leads | Merged | [RSK-024](#rsk-024) | False keyer input from RF on the key lead is a cause of RSK-024 (HZ-010 K4 and K6 in steps S2 and S4); the audio thump on the headphone lead is a click cause bounded by the RSK-017 limiter and fade controls. | 2026-09-25 |
| R-AUD-2 | `docs/research/audio-output-and-hearing-safety.md (Risks)` | RP2350 ADC noise in the audio path of an analog superhet | Entered | [RSK-037](#rsk-037) | n/a | 2026-09-25 |
| R-AUD-4 | `docs/research/audio-output-and-hearing-safety.md (Risks)` | Audio part availability unverified at distributors | Entered | [RSK-038](#rsk-038) | n/a | 2026-09-25 |
| R-AUD-5 | `docs/research/audio-output-and-hearing-safety.md (Risks)` | Mono plug shorts a headphone channel; amplifier behaviour unquantified | Entered | [RSK-039](#rsk-039) | n/a | 2026-09-25 |
| R-AUD-6 | `docs/research/audio-output-and-hearing-safety.md (Risks)` | Tuning clicks from synthesizer resets on frequency writes | Entered | [RSK-041](#rsk-041) | n/a | 2026-09-25 |
| R-AUD-1 | `docs/research/audio-output-and-hearing-safety.md (Risks), named in docs/conops/conops.md section 8` | PWM audio noise and coupling | Entered | [RSK-032](#rsk-032) | n/a | 2026-09-25 |
| R-AUD-3 | `docs/research/audio-output-and-hearing-safety.md (Risks), named in docs/conops/conops.md section 8` | Earbuds up to 5 dB louder than the EN 50332-2 model | Merged | [RSK-017](#rsk-017) | Same departure as RSK-017 (the level not bounded for the most sensitive earbud); RSK-017 S1 includes the 5 dB excess in the worst-case SPL. | 2026-09-25 |
| CWSEL-10 | `docs/research/cw-selectivity-options.md (Implications, RISK-candidate 10)` | Candidate B firmware scope: PIO, DMA and I2S drivers plus DSP | Merged | [RSK-013](#rsk-013) | Same departure as RSK-013 (a needed rustos driver not demonstrated on hardware by CDR); the PIO I2S loopback prototype is added to RSK-013. | 2026-09-25 |
| CWSEL-11 | `docs/research/cw-selectivity-options.md (Implications, RISK-candidate 11)` | Lot-to-lot motional capacitance moves a ladder bandwidth by 20 % | Entered | [RSK-036](#rsk-036) | n/a | 2026-09-25 |
| CWSEL-6 | `docs/research/cw-selectivity-options.md (Implications, RISK-candidate 6)` | 500 Hz ladder from catalog crystals has 14.5 to 51 % yield | Entered | [RSK-036](#rsk-036) | n/a | 2026-09-25 |
| CWSEL-7 | `docs/research/cw-selectivity-options.md (Implications, RISK-candidate 7)` | Commercial crystal filter supply single-source and quote-only | Entered | [RSK-038](#rsk-038) | n/a | 2026-09-25 |
| CWSEL-8 | `docs/research/cw-selectivity-options.md (Implications, RISK-candidate 8)` | RP2350 ADC too noisy as the audio sampler | Entered | [RSK-037](#rsk-037) | n/a | 2026-09-25 |
| CWSEL-9 | `docs/research/cw-selectivity-options.md (Implications, RISK-candidate 9)` | Codec availability: PCM1808 out of stock at TI, WM8960 end-of-life | Entered | [RSK-038](#rsk-038) | n/a | 2026-09-25 |
| R-UI-01 | `docs/research/display-and-ui-parts.md (Risk candidates)` | 12 MHz and 48 MHz harmonics land exactly on 144.000 MHz | Entered | [RSK-040](#rsk-040) | n/a | 2026-09-25 |
| R-UI-02 | `docs/research/display-and-ui-parts.md (Risk candidates)` | OLED or TFT switching noise near a -140 dBm receiver | Declined | none | Condition not present: the baseline is the Sharp memory LCD with no on-module converter (D-UI-01, concept section 11.1 rejects OLED and TFT). Re-opens if an OLED or TFT is proposed. | 2026-09-25 |
| R-UI-04 | `docs/research/display-and-ui-parts.md (Risk candidates)` | Sharp documents disagree on the operating temperature range | Declined | none | Both Sharp figures (-10 to +60 C and -20 to +70 C) cover the proposed -10 to +45 C operating span of REQ-SYS-114, so no requirement depends on the conflict. Re-opens if the owner sets an operating floor below -10 C. | 2026-09-25 |
| R-UI-05 | `docs/research/display-and-ui-parts.md (Risk candidates)` | ZIF contact side and FPC pinout orientation error on the first board | Entered | [RSK-043](#rsk-043) | n/a | 2026-09-25 |
| R-UI-06 | `docs/research/display-and-ui-parts.md (Risk candidates)` | Display and panel part stock not verified by machine | Entered | [RSK-038](#rsk-038) | n/a | 2026-09-25 |
| R-UI-07 | `docs/research/display-and-ui-parts.md (Risk candidates)` | Mono plug in the key jack grounds the ring; plug detect is not a safety | Merged | [RSK-024](#rsk-024) | Same departure as RSK-024 (keyed without operator intent); its interlock step S1 already treats plug detect as an enabler only. | 2026-09-25 |
| R-UI-08 | `docs/research/display-and-ui-parts.md (Risk candidates)` | Encoder bushing length versus PCB-to-panel distance | Entered | [RSK-043](#rsk-043) | n/a | 2026-09-25 |
| R-UI-09 | `docs/research/display-and-ui-parts.md (Risk candidates)` | Headphone amplifier charge pump as a conducted noise source | Entered | [RSK-040](#rsk-040) | n/a | 2026-09-25 |
| R-UI-03 | `docs/research/display-and-ui-parts.md (Risks), named in docs/conops/conops.md section 8` | Memory LCD unreadable in the dark | Declined | none | Not an uncertain event: revision A has no display light by design (D-UI-02 recommendation 'none in build 1'; the bezel keeps a front-light option), stated as an accepted limitation in the ConOps and decided by the owner on D-UI-02. Re-open as a risk if the owner makes night operation a requirement. | 2026-09-25 |
| EMUACC-R1 | `docs/research/emulator-accreditation-and-timer-irq.md (Implications, RISK-candidate 1)` | GPIO edge interrupts not modelled by the emulator | Merged | [RSK-003](#rsk-003) | A peripheral the emulator mis-models, the RSK-003 departure; RSK-003 S5 routes the key-input paths to HostUnit and Bench. | 2026-09-25 |
| EMUACC-R2 | `docs/research/emulator-accreditation-and-timer-irq.md (Implications, RISK-candidate 2)` | No NVIC priority model in the emulator | Merged | [RSK-003](#rsk-003) | Same RSK-003 family; mitigated by the single-priority design rule REQ-SYS-129. | 2026-09-25 |
| EMUACC-R3 | `docs/research/emulator-accreditation-and-timer-irq.md (Implications, RISK-candidate 3)` | Watchdog timeouts twice too short in the emulator model | Merged | [RSK-003](#rsk-003) | Same RSK-003 family; timeout values are Bench-verified and emulation checks only the feed path. | 2026-09-25 |
| EMUACC-R4 | `docs/research/emulator-accreditation-and-timer-irq.md (Implications, RISK-candidate 4)` | Emulator embeds the A2 bootrom while boards may be A3 or A4 | Merged | [RSK-003](#rsk-003) | Same RSK-003 family (emulator semantics differ from the delivered silicon); the stepping effect on hardware is RSK-042. | 2026-09-25 |
| ENC-R1 | `docs/research/enclosure-cnc-and-openscad-pipeline.md (Implications, RISK-candidate 1)` | Anodize colour and rack marks vary | Declined | none | Not a departure against any requirement: REQ-SYS-109 states material, anodize and conductive areas only, with no cosmetic criterion. Re-opens if the owner adds a cosmetic acceptance criterion. | 2026-09-25 |
| ENC-R2 | `docs/research/enclosure-cnc-and-openscad-pipeline.md (Implications, RISK-candidate 2)` | Conflicting PCBWay tolerance statements for mounting features | Entered | [RSK-043](#rsk-043) | n/a | 2026-09-25 |
| ENC-R3 | `docs/research/enclosure-cnc-and-openscad-pipeline.md (Implications, RISK-candidate 3)` | Small threads below M3 rejected or charged | Declined | none | Condition removed by the concept design rule of M3 minimum threads modelled as tap-drill pilots (docs/design/concept.md section 7.8). Re-opens if a thread below M3 appears in the CAD. | 2026-09-25 |
| ENC-R4 | `docs/research/enclosure-cnc-and-openscad-pipeline.md (Implications, RISK-candidate 4)` | FreeCAD import silently degrades hull, minkowski, text or resize | Entered | [RSK-044](#rsk-044) | n/a | 2026-09-25 |
| ENC-R5 | `docs/research/enclosure-cnc-and-openscad-pipeline.md (Implications, RISK-candidate 5)` | OpenSCAD 2021.01 toolchain age and snapshot behaviour changes | Entered | [RSK-044](#rsk-044) | n/a | 2026-09-25 |
| ENC-R6 | `docs/research/enclosure-cnc-and-openscad-pipeline.md (Implications, RISK-candidate 6)` | Headless H2C slicing fails; fit-check print needs a GUI step | Entered | [RSK-044](#rsk-044) | n/a | 2026-09-25 |
| R1 | `docs/research/keyer-and-key-interfaces.md (Risks), named in docs/conops/conops.md section 8` | Mono plug or stuck contact causes continuous transmission at power-on | Merged | [RSK-024](#rsk-024) | A cause of RSK-024 (HZ-004 C-causes and the K1, K2 controls in step S1). | 2026-09-25 |
| CTL-KEY-06-R | `docs/research/keyer-and-key-interfaces.md (section 4.1 implication 6, inline RISK-candidate)` | Identical jacks make cross-plugging of key and headphones likely | Entered | [RSK-039](#rsk-039) | n/a | 2026-09-25 |
| R2 | `docs/research/keyer-and-key-interfaces.md (section 4.4)` | RP2350-E9 on A2 silicon breaks designs relying on internal pulls | Entered | [RSK-042](#rsk-042) | n/a | 2026-09-25 |
| R3 | `docs/research/keyer-and-key-interfaces.md (section 4.4)` | RF pickup on the key cable produces phantom elements | Merged | [RSK-024](#rsk-024) | Same departure as RSK-024 (keyed without intent), which already carries HZ-010 and ANT-R4 key-lead pickup. | 2026-09-25 |
| R4 | `docs/research/keyer-and-key-interfaces.md (section 4.4)` | UI or radio tasks jitter keyer timing above 30 WPM | Merged | [RSK-012](#rsk-012) | A cause of the RSK-012 departure (keying incorrect on the built radio); timing from TIMER0 alarms independent of the UI loop is in its plan. | 2026-09-25 |
| R5 | `docs/research/keyer-and-key-interfaces.md (section 4.4)` | Iambic B behaviour varies with the switchpoint; habit mismatch | Merged | [RSK-012](#rsk-012) | Same RSK-012 family (keyer feel); the switchpoint is tunable and validated in the human-in-the-loop session. | 2026-09-25 |
| R6 | `docs/research/keyer-and-key-interfaces.md (section 4.4)` | Key clicks from a PA that does not follow the drive envelope | Entered | [RSK-045](#rsk-045) | n/a | 2026-09-25 |
| R7 | `docs/research/keyer-and-key-interfaces.md (section 4.4)` | ESD at the exposed key jack | Entered | [RSK-039](#rsk-039) | n/a | 2026-09-25 |
| R8 | `docs/research/keyer-and-key-interfaces.md (section 4.4)` | UI-style debounce swallows elements at speed | Merged | [RSK-012](#rsk-012) | Same RSK-012 family; the 2 ms close and 5 ms open debounce (REQ-SYS-048, REQ-SYS-162) are its requirement controls. | 2026-09-25 |
| R-KN1 | `docs/research/keyer-verification-and-key-input-network.md (RISK-candidate list)` | Cutoff monostable width depends on a ceramic capacitor's DC-bias derating | Merged | [RSK-024](#rsk-024) | A failure mode of the RSK-024 hardware cutoff control (HZ-004 single point failure row 1); a capacitor-selection and timing step is added to RSK-024. | 2026-09-25 |
| R-KN2 | `docs/research/keyer-verification-and-key-input-network.md (RISK-candidate list)` | sigrok-pico and sigrok-cli unverified on macOS | Entered | [RSK-051](#rsk-051) | n/a | 2026-09-25 |
| R-KN4 | `docs/research/keyer-verification-and-key-input-network.md (RISK-candidate list)` | Switchpoint and asymmetric debounce defaults are feel-dependent | Merged | [RSK-012](#rsk-012) | Same RSK-012 departure (keyer feel unpleasant); both defaults are exposed in the menu for the human-in-the-loop session. | 2026-09-25 |
| R-KN5 | `docs/research/keyer-verification-and-key-input-network.md (RISK-candidate list)` | Cutoff node depends on the PA topology chosen at PDR | Merged | [RSK-024](#rsk-024) | A failure mode of the RSK-024 cutoff control (single point failure row 2); the cutoff node becomes a criterion of the ALC and envelope study (TS-NNN) in RSK-024. | 2026-09-25 |
| R-KN6 | `docs/research/keyer-verification-and-key-input-network.md (RISK-candidate list)` | tinySA Ultra cannot verify the close-in keying sidebands | Entered | [RSK-045](#rsk-045) | n/a | 2026-09-25 |
| R-KN3 | `docs/research/keyer-verification-and-key-input-network.md, named in docs/conops/conops.md section 8` | Friends' keys may use mono plugs | Merged | [RSK-024](#rsk-024) | A cause of RSK-024; the plug check and KEY CLOSED message are step S5 (HZ-004 K10). | 2026-09-25 |
| LTS-R1 | `docs/research/ltspice-batch-macos.md (Implications, RISK-candidate 1)` | LTspice CrossOver bundle fragility and broken launcher path | Entered | [RSK-050](#rsk-050) | n/a | 2026-09-25 |
| LTS-R2 | `docs/research/ltspice-batch-macos.md (Implications, RISK-candidate 2)` | Hidden modal prompts can hang a batch run | Entered | [RSK-050](#rsk-050) | n/a | 2026-09-25 |
| LTS-R3 | `docs/research/ltspice-batch-macos.md (Implications, RISK-candidate 3)` | macOS LTspice version lags the Windows release | Entered | [RSK-050](#rsk-050) | n/a | 2026-09-25 |
| LTS-R4 | `docs/research/ltspice-batch-macos.md (Implications, RISK-candidate 4)` | Telemetry declined by an agent settings edit | Declined | none | Decided: the owner ratified the telemetry opt-out (SI-027, ADR-018 Accepted). Re-opens if an LTspice update re-enables telemetry, which the RC smoke test of RSK-050 checks through the CaptureAnalytics key. | 2026-09-25 |
| PADEV-10 | `docs/research/pa-device-candidates.md (Implications, RISK-candidate 10)` | Harmonic data from one lot and one vendor circuit | Merged | [RSK-001](#rsk-001) | Same RSK-001 departure (spurious output above prediction); the STEVAL-TDR003V1 data of the successor baseline is also single-board data. | 2026-09-25 |
| PADEV-11 | `docs/research/pa-device-candidates.md (Implications, RISK-candidate 11)` | 8.5 to 10 W at 8.4 V without ALC exceeds downstream ratings | Entered | [RSK-047](#rsk-047) | n/a | 2026-09-25 |
| PADEV-12 | `docs/research/pa-device-candidates.md (Implications, RISK-candidate 12)` | Export of consigned Mitsubishi parts to PCBWay | Declined | none | Condition removed: SI-028 forbids consignment-only PA parts and the baseline candidates are procured turnkey by PCBWay from DigiKey or Mouser. Re-opens if any part is consigned from the owner to PCBWay. | 2026-09-25 |
| PADEV-13 | `docs/research/pa-device-candidates.md (Implications, RISK-candidate 13)` | No vendor SPICE model; first power-on rests on an in-house model | Merged | [RSK-001](#rsk-001) | Same RSK-001 condition (models not validated); RSK-001 S5 validates the behavioural model against vendor data. | 2026-09-25 |
| PADEV-9 | `docs/research/pa-device-candidates.md (Implications, RISK-candidate 9)` | Mitsubishi baseline PA has no catalog stock and a 25-piece MOQ | Declined | none | Condition removed: SI-028 and ADR-012 exclude consignment-only PA devices and the follow-up report drops the Mitsubishi line. Re-opens only if the owner waives SI-028. | 2026-09-25 |
| PATK-10 | `docs/research/pa-turnkey-candidates-followup.md (Implications, RISK-candidate 10)` | PD54008L-E model is ADS-only | Merged | [RSK-001](#rsk-001) | Same RSK-001 condition; the behavioural LTspice model fitted to the STEVAL curves is added as an RSK-001 step. | 2026-09-25 |
| PATK-11 | `docs/research/pa-turnkey-candidates-followup.md (Implications, RISK-candidate 11)` | PowerFLAT package heat leaves only through the source pad | Merged | [RSK-006](#rsk-006) | Same RSK-006 departure (junction over-temperature); via fill and the pedestal are in its thermal interface step. | 2026-09-25 |
| PATK-12 | `docs/research/pa-turnkey-candidates-followup.md (Implications, RISK-candidate 12)` | GRF5604 fallback harmonics unpublished | Merged | [RSK-001](#rsk-001) | Same RSK-001 departure for the fallback device; the harmonic data request is part of the PA line-up study (TS-NNN) evidence. | 2026-09-25 |
| PATK-13 | `docs/research/pa-turnkey-candidates-followup.md (Implications, RISK-candidate 13)` | 12.5 V boost reserve path adds switching spurs | Declined | none | Condition not present: the 12.5 V boost is a reserve path not selected by the baseline or the fallback. Re-opens if TS-001 sub-decision P or the PA line-up study (TS-NNN) activates the reserve path. | 2026-09-25 |
| PATK-9 | `docs/research/pa-turnkey-candidates-followup.md (Implications, RISK-candidate 9)` | PD54008L-E is a 2007 part from a vendor with NRND VHF boards | Merged | [RSK-005](#rsk-005) | Same RSK-005 departure (PA device not recommended or end-of-life at order time); a lifetime-reserve step is added to RSK-005. | 2026-09-25 |
| REG-1 | `docs/research/part97-regulatory-basis.md (Risks)` | RF exposure method gap for VHF portables (SAR by analogy only) | Merged | [RSK-030](#rsk-030) | RFX-R1, already the source of RSK-030, sharpens REG-1; same departure (actual SAR above the analogy). | 2026-09-25 |
| REG-2 | `docs/research/part97-regulatory-basis.md (Risks)` | General-population SAR above the limit at 5 W for a non-licensee holder | Merged | [RSK-016](#rsk-016) | RFX-R2, already merged into RSK-016, sharpens REG-2; same departure (exposure controls not achieved). | 2026-09-25 |
| RF-1 | `docs/research/part97-regulatory-basis.md (Risks)` | LPF attenuation eroded by inductor self-resonance and layout leakage | Merged | [RSK-001](#rsk-001) | Same RSK-001 departure (harmonic levels above prediction); RSK-001 S3 simulates with vendor parasitic models. | 2026-09-25 |
| RF-2 | `docs/research/part97-regulatory-basis.md (Risks)` | Third harmonic lands in the 70 cm band | Entered | [RSK-057](#rsk-057) | n/a | 2026-09-25 |
| RF-3 | `docs/research/part97-regulatory-basis.md (Risks)` | Band-edge violation when tuned to 144.000 MHz | Entered | [RSK-046](#rsk-046) | n/a | 2026-09-25 |
| REG-3 | `docs/research/part97-regulatory-basis.md (Risks), named in docs/conops/conops.md section 8` | Rule drift: 97.305, 97.307, 97.313 and 1.1307 amended since 2021 | Entered | [RSK-029](#rsk-029) | Entered with REG-5 and RFX-R3 as one failure-mode family: same asset (the cited regulatory basis), same driving dimension (performance margin), one plan (process section 4). | 2026-09-25 |
| R-PCB-09 | `docs/research/pcbway-export-and-vendor-questions.md (Implications, item 10)` | Via-in-pad fill surcharge and lead time | Entered | [RSK-052](#rsk-052) | n/a | 2026-09-25 |
| R-PCB-10 | `docs/research/pcbway-export-and-vendor-questions.md (Implications, item 11)` | Finished hole plating unknown; via-array thermal resistance uncertain | Merged | [RSK-006](#rsk-006) | A cause of the RSK-006 departure; a plating and microsection query is added to RSK-006. | 2026-09-25 |
| R-REG-01 | `docs/research/pcbway-export-and-vendor-questions.md (Implications, item 12)` | Ordering more boards would breach the five-unit cap | Declined | none | Controlled by owner decision: ADR-025 sets the hard cap of five complete units (SI-035) and REQ-SYS-125 is verified by Inspection of the order. Re-opens if a CR proposes more than five boards or units. | 2026-09-25 |
| R-PCB-08 | `docs/research/pcbway-export-and-vendor-questions.md (Implications, item 9)` | Silent export loss of a file or part with exit code 0 | Entered | [RSK-049](#rsk-049) | n/a | 2026-09-25 |
| R-PCB-01 | `docs/research/pcbway-fabrication-and-assembly.md (Risks)` | Centroid rotation mismatch mis-orients ICs or the Pico 2 | Merged | [RSK-004](#rsk-004) | Same RSK-004 departure (assembly defect on delivered boards); the assembly drawing and placement preview are added to RSK-004. | 2026-09-25 |
| R-PCB-02 | `docs/research/pcbway-fabrication-and-assembly.md (Risks)` | PCBWay may refuse to reflow the castellated Pico 2 | Merged | [RSK-004](#rsk-004) | Same asset and plan as RSK-004 (assembled board quality); the written PCBWay confirmation is added to RSK-004. | 2026-09-25 |
| R-PCB-03 | `docs/research/pcbway-fabrication-and-assembly.md (Risks)` | Microstrip impedance verified only without solder mask | Entered | [RSK-054](#rsk-054) | n/a | 2026-09-25 |
| R-PCB-04 | `docs/research/pcbway-fabrication-and-assembly.md (Risks)` | Parts import and holiday closures extend the lead time | Entered | [RSK-053](#rsk-053) | n/a | 2026-09-25 |
| R-PCB-05 | `docs/research/pcbway-fabrication-and-assembly.md (Risks)` | PCBWay component pricing 1.5 to 2 times distributor list | Entered | [RSK-052](#rsk-052) | n/a | 2026-09-25 |
| R-PCB-06 | `docs/research/pcbway-fabrication-and-assembly.md (Risks)` | Small board triggers panelization and changes the enclosure interface | Entered | [RSK-043](#rsk-043) | n/a | 2026-09-25 |
| R-PCB-07 | `docs/research/pcbway-fabrication-and-assembly.md (Risks)` | Laminate Dk stated without test frequency | Entered | [RSK-054](#rsk-054) | n/a | 2026-09-25 |
| R-PWR-02 | `docs/research/power-tree-and-charging.md (Implications, item 13)` | About 10 h to charge at 500 mA | Entered | [RSK-055](#rsk-055) | n/a | 2026-09-25 |
| R-PWR-03 | `docs/research/power-tree-and-charging.md (Implications, item 14)` | Switching noise harmonics inside a -140 dBm receiver band | Entered | [RSK-040](#rsk-040) | n/a | 2026-09-25 |
| R-PWR-04 | `docs/research/power-tree-and-charging.md (Implications, item 15)` | Rail parts with zero distributor stock | Entered | [RSK-038](#rsk-038) | n/a | 2026-09-25 |
| R-PWR-05 | `docs/research/power-tree-and-charging.md (Implications, item 16)` | Holder terminals and NTC coupling to the cell | Merged | [RSK-007](#rsk-007) | A cause of the RSK-007 departure (overcharge or over-temperature undetected; HZ-002 single point failure row 6); NTC placement and holder checks are added to RSK-007. | 2026-09-25 |
| R-PWR-06 | `docs/research/power-tree-and-charging.md (Implications, item 17)` | User-replaceable cells mismatched or too long | Merged | [RSK-007](#rsk-007) | Same RSK-007 departure (imbalance and mechanical causes of a cell event); RSK-007 S6 carries the user guidance and insertion check. | 2026-09-25 |
| R-PWR-07 | `docs/research/power-tree-and-charging.md (Implications, item 18)` | Load current during receive corrupts charge termination | Declined | none | Condition removed: the baseline pauses charging while the power switch is on (REQ-SYS-093, D-PWR-07), so no receive load is present during termination. Re-opens if the owner selects concurrent receive and charge. | 2026-09-25 |
| R-PWR-01 | `docs/research/power-tree-and-charging.md (Risks), named in docs/conops/conops.md section 8` | Pico 2 module USB current path unrated above 500 mA | Entered | [RSK-033](#rsk-033) | n/a | 2026-09-25 |
| REG-6 | `docs/research/regulatory-corpus-and-operators.md (Risks)` | Band-edge violation by reference drift | Entered | [RSK-046](#rsk-046) | n/a | 2026-09-25 |
| RF-4 | `docs/research/regulatory-corpus-and-operators.md (Risks)` | Third harmonic on the 70 cm weak-signal and beacon segments | Entered | [RSK-057](#rsk-057) | n/a | 2026-09-25 |
| RF-5 | `docs/research/regulatory-corpus-and-operators.md (Risks)` | Seventh harmonic in the 1030 MHz SSR, IFF and DME band | Merged | [RSK-011](#rsk-011) | Same asset and plan as RSK-011 (spurious emissions measured and reported credibly); a step reporting 7f with its victim service is added to RSK-011. | 2026-09-25 |
| REG-4 | `docs/research/regulatory-corpus-and-operators.md (Risks), named in docs/conops/conops.md section 8` | Unlicensed operation of a unit by a guest | Entered | [RSK-028](#rsk-028) | n/a | 2026-09-25 |
| REG-5 | `docs/research/regulatory-corpus-and-operators.md (Risks), named in docs/conops/conops.md section 8` | Currency of the five 47 CFR 2.106 allocation rows | Merged | [RSK-029](#rsk-029) | Same event family as REG-3 (a cited regulatory text changes unnoticed); its check is RSK-029 S2 (DECISION-10 browser check). | 2026-09-25 |
| REG-7 | `docs/research/regulatory-corpus-and-operators.md (Risks), named in docs/conops/conops.md section 8` | Interpretation of third-party keying by a guest | Declined | none | Not a scored departure: the design supports either reading (guest lock FW-03, ADR-015), so an interpretation that limits third-party keying changes only the OPS-C text and the handbook, consequence 1 in every dimension. Re-open if an interpretation would require a firmware or hardware change. | 2026-09-25 |
| RFX-R4 | `docs/research/rf-exposure-evaluation.md (Risks)` | User-fitted higher-gain antenna grows the separation distances | Merged | [RSK-016](#rsk-016) | A cause of the RSK-016 departure; the antenna gain envelope and REQ-SYS-172 are in its plan. | 2026-09-25 |
| RFX-R5 | `docs/research/rf-exposure-evaluation.md (Risks)` | 40 % CW duty assumption may understate time-averaged power | Merged | [RSK-016](#rsk-016) | A cause of the RSK-016 departure; the 50 % sensitivity case and the host duty measurement are added to RSK-016. | 2026-09-25 |
| RFX-R1 | `docs/research/rf-exposure-evaluation.md (Risks), named in docs/conops/conops.md section 8` | SAR-by-analogy validity for a homebrew form factor | Entered | [RSK-030](#rsk-030) | n/a | 2026-09-25 |
| RFX-R2 | `docs/research/rf-exposure-evaluation.md (Risks), named in docs/conops/conops.md section 8` | Continuous tune carrier within 20 cm of a non-licensee | Merged | [RSK-016](#rsk-016) | The 0.5 W tune default and 10 s time-out are RSK-016 controls (S2, S4): same persons (HZ-006), same driving dimension (safety 4) and plan. | 2026-09-25 |
| RFX-R3 | `docs/research/rf-exposure-evaluation.md (Risks), named in docs/conops/conops.md section 8` | RF-exposure guidance in flux (OET 65 Supplement B, SAR exemptions) | Merged | [RSK-029](#rsk-029) | Same event family as REG-3 (cited guidance changes unnoticed); its re-check is RSK-029 S2 and the second RSK-029 trigger. | 2026-09-25 |
| EMUOPT-R1 | `docs/research/rp2350-emulation-options.md (Implications, RISK-candidate 1)` | rp2350js ARM mode lacks timer and system interrupts | Merged | [RSK-003](#rsk-003) | Same RSK-003 departure (emulator mis-models a peripheral or cannot run the image). | 2026-09-25 |
| EMUOPT-R2 | `docs/research/rp2350-emulation-options.md (Implications, RISK-candidate 2)` | Single-maintainer emulator with an unstable API | Merged | [RSK-003](#rsk-003) | Same RSK-003 condition (emulator without maintenance commitment); pinning and vendoring are in its plan. | 2026-09-25 |
| EMUOPT-R3 | `docs/research/rp2350-emulation-options.md (Implications, RISK-candidate 3)` | Project-written device models can pass wrong firmware | Merged | [RSK-003](#rsk-003) | Same RSK-003 departure (emulation passes while silicon differs); independent review of the models is added to RSK-003. | 2026-09-25 |
| EMUOPT-R4 | `docs/research/rp2350-emulation-options.md (Implications, RISK-candidate 4)` | Several RP2350 emulators are RISC-V only | Declined | none | Resolved by the ARM-mode choice for ACC-EMU-001 (c1570/rp2350js ARM mode at af0114cb, docs/research/emulator-accreditation-and-timer-irq.md F13). Re-opens if a RISC-V build or a RISC-V-only emulator is proposed. | 2026-09-25 |
| RUST-R1 | `docs/research/rustos-toolchain-proof.md (Implications, RISK-candidate 1)` | pico2 lacks interrupt and clock infrastructure; WP-01 and WP-02 gate everything | Merged | [RSK-013](#rsk-013) | Same RSK-013 departure (a needed driver not demonstrated by CDR); RSK-013 S2 orders WP-01 and WP-02 first. | 2026-09-25 |
| RUST-R2 | `docs/research/rustos-toolchain-proof.md (Implications, RISK-candidate 2)` | Silicon stepping of procured modules unknown | Entered | [RSK-042](#rsk-042) | n/a | 2026-09-25 |
| RUST-R3 | `docs/research/rustos-toolchain-proof.md (Implications, RISK-candidate 3)` | Noisy ADC reference limits battery sensing to about 2 % | Entered | [RSK-056](#rsk-056) | n/a | 2026-09-25 |
| RUST-R4 | `docs/research/rustos-toolchain-proof.md (Implications, RISK-candidate 4)` | pico2 register-level drivers not host-testable without an access trait | Merged | [RSK-013](#rsk-013) | Same asset and plan as RSK-013 (driver evidence by CDR); the register-access trait decision is added to RSK-013. | 2026-09-25 |
| RUST-R5 | `docs/research/rustos-toolchain-proof.md (Implications, RISK-candidate 5)` | rustos README drift from the tree | Declined | none | Documentation drift upstream with a planned fix (WP-13) and no effect on cwht evidence, which uses the locked build commands of tools/toolchain.lock.md. Re-opens if a reviewer cannot reproduce the build from the lock. | 2026-09-25 |
| TR-R10 | `docs/research/tr-switch-candidates.md (Implications, RISK-candidate 10)` | Lifecycle of PIN diodes and relays discontinued or unverified | Entered | [RSK-038](#rsk-038) | n/a | 2026-09-25 |
| TR-R11 | `docs/research/tr-switch-candidates.md (Implications, RISK-candidate 11)` | PIN switch distortion after the LPF consumes the harmonic budget | Declined | none | Condition removed: the baseline T/R element is a relay with the LPF at the antenna port after the T/R node (concept section 7.1). Re-opens if the T/R trade selects a PIN element. | 2026-09-25 |
| TR-R12 | `docs/research/tr-switch-candidates.md (Implications, RISK-candidate 12)` | Single-stage shunt leakage leaves 14 dB to LNA damage | Entered | [RSK-048](#rsk-048) | n/a | 2026-09-25 |
| TR-R13 | `docs/research/tr-switch-candidates.md (Implications, RISK-candidate 13)` | MEMS switch hot switching and ESD class 0 | Declined | none | Condition not present: MEMS switches are not recommended for rev A and not in the baseline. Re-opens if the T/R trade selects a MEMS element. | 2026-09-25 |
| TR-R14 | `docs/research/tr-switch-candidates.md (Implications, RISK-candidate 14)` | T/R part stock and price not observed | Entered | [RSK-038](#rsk-038) | n/a | 2026-09-25 |
| TR-R9 | `docs/research/tr-switch-candidates.md (Implications, RISK-candidate 9)` | Relay wear in full QSK | Declined | none | Condition removed: SI-036 and ADR-010 exclude full QSK, and semi break-in switches the relay once per over, far below the rated life. Re-opens if QSK is reconsidered. | 2026-09-25 |
| VTI-10 | `docs/research/verification-tooling-inventory.md (Implications, RISK-candidate 10)` | Stale KiCad and metrics libraries | Entered | [RSK-049](#rsk-049) | n/a | 2026-09-25 |
| VTI-11 | `docs/research/verification-tooling-inventory.md (Implications, RISK-candidate 11)` | KiCad drc.v1.json schema is invalid JSON | Entered | [RSK-049](#rsk-049) | n/a | 2026-09-25 |
| VTI-5 | `docs/research/verification-tooling-inventory.md (Implications, RISK-candidate 5)` | rustc cannot instrument MC/DC | Merged | [RSK-010](#rsk-010) | Same condition as RSK-010, which carries the residual of the SWE-219 tailoring that this finding motivated. | 2026-09-25 |
| VTI-6 | `docs/research/verification-tooling-inventory.md (Implications, RISK-candidate 6)` | pcbnew scripting removed in KiCad 11 | Entered | [RSK-049](#rsk-049) | n/a | 2026-09-25 |
| VTI-7 | `docs/research/verification-tooling-inventory.md (Implications, RISK-candidate 7)` | Two Python runtimes for board and analysis scripts | Entered | [RSK-049](#rsk-049) | n/a | 2026-09-25 |
| VTI-8 | `docs/research/verification-tooling-inventory.md (Implications, RISK-candidate 8)` | LTspice batch invocation under CrossOver unconfirmed | Entered | [RSK-050](#rsk-050) | n/a | 2026-09-25 |
| VTI-9 | `docs/research/verification-tooling-inventory.md (Implications, RISK-candidate 9)` | kiutils cannot write loadable KiCad 10 boards | Entered | [RSK-049](#rsk-049) | n/a | 2026-09-25 |

Totals: Entered 81, Merged 56, Declined 22.

## Risk details

### RSK-007

**Li-ion cell thermal event inside the enclosure**

Given the radio is powered by two user-replaceable 18650 Li-ion cells in series in holders (SI-023, ADR-005), charged on board through the Pico 2 micro-USB connector (SI-022, ADR-004), inside a sealed aluminum enclosure next to a PA dissipating several watts; charging supervision involves firmware (charter section 10 names it safety-critical), and friends who receive units (SI-019) may insert unprotected, mismatched or reversed cells, there is a possibility of a cell venting or entering thermal runaway after overcharge, over-discharge, imbalance between the two series cells, reversed insertion, external short, mechanical damage or over-temperature adversely impacting the PWR subsystem, the operator, and the owner's friends who receive units (SI-019), leading to fire or burn injury and destruction of the unit.

| Field | Value |
|---|---|
| Category | safety (tags: software) |
| Likelihood | 4 (Likely) |
| Consequence by dimension | Safety 5 / First power-on 3 / Cost 3 / Schedule 3 / Performance margin 2 |
| Consequence (max) | 5 (Critical); driving: Safety |
| Score / band | 20 / Red |
| Assessment confidence | Low |
| Status / trend | Mitigating / Stable |
| Owner | Claude |
| Opened / horizon | 2026-09-25 / Ops |
| Last assessed | 2026-09-27 (SRR) |
| Source | Formulation risk identification 2026-09-25 against SI-001, SI-019; SEMP section 7.1 hazard scope (lithium battery charging, over-discharge, short circuit and thermal runaway); SRR research candidate pass 2026-09-25 merged R-PWR-05, R-PWR-06 |
| Strategy | Mitigate |
| Plan approval | 2026-09-26, memo docs/reviews/SRR/decision-memo.md |

**Likelihood rationale.** Anchor level 4 (no analysis yet): the cell, charger and protection design does not exist yet; protected cells, a 2S charger IC with balancing and thermistor monitoring and reverse-insertion protection are requirements and research proposals, not an analysed design, user-replaceable cells add insertion causes and the thermal environment next to the PA is unusual. 06 section 6 case (a): a design-analysis risk takes the anchor its facts meet, so no band argument below it is recorded. Confidence stays Low until the battery and charger trade study (S2) selects the parts; the hazard analysis (HZ-002, HZ-007) exists.

**Consequence rationale.** Driving dimension safety 5: Li-ion venting with flame is a life-threatening injury and fire scenario in a hand-held device; the safety override of process section 7 makes the risk Red at likelihood 2. Cost and schedule 3: loss of a unit and a redesign of the power section.

**Mitigation steps**

| Step | Action | Artifact | Due | Status |
|---|---|---|---|---|
| S1 | Hazard analysis entry with causes, controls and verification for the cells (overcharge, over-discharge, imbalance, reversed insertion, short, mechanical, thermal); the entry names this risk in related_risk_ids (hazard link rule, process section 1). | docs/safety/hazards.json (HZ-NNN) and docs/safety/hazard-analysis.md | SRR | Done (docs/safety/hazards.json HZ-002, HZ-007 (related_risk_ids RSK-007); docs/safety/hazard-analysis.md section 12) |
| S2 | Trade study (hazard-related, mandatory per process section 14.1 (c)) selecting protected 18650 cells from a reputable manufacturer, a 2S charger IC with cell balancing and thermistor input, reverse-insertion protection, and the holder type. | docs/decisions/trade-studies/TS-NNN-battery-and-charger.md | PDR | Planned |
| S3 | Firmware charging supervision per the SWE-134 provisions with hardware protection independent of firmware so that no single firmware fault can overcharge; charging inhibited when the cell thermistor is outside 0 to 45 C or during transmit; derive the SW requirements. | docs/requirements/sw/sw-pwr/requirements.json (charging supervision module named in 07 section 14, created by the architecture ADR) | CDR | Planned |
| S4 | Mechanical controls: cells retained by the holders and the enclosure, separated from the PA thermal zone by distance or barrier, vent path in the enclosure, no sharp edges near the cells; derive the ME requirements. | docs/requirements/me/requirements.json; hardware/enclosure/*.scad | CDR | Planned |
| S5 | Bench charge and discharge test at SAR with current, voltage per cell and cell temperature logged. | docs/test_cases/pwr/test_cases.json (TC-PWR charge case) | SAR | Planned |
| S6 | Operations handbook: approved cell types (protected, matched pair), insertion polarity, never mix cells of different age or capacity, stop-use criteria (heat, swelling). | docs/ops/operations-handbook.md | SAR | Planned |
| S7 | Holder cell-length check and NTC placement test on the holders with the bench supply and the charger ADC, so the JEITA window reads cell temperature (R-PWR-05, R-PWR-06). | docs/design/analysis/cell-ntc-placement.md | CDR | Planned |

**Triggers**

| Condition | Response |
|---|---|
| Hazard analysis identifies a cause with fewer than two independent controls | Claude changes the design before PDR; the item is a PDR lien |
| Thermal budget (RSK-006) shows cell temperature above 45 C during charging or above 60 C during transmit | Claude relocates the cells or adds a thermal barrier before CDR |
| A unit is reported with a swollen or hot cell in operations | Owner recalls the unit and removes its cells; Claude opens an NCR and re-assesses this risk the same session |

**Fallback.** Delete on-board charging: the cells are already removable (SI-023) and are charged in an external 18650 charger; CR to the PWR requirements and to the charging role of the USB connector in ADR-004.

**Related.** hazard: HZ-002, HZ-007, HZ-011; adr: ADR-004, ADR-005; tpm: TPM-008; stakeholder input: SI-001, SI-019, SI-022, SI-023; risk: RSK-006

**Closure criteria.** All controls of the linked hazard verified and the residual risk accepted by the owner in the SAR decision memo.

**History**

| Date | Review | L | C | Safety | Score | Status | Note |
|---|---|---|---|---|---|---|---|
| 2026-09-25 | Pre-SRR | 2 | 5 | n/r | 10 | Proposed | Opened during Formulation risk identification; Red by safety override; awaiting independent check. |
| 2026-09-25 | Pre-SRR | 2 | 5 | 5 | 10 | Proposed | Condition updated for the 2S 18650 holder design (SI-023, ADR-005) and micro-USB charging (SI-022, ADR-004); insertion causes added; fallback corrected (external charging, cells already removable). Score unchanged. |
| 2026-09-25 | Pre-SRR | 2 | 5 | 5 | 10 | Proposed | Independent review 2026-09-25: tagged software (S3 derives SW-PWR requirements; process section 5); S1 Done by the preliminary hazard analysis (HZ-002, HZ-007). Score unchanged. |
| 2026-09-25 | SRR | 2 | 5 | 5 | 10 | Proposed | SRR Track pass at package assembly 2026-09-25 (06 section 10 item 1): re-assessed against the SRR research candidate pass; likelihood and consequence unchanged; status stays Proposed until the independent check of docs/reviews/SRR/checklists/risk-register.md. Merged candidates R-PWR-05, R-PWR-06 (06 section 9 disposition rule; family rule of section 4 applied: same asset, driving dimension, plan and kind); worst member does not raise the score. Step added for the merged candidates. |
| 2026-09-25 | SRR | 4 | 5 | 5 | 20 | Proposed | Re-levelled 2 to 4 after INSP-007 (docs/reviews/SRR/checklists/risk-register-06.md) finding F-02: the recorded level disagreed with the 06 section 6 anchor the rationale itself describes; score 10 to 20. |
| 2026-09-27 | SRR | 4 | 5 | 5 | 20 | Mitigating | Track pass 2026-09-27 (docs/plan/pdr-work-plan.md WP-PDR-18 wave 0; 06 section 9 Track and Control; INSP-007 finding-18, docs/reviews/SRR/checklists/risk-register-06.md), recorded at review point SRR, the last gate passed (06 section 10.3); the PDR Track pass of 06 section 10 item 1 follows at PDR package assembly. Status Proposed to Open: INSP-007 (APPROVED; item CK-RSK-A2) records the Analyze check passing all 65 risks (06 section 9 transition table). Then Open to Mitigating: step S1 Done (06 section 9 transition). Likelihood and consequence unchanged: no analysis, test, trigger poll or SRR ruling since the SRR Track pass changes this risk's evidence. CR-003 revision 3 (Submitted, d9a215a; section 4 Risk row) proposes changes to this risk; a submitted CR changes no baseline (06 section 10.2 trigger noted), so the changes are applied with a Refs trailer naming the CR after the owner's disposition (WP-PDR-02 and the WP-PDR-18 final pass). This pass keeps the current values. |

### RSK-034

**Bench fire or treatable burn during owner hand assembly**

Given the kit model has the owner hand-solder the through-hole parts and exposed-pad modules of up to five units (SI-031, SI-035, ADR-007, REQ-SYS-137, REQ-SYS-138); docs/safety/hazards.json 0.2.0-pha rates this activity HZ-015 Catastrophic-D (a bench fire from an iron left energized off its stand) with controls K1 (temperature-controlled station with stand, auto-sleep and earthed tip), K2 (fume extraction), K4 (hand-assembly procedure) and K5 (TRR safety line) still without requirements (OQ-SAF-019), and the owner's bench gear list CON-016 records no soldering station, there is a possibility of a bench fire, a burn needing medical treatment or an eye injury occurring while the owner hand-assembles or reworks a unit adversely impacting the owner as test operator, the household and the property at the home bench (HZ-015), leading to an uncontained bench fire or an injury needing medical treatment, and a halted assembly of the remaining units.

| Field | Value |
|---|---|
| Category | safety |
| Likelihood | 2 (Unlikely) |
| Consequence by dimension | Safety 5 / First power-on 3 / Cost 2 / Schedule 2 / Performance margin 1 |
| Consequence (max) | 5 (Critical); driving: Safety |
| Score / band | 10 / Red (safety override) |
| Assessment confidence | Low |
| Status / trend | Open / Stable |
| Owner | Claude |
| Opened / horizon | 2026-09-25 / TRR |
| Last assessed | 2026-09-27 (SRR) |
| Source | Hazard link rule (06 section 1) for HZ-015, added in docs/safety/hazards.json 0.2.0-pha (hazard analysis OQ-SAF-020: no risk carried it); opened 2026-09-25 by the integrating session |
| Strategy | Mitigate |
| Plan approval | 2026-09-26, memo docs/reviews/SRR/decision-memo.md |

**Likelihood rationale.** Band argument (06 section 6 case (c), a procedure hazard): HZ-015 rates the uncontrolled fire case D (Remote: not expected in the fleet life of at most five units but credible) and the treatable-burn case C; before the TRR horizon that is the 5 % to 20 % band of 06 section 6 (level 2, Unlikely). No design-analysis anchor applies, so the probability band decides and confidence is Low (the owner's iron is not recorded).

**Consequence rationale.** Driving dimension safety 5: a fire not contained to the unit is Catastrophic on the docs/safety/hazards.json scale (register safety 5, the hazard link rule minimum for HZ-015). first_power_on 3: heat or ESD damage to a vendor-placed part (RP2350 module, PA, LNA, TCXO) found at first power-on degrades a subsystem and needs vendor rework or a spare population. Cost 2 and schedule 2: a replacement part and a re-solder session (USD 25 to 100, 1 to 3 weeks). performance_margin 1.

**Mitigation steps**

| Step | Action | Artifact | Due | Status |
|---|---|---|---|---|
| S1 | Write requirements for the HZ-015 controls K1, K2, K4 and K5 (station with stand, auto-sleep and earthed tip; fume extraction; hand-assembly procedure; TRR safety line and as-built entries), closing OQ-SAF-019; the hazard analysis author then sets their control_req_ids in hazards.json. | docs/requirements/sys/requirements.json; docs/safety/hazards.json (HZ-015 control_req_ids) | PDR | Planned |
| S2 | The owner confirms or obtains a temperature-controlled soldering station with a stand, an auto-sleep or auto-off timer and an earthed tip, and a fume extractor; Claude records model and features as a stakeholder input and in HZ-015 K1, which removes the zero-fault-tolerant fire case. | docs/requirements/l0-stakeholder/stakeholder-inputs.md (new SI entry); docs/safety/hazards.json (HZ-015 K1) | CDR | Planned |
| S3 | Write the hand-assembly procedure (alloy and tip temperature, dwell limits and order, cells removed and USB disconnected, eye protection, hygiene, ESD strap and mat) into the hardware release package and have it independently reviewed before the procurement release. | hardware/releases/HW-MB-rev<X>-<n>/ (hand-assembly procedure); docs/reviews/CDR/checklists/ (review record) | CDR | Planned |
| S4 | TRR safety line: the test configuration record confirms that the procedure was followed, and each unit's as-built record lists the station, the alloy and any rework (HZ-015 K5). | docs/reviews/TRR/test-configuration-record.md; docs/vv/adp/CWHT-A-NNN/as-built.md | TRR | Planned |

**Triggers**

| Condition | Response |
|---|---|
| At the S2 check before the CDR readiness declaration the owner's iron has no stand, no auto-sleep or no earthed tip, or no fume extraction is available | Claude re-assesses likelihood and confidence the same session and proposes the station purchase or an alternative control to the owner before the procurement release; the CDR decision memo records the choice |
| Any fire or smoke, burn needing treatment, eye injury, or vendor-placed part damaged during hand assembly or rework | The owner stops assembly; Claude opens an NCR and re-assesses this risk and HZ-015 in the same session before assembly resumes |

**Fallback.** The through-hole and exposed-pad parts are assembled by a third party (PCBWay through-hole assembly or a local service) through a CR that changes the SI-031 assembly split, which removes the owner's hand assembly.

**Related.** requirement: REQ-SYS-137, REQ-SYS-138; hazard: HZ-015; adr: ADR-007; stakeholder input: SI-031, SI-035; risk: RSK-004

**Closure criteria.** HZ-015 controls K1, K2, K4 and K5 allocated to requirements and verified by Inspection (procedure reviewed, station and extractor recorded, TRR safety line and as-built records complete) before the first hand assembly; the risk closes when HZ-015 reaches Controls verified.

**History**

| Date | Review | L | C | Safety | Score | Status | Note |
|---|---|---|---|---|---|---|---|
| 2026-09-25 | Pre-SRR | 2 | 5 | 5 | 10 | Proposed | Opened under the hazard link rule for HZ-015 (docs/safety/hazards.json 0.2.0-pha; OQ-SAF-020). Red by the safety override of 06 section 7; the plan meets the Red minimums of 06 section 8; plan_approval is due in the SRR decision memo. Back-link pending: the hazard analysis author sets HZ-015 related_risk_ids to [RSK-034]. Awaiting independent check. |
| 2026-09-25 | SRR | 2 | 5 | 5 | 10 | Proposed | SRR Track pass at package assembly 2026-09-25 (06 section 10 item 1): re-assessed against the SRR research candidate pass; likelihood and consequence unchanged; status stays Proposed until the independent check of docs/reviews/SRR/checklists/risk-register.md. |
| 2026-09-25 | SRR | 2 | 5 | 5 | 10 | Proposed | Likelihood rationale labelled as a case (c) band argument (06 section 6 anchor-availability rule added after INSP-007 finding F-12). Level unchanged. |
| 2026-09-27 | SRR | 2 | 5 | 5 | 10 | Open | Track pass 2026-09-27 (docs/plan/pdr-work-plan.md WP-PDR-18 wave 0; 06 section 9 Track and Control; INSP-007 finding-18, docs/reviews/SRR/checklists/risk-register-06.md), recorded at review point SRR, the last gate passed (06 section 10.3); the PDR Track pass of 06 section 10 item 1 follows at PDR package assembly. Status Proposed to Open: INSP-007 (APPROVED; item CK-RSK-A2) records the Analyze check passing all 65 risks (06 section 9 transition table). Likelihood and consequence unchanged: no analysis, test, trigger poll or SRR ruling since the SRR Track pass changes this risk's evidence. CR-006 revision 2 (Submitted, 39a6b13; section 1.7) proposes changes to this risk; a submitted CR changes no baseline (06 section 10.2 trigger noted), so the changes are applied with a Refs trailer naming the CR after the owner's disposition (WP-PDR-02 and the WP-PDR-18 final pass). This pass keeps the current values. |

### RSK-008

**First power-on fails and a second board spin is required**

Given SI-010 requires the radio to work at first power-on, the entire hardware design is verified before build only by analysis, host tests and optional emulation with no prototype stage, CDR is the procurement release (charter section 3), and a second fabrication and assembly run costs on the order of USD 300 to 800 and 6 to 12 weeks; the RF hardware is at TRL 3 at the CDR procurement release because no RF breadboard is built before it (SEMP section 6.0; the owner accepted this residual at SRR, decision 11 (OQ-SE-006), to be reconfirmed in the CDR decision memo), there is a possibility of a design or assembly defect found at power-on that cannot be corrected by firmware, BOM alternates, hand-soldered rework or design-for-debug provisions adversely impacting the whole system, the cost estimate and the schedule to SAR, leading to a second board spin that doubles fabrication cost, delays SAR by one procurement cycle and misses the SI-010 objective.

| Field | Value |
|---|---|
| Category | technical (tags: aggregate) |
| Likelihood | 4 (Likely) |
| Consequence by dimension | Safety 1 / First power-on 5 / Cost 4 / Schedule 4 / Performance margin 2 |
| Consequence (max) | 5 (Critical); driving: First power-on |
| Score / band | 20 / Red |
| Assessment confidence | Medium |
| Status / trend | Mitigating / Stable |
| Owner | Claude |
| Opened / horizon | 2026-09-25 / TRR |
| Last assessed | 2026-09-27 (SRR) |
| Source | Formulation risk identification 2026-09-25 against SI-010 |
| Strategy | Mitigate |
| Plan approval | 2026-09-26, memo docs/reviews/SRR/decision-memo.md |

**Likelihood rationale.** Aggregate of RSK-001, RSK-003, RSK-004, RSK-006, RSK-012, RSK-013, RSK-014, RSK-024 and RSK-027; a first-spin board with zero defects is uncommon even with full simulation. Anchor level 4; recomputed at each review as the maximum likelihood of the children (process section 16 item 8, enforced by tools/render_risk.py).

**Consequence rationale.** Driving dimension first_power_on 5: by definition the SI-010 objective is missed and a second spin is required. Cost 4 and schedule 4: one full fabrication and assembly run.

**Mitigation steps**

| Step | Action | Artifact | Due | Status |
|---|---|---|---|---|
| S1 | Design-for-debug guideline: test points on every rail and signal of interest, jumpers isolating the PA, charger and LO supplies, staged power-up sequence, per-stage current limits. | docs/design/build-to-specification.md (design-for-debug section); docs/plan/integration-plan.md (test points and bring-up order, 01 section 5 row 6) | PDR | Planned |
| S2 | Staged bring-up procedure as a TRR entrance product: rails, MCU, LO, RX, TX at low power, TX at full power, each with pass criteria and stop rules. | docs/vv/plan.md bring-up section; docs/test_cases/sys/test_cases.json (TC-SYS bring-up cases) | TRR | Planned |
| S3 | Independent checklist review of schematic, layout and BOM by a reviewer agent, including rendered-image inspection (charter section 11 rule 3), before CDR. | docs/reviews/CDR/checklists/<product-slug>.md (INSP-NNN, charter section 5) using docs/templates/peer-review-checklist-design.md section J | CDR | Planned |
| S4 | Cost estimate carries one full respin as contingency, approved by the owner at CDR. | docs/plan/cost-estimate.md | CDR | Planned |
| S5 | Track the child risks; recompute this risk's likelihood at each review as the maximum of the children's likelihoods. | docs/risk/register.json | SAR | InProgress |

**Triggers**

| Condition | Response |
|---|---|
| Any child risk named in related.risk_ids is Red at CDR | CDR disposition is at most Approved with liens; the owner decides whether to release procurement and records the decision in docs/reviews/CDR/decision-memo.md |
| A bring-up stage fails at TRR | Claude opens an NCR and determines whether the fix is firmware, a BOM alternate, hand rework or a respin; the owner decides on the respin |

**Fallback.** Fund the second spin from contingency, treat the first board as the prototype and re-baseline the SAR milestone in docs/plan/schedule.md.

**Related.** adr: ADR-007; trade study: TS-001; tpm: TPM-014; stakeholder input: SI-010; risk: RSK-001, RSK-003, RSK-004, RSK-006, RSK-012, RSK-013, RSK-014, RSK-024, RSK-025, RSK-027, RSK-043, RSK-049, RSK-064

**Closure criteria.** SAR acceptance of the first-spin board with all requirements verified.

**History**

| Date | Review | L | C | Safety | Score | Status | Note |
|---|---|---|---|---|---|---|---|
| 2026-09-25 | Pre-SRR | 4 | 5 | n/r | 20 | Proposed | Opened during Formulation risk identification; awaiting independent check. |
| 2026-09-25 | Pre-SRR | 4 | 5 | 1 | 20 | Proposed | Children RSK-013 and RSK-014 added; tagged aggregate; artifacts aligned to docs/plan/cost-estimate.md and docs/design/build-to-specification.md. Score unchanged. |
| 2026-09-25 | Pre-SRR | 4 | 5 | 1 | 20 | Proposed | Independent review 2026-09-25: children RSK-024 and RSK-027 (split from RSK-012 and RSK-001) added; S3 record path aligned to the charter section 5 INSP record. Score unchanged (maximum child likelihood 4). |
| 2026-09-25 | SRR | 4 | 5 | 1 | 20 | Proposed | SRR Track pass at package assembly 2026-09-25 (06 section 10 item 1): re-assessed against the SRR research candidate pass; likelihood and consequence unchanged; status stays Proposed until the independent check of docs/reviews/SRR/checklists/risk-register.md. Children RSK-043 and RSK-049 (first-power-on causes) added; aggregate likelihood stays 4 (maximum of the active children). Condition names hardware TRL 3 at procurement release (SEMP appendix F item F-12). |
| 2026-09-25 | SRR | 4 | 5 | 1 | 20 | Proposed | INSP-007 (docs/reviews/SRR/checklists/risk-register-06.md) finding F-05: RSK-025 (first_power_on 4) and the new RSK-064 added to the children; the first trigger now names every child in related.risk_ids. Likelihood 4 equals the maximum of the active children (RSK-003, RSK-014, RSK-025, RSK-043 at 4). |
| 2026-09-25 | SRR | 4 | 5 | 1 | 20 | Proposed | INSP-007 (docs/reviews/SRR/checklists/risk-register-06.md) finding F-04: trade-study references corrected (TS-001 is receiver-and-pa-concept, TS-002 is firmware-runtime-make-buy; unwritten studies carry TS-NNN until created) and related.trade_study_ids set for the studies that name this risk. Score unchanged. |
| 2026-09-27 | SRR | 4 | 5 | 1 | 20 | Mitigating | Track pass 2026-09-27 (docs/plan/pdr-work-plan.md WP-PDR-18 wave 0; 06 section 9 Track and Control; INSP-007 finding-18, docs/reviews/SRR/checklists/risk-register-06.md), recorded at review point SRR, the last gate passed (06 section 10.3); the PDR Track pass of 06 section 10 item 1 follows at PDR package assembly. Status Proposed to Open: INSP-007 (APPROVED; item CK-RSK-A2) records the Analyze check passing all 65 risks (06 section 9 transition table). Then Open to Mitigating: step S5 InProgress (06 section 9 transition). SRR decision 11 (owner ruling 2026-09-26; decision memo section 8.4 'Residual risks accepted by the owner') accepted hardware TRL 3 at the CDR procurement release as a recorded residual of this risk, to be reconfirmed in the CDR memo; condition restated. The risk stays Red under Mitigate with its SRR plan approval (decision 14), so its status is not Accepted (06 section 8 Red row). Aggregate likelihood 4 equals the maximum of the active children. CR-006 revision 2 (Submitted, 39a6b13; section 1.7) proposes changes to this risk; a submitted CR changes no baseline (06 section 10.2 trigger noted), so the changes are applied with a Refs trailer naming the CR after the owner's disposition (WP-PDR-02 and the WP-PDR-18 final pass). This pass keeps the current values. |

### RSK-046

**Transmission outside the 144.000 to 148.000 MHz band**

Given the transmitter covers the full US 2 m band (SI-024, ADR-016); REQ-SYS-008 and REQ-SYS-009 limit the carrier to 144.0012 to 147.9988 MHz (TBR) with the 1.2 kHz guard set by SRR decision 25 for the +/-2.5 ppm TCXO of ADR-023 (accepted); a +/-20 ppm reference would make the 148.000 MHz edge 3 kHz uncertain (docs/research/regulatory-corpus-and-operators.md REG-6), tuning to 144.000 MHz would place half the keying spectrum below the band (docs/research/part97-regulatory-basis.md RF-3), and the hazard analysis names one software fault in the SW-SYNTH frequency-word path that could place 5 W on 150 to 174 MHz (docs/safety/hazard-analysis.md section 8.2 row 4, HZ-008 C7), whose independent check, a frequency verification before and during transmit, was adopted at SRR as REQ-SYS-182 (decisions 9 and 40, owner ruling 2026-09-26; HZ-008 K7) and is not yet designed, there is a possibility of an emission of the delivered transmitter falling outside 144.000 to 148.000 MHz, at a band edge or from a wrong frequency word adversely impacting TX frequency generation and SW-SYNTH, and other radio services near 2 m, marine VHF on 156.8 MHz among them, leading to an unlawful emission outside the amateur band and possible harmful interference to a safety-of-life service.

| Field | Value |
|---|---|
| Category | safety (tags: regulatory, software) |
| Likelihood | 4 (Likely) |
| Consequence by dimension | Safety 4 / First power-on 1 / Cost 1 / Schedule 2 / Performance margin 4 |
| Consequence (max) | 4 (Major); driving: Safety, Performance margin |
| Score / band | 16 / Red |
| Assessment confidence | Medium |
| Status / trend | Mitigating / Stable |
| Owner | Claude |
| Opened / horizon | 2026-09-25 / SAR |
| Last assessed | 2026-09-27 (SRR) |
| Source | SRR research candidate pass 2026-09-25: candidates RF-3 (docs/research/part97-regulatory-basis.md Risks) and REG-6 (docs/research/regulatory-corpus-and-operators.md Risks) entered as one family, with the HZ-008 C7 out-of-band fundamental branch of OQ-SAF-020 (docs/safety/hazard-analysis.md section 12); the HZ-008 back-link is a pending action on the hazard analysis; SRR ADR candidate pass 2026-09-25 merged ADR021-R1 |
| Strategy | Mitigate |
| Plan approval | 2026-09-26, memo docs/reviews/SRR/decision-memo.md |

**Likelihood rationale.** Anchor level 4 (no analysis yet), scored at the worst member of the family (06 section 4). The independent check of the SW-SYNTH frequency-word path was adopted at SRR as REQ-SYS-182 (decisions 9 and 40, owner ruling 2026-09-26; HZ-008 K7), but a requirement is not an analysis and no design of the prescaler, counter and timebase exists, so the software-fault member still has no analysis (docs/safety/hazard-analysis.md section 8.2 row 4, HZ-008 C7); the band-edge members rest on requirements (the 1.2 kHz guard of decision 25, the TCXO grade of ADR-023, the firmware inhibit) with no frequency error budget yet (S2 due PDR). 06 section 6 case (a): a design-analysis risk takes the anchor its facts meet. Re-assessed at the PDR Track pass on the frequency error budget (S2) and the architecture that places the independent counter.

**Consequence rationale.** Driving dimensions safety 4 (harmful interference to a safety-of-life service) and performance_margin 4 (regulatory rule of 06 section 7).

**Mitigation steps**

| Step | Action | Artifact | Due | Status |
|---|---|---|---|---|
| S1 | Owner decisions at SRR on the independent frequency verification before transmit (HZ-008 K7, OQ-SAF-013) and on the safety-critical classification of frequency control (OQ-SAF-014). | docs/reviews/SRR/decision-memo.md | SRR | Done (docs/reviews/SRR/decision-memo.md (signed 2026-09-26) section 8.0 decision 40 (K2, independent frequency verification before transmit: 'Adopt with the 10 kHz window and 100 ms.') and decision 9 (K2, frequency control safety-critical); docs/requirements/sys/requirements.json REQ-SYS-182 (Active; 10 kHz and 100 ms TBR) added under decision 40; docs/safety/hazards.json HZ-008 K7 records the adoption and OQ-SAF-013 Closed; the transcription of decision 9 into 03 and 07 (OQ-SAF-014) is WP-PDR-17 (docs/plan/pdr-work-plan.md).) |
| S2 | Frequency error budget in the synthesizer study (TS-NNN, ADR-013) showing at most +/-370 Hz at 148 MHz with the selected reference (ADR-023). | docs/design/budgets.md; docs/decisions/trade-studies/TS-NNN-synthesizer.md (ADR-013 study; number assigned at creation) | PDR | Planned |
| S3 | HostUnit boundary tests of the band limit and guard at 143.999, 144.000, 144.001, 147.999, 148.000 and 148.001 MHz and of every frequency-word computation against an independent reference model. | docs/test_cases/sw-synth/test_cases.json | CDR | Planned |
| S4 | Bench: carrier frequency at both guard edges with the tinySA Ultra, after its RBW is verified on receipt against the band-edge measurement need (ADR-021) and an off-air reference before the on-air delta TRR. | docs/test_cases/sys/test_cases.json (REQ-SYS-008 and REQ-SYS-010 cases) | TRR | Planned |

**Triggers**

| Condition | Response |
|---|---|
| The frequency error budget exceeds +/-370 Hz | Claude widens the guard by CR or tightens the reference grade in the synthesizer study (TS-NNN, ADR-013) before PDR closes |
| A boundary test or the independent reference model disagrees with SW-SYNTH | Claude opens an NCR and blocks transmit in the release |

**Fallback.** Widen the guard by CR and restrict the tuning range until the frequency path is verified.

**Related.** requirement: REQ-SYS-008, REQ-SYS-009, REQ-SYS-010, REQ-SYS-154, REQ-SYS-182; hazard: HZ-008; adr: ADR-016, ADR-023; tpm: TPM-006; stakeholder input: SI-014, SI-024; risk: RSK-001, RSK-002, RSK-011

**Closure criteria.** REQ-SYS-008, REQ-SYS-009, REQ-SYS-010 and REQ-SYS-154 verified with Passed reports before the on-air delta TRR.

**History**

| Date | Review | L | C | Safety | Score | Status | Note |
|---|---|---|---|---|---|---|---|
| 2026-09-25 | SRR | 2 | 4 | 4 | 8 | Proposed | Entered at the SRR research candidate pass (06 section 9, Identify) during SRR package assembly; awaiting the independent check of docs/reviews/SRR/checklists/risk-register.md. |
| 2026-09-25 | SRR | 2 | 4 | 4 | 8 | Proposed | S1 re-planned (SRR readiness item H9, risk manager): S1 is an output of the SRR board, not an entrance product, so it cannot be Done before the review sits. Claude's part is done: both questions are owner decisions in docs/reviews/SRR/decisions-for-owner.md and package section 13.1 with recommendation and default, decision 40 (independent frequency verification before and during transmit, HZ-008 K7, OQ-SAF-013; recommended Adopt; if not adopted RSK-046 keeps single point failure row 4) and decision 9 (frequency control safety-critical, OQ-SAF-014; recommended Concur). S1 set InProgress; due event: the owner's rulings on decisions 9 and 40 transcribed into docs/reviews/SRR/decision-memo.md, after which S1 is set Done with the memo as evidence and likelihood is re-assessed (Adopt removes the unchecked frequency-word path). The HZ-008 two-way link is still pending: HZ-008 related_risk_ids names RSK-001 and RSK-011 only (docs/safety/hazards.json 0.2.0-pha), so related.hazard_ids stays empty until the hazard analysis author adds RSK-046 and this risk adds HZ-008 in the same pass. Score unchanged. |
| 2026-09-25 | SRR | 4 | 4 | 4 | 16 | Proposed | Re-levelled 2 to 4 after INSP-007 (docs/reviews/SRR/checklists/risk-register-06.md) finding F-02: the recorded level disagreed with the 06 section 6 anchor the rationale itself describes; score 8 to 16. Also INSP-007 (docs/reviews/SRR/checklists/risk-register-06.md) finding F-08: related.hazard_ids set to [HZ-008] (the C7 wrong-frequency-word cause); the HZ-008 related_risk_ids back-link to RSK-046 is set by the hazard analysis author in the same change set (cross item); safety 4 meets the Critical mapping. ADR-021 section 4.4 candidate 'tinySA RBW too coarse for the band-edge measurement' merged: a cause of an undetected band-edge departure; S4 now verifies the RBW on receipt before the band-edge measurement. |
| 2026-09-25 | SRR | 4 | 4 | 4 | 16 | Proposed | INSP-007 (docs/reviews/SRR/checklists/risk-register-06.md) finding F-04: trade-study references corrected (TS-001 is receiver-and-pa-concept, TS-002 is firmware-runtime-make-buy; unwritten studies carry TS-NNN until created) and related.trade_study_ids set for the studies that name this risk. Score unchanged. |
| 2026-09-27 | SRR | 4 | 4 | 4 | 16 | Mitigating | Track pass 2026-09-27 (docs/plan/pdr-work-plan.md WP-PDR-18 wave 0; 06 section 9 Track and Control; INSP-007 finding-18, docs/reviews/SRR/checklists/risk-register-06.md), recorded at review point SRR, the last gate passed (06 section 10.3); the PDR Track pass of 06 section 10 item 1 follows at PDR package assembly. Status Proposed to Open: INSP-007 (APPROVED; item CK-RSK-A2) records the Analyze check passing all 65 risks (06 section 9 transition table). Then Open to Mitigating: step S1 Done (06 section 9 transition). Re-assessed on the controls adopted at SRR (finding-18 (b)): decisions 9 and 40 (owner ruling 2026-09-26) adopted the independent frequency verification as REQ-SYS-182 and made frequency control safety-critical; S1 Done with the memo as evidence; REQ-SYS-182 added to related.requirement_ids; condition restated with the adopted control and the 1.2 kHz guard of decision 25 (ADR-023 accepted); likelihood rationale restated in the past tense. Likelihood stays 4 under the 06 section 6 case (a) anchor: the control is a requirement with no design or analysis yet, and the band-edge members have no frequency error budget (S2 due PDR). Consequence unchanged (safety 4, performance_margin 4). |

### RSK-025

**Antenna port retention fails under the whip side load**

Given the SMA antenna jack on the end of a pocket radio sees 2 to 4 N.m from a 5 to 10 N side load on a 0.40 m whip (HZ-009); the enclosure is CNC-machined 6061 aluminum from an OpenSCAD model (SI-008, SI-032, ADR-008); HZ-009 K1 and K2 require the jack retained by the enclosure boss, not the PCB, and a 4.0 N.m port rating; no load analysis exists yet; the owner can fit-check with H2C prints (SI-012) but cannot re-machine anodized aluminum or rework the PCB (SI-011), there is a possibility of the antenna boss or jack retention failing, or the jack transferring the whip load into the PCB, under the whip side load adversely impacting the antenna port, the PCB at the connector and the TX output path (HZ-009), leading to a broken antenna port with PCB damage that the owner cannot repair, the radio inoperative, and a second CNC order or a spare board (USD 100 to 800, 3 to 12 weeks).

| Field | Value |
|---|---|
| Category | technical |
| Likelihood | 4 (Likely) |
| Consequence by dimension | Safety 3 / First power-on 4 / Cost 3 / Schedule 3 / Performance margin 2 |
| Consequence (max) | 4 (Major); driving: First power-on |
| Score / band | 16 / Red |
| Assessment confidence | Medium |
| Status / trend | Open / Stable |
| Owner | Claude |
| Opened / horizon | 2026-09-25 / Ops |
| Last assessed | 2026-09-27 (SRR) |
| Source | Split from RSK-018 on 2026-09-25 after independent review (process section 4: antenna-port retention and sharp edges harm different assets and have different driving dimensions); hazard link rule (process section 1) for HZ-009; ConOps section 8 candidate ANT-R1 (docs/research/antenna-and-erp.md) merged 2026-09-25 |
| Strategy | Mitigate |
| Plan approval | 2026-09-26, memo docs/reviews/SRR/decision-memo.md |

**Likelihood rationale.** Anchor level 4 (no analysis yet): pocket carry (SI-001) makes side loads routine and no load analysis exists; the fit-check print catches geometry but not material strength. 06 section 6 case (a): a design-analysis risk takes the anchor its facts meet.

**Consequence rationale.** Driving dimension first_power_on 4: PCB damage at the connector stops the TX function and the owner cannot rework it. Safety 3: HZ-009 is Marginal (register safety 3). Cost and schedule 3: a second CNC order or a spare board population.

**Mitigation steps**

| Step | Action | Artifact | Due | Status |
|---|---|---|---|---|
| S1 | Antenna port load analysis: 4.0 N.m static bending moment in any direction, jack retained by the enclosure boss and not by the PCB, PCB strain relief at the connector (HZ-009 K1, K2; moved from RSK-018 S2). | docs/design/analysis/antenna-port-loads.md | CDR | Planned |
| S2 | H2C fit-check of the boss, jack and nut with the real PCB and a static load test of 10 N at 0.40 m on the printed part before the CNC order (HZ-009 K6). | docs/reviews/CDR/figures/ (fit-check photographs and load-test record) | CDR | Planned |
| S3 | Derive the ME requirements from the HZ-009 controls (port moment, boss retention, 500 mating cycles at the specified coupling torque). | docs/requirements/me/requirements.json | PDR | Planned |
| S4 | Receipt inspection of the CNC part: jack retention and a bending check at reduced load, boss dimensions against the drawing. | docs/vv/reports/receipt-inspection-<n>.md; docs/test_cases/me/test_cases.json | TRR | Planned |
| S5 | Handbook: finger-tight only, never a wrench; remove the antenna for pocket carry; telescopic antennas only with the radio set down (HZ-009 K5). | docs/ops/operations-handbook.md | SAR | Planned |

**Triggers**

| Condition | Response |
|---|---|
| The owner flags a loose jack or boss deflection on a fit-check print | Claude changes the model before the CNC order; an open item is a CDR lien |
| A PCBWay CNC DFM comment changes the boss or the wall thickness | Claude opens a CR if the product baseline changes (05 section 5) and re-runs S1 |
| Receipt inspection finds a jack that moves under load | Claude opens an NCR; the owner decides between a printed boss collar and a second CNC order |

**Fallback.** A printed (H2C) antenna-boss collar until a second CNC order, and a flexible whip only (HZ-009 K5); CR to the ME requirements.

**Related.** hazard: HZ-009; adr: ADR-008; stakeholder input: SI-001, SI-008, SI-011, SI-012, SI-032, SI-035; risk: RSK-018, RSK-031

**Closure criteria.** Antenna port load analysis approved at CDR, the receipt-inspection bending check passed, and the ME requirements derived from HZ-009 verified at SAR.

**History**

| Date | Review | L | C | Safety | Score | Status | Note |
|---|---|---|---|---|---|---|---|
| 2026-09-25 | Pre-SRR | 3 | 4 | 3 | 12 | Proposed | Split from RSK-018 after independent review; carries HZ-009 under the hazard link rule; awaiting independent check. |
| 2026-09-25 | SRR | 3 | 4 | 3 | 12 | Proposed | SRR Track pass at package assembly 2026-09-25 (06 section 10 item 1): re-assessed against the SRR research candidate pass; likelihood and consequence unchanged; status stays Proposed until the independent check of docs/reviews/SRR/checklists/risk-register.md. |
| 2026-09-25 | SRR | 4 | 4 | 3 | 16 | Proposed | Re-levelled 3 to 4 after INSP-007 (docs/reviews/SRR/checklists/risk-register-06.md) finding F-02: the recorded level disagreed with the 06 section 6 anchor the rationale itself describes; score 12 to 16. |
| 2026-09-27 | SRR | 4 | 4 | 3 | 16 | Open | Track pass 2026-09-27 (docs/plan/pdr-work-plan.md WP-PDR-18 wave 0; 06 section 9 Track and Control; INSP-007 finding-18, docs/reviews/SRR/checklists/risk-register-06.md), recorded at review point SRR, the last gate passed (06 section 10.3); the PDR Track pass of 06 section 10 item 1 follows at PDR package assembly. Status Proposed to Open: INSP-007 (APPROVED; item CK-RSK-A2) records the Analyze check passing all 65 risks (06 section 9 transition table). Likelihood and consequence unchanged: no analysis, test, trigger poll or SRR ruling since the SRR Track pass changes this risk's evidence. CR-003 revision 3 (Submitted, d9a215a; section 4 Risk row) and CR-006 revision 2 (Submitted, 39a6b13; section 1.7) propose changes to this risk; a submitted CR changes no baseline (06 section 10.2 trigger noted), so the changes are applied with a Refs trailer naming the CR after the owner's disposition (WP-PDR-02 and the WP-PDR-18 final pass). This pass keeps the current values. |

### RSK-014

**Expedited gate schedule releases procurement with unreviewed products**

Given the owner approved SRR on Saturday morning, PDR on Saturday evening and CDR with procurement release on Sunday evening, with liens on PDR products acceptable when CDR closes them and three owner review windows (SI-020), while the CDR product baseline requires the full design data package, analyses, BOM, fabrication and assembly package and test procedures (charter section 3) each independently reviewed (charter section 2), there is a possibility of CDR being held with a Hard entrance product incomplete or not independently reviewed, so that the PCBWay and DigiKey orders are released against an unreviewed design adversely impacting the product baseline, the procurement spend and the first-power-on objective SI-010, leading to a design defect that a review would have caught reaching the fabricated board, requiring a second spin (USD 300 to 800, 6 to 12 weeks).

| Field | Value |
|---|---|
| Category | schedule |
| Likelihood | 4 (Likely) |
| Consequence by dimension | Safety 2 / First power-on 4 / Cost 4 / Schedule 4 / Performance margin 3 |
| Consequence (max) | 4 (Major); driving: First power-on, Cost, Schedule |
| Score / band | 16 / Red |
| Assessment confidence | Medium |
| Status / trend | Open / Stable |
| Owner | Robin |
| Opened / horizon | 2026-09-25 / CDR |
| Last assessed | 2026-09-27 (SRR) |
| Source | SI-020 (expedited schedule approved by the owner); opened 2026-09-25 |
| Strategy | Mitigate |
| Plan approval | 2026-09-26, memo docs/reviews/SRR/decision-memo.md |

**Likelihood rationale.** The gate dates are fixed and the product volume for CDR is large; no analysis of the work volume against the windows exists yet. Anchor level 4.

**Consequence rationale.** Driving dimensions first_power_on, cost and schedule at 4: an unreviewed defect in copper is a second fabrication plus assembly run. performance_margin 3: a Baseline requirement may be missed and waived. Safety 2: safety-critical items are Hard products and are excluded from liens by S2.

**Mitigation steps**

| Step | Action | Artifact | Due | Status |
|---|---|---|---|---|
| S1 | CDR readiness declaration: the package entrance checklist lists every Hard CDR product with its independent review record (INSP-NNN) and marks any that is missing before the review opens (01 section 6). | docs/reviews/CDR/package.md (entrance-criteria checklist); docs/reviews/CDR/checklists/<product-slug>.md (INSP-NNN, charter section 5) | CDR | Planned |
| S2 | Lien rule proposed for the owner's CDR agenda: procurement is released only when every Hard product that defines copper, BOM or a hazard control is present and reviewed; liens are allowed only on Soft products and on Hard products that do not change the order (test procedures, handbook drafts). | docs/reviews/CDR/package.md (agenda) and docs/reviews/CDR/decision-memo.md (liens table) | CDR | Planned |
| S3 | Split the procurement into the PCB package (HW-MB-rev<X>-<n>) and the enclosure package (ME-ENC-rev<X>-<n>) so that a lien on one does not hold the other (05 section 4.3). | hardware/releases/HW-MB-rev<X>-<n>/; hardware/releases/ME-ENC-rev<X>-<n>/ | CDR | Planned |
| S4 | Work-volume check before each gate: Claude lists the Hard products not yet started 12 hours before the window and proposes to the owner either a scope cut (defer to a lien) or a gate slip. | docs/plan/schedule.md (gate readiness notes) | PDR | Planned |

**Triggers**

| Condition | Response |
|---|---|
| A Hard CDR product that defines copper, BOM or a hazard control is missing or unreviewed at the CDR readiness check | Claude informs the owner in the same session; the owner chooses to slip CDR or to release with the lien recorded in the decision memo with its closure date |
| More than five PDR liens remain open at CDR entrance | Claude presents the lien burndown first on the CDR agenda; the owner decides which liens block procurement |

**Fallback.** Accept the schedule slip: CDR is reconvened when the Hard products are complete and the vendor order moves by the same amount; the cost of the slip is calendar time only.

**Related.** adr: ADR-001, ADR-007; tpm: TPM-003; stakeholder input: SI-010, SI-020, SI-035; risk: RSK-008

**Closure criteria.** CDR decision memo signed with every Hard product that defines copper, BOM or a hazard control present and independently reviewed, and the orders placed against the released packages.

**History**

| Date | Review | L | C | Safety | Score | Status | Note |
|---|---|---|---|---|---|---|---|
| 2026-09-25 | Pre-SRR | 4 | 4 | 2 | 16 | Proposed | Opened against SI-020; awaiting independent check. |
| 2026-09-25 | Pre-SRR | 4 | 4 | 2 | 16 | Proposed | Independent review 2026-09-25: S1 record path aligned to the charter section 5 INSP record (no separate peer-reviews folder). Score unchanged. |
| 2026-09-25 | SRR | 4 | 4 | 2 | 16 | Proposed | SRR Track pass at package assembly 2026-09-25 (06 section 10 item 1): re-assessed against the SRR research candidate pass; likelihood and consequence unchanged; status stays Proposed until the independent check of docs/reviews/SRR/checklists/risk-register.md. |
| 2026-09-27 | SRR | 4 | 4 | 2 | 16 | Open | Track pass 2026-09-27 (docs/plan/pdr-work-plan.md WP-PDR-18 wave 0; 06 section 9 Track and Control; INSP-007 finding-18, docs/reviews/SRR/checklists/risk-register-06.md), recorded at review point SRR, the last gate passed (06 section 10.3); the PDR Track pass of 06 section 10 item 1 follows at PDR package assembly. Status Proposed to Open: INSP-007 (APPROVED; item CK-RSK-A2) records the Analyze check passing all 65 risks (06 section 9 transition table). The owner approved the PDR work plan revision 2 and its dates on 2026-09-27 (docs/plan/status/status-2026-09-27.md section 4: readiness Tue 10-06, PDR about Thu 10-08, CDR about 10-14 to 10-15), which relaxes the compressed PDR and CDR windows of this condition; docs/plan/schedule.md takes the dates through WP-PDR-02 and WP-PDR-46 (plan section 5.3). Likelihood and consequence unchanged in this pass: the condition and score are re-assessed at the PDR Track pass on the updated schedule. CR-006 revision 2 (Submitted, 39a6b13; section 1.7) proposes changes to this risk; a submitted CR changes no baseline (06 section 10.2 trigger noted), so the changes are applied with a Refs trailer naming the CR after the owner's disposition (WP-PDR-02 and the WP-PDR-18 final pass). This pass keeps the current values. |

### RSK-002

**LO frequency error exceeds the 500 Hz CW filter half-bandwidth**

Given the receiver selectivity is a 500 Hz CW filter and the transmit and receive frequencies derive from a TCXO reference through the synthesizer chosen by cost and performance trade (SI-029, ADR-013); a typical +/-2.5 ppm TCXO alone corresponds to +/-365 Hz at 146 MHz before aging and temperature drift, and each of two cwht units (SI-019) carries its own error, there is a possibility of the net frequency offset between two cwht units, or between a cwht and another station, exceeding the filter half-bandwidth of 250 Hz adversely impacting the RX subsystem (CW filter and LO) and the stakeholder expectation of tuning to a frequency and chatting (SI-005), leading to the other station's signal falling outside the passband, inaudible or badly detuned, so that operators cannot find each other without a search procedure.

| Field | Value |
|---|---|
| Category | technical (tags: software) |
| Likelihood | 4 (Likely) |
| Consequence by dimension | Safety 1 / First power-on 3 / Cost 2 / Schedule 2 / Performance margin 4 |
| Consequence (max) | 4 (Major); driving: Performance margin |
| Score / band | 16 / Red |
| Assessment confidence | High |
| Status / trend | Open / Stable |
| Owner | Claude |
| Opened / horizon | 2026-09-25 / SAR |
| Last assessed | 2026-09-27 (SRR) |
| Source | Formulation risk identification 2026-09-25 against SI-004, SI-005, SI-019 |
| Strategy | Mitigate |
| Plan approval | 2026-09-26, memo docs/reviews/SRR/decision-memo.md |

**Likelihood rationale.** A +/-2.5 ppm reference alone consumes more than the filter half-bandwidth; without a tighter reference, receiver incremental tuning or a wider filter the departure is likely. Anchor level 4: no frequency error budget exists yet.

**Consequence rationale.** Driving dimension performance_margin 4: the stakeholder expectation SI-005 (tune and chat) is not met as stated, although contacts remain possible by searching, so the MOE is degraded rather than lost. first_power_on 3: the radio works but a core use case is degraded until a firmware or filter change. Cost 2: a tighter TCXO grade is a USD 25 to 100 BOM delta over the build quantity.

**Mitigation steps**

| Step | Action | Artifact | Due | Status |
|---|---|---|---|---|
| S1 | Write the frequency error budget: TCXO initial tolerance, aging per year, temperature coefficient over 0 to 40 C, synthesizer resolution, filter center-frequency tolerance; state the worst-case two-unit offset and the offset after a single-point calibration. | docs/design/analysis/frequency-budget.md; docs/plan/tpm.json (TPM-006) | PDR | Planned |
| S2 | Trade study of reference grade (0.5 ppm versus 2.5 ppm TCXO), filter bandwidth (500 Hz fixed versus 500 Hz and 1 kHz selectable) and receiver incremental tuning, scored with the register scales (process section 13). | docs/decisions/trade-studies/TS-NNN-frequency-stability.md | PDR | Planned |
| S3 | Derive SW requirements for receiver incremental tuning, a tuning step of 50 Hz or finer, and a stored frequency calibration constant settable from the menu (frequency control is mission-critical per charter section 10). | docs/requirements/sw/sw-synth/requirements.json (SW-SYNTH, mission-critical frequency control, 07 section 14.1) | CDR | Planned |
| S4 | Write the calibration procedure for the operations handbook: zero-beat against a signal of known frequency (a local repeater output or an already calibrated unit) and store the constant. | docs/ops/operations-handbook.md | SAR | Planned |
| S5 | Analyze the CW filter center-frequency tolerance with a Monte Carlo over component tolerances and include it in the budget. | docs/design/analysis/frequency-budget.md; deck under hardware/sim/rx/ | CDR | Planned |

**Triggers**

| Condition | Response |
|---|---|
| Frequency budget worst-case error after calibration exceeds 100 Hz (40 % of the filter half-bandwidth) | Claude changes the TCXO grade or widens the filter and re-runs the budget before CDR; a CR is opened if a baselined requirement changes |
| The selected TCXO has no distributor stock at PDR | Apply the RSK-005 alternate-part procedure the same session |

**Fallback.** Widen the CW filter to 1 kHz nominal (CR against the selectivity requirement) and rely on receiver incremental tuning; contacts remain possible with reduced propagation advantage (SI-004).

**Related.** adr: ADR-006, ADR-013, ADR-016; tpm: TPM-006; stakeholder input: SI-004, SI-005, SI-019, SI-024, SI-029; risk: RSK-005

**Closure criteria.** Frequency accuracy requirement verified on two delivered units by a zero-beat test with a measured offset of 100 Hz or less after calibration.

**History**

| Date | Review | L | C | Safety | Score | Status | Note |
|---|---|---|---|---|---|---|---|
| 2026-09-25 | Pre-SRR | 4 | 4 | n/r | 16 | Proposed | Opened during Formulation risk identification; awaiting independent check. |
| 2026-09-25 | Pre-SRR | 4 | 4 | 1 | 16 | Proposed | ADR-006, ADR-013, ADR-016 and TPM-006 linked; SW artifact path aligned to 02 section 2.2. Score unchanged. |
| 2026-09-25 | Pre-SRR | 4 | 4 | 1 | 16 | Proposed | Independent review 2026-09-25: tagged software (S3 derives SW-SYNTH requirements; process section 5); S3 artifact names the SW-SYNTH module of 07 section 14.1. Score unchanged. |
| 2026-09-25 | SRR | 4 | 4 | 1 | 16 | Proposed | SRR Track pass at package assembly 2026-09-25 (06 section 10 item 1): re-assessed against the SRR research candidate pass; likelihood and consequence unchanged; status stays Proposed until the independent check of docs/reviews/SRR/checklists/risk-register.md. |
| 2026-09-27 | SRR | 4 | 4 | 1 | 16 | Open | Track pass 2026-09-27 (docs/plan/pdr-work-plan.md WP-PDR-18 wave 0; 06 section 9 Track and Control; INSP-007 finding-18, docs/reviews/SRR/checklists/risk-register-06.md), recorded at review point SRR, the last gate passed (06 section 10.3); the PDR Track pass of 06 section 10 item 1 follows at PDR package assembly. Status Proposed to Open: INSP-007 (APPROVED; item CK-RSK-A2) records the Analyze check passing all 65 risks (06 section 9 transition table). Likelihood and consequence unchanged: no analysis, test, trigger poll or SRR ruling since the SRR Track pass changes this risk's evidence. CR-006 revision 2 (Submitted, 39a6b13; section 1.7) proposes changes to this risk; a submitted CR changes no baseline (06 section 10.2 trigger noted), so the changes are applied with a Refs trailer naming the CR after the owner's disposition (WP-PDR-02 and the WP-PDR-18 final pass). This pass keeps the current values. |

### RSK-001

**PA oscillation or spurious output above simulation at 146 MHz**

Given the 5 W PA (TX) is verified before fabrication only by LTspice simulation with vendor or fitted device models whose accuracy at 144 to 148 MHz and 5 W output has not been confirmed by measurement, the owner's bench has no oscilloscope (SI-013), and the tinySA Ultra spectrum analyzer the owner committed to buy (SI-034) is not yet in hand or characterized (SI-003, SI-010), there is a possibility of the built PA oscillating, or producing harmonic and spurious levels higher than simulated adversely impacting the TX subsystem (PA stage and output low-pass filter) and the 47 CFR 97.307 emission requirements allocated to it, leading to first-power-on failure of the transmitter, a second board spin (USD 300 to 800, 6 to 12 weeks), and a possible emission-limit exceedance that the bench cannot detect until the analyzer and its attenuator are characterized (RSK-011).

| Field | Value |
|---|---|
| Category | technical (tags: regulatory) |
| Likelihood | 3 (Possible) |
| Consequence by dimension | Safety 4 / First power-on 4 / Cost 4 / Schedule 4 / Performance margin 4 |
| Consequence (max) | 4 (Major); driving: Safety, First power-on, Cost, Schedule, Performance margin |
| Score / band | 12 / Red |
| Assessment confidence | Medium |
| Status / trend | Open / Stable |
| Owner | Claude |
| Opened / horizon | 2026-09-25 / SAR |
| Last assessed | 2026-09-27 (SRR) |
| Source | Formulation risk identification 2026-09-25 against SI-003, SI-010, SI-013; condition updated the same day for SI-034; SRR research candidate pass 2026-09-25 merged REFDES-7, PADEV-10, PADEV-13, PATK-10, PATK-12, RF-1; SRR ADR candidate pass 2026-09-25 merged ADR012-R1 |
| Strategy | Mitigate |
| Plan approval | 2026-09-26, memo docs/reviews/SRR/decision-memo.md |

**Likelihood rationale.** Single simulation chain (LTspice) with device models not validated against measured data at VHF and no prototype stage before the turnkey build. Anchor level 3: an analysis will exist but model fidelity is unconfirmed.

**Consequence rationale.** Driving dimensions first_power_on, cost, schedule, performance_margin and safety all at 4: an unstable PA means the core TX function does not work and a second fabrication plus assembly run is needed; a spurious level above the 97.307(e) limit is a regulatory requirement miss (regulatory rule of process section 7); harmful interference to a safety-of-life or other service is the Critical severity of HZ-008, which maps to register safety 4 (hazard link rule, process section 1). PA self-heating itself is bounded by the supply current limit and the thermal response of the safety manager (RSK-006). An output-power shortfall of a stable PA is RSK-027.

**Mitigation steps**

| Step | Action | Artifact | Due | Status |
|---|---|---|---|---|
| S1 | Select an RF power device that satisfies the sourcing constraint of SI-028 (ADR-012), has a vendor SPICE or S-parameter model and a vendor reference design or evaluation board covering 2 m; record the choice in a trade study (single-source and critical part, process section 14.1 (b)). | docs/decisions/trade-studies/TS-001-receiver-and-pa-concept.md (sub-decision P, device choice) | PDR | Planned |
| S2 | Run a small-signal stability analysis (Rollett K and mu factors) of the PA from 1 MHz to 1 GHz in LTspice with results exported and checked by a Python pass/fail script; require K > 1.2 and mu > 1.1 at every frequency with nominal, +10 % and -10 % passive tolerances. | docs/design/analysis/pa-stability.md plus the deck and checker under hardware/sim/pa/ | CDR | Planned |
| S3 | Run a transient FFT of the PA plus output filter at 5 W and show every harmonic and spurious product at least 10 dB below the 97.307(e) limit recorded in the TX regulatory requirement; feed the margin into TPM-007. | docs/design/analysis/pa-spectrum.md; docs/plan/tpm.json (TPM-007) | CDR | Planned |
| S4 | Add design-for-debug provisions: PA supply through a jumper with a current-sense point, bias set by a resistor with alternates listed in the BOM, output pi-network with alternate values, so the PA can be recovered by BOM alternates or vendor rework without a respin. | docs/design/build-to-specification.md (design-for-debug section); hardware/kicad/ TX sheet; hardware/bom/ alternates column | CDR | Planned |
| S5 | Validate the LTspice toolchain (SWE-136) against a published VHF amplifier reference design and record the comparison of gain and stability. | tools/toolchain.lock.md and docs/cm/tool-validation/TV-NNN-ltspice.md | PDR | Planned |
| S6 | Bench bring-up: measure the PA input and output matching networks with the NanoVNA before PA enable; enable the PA at reduced supply voltage first; observe the spectrum on the tinySA Ultra through the characterized attenuator (RSK-011 S2) before full power. | docs/test_cases/tx/test_cases.json (TC-TX bring-up case); docs/vv/plan.md bring-up section | TRR | Planned |
| S7 | Fit the behavioural LTspice PA model to the STEVAL-TDR003V1 published curves (gain versus input at 5, 6 and 7.2 V, drain current versus output) and show agreement before using it for cwht (PATK-10); obtain GRF5604 harmonic data for the fallback before PDR (PATK-12). | hardware/sim/pa/; docs/decisions/trade-studies/TS-NNN-pa-line-up.md (concept section 11.2 PA line-up study; number assigned at creation) | PDR | Planned |

**Triggers**

| Condition | Response |
|---|---|
| Stability analysis shows K < 1.2 or mu < 1.1 at any frequency in 1 MHz to 1 GHz | Claude adds or resizes the stabilization network and re-runs S2 before CDR; likelihood is raised to 4 until the analysis passes |
| Simulated margin to the 97.307(e) limit is below 10 dB at any harmonic | Claude adds a filter section or changes the filter topology before CDR; a CR is opened if a baselined requirement changes |
| PA supply current at first enable exceeds the predicted quiescent current by more than 30 % | Owner stops the test per the TRR procedure; Claude opens an NCR and looks for oscillation with the tinySA Ultra through the characterized attenuator, or with the NanoVNA as a receiver through 40 dB of attenuation if the analyzer is not yet characterized |

**Fallback.** Operate at reduced output power (CR to the 5 W requirement) if the PA is stable only at lower supply voltage; otherwise a second board spin funded from the cost-estimate contingency (RSK-008).

**Related.** hazard: HZ-008; adr: ADR-003, ADR-012; trade study: TS-001; tpm: TPM-004, TPM-007; stakeholder input: SI-003, SI-010, SI-013, SI-028, SI-034; risk: RSK-008, RSK-011, RSK-027, RSK-031

**Closure criteria.** TX output power and spectrum requirements verified on the delivered unit by the methods baselined in the V&V plan, with no NCR open against the PA.

**History**

| Date | Review | L | C | Safety | Score | Status | Note |
|---|---|---|---|---|---|---|---|
| 2026-09-25 | Pre-SRR | 3 | 4 | n/r | 12 | Proposed | Opened during Formulation risk identification; awaiting independent check. |
| 2026-09-25 | Pre-SRR | 3 | 4 | 4 | 12 | Proposed | Condition updated for SI-034 (tinySA Ultra purchase committed); ADR-003 and ADR-012 linked; HZ-008 linked and safety raised to 4 per its Critical severity; artifacts aligned to charter section 5 paths. Max consequence and score unchanged. |
| 2026-09-25 | Pre-SRR | 3 | 4 | 4 | 12 | Proposed | Independent review 2026-09-25: the output-power shortfall is a non-safety departure and moved to RSK-027 (process section 4 family rule); oscillation and excess spurious remain one HZ-008 safety family (same asset, driving dimension and plan). Tagged regulatory (97.307). Score unchanged. |
| 2026-09-25 | SRR | 3 | 4 | 4 | 12 | Proposed | SRR Track pass at package assembly 2026-09-25 (06 section 10 item 1): re-assessed against the SRR research candidate pass; likelihood and consequence unchanged; status stays Proposed until the independent check of docs/reviews/SRR/checklists/risk-register.md. Merged candidates REFDES-7, PADEV-10, PADEV-13, PATK-10, PATK-12, RF-1 (06 section 9 disposition rule; family rule of section 4 applied: same asset, driving dimension, plan and kind); worst member does not raise the score. Step added for the merged candidates. |
| 2026-09-25 | SRR | 3 | 4 | 4 | 12 | Proposed | ADR-012 section 4.4 candidate 'no stocked device has vendor VHF harmonic data' merged: a cause already in the condition (device models unconfirmed at 144 to 148 MHz); the behavioural model and the tinySA measurement are the existing steps. Score unchanged. |
| 2026-09-25 | SRR | 3 | 4 | 4 | 12 | Proposed | INSP-007 (docs/reviews/SRR/checklists/risk-register-06.md) finding F-04: trade-study references corrected (TS-001 is receiver-and-pa-concept, TS-002 is firmware-runtime-make-buy; unwritten studies carry TS-NNN until created) and related.trade_study_ids set for the studies that name this risk. Score unchanged. |
| 2026-09-27 | SRR | 3 | 4 | 4 | 12 | Open | Track pass 2026-09-27 (docs/plan/pdr-work-plan.md WP-PDR-18 wave 0; 06 section 9 Track and Control; INSP-007 finding-18, docs/reviews/SRR/checklists/risk-register-06.md), recorded at review point SRR, the last gate passed (06 section 10.3); the PDR Track pass of 06 section 10 item 1 follows at PDR package assembly. Status Proposed to Open: INSP-007 (APPROVED; item CK-RSK-A2) records the Analyze check passing all 65 risks (06 section 9 transition table). Likelihood and consequence unchanged: no analysis, test, trigger poll or SRR ruling since the SRR Track pass changes this risk's evidence. |

### RSK-006

**PA junction temperature exceeds the device rating at 5 W**

Given the PA dissipates on the order of 4 to 7 W of heat at 5 W RF output (40 to 55 % efficiency) inside a pocket-sized aluminum enclosure designed in OpenSCAD and CNC-machined by PCBWay (SI-001, SI-008, ADR-008); heat must flow from the device thermal pad through PCB vias and a mechanical interface to the enclosure wall, and no thermal instrument beyond a multimeter thermocouple is available (SI-013), there is a possibility of the PA junction temperature exceeding the device rating during sustained CW keying adversely impacting the TX subsystem (PA device) and the sustained 5 W operating scenario, leading to PA derating or thermal shutdown during contacts, and shortened device life or failure of the PA.

| Field | Value |
|---|---|
| Category | technical (tags: software) |
| Likelihood | 3 (Possible) |
| Consequence by dimension | Safety 4 / First power-on 3 / Cost 3 / Schedule 3 / Performance margin 4 |
| Consequence (max) | 4 (Major); driving: Safety, Performance margin |
| Score / band | 12 / Red |
| Assessment confidence | Medium |
| Status / trend | Open / Stable |
| Owner | Claude |
| Opened / horizon | 2026-09-25 / SAR |
| Last assessed | 2026-09-27 (SRR) |
| Source | Formulation risk identification 2026-09-25 against SI-001, SI-003, SI-008; SRR research candidate pass 2026-09-25 merged PATK-11, R-PCB-10 |
| Strategy | Mitigate |
| Plan approval | 2026-09-26, memo docs/reviews/SRR/decision-memo.md |

**Likelihood rationale.** Several watts in a pocket enclosure is a tight thermal design; no thermal budget exists yet and the PCB-to-enclosure interface is undefined. Anchor level 3.

**Consequence rationale.** Driving dimension performance_margin 4: sustained 5 W output (SI-003, a key driving expectation) is not met if the PA must fold back. Safety 4: an overheated device is a cause of HZ-003, which docs/safety/hazards.json 0.2.0-pha rates Critical (register safety 4, the hazard link rule minimum of 06 section 1); the device can be destroyed without fire and the heated enclosure can burn the operator. Cost and schedule 3: an enclosure or interface redesign and a new CNC part. The hand-hold surface temperature is RSK-026.

**Mitigation steps**

| Step | Action | Artifact | Due | Status |
|---|---|---|---|---|
| S1 | Thermal budget: dissipation at an assumed 50 % CW key-down duty cycle and a 5 min continuous key-down worst case; thermal resistance chain junction-to-case, pad-to-PCB, PCB-to-enclosure, enclosure-to-ambient; predicted junction temperature at 25 C and 40 C ambient (the surface prediction is RSK-026 S1 in the same budget). | docs/design/analysis/thermal-budget.md; docs/design/budgets.md (thermal); docs/plan/tpm.json (TPM-004) | PDR | Planned |
| S2 | Design the thermal interface (standoff or gap pad from the PCB thermal area to the enclosure wall) in the OpenSCAD model, render and inspect it (charter section 11 rule 3), and fit-check it with an H2C printed mock-up (SI-012). | hardware/enclosure/*.scad; renders in docs/reviews/PDR/figures/ | CDR | Planned |
| S3 | NTC thermistor at the PA and firmware thermal foldback and shutdown as a safety-critical function (SW-SAFE thermal monitor with SW-TXSEQ actuation, 07 section 14.1; charter section 10, SWE-134 provisions); derive the SW requirements. | docs/requirements/sw/sw-safe/requirements.json; docs/requirements/sw/sw-txseq/requirements.json (modules named in 07 section 14.1) | CDR | Planned |
| S4 | Bench verification: 5 min key-down into the dummy load inside the enclosure while logging the NTC over serial. | docs/test_cases/tx/test_cases.json (TC-TX thermal case) | SAR | Planned |
| S5 | Ask PCBWay for the finished hole-wall copper and the microsection report, and update the via-array thermal resistance in the thermal budget (R-PCB-10, PATK-11). | docs/design/analysis/thermal-budget.md | CDR | Planned |

**Triggers**

| Condition | Response |
|---|---|
| Thermal budget predicts junction temperature above 80 % of the rated maximum at 25 C ambient and 5 min key-down | Claude redesigns the interface or proposes reduced power by CR; the item is a PDR lien until resolved |
| Bench NTC reading rises more than 15 C above the budget prediction | Owner stops the test; Claude opens an NCR and revisits the budget |

**Fallback.** Firmware limits key-down duty cycle or reduces PA drive when hot; the owner accepts reduced sustained power through a CR.

**Related.** hazard: HZ-003; adr: ADR-003, ADR-008; trade study: TS-001; tpm: TPM-004; stakeholder input: SI-001, SI-003, SI-008, SI-012, SI-013; risk: RSK-004, RSK-007, RSK-008, RSK-026

**Closure criteria.** PA thermal requirement verified on the delivered unit at SAR with the 5 min key-down test inside the enclosure and the NTC log within the budget.

**History**

| Date | Review | L | C | Safety | Score | Status | Note |
|---|---|---|---|---|---|---|---|
| 2026-09-25 | Pre-SRR | 3 | 4 | n/r | 12 | Proposed | Opened during Formulation risk identification; awaiting independent check. |
| 2026-09-25 | Pre-SRR | 3 | 4 | 3 | 12 | Proposed | ADR-003 and ADR-008 linked; enclosure artifact aligned to hardware/enclosure/; SW artifact is the sw-safe module. Score unchanged. |
| 2026-09-25 | Pre-SRR | 3 | 4 | 3 | 12 | Proposed | Independent review 2026-09-25: split under process section 4 (junction over-temperature and surface burn harm different assets and have different driving dimensions); the surface temperature moved to RSK-026. Tagged software (S3 derives SW-SAFE and SW-TXSEQ requirements). Score unchanged. |
| 2026-09-25 | Pre-SRR | 3 | 4 | 4 | 12 | Proposed | Re-scored safety 3 to 4 under the hazard link rule (06 section 1): HZ-003 re-rated Marginal to Critical in docs/safety/hazards.json 0.2.0-pha (register minimum 4). Score unchanged (driving dimensions performance_margin 4 and now safety 4). |
| 2026-09-25 | SRR | 3 | 4 | 4 | 12 | Proposed | SRR Track pass at package assembly 2026-09-25 (06 section 10 item 1): re-assessed against the SRR research candidate pass; likelihood and consequence unchanged; status stays Proposed until the independent check of docs/reviews/SRR/checklists/risk-register.md. Merged candidates PATK-11, R-PCB-10 (06 section 9 disposition rule; family rule of section 4 applied: same asset, driving dimension, plan and kind); worst member does not raise the score. Step added for the merged candidates. |
| 2026-09-25 | SRR | 3 | 4 | 4 | 12 | Proposed | INSP-007 (docs/reviews/SRR/checklists/risk-register-06.md) finding F-04: trade-study references corrected (TS-001 is receiver-and-pa-concept, TS-002 is firmware-runtime-make-buy; unwritten studies carry TS-NNN until created) and related.trade_study_ids set for the studies that name this risk. Score unchanged. |
| 2026-09-27 | SRR | 3 | 4 | 4 | 12 | Open | Track pass 2026-09-27 (docs/plan/pdr-work-plan.md WP-PDR-18 wave 0; 06 section 9 Track and Control; INSP-007 finding-18, docs/reviews/SRR/checklists/risk-register-06.md), recorded at review point SRR, the last gate passed (06 section 10.3); the PDR Track pass of 06 section 10 item 1 follows at PDR package assembly. Status Proposed to Open: INSP-007 (APPROVED; item CK-RSK-A2) records the Analyze check passing all 65 risks (06 section 9 transition table). Likelihood and consequence unchanged: no analysis, test, trigger poll or SRR ruling since the SRR Track pass changes this risk's evidence. CR-003 revision 3 (Submitted, d9a215a; section 4 Risk row) proposes changes to this risk; a submitted CR changes no baseline (06 section 10.2 trigger noted), so the changes are applied with a Refs trailer naming the CR after the owner's disposition (WP-PDR-02 and the WP-PDR-18 final pass). This pass keeps the current values. |

### RSK-011

**Spurious emissions not credibly measured before on-air use**

Given 47 CFR 97.307(e) limits spurious emissions of a transmitter of 25 W or less to 25 microwatts and at least 40 dB below the fundamental (53 dB below 5 W); the owner's bench has a NanoVNA, dummy load, bench supply and multimeter (SI-013), the owner has committed to buy a tinySA Ultra (SI-034, closing OQ-VV-001 of 04 section 6.3) that is not yet in hand, is uncalibrated, and needs a 30 to 40 dB 10 W attenuator whose loss and the analyzer's level accuracy and noise floor at 2 to 5 times the carrier have not been characterized, there is a possibility of the delivered transmitter exceeding the spurious emission limit without the exceedance being detected before the on-air series adversely impacting the TX subsystem and the regulatory compliance of the owner as licensee (SI-014), leading to harmful interference and a Part 97 violation, or a regulatory requirement closed by Analysis only against the run-for-the-record principle of charter section 9.

| Field | Value |
|---|---|
| Category | technical (tags: regulatory) |
| Likelihood | 3 (Possible) |
| Consequence by dimension | Safety 4 / First power-on 2 / Cost 3 / Schedule 2 / Performance margin 4 |
| Consequence (max) | 4 (Major); driving: Safety, Performance margin |
| Score / band | 12 / Red |
| Assessment confidence | High |
| Status / trend | Open / Stable |
| Owner | Robin |
| Opened / horizon | 2026-09-25 / SAR |
| Last assessed | 2026-09-27 (SRR) |
| Source | Formulation risk identification 2026-09-25 against SI-013, SI-014, SI-021; re-assessed the same day for SI-034; 04 section 6.3 names this risk as 'Part 97 compliance verified by analysis only'; SRR research candidate pass 2026-09-25 merged RF-5 |
| Strategy | Mitigate |
| Plan approval | 2026-09-26, memo docs/reviews/SRR/decision-memo.md |

**Likelihood rationale.** The instrument decision is made (SI-034) but the measurement chain is unproven; until the attenuator and analyzer are characterized the detection probability of a PA or filter deviation from simulation (RSK-001, RSK-004) is unknown. Anchor level 3: a measurement path exists but its fidelity is unconfirmed.

**Consequence rationale.** Driving dimensions performance_margin and safety at 4: the regulatory rule of process section 7 (any departure that could breach 97.307 scores at least 4), and HZ-008 rates harmful interference to a safety-of-life or other radio service as Critical, which maps to register safety 4. Cost 3: the analyzer plus attenuator is USD 100 to 300 (04 section 6.3).

**Mitigation steps**

| Step | Action | Artifact | Due | Status |
|---|---|---|---|---|
| S1 | Close OQ-VV-001: transcribe the owner's SI-034 decision into the test-instruments ADR, purchase the tinySA Ultra and a 30 to 40 dB 10 W attenuator, and move the spurious, output power, frequency accuracy and MDS requirements to method Test by CR before the V&V plan baseline (04 section 6.3, yes branch). | docs/decisions/adr/ADR-NNN-test-instruments.md; CR-NNN against the affected REQ-TX-* and REQ-RX-*; docs/vv/plan.md section 5.3 | PDR | Planned |
| S2 | Measurement-chain characterization case: attenuator S21 at 146 MHz and at 2 to 5 times the carrier on the NanoVNA, tinySA Ultra level accuracy against the NanoVNA output, noise floor at each harmonic with the attenuator in line; the case must pass before any spurious case runs for credit. | docs/test_cases/sys/test_cases.json (SYS instrument characterization case); docs/vv/reports/<TC-ID>-r<N>.md | TRR | Planned |
| S3 | Design the output low-pass filter for at least 15 dB margin to the 97.307(e) limit at every harmonic up to the fifth with component tolerances; report the margin as TPM-007. | docs/design/analysis/pa-spectrum.md; docs/plan/tpm.json (TPM-007) | CDR | Planned |
| S4 | Provide a filter test point (U.FL or pad pair) so the assembled filter's insertion loss at 2 and 3 times the carrier can be measured with the NanoVNA with the PA unpowered, as Inspection evidence independent of the analyzer. | hardware/kicad/ TX sheet; docs/test_cases/tx/test_cases.json (TC-TX filter case) | CDR | Planned |
| S5 | On-air authorization path: the on-air delta TRR (TRR-Dn, charter section 3, 01 section 7.6 (c)) requires every regulatory REQ-TX-* case Passed; if the measurement is not credible by then, the owner's OnAir authorization on Analysis plus measured filter S21 is recorded in docs/reviews/TRR-Dn/decision-memo.md and this risk stays open (04 section 6.3, no branch). | docs/reviews/TRR-Dn/decision-memo.md (OnAir authorization section) | SAR | Planned |
| S6 | Report 2f, 3f and 7f individually in the spurious test report with the victim service named (military fixed and mobile, 70 cm and radiolocation, 1030 MHz SSR, IFF and DME; RF-10, RF-5). | docs/test_cases/sys/test_cases.json (REQ-SYS-017 and REQ-SYS-018 cases) | SAR | Planned |

**Triggers**

| Condition | Response |
|---|---|
| The tinySA Ultra or the attenuator is not delivered and characterized (S2 Passed) before the first TRR | Spurious cases are Blocked; the on-air delta TRR is not held until S2 passes or the owner records the OnAir authorization on Analysis (S5) |
| Simulated margin to the 97.307(e) limit is below 15 dB at any harmonic while spurious verification is not yet Test | Claude adds a filter section before CDR |
| A measured spurious level is within 6 dB of the 97.307(e) limit | Owner stops on-air use; Claude opens an NCR and re-runs the filter analysis against the measured PA spectrum |

**Fallback.** 04 section 6.3 no branch: spurious requirement verified by Analysis plus the NanoVNA filter measurement, OnAir authorization recorded by the owner in the TRR-Dn decision memo, and this risk kept open until a measurement with the characterized chain or a borrowed instrument is obtained.

**Related.** hazard: HZ-008; adr: ADR-003; tpm: TPM-007; stakeholder input: SI-013, SI-014, SI-021, SI-034; risk: RSK-001, RSK-004

**Closure criteria.** Spurious emission requirement verified by Test on the delivered unit with the characterized measurement chain (S2 Passed) and the report attached to the SAR package.

**History**

| Date | Review | L | C | Safety | Score | Status | Note |
|---|---|---|---|---|---|---|---|
| 2026-09-25 | Pre-SRR | 4 | 4 | n/r | 16 | Proposed | Opened as 'Spurious emissions cannot be measured on the owner's bench'; awaiting independent check. |
| 2026-09-25 | Pre-SRR | 3 | 4 | 4 | 12 | Proposed | Re-assessed for SI-034 (owner will purchase a tinySA Ultra): likelihood 4 to 3; departure re-worded to 'not credibly measured'; steps aligned to 04 section 6.3 and the on-air delta TRR; HZ-008 linked, safety 4 per its Critical severity. |
| 2026-09-25 | SRR | 3 | 4 | 4 | 12 | Proposed | SRR Track pass at package assembly 2026-09-25 (06 section 10 item 1): re-assessed against the SRR research candidate pass; likelihood and consequence unchanged; status stays Proposed until the independent check of docs/reviews/SRR/checklists/risk-register.md. Merged candidates RF-5 (06 section 9 disposition rule; family rule of section 4 applied: same asset, driving dimension, plan and kind); worst member does not raise the score. Step added for the merged candidates. |
| 2026-09-27 | SRR | 3 | 4 | 4 | 12 | Open | Track pass 2026-09-27 (docs/plan/pdr-work-plan.md WP-PDR-18 wave 0; 06 section 9 Track and Control; INSP-007 finding-18, docs/reviews/SRR/checklists/risk-register-06.md), recorded at review point SRR, the last gate passed (06 section 10.3); the PDR Track pass of 06 section 10 item 1 follows at PDR package assembly. Status Proposed to Open: INSP-007 (APPROVED; item CK-RSK-A2) records the Analyze check passing all 65 risks (06 section 9 transition table). Likelihood and consequence unchanged: no analysis, test, trigger poll or SRR ruling since the SRR Track pass changes this risk's evidence. |

### RSK-016

**RF exposure controls not achieved or verified before on-air use**

Given the radio transmits up to 5 W at 144 to 148 MHz with the whip within 20 cm of the operator's head or hand (HZ-001, portable SAR regime of 47 CFR 2.1093) and near bystanders evaluated at the general-population limits of 47 CFR 1.1310 (HZ-006), and the antenna tip and connector carry RF voltages that can burn on contact (HZ-012); SI-030 places operators under the controlled limits and everyone else under the general-population limits, and the controls proposed in the hazard analysis (selectable power steps held by ALC, 1 W default, tune-carrier time-out, guest lock, handbook, enclosure legend, RF exposure evaluation) are not yet designed or verified, there is a possibility of the RF exposure evaluation or one of its controls (power-step accuracy, default step, tune time-out, guest lock, antenna guidance) not being achieved or verified on the delivered unit before the on-air series adversely impacting the operator and bystanders (HZ-001, HZ-006, HZ-012), the TX subsystem and the licensee's RF exposure obligations under 47 CFR Part 97 and 47 CFR 1.1307, leading to exposure above the applicable limit or an RF burn, and an on-air series that cannot be authorized because a regulatory obligation is unverified.

| Field | Value |
|---|---|
| Category | safety (tags: regulatory, hsi, software) |
| Likelihood | 3 (Possible) |
| Consequence by dimension | Safety 4 / First power-on 2 / Cost 2 / Schedule 2 / Performance margin 4 |
| Consequence (max) | 4 (Major); driving: Safety, Performance margin |
| Score / band | 12 / Red |
| Assessment confidence | Medium |
| Status / trend | Mitigating / Stable |
| Owner | Claude |
| Opened / horizon | 2026-09-25 / SAR |
| Last assessed | 2026-09-27 (SRR) |
| Source | Hazard link rule (process section 1) for HZ-001, HZ-006 and HZ-012 of docs/safety/hazards.json; SI-030; opened 2026-09-25; ConOps section 8 candidate RFX-R2 (docs/research/rf-exposure-evaluation.md, continuous tune carrier near a non-licensee) merged 2026-09-25; SRR research candidate pass 2026-09-25 merged ANT-R5, REG-2, RFX-R4, RFX-R5 |
| Strategy | Mitigate |
| Plan approval | 2026-09-26, memo docs/reviews/SRR/decision-memo.md |

**Likelihood rationale.** The controls are defined in the hazard analysis and the evaluation follows a published method (OET 65), but no evaluation has been performed and the power-step accuracy that every control rests on is unconfirmed. Anchor level 3.

**Consequence rationale.** Driving dimensions safety and performance_margin at 4: HZ-006 (bystander exposure above the general-population limit) is Critical, which maps to register safety 4, and an unverified RF exposure obligation is a Part 97 regulatory requirement not met. first_power_on 2: power-step corrections are firmware or configuration changes. Cost 2: a different reference antenna or a printed spacer.

**Mitigation steps**

| Step | Action | Artifact | Due | Status |
|---|---|---|---|---|
| S1 | RF Exposure Evaluation as a controlled document (HZ-001 K8): SAR and MPE tiers per SI-030, ConOps postures, each power step, time averaging, the reference antennas, with margin stated per posture. | docs/design/analysis/rf-exposure-evaluation.md | PDR | Planned |
| S2 | Derive requirements from the hazard controls: power steps 0.5, 1, 2 and 5 W within +/-1 dB held by ALC, 1 W default at first boot and after a configuration reset, tune carrier at 0.5 W with a 10 s time-out, the guest lock of ADR-015, the permanent enclosure legend. | docs/requirements/tx/requirements.json; docs/requirements/sw/sw-txseq/requirements.json and docs/requirements/sw/sw-safe/requirements.json (modules named in 07 section 14); docs/requirements/me/requirements.json | PDR | Planned |
| S3 | ConOps nominal posture and operator model OPS-A (ADR-014, ADR-015) with the distance rules for non-operators (HZ-001 K6, HZ-006 K4, K8). | docs/conops/conops.md | SRR | Done (docs/conops/conops.md (commit 28e49e6): section 3.6 (P1 table-top or lap posture primary, antenna 20 cm or more from head and torso; P4 at the face off-nominal; operating rule of 0.6 m from any keyed antenna and 1.0 m during a tune carrier for everyone but the operator, non-licensees at 1 W or below); section 3.7 (OPS-A default, OPS-B and OPS-C conditions); scenarios OPS-018 and OPS-019) |
| S4 | Bench verification of every power step into the dummy load with the RF probe and the tinySA Ultra (04 section 6.2) and of the tune and stuck-key time-outs. | docs/test_cases/tx/test_cases.json (TC-TX power step and time-out cases) | SAR | Planned |
| S5 | Operations handbook RF exposure section and rules card (HZ-001 K5, HZ-006 K4) and the HSI section of the SEMP covering RF-exposure safety (charter section 12). | docs/ops/operations-handbook.md; docs/plan/semp.md section 7.3 | SAR | Planned |
| S6 | RF exposure evaluation states the 0 dBd gain envelope and a 50 % duty sensitivity case, and a host test measures the keyer key-down fraction at 5, 25 and 50 WPM (ANT-R5, RFX-R4, RFX-R5; RFX-A4). | docs/design/analysis/rf-exposure-evaluation.md; docs/test_cases/sw-keyer/test_cases.json | PDR | Planned |

**Triggers**

| Condition | Response |
|---|---|
| The evaluation shows the 5 W step exceeding a limit in any ConOps posture | Claude proposes a lower maximum step for that posture or a reference antenna change before CDR; the item is a PDR lien |
| A power step measures outside +/-1 dB at TRR | Claude opens an NCR; the on-air delta TRR is not held until the step is within tolerance or the evaluation is redone at the measured power |
| The on-air delta TRR entrance lacks the evaluation or the S4 report | The owner cannot authorize the on-air series (charter section 3); Claude reports the miss in the TRR-Dn package |

**Fallback.** Limit the delivered units to the highest power step the evaluation clears in the hand-held posture (CR to the 5 W requirement for portable use), with 5 W permitted only on an external antenna at the evaluated distance.

**Related.** hazard: HZ-001, HZ-006, HZ-012; adr: ADR-003, ADR-014, ADR-015; stakeholder input: SI-003, SI-019, SI-030, SI-034; risk: RSK-012, RSK-024, RSK-028, RSK-029, RSK-030

**Closure criteria.** RF exposure evaluation approved at PDR and updated at CDR, every control requirement verified on the delivered unit, and the on-air authorization in the TRR-Dn decision memo citing them.

**History**

| Date | Review | L | C | Safety | Score | Status | Note |
|---|---|---|---|---|---|---|---|
| 2026-09-25 | Pre-SRR | 3 | 4 | 4 | 12 | Proposed | Opened under the hazard link rule for HZ-001, HZ-006 and HZ-012; awaiting independent check. |
| 2026-09-25 | Pre-SRR | 3 | 4 | 4 | 12 | Proposed | Independent review 2026-09-25: tagged software (S2 derives SW-TXSEQ and SW-SAFE requirements; process section 5); the controls listed in the departure are one safety family (same persons, HZ-001, HZ-006, HZ-012, same plan; process section 4); candidate RFX-R2 merged (its tune time-out is an S2 control). Score unchanged. |
| 2026-09-25 | SRR | 3 | 4 | 4 | 12 | Proposed | SRR Track pass at package assembly 2026-09-25 (06 section 10 item 1): re-assessed against the SRR research candidate pass; likelihood and consequence unchanged; status stays Proposed until the independent check of docs/reviews/SRR/checklists/risk-register.md. Merged candidates ANT-R5, REG-2, RFX-R4, RFX-R5 (06 section 9 disposition rule; family rule of section 4 applied: same asset, driving dimension, plan and kind); worst member does not raise the score. Step added for the merged candidates. |
| 2026-09-25 | SRR | 3 | 4 | 4 | 12 | Proposed | S3 closed (SRR readiness item H9, risk manager): checked docs/conops/conops.md at commit 28e49e6 against the three controls the step names. HZ-001 K6 (antenna base 20 cm or more from head and torso in the nominal posture; face posture off-nominal): section 3.6 posture P1 primary and P4 off-nominal (OPS-022). HZ-006 K4 (others at 0.6 m or more while keying and 1.0 m during tune; non-licensees at the 0.5 W or 1 W step under continuous supervision): section 3.6 operating rule and OPS-018, OPS-019. HZ-006 K8 (operator model OPS-A): section 3.7. The ConOps independent review record (package item H1) confirms the content; owner decision 17 disposes ADR-015 (RSK-028 S2). Likelihood unchanged: the posture and distance rules are procedures, and the evaluation (S1, S6) and the Bench power-step verification (S4) that bound the exposure are not yet done. |
| 2026-09-27 | SRR | 3 | 4 | 4 | 12 | Mitigating | Track pass 2026-09-27 (docs/plan/pdr-work-plan.md WP-PDR-18 wave 0; 06 section 9 Track and Control; INSP-007 finding-18, docs/reviews/SRR/checklists/risk-register-06.md), recorded at review point SRR, the last gate passed (06 section 10.3); the PDR Track pass of 06 section 10 item 1 follows at PDR package assembly. Status Proposed to Open: INSP-007 (APPROVED; item CK-RSK-A2) records the Analyze check passing all 65 risks (06 section 9 transition table). Then Open to Mitigating: step S3 Done (06 section 9 transition). SRR decision 17 (owner ruling 2026-09-26) accepted ADR-015 (OPS-A default, OPS-B only by a dated record), which the 2026-09-25 S3 note described as a pending ruling ('owner decision 17 disposes ADR-015'); it is recorded here in the past tense, with decisions 18 (OPS-B keeps the 1 W limit until a dated owner record), 19 (guest lock included) and 20 (guest keying at 0.5 W and 1 W with the control operator present). Likelihood unchanged at 3: the RF Exposure Evaluation (S1, S6) and the requirement derivation (S2) are due PDR and not yet done. |

### RSK-017

**Headphone output limiting fails to bound the sound level**

Given receive audio and sidetone are delivered to headphones of 16 to 64 ohm with sensitivities up to about 122 dB per volt; an unrestricted headphone amplifier of the class under consideration can produce 113 to 126 dB SPL and a firmware fault can output a full-scale tone or a click at key-down or power-on (HZ-005); audio output limiting is a safety-critical software function (charter section 10), and the hardware ceiling network and the limiter are proposed controls, not yet designed, there is a possibility of the hardware output ceiling or the sample-domain limiter failing to bound the headphone level, or a full-scale tone or click reaching the headphones at key-down, power-on or on a firmware fault adversely impacting the operator's hearing (HZ-005), the RX audio chain and the sidetone, leading to acoustic shock or a hearing threshold shift for the operator.

| Field | Value |
|---|---|
| Category | safety (tags: hsi, software) |
| Likelihood | 3 (Possible) |
| Consequence by dimension | Safety 4 / First power-on 3 / Cost 2 / Schedule 2 / Performance margin 3 |
| Consequence (max) | 4 (Major); driving: Safety |
| Score / band | 12 / Red |
| Assessment confidence | Medium |
| Status / trend | Open / Stable |
| Owner | Claude |
| Opened / horizon | 2026-09-25 / SAR |
| Last assessed | 2026-09-27 (SRR) |
| Source | Hazard link rule (process section 1) for HZ-005 of docs/safety/hazards.json; charter section 10 (audio output limiting is safety-critical); opened 2026-09-25; ConOps section 8 candidate R-AUD-3 (docs/research/audio-output-and-hearing-safety.md, earbuds louder than the EN model) merged 2026-09-25 |
| Strategy | Mitigate |
| Plan approval | 2026-09-26, memo docs/reviews/SRR/decision-memo.md |

**Likelihood rationale.** The controls are defined in the hazard analysis and are conventional (passive ceiling, limiter, mute ramp, enable sequencing), but no level budget exists and the earbud sensitivity spread is wide. Anchor level 3.

**Consequence rationale.** Driving dimension safety 4: HZ-005 (hearing damage) is Critical, which maps to register safety 4. first_power_on 3: a passive network change is an 0402 rework the owner cannot do, so the audio subsystem is degraded until vendor rework. performance_margin 3: the headphone level-cap requirement (MOP-013) is not met. A capped sidetone that is too quiet is a plan trigger, not this departure.

**Mitigation steps**

| Step | Action | Artifact | Due | Status |
|---|---|---|---|---|
| S1 | Audio level budget: headphone output into 32 ohm not above 150 mVrms for any digital input and 100 mVrms for a full-scale sine, with the passive ceiling network arranged so that no single component failure raises the output (HZ-005 K1, K7); worst-case SPL for the most sensitive earbud including the up to 5 dB excess over the EN 50332-2 assumption (R-AUD-3). | docs/design/analysis/audio-level-budget.md; hardware/kicad/ RX audio sheet | CDR | Planned |
| S2 | Derive requirements from the hazard controls: default level cap until the operator acknowledges the unlock, limiter attack at or below 1 ms, receive audio faded to -60 dBFS within 2 ms of key-down, amplifier enable asserted only after the audio source is settled, switched-jack detection. | docs/requirements/rx/requirements.json; docs/requirements/sw/sw-audio/requirements.json (SW-AUDIO audio limiter, 07 section 14.1) | PDR | Planned |
| S3 | HostUnit tests injecting full-scale patterns, clicks, power-on and key-down transitions against the limiter and fade requirements. | docs/test_cases/sw-audio/test_cases.json; firmware/cwht-core/ audio tests | CDR | Planned |
| S4 | Bench: output voltage into a 32 ohm load with the multimeter (AC) at maximum volume, at power-on, at key-down and with the limiter fault-injected. | docs/test_cases/rx/test_cases.json (TC-RX headphone level case) | SAR | Planned |
| S5 | Operations handbook level policy, the unlock and its expiry, and the recommendation on headphone sensitivity (HZ-005 K8). | docs/ops/operations-handbook.md | SAR | Planned |

**Triggers**

| Condition | Response |
|---|---|
| The level budget shows more than 150 mVrms into 32 ohm possible under any single component fault | Claude redesigns the ceiling network before CDR; the item is a PDR lien if found at PDR |
| Bench measures more than 150 mVrms into 32 ohm in any S4 condition | Owner stops the test; Claude opens an S1-severity NCR (04 section 10) and the unit is not handed over until fixed |
| The owner reports discomfort from the sidetone or clicks, or a capped sidetone too quiet to key by, in the dev-board check (RSK-012 S3) | Claude re-tunes the default cap and the fade ramp before CDR |

**Fallback.** Fixed series resistor pad in the headphone line sized so that the most sensitive earbud cannot exceed the 85 dB(A)-class level, accepting reduced loudness on low-sensitivity headphones; CR to the audio requirements.

**Related.** hazard: HZ-005; stakeholder input: SI-005, SI-006, SI-019; risk: RSK-012, RSK-032

**Closure criteria.** HZ-005 controls verified on the delivered unit (Bench level measurement and HostUnit limiter cases Passed) and the residual accepted by the owner at SAR.

**History**

| Date | Review | L | C | Safety | Score | Status | Note |
|---|---|---|---|---|---|---|---|
| 2026-09-25 | Pre-SRR | 3 | 4 | 4 | 12 | Proposed | Opened under the hazard link rule for HZ-005; awaiting independent check. |
| 2026-09-25 | Pre-SRR | 3 | 4 | 4 | 12 | Proposed | Independent review 2026-09-25: tagged software; S2 and S3 artifacts name the SW-AUDIO module of 07 section 14.1; the over-limiting outcome removed from the consequence (a trigger, not this departure); limiter and click failure modes kept as one HZ-005 safety family (process section 4); candidate R-AUD-3 merged into S1. Score unchanged. |
| 2026-09-25 | SRR | 3 | 4 | 4 | 12 | Proposed | SRR Track pass at package assembly 2026-09-25 (06 section 10 item 1): re-assessed against the SRR research candidate pass; likelihood and consequence unchanged; status stays Proposed until the independent check of docs/reviews/SRR/checklists/risk-register.md. |
| 2026-09-27 | SRR | 3 | 4 | 4 | 12 | Open | Track pass 2026-09-27 (docs/plan/pdr-work-plan.md WP-PDR-18 wave 0; 06 section 9 Track and Control; INSP-007 finding-18, docs/reviews/SRR/checklists/risk-register-06.md), recorded at review point SRR, the last gate passed (06 section 10.3); the PDR Track pass of 06 section 10 item 1 follows at PDR package assembly. Status Proposed to Open: INSP-007 (APPROVED; item CK-RSK-A2) records the Analyze check passing all 65 risks (06 section 9 transition table). Likelihood and consequence unchanged: no analysis, test, trigger poll or SRR ruling since the SRR Track pass changes this risk's evidence. |

### RSK-024

**Transmitter keyed without operator intent or held on**

Given keying drives PA enable and is a safety-critical software function (charter section 10; SW-KEYER, SW-TXSEQ and SW-SAFE in 07 section 14.1); one 3.5 mm TRS key jack accepts straight keys, paddles and mono plugs (SI-018, SI-034, ADR-009); HZ-004 names the causes (a closed or stuck contact at power-on or during operation, a mono plug read as a closed ring, a firmware or reset fault) and HZ-010 adds RF pickup on key leads about half a wavelength long at 146 MHz; their controls, including an independent hardware PA-enable cutoff of 7.5 to 13 s (HZ-004 K5), are allocated to requirements (HZ-004 K4 to REQ-SYS-054 and REQ-SYS-184, K5 to REQ-SYS-055, K12 to REQ-SYS-180) and not yet designed or verified; a toggling TX_KEY stream is bounded by the no-gap watchdog (HZ-004 K4, SRR decision 37) and the transmission-length hardware backstop of 150 s to 180 s (HZ-004 K12, SRR decision 38; OQ-SAF-003 closed), neither yet designed (hazard-analysis section 8.2 row 3), there is a possibility of the transmitter being keyed without operator intent, or held on after the operator releases the key, beyond the bound of the HZ-004 time-outs adversely impacting the TX PA enable path (SW-KEYER, SW-TXSEQ, SW-SAFE and the hardware cutoff), the operator and bystanders (HZ-004, HZ-010) and the licensee's Part 97 compliance, leading to an unintended carrier that heats the PA and exposes bystanders until a time-out acts, interference to other stations, and a firmware or key-input rework.

| Field | Value |
|---|---|
| Category | safety (tags: software, hsi) |
| Likelihood | 3 (Possible) |
| Consequence by dimension | Safety 4 / First power-on 3 / Cost 2 / Schedule 2 / Performance margin 3 |
| Consequence (max) | 4 (Major); driving: Safety |
| Score / band | 12 / Red |
| Assessment confidence | Medium |
| Status / trend | Open / Stable |
| Owner | Claude |
| Opened / horizon | 2026-09-25 / SAR |
| Last assessed | 2026-09-27 (SRR) |
| Source | Split from RSK-012 on 2026-09-25 after independent review (process section 4: a safety departure cannot share a family with keyer usability); hazard link rule (process section 1) for HZ-004 and HZ-010; ConOps section 8 candidates R1 (docs/research/keyer-and-key-interfaces.md), R-KN3 (docs/research/keyer-verification-and-key-input-network.md) and ANT-R4 key-lead pickup (docs/research/antenna-and-erp.md) merged 2026-09-25; SRR research candidate pass 2026-09-25 merged R-UI-07, R3, R-KN1, R-KN5 |
| Strategy | Mitigate |
| Plan approval | 2026-09-26, memo docs/reviews/SRR/decision-memo.md |

**Likelihood rationale.** Stuck-contact and mono-plug keying at power-on are documented field problems of CW radios (Elecraft, QRP Labs; docs/research/keyer-and-key-interfaces.md R1); the controls are defined but none is designed. Anchor level 3.

**Consequence rationale.** Driving dimension safety 4: HZ-004 (unintended or stuck transmission) is Critical, which maps to register safety 4. first_power_on 3: a key-input network or cutoff change is a vendor rework. performance_margin 3: the unintended-transmission bound (MOP-014) is a Baseline requirement.

**Mitigation steps**

| Step | Action | Artifact | Due | Status |
|---|---|---|---|---|
| S1 | Derive the SW requirements from the HZ-004 controls: power-on interlock with both inputs open for 500 ms (K1), explicit straight-on-tip mode selection (K2), straight-key time-out of 5 s (K3), paddle watchdog (K4), CPU watchdog of at most 2 s before transmit can be armed (K7), two independent software conditions for RF (K8), debounce and stuck-input detection (K9); key-down time-out and PA-enable watchdog per the SWE-134 provisions (moved from RSK-012 S4). | docs/requirements/sw/sw-keyer/requirements.json; docs/requirements/sw/sw-txseq/requirements.json; docs/requirements/sw/sw-safe/requirements.json | PDR | Planned |
| S2 | Hardware controls: independent PA-enable cutoff monostable of 7.5 to 13 s (HZ-004 K5), TX_KEY and PA_EN pull-downs (K6), key-line ESD and RF network with common-mode suppression of at least 500 ohm at 146 MHz (HZ-010 K1, K4). | docs/requirements/ctl/requirements.json; docs/requirements/tx/requirements.json; hardware/kicad/ CTL and TX sheets | CDR | Planned |
| S3 | HostUnit tests of the interlock, time-outs, watchdog and two-condition PA permit with injected stuck contacts, mono plugs and resets; independence-pair tables for the PA-permit decision (RSK-010). | docs/test_cases/sw-keyer/test_cases.json; docs/test_cases/sw-txseq/test_cases.json; firmware/cwht-core/ tests | CDR | Planned |
| S4 | Bench: hardware cutoff time measured with the firmware time-out disabled in the bench test build; RF-immunity case with a 1 m cable on the key jack while keying 5 W into the dummy load, zero false state changes in a 5 min logic capture (HZ-010 K6). | docs/test_cases/tx/test_cases.json; docs/test_cases/ctl/test_cases.json | SAR | Planned |
| S5 | Handbook one-line plug check and the meaning of the KEY CLOSED message (HZ-004 K10, R-KN3), with the key jack wiring of ICD-CTL-KEY (RSK-012 S5). | docs/ops/operations-handbook.md; docs/icd/ICD-CTL-KEY.md | SAR | Planned |
| S6 | Choose the cutoff timing capacitor from its vendor DC-bias curve at 3.3 V and bench-time T_max on every unit (R-KN1); make the cutoff node a criterion of the ALC and envelope study (TS-NNN) so the cutoff silences a driven device under any single fault (R-KN5). | docs/decisions/trade-studies/TS-NNN-alc-envelope.md (concept section 11.2 ALC and envelope study; number assigned at creation); docs/test_cases/sys/test_cases.json (REQ-SYS-055 case) | PDR | Planned |

**Triggers**

| Condition | Response |
|---|---|
| No key-down time-out or PA-permit requirement exists in the SW baseline at PDR | The reviewer raises a RID against the SW requirements; the item is a PDR lien (moved from RSK-012) |
| A HostUnit or Bench case shows a carrier longer than the HZ-004 bound (hardware 13 s, firmware time-out) | Owner stops the test; Claude opens an S1-severity NCR (04 section 10) and re-assesses this risk the same session |
| The owner reports an unexpected key-down in the dev-board check (RSK-012 S3) | Claude root-causes it before CDR and adds the case to S3 |

**Fallback.** The hardware cutoff alone bounds any carrier to 13 s; if the firmware controls are not verified by TRR, the on-air delta TRR is not held and bench use continues into the dummy load only.

**Related.** hazard: HZ-004, HZ-010; adr: ADR-009, ADR-010; tpm: TPM-013; stakeholder input: SI-005, SI-018, SI-034; risk: RSK-008, RSK-010, RSK-012, RSK-016

**Closure criteria.** HZ-004 and HZ-010 controls verified on the delivered unit (HostUnit and Bench cases Passed, hardware cutoff measured) and the residual accepted by the owner in the SAR decision memo.

**History**

| Date | Review | L | C | Safety | Score | Status | Note |
|---|---|---|---|---|---|---|---|
| 2026-09-25 | Pre-SRR | 3 | 4 | 4 | 12 | Proposed | Split from RSK-012 after independent review; carries HZ-004 and HZ-010 under the hazard link rule; awaiting independent check. |
| 2026-09-25 | SRR | 3 | 4 | 4 | 12 | Proposed | SRR Track pass at package assembly 2026-09-25 (06 section 10 item 1): re-assessed against the SRR research candidate pass; likelihood and consequence unchanged; status stays Proposed until the independent check of docs/reviews/SRR/checklists/risk-register.md. Merged candidates R-UI-07, R3, R-KN1, R-KN5 (06 section 9 disposition rule; family rule of section 4 applied: same asset, driving dimension, plan and kind); worst member does not raise the score. Step added for the merged candidates. Condition names the toggling-stream gap and K12 (OQ-SAF-020 action). |
| 2026-09-25 | SRR | 3 | 4 | 4 | 12 | Proposed | INSP-007 (docs/reviews/SRR/checklists/risk-register-06.md) finding F-04: trade-study references corrected (TS-001 is receiver-and-pa-concept, TS-002 is firmware-runtime-make-buy; unwritten studies carry TS-NNN until created) and related.trade_study_ids set for the studies that name this risk. Score unchanged. |
| 2026-09-27 | SRR | 3 | 4 | 4 | 12 | Open | Track pass 2026-09-27 (docs/plan/pdr-work-plan.md WP-PDR-18 wave 0; 06 section 9 Track and Control; INSP-007 finding-18, docs/reviews/SRR/checklists/risk-register-06.md), recorded at review point SRR, the last gate passed (06 section 10.3); the PDR Track pass of 06 section 10 item 1 follows at PDR package assembly. Status Proposed to Open: INSP-007 (APPROVED; item CK-RSK-A2) records the Analyze check passing all 65 risks (06 section 9 transition table). Condition restated after SRR decisions 37 (no-gap watchdog with the 2 s squeeze limit) and 38 (transmission-length backstop, 150 s to 180 s), owner ruling 2026-09-26, which the condition described as pending. Likelihood unchanged at 3: the controls are requirements, none is designed. |

### RSK-026

**Enclosure hand-hold surface exceeds 48 C during sustained keying**

Given the aluminum enclosure is the PA heatsink (ADR-008) and the PA dissipates on the order of 4 to 7 W at 5 W output; HZ-003 K1 sets the hand-hold surface limit at 48 C for 5 min of continuous key-down at 5 W and 25 C ambient (a project proposal, hazard analysis open item 7); no thermal budget exists yet and the only thermal instrument is the multimeter thermocouple (SI-013), there is a possibility of the enclosure hand-hold surface exceeding 48 C during sustained CW keying at 5 W adversely impacting the operator's hand (HZ-003) and the ME enclosure, leading to a contact burn at the hand-hold surface, up to a burn needing medical treatment (HZ-003, Critical), that forces the operator to set the radio down, and a thermal-interface or enclosure redesign with a second CNC order.

| Field | Value |
|---|---|
| Category | safety (tags: hsi) |
| Likelihood | 3 (Possible) |
| Consequence by dimension | Safety 4 / First power-on 1 / Cost 3 / Schedule 3 / Performance margin 2 |
| Consequence (max) | 4 (Major); driving: Safety |
| Score / band | 12 / Red |
| Assessment confidence | Medium |
| Status / trend | Open / Stable |
| Owner | Claude |
| Opened / horizon | 2026-09-25 / SAR |
| Last assessed | 2026-09-27 (SRR) |
| Source | Split from RSK-006 on 2026-09-25 after independent review (process section 4: the surface burn harms a different asset than the junction over-temperature); hazard link rule (process section 1) for HZ-003 |
| Strategy | Mitigate |
| Plan approval | 2026-09-26, memo docs/reviews/SRR/decision-memo.md |

**Likelihood rationale.** Several watts spread over a pocket-sized aluminum shell is close to the touch limit and no budget exists yet. Anchor level 3.

**Consequence rationale.** Driving dimension safety 4: docs/safety/hazards.json 0.2.0-pha rates HZ-003 Critical (a burn needing medical treatment; register safety 4, the hazard link rule minimum of 06 section 1). Cost and schedule 3: a redesign needs a new CNC part at USD 100 to 300 and 3 to 6 weeks. first_power_on 1: the board works.

**Mitigation steps**

| Step | Action | Artifact | Due | Status |
|---|---|---|---|---|
| S1 | Surface-temperature prediction in the thermal budget at 25 C and 40 C ambient for 5 min of continuous key-down at 5 W and for the 1:9 duty cycle (HZ-003 K1, K7). | docs/design/analysis/thermal-budget.md; docs/design/budgets.md (thermal) | PDR | Planned |
| S2 | Derive the ME surface-temperature requirement and the handbook statement on continuous key-down and transmitting from a pocket (HZ-003 K1, K6). | docs/requirements/me/requirements.json; docs/ops/operations-handbook.md | PDR | Planned |
| S3 | Bench: enclosure surface temperature at the hand-hold areas with the multimeter thermocouple during the 5 min key-down case. | docs/test_cases/me/test_cases.json (TC-ME surface temperature case) | SAR | Planned |

**Triggers**

| Condition | Response |
|---|---|
| The thermal budget predicts the hand-hold surface above 48 C at 25 C ambient and 5 min key-down | Claude redesigns the thermal path or proposes a key-down limit by CR before CDR; the item is a PDR lien until resolved |
| A Bench surface reading exceeds 48 C | Owner stops the test; Claude opens an NCR and revisits the budget |

**Fallback.** A firmware key-down duty limit or thermal fold-back (RSK-006 S3) keeps the surface below 48 C, accepted by the owner through a CR with the handbook warning, or an insulating grip sleeve printed on the H2C (SI-012).

**Related.** hazard: HZ-003; adr: ADR-008; tpm: TPM-004; stakeholder input: SI-001, SI-008, SI-012, SI-013; risk: RSK-006

**Closure criteria.** Surface-temperature requirement verified on the delivered unit at SAR with the 5 min key-down case inside the enclosure.

**History**

| Date | Review | L | C | Safety | Score | Status | Note |
|---|---|---|---|---|---|---|---|
| 2026-09-25 | Pre-SRR | 3 | 3 | 3 | 9 | Proposed | Split from RSK-006 after independent review; carries HZ-003 under the hazard link rule; awaiting independent check. |
| 2026-09-25 | Pre-SRR | 3 | 4 | 4 | 12 | Proposed | Re-scored safety 3 to 4 under the hazard link rule (06 section 1): HZ-003 re-rated Marginal to Critical in docs/safety/hazards.json 0.2.0-pha. Score 9 to 12, band Yellow to Red; the plan meets the Red minimums of 06 section 8 (strategy Mitigate, three active steps, two triggers, fallback); plan_approval is due in the SRR decision memo. |
| 2026-09-25 | SRR | 3 | 4 | 4 | 12 | Proposed | SRR Track pass at package assembly 2026-09-25 (06 section 10 item 1): re-assessed against the SRR research candidate pass; likelihood and consequence unchanged; status stays Proposed until the independent check of docs/reviews/SRR/checklists/risk-register.md. |
| 2026-09-27 | SRR | 3 | 4 | 4 | 12 | Open | Track pass 2026-09-27 (docs/plan/pdr-work-plan.md WP-PDR-18 wave 0; 06 section 9 Track and Control; INSP-007 finding-18, docs/reviews/SRR/checklists/risk-register-06.md), recorded at review point SRR, the last gate passed (06 section 10.3); the PDR Track pass of 06 section 10 item 1 follows at PDR package assembly. Status Proposed to Open: INSP-007 (APPROVED; item CK-RSK-A2) records the Analyze check passing all 65 risks (06 section 9 transition table). Likelihood and consequence unchanged: no analysis, test, trigger poll or SRR ruling since the SRR Track pass changes this risk's evidence. CR-003 revision 3 (Submitted, d9a215a; section 4 Risk row) proposes changes to this risk; a submitted CR changes no baseline (06 section 10.2 trigger noted), so the changes are applied with a Refs trailer naming the CR after the owner's disposition (WP-PDR-02 and the WP-PDR-18 final pass). This pass keeps the current values. |

### RSK-003

**RP2350 emulator mis-models a peripheral or cannot boot the image**

Given Emulation is the optional, secondary pre-power-on evidence class for whole-binary scenarios (event ordering only, never timing; charter section 9, SI-026, ADR-011), implemented on rp2350-emu, a personal research project with no maintenance commitment (07 section 12), and no per-peripheral accreditation against the Pico 2 development board has been performed yet, there is a possibility of an emulation scenario passing while the real RP2350 orders events or exposes peripheral register semantics differently, or the emulator failing to boot the release image so that Emulation evidence is unavailable adversely impacting the SW subsystem (keyer, transmit sequencing, safety manager, charging supervision) and the first-power-on objective SI-010, leading to a firmware ordering fault discovered only on the assembled board, unit damage if the fault is in PA enable or charging sequencing, and loss of the Emulation evidence class for the affected requirements.

| Field | Value |
|---|---|
| Category | software |
| Likelihood | 4 (Likely) |
| Consequence by dimension | Safety 2 / First power-on 3 / Cost 2 / Schedule 3 / Performance margin 2 |
| Consequence (max) | 3 (Moderate); driving: First power-on, Schedule |
| Score / band | 12 / Red |
| Assessment confidence | Medium |
| Status / trend | Open / Stable |
| Owner | Claude |
| Opened / horizon | 2026-09-25 / TRR |
| Last assessed | 2026-09-27 (SRR) |
| Source | Formulation risk identification 2026-09-25 against SI-007, SI-010; re-scoped the same day to the secondary evidence class of charter section 9 (SI-026); listed in 07 section 21 as 'Emulator fidelity'; SRR research candidate pass 2026-09-25 merged EMUACC-R1, EMUACC-R2, EMUACC-R3, EMUACC-R4, EMUOPT-R1, EMUOPT-R2, EMUOPT-R3; plan candidate SEP21-EMU (SRR plan-table pass 2026-09-25) |
| Strategy | Mitigate |
| Plan approval | 2026-09-26, memo docs/reviews/SRR/decision-memo.md |

**Likelihood rationale.** rp2350-emu models a subset of peripherals and has no accreditation record; PIO and precise timer behavior are the least likely to be faithful, and a boot failure of a bare-metal rustos image is plausible. Anchor level 4: no fidelity assessment exists.

**Consequence rationale.** Driving dimensions first_power_on and schedule at 3: with HostUnit as the primary evidence (SI-026) and dev-board checks available, an emulator escape degrades one subsystem, is fixed by a USB reflash, and costs 3 to 6 weeks of root-causing without an oscilloscope. Safety 2: hardware interlocks and the safe-state manager (charter section 10, SWE-134) bound the damage from a mis-sequenced PA enable or charger.

**Mitigation steps**

| Step | Action | Artifact | Due | Status |
|---|---|---|---|---|
| S1 | Emulator selection and fidelity assessment as a trade study (SEMP section 5.17 technology row): enumerate every peripheral and register the firmware touches and mark each as emulated-verified, emulated-unverified or not emulated. | docs/decisions/trade-studies/TS-NNN-emulator.md | PDR | Planned |
| S2 | Accreditation per peripheral (SWE-070, SWE-136; 07 section 9.4 item 2): a firmware/devcheck binary per peripheral (GPIO, TIMER alarms, PWM, ADC, I2C, SPI, watchdog) produces a self-timestamped trace on the dev board and on the emulator; accredited when register-visible sequences are identical and timing agrees within 1 percent. | docs/cm/tool-validation/TV-NNN-rp2350-emu.md; tools/toolchain.lock.md | PDR | Planned |
| S3 | Keep HostUnit primary: application logic runs on a host implementation of the rustos api traits with injected device models (SI-026), so every requirement verified by Emulation also has HostUnit coverage of its logic. | firmware/cwht-core/ tests; docs/test_cases/sw-<sub>/test_cases.json | CDR | Planned |
| S4 | Dev-board integration: run the full firmware on a bare Pico 2 with a breadboard harness (encoder, buttons, LCD, key jack, PA-enable LED) and record the run as Bench evidence with credit: false (charter section 3). | docs/vv/reports/<TC-ID>-r<N>.md with article pico2-devboard-1 and credit: false | CDR | Planned |
| S5 | For each peripheral marked not emulated or not accredited, set the affected requirements' verification note to HostUnit plus Bench; Emulation evidence alone does not close them (04 section 5.2). | docs/requirements/sw/**/requirements.json verification_note fields | PDR | Planned |
| S6 | Handle the documented emulator gaps: GPIO edge IRQ decode, NVIC priority and watchdog timing are outside the credit scope (keyer inputs by HostUnit and Bench, timeouts by Bench); device models (Si5351, LCD) are derived from datasheets and independently reviewed; the emulator commit is pinned and vendored with a mirror fork. | docs/cm/tool-validation/TV-NNN-emulator.md (ACC-EMU-001 scope) | PDR | Planned |

**Triggers**

| Condition | Response |
|---|---|
| A peripheral in use is marked not emulated or emulated-unverified in S1, or fails accreditation in S2 | Claude applies S5 to the affected requirements the same day and records the exclusion in the tool validation record |
| rp2350-emu cannot boot the release image, or fails accreditation on GPIO and TIMER | Claude invokes the fallback; the decision is taken at PDR and recorded in docs/reviews/PDR/decision-memo.md (07 section 9.4 item 3) |
| The emulator project shows no release or commit activity for 6 months | Claude revises the emulator trade study and proposes the fallback to the owner in the next review package |

**Fallback.** HostUnit on cwht-core plus dev-board checks for cwht-app, and Bench verification of every timing requirement (07 section 9.4 item 3); the Emulation class is recorded as unused in the V&V plan by CR.

**Related.** adr: ADR-011, ADR-019; trade study: TS-002; stakeholder input: SI-007, SI-010, SI-026; risk: RSK-008, RSK-012, RSK-013

**Closure criteria.** All SW requirements verified by Test on the delivered unit with no NCR attributable to emulator-versus-hardware divergence, or the fallback adopted at PDR and every timing requirement verified at Bench.

**History**

| Date | Review | L | C | Safety | Score | Status | Note |
|---|---|---|---|---|---|---|---|
| 2026-09-25 | Pre-SRR | 4 | 3 | n/r | 12 | Proposed | Opened during Formulation risk identification; awaiting independent check. |
| 2026-09-25 | Pre-SRR | 4 | 3 | 2 | 12 | Proposed | Re-scoped: Emulation is the secondary evidence class (charter section 9, SI-026, ADR-011); safety lowered to 2 for the hardware interlocks, cost lowered to 2; fallback per 07 section 9.4 item 3. Max consequence and score unchanged. |
| 2026-09-25 | Pre-SRR | 4 | 3 | 2 | 12 | Proposed | Independent review 2026-09-25: departure kept as one failure-mode family under process section 4: a false pass and a boot failure both harm the Emulation evidence for SW, share the schedule driving dimension, are non-safety, and are handled by one plan, fallback and closure criteria. Score unchanged. |
| 2026-09-25 | SRR | 4 | 3 | 2 | 12 | Proposed | SRR Track pass at package assembly 2026-09-25 (06 section 10 item 1): re-assessed against the SRR research candidate pass; likelihood and consequence unchanged; status stays Proposed until the independent check of docs/reviews/SRR/checklists/risk-register.md. Merged candidates EMUACC-R1, EMUACC-R2, EMUACC-R3, EMUACC-R4, EMUOPT-R1, EMUOPT-R2, EMUOPT-R3 (06 section 9 disposition rule; family rule of section 4 applied: same asset, driving dimension, plan and kind); worst member does not raise the score. Step added for the merged candidates. |
| 2026-09-25 | SRR | 4 | 3 | 2 | 12 | Proposed | INSP-007 (docs/reviews/SRR/checklists/risk-register-06.md) finding F-04: trade-study references corrected (TS-001 is receiver-and-pa-concept, TS-002 is firmware-runtime-make-buy; unwritten studies carry TS-NNN until created) and related.trade_study_ids set for the studies that name this risk. Score unchanged. |
| 2026-09-27 | SRR | 4 | 3 | 2 | 12 | Open | Track pass 2026-09-27 (docs/plan/pdr-work-plan.md WP-PDR-18 wave 0; 06 section 9 Track and Control; INSP-007 finding-18, docs/reviews/SRR/checklists/risk-register-06.md), recorded at review point SRR, the last gate passed (06 section 10.3); the PDR Track pass of 06 section 10 item 1 follows at PDR package assembly. Status Proposed to Open: INSP-007 (APPROVED; item CK-RSK-A2) records the Analyze check passing all 65 risks (06 section 9 transition table). Likelihood and consequence unchanged: no analysis, test, trigger poll or SRR ruling since the SRR Track pass changes this risk's evidence. |

### RSK-063

**Host mock diverges from RP2350 behaviour on a credited HostUnit case**

Given charter section 9 makes HostUnit (application logic on the host implementation of the rustos api traits with injected device models) the primary software evidence (SI-026, ADR-011); ADR-011 section 4.4 proposes the risk 'host mock diverges from silicon behaviour' with contract tests against the mock and the dev board as its control, and 07 section 21 lists it; 07 section 19 makes a passing contract test against the mock and a filed dev-board check a closure condition of every work package; no contract test and no dev-board check exist yet, there is a possibility of a behaviour credited by a HostUnit case differing on the RP2350 because the host mock of a rustos api trait does not model the silicon (register semantics, reset state, error returns or ordering) adversely impacting the software verification evidence (HostUnit credit) and the firmware components of 07 section 14.1, leading to a requirement recorded Verified that fails on the delivered unit, found at Bench or on air, needing a firmware fix, a new tagged release and a credited re-run of the affected cases.

| Field | Value |
|---|---|
| Category | software |
| Likelihood | 4 (Likely) |
| Consequence by dimension | Safety 2 / First power-on 2 / Cost 1 / Schedule 3 / Performance margin 2 |
| Consequence (max) | 3 (Moderate); driving: Schedule |
| Score / band | 12 / Red |
| Assessment confidence | Medium |
| Status / trend | Open / Stable |
| Owner | Claude |
| Opened / horizon | 2026-09-25 / Ops |
| Last assessed | 2026-09-27 (SRR) |
| Source | ADR-011 section 4.4 (candidate ADR011-R1, new risk proposed); 07 section 21 row 'Host mock diverges from silicon' (plan candidate SEP21-MOCK); opened 2026-09-25 after INSP-007 finding F-03 |
| Strategy | Mitigate |
| Plan approval | 2026-09-26, memo docs/reviews/SRR/decision-memo.md |

**Likelihood rationale.** Anchor level 4 (no analysis yet): no contract test compares any mock with the silicon, and a mock written from the same reading of the datasheet as the driver can share its misreading. 06 section 6 case (a) applies to this verification-fidelity risk as it does to RSK-003.

**Consequence rationale.** Driving dimension schedule 3: a firmware fix, a new tagged release and a credited re-run of the affected cases is one design iteration (3 to 6 weeks). Safety 2: Bench confirmation of every hazard-tracing requirement on the delivered unit (07 section 9.7) stops a safety behaviour credited only on the mock from reaching use. First power-on 2: the fix is a firmware reflash.

**Mitigation steps**

| Step | Action | Artifact | Due | Status |
|---|---|---|---|---|
| S1 | Contract test suite per rustos api trait used by cwht, run against the host mock and on the Pico 2 dev board (Bench, credit false), as the work-package closure condition of 07 section 19 for the nine FW-B1 packages. | firmware/cwht-hal-mock/; firmware/devcheck/ | PDR | Planned |
| S2 | Mock fidelity statement per trait (what the mock models and what it does not), so that a HostUnit case cites only modelled behaviour. | docs/design/software-design.md | CDR | Planned |
| S3 | Bench confirmation on the delivered unit of every hazard-tracing software requirement credited by HostUnit (07 section 9.7). | docs/test_cases/sys/test_cases.json (Bench cases of the hazard-tracing requirements) | TRR | Planned |

**Triggers**

| Condition | Response |
|---|---|
| A contract test passes on the mock and fails on the dev board, or a Bench case fails on a behaviour a HostUnit case credited | Claude opens an NCR the same session, withdraws the HostUnit credit of the affected cases and re-assesses this risk |
| A rustos api trait changes (RSK-023) | Claude re-runs the S1 contract suite against the mock and the dev board before cwht moves to the new pinned commit |

**Fallback.** Credit the affected requirements by Bench on the delivered unit only and restrict HostUnit credit to application logic that calls no mocked trait.

**Related.** adr: ADR-011, ADR-019; stakeholder input: SI-026; risk: RSK-003, RSK-013, RSK-023

**Closure criteria.** S1 contract suite passing on the mock and on the dev board for every trait cwht uses, and every hazard-tracing software requirement confirmed by Bench on the delivered unit (S3).

**History**

| Date | Review | L | C | Safety | Score | Status | Note |
|---|---|---|---|---|---|---|---|
| 2026-09-25 | SRR | 4 | 3 | 2 | 12 | Proposed | Opened at the SRR candidate pass after INSP-007 (docs/reviews/SRR/checklists/risk-register-06.md) finding F-03 (07 sections 16.2 and 21; SWE-086, SWE-154); awaiting the independent check. |
| 2026-09-27 | SRR | 4 | 3 | 2 | 12 | Open | Track pass 2026-09-27 (docs/plan/pdr-work-plan.md WP-PDR-18 wave 0; 06 section 9 Track and Control; INSP-007 finding-18, docs/reviews/SRR/checklists/risk-register-06.md), recorded at review point SRR, the last gate passed (06 section 10.3); the PDR Track pass of 06 section 10 item 1 follows at PDR package assembly. Status Proposed to Open: INSP-007 (APPROVED; item CK-RSK-A2) records the Analyze check passing all 65 risks (06 section 9 transition table). Likelihood and consequence unchanged: no analysis, test, trigger poll or SRR ruling since the SRR Track pass changes this risk's evidence. |

### RSK-004

**Turnkey assembly defects on RF and fine-pitch parts**

Given PCBWay assembles all surface-mount parts under the kit model (SI-031, ADR-007), the design contains fine-pitch parts (QFN synthesizer, RF power device with exposed thermal pad, 0402 passives), and the owner can hand-solder through-hole parts and simple exposed pads but cannot rework QFN or hidden-pad packages (SI-011, SI-031), there is a possibility of one or more assembly defects (solder voids under the PA thermal pad, tombstoned 0402, bridged QFN pins, wrong-value or substituted part) on the delivered boards adversely impacting TX and RX hardware and the first-power-on objective SI-010, leading to a non-working subsystem or a degraded PA thermal path that the owner cannot repair and that requires a rework order or a spare board.

| Field | Value |
|---|---|
| Category | technical |
| Likelihood | 3 (Possible) |
| Consequence by dimension | Safety 2 / First power-on 4 / Cost 3 / Schedule 3 / Performance margin 3 |
| Consequence (max) | 4 (Major); driving: First power-on |
| Score / band | 12 / Red |
| Assessment confidence | Medium |
| Status / trend | Open / Stable |
| Owner | Claude |
| Opened / horizon | 2026-09-25 / TRR |
| Last assessed | 2026-09-27 (SRR) |
| Source | Formulation risk identification 2026-09-25 against SI-009, SI-010, SI-011; condition updated the same day for SI-031; SRR research candidate pass 2026-09-25 merged R-PCB-01, R-PCB-02 |
| Strategy | Mitigate |
| Plan approval | 2026-09-26, memo docs/reviews/SRR/decision-memo.md |

**Likelihood rationale.** Turnkey assembly defect rates on fine-pitch and exposed-pad parts are non-negligible and no DFM review has been done yet. Anchor level 3.

**Consequence rationale.** Driving dimension first_power_on 4: a defect on the PA or synthesizer stops a core function and the owner cannot repair a hidden-pad package. Cost 3 and schedule 3: a rework order or spare board is USD 100 to 300 and 3 to 6 weeks. performance_margin 3: a voided thermal pad reduces sustained power.

**Mitigation steps**

| Step | Action | Artifact | Due | Status |
|---|---|---|---|---|
| S1 | Write the producibility rules for the PCB: no 0201, 0603 where RF permits, QFN pitch 0.5 mm or coarser, thermal-pad via array per device datasheet, fiducials, PCBWay assembly constraints and standard footprints (SEMP section 7.2); enforce them at the CDR design review. | docs/design/build-to-specification.md (producibility section); docs/templates/peer-review-checklist-design.md section J | PDR | Planned |
| S2 | Use exact manufacturer part numbers in the BOM, prefer parts stocked by PCBWay or consigned from DigiKey, split the BOM into the PCBWay assembly list and the owner's hand-assembly list (SI-031), and forbid substitutions in the assembly order notes. | hardware/bom/ (cwht-MB-rev<X>-bom.csv and cwht-MB-rev<X>-hand-assembly.csv, 05 section 4.3) | CDR | Planned |
| S3 | Order X-ray or AOI inspection for QFN and exposed-pad devices and request assembly photographs in the PCBWay order. | hardware/releases/HW-MB-rev<X>-<n>/ (order notes and order-confirmation.pdf) | CDR | Planned |
| S4 | Order 5 bare boards and 3 assembled boards (SI-035) so that a single defective board does not stop the project; carry the quantity in the cost estimate. | docs/plan/cost-estimate.md | CDR | Planned |
| S5 | Receipt inspection procedure: macro photography, visual check against the assembly drawing, continuity and short checks on every power rail and the PA supply, NanoVNA check of the output filter at the test point; a TRR entrance product. | docs/test_cases/sys/test_cases.json (TC-SYS receipt inspection case); docs/vv/reports/receipt-inspection-<n>.md | TRR | Planned |
| S6 | Submit the design to PCBWay DFM review before order release and resolve every finding; a vendor-proposed change that alters the product baseline is a CR (05 section 5). | hardware/releases/HW-MB-rev<X>-<n>/ (DFM findings and their dispositions) | CDR | Planned |
| S7 | Written PCBWay confirmation that the castellated Pico 2 is reflowed in turnkey assembly, an assembly drawing with rotations and pin-1 marks, and PCBWay's placement preview checked before the run (A-PCB-01). | hardware/releases/HW-MB-revA-1/assembly-drawing.pdf; docs/reviews/CDR/package.md | CDR | Planned |

**Triggers**

| Condition | Response |
|---|---|
| PCBWay DFM report flags any RF or thermal-pad item | Claude resolves it before order release; an unresolved item is a CDR lien recorded in the decision memo |
| Receipt inspection finds a defect | Claude opens NCR-NNN; the owner uses a spare board and requests a rework quote from PCBWay |

**Fallback.** Rework by PCBWay or a local assembly house; if not feasible, second board spin (RSK-008).

**Related.** adr: ADR-007; tpm: TPM-014; stakeholder input: SI-009, SI-010, SI-011, SI-031, SI-035; risk: RSK-006, RSK-008

**Closure criteria.** Receipt inspection of every delivered board passed and PA thermal performance verified at SAR.

**History**

| Date | Review | L | C | Safety | Score | Status | Note |
|---|---|---|---|---|---|---|---|
| 2026-09-25 | Pre-SRR | 3 | 4 | n/r | 12 | Proposed | Opened during Formulation risk identification; awaiting independent check. |
| 2026-09-25 | Pre-SRR | 3 | 4 | 2 | 12 | Proposed | Condition updated for the kit assembly model (SI-031, ADR-007); build quantity per SI-035; artifacts aligned to hardware/bom/, hardware/releases/ and docs/plan/cost-estimate.md. Score unchanged. |
| 2026-09-25 | SRR | 3 | 4 | 2 | 12 | Proposed | SRR Track pass at package assembly 2026-09-25 (06 section 10 item 1): re-assessed against the SRR research candidate pass; likelihood and consequence unchanged; status stays Proposed until the independent check of docs/reviews/SRR/checklists/risk-register.md. Merged candidates R-PCB-01, R-PCB-02 (06 section 9 disposition rule; family rule of section 4 applied: same asset, driving dimension, plan and kind); worst member does not raise the score. Step added for the merged candidates. |
| 2026-09-27 | SRR | 3 | 4 | 2 | 12 | Open | Track pass 2026-09-27 (docs/plan/pdr-work-plan.md WP-PDR-18 wave 0; 06 section 9 Track and Control; INSP-007 finding-18, docs/reviews/SRR/checklists/risk-register-06.md), recorded at review point SRR, the last gate passed (06 section 10.3); the PDR Track pass of 06 section 10 item 1 follows at PDR package assembly. Status Proposed to Open: INSP-007 (APPROVED; item CK-RSK-A2) records the Analyze check passing all 65 risks (06 section 9 transition table). Likelihood and consequence unchanged: no analysis, test, trigger poll or SRR ruling since the SRR Track pass changes this risk's evidence. CR-006 revision 2 (Submitted, 39a6b13; section 1.7) proposes changes to this risk; a submitted CR changes no baseline (06 section 10.2 trigger noted), so the changes are applied with a Refs trailer naming the CR after the owner's disposition (WP-PDR-02 and the WP-PDR-18 final pass). This pass keeps the current values. |

### RSK-047

**PA over-power at full pack voltage exceeds downstream ratings**

Given without level control a 7 V class PA delivers about 6.4 W to 10 W at a full 8.4 V pack (docs/research/2m-cw-transceiver-reference-designs.md F25; docs/research/pa-device-candidates.md F18, implication 11); the baseline candidate PD54008L-E is not characterized by ST at 8.4 V (docs/research/pa-turnkey-candidates-followup.md F5, implication 8); the gate-bias ALC (REQ-SYS-012) and the high pack voltage transmit lockout (REQ-SYS-153) are requirements with no design yet; elements after the PA must carry the full-drive output unless the ALC bounds it under single faults, there is a possibility of the PA delivering more than the 5 W step plus its tolerance at full pack voltage, through an ALC design shortfall or a single fault in the ALC or detector path adversely impacting TX output network (LPF, T/R relay, SMA port) and the 47 CFR 97.307(e) spurious margin, leading to harmonic levels rising toward the 25 uW limit, overstress of the relay and filter parts, and exposure distances exceeding those evaluated.

| Field | Value |
|---|---|
| Category | technical (tags: regulatory) |
| Likelihood | 3 (Possible) |
| Consequence by dimension | Safety 2 / First power-on 2 / Cost 3 / Schedule 3 / Performance margin 4 |
| Consequence (max) | 4 (Major); driving: Performance margin |
| Score / band | 12 / Red |
| Assessment confidence | Medium |
| Status / trend | Open / Stable |
| Owner | Claude |
| Opened / horizon | 2026-09-25 / SAR |
| Last assessed | 2026-09-27 (SRR) |
| Source | SRR research candidate pass 2026-09-25: candidate PADEV-11 (docs/research/pa-device-candidates.md implication 11) entered |
| Strategy | Mitigate |
| Plan approval | 2026-09-26, memo docs/reviews/SRR/decision-memo.md |

**Likelihood rationale.** The over-power figure rests on a graph-read vendor analysis and the ALC is not designed. Anchor level 3.

**Consequence rationale.** Driving dimension performance_margin 4 by the regulatory rule (excess power erodes the 97.307(e) margin); cost and schedule 3 for part damage and a design iteration.

**Mitigation steps**

| Step | Action | Artifact | Due | Status |
|---|---|---|---|---|
| S1 | ALC loop analysis over 6.0 to 8.4 V at every step with the single-fault cases (detector reading low, bias node stuck high) in the ALC and envelope study (TS-NNN). | docs/decisions/trade-studies/TS-NNN-alc-envelope.md (concept section 11.2 ALC and envelope study; number assigned at creation); hardware/sim/tx/ | PDR | Planned |
| S2 | Rate every element after the PA (LPF, relay, SMA) for the full-drive output of the selected device at 8.4 V, or show by analysis that the ALC bounds the power under every single fault. | docs/requirements/tx/requirements.json; docs/design/analysis/tx-power-path-ratings.md | PDR | Planned |
| S3 | Bench: output power and spectrum at 8.4 V with the ALC at the 5 W step and with the detector input forced low. | docs/test_cases/sys/test_cases.json (REQ-SYS-012 and REQ-SYS-153 cases) | SAR | Planned |

**Triggers**

| Condition | Response |
|---|---|
| The ALC analysis shows more than 6.3 W at 8.4 V under any single fault | Claude adds a firmware pack-voltage power limit and a hardware drive clamp by CR before CDR |

**Fallback.** Lower the pack-voltage lockout threshold or add a regulated PA rail (an alternative of the ALC and envelope study, TS-NNN) by CR.

**Related.** requirement: REQ-SYS-012, REQ-SYS-017, REQ-SYS-153; adr: ADR-003, ADR-012, ADR-022; trade study: TS-001; tpm: TPM-007, TPM-015; stakeholder input: SI-003, SI-023, SI-028; risk: RSK-001, RSK-027

**Closure criteria.** REQ-SYS-012 and REQ-SYS-153 verified on the delivered unit at 8.4 V including the single-fault case.

**History**

| Date | Review | L | C | Safety | Score | Status | Note |
|---|---|---|---|---|---|---|---|
| 2026-09-25 | SRR | 3 | 4 | 2 | 12 | Proposed | Entered at the SRR research candidate pass (06 section 9, Identify) during SRR package assembly; awaiting the independent check of docs/reviews/SRR/checklists/risk-register.md. |
| 2026-09-25 | SRR | 3 | 4 | 2 | 12 | Proposed | INSP-007 (docs/reviews/SRR/checklists/risk-register-06.md) finding F-04: trade-study references corrected (TS-001 is receiver-and-pa-concept, TS-002 is firmware-runtime-make-buy; unwritten studies carry TS-NNN until created) and related.trade_study_ids set for the studies that name this risk. Score unchanged. |
| 2026-09-27 | SRR | 3 | 4 | 2 | 12 | Open | Track pass 2026-09-27 (docs/plan/pdr-work-plan.md WP-PDR-18 wave 0; 06 section 9 Track and Control; INSP-007 finding-18, docs/reviews/SRR/checklists/risk-register-06.md), recorded at review point SRR, the last gate passed (06 section 10.3); the PDR Track pass of 06 section 10 item 1 follows at PDR package assembly. Status Proposed to Open: INSP-007 (APPROVED; item CK-RSK-A2) records the Analyze check passing all 65 risks (06 section 9 transition table). Likelihood and consequence unchanged: no analysis, test, trigger poll or SRR ruling since the SRR Track pass changes this risk's evidence. |

### RSK-038

**Catalog parts out of stock or end-of-life at the CDR order**

Given the CDR order follows the expedited schedule of SI-020 and the kit model of SI-031; on 2026-09-25 TPS62913, TPS7A2033 and BQ25792 showed zero DigiKey and Mouser stock (docs/research/power-tree-and-charging.md F7, F19, F20), the TI store was out of PCM1808 and TLV320AIC3204 and WM8960 is end-of-life (docs/research/cw-selectivity-options.md implication 9), the KVG and Inrad crystal filters are single-source quote-only through-hole cans (implication 7), several PIN diodes and relays are discontinued or unverified (docs/research/tr-switch-candidates.md F6, F9, F10, F16, F21), and distributor stock for the audio, display and T/R parts could not be read by machine (docs/research/audio-output-and-hearing-safety.md Method 6; docs/research/display-and-ui-parts.md F22; tr-switch Method 4), there is a possibility of one or more BOM lines other than the PA device and the synthesizer being out of stock, not recommended for new designs or end-of-life when the CDR order is placed adversely impacting the BOM baseline and the CDR procurement release, leading to a substitution approval loop with PCBWay, a redesign and re-layout of the affected stage, or a delayed order.

| Field | Value |
|---|---|
| Category | programmatic (tags: single-source) |
| Likelihood | 4 (Likely) |
| Consequence by dimension | Safety 1 / First power-on 2 / Cost 2 / Schedule 3 / Performance margin 2 |
| Consequence (max) | 3 (Moderate); driving: Schedule |
| Score / band | 12 / Red |
| Assessment confidence | Medium |
| Status / trend | Open / Stable |
| Owner | Robin |
| Opened / horizon | 2026-09-25 / CDR |
| Last assessed | 2026-09-27 (SRR) |
| Source | SRR research candidate pass 2026-09-25: candidates R-AUD-4 (docs/research/audio-output-and-hearing-safety.md Risks), R-UI-06 (docs/research/display-and-ui-parts.md Risk candidates), TR-R10 and TR-R14 (docs/research/tr-switch-candidates.md implications 10 and 14), R-PWR-04 (docs/research/power-tree-and-charging.md implication 15), CWSEL-7 and CWSEL-9 (docs/research/cw-selectivity-options.md implications 7 and 9) entered as one family; SRR ADR candidate pass 2026-09-25 merged ADR010-R1 |
| Strategy | Mitigate |
| Plan approval | 2026-09-26, memo docs/reviews/SRR/decision-memo.md |

**Likelihood rationale.** Zero stock is already observed for three rail parts and two codecs on 2026-09-25, with no second source chosen yet (a known deficiency without a mitigation in progress). Anchor level 4.

**Consequence rationale.** Driving dimension schedule 3: a stage redesign found at order time is one design iteration; cost 2 for alternates and early buys.

**Mitigation steps**

| Step | Action | Artifact | Due | Status |
|---|---|---|---|---|
| S1 | Dated DigiKey and Mouser stock and lifecycle check of every BOM line against at least 3 times the build quantity, at PDR and again at CDR, with the owner reading distributor pages where machine access is blocked (A-UI-01, audio A3, tr-switch ACTION 19). | hardware/bom/ stock columns; docs/reviews/CDR/package.md section 12 | CDR | Planned |
| S2 | Second source or footprint-compatible alternate for every line with stock below 3 times the build quantity or a single manufacturer: rail parts, codec (PCM1802 or TLV320ADC3xxx), filter can footprint compatible with both KVG and Inrad cases. | hardware/bom/ alternates column; hardware/kicad/ footprints | PDR | Planned |
| S3 | Owner early buy at PDR of single-source long-lead parts (crystal filter if candidate A, rail parts without stock) for the build quantity, recorded by ADR because it spends money (06 section 14.1 class 2). | docs/decisions/adr/ADR-NNN-early-buy.md; docs/plan/cost-estimate.md | PDR | Planned |

**Triggers**

| Condition | Response |
|---|---|
| Any BOM line below 3 times the build quantity at both distributors, or a not-recommended or end-of-life notice | Claude proposes the alternate in the same session; the owner decides any early buy; a CR is opened if the baselined BOM changes |

**Fallback.** Substitute the alternate through a CR and re-layout the affected stage; accept a one-iteration slip of the order.

**Related.** requirement: REQ-SYS-140, REQ-SYS-178; adr: ADR-007, ADR-012; trade study: TS-001; tpm: TPM-014; stakeholder input: SI-009, SI-020, SI-028, SI-031; risk: RSK-005, RSK-014

**Closure criteria.** Every BOM line received for the build quantity, with alternates recorded in the BOM.

**History**

| Date | Review | L | C | Safety | Score | Status | Note |
|---|---|---|---|---|---|---|---|
| 2026-09-25 | SRR | 4 | 3 | 1 | 12 | Proposed | Entered at the SRR research candidate pass (06 section 9, Identify) during SRR package assembly; awaiting the independent check of docs/reviews/SRR/checklists/risk-register.md. |
| 2026-09-25 | SRR | 4 | 3 | 1 | 12 | Proposed | ADR-010 and ADR-026 section 4.4 candidate 'relay lifecycle and stock unverified' merged: the same departure as TR-R10. Score unchanged. |
| 2026-09-25 | SRR | 4 | 3 | 1 | 12 | Proposed | INSP-007 (docs/reviews/SRR/checklists/risk-register-06.md) finding F-04: trade-study references corrected (TS-001 is receiver-and-pa-concept, TS-002 is firmware-runtime-make-buy; unwritten studies carry TS-NNN until created) and related.trade_study_ids set for the studies that name this risk. Score unchanged. |
| 2026-09-27 | SRR | 4 | 3 | 1 | 12 | Open | Track pass 2026-09-27 (docs/plan/pdr-work-plan.md WP-PDR-18 wave 0; 06 section 9 Track and Control; INSP-007 finding-18, docs/reviews/SRR/checklists/risk-register-06.md), recorded at review point SRR, the last gate passed (06 section 10.3); the PDR Track pass of 06 section 10 item 1 follows at PDR package assembly. Status Proposed to Open: INSP-007 (APPROVED; item CK-RSK-A2) records the Analyze check passing all 65 risks (06 section 9 transition table). Likelihood and consequence unchanged: no analysis, test, trigger poll or SRR ruling since the SRR Track pass changes this risk's evidence. CR-006 revision 2 (Submitted, 39a6b13; section 1.7) proposes changes to this risk; a submitted CR changes no baseline (06 section 10.2 trigger noted), so the changes are applied with a Refs trailer naming the CR after the owner's disposition (WP-PDR-02 and the WP-PDR-18 final pass). This pass keeps the current values. |

### RSK-039

**Headphone or key input damaged by a mono plug, cross-plugging or ESD**

Given both 3.5 mm jacks are identical switched TRS parts on a pocket radio (docs/research/display-and-ui-parts.md baseline table), so a key can be plugged into the headphone jack and headphones or an audio source into the key jack (docs/research/keyer-and-key-interfaces.md implication 6); a TS plug shorts one headphone channel continuously and the TPA6132A2 short-circuit current and thermal behaviour under a permanent short are not quantified (docs/research/audio-output-and-hearing-safety.md F29, R-AUD-5); the key inputs are exposed to ESD at the jack (keyer report R7, HZ-010); REQ-SYS-049, REQ-SYS-050 and REQ-SYS-079 state the abuse tolerance, there is a possibility of the headphone amplifier or a key input stage failing or degrading after a mono plug, a cross-plugged key or headphone, or an ESD discharge at a jack adversely impacting CTL audio output and key input hardware (B13, B15), leading to a unit without audio or keying until a vendor rework of SMD parts the owner cannot replace (SI-031), and loss of the unit for weeks.

| Field | Value |
|---|---|
| Category | technical |
| Likelihood | 4 (Likely) |
| Consequence by dimension | Safety 1 / First power-on 3 / Cost 3 / Schedule 3 / Performance margin 3 |
| Consequence (max) | 3 (Moderate); driving: First power-on, Cost, Schedule, Performance margin |
| Score / band | 12 / Red |
| Assessment confidence | Medium |
| Status / trend | Open / Stable |
| Owner | Claude |
| Opened / horizon | 2026-09-25 / Ops |
| Last assessed | 2026-09-27 (SRR) |
| Source | SRR research candidate pass 2026-09-25: candidates R-AUD-5 (docs/research/audio-output-and-hearing-safety.md Risks), CTL-KEY-06-R (docs/research/keyer-and-key-interfaces.md implication 6, inline RISK-candidate) and R7 (docs/research/keyer-and-key-interfaces.md section 4.4) entered as one family |
| Strategy | Mitigate |
| Plan approval | 2026-09-26, memo docs/reviews/SRR/decision-memo.md |

**Likelihood rationale.** Anchor level 4 (no analysis yet): protection proposals exist (TPD2E2U06, 1 kohm series, BAT54S, divider network), but the short-circuit and cross-plug cases have no analysis. 06 section 6 case (a): a design-analysis risk takes the anchor its facts meet.

**Consequence rationale.** Driving dimensions first_power_on, cost, schedule and performance_margin at 3: one subsystem lost until a vendor rework (USD 100 to 300, 3 to 6 weeks).

**Mitigation steps**

| Step | Action | Artifact | Due | Status |
|---|---|---|---|---|
| S1 | Extract the TPA6132A2 output short-circuit current and thermal behaviour from the datasheet or TI support (audio report ACTION A2) and analyze an indefinite short to sleeve on either channel. | docs/design/analysis/headphone-short.md | PDR | Planned |
| S2 | Analyze the cross-plug cases (key into the headphone jack, audio source into the key jack) and the IEC 61000-4-2 level 4 discharge path through the TPD2E2U06, series resistor and BAT54S (keyer-verification F5). | docs/design/analysis/jack-abuse.md; docs/icd/ICD-CTL-KEY.md; docs/icd/ICD-CTL-PHONES.md | PDR | Planned |
| S3 | Owner decision D11 on physical disambiguation of the two jacks (position, colour or engraved marking). | docs/icd/ICD-CTL-ME.md; docs/reviews/SRR/decision-memo.md | PDR | Planned |
| S4 | Bench: mono plug in each jack for 10 min and cross-plugging at power-on with current monitored. | docs/test_cases/sys/test_cases.json (REQ-SYS-049 and REQ-SYS-079 cases) | SAR | Planned |

**Triggers**

| Condition | Response |
|---|---|
| The short-circuit analysis shows the amplifier outside its ratings for an indefinite short | Claude adds per-channel series resistors (audio report D5 option) by CR before CDR |

**Fallback.** Add per-channel series resistance and a secondary clamp by CR, and state TRS-only headphones in the handbook until then.

**Related.** requirement: REQ-SYS-049, REQ-SYS-050, REQ-SYS-078, REQ-SYS-079, REQ-SYS-174; adr: ADR-009; stakeholder input: SI-018, SI-019, SI-031; risk: RSK-017, RSK-024

**Closure criteria.** REQ-SYS-049, REQ-SYS-050 and REQ-SYS-079 verified on the delivered unit with no degradation after the abuse cases.

**History**

| Date | Review | L | C | Safety | Score | Status | Note |
|---|---|---|---|---|---|---|---|
| 2026-09-25 | SRR | 3 | 3 | 1 | 9 | Proposed | Entered at the SRR research candidate pass (06 section 9, Identify) during SRR package assembly; awaiting the independent check of docs/reviews/SRR/checklists/risk-register.md. |
| 2026-09-25 | SRR | 4 | 3 | 1 | 12 | Proposed | Re-levelled 3 to 4 after INSP-007 (docs/reviews/SRR/checklists/risk-register-06.md) finding F-02: the recorded level disagreed with the 06 section 6 anchor the rationale itself describes; score 9 to 12. |
| 2026-09-27 | SRR | 4 | 3 | 1 | 12 | Open | Track pass 2026-09-27 (docs/plan/pdr-work-plan.md WP-PDR-18 wave 0; 06 section 9 Track and Control; INSP-007 finding-18, docs/reviews/SRR/checklists/risk-register-06.md), recorded at review point SRR, the last gate passed (06 section 10.3); the PDR Track pass of 06 section 10 item 1 follows at PDR package assembly. Status Proposed to Open: INSP-007 (APPROVED; item CK-RSK-A2) records the Analyze check passing all 65 risks (06 section 9 transition table). Likelihood and consequence unchanged: no analysis, test, trigger poll or SRR ruling since the SRR Track pass changes this risk's evidence. CR-003 revision 3 (Submitted, d9a215a; section 4 Risk row) proposes changes to this risk; a submitted CR changes no baseline (06 section 10.2 trigger noted), so the changes are applied with a Refs trailer naming the CR after the owner's disposition (WP-PDR-02 and the WP-PDR-18 final pass). This pass keeps the current values. |

### RSK-040

**Internally generated spurs and switching noise desensitize the receiver**

Given the Pico 2 module's 12 MHz crystal (12th harmonic) and 48 MHz USB clock (3rd harmonic) land exactly on 144.000 MHz (docs/research/display-and-ui-parts.md F10, R-UI-01); the 5 V buck at 2.2 MHz, the charger boost at 1.5 MHz and the module's RT6150 regulator (docs/research/power-tree-and-charging.md F19, F20, F22, R-PWR-03) and the headphone amplifier charge pump (display report F15, R-UI-09) share the board with a receiver whose MDS target is -140 dBm (REQ-SYS-022); REQ-SYS-034 bounds internally generated receive responses (TBR), there is a possibility of internally generated harmonics or switching noise appearing in the receive passband above the REQ-SYS-034 allowance at operating frequencies adversely impacting RX sensitivity and the board layout (RX, PWR, CTL), leading to birdies or a raised noise floor that mask weak signals (MOE-010), bench faults misattributed to the PA or display, and layout or filtering changes after CDR.

| Field | Value |
|---|---|
| Category | technical |
| Likelihood | 4 (Likely) |
| Consequence by dimension | Safety 1 / First power-on 3 / Cost 2 / Schedule 3 / Performance margin 3 |
| Consequence (max) | 3 (Moderate); driving: First power-on, Schedule, Performance margin |
| Score / band | 12 / Red |
| Assessment confidence | Medium |
| Status / trend | Open / Stable |
| Owner | Claude |
| Opened / horizon | 2026-09-25 / SAR |
| Last assessed | 2026-09-27 (SRR) |
| Source | SRR research candidate pass 2026-09-25: candidates R-UI-01 and R-UI-09 (docs/research/display-and-ui-parts.md Risk candidates) and R-PWR-03 (docs/research/power-tree-and-charging.md implication 14) entered as one family |
| Strategy | Mitigate |
| Plan approval | 2026-09-26, memo docs/reviews/SRR/decision-memo.md |

**Likelihood rationale.** Anchor level 4 (no analysis yet): the coincident harmonics are a derived fact; their level after layout and filtering has no analysis yet. 06 section 6 case (a): a design-analysis risk takes the anchor its facts meet.

**Consequence rationale.** Driving dimensions first_power_on, schedule and performance_margin at 3: the receiver is degraded and the fix is a layout or filtering iteration.

**Mitigation steps**

| Step | Action | Artifact | Due | Status |
|---|---|---|---|---|
| S1 | Clock plan analysis: harmonic table of every clock, bus and switcher frequency against 144 to 148 MHz and the IF, with SPI, I2C, PWM and buck SYNC frequencies chosen from the clear set and the USB PLL off when not enumerated (A-UI-03), recorded by ADR. | docs/design/analysis/clock-plan.md; docs/decisions/adr/ADR-NNN-clock-plan.md | PDR | Planned |
| S2 | LTspice of the buck output filter plus LDO PSRR showing the 2.2 MHz and 1.5 MHz residuals on the 3.3 V analog rail below the receiver spur budget (power report A-PWR-06). | hardware/sim/pwr/ | CDR | Planned |
| S3 | Layout partitioning and shielding of the Pico 2 module and the switchers from the RX front end, checked in the CDR layout review. | hardware/kicad/; docs/reviews/CDR/checklists/design-layout.md | CDR | Planned |
| S4 | Birdie survey: receiver scan of 144 to 148 MHz with each switcher and the amplifier on and off, with expected spurs logged before bench tests. | docs/test_cases/sys/test_cases.json (REQ-SYS-034 case) | TRR | Planned |

**Triggers**

| Condition | Response |
|---|---|
| The harmonic table shows an unavoidable in-passband spur above the REQ-SYS-034 allowance | Claude proposes a frequency change, spread spectrum or added filtering by ADR before CDR |

**Fallback.** Move clocks, add filtering and shielding by CR, and document any residual birdie frequency in the handbook.

**Related.** requirement: REQ-SYS-022, REQ-SYS-034; trade study: TS-001; stakeholder input: SI-007, SI-022; risk: RSK-032

**Closure criteria.** REQ-SYS-034 verified on the delivered unit with the birdie survey recorded.

**History**

| Date | Review | L | C | Safety | Score | Status | Note |
|---|---|---|---|---|---|---|---|
| 2026-09-25 | SRR | 3 | 3 | 1 | 9 | Proposed | Entered at the SRR research candidate pass (06 section 9, Identify) during SRR package assembly; awaiting the independent check of docs/reviews/SRR/checklists/risk-register.md. |
| 2026-09-25 | SRR | 4 | 3 | 1 | 12 | Proposed | Re-levelled 3 to 4 after INSP-007 (docs/reviews/SRR/checklists/risk-register-06.md) finding F-02: the recorded level disagreed with the 06 section 6 anchor the rationale itself describes; score 9 to 12. |
| 2026-09-25 | SRR | 4 | 3 | 1 | 12 | Proposed | INSP-007 (docs/reviews/SRR/checklists/risk-register-06.md) finding F-04: trade-study references corrected (TS-001 is receiver-and-pa-concept, TS-002 is firmware-runtime-make-buy; unwritten studies carry TS-NNN until created) and related.trade_study_ids set for the studies that name this risk. Score unchanged. |
| 2026-09-27 | SRR | 4 | 3 | 1 | 12 | Open | Track pass 2026-09-27 (docs/plan/pdr-work-plan.md WP-PDR-18 wave 0; 06 section 9 Track and Control; INSP-007 finding-18, docs/reviews/SRR/checklists/risk-register-06.md), recorded at review point SRR, the last gate passed (06 section 10.3); the PDR Track pass of 06 section 10 item 1 follows at PDR package assembly. Status Proposed to Open: INSP-007 (APPROVED; item CK-RSK-A2) records the Analyze check passing all 65 risks (06 section 9 transition table). Likelihood and consequence unchanged: no analysis, test, trigger poll or SRR ruling since the SRR Track pass changes this risk's evidence. |

### RSK-043

**PCB, part and enclosure geometry mismatch at first assembly**

Given the board, the machined enclosure and panel-mounted parts meet at several tight interfaces: the Sharp display FPC and its 0.5 mm ZIF, whose contact side and pin-1 orientation are the classic first-board error (docs/research/display-and-ui-parts.md F2, R-UI-05); the PEC11R bushing length against the PCB-to-panel distance (F12, R-UI-08); a PCB-mount bulkhead SMA jack whose PCB outline, standoff and lid hole must agree within about 0.3 mm (docs/research/antenna-and-erp.md F8, ANT-R6); PCBWay tolerance statements that conflict between +/-0.125 mm and ISO 2768-m up to +/-0.3 mm (docs/research/enclosure-cnc-and-openscad-pipeline.md A5); and possible panel rails on a board below 50 mm (docs/research/pcbway-fabrication-and-assembly.md F19, R-PCB-06), there is a possibility of a connector, control or mounting feature not fitting or not seating when the delivered board is assembled into the machined enclosure adversely impacting ME enclosure, CTL panel parts and the PCB outline, leading to a display or control that cannot be fitted or does not work, pre-loaded solder joints, re-machining of an enclosure set (USD 250 to 600) or rework.

| Field | Value |
|---|---|
| Category | technical |
| Likelihood | 4 (Likely) |
| Consequence by dimension | Safety 1 / First power-on 3 / Cost 3 / Schedule 3 / Performance margin 2 |
| Consequence (max) | 3 (Moderate); driving: First power-on, Cost, Schedule |
| Score / band | 12 / Red |
| Assessment confidence | Medium |
| Status / trend | Open / Stable |
| Owner | Claude |
| Opened / horizon | 2026-09-25 / TRR |
| Last assessed | 2026-09-27 (SRR) |
| Source | SRR research candidate pass 2026-09-25: candidates R-UI-05 and R-UI-08 (docs/research/display-and-ui-parts.md Risk candidates), ENC-R2 (docs/research/enclosure-cnc-and-openscad-pipeline.md Implications, RISK-candidate 2), ANT-R6 (docs/research/antenna-and-erp.md Risks) and R-PCB-06 (docs/research/pcbway-fabrication-and-assembly.md Risks) entered as one family; SRR ADR candidate pass 2026-09-25 merged ADR008-R2 |
| Strategy | Mitigate |
| Plan approval | 2026-09-26, memo docs/reviews/SRR/decision-memo.md |

**Likelihood rationale.** Anchor level 4 (no analysis yet): each interface has a documented error mode and no tolerance analysis or fit-check exists yet. 06 section 6 case (a): a design-analysis risk takes the anchor its facts meet.

**Consequence rationale.** Driving dimensions first_power_on, cost and schedule at 3: one subsystem unusable or a re-machining run of 3 to 6 weeks.

**Mitigation steps**

| Step | Action | Artifact | Due | Status |
|---|---|---|---|---|
| S1 | Overlay the Sharp outline drawing on the KiCad footprint and render the ZIF contact side and pin 1 against the FPC drawing (charter section 11 rule 3). | hardware/kicad/ footprints; docs/reviews/CDR/figures/ | CDR | Planned |
| S2 | Tolerance stack analysis of the SMA bulkhead jack, encoder bushings, jack noses and display window, with explicit +/-0.1 mm callouts on the drawing for every mating feature. | docs/design/analysis/mechanical-tolerance-stack.md; hardware/enclosure/ drawing | PDR | Planned |
| S3 | Decide single board versus panel with rails (D-PCB-04; board thickness and panel decision of concept section 11.2, recorded as an ADR per the ADR README) and the depanel edge finish so the outline the enclosure sees is fixed. | docs/decisions/adr/ADR-NNN-board-thickness-panel.md | PDR | Planned |
| S4 | H2C fit-check print with the real PCB and parts before the CNC order. | docs/vv/reports/fit-check-<n>.md | CDR | Planned |

**Triggers**

| Condition | Response |
|---|---|
| The fit-check print shows a mating feature out by more than 0.2 mm | Claude corrects the model and reprints before the CNC order |

**Fallback.** Pigtail the SMA jack, adjust standoffs or re-machine the affected part by CR.

**Related.** requirement: REQ-SYS-103, REQ-SYS-105, REQ-SYS-108; adr: ADR-007, ADR-008; stakeholder input: SI-008, SI-012, SI-031, SI-032; risk: RSK-025, RSK-044

**Closure criteria.** Every delivered unit assembled without a fit failure, recorded in the receipt inspection and as-built records.

**History**

| Date | Review | L | C | Safety | Score | Status | Note |
|---|---|---|---|---|---|---|---|
| 2026-09-25 | SRR | 3 | 3 | 1 | 9 | Proposed | Entered at the SRR research candidate pass (06 section 9, Identify) during SRR package assembly; awaiting the independent check of docs/reviews/SRR/checklists/risk-register.md. |
| 2026-09-25 | SRR | 4 | 3 | 1 | 12 | Proposed | Re-levelled 3 to 4 after INSP-007 (docs/reviews/SRR/checklists/risk-register-06.md) finding F-02: the recorded level disagreed with the 06 section 6 anchor the rationale itself describes; score 9 to 12. |
| 2026-09-25 | SRR | 4 | 3 | 1 | 12 | Proposed | ADR-008 section 4.4 candidate 'tolerance statements conflict between PCBWay pages' merged: the same departure as ENC-R2. Score unchanged. |
| 2026-09-25 | SRR | 4 | 3 | 1 | 12 | Proposed | INSP-007 (docs/reviews/SRR/checklists/risk-register-06.md) finding F-04: trade-study references corrected (TS-001 is receiver-and-pa-concept, TS-002 is firmware-runtime-make-buy; unwritten studies carry TS-NNN until created) and related.trade_study_ids set for the studies that name this risk. Score unchanged. |
| 2026-09-27 | SRR | 4 | 3 | 1 | 12 | Open | Track pass 2026-09-27 (docs/plan/pdr-work-plan.md WP-PDR-18 wave 0; 06 section 9 Track and Control; INSP-007 finding-18, docs/reviews/SRR/checklists/risk-register-06.md), recorded at review point SRR, the last gate passed (06 section 10.3); the PDR Track pass of 06 section 10 item 1 follows at PDR package assembly. Status Proposed to Open: INSP-007 (APPROVED; item CK-RSK-A2) records the Analyze check passing all 65 risks (06 section 9 transition table). Likelihood and consequence unchanged: no analysis, test, trigger poll or SRR ruling since the SRR Track pass changes this risk's evidence. CR-003 revision 3 (Submitted, d9a215a; section 4 Risk row) proposes changes to this risk; a submitted CR changes no baseline (06 section 10.2 trigger noted), so the changes are applied with a Refs trailer naming the CR after the owner's disposition (WP-PDR-02 and the WP-PDR-18 final pass). This pass keeps the current values. |

### RSK-048

**Receiver front end damaged by transmit leakage or a T/R fault**

Given the receiver input must see at most about 1 mW during transmit (docs/research/2m-cw-transceiver-reference-designs.md F7) while the transmitter delivers 5 W; the baseline T/R element is a sequenced relay of the TE HF3 class with the LNA supply off in transmit and a protection stage bounding the LNA input to +17 dBm under a single fault (docs/research/tr-switch-candidates.md F3, F17, F19); a stuck relay or a bias-loss fault puts the full RF voltage on the receive path; the relay part and the protection stage are chosen at PDR; REQ-SYS-037 sets the receive overload survival (TBR), there is a possibility of the LNA or mixer being damaged or degraded by transmit energy in normal sequencing or after a single T/R fault adversely impacting RX front end (B08) and the T/R node (B03), leading to a unit that transmits but no longer receives, with an SMD front-end repair the owner cannot do (SI-031).

| Field | Value |
|---|---|
| Category | technical |
| Likelihood | 4 (Likely) |
| Consequence by dimension | Safety 1 / First power-on 3 / Cost 3 / Schedule 3 / Performance margin 3 |
| Consequence (max) | 3 (Moderate); driving: First power-on, Cost, Schedule, Performance margin |
| Score / band | 12 / Red |
| Assessment confidence | Medium |
| Status / trend | Open / Stable |
| Owner | Claude |
| Opened / horizon | 2026-09-25 / SAR |
| Last assessed | 2026-09-27 (SRR) |
| Source | SRR research candidate pass 2026-09-25: candidates REFDES-12 (docs/research/2m-cw-transceiver-reference-designs.md implication 12) and TR-R12 (docs/research/tr-switch-candidates.md implication 12) entered as one family |
| Strategy | Mitigate |
| Plan approval | 2026-09-26, memo docs/reviews/SRR/decision-memo.md |

**Likelihood rationale.** Anchor level 4 (no analysis yet): no isolation or fault-case analysis exists yet for the relay baseline. 06 section 6 case (a): a design-analysis risk takes the anchor its facts meet.

**Consequence rationale.** Driving dimensions first_power_on, cost, schedule and performance_margin at 3: the receive subsystem is lost until a vendor rework.

**Mitigation steps**

| Step | Action | Artifact | Due | Status |
|---|---|---|---|---|
| S1 | LTspice of the PA, LPF and T/R block with the relay isolation, the LNA supply switching and the protection stage, including the stuck-relay and bias-loss cases, with pass criteria from REQ-SYS-037 (tr-switch ACTION 21). | hardware/sim/tr/ | PDR | Planned |
| S2 | Sequencer timing: LNA supply removed and relay settled before PA bias, envelope fall complete before relay release. | docs/icd/ICD-TX-SW.md | PDR | Planned |
| S3 | Bench: NanoVNA S21 from the TX to the RX port in the TX state at low level, then keyed tests with the receiver noise floor re-measured afterwards. | docs/test_cases/sys/test_cases.json (REQ-SYS-036 and REQ-SYS-037 cases) | TRR | Planned |

**Triggers**

| Condition | Response |
|---|---|
| The fault-case simulation shows more than +17 dBm at the LNA input | Claude adds a second protection stage or a limiter before CDR |

**Fallback.** Add a limiter stage and accept a small noise-figure penalty by CR.

**Related.** requirement: REQ-SYS-036, REQ-SYS-037; adr: ADR-010; stakeholder input: SI-031, SI-036; risk: RSK-031

**Closure criteria.** REQ-SYS-036 and REQ-SYS-037 verified on the delivered unit.

**History**

| Date | Review | L | C | Safety | Score | Status | Note |
|---|---|---|---|---|---|---|---|
| 2026-09-25 | SRR | 3 | 3 | 1 | 9 | Proposed | Entered at the SRR research candidate pass (06 section 9, Identify) during SRR package assembly; awaiting the independent check of docs/reviews/SRR/checklists/risk-register.md. |
| 2026-09-25 | SRR | 4 | 3 | 1 | 12 | Proposed | Re-levelled 3 to 4 after INSP-007 (docs/reviews/SRR/checklists/risk-register-06.md) finding F-02: the recorded level disagreed with the 06 section 6 anchor the rationale itself describes; score 9 to 12. |
| 2026-09-27 | SRR | 4 | 3 | 1 | 12 | Open | Track pass 2026-09-27 (docs/plan/pdr-work-plan.md WP-PDR-18 wave 0; 06 section 9 Track and Control; INSP-007 finding-18, docs/reviews/SRR/checklists/risk-register-06.md), recorded at review point SRR, the last gate passed (06 section 10.3); the PDR Track pass of 06 section 10 item 1 follows at PDR package assembly. Status Proposed to Open: INSP-007 (APPROVED; item CK-RSK-A2) records the Analyze check passing all 65 risks (06 section 9 transition table). Likelihood and consequence unchanged: no analysis, test, trigger poll or SRR ruling since the SRR Track pass changes this risk's evidence. |

### RSK-052

**Fabrication and assembly cost above the cost model**

Given the cost model (docs/plan/cost-estimate.md) is a rough order of magnitude without quotes; PCBWay component pricing includes shipping, customs and attrition, so the BOM of five boards may be 1.5 to 2 times distributor list with passives bought in overage (docs/research/pcbway-fabrication-and-assembly.md F17, F18, F22); IPC-4761 Type VII via fill is priced only after review, at 2.5 to 3 times the via cost in secondary sources (docs/research/pcbway-export-and-vendor-questions.md F15); REQ-SYS-147 sets at most USD 610 (TBR) per unit, the unit budget the owner set at SRR (decision 90; TPM-014), there is a possibility of the quoted fabrication, assembly and enclosure cost at CDR exceeding the owner's per-unit budget adversely impacting the cost model and TPM-014, leading to a spend of USD 100 to 300 beyond contingency, fewer assembled units, or a descope at CDR.

| Field | Value |
|---|---|
| Category | cost |
| Likelihood | 4 (Likely) |
| Consequence by dimension | Safety 1 / First power-on 1 / Cost 3 / Schedule 2 / Performance margin 1 |
| Consequence (max) | 3 (Moderate); driving: Cost |
| Score / band | 12 / Red |
| Assessment confidence | Medium |
| Status / trend | Open / Stable |
| Owner | Robin |
| Opened / horizon | 2026-09-25 / CDR |
| Last assessed | 2026-09-27 (SRR) |
| Source | SRR research candidate pass 2026-09-25: candidates R-PCB-05 (docs/research/pcbway-fabrication-and-assembly.md Risks) and R-PCB-09 (docs/research/pcbway-export-and-vendor-questions.md implication 10) entered as one family |
| Strategy | Mitigate |
| Plan approval | 2026-09-26, memo docs/reviews/SRR/decision-memo.md |

**Likelihood rationale.** Anchor level 4 (no analysis yet): no quote exists and the markup factors come from vendor and secondary sources. 06 section 6 case (a): a design-analysis risk takes the anchor its facts meet.

**Consequence rationale.** Driving dimension cost 3: an overrun of USD 100 to 300 beyond contingency.

**Mitigation steps**

| Step | Action | Artifact | Due | Status |
|---|---|---|---|---|
| S1 | Instant quotes at PDR for 5 boards at 1.6 mm and 1.0 mm with and without via fill and impedance control, and the enclosure quote, logged as TPM-014 data (A-PCB-09). | docs/plan/cost-estimate.md; docs/plan/tpm.json TPM-014 history | PDR | Planned |
| S2 | CDR cost estimate from the PCBWay assembly estimator with the BOM priced at distributor plus PCBWay overheads, with consignment of expensive parts considered (combo mode, D-PCB-03). | docs/plan/cost-estimate.md | CDR | Planned |

**Triggers**

| Condition | Response |
|---|---|
| A quote puts the per-unit estimate more than 10 % over the owner's budget | Claude presents the descope options of docs/design/concept.md section 12 to the owner at the next gate |

**Fallback.** Assemble three units instead of five, or drop via fill where the thermal analysis allows.

**Related.** requirement: REQ-SYS-147; adr: ADR-007, ADR-025; tpm: TPM-014; stakeholder input: SI-009, SI-035; risk: RSK-038

**Closure criteria.** CDR quotes within the owner's budget with contingency, recorded in the CDR decision memo.

**History**

| Date | Review | L | C | Safety | Score | Status | Note |
|---|---|---|---|---|---|---|---|
| 2026-09-25 | SRR | 3 | 3 | 1 | 9 | Proposed | Entered at the SRR research candidate pass (06 section 9, Identify) during SRR package assembly; awaiting the independent check of docs/reviews/SRR/checklists/risk-register.md. |
| 2026-09-25 | SRR | 4 | 3 | 1 | 12 | Proposed | Re-levelled 3 to 4 after INSP-007 (docs/reviews/SRR/checklists/risk-register-06.md) finding F-02: the recorded level disagreed with the 06 section 6 anchor the rationale itself describes; score 9 to 12. |
| 2026-09-27 | SRR | 4 | 3 | 1 | 12 | Open | Track pass 2026-09-27 (docs/plan/pdr-work-plan.md WP-PDR-18 wave 0; 06 section 9 Track and Control; INSP-007 finding-18, docs/reviews/SRR/checklists/risk-register-06.md), recorded at review point SRR, the last gate passed (06 section 10.3); the PDR Track pass of 06 section 10 item 1 follows at PDR package assembly. Status Proposed to Open: INSP-007 (APPROVED; item CK-RSK-A2) records the Analyze check passing all 65 risks (06 section 9 transition table). Condition restated after SRR decision 90 (owner ruling 2026-09-26: 'USD 610 per unit'), which the condition described as a pending decision. CR-003 revision 3 (Submitted, d9a215a; section 4 Risk row) and CR-006 revision 2 (Submitted, 39a6b13; section 1.7) propose changes to this risk; a submitted CR changes no baseline (06 section 10.2 trigger noted), so the changes are applied with a Refs trailer naming the CR after the owner's disposition (WP-PDR-02 and the WP-PDR-18 final pass). This pass keeps the current values. |

### RSK-005

**Single-source RF power device or synthesizer unavailable at order time**

Given the PA device and the frequency synthesizer are single-source ICs with no footprint-compatible alternate identified, the PA device must be sourced from DigiKey, Mouser or PCBWay's turnkey distributors (SI-028, ADR-012), the synthesizer is chosen by cost and performance trade (SI-029, ADR-013), the order is placed only after CDR (charter section 3), and distributor stock of RF devices fluctuates, there is a possibility of the selected device being out of stock, not recommended for new designs, or end-of-life when the CDR order is placed or when friend units (SI-019) are built later adversely impacting the TX PA and LO designs and the BOM baseline, leading to PA or LO redesign and PCB re-layout before the first build, or inability to build additional units.

| Field | Value |
|---|---|
| Category | programmatic (tags: single-source) |
| Likelihood | 3 (Possible) |
| Consequence by dimension | Safety 1 / First power-on 2 / Cost 3 / Schedule 4 / Performance margin 2 |
| Consequence (max) | 4 (Major); driving: Schedule |
| Score / band | 12 / Red |
| Assessment confidence | Medium |
| Status / trend | Open / Stable |
| Owner | Robin |
| Opened / horizon | 2026-09-25 / CDR |
| Last assessed | 2026-09-27 (SRR) |
| Source | Formulation risk identification 2026-09-25 against SI-009, SI-019; SEMP section 5.13 (single-source parts open a risk); SRR research candidate pass 2026-09-25 merged REFDES-6, PATK-9 |
| Strategy | Mitigate |
| Plan approval | 2026-09-26, memo docs/reviews/SRR/decision-memo.md |

**Likelihood rationale.** Two single-source parts over a multi-month window from Formulation to order; RF power devices in particular have shown distributor stock gaps. Anchor level 3.

**Consequence rationale.** Driving dimension schedule 4: a redesign plus re-layout before order is a 6 to 12 week slip of CDR. Cost 3: additional parts and possibly a second early buy.

**Mitigation steps**

| Step | Action | Artifact | Due | Status |
|---|---|---|---|---|
| S1 | Part-selection trade studies (mandatory for single-source parts, process section 14.1 (b)) scoring lifecycle status, stock depth of at least 3 times the project quantity at two distributors, and the existence of an alternate. | docs/decisions/trade-studies/TS-001-receiver-and-pa-concept.md (sub-decision P, PA device); docs/decisions/trade-studies/TS-NNN-synthesizer.md (ADR-013 study; number assigned at creation) | PDR | Planned |
| S2 | Identify a footprint-compatible alternate for each single-source part or lay out a dual footprint that accepts two candidates. | hardware/bom/ alternates column; hardware/kicad/ schematic | CDR | Planned |
| S3 | Early buy of critical parts (PA device, synthesizer, TCXO, filter) at PDR for twice the planned quantity, held by the owner or consigned to PCBWay; the ADR records the owner's decision because it spends money (process section 14.1 class 2). | docs/decisions/adr/ADR-NNN-early-buy.md; spend recorded in docs/plan/cost-estimate.md | PDR | Planned |
| S4 | Re-query distributor stock and manufacturer lifecycle status for every critical part at CDR (01 section 6 row 21, procurement status). | docs/reviews/CDR/package.md (procurement status section) | CDR | Planned |
| S5 | Owner lifetime reserve of 20 PD54008L-E (or the device TS-001 sub-decision P selects) bought at PDR, with the fallback design kept current and the status re-checked at CDR (PATK-9). | docs/decisions/adr/ADR-NNN-early-buy.md; hardware/bom/ | PDR | Planned |

**Triggers**

| Condition | Response |
|---|---|
| Distributor stock below twice the project quantity, or lifecycle status changes to not-recommended or end-of-life | Owner executes the early buy immediately or Claude switches to the alternate; a CR is opened if the baselined BOM changes |

**Fallback.** Redesign the affected stage around the alternate device; accept a one-iteration schedule slip.

**Related.** adr: ADR-012, ADR-013; trade study: TS-001; tpm: TPM-014; stakeholder input: SI-009, SI-019, SI-028, SI-029; risk: RSK-001, RSK-002

**Closure criteria.** Every critical part received for the planned quantity including friend units, and alternates recorded in the BOM.

**History**

| Date | Review | L | C | Safety | Score | Status | Note |
|---|---|---|---|---|---|---|---|
| 2026-09-25 | Pre-SRR | 3 | 4 | n/r | 12 | Proposed | Opened during Formulation risk identification; awaiting independent check. |
| 2026-09-25 | Pre-SRR | 3 | 4 | 1 | 12 | Proposed | SI-028, SI-029, ADR-012 and ADR-013 linked; early-buy artifact is an owner ADR; tagged single-source. Score unchanged. |
| 2026-09-25 | SRR | 3 | 4 | 1 | 12 | Proposed | SRR Track pass at package assembly 2026-09-25 (06 section 10 item 1): re-assessed against the SRR research candidate pass; likelihood and consequence unchanged; status stays Proposed until the independent check of docs/reviews/SRR/checklists/risk-register.md. Merged candidates REFDES-6, PATK-9 (06 section 9 disposition rule; family rule of section 4 applied: same asset, driving dimension, plan and kind); worst member does not raise the score. Step added for the merged candidates. |
| 2026-09-25 | SRR | 3 | 4 | 1 | 12 | Proposed | INSP-007 (docs/reviews/SRR/checklists/risk-register-06.md) finding F-04: trade-study references corrected (TS-001 is receiver-and-pa-concept, TS-002 is firmware-runtime-make-buy; unwritten studies carry TS-NNN until created) and related.trade_study_ids set for the studies that name this risk. Score unchanged. |
| 2026-09-27 | SRR | 3 | 4 | 1 | 12 | Open | Track pass 2026-09-27 (docs/plan/pdr-work-plan.md WP-PDR-18 wave 0; 06 section 9 Track and Control; INSP-007 finding-18, docs/reviews/SRR/checklists/risk-register-06.md), recorded at review point SRR, the last gate passed (06 section 10.3); the PDR Track pass of 06 section 10 item 1 follows at PDR package assembly. Status Proposed to Open: INSP-007 (APPROVED; item CK-RSK-A2) records the Analyze check passing all 65 risks (06 section 9 transition table). Likelihood and consequence unchanged: no analysis, test, trigger poll or SRR ruling since the SRR Track pass changes this risk's evidence. |

### RSK-012

**Keyer function or feel unusable on the built radio**

Given SI-018 requires support for both a straight key and iambic paddles on standard 3.5 mm TRS plugs (SI-034, ADR-009) through a built-in electronic keyer at 5 to 50 WPM (SI-033) with semi break-in and adjustable hang time (SI-036, ADR-010); keying drives PA enable and is a safety-critical software function (charter section 10); the keyer is verified before build by HostUnit tests and optional emulation, without a real key or paddle attached until the dev-board check, there is a possibility of the straight-key and iambic-paddle keying behaving incorrectly or unpleasantly on the built radio: key-type selection, iambic timing (dit-dah ratio, element spacing, mode A or B behavior, dot and dash memory), hang time, contact debounce or key-to-RF latency adversely impacting the SW-KEYER keyer, the sidetone and the operating scenario SI-005, leading to unusable or unpleasant sending, SI-018 not met as stated, and rework of the keyer firmware after build.

| Field | Value |
|---|---|
| Category | software (tags: hsi) |
| Likelihood | 3 (Possible) |
| Consequence by dimension | Safety 1 / First power-on 2 / Cost 2 / Schedule 2 / Performance margin 4 |
| Consequence (max) | 4 (Major); driving: Performance margin |
| Score / band | 12 / Red |
| Assessment confidence | Medium |
| Status / trend | Mitigating / Stable |
| Owner | Claude |
| Opened / horizon | 2026-09-25 / SAR |
| Last assessed | 2026-09-27 (SRR) |
| Source | Formulation risk identification 2026-09-25 against SI-005, SI-018; SRR research candidate pass 2026-09-25 merged R4, R5, R8, R-KN4 |
| Strategy | Mitigate |
| Plan approval | 2026-09-26, memo docs/reviews/SRR/decision-memo.md |

**Likelihood rationale.** Keyer timing is well understood, but feel is subjective and no human-in-the-loop test has been run yet; key-type handling through one jack is a common source of field complaints. Anchor level 3.

**Consequence rationale.** Driving dimension performance_margin 4: SI-018 (straight key and iambic paddles) is a stakeholder input and would be unmet as stated. first_power_on 2: the keyer is firmware and is fixed by a reflash with no PCB change. Safety 1: the unintended or stuck transmission departure is RSK-024.

**Mitigation steps**

| Step | Action | Artifact | Due | Status |
|---|---|---|---|---|
| S1 | Derive keyer requirements from SI-018, SI-033 and SI-036 with measurable timing: element length 1200 ms divided by words per minute, 3:1 dah-to-dit ratio, weighting range, speed range 5 to 50 WPM, mode A and B, hang time range, debounce time, key-to-RF latency (TPM-013). | docs/requirements/sw/sw-keyer/requirements.json; docs/plan/tpm.json (TPM-013) | PDR | Planned |
| S2 | HostUnit tests replaying recorded paddle and straight-key contact sequences including contact bounce, checking element timing and hang time against the requirement tolerances. | firmware/cwht-core/ keyer tests; docs/test_cases/sw-keyer/test_cases.json | CDR | Planned |
| S3 | Human-in-the-loop check on the Pico 2 development board with PWM sidetone and the owner's own straight key and paddle before CDR (07 section 3 FW-B1); the owner rates timing feel and both key types; recorded as Bench with credit: false (charter section 3). | docs/vv/reports/<TC-ID>-r<N>.md with article pico2-devboard-1 and credit: false | CDR | Planned |
| S5 | Record the key jack wiring in the external ICD stub: 3.5 mm TRS with tip = dit or straight key, ring = dah, sleeve = ground; contact voltage, current, debounce, ESD provision (02 section 3.5). | docs/icd/ICD-CTL-KEY.md | SRR | Done (docs/icd/ICD-CTL-KEY.md (committed 2026-09-26 in the SRR integration commit of docs/icd/): jack wiring (tip dit or straight key, ring dah, sleeve ground), contact voltage and current (section 3.2.4), debounce (section 3.2.5) and the ESD provision (section 3.2.7.1); independent review of the ICD stubs is INSP-012) |
| S6 | Keyer timing from TIMER0 alarms independent of the UI loop with a HostUnit timing test under worst-case UI load; switchpoint and debounce defaults exposed in the menu for the human-in-the-loop session (R4, R5, R8, R-KN4). | docs/test_cases/sw-keyer/test_cases.json | CDR | Planned |

**Triggers**

| Condition | Response |
|---|---|
| Owner rates timing feel as unacceptable in the S3 check | Claude adjusts the timing parameters and repeats S3 before CDR; an open result is a CDR lien |
| HostUnit element timing error or key-to-element latency exceeds the TPM-013 threshold | Claude corrects the keyer before CDR and re-runs S2; an open result is a CDR lien |

**Fallback.** First release supports straight-key mode only with the iambic keyer delivered by firmware update; CR to the keyer requirements with owner approval.

**Related.** adr: ADR-009, ADR-010; tpm: TPM-013; stakeholder input: SI-005, SI-018, SI-033, SI-034, SI-036; risk: RSK-003, RSK-008, RSK-010, RSK-024

**Closure criteria.** Keyer requirements verified by Test on the delivered unit with both key types and accepted by the owner at SAR.

**History**

| Date | Review | L | C | Safety | Score | Status | Note |
|---|---|---|---|---|---|---|---|
| 2026-09-25 | Pre-SRR | 3 | 4 | n/r | 12 | Proposed | Opened during Formulation risk identification; awaiting independent check. |
| 2026-09-25 | Pre-SRR | 3 | 4 | 4 | 12 | Proposed | SI-033, SI-034, SI-036, ADR-009, ADR-010 and TPM-013 linked; HZ-004 and HZ-010 linked with safety 4 per HZ-004; hang time added to the departure; artifacts aligned to sw-keyer/ and the dev-board Bench rule. Max consequence and score unchanged. |
| 2026-09-25 | Pre-SRR | 3 | 4 | 1 | 12 | Proposed | Independent review 2026-09-25: split under process section 4 (a safety departure cannot share a family with keyer usability); the unintended or stuck transmission, HZ-004, HZ-010, step S4 and the time-out trigger moved to RSK-024. Consequence re-scored for the narrowed departure: safety 4 to 1, first_power_on 3 to 2; max consequence and score unchanged (performance_margin 4). |
| 2026-09-25 | SRR | 3 | 4 | 1 | 12 | Proposed | SRR Track pass at package assembly 2026-09-25 (06 section 10 item 1): re-assessed against the SRR research candidate pass; likelihood and consequence unchanged; status stays Proposed until the independent check of docs/reviews/SRR/checklists/risk-register.md. Merged candidates R4, R5, R8, R-KN4 (06 section 9 disposition rule; family rule of section 4 applied: same asset, driving dimension, plan and kind); worst member does not raise the score. Step added for the merged candidates. |
| 2026-09-25 | SRR | 3 | 4 | 1 | 12 | Proposed | S5 kept due SRR with a named closure event (SRR readiness item H9, risk manager): docs/icd/ holds .gitkeep only at this pass, so S5 is open. ICD-CTL-KEY is one of the five external ICD stubs that 01 section 4.3 row 17 (Hard) requires at SRR, so S5 cannot move past SRR without a recorded deviation from that row; it stays due SRR and closes with review package item H11, before the SRR readiness declaration, when docs/icd/ICD-CTL-KEY.md exists from docs/templates/icd.md with the jack wiring (3.5 mm TRS, tip dit or straight key, ring dah, sleeve ground), contact voltage and current, debounce and the ESD provision. Claude as risk manager then sets S5 Done with the file and its commit as evidence. Score unchanged. |
| 2026-09-26 | SRR | 3 | 4 | 1 | 12 | Proposed | S5 Done: docs/icd/ICD-CTL-KEY.md exists from docs/templates/icd.md with the jack wiring, contact voltage and current, debounce and the ESD provision (SRR package item H11); its commit is the evidence. Score unchanged. |
| 2026-09-27 | SRR | 3 | 4 | 1 | 12 | Mitigating | Track pass 2026-09-27 (docs/plan/pdr-work-plan.md WP-PDR-18 wave 0; 06 section 9 Track and Control; INSP-007 finding-18, docs/reviews/SRR/checklists/risk-register-06.md), recorded at review point SRR, the last gate passed (06 section 10.3); the PDR Track pass of 06 section 10 item 1 follows at PDR package assembly. Status Proposed to Open: INSP-007 (APPROVED; item CK-RSK-A2) records the Analyze check passing all 65 risks (06 section 9 transition table). Then Open to Mitigating: step S5 Done (06 section 9 transition). Likelihood and consequence unchanged: no analysis, test, trigger poll or SRR ruling since the SRR Track pass changes this risk's evidence. |

### RSK-027

**PA output power below the 5 W requirement**

Given the 5 W carrier output (SI-003, ADR-003) is predicted before fabrication only by LTspice with device models unconfirmed at 144 to 148 MHz; the PA device is constrained to parts sourced from DigiKey, Mouser or PCBWay's turnkey distributors (SI-028, ADR-012) and is not selected yet; efficiency at the 5 W step is TPM-004 and output power accuracy at each step is TPM-015, there is a possibility of the built PA delivering less than 5 W at the antenna port at the nominal pack voltage with the ALC at the top step adversely impacting the TX subsystem (PA stage, matching and output low-pass filter) and the 5 W stakeholder expectation SI-003, leading to a key driving expectation missed (for example 4 W instead of 5 W), a CR against the output-power requirement, or a PA rework or respin to restore it.

| Field | Value |
|---|---|
| Category | technical |
| Likelihood | 3 (Possible) |
| Consequence by dimension | Safety 1 / First power-on 3 / Cost 3 / Schedule 3 / Performance margin 4 |
| Consequence (max) | 4 (Major); driving: Performance margin |
| Score / band | 12 / Red |
| Assessment confidence | Medium |
| Status / trend | Open / Stable |
| Owner | Claude |
| Opened / horizon | 2026-09-25 / SAR |
| Last assessed | 2026-09-27 (SRR) |
| Source | Split from RSK-001 on 2026-09-25 after independent review (process section 4: the output-power shortfall is a non-safety departure and cannot share the HZ-008 safety family); SRR research candidate pass 2026-09-25 merged REFDES-8 |
| Strategy | Mitigate |
| Plan approval | 2026-09-26, memo docs/reviews/SRR/decision-memo.md |

**Likelihood rationale.** A single simulation chain with unvalidated VHF device models and no prototype stage; output power is sensitive to matching and device spread. Anchor level 3.

**Consequence rationale.** Driving dimension performance_margin 4: SI-003 (5 W) is a stakeholder input. first_power_on, cost and schedule 3: the radio still transmits, and restoring power needs BOM alternates or vendor rework (USD 100 to 300, 3 to 6 weeks).

**Mitigation steps**

| Step | Action | Artifact | Due | Status |
|---|---|---|---|---|
| S1 | Score output power at 5 W and 7.4 V pack voltage with at least 1 dB margin in the PA-device trade study (process section 14.1 (b); shared with RSK-001 S1). | docs/decisions/trade-studies/TS-001-receiver-and-pa-concept.md (sub-decision P, device choice) | PDR | Planned |
| S2 | Power budget: LTspice large-signal simulation of PA, matching and output filter at 6.4, 7.4 and 8.4 V pack voltage with component tolerances; output at the antenna port at least 1 dB above 5 W at 6.4 V. | docs/design/analysis/pa-output-power.md; docs/plan/tpm.json (TPM-004, TPM-015) | CDR | Planned |
| S3 | Design-for-debug alternates for the matching network and bias so that output can be restored by BOM alternates or vendor rework (shared with RSK-001 S4). | docs/design/build-to-specification.md (design-for-debug section); hardware/bom/ alternates column | CDR | Planned |
| S4 | Bench: output power at each step into the dummy load with the RF probe and the tinySA Ultra through the characterized attenuator (04 section 6.2). | docs/test_cases/tx/test_cases.json (TC-TX output power case) | SAR | Planned |
| S5 | ALC loop analysis showing 5.0 W at the 5 W step from 6.4 to 8.4 V and the output at 6.0 V (REFDES-8). | docs/decisions/trade-studies/TS-NNN-alc-envelope.md (concept section 11.2 ALC and envelope study; number assigned at creation) | PDR | Planned |

**Triggers**

| Condition | Response |
|---|---|
| Simulated output at 6.4 V pack voltage is below 5.6 W (1 dB margin) at CDR | Claude changes the matching network or the PA device before CDR; a CR is opened if the output-power requirement must change |
| Measured output is below 5 W at the top step at TRR | Claude opens an NCR and evaluates BOM alternates; the owner decides between rework and a CR to the requirement |

**Fallback.** Operate at the achieved power through a CR to the 5 W requirement accepted by the owner; otherwise a PA rework or respin funded from the cost-estimate contingency (RSK-008).

**Related.** adr: ADR-003, ADR-012; trade study: TS-001; tpm: TPM-004, TPM-015; stakeholder input: SI-003, SI-028; risk: RSK-001, RSK-008

**Closure criteria.** TX output-power requirement verified by Test on the delivered unit at every power step, with no NCR open against output power.

**History**

| Date | Review | L | C | Safety | Score | Status | Note |
|---|---|---|---|---|---|---|---|
| 2026-09-25 | Pre-SRR | 3 | 4 | 1 | 12 | Proposed | Split from RSK-001 after independent review; awaiting independent check. |
| 2026-09-25 | SRR | 3 | 4 | 1 | 12 | Proposed | SRR Track pass at package assembly 2026-09-25 (06 section 10 item 1): re-assessed against the SRR research candidate pass; likelihood and consequence unchanged; status stays Proposed until the independent check of docs/reviews/SRR/checklists/risk-register.md. Merged candidates REFDES-8 (06 section 9 disposition rule; family rule of section 4 applied: same asset, driving dimension, plan and kind); worst member does not raise the score. Step added for the merged candidates. |
| 2026-09-25 | SRR | 3 | 4 | 1 | 12 | Proposed | INSP-007 (docs/reviews/SRR/checklists/risk-register-06.md) finding F-04: trade-study references corrected (TS-001 is receiver-and-pa-concept, TS-002 is firmware-runtime-make-buy; unwritten studies carry TS-NNN until created) and related.trade_study_ids set for the studies that name this risk. Score unchanged. |
| 2026-09-27 | SRR | 3 | 4 | 1 | 12 | Open | Track pass 2026-09-27 (docs/plan/pdr-work-plan.md WP-PDR-18 wave 0; 06 section 9 Track and Control; INSP-007 finding-18, docs/reviews/SRR/checklists/risk-register-06.md), recorded at review point SRR, the last gate passed (06 section 10.3); the PDR Track pass of 06 section 10 item 1 follows at PDR package assembly. Status Proposed to Open: INSP-007 (APPROVED; item CK-RSK-A2) records the Analyze check passing all 65 risks (06 section 9 transition table). Likelihood and consequence unchanged: no analysis, test, trigger poll or SRR ruling since the SRR Track pass changes this risk's evidence. |

### RSK-028

**Unlicensed person transmits on a loaned or unattended unit**

Given units are loaned to licensed friends (SI-019, SI-030, ADR-014) and may be handed around at gatherings; ADR-015 (accepted by SRR decision 17, owner ruling 2026-09-26) makes each licensee the station licensee and control operator of the unit held (OPS-A) and adds a licensee-settable receive-only guest lock (FW-03), included by SRR decision 19 (option a), that is not yet a requirement; an unlicensed person may key only as a supervised third party, at 0.5 W or 1 W with the control operator present (SRR decision 20) (docs/research/regulatory-corpus-and-operators.md F4), there is a possibility of an unlicensed person keying a cwht unit with no licensed control operator at that unit adversely impacting the licensee's compliance with 47 CFR 97.5 and 97.103 (SI-014) and the owner's standing in the local amateur community, leading to an unlawful transmission, FCC enforcement exposure for the station licensee, and community harm.

| Field | Value |
|---|---|
| Category | programmatic (tags: regulatory, software, hsi) |
| Likelihood | 3 (Possible) |
| Consequence by dimension | Safety 1 / First power-on 1 / Cost 1 / Schedule 1 / Performance margin 4 |
| Consequence (max) | 4 (Major); driving: Performance margin |
| Score / band | 12 / Red |
| Assessment confidence | Medium |
| Status / trend | Mitigating / Stable |
| Owner | Claude |
| Opened / horizon | 2026-09-25 / Ops |
| Last assessed | 2026-09-27 (SRR) |
| Source | ConOps section 8 candidate REG-4 (docs/research/regulatory-corpus-and-operators.md, Risks); hazard analysis section 12 HZ-006 row (unlicensed operation); entered 2026-09-25 |
| Strategy | Mitigate |
| Plan approval | 2026-09-26, memo docs/reviews/SRR/decision-memo.md |

**Likelihood rationale.** The research report rates the likelihood moderate in the 'play radio' use case (SI-019); the guest lock that removes the main pathway was included at SRR (decision 19; ADR-015 accepted, decision 17) but is not yet a requirement (S1 due PDR). Anchor level 3.

**Consequence rationale.** Driving dimension performance_margin 4: a 47 CFR Part 97 requirement is not met (consequence scale, performance column). The other dimensions do not apply.

**Mitigation steps**

| Step | Action | Artifact | Due | Status |
|---|---|---|---|---|
| S1 | Guest-lock requirement: a licensee-settable receive-only mode in which key events produce no PA enable, persisted across power cycles, with HostUnit and Bench cases (ADR-015 FW-03). | docs/requirements/sw/sw-txseq/requirements.json; docs/test_cases/sw-txseq/test_cases.json | PDR | Planned |
| S2 | Owner decision on ADR-015 at SRR recorded in the decision memo. | docs/decisions/adr/ADR-015-operator-model-ops-a-guest-lock.md; docs/reviews/SRR/decision-memo.md | SRR | Done (docs/reviews/SRR/decision-memo.md (signed 2026-09-26) section 8.0 decision 17 (K5, 'OPS-A default, OPS-B only by a dated record; accept ADR-015.'), decision 19 (K5, receive-only guest lock: 'Include, option a.') and decision 20 (K5, guest keying: 'Allow, restricted to 0.5 W and 1 W with the control operator present.'); docs/decisions/adr/ADR-015-operator-model-ops-a-guest-lock.md Status row 'Accepted'.) |
| S3 | Operator rules card and the handbook operator model (OPS-A, OPS-C; DOC-02). | docs/ops/operations-handbook.md; docs/conops/conops.md | SAR | Planned |

**Triggers**

| Condition | Response |
|---|---|
| ADR-015 is not approved at SRR or the guest lock is dropped | Claude re-assesses this risk the same session and proposes an alternative control to the owner (loaned units shipped with the guest lock on) |
| A friend reports an unlicensed transmission on a loaned unit | Owner recalls the unit; Claude opens an NCR against the operator model and re-assesses this risk |

**Fallback.** Loaned units ship with the guest lock enabled and no call sign stored, so that transmitting needs the licensee's own setup action; CR to the SW requirements.

**Related.** adr: ADR-014, ADR-015; stakeholder input: SI-014, SI-019, SI-030; risk: RSK-016

**Closure criteria.** Guest-lock requirement verified by HostUnit and Bench on the delivered unit, the operator rules card in the handbook, and the residual accepted by the owner at SAR.

**History**

| Date | Review | L | C | Safety | Score | Status | Note |
|---|---|---|---|---|---|---|---|
| 2026-09-25 | Pre-SRR | 3 | 4 | 1 | 12 | Proposed | Entered from ConOps section 8 candidate REG-4 after independent review; awaiting independent check. |
| 2026-09-25 | SRR | 3 | 4 | 1 | 12 | Proposed | SRR Track pass at package assembly 2026-09-25 (06 section 10 item 1): re-assessed against the SRR research candidate pass; likelihood and consequence unchanged; status stays Proposed until the independent check of docs/reviews/SRR/checklists/risk-register.md. |
| 2026-09-25 | SRR | 3 | 4 | 1 | 12 | Proposed | S2 re-planned (SRR readiness item H9, risk manager): S2 is an output of the SRR board, not an entrance product, so it cannot be Done before the review sits. Claude's part is done: ADR-015 is written with status 'Proposed, pending owner decision at SRR' (docs/decisions/adr/ADR-015-operator-model-ops-a-guest-lock.md, commit 28e49e6) and is owner decision 17 of docs/reviews/SRR/decisions-for-owner.md and package section 13.1, with the recommendation (OPS-A default, OPS-B only by a dated record, accept ADR-015) and the default if unanswered (OPS-A assumed; ADR-015 stays Proposed and S2 stays open). S2 set InProgress; due event: the owner's ruling on decision 17 transcribed into docs/reviews/SRR/decision-memo.md, after which S2 is set Done with the memo as evidence, or the first trigger fires. Score unchanged. |
| 2026-09-25 | SRR | 3 | 4 | 1 | 12 | Proposed | INSP-007 (docs/reviews/SRR/checklists/risk-register-06.md) finding F-08, optional HZ-006 link decided: not linked. RSK-016 carries HZ-006 (general-population exposure, including the non-licensee holder, controlled by the OPS-A 1 W limit); this risk's asset is the licensee's regulatory standing and its safety consequence is 1, so an HZ-006 link would duplicate RSK-016. Re-opened if the hazard analysis names unlicensed operation as an HZ-006 cause that RSK-016 does not control. Score unchanged. |
| 2026-09-27 | SRR | 3 | 4 | 1 | 12 | Mitigating | Track pass 2026-09-27 (docs/plan/pdr-work-plan.md WP-PDR-18 wave 0; 06 section 9 Track and Control; INSP-007 finding-18, docs/reviews/SRR/checklists/risk-register-06.md), recorded at review point SRR, the last gate passed (06 section 10.3); the PDR Track pass of 06 section 10 item 1 follows at PDR package assembly. Status Proposed to Open: INSP-007 (APPROVED; item CK-RSK-A2) records the Analyze check passing all 65 risks (06 section 9 transition table). Then Open to Mitigating: step S2 Done (06 section 9 transition). SRR decisions 17, 19 and 20 (owner ruling 2026-09-26) recorded: S2 Done with the memo and the ADR-015 Status row as evidence; condition and likelihood rationale restated in the past tense (ADR-015 accepted, guest lock included, guest keying restricted). Likelihood unchanged at 3: the guest lock is decided but not yet a requirement or a design (S1 due PDR). |

### RSK-029

**Cited regulatory text or FCC guidance changes unnoticed before on-air use**

Given the regulatory requirements cite 47 CFR Parts 1, 2 and 97 from the eCFR issue of 2026-09-23 (docs/references/md/regulatory/); 97.305, 97.307 and 97.313 were amended in 2023, 2024 and 2026 and 1.1307 in 2021 (REG-3); the five 47 CFR 2.106 allocation rows are Medium confidence because the current page images could not be read (REG-5); the rewritten OET 65 Supplement B and the FCC's draft extension of SAR exemption thresholds below 300 MHz are unreleased (RFX-R3), there is a possibility of a change to a cited regulatory text or to the FCC RF-exposure guidance taking effect, or coming to light, after the requirement or evaluation that relies on it was written, without being detected before the first on-air series adversely impacting the regulatory requirements (REQ-TX-* tagged regulatory), the RF Exposure Evaluation and the licensee's compliance (SI-014), leading to a requirement or RF exposure evaluation that no longer matches the rule, a CR and re-verification, or an on-air series under an outdated basis.

| Field | Value |
|---|---|
| Category | programmatic (tags: regulatory) |
| Likelihood | 3 (Possible) |
| Consequence by dimension | Safety 1 / First power-on 1 / Cost 1 / Schedule 2 / Performance margin 4 |
| Consequence (max) | 4 (Major); driving: Performance margin |
| Score / band | 12 / Red |
| Assessment confidence | Medium |
| Status / trend | Open / Stable |
| Owner | Claude |
| Opened / horizon | 2026-09-25 / TRR |
| Last assessed | 2026-09-27 (SRR) |
| Source | ConOps section 8 candidates REG-3 (docs/research/part97-regulatory-basis.md), REG-5 (docs/research/regulatory-corpus-and-operators.md) and RFX-R3 (docs/research/rf-exposure-evaluation.md), entered as one failure-mode family (process section 4) on 2026-09-25 |
| Strategy | Mitigate |
| Plan approval | 2026-09-26, memo docs/reviews/SRR/decision-memo.md |

**Likelihood rationale.** The cited sections were amended three times in four years and two guidance documents are pending; the re-check is planned but not performed. Anchor level 3.

**Consequence rationale.** Driving dimension performance_margin 4: a regulatory requirement may no longer be met as written (consequence scale, performance column). Schedule 2: a CR and re-verification cost 1 to 3 weeks. Scored at the worst member of the family (REG-5 alone would score lower).

**Mitigation steps**

| Step | Action | Artifact | Due | Status |
|---|---|---|---|---|
| S1 | eCFR version check of 47 CFR 97.305, 97.307, 97.313, 1.1307, 1.1310 and 2.1093 against the corpus issue date before CDR and before the on-air delta TRR (ACTION-5 of docs/research/part97-regulatory-basis.md), recorded in the package. | docs/references/md/regulatory/ (issue-date note); docs/reviews/CDR/package.md; docs/reviews/TRR-Dn/package.md | CDR | Planned |
| S2 | Owner browser check of the five 2.106 rows (DECISION-10 of docs/research/regulatory-corpus-and-operators.md) and re-check of the OET 65 Supplement B and SAR-exemption status before PDR. | docs/design/analysis/rf-exposure-evaluation.md (guidance status section) | PDR | Planned |
| S3 | On-air delta TRR entrance item: every regulatory requirement cites the current rule text (01 section 7.6). | docs/reviews/TRR-Dn/package.md (entrance checklist) | TRR | Planned |

**Triggers**

| Condition | Response |
|---|---|
| A version check finds an amendment to a cited section after 2026-09-23 | Claude updates the corpus, opens a CR against every affected requirement and re-assesses this risk the same session |
| OET 65 Supplement B or the SAR exemption extension is published | Claude revises the RF Exposure Evaluation before the next gate and re-assesses RSK-016 and RSK-030 |

**Fallback.** Hold the on-air delta TRR until the affected requirements and the RF Exposure Evaluation are revised to the current text by CR.

**Related.** adr: ADR-016; stakeholder input: SI-014; risk: RSK-011, RSK-016, RSK-030

**Closure criteria.** Version checks recorded clean, or every change carried by an approved CR, in the on-air delta TRR package, with the guidance status re-checked in the RF Exposure Evaluation at the same point.

**History**

| Date | Review | L | C | Safety | Score | Status | Note |
|---|---|---|---|---|---|---|---|
| 2026-09-25 | Pre-SRR | 3 | 4 | 1 | 12 | Proposed | Entered from ConOps section 8 candidates REG-3, REG-5 and RFX-R3 after independent review; awaiting independent check. |
| 2026-09-25 | SRR | 3 | 4 | 1 | 12 | Proposed | SRR Track pass at package assembly 2026-09-25 (06 section 10 item 1): re-assessed against the SRR research candidate pass; likelihood and consequence unchanged; status stays Proposed until the independent check of docs/reviews/SRR/checklists/risk-register.md. |
| 2026-09-27 | SRR | 3 | 4 | 1 | 12 | Open | Track pass 2026-09-27 (docs/plan/pdr-work-plan.md WP-PDR-18 wave 0; 06 section 9 Track and Control; INSP-007 finding-18, docs/reviews/SRR/checklists/risk-register-06.md), recorded at review point SRR, the last gate passed (06 section 10.3); the PDR Track pass of 06 section 10 item 1 follows at PDR package assembly. Status Proposed to Open: INSP-007 (APPROVED; item CK-RSK-A2) records the Analyze check passing all 65 risks (06 section 9 transition table). Likelihood and consequence unchanged: no analysis, test, trigger poll or SRR ruling since the SRR Track pass changes this risk's evidence. |

### RSK-045

**Keying sidebands exceed the bandwidth limit or cannot be shown compliant**

Given REQ-SYS-014 and REQ-SYS-015 set a raised-cosine envelope and a measured 26 dB bandwidth of at most 350 Hz (TBR) under 47 CFR 97.307(a) and (b); the envelope is produced through the gate-bias ALC node of a PA that is not yet selected and may not follow the drive envelope linearly (docs/research/keyer-and-key-interfaces.md F10, R6); the tinySA Ultra cannot resolve the close-in sidebands, so closure is Analysis on measured envelope data (docs/research/keyer-verification-and-key-input-network.md R-KN6; docs/research/regulatory-corpus-and-operators.md ACTION-9), there is a possibility of the transmitted keying sidebands exceeding the REQ-SYS-015 limit, or the Analysis closure being judged not credible adversely impacting TX envelope shaping (B04, SW-SEQ) and the 47 CFR 97.307 compliance record, leading to key clicks on adjacent frequencies, an unmet regulatory requirement blocking the on-air delta TRR, or an envelope redesign.

| Field | Value |
|---|---|
| Category | technical (tags: regulatory) |
| Likelihood | 3 (Possible) |
| Consequence by dimension | Safety 1 / First power-on 1 / Cost 2 / Schedule 3 / Performance margin 4 |
| Consequence (max) | 4 (Major); driving: Performance margin |
| Score / band | 12 / Red |
| Assessment confidence | Medium |
| Status / trend | Open / Stable |
| Owner | Claude |
| Opened / horizon | 2026-09-25 / SAR |
| Last assessed | 2026-09-27 (SRR) |
| Source | SRR research candidate pass 2026-09-25: candidates R6 (docs/research/keyer-and-key-interfaces.md section 4.4) and R-KN6 (docs/research/keyer-verification-and-key-input-network.md RISK-candidate list) entered as one family |
| Strategy | Mitigate |
| Plan approval | 2026-09-26, memo docs/reviews/SRR/decision-memo.md |

**Likelihood rationale.** Anchor level 3 (margin below 2x): a 5 ms raised cosine gives 226 to 292 Hz computed 26 dB bandwidth against the 350 Hz limit (docs/research/regulatory-corpus-and-operators.md F7), a margin of 1.2x to 1.5x, below the 2x of anchor 2; the PA is not selected and its linearity with the shaped drive is the open factor. 06 section 6 case (a): a design-analysis risk takes the anchor its facts meet.

**Consequence rationale.** Driving dimension performance_margin 4 by the regulatory rule of 06 section 7 (a 97.307 departure scores at least 4); schedule 3 for an envelope redesign.

**Mitigation steps**

| Step | Action | Artifact | Due | Status |
|---|---|---|---|---|
| S1 | LTspice transient of the PA with the shaped gate-bias drive for each PA device candidate of TS-001 sub-decision P, fed to the FFT script for the 26 dB bandwidth and the -60 dBc offset (regulatory-corpus ACTION-8). | docs/decisions/trade-studies/TS-NNN-alc-envelope.md (concept section 11.2 ALC and envelope study; number assigned at creation); hardware/sim/tx/ | PDR | Planned |
| S2 | Confirm the tinySA Ultra minimum RBW on receipt (ACTION-9) and propose method Test by CR if it resolves 350 Hz. | docs/cm/tool-validation/TV-NNN-tinysa.md | TRR | Planned |
| S3 | Capture the RF envelope on the bench and compute its spectrum with the same script; add an OnAir listening check by a second station. | docs/test_cases/sys/test_cases.json (REQ-SYS-015 case) | SAR | Planned |

**Triggers**

| Condition | Response |
|---|---|
| The simulated 26 dB bandwidth exceeds 300 Hz for any candidate | Claude lengthens the ramp within 3 to 8 ms or changes the envelope node in the ALC and envelope study (TS-NNN) before PDR closes |

**Fallback.** Lengthen the envelope ramp by configuration and cap the keyer speed for the affected range by CR.

**Related.** requirement: REQ-SYS-014, REQ-SYS-015; adr: ADR-003, ADR-022; stakeholder input: SI-004, SI-014; risk: RSK-011, RSK-027

**Closure criteria.** REQ-SYS-014 and REQ-SYS-015 closed by their baselined method with a Passed report before the on-air delta TRR.

**History**

| Date | Review | L | C | Safety | Score | Status | Note |
|---|---|---|---|---|---|---|---|
| 2026-09-25 | SRR | 2 | 4 | 1 | 8 | Proposed | Entered at the SRR research candidate pass (06 section 9, Identify) during SRR package assembly; awaiting the independent check of docs/reviews/SRR/checklists/risk-register.md. |
| 2026-09-25 | SRR | 3 | 4 | 1 | 12 | Proposed | Re-levelled 2 to 3 after INSP-007 (docs/reviews/SRR/checklists/risk-register-06.md) finding F-02: the recorded level disagreed with the 06 section 6 anchor the rationale itself describes; score 8 to 12. |
| 2026-09-25 | SRR | 3 | 4 | 1 | 12 | Proposed | INSP-007 (docs/reviews/SRR/checklists/risk-register-06.md) finding F-04: trade-study references corrected (TS-001 is receiver-and-pa-concept, TS-002 is firmware-runtime-make-buy; unwritten studies carry TS-NNN until created) and related.trade_study_ids set for the studies that name this risk. Score unchanged. |
| 2026-09-27 | SRR | 3 | 4 | 1 | 12 | Open | Track pass 2026-09-27 (docs/plan/pdr-work-plan.md WP-PDR-18 wave 0; 06 section 9 Track and Control; INSP-007 finding-18, docs/reviews/SRR/checklists/risk-register-06.md), recorded at review point SRR, the last gate passed (06 section 10.3); the PDR Track pass of 06 section 10 item 1 follows at PDR package assembly. Status Proposed to Open: INSP-007 (APPROVED; item CK-RSK-A2) records the Analyze check passing all 65 risks (06 section 9 transition table). Likelihood and consequence unchanged: no analysis, test, trigger poll or SRR ruling since the SRR Track pass changes this risk's evidence. |

### RSK-049

**Board design automation silently corrupts the fabrication data**

Given the fabrication and assembly package is generated headless by kicad-cli 10.0.6 through a wrapper not yet in tools/ (docs/research/pcbway-export-and-vendor-questions.md F1 to F12); a mistyped layer name or a footprint-attribute mismatch drops a file or a part with exit code 0 (R-PCB-08); pcbnew scripting disappears in KiCad 11 and the IPC API needs the GUI; kiutils 1.4.8 cannot write loadable KiCad 10 boards and drops tokens from schematics; kiutils, kicad-skip, sexpdata and rust-code-analysis have no recent releases; board scripts run on KiCad's Python 3.9 while analysis runs on 3.13; KiCad's published drc.v1.json is invalid JSON (docs/research/verification-tooling-inventory.md F6, F7, F9, F16), there is a possibility of a Gerber, drill, BOM or placement file sent to PCBWay missing a layer, a part or an attribute, or a schematic or board altered by a script, without any check failing adversely impacting the hardware release package (hardware/releases/) and the design data it is generated from, leading to boards fabricated or assembled from incomplete or wrong data and a second spin (USD 300 to 800, 6 to 12 weeks).

| Field | Value |
|---|---|
| Category | process (tags: cm) |
| Likelihood | 3 (Possible) |
| Consequence by dimension | Safety 1 / First power-on 4 / Cost 4 / Schedule 4 / Performance margin 1 |
| Consequence (max) | 4 (Major); driving: First power-on, Cost, Schedule |
| Score / band | 12 / Red |
| Assessment confidence | Medium |
| Status / trend | Open / Stable |
| Owner | Claude |
| Opened / horizon | 2026-09-25 / CDR |
| Last assessed | 2026-09-27 (SRR) |
| Source | SRR research candidate pass 2026-09-25: candidates VTI-6, VTI-7, VTI-9, VTI-10 and VTI-11 (docs/research/verification-tooling-inventory.md implications 6, 7, 9, 10 and 11) and R-PCB-08 (docs/research/pcbway-export-and-vendor-questions.md implication 9) entered as one family |
| Strategy | Mitigate |
| Plan approval | 2026-09-26, memo docs/reviews/SRR/decision-memo.md |

**Likelihood rationale.** The silent-loss modes are demonstrated on a fixture and the checks that catch them are not yet implemented. Anchor level 3.

**Consequence rationale.** Driving dimensions first_power_on, cost and schedule at 4: wrong fabrication data means a second fabrication and assembly run.

**Mitigation steps**

| Step | Action | Artifact | Due | Status |
|---|---|---|---|---|
| S1 | Known-answer accreditation suite for every board tool (kicad-cli and any writer library) run on each KiCad point release, with writer libraries read-only or re-validated by kicad-cli ERC and DRC. | tools/accredit/; docs/cm/tool-validation/TV-NNN-kicad.md | PDR | Planned |
| S2 | Pin KiCad 10.0.x, keep the patched drc schema in tools/schemas/ with a note, and exchange data between Python 3.9 and 3.13 as JSON files only. | tools/toolchain.lock.md; tools/schemas/ | PDR | Planned |
| S3 | tools/kicad_export/ wrapper with the verified recipe that fails on an invalid layer name and on any file count other than 11 Gerbers, 1 job file and 2 drill files, plus the BOM, CPL and silkscreen designator cross-check (A-PCB-07). | tools/kicad_export/ | CDR | Planned |
| S4 | Render every Gerber layer with kicad-cli pcb export svg and inspect it before upload (charter section 11 rule 3). | hardware/releases/HW-MB-revA-1/renders/ | CDR | Planned |

**Triggers**

| Condition | Response |
|---|---|
| The wrapper self-check or the designator cross-check fails | Claude stops the release package and fixes the cause before the owner uploads anything |

**Fallback.** Generate the package manually with the locked kicad-cli commands and have the owner compare the PCBWay viewer against the KiCad render before paying.

**Related.** requirement: REQ-SYS-137, REQ-SYS-139; adr: ADR-007; stakeholder input: SI-009, SI-031; risk: RSK-004, RSK-008

**Closure criteria.** Release package accepted by PCBWay with the wrapper and cross-check logs attached, and the delivered boards matching the design at receipt inspection.

**History**

| Date | Review | L | C | Safety | Score | Status | Note |
|---|---|---|---|---|---|---|---|
| 2026-09-25 | SRR | 3 | 4 | 1 | 12 | Proposed | Entered at the SRR research candidate pass (06 section 9, Identify) during SRR package assembly; awaiting the independent check of docs/reviews/SRR/checklists/risk-register.md. |
| 2026-09-27 | SRR | 3 | 4 | 1 | 12 | Open | Track pass 2026-09-27 (docs/plan/pdr-work-plan.md WP-PDR-18 wave 0; 06 section 9 Track and Control; INSP-007 finding-18, docs/reviews/SRR/checklists/risk-register-06.md), recorded at review point SRR, the last gate passed (06 section 10.3); the PDR Track pass of 06 section 10 item 1 follows at PDR package assembly. Status Proposed to Open: INSP-007 (APPROVED; item CK-RSK-A2) records the Analyze check passing all 65 risks (06 section 9 transition table). Likelihood and consequence unchanged: no analysis, test, trigger poll or SRR ruling since the SRR Track pass changes this risk's evidence. |

### RSK-058

**Receive power draw above its allocation erodes the battery-life margin**

Given TPM-002 allocates 0.5 W in receive, 10.0 W at 5 W key-down and 1.5 W in the hang time and claims about 18 h at 1:9 (docs/plan/tpm.json TPM-002), while the research budget gives 0.20 A from the pack in receive (about 1.4 W) for the expected build and 9.5 h at 1:9, 13.0 h for the low-current build and 6.4 h for the high-current build (docs/research/power-tree-and-charging.md F23); the SRR entry of TPM-002 is red; REQ-SYS-094 (KDR) requires 8 h at 1:9 (SI-034, ADR-020); ADR-020 section 4.4 rates the usable-capacity assumption (90 percent to 3.0 V per cell) Low confidence because the 30Q discharge curve was not digitised, there is a possibility of the delivered radio's receive and transmit power draw giving less than 8 h at 1:9 on fresh 3000 mAh cells adversely impacting PWR budget, the receiver and synthesizer part choices, and REQ-SYS-094, leading to a stakeholder input (SI-034) and a KDR missed, or a CR on the battery-life requirement.

| Field | Value |
|---|---|
| Category | technical |
| Likelihood | 3 (Possible) |
| Consequence by dimension | Safety 1 / First power-on 1 / Cost 2 / Schedule 3 / Performance margin 4 |
| Consequence (max) | 4 (Major); driving: Performance margin |
| Score / band | 12 / Red |
| Assessment confidence | Medium |
| Status / trend | Open / Stable |
| Owner | Claude |
| Opened / horizon | 2026-09-25 / SAR |
| Last assessed | 2026-09-27 (SRR) |
| Source | SRR TPM entry 2026-09-25: TPM-002 red on the concept-level estimate (conventions.reporting_interval of docs/plan/tpm.json: a red TPM opens a risk); docs/research/power-tree-and-charging.md F23; SRR ADR candidate pass 2026-09-25 merged ADR020-R1 |
| Strategy | Mitigate |
| Plan approval | 2026-09-26, memo docs/reviews/SRR/decision-memo.md |

**Likelihood rationale.** One derived budget exists; the expected build has 19 % margin and the high-current build fails. Anchor level 3.

**Consequence rationale.** Driving dimension performance_margin 4: a KDR and a stakeholder input not met; schedule 3 for a part change after PDR.

**Mitigation steps**

| Step | Action | Artifact | Due | Status |
|---|---|---|---|---|
| S1 | Re-allocate TPM-002 per mode from a bottom-up budget in docs/design/budgets.md (receive allocation about 1.5 W), with TS-001 and the synthesizer study (TS-NNN, ADR-013) scoring receive current. | docs/plan/tpm.json TPM-002; docs/design/budgets.md | PDR | Planned |
| S2 | Choose the low-current front end and synthesizer where they meet the RX requirements, and keep the display without backlight (D-UI-02). | docs/decisions/trade-studies/TS-001-receiver-and-pa-concept.md (sub-decision R2, receive front end); docs/decisions/trade-studies/TS-NNN-synthesizer.md (ADR-013 study; number assigned at creation) | PDR | Planned |
| S3 | Bench: timed run on the TPM-008 cycle into the dummy load. | docs/test_cases/sys/test_cases.json (REQ-SYS-094 case) | SAR | Planned |
| S4 | Digitise the 30Q discharge curve and replace the 90 percent to 3.0 V usable-capacity assumption in the battery-life budget (ADR-020). | docs/design/budgets.md | PDR | Planned |

**Triggers**

| Condition | Response |
|---|---|
| The PDR budget gives less than 9.6 h at 1:9 | Claude proposes lower-current parts or a duty change to the owner before PDR closes |

**Fallback.** Select lower-current RX parts or reduce the 5 W transmit duty in the requirement by CR with the owner's approval.

**Related.** requirement: REQ-SYS-094, REQ-SYS-095; adr: ADR-020; trade study: TS-001; tpm: TPM-002, TPM-008; stakeholder input: SI-023, SI-034; risk: RSK-035, RSK-037

**Closure criteria.** REQ-SYS-094 verified on the delivered unit.

**History**

| Date | Review | L | C | Safety | Score | Status | Note |
|---|---|---|---|---|---|---|---|
| 2026-09-25 | SRR | 3 | 4 | 1 | 12 | Proposed | Entered at the SRR research candidate pass (06 section 9, Identify) during SRR package assembly; awaiting the independent check of docs/reviews/SRR/checklists/risk-register.md. |
| 2026-09-25 | SRR | 3 | 4 | 1 | 12 | Proposed | ADR-020 section 4.4 candidate 'usable capacity assumption (90 percent to 3.0 V per cell) is Low confidence; the 30Q discharge curve was not digitised' merged: the capacity side of the same battery-life departure; step S4 added (digitise the curve at PDR). Score unchanged. |
| 2026-09-25 | SRR | 3 | 4 | 1 | 12 | Proposed | INSP-007 (docs/reviews/SRR/checklists/risk-register-06.md) finding F-04: trade-study references corrected (TS-001 is receiver-and-pa-concept, TS-002 is firmware-runtime-make-buy; unwritten studies carry TS-NNN until created) and related.trade_study_ids set for the studies that name this risk. Score unchanged. |
| 2026-09-27 | SRR | 3 | 4 | 1 | 12 | Open | Track pass 2026-09-27 (docs/plan/pdr-work-plan.md WP-PDR-18 wave 0; 06 section 9 Track and Control; INSP-007 finding-18, docs/reviews/SRR/checklists/risk-register-06.md), recorded at review point SRR, the last gate passed (06 section 10.3); the PDR Track pass of 06 section 10 item 1 follows at PDR package assembly. Status Proposed to Open: INSP-007 (APPROVED; item CK-RSK-A2) records the Analyze check passing all 65 risks (06 section 9 transition table). Likelihood and consequence unchanged: no analysis, test, trigger poll or SRR ruling since the SRR Track pass changes this risk's evidence. |

### RSK-010

**Manual MC/DC evidence misses a latent decision fault in safety-critical firmware**

Given rustc has no MC/DC coverage instrumentation at this date (its unstable support was removed in late 2025 and the 2026 project goal to restore it has produced nothing usable; 07 section 8.1), so SWE-219 is dispositioned T in the RMM with the baseline record being independently reviewed independence-pair tables plus stable-toolchain region coverage, with branch and condition coverage on the date-pinned nightly (MSR-14) as a required non-credit third element (charter section 10, 07 section 9.6), approved by the owner at SRR, there is a possibility of an incomplete or incorrect independence-pair table passing independent review, so that a safety-critical decision (PA-enable prerequisites, charging supervision, thermal response, key-down time-out) reaches a release with a condition never shown to independently affect the outcome adversely impacting SW verification evidence for the safety-critical components of 03 section 4.3 and 07 section 14.1 (keyer, transmit sequencer and PA enable, safety manager and safe state with the boot path and configuration guard, power and charging supervision, thermal protection, audio output limiting, scheduler and runtime), leading to a latent fault in a safety-critical decision that instrumented MC/DC would have exposed, found only on the bench or in operation.

| Field | Value |
|---|---|
| Category | software |
| Likelihood | 3 (Possible) |
| Consequence by dimension | Safety 3 / First power-on 2 / Cost 1 / Schedule 2 / Performance margin 2 |
| Consequence (max) | 3 (Moderate); driving: Safety |
| Score / band | 9 / Yellow |
| Assessment confidence | Medium |
| Status / trend | Open / Stable |
| Owner | Claude |
| Opened / horizon | 2026-09-25 / TRR |
| Last assessed | 2026-09-27 (SRR) |
| Source | Formulation risk identification 2026-09-25 against SI-007, SI-015; re-framed the same day around the SWE-219 tailoring of 07 section 9.6 (RMM row SWE-219 names this risk as the residual); SRR research candidate pass 2026-09-25 merged VTI-5; plan candidate SEP21-MCDC (SRR plan-table pass 2026-09-25) |
| Strategy | Mitigate |

**Likelihood rationale.** The tables are derived by hand from decision lists kept to one decision per prerequisite (07 section 14) with cyclomatic complexity 15 or below (SWE-220) and are reviewed independently, but no tool cross-checks them. Anchor level 3: analysis exists, fidelity unconfirmed by tool.

**Consequence rationale.** Driving dimension safety 3: a latent fault in PA enable or charging can destroy the unit; hardware interlocks are preferred so that no single software event initiates a hazard (SEMP section 7.1), which keeps it below 4. first_power_on 2 and schedule 2: the fix is a firmware reflash plus a table re-review within 1 to 3 weeks.

**Mitigation steps**

| Step | Action | Artifact | Due | Status |
|---|---|---|---|---|
| S1 | Coverage-tool known-answer test for the cargo-llvm-cov accreditation (07 section 8.3): on the pinned stable toolchain confirm that cargo llvm-cov region coverage reports 100 percent on a fully exercised reference crate and reports a seeded uncovered region; record the test in the TV record with its fixtures, before any coverage figure is cited. | docs/cm/tool-validation/TV-NNN-cargo-llvm-cov.md; tools/tests/fixtures/cargo-llvm-cov/ | PDR | Planned |
| S2 | Coding standard rules for safety-critical components: one decision per prerequisite in a single check function, cyclomatic complexity 15 or below, no floating point, constructs limited to those the coverage proof exercised (CS-16, CS-17, CS-20 of 07 section 7). | docs/process/07-software-engineering-plan.md section 7 (coding standard) | PDR | Planned |
| S3 | Every MC/DC table (decision, conditions, test ids per independence pair, result) is signed by an independent reviewer (INSP-NNN) and MSR-15 (decisions with complete independence pairs divided by decisions) is reported at CDR, TRR and SAR. | docs/vv/reports/TC-SW-COV-001-r<N>.md with the tables in docs/vv/reports/TC-SW-COV-001-r<N>/; docs/plan/measurements.json (MSR-15) | TRR | Planned |
| S4 | Run nightly branch and condition coverage (MSR-14) on the independence-pair tests as supporting evidence and compare every condition it reports as never toggled against the tables. | docs/vv/reports/TC-SW-COV-001-r<N>.md (supporting evidence section) | TRR | Planned |
| S5 | At every toolchain update re-run the S1 known-answer test and re-check the rustc release notes for MC/DC support; when instrumentation returns on nightly, open a CR to evaluate adopting it (07 section 9.6 item 5). | firmware/rust-toolchain.toml; tools/toolchain.lock.md; CR-NNN when applicable | SAR | Planned |

**Triggers**

| Condition | Response |
|---|---|
| MSR-15 below 100 percent at CDR or TRR without a disposition per decision | The item is a CDR or TRR lien; Claude completes the tables before the release is tagged |
| Nightly condition coverage reports a condition never toggled that a signed table claims covered | Claude opens an NCR against the table, the reviewer re-inspects every table of that component, and this risk is re-assessed the same session |
| rustc MC/DC instrumentation returns on nightly | Claude opens a CR to accredit and adopt it; the manual tables remain the record until the tool is accredited |

**Fallback.** Owner waiver of MSR-15 for the named decisions in the TRR decision memo, with a Bench test of each affected safety function added to the TRR procedure.

**Related.** adr: ADR-001, ADR-011; trade study: TS-002; stakeholder input: SI-007, SI-015; risk: RSK-012

**Closure criteria.** MSR-15 at 100 percent for every safety-critical component in the TRR coverage report with every table signed by an independent reviewer, and no NCR attributable to an untested condition through SAR.

**History**

| Date | Review | L | C | Safety | Score | Status | Note |
|---|---|---|---|---|---|---|---|
| 2026-09-25 | Pre-SRR | 4 | 3 | n/r | 12 | Proposed | Opened as 'MC/DC coverage cannot be measured reliably for Rust'; awaiting independent check. |
| 2026-09-25 | Pre-SRR | 3 | 3 | 3 | 9 | Proposed | Re-framed: the tooling gap is now a fact absorbed by the SWE-219 tailoring (07 section 9.6); the residual is a table escape. Likelihood 4 to 3. |
| 2026-09-25 | SRR | 3 | 3 | 3 | 9 | Proposed | SRR Track pass at package assembly 2026-09-25 (06 section 10 item 1): re-assessed against the SRR research candidate pass; likelihood and consequence unchanged; status stays Proposed until the independent check of docs/reviews/SRR/checklists/risk-register.md. Merged candidates VTI-5 (06 section 9 disposition rule; family rule of section 4 applied: same asset, driving dimension, plan and kind); worst member does not raise the score. Condition and asset updated per 03 section 6.5 item X11 (MSR-14 and the full component set). |
| 2026-09-25 | SRR | 3 | 3 | 3 | 9 | Proposed | Re-plan of S1 (SRR readiness item H9, risk manager): S1 was due SRR and Planned, and no cargo-llvm-cov TV record or known-answer fixture exists (docs/cm/ absent at this pass). Its content is the cargo-llvm-cov known-answer test, which 07 section 8.3 (coverage tools accredited by PDR) and the tools/toolchain.lock.md cargo-llvm-cov row (TV pending, due PDR, before FW-B0 coverage is cited) schedule for PDR; 05 section 13, the single authoritative TV schedule, places the cargo-llvm-cov TV record (with llvm-tools) in its PDR row and not among the SRR records; no SRR product cites a coverage figure. S1 is therefore re-planned to PDR with the TV record and its fixtures as artifacts. The SRR toolchain proof itself (TC-SW-TOOL-001-r1, FW-B0; 01 section 4.3 row 20) stays an SRR entrance product carried by review package item H12, not by this risk; if that proof or an earlier TV record carries the S1 known-answer result, S1 is set Done on it before PDR. Score unchanged: the coverage tool evidence is needed before the first MC/DC table (S3, TRR), and PDR precedes it. |
| 2026-09-25 | SRR | 3 | 3 | 3 | 9 | Proposed | INSP-007 (docs/reviews/SRR/checklists/risk-register-06.md) finding F-04: trade-study references corrected (TS-001 is receiver-and-pa-concept, TS-002 is firmware-runtime-make-buy; unwritten studies carry TS-NNN until created) and related.trade_study_ids set for the studies that name this risk. Score unchanged. |
| 2026-09-27 | SRR | 3 | 3 | 3 | 9 | Open | Track pass 2026-09-27 (docs/plan/pdr-work-plan.md WP-PDR-18 wave 0; 06 section 9 Track and Control; INSP-007 finding-18, docs/reviews/SRR/checklists/risk-register-06.md), recorded at review point SRR, the last gate passed (06 section 10.3); the PDR Track pass of 06 section 10 item 1 follows at PDR package assembly. Status Proposed to Open: INSP-007 (APPROVED; item CK-RSK-A2) records the Analyze check passing all 65 risks (06 section 9 transition table). Likelihood and consequence unchanged: no analysis, test, trigger poll or SRR ruling since the SRR Track pass changes this risk's evidence. |

### RSK-018

**Machined enclosure arrives with sharp edges or pinch points**

Given the enclosure is CNC-machined 6061 aluminum ordered from PCBWay from an OpenSCAD model exported to STEP (SI-008, SI-032, ADR-008); machined edges and cutouts are sharp unless an edge break is modeled (HZ-013); the owner can fit-check with H2C prints (SI-012) but cannot re-machine anodized aluminum, there is a possibility of the delivered enclosure having sharp edges, burrs or pinch points at the cutouts, the knobs or the battery cover adversely impacting the persons handling the radio (HZ-013) and the ME enclosure, leading to cuts or pinches during handling or battery replacement, and hand deburring or a second CNC order (USD 100 to 300, 3 to 6 weeks).

| Field | Value |
|---|---|
| Category | safety (tags: hsi) |
| Likelihood | 3 (Possible) |
| Consequence by dimension | Safety 3 / First power-on 1 / Cost 3 / Schedule 3 / Performance margin 1 |
| Consequence (max) | 3 (Moderate); driving: Safety, Cost, Schedule |
| Score / band | 9 / Yellow |
| Assessment confidence | Medium |
| Status / trend | Open / Stable |
| Owner | Claude |
| Opened / horizon | 2026-09-25 / TRR |
| Last assessed | 2026-09-27 (SRR) |
| Source | Hazard link rule (process section 1) for HZ-013 of docs/safety/hazards.json; opened 2026-09-25 with HZ-009, which moved to RSK-025 on 2026-09-25 |
| Strategy | Mitigate |

**Likelihood rationale.** PCBWay machines to the model, so the departure follows directly from any omission in the model; the planned fit-check print (SI-012) catches geometry but not burrs on the machined part. Anchor level 3.

**Consequence rationale.** Driving dimensions safety, cost and schedule at 3: HZ-013 is Marginal (first-aid cut, register safety 3); a second CNC part costs USD 100 to 300 and 3 to 6 weeks. first_power_on 1: an edge does not affect the board. The antenna-port retention departure is RSK-025.

**Mitigation steps**

| Step | Action | Artifact | Due | Status |
|---|---|---|---|---|
| S1 | Model rules: every external and cutout edge broken by a chamfer or fillet of at least 0.5 mm, knob-to-bezel radial clearance of at least 1.0 mm, battery cover without a lever pinch (HZ-013 K1 to K3); the render is inspected before the order (charter section 11 rule 3). | hardware/enclosure/*.scad; renders in docs/reviews/CDR/figures/ | CDR | Planned |
| S3 | H2C fit-check prints of the lid, knobs and battery cover handled by the owner before the CNC order (HZ-013 K4), with photographs in the CDR package. | docs/reviews/CDR/figures/ (fit-check photographs) | CDR | Planned |
| S4 | Derive the ME requirements from the HZ-013 controls (edge break of at least 0.5 mm, knob-to-bezel clearance of at least 1.0 mm, cover without a lever pinch). | docs/requirements/me/requirements.json | PDR | Planned |
| S5 | Receipt inspection of the CNC part for edges and burrs: finger-drag and cotton-swab snag test at every edge and cutout, dimensions against the drawing (HZ-013 K4). | docs/vv/reports/receipt-inspection-<n>.md; docs/test_cases/me/test_cases.json | TRR | Planned |

**Triggers**

| Condition | Response |
|---|---|
| The owner flags an edge or pinch point on a fit-check print | Claude changes the model before the CNC order; an open item is a CDR lien |
| A PCBWay CNC DFM comment changes a chamfer or an edge break | Claude opens a CR if the product baseline changes (05 section 5) and re-runs S1 |
| Receipt inspection finds a sharp edge or a burr | Claude opens an NCR; the owner decides between hand deburr accepted as cosmetic and a second CNC order |

**Fallback.** Hand deburr by the owner accepted as a cosmetic nonconformance; CR to the ME requirements if the edge break cannot be machined.

**Related.** hazard: HZ-013; adr: ADR-008; stakeholder input: SI-008, SI-012, SI-031, SI-032; risk: RSK-025

**Closure criteria.** Receipt inspection of the CNC enclosure passed for edges, burrs and pinch points, and the ME requirements derived from HZ-013 verified at SAR.

**History**

| Date | Review | L | C | Safety | Score | Status | Note |
|---|---|---|---|---|---|---|---|
| 2026-09-25 | Pre-SRR | 3 | 3 | 3 | 9 | Proposed | Opened under the hazard link rule for HZ-009 and HZ-013; awaiting independent check. |
| 2026-09-25 | Pre-SRR | 3 | 3 | 3 | 9 | Proposed | Independent review 2026-09-25: split under process section 4 (sharp edges and antenna-port retention harm different assets and have different driving dimensions); HZ-009 and steps S2 (load analysis) moved to RSK-025. Category technical to safety (the asset is the persons handling the radio, process section 5); first_power_on 3 to 1, performance_margin 2 to 1. Max consequence and score unchanged. |
| 2026-09-25 | SRR | 3 | 3 | 3 | 9 | Proposed | SRR Track pass at package assembly 2026-09-25 (06 section 10 item 1): re-assessed against the SRR research candidate pass; likelihood and consequence unchanged; status stays Proposed until the independent check of docs/reviews/SRR/checklists/risk-register.md. |
| 2026-09-27 | SRR | 3 | 3 | 3 | 9 | Open | Track pass 2026-09-27 (docs/plan/pdr-work-plan.md WP-PDR-18 wave 0; 06 section 9 Track and Control; INSP-007 finding-18, docs/reviews/SRR/checklists/risk-register-06.md), recorded at review point SRR, the last gate passed (06 section 10.3); the PDR Track pass of 06 section 10 item 1 follows at PDR package assembly. Status Proposed to Open: INSP-007 (APPROVED; item CK-RSK-A2) records the Analyze check passing all 65 risks (06 section 9 transition table). Likelihood and consequence unchanged: no analysis, test, trigger poll or SRR ruling since the SRR Track pass changes this risk's evidence. CR-003 revision 3 (Submitted, d9a215a; section 4 Risk row) proposes changes to this risk; a submitted CR changes no baseline (06 section 10.2 trigger noted), so the changes are applied with a Refs trailer naming the CR after the owner's disposition (WP-PDR-02 and the WP-PDR-18 final pass). This pass keeps the current values. |

### RSK-033

**Pico 2 USB power path overheats at the charging current**

Given the pack charges through the Pico 2 module's micro-USB connector (SI-022, ADR-004), whose connector, D1 bypass and VBUS copper have no published current rating; HZ-011 K4 limits the input current to 500 mA by default, never above 1.5 A, and above 500 mA only after DCP or CDP identification or an explicit setting; charging above 500 mA through the module is unqualified (docs/research/power-tree-and-charging.md R-PWR-01), there is a possibility of the Pico 2 micro-USB connector, D1 bypass or VBUS copper overheating or failing at the configured charging current adversely impacting the PWR charging path, the Pico 2 module and the operator handling the radio while it charges (HZ-011), leading to a hot connector or module (minor burn), a damaged Pico 2 module that the owner must replace by hand, and a charging-current CR.

| Field | Value |
|---|---|
| Category | safety (tags: software) |
| Likelihood | 3 (Possible) |
| Consequence by dimension | Safety 3 / First power-on 2 / Cost 2 / Schedule 2 / Performance margin 3 |
| Consequence (max) | 3 (Moderate); driving: Safety, Performance margin |
| Score / band | 9 / Yellow |
| Assessment confidence | Medium |
| Status / trend | Open / Stable |
| Owner | Claude |
| Opened / horizon | 2026-09-25 / Ops |
| Last assessed | 2026-09-27 (SRR) |
| Source | ConOps section 8 candidate R-PWR-01 (docs/research/power-tree-and-charging.md); hazard analysis section 12 HZ-011 row; entered 2026-09-25; SRR ADR candidate pass 2026-09-25 merged ADR004-R1 |
| Strategy | Mitigate |

**Likelihood rationale.** No rating exists for the module path and the measurement is not done; the 500 mA default is conservative, but any higher budget is unqualified. Anchor level 3.

**Consequence rationale.** Driving dimensions safety and performance_margin at 3: a hot connector can cause a first-aid burn (HZ-011 Marginal, register safety 3), and a permanent 500 mA cap may miss the charging-time requirement. first_power_on 2: the Pico 2 is a hand-soldered module the owner can replace.

**Mitigation steps**

| Step | Action | Artifact | Due | Status |
|---|---|---|---|---|
| S1 | Derive the input-current limit requirements (500 mA default, 1.5 A ceiling, above 500 mA only after port identification; HZ-011 K4) and the firmware charging-current setting. | docs/requirements/pwr/requirements.json; docs/requirements/sw/sw-pwr/requirements.json | PDR | Planned |
| S2 | Measurement before any budget above 500 mA (REQ candidate PWR-USB-02): connector and module temperature with the multimeter thermocouple at 500 mA, 1 A and 1.5 A for 2 h on a dev-board Pico 2 (Bench, credit: false). | docs/vv/reports/<TC-ID>-r<N>.md with article pico2-devboard-1 and credit: false | CDR | Planned |
| S3 | Handbook: charging supply rated for 500 mA or more, charging state on the LCD, charge with the radio off or receiving (HZ-011 K5). | docs/ops/operations-handbook.md | SAR | Planned |

**Triggers**

| Condition | Response |
|---|---|
| The S2 measurement shows a connector or module temperature rise above 20 C at the intended current | Claude caps the charge current at the highest current that passes and opens a CR if the charging-time requirement changes |
| The S2 measurement fails at 500 mA | Claude proposes the second USB connector (rejected by SI-022 unless this test fails) to the owner before CDR |

**Fallback.** Cap charging at 500 mA permanently with a CR to the charging-time requirement, or add a dedicated charging connector by CR as SI-022 allows when the test fails.

**Related.** hazard: HZ-011; adr: ADR-004, ADR-005; stakeholder input: SI-022, SI-023; risk: RSK-007

**Closure criteria.** Input-current requirements verified on the delivered unit and the S2 measurement recorded, with the handbook charging section published.

**History**

| Date | Review | L | C | Safety | Score | Status | Note |
|---|---|---|---|---|---|---|---|
| 2026-09-25 | Pre-SRR | 3 | 3 | 3 | 9 | Proposed | Entered from ConOps section 8 candidate R-PWR-01 after independent review; carries HZ-011 under the hazard link rule; awaiting independent check. |
| 2026-09-25 | SRR | 3 | 3 | 3 | 9 | Proposed | SRR Track pass at package assembly 2026-09-25 (06 section 10 item 1): re-assessed against the SRR research candidate pass; likelihood and consequence unchanged; status stays Proposed until the independent check of docs/reviews/SRR/checklists/risk-register.md. |
| 2026-09-25 | SRR | 3 | 3 | 3 | 9 | Proposed | ADR-004 section 4.4 candidate 'Pico 2 module VBUS path unrated above 500 mA' merged: the same departure as the entered R-PWR-01. Score unchanged. |
| 2026-09-27 | SRR | 3 | 3 | 3 | 9 | Open | Track pass 2026-09-27 (docs/plan/pdr-work-plan.md WP-PDR-18 wave 0; 06 section 9 Track and Control; INSP-007 finding-18, docs/reviews/SRR/checklists/risk-register-06.md), recorded at review point SRR, the last gate passed (06 section 10.3); the PDR Track pass of 06 section 10 item 1 follows at PDR package assembly. Status Proposed to Open: INSP-007 (APPROVED; item CK-RSK-A2) records the Analyze check passing all 65 risks (06 section 9 transition table). Likelihood and consequence unchanged: no analysis, test, trigger poll or SRR ruling since the SRR Track pass changes this risk's evidence. |

### RSK-013

**rustos driver work packages not demonstrated on hardware before CDR**

Given thirteen rustos driver work packages (WP-SW-01 to WP-SW-13, WP-SW-13 optional, 07 section 19) are required, nine of them with host mocks and dev-board checks by PDR (07 section 3 FW-B1), the drivers are developed upstream in rustos by its single maintainer (SI-033, ADR-019), and the gates run on the expedited weekend schedule of SI-020, there is a possibility of a driver that the keyer prototype, the transmit sequencing or the charging supervision depends on not being demonstrated on the Pico 2 development board by CDR adversely impacting the SW subsystem, the FW-B1 milestone and the PDR and CDR entrance products, leading to PDR liens carried into CDR, procurement released with an unproven firmware-to-hardware interface, or a CDR slip of one vendor iteration.

| Field | Value |
|---|---|
| Category | software |
| Likelihood | 3 (Possible) |
| Consequence by dimension | Safety 2 / First power-on 3 / Cost 1 / Schedule 3 / Performance margin 2 |
| Consequence (max) | 3 (Moderate); driving: First power-on, Schedule |
| Score / band | 9 / Yellow |
| Assessment confidence | Medium |
| Status / trend | Mitigating / Stable |
| Owner | Claude |
| Opened / horizon | 2026-09-25 / CDR |
| Last assessed | 2026-09-27 (SRR) |
| Source | 07 section 21 row 'rustos driver effort'; SEMP section 5.17 (any driver not demonstrated on hardware by CDR opens a risk with a fallback); opened 2026-09-25; SRR research candidate pass 2026-09-25 merged CWSEL-10, RUST-R1, RUST-R4; plan candidate SEP21-DRV (SRR plan-table pass 2026-09-25) |
| Strategy | Mitigate |

**Likelihood rationale.** The work volume is large for the schedule, but the ordering by need and the minimal keyer-prototype set (WP-SW-01, 02, 03, 09) are mitigations already in the plan, and rustos is built for the Pico 2 (boot and GPIO), with the on-board run pending TC-SW-TOOL-001 steps 11 and 12 (no on-board run is recorded in the repository: docs/research/rustos-toolchain-proof.md F1 to F5, TC-SW-TOOL-001-r1). Anchor level 3.

**Consequence rationale.** Driving dimensions first_power_on and schedule at 3: an undemonstrated driver means one subsystem may not work at power-on until a firmware fix, and a CDR slip to close the demonstration costs one vendor iteration (3 to 6 weeks). Safety 2: the safe-state manager and hardware interlocks bound a driver fault in PA enable.

**Mitigation steps**

| Step | Action | Artifact | Due | Status |
|---|---|---|---|---|
| S1 | Driver gap list as an SRR entrance product: every peripheral cwht needs, the rustos driver state (none, host mock, dev-board checked, emulator accredited) and the work package that closes it. | docs/plan/technology-assessment.md (rustos row); docs/process/07-software-engineering-plan.md section 19 | SRR | Done (docs/process/07-software-engineering-plan.md section 19 (commit 4e3f891): introduction gives the present rustos state (boot, vector table, reset handler, linker script, board definition, GPIO driver) and the table gives WP-SW-01 to WP-SW-13 with RP2350 block, api trait, cwht use, register ICD availability and milestone; docs/plan/technology-assessment.md section 3.18 Gaps (no clock, interrupt, timer, PWM, ADC, I2C, SPI, watchdog or flash driver exists)) |
| S2 | Order the work packages by need: the keyer prototype uses only WP-SW-01, 02, 03 and 09; PA-enable sequencing and charging supervision drivers follow; each sprint record names the WP it closes. | docs/sprints/SW-NN-<module>.md | PDR | Planned |
| S3 | Dev-board check per work package with a firmware/devcheck binary, recorded as Bench with credit: false (charter section 3), and the driver's register accesses traced to the RP2350 datasheet section (charter section 9, Inspection). | docs/vv/reports/<TC-ID>-r<N>.md with article pico2-devboard-1 and credit: false; rustos/docs/icd/rp2350/ | CDR | Planned |
| S4 | Decide at PDR whether pico2 drivers adopt an injectable register-access trait for host tests, and prototype the PIO I2S receive program on a Pico 2 with a PCM1808 breakout if candidate B stays in TS-001 (RUST-R4, CWSEL-10). | docs/decisions/adr/ADR-NNN-register-access.md; firmware/devcheck/ | PDR | Planned |

**Triggers**

| Condition | Response |
|---|---|
| Any work package of the FW-B1 set (WP-SW-01 to 07, 09, 11) has no dev-board check at PDR entrance | Recorded as a PDR lien with closure at CDR (SI-020 permits PDR liens that CDR closes); Claude reports it in the PDR package |
| Any driver a safety-critical component depends on has no dev-board check at CDR entrance | Claude invokes the fallback and presents it for the owner's CDR disposition |

**Fallback.** CDR is held and procurement released, because the board design does not depend on driver status; the missing demonstration is a CDR lien closed before TRR, and the affected requirements are verified at Bench with the driver checked on the delivered unit first.

**Related.** adr: ADR-004, ADR-011, ADR-019; trade study: TS-001, TS-002; stakeholder input: SI-007, SI-020, SI-026, SI-033; risk: RSK-003, RSK-008, RSK-012, RSK-023

**Closure criteria.** Every work package of 07 section 19 dev-board checked with its report filed and every driver register access traced to the datasheet before TRR.

**History**

| Date | Review | L | C | Safety | Score | Status | Note |
|---|---|---|---|---|---|---|---|
| 2026-09-25 | Pre-SRR | 3 | 3 | 2 | 9 | Proposed | Opened from 07 section 21 (software risks to be entered at SRR); awaiting independent check. |
| 2026-09-25 | Pre-SRR | 3 | 3 | 2 | 9 | Proposed | Independent review 2026-09-25: the 07 section 21 row 'Single maintainer of rustos' is a different departure (an upstream change breaking cwht) and moved to RSK-023 with step S4 and the contract-test trigger (process section 4). Score unchanged. |
| 2026-09-25 | SRR | 3 | 3 | 2 | 9 | Proposed | SRR Track pass at package assembly 2026-09-25 (06 section 10 item 1): re-assessed against the SRR research candidate pass; likelihood and consequence unchanged; status stays Proposed until the independent check of docs/reviews/SRR/checklists/risk-register.md. Merged candidates CWSEL-10, RUST-R1, RUST-R4 (06 section 9 disposition rule; family rule of section 4 applied: same asset, driving dimension, plan and kind); worst member does not raise the score. Step added for the merged candidates. |
| 2026-09-25 | SRR | 3 | 3 | 2 | 9 | Proposed | S1 closed (SRR readiness item H9, risk manager): the driver gap list exists as 07 section 19 (commit 4e3f891), whose introduction states what rustos provides today and whose table names every peripheral cwht needs with the closing work package WP-SW-01 to WP-SW-13, the RP2350 block, the api trait, the register ICD availability and the milestone; technology assessment section 3.18 states the driver state (no clock, interrupt, timer, PWM, ADC, I2C, SPI, watchdog or flash driver exists), so the state of every row is none apart from the GPIO input path WP-SW-02 extends and the vector table WP-SW-09 extends; no host mock or emulator accreditation exists yet. Observation for the technology assessment author: section 3.18 numbers its packages WP-01 to WP-13 after the research report, which differs from the WP-SW-NN ids of 07 section 19 and charter section 6 (its WP-01 clocks is WP-SW-11, its WP-13 hygiene has no 07 row); an alignment fix, not a change to the gap content. Score unchanged. |
| 2026-09-25 | SRR | 3 | 3 | 2 | 9 | Proposed | Condition restated after INSP-007 (docs/reviews/SRR/checklists/risk-register-06.md) finding F-06: 07 section 19 lists WP-SW-01 to WP-SW-13 (WP-SW-13 optional); nine by PDR (07 section 3.1 PDR row). Score unchanged. |
| 2026-09-25 | SRR | 3 | 3 | 2 | 9 | Proposed | INSP-007 (docs/reviews/SRR/checklists/risk-register-06.md) finding F-04: trade-study references corrected (TS-001 is receiver-and-pa-concept, TS-002 is firmware-runtime-make-buy; unwritten studies carry TS-NNN until created) and related.trade_study_ids set for the studies that name this risk. Score unchanged. |
| 2026-09-27 | SRR | 3 | 3 | 2 | 9 | Mitigating | Track pass 2026-09-27 (docs/plan/pdr-work-plan.md WP-PDR-18 wave 0; 06 section 9 Track and Control; INSP-007 finding-18, docs/reviews/SRR/checklists/risk-register-06.md), recorded at review point SRR, the last gate passed (06 section 10.3); the PDR Track pass of 06 section 10 item 1 follows at PDR package assembly. Status Proposed to Open: INSP-007 (APPROVED; item CK-RSK-A2) records the Analyze check passing all 65 risks (06 section 9 transition table). Then Open to Mitigating: step S1 Done (06 section 9 transition). Likelihood and consequence unchanged: no analysis, test, trigger poll or SRR ruling since the SRR Track pass changes this risk's evidence. |

### RSK-056

**RP2350 ADC accuracy too low for battery sensing and the dual-path check**

Given pack and mid-tap voltages are read by the RP2350 ADC through dividers from the Pico 2 filtered 3V3 reference, about 2 percent accuracy without calibration (docs/research/rustos-toolchain-proof.md F9, Implications); REQ-SYS-088 stops charging when two independent cell-voltage measurements differ by more than 100 mV (TBR) (docs/research/power-tree-and-charging.md F14, F15); the low-battery thresholds REQ-SYS-096 to REQ-SYS-098 also rest on this path, there is a possibility of the RP2350 voltage reading error being large enough that the dual-path check trips falsely or cannot be set tight enough, or the low-battery thresholds acting at the wrong pack voltage adversely impacting SW-PWR sensing and the battery supervision functions (PWR), leading to nuisance charge or transmit inhibits, a weaker dual-path safety layer, or early or late low-battery cutoffs, and REQ-SYS-088 changed by CR.

| Field | Value |
|---|---|
| Category | technical (tags: software) |
| Likelihood | 3 (Possible) |
| Consequence by dimension | Safety 2 / First power-on 2 / Cost 1 / Schedule 2 / Performance margin 3 |
| Consequence (max) | 3 (Moderate); driving: Performance margin |
| Score / band | 9 / Yellow |
| Assessment confidence | Medium |
| Status / trend | Open / Stable |
| Owner | Claude |
| Opened / horizon | 2026-09-25 / SAR |
| Last assessed | 2026-09-27 (SRR) |
| Source | SRR research candidate pass 2026-09-25: candidate RUST-R3 (docs/research/rustos-toolchain-proof.md Implications, RISK-candidate 3) entered |
| Strategy | Mitigate |

**Likelihood rationale.** The 2 percent figure is a derived estimate and no calibration analysis exists. Anchor level 3.

**Consequence rationale.** Driving dimension performance_margin 3: REQ-SYS-088 may need a CR; safety 2 because the independent protector (REQ-SYS-083, REQ-SYS-084) remains.

**Mitigation steps**

| Step | Action | Artifact | Due | Status |
|---|---|---|---|---|
| S1 | Calibration analysis of divider tolerance, reference noise and ENOB, with calibration of the RP2350 path against the charger ADC whenever USB is present (PWR-SENSE-02), to set the dual-path threshold. | docs/design/analysis/cell-sensing-accuracy.md | PDR | Planned |
| S2 | SW-PWR requirements for the calibration and the comparison rule, HostUnit tested with injected sensor errors. | docs/requirements/sw/sw-pwr/requirements.json | PDR | Planned |
| S3 | Bench: dual-path readings against the multimeter at 3.0, 3.7 and 4.2 V per cell from the bench supply. | docs/test_cases/sys/test_cases.json (REQ-SYS-088 case) | TRR | Planned |

**Triggers**

| Condition | Response |
|---|---|
| The calibration analysis gives a worst-case disagreement above 60 mV | Claude proposes a wider threshold or an external reference by CR before CDR |

**Fallback.** Add an external ADC reference, or rely on the charger ADC with the RP2350 path as a plausibility check only, by CR.

**Related.** requirement: REQ-SYS-088, REQ-SYS-096, REQ-SYS-097, REQ-SYS-098; adr: ADR-004, ADR-005; stakeholder input: SI-007, SI-023; risk: RSK-007

**Closure criteria.** REQ-SYS-088 and REQ-SYS-096 to REQ-SYS-098 verified on the delivered unit.

**History**

| Date | Review | L | C | Safety | Score | Status | Note |
|---|---|---|---|---|---|---|---|
| 2026-09-25 | SRR | 3 | 3 | 2 | 9 | Proposed | Entered at the SRR research candidate pass (06 section 9, Identify) during SRR package assembly; awaiting the independent check of docs/reviews/SRR/checklists/risk-register.md. |
| 2026-09-27 | SRR | 3 | 3 | 2 | 9 | Open | Track pass 2026-09-27 (docs/plan/pdr-work-plan.md WP-PDR-18 wave 0; 06 section 9 Track and Control; INSP-007 finding-18, docs/reviews/SRR/checklists/risk-register-06.md), recorded at review point SRR, the last gate passed (06 section 10.3); the PDR Track pass of 06 section 10 item 1 follows at PDR package assembly. Status Proposed to Open: INSP-007 (APPROVED; item CK-RSK-A2) records the Analyze check passing all 65 risks (06 section 9 transition table). Likelihood and consequence unchanged: no analysis, test, trigger poll or SRR ruling since the SRR Track pass changes this risk's evidence. |

### RSK-031

**PA damaged by a detuned or mismatched antenna**

Given operators attach the antennas they own to the SMA port, including detuned, broken or counterfeit whips (docs/research/antenna-and-erp.md F6, F12); HZ-003 K5 and HZ-009 K3 propose a PA device with load ruggedness of at least 20:1 VSWR at rated power and survival of 60 s of key-down into any load up to 10:1 and into open and short circuits (ANT-04), with an optional forward and reverse power detector; the PA device is not selected yet (RSK-001 S1), there is a possibility of the PA device failing or degrading when keyed into a load with SWR above 3:1, an open or a short adversely impacting the TX PA and the operating scenario of friends using their own antennas (SI-019), leading to a unit that no longer transmits, a PA replacement the owner cannot hand-solder (vendor rework), and loss of the unit for weeks.

| Field | Value |
|---|---|
| Category | technical |
| Likelihood | 3 (Possible) |
| Consequence by dimension | Safety 1 / First power-on 3 / Cost 3 / Schedule 3 / Performance margin 3 |
| Consequence (max) | 3 (Moderate); driving: First power-on, Cost, Schedule, Performance margin |
| Score / band | 9 / Yellow |
| Assessment confidence | Medium |
| Status / trend | Open / Stable |
| Owner | Claude |
| Opened / horizon | 2026-09-25 / Ops |
| Last assessed | 2026-09-27 (SRR) |
| Source | ConOps section 8 candidate ANT-R2 (docs/research/antenna-and-erp.md); entered 2026-09-25 |
| Strategy | Mitigate |

**Likelihood rationale.** The research report rates the likelihood Medium; mismatch tolerance depends on a device not yet selected. Anchor level 3.

**Consequence rationale.** Driving dimensions first_power_on, cost, schedule and performance_margin at 3: the TX subsystem is lost until a vendor rework (USD 100 to 300, 3 to 6 weeks), and the load-tolerance requirement (ANT-04) is a Baseline requirement.

**Mitigation steps**

| Step | Action | Artifact | Due | Status |
|---|---|---|---|---|
| S1 | Make load ruggedness of at least 20:1 VSWR at rated power a mandatory criterion of the PA-device trade study (RSK-001 S1, HZ-003 K5). | docs/decisions/trade-studies/TS-001-receiver-and-pa-concept.md (sub-decision P, device choice) | PDR | Planned |
| S2 | Derive the load-tolerance requirement (60 s into any load up to 10:1, open and short; ANT-04) and decide the forward and reverse power detector with fold-back above 3:1 by ADR. | docs/requirements/tx/requirements.json; docs/decisions/adr/ADR-NNN-swr-protection.md | PDR | Planned |
| S3 | Bench: 60 s of key-down into open, short and a 10:1 mismatch, first at reduced power and then at 5 W, with output re-measured into the dummy load afterwards. | docs/test_cases/tx/test_cases.json (TC-TX load tolerance case) | SAR | Planned |
| S4 | Handbook SWR screen with the NanoVNA before the first use of an unknown antenna (ANT-05). | docs/ops/operations-handbook.md | SAR | Planned |

**Triggers**

| Condition | Response |
|---|---|
| No PA candidate meets the 20:1 ruggedness criterion in the trade study | Claude proposes the detector with fold-back as a required control by ADR before PDR closes |
| The load-tolerance Bench case degrades output by more than 0.5 dB | Owner stops the test; Claude opens an NCR |

**Fallback.** Add the SWR detector and firmware fold-back by CR, and restrict delivered units to the reference antenna in the handbook until then.

**Related.** adr: ADR-003, ADR-012; trade study: TS-001; stakeholder input: SI-019, SI-028; risk: RSK-001, RSK-025

**Closure criteria.** Load-tolerance requirement verified by Test on the delivered unit with no degradation, and the handbook SWR screen published.

**History**

| Date | Review | L | C | Safety | Score | Status | Note |
|---|---|---|---|---|---|---|---|
| 2026-09-25 | Pre-SRR | 3 | 3 | 1 | 9 | Proposed | Entered from ConOps section 8 candidate ANT-R2 after independent review; awaiting independent check. |
| 2026-09-25 | SRR | 3 | 3 | 1 | 9 | Proposed | SRR Track pass at package assembly 2026-09-25 (06 section 10 item 1): re-assessed against the SRR research candidate pass; likelihood and consequence unchanged; status stays Proposed until the independent check of docs/reviews/SRR/checklists/risk-register.md. |
| 2026-09-25 | SRR | 3 | 3 | 1 | 9 | Proposed | INSP-007 (docs/reviews/SRR/checklists/risk-register-06.md) finding F-04: trade-study references corrected (TS-001 is receiver-and-pa-concept, TS-002 is firmware-runtime-make-buy; unwritten studies carry TS-NNN until created) and related.trade_study_ids set for the studies that name this risk. Score unchanged. |
| 2026-09-27 | SRR | 3 | 3 | 1 | 9 | Open | Track pass 2026-09-27 (docs/plan/pdr-work-plan.md WP-PDR-18 wave 0; 06 section 9 Track and Control; INSP-007 finding-18, docs/reviews/SRR/checklists/risk-register-06.md), recorded at review point SRR, the last gate passed (06 section 10.3); the PDR Track pass of 06 section 10 item 1 follows at PDR package assembly. Status Proposed to Open: INSP-007 (APPROVED; item CK-RSK-A2) records the Analyze check passing all 65 risks (06 section 9 transition table). Likelihood and consequence unchanged: no analysis, test, trigger poll or SRR ruling since the SRR Track pass changes this risk's evidence. |

### RSK-032

**PWM audio noise masks weak CW signals**

Given receive audio and sidetone are generated by RP2350 PWM sharing supply and ground with the digital section; display SPI, flash and synthesizer activity can couple into the audio as hiss or ticks (docs/research/audio-output-and-hearing-safety.md F1); the owner has no oscilloscope (SI-013), so PWM noise can only be judged by listening and with the multimeter on the first board; a PCM5102A DAC footprint is kept unpopulated as a fallback (F31), there is a possibility of audible PWM hiss, ticks or digital interference in the headphones at a level that masks signals near the receiver's minimum discernible signal adversely impacting the RX audio chain and the weak-signal CW operating scenario (SI-005), leading to degraded weak-signal reception and population of the DAC footprint by vendor rework.

| Field | Value |
|---|---|
| Category | technical (tags: software) |
| Likelihood | 3 (Possible) |
| Consequence by dimension | Safety 1 / First power-on 3 / Cost 2 / Schedule 2 / Performance margin 3 |
| Consequence (max) | 3 (Moderate); driving: First power-on, Performance margin |
| Score / band | 9 / Yellow |
| Assessment confidence | Medium |
| Status / trend | Open / Stable |
| Owner | Claude |
| Opened / horizon | 2026-09-25 / SAR |
| Last assessed | 2026-09-27 (SRR) |
| Source | ConOps section 8 candidate R-AUD-1 (docs/research/audio-output-and-hearing-safety.md); entered 2026-09-25 |
| Strategy | Mitigate |

**Likelihood rationale.** Shared-supply PWM audio is prone to digital noise and the effect can only be judged on the first board. Anchor level 3.

**Consequence rationale.** Driving dimensions first_power_on and performance_margin at 3: the audio subsystem is degraded until vendor rework populates the DAC, and the receiver MDS requirement (TPM-005) is degraded.

**Mitigation steps**

| Step | Action | Artifact | Due | Status |
|---|---|---|---|---|
| S1 | DMA-fed PWM with a dedicated analog return and supply filtering; LTspice of the reconstruction filter and supply rejection; derive the SW-AUDIO DMA-PWM requirement. | docs/design/analysis/audio-output.md; hardware/sim/rx/; docs/requirements/sw/sw-audio/requirements.json | CDR | Planned |
| S2 | Keep the unpopulated PCM5102A footprint and its BOM line in the release package (F31). | hardware/kicad/ RX audio sheet; hardware/bom/ | CDR | Planned |
| S3 | Bench listening test and MDS measurement with display, flash and synthesizer activity running (TPM-005). | docs/test_cases/rx/test_cases.json (TC-RX audio noise case) | SAR | Planned |

**Triggers**

| Condition | Response |
|---|---|
| The bench listening test shows audible ticks or hiss above an MDS-level signal | Claude opens an NCR and the owner decides on populating the DAC footprint by vendor rework |
| The dev-board check (RSK-012 S3) shows audible PWM artifacts in the sidetone | Claude revises the PWM scheme before CDR |

**Fallback.** Populate the PCM5102A DAC footprint by vendor rework (F31) with a firmware build for the DAC path.

**Related.** tpm: TPM-005; stakeholder input: SI-005, SI-013; risk: RSK-017

**Closure criteria.** Receiver MDS and audio noise cases passed on the delivered unit with the selected audio path.

**History**

| Date | Review | L | C | Safety | Score | Status | Note |
|---|---|---|---|---|---|---|---|
| 2026-09-25 | Pre-SRR | 3 | 3 | 1 | 9 | Proposed | Entered from ConOps section 8 candidate R-AUD-1 after independent review; awaiting independent check. |
| 2026-09-25 | SRR | 3 | 3 | 1 | 9 | Proposed | SRR Track pass at package assembly 2026-09-25 (06 section 10 item 1): re-assessed against the SRR research candidate pass; likelihood and consequence unchanged; status stays Proposed until the independent check of docs/reviews/SRR/checklists/risk-register.md. |
| 2026-09-27 | SRR | 3 | 3 | 1 | 9 | Open | Track pass 2026-09-27 (docs/plan/pdr-work-plan.md WP-PDR-18 wave 0; 06 section 9 Track and Control; INSP-007 finding-18, docs/reviews/SRR/checklists/risk-register-06.md), recorded at review point SRR, the last gate passed (06 section 10.3); the PDR Track pass of 06 section 10 item 1 follows at PDR package assembly. Status Proposed to Open: INSP-007 (APPROVED; item CK-RSK-A2) records the Analyze check passing all 65 risks (06 section 9 transition table). Likelihood and consequence unchanged: no analysis, test, trigger poll or SRR ruling since the SRR Track pass changes this risk's evidence. |

### RSK-035

**Synthesizer phase noise limits reciprocal-mixing dynamic range**

Given the synthesizer is chosen by the synthesizer cost and performance trade study at PDR (TS-NNN, number assigned at creation) (SI-029, ADR-013); the low-cost candidate Si5351A runs its output divider at 6 at 144 MHz with a reported, primary-source-unverified -112 dBc/Hz at 10 kHz, about 20 dB worse than its HF reputation, which bounds reciprocal mixing to about 85 dB (docs/research/2m-cw-transceiver-reference-designs.md F16, F17, implication 9); REQ-SYS-031 asks for at least 85 dB (TBR) and REQ-SYS-029 bounds adjacent-signal desensitization (TBR), there is a possibility of the LO phase noise of the selected synthesizer raising the receiver noise floor above the REQ-SYS-031 limit when a strong signal is 2 to 10 kHz away adversely impacting RX dynamic range and the frequency-generation design (TX, synthesizer study TS-NNN), leading to a friend's strong signal masking weak stations (MOE-010), a CR relaxing REQ-SYS-031, or a synthesizer change after PDR.

| Field | Value |
|---|---|
| Category | technical |
| Likelihood | 3 (Possible) |
| Consequence by dimension | Safety 1 / First power-on 2 / Cost 2 / Schedule 3 / Performance margin 3 |
| Consequence (max) | 3 (Moderate); driving: Schedule, Performance margin |
| Score / band | 9 / Yellow |
| Assessment confidence | Medium |
| Status / trend | Open / Stable |
| Owner | Claude |
| Opened / horizon | 2026-09-25 / SAR |
| Last assessed | 2026-09-27 (SRR) |
| Source | SRR research candidate pass 2026-09-25: candidate REFDES-9 (docs/research/2m-cw-transceiver-reference-designs.md implication 9) entered |
| Strategy | Mitigate |

**Likelihood rationale.** Only a secondary-source estimate exists, with no measurement and no margin above the 85 dB proposal. Anchor level 3.

**Consequence rationale.** Driving dimensions schedule and performance margin at 3: a Baseline requirement missed where a CR is acceptable, or one design iteration to change the LO.

**Mitigation steps**

| Step | Action | Artifact | Due | Status |
|---|---|---|---|---|
| S1 | Make phase noise at 10 kHz offset at 144 MHz, measured or from a primary source, a scored criterion of the synthesizer study (TS-NNN, ADR-013) and compute the reciprocal-mixing dynamic range of each candidate against REQ-SYS-031. | docs/decisions/trade-studies/TS-NNN-synthesizer.md (ADR-013 study; number assigned at creation) | PDR | Planned |
| S2 | Obtain the primary source for the Si5351 VHF phase-noise figure or measure a Si5351A at 144 MHz with the tinySA Ultra (reference report ACTION 22), and extract the LMX2571 closed-loop plots (ACTION 20). | docs/design/analysis/lo-phase-noise.md | PDR | Planned |
| S3 | Bench: reciprocal-mixing check with a strong local signal at 2 kHz and 10 kHz offsets on the delivered unit. | docs/test_cases/sys/test_cases.json (REQ-SYS-031 case) | SAR | Planned |

**Triggers**

| Condition | Response |
|---|---|
| The synthesizer study (TS-NNN, ADR-013) shows the reciprocal-mixing dynamic range of the lowest-cost candidate below the REQ-SYS-031 value | Claude scores the next candidate as the selection and reports the cost difference to the owner for the SI-029 decision at PDR |

**Fallback.** Select the LMX2571 class synthesizer at its higher cost, or relax REQ-SYS-031 by CR with the owner's approval.

**Related.** requirement: REQ-SYS-029, REQ-SYS-031; adr: ADR-013; stakeholder input: SI-029; risk: RSK-002, RSK-005

**Closure criteria.** REQ-SYS-031 verified on the delivered unit, or relaxed by an approved CR, with the synthesizer recorded in the ADR of the synthesizer study.

**History**

| Date | Review | L | C | Safety | Score | Status | Note |
|---|---|---|---|---|---|---|---|
| 2026-09-25 | SRR | 3 | 3 | 1 | 9 | Proposed | Entered at the SRR research candidate pass (06 section 9, Identify) during SRR package assembly; awaiting the independent check of docs/reviews/SRR/checklists/risk-register.md. |
| 2026-09-25 | SRR | 3 | 3 | 1 | 9 | Proposed | INSP-007 (docs/reviews/SRR/checklists/risk-register-06.md) finding F-04: trade-study references corrected (TS-001 is receiver-and-pa-concept, TS-002 is firmware-runtime-make-buy; unwritten studies carry TS-NNN until created) and related.trade_study_ids set for the studies that name this risk. Score unchanged. |
| 2026-09-27 | SRR | 3 | 3 | 1 | 9 | Open | Track pass 2026-09-27 (docs/plan/pdr-work-plan.md WP-PDR-18 wave 0; 06 section 9 Track and Control; INSP-007 finding-18, docs/reviews/SRR/checklists/risk-register-06.md), recorded at review point SRR, the last gate passed (06 section 10.3); the PDR Track pass of 06 section 10 item 1 follows at PDR package assembly. Status Proposed to Open: INSP-007 (APPROVED; item CK-RSK-A2) records the Analyze check passing all 65 risks (06 section 9 transition table). Likelihood and consequence unchanged: no analysis, test, trigger poll or SRR ruling since the SRR Track pass changes this risk's evidence. |

### RSK-036

**Crystal filter bandwidth or loss out of tolerance across units**

Given CW selectivity is traded at PDR between a commercial 8-pole crystal filter (candidate A) and a tolerance-designed 1.0 kHz ladder roofing filter from catalog SMD crystals plus DSP (candidate B) (docs/research/cw-selectivity-options.md implication 12); a Monte Carlo with +/-30 ppm crystals gives 14.5 to 51 % yield for a 500 Hz ladder and leaves half the units above 8 dB loss because catalog ESR is bounded only at 60 ohm (F5, F7, F8); a 20 % lot-to-lot shift of motional capacitance moves a ladder bandwidth by 20 % (F7); hand-matched crystals are incompatible with PCBWay turnkey assembly (docs/research/2m-cw-transceiver-reference-designs.md F34), there is a possibility of the assembled crystal filters of the delivered units having a -6 dB bandwidth, centre or insertion loss outside the REQ-SYS-024 to REQ-SYS-028 values adversely impacting RX selectivity (filter block B10 or B11), leading to units that fail the selectivity or MDS requirements, a rework of SMD crystals the owner cannot do (SI-031), or a CR relaxing the TBR set.

| Field | Value |
|---|---|
| Category | technical |
| Likelihood | 3 (Possible) |
| Consequence by dimension | Safety 1 / First power-on 3 / Cost 2 / Schedule 3 / Performance margin 3 |
| Consequence (max) | 3 (Moderate); driving: First power-on, Schedule, Performance margin |
| Score / band | 9 / Yellow |
| Assessment confidence | Medium |
| Status / trend | Open / Stable |
| Owner | Claude |
| Opened / horizon | 2026-09-25 / SAR |
| Last assessed | 2026-09-27 (SRR) |
| Source | SRR research candidate pass 2026-09-25: candidates CWSEL-6 and CWSEL-11 (docs/research/cw-selectivity-options.md implications 6 and 11) and REFDES-10 (docs/research/2m-cw-transceiver-reference-designs.md implication 10) entered as one family |
| Strategy | Mitigate |

**Likelihood rationale.** A Monte Carlo analysis exists but uses assumed crystal parameters, and lot-to-lot and assembly effects are unmeasured. Anchor level 3.

**Consequence rationale.** Driving dimensions first_power_on, schedule and performance_margin at 3: the receiver is degraded while the radio still transmits and receives, and the fix is a filter redesign or vendor rework.

**Mitigation steps**

| Step | Action | Artifact | Due | Status |
|---|---|---|---|---|
| S1 | Carry into TS-001 sub-decision R2 the rule that no 500 Hz ladder is baselined and that any ladder is at least 1.0 kHz wide with the 500 Hz selectivity in DSP (candidate B), or that the commercial can is used (candidate A). | docs/decisions/trade-studies/TS-001-receiver-and-pa-concept.md (sub-decision R2, CW selectivity) | PDR | Planned |
| S2 | Re-run the docs/research/sim/cw-selectivity/ Monte Carlo with Cm, Rs and C0 measured on ten samples of the chosen crystal by the NanoVNA series-resonance method. | docs/design/analysis/cw-filter-monte-carlo.md | PDR | Planned |
| S3 | Record the crystal lot in each as-built record and sweep one filter per unit with the NanoVNA at receipt inspection. | docs/vv/reports/receipt-inspection-<n>.md; docs/vv/adp/CWHT-A-NNN/as-built.md | TRR | Planned |

**Triggers**

| Condition | Response |
|---|---|
| The re-run Monte Carlo yield of the chosen filter is below 95 % for the TBR selectivity set | Claude proposes the wider roofing bandwidth or candidate A in TS-001 before PDR closes |

**Fallback.** Use the commercial can (candidate A), or widen the roofing filter and move all selectivity into DSP.

**Related.** requirement: REQ-SYS-024, REQ-SYS-025, REQ-SYS-026, REQ-SYS-027, REQ-SYS-028; adr: ADR-007; trade study: TS-001; stakeholder input: SI-009, SI-031; risk: RSK-002, RSK-038

**Closure criteria.** REQ-SYS-024 to REQ-SYS-028 verified on every delivered unit.

**History**

| Date | Review | L | C | Safety | Score | Status | Note |
|---|---|---|---|---|---|---|---|
| 2026-09-25 | SRR | 3 | 3 | 1 | 9 | Proposed | Entered at the SRR research candidate pass (06 section 9, Identify) during SRR package assembly; awaiting the independent check of docs/reviews/SRR/checklists/risk-register.md. |
| 2026-09-25 | SRR | 3 | 3 | 1 | 9 | Proposed | INSP-007 (docs/reviews/SRR/checklists/risk-register-06.md) finding F-04: trade-study references corrected (TS-001 is receiver-and-pa-concept, TS-002 is firmware-runtime-make-buy; unwritten studies carry TS-NNN until created) and related.trade_study_ids set for the studies that name this risk. Score unchanged. |
| 2026-09-27 | SRR | 3 | 3 | 1 | 9 | Open | Track pass 2026-09-27 (docs/plan/pdr-work-plan.md WP-PDR-18 wave 0; 06 section 9 Track and Control; INSP-007 finding-18, docs/reviews/SRR/checklists/risk-register-06.md), recorded at review point SRR, the last gate passed (06 section 10.3); the PDR Track pass of 06 section 10 item 1 follows at PDR package assembly. Status Proposed to Open: INSP-007 (APPROVED; item CK-RSK-A2) records the Analyze check passing all 65 risks (06 section 9 transition table). Likelihood and consequence unchanged: no analysis, test, trigger poll or SRR ruling since the SRR Track pass changes this risk's evidence. |

### RSK-037

**RP2350 ADC noise degrades receive audio**

Given the concept routes the demodulated audio of selectivity candidate A to the Pico 2 for firmware mixing, limiting and PWM output (docs/design/concept.md section 5); the RP2350 ADC offers 9.0 to 9.5 ENOB with no INL or DNL specification, missing-code artefacts and a noisy module reference, a practical 60 to 70 dB in-channel dynamic range that forces analog AGC ahead of the ADC (docs/research/cw-selectivity-options.md F11, F13, implication 8; docs/research/audio-output-and-hearing-safety.md F6, R-AUD-2), there is a possibility of receive audio digitized by the RP2350 ADC carrying audible noise or spurs, or needing an analog AGC ahead of the ADC that pumps on strong adjacent signals adversely impacting RX audio path (B10 with SW-AUDIO), leading to degraded weak-signal copy (MOE-010), audible pumping against REQ-SYS-030, or a redesign of the candidate A audio path.

| Field | Value |
|---|---|
| Category | technical (tags: software) |
| Likelihood | 3 (Possible) |
| Consequence by dimension | Safety 1 / First power-on 2 / Cost 2 / Schedule 3 / Performance margin 3 |
| Consequence (max) | 3 (Moderate); driving: Schedule, Performance margin |
| Score / band | 9 / Yellow |
| Assessment confidence | Medium |
| Status / trend | Open / Stable |
| Owner | Claude |
| Opened / horizon | 2026-09-25 / PDR |
| Last assessed | 2026-09-27 (SRR) |
| Source | SRR research candidate pass 2026-09-25: candidates CWSEL-8 (docs/research/cw-selectivity-options.md implication 8) and R-AUD-2 (docs/research/audio-output-and-hearing-safety.md Risks) entered as one family |
| Strategy | Mitigate |

**Likelihood rationale.** Datasheet figures and a published characterization exist, but no measurement on a Pico 2 in this configuration. Anchor level 3.

**Consequence rationale.** Driving dimensions schedule and performance_margin at 3: REQ-SYS-030 missed where a CR or a design iteration is the remedy.

**Mitigation steps**

| Step | Action | Artifact | Due | Status |
|---|---|---|---|---|
| S1 | Bench-characterize the RP2350 ADC on a Pico 2 with a clean external reference (noise floor at 500 kS/s and a spur table) before any audio use is proposed (selectivity report ACTION 17). | docs/design/analysis/rp2350-adc-audio.md | PDR | Planned |
| S2 | Score the audio path of each TS-001 sub-decision R2 candidate: candidate A keeps its audio analog to the headphone amplifier with an analog mute or uses an external audio ADC; candidate B uses the PCM1808. | docs/decisions/trade-studies/TS-001-receiver-and-pa-concept.md (sub-decision R2, CW selectivity) | PDR | Planned |

**Triggers**

| Condition | Response |
|---|---|
| The ADC characterization shows less than 80 dB of in-channel dynamic range in 500 Hz | Claude removes the RP2350 ADC from the audio path in TS-001 and records it in the TS-001 ADR |

**Fallback.** Keep the candidate A audio path analog (mute and sidetone injection in hardware) or add an external I2S ADC.

**Related.** requirement: REQ-SYS-022, REQ-SYS-030; trade study: TS-001; stakeholder input: SI-007, SI-026; risk: RSK-032, RSK-036

**Closure criteria.** Receive audio path fixed in the TS-001 ADR with the ADC question closed by measurement, and REQ-SYS-030 verified on the delivered unit.

**History**

| Date | Review | L | C | Safety | Score | Status | Note |
|---|---|---|---|---|---|---|---|
| 2026-09-25 | SRR | 3 | 3 | 1 | 9 | Proposed | Entered at the SRR research candidate pass (06 section 9, Identify) during SRR package assembly; awaiting the independent check of docs/reviews/SRR/checklists/risk-register.md. |
| 2026-09-25 | SRR | 3 | 3 | 1 | 9 | Proposed | INSP-007 (docs/reviews/SRR/checklists/risk-register-06.md) finding F-04: trade-study references corrected (TS-001 is receiver-and-pa-concept, TS-002 is firmware-runtime-make-buy; unwritten studies carry TS-NNN until created) and related.trade_study_ids set for the studies that name this risk. Score unchanged. |
| 2026-09-27 | SRR | 3 | 3 | 1 | 9 | Open | Track pass 2026-09-27 (docs/plan/pdr-work-plan.md WP-PDR-18 wave 0; 06 section 9 Track and Control; INSP-007 finding-18, docs/reviews/SRR/checklists/risk-register-06.md), recorded at review point SRR, the last gate passed (06 section 10.3); the PDR Track pass of 06 section 10 item 1 follows at PDR package assembly. Status Proposed to Open: INSP-007 (APPROVED; item CK-RSK-A2) records the Analyze check passing all 65 risks (06 section 9 transition table). Likelihood and consequence unchanged: no analysis, test, trigger poll or SRR ruling since the SRR Track pass changes this risk's evidence. |

### RSK-044

**Enclosure CAD pipeline yields a STEP unfit for machining**

Given the enclosure is authored in OpenSCAD 2021.01, whose Homebrew cask is disabled and whose newer snapshot line changes behaviour, and exported to STEP through headless FreeCAD 1.1.3 (SI-032, ADR-008); any hull, minkowski, text or resize in the source silently degrades to mesh or BSpline faces in the STEP, and headless slicing for the H2C fit-check print fails from the Bambu Studio CLI, so a manual GUI step remains (docs/research/enclosure-cnc-and-openscad-pipeline.md B4 to B7), there is a possibility of the STEP delivered to PCBWay being mesh-derived, multi-solid or geometrically different from the OpenSCAD model, or the fit-check print not matching the released model adversely impacting ME enclosure design data and the CNC order, leading to a rejected or wrong CNC quote, a machined part that does not match the model, or a CNC order delayed by rework.

| Field | Value |
|---|---|
| Category | technical (tags: cm) |
| Likelihood | 3 (Possible) |
| Consequence by dimension | Safety 1 / First power-on 2 / Cost 3 / Schedule 3 / Performance margin 2 |
| Consequence (max) | 3 (Moderate); driving: Cost, Schedule |
| Score / band | 9 / Yellow |
| Assessment confidence | Medium |
| Status / trend | Open / Stable |
| Owner | Claude |
| Opened / horizon | 2026-09-25 / CDR |
| Last assessed | 2026-09-27 (SRR) |
| Source | SRR research candidate pass 2026-09-25: candidates ENC-R4, ENC-R5 and ENC-R6 (docs/research/enclosure-cnc-and-openscad-pipeline.md Implications, RISK-candidates 4 to 6) entered as one family; SRR ADR candidate pass 2026-09-25 merged ADR008-R1, ADR008-R3 |
| Strategy | Mitigate |

**Likelihood rationale.** The failure modes are documented and the acceptance checks are proposed but not yet run on a representative model. Anchor level 3.

**Consequence rationale.** Driving dimensions cost and schedule at 3: a wrong machined set or one design iteration of the CAD.

**Mitigation steps**

| Step | Action | Artifact | Due | Status |
|---|---|---|---|---|
| S1 | Restricted OpenSCAD dialect for machined parts (no hull, minkowski, text or resize) and the scad2step acceptance checks (valid, one solid, no BSpline faces, volume match) run and logged on every STEP. | tools/scad2step.py; tools/toolchain.lock.md | PDR | Planned |
| S2 | Pin the exact OpenSCAD and FreeCAD builds in the lock with a known-answer test and a tool validation record. | docs/cm/tool-validation/TV-NNN-openscad-freecad.md | PDR | Planned |
| S3 | Document the manual H2C slicing step in the fit-check procedure, with the model hash printed on the part. | docs/vv/procedures/fit-check.md | CDR | Planned |

**Triggers**

| Condition | Response |
|---|---|
| A STEP fails an acceptance check | Claude rewrites the offending construct in CSG primitives before release; build123d is evaluated if the check fails twice |

**Fallback.** Author the machined part in build123d (ADR-008 fallback) or send PCBWay the 2D drawing with the STEP.

**Related.** requirement: REQ-SYS-109; adr: ADR-008; stakeholder input: SI-008, SI-012, SI-032; risk: RSK-043

**Closure criteria.** The CDR STEP passes every acceptance check and the delivered enclosure matches the drawing at receipt inspection.

**History**

| Date | Review | L | C | Safety | Score | Status | Note |
|---|---|---|---|---|---|---|---|
| 2026-09-25 | SRR | 3 | 3 | 1 | 9 | Proposed | Entered at the SRR research candidate pass (06 section 9, Identify) during SRR package assembly; awaiting the independent check of docs/reviews/SRR/checklists/risk-register.md. |
| 2026-09-25 | SRR | 3 | 3 | 1 | 9 | Proposed | ADR-008 section 4.4 candidates on FreeCAD import fidelity and OpenSCAD toolchain age merged: the same departures as ENC-R4 and ENC-R5. Score unchanged. |
| 2026-09-27 | SRR | 3 | 3 | 1 | 9 | Open | Track pass 2026-09-27 (docs/plan/pdr-work-plan.md WP-PDR-18 wave 0; 06 section 9 Track and Control; INSP-007 finding-18, docs/reviews/SRR/checklists/risk-register-06.md), recorded at review point SRR, the last gate passed (06 section 10.3); the PDR Track pass of 06 section 10 item 1 follows at PDR package assembly. Status Proposed to Open: INSP-007 (APPROVED; item CK-RSK-A2) records the Analyze check passing all 65 risks (06 section 9 transition table). Likelihood and consequence unchanged: no analysis, test, trigger poll or SRR ruling since the SRR Track pass changes this risk's evidence. CR-003 revision 3 (Submitted, d9a215a; section 4 Risk row) proposes changes to this risk; a submitted CR changes no baseline (06 section 10.2 trigger noted), so the changes are applied with a Refs trailer naming the CR after the owner's disposition (WP-PDR-02 and the WP-PDR-18 final pass). This pass keeps the current values. |

### RSK-050

**LTspice batch toolchain fails, hangs or lags upstream fixes**

Given Analysis evidence runs LTspice 26.0.2 for macOS headless inside a Rosetta-dependent CrossOver bundle whose launcher argument path is broken, through a working path that depends on the internal bundle layout (docs/research/ltspice-batch-macos.md F2, F13); hidden modal prompts such as the update nag can hang a batch run (F4, F7); the macOS build lags Windows 26.1.1 (F12); the single Wine bottle forbids parallel runs (docs/research/verification-tooling-inventory.md F12); the batch path is demonstrated by the cw-selectivity Monte Carlo (docs/research/sim/cw-selectivity/), there is a possibility of the LTspice batch path failing, hanging or giving different results after a macOS, LTspice or CrossOver update while analyses are due adversely impacting the Analysis evidence class (hardware/sim/) and the PDR and CDR schedule, leading to analysis evidence blocked or re-run on the ngspice fallback, delaying PDR or CDR.

| Field | Value |
|---|---|
| Category | process (tags: cm) |
| Likelihood | 3 (Possible) |
| Consequence by dimension | Safety 1 / First power-on 2 / Cost 1 / Schedule 3 / Performance margin 1 |
| Consequence (max) | 3 (Moderate); driving: Schedule |
| Score / band | 9 / Yellow |
| Assessment confidence | Medium |
| Status / trend | Open / Stable |
| Owner | Claude |
| Opened / horizon | 2026-09-25 / CDR |
| Last assessed | 2026-09-27 (SRR) |
| Source | SRR research candidate pass 2026-09-25: candidates LTS-R1, LTS-R2 and LTS-R3 (docs/research/ltspice-batch-macos.md Implications, RISK-candidates 1 to 3) and VTI-8 (docs/research/verification-tooling-inventory.md implication 8) entered as one family |
| Strategy | Mitigate |

**Likelihood rationale.** The path works today but depends on undocumented bundle internals and unguarded prompts. Anchor level 3.

**Consequence rationale.** Driving dimension schedule 3: a blocked analysis chain can cost one gate iteration.

**Mitigation steps**

| Step | Action | Artifact | Due | Status |
|---|---|---|---|---|
| S1 | Pin LTspice.app 26.0.2.1 and the LTspice.exe SHA-256 in the lock and run the RC smoke test after any LTspice or macOS update and before every gate. | tools/toolchain.lock.md; tools/ltspice_check.py | PDR | Planned |
| S2 | Wrap every batch run in a timeout that kills LTspice.exe and reports failure, with the seeded ini keys documented. | tools/ltspice-batch.sh | PDR | Planned |
| S3 | Keep an ngspice 47 path for vendor-model-free decks and record the LTspice version line in every analysis report. | docs/cm/tool-validation/TV-NNN-ltspice.md | PDR | Planned |

**Triggers**

| Condition | Response |
|---|---|
| The RC smoke test fails or a batch run times out | Claude re-assesses the risk, restores the pinned build or moves the deck to ngspice, and reports the delay at the next gate |

**Fallback.** Run the affected decks in ngspice with KiCad-exported netlists, or on a Windows LTspice install if the owner provides one.

**Related.** adr: ADR-018; stakeholder input: SI-027; risk: RSK-001

**Closure criteria.** Every Analysis report cited at CDR reproduced headless by the pinned toolchain with its version line recorded.

**History**

| Date | Review | L | C | Safety | Score | Status | Note |
|---|---|---|---|---|---|---|---|
| 2026-09-25 | SRR | 3 | 3 | 1 | 9 | Proposed | Entered at the SRR research candidate pass (06 section 9, Identify) during SRR package assembly; awaiting the independent check of docs/reviews/SRR/checklists/risk-register.md. |
| 2026-09-27 | SRR | 3 | 3 | 1 | 9 | Open | Track pass 2026-09-27 (docs/plan/pdr-work-plan.md WP-PDR-18 wave 0; 06 section 9 Track and Control; INSP-007 finding-18, docs/reviews/SRR/checklists/risk-register-06.md), recorded at review point SRR, the last gate passed (06 section 10.3); the PDR Track pass of 06 section 10 item 1 follows at PDR package assembly. Status Proposed to Open: INSP-007 (APPROVED; item CK-RSK-A2) records the Analyze check passing all 65 risks (06 section 9 transition table). Likelihood and consequence unchanged: no analysis, test, trigger poll or SRR ruling since the SRR Track pass changes this risk's evidence. |

### RSK-053

**Vendor lead time and holiday closures delay the build**

Given the CDR order is planned for 2026-09-27 (docs/plan/schedule.md); parts imported into China add at least 5 to 7 working days, PCBWay's holiday closure runs 2026-10-01 to 2026-10-04, and single-source substitutions need the owner's approval, which can stall assembly (docs/research/pcbway-fabrication-and-assembly.md F17, F21); the schedule assumes a 2 to 4 week vendor lead time before TRR, there is a possibility of delivered boards and enclosures arriving more than 3 weeks after the schedule's lead-time assumption adversely impacting the schedule to TRR and SAR, leading to a 3 to 6 week slip of TRR and SAR.

| Field | Value |
|---|---|
| Category | schedule |
| Likelihood | 3 (Possible) |
| Consequence by dimension | Safety 1 / First power-on 1 / Cost 1 / Schedule 3 / Performance margin 1 |
| Consequence (max) | 3 (Moderate); driving: Schedule |
| Score / band | 9 / Yellow |
| Assessment confidence | Medium |
| Status / trend | Open / Stable |
| Owner | Robin |
| Opened / horizon | 2026-09-25 / TRR |
| Last assessed | 2026-09-27 (SRR) |
| Source | SRR research candidate pass 2026-09-25: candidate R-PCB-04 (docs/research/pcbway-fabrication-and-assembly.md Risks) entered |
| Strategy | Mitigate |

**Likelihood rationale.** The import time and the holiday closure are documented facts; their effect on this order is unquantified. Anchor level 3.

**Consequence rationale.** Driving dimension schedule 3: a 3 to 6 week slip.

**Mitigation steps**

| Step | Action | Artifact | Due | Status |
|---|---|---|---|---|
| S1 | BOM with approved alternates listed at CDR so PCBWay substitutions need no approval loop. | hardware/bom/ | CDR | Planned |
| S2 | Owner answers PCBWay engineering and substitution queries within one working day, tracked in the milestone status of each package. | docs/plan/schedule.md; package section 12 | TRR | Planned |

**Triggers**

| Condition | Response |
|---|---|
| PCBWay quotes a lead time over 4 weeks or a query stays open more than 2 working days | Claude reports the slip and the recovery options to the owner in the same session |

**Fallback.** Continue firmware and host verification during the delay and re-plan TRR.

**Related.** adr: ADR-007; stakeholder input: SI-009, SI-020; risk: RSK-014, RSK-038

**Closure criteria.** Boards and enclosures received and receipt-inspected.

**History**

| Date | Review | L | C | Safety | Score | Status | Note |
|---|---|---|---|---|---|---|---|
| 2026-09-25 | SRR | 3 | 3 | 1 | 9 | Proposed | Entered at the SRR research candidate pass (06 section 9, Identify) during SRR package assembly; awaiting the independent check of docs/reviews/SRR/checklists/risk-register.md. |
| 2026-09-27 | SRR | 3 | 3 | 1 | 9 | Open | Track pass 2026-09-27 (docs/plan/pdr-work-plan.md WP-PDR-18 wave 0; 06 section 9 Track and Control; INSP-007 finding-18, docs/reviews/SRR/checklists/risk-register-06.md), recorded at review point SRR, the last gate passed (06 section 10.3); the PDR Track pass of 06 section 10 item 1 follows at PDR package assembly. Status Proposed to Open: INSP-007 (APPROVED; item CK-RSK-A2) records the Analyze check passing all 65 risks (06 section 9 transition table). Likelihood and consequence unchanged: no analysis, test, trigger poll or SRR ruling since the SRR Track pass changes this risk's evidence. CR-003 revision 3 (Submitted, d9a215a; section 4 Risk row) proposes changes to this risk; a submitted CR changes no baseline (06 section 10.2 trigger noted), so the changes are applied with a Refs trailer naming the CR after the owner's disposition (WP-PDR-02 and the WP-PDR-18 final pass). This pass keeps the current values. |

### RSK-055

**Charge time from a 500 mA USB supply above 12 h or unacceptable to operators**

Given all charge current passes through the Pico 2 micro-USB (SI-022), whose VBUS path has no rating above 500 mA (RSK-033), so REQ-SYS-090 limits the USB draw to 500 mA; the module itself takes about 40 mA of that, so about 450 mA reaches the charger and the REQ-SYS-091 rationale estimates about 11 h to charge a 3000 mAh pack against the 12 h bound of REQ-SYS-091, a margin under 1 h that rests on an assumed 0.90 boost efficiency and an assumed 1 h constant-voltage tail (docs/research/power-tree-and-charging.md F3 method, F18, F22; F3 and candidate R-PWR-02 give about 10 h for the full 500 mA); operators are used to wall adapters charging at 1.5 A; the input policy above 500 mA is the USB charge-current study (TS-NNN) at PDR, there is a possibility of the delivered radio needing more than the 12 h of REQ-SYS-091 to charge a 3000 mAh pack from a 500 mA USB supply, or operators finding the radio not charged for a planned outing or seeking faster charging by unapproved means adversely impacting PWR charging (REQ-SYS-091), the charging scenario OPS-002 and the friend units (SI-019), leading to REQ-SYS-091 missed by up to about 1 h with a CR on the charge-time bound, a unit unavailable for a day out (MOE-004), or pressure to raise the input limit before the VBUS path is qualified.

| Field | Value |
|---|---|
| Category | technical (tags: hsi) |
| Likelihood | 3 (Possible) |
| Consequence by dimension | Safety 1 / First power-on 1 / Cost 1 / Schedule 1 / Performance margin 3 |
| Consequence (max) | 3 (Moderate); driving: Performance margin |
| Score / band | 9 / Yellow |
| Assessment confidence | Medium |
| Status / trend | Open / Stable |
| Owner | Claude |
| Opened / horizon | 2026-09-25 / Ops |
| Last assessed | 2026-09-27 (SRR) |
| Source | SRR research candidate pass 2026-09-25: candidate R-PWR-02 (docs/research/power-tree-and-charging.md implication 13) entered; re-scoped 2026-09-25 to carry the REQ-SYS-091 charge-time margin (SRR deck review finding F6) |
| Strategy | Mitigate |

**Likelihood rationale.** The about 11 h figure is a single derived estimate with a margin under 1 h (under 10 percent) to REQ-SYS-091, resting on an assumed 0.90 boost efficiency at about a quarter of the 1 A at which TI quotes 93.4 percent (F3) and on an assumed 1 h constant-voltage tail; no charger is selected yet (USB charge-current study TS-NNN, D-PWR-01) and operator acceptance is unknown. Anchor level 3: a single analysis exists and the margin is below 2x.

**Consequence rationale.** Driving dimension performance_margin 3: REQ-SYS-091 (priority Baseline) missed by up to about 1 h, with a CR on the bound acceptable to the owner because the REQ-SYS-089 charge timer of 15 h (TBR) stays above it. The operator-acceptance member alone scores 2 (the requirement met with less than half of its margin). Safety 1: the pressure to raise the input limit is carried as a hazard cause by RSK-033 and HZ-011, not here. The other dimensions do not apply.

**Mitigation steps**

| Step | Action | Artifact | Due | Status |
|---|---|---|---|---|
| S1 | USB charge-current study (TS-NNN): measure the Pico 2 VBUS path at 0.5, 1.0 and 1.5 A and prototype DCP detection (A-PWR-01, A-PWR-02). | docs/decisions/trade-studies/TS-NNN-usb-input.md (concept section 11.2 USB charge-current study; number assigned at creation) | PDR | Planned |
| S2 | Handbook overnight-charge guidance and the charge-state indication (REQ-SYS-070). | docs/ops/operations-handbook.md | SAR | Planned |
| S3 | Charge-time analysis in the PDR power budget (the REQ-SYS-091 pre-build Analysis): the charger setting that keeps the USB draw at or below 500 mA with the module's 40 mA (the BQ25887 input-current register starts at 0.5 A in the charger comparison table of docs/research/power-tree-and-charging.md, so a limit near 450 mA comes from the charge-current setting or the ILIM pin), the boost efficiency at that current from the selected charger's datasheet, and the constant-voltage tail to the termination current, giving the 3000 mAh charge time and its margin to 12 h. | docs/design/budgets.md (charge-time section) | PDR | Planned |

**Triggers**

| Condition | Response |
|---|---|
| The USB charge-current study (TS-NNN) shows the VBUS path safe at 1.5 A | Claude proposes the DCP detection feature by CR for the owner's decision |
| The S3 analysis gives more than 11.5 h for a 3000 mAh pack, or TC-SYS-059 measures more than 12 h | Claude re-assesses this risk the same session and proposes to the owner either a CR on the REQ-SYS-091 bound, kept below the REQ-SYS-089 timer, or a charger setting change within the REQ-SYS-090 limit; the PDR or TRR decision memo records the choice |

**Fallback.** Keep 500 mA, state overnight charging in the handbook, and relax the REQ-SYS-091 bound by CR to the analysed or measured charge time plus 1 h, kept below the REQ-SYS-089 timer.

**Related.** requirement: REQ-SYS-070, REQ-SYS-089, REQ-SYS-090, REQ-SYS-091; adr: ADR-004; stakeholder input: SI-019, SI-022, SI-023; risk: RSK-033

**Closure criteria.** REQ-SYS-091 verified on the delivered unit (TC-SYS-059 Passed) and the USB charge-current study decision recorded by ADR.

**History**

| Date | Review | L | C | Safety | Score | Status | Note |
|---|---|---|---|---|---|---|---|
| 2026-09-25 | SRR | 3 | 2 | 1 | 6 | Proposed | Entered at the SRR research candidate pass (06 section 9, Identify) during SRR package assembly; awaiting the independent check of docs/reviews/SRR/checklists/risk-register.md. |
| 2026-09-25 | SRR | 3 | 3 | 1 | 9 | Proposed | Reconciled with the REQ-SYS-091 and REQ-SYS-089 rationales (SRR deck review finding F6; readiness item H9, risk manager). The condition quoted about 10 h, which is docs/research/power-tree-and-charging.md F3 at the full 500 mA (2.5 W x 0.90 / 8.0 V = about 280 mA; 85 percent of 3000 mAh in about 9 h plus a 1 h tail). REQ-SYS-090 leaves about 450 mA for the charger after the module's 40 mA (F18), which by the same method gives 2.25 W x 0.90 / 8.0 V = about 250 mA, about 10 h plus the 1 h tail, about 11 h: the figure of the REQ-SYS-091 and REQ-SYS-089 rationales and of the SRR deck. The margin to 12 h is under 1 h (under 10 percent), and the deck says RSK-055 carries it, so the departure now includes a REQ-SYS-091 miss. Family rule (06 section 4) checked: both members harm PWR charging and OPS-002 (a), drive performance_margin (b), share TS-005, the new PDR charge-time analysis S3, the fallback and the closure criteria (c), and are non-safety (d); the family is scored at its worst member, a Baseline requirement missed with a CR acceptable (performance_margin 3). Likelihood stays 3 (single derived analysis, margin below 2x). Score 6 to 9, band Yellow unchanged; trend Increasing. Added: S3, the charge-time trigger, REQ-SYS-089 in related, the fallback CR and TC-SYS-059 in the closure criteria. |
| 2026-09-25 | SRR | 3 | 3 | 1 | 9 | Proposed | INSP-007 (docs/reviews/SRR/checklists/risk-register-06.md) finding F-04: trade-study references corrected (TS-001 is receiver-and-pa-concept, TS-002 is firmware-runtime-make-buy; unwritten studies carry TS-NNN until created) and related.trade_study_ids set for the studies that name this risk. Score unchanged. |
| 2026-09-27 | SRR | 3 | 3 | 1 | 9 | Open | Track pass 2026-09-27 (docs/plan/pdr-work-plan.md WP-PDR-18 wave 0; 06 section 9 Track and Control; INSP-007 finding-18, docs/reviews/SRR/checklists/risk-register-06.md), recorded at review point SRR, the last gate passed (06 section 10.3); the PDR Track pass of 06 section 10 item 1 follows at PDR package assembly. Status Proposed to Open: INSP-007 (APPROVED; item CK-RSK-A2) records the Analyze check passing all 65 risks (06 section 9 transition table). Likelihood and consequence unchanged: no analysis, test, trigger poll or SRR ruling since the SRR Track pass changes this risk's evidence. |

### RSK-059

**No qualification testing at the environmental extremes**

Given no test is run at the environmental extremes of NGO-026 (operation -10 to +45 C, charging 0 to 45 C, 1.0 m drop, light rain); qualification is Not applicable at rev A and the operational environment is shown by Analysis cases for the thermal budget at +45 C, the frequency-reference drift over -10 to +45 C, the charger window and the pack voltage range (docs/process/04-verification-and-validation.md section 14 row 4.2, alignment item A10); REQ-SYS-114 and REQ-SYS-115 are verified by Analysis, there is a possibility of the delivered unit failing a requirement at an operating or storage extreme that was only analyzed adversely impacting the delivered units in field use (operator scenarios OPS-010 and OPS-014), leading to a function lost in cold or heat found only in operation, and an NCR against a unit in the field.

| Field | Value |
|---|---|
| Category | technical |
| Likelihood | 3 (Possible) |
| Consequence by dimension | Safety 1 / First power-on 1 / Cost 2 / Schedule 2 / Performance margin 3 |
| Consequence (max) | 3 (Moderate); driving: Performance margin |
| Score / band | 9 / Yellow |
| Assessment confidence | Medium |
| Status / trend | Open / Stable |
| Owner | Claude |
| Opened / horizon | 2026-09-25 / Ops |
| Last assessed | 2026-09-27 (SRR) |
| Source | 04 section 18 alignment item A10 (docs/process/04-verification-and-validation.md section 14 row 4.2), entered at the SRR pass 2026-09-25 |
| Strategy | Mitigate |

**Likelihood rationale.** Analysis-only evidence for the extremes with no bench cold or heat soak planned. Anchor level 3.

**Consequence rationale.** Driving dimension performance_margin 3: a Baseline requirement missed where a CR is acceptable.

**Mitigation steps**

| Step | Action | Artifact | Due | Status |
|---|---|---|---|---|
| S1 | Analysis cases for the thermal budget at +45 C, the reference drift over -10 to +45 C and the charger window, cited by REQ-SYS-114 and REQ-SYS-115. | docs/design/analysis/thermal-budget.md; docs/design/budgets.md | PDR | Planned |
| S2 | Optional owner freezer and warm-room soak of one unit with a receive and transmit check, recorded as supporting Bench evidence. | docs/vv/reports/environment-soak-<n>.md | SAR | Planned |

**Triggers**

| Condition | Response |
|---|---|
| An analysis shows margin below 3 C at either operating extreme | Claude proposes a soak test or a narrower operating range to the owner at the next gate |

**Fallback.** Narrow the stated operating range in the handbook by CR.

**Related.** requirement: REQ-SYS-114, REQ-SYS-115, REQ-SYS-116, REQ-SYS-117; tpm: TPM-006; stakeholder input: SI-001; risk: RSK-006

**Closure criteria.** REQ-SYS-114 to REQ-SYS-117 closed by their baselined methods.

**History**

| Date | Review | L | C | Safety | Score | Status | Note |
|---|---|---|---|---|---|---|---|
| 2026-09-25 | SRR | 3 | 3 | 1 | 9 | Proposed | Entered at the SRR research candidate pass (06 section 9, Identify) during SRR package assembly; awaiting the independent check of docs/reviews/SRR/checklists/risk-register.md. |
| 2026-09-27 | SRR | 3 | 3 | 1 | 9 | Open | Track pass 2026-09-27 (docs/plan/pdr-work-plan.md WP-PDR-18 wave 0; 06 section 9 Track and Control; INSP-007 finding-18, docs/reviews/SRR/checklists/risk-register-06.md), recorded at review point SRR, the last gate passed (06 section 10.3); the PDR Track pass of 06 section 10 item 1 follows at PDR package assembly. Status Proposed to Open: INSP-007 (APPROVED; item CK-RSK-A2) records the Analyze check passing all 65 risks (06 section 9 transition table). Likelihood and consequence unchanged: no analysis, test, trigger poll or SRR ruling since the SRR Track pass changes this risk's evidence. |

### RSK-015

**Wrong or corrupt firmware image or configuration accepted at boot**

Given firmware is loaded over the Pico 2 micro-USB bootrom loader (SI-022, ADR-004) by anyone with physical possession of the unit, including friends who receive units (SI-019); persisted configuration and calibration are read from flash at boot; the RP2350 bootrom accepts any UF2 and secure boot is not enabled in Rev A unless the owner decides otherwise at PDR (07 section 16.2), there is a possibility of a wrong, tampered or corrupt image, or a corrupt or maliciously written configuration, being accepted at boot and driving keying, PA enable or frequency outside the limits adversely impacting the SW-BOOT and SW-CFG load path, the TX subsystem and the regulatory compliance of the licensee (SI-014), leading to unsafe keying or an out-of-band or over-power emission, and a unit that a friend cannot trust after flashing.

| Field | Value |
|---|---|
| Category | software (tags: cyber) |
| Likelihood | 2 (Unlikely) |
| Consequence by dimension | Safety 4 / First power-on 2 / Cost 1 / Schedule 2 / Performance margin 4 |
| Consequence (max) | 4 (Major); driving: Safety, Performance margin |
| Score / band | 8 / Yellow |
| Assessment confidence | Medium |
| Status / trend | Mitigating / Stable |
| Owner | Claude |
| Opened / horizon | 2026-09-25 / Ops |
| Last assessed | 2026-09-27 (SRR) |
| Source | 07 section 16.2 rows 'Firmware image integrity' and 'Persisted configuration and calibration' (residual cybersecurity risks tagged cyber); SEMP section 7.1 hazard scope (USB firmware load that leaves the unit in an unsafe state); opened 2026-09-25; plan candidates SEP16-IMG, SEP16-CFG and SEP21-IMG (SRR plan-table pass 2026-09-25) |
| Strategy | Mitigate |

**Likelihood rationale.** Band argument (06 section 6 case (c), a threat and procedure risk; the anchors 1 and 2 are not reachable before a TV record and a delivered-unit Test): the departure needs two events, a wrong or corrupt image or configuration presented at boot, which needs physical possession or an owner flashing error outside the release procedure that flashes only files from firmware/releases/ with picotool verify (07 section 16.2), and the boot checks (image CRC-32 trailer, two-copy CRC configuration with range checks) missing it; 07 section 16.2 assesses L2 (5 % to 20 %). Level 2, confidence Medium, until the SWE-193 cases pass on a credited run.

**Consequence rationale.** Driving dimensions performance_margin and safety at 4: the regulatory rule of process section 7 (an out-of-band or over-power emission could breach 47 CFR 97.305 or 97.307), and HZ-014 (firmware load leaving the radio in an unsafe state) is Critical, which maps to register safety 4. first_power_on 2: a wrong image at first power-on is corrected by reflashing.

**Mitigation steps**

| Step | Action | Artifact | Due | Status |
|---|---|---|---|---|
| S1 | Hazard analysis entry for a USB firmware load or configuration load that leaves the unit in an unsafe state, with causes, controls and verification; the entry names this risk in related_risk_ids. | docs/safety/hazards.json (HZ-NNN); docs/safety/hazard-analysis.md | SRR | Done (docs/safety/hazards.json HZ-014; docs/safety/hazard-analysis.md section 12) |
| S2 | Requirements: image CRC-32 trailer verified at boot before any safety-critical output, known safe state (PA disabled, TX inhibited) with a fault code on failure (SWE-134 a); configuration in two copies with CRC-32 and sequence number, field range checks, defaults on double failure, event logged. | docs/requirements/sw/sw-boot/requirements.json; docs/requirements/sw/sw-cfg/requirements.json | PDR | Planned |
| S3 | Loaded code and data acceptance cases (SWE-193; 04 section 11): valid image accepted and reported by version and hash; corrupt, truncated or wrong-target image rejected with the safe state; nominal configuration restored; out-of-range or corrupt configuration replaced by defaults; run in Emulation or HostUnit for credit before CDR closes and repeated on the Bench on every unit. | docs/test_cases/sw-boot/test_cases.json; docs/test_cases/sw-cfg/test_cases.json | CDR | Planned |
| S4 | ADR at PDR on RP2350 secure boot (signed images, irreversible OTP): evaluated and not enabled in Rev A unless the owner decides otherwise, because it cannot be undone (07 section 16.2). | docs/decisions/adr/ADR-NNN-secure-boot.md | PDR | Planned |
| S5 | Operations handbook flashing procedure: only files from firmware/releases/ are flashed, picotool verify after every flash against the hash published in the version description, and the safe-state fault code explained. | docs/ops/operations-handbook.md; firmware/releases/VDD-<version>.md | SAR | Planned |

**Triggers**

| Condition | Response |
|---|---|
| Any off-nominal TC-SW-BOOT or TC-SW-CFG case fails on a release candidate | The release is not tagged (04 section 10.5); Claude opens an NCR and the case is re-run on the fix |
| The owner decides to enable secure boot | Claude opens a CR covering the signing key custody, the OTP procedure in the handbook and the ATP cases before any unit is programmed |

**Fallback.** Units delivered to friends with the SWD pads closed by the enclosure and flashing restricted to the owner per the operations handbook; configuration defaults restored on any CRC failure so that the radio always starts in the safe state.

**Related.** hazard: HZ-014; adr: ADR-004, ADR-014, ADR-015; trade study: TS-002; stakeholder input: SI-014, SI-019, SI-022; risk: RSK-012, RSK-021, RSK-022

**Closure criteria.** TC-SW-BOOT and TC-SW-CFG cases Passed on every delivered unit and the linked hazard's controls verified, with the residual accepted by the owner in the SAR decision memo.

**History**

| Date | Review | L | C | Safety | Score | Status | Note |
|---|---|---|---|---|---|---|---|
| 2026-09-25 | Pre-SRR | 2 | 4 | 4 | 8 | Proposed | Opened from 07 section 16.2 (residual cybersecurity risks tagged cyber); carries HZ-014 under the hazard link rule; awaiting independent check. |
| 2026-09-25 | Pre-SRR | 2 | 4 | 4 | 8 | Proposed | Independent review 2026-09-25: image and configuration acceptance kept as one safety family under process section 4 (same boot load path, HZ-014, same driving dimensions and plan); SWD debug access is RSK-022; S1 Done by the preliminary hazard analysis (HZ-014). Score unchanged. |
| 2026-09-25 | SRR | 2 | 4 | 4 | 8 | Proposed | SRR Track pass at package assembly 2026-09-25 (06 section 10 item 1): re-assessed against the SRR research candidate pass; likelihood and consequence unchanged; status stays Proposed until the independent check of docs/reviews/SRR/checklists/risk-register.md. |
| 2026-09-25 | SRR | 2 | 4 | 4 | 8 | Proposed | Likelihood rationale restated as a band argument after INSP-007 (docs/reviews/SRR/checklists/risk-register-06.md) finding F-12 (06 section 6 anchor-availability rule): no TV record and no delivered-unit Test exist at SRR, so anchor 1 or 2 is not claimed. Level unchanged. |
| 2026-09-25 | SRR | 2 | 4 | 4 | 8 | Proposed | INSP-007 (docs/reviews/SRR/checklists/risk-register-06.md) finding F-04: trade-study references corrected (TS-001 is receiver-and-pa-concept, TS-002 is firmware-runtime-make-buy; unwritten studies carry TS-NNN until created) and related.trade_study_ids set for the studies that name this risk. Score unchanged. |
| 2026-09-27 | SRR | 2 | 4 | 4 | 8 | Mitigating | Track pass 2026-09-27 (docs/plan/pdr-work-plan.md WP-PDR-18 wave 0; 06 section 9 Track and Control; INSP-007 finding-18, docs/reviews/SRR/checklists/risk-register-06.md), recorded at review point SRR, the last gate passed (06 section 10.3); the PDR Track pass of 06 section 10 item 1 follows at PDR package assembly. Status Proposed to Open: INSP-007 (APPROVED; item CK-RSK-A2) records the Analyze check passing all 65 risks (06 section 9 transition table). Then Open to Mitigating: step S1 Done (06 section 9 transition). Likelihood and consequence unchanged: no analysis, test, trigger poll or SRR ruling since the SRR Track pass changes this risk's evidence. |

### RSK-023

**rustos upstream change breaks cwht firmware undetected**

Given cwht firmware depends on rustos, which the owner develops as its single maintainer (SI-033, ADR-019); the thirteen driver work packages of 07 section 19 (WP-SW-13 optional) are developed upstream in rustos; no api contract test suite and no pinned-commit rule are in place yet (07 section 21 row 'Single maintainer of rustos'), there is a possibility of a rustos core or driver change made for another purpose altering an api trait or driver behavior that cwht relies on without the change being detected before a cwht release adversely impacting the SW subsystem and the cwht release baseline, leading to a regression in keying, sequencing or charging supervision found late, a release re-tagged after the fix, and verification evidence invalidated for the affected modules.

| Field | Value |
|---|---|
| Category | software |
| Likelihood | 4 (Likely) |
| Consequence by dimension | Safety 2 / First power-on 2 / Cost 1 / Schedule 2 / Performance margin 2 |
| Consequence (max) | 2 (Minor); driving: Safety, First power-on, Schedule, Performance margin |
| Score / band | 8 / Yellow |
| Assessment confidence | Medium |
| Status / trend | Open / Stable |
| Owner | Claude |
| Opened / horizon | 2026-09-25 / SAR |
| Last assessed | 2026-09-27 (SRR) |
| Source | 07 section 21 row 'Single maintainer of rustos', separated from RSK-013 on 2026-09-25 after independent review (an upstream change breaking cwht is a different departure from a driver not demonstrated by CDR, process section 4); plan candidate SEP21-MAINT (SRR plan-table pass 2026-09-25) |
| Strategy | Mitigate |

**Likelihood rationale.** The owner changes rustos for other projects, and the detection mechanism (pinned commit plus contract tests) is planned but not in place. Anchor level 4: a known deficiency without a mitigation in progress.

**Consequence rationale.** Driving dimensions at 2: the safe-state manager and hardware interlocks bound a regression in a safety function (safety 2), and the fix is a firmware change, a re-run of the affected cases and a reflash within 1 to 3 weeks.

**Mitigation steps**

| Step | Action | Artifact | Due | Status |
|---|---|---|---|---|
| S1 | Pin the rustos commit in firmware/Cargo.toml and in every version description, and run the rustos api contract tests on every rustos change so that an upstream change cannot silently break cwht (07 section 21; moved from RSK-013 S4). | firmware/Cargo.toml; firmware/releases/VDD-<version>.md; firmware/cwht-core/ contract tests | CDR | Planned |
| S2 | List rustos in the third-party software register with the pinned commit and the owner-review record (07 section 17.1). | docs/process/07-software-engineering-plan.md section 17.1 register; firmware/THIRD-PARTY-NOTICES.md | PDR | Planned |

**Triggers**

| Condition | Response |
|---|---|
| A rustos core change fails the contract tests | Claude opens an NCR with cots_assessment_required (07 section 12) and holds the pinned commit until it is fixed |
| A cwht release candidate is built against a rustos commit other than the pinned one | The release is not tagged (04 section 10.5); Claude rebuilds against the pinned commit |

**Fallback.** Hold cwht on the last rustos commit that passed the contract tests and back-port only the fixes cwht needs, recorded by ADR.

**Related.** adr: ADR-019; trade study: TS-002; stakeholder input: SI-033; risk: RSK-013

**Closure criteria.** Contract tests run on every rustos change through SAR with the pinned commit recorded in every VDD, and no NCR attributable to an unpinned rustos change.

**History**

| Date | Review | L | C | Safety | Score | Status | Note |
|---|---|---|---|---|---|---|---|
| 2026-09-25 | Pre-SRR | 4 | 2 | 2 | 8 | Proposed | Opened from 07 section 21 (separated from RSK-013) after independent review; awaiting independent check. |
| 2026-09-25 | SRR | 4 | 2 | 2 | 8 | Proposed | SRR Track pass at package assembly 2026-09-25 (06 section 10 item 1): re-assessed against the SRR research candidate pass; likelihood and consequence unchanged; status stays Proposed until the independent check of docs/reviews/SRR/checklists/risk-register.md. |
| 2026-09-25 | SRR | 4 | 2 | 2 | 8 | Proposed | Condition restated after INSP-007 (docs/reviews/SRR/checklists/risk-register-06.md) finding F-06 (07 section 19 has WP-SW-01 to WP-SW-13). Score unchanged. |
| 2026-09-25 | SRR | 4 | 2 | 2 | 8 | Proposed | INSP-007 (docs/reviews/SRR/checklists/risk-register-06.md) finding F-04: trade-study references corrected (TS-001 is receiver-and-pa-concept, TS-002 is firmware-runtime-make-buy; unwritten studies carry TS-NNN until created) and related.trade_study_ids set for the studies that name this risk. Score unchanged. |
| 2026-09-27 | SRR | 4 | 2 | 2 | 8 | Open | Track pass 2026-09-27 (docs/plan/pdr-work-plan.md WP-PDR-18 wave 0; 06 section 9 Track and Control; INSP-007 finding-18, docs/reviews/SRR/checklists/risk-register-06.md), recorded at review point SRR, the last gate passed (06 section 10.3); the PDR Track pass of 06 section 10 item 1 follows at PDR package assembly. Status Proposed to Open: INSP-007 (APPROVED; item CK-RSK-A2) records the Analyze check passing all 65 risks (06 section 9 transition table). Likelihood and consequence unchanged: no analysis, test, trigger poll or SRR ruling since the SRR Track pass changes this risk's evidence. |

### RSK-041

**Audible clicks when the synthesizer is retuned**

Given synthesizer drivers that reset the PLL or output dividers on every frequency write produce audible clicks while tuning (docs/research/audio-output-and-hearing-safety.md F11, R-AUD-6); the synthesizer is chosen at PDR by the synthesizer study (TS-NNN, ADR-013; SI-029); tuning is by a detented encoder with a rate-dependent step (SI-006, REQ-SYS-058) and REQ-SYS-076 bounds headphone transients, there is a possibility of audible clicks or pops in the headphones on tuning steps or band-edge jumps adversely impacting SW-SYNTH driver and the receive audio (operator experience), leading to an annoying tuning feel against the HSI goals and REQ-SYS-076, or driver rework after the first development-board run.

| Field | Value |
|---|---|
| Category | technical (tags: software, hsi) |
| Likelihood | 4 (Likely) |
| Consequence by dimension | Safety 1 / First power-on 1 / Cost 1 / Schedule 2 / Performance margin 2 |
| Consequence (max) | 2 (Minor); driving: Schedule, Performance margin |
| Score / band | 8 / Yellow |
| Assessment confidence | Medium |
| Status / trend | Open / Stable |
| Owner | Claude |
| Opened / horizon | 2026-09-25 / SAR |
| Last assessed | 2026-09-27 (SRR) |
| Source | SRR research candidate pass 2026-09-25: candidate R-AUD-6 (docs/research/audio-output-and-hearing-safety.md Risks) entered |
| Strategy | Mitigate |

**Likelihood rationale.** Anchor level 4 (no analysis yet): the behaviour is documented for common synthesizer drivers and no driver has been designed yet. 06 section 6 case (a): a design-analysis risk takes the anchor its facts meet.

**Consequence rationale.** Driving dimensions schedule and performance_margin at 2: a transient requirement met only after a firmware iteration.

**Mitigation steps**

| Step | Action | Artifact | Due | Status |
|---|---|---|---|---|
| S1 | Score tuning-click behaviour (glitch-free frequency update without PLL reset, or audio mute across the write) as a criterion of the synthesizer study (TS-NNN, ADR-013). | docs/decisions/trade-studies/TS-NNN-synthesizer.md (ADR-013 study; number assigned at creation) | PDR | Planned |
| S2 | SW-SYNTH requirement: frequency writes within one PLL band do not reset the PLL, and audio is ramped down and up around any write that must reset it. | docs/requirements/sw/sw-synth/requirements.json | PDR | Planned |
| S3 | Development-board listening check while tuning at every encoder rate. | docs/test_cases/sw-synth/test_cases.json | CDR | Planned |

**Triggers**

| Condition | Response |
|---|---|
| The listening check hears a click on single-step tuning | Claude adds the mute-around-write ramp and re-runs the check before TRR |

**Fallback.** Mute receive audio with a raised-cosine ramp around every synthesizer write.

**Related.** requirement: REQ-SYS-058, REQ-SYS-076; adr: ADR-013; stakeholder input: SI-006, SI-029; risk: RSK-035

**Closure criteria.** REQ-SYS-076 verified with tuning at every encoder rate on the delivered unit.

**History**

| Date | Review | L | C | Safety | Score | Status | Note |
|---|---|---|---|---|---|---|---|
| 2026-09-25 | SRR | 3 | 2 | 1 | 6 | Proposed | Entered at the SRR research candidate pass (06 section 9, Identify) during SRR package assembly; awaiting the independent check of docs/reviews/SRR/checklists/risk-register.md. |
| 2026-09-25 | SRR | 4 | 2 | 1 | 8 | Proposed | Re-levelled 3 to 4 after INSP-007 (docs/reviews/SRR/checklists/risk-register-06.md) finding F-02: the recorded level disagreed with the 06 section 6 anchor the rationale itself describes; score 6 to 8. |
| 2026-09-25 | SRR | 4 | 2 | 1 | 8 | Proposed | INSP-007 (docs/reviews/SRR/checklists/risk-register-06.md) finding F-04: trade-study references corrected (TS-001 is receiver-and-pa-concept, TS-002 is firmware-runtime-make-buy; unwritten studies carry TS-NNN until created) and related.trade_study_ids set for the studies that name this risk. Score unchanged. |
| 2026-09-27 | SRR | 4 | 2 | 1 | 8 | Open | Track pass 2026-09-27 (docs/plan/pdr-work-plan.md WP-PDR-18 wave 0; 06 section 9 Track and Control; INSP-007 finding-18, docs/reviews/SRR/checklists/risk-register-06.md), recorded at review point SRR, the last gate passed (06 section 10.3); the PDR Track pass of 06 section 10 item 1 follows at PDR package assembly. Status Proposed to Open: INSP-007 (APPROVED; item CK-RSK-A2) records the Analyze check passing all 65 risks (06 section 9 transition table). Likelihood and consequence unchanged: no analysis, test, trigger poll or SRR ruling since the SRR Track pass changes this risk's evidence. |

### RSK-020

**Upstream rustc miscompiles a safety-critical construct for Cortex-M33**

Given the firmware is built with upstream stable rustc 1.98.0 installed by rustup (tools/toolchain.lock.md), which has no safety qualification for thumbv8m.main-none-eabihf; Rev A accredits it by known-answer tests, a reproducible rebuild and the emulation scenario set (07 section 17.3); Ferrocene is an option not adopted, and its Cortex-M33 target is Supported, not Qualified (07 section 8.1); HostUnit tests run on the host target, not on the RP2350, there is a possibility of a compiler or linker defect producing object code for a safety-critical function that differs from the source semantics without an accreditation test, an emulation scenario or a Bench case detecting it adversely impacting the SW release image and the safety-critical components of 07 section 14.1, leading to a latent fault in keying, PA enable or charging supervision on the delivered unit that the host tests cannot see.

| Field | Value |
|---|---|
| Category | software |
| Likelihood | 2 (Unlikely) |
| Consequence by dimension | Safety 3 / First power-on 2 / Cost 1 / Schedule 2 / Performance margin 2 |
| Consequence (max) | 3 (Moderate); driving: Safety |
| Score / band | 6 / Yellow |
| Assessment confidence | Medium |
| Status / trend | Open / Stable |
| Owner | Claude |
| Opened / horizon | 2026-09-25 / SAR |
| Last assessed | 2026-09-27 (SRR) |
| Source | 07 section 21 row 'Toolchain not qualified'; opened 2026-09-25 by the software lead after independent review; plan candidate SEP21-TOOL (SRR plan-table pass 2026-09-25) |
| Strategy | Mitigate |

**Likelihood rationale.** Band argument (06 section 6 case (c), a toolchain and process risk that no design analysis bounds): upstream rustc is heavily used on Cortex-M and codegen defects on correct safe code are rare, and Bench tests of every hazard-tracing requirement exercise the target code (07 section 9.7). Level 2 (5 % to 20 %), confidence Medium; the accreditation by tests with a TV record (07 section 17.3) is the evidence that would support anchor 2.

**Consequence rationale.** Driving dimension safety 3: a miscompiled PA-enable or charging decision can destroy the unit, while the hardware interlocks (HZ-004 K5, HZ-002 controls) keep it below 4. first_power_on 2: the fix is a toolchain pin change or a source rewrite and a reflash.

**Mitigation steps**

| Step | Action | Artifact | Due | Status |
|---|---|---|---|---|
| S1 | Accredit the pinned rustc by the known-answer tests of 07 section 8.3, the reproducible rebuild (MSR-28) and the emulation scenario set on the release image (07 section 17.3). | docs/cm/tool-validation/TV-NNN-rustc.md; tools/toolchain.lock.md | PDR | Planned |
| S2 | Record the Ferrocene option with its target-tier facts in the toolchain accreditation ADR (07 section 17.3). | docs/decisions/adr/ADR-NNN-toolchain-accreditation.md | PDR | Planned |
| S3 | Verify every hazard-tracing SW requirement by Test on the delivered unit (SWE-192) so that the target code, not only the host build, is exercised. | docs/test_cases/sw-*/test_cases.json (Bench cases of the safety-critical modules) | SAR | Planned |

**Triggers**

| Condition | Response |
|---|---|
| A rustc release note or issue reports a miscompilation for thumbv8m or for a construct cwht uses | Claude assesses the affected code the same session, opens an NCR if cwht is affected and re-assesses this risk |
| A Bench case of a safety-critical function fails while its HostUnit case passes | Claude opens an NCR and inspects the generated code of the function before changing the source |

**Fallback.** Change the pinned toolchain version by CR (05 section 9.2 step 5) with a new TV record, or rewrite the affected construct in a form the accreditation tests cover.

**Related.** adr: ADR-011; trade study: TS-002; risk: RSK-010

**Closure criteria.** TV record for rustc accredited by the owner and every hazard-tracing SW requirement verified by Test on the delivered unit.

**History**

| Date | Review | L | C | Safety | Score | Status | Note |
|---|---|---|---|---|---|---|---|
| 2026-09-25 | Pre-SRR | 2 | 3 | 3 | 6 | Proposed | Opened from 07 section 21 after independent review; awaiting independent check. |
| 2026-09-25 | SRR | 2 | 3 | 3 | 6 | Proposed | SRR Track pass at package assembly 2026-09-25 (06 section 10 item 1): re-assessed against the SRR research candidate pass; likelihood and consequence unchanged; status stays Proposed until the independent check of docs/reviews/SRR/checklists/risk-register.md. |
| 2026-09-25 | SRR | 2 | 3 | 3 | 6 | Proposed | Likelihood rationale restated as a band argument after INSP-007 (docs/reviews/SRR/checklists/risk-register-06.md) finding F-12 (06 section 6 anchor-availability rule): no TV record and no delivered-unit Test exist at SRR, so anchor 1 or 2 is not claimed. Level unchanged. |
| 2026-09-25 | SRR | 2 | 3 | 3 | 6 | Proposed | INSP-007 (docs/reviews/SRR/checklists/risk-register-06.md) finding F-04: trade-study references corrected (TS-001 is receiver-and-pa-concept, TS-002 is firmware-runtime-make-buy; unwritten studies carry TS-NNN until created) and related.trade_study_ids set for the studies that name this risk. Score unchanged. |
| 2026-09-27 | SRR | 2 | 3 | 3 | 6 | Open | Track pass 2026-09-27 (docs/plan/pdr-work-plan.md WP-PDR-18 wave 0; 06 section 9 Track and Control; INSP-007 finding-18, docs/reviews/SRR/checklists/risk-register-06.md), recorded at review point SRR, the last gate passed (06 section 10.3); the PDR Track pass of 06 section 10 item 1 follows at PDR package assembly. Status Proposed to Open: INSP-007 (APPROVED; item CK-RSK-A2) records the Analyze check passing all 65 risks (06 section 9 transition table). Likelihood and consequence unchanged: no analysis, test, trigger poll or SRR ruling since the SRR Track pass changes this risk's evidence. |

### RSK-019

**Complexity tool mis-measures cyclomatic complexity of Rust 2024 code**

Given SWE-220 limits the cyclomatic complexity of safety-critical components to 15 (charter section 10), measured by rust-code-analysis-cli 0.0.25, whose last crates.io release is 2023-01-13, before Rust 2024 syntax (07 section 8.1); the tool is not installed yet and has no tool validation record (tools/toolchain.lock.md), there is a possibility of rust-code-analysis-cli mis-parsing or mis-counting Rust 2024 constructs so that a safety-critical function with cyclomatic complexity above 15 passes the complexity gate adversely impacting SW verification evidence for SWE-220 and the MC/DC tables that rely on small decisions (RSK-010), leading to a SWE-220 non-compliance found late, re-measurement and refactoring of safety-critical functions, and weaker MC/DC tables.

| Field | Value |
|---|---|
| Category | software |
| Likelihood | 3 (Possible) |
| Consequence by dimension | Safety 2 / First power-on 1 / Cost 1 / Schedule 2 / Performance margin 2 |
| Consequence (max) | 2 (Minor); driving: Safety, Schedule, Performance margin |
| Score / band | 6 / Yellow |
| Assessment confidence | Medium |
| Status / trend | Open / Stable |
| Owner | Claude |
| Opened / horizon | 2026-09-25 / TRR |
| Last assessed | 2026-09-27 (SRR) |
| Source | 07 section 21 row 'Complexity tool staleness'; opened 2026-09-25 by the software lead after independent review; plan candidate SEP21-CPLX (SRR plan-table pass 2026-09-25) |
| Strategy | Mitigate |

**Likelihood rationale.** A stale release parsing a newer edition is plausible; accreditation on hand-computed reference functions is planned but not run. Anchor level 3: the tool exists but its fidelity is unconfirmed.

**Consequence rationale.** Driving dimensions safety, schedule and performance_margin at 2: a missed complexity limit weakens the MC/DC showing for a safety-critical decision but the hardware interlocks bound the effect; refactoring and re-review cost 1 to 3 weeks.

**Mitigation steps**

| Step | Action | Artifact | Due | Status |
|---|---|---|---|---|
| S1 | Install rust-code-analysis-cli in FW-B0 and accredit it: CC values equal hand-computed values for five reference functions (CC 1, 2, 5, 15, 16) that include Rust 2024 constructs used in cwht; record the known-answer test (07 section 8.3). | docs/cm/tool-validation/TV-NNN-rust-code-analysis.md; tools/toolchain.lock.md; tools/tests/fixtures/rust/ | CDR | Planned |
| S2 | Cross-check with clippy cognitive_complexity on every safety-critical function and review every disagreement in the code peer review (07 section 21). | tools/sw_gate.sh gate G5 log filed under docs/reviews/CDR/ | CDR | Planned |

**Triggers**

| Condition | Response |
|---|---|
| The accreditation run disagrees with a hand-computed value or fails to parse a cwht source file | Claude invokes the fallback and records the decision by ADR at CDR (07 section 21) |
| cwht adopts a Rust syntax the reference set does not contain | Claude adds a reference function using it and re-runs S1 before the code is merged |

**Fallback.** A project script over syn computes cyclomatic complexity, accredited on the same reference set (decision at CDR, 07 section 21).

**Related.** risk: RSK-010

**Closure criteria.** rust-code-analysis-cli or the fallback script accredited with its TV record, and the SWE-220 measure of every safety-critical function recorded in the TRR coverage report.

**History**

| Date | Review | L | C | Safety | Score | Status | Note |
|---|---|---|---|---|---|---|---|
| 2026-09-25 | Pre-SRR | 3 | 2 | 2 | 6 | Proposed | Opened from 07 section 21 after independent review; awaiting independent check. |
| 2026-09-25 | SRR | 3 | 2 | 2 | 6 | Proposed | SRR Track pass at package assembly 2026-09-25 (06 section 10 item 1): re-assessed against the SRR research candidate pass; likelihood and consequence unchanged; status stays Proposed until the independent check of docs/reviews/SRR/checklists/risk-register.md. |
| 2026-09-27 | SRR | 3 | 2 | 2 | 6 | Open | Track pass 2026-09-27 (docs/plan/pdr-work-plan.md WP-PDR-18 wave 0; 06 section 9 Track and Control; INSP-007 finding-18, docs/reviews/SRR/checklists/risk-register-06.md), recorded at review point SRR, the last gate passed (06 section 10.3); the PDR Track pass of 06 section 10 item 1 follows at PDR package assembly. Status Proposed to Open: INSP-007 (APPROVED; item CK-RSK-A2) records the Analyze check passing all 65 risks (06 section 9 transition table). Likelihood and consequence unchanged: no analysis, test, trigger poll or SRR ruling since the SRR Track pass changes this risk's evidence. |
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
