robinonsay/cwht/docs/safety/hazard-analysis.md

# cwht Hazard Analysis (preliminary, for SRR)

**Status:** Preliminary Hazard Analysis (PHA) for SRR, revision 0.5.0-pha (2026-09-26, the owner's SRR rulings applied; see the last sentence of this paragraph); SWEHB 5.24 safety phases 0 and 1 combined. **Owner:** Robin (Decision Authority, SMA Technical Authority, risk acceptance authority). **Author:** Claude (system safety engineer role, lead systems engineer). **Independent review:** required before SRR by a reviewer agent that did not author this analysis (charter section 2; section 11 rule 4); the reviewer's concurrence with the safety-critical determination of section 6 is filed in `docs/reviews/SRR/` (03 section 3.3). The first independent review (2026-09-25) raised 21 findings (10 Major, 11 Minor); revision 0.2.0-pha applied them (section 13) and carries every request it cannot settle itself as an open question `OQ-SAF-NNN` in `hazards.json` (section 11.2). Revision 0.3.0-pha (2026-09-25) closes the hazard-analysis part of SRR readiness items H7, H8 and H9 (`docs/reviews/SRR/package.md` section 2): the 17 open questions due at SRR are reconciled against package section 18.1 (two closed, the others Open with the remaining action, its owner and the package decision it waits on; section 11.2); the new L1 requirements REQ-SYS-180, REQ-SYS-181 and REQ-SYS-182 are traced as the controls HZ-004 K12, HZ-003 K9 and HZ-008 K7, with the residual that holds if the owner declines them (section 8.3); HZ-015 names RSK-034; and every tune-carrier text quotes the current REQ-SYS-020. Revision 0.4.0-pha (2026-09-25) applies the independent review record `docs/reviews/SRR/checklists/hazard-analysis.md` (INSP-008, 3 Major and 10 Minor findings): the 40 L2 back-links are added to the controls so that `HAZARD_INVERSE` reads 0 (section 9 item 1); HZ-007 and HZ-010 name their Software causes; the section 8.1 item 7 exception table lists every Analysis-closing control requirement; the section 8.2 list carries all 23 `single_point_failures` entries; HZ-015 K1 is split into equipment and practice and its residual is stated against section 3.4; and a bench rule for USB power is added (section 10). Section 13 lists the changes finding by finding. Revision 0.4.1-pha (2026-09-26, SRR package item R9) changes only open-question statuses: OQ-SAF-017 and OQ-SAF-020 are Closed against the committed products (section 11.2), and the REQ-SYS-122 verification-note refinement is carried to OQ-SAF-019 (PDR); no hazard, control, severity, likelihood, residual, firmware-role criterion, component or SWE-134 item changed. Revision 0.4.2-pha (2026-09-26, ConOps appendix D items D6 and D10, SRR package items H6 and R14) corrects two texts against the committed L1 requirements: HZ-004 K2 now states that the Straight-on-tip selection is accepted while the KEY inhibit is active (REQ-SYS-163) and that the REQ-SYS-052 interlock then re-runs on the newly used inputs, and section 7 rows c and l limit the full safe state (with mute and charge disable) to resets, panics, latched faults and power-down, with the key-down timeouts and other Inhibit-class causes applying the transmit part only (REQ-SYS-130); no control_req_ids, severity, likelihood, residual, firmware-role criterion, component or SWE-134 item changed. Revision 0.5.0-pha (2026-09-26, SRR package item R16) applies the owner's SRR rulings (`docs/reviews/SRR/minutes.md`; `docs/reviews/SRR/decision-memo.md`; every key and consent-agenda decision ruled as recommended): the controls, residual conditions, single point failures and fault tolerance statements that waited on package decisions 9, 17 to 20, 22, 23, 25, 33, 36 to 42, 44, 47 and 70 to 76 state the rulings; the decline cases of section 8.3 no longer apply; frequency control and the frequency verification unit are safety-critical (decision 9); the accumulator is a convenience function (decision 33); the band-edge guard is 1.2 kHz (decision 25); the requirements the rulings ordered, written by the requirements author at `cd61450` (REQ-SYS-184 squeeze limit, REQ-SYS-185 4.30 V layer, REQ-SYS-186 separate sense paths, REQ-SYS-187 to 190 bench test-mode guard, and the reworded REQ-SYS-054), are traced to HZ-004 K4 and K13, HZ-002 K3 and K9, HZ-005 K9, HZ-007 K3 and the stuck-key shares, with REQ-SW-KEYER-039 (decision 112) in HZ-004 K2 and K13, so `HAZARD_INVERSE` reads 0 again; OQ-SAF-003, 005, 012 and 013 are Closed, OQ-SAF-001, 002, 006, 008, 009 and 016 Answered; OQ-SAF-027 is raised (the debounce exposure of decision 48). By the section 3.5 rule HZ-002 moves from Catastrophic-D, Serious to Catastrophic-E, Medium now that K3 and K9 have requirements; no other residual level and no severity, likelihood or initial risk changed; the firmware-role criteria and components are unchanged except that the word proposed is removed from the HZ-008 components (section 13). `docs/plan/semp.md` section 7.1 (System Safety) governs this analysis and fixes its scope. It expands charter section 5 (`docs/safety/hazard-analysis.md`, `docs/safety/hazards.json`), section 6 (`HZ-NNN`), section 7 (hazards trace to requirements and to verification), section 9 (verification methods and evidence classes) and section 10 (SWE-134 a to l applied to keying, PA enable, charging and thermal control). It is the hazard analysis that the safety-critical determination of `docs/process/03-software-classification-and-rmm.md` section 4 must be "determined by and traceable to" (SWE-205; NASA-STD-8739.8B para 3.2 as reproduced in `docs/references/md/swehb/7-02-classification-and-safety-criticality.md` section 1.2). It supplies the hazard side of the SWE-052 trace (software requirements to hazards, `docs/process/02-requirements-and-traceability.md` section 7 row 2), the safety constraints between hardware, operator and software that SWE-184 requires in the software requirements, and the list of hazard-tracing requirements that SWE-192 requires to be verified by Test. Review use: SRR entrance rows 14 and 15 of `docs/process/01-lifecycle-and-reviews.md` (preliminary safety analysis and safety-critical determination; single point failure and fault tolerance philosophy; NPR 7123.1D App. G Table G-4), PDR rows 10 and 11 (controls allocated; single point failure list; Table G-6), CDR rows 18 and 21 (verifications assigned; Table G-7) and TRR row 7 (test safety planning; Table G-10).

**Data file.** `docs/safety/hazards.json` is the source of record for every hazard and for the open questions this analysis raises; this document narrates the method, summarizes the list, records the determinations and the philosophy, and carries the items that are not per-hazard data. Schema: `docs/safety/schema.json`. Validation: `.venv/bin/python tools/validate_docs.py` from the repository root (convention `hazards`: `docs/safety/hazards.json` against `docs/safety/schema.json`; passes at this revision). `tools/traceability.py` also validates the file (`SCHEMA_INVALID`), reads `id`, `title`, `requirement_ids` and each control's `control_req_ids`, and reports the hazard trace in section 9 of `docs/vv/traceability-report.md`.

**Writing convention.** No em dashes. Numbers carry units and, where they are proposals, a TBR with a closing gate; since 0.5.0-pha a value the owner ruled at SRR names its package decision ("adopted at SRR, package decision N"), and the tag "Proposed, owner decision pending at SRR" survives only in dated history entries. Research reports are cited as `docs/research/<file>.md F<n>`; regulation as `47 CFR <section>, eCFR 2026-09-23` from `docs/references/md/regulatory/`. Statements that rest on general engineering knowledge outside the corpus say so.

---

## 1. Purpose, scope and phase

This analysis identifies the hazards of the cwht radio as it will be built and operated, assesses each in the uncontrolled state, proposes the controls the design, the firmware, the operator and the documentation must provide, states the residual risk reachable with those controls, and determines which firmware components are safety-critical. It covers the life of at most five units (SI-035) in the hands of the owner and licensed friends (SI-019, SI-030), from the owner's hand assembly through bench test, on-air use, charging, storage and firmware update.

In scope, following the SEMP section 7.1 list item by item: RF exposure of the operator and of bystanders (HZ-001, HZ-006); RF burn from the antenna connector (HZ-012); PA and enclosure surface temperature (HZ-003); lithium-ion charging, over-discharge, short circuit and thermal runaway (HZ-002, HZ-007); hearing damage from headphone level and sidetone (HZ-005); unintended transmission from a keyer, sequencer or PA-enable fault, a stuck key or a wrong plug, including out-of-band or over-power emission (HZ-004, HZ-008); sharp enclosure edges (HZ-013); a USB firmware load or reset that leaves the unit unsafe (HZ-014); the owner's hand soldering: burns, fumes and damage to assembled parts (HZ-015). The analysis adds: harmonic and spurious emission into other services (HZ-008), antenna connector mechanics (HZ-009), ESD and RF pickup on the jacks (HZ-010), charging while transmitting (HZ-011) and the bench test modes of `docs/conops/conops.md` section 3.5.2 item 2 as causes of HZ-004 and HZ-005. Out of scope: mission-only failures (a dead receiver, a wrong frequency display) unless they contribute to a hazard above; these are mission-critical matters of 03 section 4.3 and the risk register. A wrong transmitted frequency is not mission-only: it is HZ-008 cause C7.

Phase: this is the SWEHB 5.24 Phase 0 and 1 delivery (introduction, all known hazards with causes, controls, risk). Phase 2 (approved controls with verification methods, controls allocated to `REQ-*` ids) is due at PDR and updated at CDR; Phase 3 (verifications performed) at TRR and SAR. Each phase re-runs the safety-critical determination (03 section 4.1 step 5).

## 2. System and operating context assumed

The assessment rests on the owner decisions and research baselines listed in the SRR brief, in particular: 5 W A1A on 144.000 to 148.000 MHz from a Pico 2 (RP2350) controller; a 2S pack of two user-replaceable 18650 cells in holders; the Pico 2 micro-USB for both programming and charging, with the transmitter inhibited by hardware whenever USB power is present and charging paused while the radio is switched on; power steps 0.5, 1, 2 and 5 W within +/-1 dB with a 1 W default; a 0.5 W tune carrier with a timeout (10 s in the research; at most 5.5 s (TBR) in REQ-SYS-020 on the 5 s +/-0.5 s proposal of this analysis, adopted at SRR as option a of package decision 36); a sequenced RF relay for semi break-in (SI-036); a harmonic low-pass filter at the antenna port after the T/R node; an SMA jack retained by the enclosure boss; headphones only, with a fixed hardware output ceiling; straight key and iambic paddle on one 3.5 mm TRS jack (SI-018, SI-034), keyer modes Straight, Iambic A (default), Iambic B, Ultimatic and Bug; PCBWay surface-mount assembly with the owner hand-soldering the through-hole parts (SI-031); all operators licensed (SI-030).

Operator model OPS-A (each licensed friend operates a loaned unit as their own station, own call sign; a licensee-settable receive-only guest lock with a two-step release exists) is assumed, as the owner ruled at SRR (package decisions 17 and 19); OPS-B units stay at 1 W until a dated owner record (decision 18). OPS-C (an unlicensed guest keying under supervision as a third party at the 0.5 W and 1 W steps, 47 CFR 97.115(b)(1), eCFR 2026-09-23; allowed by package decision 20) is treated as a covered misuse case, not a planned use (`docs/research/regulatory-corpus-and-operators.md` F4, F5). Postures assumed for exposure: nominal, radio on a surface or at waist level with the antenna base 20 cm or more from head and torso (mobile posture); off-nominal, handheld at the face (portable posture, SAR regime) (`docs/research/rf-exposure-evaluation.md` F1, F7).

Fleet horizon for likelihood: at most 5 units over about three years, taken as 15 unit-years.

## 3. Method

### 3.1 Identification

Hazards were collected from: the five candidate hazards assigned in 03 section 4.2 (HZ-001 to HZ-005, ids carried unchanged); the SEMP section 7.1 scope list; every stakeholder input SI-001 to SI-036; the RISK-candidate, HZ-candidate and DECISION-needed items of the research reports named in the sources of each hazard; the ConOps modes, scenarios and bench test modes; the risk register; the regulatory corpus; and the findings of the first independent review, which added the toggling key-stream causes of HZ-004, the out-of-band fundamental of HZ-008, the test-mode causes of HZ-004 and HZ-005 and hazard HZ-015. Two of the assigned hazards were split so that each hazard has one exposed population or one energy path: HZ-001 covers the operating licensee (occupational tier) and HZ-006 covers bystanders, household members and non-licensee holders (general population); HZ-002 covers the charging side and HZ-007 the discharge side of the lithium-ion pack, because the PA path bypasses the charger and its protections (`docs/research/power-tree-and-charging.md` F11).

Each hazard record holds (schema `docs/safety/schema.json`): the scenario, the exposed persons, the operating phases, the causes with their initiating domain, the worst credible effect with the quantities that set the severity, severity and likelihood in the uncontrolled state with rationale and confidence, the firmware role in the terms of the para 3.2 criteria, the SWE-134 items its firmware controls implement, the controls with type, allocation, independence from firmware, status and the `control_req_ids` that implement them, the union `requirement_ids` the traceability tool reads, the residual assessment with its condition, the verification note per control (evidence classes of charter section 9), single point failure candidates, the fault tolerance achieved, related risks, stakeholder inputs, pending owner decisions, sources and an append-only history. This is the SWEHB 5.24 minimum content (scenario, risk, controls with barriers and warnings, verifications). The file also holds `open_questions`, the requests this analysis makes of other authors.

### 3.2 Severity scale (operational)

Severity is the worst credible consequence of the hazard in the uncontrolled state. The four levels follow common system-safety practice (the four-severity by five-likelihood form of MIL-STD-882; that standard is not in the corpus and nothing here quotes it; the definitions are this project's own). The last column maps each level to the safety consequence dimension of the risk register (`docs/process/06-risk-and-decision-analysis.md` section 7) so that the risk written under the hazard link rule scores consistently.

| Severity | Operational definition | Register safety level |
|---|---|---|
| Catastrophic | Death or permanent disabling injury to any person; fire not contained to the unit; lithium-ion cell venting with flame or explosion | 5 |
| Critical | Injury requiring medical treatment (second-degree burn, permanent hearing threshold shift); fire or smoke contained to the unit; RF exposure of the operator above the 47 CFR 1.1310(b) occupational limit, or of a bystander, guest or household member above the 47 CFR 1.1310(c) general-population limit; harmful interference to a radionavigation or other safety service (47 CFR 97.3(a)(23)) | 4 |
| Marginal | First-aid injury (minor burn or cut, temporary hearing discomfort recovering within 24 h); destruction of the unit without fire; RF exposure of the operator above 50 percent of the 1.1310(b) occupational limit or of a bystander above 50 percent of the general-population limit; interference to another amateur station or a Part 97 emission violation without a safety-service victim | 3 (first aid) or 2 (discomfort) |
| Negligible | Discomfort or nuisance without injury: an audible click, a warm surface below 45 C, cosmetic damage, a receiver birdie | 1 |

Any exceedance of an FCC exposure limit, for any person, is Critical; the Marginal band covers only the loss of margin below the limit. 06 section 7 level 4 names RF exposure above the applicable FCC limit for the operator, a bystander or any other person, which is aligned with this rule (OQ-SAF-020 item 6, Closed at 0.4.1-pha).

### 3.3 Likelihood scale (operational)

Likelihood is assessed in the uncontrolled state (the baseline architecture without the listed controls) against the fleet horizon of section 2. The anchors are chosen so that a single common fault or a single common operator error is B, and two independent faults are E.

| Level | Name | Operational definition |
|---|---|---|
| A | Frequent | Expected every time the initiating condition occurs, more than once per unit-year, or inherent to normal operation without the control |
| B | Probable | Expected several times in the fleet life; a single common operator error or a single common component fault (contact bounce, a mono plug, an undeburred edge, mismatched cells, a wrong image flashed) is enough |
| C | Occasional | Expected about once in the fleet life; needs an uncommon operator action or a single component or firmware fault |
| D | Remote | Not expected in the fleet life but credible; needs a rare fault, or one fault plus an uncommon condition |
| E | Improbable | Needs two or more independent faults, or a fault plus a deliberate defeat of a control; assumed not to occur in the fleet life |

### 3.4 Risk matrix and required response

| Severity \ Likelihood | A | B | C | D | E |
|---|---|---|---|---|---|
| Catastrophic | High | High | High | Serious | Medium |
| Critical | High | High | Serious | Medium | Low |
| Marginal | Serious | Serious | Medium | Low | Low |
| Negligible | Medium | Medium | Low | Low | Low |

Two cells differ from the usual 882-style default: Marginal-D and Negligible-C are rated Low here, because Marginal is bounded to first aid and D is "not expected in the fleet life"; the schema enforces exactly this matrix for `initial_risk` and `residual_risk.level`.

| Level | Required response |
|---|---|
| High | Unacceptable as a residual. A design change or an additional independent control is required before PDR; a hazard still High at PDR is a Major RID (01 section 10.2), and a hazard without an allocated control requirement can never be a lien from PDR onward (01 section 12.2) |
| Serious | Acceptable as a residual only with owner acceptance recorded in a decision memo, at least two independent controls of which one is neither software nor procedure, and verification of every control by Test |
| Medium | Acceptable as a residual with the listed controls allocated to requirements and verified, and the owner's acceptance recorded at SAR; Claude manages; listed at every review |
| Low | Acceptable; controls documented, allocated and verified by the method assigned in the requirement; listed at every review |

### 3.5 Initial versus residual, pending requirements, and the risk register

`initial_risk` is the uncontrolled assessment. `residual_risk` is the level reachable when every control that has an implementing requirement is verified; its `condition` states what must be true for the level to hold. A control whose requirement does not yet exist carries the status **Requirement pending**: it is listed so that the owner sees the proposal, the missing requirement is requested in `open_questions`, and it does not count toward the residual until the requirement exists. The condition then states the level expected once the pending controls are allocated and verified. The residual is what the owner accepts at SAR. A control whose requirement exists but whose adoption is still an owner decision (status Proposed, the decision named in `decisions_pending` by its SRR package section 13.1 number) counts toward the residual like any other Proposed control; its condition also states the residual that holds if the owner declines it, when the decision memo retires the requirement and the control becomes Dropped. Section 8.3 lists these decline cases with the section 3.4 response each requires; at SRR the owner adopted every one of them (0.5.0-pha), so no decline case applies.

Under the hazard link rule (06 section 1), every hazard whose controls are not yet verified is carried by at least one risk in `docs/risk/register.json` whose `related.hazard_ids` names it, the hazard's `related_risk_ids` names that risk back, and the risk's safety consequence is at least the level its severity maps to. The risk closes when the controls are verified and the hazard record persists. Section 12 lists the links and the register actions still needed.

### 3.6 Owner decisions and TBRs

Where a control's number rests on a research proposal the owner has not yet decided, the control text says so and the hazard's `decisions_pending` names the decision (since the SRR rulings of 2026-09-26 only decisions due at PDR or later remain there, and a ruled control names its package decision) by its research id (RFX-D1, D-PWR-03, D-KN2 and so on) and, where the SRR package consolidates it, by its section 13.1 decision number (for example package decision 38). Where a number may change, the control carries a `tbr` object with owner, plan and closing gate: PDR for every number that an L1 requirement carries, including the debounce values of REQ-SYS-048 (charter section 7: L1 TBRs close by PDR), and CDR only for numbers that live solely in L2 requirements, mirroring the TBR policy of 02.

## 4. Hazard list

| ID | Hazard | Exposed | Severity | Likelihood | Initial | Residual (section 3.5) | Firmware role (para 3.2) | Related risks |
|---|---|---|---|---|---|---|---|---|
| HZ-001 | RF exposure of the operator in the portable posture (SAR within 20 cm) | Operator, household | Marginal | C | Medium | Marginal-E Low | b, c | RSK-016, RSK-030 |
| HZ-002 | Lithium-ion cell overcharge or charging fault leading to venting or thermal runaway | Operator, bystander, household, property | Catastrophic | B | High | Catastrophic-E Medium with K3, REQ-SYS-185 and K9, REQ-SYS-186 (decision 72; Catastrophic-D Serious before 0.5.0-pha) | c, e | RSK-007 |
| HZ-003 | Power amplifier and enclosure over-temperature and contact burn | Operator, property | Critical | C | Serious | Critical-E Low with K9, REQ-SYS-181 (adopted at SRR, decision 39) | b, e | RSK-006, RSK-026 |
| HZ-004 | Unintended or stuck transmission | Operator, guest, bystander, other services, property | Critical | B | High | Critical-D Medium with K12, REQ-SYS-180 (adopted at SRR, decision 38; E Low after R-KN5) | a, b, c | RSK-024 |
| HZ-005 | Hearing damage from headphone level, full-scale tones and clicks | Operator, guest | Critical | B | High | Marginal-D Low | b, c | RSK-017 |
| HZ-006 | RF exposure of bystanders, household members and non-licensee holders (general population) | Bystander, guest, household | Critical | C | Serious | Critical-D Medium (guest keying allowed at SRR, decision 20) | b, c | RSK-016 |
| HZ-007 | Lithium-ion discharge-side fault: over-discharge, over-current, short, reverse insertion, heating | Operator, bystander, property | Catastrophic | B | High | Catastrophic-E Medium | c, e | RSK-007 |
| HZ-008 | Harmonic, spurious and out-of-band emissions into safety-of-life and other radio services | Other services, bystander | Critical | C | Serious | Critical-E Low with K7, REQ-SYS-182 (adopted at SRR, decision 40) | a, c, e (section 6.3 item 6, concurred at SRR, decision 9) | RSK-001, RSK-011 |
| HZ-009 | Antenna connector mechanical failure and PCB damage | Operator, property | Marginal | B | Serious | Marginal-D Low | none | RSK-025 |
| HZ-010 | ESD and RF pickup on the key, paddle and headphone inputs | Operator, property | Marginal | B | Serious | Marginal-D Low | c | RSK-024 |
| HZ-011 | Charging while transmitting | Other services, property, operator | Marginal | B | Serious | Marginal-E Low | c, e | RSK-007, RSK-033 |
| HZ-012 | RF burn from contact with the antenna element or connector while transmitting | Operator, guest, bystander | Marginal | C | Medium | Marginal-E Low | b, c | RSK-016 |
| HZ-013 | Sharp edges and pinch points of the machined enclosure | Operator, guest, test operator | Marginal | B | Serious | Marginal-E Low | none | RSK-018 |
| HZ-014 | Firmware load leaving the radio in an unsafe state | Operator, bystander, other services, property | Critical | B | High | Critical-E Low with K8, the HZ-004 K12 share (adopted at SRR, decision 38) | a, c, e | RSK-015 |
| HZ-015 | Owner hand assembly: iron burns, flux fumes, solder handling, bench fire, heat or ESD damage to parts | Test operator (owner), household, property | Catastrophic | D | Serious | Catastrophic-D Serious (Catastrophic-E Medium with K1, K2, K4, K5) | none | RSK-034 |

Counts: 15 hazards; initial risk High 5 (HZ-002, HZ-004, HZ-005, HZ-007, HZ-014), Serious 8 (HZ-003, HZ-006, HZ-008, HZ-009, HZ-010, HZ-011, HZ-013, HZ-015), Medium 2 (HZ-001, HZ-012), Low 0. Residual with the controls that have a requirement (section 3.5): Serious 1 (HZ-015), Medium 4 (HZ-002, HZ-004, HZ-006, HZ-007), Low 10 (HZ-001, HZ-003, HZ-005, HZ-008, HZ-009, HZ-010, HZ-011, HZ-012, HZ-013, HZ-014). HZ-002 left Serious at 0.5.0-pha, when REQ-SYS-185 and REQ-SYS-186 gave K3 and K9 their requirements after package decision 72. The one Serious residual is Serious because its proposed controls have no requirement yet (HZ-015 K1, K2, K4, K5, K6; OQ-SAF-019, due at PDR); with every requirement-pending control allocated and verified the residuals become Medium 5 (HZ-002, HZ-004 until R-KN5 closes, HZ-006, HZ-007, HZ-015) and Low 10. Four of these levels rest on requirements that the owner adopted at SRR on 2026-09-26: HZ-004 and HZ-014 on REQ-SYS-180 (package decision 38), HZ-003 on REQ-SYS-181 (decision 39) and HZ-008 on REQ-SYS-182 (decision 40); the decline cases of section 8.3 (HZ-004 Critical-C, Serious; HZ-003, HZ-008 and HZ-014 Critical-D, Medium) therefore do not apply. Every High initial hazard has at least one allocated control that is independent of firmware and is neither software nor procedure, the entry condition for reducing it below High at PDR (section 3.4); for the toggling-stream branch of HZ-004 and HZ-014 that control is K12 (REQ-SYS-180), adopted at SRR by decision 38.

The HZ-015 Serious residual does not meet the section 3.4 Serious terms and is not offered for acceptance at SRR: the only allocated control, K3, closes by Analysis and addresses damage to parts, not the bench fire that sets the severity (section 5, HZ-015). HZ-002, Serious until 0.5.0-pha, is now Catastrophic-E, Medium with K3 (REQ-SYS-185) and K9 (REQ-SYS-186); it keeps the two independent hardware controls K1 and K2 (REQ-SYS-081, 082, 083, closing by Test), and its handbook control K8 (REQ-SYS-122) is a section 8.1 item 7 exception.

Changes from 0.1.0-pha: HZ-003 re-rated Marginal to Critical; HZ-002, HZ-007 and HZ-014 re-rated from likelihood C to B (their rationales describe the B anchor); HZ-015 added; residuals restated under the section 3.5 rule.

Changes from 0.3.0-pha (INSP-008): no severity, likelihood, initial or residual level, firmware-role criterion, component or SWE-134 item changes. The controls now name the 23 `REQ-SW-KEYER` and 17 `REQ-TX` requirements that list their hazards (section 9 item 1); HZ-007 gains Software causes C9 and C10 and HZ-010 C6 and C7 (its former C4 split); HZ-015 K1 is the station (Hardware interlock) and the new K6 the soldering practice (Operator procedure); HZ-008 names RSK-046; two control texts carry the section 3.6 tag (HZ-004 K5, HZ-007 K1); four `decisions_pending` entries are mapped to a package decision or marked PDR actions; OQ-SAF-021 and OQ-SAF-023 are closed, OQ-SAF-022 answered, OQ-SAF-025 and OQ-SAF-026 raised.

Changes from 0.2.0-pha: residuals of HZ-003, HZ-004, HZ-008 and HZ-014 restated under section 3.5 now that REQ-SYS-180 to REQ-SYS-182 exist, with the decline cases of section 8.3; HZ-015 carried by RSK-034; the backstop shares HZ-001 K10, HZ-003 K10, HZ-006 K10, HZ-012 K6 and HZ-014 K8 added; HZ-011 K3 traced to REQ-SYS-149; REQ-SYS-130 traced to HZ-002 K4 and K5. Severities, likelihoods, initial risks, firmware-role criteria and SWE-134 items are unchanged; the HZ-008 frequency verification unit component now names REQ-SYS-182.

## 5. Hazard narratives

The paragraphs below give the decisive numbers and the decisive controls; the full records are in `hazards.json`.

**HZ-001, operator SAR.** Within 20 cm the portable-device SAR regime applies (47 CFR 2.1093(b), (d)(1)) and, because every operator is a licensee (SI-030), the occupational limits govern: 8 W/kg per 1 g, 20 W/kg per 10 g extremity, 6 min averaging with duty factor permitted (47 CFR 1.1310(b), 2.1093(d)(3)). No SAR measurement exists at project scale; by analogy to FCC-database VHF handhelds (0.05 to 0.35 W/kg per W at 50 percent duty) the licensee is at 17.5 percent of the limit for 5 W continuous CW and 43.8 percent for a 6 min 5 W carrier; the limit needs 28.6 W CW or 11.4 W carrier (`docs/research/rf-exposure-evaluation.md` F5, F6). The hazard is therefore Marginal (loss of margin, not an exceedance, which section 3.2 would rate Critical), and the controls hold the margin under an over-power fault and bound duty: power steps with a 1 W default and a deliberate 5 W selection, a 0.5 W tune carrier ending at most 5.5 s after it starts (REQ-SYS-020, TBR), the firmware stuck-key controls (K3), the hardware cutoff (K9) and the transmission-length backstop (K10, REQ-SYS-180, adopted at SRR by package decision 38), ALC, the handbook's exposure section (the information the occupational tier requires under 1.1310(e)(2) and 97.13(c)(1)), the ConOps posture and an engraved legend (all ratified at SRR: package decisions 22, 23, 31, 32, 34 and 36). The analogy's 7:1 spread and the homebrew form factor are the honest uncertainty, carried by RSK-030; if the RF exposure evaluation shows the limit can be exceeded, the severity rises to Critical.

**HZ-002, charging-side cell fault.** Catastrophic by definition; likelihood B because mismatched or reversed cells (C6) are a single common operator error by several users. The allocated layers are the charger's regulation and OVP at 4.20 V per cell with JEITA and a 12 h timer (REQ-SYS-081, 082, 089) and a 2S protector opening the charge path at 4.25 V (REQ-SYS-083); firmware adds dual dissimilar sensing (charger ADC versus RP2350 dividers, disagreement above 100 mV stops charging) and an insertion check (`docs/research/power-tree-and-charging.md` F5, F11, F15, F24). The two-fault tolerance claimed at 0.1.0 was withdrawn at 0.2.0-pha because the third layer, the 4.30 V secondary protector K3, had no requirement and every layer, firmware included, sensed the cell junction through one MID sense net (300 ohm, HZ-007 K3), so one open or high-resistance sense connection plus a cell imbalance blinded per-cell detection everywhere. Package decision 72 adopted the BQ29209 layer at SRR and ordered both missing requirements; the requirements author wrote them after the ruling: REQ-SYS-185 (Further cell over-voltage layer, 4.30 V to 4.35 V TBR) implements K3 and REQ-SYS-186 (Separate cell-sense paths per protection layer) implements K9, which removes the shared-sense single point (OQ-SAF-008 and OQ-SAF-009 answered). Residual Catastrophic-E, Medium, accepted at SAR under RSK-007 (Catastrophic-D, Serious until 0.5.0-pha); the overcharge branch is two-fault tolerant once K3 and K9 are verified. The temperature window shares one NTC between the charger and the firmware lock-out, a named single point.

**HZ-003, PA and enclosure temperature.** The two-stage PA line-up draws 11.4 W DC for 5 W out and the module alternative dissipates 7.9 W (`docs/research/pa-device-candidates.md` F4, F8, F19); the pack supports about 1.5 h of continuous key-down. Re-rated Critical: in the uncontrolled state, long or stuck 5 W keying with the radio in a pocket can hold the skin-contact surface above about 55 C for minutes, a partial-thickness burn needing treatment, and drive the junction past 150 C with smoke contained to the unit (the burn-threshold figure is general burn-injury knowledge, not a corpus source; confidence Medium-Low). The controls are the thermal path (Type VII filled vias, interface to the enclosure wall; junction at or below 110 C in continuous key-down at 40 C ambient per REQ-SYS-112, surface at or below 48 C after 5 min at 25 C per REQ-SYS-113, both TBR at the PDR thermal budget, RSK-006), firmware fold-back and inhibit within 100 ms above an 85 C TBR threshold, the firmware stuck-key controls, the hardware cutoff (which bounds a continuous carrier only, 13 s) and the backstop K10 (a toggling stream, 150 s to 180 s TBR, REQ-SYS-180), ALC and PA load ruggedness. For normal long keying with the thermistor reading cold, the only control independent of firmware is K9, the hardware over-temperature cut-off (thermal fuse, PTC or comparator on a second NTC, 95 C TBR), brought forward from PDR, written as REQ-SYS-181 and adopted at SRR with 95 C +/-3 C and 100 ms (package decision 39; OQ-SAF-012 closed). With K9 the residual is Critical-E, Low; the decline case of section 8.3 does not apply. RSK-006 and RSK-026 carry the hazard at safety 4.

**HZ-004, unintended or stuck transmission.** The mono-plug trap is documented by Elecraft and QRP Labs (`docs/research/keyer-and-key-interfaces.md` F1). Headphones in the key jack read as a closed contact at power-on and as a continuous closure in Straight mode, but in the iambic modes (Iambic A is the default) they close both contacts and produce a squeeze: an endless alternating dit-dah stream. The research coverage statement (`docs/research/keyer-verification-and-key-input-network.md` F13) holds only for the Straight case (correction requested, OQ-SAF-007). Two fault classes must therefore be kept apart: a **continuous key-down**, which the retriggerable hardware cutoff K5 bounds, and a **toggling key stream**, which retriggers K5 on every edge and which no hardware element other than K12 bounds. Controls in layers: the power-on and reset interlock K1 (both inputs open for 500 ms before TX arming; "KEY CLOSED: check plug"); Straight-on-tip only by menu (K2); the manual-closure timeout K3 at 5 s (2 to 6 s, always below the hardware minimum), which REQ-SYS-053 applies to every manually timed closure including the Bug-mode dah contact (OQ-SAF-004 closed); the no-gap paddle watchdog K4, run by the safe-state manager on the TX_KEY read-back rather than by the keyer engine, which stops keying after 128 identical elements (about 6.1 s elapsed at 50 WPM counting the inter-element spaces, 3.1 s of it keyed; 20.5 s at 15 WPM, the basis REQ-SYS-054 uses), after 30 s (TBR) without a key-up interval of 7 dit times or 500 ms whatever the pattern, or when both contacts stay closed over 2 s (TBR) (adopted at SRR by package decision 37, which replaces the 10 s cap of REQ-SYS-054 as written; items (i) and (ii) are the reworded REQ-SYS-054 and item (iii) is REQ-SYS-184, OQ-SAF-001 and OQ-SAF-002 answered); the hardware PA-enable cutoff K5 (retriggerable monostable on TX_KEY, T_max 10 s, window 7.5 to 13 s, PA path enabled only while TX_KEY AND Q, acting on the envelope modulator node; 74LVC1G123, adopted at SRR by package decision 36); external 4.7 kohm pull-downs K6; the 2 s CPU watchdog and safe state K7; two independent software conditions for RF K8; debounce K9; the transmission-length backstop K12, a second monostable on the T/R transmit drive that removes the PA-path enable after 150 s to 180 s (TBR) in transmit and is the only hardware element that bounds a toggling stream (REQ-SYS-180, brought forward from PDR and adopted at SRR by package decision 38; OQ-SAF-003 closed); and the bench test-mode guard K13 (menu plus confirmation, REQ-SYS-179; the forced 0.5 W step, 120 s timeout, exit on reset and non-persistence were adopted at SRR by package decisions 41 and 42 and are REQ-SYS-187, REQ-SYS-188 and REQ-SYS-190, OQ-SAF-016 answered; the distinct-event rule of REQ-SW-KEYER-039, concurred by decision 112, governs the Straight-on-tip selection K2 and the test-mode start).

Coverage (fault tree summary; rows 4 to 8 are the toggling-stream branch):

| Row | Cause (HZ-004) | Firmware control | Hardware bound without K12 | Hardware bound with K12 (REQ-SYS-180, adopted at SRR) |
|---|---|---|---|---|
| 1 | Mono plug or headphones at power-on or reset (C1, C2) | Interlock K1: transmit never arms | not needed | not needed |
| 2 | TX_KEY or PA_EN undriven in reset or bootloader (C6) | none needed | Pull-downs K6: lines read low | K6 |
| 3 | Firmware hung (C5) | CPU watchdog K7, 2 s, then reset | K5 at 7.5 to 13 s if TX_KEY is stuck high; pads low after reset | same |
| 4 | Single paddle lever held or stuck (C3) | K4 (i) 128 identical elements (about 6.1 s elapsed at 50 WPM with the inter-element spaces, 3.1 s of it keyed) or (ii) 30 s (TBR) without a 7-dit or 500 ms gap, whichever comes first (package decision 37; replaces the 10 s cap of REQ-SYS-054 as written) | none: every element retriggers K5 | K12 at 150 s to 180 s |
| 5 | Headphones or a shorted TRS cable inserted after boot in Iambic A, Iambic B or Ultimatic (C2, C3) | K4 (iii) squeeze limit 2 s (TBR; package decision 37; REQ-SYS-184) | none | K12 at 150 s to 180 s |
| 6 | Iambic memory never cleared, an alternating stream with no contact closed (C4) | K4 (ii) in the separate TX_KEY monitor, 30 s (TBR; package decision 37; REQ-SYS-054) | none | K12 at 150 s to 180 s |
| 7 | Bench test-mode PARIS loop left running (C9) | K13 timeout 120 s (TBR) and exit on reset (the 7-dit word spaces defeat K4; package decision 41; REQ-SYS-188, REQ-SYS-190) | none | K12 at 150 s to 180 s |
| 8 | Periodic output on TX_KEY and PA_EN from a release pin-map error (C10, HZ-014 C5) | ATP keying cases (HZ-014 K5); K4 may be unable to act on a wrong pad function | none | K12 at 150 s to 180 s, and no PA output while T/R is in receive |
| 9 | Straight key or Bug dah contact stuck; headphones or a shorted cable after boot in Straight mode (C2, C3) | K3 at 5 s | K5 at 7.5 to 13 s | same |
| 10 | TX_KEY latched high by a logic or sequencer fault (C4, C5) | K4 (ii) at 30 s (TBR) | K5 at 7.5 to 13 s (acts first) | same |
| 11 | Keying or permit state corrupted (C7) | K8 complement check | K5 for a continuous key-down | K12 for a stream |
| 12 | RF pickup or ESD read as closures (C8) | HZ-010 network and debounce K9 | as for the resulting pattern (rows 9, 10 or 4) | same |

Residual with the controls that have a requirement, K12 included: Critical-D, Medium, set by the shorted envelope pass element (R-KN5, which bypasses K5 and K12 alike), and Critical-E, Low once R-KN5 closes at PDR. Without K12 rows 4 to 8 would have firmware as the only automatic control and the residual would be Critical-C, Serious, which section 3.4 does not accept on those terms (section 8.3); the owner adopted K12 at SRR (package decision 38), so that case does not apply. OPS-013 and the ConOps Transmit-keyed row carry the ruled values since ConOps revision 3 (OQ-SAF-006 Answered). The tune carrier interacts with K5: the research 10 s +/-1 s tune could be cut by every unit whose T_max is below 11 s, including the nominal 10 s unit, so this analysis proposed 5 s +/-0.5 s; REQ-SYS-020 reads at most 5.5 s (TBR), 2 s below the 7.5 s floor, as the owner ruled at SRR (option a of package decision 36, RFX-D3 with D-KN2; OQ-SAF-005 closed).

**HZ-005, hearing.** Every amplifier candidate reaches 113 to 126 dB SPL into sensitive earbuds, above the 118 dB(A) acoustic-shock ceiling and 13 to 26 dB above the 100 dB(A) consumer maximum (`docs/research/audio-output-and-hearing-safety.md` F19, F22, F24, F25). The primary control is hardware: a fixed passive ceiling of 100 mVrms for a full-scale sine and 150 mVrms for any pattern (96.5 to 101.6 dB SPL), independent of firmware state, arranged so that no single component failure raises the output. Firmware adds a 30 mVrms default cap with an acknowledged, expiring unlock (level policy option a, ratified at SRR by package decision 64), a limiter with attack at or below 1 ms (no requirement yet, OQ-SAF-015), raised-cosine mute and unmute, an amplifier enable pulled down in hardware and asserted only after the source has settled, and the test-mode guard K9 for the full-scale 700 Hz bench tone, 60 s (TBR) (cause C6; adopted at SRR by package decisions 41 and 42; REQ-SYS-189 and REQ-SYS-190 with the entry of REQ-SYS-179, OQ-SAF-016 answered). Residual Marginal-D, Low: the worst case with the ceiling is 105 dB SPL for the duration of a fault.

**HZ-006, general-population exposure.** A 5 W carrier at the face of a non-licensee is 219 percent of the 1.6 W/kg limit under the high analogy (106 percent at the median) and 5 W continuous CW is 87.5 percent; only the 0.5 W and 1 W steps keep even the carrier case under the limit with margin; bystander MPE distances are 0.58 m for 5 W continuous CW and 0.91 m for a 5 W carrier (`docs/research/rf-exposure-evaluation.md` F3, F6, F7). Source-based averaging only may be credited for this tier (47 CFR 2.1093(d)(4)). Controls: the 1 W default and deliberate 5 W selection, the 0.5 W tune carrier with its timeout, the licensee-settable receive-only guest lock (FW-03), the operator rules (0.6 m while keying, 1.0 m while tuning, guests only at 0.5 or 1 W under supervision per 97.115(b)(1)), the OPS-A operator model carried into the handbook (REQ-SYS-122), the firmware stuck-key controls (K6), the hardware cutoff (K9, continuous carrier only) and the backstop (K10, a toggling stream, REQ-SYS-180, adopted at SRR by package decision 38), and the legend. Residual Critical-D, Medium, because operator discipline is the last barrier once the lock is released; the owner allowed guest keying at SRR at the 0.5 W and 1 W steps under supervision (RFX-D8, package decision 20), with OPS-A (decision 17) and the two-step guest lock (decision 19), so the residual stays Medium rather than the Low that excluding guests would give.

**HZ-007, discharge-side cell fault.** The PA draws 1.3 to 2.1 A from a path the charger does not protect; likelihood B because reverse insertion and mixed cells are single common operator errors. Controls: the 2S protector with dual N-FET (over-discharge 2.50 V, over-current 0.200 V across the FETs, short 0.500 V; the S-8252 topology adopted at SRR, package decision 72), a fuse or PTC in the pack lead, protector FETs that stay off unless both cells are in window, per-cell sensing with rails enabled only after both cells read 2.5 to 4.3 V, a firmware soft cut-off (transmit inhibited below 6.4 V pack, power-down below 6.0 V, TBR), a 60 C discharge lock-out (the 3.20 V, 3.00 V and 60 C limits ratified at SRR, package decision 76), a mechanical power switch (decision 74), two single-cell holders (decision 73), and an approved-cell list (`docs/research/power-tree-and-charging.md` F11, F12, F14, F24). The cell compartment K5 (separation from the PA, vent path, a compartment that admits no conductive object, polarity marks) has no requirement (OQ-SAF-010); the over-current and short requirement REQ-SYS-085 closes by Analysis accepted per RSK-007, and a component-level Test is requested (OQ-SAF-018). Hand-assembly with cells in the holders is cause C8 (HZ-015 C7). Firmware can contribute by inaction or incorrect action (SWEHB swe-205 section 7.1 task 1): C9, the soft cut-off or discharge lock-out does not act (a misscaled, stale or wrong-divider reading, a wrong threshold, a stalled supervision task), and C10, the rails are enabled or transmit permitted outside the cell window. Both are failures of the criterion c and e functions of `SW-PWR`, closed by the K3 and K4 HostUnit fault-injection cases, and both are bounded by the protector K1 and the fuse K2, which act without firmware. Residual Catastrophic-E, Medium, shares the RSK-007 acceptance.

**HZ-008, harmonic, spurious and out-of-band emissions.** The 7th harmonic (1008 to 1036 MHz) lands in the aeronautical radionavigation band that carries the 1030 MHz SSR/IFF interrogation frequency (47 CFR 2.106 footnote US78, 91 FR 1405) and DME; the 3rd lands on 70 cm including the 432.300 to 432.400 MHz beacon segment; the 2nd on a military-only band (`docs/research/regulatory-corpus-and-operators.md` F9). Interference to radionavigation is harmful interference per se (47 CFR 97.3(a)(23)). The legal limit at 5 W is 53 dB below the carrier (47 CFR 97.307(e)); the raw 2fo of the baseline line-up is 37 to 40 dB down. Harmonic controls: a low-pass filter at the antenna port after the T/R node with 40 dB at 288 to 296 MHz and 35 dB at 432 to 444 MHz at 0.5 dB or less insertion loss, a 60 dBc design target (7 dB margin; ADR-022, accepted at SRR with the HZ-008 link, package decision 29), a device with measured VHF harmonics, a relay T/R switch, ALC, the raised-cosine envelope with a 350 Hz 26 dB bandwidth and a 1.2 kHz band-edge guard on a +/-2.5 ppm TCXO (ADR-023; option a of package decision 25, which widened the guard from 1 kHz so that the -60 dB keying-sideband point, up to 750 Hz from the carrier, stays in band with the 370 Hz reference error), and measurement of 2f, 3f and 7f on every unit with the tinySA Ultra before any antenna-connected transmission. The independent review found a branch the 0.1.0 analysis missed: a gross frequency-control fault (C7: a wrong divider or register computation, a corrupted frequency word, an out-of-range calibration; C8: a PLL locked to a wrong value) places the fundamental itself outside the band, and the harmonic filter, whose cutoff lies between 148 and 288 MHz, passes much of 150 to 174 MHz, which carries VHF public-safety and maritime services including the 156.8 MHz distress, safety and calling channel (allocation not yet in the corpus, OQ-SAF-024). One software fault can key 5 W there, and the only check, REQ-SYS-009, lives in the same component. A hardware band-selective element on the TX path is not practical at 0.5 dB loss. This analysis therefore proposes an independent frequency verification K7 (the synthesizer output prescaled and counted by a PIO or timer unit separate from the synthesizer driver, on the crystal timebase, compared with the set frequency within 10 kHz TBR before PA_EN and during transmission), written as REQ-SYS-182 with REQ-SYS-154 as the Fault-safe response and adopted at SRR with the 10 kHz window and 100 ms (package decision 40; OQ-SAF-013 closed), and classifies the frequency-word path and the verification unit as safety-critical (section 6.3 item 6; the owner concurred at SRR, package decision 9). Residual Critical-E, Low, with K7; the decline case of section 8.3 does not apply. The single filter remains an accepted single point for a five-unit series, measured per unit.

**HZ-009, antenna connector.** A 5 to 10 N push at the tip of a 40 cm whip reaches the yield moment of a brass SMA neck; PCB-only mounting fails at the solder joints first (`docs/research/antenna-and-erp.md` F8). Controls: a stainless bulkhead-retained jack in a boss at least 2.5 mm thick with an anti-rotation flat, the PCB carrying no antenna moment, a 4.0 N.m static requirement, PA survival into open and short, anodize masking at the RF ground, a flexible Nitinol reference whip and a printed fit-check with a static load test. The register carries this hazard in RSK-025.

**HZ-010, ESD and RF pickup.** Controls per key line: a TPD2E2U06 class level-4 clamp at the jack, 1 kohm series, 10 kohm pull-up, 4.7 nF at the pad, a BAT54S secondary clamp, an E9-safe pad configuration, about 70 dB of RF attenuation, 2 ms and 5 ms debounce (TBR, closing by PDR with REQ-SYS-048), common-mode chokes on the leads, headphone outputs that survive a permanent short, and a bench RF-immunity case with a 1 m cable hanging on the jack during 5 W keying (`docs/research/keyer-verification-and-key-input-network.md` F3, F4, F5). Firmware causes: C6, the key-input pad configuration left wrong by the pico2 GPIO initialisation (reset-default pull-down enabled, Schmitt trigger off, pad input-disabled; split from the former C4, whose remaining part, erratum E9 leakage, is a Design cause), and C7, the debounce or stuck-input detection misclassifying an input. They are failures of the keyer's criterion c function; K2 (pad configuration, Inspection against the RP2350 datasheet and a Bench pad-voltage check) and K3 (HostUnit debounce vectors) control them, and the HZ-004 interlock and timeouts bound a misread persistent closure.

**HZ-011, charging while transmitting.** The charger's 1.5 MHz boost ripple on the PA drain would produce spurious sidebands, the USB budget cannot carry transmit power, and the Pico 2's VBUS path is unrated above 500 mA (`docs/research/power-tree-and-charging.md` F2, F22). The 0.1.0 controls described a superseded design (TX enable driving the charger CD pin). The baseline, the ConOps (Charging mode and the forbidden transition "Transmit-keyed while USB power is present") and the allocated requirements instead inhibit the transmitter whenever VBUS is present and pause charging while the radio is switched on. Controls now: K1, the hardware transmit inhibit on a VBUS sense of its own, forcing the PA-path enable low (REQ-SYS-092); K6, the firmware transmit inhibit on the Pico 2 GPIO24 VBUS sense as the dissimilar layer (REQ-SYS-002, which lists HZ-011); K2, the charge pause while switched on (REQ-SYS-093); K3, the PA fed only from the pack (REQ-SYS-149; OQ-SAF-011 closed); K4, the 500 mA input limit; K5, the handbook. Single points analyzed: the inhibit's VBUS sense divider open and the inhibit element failed in the permit state, each backed by K6 on its separate sense and by K2. Residual Marginal-E, Low.

**HZ-012, RF burn.** 22.4 V peak at the port at 5 W (44.7 V into open or short) and of the order of 100 V rms at the tip of an end-fed half-wave (`docs/research/tr-switch-candidates.md` F1; tip figure derived here, Low confidence). Controls: the tune timeout (REQ-SYS-020, at most 5.5 s, TBR; package decision 36) and power defaults, the firmware stuck-key controls (K2), the hardware cutoff (K5) and the backstop (K6, REQ-SYS-180, adopted at SRR by package decision 38), insulated antenna base and counterpoise end, and the handbook.

**HZ-013, edges and pinch points.** Controls: a 0.5 mm minimum edge break and deburr callouts on the drawing (TBR against PCBWay's rules), 1.0 mm knob clearance, a cover without a lever pinch, printed fit-checks and a receipt inspection snag test (`docs/research/enclosure-cnc-and-openscad-pipeline.md` implications).

**HZ-014, firmware load.** A corrupt or wrong image, an inconsistent configuration store, the undefined pad states of the bootloader, or a release whose pin map or defaults changed without the acceptance cases being re-run could leave the PA enabled or the protections absent; likelihood B, a single common operator or transfer error. Controls: an image CRC-32 trailer verified before any safety-critical output; the configuration guard (two-copy CRC-checked configuration with range checks and safe defaults), a unit of the safe-state manager per 03 section 4.3; external pull-downs on TX_KEY and PA_EN; the hardware transmit inhibit on VBUS during every load (HZ-011 K1); tagged releases with a VDD and `picotool verify`; the TC-SW-BOOT and TC-SW-CFG acceptance cases, whose logic closes by HostUnit and whose SWE-193 credit run is the Bench run at stage 4 of every unit's ATP, with Emulation as supporting ordering evidence only (04 section 11.1); the key-closed interlock and watchdog re-armed after every reset; a PDR ADR on RP2350 secure boot. A release pin-map error driving TX_KEY with a periodic output is HZ-004 row 8, bounded in hardware by K8, the HZ-004 K12 share (REQ-SYS-180, adopted at SRR by package decision 38); residual Critical-E, Low, with it; the decline case of section 8.3 does not apply.

**HZ-015, owner hand assembly.** Added after independent review: SEMP section 7.1 lists the owner's hand soldering (burns, fumes, damage to assembled parts) in the hazard scope and SI-031 makes the owner the assembler of the through-hole parts and exposed-pad modules of up to five units. Agents: an iron tip and barrel well above 300 C, molten solder, rosin flux fume (colophony is a respiratory irritant and sensitiser; general occupational-health knowledge, not a corpus source), solder and flux residue on the hands, spatter and clipped leads, and heat and ESD next to vendor-placed RF and RP2350 parts. The worst credible outcome is a bench fire from an iron left energized off its stand, a fire not contained to the unit, hence Catastrophic-D, Serious; the injury cases (a burn needing treatment, an eye injury) are Critical-C. Controls: K1 the station as equipment, temperature-controlled with a stand, auto-sleep and an earthed tip (typed Hardware interlock at 0.4.0-pha because the auto-sleep acts without the owner's attention; the owner's bench list, CON-016, has no station, so the owner confirms or obtains one); K6 the soldering practice (tip temperature per the alloy datasheet, iron on its stand between joints and off when the owner leaves, combustibles cleared; Operator procedure, split from K1); K2 fume extraction; K3 the part-category split that leaves every hidden-pad and fine-pitch part to PCBWay (REQ-SYS-137, REQ-SYS-138); K4 a hand-assembly procedure (lead-free alloy and tip temperature, dwell limits, cells removed and USB disconnected, eye protection, hygiene, ESD strap and mat); K5 the TRR safety line and the as-built record. K1, K2, K4, K5 and K6 have no requirement (OQ-SAF-019), so the residual equals the initial level today. **Section 3.4 position.** The Catastrophic-D, Serious residual does not meet the section 3.4 Serious terms (two independent controls, one neither software nor procedure, each verified by Test): the only allocated control, K3 (REQ-SYS-137, 138), closes by Analysis and addresses heat and ESD damage to parts, not the bench fire that sets the severity. It is therefore not offered for acceptance at SRR; it is the pre-PDR state under section 3.5. Path to PDR: the owner confirms the station (package decision 100, needed by CDR; the SRR consent agenda confirmed its plan only); the hand-assembly requirement covers K1, K2, K4, K5 and K6 (OQ-SAF-019, due PDR); K1 closes by Test (the idle iron left off its stand, the tip temperature fall timed against the station datasheet with the multimeter thermocouple if OQ-VV-003 confirms one, otherwise with the station's own temperature readout) and K4, K5 and K6 by Inspection. With K1 and K6 allocated and verified, Catastrophic-E, Medium, accepted at SAR. RSK-034 carries the hazard at safety 5.

## 6. Safety-critical software determination (SWE-205)

### 6.1 Criteria and method

NASA-STD-8739.8B para 3.2 (via SWEHB 7.02 section 1.2): software is safety-critical if it is determined by and traceable to a hazard analysis and meets at least one of: (a) causes or contributes to a system hazardous condition or event; (b) controls functions identified in a system hazard; (c) provides mitigation for a system hazardous condition or event; (d) mitigates damage if a hazardous condition or event occurs; (e) detects, reports and takes corrective action if the system reaches a potentially hazardous state. The method is 03 section 4.1: for each hazard the firmware role is stated in these terms (`firmware_role.criteria` in `hazards.json`); a component is safety-critical when it is named in `firmware_role.components` of a hazard whose criteria are non-empty, and its criteria are the union over those hazards. The SWE-134 note (components that control, mitigate or contribute to a hazard, and software used to command hazardous operations) yields the same set.

### 6.2 Determination

cwht has safety-critical software. The table is generated from `hazards.json` 0.4.0-pha by the 03 section 4.1 union rule (0.4.0-pha changes no `firmware_role` criteria, components or `swe134_items`, so the table equals the 0.3.0-pha result); where it differs from 03 section 4.3 or 07 section 14.1 the difference is listed in section 11.1 item 2 and in OQ-SAF-022 and OQ-SAF-023.

| Component (03 section 4.3 name; 07 section 14.1 module) | Hazards naming it (`firmware_role.components`) | Criteria (union) | Basis |
|---|---|---|---|
| Keyer and keying output (`SW-KEYER`) | HZ-001, HZ-004, HZ-010 | a, b, c | Commands the hazardous operation for both key types; a keyer fault causes HZ-004; debounce and stuck-input detection mitigate HZ-010 |
| PA enable and TX sequencer (`SW-TXSEQ`), including power-step selection and default, the tune-carrier level and timeout, the TX permit, the receive-only guest lock, the bench test-mode guard, and the VBUS-absent and frequency-verified PA_EN prerequisites | HZ-001, HZ-003, HZ-004, HZ-006, HZ-007, HZ-008, HZ-011, HZ-012 | a, b, c, e | The gate that decides whether RF exists and at what power; a latched enable causes HZ-004; it executes the thermal, low-voltage, VBUS and frequency inhibits as corrective action (e) |
| Battery and charging supervision (`SW-PWR`) | HZ-002, HZ-007, HZ-011 | c, e | Dual dissimilar sensing, insertion check, soft cut-off, discharge lock-out, charge pause while switched on and the VBUS reading |
| Thermal protection (`SW-SAFE` thermal unit with `SW-TXSEQ` actuation) | HZ-003 | b, e | Sets PA bias and power; detects over-temperature, folds back and inhibits |
| Audio limiter (`SW-AUDIO`) | HZ-005 | b, c | Controls the output level; cap, limiter, fades, fault mute and the test-tone guard |
| Safe-state manager (`SW-SAFE`): start and restart initialization, watchdog handling, the PA-permit flag, fault-to-safe-state transitions, fault annunciation, and the TX_KEY no-gap and squeeze watchdog of HZ-004 K4 | HZ-001, HZ-002, HZ-003, HZ-004, HZ-005, HZ-006, HZ-007, HZ-011, HZ-014 | a, b, c, e | The mitigation path every other component relies on; named for HZ-003, HZ-005, HZ-006 and HZ-011 in this revision (03 item X2 ii: fault annunciation and SWE-134 a and l) |
| Boot path (`SW-BOOT`, a unit of the safe-state manager): image integrity trailer check before any safety-critical output | HZ-014 | a, c, e | A loaded image is itself a potential cause; the boot path initializes to the safe state |
| Configuration guard (`SW-SAFE` unit `cfg_guard`, called by `SW-BOOT` at boot and by `SW-CFG` before every write) | HZ-014 | a, c, e | 03 section 4.3 configuration guard decision, applied here: HZ-014 now names "Safe-state manager (boot path, SW-BOOT, configuration guard)"; the configuration store and non-safety fields stay mission-critical in `SW-CFG` |
| Scheduler and runtime (`SW-SCHED`) | HZ-001, HZ-002, HZ-003, HZ-004, HZ-005, HZ-006, HZ-007, HZ-011, HZ-012 (the hazards whose `swe134_items` include j) | a, b, c, e (union; 03 section 4.3 records a, c) | A dispatch fault that starves a monitor or delays a key-up release contributes to the hazard; the scheduler runs every mitigating task (03 item X2 iii applied) |
| Frequency control, frequency-word path (`SW-SYNTH`: word computation, calibration application, band-edge limit, register write with read-back); safety-critical by the owner's concurrence at SRR (package decision 9) | HZ-008 | a, c, e | A single fault in this path can place 5 W on 150 to 174 MHz (HZ-008 C7); delta to 03 section 4.3 (section 6.3 item 6) |
| Frequency verification unit (`SW-SAFE`, independent of `SW-SYNTH`); REQ-SYS-182, adopted at SRR (package decisions 40 and 9; OQ-SAF-013 closed) | HZ-008 | a, c, e | Mitigates C7 and C8 and detects, reports and inhibits (HZ-008 K7) |
| `pico2` drivers used by the components above (rustos): GPIO (SIO), TIMER alarms, PWM (sidetone and audio level), ADC (thermistor and cell-voltage sensing), watchdog, critical section, clocks and PLL; PIO or timer capture for the frequency counter of K7 (adopted at SRR, package decision 40) | as the components they serve | inherited | 03 section 4.3 drivers row and 07 section 14.1 (03 item X2 iv applied); driver-to-datasheet traceability per SI-026 |

Mission-critical, not safety-critical (App. A definition applied in 03 section 4.3; SWE-134 a to l apply, SWE-219 and SWE-220 do not): the ALC set-point and keying envelope shaper as they affect the harmonic and band-edge branches of HZ-008 (a fault raises harmonics by at most 3 dB or widens the keying sidebands, both absorbed by the 7 dB filter margin and the 1.2 kHz guard of package decision 25); synthesizer functions outside the transmit frequency-word path (receive tuning, lock-detect reporting) if the PDR design separates them into their own units; receive-chain control; the configuration store and the load of non-safety fields (`SW-CFG`); frequency display rendering and encoder tuning input. The 0.1.0 determination that frequency control as a whole is mission-critical is withdrawn, with the owner's concurrence at SRR (package decision 9, 2026-09-26): its basis (a firmware fault moves the harmonic level by at most 3 dB within the filter margin) covered harmonics only and not an out-of-band fundamental. HZ-008's firmware role is now criteria a, c and e.

Not safety-critical and not mission-critical: menu handling and non-frequency LCD content other than fault annunciation, USB serial logging, the 6 and 30 min key-down accumulator and the separation reminder (HZ-006 K5; a convenience function by RFX-D4, ratified at SRR by package decision 33), engineering tools and verification software (03 section 4.3.1).

### 6.3 Deltas to 03 section 4.3 (the owner concurred at SRR, package decision 9, 2026-09-26)

1. Power-step selection and default, the tune-carrier level and timeout, and the receive-only guest lock are part of the safety-critical scope of the PA enable and TX sequencer component (HZ-001, HZ-006, HZ-012), together with the bench test-mode guard (HZ-004 K13) and the VBUS-absent and frequency-verified PA_EN prerequisites (HZ-011 K6, HZ-008 K7). They are prerequisites of the PA-enable gate (SWE-134 h), so this extends an existing component.
2. Battery and charging supervision covers the discharge side (HZ-007) and HZ-011; its HZ-011 role is now the charge pause while switched on and the VBUS reading, not a charge disable around the T/R changeover (the superseded design).
3. The boot path and the configuration guard are units of the safe-state manager (the 03 decision, applied to HZ-014).
4. HZ-010 is in the keyer component's hazard list (criterion c).
5. The safe-state manager is named for HZ-003, HZ-005, HZ-006 and HZ-011, and the scheduler and runtime for every hazard with SWE-134 item j (03 items X2 ii and iii); the no-gap and squeeze watchdog of HZ-004 K4 is a safe-state manager unit, so that a keyer-engine fault cannot disable it. The safe-state manager's union stays a, b, c, e; the scheduler's becomes a, b, c, e.
6. Frequency control (the `SW-SYNTH` frequency-word path) and a new frequency verification unit are safety-critical by criterion a for HZ-008 C7, reversing the 0.1.0 mission-critical-only determination for that path. The owner concurred at SRR (package decision 9) and adopted K7 (REQ-SYS-182, package decision 40); 03 sections 4.2, 4.3 and 5, 07 section 14, SEMP section 7.1, charter section 10 and `rmm.json` change together in the lead SE's post-ruling edit (OQ-SAF-014, package item R16).
7. HZ-009, HZ-013 and HZ-015 have no firmware role; none of them changes the safety-critical set.

Consequences unchanged from 03 section 4.4: SWE-023, SWE-134, SWE-219 and SWE-220 apply to the components above; SWE-184 and SWE-192 apply to every requirement that carries a `hazard_ids` entry; every such `REQ-SW-*` closes by Test with no exception (04 section 5, `tools/traceability.py` check `HAZARD_REQ_NOT_TESTED`). 03 sections 4.2, 4.3 and 5 and `docs/process/rmm.json` rows SWE-134 and SWE-205 are re-transcribed by the lead SE from this revision (OQ-SAF-023).

## 7. SWE-134 items a to l mapped to cwht functions

Each provision becomes at least one requirement tagged `safety` with `hazard_ids` (03 section 5 reserves `REQ-SW-SAFE-001` to `REQ-SW-SAFE-012`, one per item; 07 section 14.2), verified by Test with MC/DC coverage (SWE-219) and cyclomatic complexity at or below 15 (SWE-220) for the safety-critical components. The Requirement column names the L1 `REQ-SYS` requirements that implement each provision today and the reserved L2 id; where a provision has no L1 requirement it is marked L2 only, closing at PDR. The Hazards column is generated from `swe134_items` in `hazards.json`, the source of record. The numbers are this analysis's; where a number is a proposal it is marked so.

| SWE-134 | cwht provision | Requirement | Hazards (`swe134_items`) | Components | Verification (evidence class) |
|---|---|---|---|---|---|
| a. Initialized to a known safe state at first start and restarts | Reset vector and watchdog restart run the safe-state manager first: PA_EN and TX_KEY low (external 4.7 kohm pull-downs make this true before code runs), keying line off, charger in its hardware default, audio muted; image CRC-32 trailer verified before any safety-critical output; the key-closed interlock (both inputs open for 500 ms) runs before TX can be armed; the 1 W step after any configuration reset; PA_EN refused until the first frequency verification passes (REQ-SYS-182, adopted at SRR, package decision 40) | REQ-SYS-003, 052, 064, 119, 130, 132, 190; REQ-SW-SAFE-001 | HZ-001, HZ-002, HZ-004, HZ-005, HZ-006, HZ-007, HZ-008, HZ-011, HZ-014 | Safe-state manager, boot path, keyer, scheduler | HostUnit; Emulation for boot ordering only; Bench power-on stage 4 |
| b. Safe transitions between predefined states | Keyer, TX sequencer (Boot, SafeState, Receive, TxPending, Transmit, Fault, Charging-inhibited), charger supervision, synthesizer control and audio limiter are explicit state machines with transition tables; illegal transitions rejected and logged; T/R changes only while the envelope is below -20 dBc (cold switching) | REQ-SYS-002, 005; REQ-SW-SAFE-002 | HZ-002, HZ-004, HZ-005, HZ-008, HZ-014 | Keyer, PA enable and TX sequencer, battery and charging supervision, audio limiter, frequency control | HostUnit transition tests |
| c. Termination to a known safe state | Every task termination, panic, latched-fault path or shutdown calls the full safe-state entry (PA off, key up, charge disabled, mute) before halting; Inhibit-class causes apply the transmit part only (row l) | REQ-SYS-004, 130; REQ-SW-SAFE-003 | HZ-004, HZ-014 | Safe-state manager, scheduler | HostUnit fault injection; Emulation for ordering only |
| d. Operator overrides need two independent actions | Selecting the 5 W step, raising the tune carrier above 0.5 W, unlocking the audio cap above 30 mVrms, releasing the guest lock, selecting Straight-on-tip after a mono plug and entering a bench test mode each require a menu action plus a confirmation, never a single knob or key gesture; there is no override of the thermal inhibit, the key-down timeouts, the no-gap watchdog or the transmission-length backstop in rev A | REQ-SYS-007, 019, 056, 063, 066, 074; REQ-SW-SAFE-004 | HZ-001, HZ-003, HZ-004, HZ-005, HZ-006 | PA enable and TX sequencer, keyer, audio limiter | HostUnit; Bench demonstration |
| e. Rejection of out-of-sequence commands | PA enable refused unless T/R is in TX and settled, the bias sequence is complete and the permit flag is fresh; transmit arming refused before the interlock passes and while VBUS is present; charge enable refused unless temperature, voltage and cell-match prerequisites hold, and while the radio is switched on; configuration writes only through the guard | L2 only for the T/R, bias and permit sequencing (REQ-SW-SAFE-005, PDR); related L1: REQ-SYS-052, 087, 093 | HZ-002, HZ-004, HZ-007, HZ-011 | PA enable and TX sequencer, battery and charging supervision, configuration guard | HostUnit sequencing tests |
| f. Detection of inadvertent memory modification with recovery | Keying, permit and set-frequency values stored with their bitwise complement and checked before every use and every 1 ms tick; configuration RAM copy CRC-32 checked; image CRC-32 at boot; on mismatch, safe state, reload from the two-copy flash store, log, Fault on repeat | L2 only for RAM state (REQ-SW-SAFE-006, PDR); image and stored configuration: REQ-SYS-132, 134 | HZ-004, HZ-008, HZ-014 | Safe-state manager and configuration guard, keyer, PA enable, frequency control | HostUnit with mocked corruption; Emulation memory-poke scenario for ordering |
| g. Integrity checks on inputs and outputs | Key inputs debounced (2 ms make, 5 ms open, TBR by PDR) and stuck-input checked; PA thermistor, cell voltages (two dissimilar paths), charger status, the ALC detector and the GPIO24 VBUS sense (against the charger's VBUS status) range- and plausibility-checked; synthesizer lock and register read-back; jack-detect inputs debounced; TX_KEY and PA_EN read back through SIO | REQ-SYS-047, 048, 051, 088; REQ-SW-SAFE-007 | HZ-002, HZ-003, HZ-004, HZ-005, HZ-007, HZ-008, HZ-010, HZ-011, HZ-014 | Keyer, thermal protection, battery and charging supervision, PA enable, frequency control | HostUnit vectors; Bench |
| h. Prerequisite checks before safety-critical commands | Before PA_EN high: set frequency inside 144.0012 to 147.9988 MHz (TBR; package decision 25) and the counted frequency of K7 agreeing with it (package decision 40); PA temperature below the inhibit limit; pack above 6.4 V (TBR); VBUS absent; T/R in TX and settled; TX armed by the interlock; guest lock not set; manual-closure timeout, no-gap watchdog and test-mode timeout not expired; no open Fault; one decision per prerequisite in a single function (MC/DC table) | REQ-SYS-003, 009, 065, 097, 099, 118, 182 (182 adopted at SRR, package decision 40); REQ-SW-SAFE-008 | HZ-001, HZ-002, HZ-003, HZ-004, HZ-006, HZ-007, HZ-008, HZ-011, HZ-014 | PA enable and TX sequencer, battery and charging supervision | HostUnit: each prerequisite false alone blocks; all true permits |
| i. No single software event initiates an identified hazard | RF needs a keyer key-down AND a separately maintained PA-permit flag, both refreshed periodically. Outside software: the hardware cutoff bounds a continuous key-down to 13 s; the pull-downs, the fail-safe T/R relay and the hardware VBUS inhibit hold reset, bootloader and USB-powered states; a toggling TX_KEY stream is bounded in hardware by the transmission-length backstop (HZ-004 K12, adopted at SRR, package decision 38); an out-of-band frequency word is caught by the verification unit, independent of `SW-SYNTH` (HZ-008 K7, adopted at SRR, package decision 40); charging: charger IC and protectors limit independently of software; audio: the hardware ceiling; PA over-temperature: the hardware cut-off (HZ-003 K9, adopted at SRR, package decision 39) | REQ-SYS-055, 071, 083, 092, 119, 120, 180, 181, 182 (180, 181 and 182 adopted at SRR by package decisions 38, 39 and 40); REQ-SW-SAFE-009 | HZ-001, HZ-004, HZ-006, HZ-008 | Keyer, PA enable, safe-state manager, frequency verification unit | Inspection (independent review of the fault tree per hazard, section 8) plus HostUnit fault injection; Bench timing of the cutoff and the backstop |
| j. Response to off-nominal conditions in time to prevent the hazard | Manual-closure timeout 5 s (below the hardware minimum 7.5 s); tune carrier ends at 5 s (below 7.5 s; package decision 36); paddle watchdog 128 identical elements, 30 s without a 7-dit or 500 ms gap, squeeze 2 s (TBR; adopted at SRR by package decision 37, replacing the 10 s cap of REQ-SYS-054 as written; 128 dits take about 6.1 s elapsed at 50 WPM); test-mode timeout 120 s (TBR; package decision 41; below the 150 s floor of the backstop); key-up to envelope fall start within one sample plus the 5 ms open debounce; PA over-temperature to PA_EN low within 100 ms of threshold crossing (sampled at 20 Hz); VBUS detection to transmit disarm within one sample; charge disable within one supervision period of a fault; audio limiter attack at or below 1 ms and receive mute within 2 ms of key-down; Fault-safe RF removal within 10 ms (TBR); CPU watchdog 2 s (TBR). Values are proposals fixed at PDR by the thermal and electrical analyses | REQ-SYS-004, 020, 053, 054, 075, 118, 131, 184, 188, 189; REQ-SW-SAFE-010 | HZ-001, HZ-002, HZ-003, HZ-004, HZ-005, HZ-006, HZ-007, HZ-011, HZ-012 | PA enable and TX sequencer, keyer, thermal protection, battery and charging supervision, audio limiter, scheduler | HostUnit on the injected clock as the closing Test; Bench logic capture on the delivered unit with the dummy load; Emulation for event ordering only, never timing (SI-026, ACC-EMU-001) |
| k. Error handling | Every fallible operation returns a `Result`; errors are handled locally or escalate to the safe state; no unhandled panic on a release path; sensor, bus and counter errors degrade to inhibit, never to permit | L2 only (REQ-SW-SAFE-011, PDR) | HZ-002, HZ-004, HZ-005, HZ-008, HZ-014 | all | Inspection (static analysis against the 07 coding standard); HostUnit error-path tests |
| l. Software can place the system in a safe state | Two calls of the safe-state manager. The full safe state (PA off, key up, T/R to receive, charge disabled, audio muted) is applied on every reset (watchdog, brown-out), panic and latched fault (ConOps Table 3.4-4 rows 9 to 15) and on the operator's power-down (power button). Inhibit-class causes and the flags (the key-down timeouts and watchdogs, the thermal inhibit, the band guard, the USB and low-battery flags; rows 1 to 8) apply the transmit part only (PA off, key up, T/R to receive): the stuck-key sidetone keeps sounding and charging is unchanged (REQ-SYS-130, REQ-SYS-004; ConOps appendix D item D6). A failed frequency verification during transmission enters Fault-safe under REQ-SYS-154, adopted with REQ-SYS-182 by package decision 40; its display text, and the class of the backstop and hardware cut-off events, are ConOps appendix D item D19 (PDR) | REQ-SYS-004, 130; REQ-SW-SAFE-012 | HZ-001, HZ-002, HZ-003, HZ-004, HZ-005, HZ-006, HZ-007, HZ-008, HZ-011, HZ-014 | Safe-state manager | HostUnit; Bench |

07 section 14.2 was reconciled with this table (OQ-SAF-022 Answered at 0.4.0-pha; section 11.1 item 2 keeps the record). If a difference reappears, the order of precedence of 03 section 5 applies: this section for provision text and numbers, 03 section 5 for allocation, 07 section 14.2 for implementation detail.

## 8. Fault tolerance philosophy and single point failures

### 8.1 Philosophy (SRR entrance row 15; NPR 7123.1D App. G Table G-4 success criterion on single point failure and fault tolerance)

1. **Hardware before software.** For PA enable on a continuous key-down (REQ-SYS-055), the transmit inhibit with USB power (REQ-SYS-092), the charging cut-off (REQ-SYS-081, 083) and the audio ceiling (REQ-SYS-071, 073), the primary control is a hardware device or a passive network that acts with no firmware involvement (SEMP section 7.1); firmware adds detection, reporting and a dissimilar second layer (REQ-SYS-053, 054, 002, 088, 074). Two further hardware controls were adopted at SRR because firmware is otherwise the only automatic control of their branches: the transmission-length backstop (HZ-004 K12, REQ-SYS-180, package decision 38) and the over-temperature cut-off (HZ-003 K9, REQ-SYS-181, package decision 39).
2. **No single software event initiates a hazard (SWE-134 i), and no single software fault sustains a continuous carrier.** Every path from firmware to RF passes a hardware element with an independent time or state bound for a continuous key-down (the PA-enable monostable, REQ-SYS-055) and for reset, bootloader and USB-powered states (the pull-downs, the fail-safe relay and the VBUS inhibit: REQ-SYS-119, 092, 149); in firmware, RF needs two independent conditions (REQ-SYS-120). For two branches this item holds only through controls the owner adopted at SRR on 2026-09-26: a toggling TX_KEY stream retriggers the monostable and is bounded in hardware only by K12 (REQ-SYS-180, package decision 38; HZ-004 rows 4 to 8, HZ-014 C5), and an out-of-band fundamental from a frequency-control fault has no hardware bound at all, because the harmonic filter passes it, so its independence comes only from the verification unit K7 (REQ-SYS-182, package decision 40), a separate unit with a dissimilar method (count versus compute). Section 8.3 keeps the record of what a decline would have left.
3. **Catastrophic hazards (the lithium-ion cell, HZ-002 and HZ-007).** Two-fault tolerance for overcharge rests on the 4.30 V further layer and a sense path per protection layer (HZ-002 K3, K9), ordered at SRR by package decision 72 and written as REQ-SYS-185 and REQ-SYS-186 (OQ-SAF-008, OQ-SAF-009 answered): with them the branch has the charger regulation and OVP (REQ-SYS-081), the 4.25 V protector (REQ-SYS-083), the 4.30 V layer (REQ-SYS-185) and firmware dual sensing (REQ-SYS-088) on separate sense paths (REQ-SYS-186), and HZ-002 is carried at Catastrophic-E, Medium; until K3 and K9 are verified the shared MID sense net stays the named single point of section 8.2 row 5. Every other cell cause is at least single-fault tolerant with dissimilar layers: charge temperature window REQ-SYS-082 (charger JEITA with the firmware check, sharing the NTC single point of section 8.2 row 6), charge timer REQ-SYS-089, insertion check REQ-SYS-087; discharge side, protector REQ-SYS-084 and fuse REQ-SYS-085 with the firmware soft cut-off REQ-SYS-096 to 099 and the rail window REQ-SYS-166, reverse insertion REQ-SYS-086. The Catastrophic fire case of HZ-015 is zero-fault tolerant until the owner confirms an auto-sleep station (K1; requirement pending, OQ-SAF-019).
4. **Critical hazards that firmware can initiate (HZ-004, HZ-008 C7, HZ-014)** are single-fault tolerant with dissimilar controls for a continuous carrier (firmware timeout plus hardware monostable plus reset-safe states), and single-fault tolerant for toggling streams with K12 and for the frequency-control branch with K7, both adopted at SRR (package decisions 38 and 40); section 8.2 rows 3 and 4 record the single points those decisions remove. The requirements are REQ-SYS-053, 054, 055, 180 and 184 (with 187, 188 and 190 for the bench test mode) for HZ-004 (with the interlock REQ-SYS-052 and the watchdog REQ-SYS-131), REQ-SYS-009, 154 and 182 for HZ-008 C7, and REQ-SYS-132, 119 and 180 for HZ-014. HZ-003, Critical since 0.2.0-pha, is single-fault tolerant on its thermistor-failure branch with the hardware over-temperature cut-off K9 (REQ-SYS-181, adopted at SRR, package decision 39) beside the firmware inhibit (REQ-SYS-118, 155). Critical hazards whose last barrier is a person (HZ-006) are backed by safe defaults and timeouts (REQ-SYS-011, 063, 064, 020, 065, 066) so that a rule violation alone does not produce the exceedance; the operator's discipline is the named single point of section 8.2 row 20.
5. **Marginal hazards** may be zero-fault tolerant in hardware when the consequence is bounded to first aid and the control is verified on every unit: HZ-009 (REQ-SYS-106), HZ-010 (REQ-SYS-049, 050, 079), HZ-011 (REQ-SYS-092 with REQ-SYS-002 as its dissimilar layer), HZ-012 (REQ-SYS-020, 055, 180) and HZ-013 (REQ-SYS-110, 111); the Analysis-closing ones are listed in section 9 item 3. The harmonic filter of HZ-008 (REQ-SYS-017, 018, 151; REQ-TX-007 to REQ-TX-012) is the one accepted Critical exception, because a five-unit series is measured per unit (section 8.2 row 10).
6. **Operator procedures and documentation are never the sole control of a Critical or Catastrophic hazard.** The handbook and legend controls (REQ-SYS-122, REQ-SYS-124) always sit beside a design, hardware or software control of the same hazard. HZ-015 meets this only with the station of K1, typed Hardware interlock since 0.4.0-pha because its auto-sleep acts without the owner (the practice is K6); both have no requirement yet (OQ-SAF-019), so today HZ-015 does not meet this item and its residual is outside the section 3.4 Serious terms (section 5, HZ-015).
7. **Every control of a Critical or Catastrophic hazard is verified by Test, except the cases below.** Each exception closes by the Analysis method with the acceptance recorded against the risk its requirement cites (04 section 7.3 rule 6), never hidden in a requirement. The table is the complete list at 0.4.0-pha: it was recomputed from `hazards.json` against every requirement file (every `control_req_ids` entry of a Critical or Catastrophic hazard whose `verification_method` is not Test). Where the cited risk does not carry the hazard, the row says so and OQ-SAF-026 asks for the correction:

| Hazard (severity) | Control | Requirement | Acceptance | Why no Test at project scale |
|---|---|---|---|---|
| HZ-003 (Critical) | K1, K7 junction temperature | REQ-SYS-112 | RSK-006 | No junction measurement; NTC logging on the Bench is supporting |
| HZ-005 (Critical) | K7 ceiling after a single failure | REQ-SYS-073 | RSK-017 | Injecting each failure destroys the output network |
| HZ-005 (Critical) | K4, K5 transients below 10 mV peak | REQ-SYS-076 | RSK-017 | No oscilloscope on the bench |
| HZ-006 (Critical), also HZ-001 | K4 and HZ-001 K8, the RF exposure evaluation | REQ-SYS-121 | RSK-016 | No SAR measurement path |
| HZ-007 (Catastrophic) | K1, K2 over-current and short | REQ-SYS-085 | RSK-007 | A component-level Test is feasible and requested (OQ-SAF-018); until adopted this is an exception |
| HZ-008 (Critical) | K4 carrier accuracy over temperature and aging | REQ-SYS-010 | RSK-011 (carries HZ-008; RSK-002 stays the netting-offset risk) | No frequency counter; tinySA against an off-air reference is supporting |
| HZ-003 (Critical) | K1, K7 hand-hold surface temperature after 5 min | REQ-SYS-113 | RSK-006 | A Bench Test of the surface temperature becomes feasible if OQ-VV-003 confirms a thermocouple for the multimeter (the REQ-SYS-113 note makes the surface reading conditional on it); the conversion is requested in OQ-SAF-026; until adopted this is an exception |
| HZ-005 (Critical) | K4 receive mute at key-down, held through transmit and hang, restore fade | REQ-SYS-075, REQ-SYS-157, REQ-SYS-158 | RSK-017 | No oscilloscope for the analog mute depth and fade shape; the software children close by HostUnit Test |
| HZ-006 (Critical), also HZ-001 | K4 and HZ-001 K8, delivered antenna gain | REQ-SYS-172 | RSK-016 | No calibrated antenna range; tinySA Ultra against a reference dipole is supporting |
| HZ-008 (Critical) | K4 keying envelope and occupied bandwidth | REQ-SYS-014, REQ-SYS-015; L2 REQ-TX-005, REQ-TX-006 | RSK-011 | No oscilloscope for the RF envelope; the requirements close by Simulation of the envelope and its FFT, with Bench logic capture of the ramp steps and the tinySA Ultra max-hold spectrum as supporting evidence (REQ-SYS-014, 015 verification notes) |
| HZ-015 (Catastrophic) | K3 part-category split | REQ-SYS-137, REQ-SYS-138 | RSK-034 (carries HZ-015) | The split is a property of the BOM, CPL and hand-assembly file, checked by analysis, with receipt Inspection supporting |
| HZ-002, HZ-003, HZ-004, HZ-005, HZ-006, HZ-007 | Handbook controls HZ-002 K8, HZ-003 K6, HZ-004 K10, K11, HZ-005 K8, HZ-006 K4, K8, HZ-007 K7 | REQ-SYS-122 | One risk per hazard, the risk that carries it: RSK-016 (HZ-001, HZ-006, HZ-012), RSK-007 (HZ-002, HZ-007, HZ-011), RSK-006 (HZ-003), RSK-024 (HZ-004), RSK-017 (HZ-005), RSK-025 (HZ-009), RSK-018 (HZ-013) | A document control has no Test; its content is checked against the control list |
| HZ-006 (Critical) | K7 enclosure legend | REQ-SYS-124 | RSK-016 | A marking has no Test; it is checked on the drawing and the delivered unit |

Documentation and label controls of Critical and Catastrophic hazards (REQ-SYS-122, REQ-SYS-124) close by the Analysis method accepted per RSK-016, listed above; the HZ-015 procedure and station controls (K1, K2, K4, K5, K6) will be added to this table or closed by Test when OQ-SAF-019 gives them a requirement.

### 8.2 Single point failure candidates (preliminary; finalized at PDR, 01 PDR row 11)

| # | Item | Hazard | Effect of the single failure | Disposition |
|---|---|---|---|---|
| 1 | Hardware cutoff timing capacitor (10 uF ceramic, DC-bias derating) | HZ-004 | Value loss shortens T_max: with the tune bound of REQ-SYS-020 (at most 5.5 s, TBR) the margin to the 7.5 s floor is 2 s; an open lengthens T_max toward indefinite, a latent loss of the backstop | Bench timing of T_max at TRR and at every ATP; capacitor chosen from its DC-bias curve (R-KN1); tune value and the 74LVC1G123 ruled at SRR by package decision 36, option a (OQ-SAF-005 closed) |
| 2 | Envelope modulator pass element shorted | HZ-004, HZ-008 | PA fed regardless of the cutoff, the backstop and the ALC, which all act on that node | PDR: cutoff also removes gate bias, or a second series element (R-KN5) |
| 3 | No hardware bound for a toggling TX_KEY stream | HZ-004, HZ-014 | Only firmware K4 and K13 stop it; a pin-map error can defeat both | Removed by the transmission-length backstop K12 (REQ-SYS-180), adopted at SRR by package decision 38 (OQ-SAF-003 closed); credited when verified |
| 4 | Frequency-word path in `SW-SYNTH` | HZ-008 | One software fault places 5 W on 150 to 174 MHz; REQ-SYS-009 checks in the same component | Removed by the independent frequency verification K7 (REQ-SYS-182), adopted at SRR by package decision 40 (OQ-SAF-013 closed), with the safety-critical classification of decision 9 (section 6.3 item 6); credited when verified |
| 5 | Shared MID sense net and holder junction | HZ-002, HZ-007 | Per-cell over- and under-voltage detection blinded in every layer | Separate sense path per layer (HZ-002 K9 and HZ-007 K3, REQ-SYS-186, ordered at SRR by package decision 72; OQ-SAF-009 answered); removed once verified |
| 6 | Cell NTC decoupled from the cell | HZ-002 | Charger JEITA and firmware lock-out both read board temperature | Placement design plus bench thermal check; single point for the temperature window |
| 7 | Protector FET pair shorted | HZ-007 | Over-current and over-discharge cut lost | Fuse or PTC backs over-current and short; firmware soft cut-off backs over-discharge (dissimilar) |
| 8 | PA thermistor reading cold | HZ-003 | Fold-back and inhibit defeated during normal long keying; no control independent of firmware | Removed by the hardware over-temperature cut-off K9 (REQ-SYS-181), adopted at SRR by package decision 39 (OQ-SAF-012 closed); range and plausibility check and on-die cross-check as the firmware layer |
| 9 | Output divider shunt element open | HZ-005 | Headphone level to amplifier full scale, 113 to 120 dB SPL | Removed by topology (redundant shunt or bounded open failure), Analysis at PDR |
| 10 | Harmonic low-pass filter element open or shorted | HZ-008 | Attenuation lost at 2f or 3f | Accepted single point: measured per unit at ATP with a filter test point (RSK-011 S3) |
| 11 | ALC forward-power detector reading low | HZ-008, HZ-003 | Full output at full charge (10 W class) | Bounded by device saturation and the 7 dB filter margin; plausibility check |
| 12 | VBUS sense divider of the hardware inhibit open | HZ-011 | Transmit possible with USB present | Firmware inhibit K6 on the separate GPIO24 sense and the charge pause K2 |
| 13 | Hardware inhibit element failed in the permit state | HZ-011 | As row 12 | As row 12 |
| 14 | Antenna jack | HZ-009 | Broken connector, PA into open | Load path is the enclosure boss; PA survives open and short |
| 15 | TVS clamp at the key jack | HZ-010 | ESD protection degraded to the series resistor and secondary clamp | Accepted with Inspection |
| 16 | Release script CRC trailer | HZ-014 | A good image refused (fail-safe) | Accepted |
| 17 | The owner's attention at the bench, if the station has no auto-sleep | HZ-015 | An iron left on off its stand has no second barrier | K1 once the owner confirms the station (package decision 100, needed by CDR; plan confirmed at SRR); requirement due PDR (OQ-SAF-019) |
| 18 | The cells themselves (counterfeit, damaged or mismatched cells) | HZ-002 | A defective cell can vent under a normal charge that every layer permits | Accepted single point: outside the design's control; approved-cell list in the handbook (HZ-002 K8, REQ-SYS-122) and the insertion check (REQ-SYS-087); reviewed at PDR with the cell choice |
| 19 | Amplifier gain-select pins | HZ-005 | A wrong strap raises the gain 6 dB, headphone level above the ceiling design point | Fixed in copper, no firmware or jumper setting; Inspection of the layout at CDR; the per-unit ceiling measurement (REQ-SYS-071, Test) catches it on every unit |
| 20 | Operator discipline once the guest lock is released and the step raised | HZ-006 | A supervised guest can key a 2 W or 5 W carrier near a bystander | Accepted single point: the design bounds the consequence (1 W default, deliberate 5 W, tune timeout, key-down cutoff; REQ-SYS-011, 063, 064, 020, 055) but cannot remove it; the owner allowed guest keying at SRR (RFX-D8, package decision 20), so it stays an accepted single point; residual Critical-D, Medium, owner acceptance at SAR |
| 21 | Holder leaf-spring contact | HZ-007 | High resistance heats the contact at 2 A key-down pulses; an open contact stops the radio safely | Holder choice (D-PWR-04: two Keystone 1043P holders, ratified at SRR, package decision 73) and the Bench thermal check of cell and holder after a 5 min key-down (HZ-007 K5 verification); closing gate PDR with the holder selection |
| 22 | Pico 2 VBUS path, unrated by the vendor | HZ-011 | Overheating of the board's USB power path at the charging current | Bounded by the 500 mA input limit (HZ-011 K4) until the owner's measurement at 0.5, 1.0 and 1.5 A (package decision 102, RSK-033); closing gate PDR |

The former row 10 (charger CD pin diode-OR) is withdrawn with the superseded HZ-011 design. Rows 1 to 22 carry all 23 `single_point_failures` entries of `hazards.json` 0.4.0-pha (row 5 carries the HZ-002 and the HZ-007 MID sense entries); rows 18 to 22 were added at 0.4.0-pha (INSP-008 finding-4). Rows 2 to 4 and 7 to 9 close with the decisions or design actions named; rows 3, 4 and 8 lose their single point once the controls adopted at SRR (package decisions 38, 40 and 39) are verified; the list is finalized at PDR.

### 8.3 Residual if the owner declines package decisions 38 to 40 (SRR readiness item H8)

**Outcome at SRR (0.5.0-pha).** On 2026-09-26 the owner adopted package decisions 38 (REQ-SYS-180, 150 s to 180 s), 39 (REQ-SYS-181, 95 C +/-3 C, 100 ms) and 40 (REQ-SYS-182, 10 kHz, 100 ms) as recommended, with decision 9 (`docs/reviews/SRR/minutes.md`, key decision K2; `docs/reviews/SRR/decision-memo.md`). No decline case below applies, no requirement is retired and no control becomes Dropped; the residuals of section 4 stand. The rest of this section is kept unchanged as the record of the analysis the rulings rested on.

REQ-SYS-180, REQ-SYS-181 and REQ-SYS-182 exist at Draft with a TBR that closes at SRR on the owner's ruling, and each rationale states that a decline retires the requirement with the SRR decision memo as its basis. Under section 3.5 the controls they implement count toward the residuals of section 4. The table records, for each decision, the residual that holds if the owner declines it and the response section 3.4 then requires; the decision memo transcribes the row that applies, and the hazard's `residual_risk.condition` in `hazards.json` carries the same cases.

| Package decision | Control and requirement | Residual with the control | Residual if declined | Section 3.4 response to a decline |
|---|---|---|---|---|
| 38 | HZ-004 K12, REQ-SYS-180 (shared as HZ-001 K10, HZ-003 K10, HZ-006 K10, HZ-012 K6, HZ-014 K8) | HZ-004 Critical-D Medium (Critical-E Low after R-KN5); HZ-014 Critical-E Low; HZ-001, HZ-003, HZ-006 and HZ-012 unchanged | HZ-004 Critical-C Serious; HZ-014 Critical-D Medium; the others unchanged; single point row 3 open | HZ-004: not acceptable. Serious needs the owner's acceptance in a decision memo, at least two independent controls of which one is neither software nor procedure, and every control verified by Test; the toggling-stream branch then has only software (K4, K13) and procedure (K11) controls. The memo records the decline as a decision the section 3.4 response does not allow and names the alternative hardware control or design change, with its requirement, to be allocated before PDR (OQ-SAF-003). HZ-014: Medium, acceptable with its controls allocated and verified and the owner's acceptance at SAR |
| 39 | HZ-003 K9, REQ-SYS-181 | HZ-003 Critical-E Low | HZ-003 Critical-D Medium; single point row 8 open; the thermistor-failure branch zero-fault tolerant (section 8.1 item 4) | Medium: acceptable with the listed controls allocated and verified and the owner's acceptance at SAR; the memo records row 8 as an accepted single point and the exception to section 8.1 item 1 |
| 40, with 9 | HZ-008 K7, REQ-SYS-182 with REQ-SYS-154 | HZ-008 Critical-E Low | HZ-008 Critical-D Medium; single point row 4 open | Medium: acceptable with the listed controls allocated and verified and the owner's acceptance at SAR; the memo records row 4 as an accepted single point and the exception to section 8.1 item 2; concurrence with decision 9 alone does not change the level (section 6.3 item 6) |

Declining decision 38 leaves HZ-004 at a level that section 3.4 does not let the owner accept with the controls then left, so the package default for decision 38 ("not adopted", `docs/reviews/SRR/decisions-for-owner.md`) is not a baseline this analysis can accept unless the memo also names that alternative.

## 9. Hazard to requirement and verification traceability (SWE-052, SWE-184, SWE-192)

1. **Field contract.** `hazards.json` carries `requirement_ids` per hazard (the field `tools/traceability.py` reads and cross-checks against `hazard_ids` in the requirements: `HAZARD_UNRESOLVED`, `HAZARD_INVERSE`; 03 section 8 row 2; 02 section 7 row 2) and `control_req_ids` per control; `requirement_ids` is always their union. Control status: *Proposed* when the control is traced to existing requirements and an owner decision it depends on may be pending; *Requirement pending* when an element has no requirement (requested in `open_questions`); *Allocated* when every element is traced to a requirement baselined at SRR or later. A hazard moves to *Controls allocated* when every control is Allocated. At 0.4.0-pha every hazard has at least one pending owner decision and six (HZ-002, HZ-004, HZ-005, HZ-007, HZ-008, HZ-015) have a control in Requirement pending, so all fifteen stay at *Controls proposed*; this is by rule, not by omission. At 0.5.0-pha the SRR rulings leave only PDR and later decisions in `decisions_pending`, but the controls stay *Proposed* until their requirements are baselined: the L1 requirements become Active with `baseline/srr`, which is applied after the post-ruling work R16 is verified (decision memo section 10), and Claude then moves every control whose elements are all traced to baselined requirements to *Allocated*. The requirements the SRR rulings ordered are written (REQ-SYS-184 to REQ-SYS-190 and the reworded REQ-SYS-054, `cd61450`), so HZ-002 K3 and K9, HZ-004 K4 and K13 and HZ-005 K9 are *Proposed*; the controls still in Requirement pending (HZ-002 K7; HZ-005 K3; HZ-007 K5; HZ-008 K3; HZ-015 K1, K2, K4, K5, K6) wait on OQ-SAF-010, 015 and 019, due at PDR. At 0.5.0-pha `tools/traceability.py --report-only` reports no `HAZARD_INVERSE` warning; its 22 violations are on the requirement and test-case side (REQ-SYS-184 to 190 have no closing Test case yet; REQ-SYS-122, 124, 137 and 138 carry the Inspection method of CR-002, decision 113, which the tool does not yet admit), routed to their authors. `HAZARD_INVERSE` is promoted to a violation at PDR and `HAZARD_UNCONTROLLED` is added before PDR (03 section 8). At 0.4.0-pha (2026-09-25) `tools/traceability.py --report-only` reports 0 violations and no `HAZARD_INVERSE`, `HAZARD_CONTROL_UNTRACED`, `HAZARD_REQ_NOT_TESTED`, `HAZARD_UNRESOLVED`, `SAFETY_TAG_NO_HAZARD` or `HAZARD_REQ_NOT_ON_TARGET` finding (its only two warnings are `SYS_UNALLOCATED` for REQ-SYS-125 and REQ-SYS-148, outside this analysis). The 40 `HAZARD_INVERSE` warnings of 0.3.0-pha (23 in `docs/requirements/sw/sw-keyer/requirements.json`, 17 in `docs/requirements/tx/requirements.json`) are answered in this file: each L2 requirement that lists a hazard is now named in the `control_req_ids` of the control it implements, chosen by the control id its rationale names or, where it names none, by the control that names its parent (for example REQ-SW-KEYER-026 in HZ-004 K3, REQ-TX-013 in HZ-008 K7, REQ-TX-003 in HZ-006 K3 as the transmitter half of the guest-lock inhibit). 0.3.0-pha deferred these links to PDR on the schema description of `control_req_ids` ('REQ-SYS constraint-level controls at SRR, L2 at PDR'); that conflicts with 04 section 7.3 rule 6, under which a `HAZARD_INVERSE` disagreement blocks the readiness declaration of every gate, and with the bidirectional trace of SWE-052 and SWEHB swe-205 section 7.1 task 4, so the deferral is withdrawn and the links are made at SRR; the schema description still reads as before and its update is a request to the schema owner (Claude, lead SE). The 27 `HAZARD_REQ_NOT_TESTED` violations that INSP-008 counted for REQ-SW-KEYER-002, 019 to 031, 033 and REQ-TX-002, 003, 004, 007 to 015 no longer appear: the sw-keyer and tx test-case files now carry their closing cases (REQ-TX-005 and REQ-TX-006 close by the Analysis method accepted per RSK-011, section 8.1 item 7). REQ-SYS-180, 181 and 182 are cited by TC-SYS-108, 109 and 110. `HAZARD_INVERSE` is still to be promoted to a violation at PDR and `HAZARD_UNCONTROLLED` added before PDR (03 section 8).
2. **Requirement rules.** Every requirement that implements a control carries the `safety` tag and the hazard id in `hazard_ids` (02 section 2.3 tag obligations); its rationale names the hazard and the control id (for example "control for HZ-004 K5"); the safety constraints, controls, mitigations and assumptions between hardware, operator and software (SWE-184) are the controls typed Hardware interlock, Operator procedure and Software in this file and are written into the `SW-SAFE` requirement file (07 section 4 item 3). Regulatory controls (HZ-006 K4, HZ-008 K1, K4) also carry the `regulatory` tag with the 47 CFR clause in `source_ids`. Procedure and documentation controls placed in the handbook trace to REQ-SYS-122 by a checklist item named with the control id ("HZ-004 K11"); the retired REQ-SYS-123 carries no control, and MOE-008 usability runs (TC-VAL) are supporting validation, not control verification.
3. **Verification rules.** Every `REQ-SW-*` with `hazard_ids` closes by Test (SWE-192; 04 section 5). The verification note of each hazard names the evidence class of charter section 9 (Simulation, HostUnit, Emulation, Inspection, Bench, OnAir): HostUnit is the primary software evidence (SI-026), Emulation is for event ordering only under ACC-EMU-001 and never for timing, Bench is the hardware integration evidence. Non-software hazard controls close by Test where the owner's instruments can measure them and otherwise by Analysis with a `verification_note` beginning "Analysis accepted per RSK-NNN" (04 section 7.3 rule 6). The Critical and Catastrophic cases are the table of section 8.1 item 7; the Marginal cases are REQ-SYS-050 (HZ-010 ESD), REQ-SYS-106 (HZ-009 mating life), REQ-SYS-110 and REQ-SYS-111 (HZ-013). Two of those requirement notes cite a risk that no longer carries the hazard (REQ-SYS-050 cites RSK-012, the register now carries HZ-010 in RSK-024; REQ-SYS-106 cites RSK-018, HZ-009 is in RSK-025; OQ-SAF-017).
4. **Review products.** PDR: the hazard-to-requirement table (every control with its `REQ-*`, no control left in Requirement pending) and the single point failure list; CDR: the hazard-control-verification table (every control requirement with its `TC-*`); TRR: the test safety section below reviewed and acknowledged by the owner; SAR: controls verified, residual risks accepted in the decision memo, `status` Controls verified or Accepted.

## 10. Test and bench safety provisions (TRR entrance row 7)

These provisions are written into the `Safety:` line of every Bench and OnAir case (04 section 7.3 rule 7) and into the TRR package.

| Provision | Rule | Hazards |
|---|---|---|
| Hand assembly | Temperature-controlled station on its stand with auto-sleep; fume extraction; eye protection; no food or drink at the bench and hands washed after soldering; cells removed and USB disconnected during any soldering or rework; ESD wrist strap and earthed mat; station, alloy and every rework recorded in the as-built record, confirmed in the TRR package | HZ-015, HZ-007 |
| RF into the dummy load only | No antenna-connected transmission until the 47 CFR 97.307 spurious and harmonic cases have passed on that unit, the frequency verification case (HZ-008 K7, adopted at SRR, package decision 40) has passed, and the on-air authorization is recorded in the TRR decision memo | HZ-008, HZ-001, HZ-006 |
| Power-on sequence | Stages 0 to 6 of 04 section 11.2 in order; PA supply disconnected by its jumper or fuse until stage 7; bench supply current limit set per stage; PA enabled first at reduced supply voltage (RSK-001 S6) | HZ-003, HZ-004, HZ-007 |
| Stuck-key abort | Every keyed test has a named abort action (unplug the key, power switch off) that stops a continuous key-down and a toggling stream alike; the hardware cutoff and backstop timing tests are run with the PA disconnected; the operator wears headphones or watches the TX indicator during every keyed step | HZ-004 |
| Bench test modes | Test modes only into the dummy load at the forced 0.5 W step; headphones off the ear during the full-scale tone; the named abort is the power switch; a test mode is left before any other case starts | HZ-004, HZ-005 |
| PA thermal limit | Continuous key-down limited to 60 s until the thermal test passes, then 5 min with the NTC logged and the surface temperature read with the multimeter thermocouple; stop above 60 C surface | HZ-003 |
| Battery and charger handling | Cell-substitution tests with a current-limited bench supply per cell, never with real cells; real-cell charge test only after the protector thresholds have passed; cells inspected for wrap damage; charging attended; a metal tray and a Class D or sand extinguishing means at hand | HZ-002, HZ-007 |
| Headphone level | No headphones on the operator during the full-scale test tone; the 32 ohm resistive load and the multimeter first; headphones only after the 100 mVrms ceiling is confirmed; the 30 mV default cap active for listening checks | HZ-005 |
| RF exposure during OnAir | Operator at the mobile posture (antenna 20 cm or more from head and torso), others at 1.0 m or more, 1 W step for the first on-air checks, 5 W only after the power-per-step measurement; the exposure note quoted in the case | HZ-001, HZ-006, HZ-012 |
| ESD and handling | Antistatic wrist strap when the board is handled without the enclosure; jacks not touched while keyed | HZ-010, HZ-012 |
| Firmware load | Only tagged releases from `firmware/releases/`; `picotool verify` after every flash; the TC-SW-BOOT and TC-SW-CFG cases before any keyed step; the keying cases re-run after any release that changes the pin map | HZ-014 |
| USB power near keyed steps | The USB cable is disconnected from the unit before any keyed step (flashing and USB logging are done with the key unplugged and the PA supply jumper open), unless the VBUS transmit-inhibit case of REQ-SYS-092 (with the firmware inhibit of REQ-SYS-002) has passed on that unit, in which case a keyed step with USB connected is run only to verify that inhibit. Named abort: if the TX indicator lights or the dummy-load power reading rises while USB is connected, switch the power switch off and unplug the USB cable, then open an NCR | HZ-011, HZ-014 |
| Mechanical | Machined parts snag-tested and deburred before assembly; antenna removed when the unit is not under test | HZ-013, HZ-009 |

## 11. Owner decisions pending and open items

**Rulings at SRR (0.5.0-pha).** On 2026-09-26 the owner ruled every key decision and every consent-agenda decision as recommended (`docs/reviews/SRR/minutes.md`; `docs/reviews/SRR/decision-memo.md`). Every SRR decision listed in the next paragraph is therefore taken as recommended, with two refinements recorded at the ruling: decision 25 set the band-edge guard to 1.2 kHz (144.0012 to 147.9988 MHz, TBR), and decision 48 exposes the debounce in the menu, which conflicts with the fixed counts of HZ-004 K9 and HZ-010 K3 (OQ-SAF-027, due PDR). Decision 100 is needed by CDR; the consent agenda confirmed its plan only. `decisions_pending` now lists only decisions due at PDR or later and the PDR design actions. The paragraph that follows is kept as the pre-ruling record.

Decisions the controls depend on are listed per hazard in `decisions_pending`, by research id and, since 0.3.0-pha, by SRR package section 13.1 decision number. The ones the owner takes at SRR: RFX-D1 and D2 (power steps, 1 W default and deliberate 5 W; package decisions 22 and 23); RFX-D3 together with D-KN2 (tune carrier 0.5 W with a timeout below the 7.5 s cutoff floor, REQ-SYS-020 at most 5.5 s, and the hardware cutoff at 10 s; decision 36, OQ-SAF-005); RFX-D8 (whether non-licensees may key at all; decision 20); DECISION-6 and DECISION-7 (OPS-A, guest lock; decisions 17 and 19); D-KN3 (manual-closure timeout 5 s including the Bug-mode dah; the no-gap paddle watchdog with the squeeze limit; decision 37); the transmission-length backstop HZ-004 K12 (brought forward from PDR; REQ-SYS-180, decision 38); the hardware over-temperature cut-off HZ-003 K9 (brought forward from PDR; REQ-SYS-181, decision 39); the independent frequency verification HZ-008 K7 (REQ-SYS-182, decision 40) with the safety-critical classification of frequency control (section 6.3 item 6; decision 9); the bench test-mode guard HZ-004 K13 (decision 41); D-KN8 (mono plugs by interlock and menu; decision 44); D-PWR-03 (protection topology with the 4.30 V layer, which needs a requirement, and the Kelvin sense constraint; decision 72); D-PWR-07 (receive while charging with charging paused; decision 75); audio D2 (level policy; decision 64); the hand-assembly bench equipment (station with auto-sleep, extractor, alloy; decision 100); concurrence with the section 6.3 deltas (decision 9). Section 8.3 gives the residual if decisions 38 to 40 are declined. PDR decisions: the cutoff node versus PA topology (R-KN5); SWR fold-back; secure boot; the prescaler, counter and timebase of K7; the node of the HZ-011 hardware inhibit. PDR design actions named in `decisions_pending` that are not SRR decisions (INSP-008 finding-13): A-PWR-03 (HZ-007 FET, fuse and P-FET selection, after decision 72), ANT-06 (HZ-010 common-mode chokes, meeting REQ-SYS-051) and ANT-03 (HZ-012 counterpoise attachment; the counterpoise tail itself is decision 81). A-KN5 (HZ-010 bounce capture) is covered by decision 50.

### 11.1 Open items

Closed at this revision: the former item 1 (`tools/validate_docs.py` now has the `hazards` convention and the file passes) and the former item 2 (`tools/traceability.py` now validates `hazards.json` against its schema).

1. 03 sections 4.2, 4.3, 5 and 9 are re-transcribed from 0.3.0-pha (OQ-SAF-023 closed at 0.4.0-pha, which changes no firmware role); the owner concurred with section 6.3 at SRR (package decision 9, 2026-09-26); the lead SE's joint edit of 03, 07, SEMP, charter and `rmm.json` remains (OQ-SAF-014).
2. 07 section 14 differences found on 2026-09-25 (OQ-SAF-022). **Answered at 0.4.0-pha:** the working tree of 07 section 14.1 and 14.2 now matches sections 6.2 and 7 for every sub-item below (checked row by row); the two stale notes in 07 section 14.1 about the pending 03 re-transcription were removed at 07 revision A.4. The list is kept as the record of what was reconciled:
   - 14.1 safe-state manager row: hazards HZ-001, HZ-002, HZ-004, HZ-007, HZ-014 and criteria a, c, e; hazards.json names it for HZ-001 to HZ-007, HZ-011 and HZ-014, union a, b, c, e (03 already records a, b, c, e); fault annunciation (03 item X1 v) and the TX_KEY no-gap and squeeze watchdog not listed as units.
   - 14.1 scheduler row: hazards "HZ-001, HZ-003, HZ-004 and every hazard whose control is a monitor task", criteria a and c; hazards.json names HZ-001 to HZ-007, HZ-011 and HZ-012, union a, b, c, e.
   - 14.1 `SW-TXSEQ` row: "charge de-assert before the T/R sequence" is the superseded HZ-011 design; the VBUS-absent and frequency-verified prerequisites and the test-mode guard are missing; HZ-008 to be added to its hazards.
   - 14.1 `SW-PWR` row: "charge inhibit during transmit" to read "charge pause while switched on and VBUS reading".
   - 14.1 mission-critical paragraph: `SW-SYNTH` per section 6.3 item 6; the frequency verification unit and a PIO or timer capture driver if K7 is adopted.
   - 14.2 row d: a per-power-cycle TX-arm control action that this analysis does not have (transmit arms through the interlock); the override text cites 03 section 5 item d (03 item X3), whereas section 7 row d here has no override of the thermal inhibit, the key-down timeouts, the no-gap watchdog or the backstop in rev A.
   - 14.2 row h: "charger not in fault and charge enable de-asserted (HZ-011)" to become "VBUS absent"; "duty-cycle budget not exceeded" is not a prerequisite here and would conflict with RFX-D4 (the accumulator is a convenience function) unless defined as a safety function.
   - 14.2 row i: "the hardware over-temperature cut (if the hazard analysis requires one)" is now proposed (HZ-003 K9, REQ-SYS-181); the transmission-length backstop (HZ-004 K12, REQ-SYS-180) to be added.
   - 14.2 row j: TX time-out 60 s versus 5 s manual closure, 30 s no-gap, 2 s squeeze, 10 s hardware cutoff and 180 s backstop; watchdog 100 ms versus 2 s (REQ-SYS-131, TBR); key-up to PA_EN low 2 ms versus key-up to envelope fall start within one sample plus the 5 ms open debounce (different reference points; the definition must be reconciled); the 1 s battery shutdown and 10 ms PA over-current budgets are 07 additions not contradicted here.
   - 14.2 module rows: `SW-TXSEQ` "charge enable de-asserted before the T/R changeover (HZ-011, e, j)" and `SW-PWR` "charge disable ... before any T/R-to-TX sequence (j, HZ-011)" use the superseded design; `SW-KEYER` applies a, b, c, d, f to l, but HZ-004 now carries item e, so the union is a to l; `SW-SYNTH` per section 6.3 item 6.
   - Checked and aligned (two items of the review no longer apply to the current 07 text): row g debounce is 2 ms make and 5 ms open; row h band edge is 144.001 to 147.999 MHz. 03 section 4.3 still says "band-edge limits 144 to 148 MHz" (OQ-SAF-014).
3. Risk register actions (OQ-SAF-020): done for items 1, 2, 3 (RSK-046 names HZ-008 and HZ-008 names RSK-046 at 0.4.0-pha) and 4 (RSK-006 and RSK-026 at safety 4; RSK-034 carries HZ-015 at safety 5 and HZ-015 names it back; RSK-024 names the toggling-stream gap and K12); the optional RSK-028 link to HZ-006 is withdrawn; item 6, the 06 section 7 level 4 wording for operator exposure, is in the committed 06 (blob `7a92d21f`). OQ-SAF-020 is Closed at 0.4.1-pha.
4. ANT-02 mating cycles: resolved; REQ-SYS-106 uses the 500 cycle stainless rating.
5. The touch-temperature figure (48 C) and the edge-break minimum (0.5 mm) are project proposals; the standards they echo are not in the corpus.
6. The half-wave whip tip voltage of about 100 V rms (HZ-012) is a derived order-of-magnitude figure; a measurement or a NEC estimate at PDR would replace it.
7. Primary SAR data for VHF PTT radios and KDB 447498 remain unfetched (`docs/research/rf-exposure-evaluation.md` open items 1, 2); HZ-001 and HZ-006 rest on the two ARRL articles until the owner downloads them (RFX-A2).
8. The burn threshold behind HZ-003 (about 55 C for minutes) and the colophony fume property behind HZ-015 C3 are general knowledge not in the corpus; the 150 to 174 MHz allocation and the 156.8 MHz channel behind HZ-008 C7 are not in the regulatory corpus (OQ-SAF-024).
9. A `tools/render_hazards.py` (matrix and list render, history consistency, `control_req_ids` union check, open-question cross-check) would mirror `render_risk.py`; not required for SRR.

### 11.2 Requests to other authors (`open_questions` in `hazards.json`)

Statuses as reconciled on 2026-09-25 against SRR package section 18.1 (readiness item H7); the `resolution` field of each question in `hazards.json` gives the evidence where the product answers it, what remains and who acts. Of the 17 questions due at SRR at 0.3.0-pha, 4 are Closed (OQ-SAF-004, 011, 021, 023) and 1 Answered (OQ-SAF-022) at 0.4.0-pha; 8 wait on an owner ruling named by its package decision (OQ-SAF-001, 002, 003, 005, 012, 013, 014, 016); 4 wait on a named author's edit before the readiness declaration (OQ-SAF-006 after decisions 37, 38 and 41, OQ-SAF-007, 017 and 020 item 6). 0.4.0-pha raises two more due at SRR (OQ-SAF-025, 026). For each author-edit question the `resolution` states the fallback INSP-008 finding-8 names: if the edit is not made before the readiness declaration, the owner re-dates the question in the SRR decision memo (proposed close_by PDR) and this file records the new `close_by`; they are listed for the package decision list (package section 18.1). A question whose requirement side is answered stays Open until the ruling it depends on is transcribed into the SRR decision memo. **Update at 0.4.1-pha (2026-09-26, SRR package item R9 and decision 116).** OQ-SAF-017 and OQ-SAF-020 are Closed: the author edits they waited on are in the products committed at `400e59d` (REQ-SYS-050 cites RSK-024 and REQ-SYS-106 cites RSK-025 in `requirements.json` blob `0da73012`; 06 section 7 level 4 in blob `7a92d21f`), so no re-dating is needed. Of the 19 questions due at SRR, 6 are now Closed (OQ-SAF-004, 011, 017, 020, 021, 023), 4 Answered (007, 022, 025, 026) and 9 Open: 8 on the owner rulings named above and OQ-SAF-006 on the ConOps author's OPS-013 edit after decisions 37, 38 and 41 (re-dated to PDR only if that edit misses the declaration, decision 116). **Update at 0.4.3-pha (2026-09-26, SRR package item R9).** INSP-008 iteration 3 verified the answers of OQ-SAF-007, 025 and 026, which are now Closed: of the 19 questions due at SRR, 9 are Closed, 1 Answered (OQ-SAF-022) and 9 Open as above. **Update at 0.5.0-pha (2026-09-26, the owner's SRR rulings, package item R16).** Every ruling the SRR-due questions waited on is made (package section 18.1). OQ-SAF-003, 005, 012 and 013 are Closed on the rulings (decisions 38, 36, 39 and 40; the products already carried the requirements). OQ-SAF-006 is Answered by ConOps revision 3 (decisions 37, 38, 41 and 42; no re-dating under decision 116) and closes on the ConOps reviewer's verification. OQ-SAF-001, 002 and 016 are Answered by the requirements author's R16 edit (`cd61450`: REQ-SYS-054 reworded, REQ-SYS-184, REQ-SYS-187 to 190) and close on the INSP-003 verification; OQ-SAF-014 has the owner's concurrence (decision 9) and waits on the lead SE's joint edit. Of the 19 questions due at SRR: 13 Closed, 5 Answered (OQ-SAF-001, 002, 006, 016, 022) and 1 Open on a post-ruling author edit (OQ-SAF-014). OQ-SAF-008 and 009 (PDR) are Answered by REQ-SYS-185 and REQ-SYS-186 (decision 72). OQ-SAF-027 (PDR) is raised on the debounce exposure of decision 48.

**Requests recorded at 0.4.0-pha (INSP-008 finding-5 and finding-6, OQ-SAF-025).** The requirements author adds the hazard and control ids to the rationales of the 27 L1 pairs finding-6 lists and of the 14 L2 pairs added at this revision whose rationale names the hazard or the control id incompletely: REQ-TX-003 (HZ-006 K3; HZ-008 K4, K7), REQ-TX-006 (HZ-008 K4), REQ-TX-007 (HZ-008 K1, K5), REQ-TX-011 and REQ-TX-012 (HZ-008 K1) name no hazard; REQ-TX-002 (HZ-008 K4), REQ-TX-008 (HZ-008 K1, K2, K5) and REQ-TX-015 (HZ-001 K8; HZ-006 K4, which it also lacks the hazard for) name no control id. The same request corrects the fault tolerance citations of finding-5: the eleven rationales that cite 0.1.0 single point candidate numbers, the 'three independent overcharge layers' of REQ-SYS-081 and 083, and the item 5 citation of REQ-SYS-118 and 155 (HZ-003 is item 4).

| ID | Addressee | Subject | Close by | Status (2026-09-25; rows changed at 0.5.0-pha dated 2026-09-26) | Remaining and who acts |
|---|---|---|---|---|---|
| OQ-SAF-001 | Requirements author; owner (D-KN3) | Redefine REQ-SYS-054 as a no-gap paddle watchdog | SRR | Answered (0.5.0-pha): REQ-SYS-054 reworded at `cd61450` after decision 37; the REQ-SYS-055 rationale names the toggling stream and REQ-SYS-180 (the item carried from OQ-SAF-003) | INSP-003 verifies |
| OQ-SAF-002 | Requirements author; owner (D-KN3) | New requirement: squeeze limit for both paddle contacts closed | SRR | Answered (0.5.0-pha): REQ-SYS-184 at `cd61450` after decision 37 | INSP-003 verifies |
| OQ-SAF-003 | Requirements author; owner | New requirement: hardware transmission-length backstop on the T/R drive | SRR | Closed (0.5.0-pha, 2026-09-26) | REQ-SYS-180 adopted at SRR with the 150 s to 180 s window (decision 38); the Minor REQ-SYS-055 rationale item moved to OQ-SAF-001 |
| OQ-SAF-004 | Requirements author | REQ-SYS-053 to cover the Bug-mode dah contact | SRR | Closed | REQ-SYS-053 covers every manually timed closure, the Bug-mode dah included; its 5 s value is decision 37 |
| OQ-SAF-005 | Requirements author; owner (RFX-D3, D-KN2) | Tune timeout conflicts with the hardware cutoff window | SRR | Closed (0.5.0-pha, 2026-09-26) | Decision 36 ruled option a, the value REQ-SYS-020 carries; the SEMP and concept value corrections are package section 15 items 14 and 15 (their authors, R16) |
| OQ-SAF-006 | ConOps author | ConOps corrections: tune duration, squeeze case and stream bounds | SRR | Answered (0.5.0-pha, 2026-09-26): all five items in ConOps revision 3 after decisions 37, 38, 41 and 42 | The ConOps reviewer (INSP-002) verifies revision 3; no re-dating (decision 116) |
| OQ-SAF-007 | Lead SE (research) | Research F13 coverage statement and tune assumption | SRR | Closed (0.4.3-pha, 2026-09-26) | Dated F13 addendum verified by INSP-008 iteration 3 |
| OQ-SAF-008 | Requirements author; owner (D-PWR-03) | New requirement: third overcharge layer at 4.30 V | PDR | Answered (0.5.0-pha): REQ-SYS-185 at `cd61450` after decision 72 | INSP-003 verifies |
| OQ-SAF-009 | Requirements author | Design constraint: separate Kelvin sense route per protection layer | PDR | Answered (0.5.0-pha): REQ-SYS-186 at `cd61450` after decision 72, traced in HZ-002 K9 and HZ-007 K3 | INSP-003 verifies; the REQ-SYS-186 rationale to name HZ-007 K3 as well (requirements author) |
| OQ-SAF-010 | Requirements author | Cell compartment requirement; REQ-SYS-099 and REQ-SYS-086 links | PDR | Open; REQ-SYS-099 link answered | PDR: cell compartment requirement or ME allocation |
| OQ-SAF-011 | Requirements author | HZ-011 traces: REQ-SYS-002 link, PA supply topology, separate VBUS sense | SRR | Closed | REQ-SYS-002 lists HZ-011; REQ-SYS-149 implements K3; the REQ-SYS-092 rationale names its own VBUS sense |
| OQ-SAF-012 | Requirements author; owner | New requirement: hardware over-temperature cut-off | SRR | Closed (0.5.0-pha, 2026-09-26) | REQ-SYS-181 adopted at SRR with 95 C +/-3 C and 100 ms (decision 39) |
| OQ-SAF-013 | Requirements author; owner | New requirement: independent frequency verification before transmit | SRR | Closed (0.5.0-pha, 2026-09-26) | REQ-SYS-182 adopted at SRR with 10 kHz and 100 ms (decision 40, with decision 9) |
| OQ-SAF-014 | Lead SE (03, 07, SEMP, charter); owner | Determination change: frequency control proposed safety-critical | SRR | Open; owner concurred (decision 9, 2026-09-26) | The lead SE's joint edit of 03, 07, SEMP, charter and rmm.json (R16) |
| OQ-SAF-015 | Requirements author | Missing requirements: limiter attack time and over-voltage lockout | PDR | Open | PDR |
| OQ-SAF-016 | Requirements author | Bench test-mode guard requirements; REQ-SYS-007 hazard link | SRR | Answered (0.5.0-pha): REQ-SYS-187 to 190 at `cd61450` after decisions 41 and 42, with REQ-SYS-179 and REQ-SYS-007 | INSP-003 verifies |
| OQ-SAF-017 | Requirements author | Trace clean-up: REQ-SYS-122 checklist, REQ-SYS-123, REQ-SYS-006, risk citations | SRR | Closed (0.4.1-pha, 2026-09-26) | REQ-SYS-050 cites RSK-024 and REQ-SYS-106 cites RSK-025 (`requirements.json` blob `0da73012`), each risk carrying the hazard; the REQ-SYS-122 note refinement is carried to OQ-SAF-019 (Minor, lien: fix before PDR) |
| OQ-SAF-018 | Requirements author | REQ-SYS-085 method: component-level Test or listed exception | PDR | Open | PDR |
| OQ-SAF-019 | Requirements author; owner (bench equipment) | HZ-015 hand-assembly safety content requirement and hazard links | PDR | Open; REQ-SYS-137 and 138 links and RSK-034 answered | PDR: hand-assembly procedure requirement; package decision 100; REQ-SYS-122 verification note selects by its rationale's control list (carried from OQ-SAF-017, lien: fix before PDR) |
| OQ-SAF-020 | Risk manager | Register actions under the hazard link rule | SRR | Closed (0.4.1-pha, 2026-09-26); item 5 withdrawn | 06 section 7 level 4 names the operator, a bystander or any other person (06 blob `7a92d21f`) |
| OQ-SAF-021 | Lead SE (ADR-022) | ADR-022 names no hazard although it controls HZ-008 | SRR | Closed (0.4.0-pha) | ADR-022 section 1 names HZ-008 |
| OQ-SAF-022 | Lead SE (07) | Reconcile 07 section 14.1 and 14.2 with this analysis | SRR | Answered (0.4.0-pha) | 07 author: two stale 03 notes in section 14.1 (editorial); SW-SYNTH rows follow decision 9 |
| OQ-SAF-023 | Lead SE (03) | Re-transcribe 03 sections 4.2, 4.3 and 5 from hazards.json 0.2.0-pha | SRR | Closed (0.4.0-pha) | 03 re-transcribed from 0.3.0-pha; 0.4.0-pha changes no firmware role |
| OQ-SAF-024 | Owner (regulatory corpus) | Add the 150 to 174 MHz allocation and the 156.8 MHz channel to the corpus | PDR | Open | Before PDR (package decision 35, plan confirmed at SRR) |
| OQ-SAF-025 | Requirements author | Control-requirement rationales: hazard and control ids, fault tolerance citations | SRR | Closed (0.4.3-pha, 2026-09-26) | rationales carry every hazard and control id; section 8.2 row numbers and section 8.1 items 3 and 4 cited; verified by INSP-008 iteration 3 |
| OQ-SAF-026 | Requirements author; risk manager | Analysis-method acceptances cite risks that do not carry the hazard (RSK-004, RSK-002, RSK-016 for REQ-SYS-122); REQ-SYS-113 Test conversion | SRR | Closed (0.4.3-pha, 2026-09-26) | RSK-034, RSK-011 and per-hazard risks cited; section 8.1 item 7 table updated; REQ-SYS-113 conversion conditional on OQ-VV-003; verified by INSP-008 iteration 3 |
| OQ-SAF-027 | Requirements author (REQ-SYS, REQ-SW-KEYER); lead SE | Operator-set debounce ruled by decision 48 versus the fixed debounce counts | PDR | Open (raised 0.5.0-pha, 2026-09-26) | Bound the operator-set debounce inside REQ-SW-KEYER-017 and the 6-sample break limit and state it in REQ-SYS-048, 162 and REQ-SW-KEYER-020, 021, or a CR to keep the counts fixed; HZ-004 K9 and HZ-010 K3 keep the fixed counts until then |

## 12. Risk register linkage (hazard link rule, 06 section 1)

Links as they stand in `docs/risk/register.json` on 2026-09-25, re-read for 0.4.0-pha; each hazard's `related_risk_ids` names them back, and `tools/render_risk.py --check --gate SRR --hazards docs/safety/hazards.json` passes.

| Hazard (severity) | Risks carrying it (`related.hazard_ids`) | Register action (OQ-SAF-020) |
|---|---|---|
| HZ-001 (Marginal) | RSK-016, RSK-030 | none |
| HZ-002 (Catastrophic) | RSK-007 (safety 5) | none; the K3 and K9 requirements are HZ-002 open questions |
| HZ-003 (Critical) | RSK-006, RSK-026 (safety 4) | none (raised to 4 in the register) |
| HZ-004 (Critical) | RSK-024 (safety 4); RSK-012 no longer carries it | none (the RSK-024 statement names the toggling-stream gap and K12) |
| HZ-005 (Critical) | RSK-017 | none |
| HZ-006 (Critical) | RSK-016 | none (the optional RSK-028 link is withdrawn) |
| HZ-007 (Catastrophic) | RSK-007 | none |
| HZ-008 (Critical) | RSK-001, RSK-011, RSK-046 | none (RSK-046 names HZ-008 and HZ-008 names RSK-046 at 0.4.0-pha; OQ-SAF-020 item 3) |
| HZ-009 (Marginal) | RSK-025 (RSK-018 carries HZ-013 only) | none |
| HZ-010 (Marginal) | RSK-024 | none |
| HZ-011 (Marginal) | RSK-007, RSK-033 | none |
| HZ-012 (Marginal) | RSK-016 | none |
| HZ-013 (Marginal) | RSK-018 | none |
| HZ-014 (Critical) | RSK-015 | none |
| HZ-015 (Catastrophic) | RSK-034 (safety 5) | none |

06 section 7 safety level 4 names RF exposure above the applicable FCC limit for the operator, a bystander or any other person, aligned with the section 3.2 Critical definition (OQ-SAF-020 item 6, Closed at 0.4.1-pha).

## 13. Maintenance and change log

The analysis is updated at every life-cycle review and whenever a hazard or a control changes (a register trigger, 06 section 10). Edits go to `hazards.json` first; this document is revised to match in the same commit; the `history` array of each hazard is append-only and its last entry equals the current assessment. After SRR both files are configuration items under the CR process (charter section 7).

| Date | Review | Change |
|---|---|---|
| 2026-09-25 | Pre-SRR | Preliminary hazard analysis written: 14 hazards (HZ-001 to HZ-005 carried from 03 section 4.2 with HZ-001 and HZ-002 split into HZ-006 and HZ-007), scales defined, safety-critical determination confirmed with the section 6.3 deltas, SWE-134 mapping, fault tolerance philosophy, single point failure candidates, test safety provisions |
| 2026-09-25 | Pre-SRR | Revision 0.2.0-pha after the first independent review (21 findings): toggling key-stream gap of HZ-004 with the no-gap watchdog, the squeeze limit, the transmission-length backstop K12 and the test-mode guard K13; tune timeout conflict with the hardware cutoff (5 s proposed); HZ-011 rewritten to the baseline VBUS transmit inhibit and charge pause; HZ-002 third layer and shared MID sense net; HZ-003 re-rated Critical with a hardware over-temperature cut-off proposed; HZ-008 out-of-band fundamental with an independent frequency verification and frequency control proposed safety-critical; HZ-015 hand assembly added; section 6.2 regenerated by the union rule with the configuration guard; Emulation removed as timing evidence; Analysis exceptions listed; SWE-134 table with a Requirement column; likelihood of HZ-002, HZ-007 and HZ-014 re-rated to B; operator exposure added to the Critical definition; composite controls split; control traces corrected; evidence classes named; risk links made bidirectional; the Requirement pending status, the section 3.5 residual rule and 24 open questions added; schema extended (`open_questions`, control status Requirement pending) |
| 2026-09-25 | Pre-SRR | Revision 0.3.0-pha (SRR readiness items H7, H8 and H9): the 17 SRR-due open questions reconciled against package section 18.1 (OQ-SAF-004 and OQ-SAF-011 closed; the others Open with the remaining action, owner and package decision in `resolution`; OQ-SAF-010 and OQ-SAF-019 partial answers noted); REQ-SYS-180, REQ-SYS-181 and REQ-SYS-182 traced as HZ-004 K12, HZ-003 K9 and HZ-008 K7 (Proposed), with the backstop shares HZ-001 K10, HZ-003 K10, HZ-006 K10, HZ-012 K6 and HZ-014 K8; residuals of HZ-003, HZ-004, HZ-008 and HZ-014 restated under section 3.5 and the decline cases recorded (section 8.3); HZ-015 names RSK-034, so the `render_risk.py --hazards` cross-check passes; HZ-001 K2, HZ-006 K2, HZ-012 K1 and the section 2, 5 and 8.2 texts quote the current REQ-SYS-020 (at most 5.5 s, TBR); HZ-011 K3 traced to REQ-SYS-149; REQ-SYS-130 traced to HZ-002 K4 and K5; package decision numbers named in `decisions_pending` and section 11 |
| 2026-09-25 | Pre-SRR | Revision 0.4.0-pha applying INSP-008 (`docs/reviews/SRR/checklists/hazard-analysis.md`): finding-1, the 40 L2 back-links added to the controls, `HAZARD_INVERSE` 0 and the PDR deferral withdrawn (section 9 item 1); finding-2, Software causes HZ-007 C9, C10 and HZ-010 C6, C7 with the former HZ-010 C4 split (section 5); finding-3, section 8.1 item 7 table completed from a recompute (REQ-SYS-113, 075, 157, 158, 172, 014, 015, 137, 138, REQ-TX-005, 006, REQ-SYS-122, 124) with the non-carrying risks flagged (OQ-SAF-026); finding-4, section 8.2 rows 18 to 22; finding-5, requirement ids named in every section 8.1 item and the rationale corrections routed (OQ-SAF-025); finding-6, the 27 L1 and 14 L2 rationale pairs routed (section 11.2, OQ-SAF-025); finding-7, section 9 item 1 restated from the current tool output; finding-8, OQ-SAF-021 and 023 closed, 022 answered, 020 item 3 answered with RSK-046 named in HZ-008, the re-dating fallback recorded in each author-edit question; finding-9, HZ-015 K1 split into K1 (station, Hardware interlock) and K6 (practice, Operator procedure) and the section 3.4 position of its residual stated; finding-10, the 128-element figure corrected to about 6.1 s elapsed at 50 WPM and the written 10 s cap of REQ-SYS-054 stated; finding-11, section 10 USB row; finding-12, section 3.6 tag on HZ-004 K5 and HZ-007 K1; finding-13, A-PWR-03, ANT-06 and ANT-03 marked PDR actions and A-KN5 mapped to package decision 50. No severity, likelihood, initial risk, residual level, firmware-role criterion, component or SWE-134 item changed |
| 2026-09-26 | Pre-SRR | Revision 0.4.1-pha (SRR package item R9, decision 116 recommendation): OQ-SAF-017 Closed (REQ-SYS-050 and REQ-SYS-106 risk citations corrected in the committed `requirements.json`, blob `0da73012`) and OQ-SAF-020 Closed (06 section 7 level 4 names the operator, a bystander or any other person, blob `7a92d21f`); the REQ-SYS-122 verification-note refinement carried to OQ-SAF-019 as a Minor lien (fix before PDR); sections 3.2, 11.1 item 3, 11.2 and 12 restated. No hazard, control, severity, likelihood, initial risk, residual level, firmware-role criterion, component or SWE-134 item changed, so 03 section 4.1 step 5 requires no re-transcription |
| 2026-09-26 | Pre-SRR | Revision 0.4.2-pha (ConOps appendix D items D6 and D10; SRR package H6, R14): section 7 rows c and l state the two levels of the safe state consistent with REQ-SYS-130 (full safe state on reset, panic, latched fault and power-down; transmit part only for the key-down timeouts and other Inhibit-class causes, so the sidetone continues and charging is unchanged); HZ-004 K2 text states that the Straight-on-tip selection is accepted while the KEY inhibit is active (REQ-SYS-163) and that the REQ-SYS-052 interlock then re-runs on the newly used inputs. ConOps appendix D items D11 (phase names) and D12 (HZ-001 K6 to cite OPS-022) are Minor and carried as liens: fix before PDR |
| 2026-09-26 | Pre-SRR | Revision 0.4.3-pha (SRR package item R9, status edit only): OQ-SAF-007, OQ-SAF-025 and OQ-SAF-026 Closed on the verification of INSP-008 iteration 3; section 11.2 table and statuses updated. No hazard, control, level or requirement change. |
| 2026-09-26 | SRR | Revision 0.5.0-pha (SRR owner rulings of 2026-09-26, package item R16; every key and consent-agenda decision ruled as recommended). Decision 9: frequency control and the frequency verification unit safety-critical (sections 4, 6.2, 6.3 item 6; HZ-008 `firmware_role`). Decision 33: the accumulator and separation reminder a convenience function (section 6.2; HZ-001, HZ-006 `firmware_role`). Decisions 36 and 37: tune option a, cutoff and 74LVC1G123 (HZ-001 K2, HZ-004 K5, HZ-006 K2, HZ-012 K1), the 5 s manual timeout with the Bug dah (HZ-004 K3) and the no-gap paddle watchdog with the 2 s squeeze limit replacing the 10 s cap (HZ-004 K4, section 5 coverage table, section 7 row j). Decisions 38 to 40: REQ-SYS-180 (150 s to 180 s), REQ-SYS-181 and REQ-SYS-182 adopted (HZ-004 K12 with its shares, HZ-003 K9, HZ-008 K7; residual conditions, single point failures and fault tolerance of HZ-003, HZ-004, HZ-008, HZ-014; sections 4, 5, 7, 8.1, 8.2, 8.3 outcome, 10 RF row). Decisions 41 and 42: the bench test-mode guard (HZ-004 K13, HZ-005 K9). Decisions 17 to 20: OPS-A, OPS-B at 1 W, guest lock option a, guest keying allowed (section 2; HZ-006 residual stays Critical-D, Medium). Decision 25: 1.2 kHz band-edge guard, 144.0012 to 147.9988 MHz (HZ-008 K4, K7, `firmware_role`, fault tolerance; sections 5, 6.2, 7 row h). Decisions 70 to 76: HZ-002 K3 and K9 ordered, HZ-007 K1, HZ-011 K3 (section 5). `decisions_pending` of every hazard restated to the decisions due at PDR or later; one history entry per hazard. Requirements written after the rulings (`cd61450`) linked: REQ-SYS-184 in HZ-004 K4 and the shares HZ-001 K3, HZ-003 K3, HZ-006 K6, HZ-012 K2; REQ-SYS-185 in HZ-002 K3; REQ-SYS-186 in HZ-002 K9 and HZ-007 K3; REQ-SYS-187, 188, 190 in HZ-004 K13; REQ-SYS-189, 190 in HZ-005 K9; REQ-SW-KEYER-039 (decision 112) in HZ-004 K2 and K13; HZ-002 K3, K9, HZ-004 K4, K13 and HZ-005 K9 move from Requirement pending to Proposed; `requirement_ids` recomputed as the union; HZ-002 residual Catastrophic-D, Serious to Catastrophic-E, Medium by the section 3.5 rule (sections 4, 5, 8.1 item 3, 8.2 row 5). Open questions: OQ-SAF-003, 005, 012, 013 Closed; OQ-SAF-001, 002, 006, 008, 009, 016 Answered; OQ-SAF-014, 019, 024 updated; OQ-SAF-027 raised (decision 48 against the fixed debounce counts of HZ-004 K9 and HZ-010 K3). No severity, likelihood, initial risk, firmware-role criterion, component list or SWE-134 item changed, so 03 section 4.1 step 5 requires no re-transcription beyond the decision 9 edit of OQ-SAF-014 |
