robinonsay/cwht/docs/lessons-learned.md

# cwht Lessons Learned

**Status:** Log (Table 4-1 row 40 of `docs/process/05-configuration-and-data-management.md`; changed by `Refs:` commits, never boarded). Created 2026-09-27 in the PDR phase (`docs/plan/pdr-work-plan.md` WP-PDR-05 output 4) to close lien L-3 of the SRR, RFA-SRR-003 (`docs/reviews/SRR/decision-memo.md` section 6: "Create docs/lessons-learned.md with the ten entries of package section 19 before the PDR readiness declaration"). **Owner:** Robin. **Author:** Claude (lead SE). **Applicable baseline:** `baseline/srr` (functional baseline, tag on `779f93f`). **Required by:** charter section 5 ("Lessons learned: `docs/lessons-learned.md`"); review process standing entrance criterion S10 (`docs/process/01-lifecycle-and-reviews.md` section 3.2, Soft); `docs/templates/review-package.md` section 19.

## 1. Rules for this file

1. **What goes in.** A lesson is a fact observed while doing the project's own work that should change how later work is done. Each entry names its source artifact (a record, a package item, a log entry or a commit), so that it is evidence and not opinion (charter section 11 rule 2).
2. **Entry numbers.** Charter section 6 defines no identifier scheme for lessons, so entries are cited as `docs/lessons-learned.md` entry *n*, as the deviations log does for its entries. Entry numbers are never reused or renumbered.
3. **Append, then update the state.** New lessons are appended. The "Applied in" and "State" cells may be updated when the action lands, with the commit that applied it; the lesson text is not rewritten. A lesson found to be wrong gets a new entry that cites it.
4. **Area tags** (08 section 1 repo map: "tagged by area, for example software"): `cm` configuration management and records; `reviews` review conduct and records; `requirements`; `risk`; `safety`; `tools`; `software`; `planning` TPMs, budgets and schedules.
5. **Use at each gate.** Before each readiness declaration the package author reads this file, lists in package section 19 the entries added since the last review, and states for each whether its action was applied (S10). The PDR package section 19 lists entries 1 to 17.

## 2. Entries

Entries 1 to 10 are the ten entries SRR package section 19 proposed as `LL-proposed-1` to `LL-proposed-10` (`docs/reviews/SRR/package.md` section 19, revision 8 final at `a6d0959`), transcribed with the same date, lesson and action. The date is the date the lesson was recorded. Entries 11 to 17 are the SRR lessons L1 to L7 that the PDR work plan applies (`docs/plan/pdr-work-plan.md` section 1.4, first recorded in revision 1 at `51600e8` on 2026-09-27; revision 2 at `ab2af2d`).

| # | Date | Area | Gate | Lesson | Source | Action taken or planned | Applied in | State |
|---|---|---|---|---|---|---|---|---|
| 1 | 2026-09-25 | risk | SRR | Research reports that tag risks without identifiers force the register to assign ids at the candidate pass. | SRR package section 19, `LL-proposed-1` | Ask research authors to give every RISK-candidate and DECISION-needed an id. | Research-author briefs of the PDR phase (trade and analysis WPs 19 to 30 submit risk entries to WP-PDR-18, plan section 5.3 row `docs/risk/register.json`) | Planned |
| 2 | 2026-09-25 | planning | SRR | A TPM allocation written before the research budget (TPM-002) diverged from it by a factor of three. | SRR package section 19, `LL-proposed-2`; RID-SRR-001 | Derive every allocation from a cited budget in `docs/design/budgets.md`. | WP-PDR-29 (`docs/design/budgets.md`, TPM-002 re-allocation) | Planned |
| 3 | 2026-09-25 | safety | SRR | Adding a risk that carries a hazard without the hazard's back-link in the same change breaks the mandatory gate check. | SRR package section 19, `LL-proposed-3` | Hazard link edits land in `hazards.json` and `register.json` in one change set (06 section 1). | 06 section 1 rule; WP-PDR-16 and WP-PDR-18 change sets | Applied (rule in 06); checked again at PDR |
| 4 | 2026-09-25 | cm | SRR | Products left untracked cannot be cited by commit, which blocks readiness. | SRR package section 19, `LL-proposed-4` | Commit each product when its author finishes, before the package is assembled. | PDR plan rule C2 (freeze before review: the product is committed and its blob named in the brief) | Applied in the PDR plan |
| 5 | 2026-09-25 | reviews | SRR | Revision 1 of the SRR package rated rows 20 and 25 Met on evidence other than what 01 section 4.3 names. | SRR package section 19, `LL-proposed-5` | Rate every entrance row against the evidence artifact its table names; a substitute needs an owner deviation. | WP-PDR-48 and WP-PDR-49 (entrance checklist of the PDR package) | Planned |
| 6 | 2026-09-26 | tools | SRR | Five records whose products had no open Major finding stayed NEEDS CHANGES because the repository-wide readiness check R1 failed on two schema files outside their products. | SRR package section 19, `LL-proposed-6` | Run `validate_docs.py` to exit 0 before dispatching a review wave; place every schema with its instance. | Wave barriers of the PDR plan (section 5.2); `tools/validate_docs.py` run by every WP before its commit | Planned |
| 7 | 2026-09-26 | tools | SRR | The package figure generator caught a stale package count (Keying TBRs 11 against 16) that a by-hand re-count missed. | SRR package section 19, `LL-proposed-7` | Generate package tables from the product files and let the figure tool cross-check them. | WP-PDR-45 (open-TBR table generated from the files) and WP-PDR-48 (every package count regenerated by tools); see entry 16 | Planned |
| 8 | 2026-09-26 | reviews | SRR | Seven records could not reach APPROVED only because the author's self-check against the checklist was never filed. | SRR package section 19, `LL-proposed-8` | Put the author self-check in every author brief as a required return field (08 section 5). | Author briefs of the PDR phase; 08 section 5 change carried by WP-PDR-12 | Planned |
| 9 | 2026-09-26 | reviews | SRR | A routing change in 07 section 2.1.1 (05 and TS-002 to software assurance) made after two reviews had closed left both records held on an assurance pairing that no finding named. | SRR package section 19, `LL-proposed-9` | Dispatch the paired assurance record in the same change that widens the routing table. | Any 07 section 2.1.1 change of the PDR phase (WP-PDR-17 writer slot) | Planned |
| 10 | 2026-09-26 | reviews | SRR | A status-only edit that an APPROVED record itself asked for (R9, OQ-SAF-007, 025, 026) changed the blobs that record names and turned the validator and its repository test red. | SRR package section 19, `LL-proposed-10` | Dispatch the reviewer's delta verification in the same change as any edit to a product an APPROVED record names, including status edits. | PDR plan rule C2 (any change after freeze needs a delta iteration of the record) | Applied in the PDR plan |
| 11 | 2026-09-27 | reviews | SRR | Convergence rule. After a record's first APPROVED verdict, only open Major findings change a product; new Minor findings become liens with an owner and a due event. | PDR plan section 1.4 L1; charter section 4 item 3 (lead SE convergence rule of 2026-09-26, as applied in every SRR lien table, for example `docs/reviews/SRR/checklists/test-cases-sys.md`); 08 section 3.2 | Each review runs at most three iterations (07 section 10.2); Minor findings raised at PDR are liens due at the CDR readiness declaration, carried in PDR package section 15. | PDR plan rule C1 | Applied in the PDR plan |
| 12 | 2026-09-27 | reviews | SRR | Freeze products at a commit before reviews. A review names the blob it checked, and a product that moves after review invalidates the record. | PDR plan section 1.4 L2; SRR records name blobs (for example `docs/reviews/SRR/checklists/schedule-and-cost-estimate.md`); SRR package re-issues forced record deltas | Products are committed and their blob SHAs recorded in the review brief before the reviewer starts; a post-freeze change needs a delta iteration of the record. | PDR plan rule C2, freeze points F0, F1 and F2 | Applied in the PDR plan |
| 13 | 2026-09-27 | reviews | SRR | Never let the deck state its own review status. The SRR deck described its own render and review state, which went stale. | PDR plan section 1.4 L3; `docs/reviews/SRR/checklists/srr-deck.md` (INSP-029) lien table and cross items X-2, X-4 | The deck carries no review status of itself; the package section 2 "Slide deck" block is written after the deck record, and the deck only cites package sections. | WP-PDR-50 | Planned |
| 14 | 2026-09-27 | cm | SRR | An independent CR impact review comes before the disposition. CR-002, CR-004 and CR-005 were dispositioned before their impact review, which the deviations log records. | PDR plan section 1.4 L4; `docs/cm/deviations.md` entries 1 to 3 | Every CR raised in the phase gets its section 6 review before the owner is asked. | PDR plan rule C6 and the CR register of plan section 6.2; CR-003 and CR-006 re-checks (WP-PDR-01); CR-007 section 6 review in wave 1a before OD-36 | Applied in the PDR plan |
| 15 | 2026-09-27 | reviews | SRR | Check every case a standard names. Reviews that sampled cases missed items (for example the SWE-134 a to l rows, App. G sub-items, the 06 section 14.4 sensitivity pair). | PDR plan section 1.4 L5; SRR records INSP-009 and INSP-017 (03 transcription findings), INSP-027 (TS-002 findings) | Every reviewer brief lists, as acceptance criteria, each case the governing clause enumerates. | PDR plan rule C7 | Applied in the PDR plan |
| 16 | 2026-09-27 | requirements | SRR | Generate lists from the files, never copy them from a memo. The SRR memo's L-1 list names 101 L1 TBRs; the requirement file holds 109. | PDR plan section 1.4 L6; `docs/reviews/SRR/decision-memo.md` section 6 (101 listed) against `docs/requirements/sys/requirements.json` (109 `tbr` objects with `close_by: PDR`, counted again for the first CSA, `docs/process/configuration-status.md` item 13) | WP-PDR-45 generates the open-TBR table from the requirement files; WP-PDR-48 regenerates every package count from tools. | WP-PDR-45, WP-PDR-48 | Planned |
| 17 | 2026-09-27 | cm | SRR | One writer per file per wave. Concurrent edits to shared JSON caused rework at SRR. | PDR plan section 1.4 L7; charter rule "never commit another agent's hunk" (cited in CR-006 section 5) | Each shared file has one writer per wave, and other WPs send change requests to the current writer. | PDR plan section 5.3 file-ownership table | Applied in the PDR plan |
| 18 | 2026-09-29 | risk | PDR | Parts lifecycle is a mandatory screen for a study that selects parts. TS-012 did not weight lifecycle status as a criterion (it folded sourcing into M2, C5 and RSK-038), so its matrix could not show that the recommended A4 rests on an End-of-Life PA, the NXP AFT05MS004NT1. Lifecycle became the decisive condition only through the owner's words ("I'm leaning towards A5 if it doesn't use outdated components"), and only then was every part of a finalist screened: A5 read 39 of 39 Active, and the owner chose A5 ("A5"), not the recommendation. | TS-012 section 10 (revision 7 at `6497900`; "Lead SE reading" items 1 to 3 and "Lessons learned"); `docs/research/a5-parts-lifecycle-2026-09-29.md` (`f193784`, 39 of 39 Active); `docs/plan/status/status-2026-09-29.md` section 4 (`f35eb78`) and section 5 (`13176ee`), owner statements verbatim; INSP-110 iteration 1 (the AFT05 End-of-Life finding) | A design-to-cost or other study that selects parts screens the lifecycle status of every candidate part (Active at the maker, with its source and read date) as a mandatory criterion, or asks the owner at the study's opening whether it is one; the screen is recorded before the recommendation goes to the owner. | Next trade study that selects parts (for example the WP-PDR-27 TS-004 and TS-011 re-scores, if they select parts); the 06 section 14 trade-study rules at their next revision | Planned |

## 3. Index by area

| Area | Entries |
|---|---|
| cm | 4, 14, 17 |
| planning | 2 |
| requirements | 16 |
| reviews | 5, 8, 9, 10, 11, 12, 13, 15 |
| risk | 1, 18 |
| safety | 3 |
| software | none yet |
| tools | 6, 7 |
