robinonsay/cwht/docs/cm/tool-validation/evidence/render-review-figures-fixture-hazard-matrix.png

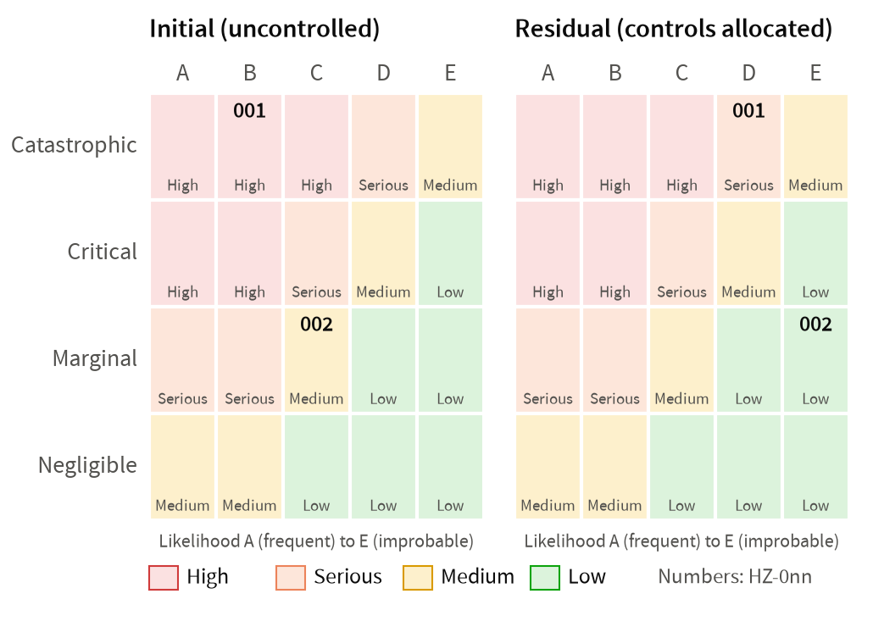
docs/cm/tool-validation/evidence/render-review-figures-fixture-hazard-matrix.png
