robinonsay/cwht/docs/cm/tool-validation/evidence/render-review-figures-fixture-risk-matrix.png

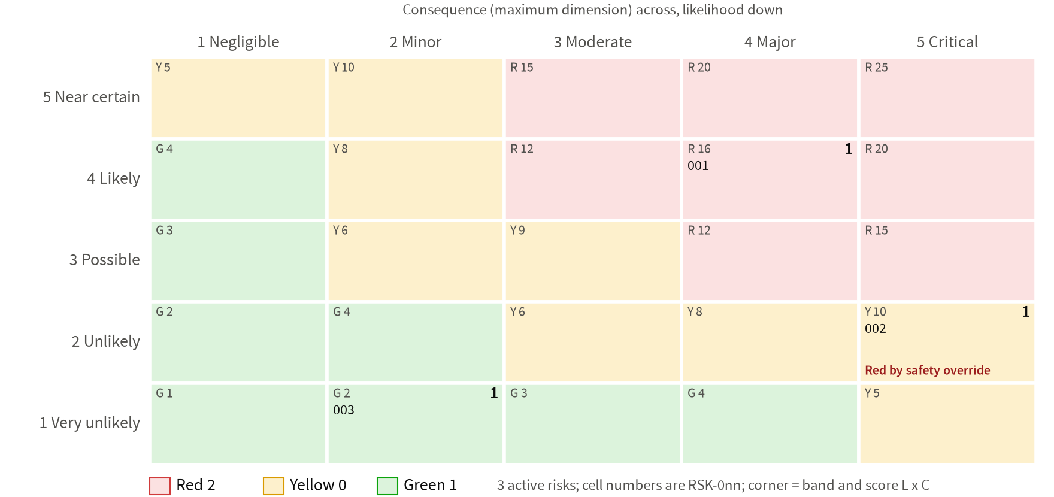
docs/cm/tool-validation/evidence/render-review-figures-fixture-risk-matrix.png
