robinonsay/cwht/docs/reviews/SRR/figures/hazard-matrix.png

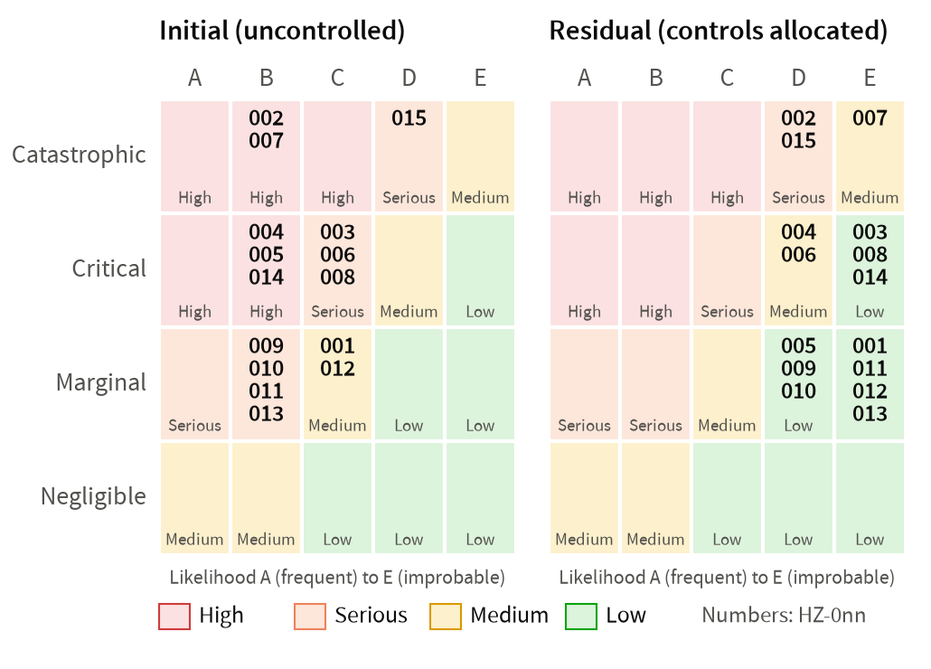
docs/reviews/SRR/figures/hazard-matrix.png
