robinonsay/cwht/docs/reviews/SRR/figures/risk-matrix.png

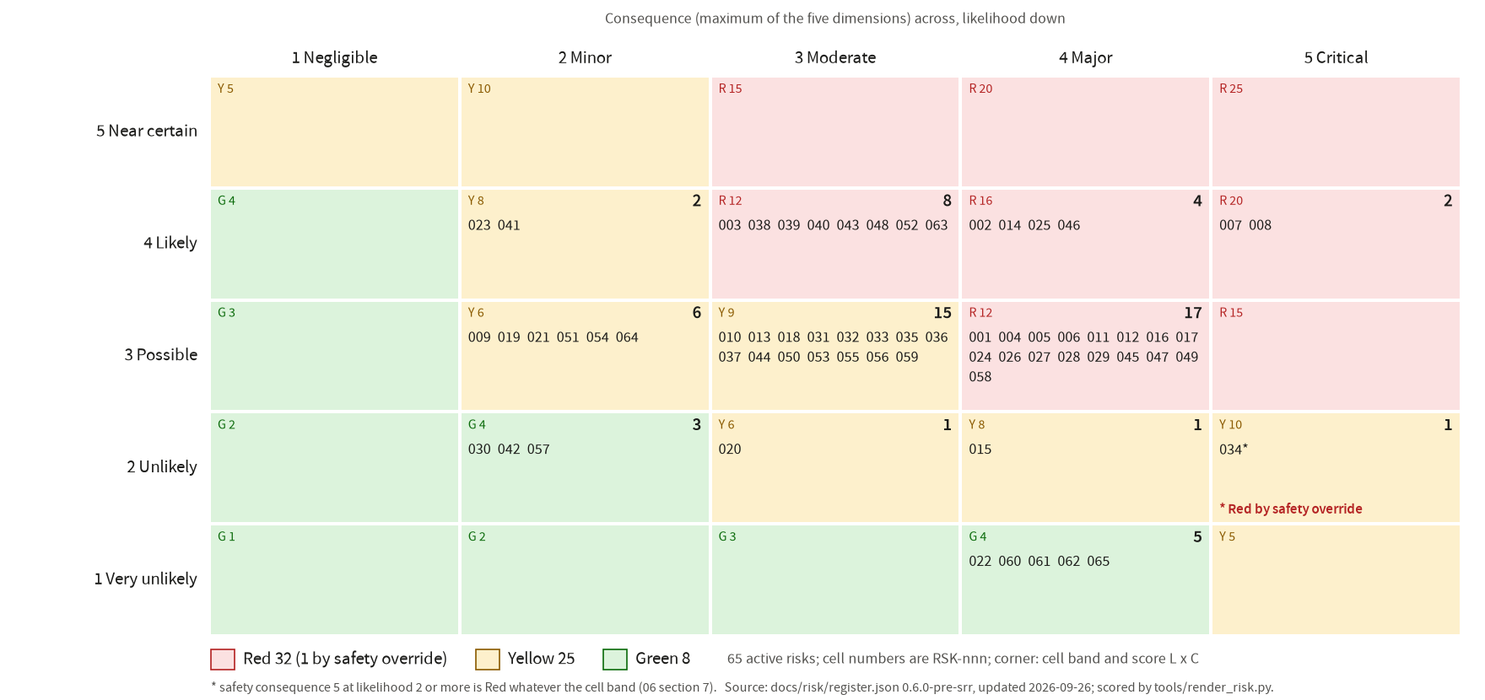
docs/reviews/SRR/figures/risk-matrix.png
