robinonsay/cwht/hardware/sim/tx-keying/results/2026-09-28-r2-a4-fix/corners.png

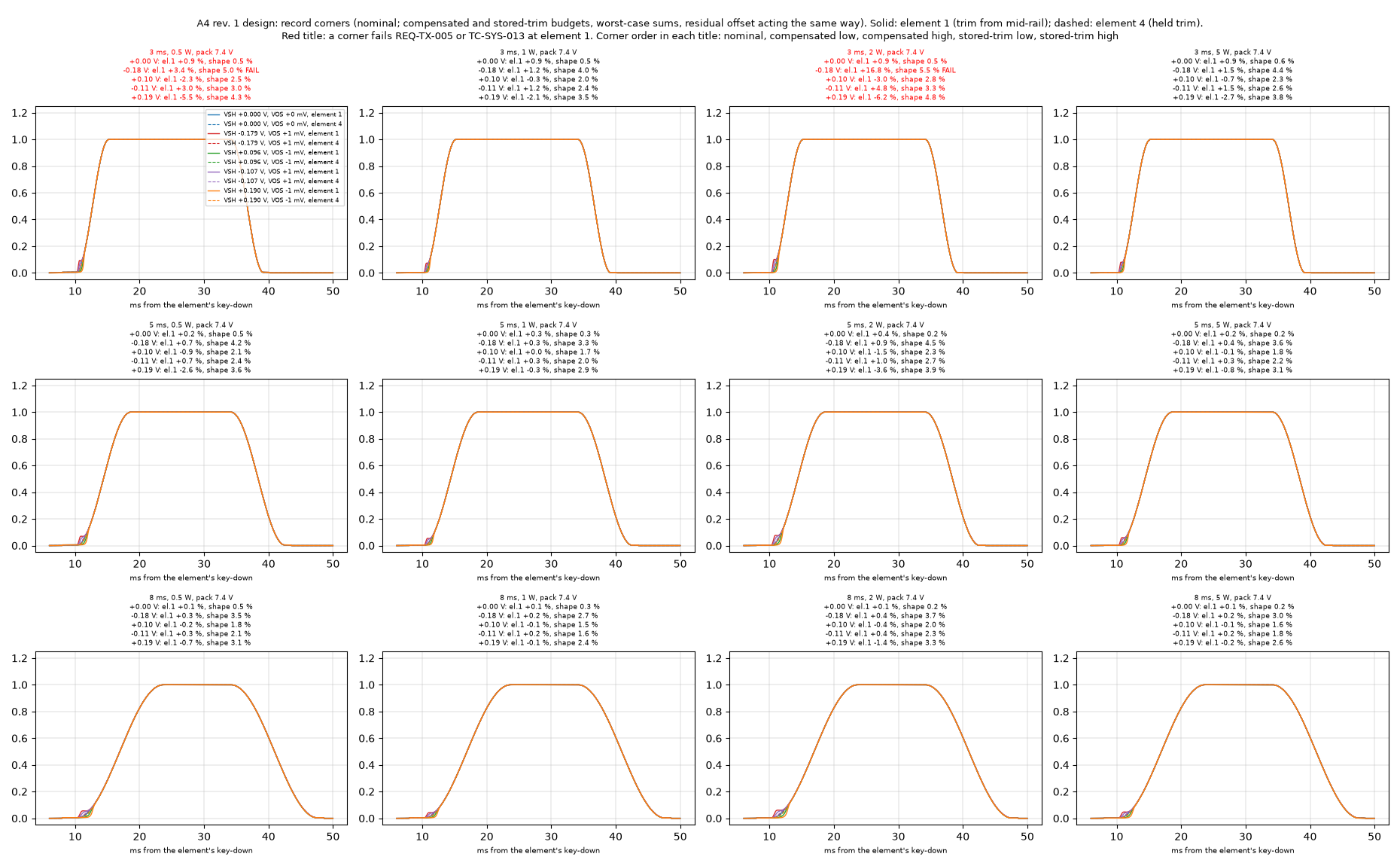
hardware/sim/tx-keying/results/2026-09-28-r2-a4-fix/corners.png
