robinonsay/cwht/hardware/sim/tx-keying/keying_a4_fix.cir

* keying_a4_fix.cir: keying envelope loop, TS-012 finalist A4 (AFT05MS004N discrete, gate-bias loop), revision 1 design (held trim +/-0.4 V, detector tap +7 dB at 0.5 and 1 W, per-unit calibrated feedforward)
* cwht WP-PDR-22 pre-order item; generated by hardware/sim/tx-keying/keying_run.py; record
* docs/design/analysis/keying-ts012.md. Envelope-domain behavioural deck (no RF carrier).
* Steps: for each corner in turn, the packs [6.4, 7.4, 8.4] V (drain [6.1, 7.1, 8.1] V),
* within each the power steps [0.5, 1.0, 2.0, 5.0] W, within each the 3, 5, 8 ms (10-90 %) settings:
*   runs 1..36: PA curve shifted +0.000 V, error-amplifier offset +0.0 mV
*   runs 37..72: PA curve shifted -0.179 V, error-amplifier offset +1.0 mV
*   runs 73..108: PA curve shifted +0.096 V, error-amplifier offset -1.0 mV
*   runs 109..144: PA curve shifted -0.107 V, error-amplifier offset +1.0 mV
*   runs 145..180: PA curve shifted +0.190 V, error-amplifier offset -1.0 mV
* 50 WPM continuous dits: key down 24 ms, up 24 ms; relay command at key-down of element 1,
* contact closed at 7.5 ms; CLK1 and GVA-84+ bias on at 8 ms; ramp start 10 ms after each key-down;
* drive gated off 1 ms after each ramp end; VGG and integrator clamps applied at the gate.
.param TPER=0.048 TDIT=0.024 TLEAD=0.01 TCLK=0.008 TC=0.0075 TQ=3.2768e-05 TG=0.001
.param run=1
.param TSET=table(run,1,0.003,2,0.005,3,0.008,4,0.003,5,0.005,6,0.008,7,0.003,8,0.005,9,0.008,10,0.003,11,0.005,12,0.008,13,0.003,14,0.005,15,0.008,16,0.003,17,0.005,18,0.008,19,0.003,20,0.005,21,0.008,22,0.003,23,0.005,24,0.008,25,0.003,26,0.005,27,0.008,28,0.003,29,0.005,30,0.008,31,0.003,32,0.005,33,0.008,34,0.003,35,0.005,36,0.008,37,0.003,38,0.005,39,0.008,40,0.003,41,0.005,42,0.008,43,0.003,44,0.005,45,0.008,46,0.003,47,0.005,48,0.008,49,0.003,50,0.005,51,0.008,52,0.003,53,0.005,54,0.008,55,0.003,56,0.005,57,0.008,58,0.003,59,0.005,60,0.008,61,0.003,62,0.005,63,0.008,64,0.003,65,0.005,66,0.008,67,0.003,68,0.005,69,0.008,70,0.003,71,0.005,72,0.008,73,0.003,74,0.005,75,0.008,76,0.003,77,0.005,78,0.008,79,0.003,80,0.005,81,0.008,82,0.003,83,0.005,84,0.008,85,0.003,86,0.005,87,0.008,88,0.003,89,0.005,90,0.008,91,0.003,92,0.005,93,0.008,94,0.003,95,0.005,96,0.008,97,0.003,98,0.005,99,0.008,100,0.003,101,0.005,102,0.008,103,0.003,104,0.005,105,0.008,106,0.003,107,0.005,108,0.008,109,0.003,110,0.005,111,0.008,112,0.003,113,0.005,114,0.008,115,0.003,116,0.005,117,0.008,118,0.003,119,0.005,120,0.008,121,0.003,122,0.005,123,0.008,124,0.003,125,0.005,126,0.008,127,0.003,128,0.005,129,0.008,130,0.003,131,0.005,132,0.008,133,0.003,134,0.005,135,0.008,136,0.003,137,0.005,138,0.008,139,0.003,140,0.005,141,0.008,142,0.003,143,0.005,144,0.008,145,0.003,146,0.005,147,0.008,148,0.003,149,0.005,150,0.008,151,0.003,152,0.005,153,0.008,154,0.003,155,0.005,156,0.008,157,0.003,158,0.005,159,0.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
* reset to 2.5 V while parked; it does not load the reference or the detector (buffered inputs, e.g.
* an MCP6002 difference integrator with the spare half as buffer; WP-PDR-22 sets the circuit).
* VOS is the residual input offset after the firmware zero calibration.
* revision 1: the integrator input is opened while parked, so the trim is HELD between elements
* (no reset); it starts at mid-rail at t = 0 (power-on)
Gi 0 xi value={(1-V(park))*(V(vref)-V(detf)+VOS)/10000}
Ci xi 0 1.92e-09
Dih xi vh DI
Dil vl xi DI
Vh vh 0 2.485
Vl vl 0 -2.485
Bo out 0 V=2.5+V(xi)
.model DI D(Ron=1 Roff=1e12 Vfwd=0)
* feedforward VGG table (second 12-bit PWM, same update and 2-pole RC as the reference): the nominal
* inverse PA curve at the run's drain voltage for KFF of the wanted amplitude, 0 V when the table is 0
Bff ffraw 0 V=(env(time)>0)*max(table(10*log10(max((KFF*ASET*env(time))**2/100/LOSS/SCALE,1e-20)*1e3),-283.01,-1.8,-233.01,-1.3,-183.01,-0.8,-133.01,-0.3,-83.0103,0.2,-33.0103,0.7,16.9897,1.2,22.3045,1.3,26.0206,1.4,28.5733,1.5,30.2119,1.6,31.7609,1.7,33.0103,1.8,34.1497,1.9,35.0515,2,35.9106,2.1,36.6276,2.2,37.2428,2.3,37.4819,2.35,37.8533,2.5,38.0277,2.7,38.0956,3,38.1291,3.5,38.1624,5),0)
R3 ffraw f1 4.7k
C3 f1 0 10n
R4 f1 ff 4.7k
C4 ff 0 10n
* VGG node: feedforward plus the loop trim, KTRIM volts per volt of the error amplifier about
* mid-rail (+/-0.25 V authority), not below 0 V (Schottky clamp), 1.77 k, 10 nF
Bvt vt 0 V=max(KTRIM*(V(out)-2.5)+V(ff),0)
Rth vt vgg 1770
Cg vgg 0 1e-08
* clamps (open collector, on at reset): VGG node held low and integrator parked outside the window
* ramp start .. drive gate
Bpk park 0 V=1-onw(time,TLEAD,TE+TG)
S1 vgg 0 park 0 SWC
S4 vref 0 park 0 SWC
.model SWC SW(Ron=10 Roff=1e9 Vt=0.5 Vh=0.05)
* PA static transfer (dBm at the reference drain voltage) scaled for the drain voltage, curve shifted
* by VSH (module-to-module threshold corner)
Bpg pg 0 V=SCALE*pow(10,(table(V(vgg)-VSH,-1.8,-283.01,-1.3,-233.01,-0.8,-183.01,-0.3,-133.01,0.2,-83.0103,0.7,-33.0103,1.2,16.9897,1.3,22.3045,1.4,26.0206,1.5,28.5733,1.6,30.2119,1.7,31.7609,1.8,33.0103,1.9,34.1497,2,35.0515,2.1,35.9106,2.2,36.6276,2.3,37.2428,2.35,37.4819,2.5,37.8533,2.7,38.0277,3,38.0956,3.5,38.1291,5,38.1624)-30)/10)
* drive gate: CLK1 enable and GVA-84+ bias, 10 us
Bd dr0 0 V=onw(time,TCLK,TE+TG)
Rd dr0 dr 1k
Cd dr 0 10n
* relay pole A contact (closes 7.5 ms after the relay command)
Bc cont 0 V=time>TC
* power and amplitude at the 50 ohm load (after 0.5 dB LPF and relay loss); PLEAK is the output with
* the gate off and the exciter driven (estimate, see the record)
Bpl pl 0 V=V(cont)*V(dr)*(V(pg)+PLEAK)*LOSS
Bal al 0 V=sqrt(100*max(V(pl),0))
* detector static law from run 2026-09-28-det-char-biased and its 4.7 us video pole (10 k, 470 pF);
* DB is the tap factor (the diode sees DB times the amplitude of the 5 W design tap)
Bdet d0 0 V=table(DB*V(al),-1,0,0,0,0.05,8.27946e-05,0.1,0.000330664,0.2,0.00131475,0.35,0.00396146,0.6,0.0111292,1,0.0278097,1.7,0.0647408,3,0.142508,5,0.270735,9,0.536205,15,0.943429,22.36,1.44789,28,1.83699)
Rv d0 detf 1k
Cv detf 0 4.7n
* op-amp macro: gm stage, Aol 112 dB, GBW 1 MHz, internal node and output limited to the rails
.subckt OPA inp inn out vcc
G1 0 x inp inn 1m
Rx x 0 4e8
Cx x 0 159p
Dhi x vcc DI
Dlo 0 x DI
Bo o 0 V=limit(V(x),0.015,V(vcc)-0.015)
Ro o out 20
.model DI D(Ron=1 Roff=1e12 Vfwd=0)
.ends OPA
.save V(al) V(vgg)
.tran 0 0.384 0.0 20u
.options reltol=1e-4
.end
