robinonsay/cwht/hardware/sim/tx-keying/keying_a5_sens.cir

* keying_a5_sens.cir: keying envelope loop, TS-012 finalist A5 (RA07M1317M module, VGG loop), revision 1 design, element 1 only, VSH sweep in 0.02 V for the offset, pack and sub-threshold slope cases
* cwht WP-PDR-22 pre-order item; generated by hardware/sim/tx-keying/keying_run.py; record
* docs/design/analysis/keying-ts012.md. Envelope-domain behavioural deck (no RF carrier).
* Steps: for each corner in turn, the packs [7.4] V (drain [6.7] V),
* within each the power steps [0.5, 1.0, 2.0, 5.0] W, within each the 3, 5, 8 ms (10-90 %) settings:
* (variant sens: for each case in turn, VSH -0.30 to +0.30 V in 0.02 V, within each
* the steps and settings; the pack of the case; element 1 only)
*   runs 1..372: nominal: pack 7.4 V, offset +0.0 mV, PA sub-threshold slope 100 dB/V
*   runs 373..744: VOS +1 mV: pack 7.4 V, offset +1.0 mV, PA sub-threshold slope 100 dB/V
*   runs 745..1116: VOS -1 mV: pack 7.4 V, offset -1.0 mV, PA sub-threshold slope 100 dB/V
*   runs 1117..1488: pack 6.4 V: pack 6.4 V, offset +0.0 mV, PA sub-threshold slope 100 dB/V
*   runs 1489..1860: pack 8.4 V: pack 8.4 V, offset +0.0 mV, PA sub-threshold slope 100 dB/V
*   runs 1861..2232: slope 65 dB/V: pack 7.4 V, offset +0.0 mV, PA sub-threshold slope 65 dB/V
*   runs 2233..2604: slope 150 dB/V: pack 7.4 V, offset +0.0 mV, PA sub-threshold slope 150 dB/V
* 50 WPM continuous dits: key down 24 ms, up 24 ms; relay command at key-down of element 1,
* contact closed at 7.5 ms; CLK1 and GVA-84+ bias on at 8 ms; ramp start 10 ms after each key-down;
* drive gated off 1 ms after each ramp end; VGG and integrator clamps applied at the gate.
.param TPER=0.048 TDIT=0.024 TLEAD=0.01 TCLK=0.008 TC=0.0075 TQ=3.2768e-05 TG=0.001
.param run=1
.param TSET=table(run,1,0.003,2,0.005,3,0.008,4,0.003,5,0.005,6,0.008,7,0.003,8,0.005,9,0.008,10,0.003,11,0.005,12,0.008,13,0.003,14,0.005,15,0.008,16,0.003,17,0.005,18,0.008,19,0.003,20,0.005,21,0.008,22,0.003,23,0.005,24,0.008,25,0.003,26,0.005,27,0.008,28,0.003,29,0.005,30,0.008,31,0.003,32,0.005,33,0.008,34,0.003,35,0.005,36,0.008,37,0.003,38,0.005,39,0.008,40,0.003,41,0.005,42,0.008,43,0.003,44,0.005,45,0.008,46,0.003,47,0.005,48,0.008,49,0.003,50,0.005,51,0.008,52,0.003,53,0.005,54,0.008,55,0.003,56,0.005,57,0.008,58,0.003,59,0.005,60,0.008,61,0.003,62,0.005,63,0.008,64,0.003,65,0.005,66,0.008,67,0.003,68,0.005,69,0.008,70,0.003,71,0.005,72,0.008,73,0.003,74,0.005,75,0.008,76,0.003,77,0.005,78,0.008,79,0.003,80,0.005,81,0.008,82,0.003,83,0.005,84,0.008,85,0.003,86,0.005,87,0.008,88,0.003,89,0.005,90,0.008,91,0.003,92,0.005,93,0.008,94,0.003,95,0.005,96,0.008,97,0.003,98,0.005,99,0.008,100,0.003,101,0.005,102,0.008,103,0.003,104,0.005,105,0.008,106,0.003,107,0.005,108,0.008,109,0.003,110,0.005,111,0.008,112,0.003,113,0.005,114,0.008,115,0.003,116,0.005,117,0.008,118,0.003,119,0.005,120,0.008,121,0.003,122,0.005,123,0.008,124,0.003,125,0.005,126,0.008,127,0.003,128,0.005,129,0.008,130,0.003,131,0.005,132,0.008,133,0.003,134,0.005,135,0.008,136,0.003,137,0.005,138,0.008,139,0.003,140,0.005,141,0.008,142,0.003,143,0.005,144,0.008,145,0.003,146,0.005,147,0.008,148,0.003,149,0.005,150,0.008,151,0.003,152,0.005,153,0.008,154,0.003,155,0.005,156,0.008,157,0.003,158,0.005,159,0.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
54,0.003,2555,0.005,2556,0.008,2557,0.003,2558,0.005,2559,0.008,2560,0.003,2561,0.005,2562,0.008,2563,0.003,2564,0.005,2565,0.008,2566,0.003,2567,0.005,2568,0.008,2569,0.003,2570,0.005,2571,0.008,2572,0.003,2573,0.005,2574,0.008,2575,0.003,2576,0.005,2577,0.008,2578,0.003,2579,0.005,2580,0.008,2581,0.003,2582,0.005,2583,0.008,2584,0.003,2585,0.005,2586,0.008,2587,0.003,2588,0.005,2589,0.008,2590,0.003,2591,0.005,2592,0.008,2593,0.003,2594,0.005,2595,0.008,2596,0.003,2597,0.005,2598,0.008,2599,0.003,2600,0.005,2601,0.008,2602,0.003,2603,0.005,2604,0.008)
.param TR={TSET/0.590334}
.param TE={TLEAD+TDIT+TR}
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
