robinonsay/cwht/hardware/sim/tx-pa/decks/power_a5.cir

* power_a5.cir: A5 RA07M1317M module, output power at the SMA versus pack voltage (cwht WP-PDR-21, hardware/sim/tx-pa)
* Pack EMF Vp (swept 6.4 to 8.4 V; equal to the voltage read in receive within 10 mV) behind the drain feed rfeed;
* the 5 V bus (0.25 A, est.) and the PA drain current Pout/(eta*Vd) load the feed, so the key-down sag is solved
* by LTspice. V(pmod) is the PA output power in watts, V(psma) the power at the SMA after the output LPF and relay.
* 4536 corners flattened into one .step (idx), first dimension fastest: irf, ieta, ipin, ifr, ivgg, isp, iloss, itc.
.param idx=0
.step param idx 0 4535 1
.param irf=floor(idx/1)-3*floor(idx/3)
.param ieta=floor(idx/3)-2*floor(idx/6)
.param ipin=floor(idx/6)-3*floor(idx/18)
.param ifr=floor(idx/18)-3*floor(idx/54)
.param ivgg=floor(idx/54)-2*floor(idx/108)
.param isp=floor(idx/108)-2*floor(idx/216)
.param iloss=floor(idx/216)-3*floor(idx/648)
.param itc=floor(idx/648)-7*floor(idx/4536)
* temperature cases (itc): 0 25 C; 1 -10 C, PA +0 dB; 2 -10 C, PA +0.53 dB; 3 +45 C, case 80 C, -0.005 dB/K; 4 +45 C, case 80 C, -0.015 dB/K; 5 +45 C, case 100 C, -0.005 dB/K; 6 +45 C, case 100 C, -0.015 dB/K
.param rf=table(itc*3+irf,0,0.26,1,0.35,2,0.45,3,0.3016,4,0.41135,5,0.5396,6,0.3016,7,0.41135,8,0.5396,9,0.293,10,0.41741,11,0.5675,12,0.293,13,0.41741,14,0.5675,15,0.293,16,0.41741,17,0.5675,18,0.293,19,0.41741,20,0.5675)
.param kt=table(itc,0,1,1,1,2,1.1285,3,0.938642,4,0.82699,5,0.917276,6,0.771792)
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
Bmod pmod 0 V=pv(max(V(d),3))*kd*kv*ks*kt
Rmod pmod 0 1meg
Bpa d 0 I=V(pmod)/(eta*max(V(d),1))
Vp p 0 7.4
Rf p d {rf}
Ibus d 0 0.25
Bsma psma 0 V=V(pmod)*kloss*kxl
Rsma psma 0 1meg
.dc Vp 6.4 8.4 0.05
.save V(d) V(pmod) V(psma) I(Vp)
.end
