robinonsay/cwht/tools/tests/fixtures/ltspice/rc-nc-error.asc

C1: cap; 159.155n
R1: res; 1k
V1: voltage; AC 1
Named nets: 0, in, out
.ac dec 100 10 100k
.meas AC f3db WHEN mag(V(out))=1/sqrt(2)
