robinonsay/cwht/hardware/sim/tx-pa/results/2026-09-30-r5-p4-power-a5-design/power_a5_step.cir

* power_a5_step.cir: A5 RA07M1317M, per-unit clamp step, revision 5: the added unit case of finding-31 only
* (cwht WP-PDR-21 revision 5, hardware/sim/tx-pa/run_a5_r5.py p4; record docs/design/analysis/pa-drive-ts012.md section R5; the deck of revision 4 run 2026-09-29-r4-p4-power-a5-design with one unit case)
* As revision 3 (power_a5_design.cir) with: the drive band of r4-s2 (10.99, 18.20, 27.37 mW);
* the clamp top set per unit by the build step: VGG(Vp) = top(Vp) + offset, top(Vp) the VGG at which the unit the step
* believes (base, spread ua = ux + e dB) makes tgt = 6.2934 W at its highest open-loop case (-10 C start and 25 C
* start, each of 144, 146, 148 MHz, the unit's own feed, efficiency and drive), capped at 3.50 V; closed form below.
* tgt = 7.9 W x 10^(-g-/10) for the 8 W ceiling. Offsets -0.2, -0.1, 0 V.
* Unit cases (iu): 0 +2.49 dB true (believed +1.5 dB, the reject threshold), read low (x +2.487, e -0.987 dB).
* The output loss (LPF plus relay, [0.84, 1.03, 1.34, 1.86] dB, with the copper term cu per temperature case) scales the module output only:
* the checker applies it to V(pmod) (power at the SMA = V(pmod) x 10^(-(loss + (loss - 0.1) cu)/10)), as revision 3's Bsma did.
* 1944 corners flattened into one .step (idx), first dimension fastest: irf, ieta, ipin, ifr, ivgg, iu, itc.
.param idx=0
.step param idx 0 1943 1
.param irf=floor(idx/1)-4*floor(idx/4)
.param ieta=floor(idx/4)-2*floor(idx/8)
.param ipin=floor(idx/8)-3*floor(idx/24)
.param ifr=floor(idx/24)-3*floor(idx/72)
.param ivgg=floor(idx/72)-3*floor(idx/216)
.param iu=floor(idx/216)-1*floor(idx/216)
.param itc=floor(idx/216)-9*floor(idx/1944)
* temperature cases (itc): 0 25 C, start of key-down (case 25 C); 1 25 C, key-down, -0.005 dB/K; 2 25 C, key-down, -0.015 dB/K; 3 -10 C, key-down, PA no cold gain; 4 -10 C, start of key-down, PA +0.53 dB; 5 +45 C, key-down, -0.005 dB/K; 6 +45 C, key-down, -0.015 dB/K; 7 +45 C, case 100 C bound, -0.005 dB/K; 8 +45 C, case 100 C bound, -0.015 dB/K
.param rf=table(itc*4+irf,0,0.238,1,0.345,2,0.452,3,0.314,4,0.24954,5,0.38312,6,0.5324,7,0.36404,8,0.24954,9,0.38312,10,0.5324,11,0.36404,12,0.3033,13,0.44951,14,0.61396,15,0.46685,16,0.29291,17,0.4149,18,0.53841,19,0.41828,20,0.26142,21,0.40427,22,0.56465,23,0.38414,24,0.26142,25,0.40427,26,0.56465,27,0.38414,28,0.26142,29,0.40427,30,0.56465,31,0.38414,32,0.26142,33,0.40427,34,0.56465,35,0.38414)
.param rfc=table(irf,0,0.29291,1,0.4149,2,0.53841,3,0.41828)
.param rfs=table(irf,0,0.238,1,0.345,2,0.452,3,0.314)
.param ta=table(itc,0,25,1,25,2,25,3,-10,4,-10,5,45,6,45,7,45,8,45)
.param tcfix=table(itc,0,25,1,-999,2,-999,3,-999,4,-10,5,-999,6,-999,7,100,8,100)
.param coef=table(itc,0,-0.015,1,-0.005,2,-0.015,3,-0.015,4,-0.015,5,-0.005,6,-0.015,7,-0.005,8,-0.015)
.param ng=table(itc,0,1,1,1,2,1,3,1,4,0,5,1,6,1,7,1,8,1)
.param cu=table(itc,0,0,1,0.0858,2,0.0858,3,0.01755,4,-0.06825,5,0.1248,6,0.1248,7,0.1248,8,0.1248)
.param rth=6.11
.param pinw_pa=pow(10,(pin-30)/10)
.param pin=table(ipin,0,10.4114,1,12.6007,2,14.3731)
.param fr=table(ifr,0,1.44e+08,1,1.46e+08,2,1.48e+08)
.param vgg=table(ivgg,0,-0.2,1,-0.1,2,0)
.param eta=table(ieta,0,0.45,1,0.6)
.param ubase=table(iu,0,0)
.param ux=table(iu,0,2.48742)
.param ua=table(iu,0,1.5)
.param tgt=6.2934
.param ktc=1.1285
.param kts=1
.param w=(fr-135e6)/20e6
* drive factor: datasheet Pout-Pin curves at 7.2 V, relative to Pin 20 mW
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
.param ksa144=if(ubase>0.5,0.765737,1)*pow(10,ua/10)
.param ksa146=if(ubase>0.5,0.770506,1)*pow(10,ua/10)
.param ksa148=if(ubase>0.5,0.775334,1)*pow(10,ua/10)
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
