robinonsay/cwht/hardware/sim/freq/clock_plan.py

#!/usr/bin/env python3
"""Clock plan harmonic checker: every clock of the cwht plan against the 2 m band, the CW-only
segment, the IF window, the image band and the LO band, for each candidate IF plan.

Product: docs/design/analysis/clock-plan.md and ADR-031 (WP-PDR-20, PDR work plan section 3.6).
Run from the repository root:

    .venv/bin/python hardware/sim/freq/clock_plan.py            # check, print tables, exit status
    .venv/bin/python hardware/sim/freq/clock_plan.py --plot     # also render the figure
    .venv/bin/python hardware/sim/freq/clock_plan.py --rosc-running   # seeded case: the ROSC left running
                                                                      # (ADR-051 as written, no rule 11): exit 1

Exit status 0 when every rule of ADR-031 (section "RULES") holds for the proposed plan, 1 otherwise.
Sources that cannot be placed by frequency (status "residual": free-running, not synchronisable and
not switchable off in operation, or with a frequency set by the board) are reported as named
residual lines (clock-plan.md section 2.1), not as rule failures.
Revision 2 (INSP-056 finding-8): the RP2350 ring oscillator (ROSC) is in the inventory as a clear-class clock
that rule 11 switches off in operation; with --rosc-running it is treated as running and rules 1 and 2 fail.
The RP2350 low-power oscillator (LPOSC) is residual source R-5.
Arithmetic is exact (fractions.Fraction); a clock line is the interval n*f*(1 +/- tol).

Tool status (05 section 9.1): class B evidence-generating script without a TV record; its output is
developer evidence (peer-review-checklist-analysis CK-ANA-C2). Standard library only for the
numbers; matplotlib renders the figure.
"""
from __future__ import annotations

import argparse
import sys
from dataclasses import dataclass
from fractions import Fraction as F
from pathlib import Path

MHz = F(10**6)
kHz = F(10**3)
PPM = F(1, 10**6)

# Bands (source next to each)
RF = (144 * MHz, 148 * MHz)                         # 47 CFR 97.301(a)
CW_SEG = (F("144.010") * MHz, F("144.100") * MHz)   # 47 CFR 97.305(a), (c): 144.0-144.1 CW only; lower bound REQ-SYS-034
SYS034 = (F("144.010") * MHz, F("147.999") * MHz)   # REQ-SYS-034 (TBR) receive range
XOSC_LINE_EXCL = (F("144.000") * MHz - F("9.4") * kHz, F("144.000") * MHz + F("9.4") * kHz)  # REQ-SYS-034 rationale
IF_HALF = 5 * kHz                                   # ALLOCATION: IF window +/-5 kHz (REQ-SYS-025 -60 dB BW 2.5 kHz, doubled)
SIDETONE = F(600)                                   # ADR-026 / keyer research C13: default sidetone 600 Hz = BFO offset
XOSC_PPM = F(65)                                    # RP2350 datasheet Table 596: 30 + 30 + 5 ppm
TCXO_PPM = F("2.5")                                 # REQ-SYS-010 ceiling
CLK_SYS = 150 * MHz                                 # 07 WP-SW-11: clk_sys = clk_peri = 150 MHz; RP2350 section 12.2.1.2: I2C ic_clk is clk_sys

# RP2350 on-chip oscillators (revision 2, INSP-056 finding-8). Datasheet extract at rustos commit 2ec64c0f.
ROSC_RANGE = (F("4.6") * MHz, F("24.0") * MHz)      # section 8.3.1 (extract lines 41086 to 41093): "4.6MHz to 19.6MHz without
                                                    # randomisation and 4.6MHz to 24.0MHz with randomisation"; the wider range is used
LPOSC_INITIAL = (F("26.2144") * kHz, F("39.3216") * kHz)    # section 8.4.1 Table 615 F0.initial min / max (32.768 typ)
LPOSC_TRIMMED = (F("32.27648") * kHz, F("33.25952") * kHz)  # Table 615 F0.trimmed; drift +/-14 % (temperature) and +/-20 %
                                                            # (supply) come on top of either range

# I2C SCL model (RP2350 datasheet section 12.2.14, Figure 89):
#   SCL_High_time = (HCNT + IC_FS_SPKLEN + 7) * ic_clk + SCL_Fall_time
#   SCL_low_time  = (LCNT + 1) * ic_clk - SCL_Fall_time + SCL_Rise_time
# so the SCL period is (HCNT + SPKLEN + LCNT + 8) * ic_clk + SCL_Rise_time; the fall time cancels.
I2C_HCNT, I2C_LCNT, I2C_SPKLEN = 160, 199, 8        # PROPOSAL: 375 ic_clk per period; LCNT > SPKLEN + 7, HCNT > SPKLEN + 5 (12.2.14.1)
I2C_TR_NS = (F(20), F(300))                         # ALLOCATION: SCL rise time range (pull-ups and bus capacitance, "beyond the
                                                    # control of the DW_apb_i2c", 12.2.14 note); 300 ns is the Fast-mode ceiling
                                                    # of the I2C-bus specification, which is not in the corpus


def i2c_scl_range():
    cyc = I2C_HCNT + I2C_SPKLEN + 7 + I2C_LCNT + 1
    t0 = F(cyc) / CLK_SYS
    lo = 1 / (t0 + I2C_TR_NS[1] * F(1, 10**9))
    hi = 1 / (t0 + I2C_TR_NS[0] * F(1, 10**9))
    return cyc, lo, hi


def merged(ls):
    """Merge overlapping harmonic intervals [(n, a, b)] into (a, b, n_first, n_last) segments."""
    out = []
    for n, a, b in sorted(ls, key=lambda t: t[1]):
        if out and a <= out[-1][1]:
            pa, pb, n0, _ = out[-1]
            out[-1] = (pa, max(pb, b), n0, n)
        else:
            out.append((a, b, n, n))
    return out


def covers(ls, band):
    """True when the union of the harmonic intervals ls covers the whole band without a gap."""
    return any(a <= band[0] and b >= band[1] for a, b, _, _ in merged(ls))


def min_dev_to_segment(f_nom: F):
    """Smallest relative deviation (ppm) of f_nom at which some harmonic enters the CW-only segment."""
    best = None
    n = 1
    while n * f_nom * F(1, 2) <= CW_SEG[1]:
        a = n * f_nom
        if a < CW_SEG[0]:
            d = (CW_SEG[0] / n - f_nom) / f_nom
        elif a > CW_SEG[1]:
            d = (f_nom - CW_SEG[1] / n) / f_nom
        else:
            d = F(0)
        if best is None or d < best[0]:
            best = (d, n)
        n += 1
    return best[0] / PPM, best[1]

# IF plans (TS-001 section 3.3: IF 9.000, 9.0106 or 10.7 MHz; low- or high-side LO)
IF_PLANS = [("9.000", "low"), ("9.000", "high"), ("9.0106", "low"), ("9.0106", "high"), ("10.7", "low"), ("10.7", "high")]


@dataclass
class Clock:
    name: str
    f: F               # nominal Hz (for a range, the lower end)
    f_hi: F            # upper end (== f for a fixed clock)
    tol_ppm: F
    cls: str           # "clear" (>= 4 MHz, must have no in-band line) or "dense" (< 4 MHz)
    status: str        # fixed / proposed / allowed / option / rejected / tx-only / by-design / off-in-op / boot-only / residual
                       # (off-in-op: runs at boot or in a state outside operation and is switched off in operation by a rule)
    source: str
    coherent: bool = False   # derived from XOSC so that 144 MHz / f is an integer (line exactly on 144.000 MHz)
    known: bool = True       # False: frequency not in the corpus (value-of-information item), no lines computed


def lines_in(clk: Clock, band, nmax=None):
    """Harmonic numbers n whose line interval [n f_lo (1-tol), n f_hi (1+tol)] meets band."""
    lo, hi = band
    out = []
    if not clk.known:
        return out
    n = 1
    top = hi / (clk.f * (1 - clk.tol_ppm * PPM))
    while n <= top and (nmax is None or n <= nmax):
        a = n * clk.f * (1 - clk.tol_ppm * PPM)
        b = n * clk.f_hi * (1 + clk.tol_ppm * PPM)
        if b >= lo and a <= hi:
            out.append((n, a, b))
        n += 1
    return out


def plan_bands(if_mhz: str, side: str):
    IF = F(if_mhz) * MHz
    if side == "low":
        lo_band = (RF[0] - IF, RF[1] - IF)
        img = (RF[0] - 2 * IF, RF[1] - 2 * IF)
    else:
        lo_band = (RF[0] + IF, RF[1] + IF)
        img = (RF[0] + 2 * IF, RF[1] + 2 * IF)
    return IF, lo_band, img, (IF - IF_HALF, IF + IF_HALF)


def clocks_base(rosc_running: bool = False):
    """The plan: every clock with its status and source. rosc_running=True models ADR-051 as written, without rule 11."""
    c = []
    c.append(Clock("XOSC 12 MHz (Pico 2 crystal, clk_ref)", 12 * MHz, 12 * MHz, XOSC_PPM, "clear", "fixed", "Pico 2 ABM8-272-T3; RP2350 Table 596", True))
    c.append(Clock("clk_usb / clk_adc 48 MHz (PLL_USB)", 48 * MHz, 48 * MHz, XOSC_PPM, "clear", "fixed", "RP2350 8.1 Table 537: clk_adc must be 48 MHz", True))
    c.append(Clock("clk_sys = clk_peri 150 MHz (PLL_SYS)", 150 * MHz, 150 * MHz, XOSC_PPM, "clear", "fixed", "07 WP-SW-11 (150 MHz)"))
    # ROSC (revision 2, INSP-056 finding-8): clocks the chip at boot; stops only when software disables it
    # (section 8.3.1 "You can disable the ROSC once you've switched the system clocks to the XOSC"; ROSC CTRL.ENABLE
    # 0xd1e DISABLE, Table 605). Rule 11: the clocks driver disables it once clk_ref and clk_sys are proven off it.
    rosc_name = ("RP2350 ROSC 4.6 to 24.0 MHz (seeded case: left running, no rule 11)" if rosc_running
                 else "RP2350 ROSC 4.6 to 24.0 MHz (boot clock; disabled in operation by rule 11)")
    c.append(Clock(rosc_name, ROSC_RANGE[0], ROSC_RANGE[1], F(0), "clear",
                   "fixed" if rosc_running else "off-in-op",
                   "RP2350 8.3.1 (4.6 to 24.0 MHz), 8.1.1.2 (restarts after DORMANT 'in the same configuration'), Table 605 CTRL.ENABLE"))
    c.append(Clock("TCXO 25.000 MHz", 25 * MHz, 25 * MHz, TCXO_PPM, "clear", "proposed", "TS-007 R-M4, this plan"))
    c.append(Clock("TCXO 26.000 MHz (alternative)", 26 * MHz, 26 * MHz, TCXO_PPM, "clear", "rejected", "F21 Abracon ATX-13 frequency"))
    c.append(Clock("TCXO 27.000 MHz (alternative)", 27 * MHz, 27 * MHz, TCXO_PPM, "clear", "rejected", "F16 Si5351 25 or 27 MHz"))
    c.append(Clock("Prescaler output /8 (TX only)", F("144.0012") * MHz / 8, F("147.9988") * MHz / 8, TCXO_PPM, "clear", "tx-only", "REQ-TX-013 proposal"))
    # SPI serial clocks from clk_peri 150 MHz: SCK = 150 MHz / d, d even (CPSDVSR even x (1+SCR))
    for d in (6, 8, 10, 12, 16, 24, 26, 30):
        st = "proposed" if d == 8 else ("rejected" if d >= 26 else "allowed")
        c.append(Clock(f"SPI SCK 150/{d} = {float(150/F(d)):.4g} MHz", 150 * MHz / d, 150 * MHz / d, XOSC_PPM, "clear", st, "RP2350 12.3 SSPCPSR/SCR; clear-set rule"))
    # Dense-class clocks (< 4 MHz): lines unavoidable; placement rule is coherence with 144.000 MHz
    # I2C SCL: revision 0 modelled it as 150 MHz / 375 = 400 kHz, coherent. That is wrong (INSP-056 finding-4): the
    # period includes the rise time (RP2350 section 12.2.14), so SCL is modelled below as a residual source.
    c.append(Clock("Audio and sidetone PWM 150 kHz (TOP+1 = 1000)", 150 * kHz, 150 * kHz, XOSC_PPM, "dense", "proposed", "RP2350 12.5; audio research F1 (TOP 1023 = 146.48 kHz)", True))
    c.append(Clock("Audio PWM 146.484 kHz (TOP+1 = 1024)", 150 * MHz / 1024, 150 * MHz / 1024, XOSC_PPM, "dense", "rejected", "audio research F1"))
    c.append(Clock("5 V buck sync 2.4 MHz (12 MHz / 5)", F("2.4") * MHz, F("2.4") * MHz, XOSC_PPM, "dense", "proposed", "HZ-008 K6 buck synchronised; WP-PDR-24 part", True))
    c.append(Clock("5 V buck free-running 2.2 MHz (+/-10 %)", F("1.98") * MHz, F("2.42") * MHz, F(0), "dense", "rejected", "power research F19 (2.2 MHz)"))
    c.append(Clock("Charger boost 1.5 MHz (free-running, +/-10 %)", F("1.35") * MHz, F("1.65") * MHz, F(0), "dense", "off-in-op", "power research F20 (1.5 MHz); off while the radio is on (REQ-SYS-093, HZ-011 K2)"))
    c.append(Clock("PCM1808 SCKI 12.288 MHz (option B, 256 fs at 48 kS/s)", F("12.288") * MHz, F("12.288") * MHz, F(50), "clear", "rejected", "TS-001 option B; cw-selectivity F12"))
    c.append(Clock("PCM1808 SCKI 12.5 MHz (option B, 150 MHz / 12)", F("12.5") * MHz, F("12.5") * MHz, XOSC_PPM, "clear", "option", "this plan (fs = 48.83 kS/s)"))
    # QSPI flash SCK (revision 1, INSP-056 finding-3): SCK = clk_sys / CLKDIV, CLKDIV 1..255, odd and even
    # (RP2350 section 12.14.3; M0_TIMING.CLKDIV, Table 1296, reset 0x04). Runs whenever code executes in place.
    c.append(Clock("QSPI SCK 150/4 = 37.5 MHz (M0_TIMING reset CLKDIV)", CLK_SYS / 4, CLK_SYS / 4, XOSC_PPM, "clear", "proposed", "RP2350 12.14.3, Table 1296 (CLKDIV reset 4)"))
    c.append(Clock("QSPI SCK 150/12 = 12.5 MHz (boot ROM flash_enter_cmd_xip, CLKDIV 12)", CLK_SYS / 12, CLK_SYS / 12, XOSC_PPM, "clear", "boot-only", "RP2350 5.4.8.6: CLKDIV is set to 12 (boot and after flash program or erase)"))
    # Residual sources (revision 1, INSP-056 findings 3 and 4): cannot be placed by frequency in operation
    c.append(Clock("RP2350 core regulator (VREG_LX) 3 MHz typ, free-running", 3 * MHz, 3 * MHz, F(0), "dense", "residual",
                   "RP2350 6.3.1.1 (Normal mode switching whenever the core runs); 14.9.6 Table 1441 fsw typ 3 MHz, no min or max"))
    c.append(Clock("Pico 2 RT6150 buck-boost (PFM default; PWM with GPIO23 high)", F(0), F(0), F(0), "dense", "residual",
                   "Pico 2 datasheet 5.4; power research F18; fsw not in the corpus (VOI-CP-2)", known=False))
    c.append(Clock("TPA6130A2 charge pump 300 to 500 kHz (min/typ/max)", 300 * kHz, 500 * kHz, F(0), "dense", "residual",
                   "display research F15; runs while the amplifier is enabled"))
    _, lo, hi = i2c_scl_range()
    c.append(Clock(f"I2C SCL {float(lo/kHz):.1f} to {float(hi/kHz):.1f} kHz (375 ic_clk + rise 20 to 300 ns)", lo, hi, XOSC_PPM, "dense", "residual",
                   "RP2350 12.2.14 Figure 89: period set by the counts plus the rise time; non-coherent; lines only during transactions"))
    # LPOSC (revision 2, INSP-056 finding-8): RC oscillator of the always-on domain; cannot be stopped while the
    # switched-core domain is powered (Table 487 LPOSC.MODE "This feature has been removed"; Table 101 WAITING_POWCK:
    # "The solution is to not stop LPOSC when the switched-core power domain is powered")
    c.append(Clock("RP2350 LPOSC 32.768 kHz RC (26.2 to 39.3 kHz untrimmed)", LPOSC_INITIAL[0], LPOSC_INITIAL[1], F(0), "dense", "residual",
                   "RP2350 8.4, 8.4.1 Table 615 (+/-20 % initial, +/-1.5 % trimmed); Tables 101, 487: runs whenever the chip is powered"))
    return c


def bfo_clock(if_mhz: str) -> Clock:
    IF = F(if_mhz) * MHz
    return Clock(f"BFO {if_mhz} MHz +/- 1 kHz (Si5351A)", IF - kHz, IF + kHz, TCXO_PPM, "clear", "by-design", "TS-001 option A product detector")


def lo_clock(if_mhz: str, side: str) -> Clock:
    IF = F(if_mhz) * MHz
    if side == "low":
        return Clock("RX LO (low side)", RF[0] - IF, RF[1] - IF, TCXO_PPM, "clear", "by-design", "TS-001 F-A")
    return Clock("RX LO (high side)", RF[0] + IF, RF[1] + IF, TCXO_PPM, "clear", "by-design", "TS-001 F-A")


def fmt_lines(ls):
    return "; ".join(f"n={n}: {float(a/MHz):.4f}-{float(b/MHz):.4f}" for n, a, b in ls) if ls else "none"


def evaluate(verbose=True, rosc_running=False):
    """Return (failures, findings table rows)."""
    fails = []
    rows = []
    clocks = clocks_base(rosc_running)
    # Rule R1: every proposed/fixed clear-class clock has no line in the REQ-SYS-034 range except a
    # coherent line inside the 144.000 MHz exclusion.
    for c in clocks:
        rf = lines_in(c, RF)
        in034 = [l for l in lines_in(c, SYS034)]
        cw = lines_in(c, CW_SEG)
        rows.append((c, rf, in034, cw))
        active = c.status in ("fixed", "proposed", "allowed")   # residual sources are reported by residuals(), not here
        if c.cls == "clear" and active:
            bad = [l for l in in034 if not (c.coherent and l[1] >= XOSC_LINE_EXCL[0] and l[2] <= XOSC_LINE_EXCL[1])]
            if bad:
                fails.append(f"RULE-1 {c.name}: line in REQ-SYS-034 range: {fmt_lines(bad)}")
            coh_bad = [l for l in rf if c.coherent and not (l[1] >= XOSC_LINE_EXCL[0] and l[2] <= XOSC_LINE_EXCL[1])]
            if coh_bad:
                fails.append(f"RULE-1b {c.name}: coherent line outside the exclusion: {fmt_lines(coh_bad)}")
        # Rule R2: no line of any proposed or fixed clock in the CW-only segment 144.010-144.100 MHz,
        # except the unsynchronisable charger (tracked as a level item, RSK-040)
        if active and cw:
            fails.append(f"RULE-2 {c.name}: line in the CW-only segment: {fmt_lines(cw)}")
        # Rule R3: dense proposed clocks are XOSC-coherent (144 MHz / f integer)
        if c.cls == "dense" and c.status == "proposed":
            q = RF[0] / c.f
            if q.denominator != 1 or not c.coherent:
                fails.append(f"RULE-3 {c.name}: not coherent with 144.000 MHz (144 MHz / f = {float(q):.4f})")
    return fails, rows, clocks


def residuals(clocks):
    """Named residual lines (clock-plan.md section 2.1): for each residual source, whether its lines can
    fall in the CW-only segment and how that is established."""
    out = []
    for c in clocks:
        if c.status != "residual":
            continue
        if not c.known:
            out.append((c, "frequency not in the corpus: lines anywhere in 144 to 148 MHz cannot be excluded (VOI-CP-2)"))
        elif c.f == c.f_hi and c.tol_ppm == 0:
            ppm, n = min_dev_to_segment(c.f)
            out.append((c, f"typical value only: a deviation of {float(ppm):.1f} ppm from {float(c.f/MHz):.3f} MHz puts harmonic n = {n} in the CW-only segment; "
                           f"no free-running oscillator is held that close, so the segment cannot be excluded"))
        else:
            cw = lines_in(c, CW_SEG)
            rf = lines_in(c, RF)
            txt = (f"{len(cw)} harmonic interval(s) meet the CW-only segment (n = {cw[0][0]} to {cw[-1][0]}), {len(rf)} meet 144 to 148 MHz" if cw
                   else f"no line in the CW-only segment over the stated range; {len(rf)} line(s) in 144 to 148 MHz")
            if covers(rf, RF):
                txt += "; the intervals overlap and cover 144 to 148 MHz without a gap"
            out.append((c, txt))
    return out


def rosc_table(rosc_running=False):
    """ROSC lines (INSP-056 finding-8): what rule 11 removes, and the LPOSC coverage at both Table 615 ranges."""
    rosc = [c for c in clocks_base(rosc_running) if c.name.startswith("RP2350 ROSC")][0]
    cw = lines_in(rosc, CW_SEG)
    rf = lines_in(rosc, RF)
    rows = [f"ROSC {float(ROSC_RANGE[0]/MHz)} to {float(ROSC_RANGE[1]/MHz)} MHz, status {rosc.status}: if running, harmonic orders "
            f"n = {cw[0][0]} to {cw[-1][0]} ({len(cw)} orders) meet the CW-only segment, n = {rf[0][0]} to {rf[-1][0]} meet 144 to 148 MHz; "
            f"covers 144 to 148 MHz without a gap: {covers(rf, RF)}"]
    for label, rng in (("untrimmed", LPOSC_INITIAL), ("trimmed", LPOSC_TRIMMED)):
        lp = Clock("LPOSC", rng[0], rng[1], F(0), "dense", "residual", "")
        ls = lines_in(lp, RF)
        rows.append(f"LPOSC {label} {float(rng[0]/kHz):.4f} to {float(rng[1]/kHz):.4f} kHz: {len(ls)} harmonic intervals meet 144 to 148 MHz "
                    f"(n = {ls[0][0]} to {ls[-1][0]}); cover 144 to 148 MHz without a gap: {covers(ls, RF)}")
    return rows


def plan_matrix(clocks):
    """Per IF plan: hits of the BFO, LO and every active clock in the IF window, image band and LO band."""
    out = []
    for if_mhz, side in IF_PLANS:
        IF, lo_band, img, ifw = plan_bands(if_mhz, side)
        bfo = bfo_clock(if_mhz)
        lo = lo_clock(if_mhz, side)
        hits = {"BFO in RF": lines_in(bfo, RF), "BFO in CW seg": lines_in(bfo, CW_SEG)}
        extra = {"IF window": [], "image band": [], "LO band": []}
        for c in clocks + [lo]:
            if c.status not in ("fixed", "proposed", "allowed", "by-design", "tx-only"):
                continue
            if c.name.startswith("RX LO"):
                continue
            for key, band in (("IF window", ifw), ("image band", img), ("LO band", lo_band)):
                ls = lines_in(c, band)
                if ls and c.cls == "dense":
                    extra[key].append(f"{c.name} [dense, coherent] {len(ls)} line(s)")
                elif ls:
                    extra[key].append(f"{c.name} {fmt_lines(ls)}")
        # Si5351A output ceiling for the RX LO (F16: 200 MHz; high side needs divider 4, VCO 600-900 MHz)
        vco6 = (lo.f * 6, lo.f_hi * 6)
        vco4 = (lo.f * 4, lo.f_hi * 4)
        si_ok6 = vco6[0] >= 600 * MHz and vco6[1] <= 900 * MHz
        si_ok4 = vco4[0] >= 600 * MHz and vco4[1] <= 900 * MHz
        out.append((if_mhz, side, hits, extra, img, lo_band, si_ok6, si_ok4))
    return out


def report(rosc_running=False):
    fails, rows, clocks = evaluate(rosc_running=rosc_running)
    print("TABLE clocks: name | class | status | lines in 144-148 MHz | lines in CW-only segment 144.010-144.100")
    for c, rf, in034, cw in rows:
        if c.status == "residual":
            print(f"  {c.name} | {c.cls} | residual | see TABLE residual sources")
            continue
        cwtxt = fmt_lines(cw) if len(cw) <= 3 else fmt_lines(cw[:2]) + f" ... ({len(cw)} intervals)"
        print(f"  {c.name} | {c.cls} | {c.status} | {('coherent ' if c.coherent else '')}{len(rf)} line(s): {fmt_lines(rf) if len(rf) <= 3 else fmt_lines(rf[:2]) + ' ... ' + fmt_lines(rf[-1:])} | {cwtxt}")
    print("\nTABLE SPI clear set from 150 MHz (even divisor d): d -> SCK MHz, in-band lines")
    clear = []
    for d in range(2, 64, 2):
        ck = Clock("x", 150 * MHz / d, 150 * MHz / d, XOSC_PPM, "clear", "x", "")
        n = lines_in(ck, RF)
        if not n:
            clear.append(d)
        print(f"  d={d}: {float(150/F(d)):.4f} MHz: {fmt_lines(n)}")
    print("  clear divisors:", clear)
    print("\nTABLE QSPI SCK clear set from 150 MHz (CLKDIV 1..30, odd and even): CLKDIV -> SCK MHz, in-band lines")
    qclear = []
    for d in range(1, 31):
        ck = Clock("x", CLK_SYS / d, CLK_SYS / d, XOSC_PPM, "clear", "x", "")
        n = lines_in(ck, RF)
        if not n:
            qclear.append(d)
        else:
            print(f"  CLKDIV={d}: {float(150/F(d)):.4f} MHz: {fmt_lines(n)}")
    print("  clear CLKDIV values:", qclear)
    cyc, lo, hi = i2c_scl_range()
    print(f"\nTABLE I2C SCL (RP2350 12.2.14): HCNT {I2C_HCNT} + SPKLEN {I2C_SPKLEN} + 7 + LCNT {I2C_LCNT} + 1 = {cyc} ic_clk = {float(F(cyc)/CLK_SYS*10**6):.3f} us, "
          f"plus rise {float(I2C_TR_NS[0])} to {float(I2C_TR_NS[1])} ns: SCL {float(lo/kHz):.2f} to {float(hi/kHz):.2f} kHz; "
          f"144 MHz / SCL = {float(144*MHz/hi):.1f} to {float(144*MHz/lo):.1f} (not an integer over the range: non-coherent)")
    print("\nTABLE RP2350 oscillators (rule 11 and residual R-5, revision 2):")
    for r in rosc_table(rosc_running):
        print(f"  {r}")
    print("\nTABLE residual sources (named residual lines, clock-plan.md section 2.1):")
    res = residuals(clocks)
    for c, text in res:
        print(f"  RESIDUAL {c.name}: {text} [{c.source}]")
    print("\nTABLE IF plans (BFO +/-1 kHz, LO, image, IF window):")
    for if_mhz, side, hits, extra, img, lo_band, s6, s4 in plan_matrix(clocks):
        print(f"  IF {if_mhz} {side}-side: image {float(img[0]/MHz):.3f}-{float(img[1]/MHz):.3f}, LO {float(lo_band[0]/MHz):.3f}-{float(lo_band[1]/MHz):.3f} MHz; "
              f"Si5351A LO with /6 in VCO range: {s6}, with /4: {s4}")
        print(f"    BFO harmonics in 144-148: {fmt_lines(hits['BFO in RF'])}; in CW-only segment: {fmt_lines(hits['BFO in CW seg'])}")
        for k, v in extra.items():
            print(f"    {k}: {'; '.join(v) if v else 'none'}")
    print()
    for f_ in fails:
        print("FAIL", f_)
    print(f"RESULT: {len(fails)} rule failure(s) in the proposed plan; {len(res)} named residual source(s)")
    return 1 if fails else 0


def plot(out: Path):
    import matplotlib
    matplotlib.use("Agg")
    import matplotlib.pyplot as plt
    clocks = [c for c in clocks_base() if c.status in ("fixed", "proposed", "tx-only", "rejected", "off-in-op", "residual")]
    extra = [bfo_clock("9.0106"), bfo_clock("9.000"), bfo_clock("10.7")]
    allc = clocks + extra
    fig, ax = plt.subplots(figsize=(12, 7.6))
    lo, hi = 124 * MHz, 170 * MHz
    ax.axvspan(144, 148, color="tab:blue", alpha=0.10, label="2 m band 144-148 MHz")
    ax.axvspan(144.010, 144.100, color="tab:green", alpha=0.35, label="CW-only segment 144.010-144.100")
    ax.axvspan(126.0, 130.0, color="tab:orange", alpha=0.12, label="image, IF 9 MHz low side")
    ax.axvspan(135.0, 139.0, color="tab:purple", alpha=0.10, label="LO, IF 9 MHz low side")
    for i, c in enumerate(allc):
        colour = {"fixed": "k", "proposed": "tab:green", "tx-only": "tab:gray", "rejected": "tab:red", "by-design": "tab:brown", "off-in-op": "tab:olive",
                  "residual": "m"}[c.status]
        if not c.known:
            ax.text(147.0, i, "frequency not in the corpus: lines cannot be placed (VOI-CP-2)", fontsize=7, color=colour, va="center")
            continue
        drawn = c
        if c.status == "residual" and c.f == c.f_hi and c.tol_ppm == 0:
            # typical value only: drawn at +/-10 % for display; the conclusion needs only 69 ppm (checker text)
            drawn = Clock(c.name, c.f * F("0.9"), c.f * F("1.1"), F(0), c.cls, c.status, c.source)
        ls = lines_in(drawn, (lo, hi))
        # overlapping intervals are merged before drawing (revision 2: the ROSC and LPOSC intervals overlap into one span)
        for a, b, n0, n1 in merged(ls):
            a, b = max(a, lo), min(b, hi)
            if (b - a) < F("0.05") * MHz:
                ax.plot([float((a + b) / 2 / MHz)], [i], marker="|", markersize=14 if c.cls == "clear" else 5,
                        mew=2.2 if c.cls == "clear" else 0.8, color=colour, linestyle="none")
            else:
                ax.plot([float(a / MHz), float(b / MHz)], [i, i], color=colour, lw=5, solid_capstyle="butt")
            if c.cls == "clear" and len(ls) < 12 and n0 == n1:
                ax.text(float((a + b) / 2 / MHz), i + 0.3, f"{n0}", fontsize=6, ha="center")
    ax.set_yticks(range(len(allc)))
    ax.set_yticklabels([f"{c.name} [{c.status}]" + (" (drawn +/-10 %)" if c.status == "residual" and c.known and c.f == c.f_hi and c.tol_ppm == 0 else "") for c in allc], fontsize=7)
    ax.set_xlim(float(lo / MHz), float(hi / MHz))
    ax.set_xlabel("frequency (MHz); marks are harmonic lines n*f with tolerance; number = harmonic order")
    ax.set_title("cwht clock plan: harmonic lines against the 2 m band, image and LO bands (developer evidence)\n"
                 "colour = status: black fixed, green proposed, red rejected, grey TX only,\n"
                 "brown BFO by design, olive off in operation, magenta named residual (section 2.1)", fontsize=9)
    ax.grid(alpha=0.3, axis="x")
    ax.legend(fontsize=7, loc="lower right")
    fig.tight_layout()
    out.parent.mkdir(parents=True, exist_ok=True)
    fig.savefig(out, dpi=130)
    print(f"figure: {out}")


def main(argv=None):
    ap = argparse.ArgumentParser(description=__doc__.splitlines()[0])
    ap.add_argument("--plot", action="store_true", help="render docs/reviews/PDR/figures/clock-plan-harmonics.png")
    ap.add_argument("--rosc-running", action="store_true",
                    help="seeded case: model the ROSC as running in operation (ADR-051 as written, without rule 11); expect exit 1")
    a = ap.parse_args(argv)
    rc = report(rosc_running=a.rosc_running)
    if a.plot:
        plot(Path("docs/reviews/PDR/figures/clock-plan-harmonics.png"))
    return rc


if __name__ == "__main__":
    sys.exit(main())
