robinonsay/cwht/tools/tests/fixtures/rust/kat-target/build.rs

//! Passes the fixture linker script to rust-lld.
fn main() {
    let dir = std::env::var("CARGO_MANIFEST_DIR").unwrap_or_default();
    println!("cargo:rustc-link-search={dir}");
    println!("cargo:rustc-link-arg=-Tlink.x");
    println!("cargo:rerun-if-changed=link.x");
}
