robinonsay/cwht/(commit log)

2026-09-25 Phase A checkpoint: process charter, reference corpus tooling, schemas, schedule and cost baseline
    - Engineering process charter (NASA SE HB, NPR 7123.1D, NPR 7150.2D at Class A rigor)
    - Markdown conversions of SE Handbook, NPR 7123.1D, NPR 7150.2D with converters
    - Requirements and test-case schemas with Class A traceability fields
    - Stakeholder inputs log SI-001..SI-021, expedited schedule and ROM cost estimate
    - Project MCP config for Claude Context vector search
2026-09-25 Phase A research reports: emulation, LTspice batch, PCBWay fab/asm, CNC+OpenSCAD, Part 97, rustos toolchain, tooling, 2 m reference designs, keyer
2026-09-25 Stakeholder inputs SI-026..SI-035; charter: host-first software evidence, driver-to-datasheet traceability, kit assembly model
2026-09-25 Research round 2 (12 reports), 47 CFR regulatory corpus (eCFR 2026-09-23), SWEHB Ver D corpus (268 pages)
    [mc_4p_1000_catalogue30.csv, mc_4p_2400_catalogue30.csv, mc_4p_500_catalogue30.csv, mc_4p_500_samelot4.csv, mc_4p_500_tight10.csv, mc_6p_2400_catalogue30.csv, mc_6p_500_catalogue30.csv, mc_6p_500_samelot4.csv]
2026-09-26 Process documentation set 01-08 after independent review, revision and integration pass 3; tooling; reference corpus
    - docs/process 01-08, RMM, NPR 7123.1 compliance matrix: two independent review lenses per document
    (NPR fidelity, charter consistency), author revisions, cross-document integration (27 of 28 fixed;
    remaining items are SRR-workflow scope or dispositioned in the charter)
    - Charter: F14 (SE-51/52/55/56, SAR carries SE-51/52), F22 (per-review traceability.json),
    F28 (SW module, ACC-<TOOL>-NNN, tinySA receipt record, SWEHB count, SWE-017 wording, test-case
    retirement marker, SWE-045/094 removed from NA line), SWE-211 proposed tailoring for SRR
    - tools: validate_docs, trace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
    [power.csv]
2026-09-26 SRR products revision 2 (pre-closure): ConOps, expectations with stakeholders, 179 L1 requirements, 107 TC-SYS cases, hazard analysis 0.2.0-pha, 25 ADRs, concept, technology assessment, risk register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
    Independent reviews of the L1 set, ConOps and hazards were applied (109 findings). The package
    readiness review finds 17 Hard shortfalls (H1 to H17); SRR is not ready to convene. Closure run
    follows. Traceability: 179 requirements, 107 test cases, 0 violations.
2026-09-26 Tools, known-answer tests, tool validation records and the allocation and measurements schemas (SRR H12, H17)
    - tools/traceability.py: STAKEHOLDERS_MISSING (T-21, T-03 names) and SYS_UNALLOCATED (T-18, W at SRR) with test_traceability_srr_rules.py
    - tools/render_review_figures.py with its fixtures and test_render_review_figures.py; tools/sw_gate.sh (FW-B0); tools/emu_run.sh FW-B0 stub (SKIP line, 07 section 1.2)
    - test_git_known_answer.py; known-answer fixtures for git, kicad, ltspice, openscad, picotool, rust, schema and mermaid
    - docs/cm/tool-validation/: TV-001 to TV-010 with evidence
    - docs/design/allocation.schema.json with docs/design/allocation.json (INSP-003 finding-9) and its fixtur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
    [clean-bom.csv, clean.kicad_pcb, clean.kicad_sch, cube.scad, seeded.kicad_pcb, seeded.kicad_sch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]
2026-09-26 Functional-baseline products: expectations, ConOps, concept and L1 requirements after the SRR reviews
    - expectations.json with the stakeholders array (INSP-001); ConOps revised under INSP-002, per-cell LOWBATT cutoff (REQ-SYS-097), RF-off level of REQ-SYS-183, hang 3 to 30 dits (ADR-026), OPS-013 after-boot squeeze case and the 13 s bound limited to a continuous key-down (OQ-SAF-006 items 2 and 4), section 1.1 claim limited to the survey
    - concept.md: B07 allocated to TX with the VBUS inhibit, 07 SW tokens, TCXO span per REQ-SYS-114, ICD rows per REQ-SYS-152 and REQ-SYS-090, synthesizer study as TS-NNN-synthesizer-reference (06 section 13 item 3); concept block diagram generator and render
    -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
2026-09-26 L2 TX and SW-KEYER requirements, test cases and the traceability report (SRR H15)
    - docs/requirements/tx/requirements.json (16 REQ-TX) and docs/requirements/sw/sw-keyer/requirements.json (38 REQ-SW-KEYER) at Draft, reviewed under INSP-004; REQ-TX-003, 007, 008, 012, 014, 016 tagged interface with ICD-TX-ANT; ADR-023 added to REQ-TX-005 sources; hazard and control ids in the control rationales
    - test cases: TC-SYS additions (TC-SYS-108 to 110), docs/test_cases/tx/, docs/test_cases/sw-keyer/ (golden-vector path moved to docs/test_cases/sw-keyer/), docs/test_cases/sw-tool/ (TC-SW-TOOL-001); synthesizer study cited as TS-NNN-synthesizer-reference
    - docs/vv/traceability-report.md and traceability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
2026-09-26 Hazard analysis 0.4.0-pha and risk register 0.6.0-pre-srr after the SRR reviews (SRR H7, H8, H9)
    - hazards.json: back-links for REQ-SW-KEYER-034, 035, 036 (HZ-004 K1, K8, K9; HZ-010 K3) and REQ-SYS-183 (HZ-004 K7), clearing the HAZARD_INVERSE warnings; HZ-004 K5 allocated to TX (block B07); fixed debounce counts in HZ-004 K9 and HZ-010 K3; HZ-007 K4 per-cell cut-offs; HZ-010 K6 1.5 m leads; HZ-008 K2 PA basis per TS-001 and ADR-012; OQ-SAF-007, 025 and 026 Answered, OQ-SAF-006 items 2 and 4 answered
    - hazard-analysis.md: section 8.1 item 7 acceptances on the risk that carries each hazard, section 7 row i names REQ-SYS-181, OQ rows updated; safety schema control_req_ids description covers L2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
2026-09-26 Process documents, plans and templates after the SRR reviews and the integration pass (SRR H1, H13, H14, H16)
    - 01: G-3 5.8 row names the one sub-TRL-6 technique (candidate-B PIO I2S); section 13 paired_record field
    - 02: section 8.5 T-03, T-18 and T-21 implemented; AL-02-10, AL-02-19 and AL-02-24 Closed
    - 03: SW-SCHED split between cwht-core and cwht-app; X1 resolved for 07 (revision A.4)
    - 04: 97.307(e) limit quoted as 25 uW (-16.02 dBm); 3.3 V USB-to-UART adapter row (TV due PDR)
    - 05: LTspice and OpenSCAD plus FreeCAD rows per lock section 1.4; absolute -o in section 8.2 step 3; build flavours in section 8.1; AL-15 Closed
    - 07: host clippy and cargo geiger commands as the gate runs them;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
2026-09-26 Decision records, trade studies and external ICD stubs (SRR H5, H11, H14)
    - ADRs: ADR-026 (semi break-in hang and lead-in, proposed successor of ADR-010), revisions of Proposed ADR-015, 022, 023 and 025 under INSP-011 (ADR-022 cites HZ-008 K1 at 0.4.0-pha), reconciliation-srr.md (register of corrections to the Accepted ADRs pending ruling R-1), README planned list with the TS-001 and TS-002 ADRs
    - trade studies TS-001 receiver, selectivity and PA device-and-supply concept and TS-002 firmware runtime make/buy (INSP-013); resulting ADR ADR-027 or later
    - ICD stubs ICD-CTL-KEY, ICD-CTL-PHONES, ICD-TX-ANT, ICD-CTL-USB, ICD-PWR-CELL with figures (INSP-012); ICD-TX-ANT side A lists the six interfa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
    [render_icd_figures.py]
2026-09-26 FW-B0 firmware workspace, TC-SW-TOOL-001-r1 evidence and CR-001 (SRR H12)
    - firmware/: cwht-app, cwht-core, cwht-hal-mock, firmware/emu/ placeholder, lint, format, deny, nextest and toolchain-pin configuration (07 section 1.2, Annex B); main.rs comment cites CR-001
    - docs/vv/reports/TC-SW-TOOL-001-r1.md with its evidence (Blocked: steps 11 and 12, flash and observe, pending the owner; gate MISSING items recorded)
    - docs/cm/cr/CR-001: amend 07 CS-11 and CS-38 to admit driver-construction failure arms that call safe_state_halt(), and place the panic handler in cwht-app (CS-12); Submitted for owner disposition before FW-B1 (INSP-016 finding-2, deviation D8)
    - hardware/ placeholders (bom, enclos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
    [build.rs, gpio.rs, heartbeat.rs, lib.rs, main.rs]
2026-09-26 Research reports: dated corrections from the tool sanity checks and the ICD and hazard reviews
    - keyer-verification-and-key-input-network.md: F5 abuse-current correction (INSP-012 F-03); F13 addendum on the after-boot squeeze and the REQ-SYS-020 tune bound (OQ-SAF-007); golden-vector path under docs/test_cases/sw-keyer/
    - ltspice-batch-macos.md: precondition read through iconv, never appended to the UTF-16LE ini; .asc deck errors hang (lock section 1.4 items 1 and 2)
    - enclosure-cnc-and-openscad-pipeline.md: step 3 listing unwraps a one-solid Compound; freecadcmd exit status not trusted; absolute OpenSCAD -o (lock section 1.4 items 3 and 4)
    Refs: SRR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
2026-09-26 SRR independent review records, per-review traceability report and review-trend figure
    - docs/reviews/SRR/checklists/: the INSP records filed for the SRR products (reviewer verdicts and findings unchanged by this commit)
    - docs/reviews/SRR/traceability-report.md and traceability.json written by tools/traceability.py --render --output docs/reviews/SRR/traceability-report.md (0 violations, 2 warnings)
    - docs/reviews/SRR/figures/review-trend.png from tools/review_trend.py --date 2026-09-26 --package SRR --write (zone Green, empty SRR log), inspected
    Refs: SRR
2026-09-26 Gate scripts, record drift rule, figure generator fixes and TV-011 to TV-013 (SRR R3, R5, R11, R13)
    - tools/unsafe_audit.py, tools/complexity_gate.py and tools/measurements.py with
    known-answer tests and fixtures; TV-011 to TV-013 Validated 2026-09-26.
    - tools/validate_docs.py record drift rule: an APPROVED record names the committed
    blobs it reviewed (TV-003 purpose 6).
    - tools/render_review_figures.py layout and label fixes (package section 15 item 56);
    TPM-014 row label USD 548 on line 1067 pending the tools owner's confirmation.
    - tools/sw_gate.sh calls the three scripts; toolchain lock rows for the gate run 2
    and the generated unsafe-audit list.
    - Section 3 of TV-001 to TV-010 r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
    [lib.rs, main.rs]
2026-09-26 Hazard analysis 0.4.2-pha, ConOps appendix D statuses and 03 input hash (SRR H6, H7, R9, R14)
    - hazards.json 0.4.1-pha: OQ-SAF-017 and OQ-SAF-020 Closed without re-dating;
    REQ-SYS-122 note refinement carried to OQ-SAF-019 (lien, PDR).
    - hazards.json 0.4.2-pha: HZ-004 K2 accepts the Straight-on-tip selection while
    the KEY inhibit is active (REQ-SYS-163), then the REQ-SYS-052 interlock re-runs
    (ConOps appendix D item D10).
    - hazard-analysis.md section 7 rows c and l: full safe state only on reset, panic,
    latched fault and power-down; Inhibit-class causes apply the transmit part only,
    consistent with REQ-SYS-130 (appendix D item D6).
    - ConOps appendix D statuses for items D1 to D18 (R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
2026-09-26 TC-SYS-060: bracket the REQ-SYS-082 cold charge threshold at the -2 C and +2 C tolerance edges widened by the fixture tolerance (SRR test-cases-sys finding-1)
2026-09-26 SW-KEYER: override path validated by the keyer per 07 section 14.2 row d (INSP-026 finding-1)
    REQ-SW-KEYER-024 and 029 now change the key-input mode or start the PARIS
    generator only after an action and a separate confirmation the keyer
    validates itself as distinct operator events; a menu output is an untrusted
    request. New self-derived REQ-SW-KEYER-039 defines distinct events from the
    1 kHz control-input samples (different inputs in different samples, or a
    release and 300 ms TBR, close by PDR). TC-SW-KEYER-024 and 029 replace the
    single-command step with action-plus-confirmation sequences and add
    faulty-menu cases (one input sample, one queued event, confirmation without
    action, interval to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
2026-09-26 SRR package revision 5: readiness review F-01 to F-06 applied; deck and INSP-029 recorded; decision 25 to K12, decision 118 added; records, deck and figures committed (R12)
    - package.md revision 5: header, agenda and slide map on the revision 5
    deck; section 2.2 render record of the deck (04:22 and revision 5 runs);
    29 records with INSP-029 in sections 2.3, 2.4, 3 and 4; S11 re-rated
    Partially met; R10 and R12 done; section 15 items 61 to 66 carry the
    readiness findings; 120 record liens in section 20.2
    - decisions-for-owner.md revision 5: decision 25 (guard versus keying
    sidebands, 750 Hz + 370 Hz = 1.12 kHz, options a to d) moved to K12;
    decision 118 (05 assurance coverage alte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
2026-09-26 SRR INSP-001, INSP-003, INSP-004, INSP-026: requirements author self-checks filed against acceptance criteria and checklist sections A to F (readiness R3; package item R7)
    Author-only sections appended; reviewer sections, front matter, R3
    answers and readiness_met unchanged; no product change. New Minor author
    exceptions for reviewer disposition: CON-006 and CON-007 lack SI-014
    (02 section 3.2 rule 4); REQ-SW-KEYER-024, 029, 039 rationales exceed
    120 words after f2e02aa. Observation: REQ-SW-KEYER-019 has no HostUnit
    case (INSP-026 SA-192-1 evidence). INSP-003 finding-6 stays open on
    decision 30.
2026-09-26 SRR R8: re-issue INSP-006 (paired with INSP-030), INSP-010 and INSP-018; readiness met; APPROVED with liens
    No product review and no product change: all product_files blobs equal HEAD 1af795c
    (05, rmm.json; 07, measurements.json, schema, two fixtures).
    Readiness R3 of each record met by the author self-checks filed at 8ef95d3 (package item R7).
    INSP-006: paired_record INSP-030, assurance_verdict APPROVED; liens finding-10, finding-11.
    INSP-010: liens finding-14 to finding-17; INSP-018: liens finding-8, finding-9.
    No open Major finding in any of the three; no new finding. Author items S-1 recorded as
    observations with the existing liens. Historical lines reworded to lower-case "open" for the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
2026-09-26 SRR deck updated to package revision 6 (R19 part a): 30 records, 24 APPROVED, 122 liens; K1 with decision 42, K7 with 73 and 74
    - Title and slide 1 name revision 6, written at 5f647f2 and committed at 30a6905; 12 Hard rows Partially met
    - Readiness and records: slides 4 to 9 (R17 to R19 and R15 open; R6 to R9 done; record board of 30; blob check 28 of 30; entrance board 22/13/4)
    - Record statuses on slides 10, 13, 15, 16 (0.4.3-pha, 9 Closed, 1 Answered, 9 Open), 19 and 37
    - Decisions: slide 20 (17 key covering 52, consent 64), K1 adds 42, K7 adds 73 and 74, K14/K17 closures, consent themes C (empty) and H; decision 25 stays on K12 (slide 31) as in revision 5
    - Candidate items 1 to 71 on sli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
2026-09-26 SRR package revision 7: apply readiness review R15-F4 (ef6472a render and INSP-029 iteration 3 recorded; 120 record liens; slides 7, 40, 42 re-rendered)
    - Header, sections 2.2 and 2.3: the ef6472a deck render recorded (source 66ea2de4, render
    command, reproduction run exit 0 byte-identical, 23 changed PNGs, inspection); INSP-029
    X-5 and X-6
    - H3, H17, R10, R15, R19, S3, S11, section 2.4 INSP-029 row (3 liens) and totals: record
    liens 122 to 120 plus E-10 (sections 2.4, 20.1 L-6, 20.2, 21); deck slides 7, 40, 42
    carry the count, re-rendered and opened
    - Tool runs re-stated at HEAD ee200cd: validate_docs.py exit 1 and unittest 391/392 on the
    INSP-008 drift (R17, R15-F1); traceability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
2026-09-26 SRR R18: validate_docs.py record state rule replaces the open-Major line heuristic (R15-F2)
    open_major_findings read any body line holding a finding anchor and the
    words Major and Open, so historical count lines ("open Major 0") held an
    APPROVED record (INSP-002). The current state of a record is now its front
    matter (readiness_met, reviewer_verdict, findings_open) plus the finding
    tables of its latest iteration section only: the section starts at the first
    heading naming the highest iteration and excludes later blocks under a
    heading naming a lower iteration; a finding table has a Finding, a severity
    and a state column; a row is open when a state cell begins with the word
    Open; a later row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
2026-09-26 SRR R18: TV-003 run 6 and lock rows for the validate_docs.py record state rule
    TV-003: purpose 7 (record state rule, blob 3aa03681 at 96af250), the
    RecordStateTests known answers on tools/tests/fixtures/record_state/ in
    section 3, run 6 in section 4 (150 tests: 33 + 117, 0 skipped, pass at
    96af250), limitation 7 and the proposed accreditation extension. Full
    directory 400 tests with the one repository-content failure (INSP-008
    drift, package item R17). Lock: section 1.1 row for traceability.py and
    validate_docs.py, full-directory note, sections 1.2 and 5 rows and a change
    history row.
2026-09-26 SRR package revision 8: status update after R17, R18 and the INSP-030 re-issue (R15-F1 to F3 closed)
    Read from the 30 records at HEAD b4abcc5. R17 done (INSP-008, 2aaad2a); R18 done
    (record state rule 96af250, TV-003 run 6 860e84e, INSP-002 b08e55d, INSP-015
    b4abcc5 with new liens F-08, F-09); R19 (b) INSP-030 done (99ecccb). 26 of 30
    records APPROVED; 5 open Major findings, each on an owner ruling; record liens
    122 plus E-10. Rows 4 and 12 and criterion 4.4-7 re-rated Met; entrance and
    success boards re-rendered and opened. Every gate tool exits 0. Remaining
    before owner-only: the INSP-029 re-issue (pending in this run) and the repeat
    readiness review R15. No product content changed.
    Co-Au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
2026-09-26 SRR deck: update to package revision 8 claims (records, readiness, remaining work)
    Deck srr.adoc brought to package revision 8 (HEAD b4abcc5) only where revision 8
    changed a claim: title revision and commits (slide 1); readiness and tool status,
    every gate tool exit 0, 400 of 400 tests (4); H1, H3, H17 labels (5); what remains:
    R17, R18, INSP-030 part of R19 (b) done, INSP-029 re-issue pending, then R15 (6);
    record board 26 APPROVED, 1 re-issue, 3 open Major, 122 liens (7); blob check 29
    of 30 at b4abcc5 (8); entrance board Met 24, Partially met 11, Not met 4 (9);
    record column (10); traceability re-run commit (15); milestone status (19);
    decision 114 INSP-015 liens F-07 to F-09 (23); candid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
2026-09-26 SRR package: lead SE current-status paragraph and section 2.2 read-aloud corrections (readiness confirmation R15c-F1, F2); no product, record or slide changed
2026-09-27 SRR minutes: owner approval of the SRR (Approved with liens) and of the traceability approach, transcribed verbatim
2026-09-27 docs(04): CR-002 admits Inspection for documentary hazard controls (SRR decision 113)
    SRR decision 113 (owner ruling 2026-09-26): CR-002 written and dispositioned
    Approved (Class I proposed, owner confirmation pending). Step 1 applied: 04
    section 3 hazard-tracing paragraph, rule 7.3.6 and the section 7.4 row 7.3.6
    admit Inspection, with the note "Inspection accepted per CR-002", for
    hazard-tracing requirements that state a documentary or physical property.
    Steps 2 to 5 (REQ-SYS-122, 124, 137, 138 methods; TC-SYS-085, 086, 091;
    hazard-analysis 8.1; traceability.py rule 7.3.6) are cross items.
    docs/cm/deviations.md created (05 Table 4-1 row 43; INSP-030 X-2) with
    entry 1: CR-002 reached Dispo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
2026-09-27 SRR minutes: owner approval of the schedule rebaseline; owner enclosure input (COTS metal box, H2C print with conductive coating) recorded for SI-037, CR-003 and a PDR trade study
2026-09-27 SRR decision memo (Approved with liens), RFA/RID log and disposition block
    Review secretary record of the owner's SRR approval of 2026-09-26 (minutes
    7647516 and 0a6f461):
    - docs/reviews/SRR/decision-memo.md: signed 2026-09-26, disposition Approved
    with liens (L-1 to L-7), baseline_tag null until baseline/srr is created
    after the R16 verification; key decisions K1 to K17 and the 64 consent
    decisions transcribed by number with their Recommendation cells; decision
    30 as the 06 section 14.1 item (g) record for the ten regulatory
    requirements; decision 115 (b) waiver; tailoring of package section 17;
    RMM approval block (decision 6) and owner capacities (decision 7); OA-1 and
    OA-2 r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
2026-09-27 SRR minutes: owner preference for enclosure option C (printed, conductive coating, purchased heatsink) as the PDR planning baseline
2026-09-27 SRR minutes: owner direction to prototype enclosure options B and C in parallel; no owner machining, so B openings are cut by a vendor
2026-09-27 SRR minutes: owner accepts the flat-panel route for enclosure option B
2026-09-27 SRR INSP-026 iteration 3: post-SRR-ruling delta of cd61450 and ebe5873 (SW-KEYER assurance)
    Delta-verifies the package item R16 product commits against SRR decisions
    9, 37, 41, 43, 44, 47, 48, 50 and 112 (owner ruling 2026-09-26): no new
    Major. finding-5 Verified (hazards.json 0.5.0-pha, decision 112); new Minor
    liens finding-8 (REQ-SYS-188 keyer flowdown, decision 41), finding-9
    (decision 48 debounce tunable vs fixed counts, OQ-SAF-027), finding-10
    (WR-10 on REQ-SW-KEYER-020, 021). product_files set to HEAD blobs; verdict
    APPROVED with liens.
2026-09-27 SRR R16: INSP-007 post-SRR-ruling delta re-issue (iteration 3 re-issue 2) at HEAD ebe5873, APPROVED with liens
    Delta-verifies 9bdf33c on the risk register: SRR decision 14 (owner ruling
    2026-09-26) applied correctly, plan_approval on exactly the 32 Red risks,
    RSK-009 open to PDR, register.md current. product_files set to the HEAD
    blobs (register.json 0c25c0c5, register.md a3a983e5, 06 7a92d21f).
    New finding-18 (Minor, Lien: fix before PDR): rulings 32, 17, 9 and 40,
    and 11 not yet transcribed into the register (RSK-030 not Accepted;
    RSK-028 S2, RSK-030 S1, RSK-046 S1 still InProgress due SRR; RSK-008
    residual note) and the 65 risks still Proposed. Open Major 0.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
2026-09-27 SRR R16: INSP-015 (TV-001 to TV-010) post-SRR-ruling delta of b2d3538, iteration 3 re-issue 2, APPROVED with liens
    - Delta-verified b2d3538 against SRR decision 114 (owner ruling 2026-09-26):
    every section 9 row transcribes its proposed ACC statement, section 8
    records INSP-015, index and lock rows read Accredited for TV-001 to TV-010
    only; decision 109 lock rows sampled against the evidence log.
    - No Major finding was open; F-07 partly answered, stays a lien.
    - New Minor F-10 (ACC-TRACE-001 and ACC-TREND-001 bind validate_docs.py blob
    2bedc2a7, which both tools import; HEAD runs 3aa03681): lien due PDR.
    - product_files set to the HEAD blobs; product_files_reissue_1 keeps the
    first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
2026-09-27 INSP-008 post-SRR-ruling delta: verify hazard analysis 0.5.0-pha (bfea9c7) against the SRR owner rulings of 2026-09-26 (package item R16)
    Delta-verifies bfea9c7 against decisions 9, 17 to 20, 25, 33, 36 to 42,
    44, 48, 70, 72 to 76, 112 and 116 (owner ruling 2026-09-26). finding-14
    Closed (Verified) under decisions 37 and 116. New Minor liens due PDR:
    finding-17 (decision 113 / CR-002 not applied in the analysis text),
    finding-18 (REQ-SW-KEYER-039 rationale), finding-19 (self-contradicting
    history notes), finding-20 (section 4 HZ-008 RSK-046), finding-21 (stale
    lead-ins; 03/07 band edge after decision 25). product_files set to the
    HEAD blobs; verdict APPROVED with 7 liens, open Major 0.
    Co-A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
2026-09-27 SRR R16: INSP-003 (L1 requirements, allocation, TC-SYS) post-SRR-ruling delta, APPROVED with liens
    Delta verification of cd61450 and ebe5873 against the owner rulings of
    2026-09-26. finding-6 (Major) Verified on SRR decision 30 (decision memo
    section 8.1); finding-17 Verified on SRR decision 113 (CR-002 steps 2
    and 3). No Major finding open. New Minor liens finding-27 to finding-31
    (fix before PDR). product_files set to the ebe5873 blobs. Cross items:
    CR-002 step 4 (hazard-analysis 8.1) and step 5 (traceability rule
    7.3.6) not yet done; decision memo 8.3 versus the REQ-SYS-180 to 182
    TBRs.
2026-09-27 SRR R16: INSP-016 (FW-B0 toolchain proof) post-SRR-ruling delta of b2d3538, NEEDS CHANGES
    - F-02 (Major) Closed on SRR decision 108 (owner ruling 2026-09-26):
    CR-001 Approved and 07 CS-11, CS-12, CS-38 amended at 4364ebb;
    main.rs:41-43 conforms to the amended CS-11.
    - F-04 Closed on INSP-028 (independent test-author review, APPROVED);
    lien L-016-1 discharged.
    - F-01 (Major) stays Open: decisions 109 and 110 applied (b2d3538; rustos
    branch 2ec64c0, comment-only, not merged) and OA-1 performed (minutes
    0a6f461), but the gate still exits 1 (pin c54d35a: cargo deny and
    unsafe audit; branch: complexity and Miri). Reviewer runs IT4-1 to
    IT4-7 reproduce the run 3 claims.
    - New Minor l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
2026-09-27 SRR R16: pin tools/requirements.txt to the venv (CM plan 14.1 item AL-4)
    tools/requirements.txt listed ten unpinned names. It now carries the 35
    exact pins of .venv/bin/pip freeze, equal to tools/toolchain.lock.md
    section 2 (pip 26.2.1 comes with the venv). This is the Table 4-2 row 27
    admission evidence for baseline/srr (AL-4 comparison: equal). SRR decision 1
    (owner ruling 2026-09-26) approved the plans that set this prerequisite.
    Refs: TV-001
    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
2026-09-27 SRR R16: prepared functional baseline record (tag held) and memo amendments A-1 to A-3
    docs/reviews/SRR/baseline-record.md is written from the template with every
    functional-baseline CI (charter section 3; 05 section 4.4 rows 1, 2, 3, 5, 6,
    7, 9, 17, 27, 51, 52, 53), its git hash at be270f1 and its Table 4-2
    admission state, the informational rows 14, 15 and the early L2 files, the
    row 28 tools with their accreditation (SRR decision 114), the unchanged
    rustos pin c54d35a, CR-001 and CR-002 (decisions 108 and 113), the W1 waiver
    (decision 115 (b)), the liens L-1 to L-7 and 134 TBRs. It is the prepared
    record, not commit R: section 0 lists the open preconditions P1 to P10.
    baseline/srr is not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
2026-09-27 Charter: apply SRR decisions 7 and 10 (owner ruling 2026-09-26)
    Section 2: the owner also holds the Health and Medical TA capacity and is
    CIO/SAISO designee for the software cybersecurity requirements (decision 7).
    Section 10: safety-critical and mission-critical list per 03 section 6.5
    item g in the decision 9 reading, with the menu override command path
    (X20) and the key-input and keyer-mode selection path (INSP-009 finding-1)
    (decision 10 (a)).
    Section 5: rows for status notes (SEMP F-09) and the 07 section 22
    artifacts beyond the document tree (decision 10 (b)).
    Refs: SRR decision-memo, 03 section 6.5 item g, SEMP appendix F F-09, 07 section 22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
2026-09-27 SRR minutes: owner concurrence with the twelve close-out recommendations and CR-004 (rustos pin to 2ec64c0); owner merged the rustos branch
    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
2026-09-27 ADR-014: erratum for SRR decision 18 (cite OET 65 Supplement B for the OPS-B exposure tier)
    Erratum line at the end of section 1: under OPS-B the occupational tier
    rests on the OET 65 Supplement B controlled-environment statement, not on
    the 97.13(c)(1) household clause; OPS-B units stay at 0.5 W and 1 W until a
    dated owner record confirms the basis (SRR decision 18, RID-SRR-010,
    ConOps Appendix D item D15). Citation verified against the corpus extract
    docs/references/md/regulatory/oet65-supplement-b-extracts.md lines 126 to
    127. Made under the pre-baseline correction allowance of 05 Table 4-1
    row 13 (errata line, before baseline/srr, section 2 untouched) with the
    owner's approval in the SRR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
2026-09-27 SRR R16: TC-SW-TOOL-001 run 4 (OA-1 and OA-2 owner steps) and the sw_gate.sh --paths fix (INSP-016 finding-14)
    Run 4 files the raw outputs of steps 11 and 12 (OA-1) and the OA-2 picotool
    verify known answer, performed with the owner on 2026-09-26 19:17 to 19:23 CDT
    (SRR minutes, "OA-1 and OA-2 performed"): step 11 Pass (60 to 63 cycles in
    60 s), step 12 Pass (18 cycles), OA-2 Pass (true image exit 0; one-byte-altered
    copy "First mismatch at 0x1000002f", exit 245). The flashed UF2 files are
    byte-identical to the run 3 artifacts (image-identity.txt). The case stays
    Blocked until run 5 (gate exit 0).
    tools/sw_gate.sh: G5 complexity passes one --paths per path to
    rust-code-analysis-cli (INSP-01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
2026-09-27 SRR R16: L0 expectations carry the SRR rulings; SI-037, SI-038; schedule rebaseline
    expectations.json (baseline record P7; memo section 13 "content not yet
    carrying the rulings"):
    - all 23 "owner decision pending at SRR" phrases and their variants
    (D-KN, RFX-D, D-PWR, D-PCB pending wording) replaced by the ruled SRR
    decision numbers (owner ruling 2026-09-26), or by the SRR disposition
    where no numbered decision covers the value (NGO-009, NGO-010, MOE-001,
    MOE-002, MOE-005, MOE-008 values; memo section 9)
    - NGO-021 and MOE-012 aligned to SRR decision 37 as REQ-SYS-054 and
    REQ-SYS-184 read at HEAD (128 identical elements or 30 s without a
    7-dit or 500 ms gap; 2 s squeeze; the 13 s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
2026-09-27 SRR R16: INSP-023 post-SRR-ruling delta of d4c9366 (schedule rebaseline, SI-037, SI-038), APPROVED with liens
    Delta verification of the schedule.md rebaseline: dates and lead-time
    windows recompute, options B and C match the owner's direction in the SRR
    minutes. finding-10 (Minor, cost estimate still prices only the CNC
    enclosure) is a lien due PDR. No Major finding is open.
2026-09-27 SRR close-out: baseline record section 0.1, precondition status P1 to P10 at 2f619f8 (tag held)
    Re-checks each precondition of the prepared record at HEAD 2f619f8 against
    the R16 delta re-issues and the owner's close-out rulings (minutes dd39332,
    items 1 to 12, CR-004). The tag stays held: INSP-001 finding-14 and
    INSP-016 F-01 are open Majors, validate_docs.py fails on INSP-015 record
    drift (toolchain.lock.md at 37ae576), traceability.py has 4 violations
    (close-out item 5 route not yet applied), CR-004 is not applied, repository
    protection is not confirmed, L1 status is Draft and main is not pushed.
    The be270f1 table is kept as history; baseline_tag stays null.
    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
2026-09-27 SRR close-out: MOE-006 band-edge guard limits 144.0012 and 147.9988 MHz (TBR) per SRR decision 25 (a); fixes INSP-001 finding-14 (Major)
    Changes only the MOE-006 success_criterion guard values, consistent with
    NGO-011 and REQ-SYS-008/009 at HEAD; expectations.md re-rendered with
    tools/traceability.py --render. Scan of expectations.json found no other
    pre-ruling guard value (NGO-011 keeps its historical note on the 1 kHz
    guard proposed before SRR). Minor liens finding-12, 13, 15, 16 untouched.
2026-09-27 tools/traceability.py: rule 7.3.6 accepts the CR-002 Inspection route (CR-002 step 5, SRR close-out item 5)
    HAZARD_REQ_NOT_TESTED now accepts a hazard-tracing requirement of a module
    other than SW and SW-<SUB> with method Inspection, a live closing case of
    method Inspection and a verification_note beginning "Inspection accepted per
    CR-002", as 04 rule 7.3.6 reads after d992052 (CR-002 item 7, SRR decision
    113). A missing or misplaced note, a missing closing Inspection case and the
    SW and SW-<SUB> modules (SWE-192) still fail. Catalogue text and docstring
    state the route.
    Known answers: test_traceability.InspectionRouteTests (accepted SYS control,
    four note variants rejected, no closing Insp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
2026-09-27 chore(cm): CR-004 moves the rustos pin c54d35a to 2ec64c0 and regenerates the unsafe audit list (SRR close-out item 1)
    SRR close-out item 1 (owner ruling 2026-09-26, minutes dd39332): CR-004
    written and dispositioned Approved (Class I proposed, owner confirmation
    pending; independent impact review pending). The owner merged the rustos
    branch cwht/wp-sw-licence-manifest-safety (fast-forward c54d35a to 2ec64c0,
    7 files, 200 insertions: MIT LICENCE, license and publish = false in api and
    pico2, 36 SAFETY comments; SRR decision 110 work item).
    - tools/toolchain.lock.md section 3: pin 2ec64c0f15c8cd2dbcaa241abffdd72f8cae467c,
    command rev-parse master, clean git-archive export rule for builds,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
2026-09-27 TV-002 run 5 and CR-002 step 5 record: traceability.py re-validated at c774851, ACC-TRACE-001 extension conditional on the INSP-015 delta (SRR close-out items 5 and 7)
    TV-002: run 5 on an export of c774851 (182 known-answer tests, 0 skipped,
    pass; first command adds -k InspectionRouteTests), run 5 file identities,
    mutation check against blob 0a867523, section 4.1 repository runs (before:
    4 HAZARD_REQ_NOT_TESTED on REQ-SYS-122, 124, 137, 138; after: plain run
    exit 0, 0 violations), section 8 re-validation review pending (INSP-015
    delta), section 9 extension of ACC-TRACE-001 to blob 12de3545 per the
    owner's close-out concurrence (minutes dd39332, item 5), effective on the
    APPROVED INSP-015 del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
2026-09-27 chore(tools): record SRR close-out items 2, 3 and 12 in the lock; picotool verify known answer
    Owner ruling 2026-09-26 on the SRR close-out items (minutes dd39332,
    "I concur with your recommendations"); raw log copied to
    docs/cm/tool-validation/evidence/closeout-installs-2026-09-26.log.txt.
    - Item 2: rust-src on nightly-2026-08-24 and the Miri sysroot
    (cargo miri setup, crates.io) recorded in lock section 1 nightly row,
    section 1.1 nightly row and section 7; section 1.4 finding 8 closed.
    - Item 3: rustup 1.29.1 accepted and auto-self-update disabled; lock
    section 1 rustup row; section 1.4 finding 7 closed.
    - Item 12: brew pin python@3.13; lock section 1 python3 (system) row and
    sect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
2026-09-27 TC-SW-TOOL-001 run 5: full gate on the CR-004 pin 2ec64c0, Blocked (G5 complexity B9, G5 Miri scope B11); UF2 byte-identical, steps 11 and 12 stand on run 4
    Clean layout: git archive of cwht fb22b7a and of rustos 2ec64c0, with a local
    clone at 2ec64c0 (tree equal to the export) for gate G0 (deviation D20); run 3
    rustup guard first on PATH, no download. Stopping and --keep-going gate runs:
    24 PASS, 2 FAIL, 0 MISSING, exit 1. B1, B2, B8, B10 closed (CR-004, INSP-016
    finding-14, SRR close-out item 2). B9: CS-38 main CC 4 > 3 awaits the owner
    decision of CR-005 section 9. B11 (new): Miri cannot compile target-only pico2
    on the Mach-O host. KA-0 to KA-8 all MATCH.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
    [elf-diff.txt]
2026-09-27 SRR close-out: INSP-016 (FW-B0 toolchain proof) delta of 3b45ed7, NEEDS CHANGES (F-01 open on run 5 B9 and B11)
    Independent review of the three commits that touched the FW-B0 product since
    5e9506a: 37ae576 (run 4 and the sw_gate.sh --paths fix), 5792350 (CR-004,
    SRR close-out item 1: rustos pin 2ec64c0, firmware/unsafe-audit.md
    regenerated) and 3b45ed7 (run 5). Reviewer runs on a clean git archive of
    cwht 3b45ed7 and rustos 2ec64c0, no download: unsafe audit regenerated
    byte-identical and PASS, cargo deny PASS, G5 complexity reads all three roots
    and fails CS-38 main CC 4 > 3 (B9), G5 Miri fails on pico2 for the Mach-O
    host (B11), 33 of 33 run 4 and run 5 artifact hashes match.
    - F-14 (Mino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
2026-09-27 SRR close-out: INSP-015 re-issue 3 (TV-002 run 5, TV-012 run 2, TV-001, lock of 37ae576, CR-004 and eb52766), APPROVED with liens
    Independent delta review of 37ae576, c774851, bf654e6, 5792350, eb52766,
    e34a27b and fb22b7a under the SRR close-out rulings (minutes dd39332).
    Both re-validations, both mutation checks, the traceability repository
    runs, the G5 complexity gate row and the CR-004 unsafe audit list were
    reproduced on clean exports (cwht 3b45ed7, rustos 2ec64c0). This APPROVED
    delta is the CM plan 9.2 step 3 review that makes the ACC-TRACE-001
    extension (blob 12de3545) and ACC-COMPLEXITY-001 (blob 9cdc9195) effective.
    No Major open; new Minor liens F-11, F-12, F-13 due PDR.
    Refs: SR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
2026-09-27 SRR close-out: INSP-021 delta of bf654e6 (CR-002 step 5 record, Class I), APPROVED with liens
    Independent delta review of the only product commit since ebe5873:
    bf654e6 changed CR-002 (73070823 to 36224b45) to record step 5 at
    c774851 (SRR close-out item 5) and the Class I confirmation (close-out
    item 7, minutes dd39332). Both apply the rulings correctly; traceability
    --report-only at 26011f1 gives 0 violations, InspectionRouteTests pass.
    finding-7 Verified (step 5 before the tag). New Minor liens finding-8
    (stale CR-002 cells) and finding-9 (04 row 7.3.6 lags the tool, wrong
    step number), due PDR. No Major open. 04 and docs/vv/README.md unchanged.
    Refs: SRR, CR-002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
2026-09-27 docs(srr): baseline record status at f3e8801, candidate for R, tag held
    Integrator and CM refresh of docs/reviews/SRR/baseline-record.md after the
    SRR close-out work (minutes dd39332 items 1 to 12, CR-004, CR-005, CR-002
    step 5):
    - new section 0.2: preconditions P1 to P10 re-checked at f3e8801 with
    evidence; all six tool runs exit 0, traceability 0 violations;
    - section 1, 2a, 2b refreshed to the f3e8801 hashes; 2c and 7 record the
    rustos pin 2ec64c0 (CR-004), the ACC-TRACE-001 extension (blob 12de3545)
    and ACC-COMPLEXITY-001 (blob 9cdc9195) made effective by INSP-015
    re-issue 3 (26011f1);
    - section 3 lists CR-001, CR-002, CR-004 and CR-005, with CR-003 reserved
    for after the tag;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
2026-09-27 sw_gate.sh: G5 Miri on host-compilable crates only (-p api), per SRR close-out item B
    Applies the owner ruling of 2026-09-27 (docs/reviews/SRR/minutes.md, "Close-out decisions A to
    C", item B; INSP-016 F-15; TC-SW-TOOL-001 run 5 item B11): the G5 Miri command runs on the
    host-compilable crates of 07 section 8.1, today rustos api. pico2 is excluded because its
    target-only link_section statics (rustos 2ec64c0 firmware/pico2/src/lib.rs:149 and :539) do not
    compile for the Mach-O host; the exclusion ends at FW-B1 (lien: cfg_attr on the two attributes
    by the owner as rustos maintainer plus a pin CR). The script comment, tools/README.md and the
    lock section 1.1 sw_gate.sh row say so.
    Check (only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
2026-09-27 CR-005 amendment 1: CS-38 allowance for the CS-19 main loop of cwht-app::main (SRR close-out item A), Class I (item C)
    - CR-005: dated amendment section 12 with the owner's ruling verbatim (minutes 786822a),
    Class I confirmed (item C), section 6 impact review now required (deviations entry 3,
    RFA-SRR-008), steps 6 to 9, section 9 open item and TV-012 limitation 8 resolved.
    - 07 revision A.7: CS-38 names the three CS-19 unbounded loops and per-function crediting;
    CS-38 enforcement cell, section 8.2 threshold, section 11.2 MSR-17 threshold and section
    14.3 waiver rule say "above the function's own CS-38 allowance". Closes INSP-010
    finding-21 and INSP-018 finding-10.
    - tools/complexit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
    [main.rs]
2026-09-27 TC-SW-TOOL-001 run 6: gate exit 0 after SRR close-out items A and B (Pass, credit false)
    Clean layout of cwht bb2485e and rustos 2ec64c0 (git archive export plus the
    D20 clone for G0), run 3 rustup guard first on PATH, RUSTUP_AUTO_INSTALL=0,
    CARGO_NET_OFFLINE=true, MIRI_AUTO_OPS=no, stdin /dev/null. tools/sw_gate.sh
    exits 0 in both modes: 26 gate-step PASS, 0 FAIL, 0 MISSING, 1 SKIP (emulation
    stub). B9 closed by close-out item A (CR-005 amendment 1, G5 complexity PASS);
    B11 closed by close-out item B (G5 Miri -p api, PASS). KA-0 to KA-8 MATCH.
    Both UF2 files byte-identical to runs 3 and 5 and to the run 1 files loaded in
    run 4, so steps 11 and 12 stand on run 4. INSP-016 F-01 and F-15 answe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
    [elf-diff.txt]
2026-09-27 docs(srr): baseline record section 0.3 at 49104a5, not R (P5: INSP-010 record verdict copy pending), tag held
    Adds section 0.3 (2026-09-27) to docs/reviews/SRR/baseline-record.md, keeping
    sections 0 to 0.2 and 1 to 7 as history. Applies SRR close-out items A to C and
    the P8 confirmation (minutes 786822a, 2ee4868; memo amendment A-7, 305a11e).
    - Tool results at 49104a5: validate_docs 50/50; traceability 0 violations,
    2 warnings; render_risk, render_rmm, render_compliance --check exit 0;
    424 unit tests OK; git fsck --full exit 0; AL-4 equal.
    - P1 to P4 and P6 to P9 met; P5 not met for 07 only: INSP-010 record verdict
    still NEEDS CHANGES pending its cross item X-9 copy of INSP-018 (APPRO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
2026-09-27 docs(cm): submit CR-003, solution-neutral enclosure requirement and process-neutral legend
    CR-003 proposes (Class I, status Submitted, not dispositioned) to rewrite
    REQ-SYS-109 as a bond-resistance requirement with the enclosure
    performance set named in its rationale, amend REQ-SYS-124 so a legend on
    a printed, coated or plate-panel face complies, and add REQ-SYS-191 to
    193 (legend durability, touchable surface temperature, non-metal wall
    flammability), with the impact on L0 (CON-015, CON-026, NGO-006,
    NGO-007, MOE-013; INSP-001 finding-16), ConOps, test cases, hazards,
    risks, TPMs, cost (INSP-023 finding-10), ADR-008 and the PDR enclosure
    trade study. Source: SI-037. Independent impact revi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
2026-09-27 Status note 2026-09-27: owner inputs on CR-003 (48 C hand-safe surfaces, engraved legend, PETG without flame rating, one board first, printed enclosure first with CNC fallback) transcribed verbatim, 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
    Refs: CR-003
2026-09-27 docs(cm): CR-003 revision 2, owner inputs of 2026-09-27 applied and review findings F1 to F14 resolved
    Applies the owner inputs transcribed in docs/plan/status/status-2026-09-27.md
    (72e1863), cited as SI-039 (proposed next free id):
    - REQ-SYS-113 widened to every external surface at 48 C (TBR); proposed
    REQ-SYS-192 (60 C touchable class) withdrawn (F1).
    - REQ-SYS-124 legend "as part of its enclosure surface", no labels or films;
    REQ-SYS-191 strengthened (water, solvent, dry-cloth abrasion, TBR) and
    extended to the jack markings; decision 34 and decision item 51 superseded
    only in their engraving-process part (F2, F5).
    - Proposed REQ-SYS-193 and TC-SYS-115 withdrawn by the owner's dec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
2026-09-27 docs(cm): submit CR-006, build one assembled unit first and decide on further units after its evaluation
    Owner input 5 of 2026-09-27 (status note 72e1863): one circuit board first,
    one item at a time. CR-006 proposes Class I changes to CON-024, NGO-027,
    NGO-028, MOE-001, MOE-002, MOE-007 and REQ-SYS-147 (amortized over the first
    build), Class II edits to REQ-SYS-029, 030, 037 and 125, TC-SYS-025 (any 2 m
    source of at least 5 W) and TC-SYS-098, ConOps OPS-004, OPS-006 and OPS-012,
    a new SI and an ADR superseding ADR-025's assembled count, with the cap of
    five complete units unchanged. Impact assessment with locations, timing and
    effectivity; eight owner questions. Independent impact review re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
2026-09-27 docs(cm): record CR-006 independent impact review round 1, 1 Major and 7 Minor findings
    F1 (Major): the MOE-001 and MOE-002 second-station rule leaves the friend's
    power, antenna and receiver unbounded and the path loss for the cwht-to-cwht
    Analysis without a method, so the "demonstrate in each direction" basis given
    to the owner does not hold. F2 to F8 (Minor): NGO-009 and NGO-010, TC-SYS-025
    pad range and source rating, CR006-R1 list and the CR-003 option C acceptance
    order, cost basis for Q3, REQ-SYS-147 wording, missed items, volatility figure
    and the section 9 search strings. CR stays Submitted.
    Refs: CR-006
2026-09-27 docs(cm): record CR-003 revision 2 independent re-check, 1 Major and 5 Minor findings
    Section 6.2 added as a new dated round; section 6 and 6.1 unchanged.
    F1 to F14 resolved (F8 moot). New: R2-F1 (Major) REQ-SYS-113 set of
    every exterior face does not carry the guarded-heatsink route that
    reading 1 and Q1 give the owner; R2-F2 to R2-F6 (Minor). Impact review
    complete; CR stays Submitted.
    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
2026-09-27 docs(cm): CR-003 revision 3, review findings R2-F1 to R2-F6 resolved
    REQ-SYS-113 bounds every accessible surface, with accessibility defined
    by a test finger applied by script to the assembly model (guard counted
    as accessible, antenna in the set, face-to-node rule in TC-SYS-077), so
    the guarded-heatsink route of the lead SE reading 1 is carried by the
    statement (R2-F1). REQ-SYS-191 and TC-SYS-114 cover every marking on an
    enclosure part (R2-F2). The option C acceptance set is stated once in
    section 5 item 3 and is non-destructive to the one unit (R2-F3).
    Pre-build analyses cover each released option, the held CNC package is
    a pre-approved alternate (R2-F4). Missed items added (R2-F5); CR-00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
2026-09-27 docs(plan): PDR work plan, 52 work packages, waves, owner decisions and proposed PDR date
    Adds docs/plan/pdr-work-plan.md: PDR gate requirements, work packages
    WP-PDR-01 to 52 with outputs, author and independent reviewer roles,
    review records, dependencies and the carried items, TBRs and liens each
    closes; dependency graph and critical path; execution waves with freeze
    points F1 and F2 and the convergence rule; 34 owner decisions with
    recommendations and needed-by dates; items routed past PDR; schedule
    assessment (PDR about 2026-09-29 not achievable, Sat 2026-10-03
    proposed); plan risks; traceability of C-001 to C-210, all 134
    requirement TBRs and every gate criterion. Products depending on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
2026-09-27 docs(cm): CR-006 revision 2, round 1 review findings F1 to F8 resolved
    F1 (Major): the MOE-001 and MOE-002 second station is matched to the
    unit (carrier power within 1 dB, same reference antenna, on-site radiated
    match on the tinySA Ultra); the pass is judged at the cwht end and the
    reciprocal direction is shown by Analysis with the two-ray path loss of
    antenna-and-erp F11. F2: NGO-009 and NGO-010 restated. F3: TC-SYS-025
    pad of 9 dB or more, source bounded by the pad rating; REQ-SYS-029
    interferer phase-noise rule. F4: stress order aligned with CR-003
    section 5. F5: every enclosure spend charged, exclusion offered in Q3,
    TPM-014 Red point and CNC-drawn figure stated. F6 to F8: REQ-SYS-147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
2026-09-27 docs(cm): record CR-003 revision 3 independent re-check, 0 Major and 5 Minor findings
    Section 6.4 records the re-check of revision 3 at 39a6b13: R2-F1 to R2-F6
    resolved; new Minor findings R3-F1 (antenna-port proof load called
    non-destructive, against CR-006 revision 2 CR006-R1), R3-F2 (fallback
    trigger worded three ways in CON-015, OPS-012, item 4 and Q2), R3-F3
    (scripted test-finger check needs naming and a TV record), R3-F4 (stale
    copies: HZ-003 effects, TC-SYS-077 setup, RSK-026 rationales) and R3-F5
    (PDR work plan cites revision 2 and omits the finger TBR). Reviewer
    concurs with disposition. History row added in section 11.
    Refs: CR-003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
2026-09-27 docs(plan): PDR work plan revision 2, completeness critic findings resolved
    CR states restated (CR-003 rev 3 at d9a215a, CR-006 rev 2 at 39a6b13;
    WP-PDR-01 is now the verification re-checks). Added OD-35 (SMA TA
    determination), OD-36 (CR-007 before readiness), OD-37 with a register of
    phase CRs, OD-38 (option C fabrication and marking route), OD-39. Split the
    16/34/35 and 35/36 cycles into staged WPs with one reconciliation pass.
    Trade and analysis reviews now precede owner decisions (rules C9, C10) with
    a re-ruling step. Critical path quantified at 9.0 days plus one reserve day:
    readiness Tue 10-06, PDR Thu 10-08. Added FW-B1 DML-3 point for WP-SW-08,
    10, 12, CS-24 tags, the E-12 citation t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
2026-09-27 test(tools): Rust tool known-answer fixtures and procedure for TV-020 to TV-023 (WP-PDR-08)
    Commits the scratch fixtures of the 2026-09-26 sanity checks (cov-kat,
    cond-kat) as the lock section 1.1 rows require, adds miri-kat (seeded
    out-of-bounds read) and harness-seeded (03 section 6.5 item X10: a seeded
    failing MC/DC independence pair and a seeded cwht-hal-mock fault, run
    against the real cwht-core and cwht-hal-mock), with their stored answers
    in pdr-known-answers.json and the run procedure in the evidence folder.
    Log change: the tools are not yet Accredited (CM plan section 9.2 step 5).
    Refs: TV-020, TV-021, TV-022, TV-023, WP-PDR-08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
    [harness.rs, lib.rs]
2026-09-27 docs(risk): register Track pass for the PDR phase, SRR rulings transcribed and statuses set (WP-PDR-18 wave 0)
    Track pass of docs/plan/pdr-work-plan.md WP-PDR-18 (wave 0), closing the
    content of INSP-007 finding-18 (C-142) before any PDR overdue count.
    Log class change (05 Table 4-1 row 14); entries recorded at review point
    SRR, the last gate passed (06 section 10.3); the PDR Track pass of 06
    section 10 item 1 is the WP-PDR-18 final pass.
    - RSK-030 Accepted with the acceptance record (SRR decision memo,
    2026-09-26, residual score 4; decision 32); S1 Done, its evaluation
    citation clause moved to new step S3 (due PDR).
    - RSK-028 S2 Done (decisions 17, 19, 20); condition and rationale rest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
2026-09-27 docs(pdr): owner action pack for B0 and the PCBWay deadline (WP-PDR-04)
    docs/reviews/PDR/owner-actions.md: PCBWay email (fabrication and assembly,
    CNC fallback) and the TS-004 instant-quote set; Inrad #111, KVG and
    Guerrilla RF quote requests; st.com and other downloads; dated stock-check
    list; PDR equipment list draft (near-field H-field probe, thermocouple,
    TC-SYS-025 source and pads, matched second station); regulatory corpus
    additions; the plan section 6.1 decisions ordered by owner session.
    Section 1 is reserved for the WP-PDR-01 disposition brief. Drafts only;
    nothing is sent. Informational working product, not a baselined item.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
2026-09-27 docs(cm): submit CR-009, fix the SRR liens of the L0 set, the ConOps and the concept
    WP-PDR-10 (PDR work plan revision 2). Proposed Class I (NGO-021
    statement, MOE-012 success criterion and OPS-020 step 5; the rest Class
    II). Closes on approval and merge INSP-001 finding-12, 13, 15 and
    INSP-002 finding-19, 20, 21, 25, 26 (carried items C-009 to C-011,
    C-013 to C-017). INSP-001 finding-16 (C-012) is met by CR-003 revision 3
    section 1.4. Product changes prototyped on branch
    cr/CR-009-l0-conops-srr-liens at f511e02; nothing merges before the
    section 6 review and the owner's disposition.
    Refs: CR-009
2026-09-27 docs(process): CR-010 change set, apply SRR decisions 9 and 40 to 03, 07 and the RMM (prototype, not merged)
    WP-PDR-17 wave 0 change set, prepared on the CR branch before disposition
    (05 section 5.2 Submitted state: nothing merges until the owner's disposition).
    - 03 fifth revision: header, lead paragraph, 4.2 closing paragraph, 4.3 (lead,
    rows, frequency-control and menu-override decision paragraphs, fault
    annunciation, mission-critical paragraph), 4.4, 5 (paragraph and rows a to i),
    6.5 items g (charter section 10 decision 40 citation proposed), X13, X14, X16,
    X20, and 9 (decision rows, RMM approval state). Section 4.2 table unchanged
    (0.4.0-pha transcription; re-transcribed at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
2026-09-27 docs(l0,conops,concept): CR-009 prototype, SRR liens INSP-001 and INSP-002 (WP-PDR-10)
    Prototype of the product changes of CR-009 (proposed Class I; Submitted,
    not dispositioned, not for merge). Closes on approval and merge:
    - INSP-001 finding-12: NGO-026 rationale cites the tbr objects of
    REQ-SYS-116 and REQ-SYS-117 as the one owner, plan and close_by.
    - INSP-001 finding-13: SI-014 added to CON-006 and CON-007 source_ids.
    - INSP-001 finding-15: NGO-021 statement and MOE-012 success criterion
    carry the REQ-SYS-184 mode scope (Iambic A, Iambic B, Ultimatic).
    - INSP-002 finding-19, finding-20: ConOps section 2.2 and section 8 name
    the hazard file and risk register versions and ranges che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
2026-09-27 docs(cm): CR-009 prototype commit reference and validate_docs result corrected
    The unpushed prototype commit on cr/CR-009-l0-conops-srr-liens was
    amended from f511e02 to 9001813 to correct its validate_docs statement;
    the four product blobs are unchanged. Section 5 step 4 now states the
    post-commit result: 48 of 50, the record drift rule on INSP-001 and
    INSP-002 until their delta iterations name the frozen blobs.
    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
2026-09-27 docs(cm): submit CR-010, apply SRR decisions 9 and 40 to 03, 07 and the RMM (WP-PDR-17 wave 0)
    CR-010 (Class II proposed, Submitted): states the owner's SRR rulings of
    decisions 9 and 40 in the classification record 03, the software plan 07 and
    the RMM implementation fields of SWE-023, SWE-134, SWE-205, SWE-219 and SWE-220.
    The change set is prototyped on branch cr/CR-010-apply-srr-decisions-9-and-40
    at 5cd87cf (not merged; 05 section 5.2 Submitted state). The section 6
    independent impact review (PDR work plan rule C6) precedes the owner's
    disposition. CR-007 to CR-009 were claimed by parallel wave 0 work packages,
    so this CR takes CR-010.
    Refs: CR-010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
2026-09-27 docs(templates): analysis, software assurance and tool validation checklists; 08 sections 3.1 and 3.5 (WP-PDR-03)
    Prototype of the CR-012 change set (Class II proposed, Submitted), on the
    branch cr/CR-012-pdr-checklist-templates; nothing merges before the owner's
    disposition (05 section 5.2).
    - docs/templates/peer-review-checklist-analysis.md: new; reviews simulation
    decks and checkers, budgets, thermal, RF exposure, cascade and timing
    analyses (08 section 3.5; PDR work plan WP-PDR-03).
    - docs/templates/peer-review-checklist-software-assurance.md: new; the
    software assurance second review with the SWE-to-task table per product
    type that closes the 07 section 15 row "5.17 item 13".
    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
2026-09-27 docs(cm): submit CR-012, the analysis, software assurance and tool validation checklists (WP-PDR-03)
    CR-012 (Class II proposed, Submitted): adds
    docs/templates/peer-review-checklist-analysis.md,
    peer-review-checklist-software-assurance.md and
    peer-review-checklist-tool-validation.md, and updates 08 sections 3.1 and
    3.5 (INSP-022 finding-2, carried item C-128). Table 4-1 rows 2 and 53 are
    CR-controlled from SRR, so the change is prototyped on branch
    cr/CR-012-pdr-checklist-templates at ac9b7a5 (base 573f9f5) and nothing
    merges before the owner's disposition (05 section 5.2). The branch blobs are
    the ones frozen for the WP-PDR-03 template reviews (PDR work plan rule C2).
    The section 6 review (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
2026-09-27 docs(cm): file TV-020 to TV-024 and bind TV-013 to a commit (WP-PDR-08)
    TV-020 (rustc, cargo, clippy 1.98.0), TV-021 (cargo-llvm-cov 0.9.1),
    TV-022 (cargo-nextest 0.9.146 and the HostUnit harness with the 03 X10
    seeded independence-pair and mock-fault tests) and TV-023
    (nightly-2026-08-24, MSR-14 and Miri, non-credit) are Validated on two
    known-answer runs at d3de579. Findings: the ELF depends on the absolute
    build path (debug info; crate hashes of path dependencies reorder the
    blinky functions), so MSR-28 needs a fixed build path or a loadable-image
    comparison; the G5 Miri scope runs 0 tests at the rustos pin.
    TV-024 selects ruff and coverage.py for 03 X9 with fixtures; the download
    waits o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
2026-09-27 docs(cm): TV-014 run 2 on the fixed wrapper and finding 3, orphaned LTspice processes (WP-PDR-07)
    The 2026-09-25 hang checks matched their POSIX run directory, which the
    LTspice.exe command line (a Windows path) does not carry, so two hung
    LTspice.exe processes from 2026-09-25 23:21 and 23:22 were still running on
    2026-09-27; they were terminated by PID at 11:02 with the bottle ini
    unchanged. TV-014 now names wrapper blob 102b93d4 (commit b41e544); run 2
    repeats run 1 (18 passed, 11 blocked by the missing CaptureAnalytics key).
    Lock 1.4 finding 14 corrects the 2026-09-25 hang-case statement.
    Log change: tool not yet accredited (CM plan 9.2 step 5).
    Refs: TV-014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
2026-09-27 docs(cm): submit CR-008, the SRR liens of the L1 requirements and the TC-SYS cases (WP-PDR-11)
    CR-008 (Class I proposed, Submitted) fixes the Minor liens of INSP-003
    (finding-12, 25 to 31) and INSP-025 (finding-2 to 5, 7 to 12), the INSP-025
    cross items X1, X5, X6 and X8, and the L-7 ADR citations (RFA-SRR-007).
    The L1 file and the cases citing it are under CR control from SRR (05 Table
    4-1 rows 7 and 17), so the change set is prototyped on branch
    cr/CR-008-srr-liens-l1-and-tc-sys at c629198 and nothing merges before the
    section 6 independent impact review and the owner's disposition (05 section
    5.2; plan rule C6).
    Class I because 14 statements change and REQ-SYS-194 is added (the 0 C to
    45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
2026-09-27 docs(reviews): WP-PDR-03 template reviews INSP-031 to INSP-033, iteration 1
    Independent review of the CR-012 prototype on cr/CR-012-pdr-checklist-templates
    at ac9b7a5 (frozen blobs), checklist peer-review-checklist-requirements.md
    section G and CK-REQ-A8 (PDR work plan WP-PDR-03).
    - INSP-031 analysis template: reviewer APPROVED, 2 Minor; record verdict held
    at NEEDS CHANGES until CR-012 merges (drift rule on branch-only blobs). Also
    carries the 08 delta check and the input to the CR-012 section 6 review.
    - INSP-032 software assurance template: NEEDS CHANGES, 1 Major (SC tasks of
    SWEHB 8.10 section 6 missing from section B), 2 Minor; SA pair needed.
    - INSP-033 tool validation template: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
2026-09-27 docs(cm): submit CR-011, the PDR rule set and the --gate, --volatility and --fix-children options of tools/traceability.py (WP-PDR-06)
    Class II CR against 05 Table 4-1 rows 2, 18, 28, 30 and 40: the tool has
    been a class-CR CI since ACC-TRACE-001, so the WP-PDR-06 change goes through
    a CR. Implementation on cr/CR-011-traceability-pdr-rules at 4774562
    (4411a09 tool, tests, fixtures, README, 02; 89fac92 TV-002 run 6 and the
    regenerated traceability outputs; 4774562 record-drift note). Section 6
    impact review, the three product reviews, the INSP-015 and INSP-020 delta
    iterations and the owner disposition are pending; merge waits for them.
    Refs: CR-011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
2026-09-27 docs(cm): CR-012 records the WP-PDR-03 Major fixes at branch head 7784672
    The Major findings of the template reviews, iteration 1 (INSP-032
    finding-1; INSP-033 finding-1 and finding-2), are fixed on branch
    cr/CR-012-pdr-checklist-templates at 7784672 (CR-012 section 5 step 6).
    The CR now names the iteration 2 blobs, describes the changed template
    content in section 1.1, and adds the fix commit to section 8. Section 9
    adds the author's git-work-tree probe: an APPROVED filled tool validation
    record passes the record drift rule, and the directory-entry negative
    control fails. A history row is added.
    Refs: CR-012
2026-09-27 docs(reviews): WP-PDR-03 template reviews INSP-032 and INSP-033, iteration 2 delta
    Delta verification at cr/CR-012-pdr-checklist-templates 7784672 (rule C1).
    INSP-032: finding-1 (Major) Verified; every SC task of SWEHB 8.10
    section 6 is in section B or in the by-decision note. Reviewer APPROVED
    with Minor liens finding-2 and finding-3 due CDR; record verdict held
    (SA pair not filed; branch-only blobs fail the drift rule on main).
    INSP-033: finding-1 and finding-2 (Major) Verified, finding-2 by a probe
    record under the drift rule with a negative control. Reviewer APPROVED
    with Minor lien finding-3 due CDR; record verdict held (branch-only blobs).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
2026-09-27 docs(reviews): WP-PDR-18 Track pass review INSP-036, risk register iteration 1
    Independent review of the WP-PDR-18 wave 0 Track pass (4df6606) with
    peer-review-checklist-risk section A, at register.json 6685aa0e and
    register.md f8c28b36. Verdict APPROVED with liens (plan rule C1): no
    Major; five Minor liens due in the WP-PDR-18 final pass (RSK-028 guest
    lock already at L1 in REQ-SYS-065 and 066; RSK-024 related requirement
    ids; CR-006 notes on five risks; RSK-008 aggregate child list; RSK-014
    condition dates). Records all 65 risks as passing the Analyze check.
    Refs: WP-PDR-18, INSP-007, RSK-008, RSK-014, RSK-024, RSK-028
2026-09-27 docs(reviews): INSP-007 iteration 3 re-issue 3, finding-18 Fixed by the WP-PDR-18 Track pass
    Delta of the SRR risk register record for the Track pass 4df6606:
    product_files move to register.json 6685aa0e and register.md f8c28b36
    (06 unchanged at 7a92d21f), which clears the record drift failure of
    validate_docs.py. finding-18 (a) to (d) Fixed, with the full check in
    INSP-036; finding-16 and finding-17 remain liens (06 text, C-140 and
    C-141, WP-PDR-18 final pass). Open Major 0.
    Refs: WP-PDR-18, INSP-007, INSP-036
2026-09-27 docs(reviews): WP-PDR-05 review INSP-039 of CR-007 (cm-plan-05), iteration 1
    File review (CM lens) of the CR-007 changes to 05 on the frozen blob
    92b200ad (9032a02), with the PDR workspace verification note of output 1.
    Reviewer verdict APPROVED with 4 Minor findings; record verdict NEEDS
    CHANGES until the software assurance pair is filed (07 section 2.1.1).
    INSP-034 front-matter comment corrected to name INSP-039. The Refs line of
    a900969 was separated from its trailer block and is not parsed by git.
    Refs: PDR, INSP-039, INSP-034, CR-007
2026-09-27 docs(reviews): WP-PDR-10 review, INSP-001 and INSP-002 PDR lien deltas on the CR-009 prototype
    Independent review of WP-PDR-10 (plan section 3.4, rules C1, C2, C4, C7),
    written as delta sections of the SRR records on the CR branch, where the
    frozen product blobs of 9001813 are committed (CR-009 section 5 steps 4
    and 6). Clears the two record drift failures CR-009 step 4 reported.
    INSP-001: APPROVED with liens finding-16 (CR-003 route) and new Minor
    finding-17 (NGO-021 rationale residual squeeze clause, due CDR);
    finding-12, 13, 15 Verified on the branch blobs.
    INSP-002: APPROVED with liens finding-19 and new Minor finding-27
    (concept Status line, due CDR); finding-20, 21, 25, 26 Verified.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
2026-09-27 docs(reviews): WP-PDR-06 reviews INSP-042 (code, tools/traceability.py) and INSP-043 (TV-002 run 6), iteration 1
    Independent review of CR-011 at branch head 4774562 (blob d4cde9f5).
    INSP-042: reviewer lens APPROVED, 0 Major, 7 Minor; record verdict held
    for the software assurance pair and the CR-011 merge.
    INSP-043: NEEDS CHANGES, 1 Major (--regression covered by no purpose),
    4 Minor.
2026-09-27 docs(cm): CR-010 revision 2, INSP-037 finding-1 (Major) resolved
    WP-PDR-17 wave 0, review iteration 1 Major fix (plan rule C1). CR file only;
    the change set on cr/CR-010-apply-srr-decisions-9-and-40 stays at 5cd87cf
    with the four reviewed blobs unchanged.
    - Sections 1.3, 5 step 1 and 8: tool results stated as measured at 5cd87cf
    (validate_docs exit 1, 45 of 50; unit tests 1 failure,
    test_repository_exit_zero; traceability and render_rmm --check unchanged).
    The branch commit message is corrected in section 8, not amended.
    - Section 4 Verification and Documentation: the five APPROVED SRR records the
    change invalidates as evidence (INSP-009, 017, 006, 010, 018) with the
    blobs each na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
2026-09-27 test(tools): same-path K20-4/K20-5, lcov seeded gap K21-4, identical failing JUnit runs (WP-PDR-08)
    Fixes of the Major findings of review iteration 1, before the re-runs:
    - INSP-040 finding-1: pdr-known-answers.json rustos-blinky and cwht-app restated as
    same-absolute-path identity (ELF and loadable image, cmp), the cross-path comparison an
    observation only; procedure rust-tv-2026-09-27-r3.sh prints mechanical PASS/FAIL lines.
    - INSP-040 finding-2: pdr-known-answers.json cov-kat.seeded-gap-lcov (DA:6,0, LF 6, LH 5,
    measurements.py "lines 5/6 = 83.33 %", hand-derived) and procedure section 7 check K21-4.
    - INSP-041 finding-1: test_measurements.py DiffRunsTests adds identical failing and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
2026-09-27 docs(reviews): WP-PDR-11 reviews INSP-044 (CR-008 L1 requirement liens, INSP-003 delta) and INSP-045 (TC-SYS case liens, INSP-025 delta), iteration 1
    Independent review of CR-008 on the frozen blobs of branch
    cr/CR-008-srr-liens-l1-and-tc-sys at c629198. Every INSP-003 and INSP-025
    lien carried by WP-PDR-11, L-7 of RFA-SRR-007 and the RID-SRR-003 wording
    are verified. Reviewer verdicts APPROVED with 0 Major and 4 Minor findings
    (INSP-044 finding-1; INSP-045 finding-1 to 3); record verdicts held at
    NEEDS CHANGES under the record drift rule until CR-008 merges.
    Refs: CR-008
2026-09-27 docs(reviews): WP-PDR-06 INSP-043 iteration 2, delta verification of finding-1 (Major) on TV-002 run 7
    Reviewer verdict APPROVED with liens finding-2 to finding-5 (Minor, due CDR);
    no new finding. Run 7 procedure re-run at 2b004b1 reproduces the committed
    log; six further reviewer mutants of the regression filters all killed.
    Record verdict held NEEDS CHANGES: SA pair not filed; reviewed blobs are on
    the CR-011 branch only.
    Refs: CR-011
2026-09-27 docs(decisions): WP-PDR-14 ADR errata for the INSP-011 liens, RID-SRR-005 and the L-7 hazard stamps
    Applies the SRR liens against the ADR set by the ADR correction route the
    owner approved as SRR decision 105 (corrections outside section 2, each
    logged in a dated section 8 entry); no section 2, Status row or decided
    value changes.
    - F-05 ADR-001 RMM counts cite the generated rmm.md.
    - F-06 ADR-017 SWE-214 to 217 stated as Center Director requirements.
    - F-07 ADR-005 PA current from pa-device-candidates F19.
    - F-08 ADR-017 and ADR-025 cite 47 CFR 2.803(a) as research finding F21
    (High); the ADR-025 section 2 citation is a section 8 reading (OD-24 (a)
    not given).
    - F-10 ADR-019 WP-SW ids.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
2026-09-27 docs(process): CR-013 prototype, SRR liens of INSP-021, INSP-010, INSP-018 and INSP-005 in 04, 07 and the SEMP (WP-PDR-13)
    Prototype on the CR branch (05 section 5.2, Submitted: nothing merges before
    the owner's disposition). Built on the CR-010 change set (5cd87cf), because
    the plan section 5.3 writer order for 07 is WP-PDR-17 then WP-PDR-13.
    04: INSP-021 finding-2 (ACC-EMU-001, cwht-emu, C1), finding-3 (A10, A12,
    A13, A14 statements), finding-4 (LTspice wrapper name, section 7.4
    re-observed at main 7bb994f, rows 7.3.2 and 7.3.5 due PDR) and finding-9
    (row 7.3.6 Inspection route implemented at c774851); section 7.4 names
    the CR-011 codes; section 12 adds the target-only entry of 07 section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
2026-09-27 docs(cm): CR-015 submitted, the SRR record liens of 01, 02, 08, the process index and the compliance matrix (WP-PDR-12, PCR-2)
    Class II CR for the WP-PDR-12 outputs that are class-CR items after
    baseline/srr (05 Table 4-1 rows 2, 3 and 53). Product change prototyped on
    cr/CR-015-process-liens-01-02-08 at 7efd900, based on the CR-012 head
    7784672 so that it merges with or after CR-012. Frozen blobs listed for the
    INSP-019, INSP-020, INSP-022 and INSP-024 delta iterations; section 6
    review (rule C6) pending; disposition OD-37 at B2.
    Refs: CR-015, WP-PDR-12, RFA-SRR-006
2026-09-27 docs(cm): CR-016 submitted, the Retired status in the requirement and test-case schemas (WP-PDR-12, PCR-3)
    Class II CR drafted for PDR (02 section 11.3 and section 14 CI-3; gate
    reader P-17), effective after baseline/pdr unless the owner rules
    otherwise. Prototype on cr/CR-016-retired-status-schema at 33e0916: Retired
    added to both status enums and the 02 retirement text restated; the
    interim-marked REQ-SYS-016 and REQ-SYS-123 keep their form. Section 6
    Refs: CR-016, WP-PDR-12
    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
2026-09-27 docs(cm): submit CR-013, the SRR liens of 04, 07 and the SEMP; charter edit list for OD-31 (WP-PDR-13)
    CR-013 (Class II, Submitted) fixes the Minor liens of INSP-021 (04),
    INSP-010 and INSP-018 (07) and INSP-005 (SEMP). The product change is
    prototyped on cr/CR-013-process-04-07-semp-srr-liens at 41c588c, built on
    the CR-010 change set (5cd87cf) by the plan section 5.3 writer order for 07.
    Frozen blobs: 04 7617007e, 07 0ad37a43, SEMP 2076eb0a. The section 6
    review and the four record delta iterations follow (plan rules C2, C6).
    docs/reviews/PDR/owner-actions.md section 11: charter edits CE-1 (section
    12 HSI row, SRR decision 2), CE-2 (section 10 decision 40 citation, 03
    item g) and CE-3 (se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
2026-09-27 docs(cm): CR-007 section 6.1 independent impact review round 1 (CM lens): 1 Major, 7 Minor
    Impact review complete, with findings. IR-F1 (Major): the software
    assurance plan 07 (sections 2.1, 2.1.1 single dispatch rule, 15) is not
    in the impact assessment although C7, C9 and C12 give the software
    assurance reviewer new tasks. IR-F2 to IR-F8 Minor.
    Refs: CR-007
2026-09-27 docs(reviews): WP-PDR-06 INSP-051, software assurance pair of INSP-043 (TV-002 runs 6 and 7, CR-011)
    Assurance review of TV-002 at 2b004b1 (tools/traceability.py blob d4cde9f5)
    against the software assurance checklist revision A as on the CR-012 branch.
    assurance_verdict APPROVED, 0 Major, 3 Minor (hazard-trace direction without
    a known answer, TV-002 not recording the INSP-015 run 5 review, regression
    selection limitation for element and ICD ids). Record verdict held under the
    lead SE branch-only convention until the CR-011 merge.
    Refs: CR-011, TV-002, INSP-043, INSP-042, INSP-048, WP-PDR-06
2026-09-27 docs(cm): CR-009 section 6.1 independent impact review round 1: 1 Major, 3 Minor
    R1-F1 (Major): INSP-002 finding-19 half fixed (RSK-064 and RSK-065 not
    in ConOps section 8) while the CR presents it as fixed. R1-F2: review
    record commit 64eb688 on the cr/ branch outside the CR scope. R1-F3:
    NGO-021 rationale and concept Status residues. R1-F4: the 5 W worst-case
    claim needs the keying-envelope Analysis qualifier.
    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
2026-09-27 docs(cm): CR-012 section 6.1 independent impact review round 1: 1 Major, 5 Minor
    Impact review complete, with findings. IR-F1 (Major): the assessment
    says the templates govern future records only, but INSP-038, 040, 041,
    043 and INSP-046 to INSP-050 already applied the branch blobs 7be809d4
    and 5b135285; a disposition that changes a template leaves them on a
    revision that never reached main (Table 4-1 row 53 rule). IR-F2 to
    IR-F6 Minor: SEMP App. B line 450 and the 07 follow-ons without a
    carrying CR; INSP-022 finding-2 only partly addressed; CR-015 stacked
    on the branch; template records pin this CR file; ac9b7a5 trailer and
    the stale 573f9f5 base for the tool check.
    Co-Author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
2026-09-27 docs(cm): CR-011 section 6.1 independent impact review round 1: 1 Major, 4 Minor
    IR-F1 (Major): six new codes are plain-run violations, not warnings as
    section 1 says. After the merge, a trial merge of cr/CR-008 gives 164
    CHANGE_UNCOVERED even when approved. Section 4 does not assess this.
    IR-F2 to IR-F5 (Minor): missing record deltas at the merge (README
    auto-merge, INSP-051, INSP-038). The validate_docs exit-0 criterion is
    not reachable by this CR alone. The 03 section 8 hazard-row severity
    has no carrier CR. The related list is incomplete and the report is
    stale at the merge.
    [nonuniform-scale.scad, taller.scad, twist.scad, two-roots.scad, two-solids.scad]
2026-09-27 docs(design): WP-PDR-20 wave 1a, TS-007 synthesizer and reference, frequency budget, clock plan, ADR-031 (freeze F0)
    TS-007 (In review): recommends A2, LMX2571 for the RX LO and TX carrier
    with a Si5351A-B-GT BFO and a shared 25.000 MHz LVCMOS TCXO (SiT5356
    class, acceptance test R-M3: uncalibrated total <= 1.5 ppm). A2 380 vs
    A1 295; robust to every weight +/-10 and Low-cell +/-1 run; the cost
    band test passes on the 2026-09-25 price signal with USD 0.24 to spare.
    frequency-budget.md: the 1.2 kHz guard holds with 75.0 Hz at the upper
    edge for REQ-TX-006 up to 825.0 Hz; guard-protecting identity bounds the
    calibration constant at +/-0.9 ppm; the REQ-SYS-182 10 kHz window does
    not hold on th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
2026-09-27 tool(render_tpm): name the TPM file read in the table header and pad the trend y range (WP-PDR-07)
    The table subtitle and the Markdown line named docs/plan/tpm.json even when --tpm gave another
    file (the fixture); they now name the file read, relative to --root. The trend plot's y range
    now includes the planned value with a margin, so the planned line is not drawn on the frame.
    Found by the author's inspection of the TV-017 fixture renders before the validation run.
    The five WP-PDR-07 tools were committed in 86ff3b0 together with an unrelated CR-011 review:
    another session's commit took the files staged in the shared index, so that commit's message
    does not describe them. Content and blobs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
2026-09-27 test(scad2step): research smoke half-shell known answer (WP-PDR-07)
    Adds the half-shell of docs/research/enclosure-cnc-and-openscad-pipeline.md B2, wrapped in one
    union(), as a TV-015 known answer ("smoke shell to STEP", PDR work plan WP-PDR-07): one valid
    solid, 31 faces (16 cylindrical, 15 planar), no BSpline face, volume 24721.22 mm^3 and the
    bounding box, all derived by hand from the source before the run.
    Refs: TV-015, ADR-008
    [smoke-shell.scad]
2026-09-27 docs(design): WP-PDR-27 wave 1a drafts: TS-011 enclosure, TS-004 board thickness, shielding and tolerance analyses
    TS-011 recommends option C as C1 (owner-printed PETG case, legend and jack
    markings debossed with a flush inlay, conductive coating inside, spring-loaded
    purchased heatsink behind a guard, PCBWay port block) with the CNC 6061
    enclosure held as the fallback; D (hybrid) ties and is presented with it (not
    robust). Route Ra for OD-38 (robust). Coating research recommends MG Chemicals
    843AR on recalled data; datasheets listed for the owner to fetch.
    TS-004 recommends 1.0 mm with Type VII via-in-pad and 5 mm tab-routed rails
    (robust). Analyses propose values for the G11 TBRs and REQ-S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
    [bond.csv, shielding.csv, thermal-screen.csv, tolerance-stack.csv]
2026-09-27 tool(csa): read YAML block lists and directory products of INSP records (WP-PDR-07)
    The front-matter reader skipped a product_files block list and the record matcher ignored a
    directory product such as INSP-016's "firmware/ (FW-B0 workspace)", so row 25 showed no
    record and level L0 at 9fd0962 where the hand CSA has L1 (INSP-016). Found by the author's
    comparison with the hand CSA before the TV-018 validation run; test_csa.py gains the case.
    Refs: TV-018, TV-019, INSP-016
2026-09-27 docs(reviews): WP-PDR-13 INSP-058, INSP-059, INSP-064, PDR deltas of INSP-021, INSP-010 and INSP-005 on CR-013 (41c588c)
    Independent reviewer, iteration 1, on the frozen CR-013 prototype blobs
    (branch cr/CR-013-process-04-07-semp-srr-liens at 41c588c): 04 7617007e,
    07 0ad37a43, SEMP 2076eb0a. Each record sets reviewer_verdict APPROVED
    (0 Major) and holds verdict until the CR-013 merge (lead SE convention
    of 2026-09-27).
    INSP-058 (04): INSP-021 finding-2, 3, 4 and 9 Verified; new Minor
    finding-1 (15 test files, not 16), finding-2 (row 7.3.6 column),
    finding-3 (CLOSED_NOT_INSTALLED re-dated to PDR, 02 T-11 says CDR).
    INSP-059 (07): INSP-010 finding-14, 16, 17, 18, 20, 22 Verified;
    finding-15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
2026-09-27 docs(reviews): WP-PDR-20 INSP-055 (TS-007, risk B) and INSP-056 (frequency budget and clock plan), iteration 1
    INSP-055, TS-007 at 9ac2c42 (blob 72c47383): reviewer APPROVED with 5 Minor
    findings (mandatory-cell evidence for A2 M3 and M6, C1 offset, A1 BFO PLL
    source, lock detect, M7 key-down basis). Totals, 26 sensitivity runs, stress
    case and cost variant recomputed. Record verdict held at NEEDS CHANGES until
    the software assurance pair returns (07 section 2.1.1, rule C9).
    INSP-056, frequency-budget.md and clock-plan.md at 9ac2c42: NEEDS CHANGES,
    4 Major (REQ-SYS-154 true-error trigger not met by a 10 kHz measured
    window; REQ-SYS-154 unlocked case missing; clock inventory omits the RP2350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
2026-09-27 docs(cm): file TV-015 to TV-019 for the PDR tools, known-answer runs 1 passed (WP-PDR-07)
    TV-015 OpenSCAD 2021.01 and FreeCAD 1.1.3 through tools/scad2step.py (class A; run 1 at
    0743499, 22 tests, reproducibility shown), TV-016 kicad-cli 10.0.6 with tools/normalize_fab.py
    (run 1 at c90df2d, 38 tests), TV-017 tools/render_tpm.py (run 1 at c90df2d, 12 tests, fixture
    renders inspected), TV-018 tools/csa.py (run 1 at b308f8c, 33 tests, derivable values equal to
    the hand CSA issue 1 at 9fd0962) and TV-019 tools/check_commit_msg.py (run 1 at b308f8c, 13
    tests). Each record proposes its ACC scope; review in the WP-PDR-07 record
    tool-validation-tv-014-to-tv-019.md and owner accreditation are pending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
2026-09-27 docs(reviews): WP-PDR-06 INSP-070, software assurance pair of INSP-042 (tools/traceability.py d4cde9f5 at CR-011 2b004b1): assurance APPROVED, 1 Minor
    Paired SA record of the code review INSP-042 (07 section 10.2), checklist
    peer-review-checklist-software-assurance revision A as on the CR-012 branch
    (7784672, blob 5b135285). 13 mutants of the PDR safety and gate rules: 9
    killed, 4 survive (finding-1: live and retired clauses of HAZARD_UNCONTROLLED
    and SAFETY_PART_UNTRACED, Class I hazard_ids and safety tag). Record verdict
    held under the lead SE convention until the CR-011 merge.
    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
2026-09-27 Status note 2026-09-27 section 6: owner direction on cost (hobby budget, listed-price catalog parts only, in-house assembly acceptable, discrete MOSFET PA acceptable); vendor quote requests on hold
    Refs: PDR
2026-09-27 Status note 2026-09-27 section 6: owner sets USD 200 all-in cap for the first radio (filament excluded), through-hole only with exceptions discussed, op-amp and MOSFET circuits acceptable; TS-012 des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
2026-09-27 docs(reviews): WP-PDR-33 INSP-071 keyer host study and INSP-072 UI design analysis, iteration 1
    Independent reviews of the F0 freeze 82cf086 with the analysis checklist
    (CR-012 branch blob 0386cc6e; the checklist field names the design
    checklist on main until CR-012 merges).
    - INSP-071 keyer host study: NEEDS CHANGES, 1 Major, 3 Minor. The
    REQ-SYS-054 legitimate-sending case does not cover Bug-mode sending
    (a named corpus element) or state the key-mode scope of the no-gap
    watchdog, so the proposed 2-dit gap is not shown for every key type.
    Squeeze, interlock, manual timeout, watchdog period, bench timeouts
    and plug presence re-checked and stand. Software assurance pair
    pending.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
2026-09-27 Status note 2026-09-27 section 6: owner accepts a JLCPCB bare PCB with owner-soldered through-hole parts
    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
2026-09-27 Status note 2026-09-27 section 6: owner keeps the pocket-size envelope mandatory and accepts dropping the display for a Morse-code audio menu (enter by button, options sent in Morse, select by sent l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
2026-09-27 docs(reviews): WP-PDR-20 INSP-074, software assurance pair of INSP-055 (TS-007), iteration 1
    Assurance verdict APPROVED (0 Major, 4 Minor): A2 changeover-retune
    contribution to HZ-008 and SWE-134 e; flow-down of the safety-critical
    driver set and the FC0 counter move to 07 sections 14.1 and 19; bus
    isolation and LMX2571 register read-back; missing Refs: trailer on the
    freeze commit 9ac2c42. Record verdict held at NEEDS CHANGES (SA template
    branch-only on CR-012; INSP-055 pairing pending), lead SE convention.
    Refs: INSP-074, INSP-055, TS-007
2026-09-27 Status note 2026-09-27 section 8: owner priorities: cost under USD 200 is firm; size and through-hole are negotiable; hand-solderable surface-mount parts acceptable (no BGA or reflow-only parts; iron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
2026-09-27 docs(adr,sprints): WP-PDR-41 wave 1a, ADR-051 to ADR-055 for the FW-B1 minimal keyer drivers and sprint records SW-01 to SW-05
    Proposed work-package ADRs for the five rustos packages of the RSK-013
    minimal keyer set, each recording the design frozen on its rustos branch
    (scratch worktree of the rustos repository, stacked in merge order on
    cwht/l-016-6 at 5b39e8e, the drafted SRR lien L-016-6):
    - ADR-051 WP-SW-11 clocks: cwht/wp-sw-11 at 213c536
    - ADR-052 WP-SW-09 interrupts: cwht/wp-sw-09 at 9305f59
    - ADR-053 WP-SW-01 TIMER0 time base and alarms: cwht/wp-sw-01 at a1cd160
    - ADR-054 WP-SW-02 SIO input snapshot: cwht/wp-sw-02 at f85a190
    - ADR-055 WP-SW-03 PWM output: cwht/wp-sw-03 at 6df18af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
2026-09-27 docs(reviews): WP-PDR-27 INSP-081 to INSP-084, iteration 1 of TS-011, TS-004, shielding and tolerance analyses
    INSP-081 TS-011 enclosure (risk B): reviewer NEEDS CHANGES, 2 Major (M4 heat-sink
    condition outside the sensitivity statement; M8 boss temperature not evaluated),
    4 Minor; software assurance pair required (thermal protection heat path).
    INSP-082 TS-004 board thickness and panelization (risk B): APPROVED, 2 Minor.
    INSP-083 shielding estimate (analysis item set): NEEDS CHANGES, 1 Major (harmonics
    to 1.5 GHz of TC-SYS-107 not analysed; every option below 20 dB above 1 GHz by the
    note's own model), 3 Minor.
    INSP-084 mechanical tolerance stack (analysis item set): NEEDS CHANGES, 1 Major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
2026-09-27 docs(decisions): WP-PDR-14 record for 618e441, INSP-053 finding-1 fix (ADR lines restored to baseline/srr, errata carried as appended section 8 readings)
    Record commit, no content change. The WP-PDR-14 fix of INSP-053 finding-1
    (Major, concurred by INSP-066) was staged by explicit path for the 27 ADR
    files ADR-001 to ADR-027 and docs/decisions/adr/README.md, and a
    concurrent WP-PDR-41 commit (618e441, ADR-051 to ADR-055 and sprint
    records) took the shared index and committed those 28 files with its own
    message. Their blobs at 618e441 are the WP-PDR-14 product; this commit
    carries the message and the Refs trailer the Record class requires
    (05 section 5.1).
    Fix route (b) of INSP-053 finding-1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
2026-09-27 docs(reviews): WP-PDR-27 INSP-087, software assurance pair of INSP-081 (TS-011 enclosure), iteration 1
    Assurance NEEDS CHANGES: 1 Major, 2 Minor, all Open. Finding-1 (Major): the
    C1 heat path puts the REQ-SYS-181 cut-off sensing point in question (HZ-003 K9
    "NTC at the PA" against REQ-SYS-181 "heat-sink sensor"); on the study's chain
    a 95 C heat-sink sensor trips at Tj about 135 C, and the study neither places
    the sensor nor assesses the bound. Finding-2: the 85 C firmware inhibit acts
    before the scored REQ-SYS-112 case. Finding-3: 70a3a33 lacks a Refs: trailer.
    Checklist applied from cr/CR-012-pdr-checklist-templates (blob 5b135285);
    record verdict held per the lead SE convention.
    Refs: WP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
2026-09-27 docs(design): WP-PDR-20 revision 1 of the frequency budget, clock plan and ADR-031, fixing the four Major findings of INSP-056 iteration 1 (re-freeze F0)
    - finding-1: measured SW-SAFE threshold T = 5.0 kHz, distinct from the
    REQ-SYS-154 10 kHz true-error limit (R3: 4 518 < T <= 5 482 Hz at
    interval 12, 2 518 < T <= 7 482 Hz at interval 13); REQ-SYS-154 and
    REQ-SYS-182 unchanged; TC-SYS-101 12 kHz injection trips with 2 482 Hz
    margin, case unchanged; FC0 accuracy ceiling 560 Hz (cases C-12w, C-16,
    C-16a, C-18).
    - finding-2: unlocked-synthesizer cases at key-down (U-1) and during
    transmission (U-2): device lock-detect read before PA_EN and every
    10 ms, counter as second means, 30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
    [clock_plan.py, freq_budget.py]
2026-09-27 docs(cm): TV-014 run 4 after owner action OA-TV014-1, not a pass: wrapper lock held by orphaned Wine services (WP-PDR-07, INSP-038 route 1)
    Run 4 of the TV-014 section 3 procedure on the frozen blobs of run 3 (wrapper
    64e1c723, test module c75cb7b3, fixture digest b9f7ed3c), HEAD 618e441,
    2026-09-27 13:17 to 13:29 CDT. The bottle key CaptureAnalytics=false was on
    line 3 (count 1) before and after the run.
    Part C: exit 0, 35 run, 33 passed. Every LTspice case passed, including
    test_ascii_raw_known_answer (INSP-038 finding-2). test_bottle_without_key was
    skipped, which is permitted. test_busy_when_lock_held was skipped, which is not
    permitted: unit-test suites of other sessions held the wrapp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
2026-09-27 docs(reviews): WP-PDR-07 INSP-088, independent review of TV-015 to TV-019 at 2bfe001, iteration 1 (1 Major, 10 Minor)
    Tool validation review of the wave 1a tools scad2step.py, normalize_fab.py
    with kicad-cli, render_tpm.py, csa.py and check_commit_msg.py, with the
    code review of each source. All six known-answer modules re-run: 118 tests,
    0 skipped. Major finding-1: TV-015 purpose 2 and ACC-SCAD2STEP-001 cover the
    C4 and C6 refusals, which no known answer exercises. Separate record from
    INSP-038 (escalated, three iterations used); cross item X-1.
    Refs: TV-015, TV-016, TV-017, TV-018, TV-019, INSP-088, PDR
2026-09-27 docs(reviews): WP-PDR-07 INSP-038 iteration 3 re-issue 1 (owner-authorized iteration 4) on TV-014 run 4: NEEDS CHANGES, finding-2 Verified, finding-1 Open, new Major finding-20
    Delta on finding-1 and finding-2 only (rule C1 route (1), after the owner's
    OA-TV014-1), on HEAD d9c7f69 with the frozen blobs (wrapper 64e1c723, test
    module c75cb7b3, fixture tree 8feee9d0).
    finding-2 Verified: test_ascii_raw_known_answer passed in run 4 part C.
    finding-1 Open: run 4 is not a pass (busy-lock case skipped, part D not
    completed). Reviewer re-run through the wrapper with a 5 s lock wait: 35 run,
    13 passed, 20 failed with exit 5, 2 skipped; no LTspice case could run.
    finding-20 (new, Major): the cause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
2026-09-27 test(scad2step): seeded C4 and C6 faults through a FreeCAD API test double (WP-PDR-07, INSP-088 finding-1)
    INSP-088 iteration 1 finding-1 (Major): TV-015 purpose 2 and ACC-SCAD2STEP-001 claim the C4
    (more than one solid) and C6 (STEP read-back differs from the exported solid) refusals, but no
    known answer reached either branch, because no source of the ADR-008 dialect makes FreeCAD 1.1.3
    produce them.
    Adds fake/freecadcmd-api-double with stand-in FreeCAD, Part and importCSG modules
    (fake/freecad_api/). The driver runs it as freecadcmd; it executes tools/scad2step.py under the
    test interpreter, so FreeCAD mode runs its own check code on a stand-in shape chosen by
    CWHT_FAKE_FREECAD_CASE. New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
2026-09-27 docs(reviews): WP-PDR-20 INSP-056 iteration 2, delta on the four Major fixes at 802347b: NEEDS CHANGES, findings 1 to 4 Verified, new Major finding-8
    Delta (rule C1) on the re-frozen F0 blobs of 802347b: frequency-budget.md
    79d47fbb, clock-plan.md 8582121a, freq_budget.py d82269e6, clock_plan.py
    b9392297, the two figures d77a0b3a and 19f47e3d, and ADR-031 a578ca16.
    Both checkers re-run on a git archive export (35 pass 0 fail 4 INFO; 0 rule
    failures, 4 named residual sources), figures byte-identical and inspected.
    - finding-1 Verified: measured threshold T = 5.0 kHz, margins 482 and
    2482 Hz, TC-SYS-101 12 kHz trips, FC0 ceiling 560.2 Hz.
    - finding-2 Verified: unlocked cases U-1 and U-2 (30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
2026-09-27 docs(reviews): WP-PDR-41 INSP-105, software assurance pair of INSP-099 (WP-SW-03 PWM), iteration 1: NEEDS CHANGES (1 Major, 2 Minor)
    Assurance review of rustos cwht/wp-sw-03 at 6df18af with ADR-055 and SW-05,
    checklist peer-review-checklist-software-assurance revision A as on the
    CR-012 branch (7784672). finding-1 Major: release does not assert the PWM
    reset, so a warm start can leave slices frozen at their last level
    (SWE-134 a, HZ-005 C2). INSP-099 finding-1 Major confirmed. Record verdict
    held under the lead SE branch-only convention.
2026-09-27 docs(reviews): WP-PDR-41 INSP-103, software assurance pair of INSP-097 (WP-SW-01 TIMER0) iteration 1: NEEDS CHANGES on concurred INSP-097 finding-1, 2 Minor
    Record verdict held under the lead SE convention of 2026-09-27: the reviewed
    rustos blobs exist only on the unmerged branch cwht/wp-sw-01 at a1cd160.
2026-09-27 docs(design): WP-PDR-33 revision 2 of the keyer host study and UI design analysis, Major fixes of iteration 1
    Keyer host study (INSP-071 finding-1; INSP-075 findings 1 and 2):
    - key-mode scope of REQ-SYS-054 (i), (ii) and REQ-SYS-184 stated (section 3.5)
    - Bug corpus B (automatic dits, manual dahs to 6 dits, operator unit 0.75 to 2
    Bug dits) and Straight corpus S (five hand profiles) added; INSP-071
    counter-example reproduced (30.24 s under the current and revision 1 rules)
    - revision 1 gap rule withdrawn; revision 2 self-referenced watchdog proposed:
    no keyer parameter, count not reset by letter-length gaps, period count 1 to 6
    - fault catalogue under the current, revision 1 and revis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
2026-09-27 docs(reviews): WP-PDR-41 INSP-102, software assurance pair of INSP-096 (WP-SW-09 interrupts at rustos 9305f59), iteration 1: assurance APPROVED, 3 Minor, record verdict held
    SA second review of the WP-SW-09 code review INSP-096 with the software
    assurance checklist revision A as on cr/CR-012-pdr-checklist-templates
    (7784672). Product type code, criticality safety-critical (07 section 14.1
    drivers row and SW-SCHED row). Findings: fault and default vectors not
    overridable by the application (07 section 14.2 rows c and l); IRQ-6 reset
    state assumed, not established or tested on silicon; CsCell::replace drops
    the value on Busy. Record verdict held under the lead SE convention (rustos
    blobs on an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
2026-09-27 docs(reviews): WP-PDR-41 INSP-106, software assurance pair of INSP-095 (WP-SW-11 clocks at rustos 213c536), iteration 1: assurance NEEDS CHANGES, 0 Major, 5 Minor
    Paired record of the code review INSP-095 under 07 section 2.1.1 (code of a
    safety-critical driver). Checklist applied: the software assurance template
    revision A as on cr/CR-012-pdr-checklist-templates (7784672, not merged).
    Five safety-designated tasks answered No: swe-134 task 2 and swe-087 task 4
    on INSP-095 finding-1 (Major, cited, not raised again), swe-062 task 1,
    swe-219 task 1 and swe-135 task 5 on findings 1 and 2 of this record. Record
    verdict held: reviewed blobs are on unmerged rustos branches (lead SE
    convention of 20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
2026-09-27 docs(design): WP-PDR-20 revision 2 of the clock plan and ADR-031, fixing INSP-056 finding-8 (Major) (re-freeze F0)
    - RP2350 ring oscillator (ROSC, 4.6 to 24.0 MHz, section 8.3.1) added to
    the inventory. Route (a): new rule 11 (ADR-031 item 9) has the clocks
    driver disable it (CTRL.ENABLE 0xd1e, Table 605) after the clk_ref and
    clk_sys SELECTED read-backs, read back STATUS.ENABLED (Table 612) with a
    fault, and repeat after every DORMANT exit. Requests to WP-PDR-41
    (WP-SW-11, ADR-051) and WP-PDR-35 (SW-CTL requirement, HostUnit check).
    ADR-031 assumption 6 names the fallback: without rule 11 the ROSC is R-6.
    - RP2350 low-power oscillator (LPOSC, 26.2144 to 39.3216 kHz, Table 615)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
    [clock_plan.py]
2026-09-27 docs(reviews): WP-PDR-20 INSP-056 iteration 3, delta on the finding-8 fix at 4153acf: reviewer APPROVED, record verdict held
    - finding-8 (Major) Verified: ROSC off in operation by rule 11 (route (a),
    CTRL.ENABLE 0xd1e after both SELECTED read-backs, STATUS.ENABLED read-back
    with a fault, repeated after DORMANT exit and switched-core power-up),
    fallback R-6 named in ADR-031 assumption 6, seeded case --rosc-running
    exits 1; LPOSC residual R-5 per Tables 487, 101 and 615. Checker re-run
    (0 rule failures, 5 residual sources), figure byte-identical, 2 renders.
    - New finding-10 (Minor, lien): TRNG ring oscillator not stated as off in
    operation. Findings 5, 6, 7 and 9 stay Open as liens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
2026-09-27 docs(design): WP-PDR-27 revision 1 of TS-011, shielding and tolerance analyses, fixing the Major findings of INSP-081, INSP-083, INSP-084 and INSP-087 iteration 1 (re-freeze F0)
    TS-011 revision 1: recommendation C1 on three stated conditions with A as
    the fallback: heat-sink in-situ resistance 6.11 K/W or less (M4, measured
    before commitment; guard derating from a stated model; C3 score 2 at 4.89
    K/W; 80 % duty claim withdrawn; heat-sink risk re-scored L4, 12 Red);
    case filament HDT 99 C or more (M8 bounded at the bosses and walls by a
    two-layer board model: PETG fails; CON-015 change needed); REQ-SYS-177
    scope ruling (PCR-9). Rule 14 puts both PA thermal sensors at the PA pad
    (K9 trips at T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
    [board-field-thermal.csv, drop-and-axial.csv, shielding-sources.csv, shielding.csv]
2026-09-27 fix(ltspice): end the bottle's Wine session after each run, finding-20 regression case, real LTspice only under CWHT_LTSPICE_INTEGRATION=1 (WP-PDR-07, TV-014 finding 5)
    The Wine services LTspice.exe starts (services.exe, winedevice.exe,
    plugplay.exe, svchost.exe, explorer.exe, rpcss.exe) and the bottle's
    wineserver outlived every run; 63 of them had piled up. After each run
    that reached the launch (normal exit, error, time-out, INT or TERM) the
    wrapper now ends the session with the bundle's own
    'WINEPREFIX=<bottle> <bundle>/bin/wineserver -k', waits up to 5 s and
    SIGKILLs a survivor of that session, only when the run started the
    session (none of its processes at launch, lock held) and no oth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
2026-09-27 docs(cm): TV-014 run 5 at d1148c2 passed, finding 5 closed, OD-24b to the owner after the INSP-038 delta (WP-PDR-07)
    Run 5 (2026-09-27 14:19 to 14:22) on the frozen blobs of d1148c2
    (wrapper bdc4513f, test module 6c4e00e5, fixture tree 61c74693) with
    CWHT_LTSPICE_INTEGRATION=1 and CWHT_LTSPICE_SLOW=1: 43 run, 42 passed,
    the permitted skip only; the busy-lock case ran; part D (long path
    through the wrapper) PASS; part E no process of the bottle's Wine session
    10 s after the last run and the lock free; part F the finding-20
    regression case fails on the launch line of blob 64e1c723. Key
    CaptureAnalytics=false present before and after. TV-014 section 1, 4
    and 9, finding 5 closed with its cause;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
2026-09-27 docs(design): WP-PDR-41 revision 2 of ADR-051 to ADR-055 and sprint records SW-01 to SW-05, Major fixes of review iteration 1
    rustos branches (scratch worktree, not pushed, not merged; each lower branch
    merged into the next so that each can be merged on its own):
    - cwht/wp-sw-11 4a8e825 (INSP-095 finding-1): step 3 clears CLK_SYS_CTRL.SRC
    alone and polls SELECTED, AUXSRC first written in step 7; step 8 clears
    ENABLE alone, waits for ENABLED to clear, then AUXSRC, DIV, ENABLE; tests
    start from the datasheet reset values and check the 8.1.2.2 aux-mux rule
    - cwht/wp-sw-09 c6e5100 (INSP-096 finding-1, CS-18): device vectors, their
    extern block and Vector move to irq/vectors.rs; lib.rs 56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
2026-09-27 docs(decisions): TS-012 design-to-cost architecture for a hand-built first radio under USD 200 (Proposed; owner's decision pending)
    Recommends A4, the min-cost architecture (AFT05MS004NT1 SOT-89 PA, JFET
    superhet with a hand-matched 500 Hz ladder, Morse audio menu, charging
    outside the radio, one Mouser order plus two JLCPCB 2-layer boards) with
    grafts from the other architectures and the judges: Coilcraft LPF, G5V-2
    DPDT relay, restored REQ-SYS-055 cutoff and REQ-SYS-182 prescaler, plated
    thermal slot under the PA, XTAR MC1 charger, ordering gate with guards and
    add-backs. Capped total USD 167.95 / 190.29 / 212.64 (low / planning /
    high); the high case is held by the ordering gate. Lists th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
2026-09-27 docs(reviews): WP-PDR-27 INSP-081 iteration 2, delta on the finding-1 and finding-2 fixes at 70d11ef: reviewer APPROVED, both Verified, new Minor findings 7 and 8; record verdict held for the SA pair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
    Delta (rule C1) on the re-frozen F0 blobs of 70d11ef (TS-011 16fc3d6b,
    board_field_thermal.py 12b7e3d6, board-outline.json 9d4d36a9 and outputs).
    Checkers re-run on a git archive export: 4 of 4 CHECK PASS, outputs
    byte-identical; three renders inspected.
    - finding-1 Verified: M4 threshold 6.11 K/W made condition 1 with fallback
    A; C3 score 2 at 4.89 K/W; 80 % duty withdrawn; guard model 1.3 to 2.8
    K/W reproduced by hand; heat-sink risk L4 x C3 = 12 Red.
    - finding-2 Verified: bosses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
2026-09-27 docs(reviews): WP-PDR-27 INSP-083 iteration 2, delta on the finding-1 fix at 70d11ef: finding-1 Verified, new Major finding-5 (jack-collar credit with a plug inserted): reviewer NEEDS CHANGES
    Delta (rule C1) on the re-frozen F0 blobs of 70d11ef (shielding-estimate.md
    57bb7ba5, shielding_estimate.py eb20c669, outputs and plot). Checker re-run
    on a git archive export: CHECK PASS, outputs byte-identical; plot inspected.
    - finding-1 Verified: 19 clock-plan sources with every harmonic to 1.5 GHz
    and the band ends; cases below 20 dB reported; rules O1 to O3 and the
    PCR-9 question; not-shown rule at 6 dB.
    - finding-5 (new, Major): the rule O2 below-cutoff credit does not hold
    with a plug in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
2026-09-27 docs(reviews): WP-PDR-27 INSP-084 iteration 2, delta on the finding-1 fix at 70d11ef: reviewer APPROVED, finding-1 Verified, new Minor findings 6 and 7; record verdict held for the CR-012 merge
    Delta (rule C1) on the re-frozen F0 blobs of 70d11ef (tolerance note
    b31768da, drop_and_axial.py 3513caaa, outputs and plots). Checkers re-run
    on a git archive export: 3 of 3 CHECK PASS, outputs byte-identical; two
    renders inspected.
    - finding-1 Verified: drop rows D1 to D20 per face with the whip moment on
    the port block; axial stacks A1 to A3; encoder thread A4, A5.
    - finding-6 (new, Minor): the rule 22 inner jam nut is not stacked.
    - finding-7 (new, Minor): the rule 21 admitted-plug definition n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
2026-09-27 docs(reviews): WP-PDR-07 INSP-038 iteration 3 re-issue 2, delta on run 5: finding-1 and finding-20 Verified, new Major finding-21 (session end SIGKILLs non-Wine processes in the bottle) and Minor fin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
    Reviewer re-run through the wrapper with CWHT_LTSPICE_INTEGRATION=1 and
    CWHT_LTSPICE_SLOW=1: 43 run, 42 passed, only the permitted skip; direct runs of
    the RC low-pass and step decks PASS; no process of the ltspice bottle and no
    LTspice.exe 10 s after the last run; CaptureAnalytics=false count 1 before and
    after every run. The finding-20 regression case fails on the b893382^ wrapper
    (64e1c723) and passes on the fix. The default suite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
2026-09-27 fix(ltspice): session end signals only Wine processes of the bundle, names each SIGKILLed PID, bystander cases (WP-PDR-07, INSP-038 finding-21)
    The step 5a session end SIGKILLed every process of the user whose current
    directory was in the bottle 5 s after wineserver -k, a non-Wine bystander
    as well, and still reported "no process of it left".
    - ltspice-batch.sh: a process belongs to the session only when its cwd is
    in the bottle (or its wineserver directory) and its executable name
    (ps comm, argv[0]) is a Windows .exe path or lies under the bundle
    (observed on the real CrossOver 25.0.1 session 2026-09-27: services.exe,
    winedevice.exe, plugplay.exe, svchost.exe, explorer.exe, rpcss.e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
2026-09-27 docs(design): WP-PDR-27 revision 2 of the shielding analysis and TS-011, the plug-inserted state, fixing INSP-083 finding-5 (Major) (re-freeze F0)
    INSP-083 iteration 2 finding-5: the rule O2 jack-collar below-cutoff
    credit does not hold with a plug inserted, the operating state.
    Shielding analysis revision 2 (docs/design/analysis/shielding-estimate.md,
    hardware/sim/enclosure/shielding_estimate.py):
    - port states empty and plugged (key and phones plugs, USB cable); the
    revision 1 rules plugged fail every source in every option (17.1 to
    17.2 dB at 1.5 GHz, aperture only; unfiltered jack lines unbounded);
    - rule O2 revised to bonded metal-nose jacks (gasket ring to the collar),
    new rule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
    [shielding-sources.csv]
2026-09-27 docs(cm): TV-014 run 6 at 45531ac passed after the INSP-038 finding-21 fix, ACC-LTSPICE-001 re-issued for wrapper blob 88b71475 (WP-PDR-07)
    Run 6 (2026-09-27 14:46:59 to 14:51, HEAD 45531ac, every identity
    unchanged from HEAD): part C 46 run, 45 passed, only the permitted skip,
    busy-lock case run, three new finding-21 cases passed; part D long path
    PASS; part E nothing in the bottle and no Wine process of the bundle 10 s
    after the last run, lock free; part F finding-20 case fails on the old
    launch line; part G (new) both bystander cases fail on blob bdc4513f.
    Key count 1 before and after every part.
    - TV-014: frozen identities (wrapper 88b71475, test module e90b0ef1,
    fixture tree f1497c52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
2026-09-27 docs(reviews): WP-PDR-27 INSP-083 iteration 3, delta on the finding-5 fix at 433a944: reviewer APPROVED, finding-5 Verified, new Minor finding-6; record verdict held for the CR-012 merge
    Delta iteration (rule C1) on the WP-PDR-27 revision 2 re-freeze: the
    plug-inserted state for both jacks and the USB cable, rule O2 revised
    to bonded metal-nose jacks, new rule O4 filtered jack lines, the plugged
    cases carried into PCR-9, TS-011 M5 and condition 3 and the TC-SYS-107
    writer. 12 cases checked, all Yes; checker CHECK PASS, outputs
    byte-identical; all 8 port-state combinations bounded by the all-plugged
    state. Finding-6 (Minor): stale revision references in the TS-011 M5 row
    and note section 1. C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
2026-09-27 Status note 2026-09-27 section 10: owner sets USD 200 target and USD 300 absolute maximum, sales tax excluded; owns 24 AWG magnet wire, 2 m SMA-male antenna, through-hole R and C, USB adapter
    Refs: TS-012
2026-09-27 docs(decisions): TS-012 revision 2 under the owner budget (USD 200 target, USD 300 maximum, sales tax excluded): all alternatives re-rolled, A5 hybrid H1 (RA07M1317M module PA, TCXO, diode ring) reco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
2026-09-27 docs(reviews): INSP-110 iteration 2, delta on TS-012 revision 2 at eca24fa: finding-1 to finding-3 (Major) and finding-4 to finding-10 Verified, finding-11 fixed in part; new Minor findings 12 to 16 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
2026-09-27 Status note 2026-09-27 section 11: no cells or charger owned; separate USD 300 cap on new equipment (owns NanoVNA, multimeter, BNC dummy load); owner keeps the full process for PDR
    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
2026-09-27 docs(decisions): TS-012 revision 3, INSP-110 iteration 2 liens and adversarial R-1, R-2 answered at no cost: VGG clamp 0.68 divider (3.47 V or less) with an open-loop check (finding-14); 10 ms relay 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
2026-09-27 docs(conops): CR-009 revision 2 of the prototype, INSP-002 finding-19 completed (R1-F1)
    ConOps revision 5 section 8: add the RSK-064 row (open or cold
    owner-soldered power-path joint, Assembly phase of the Off row of
    Table 3.4-5, OPS-012) and the RSK-065 row (a lent unit treated as outside
    the 47 CFR 15.23 personal-use exemption, OPS-006), the two operational
    risks of RSK-001 to RSK-065 that the table did not name. Status line and
    revision history row 5 name the change. No value, mode, transition,
    scenario or requirement changes.
    Checks on this branch: tools/traceability.py --root <worktree>
    --report-only exit 0 (245 requirements, 173 test cases, 0 violations,
    2 warnings SYS_UNALLOCATED REQ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
2026-09-27 docs(reviews): WP-PDR-41 INSP-103 iteration 2, software assurance delta of WP-SW-01 at rustos 58fe739: concurred INSP-097 finding-1 Verified (re-run, mutation check); assurance APPROVED; findings 1 a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
2026-09-27 docs(reviews): INSP-082 iteration 2 (delta, rule C1): TS-004 product set re-verified after board-outline.json drift 27dbacc7 -> d7977cf3; 9 hunks read, no new finding; APPROVED with 2 Minor liens
2026-09-27 docs(reviews): WP-PDR-41 INSP-102 iteration 2, software assurance delta on the INSP-096 finding-1 fix at rustos c6e5100: product_files set to the current 14 blobs; moved unsafe sites byte-identical, 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
2026-09-27 docs(reviews): INSP-084 iteration 3, drift delta on board-outline.json 9d4d36a9 to d7977cf3 (433a944): 2 hunks read, checkers pass, outputs byte-identical; new Minor finding-8 (O2 gasket ring not in 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
2026-09-27 docs(reviews): WP-PDR-27 INSP-081 iteration 3, delta on TS-011 revision 2 and board-outline.json revision 2 (433a944, INSP-083 finding-5): 13 hunks verified, reviewer APPROVED held; new Minor finding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
2026-09-27 docs(reviews): WP-PDR-41 INSP-104 iteration 2, software assurance delta at rustos 38434b2: INSP-098 finding-1 (CS-18) Verified under the assurance lens; new Minor finding-2 (CS-38: track_input decisi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
2026-09-27 docs(reviews): WP-PDR-17 INSP-037 iteration 3, drift delta on CR-010 ebce01d6 to ccd77640 (92b4fa4, section 6.3 round 2 appended): 1 hunk read, 7 claims checked, four branch blobs unchanged at 5cd87c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
2026-09-27 docs(reviews): WP-PDR-41 INSP-106 iteration 2, software assurance delta on the INSP-095 finding-1 fix at rustos 4a8e825: finding-1 Verified under the assurance lens (items j, k); assurance APPROVED; 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
2026-09-27 docs(reviews): WP-PDR-08 INSP-040 iteration 3, drift delta on toolchain.lock.md b45c8654 to e1c811b0 and tool-validation README 87fb1e8c to 7c90f143 (to 1db319a): 9 hunks read, no Rust row changed, 0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
2026-09-27 docs(reviews): TS-012 INSP-110 iteration 3, delta on revision 3 at d5a3058 (blob b1f03fad): finding-11, 12, 13, 15, 16 Verified; finding-14 fixed in part (0.68 VGG clamp assumes a 5.1 V LM2940 maximu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
2026-09-27 docs(reviews): WP-PDR-27 INSP-087 iteration 2, software assurance delta on the finding-1 fix at TS-011 revision 2 (8984c27b, 433a944; fix 70d11ef): sensing point, keep-outs, per-option K9 trip and th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
    Refs: TS-011, INSP-087, INSP-081, WP-PDR-27
2026-09-27 docs(cm): CR-007 section 6.3 impact review round 2 (CM lens), delta on IR-F1 at blob 22c4455f (revision 2, 96cb7b1): C17 before strings and insertion points checked on 07 blob bfe05f43, SWEHB swe-080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
2026-09-27 docs(reviews): WP-PDR-20 INSP-111, software assurance pair of INSP-056 for ADR-031, iteration 1: assurance verdict APPROVED, 0 Major, 6 Minor liens (rule C1); record verdict held for the INSP-056 pai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
    The paired SA record 07 section 2.1.1 requires for ADR-031 (INSP-056 X-6),
    on the INSP-056 iteration 3 blobs at 4153acf. Minor findings: ADR-031
    constraints on SW-PWR and SW-AUDIO not assessed (I2C rule R-4, GPIO23 R-2,
    PWM TOP); software part of HZ-008 K6 not traced or fed to the 03 re-run;
    repeated ROSC disable without the SELECTED prerequisite; clock_plan.py as a
    class B verification tool without a TV record; Refs trailers missing on
    802347b and 4153acf; no design A,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
2026-09-27 docs(cm): CR-009 impact review round 2 (section 6.3), delta re-check of the R1-F1 fix at branch 56b4bcd (conops.md@dfe50c4c)
    R1-F1 (Major) verified closed: the RSK-064 and RSK-065 rows of ConOps
    section 8 match register.json 0.6.0-pre-srr (RSK-064 S1, S2 and first
    trigger, HZ-007 C8 via RSK-007; RSK-065 S1 and both triggers), OPS-012
    step 3, Table 3.4-5 Off row and OPS-006; sections 1.2, 2, 3, 4 and 5 state
    the lien count and hunks correctly; traceability re-run exit 0, no
    RENDER_STALE. New Minor R2-F5: the RSK-065 row cites section 1.2 item 5
    and CON-008 for 'owned by the owner and lent, never transferred', which
    comes from ADR-025 section 4.4. R1-F2 to R1-F4 carried (rule C1).
    0 Major open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
2026-09-27 docs(reviews): WP-PDR-41 INSP-105 iteration 2, software assurance delta on the finding-1 fix at rustos 48e07ec (release asserts the PWM reset through the set alias first; PWM-6 covers restarts; ADR-0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
2026-09-27 docs(reviews): WP-PDR-33 INSP-075 iteration 2, software assurance delta on keyer host study revision 2 (8c12b5a): finding-1 and finding-2 (Major) Verified; new Major finding-6 (revision 2 reference i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
2026-09-27 docs(cm): CR-011 section 6.3 impact review round 2, delta re-check of IR-F1 at b636fc94 (main 0bbb1e2, branch 2b004b1 unchanged)
    Seven plain-run violation codes confirmed against the check catalogues of
    tool blobs 12de3545 and d4cde9f5 (TBR_DUE_AT_GATE gate-only). Trial numbers
    reproduced on main 9664775: CR-011 alone 0 violations, 96 warnings; CR-008
    208, 164 when Approved; CR-009 (56b4bcd) 5, 0 when Approved; CR-010, 012,
    013, 014, 015, 016 clean. IR-F1 (Major) closed. New Minor IR-F6 (T-22
    missing from the section 1 W list; L1 test-case scope wider than TC-SYS;
    section 4.1 heads for CR-009 and CR-014 stale). IR-F2 to IR-F5 open.
    Reviewer concurs with proceeding to disposition; CR stays Su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
2026-09-27 docs(decisions): TS-012 revision 4, INSP-110 iteration 3 liens and adversarial R-3, R-4 answered at no cost; ranking changes to A4 340, A5 335, presented together as closely ranked (Proposed)
    - finding-14: VGG clamp resized on the LM2940 4.75 to 5.25 V range (SNVS769J 6.5, re-read) and 1 % resistors: 0.654 divider, VGG 3.08 to 3.46 V; LDO range and dropout, resistor tolerance, op-amp headroom and module VGG current added to the WP-PDR-22 deck; low-end clamp carried into the REQ-SYS-012 check; no total changes (E2 assortment-gap allowance)
    - finding-17: A5 envelope-loop row (6) counted against U1 in 8.2 (no A4 counterpart)
    - finding-18: status note sections 11 and 13 applied; Q2 and Q4 closed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
2026-09-27 docs(design): WP-PDR-33 revision 3 of the keyer host study, Major fix of INSP-075 finding-6
    Keyer host study (INSP-075 iteration 2 finding-6, Major):
    - revision 2 gap rule (minimum reference interval, no lower bound) withdrawn;
    finding-6 reproduced: a 1 ms key-up glitch every 5 s defeats it on 12 of 12
    streams, and it misses 284 of 384 short-interval variants
    - revision 3 rule: 10 ms read-back glitch filter (key-up glitches bridged; key-down
    glitch pulses count for the window, are no element, and their interval is no
    reference) and r as the lower quartile of the clean key-up intervals of 10 s
    - short-interval variants (1 ms and 15 ms key-up breaks, 1 ms key-down pulses,
    shortened s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
2026-09-27 docs(reviews): WP-PDR-33 INSP-075 iteration 3, software assurance delta on keyer host study revision 3 (b4a75a1): finding-6 (Major) Verified (glitch filter and lower-quartile reference close the 1 ms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
2026-09-28 Status note 2026-09-28 section 2: owner multimeter Fluke 174 as stated; model and temperature input to confirm
    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
2026-09-28 Status note 2026-09-28 section 2: owner confirms Fluke 174 with temperature input; only a K-type probe is needed
    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
2026-09-28 Status note 2026-09-28 section 2: Fluke 174 confirmed by web search; temperature input to get its TV known-answer check
    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
2026-09-28 Status note 2026-09-28 section 2: Fluke 174 has no temperature input; stand-alone K-type thermometer added to the equipment list
    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
2026-09-28 sim(freq): TS-012 transmit clock spur plan, WP-PDR-20 pre-order item (run txspur-20260928-01)
    Every clock line from 118 to 175 MHz while transmitting, for finalists A4 and A5,
    at the GVA-84+ input and at the SMA after the gain and the harmonic LPF, against
    -61/-68 dBm (25 uW / 60 dBc). Plans: B0 (TS-012 rev 4 as written), B1 (ADR-031
    150 MHz), P (proposed C1 to C8, L1 to L5, F1, F3) and PB (P plus drive bandpass
    option C10). LTspice filter decks run through tools/ltspice-batch.sh; the C10
    bandpass passes its tolerance check with 2 % parts and fails with 5 % parts.
    Result (estimates, Low): B0 and B1 do not meet the TS-012 criterion (the /8
    prescaler products reach -0.4 dBm at the SMA at the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
    [lines.csv]
2026-09-28 docs(design): WP-PDR-33 revision 4 of the keyer host study, Major fix of INSP-075 finding-7
    Revision 3 rule withdrawn with its statements that a rare short interval no
    longer sets r and that short intervals every 5 s or more no longer defeat K4.
    Revision 4 adds a split filter: a key-down of 10 ms or more shorter than half
    the smaller of r and the lower quartile e of the key-down durations of 10 s is
    no element and its key-up interval is no reference (SPLIT_FRAC 0.5, REF_MIN_N
    4; watchdog_rev3 kept for comparison). Corpora P, B and S unchanged (no trip,
    16.94 s, count 50); 12 speed changes without a pause added (no trip, 7.24 s);
    fault catalogue stop times unchanged.
    Short-interval variants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
2026-09-28 analysis(thermal): WP-PDR-28 thermal model for the TS-012 finalists A4 and A5
    Lumped thermal RC network of the PA, the Boyd 530002B02500G sink and the
    owner-printed PETG case (hardware/sim/thermal/), run 2026-09-28-ts012-r1,
    analysis record docs/design/analysis/thermal-ts012.md. Boyd drawing and
    natural-convection curve read (TS-012 gate item 7): 3.8 K/W at 10 W before
    any derate, not 2.6; 1.57 mm web in a 17.02 mm channel; half the fins on each
    side of the web; 57 g. LTspice electrical analogue matches the solver to
    0.017 K (tools/ltspice-batch.sh).
    Estimates: neither finalist meets REQ-SYS-112 as written (continuous at
    45 C): A5 126 C, A4 123 C with the no-cost design changes. Both hold 1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
    [duty_sweep.csv, inputs.csv, summary.csv, tornado.csv]
2026-09-28 sim(tx-pa): WP-PDR-21 PA drive window and output power for TS-012 finalists A4 and A5
    LTspice (through tools/ltspice-batch.sh, ACC-LTSPICE-001) behavioural decks for the drive chain
    (Si5351 CLK1 trapezoid source at 25/50 ohm, drive LPF, pads, GVA-84+ Rapp model fitted to its P1dB
    and Psat, 270 corners each) and for the power path (pack 6.4 to 8.4 V, drain feed, bus load,
    key-down sag solved; RA07M1317M and AFT05MS004N from digitized datasheet curves; 648 and 1458 corners).
    Results, plots with requirement lines, .log and .raw under hardware/sim/tx-pa/results/2026-09-28-*;
    analysis record docs/design/analysis/pa-drive-ts012.md.
    A5: module input 6.0 to 29.5 mW, FAIL on the 10 to 30 mW window (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
    [aft05_pout_vs_pin_135.csv, aft05_pout_vs_pin_155.csv, ra07_pout_vs_pin_135.csv, ra07_pout_vs_pin_155.csv, ra07_pout_vs_vdd_135.csv, ra07_pout_vs_vdd_155.csv, ra07_pout_vs_vgg_135.csv, ra07_pout_vs_vgg_155.csv]
2026-09-28 review(PDR): INSP-075 iteration 3 re-issue 1, fourth pass on the keyer host study: finding-7 Verified, new Major finding-8
    Delta on revision 4 (7fe558a), finding-7 only (rule C1). Checker re-run from
    git archive: 571 PASS, exit 0, outputs byte-identical. The 30 finding-7 streams
    are stopped by 30.24 s, reproduced with independent insertion code. The
    statements are withdrawn and class (3) is restated.
    New finding-8 (Major): the split filter threshold depends on the key-down lower
    quartile e, so it hides the regular short element of a periodic fault stream in
    some cycles and not in others, which breaks the (i-b) run. Of 1500 random
    periodic cycles, 17 that revision 3 stops escape K4 (the curr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
2026-09-28 analysis(tx-lpf): WP-PDR-21 harmonic LPF LTspice runs r1 to r7 and the TS-012 harmonic budget
    LTspice AC (tools/ltspice-batch.sh, ACC-LTSPICE-001) of the TS-012 7-pole 0.1 dB Chebyshev
    (fc 165 MHz) with Coilcraft 1812SMS (Doc 184-1 Q and SRF) and 24 AWG air coils, 1206 C0G ESR/ESL,
    via, pad, coupling and leakage parasitics; 252-step Monte Carlo per build; known answer against
    the analytic Chebyshev (0.0005 dB) and log/raw cross-checks pass.
    Findings: stopband passes every build (2f worst 43.8 dB, 3f 68.0 dB, 576 MHz-1.5 GHz 65.8 dB);
    the 0.5 dB passband-loss goal fails at worst case in every build (BOM 1812SMS median 0.76,
    worst 1.21 dB). Retuned caps 18/33 pF with the same coils: median 0.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
    [mc_values.csv]
2026-09-28 analysis(spurs): revision 1 of the TS-012 transmit spur plan, Major fixes of review finding-1 and finding-2 (run txspur-20260928-02)
    Finding-1: the TS-012 7.3 criterion is now reported in the numbers and by
    wording, never as PASS while residual lines remain. The checker separates
    credited changes from named-only changes, lists the residual lines in
    results.json and lines.csv, and exits 1 on residual lines. PB: 6 to 8 lines
    over 60 dBc, 3 over 25 uW; P: 10 to 12 and 4. T1 sized in LTspice
    (tx_spur_trap.cir): no size reaches 11.0 dB relative suppression at
    147.990 MHz (best 9.2 dB), so T1 is withdrawn as the fallback; the residual
    lines are carried into section 8 for the order decision.
    Findi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
    [lines.csv]
2026-09-28 sim(tx-keying): WP-PDR-22 keying envelope and key-click analysis of the TS-012 finalists A4 and A5
    LTspice transients (through tools/ltspice-batch.sh, ACC-LTSPICE-001) of the ALC detector at 146 MHz
    and of the keying envelope loop of each finalist, with the FFT of the RF envelope and the key-up level.
    The loop as TS-012 revision 4 section 7.3 describes it fails REQ-SYS-014, REQ-SYS-015 (3 ms setting),
    REQ-TX-005, REQ-TX-006 and REQ-TX-014 for both finalists (A5 worse: 542 Hz, -48.3 dB, +9.9 dBm at the
    drive gate; A4 417 Hz, -49.8 dB, +2.5 dBm): PA dead zone, detector blind below -22 dB, windup at the
    low pack end, drive gated onto a non-zero tail. With a feedforward VGG table, a bipolar trim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
    [det_law.csv, result.csv]
2026-09-28 docs(analysis): TS-012 receiver BPF, image, half-IF and cascade (WP-PDR-19 pre-order item)
    LTspice runs through tools/ltspice-batch.sh (ACC-LTSPICE-001) under hardware/sim/rx-frontend/
    (r01 to r05) and a Python cascade (r06), with the analysis record docs/design/analysis/rx-bpf-ts012.md.
    - TS-012 BPF1 2 + BPF2 3 resonators at IF 8 MHz: image rejection 51 to 61 dB nominal at coil Q 100
    to 200, 39 dB Monte Carlo minimum: fails REQ-SYS-033 (70 dB); the TS-012 90 dB / 3 dB criterion is
    unattainable (adversarial check confirmed).
    - Adding BPF3 (3 resonators, copy of BPF2) before the mixer: 86 dB nominal at Q 100; Monte Carlo
    minimum 70.6 dB (TS-012 20 % capacitors) and 78.1 dB (proposed C0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
2026-09-29 analysis(thermal): revision 1 of the TS-012 thermal note, INSP-112 Major fixes (run 2026-09-28-ts012-r2)
    - finding-1: A4-DC long-session cells 55.2 C reported as FAIL by 0.2 K; every verdict carries an RSS
    band from a tornado on all four layouts; PASS / OPEN / FAIL, where OPEN is a nominal pass inside its
    band; section 5 sorts the box verdicts by margin against band and restates the reading on the heat.
    - finding-2: 45 builder values moved into P with class, source and range; 86 ranged inputs swept over
    18 metrics. Author-found defect fixed: PETG and FR4 wall heat capacities were 1000x too small.
    - finding-3: --check compares the note's verdict-set block with the computed set and the L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
    [bands.csv, duty_sweep.csv, inhibit.csv, inputs.csv, levers.csv, summary.csv, tornado.csv, trips.csv]
2026-09-29 analysis(tx-pa): WP-PDR-21 PA drive note revision 1, review Major findings 1 and 2, Minor finding 3
    Finding-1: the CLK1-to-drive-LPF interface is modelled as TS-012 section 8.1 lays
    it out (7 pF lumped on the pin, 50 ohm coax 5 to 15 cm to the RF board). New runs:
    d2/d3 810 corners each, d4 coax-length bound over every electrical length plus a
    10 ps time-step check (PASS), d5 design-request option (6 dB pad at the pin end).
    A5 fixed-pad drive 5.4 to 35.5 mW (48.6 mW at the worst length): "overdrive is
    designed out" withdrawn. Select-on-test pad 11.0 to 27.2 mW, overdrive margin
    +0.42 dB worst-case sum (+1.22 dB RSS), pad set 13 to 22 dB. CLK1 pin load: 7 pF
    lumped, 13.6 to 24.7 pF equivalent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
2026-09-29 review(PDR): INSP-114 iteration 2, delta on the TS-012 PA drive note revision 1 (9d01aaf)
    - finding-1 (Major) Verified: CLK1 lumped load 7 pF, line-fed 13.6 to 24.7 pF routed as
    DR-PAD-1 with the d5 option; coax bounded over every length (48.6 mW, -2.10 dB); "designed
    out" withdrawn. Reviewer phasor model within 0.02 dB of every A5 step; 3f holds at any length.
    - finding-2 (Major) Verified: seven temperature cases, P28A-sourced cold feed, WP-PDR-28 hot
    case, C2, C3, C8 carry temperature; reviewer re-solve within 0.015 W.
    - finding-9 (new, Major) Open: the 25 C ambient case takes the PA case at 25 C while the hot
    cases take steady self-heating; with the note's own 6.1 K/W the 25 C lev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
2026-09-29 analysis(tx-lpf): revision 2 of the TS-012 harmonic LPF analysis, fixes of review findings 1 to 5 (runs r8 to r16)
    - finding-1 (Major): worst case is now a corner search over the whole parameter box
    (worst_case.py, nodal model lpf_nodal.py checked against LTspice to 1.7e-4 dB), every
    corner run in LTspice beside a Monte Carlo with signed coil coupling (r8 to r14).
    Worst-case loss 1.24 to 5.34 dB: no build meets 0.5 dB, the 0.75 dB proposal and the
    18/33 pF retune are withdrawn (retune fails REQ-TX-009 at 38.3 dB). Two-via rule stated
    as the lowest-2f corner.
    - finding-2 (Major): REQ-TX-009/010/011 allocation per finalist (A4 45/40/40, A5 43/35/40).
    - finding-3 (Major): budget r15 c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
    [mc_values.csv]
2026-09-29 cr(CR-007): revision 3, fix SA-F1 and SA-F2 under the owner's option B condition
    SA-F1: 07 section 2.1.1 change-request dispatch gains objective triggers
    (rustos pin, toolchain lock, Cargo.lock and dependency set, release and
    gate tooling, Cybersecurity field not None, ICDs with a software side and
    the hardware of their other side, Table 4-1 row 25 map paths).
    SA-F2: hold points on disposition, merge and release approval, and the
    route of a non-concurrence to the owner (C17 (g)); 05 and the CR template
    cite 07 section 2.1.1 as the single rule. Changed: C7, C9, C12, C15 (a),
    C17 (a) to (g), section 4 rows, section 5 step 1, verification paragraph,
    new section 6.5, Q4, section 11 row. SA-F3 to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
2026-09-29 analysis(keying): revision 1 of the TS-012 keying note, Major findings 1 to 3 (runs 2026-09-28-r1-*)
    finding-1: every keying check now runs at the 0.5, 1, 2 and 5 W steps and the
    6.4, 7.4 and 8.4 V packs; the reviewer's 0.5 W numbers are reproduced.
    finding-2: sourced threshold budget (VGS(th) spread, drive via the Figure 12
    shift, die temperature, table reads; four cases), A5 table from the digitized
    curves, VSH sweep with interpolated windows instead of the +/-0.1 V corner.
    finding-3: keying_run.py asserts REQ-TX-005 (+/-10 %) and TC-SYS-013
    (+/-0.5 ms) separately on every element 3 to 8 and on element 1.
    Result: revision 0's mitigated design fails at 0.5 W (window A5 -0.053 to
    +0.067 V,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
    [result.csv]
2026-09-29 review(CR-007): delta impact review of revision 3, CM lens, iteration 1 (section 6.6)
    Delta on blob ff0a1384 (525d018) against revision 2 (c22b0f56 at 584f361),
    05 blob f8de2081, 07 blob bfe05f43. SA-F1 and SA-F2 Verified; IR-F8 Verified
    by the SA-F2 rewrite. Nothing outside SA-F1 and SA-F2 changed; Class II and
    the section 4 fields hold; CR-010 and CR-013 07 hunks still disjoint.
    Concur with comments: 0 Major, 4 Minor new (DR-F1 undefined routing actor,
    DR-F2 hold (2) blocks closure of a Rejected or no-artifact waiver CR, DR-F3
    trigger (4) exception timing and summaries, DR-F4 step 5a names (a) to (f)),
    fixed at section 5 step 3. Software assurance delta review still pending.
    validate_docs: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
2026-09-29 review(CR-007): delta impact review of revision 3, software assurance, iteration 1 (section 6.7)
    SA-F1 and SA-F2 Verified against SWEHB swe-080 section 7.1 tasks 1 and 2
    and 07 section 16.2; 07 section 2.1.1 stays the single dispatch rule.
    Concur with comments: 0 Major, 3 Minor new (SA3-F1 deny.toml missing from
    trigger (1); SA3-F2 ICD-CTL-USB and ICD-CTL-KEY routed only by the
    Cybersecurity field; SA3-F3 trigger (4) matches paths against design_refs,
    which hold no hardware file paths), fixed at section 5 step 3. With section
    6.6 the delta impact review is complete on both lenses.
    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
2026-09-29 analysis(rx-bpf): revision 2 of the TS-012 receiver BPF note, review findings 1 to 5 (runs r07 to r11)
    - finding-1: worst-case tolerance corners (vertex search, interior check, LTspice re-simulation) and
    20,000-run Monte Carlo (r08). Mode A fails for some builds (0.32 %, corner 49.1 dB); mode B and
    re-alignment made conditions of BPF3; Monte Carlo acceptance defined with N and a 95 % bound.
    - finding-2: 50 ohm ports stated as a J310 design input (VSWR 1.2); MMBFJ310 port admittances from
    the datasheet modelled (r09): bare ports drop the mode B corner to 68.0 dB.
    - finding-3: TPM-005 named; REQ-SYS-022 not shown at the TC-SYS-017 corner (-138.0 dBm); TPM-005
    Yellow on the CBE, Red at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
2026-09-29 review(PDR): INSP-115 iteration 2, delta on the TS-012 harmonic LPF analysis revision 2 (92e3805)
    - finding-1, finding-2, finding-3 (Major) Verified: searched LTspice corners reproduced by a
    second search method; per-finalist A(nf) - IL(f) allocation; 6.4, 7.2 and 8.4 V cases.
    - finding-4, finding-5 (Minor) Verified; finding-6 to finding-9 Open.
    - New Minor finding-10 (loss corner mixes board states; board-consistent r13 1.34 to 1.62 dB)
    and finding-11 (harmonic_bands_wc.png plots A against A - IL needs).
    - Reviewer verdict APPROVED (rule C1, six Minor liens due at CDR readiness); record verdict
    held at NEEDS CHANGES while the analysis template is only on cr/CR-012.
    - Re-run exit 1 as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
2026-09-29 review(PDR): INSP-116 iteration 2, delta on the TS-012 keying note revision 1 (e9f1440)
    - finding-1 (Major) Verified: 0.5, 1, 2, 5 W and 6.4, 7.4, 8.4 V in every keying check;
    iteration 1 numbers reproduced and now flagged; +7 dB tap and held trim; loop margin
    58.4 degrees minimum; element 2 (not in the checker) also passes (reviewer).
    - finding-2 (Major) Verified: sourced or labelled four-case threshold budget, every total
    recomputed; A5 on the digitized curves; windows against budgets, edges within 0.005 V of a
    0.01 V reviewer sweep at every pack.
    - finding-3 (Major) Verified for part a (REQ-TX-005 asserted separately from TC-SYS-013);
    parts b (exit 0 on FAIL) and c (unsourced se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
2026-09-29 analysis(tx-pa): WP-PDR-21 PA drive note revision 2, review iteration 2 finding-9 (Major), findings 3 to 8 and 10, cross items X-4 to X-6
    - finding-9 (Major): one thermal state per question. Every low-bound case is steady
    key-down: the PA case is solved in the deck from the dissipation (A5 6.11 K/W, A4
    9.6 K/W, WP-PDR-28) and checked against the thermal law (7.6e-6 K); feed parts and the
    LPF copper term at their key-down temperatures. 25 C key-down puts the A5 lever-corner
    case at 57 to 60 C. "Closable at 25 C" withdrawn: with C2 and C3 the A5 lowest corner
    is -0.17 to -1.21 dB at 6.4 V in every key-down case at the LPF median.
    - finding-3: VGG 3.08 / 3.27 / 3.46 V (revision-4 clam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
2026-09-29 analysis(rx-bpf): revision 3 of the TS-012 receiver BPF note, review iteration 2 finding-6 (Major), run r12
    The re-alignment residual limit is re-derived at the design-input corner (mode B,
    aligned at 50 ohm, VSWR 1.2 ports, 0.03 pF per section, worst-phase bound).
    Run r12 sweeps the residual +/-0.05 to +/-1.5 % at the 50 ohm, VSWR 1.2 and
    design-input corners and bisects the residual that holds REQ-SYS-033 70 dB:
    2+3+3 +/-0.32 % (0.3222 %), 2+3+2 at IF 10 +/-0.68 %, 2+3+4 +/-0.97 %.
    Slope at the +/-0.3 % estimate 0.87 dB per 0.1 % (2+3+3), so the 0.2 dB margin
    is 0.02 % of residual headroom. Revision 2's +/-0.75 % is withdrawn (65.96 dB
    FAIL at the design-input corner). Reviewer values repr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
2026-09-29 sim(tx-keying): revision 2 of the TS-012 keying note, INSP-116 finding-10 to 14 (runs 2026-09-28-r2-*)
    finding-10 (Major): section 4.6 restated from the revision 2 summary.json:
    A5 feedforward PWM sidebands -40.6 / -58.1 / -76.1 dBc at 30.5 / 61 / 122 kHz
    (slope 59.2 V/V against A4 20.6 V/V, ratio 2.9); 61 kHz fails REQ-TX-006 for
    A5 by 1.9 dB (revision 1 said marginal). 4.4.3 bullet and README row fixed;
    pwm_ripple.png prints each value with its margin. Design rule unchanged.
    finding-11: every stage compares its FAIL states with expected_states.json and
    exits 3 on a difference (summary also on the 122 kHz and 45 degree rules);
    --accept refuses a FAIL of a criterion the design must pass; set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
    [result.csv]
2026-09-29 review(PDR): INSP-114 iteration 3, delta on the TS-012 PA drive note revision 2 (5199c5c)
    - finding-9 (Major) Verified: every low-bound case is steady key-down with the PA
    case solved from the dissipation (A5 6.11 K/W, A4 9.6 K/W, re-read at WP-PDR-28);
    72 section 4.4 figures reproduced within 0.016 W by an independent solve.
    - Minor findings 3 to 8 and 10 Verified; new Minor finding-11 (two wording items).
    - LTspice re-run through the wrapper: run_pa.py all exit 1, --expect exit 0,
    61 of 61 outputs identical; 11 revision 2 plots opened.
    - Reviewer APPROVED; record verdict held at NEEDS CHANGES (analysis template only
    on cr/CR-012). No figure TS-012 revision 5 relies on changes (C5,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
2026-09-29 review(PDR): INSP-116 iteration 3, delta on the TS-012 keying note revision 2 (be86c02)
    finding-10 (Major) Verified: section 4.6 restated from the checker (A5
    -40.6 / -58.1 / -76.1 dBc, A4 -49.8 / -67.3 / -85.3 dBc; reviewer hand
    recomputation -58.15 dBc); 61 kHz fails for A5; 59.2 against 20.6 V/V;
    README and pwm_ripple.png agree; summary asserts the 122 kHz rule.
    finding-11 to 14 (Minor) Verified: exit 3 on unexpected FAIL states (two
    reviewer negative checks), per-finalist thermal budget terms recomputed,
    sens variant reproduced, per-element capture with data-sheet leakage.
    New Minor finding-15: the A5 slope is one 0.02 V digitized segment
    (52 to 57 V/V over 0.04 to 0.10 V; 61 kHz excess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
2026-09-29 review(PDR): INSP-117 iteration 3, delta on the TS-012 receiver BPF note revision 3 (a82f21b)
    finding-11 (iteration 2 label finding-6, Major) Verified: residual limit +/-0.32 %
    re-derived at the design-input corner; r12 re-run through tools/ltspice-batch.sh
    reproduces decks, prepare.json, result.json, result.md and both plots (18 LTspice
    cases, 3.6e-4 dB). Finding numbering reconciled (iteration 2 labels 6 to 9 become
    finding-11 to 14; iteration 1 Minors 6 to 10 kept as liens); counts corrected.
    finding-7 (REQ-SYS-114 temperature, never relayed) re-classified Major: a C0G drift
    inside its +/-30 ppm/K class takes 2 + 3 + 3 to 69.93 to 69.75 dB at the +/-0.3 %
    estimate, so its image pass is no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
2026-09-29 review(PDR): file INSP-118, software assurance pair of INSP-110 on TS-012 revision 5 (iteration 1)
    The software assurance pair of the TS-012 review was never dispatched
    (INSP-110 cross items X-2, X-5, X-9, X-12). It ran now on revision 5
    (37d5824). Verdict NEEDS CHANGES, rule C1 iteration 1: 3 Major, 5 Minor.
    - finding-1: the REQ-SYS-182 frequency budget contradicts
    frequency-budget.md. A4 needs the TCXO (AB2) or a REQ-SYS-182/154 delta.
    - finding-2: the REQ-SYS-181 sink cut-off never acts for A4 at 45 C.
    NTC-2 goes on the tab, and the AFT05 junction rating must be read.
    - finding-3: no PA_EN permit is named. D-11 ties the REQ-SYS-120 second
    condition to TX_KEY (INSP-110 finding-23 rai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
2026-09-29 cr(CR-017): CM-lens impact review round 1 of revision 1 (section 6.2)
    Independent reviewer (CM lens), separate invocation. Before quotes and
    facts-table numbers reproduced; Class II concurred. Do not concur with
    disposition until CM-F1 (run-folder "never rewritten" rule not in option A,
    contradicted by 9 folders changed in place on 2026-09-28) and CM-F2
    (Verification row and steps 8 and 9 miss records pinning the changed
    05, 04 and 08 blobs) are resolved. 5 Minor (CM-F3 to CM-F7).
    Refs: CR-017
2026-09-29 Status note 2026-09-29 sections 2 and 3: owner authorizes INSP-117 iteration 4 and TS-012 revision 6; manifest wording corrected
    Owner statement, verbatim: "Yes both recs sound good".
    - INSP-117 iteration 4: the receiver BPF note adopts 2+3+4 and analyses
    REQ-SYS-114 over temperature.
    - TS-012 revision 6 folds in the three INSP-118 Majors, with INSP-110
    iteration 3 re-issue 2 and INSP-118 iteration 2 before the owner's
    A4 or A5 choice.
    Section 3 corrects the section 1 claim about the raw.sha256 manifest:
    it identifies a kept file, but cannot show a re-run identical (CR-017).
2026-09-29 cr(CR-017): revision 2, fixes of the Major impact review findings CM-F1, CM-F2, SA-F1 and SA-F2 (section 6.3)
    Narrows the run-folder rule to kept files and their manifest entries,
    makes it prospective with the 2026-09-28 in-place changes named, and
    asks the owner as Q8 (CM-F1). A lost kept file is re-run only as a new
    run id (SA-F1). Adds review-time simulation output checks in C2 with a
    matching 08 section 3.2 reviewer bullet, and a case-insensitive hook
    match (SA-F2). Lists every record that names a changed blob and orders
    steps 8, 9 and 9a around the expected drift of INSP-006, INSP-030,
    INSP-021 and INSP-022 (CM-F2). Minor findings stay open (rule C1).
    Refs: CR-017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
2026-09-29 cr(CR-017): software assurance impact review round 2 of revision 2 (section 6.4)
    Delta round on e802c6f. SA-F1 and SA-F2 (Major, round 1) closed: check 1
    of "Simulation output checks" run as written (exit 0, 0 rows; 49 without
    ^f9e6dd1; bad range exit 128) and seeded against a merged upper-case .RAW.
    New Minor SA-F7 (check 1 misses older large blobs at new paths and blobs
    first listed under docs/vv/) and SA-F8 (check 3 cannot exit 0 after a
    loss handled by the SA-F1 rule; no carrier). Concur with comments with
    the disposition from the software assurance lens. History row appended.
    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
2026-09-29 cr(CR-017): CM-lens impact review round 2 of revision 2 (section 6.5)
    Delta round on e802c6f, read again at e71de45. CM-F1 and CM-F2 (Major,
    round 1) closed. The narrowed run-folder rule is prospective and defines
    a rewrite; the 2026-09-28 in-place fixes need no correction. The
    Verification row matches a named_blobs parse of every record. Before
    quotes, facts numbers, hunk clearance and check 1 reproduced; Class II
    concurred. Concur with comments; 0 Major open; new Minor CM-F8 to
    CM-F10.
    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
2026-09-29 cr(CR-017): Assessed, both round 2 impact reviews concur with no Major open
    Section 6.4 (software assurance, e71de45) and section 6.5 (CM lens,
    6cb6f38) both concur with comments on revision 2. The Minor findings
    are carried to implementation. The CR is ready for the owner's
    disposition with the section 12 questions Q1 to Q8.
    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
2026-09-29 docs(TS-012): revision 6, INSP-118 Majors 1 to 3, INSP-110 finding-19 and 20, INSP-114 X-7
    Owner authorization: status note 2026-09-29 section 2 ("Yes both recs
    sound good").
    - REQ-SYS-182 and 154 re-budgeted on the reviewed frequency-budget.md
    method (65 ppm XOSC, FC0 accuracy, d < T and T + d <= 10 kHz, routes
    R1 and R3): route R3 for both finalists, T = 5.0 kHz, d 4518 Hz,
    margin 482 Hz. The TCXO is a required A4 item (D-17) with its cost in
    the roll-ups; the frequency check ends at t0 + 7 ms, before PA_EN.
    - REQ-SYS-181 for A4 on NTC-2 at the tab copper; AFT05MS004N Rev. 0
    read (TJ max 150 C, page 2 Table 1): trip junction 123.9 C nominal,
    141.6 C all-adverse; no value delta,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
2026-09-29 analysis(WP-PDR-19): receiver BPF note revision 4, REQ-SYS-114 temperature (INSP-117 finding-7); adopt 2+3+4 at IF 8 MHz
    Fixes the open Major finding-7 of INSP-117 iteration 3 (e647ab1) on the owner's
    authorization of the fourth iteration (status-2026-09-29.md section 2). Only
    finding-7 is fixed (rule C1); the Minor findings stay as liens.
    Run 2026-09-29-r13-bpf-temperature (worst_case.py prepare/check r13, LTspice through
    tools/ltspice-batch.sh, three decks PASS, 22 cases agree with numpy to 3.6e-4 dB):
    design-input corner over REQ-SYS-114 after a 20 to 30 C alignment, board -10 C to +70 C
    (thermal note V18 main-bay air), C0G 0 +/- 30 ppm/K (KEMET C1003_C0G) plus 10 ppm/K
    stray, coils +5 t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
2026-09-29 review(INSP-117): iteration 3 re-issue 1 (fourth iteration) on rx-bpf note revision 4; finding-7 Verified, reviewer APPROVED
    Owner-authorized fourth iteration (status-2026-09-29.md section 2), recorded as
    Iteration 3 re-issue 1 (schema maximum 3). Delta on note revision 4 at 63122e7.
    - r13 re-run from a git archive export: prepare, run_sims through
    tools/ltspice-batch.sh (3 decks PASS), check r13 exit 0; decks, prepare.json,
    result.json, result.md and both plots identical; 22 LTspice cases agree to
    3.6e-4 dB.
    - Temperature inputs re-read: KEMET C1003_C0G (+/-30 ppm/C), Coilcraft 184-1 TCL
    (+5 to +70 ppm/C), thermal note V18 (67.4 C), REQ-SYS-114.
    - finding-7 (Major) Verified: 2+3+4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
2026-09-29 review(INSP-118): iteration 2 on TS-012 revision 6; finding-1 to 3 Verified, assurance APPROVED
    Delta on TS-012 revision 6 (3b93de1, blob 0c9fcb96), owner authorization
    status note 2026-09-29 section 2.
    - finding-1 Verified: route R3 re-run from freq_budget.py (d 4518 Hz,
    margin 482 Hz, R1 limits 16.1 / 27.7 kHz); TCXO required in A4 (D-17);
    check done at t0 + 7 ms before PA_EN (1 ms relock allocation open,
    fails safe).
    - finding-2 Verified: AFT05MS004N Rev. 0 read by the reviewer (TJ max
    150 C, RthJC 4.4 C/W); tab trip junction 123.9 / 141.6 C from
    inhibit.csv.
    - finding-3 Verified: PA_EN and the D-18 NAND; D-11 restated; the
    REQ-TX-014 HZ-004 note is sound.
    - New Minor finding-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
2026-09-29 review(INSP-110): iteration 3 re-issue 2 on TS-012 revision 6 (3b93de1); reviewer APPROVED
    sound good"). Delta on blob 0c9fcb96.
    - INSP-118 finding-1 to 3 fixes verified as carried in the study: route R3
    figures reproduced from freq_budget.py; AFT05 150 C and 4.4 C/W read from
    the same datasheet file; tab trip junction 123.9 / 141.6 C reproduced from
    inhibit.csv; PA_EN and NAND logic checked.
    - finding-19, 20, 23 Verified; 21, 22 stay liens.
    - Roll-ups, totals (A2 305, A4 + U3 300, A4 285, A5 270), 16 x 2 weight runs,
    Low-cell combinations and joint cases reproduced; Not robust correct.
    - New Minor liens: finding-2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
2026-09-29 research: A5 parts lifecycle check, 39 of 39 parts Active (2026-09-29)
    This answers the owner's condition "if it doesn't use outdated
    components" (status-2026-09-29.md section 4). Four research agents read
    maker and distributor status pages for every part in the A5 bill of
    materials (TS-012 revision 6 section 8.3, the other-seller lines, E1,
    and the E5 logic parts). No part needed the second-look verification.
    Ordering note: buy the 2N3904 as 2N3904BU. Two stale seller listings
    conflict with their makers; the makers were taken as authoritative.
    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
2026-09-29 Status note 2026-09-29 section 5: owner chooses A5 as the hand-built design (TS-012 Q1)
    Owner statement, verbatim: "A5". The owner chose after the lifecycle
    check found all 39 A5 parts Active (f193784). A5 keeps the TS-012
    ordering-gate condition: order only if the rechecked worst case is
    USD 300 or less. Its open thermal items and the requirement deltas go to
    the re-baseline CR and the PDR design work.
    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
2026-09-29 docs(CR-017): implementation record, section 5 steps 3 to 8, status Implemented
    Records steps 3 to 8 of CR-017 in section 5 (Done cells) and section 8:
    branch cr/CR-017-simulation-output-retention from 6497900 with 29f13f3
    (05 C1 to C4), f49ef82 (08 C5), a7044ad (04 C6) and a87e5ae (.gitignore
    C7), each with CR: CR-017; the Minor findings fixed at the implementation;
    the local hook H1 (SHA-256 bdb6bde5...8255) and its seeded checks; the
    trial merge 095c1c4 (discarded), which fails exactly the expected drift
    set INSP-006, INSP-030, INSP-021 and INSP-022, with no new unit-test
    failure, 0 traceability violations and no RID from checks 1 and 2. The
    facts row "In-place changes" gains the step 8 r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
2026-09-29 docs(plan): PDR work plan revision 3, re-planned for A5 and paced against the weekly usage limit
    The owner chose TS-012 finalist A5 on 2026-09-29 (status note section 5).
    Revision 3 marks every work package done, changed for A5, new or dropped
    (section 3.0), adds WP-PDR-53 (re-baseline CR-018), 54 (A5 ADR and TS-012
    re-issue) and 55 (merge train CR-007 to CR-017), drops the PCBWay, vendor
    quote and LCD items, and cuts the owner sessions from six to three (S1 A5
    baseline Thu 10-01, S2 values and safety Tue 10-06, S3 readiness Thu 10-08)
    plus a bench session and the review. Rule C12 paces the work against the
    weekly usage limit (54 % used, reset 2026-10-04 03:00 CDT, 10 % reserve):
    pause at 90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
2026-09-29 docs(plan): PDR work plan revision 4, the three Major findings of the revision 3 review fixed
    MAJOR-1: WP-PDR-20 and 23 split; 20a (route R3 budget, Si5351A relock
    time, TCXO ratio freshness, clk_sys and ADR-031) and 23a (key-down and
    key-up sequence criteria, D-5 hold, ICD-TX-SW timing table) reach
    APPROVED in week 1 before 32 and 36a use them; section 4.1 dependency
    waiver table for 31, 32, 36a, 34, 35, 37; new WP-PDR-56 reconciliation
    stage after the analyses; rule C11 loop 28a -> 27 -> 28b restored;
    graph redrawn.
    MAJOR-2: new section 3.0a gives every trade study a disposition and a
    session: TS-001, TS-007 superseded; TS-003, 006, 008, 009, 010 not
    written (TS-012 and the A5 ADR decide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
2026-09-29 editorial(docs): refer to the owner without gendered pronouns in PDR-phase documents
    The owner's pronouns are not stated, so the documents now say "the
    owner" or "they". The change is wording only, with no change in meaning.
    It covers TS-012, the PDR work plan, CR-017, the spur note and three
    review records. Quoted regulatory and third-party text stays as quoted.
    The same fix in the baselined 01, 02, expectations and template files
    waits for the CRs that already change those files.
    Refs: TS-012, CR-017, INSP-110, INSP-113
    Editorial: pronoun wording only
2026-09-29 docs(plan): PDR work plan revision 5, the three new Major findings of the revision 4 delta review fixed
    NEW-MAJOR-A: 36a and 16a are drafted on the F0 texts of 31 and 32 under a
    stated drafting waiver, and frozen and reviewed only on the APPROVED
    architecture in the new step 6 (Tue 10-06).
    NEW-MAJOR-B: the reconciliation chain (56, 16b with the rule C11 pass, 17,
    45 and the S2 sheet) is costed on the plan's own assumptions as step 8,
    sub-steps 8a to 8e, 4.0 days instead of 1.5.
    NEW-MAJOR-C: PCR-7 has one session, S2; S1 decides the OD-15 route only.
    Chain 17.5 days to readiness Sat 10-17; PDR about Mon 10-19 (range
    Sun 10-18 to Wed 10-21); S2 Mon 10-12 PM, S3 Sat 10-17 AM; 278 invocations.
    M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
2026-09-29 docs(plan): PDR work plan revision 6, WP-PDR-29 and 40 records reviewed before S2
    The delta review of revision 5 left one part of MAJOR-1 open: the
    WP-PDR-29 budgets and TPMs records and the WP-PDR-40 bounce-capture,
    HIL and HSI records were reviewed only in W-D, after S2 ruled their
    values (rule C10). Revision 6 reviews 29 beside steps 8c and 8d
    (APPROVED Sun 10-11 PM) and 40 on Wed 10-07 to Thu 10-08 (APPROVED
    Thu 10-08 PM), splits the section 4.1 row for 29 and 38, and removes
    both reviews from W-D. Dates, chain and the 278-invocation estimate
    are unchanged.
    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
2026-09-29 docs(pdr): owner action pack revision 2 for A5, price-check list and equipment list (WP-PDR-04)
    Re-issues the owner action pack for design A5. Withdraws the PCBWay,
    Inrad, KVG, Guerrilla RF and st.com items (no quote is requested from
    anyone). Adds the browser price-check list of TS-012 section 8.11 with
    the section 8.4 ordering-gate reads (Mouser rows and cart, RF Parts
    RA07M1317M-501, JLCPCB quote with duty, 18650BatteryStore cart; no
    checkout) and the A5 equipment list inside the owner's USD 300
    equipment cap (owned items; K-type thermometer, SMA-to-BNC adapters,
    tinySA Ultra later, the BF-F8HP pad; priority order and running total).
    Both can be done now, per the owner's direction of 2026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
2026-09-29 docs(TS-012): revision 8, re-issue sections 8.1 to 8.12 for A5 with the finding-26 receiver figures
    WP-PDR-54 part 2. Sections 8.1 to 8.12 are re-issued for A5, the chosen
    design, with no re-scoring (criteria, weights, scores and roll-up totals
    unchanged):
    - 8.1 block diagram carries the section 8.14 items (BPF3 of four
    resonators, drive filter and select-on-test pad, pack-dependent VGG
    clamp, loop items, three NTCs, route R3, PA_EN gate), with notes on
    the open liens INSP-110 finding-24 and finding-25 and on the analog
    input count for the pin map; sink outside the end wall (D-1 to D-4).
    - 8.10 rows for A5 only, with the rx-bpf note revision 4 figures
    (REQ-SYS-033 over REQ-SYS-114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
2026-09-29 docs(plan): PDR work plan revision 7, continuous work and event-triggered owner sessions
    Applies the owner direction of 2026-09-29 (status note section 8): work
    packages start as soon as their inputs are APPROVED and run day and night,
    held only by dependencies, owner decisions and rule C12 (pause at 90 %,
    nothing cut). The half-day slots and the 12-hour working day are withdrawn.
    Owner sessions are called when their sheets are ready, with expected
    earliest times: S1 about Thu 10-01, bench kit about Mon 10-05, S2 about
    Thu 10-08, S3 about Mon 10-12 evening.
    The date is re-estimated on the usage budget (55 % at 09-29 12:00 CDT,
    278 invocations, about 164 % of one week at factor 2.0), the ser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
2026-09-29 docs(cm): CR-003 revision 4 and CR-006 revision 3 for the A5 design
    CR-003 revision 4 (TS-012 revision 7 section 8.12 items a to f): the
    printed PETG case with the Boyd sink wholly outside one end wall, fins
    behind a wrap-around guard, no printed part on the sink, FR4 end wall,
    vented PA bay and bulkhead, cells at the far end; no coating in build 1
    (REQ-SYS-177 recorded not met); the held CNC package withdrawn (one
    reprint, then an owner cost decision); legend and markings in relief;
    the PC-class filament condition re-run (HDT 71.0 C continuous, 65.1 C
    with the duty limit; Q4, value pending WP-PDR-28a); REQ-SYS-104 and 106
    added; REQ-SYS-103 and 112 rationale edits moved to CR-018; R3-F1 to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
2026-09-29 docs(design): WP-PDR-20a revision 2 of the frequency budget, route R3 for A5 (freeze F0)
    New section 3.4 of frequency-budget.md with the checker r3_a5.py, run
    r3a5-20260929-01 (23 PASS, 0 FAIL, 10 INFO; four figures opened and
    inspected). It answers the two TS-012 section 10 revisit conditions of
    revision 6 for A5:
    - Si5351A relock: the Skyworks data sheet Rev. 1.3 and AN619 Rev. 0.8
    give no relock time (TFREQ 10 us, applicability to an MSNA change not
    stated; TRDY 10 ms max from power-up). The 1 ms allocation is not
    confirmed; the condition is open, not triggered by the read. The C6
    writes take 0.650 ms at 400 kHz (1.016 ms at the 256 kHz of the ADR-031
    counts). Lock-gated change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
    [r3_a5.py]
2026-09-29 docs(CR-013): implementation state and pre-merge check 2, SRR record re-issues on the branch; merge held
    WP-PDR-55 merge batch 1, configuration manager. Section 8 records the
    branch commits 8d9efdf (SRR re-issues of INSP-021 and INSP-005),
    eff05e0 (merge of the CR-010 step 5 records e54ce91) and b6cc8f8 (the
    INSP-010 CR-013 delta), the state of each section 5 step, the IR-F2
    re-observation at main fd12ced, and the check_commit_msg audit of the
    prototype commits (41c588c and 5cd87cf lack a Refs: trailer; not
    amended). Section 9 pre-merge check 2: on main fd12ced (validate_docs
    110 passed, 7 failed), the trial merge of CR-010 e54ce91 then CR-013
    b6cc8f8 gives 108 passed, 9 failed, the baseline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
2026-09-29 docs(CR-015): implementation state and pre-merge check 2, step 3 records at fd12ced; merge held
    Section 8: implementation record rows for the carried CR-012 commits and the step 3
    record commit fd12ced, the step state (1 to 6 pre-merge part done, 7 pending), and
    the correction of record for the three branch commits that tools/check_commit_msg.py
    fails (trailers separated from the final paragraph; frozen, not rewritten).
    Section 9: pre-merge check 2. Trial merge of 7efd900 into fd12ced with the five step
    3 record verdicts set APPROVED: validate_docs 110 passed, 7 failed, the same seven
    records as main (record drift of CR-007, ADR, TV and TS products), none on a CR-015
    path or record; traceab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
2026-09-29 docs(cm): CR-016 WP-PDR-55 batch 1 pre-merge check; INSP-061 finding-2 fixed on the branch at 091441b; merge held
    Section 8: branch commit 091441b fixes INSP-061 finding-2 in 02 (T-11,
    T-14, section 8.5 row T-19, section 9 rule 2; blob 5c4f45da); fork point
    443b2a3 stated (IR-F2). Section 9: configuration manager pre-merge check
    for merge batch 1 on main at 908d21a. Trial merge of CR-016 alone and of
    batch 1 in CR number order add no failing file to validate_docs.py
    (109 passed, 8 failed alone, the baseline set; INSP-020 gains the 02 drift
    inside that set); traceability.py 0 violations; seeded Retired check
    clean. Merge-tree conflict only with CR-011 (batch 2) on the 02 row T-19.
    Still block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
2026-09-29 docs(reviews): INSP-056 iteration 3 re-issue 1, WP-PDR-20a iteration 1 on frequency-budget.md revision 2 at 7593cea: NEEDS CHANGES
    Full review of section 3.4 (route R3 for A5) and the new checker r3_a5.py,
    re-run from a git archive export of 7593cea: exit 0, 23 PASS, 0 FAIL,
    10 INFO, output and results.json identical, four PNGs byte-identical;
    freq_budget.py 35 PASS. Skyworks data sheet Rev. 1.3 and AN619 Rev. 0.8
    re-read (SHA-256 equal to the checker's): no relock time specified, the
    relock reading and the freshness trigger are confirmed. Five renders
    inspected.
    - finding-11 (Major): the ratio drift omits the TCXO's own temperature
    change and the load and supply step between the stage-on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
2026-09-29 sim(tx-pa-permit): WP-PDR-22 D-18 PA-permit gate level-interface fix and A5 key-up rerun (runs 2026-09-29-d18-*)
    New analysis record docs/design/analysis/pa-permit-gate-d18.md, revision 0,
    for freeze (rule C2) and review with its SA pair. It closes, as analysis,
    the D-18 lien of TS-012 (INSP-118 finding-9 (a) to (c), INSP-110
    finding-24).
    As drawn (a 3.3 V NAND on the 5 V DMP3099L gate), the driver stays powered
    at key-up in 25 of 36 corners, and REQ-TX-014 fails in 21 (up to
    -14.7 dBm).
    Fix D18-2B:
    - a 74LVC1G11 AND on 3V3 of TX_KEY, PA_EN and Q (Q pulled up to the 5 V
    bus);
    - two 2N3904 open-collector stages to the 5 V bus: one holds the P-FET gate
    at its source, the other holds the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
    [result.csv]
2026-09-29 docs(cm): CR-008 WP-PDR-55 pre-merge check, step 7 re-issues on the branch, merge still held
    Records the configuration manager pre-merge check of 2026-09-29 in
    CR-008 section 9, the implementation state in section 8 and the step 7
    Done cell of section 5, and adds a section 11 history row.
    Step 7 is done on the branch at ebeb069: INSP-003 and INSP-025 are
    re-issued as CR-008 deltas by an invocation that authored no part of
    CR-008, with every lien Verified, and both stay APPROVED. Trial merges of
    ebeb069 into main (c12872d and fd12ced, scratch work trees, discarded)
    give exactly main's validate_docs failure set, 8 and then 7 records
    drifted by other changes, none naming a CR-008 path. traceab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
2026-09-29 docs(design): WP-PDR-28a thermal budget revision 0, A5 thermal closure (freeze F0)
    New analysis note docs/design/analysis/thermal-budget.md with the runner
    hardware/sim/thermal/a5_closure.py and run 2026-09-29-a5-closure-r1. It uses the
    INSP-112-frozen thermal_model.py and ts012_thermal.py unchanged.
    It closes the four open A5 thermal items of TS-012 revision 7 section 10
    condition 3 with two no-cost levers: a firmware key-down duty cap of 35 % in any
    10 min window, and the LM2940CT-5.0 tab screwed to the Boyd sink. Values are
    estimates, rounded up, with their RSS bands:
    - long-session cells: 58.9 C before, now 52.0 C (+2.9 K), PASS;
    - duty-limited PETG face: 60.1 C before, now 55.1 C (+4.1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
    [backstop.csv, bands.csv, bench_acceptance.csv, cap_pattern.csv, duty_sweep.csv, inhibit.csv, inputs.csv, summary.csv]
2026-09-29 editorial(requirements): SI-014 operator stakeholder interests use she/her
    The owner's pronouns are she/her (status-2026-09-29 section 7). The
    "Robin (operator)" stakeholder interests in expectations.json now read
    "Operates her unit as her own station"; expectations.md is re-rendered by
    tools/traceability.py --render. Only the two pronouns change. Folded into
    the CR-009 branch before the INSP-001 delta, per the lead SE ruling in
    CR-009 section 9.
    Refs: CR-009, SI-014
    CR: CR-009
2026-09-29 docs(safety): CR-008 steps 3 and 5, REQ-SYS-194 in HZ-002 K2 and allocated to PWR
    CR-008 section 5 step 3: docs/safety/hazards.json HZ-002 K2
    control_req_ids and HZ-002 requirement_ids gain REQ-SYS-194 (T-08).
    No other field changes.
    CR-008 section 5 step 5: docs/design/allocation.json allocates
    REQ-SYS-194 as REQ-SYS-083 is: PWR primary, element B18, function F7.
    The allocations[] record is added, the derived PWR primary_for and
    requirement_ids, B18 and F7 lists gain the id, and the summary counts
    move from 190/188/186 to 191/189/187 (ids, non-retired, allocated).
    tools/traceability.py --report-only --render: 246 requirements, 174
    test cases, 0 violations, 2 warnings (SYS_UNALLOCATED REQ-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
2026-09-29 docs(design): WP-PDR-20a revision 3 of the frequency budget, fixing the three Major findings (re-freeze F0)
    Fixes INSP-056 finding-11 and finding-12 and INSP-111 finding-7 only
    (rule C1). Checker r3_a5.py revised; new run r3a5-20260929-02:
    38 PASS, 0 FAIL, 14 INFO; five figures rendered and inspected.
    - finding-11: the ratio drift now carries the TCXO's own terms, read
    from the Epson TG2520SMN brief sheet: 1.0 ppm temperature band (no
    slope given) and a 0.4 ppm load and supply step between the stage-on
    refresh and the stage-off check (fo-Load, fo-VCC; conditions on the
    squaring stage). Allocations 2.5 ppm at interval 12 (A_kd 10 s kept,
    limit 11.8 s) and 8.0 ppm at interval 13; ma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
    [r3_a5.py]
2026-09-29 docs(reviews): INSP-034 iteration 2, re-pin for record drift on CR-007 and lessons learned
    Reviewer-role re-pin delta by a new invocation that authored none of the
    products. The CSA report (07909eb6) did not change. The record pinned
    CR-007 at 92b200ad (now abec03c5 after revisions 2 to 4) and the
    lessons-learned file at ec30a264 (now d250e8fb after entry 18), so
    validate_docs failed it on main. The CR-007 content the record used,
    Table 4-1 rows 56 and 57, is byte-identical at abec03c5; the
    lessons-learned check was made at 9fd0962 and still holds. Both files
    are dropped from product_files with the reason (precedent INSP-060).
    Findings 1 to 3 stay Minor and Open as liens; no new finding.
    val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
2026-09-29 docs(reviews): INSP-035 iteration 2, delta on lessons-learned entry 18 and CR-007 re-pin
    Reviewer-role delta by a new invocation that authored none of the
    products. The product moved from ec30a264 to d250e8fb at 391f0e5 (entry
    18 and its index row); every claim of entry 18 was checked against TS-012
    revision 7 section 10, the A5 lifecycle research (39 of 39 Active), the
    status note sections 4 and 5 and INSP-110 iteration 1 finding-1, and
    agrees. New Minor finding-2 (a lien): the entry's "Applied in" vehicles,
    WP-PDR-27 and a 06 section 14 revision, do not carry the lifecycle screen
    in plan revision 7. CR-007 is dropped from product_files: the record
    reviewed none of its content (precedent IN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
2026-09-29 docs(INSP-118): iteration 3, SA delta on TS-012 revision 8, assurance APPROVED
    Re-pins INSP-118 to TS-012 revision 8 (blob b9333386 at bb5dee7) and
    verifies every hunk since revision 6 (6497900, 5819220, 5f84770,
    bb5dee7) under the assurance lens. No Major is open. The A5-only rows
    of section 8.10 still carry the frequency check, the PA_EN gate, the
    thermal inhibit and cut-off and the keying controls.
    New Minor liens: finding-10 (TX_KEY and PA_EN in one SIO register, one
    store can raise both; INSP-110 X-17) and finding-11 (the duty-limit
    option on the REQ-SYS-181 sink NTC). finding-4 to 9 stay liens; the
    D-18 fix run 078f2f7 is recorded as unreviewed (X-12), not verified.
    Refs: INSP-118, T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
2026-09-29 docs(cm): CR-008 section 8, steps 3 and 5 done on the branch at a36a828
    Section 8 records the branch commit a36a828 (hazards.json: REQ-SYS-194
    in HZ-002 K2 control_req_ids and HZ-002 requirement_ids; allocation.json:
    REQ-SYS-194 allocated as REQ-SYS-083 is, PWR, B18, F7), its new blobs,
    every changed hunk and the branch tool runs: traceability 0 violations,
    2 warnings, the REQ-SYS-194 warnings cleared; validate_docs 48 of 50,
    the INSP-003 and INSP-008 drift that their section 9 deltas clear.
    Section 5 Done cells of steps 3 and 5 name the commit. Merge still held.
    Refs: CR-008, REQ-SYS-194, HZ-002
2026-09-29 docs(reviews): INSP-027 delta iteration 2, TS-002 software assurance on the WP-PDR-14 errata
    A new software assurance reviewer invocation, which authored none of the
    products, re-issues the record on TS-002 blob 6b18cee8 (errata commit
    443b2a3), replacing the drifted pin 6c385dfc. Every hunk since the pinned
    blob is checked: the header rows, the section 1 decision line, section 10
    and the six appended errata entries. finding-1 to finding-6 (lien L-6,
    RFA-SRR-006) are Verified, the sensitivity arithmetic is recomputed and no
    new finding is raised. Assurance and record verdicts stay APPROVED; the
    record passes tools/validate_docs.py. INSP-054, the file-review delta of the
    same blob, is read af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
2026-09-29 docs(reviews): INSP-047 delta iteration 2, CR-007 revision 4 software assurance; record verdict held for the INSP-039 delta
    products, re-issues the record on the CR-007 file at abec03c5 (revision 4,
    7668322), replacing the drifted pin 92b200ad. Every hunk of the 304-line
    delta is checked, and the revision 3 to 4 word diff is matched against the
    CR section 8 list of differences. finding-1 to finding-3 are not fixed by
    revisions 2 to 4 (finding-2, the Part B rows 10 and 15 dispatch rule, is
    kept open on purpose by CR section 6.8) and are now liens due the CDR
    readiness declaration. Two new Minor liens: the revision 4 para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
2026-09-29 docs(decisions): ADR-056 section 7 states the lead SE rulings on the contradicted ADRs and names ADR-057 to ADR-059
    WP-PDR-54 part 1 follow-on. Ruling 1: ADR-006, ADR-007 and ADR-012
    are proposed as Superseded by ADR-056 at the S1 disposition. Ruling 2:
    ADR-002, ADR-004 and ADR-005 are restated in full by ADR-057, ADR-058
    and ADR-059 (the ADR-026 precedent), each superseding its old ADR on
    the S1 disposition; the three drafts are filed by the lead SE. Ruling
    3: ADR-008 and ADR-025 go with the ADRs of CR-003 and CR-006. ADR-002
    item (3), the 70 cm LO criterion, is added for the lead SE's
    confirmation (TS-012 descope D15). Sections 2 to 6 are unchanged.
    Refs: ADR-056, ADR-057, ADR-058, ADR-05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
2026-09-29 docs(reviews): INSP-056 iteration 3 re-issue 2, WP-PDR-20a delta at 9dc9d63: reviewer APPROVED, record verdict held
    Independent delta on the two Major fixes of re-issue 1, rule C1.
    Re-run from a git archive export of 9dc9d63: r3_a5.py 38 PASS,
    0 FAIL, 14 INFO, output and results.json identical, five PNGs
    byte-identical; freq_budget.py 35 PASS. TG2520SMN brief sheet and
    Si5351A data sheet re-read (SHA-256 equal to the checker's).
    - finding-11 Verified: TCXO band 1.0 ppm and 0.4 ppm step; 2.5 and
    8.0 ppm allocations inside their ceilings; margins 260.0 and
    1446.0 Hz; M-2(a) and (b) limits equal the budget.
    - finding-12 Verified: FC0 counts 2^n x 1 us; L_max 1.9 ms, RL-5
    3.904 ms, RL-6 -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
2026-09-29 docs(reviews): INSP-111 iteration 3, SA delta 2 of WP-PDR-20a at re-freeze 9dc9d63
    Verifies finding-7 (Major): the key-down count is credited for its own
    interval only, the settle residual S_RAMP = 5 Hz is a named term of the
    A5 band-edge guard (margin 70.0 Hz) and M-1(c) can see a tail at the
    ramp. Checker re-run on a git archive export: 38 PASS, 0 FAIL, 14 INFO,
    outputs identical apart from the run id; five figures inspected.
    Raises finding-13 (Major): with the TG2520SMN (2.7 ppm uncalibrated
    against the 1.5 ppm allocation), a calibration constant wrong within
    the proposed +/-0.9 ppm puts the -60 dB point up to 97.8 Hz beyond
    148.000 MHz, so the HZ-008 K4 bound, the SW-SYNTH calibration r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
2026-09-29 docs(reviews): INSP-011 PDR-period delta, ADR errata of 0f4a7ad as corrected at 618e441 verified
    Independent reviewer delta on the two commits that changed ADR-001 to
    ADR-027 and the ADR README after delta 2. Against baseline/srr the files
    now have added section 8 readings only. The readings fix F-05 to F-08,
    F-12 to F-16 and erratum E-10. F-10 stays a lien (the ADR-019 reading
    drops WP-SW-14). New Minor F-17 (the ADR-008 reading says the CAD-chain
    tool validation record is not filed; TV-015 was). Re-pins 29 blobs.
    Verdict APPROVED with liens F-10 and F-17.
    Refs: INSP-011, ADR-001, ADR-005, ADR-008, ADR-013, ADR-015, ADR-017, ADR-019, ADR-024, ADR-025, ADR-027, RID-SRR-005, WP-PDR-14
    Co-Aut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
2026-09-29 docs(decisions): ADR-057 to ADR-059, Proposed restatements of ADR-002, ADR-004 and ADR-005 for A5
    WP-PDR-54 part 1 follow-on, per the lead SE rulings in ADR-056 section 7
    (abe5706): A5 contradicts ADR-002 items (3) and (4), ADR-004 (the USB
    charge path) and ADR-005 (in-radio balancing and the secondary protector)
    only in part, so each new ADR restates the unchanged parts and supersedes
    its old ADR in full on the owner's S1 disposition (ADR-026 precedent).
    Filed by the lead SE from the author's returned record text.
    Refs: ADR-057, ADR-058, ADR-059, ADR-002, ADR-004, ADR-005, ADR-056, WP-PDR-54
2026-09-29 docs(reviews): INSP-044 re-pin delta on the CR-008 file, 5e6ceb62 to aa65e826
    Independent delta under plan rule C1 on the drift of the CR-008 file
    (6485bd3, a17af87, 9c40ef9, 726cd44). The reviewed sections changed: the
    section 5 Done cells and the front matter status. So this is a delta,
    not a removal. All 16 hunks were read, and sections 1 to 4, 6.1 and 6.2
    are unchanged. The four frozen blobs at c629198 equal the branch head
    e26ce46.
    finding-1 (Minor) moves from Open to Lien under rule C1: the CR was
    dispositioned Approved without a revision. It is due at the CDR
    readiness declaration. New Minor finding-2: the section 10 "Owner merge
    approval" cell disagrees with section 9 (d) and plan O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
2026-09-29 docs(reviews): INSP-044 re-pin delta finding table in the latest iteration section
    Adds the finding table of the re-pin delta: finding-1 is a Lien and
    finding-2 is Minor and Open. With it, the latest iteration section shows
    the open Minor finding that findings_open counts. The validate_docs
    approval rule (d) needs that row when the software lead sets the verdict
    to APPROVED at the merge. Checked by calling approval_errors with
    verdict APPROVED: no error. Record text only, and no answer changes.
    Refs: INSP-044, CR-008, WP-PDR-55
2026-09-29 sim(tx-seq): WP-PDR-23a key-down and key-up sequence timing, T/R relay drive and hold, ICD-TX-SW timing table (runs 2026-09-29-s1 to s4)
    New analysis record docs/design/analysis/sequencer-timing.md, revision 0,
    frozen at F0 (rule C2) for review with its SA pair (SW-TXSEQ).
    The TS-012 7.3 schedule meets every plan criterion as a schedule: ramp
    10.000 ms after the T/R command, lead-in 9.980 to 10.043 ms (12 ms),
    contact to RF 13.043 ms (15 ms), frequency check done at t0 + 7.097 ms
    before PA_EN at 7.5 ms, VGG clamp and parked integrator until the ramp.
    The relay does not close inside that lead-in with the drive TS-012
    lists. The G5V-2 must-operate voltage rises about 0.39 %/K with coil
    tempe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
    [icd-tx-sw-timing-table.csv]
2026-09-29 docs(reviews): INSP-045 re-pin delta on the CR-008 file, 3b9266ff to aa65e826
    (cccbfda, a244b05, 6485bd3, a17af87, 9c40ef9, 726cd44). The sections
    this record used changed: the section 4 Interfaces row and section 5.
    So this is a delta, not a removal. All 19 hunks were read through the
    case lens. TC-SYS-056 stands under the owner's question 2a answer.
    Section 1.6 and the section 4 Verification row are unchanged, and the
    four frozen blobs at c629198 equal the branch head e26ce46.
    finding-1 to finding-3 (Minor) move from Open to Lien under rule C1,
    because the CR was dispositioned Approved without a revision. They are
    due at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
2026-09-29 docs(reviews): INSP-031 iteration 3, CR-012 record delta 1: 08 re-pinned to the CR-015 blob 374fd777, CR file pin dropped; new Minor finding-3; verdict held
    Reviewer-role delta for the CR-012 and CR-015 merge batch (CR-012 section 9,
    pre-merge check 2), by a new invocation that authored no part of CR-012 or
    CR-015. The 11 lines CR-012 adds to 08 are present unchanged in 374fd777 and
    none of the 9 removed lines returns; the six CR-015 hunks of 08 touch no
    CR-012 text. The CR file pin f689b05c is dropped (IR-F5; INSP-060 precedent);
    sections 1 to 3 and 5 are unchanged since. New Minor finding-3: the three
    template completion criteria hold APPROVED on iteration 1 Minor findings,
    against 01 sect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
2026-09-29 docs(reviews): INSP-032 iteration 3, CR-012 record delta 2: 08 re-pinned to 374fd777, CR file pin dropped, SA pair INSP-046 recorded; verdict held
    pre-merge check 2), by a new invocation that authored no part of CR-012,
    CR-015 or INSP-046. 08 56c54011 becomes 374fd777 (CR-015 head 7efd900); the
    CR file pin 91c8c626 is dropped (IR-F5); the template blob is unchanged. The
    pair fields now follow the filed INSP-046: paired_record INSP-046, its
    assurance reviewer, assurance_verdict APPROVED (01 section 13). No new
    finding; INSP-031 finding-3 covers this template's completion criterion.
    Record verdict held at NEEDS CHANG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
2026-09-29 docs(reviews): INSP-033 iteration 3, CR-012 record delta 3: 08 re-pinned to the CR-015 blob 374fd777, CR file pin dropped; verdict held
    CR-015. 08 56c54011 becomes 374fd777 (CR-015 head 7efd900); the six CR-015
    hunks, read in INSP-031 iteration 3, leave the CR-012 tool validation rows of
    08 unchanged. The CR file pin 91c8c626 is dropped (IR-F5); the template blob
    is unchanged. No new finding; INSP-031 finding-3 covers this template's
    completion criterion. Verdict trial on a scratch merge: PASS as APPROVED.
    Record verdict held at NEEDS CHANGE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
2026-09-29 docs(cm): CR-009 section 9 independent verification, pre-merge rows Pass; merge held
    Fills the CR-009 section 9 table and the independent verifier line. The
    verifier is a separate invocation that authored no part of CR-009.
    Branch head 732a088 checked against main abe5706 and again 8a24bc6. The
    branch changes the four affected paths only, and every hunk matches
    section 1 or the section 8 table of differences. A trial --no-ff merge
    with both SRR record verdicts set APPROVED is clean, and validate_docs,
    traceability and the unit tests show no new failure against main.
    Two Minor findings for the configuration manager: IV-F1 stale state text,
    IV-F2 the section 10 merge approval cell. The recor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
2026-09-29 sim(tx-pa-permit): WP-PDR-22 D-18 record revision 1, the two Major findings (runs 2026-09-29-d18r1-*)
    pa-permit-gate-d18.md revision 1 fixes only the two Major findings of
    iteration 1 of the review and its SA pair (rule C1), for re-freeze.
    Reviewer finding-1 (REQ-SYS-120 reported met without its level):
    - new section 5.8: in every state with fewer than both conditions,
    CLK1 running and the relay in transmit (lead-in, one line only,
    key-up and hang time, end of the over, after each cutoff) the level
    is -58.3 dBm (+1.3 dB on the estimates, inside their uncertainty),
    -38.8 dBm (-18.2 dB) and -34.0 dBm (-23.0 dB) at the bounds, against
    the -57 dBm REQ-SYS-183 level; REQ-SYS-120 is no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
    [result.csv]
2026-09-29 docs(design): WP-PDR-20a revision 4 of the frequency budget, the A5 reference budget for INSP-111 finding-13 (re-freeze F0)
    Fixes INSP-111 finding-13 (Major) only (rule C1). Checker r3_a5.py
    revised; new run r3a5-20260929-03: 43 PASS, 0 FAIL, 24 INFO. Every
    revision 3 case line is unchanged and the five revision 3 figures are
    byte-identical; the new figure reference-budget-a5.png was rendered
    and inspected.
    - New section 3.5, the A5 reference budget with the TG2520SMN terms
    (tolerance after reflow, fo-TC band, aging, load, supply), on two
    readings of the fo-TC band since its reference temperature is not
    stated (the 1.0 ppm window governs). Uncalibrated 2.7 or 3.2 ppm
    against the 1.5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
    [r3_a5.py]
2026-09-29 docs(reviews): INSP-111 author response to iteration 3, WP-PDR-20a revision 4 at re-freeze d030ce2
    Records the fix of finding-13 (Major) for the reviewer's verification:
    the A5 reference budget (new section 3.5, run r3a5-20260929-03), the
    REQ-SYS-010 row and the WP-PDR-35 and WP-PDR-16b requests held open
    for A5, the three options routed to the lead SE for the owner, and the
    R-M3 result for RB2 routed to WP-PDR-54 and WP-PDR-20b. Notes one
    5.0 Hz difference from the finding's figures (the word term counted
    twice there). No verdict, finding state or front-matter field changes.
    Refs: INSP-111, WP-PDR-20a, HZ-008, REQ-SYS-010
2026-09-29 docs(cm): CR-010 section 9 independent verification, all four rows Verified at 7963f78; merge held
    The independent verifier checked the section 9 rows against
    git diff ab2af2d..7963f78 and the section 1 text. It re-ran
    validate_docs, traceability, render_rmm --check and the unit tests
    (without test_ltspice_batch, lock held) on the branch head, on main
    b6cc1b8 and on a trial --no-ff merge. 0 Major. IV-F1 Minor: section 8
    is out of date. INSP-050 finding-2 stays a lien. The merge is held
    on the INSP-037 and INSP-050 re-pins, S1 and step 6.
    Refs: CR-010, WP-PDR-55
2026-09-29 docs(cm): CR-013 section 9 independent verification, pre-merge rows at 1a486e4; merge held
    git diff ab2af2d..1a486e4 and the section 1 text. It re-ran
    b6cc1b8 and on trial --no-ff merges of CR-010 then CR-013. It also
    re-ran the 04 section 7.4 commands at 7bb994f. Seven rows are
    Verified. The licence row is not verified here, because this
    invocation may not read rustos. 0 Major. IV-F1 Minor: section 8 is
    out of date. The merge-commit check waits for the merge.
    Refs: CR-013, WP-PDR-55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
2026-09-29 docs(cm): CR-008 section 9 independent verification, product rows Pass, trailer row Fail; merge held
    Fills the CR-008 section 9 table and the independent verifier line. The
    verifier is a separate invocation that authored no part of CR-008.
    Branch head e26ce46 checked against main b6cc1b8 and again be49be6. The
    branch changes the nine expected paths only, and every changed field of
    the requirement and test-case files matches sections 1.1 to 1.6. Steps 3
    and 5 match REQ-SYS-083's hazard links and allocation. A trial --no-ff
    merge with the INSP-044 and INSP-045 verdicts set APPROVED is clean, and
    validate_docs, traceability and the unit tests show no new failure
    against main.
    IV-F1 (Major): t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
2026-09-29 docs(reviews): INSP-074 delta iteration 2, TS-007 superseded by TS-012; record closed
    Software assurance delta on TS-007 blob 3d1e4e59 (cfc9111). The edit is
    the Status line only, as 06 section 14.6 allows, and it keeps the prior
    status verbatim; the checker and figure are unchanged. The four Minor
    findings close by supersession: finding-3 moot; finding-1 (changeover
    retune) and finding-2 (I2C driver, FC0 counter) carried to TS-012 in
    part, with the HZ-008 C7, item e and 07 driver-row residual transferred
    to INSP-118; finding-4 product part verified at cfc9111, 9ac2c42 left
    for the lead SE's CSA listing. The record verdict stays held on CR-012.
    Refs: INSP-074, TS-007, TS-012, ADR-056
    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
2026-09-29 docs(reviews): INSP-111 iteration 3 re-issue 1, WP-PDR-20a delta 3 at d030ce2: finding-13 Verified, NEEDS CHANGES
    Software assurance delta on frequency-budget.md revision 4 (re-freeze
    d030ce2). finding-13 (Major) is Verified: section 3.5 gives the A5
    reference budget and holds the +/-0.9 ppm bound, the K4 bound and the
    REQ-SYS-010 "No" open for A5. The author's 5.0 Hz correction of the
    finding's figures is confirmed (92.8, 181.6 and 55.2 Hz). finding-7
    stays Verified.
    New: finding-16 (Major), option (c) bounds a calibration value only
    against a stored factory value that has no bound or independent check,
    and the owner text calls all three options safe; finding-17 (Minor),
    the uncalibrated-u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
2026-09-29 docs(reviews): INSP-056 iteration 3 re-issue 3, WP-PDR-20a delta 3 at d030ce2: NEEDS CHANGES, 1 Major
    Analysis delta on frequency-budget.md revision 4 (re-freeze d030ce2),
    the fix of INSP-111 finding-13. Re-run on a git archive export: 43 PASS,
    0 FAIL, 24 INFO, output and results.json identical, six PNGs
    byte-identical; freq_budget.py 35 PASS. Section 3.5 re-computed by hand
    in exact fractions and the TG2520SMN brief sheet re-read (SHA-256 equal).
    The 5.0 Hz correction to the finding's figures is confirmed.
    New: finding-19 (Major), option (c) bounds calibration entries after the
    first only, and a first value wrong within 1.5 ppm puts the -60 dB point
    181.6 or 255.6 Hz beyond 148.000 MHz whi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
2026-09-29 docs(reqs): CR-008 ruling 1, REQ-SYS-194 status Draft to Active on the approved CR (02 section 8.3)
    The CR was approved on 2026-09-28. 02 section 8.3 row 2 makes the
    approved CR the trigger for Draft to Active of a requirement added after
    the L1 baseline, and CR-008 section 1.1 held REQ-SYS-194 at Draft only
    until that approval (IV-F2). Only the status field changes;
    requirements.md is re-rendered by tools/traceability.py --render (count
    table and the two status cells). traceability: 246 requirements, 174
    test cases, 0 violations, 2 warnings (SYS_UNALLOCATED REQ-SYS-125 and
    148). TC-SYS-116 stays Draft: its 02 section 8.4 trigger is the procedure
    checklist review, not the CR.
    Refs: CR-008,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
2026-09-29 docs(decisions): ADR-056 to ADR-059 review fix round, requirement rows, contradicted ADRs and the rail-off gap
    Fix round on the WP-PDR-54 review of the four Proposed ADRs and its
    software assurance pair (plan rule C1). No decision content changes.
    ADR-056:
    - section 4.1 rewritten row by row against TS-012 section 8.10:
    REQ-SYS-104 and 106 go to CR-003 revision 4 section 1.1a; the kept
    and unlisted rows that carry hazard controls are named (085, 086,
    090, 092, 064 to 066, 163, 097 to 099, 166, 149, 130);
    - section 7: ADR-013 is contradicted in its method, and a new item 4
    assesses ADR-013, ADR-022, ADR-026 and the display clauses of
    ADR-009, 015, 016, 020 and 024 with proposed rout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
2026-09-29 docs(reviews): INSP-003 CR-008 status delta, REQ-SYS-194 Draft to Active verified at c1955b3
    Independent delta of INSP-003 on the two blobs of CR-008 section 5
    step 10 (lead SE ruling 1): requirements.json c68584cf and
    requirements.md 47c2beaa. The status of REQ-SYS-194 is the only field
    changed; the transition is 02 section 8.3 row 2 on CR-008 approved
    2026-09-28; the three rendered spots equal a fresh --render. No new
    finding; finding-32 stays the one Minor lien. validate_docs on the
    branch: 50 passed, 0 failed. traceability: 0 violations, 2 warnings
    (REQ-SYS-125 and 148).
    Refs: INSP-003, CR-008
2026-09-29 docs(reviews): INSP-037 re-pin delta, 07 named at 0ad37a43 and the CR-010 file dropped; finding-7 Verified, readiness met, verdict held for the CR-013 merge
    Lead SE rulings (2) and (3) of 2026-09-29. The CR-010 file moved from
    ccd77640 to 27604ce9; sections 1 to 4 and 6, which this record reviewed,
    are unchanged and section 5 changes only in its Done column, so the file
    is dropped from product_files with the reason in the body. 07 is named at
    the combined CR-010 plus CR-013 blob 0ad37a43; 24 of the 27 CR-010 lines
    are verbatim and the 3 CR-013 changes move no component or criterion.
    readiness_met is set true: validate_docs 50 of 50 at 7963f78 and 1a486e4,
    render_rmm --check exit 0 at both. F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
2026-09-29 docs(reviews): INSP-058 re-pin delta, no CR file pinned, 04 7617007e unchanged; counts reconciled to 3 liens, readiness met, verdict held for the CR-013 merge
    Lead SE ruling (2) of 2026-09-29. product_files names no CR file (the
    CR-013 file is an input), so nothing is dropped; the 04 blob is the same
    at 41c588c, the CR-013 head 1a486e4 and the trial merge. findings_open 3
    did not match the Lien table, which is the last row of each finding: now
    open 0, deferred 3. readiness_met is set true on the record's own
    condition: validate_docs 50 of 50 at 1a486e4 after the SRR record deltas.
    The record verdict stays NEEDS CHANGES; a scratch copy with verdict
    APPROVED passes on the trial merge of CR-010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
2026-09-29 docs(reviews): INSP-044 status re-pin delta, step 10 blobs at c1955b3 and CR file to c1a52ab6, CR file dropped
    Independent delta of INSP-044 under lead SE rulings 1 and 2. The two
    requirement blobs become the CR-008 step 10 blobs (requirements.json
    c68584cf, requirements.md 47c2beaa): only the REQ-SYS-194 status field
    and its three render cells change, an allowed 02 section 8.3 row 2
    transition. The CR file changed in reviewed sections (section 5 step
    10, front matter status), so its 14 hunks from aa65e826 to c1a52ab6
    were read first; then the CR file is dropped from product_files with
    the reason, as INSP-060 did. finding-2 Verified on the section 10 fix;
    finding-1 stays a lien; no new findi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
2026-09-29 docs(reviews): INSP-064 re-pin delta, no CR file pinned, SEMP 2076eb0a unchanged; count reconciled to 1 lien, readiness met, verdict held for the CR-013 merge
    CR-013 file is an input), so nothing is dropped; the SEMP blob is the
    same at 41c588c, the CR-013 head 1a486e4 and the trial merge, and main
    has not taken the CR-003 or CR-006 Version-row hunks. findings_open 1 did
    not match the Lien table: now open 0, deferred 1. readiness_met is set
    true on the record's own condition: validate_docs 50 of 50 at 1a486e4.
    APPROVED passes on the trial merge of CR-010 t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
2026-09-29 docs(reviews): INSP-050 iteration 2, re-pin delta: 07 named at 0ad37a43 and the CR-010 file dropped; 18 CR-013 hunks read, no new finding; findings 1 to 3 liens; verdict held for the CR-013 merge
    Software assurance re-pin delta of INSP-050 under lead SE rulings (2) and
    (3) of 2026-09-29. 07 is re-pinned from 3ae7d73b to 0ad37a43 (CR-013
    41c588c, unchanged at 1a486e4); 03, rmm.json and rmm.md are unchanged.
    The CR-010 file is dropped from product_files: sections 1 to 4 are
    unchanged from ebce01d6 to 27604ce9 and section 5 changes only in its
    Done column. No CR-013 hunk changes an answer of this record. findings 1
    to 3 are liens due the CDR readiness declaration; findings_open 0.
    Verdict trial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
2026-09-29 docs(reviews): INSP-045 status re-pin delta, step 10 blobs at c1955b3 and CR file to c1a52ab6, CR file dropped
    Independent delta of INSP-045 under lead SE rulings 1 and 2. The two
    c68584cf, requirements.md 47c2beaa); the case blobs 117c08de and
    00e4454f are unchanged, no case text depends on the REQ-SYS-194 status,
    and TC-SYS-116 correctly stays Draft (02 section 8.4). R5 now holds
    with every cited requirement Active. The CR file changed in section 5,
    so its 14 hunks from aa65e826 to c1a52ab6 were read first; then it is
    dropped from product_files with the reason, as INSP-060 did. Three
    Minor liens unchanged; no new finding.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
2026-09-29 docs(reviews): INSP-059 re-pin delta, no CR file pinned, 07 0ad37a43 unchanged; pair INSP-073 copied as filed, counts reconciled to 3 liens, readiness met, verdict held
    CR-013 file is an input), so nothing is dropped; the 07 blob is the same
    at 41c588c, the CR-013 head 1a486e4 and the trial merge. The assurance
    pair INSP-073 (9403999) is copied as filed: paired_record,
    assurance_reviewer_agent and assurance_verdict APPROVED. findings_open 3
    did not match the Lien table: now open 0, deferred 3. readiness_met is
    set true on the record's own condition: validate_docs 50 of 50 at
    1a486e4. The record verdict stays NEEDS CHANGES;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
2026-09-29 docs(reviews): INSP-073 iteration 2, re-pin delta: 07 0ad37a43 unchanged at 1a486e4, no CR file pinned; findings_open reconciled to 0 (finding-1 a lien); verdict held for the CR-013 merge
    Software assurance re-pin delta of INSP-073 under lead SE ruling (2) of
    2026-09-29. The 07 blob is unchanged at the CR-013 branch head 1a486e4.
    No CR file is in product_files (CR-013 is an input only), so none is
    dropped. findings_open read 1 while the finding tables showed finding-1
    as a lien; it is now 0, with an iteration 2 finding table. Verdict trial
    on a CR-010 then CR-013 trial merge: PASS at APPROVED; the iteration 1
    text fails the record state rule. INSP-059 is still unpaired (X-1).
    Refs: INSP-073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
2026-09-29 docs(reviews): INSP-046 iteration 2, re-pin delta: 08 named at 374fd777 and the CR-012 file dropped after a delta on its sections 4, 8 and 9; finding-4 Verified; findings 1 to 3 liens; verdict held f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
    Software assurance re-pin delta of INSP-046 for the CR-012 and CR-015
    merge batch, under lead SE ruling (2) of 2026-09-29. 08 is re-pinned from
    56c54011 to 374fd777 (CR-015 head 7efd900); the three template blobs are
    unchanged. The CR-012 sections this record reviewed changed, so the delta
    reads them to 37ca884b before dropping the file; the four blobs now equal
    INSP-032 iteration 3. finding-4 is Verified by the CR-012 section 8
    correction and deviations entries 8 and 9; SA-E3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
2026-09-29 docs(decisions): ADR-056, ADR-058 and ADR-059 second review fix round, item 4 filing list, memo wording and hazard controls
    ADR-056: the lead SE ruling on item 4 is recorded as pending, with what
    must agree with it when given; the restating ADRs that item 4 needs are
    named, each filed before S1 under its own review. The S1 memo wording
    adds the ruling 1 supersessions and, for ADR-013, the owner notice on
    SI-029 and the USD 15 band. Section 4.1 cites the CR-003 revision 4
    sections that carry each enclosure row and names every hazard control
    of each row; section 4.3 re-reads the changed controls, the LCD wording
    included, and lists the stale 07 rows h, i, j and the frequency
    verification timeb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
2026-09-29 sim(tx-pa): WP-PDR-21 revision 3 for A5, drive pad, REQ-SYS-012 low-pack basis and REQ-SYS-144
    Revision 3 of the PA drive analysis (docs/design/analysis/pa-drive-ts012.md,
    new section R3) covers the A5 items that the PDR work plan revision 6 section
    3.0 row 21 assigns to wave W-A. New script hardware/sim/tx-pa/run_a5_r3.py and
    runs results/2026-09-29-r3-d6, d7, k1, s2, p4, p5 and s3.
    - D-13 drive bandpass (d6, d7): the fixed 18 dB pad gives 5.5 to 39.1 mW
    (FAIL). The CLK1 pin load is -0.5 to 11.0 pF, inside Si5351 Table 7, which
    closes DR-PAD-1. The lowest CLK1 swing is 1.33 Vpp.
    - Select-on-test reading at 17 mW (k1): the probe's forward drop is measured
    at two DC currents, and the r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
2026-09-29 docs(cm): CR-019, rustos pin move to the reviewed FW-B1 driver commit 48e07ec on cwht/develop, with its impact reviews and lead SE rulings
    WP-PDR-41 PCR-4. Filed by the lead SE from the configuration manager's
    draft (the harness does not let subagents create CR files). Three impact
    review iterations (sections 6.1 to 6.8) end with two Majors, both
    text-only; section 6.9 records the lead SE's rulings: ADR-019 is restated
    by ADR-067, the sidetone pass reading is taken with no load, and both go to
    the owner at S1 part 2 as conditions of approval (rule C1).
    Refs: CR-019, CR-004, ADR-019, ADR-067, WP-PDR-41, OD-37
2026-09-29 sim(tx-seq): WP-PDR-23a revision 1, the six Major findings: H1 slope and maximum-voltage graphs, release at -10 C, stale-ratio key-down, static T/R drive through a coil-supply limiter (runs 2026-09-2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
    Analysis record docs/design/analysis/sequencer-timing.md revision 1 for
    re-freeze (rule C2) and the delta iteration of the review and its SA
    pair. Only the Major findings are fixed (rule C1); section 13 maps each.
    Review finding-1: the G5V-2-H1 maximum coil voltage read from its graph
    is 167 % at 61.4 C, 156 % at 67.1 C, 151 % at 70 C. Ratings note 3 makes
    it the highest voltage imposed on the coil, so it limits the PWM peak,
    not the average: a pack PWM imposes 168 % at 8.4 V what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
    [icd-tx-sw-timing-table.csv]
2026-09-29 docs(decisions): ADR-060 to ADR-066, Proposed restatements of ADR-022, 026, 009, 015, 016, 020 and 024 for A5
    WP-PDR-54, per the lead SE ruling of 2026-09-29 recorded in ADR-056 section 7
    (8ed5ec7), parts (c) and (d): each restates its old ADR with the A5 change
    (no display, Morse menu and LED readings; the LPF and ALC values; the G5V-2
    T/R element) and supersedes it in full on the owner's S1 disposition. Filed
    by the lead SE unchanged from the technical data manager's drafts; reviewed
    together in INSP-134 with its software assurance pair INSP-135.
    Refs: ADR-060, ADR-061, ADR-062, ADR-063, ADR-064, ADR-065, ADR-066, ADR-056, WP-PDR-54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
2026-09-29 docs(decisions): ADR-067, Proposed restatement of ADR-019: rustos drivers developed and pushed on cwht/develop, merged to master by the owner later
    Per CR-019 section 6.9 ruling 1 and the owner's direction of 2026-09-29
    (status-2026-09-29 section 9, quoted verbatim in section 6). Filed by the
    lead SE unchanged from the technical data manager's draft; reviewed with
    ADR-060 to ADR-066 in INSP-134 and INSP-135.
    Refs: ADR-067, ADR-019, ADR-027, CR-019, WP-PDR-41, WP-PDR-54
2026-09-30 docs(decisions): ADR-060 to ADR-067 fix round 1 for INSP-134 and INSP-135 iteration 1
    Fix the two Major findings and the Minor findings that are factual
    errors, in place, since all eight ADRs are Proposed. No decision changes.
    - ADR-060: keep the +/-0.5 dB ALC target above the low-pack region and
    mark the change at the low-pack end only; state +1/-1.5 dB and the 8 W
    open-loop bound as TS-012 proposals beside the pa-drive-ts012 revision 3
    (Draft) scenario B; carry INSP-118 finding-5 and finding-7; memo counts
    four changes and says the 2f goal rises from 40 to 43 dB.
    - ADR-061: state the relay coil drive by function until
    sequencer-timing.md revision 1 is APPROVED; add HZ-004 K12, H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
2026-09-30 docs(design): WP-PDR-28a thermal budget revision 1, the three Major findings fixed
    Revision 1 of docs/design/analysis/thermal-budget.md fixes the three Major review
    findings and only them (rule C1), on the new run 2026-09-29-a5-closure-r2. Run r1
    is kept unchanged. The runner hardware/sim/thermal/a5_closure.py still uses the
    INSP-112-frozen model files unchanged. Every value is an estimate.
    finding-1, REQ-SYS-181 backstop alone: the adverse case now stacks every device,
    interface and supply input at its adverse end, taken from a closed-loop screen,
    with the RSS band of the other 80 inputs. At 95 C +/-3 C the module case reaches
    111.4 C +0.9 K against the 110 C Tcase(OP) rating: FAIL, so the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
    [backstop.csv, backstop_screen.csv, bands.csv, bench_acceptance.csv, cap_pattern.csv, cap_pattern_verdicts.csv, duty_sweep.csv, inhibit.csv]
2026-09-30 sim(tx-seq): WP-PDR-23a revision 2, the two delta-iteration Major findings: option E key-down rail floor restated (K15-E OPEN) and the stale-ratio case stated on the ratio age (runs 2026-09-29-r2-s1 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
    Revision 2 of docs/design/analysis/sequencer-timing.md fixes only the
    two new Major findings of the delta iteration (rule C1; section 14).
    Finding-13 (K15-E rested on a 5.45 V key-down rail):
    - The option E rail floor is restated: the pack at the REQ-SYS-097
    floor (6.30 V), the WP-PDR-21 revision 3 feed bound (0.5646 ohm at
    +45 C key-down, 0.614 ohm at -10 C; f1070cf) with the key-down pack
    current read from the p4 .raw (2.140 and 2.215 A, SHA-256 checked by
    the new s4 check p4_fe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
    [icd-tx-sw-timing-table.csv]
2026-09-30 docs(design): WP-PDR-28a thermal budget revision 2, the two delta-review Major findings fixed
    Revision 2 of docs/design/analysis/thermal-budget.md fixes finding-20 and
    finding-21 of the delta review of revision 1 and only them (rule C1), on the
    new run 2026-09-29-a5-closure-r3. Runs r1 and r2 are kept unchanged. The
    runner still uses the INSP-112-frozen model files unchanged. Every value is an
    estimate.
    finding-20, worst cap pattern: each burst now holds exactly the key-down time
    the cap allows (180.0 s per 10 min window, counted on the solver's 0.2 s steps;
    the burst lasts 186.4 s), and the key-down fraction is counted on every step:
    30.00 % (was 29.15 %). Box values under the pattern rise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
    [backstop.csv, backstop_screen.csv, bands.csv, bench_acceptance.csv, cap_pattern.csv, cap_pattern_verdicts.csv, duty_sweep.csv, inhibit.csv]
2026-09-30 sim(tx-pa): WP-PDR-21 revision 5, finding-31: the clamp step's reject rule acts on the believed spread (runs 2026-09-30-r5-p4, -p5, -s5)
    Revision 5 of docs/design/analysis/pa-drive-ts012.md (new section R5) fixes
    the one Major finding of the delta review of revision 4, finding-31, and only
    it (rule C1). Findings 1 and 2 were Verified by that review. New script
    hardware/sim/tx-pa/run_a5_r5.py; the revision 4 runs are inputs, unchanged.
    - The reject rule acts on the spread the step believes (true spread plus
    reading error). A module up to +1.5 + g- = +2.49 dB above typical passes
    when read low. That unit case is added to both power decks (r5-p4, r5-p5,
    1944 LTspice steps each).
    - Open-l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
2026-10-01 docs(cm): merge SHAs of CR-008, 009, 010, 012, 013 and 015; traceability report regenerated after merge batch 1
    Owner confirmed keeping and pushing the merges on 2026-10-01 ("Lets keep and push").
    Refs: CR-008, CR-009, CR-010, CR-012, CR-013, CR-015
