robinonsay/cwht/(notices)

Notices in the files:
docs/reviews/PDR/checklists/ts-012-design-to-cost.md:
**Fix:** cite the source in note 4.
docs/decisions/adr/ADR-006-rotary-encoder-tuning.md:
tent), REQ-SYS-061 (display character size) and REQ-SYS-165 (display legibility without a backlight) implement the rest of the control set and do not cite this ADR
REQ-SYS-058 (tuning with rate-dependent step, TBR) | allocated at L1; does not cite this ADR; the SW L2 tuning-law requirement is not created (PDR) | Ties to ADR-016 and ADR-023 (10 Hz BFO steps)
docs/risk/register.md:
Closure criteria.** Accepted by the owner under RFX-D6 with the licensee-tier margin as rationale, or the analogy superseded by a measurement or numerical estimate that shows the margin.
docs/test_cases/sys/test_cases.md:
Acceptance criteria.** Pass if the MIT LICENSE, the complete third-party notice file and every baseline tag are present in the public repository github.com/robinonsay/cwht, and the design, firmware and process records are all in it; otherwise Fail.
docs/design/concept.md:
Firmware is Rust on rustos: register-level drivers in the rustos `pico2` crate implement the rustos `api` traits and cite the RP2350 datasheet section they implement; all application logic (keyer, sequencer, safety manager, tuning, display, audio, power monitor, configuration store) lives in `cwht-c
2cMaster`, `bus::SpiTx`, `pwm::PwmChannel`, `adc::AdcChannel`, `watchdog::Watchdog`, `nv::NvStore`, `irq`) implemented by rustos `pico2` drivers that cite the RP2350 datasheet section per register access; `cwht-core` (`#`, `#`) holds every decision, tested on the host against `cwht-hal-mock` with a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
